cyc292cycjin-oss/SGP-ESE5004-Stage2/README.md

# SGP ESE5004 Stage2 — Phase1–3 safe research snapshot

This branch preserves reports, registries, decisions, accounting contracts, audit scripts and non-sensitive evidence. It is a documentation snapshot with separate ancestry, not the Full-SC model.

Read [snapshot provenance and exclusions](PHASE1_3_REMOTE_SNAPSHOT_MANIFEST.md), [Phase3C closeout](research/02_sector_coupling/phase3c/PHASE3_RESEARCH_MODEL_DESIGN_CLOSEOUT.md) and [assembly handoff](research/02_sector_coupling/phase3c/PHASE4_ASSEMBLY_HANDOFF.md).

Original reports are preserved as dated records. Earlier PENDING/NOT READY statements describe their own phase; no conclusions were edited for consistency. The previous raw-data publication hold is resolved for this safe snapshot by explicit exclusions, not by claiming redistribution permission.

The formally authorized future model branch is `research/full-sc-baseline` at `a3616a68ee44592af6527ca9024a90f1956646ae`. Creation is performed only after this snapshot is verified remote. No fix is integrated here. CodeQL remains EXTERNAL_INFRASTRUCTURE_EXCEPTION and does not block assembly. Final branch identities and creation results are in the final infrastructure handoff, not inferred from this preparation README.

Original local branches remain available. Excluded original sources remain local and are listed with URL/version/hash. Licenses and original notices remain applicable; see SNAPSHOT_SOURCE_LICENSES.md. This snapshot does not authorize a solver run.
