cyc292cycjin-oss/SGP-ESE5004-Stage2/research/02_sector_coupling/transport/phase3b1/PHASE3B1_TRANSPORT_READINESS.md

# Phase3B-1 Transport边界审阅交付

**TRANSPORT_BOUNDARY_READY_FOR_HUMAN_REVIEW = YES。** 当前证据足以解释原架构、定位系统风险并提交最小表示候选；不等于Transport数值输入已接受、Full-SC已组装或可以正式求解。所有候选仍PENDING，A*概念和原carbon policy不变。

## A–O回答

| 问题 | 结论与证据边界 |
|---|---|
| A 实际组件 | 作者P选定2025/2050最终结果各98个EV Load、BEV charger、V2G及rail-electric Load；无EV Store。U新最终网络未运行，不能把作者计数当U运行结果 |
| B 仅支持未入final | 道路ICE/FCEV、rail oil、shipping oil/H₂、aviation油终端及EV Store被裁剪或份额关闭；供给FT/H₂保留不证明其交通用途 |
| C Road客货来源/单位 | UNSD2019国家最终能源TWh，不分客货，不是passenger-km/tonne-km；经默认增长及存在量纲问题的陆运能源代理进入EV等Load |
| D Rail | 构造electricity/oil固定Load；final只保留电力。原始电量是rail总量子集，非电rail还进入land aggregate |
| E Shipping | 构造器显式油/H₂，需求合并国内国际；final删除。教程pre-strip油48项中39NaN，H₂48项中1NaN，不可当通过的Full-SC输入 |
| F Aviation | 构造器显式kerosene-labelled oil Load，国内国际合并；final删除。无直接航空H₂或飞机技术选择 |
| G 电力重复风险 | YES。没有对应历史EV/rail父账户转移；当前实际父电量口径也未闭合。不能给出未经证实的重复TWh；11国road electricity零来自缺记录 |
| H 电气化 | 外生scenario/year份额；能源供应和调度可内生。不是内生EV/ICE/FCEV车队投资竞争 |
| I Shipping/Aviation与H₂/电力 | 有明确系统影响通道：H₂/FT供给、renewables、储存及区位；是否实际选用及效应大小/方向未求解，不能称已证实显著 |
| J Carbon冲突 | YES，保留交通会扩大共享大气账的范围；另有rail油漏记、bunker错误加权与混合键问题。未改变原power cap |
| K 系统相关机制 | 总量/增长、EV转换和采用率、峰时/真实Store、H₂/FT与燃料库存、bunker责任、节点守恒、碳范围和对比边界 |
| L 可暂缓细节 | 精细车型/驾驶/桩型/船型/机型/班次；保留局部重开条件，不证明这些细节恒为零影响 |
| M 首基准候选 | Road aggregate与shipping/aviation先SYSTEM_RELEVANT_PENDING；客货留聚合；rail FIXED或EMBEDDED；已有燃料供给可EXPLICIT；未证实DSM/V2G及新燃料终端DEFERRED。全部需人审 |
| N 真正blocker | 五组：父子账户与rail排重；road单位/增长/缺失；shipping分配与bunker边界；碳范围/完整性；真实灵活性与比较对称性。精确条件见T01–T15 |
| O 可提交人审吗 | YES；未自动进入Phase3B-2，未修代码或执行实验 |

## 证据层次

**直接读取**：67份P/U固定Git文件；4个既有网络（两个作者final、一个教程pre-strip及final）；52个UNSD缓存文件、123条关键词筛选候选原行和107个非空base字段的转换核对；小输入、港口工程provenance和prior audit。

123条候选原行中含名称命中航空关键词的进口等非终端交易；实际进入每个base字段的交易/commodity仍按冻结过滤器选取，不把候选行全部当运输消费。`conversion_comparison`保存每格selected_raw_count，原行/脚注/哈希保留。107项一致是计算可追溯，不是统计完整或参数验收。

**分析推导**：land/rail重复条件、CO₂占比与kWh/km量纲不闭合、bunker scalar×ratio求和错误、rail油绕过排放账、固定燃料义务与内生供给不等于重复。

**待检验推断/候选**：省略灵活性或改变运输燃料会如何改变互联收益、港口NaN所有根因、各空间代理误差大小、最小Research表示。没有制造效果数值、materiality阈值或新的技术/碳情景。

## 已关闭与保留缺口

已恢复生成脚本、原始交易/单位、默认继承、实际源版本区分、组件裁剪、明确欧洲曲线来源、外生份额和排放消费路径。无需再让用户搜全11国微观交通数据。

尚需后续数值采用证据：A*同口径交通电量；可辩护的road聚合转换；增长/份额接受；国家/节点守恒；完整且保持原范围的排放账。作者车辆/机场原快照只在精确复刻或依赖该输入时要求；具体条件见`USER_INPUT_NEEDED_TRANSPORT.md`。

## 最小下一步（仅交接，不执行）

人审先选Road聚合与灵活性范围、rail账户方式、domestic/international bunker责任及共同燃料/碳记账契约。以后若另行授权工程阶段，只针对已定位系统门槛修正/验收，避免重新研究完美车型或全11国设备细节。保留航运航空为系统相关待定，不能因数据不完美默认关闭。

本轮仅写research审计产物；没有数据替换、transport/EV subtraction patch、H₂网络更改、carbon政策更改、正式或敏感性求解。原P/U/V/R冻结版本不变。交付检查的PASS只覆盖证据完整性、表间一致及受保护模型身份。
