cyc292cycjin-oss/SGP-ESE5004-Stage2/research/02_sector_coupling/transport/phase3b1/USER_INPUT_NEEDED_TRANSPORT.md

# 本轮人审所需：少量边界决定，非重新搜集11国车队

**完成本轮边界审阅不需要用户补交新文件。** 主要UNSD来源、当前生成链、默认参数、港口工程来源和两个作者结果已从缓存恢复。来源可恢复的问题不再转交用户重复寻找。

## 后续数值采用前需要共同决定

| 决定 | 当前候选（未冻结） | 为什么需要人审 |
|---|---|---|
| 第一版Road边界 | aggregate road，明确外生渗透；仅在单位和A*转移闭合后显式EV；暂不赋予未经证实的DSM/V2G | 当前q是存在量纲问题的能源代理，不是已核验mobility service；关闭灵活性也是范围选择 |
| Rail表示 | EMBEDDED或单列FIXED，保留电/燃料一次；不强制线路/车辆模型 | 两者可用但互斥，需避免与land及父电力重复 |
| 国内/国际bunker义务 | 国内与国际分别留账，shipping/aviation先SYSTEM_RELEVANT_PENDING | 当前false开关仍保留国际燃料；国别责任和对比边界不能由脚本代定 |
| H₂/FT路径与燃料贸易 | 对保留燃料义务使用已有供给能力；份额不自动上调；Disconnected的外部商品供应另定义 | 不能将供给内生误认为船/机技术竞争，也不能把独立国家等同自给 |
| Carbon实施边界 | 原power absolute trajectory保持；明确独立范围、共享燃料/捕集信用及完整排放账 | 不是是否改政策的问题；是如何确保原范围不被交通扩展或漏记破坏 |

增长/效率/份额须按来源家族共同验收，不要求逐格批准146行登记，也不把技术复算一致变成科学接受。

## 条件性原件需求（仅在选用相应路径时）

1. **若要按原作者重建精确EV能力**：作者运行时的`resources/<run>/transport_data.csv`，及生成它的WHO/Wikipedia车辆快照、年份/车辆口径、World Bank原表或生成日志。当前tutorial未生成该表；硬编码表不能证明作者使用了它。不要替换为最新在线车辆量。若无法取得，标原作者输入版本未闭合，不影响本轮审阅。
2. **若要从A*转移历史交通电力**：与拟采用A*同年同域的road EV/rail/other electric transport电量及包含关系。原缓存11国road electricity为空子集零，不能代替这项证据。应先沿已选电力/能源平衡来源定向恢复；不要求用户现在寻找全部国家交通调查。
3. **若要将道路聚合能耗转换成显式服务/EV用电**：能说明输入端、能耗或效率单位、同年覆盖及燃料热值的可辩护聚合转换依据。若原作者有该假设来源，可提供文件/表/页；不要求每种车型，不允许把CO₂占比继续当物理燃油效率。
4. **若要采用DSM/V2G或作者精确空间输入**：足够支持参与率/固定容量的车辆口径，以及作者WPI/OurAirports版本。完整车龄、每座充电桩及每条航线不是默认必需。当前港口工程导出已有，不再重复索取；机场processed hash已有，原始版本未恢复。

其他工作属于已有证据支持的后续工程核对：land/rail互斥、NaN/节点守恒、缺失旗标、Store裁剪、bunker排放加权、rail燃烧记账和混合carbon key。它们不应伪装成“用户还没交数据”；本轮授权仅审计，所以未修。
