cyc292cycjin-oss/SGP-ESE5004-Stage2/research/02_sector_coupling/transport/phase3b2/TRANSPORT_PHASE3_CLOSEOUT.md

# Transport Phase3最终收口

2026-10-03。**TRANSPORT_CLOSED_FOR_FULLSC_ASSEMBLY = NO**。

`TRANSPORT_RESEARCH_SCOPE_CLOSED = YES`；`TRANSPORT_REPRESENTATION_SPEC_FROZEN = YES`（本轮用户决定）；`NUMERICAL_INPUTS_AND_IMPLEMENTATION_FROZEN = NO`。

已完成本轮规范、证据和候选修复交付。NO表示真实数值及工程尚未满足全部八条验收，不是要求再开展Transport深入轮次。下一步是Human Scientific Review；本轮到此停止。

## A–M明确回答

| 问题 | 结论 |
|---|---|
| A Road aggregate有清晰能量定义？ | **是，规范已明确。** 同年final-energy parent×energy share；EV计量于终端充电输入；剩余燃料分载体，未创造km。R/share数值待接受。 |
| B 旧road转换量纲问题关闭？ | **没有完成工程关闭。** 新规范已摆脱错误代理，但原U函数未修、未被实际新账替代。 |
| C EV与A* exactly-once？ | **契约明确，真实值未验证。** 11国缓存零不能证明历史EV为零；须父子账匹配和基年→未来转移。 |
| D V2G/DSM可安全defer？ | **可以。** 构造开关可关；首版固定网侧Load规范不依赖车数/charger约束。实际组装须验无EV储能/逆向Link。 |
| E Rail完全embedded？ | **表示可以，数值包含待证实。** 电保留A*、燃料保留direct-fuel；新road-only账不是rail父账。不能只关rail而丢量。 |
| F Shipping国内/国际明确？ | **账户定义与原行身份明确；数量未接受。** 四国by/in漏筛及BN/LA/TL缺值已留证。 |
| G Aviation国内/国际明确？ | **明确。** 当前是kerosene范围，空集零/未来DEFAULT仍待接受，小额其他燃料作为明确范围限制。 |
| H Synthetic electricity内生？ | **已有Link机制支持，首版合同要求。** 未实际组装验证无A*预装及合法CO2/热供应；不额外添加同服务H2。 |
| I Transport与Power cap分离？ | **合同可分，当前实现未分。** shared atmosphere构成系统阻断；交通诱发发电仍在Power账。 |
| J Shipping/Aviation国家年度守恒？ | **局部候选通过，全网络未通过。** shipping17项离线PASS，缓存location权重归一；不等于真实11国/source/year/node均守恒。 |
| K 真正系统阻断？ | 仅以下G1–G3三项。 |
| L 哪些细节不再阻塞？ | 客货/车辆细分、车队购买、charger行为、DSM/V2G、船型/机型/班次、精细港航分配、油品细分；透明披露其聚合限制即可。 |
| M 第一版Transport可冻结？ | **表示规范可冻结；可执行数值模型不可冻结。** 不把规范接受等同工程及数据通过。 |

## 最少三个system-level blockers

| ID | 唯一系统门槛 | 最小关闭证据 |
|---|---|---|
| G1 | **接受一份国家×年份能源父子账** | Road R/EV energy-share/分载体残余、A*历史/未来EV与rail包含关系、rail燃料父账、四项domestic/bunker义务；原始标签漏筛/缺值/热值单位有明确处置并获接受。已有证据优先，不要求重新搜集车船机微数据。 |
| G2 | **实施规范并通过实际组装守恒** | 旧road代理退出；EV/rail exactly once且无DSM/V2G；审阅合并shipping候选或等效实现；11国账户/节点/时间全部有限且守恒；FT/H2/CO2/辅助能源链合法可达。此为Phase4工程验收，不是正式区域实验。 |
| G3 | **原Power政策范围与完整报告范围工程隔离** | 原轨迹/有效key不变；共享SMR/碳信用守恒归属；rail与燃料燃烧回排完整；固定电力调度下新增非电燃烧不污染Power账，而新增发电仍受cap。 |

## 八条closeout criteria的证据等级

| 用户准则 | 本轮真实状态 |
|---|---|
| 1 Road科学解释 | 规范满足；真实输入尚待接受 |
| 2 EV不双计 | 契约满足；实数据/新网络未验 |
| 3 Rail不双计 | 契约满足；包含关系未验 |
| 4 Shipping/Aviation明确义务账 | 账户身份完成；源数量有缺失/漏筛 |
| 5 Synthetic electricity内生 | 冻结源码支持；新组装exactly-once未验 |
| 6 Transport不误入Power cap | **未满足现有实现；本轮按要求只设合同** |
| 7 主要国家年度总量守恒 | 夹具/位置权重有限通过；真实完整数据未验 |
| 8 无系统NaN/静默丢量 | shipping候选17 PASS；现有网络和源过滤未整体修复 |

本轮没有新增参数/技术/碳政策，没有改A*或DEA，没有正式solve，没有合并Future Research Model。候选提交及审计提交分别保留工作痕迹。交付后停止，返回用户与ChatGPT作Human Scientific Review。
