cyc292cycjin-oss/SGP-ESE5004-Stage2/docs/repository_freeze/20261004/README.md

# Pre-Phase4 remote freeze — 2026-10-04

入口：[最终状态与A–L答复](GITHUB_REMOTE_FREEZE_READINESS.md)。

1. [PRE_PHASE4_GIT_STATE.md](PRE_PHASE4_GIT_STATE.md)
2. [RESEARCH_MILESTONE_REF_PLAN.md](RESEARCH_MILESTONE_REF_PLAN.md)
3. [PHASE1_3_REMOTE_ARCHIVE.md](PHASE1_3_REMOTE_ARCHIVE.md)
4. [REMOTE_REF_VERIFICATION.csv](REMOTE_REF_VERIFICATION.csv)
5. [PHASE4_GIT_STARTING_POINT.md](PHASE4_GIT_STARTING_POINT.md)
6. [GITHUB_REMOTE_FREEZE_READINESS.md](GITHUB_REMOTE_FREEZE_READINESS.md)

补充：[暂缓文件与依据](SAFETY_REVIEW.md)。evidence目录保留操作前对象/refs、已公布推送计划、原子push回执、fetch记录与精确核验，未包含原始风险数据。

12个ref备份完成，完整研究报告链备份未完成。CSV由artifact-tool从记录的真实remote/fetched结果生成，未把blocked计划伪装成PASS行。脚本仅针对本轮基础设施，push_verified_refs.py为有防重复检查的一次性操作；不要未经检查重跑。
