cyc292cycjin-oss/SGP-ESE5004-Stage2/research/02_sector_coupling/phase3c/README.md

# Phase 3C — Remaining Sector & Carrier Boundary Freeze

2026-10-03 · 最后一次Phase3 Research-Model Design交付。

**PHASE3_RESEARCH_MODEL_DESIGN_CLOSED = YES**

**READY_TO_ENTER_PHASE4_ASSEMBLY = YES**

**READY_FOR_FIRST_FULLSC_SOLVE = NO**

前两个YES表示设计阶段完成，已有统一表示规则与明确的Phase4实施/验收清单；不是输入全部接受、工程已合并或模型已求解。下一步先Human Scientific Review。本轮停止于交接，不启动Phase4，不开Phase3D。

入口：[总收口与A–N回答](PHASE3_RESEARCH_MODEL_DESIGN_CLOSEOUT.md)、[Phase4交接](PHASE4_ASSEMBLY_HANDOFF.md)、[唯一核心干预](CROSS_BORDER_INTERVENTION_CONTRACT.md)。其余8项要求产物均在本目录；共9份Markdown报告和2份CSV，另有本README及证据/可复现导出工具。

固定P=`5bacad702ccfed17ad19ab510fa710651e966f2c`，U=`a3616a68ee44592af6527ca9024a90f1956646ae`，Buildings验证V=`50a73d8f531132c5459174a55cac412d5f684462`，Future Research Model当前仍U。四者未修改。模型身份检查见 `evidence/MODEL_IDENTITY_BEFORE.json` / `MODEL_IDENTITY_AFTER.json`。

证据分级：**直接读取**固定Git源码/保留文件；**分析推导**会计恒等式、隐含通道及可分解性；**本轮冻结**用户已明确选择与符合其优先级的首版最小表示；**Phase4拟议验收**尚未实施。所有新增整理的缓存数值仍UNVERIFIED，数据决定标PHASE4_INPUT_DECISION_REQUIRED，不等同新阶段研究。

引用`U/scripts/...:line`对应固定SHA源码。新增5个Git blob见 `evidence/EXTRA_SOURCE_MANIFEST.json`；其余复用Transport Phase3B1的固定源，依赖路径/哈希见 `evidence/DEPENDENCY_MANIFEST.json`。子任务复核集中在三个evidence/*_REVIEW.md；没有外网搜索或重跑既有实验。最早A1报告的未闭合状态不覆盖后续已恢复证据。

统一矩阵的FirstFullSCStatus只使用用户指定7种状态。状态描述的是首版表示，数值接受与工程门槛在其他列单列；不以EXPLICIT掩盖未实施。CSV由artifact-tool导出并核验。package内保留所需旧证据，旧报告是历史材料，不是本轮执行指令。

交付核验见 `evidence/DELIVERY_VALIDATION.json`：11项产物、24行矩阵、9个Phase4系统门槛，历史证据哈希和176条农业缓存文本逐项核对；这是文档/证据完整性验证，不是Full-SC模型测试。有限交叉审阅及修正记录见 `evidence/FINAL_REVIEW_RECORD.json`。

审计工具只服务于本目录：`build_tables.py`准备记录并核对固定历史文件，`export_tables.mjs`经artifact-tool导出两张CSV，`validate_delivery.py`核验交付。`capture_extra_sources.py`和`verify_protected_models.py`需要原WSL只读模型路径；`sync_project_audit.py`和`package_delivery.py`是带身份/存在性保护的一次性交付工具，不应作为模型workflow运行。环境依赖/预览不进入Git；压缩包另附预览和逐文件hash manifest。
