cyc292cycjin-oss/SGP-ESE5004-Stage2/docs/repository_freeze/20261004/GITHUB_REMOTE_FREEZE_READINESS.md

# GitHub remote freeze readiness

**安全部分已完成；完整研究历史冻结尚未完成。** 已推送5个注释tag、7个原有工程/验证分支，重新fetch --prune --tags后12/12一致；14个关键里程碑全部可达。完整研究报告链因4份既有原件的上传许可未闭合而暂缓。依据用户前置条件，未创建Phase4分支。

| Status | Value |
| --- | --- |
| GIT_OBJECT_INTEGRITY | PASS |
| PHASE1_3_REMOTE_HISTORY_FROZEN | NO |
| REMOTE_MAIN_UNCHANGED | YES |
| CODEQL_BLOCKS_PHASE4 | NO |
| PHASE4_BRANCH_READY | NO |
| GITHUB_READY_FOR_PHASE4 | NO |

## A–L逐项答复

**A. 对象完整性？** PASS。fsck --full返回0，无missing/corrupt；4个已有bot dangling与4KiB metadata garbage已说明，未删。

**B. main？** 未变，始终a3616a68ee44592af6527ca9024a90f1956646ae；无merge/reset/rebase/force push。

**C. 关键提交是否全部远程可达？** 14个指定/发现的源码、参考和工程里程碑：是。全部Phase1–3报告提交：否，15个研究归档提交仍仅本地。两者不能合并称“全部完成”。

**D. 新标签？** reference/tutorial-ce327bfa、reference/paper-run-5bacad70、reference/paper-publication-99159edb、reference/upstream-sc-a3616a68、reference/buildings-validation-50a73d8f；均为annotated，不是强制的服务器不可变保护。

**E. 工程/验证分支？** codex/fix-industrial-gdp、codex/fix-carbon-config、codex/buildings-e1、codex/buildings-e2、codex/buildings-e4、codex/buildings-accounting-validation、codex/transport-shipping-reviewable-patch。复用原名，无合并。

**F. 完整研究archive ref？** 无。实际coherent分支codex/github-health-audit @ 753ff15b45ddb91c406a823f8252fc7b603f29c4已识别，但暂缓。

**G. 仍仅本地的材料？** model/source audit、Phase2、Buildings3A1–A7、Transport3B1–B2、Phase3C、health报告链和来源登记，以及本地ZIP封装/原件缓存。工程分支已有自己的验证记录，不能笼统称所有工程证据都未保存。逐族、逐包清单见PHASE1_3_REMOTE_ARCHIVE.md。

**H. 有意不推送？** 有，完整audit/archive分支及等价继承分支。精确路径：`research/00_model_audit/input_snapshot/data/industry/us_cities.csv`，及`research/00_source_provenance/official/technology-data/inputs/`下`data_sheets_for_renewable_fuels.xlsx`、`technology_data_catalogue_for_energy_storage.xlsx`、`technology_data_for_el_and_dh.xlsx`。原因是副本许可/嵌入媒体条款未闭合，不是发现token，不是文件过大。没有安全自动审批拒绝；是执行用户第10节规则。

**I. CodeQL？** 仍只记录EXTERNAL_INFRASTRUCTURE_EXCEPTION。用户已明确接受，CODEQL_BLOCKS_PHASE4=NO；未再次尝试修复或绕过。

**J. Phase4分支已建？** 否，待完整研究史安全冻结。

**K. parent精确SHA？** 分支不存在，故无实际parent。既有设计支持的建议基点为a3616a68ee44592af6527ca9024a90f1956646ae，尚未以新ref执行。

**L. 是否含新科学修改？** 无Phase4分支，无模型内容修改、数据修复、配置更改、集成或求解。本轮仅Git ref备份与审计报告。

## 需要的最小后续处理

1. 对上面4个既有原件确认此私有仓库备份适用的许可/保存授权；城市表固定Basic v1.93源包本轮返回403，已有源码URL与hash保留。DEA数据复制条款与嵌入媒体例外详见SAFETY_REVIEW.md。
2. 若不允许原件进入远程，另行批准保留原史的分离备份方案；本轮不重写commit。仅新增删除提交不能阻止祖先blob被上传。
3. 风险关闭后，推送真实archive分支并重新做reachability验证；然后才从显式U基点创建research/full-sc-baseline。届时仍不自动开始模型组装。

## 证据边界

直接读取：Git对象/refs/parents、13工作树状态、官方API、文件容器/大小、fetch后remote refs。执行判断：按用户规则暂缓有未解决许可问题的archive ref。未证明：所有数据科学验收、完整paper reproduction、Full-SC验证、正式实验可行性。所有科学确认状态保持原样。
