cyc292cycjin-oss/SGP-ESE5004-Stage2/research/02_sector_coupling/phase3c/PHASE3_RESEARCH_MODEL_DESIGN_CLOSEOUT.md

# Phase3 Research Model Design Closeout

**PHASE3_RESEARCH_MODEL_DESIGN_CLOSED = YES**

**READY_TO_ENTER_PHASE4_ASSEMBLY = YES**

**READY_FOR_FIRST_FULLSC_SOLVE = NO**

设计阶段可以关闭：所有要求的sector/carrier已有首版表示、保量规则、跨境干预定义与工程验收归属。输入数值和未合并候选仍待Phase4，不把它们改写成新的设计阶段。Buildings/Transport继承既定边界，不重开深挖。本轮没有正式组装模型或调用solver，停止于最后一次Phase3 Human Scientific Review。

## A–N答案

| 问题 | 明确结论 |
|---|---|
| A 当前Industry最接近哪一Mode？ | Mode A：固定载体需求＋有限供给/捕集/热端选择；不是完整Mode B，也不能把全部称为已实现Mode C。 |
| B 首版Industry冻结为何？ | 固定最终能耗核心；有限Mode C共同服务接口仅在来源/单位/父账转移合格时激活，否则fixed fallback。合格块为空则实际仍Mode A，禁止虚构activity。 |
| C 工业真正阻断？ | 主要国家需求/growth接受、GDP/节点守恒、工业电A*去重、煤能流/原料碳保真及合格服务供给；归P4-01/03/05/06。 |
| D TL industry必须阻塞Full-SC？ | 不阻塞设计或其余已证实模块组装；TL不启用未知工业子账户，保留国家父账/覆盖限制。未知不等于0，亦无证据断言影响小。 |
| E 农业需要显式技术模型？ | 不需要。电嵌入A*，按carrier保留固定燃料一次；油经FT仍可有间接H2/电耦合。 |
| F H2怎样生产、消费、储存？ | 节点电解及接受的已有路线；服务合格industry、FT与既有回电；节点tank。FCEV/direct marine H2不启用，不新增进口业务。 |
| G 跨境H2关闭？ | 是；还须消除共同物理pool/Store等隐含通道。 |
| H 跨境gas/CO2关闭？ | 是，首版不建物理跨境gas连接/扩张或CO2网；既有外部gas commodity仍可保留。国家内CCS不授权跨国碳运输。 |
| I 保留哪些外部商品？ | 既有gas/oil及被保留煤/生物质供应类型；其来源、价格、可用性在Phase4接受，两组完全一致。H2/NH3/methanol新增进口defer。 |
| J 唯一核心干预能否定义为跨境电力？ | 可以。仅改变接受的国家间AC/DC可用性/扩张；国内网络及其候选相同，其他跨境载体两组均off。Disconnected仍保留共同区域Power cap，不等同11个独立求解。 |
| K 两碳账概念分离？ | 是。Power政策不自动扩至全系统；所有用途诱发的发电仍在Power；完整报告含各sector且不与Policy相加。工程实现交Phase4。 |
| L Phase4须实施哪些修复？ | A*与sector互斥消费、工业链与煤/农业载体保量、shipping候选集成、物理pool国家隔离、碳scope/key、拓扑/裁剪/连接及可行性验证，见阻断登记。 |
| M 还有未处理sector阻止首版？ | 没有尚未分配表示的新sector。仍有共同输入/工程门槛，不能据此宣称完整工业/热服务数据都已覆盖。 |
| N Phase3能关闭？ | 能。全部剩余事项已有Phase4输入决定或实施验收入口；不再新增Phase3D。 |

## 状态解释与最少系统门槛组

1. **输入与账户**：接受A*、主要sector年度量/growth与外部资源边界；父子exactly once，缺失不造0。不是要求完善所有设备参数或TL工业微观资料。
2. **物理组装与干预**：恢复真实需求、必要候选和供给链，实施合法拓扑/国家隔离/电力边干预，并通过国家节点时段守恒与可行性检查。
3. **碳scope保持**：原区域Power政策与完整报告分离，含共享用途/捕集信用，保持原数值与scope可比。

细化为9个可验收Phase4工作项，见 `PHASE4_SYSTEM_BLOCKER_REGISTER.csv`；这些阻止未经验证的首次求解，不阻止进入修复/组装工作。数值采用继续遵守共同确认。

## 本轮新增知识与限制

直接代码发现：工业煤存在排放计算却缺相应能源负荷；农业构造仅用电/油而缓存有生物质/煤；network=false可能仍建立全区域物理CO2/biomass池。它们已有明确系统影响路径，交共同能流/网络验收，不在本轮修数据或源代码。

分析推导：共享区域CO2预算意味着电力Disconnected不自动可分解成独立国家成本之和；简单关闭显式pipeline不能证明没有跨国物理路径。没有估计国家收益、成本变化或TL材料性数值。

限制：aggregate工业/交通、Buildings热用途多数嵌入、农业设备未细分、简单时序/空间代理、未接受的增长与覆盖缺口、燃料原产地与生命周期边界。这些被披露或纳入共同门槛，不无限追加研究。

下一步仅为用户与ChatGPT科学复核本设计及Phase4清单。本轮不授权或自动启动模型组装/实验。
