cyc292cycjin-oss/SGP-ESE5004-Stage2/research/04_model_assembly/gate3/evidence/prior_gate_design/PHASE4_GATE2_READINESS.md

# Gate2 human review readiness

Gate2 的静态需求/会计层已交付，可以人工审阅。它仍是 **带 blocker 的研究输入架构**，不能称为可运行 Full-SC baseline。

```text
SHIPPING_COMPATIBILITY_INTEGRATED = YES
A_STAR_ACCOUNTING_IMPLEMENTED = PARTIAL
EXACTLY_ONCE_DEMAND_ACCOUNTING = PARTIAL
ANNUAL_DEMAND_MISSING_AS_ZERO = NO
DEMAND_CONSERVATION_FRAMEWORK = PASS
SCIENTIFIC_ASSUMPTIONS_SILENTLY_CHANGED = NO
READY_FOR_PHASE4_GATE3_CARRIER_CARBON = NO
```

最后一个 NO 表示本轮停在 Gate2 等待 human review/接受后续工作，不自动开始 Gate3。四层框架 PASS 不是实际 11 国全部需求已完整守恒。Gate3 的结构设计可在用户接受保留 blocker 的契约后继续；未来求解前仍必须关闭数值、边界、allocation 与 destination 门槛，并非要求找到完美所有预测才可以审阅 Gate2。

## A–S answers

| 问题 | 结论 |
|---|---|
| A Shipping integrated? | YES，兼容实现 `ee01f65a78dede9447a950676d16e072e98c8a7a`，不是 cherry-pick |
| B original shipping 17? | 17/17 PASS |
| C Buildings strict? | 1062/1062 PASS |
| D A* parent implementation? | 接口和11国基年候选已实现；numeric acceptance / future PARTIAL |
| E source/year/boundary? | UNSD 2019 Electricity - Final energy consumption，million kWh×1000；非发电 |
| F AEO8 generation target removed? | Research demand entry point 不调用/接受该 target；上游原源码保留，完整网络尚未接线 |
| G Buildings duplicates? | Research contract 无重复；44 thermal embedded，无真实heat服务升级 |
| H Road EV exactly once? | 原子转移机制测试 PASS；真实历史 EV/未来 path 未接受，因此实际数据 PARTIAL |
| I Rail once? | 电在 A*一次；燃料在未量化 transport parent一次，fuel closure 未完成 |
| J Domestic / bunker split? | YES，四 account，国际 Bunker 与国内 Transport 分开 |
| K Industry ownership? | 固定 carrier owner 清楚；电留 A*；数值/煤energy destination仍有缺口 |
| L Agriculture fuels conserved? | 原缓存所有正 oil/biomass/coal候选均保留；不完整 coverage 不称完整 ASEAN总量 |
| M Emissions without energy? | YES，原工业煤缺口仍记录 MISSING_ENERGY_OBLIGATION；未改网络 |
| N Annual missing made zero? | NO；cachezero未经证实ConvertedMWh为空；明确source零单列 |
| O Four levels? | 框架和合成测试 PASS；真实 source/sector 部分通过，node/time pending |
| P Future pending? | Direct A*、R/S fuels、road total/energy-share/residualmix、rail fuel、industry、agriculture、国内/国际shipping/aviation growth |
| Q Research HEAD? | 已测科学代码 `1c77884f9b38445e148608ee199994e4ed57d3e5`；最终含报告HEAD见 CLOSEOUT_IDENTITY.json/最终答复 |
| R remote main unchanged? | 预期固定 a3616a68…；收尾全 ref 逐项核验在 CLOSEOUT_IDENTITY.json |
| S Enter Gate3? | 当前 NO；停 Gate2 human review。接受后才启动后续carrier/carbon工作 |

## 最少需要关闭的决策与证据

1. 审定 11 国 2019 UNSD final-electricity 的候选数值/统计边界，作为 A*；future direct evolution 另行接受，不回退 generation target。
2. 接受 fixed-final-fuel 来源/热值/用途边界，并处理 cache synthetic zero、R/S煤、rail fuel parent、TL工业覆盖和四账户遗漏筛选。已恢复证据在包内，不要求用户重新找全部来源。
3. Road 的 annual final-energy parent、energy-based EV path、residual carrier vector 及历史 EV 的 A*包含关系；尚不明确就保持 pending。
4. 各 sector future growth 与空间/时间分配的明确接受；可先审基年，不强加 DEFAULT/零增长。
5. 后续 Gate3 为已保留工业煤/农业biomass煤等 energy owner 提供有效 country/carrier destination，与 carbon归属一并验证；这是后续工程，不以本轮 CO2 账替代。

没有 solver、科学情景结果、policy change、shared-pool隔离、topology修复或 integrated/disconnected 差异；没有撤回 Phase1–3 关闭状态或把 tutorial说成paper reproduction。
