cyc292cycjin-oss/SGP-ESE5004-Stage2/research/04_model_assembly/gate3/evidence/phase3_design/EXTERNAL_COMMODITY_SUPPLY_BOUNDARY.md

# 外部commodity supply边界

**允许外部燃料供给，不把Disconnected解释成能源自给。** 两组供给入口、价格、碳因素、可用性、容量/年资源约束、储存假设及数据版本必须完全相同。

| 商品 | 首版决定 | 禁止的默认推断 |
|---|---|---|
| Natural gas | 保留既有、经接受的外生供应候选 | Generator不是国内气田证据；进口不自动带跨境gas管网 |
| Oil / fossil liquids | 同上，供固定终端燃料与已有转换 | 外部oil与国内FT产油须能追踪；不新增合成成品进口 |
| Coal/lignite（若既有集合保留） | 保留同一供应与约束边界 | 不复制共享有限储量，不新增煤电容量假设 |
| Biomass/biogas | 保留已确认的资源/commodity表示；来源与finite/infinite性质必须声明 | 不把无来源全球潜力叫国内资源，不自动加无上限进口以消除不可行 |
| 外部H2/NH3/methanol或其他衍生燃料 | 首版DEFERRED，未有接受的供给/价格/碳接口不启用 | 不将框架能力或举例当已批准业务 |
| Electricity / CO2 / heat外部供应 | 不因本轮新建；已有异常边界要先核对 | 外部虚拟节点不能成为ASEAN跨国返送通道 |

U `add_carrier_buses:270–315`使用带外生fuel marginal_cost的Generator及可扩张Store。该结构表示供应可能性，不证明世界市场无限或实际进口来源。保留数值前在Phase4注明source file/hash、price unit/currency/year、availability、finite annual cap或明确无上限假设、燃料热值口径、计量位置、排放范围、成本收费端；不存在的数据不补。

**外部供给是单向进入本国需求/转换系统的边界。** 首版不得把模型内A国产出的H2/FT/gas/生物质送入“外部供应池”再返送B国，从而形成隐含区域贸易。分国/分节点供给端口与物理库存需可审查；统一价格可以共用数据字段，不能因此共用可跨国充放的物理仓库。

若已有共同有限资源上限，不能逐国复制成多倍可用量，也不能默默删除上限。Phase4须按接受的国家资源归属分解，或显式保留两组一致的非运输约束并说明其协调含义；第一核心比较不允许因此额外变化。资源分配尚无依据时属于输入决定，不由本轮猜数。

燃料供给成本在进口/源Generator计一次；转换Link只承担自身成本与实际fuel输入，避免再叠加同份燃料费用。节点边际价格可由未来优化产生，但不替代源价参数，也不能直接当国家welfare。范围外的开采/运输生命周期排放不虚构；报告准确注明“模型内CO2”。

所保留的是既有供给类型与双方一致的接口，**并未自动接受其当前数值**。这些决定与《CROSS_BORDER_INTERVENTION_CONTRACT》共同构成首版对照，不新增fuel-market研究。
