cyc292cycjin-oss/SGP-ESE5004-Stage2/research/00_model_audit/USER_INPUT_NEEDED.md

# 需要共同确认/补充的资料

本轮已经读取可用原机输入，发现问题后停止了对应数据采用；以下不是让用户重新找已能读取的文件。每项在确认前继续UNVERIFIED/PENDING。优先级按是否阻碍完整SC与国家可比性排序。

## 已找到，无需重新提供

- 三个教程原机结果、实际costs/pre_costs/sector cost、部门总量和节点工业需求、AEO8摘录、WPI教程CSV与provenance：已读取并保存证据，小文件已复制。
- 你的DEA文件位于 `C:/Users/20122/Desktop/Singapore/技术目录`，6份xlsx已登记路径和SHA256；Renewable Fuels文件名为 `data_sheets_for_renewable_fuels_15_with_index_alldata_long.xlsx`，属性标题为 **Version August 2026**，包含`80 AEC 100 MW`，而模型cost来源描述为`86 AEC 100 MW`。这是明确的版本/表页差异线索，**不能视为同版本，更不能替换模型值**。属性修改日期不是单独的正式版本认证。
- PyPSA-ASEAN已发表IOP论文在 `Desktop/ASEAN政策文件/Andreyana_2026_IOP_Conf._Ser.__Earth_Environ._Sci._1654_012020.pdf`。§3.1确认实际案例为电力系统，其他部门只计其电力需求；§3.3说明baseline无显式排放上限，DEC为电力部门ASEAN绝对路径。无需再次提供该PDF。

## 最高优先：需要用户选择或补原始证据

| ID | 需要什么 | 已知问题/为何需要 | 关闭条件 |
|---|---|---|---|
| U01 | 明确导师“保持当前carbon assumptions”指 **当前baseline** 或 **论文/仓库decarbonised**；完整SC是否仍只约束电力排放还是需要同口径SC定义 | 二者不同；完整SC增加部门后原电力预算不能自动解释为全系统预算 | 一份明确的范围/基准决定；本轮不推定、不改政策 |
| U02 | 论文使用的作者代码commit/tag/归档、有效配置与数据清单；若师哥已有请提供位置或链接 | 论文已找到，但当前ce327bfa含碳预算键冲突；repository链接不是冻结SHA | 论文版本→SHA→配置→输入hash→参考输出映射 |
| U03 | 经确认的ASEAN工业能耗/生产统计原表及年份，或原模型作者的正确工业节点输入/生成记录 | 三年节点工业表全部空，最终零负荷；需要先定位源表/映射，不能编数 | 来源、单位、国家/工业分类、缺失定义、变换和逐节点/国总量闭合 |
| U04 | 冻结v0.13.2使用的DEA原始工作簿或其归档来源；确认你现有August2026文件只作为候选/对比资料还是后续另任务评估 | 当前模型输入描述sheet86，本地新文件sheet80；电解槽投资来源还含private communications/IEA | 同版本原始sheet/cell/year、HHV/LHV、输入/输出容量基准、文件hash；无法取得则保留缺口 |
| U05 | 确认完整SC包含哪些终端需求，尤其道路、工业热/氢/氨、航运/航空国际bunkers、居民/服务 | 不能仅关闭only_elec_network就将所有默认部门数据视为适用；部分外生share会限制技术替代 | 部门边界表和需求确认，不要求现在运行 |
| U06 | AEO8原PDF/附录版本（论文参考文献注明2024年11月修订）、D15/D17/D18摘录出处及口径；IEA人均电量/industry share原导出 | 模型注释URL含2024/09；摘录CSV虽在手，尚未原表逐值核对；TL工业占比0.01无数据依据 | 精确页表、币年、资本/固定运维/可变运维口径、地区因子及国家份额确认 |

## 进入正式设计冻结前还需闭合

| ID | 资料/决定 | 当前状态与需要的证据 |
|---|---|---|
| U07 | 部门需求CAGR、效率、燃料份额、district heating与industry growth适用于ASEAN的依据 | 当前表大量DEFAULT且无ASEAN国家行；需原来源/适用理由或作者说明。不能自行替换 |
| U08 | 悬空变压器765→766、丢失负荷/光伏的原始GIS/节点映射 | 旧审计已发现简化损失，本轮不重跑；优先查原始设备数据而非猜端点 |
| U09 | DemandCast、GPD/GEM、IRENA/EIA、水文、ERA5全年cutout、OSM-plus0.1.1与AIMS/ID_SuperGrid输入的冻结归档和许可 | 已有部分文件/版本/清单；大文件并未全部复制hash，原始数据库快照还需闭合；只需补缺失项，不重新下载最新版 |
| U10 | 生物质360 TWh、继承biogas0.5 TWh、封存200 Mt及区域共享资源的ASEAN适用性/国家分配依据 | 最后二者含继承默认，封存注释欧洲；standalone不可各自复制区域总额 |
| U11 | 燃料价来源/币年、外部商品供应边界、容量/供给限制，以及哪些跨国carrier关闭 | 当前供给Generator没有国内/进口来源拆分；standalone并非能源自给，不把全部燃料供给标成已核实进口 |
| U12 | 作者参考网络/原始指标表及其元数据/hash（若师哥已保存） | 本地论文有参考指标，但未将参考网络与当前代码闭合；不需在本轮重现实验 |
| U13 | 后续目录方案选择与共享原始数据的存放位置 | 推荐独立研究层+冻结模型检出；本轮仅交付自包含审计包，无大规模移动/删除 |

## 当前可进行与不可进行

可以围绕U01/U03/U05/U10/U11讨论integrated vs standalone的**概念设计和确认顺序**，整理缺口和修复评审。不能将当前教程直接作为完整SC基准，不能开始integrated全年或11国正式求解。未经人工确认的输入、空工业表、未对齐的碳预算和需求不守恒必须先解决。

目录、台账和manifest设计已交付；“读懂当前实现”的审计工作完成不等于“科学数据全部确认”或“环境/论文复现已完成”。
