cyc292cycjin-oss/SGP-ESE5004-Stage2/research/00_source_provenance/USER_INPUT_NEEDED_V2.md

# 用户所需资料与共同决定 V2

本表替代上一轮“哪些事情需要用户寻找”的优先级，不覆盖旧审计历史。**本轮不需要用户重新收集大量数据。** 来源恢复和数据接受分开；任何未共同确认项仍为 UNVERIFIED/PENDING。

## 已由本轮关闭或显著缩小的旧请求

| 旧编号 | 本轮更新 | 用户现在是否需要寻找 |
|---|---|---|
| U02 论文 SHA/配置 | 两个作者输出嵌入 5bacad70，源码可访问；有效配置已导出 | 不再需要重新找基本版本；严格全输入/clean-worktree 认证仍有残余 |
| U03 全空工业输入 | 定位 GDP 局部 TIFF 无 ASEAN 覆盖→权重 NaN；10 国国家表有数据 | 不需要重做全部工业数据；已有全球 GDP 源，待独立工程修复 |
| U04 DEA sheet 86 | v0.13.2 SHA及旧工作簿已取回，原始单元格和 LHV说明已读 | 不需要找旧表；August2026版本保留为候选对照 |
| U06 AEO8 三张成本表 | 作者 SHA 的 D15/D17/D18 已恢复并与当前输入核对 | 不需要重复提供作者转录表；原出版物逐表核验仍属来源审计工作 |
| U12 作者结果 | 全目录与两份网络、配置、输出 hash 已取得 | 不需要重新提供同一结果包 |
| U01 当前碳疑点 | 论文旧实现与后续迁移混合键已定位；2050 DEC 上限100Mt直接验证 | 不需要找一条猜测的新碳路径；仍需确定“保持当前”指哪个边界 |

## 真正可能需要补充的原始资料

以下不是要求用户一次提供全部文件；先检查自己已有资料即可。没有资料时保持缺口，不填假设值。

| 优先级 / ID | 精确所需内容 | 为什么源码仍不足 |
|---|---|---|
| P1 / D01 | Timor-Leste 2019 或可对齐基年的工业能源分项/官方平衡表，附单位、部门定义和出处；若已有也可提供总量与分类说明 | 现有UNSD有79条该年能源记录，但缺所需工业分项；不能把 other 当 industry，不能将缺失当零 |
| P1 / D02 | 若手头已有：ASEAN 工业增长/需求情景的原始表及部门映射；或导师指定的需求情景来源 | 当前10国虽有基年量，后续增长多数回退 DEFAULT；框架默认不等于区域科学假设已接受 |
| P2 / D03 | 若能向导师/作者取得：electrolysis 投资曲线的 private communications 可分享说明，或明确采用冻结上游曲线的理由 | v0.13.2记录公开IEA报告和私有通信，公开源码只能恢复采用值，不能恢复私有证据 |
| P2 / D04 | 仅在要求严格 paper reproduction 时：作者输入文件/hash manifest、完整环境/solver log、dirty diff 或运行档案 | 输出metadata有SHA和配置，但没有全输入字节与未提交差异认证；此项不等于现在必须联系作者 |

模型已有可读文件和官方来源可继续核验的内容，应由后续审计处理，不转嫁给用户重新搜索：AEO8 原文页码、储氢 MW/MWh 标签、燃料 LHV/HHV说明、设施清单覆盖、全球资源/默认参数出处。只有公开材料仍不能澄清时，再提出更窄的具体资料请求。没有自动向任何作者/导师发送消息。

## 需要共同决定的研究边界（不是文件缺失）

| ID | 待决定问题 | 必须记录的结果 |
|---|---|---|
| B01 | full-SC 具体保留哪些服务需求/载能与转换；采用论文运行版本还是当前模型为工程基线 | 版本 SHA、部门/技术清单和相对论文的变化；不能直接将全开关=true当答案 |
| B02 | “carbon保持当前”指 baseline，还是论文decarbonized；预算统计电力还是全纳入部门 | 一个明确的排放范围与基准机制；不新增国家政策情景 |
| B03 | standalone 关闭电力跨境连接，还是也关闭H₂/其他载能协同；外部商品供给保留什么 | AC/DC/H₂/气体/共享Bus/Store/全局约束逐项边界与相同输入原则 |
| B04 | 生物质、封存、共享资源和区域预算如何保持国家与区域加总一致 | 资源所有权/可获得量/预算可分解规则；不能每国复制区域总量 |
| B05 | 未经确认的 DEFAULT 增长、TL缺项、储能口径等如何处置 | 先补证据/排除对应范围/选择有据来源的共同决策；不得由Codex代填 |

## 已知工程事项，不再误列为“等用户给数据”

- GDP 缓存空间覆盖检查、原始NC到目标输入的正确派生、国家/节点工业能量守恒：源码和原始文件已足以开展独立修复评审；本轮没有修复。
- 碳旧键与新键兼容验证：已有精确历史差异，属于独立 engineering fix；不需要重新设计政策。
- 上轮 carrier 裁剪/需求守恒/拓扑765→766等问题：继续按工程证据和空间输入检查，不能以通过教程求解代替正确性验收。
- 单国切分的国内网络、资产、聚类、时间权重、燃料供给与共享资源一致性：属于实验实现规范，须在正式求解前检查。

进入下一阶段最少需要四组验收材料：**部门与版本边界签认；有效需求及国家守恒证据；碳配置等价性与覆盖范围；互联/商品/共享资源的可比边界。** 其中只有需求的真实缺项/私有来源可能需要用户提供原文件，其余主要是共同选择或工程验证。
