cyc292cycjin-oss/SGP-ESE5004-Stage2/research/02_sector_coupling/transport/phase3b1/TRANSPORT_TEMPORAL_SPATIAL_AUDIT.md

# Transport时间、空间和资产表示

| 模式 | 时间 | 空间 | 会改变什么 |
|---|---|---|---|
| Road | BASt德国2010–2015的168小时KFZ交通曲线，按国家首个时区重复；气温修正；EV Load前后时间步平滑 | 人口份额，不是道路里程/GDP/车流 | 充电峰值、可接入功率及国家/节点用电 |
| EV availability | Pkw曲线生成可接入上限；默认均值0.8、最大0.95 | 同上 | 可用charger和V2G功率；非实测接入率 |
| DSM/V2G | 构造器有循环EV Store及每日7点SOC≥0.75；50%车参与；最终裁剪删EV Store | 固定stock×share容量 | 若真正保留，可移峰/替代储能；当前作者final未实现这一EV跨时储能 |
| Rail | 年能量/8760，平坦固定Load | 人口份额，不是轨道/站点 | 数量是共同需求门槛；精确列车班次通常先作限制 |
| Shipping | 平坦oil/H₂需求；无航行时刻限制 | 港口小/中/大1/2/3份额→地理节点 | 合成燃料/制氢/电网供给的区位与存储 |
| Aviation | 平坦oil需求；无航班时刻限制 | 符合筛选条件的中/大机场1/3份额→节点 | 燃料生产位置、当地供电/H₂及库存 |

来源：`U/scripts/prepare_transport_data.py:31–63,84–111,183–211,247–248`；`data/emobility/traffic.tex:6–13`；`U/scripts/prepare_sector_network.py:2260–2308,2430–2502,1569–1606,1704–1805,3696–3739`。profile中的车流count没有自动转为车公里；Pkw与KFZ的用途也不同。BASt曲线为EUROPE_INHERITED，温度数据/人口分配为另一条全球数据链，不能都叫ASEAN实测。

P原需求曲线按普通列和归一；U改为snapshot权重；U增加profile对齐，需求/availability取均值，DSM约束取最大值。EV平滑是两个**时间步**而不是恒定两小时，时间分辨率改变其物理意义。未在本轮重跑验证。

所有部门必须使用共同的物理年量权重，尤其3h和代表日。静态fuel Load与时序EV Load不可用不一致权重作守恒判断。空间代理可先作为透明候选，但应先证明各国总量没有因节点映射/过滤丢失；已见航运NaN不能降为无关的小空间误差。

## Brownfield与投资解释

没有完备的ASEAN vehicle-age/fleet turnover或charger stock模型。注册车辆数只形成固定充电/电池能力，shares外生。未发现运输专用存量在add_existing_baseyear/add_brownfield中实现逐车队更新；通用跨年组件继承不等于车辆报废模型。

第一版可以审阅透明的固定渗透/聚合服务表示，不能称为内生fleet竞争；若未来需要greenfield服务技术竞争，那是另行模型设计，当前代码没有自动提供。无须先恢复每款车辆/船型/飞机型，但设备投资缺省、车辆上限和未来stock不增长必须保留为成本与灵活性的解释限制。

## Materiality分流

优先保留：年量和输入端定义、峰值/接入率、是否确有Store、跨国一致profile、H₂/FT生产与燃料库存、国家空间守恒。它们有明确影响发电/储能/跨境流量的通道。

暂不要求：驾驶风格、每类充电桩、每种船/飞机、完整铁路时刻表。对这些细节不声称效应恒为零；只有具体数量级或结果依赖证据出现时局部重开。不得设任意百分比阈值或启动敏感性实验。
