cyc292cycjin-oss/SGP-ESE5004-Stage2/research/04_model_assembly/gate4/evidence/diagnostic/source_identity/SMC_2018_report.pdf

SAN MIGUEL CORPORATION

April 12, 2019

The Philippine Stock Exchange, Inc. Disclosure Department
9

th Floor, Philippine Stock Exchange Tower 28th Street, corner 5th Avenue
Bonifacio Global City, Taguig City
Attention: | Janet A. Encarnacion Head, Disclosure Department
Re: | Annual Report

Gentlemen:

We are submitting herewith an electronic copy of the Annual Report (SEC Form 17-A) of San Miguel Corporation, as filed with the Securities and Exchange Commission today, April 12, 2019.

Very truly yours,

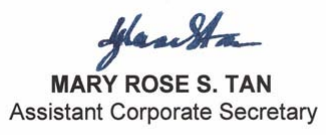
[picture p1: figure]

C O V E R S H E E T

| | | | | | | | P | W | - | 2 | 7 | 7
S. E. C. Registration Number
S | A | N
M | I | G | U | E | L
C | O | R | P | O | R | A | T | I | O | N
(Company’s Full Name)
N | O | . | 4 | 0 | S | A | N | M | I | G | U | E | L | A | V | E
M | A | N | D | A | L | U | Y | O | N | G | C | I | T | Y
M | E | T | R | O | M | A | N | I | L | A
P | H | I | L | I | P | P | I | N | E | S

(Business Address: No. Street City/Town/Province)

Atty. Mary Rose S. Tan | (632) 632-3000
Contact Person | Company Telephone Number
SEC FORM | 2

nd Tuesday of June
1 | 2 | 3 | 1 | 1 | 7 | - | A
Month | Day | FORM TYPE | Month | Day
Annual Meeting

Secondary License Type, If Applicable

Dept. Requiring this Doc. | Amended Articles Number/Section

Total Amount of Borrowings

Total No. of Stockholders | Domestic | Foreign
------------------------------------------------------------------------------------------------------------To be accomplished by SEC Personnel concerned

____________________________
File Number | LCU

____________________________
Document I. D. | Cashier
S T A M P S
Remarks = pls. Use black ink for scanning purposes

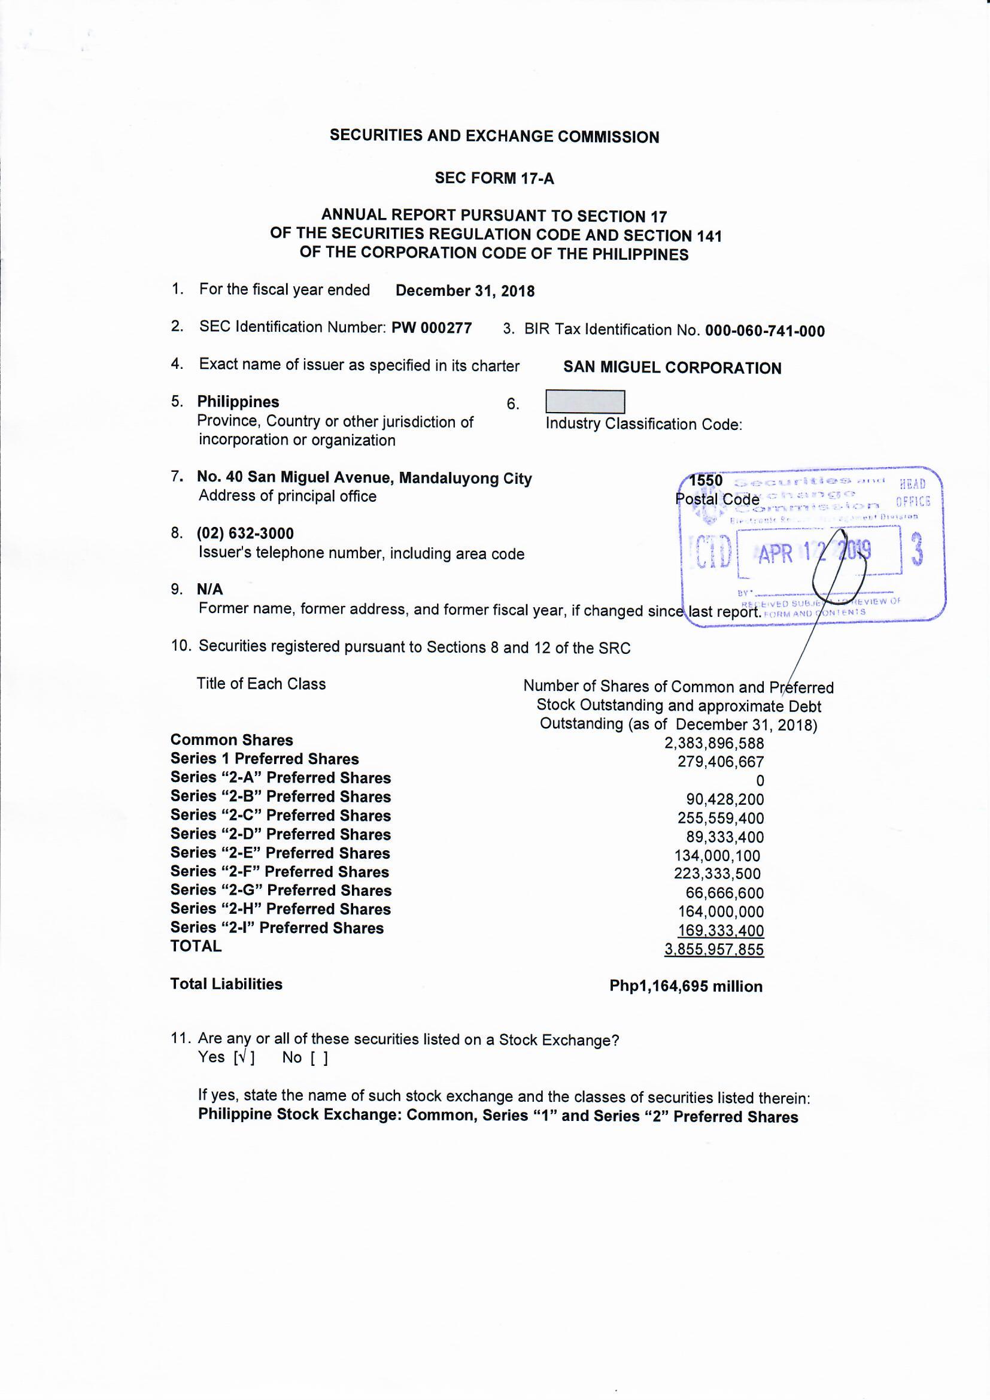
[picture p2: page 3]

2

### 12. Check whether the issuer:

(a) has filed all reports required to be filed by Section 17 of the SRC and SRC Rule 17 thereunder, and Sections 26 and 141 of The Corporation Code of the Philippines during the preceding twelve (12) months (or for such shorter period that the registrant was required to file such reports)
Yes [√ ] | No [ ]
(b) has been subject to such filing requirements for the past ninety (90) days.
Yes [ √ ] | No [ ]
13. The aggregate market value of the 367,438,246 voting shares held by non-affiliates of the Company as of December 31, 2018 is Php54,013,422,162 (based on the closing price as of December 28, 2018 of Php147.00 per share. The aggregate market value of the 375,998,810 voting shares held by non-affiliates of the Company as of March 31, 2019 is Php65,423,792,940 (based on the closing price as of March 28, 2019 of Php134.00 per share).
| DOCUMENTS INCORPORATED BY REFERENCE

### 14. The following documents are attached and incorporated by reference:

None.

| PART I – BUSINESS AND GENERAL INFORMATION

Item 1. Business

San Miguel Corporation (SMC, the Parent Company), together with its subsidiaries (collectively referred to as the Group), is one of the largest and most diversified conglomerates in the Philippines by revenues and total assets, with sales that accounts for about 5.9% of the Philippine gross domestic product in 2018.

Originally founded in 1890 as a single brewery in the Philippines, SMC has transformed itself from a market-leading beverage, food and packaging business with a globally recognized beer brand, into a diversified conglomerate with market-leading businesses in fuel and oil, energy, infrastructure, and investment in banking. SMC owns a portfolio of companies that is tightly interwoven into the economic fabric of its home market, benefiting from and contributing to, the development and economic progress of the Philippines. The common shares of SMC were listed on November 5, 1948 at the Manila Stock Exchange, now The Philippine Stock Exchange, Inc. (PSE).

In 2007, in light of the opportunities presented by the global financial crisis, the ongoing program of asset and industry privatization of the Philippine government, SMC’s strong cash position enhanced by recent divestments and cash flow generated by its established businesses, SMC began an aggressive business diversification program. SMC channeled its resources into what management believed were attractive growth sectors, aligned with the development and growth of the Philippine economy. More than ten years on, SMC’s diversification has resulted in a more valuable and profitable mix of sales and operating income. SMC is now better positioned to access capital, take advantage of different growth opportunities and can better mitigate the impact of downturns and business cycles.

Since January 2008, SMC has either directly or through its subsidiaries, made a series of acquisitions in the fuel and oil, energy, infrastructure and banking industries.

3

SMC, through its subsidiaries and affiliates, has become a Philippine market leader in its businesses with 28,598 regular employees and more than 100 production facilities in the Asia-Pacific region as of December 31, 2018. The extensive portfolio of SMC products includes beer, spirits, non-alcoholic beverages (NAB), poultry, animal feeds, flour, fresh and processed meats, dairy products, coffee, various packaging products and a full range of refined petroleum products, most of which are market leaders in their respective markets. In addition, the SMC Group contributes to the growth of downstream industries and sustains a network of hundreds of third party suppliers.

Through the partnerships it has forged with major international companies, the SMC Group has gained access to the latest technologies and expertise, thereby enhancing its status as a world-class organization.

SMC has strategic partnerships with international companies among them are Kirin Holdings Company, Limited (Kirin) for beer, Hormel Foods International Corporation (Hormel) for processed meats, Nihon Yamamura Glass Company, Ltd. (NYG), Fuso Machine & Mold Mfg. Co. Ltd. (Fuso) and Can-Pack S.A. (Can-Pack) for packaging products and Korea Water Resources Corporation (K-Water) for its power business.

Major developments in the Group are discussed in the Management’s Discussion and Analyses of Financial Position and Financial Performance, attached herein as Annex “A”, and in Notes 5, 7, 12 and 13 of the Audited Consolidated Financial Statements, attached herein as Annex “B”.

### Core Businesses

Food and Beverage

San Miguel Food and Beverage, Inc. (“SMFB”) is a leading food and beverage company in the Philippines. The brands under which SMFB produce, market and sell its products are among the most recognizable and top-of-mind brands in the industry and hold market-leading positions in their respective categories. Key brands in the SMFB portfolio include San Miguel Pale Pilsen, San Mig Light and Red Horse for beer, Ginebra San Miguel for gin, Magnolia for chicken, ice cream and dairy products, Monterey for fresh and marinated meats, Purefoods and Purefoods Tender Juicy, for refrigerated prepared and processed meats and canned meats, Star and Dari Crème for margarine and B-Meg for animal feeds.

SMFB has three primary operating segments - (i) beer and NAB, (ii) spirits, and (iii) food. The Beer and NAB Segment and the Spirits Segment comprise the beverage business (the “Beverage business”). SMFB operates its Beverage business through San Miguel Brewery Inc. and its subsidiaries (“SMB” or the “Beer and NAB Segment”), and Ginebra San Miguel Inc. and its subsidiaries (“GSMI” or the “Spirits Segment”). The Food business (the “Food Segment”) is managed through a number of other subsidiaries, including San Miguel Foods, Inc. (SMFI), Magnolia, Inc., (Magnolia) and The Purefoods-Hormel Company, Inc. (Purefoods-Hormel). SMFB serve the Philippine archipelago through an extensive distribution and dealer network and export its products to almost 60 markets worldwide.

Beer and NAB Segment

The Beer and NAB Segment is the largest producer of beer in terms of both sales and volume in the Philippines, offering a wide array of beer products across various segments and markets. Top beer brands in the Philippines include San Miguel Pale Pilsen, Red Horse, San Mig Light and Gold Eagle. Its flagship brand, San Miguel Pale Pilsen, has a history of over 128 years and was first produced by La Fabrica de Cerveza de San Miguel, which started as a single brewery producing a single product in 1890 and has evolved through the years to become the diversified conglomerate that is SMC. The Beer and NAB Segment also produces non-alcoholic beverages such as ready-to-drink tea, ready-to-drink juice and carbonates.

4

SMB markets its beer under the following brands: San Miguel Pale Pilsen, which is SMB’s flagship brand, Red Horse, San Mig Light, San Miguel Flavored Beer, San Miguel Super Dry, San Miguel Premium All-Malt, Cerveza Negra, San Mig Zero, and Gold Eagle. SMB also exclusively distributes Kirin Ichiban in the Philippines.

For the NAB business, SMB’s portfolio includes Magnolia Healthtea (ready-to-drink tea), Magnolia Fruit Drink (ready-to-drink juice), San Mig Cola (carbonates), as well as Cali, a sparkling malt-based non-alcoholic drink.

SMB discontinued the production of Magnolia Purewater (bottled water) in plastic bottles in line with SMC’s initiative to reduce its environmental footprint and support a sustainable business model.

San Miguel Brewing International Limited and its subsidiaries (“SMBIL”) also offers the San Miguel Pale Pilsen and San Mig Light brands in Hong Kong, China, Thailand, Vietnam, Indonesia and most export markets, Red Horse in Thailand, China, Hong Kong, Vietnam and selected export markets, and Cerveza Negra in Hong Kong, China, Vietnam, Indonesia, United States, Thailand, South Korea and Taiwan, in addition to locally available brands: Valor (Hong Kong), Blue Ice (Hong Kong), Dragon and Guang’s (South China), Blue Star (North China), W1N Bia (Vietnam) and Anker and Kuda Putih (Indonesia).

Spirits Segment

The Spirits Segment is a leading spirits producer in the Philippines and the largest gin producer internationally by volume. It is the market leader in gin and Chinese wine in the Philippines. GSMI produces some of the most recognizable spirits in the Philippine market, including gin, Chinese wine, brandy, vodka, rum and other spirits. Ginebra traces its roots to a family-owned Spanish era distillery that introduced the Ginebra San Miguel brand in 1834. The distillery was then acquired by La Tondeña Incorporada in 1924, and thereafter by SMC in 1987 to form La Tondeña Distillers, Inc. (LTDI). In 2003, LTDI was renamed Ginebra San Miguel Inc. in honor of the pioneering gin brand.

GSMI has a diverse product portfolio that caters to the varied preference of the local market. Core brands Ginebra San Miguel and Vino Kulafu, the leading brands in the gin and Chinese wine categories, combined for 97% of GSMI’s total revenues. The other products that complete the liquor business of GSMI comprise about 3% of its total revenues. These products are available nationwide while some are exclusively exported to select countries.

GSMI products are also exported primarily to markets with a high concentration of Filipino communities such as the United Arab Emirates, Taiwan, Vietnam, Hong Kong and the U.S. and certain brands are produced for export only, including Tondeña Gold Rum, Tondeña Manila Rum, Gran Matador Solera, Gran Reserva Brandy, Gran Matador Gold and Añejo Dark Rum 5 years. In addition, distilled spirits are sold and distributed in Thailand through GSMI’s joint venture with Thai Life Group of Companies via Thai Ginebra Trading Company Limited.

Food Segment

The Food Segment holds market-leading positions in many key food product categories in the Philippines and offers a broad range of high-quality food products and services to household, institutional and food service customers. The Food Segment has some of the most recognizable brands in the Philippine food industry, including Magnolia for chicken, ice cream and dairy products, Monterey for fresh and marinated meats, Purefoods and Purefoods Tender Juicy for refrigerated processed meats and canned meats, Star and Dari Crème for margarine, San Mig Coffee for coffee, La Pacita for biscuits, and B-Meg for animal feeds.

5

The Food Segment’s portfolio includes branded value-added refrigerated meats and canned meats, butter, margarine, cheese, milk, ice cream, jelly-based snacks and desserts, specialty oils, salad aids and biscuits, flour mixes and coffee and coffee-related products (collectively “Prepared and Packaged Food”) to integrated feeds (“Animal Nutrition and Health”) to poultry and fresh meats (“Protein”) as well as flour milling, grain terminal handling, foodservice, franchising and international operations (“Others”).

The key operating subsidiaries, products, brands and services for each of the primary businesses of the Food Segment are as follows:

a) Prepared and Packaged Food - The major operating subsidiaries for the Prepared and Packaged Food business are Purefoods-Hormel, Magnolia and San Miguel Super Coffeemix Co., Inc. (“SMSCCI”). Purefoods-Hormel produces and markets value-added refrigerated processed meats and canned meat products and is a 60:40 joint venture with Hormel Netherlands, B.V. which was entered into in 1998. The joint venture agreement sets out the parties’ agreement as shareholders of Purefoods-Hormel, including, among others, provisions on technical assistance and sharing of know-how, the use of trademarks, fundamental matters requiring shareholder or Board approval, exclusivity covenants and restrictions on the transfer of Purefoods-Hormel shares.

Value-added refrigerated meats include hotdogs, nuggets, bacon, hams, and other ready-to-heat meal products, which are sold under the brand names Purefoods, Purefoods Tender Juicy, Star, Higante, Purefoods Beefies, Vida and Purefoods Nuggets. Canned meats, such as corned beef, luncheon meats, sausages, sauces, meat spreads and ready-to-eat viands, are sold under the Purefoods, Star and Ulam King brands.

The dairy, spreads and biscuits business, primarily operated through Magnolia, Inc., manufactures and markets a variety of bread spreads, milk, ice cream, jelly-based snacks, salad aids, biscuits, flour mixes and cooking oils. Bread spreads include butter, refrigerated and non-refrigerated margarine and cheese sold primarily under the Magnolia, Dari Crème, Star and Cheezee brands. Dairy products include ready-to-drink milk, ice cream and all-purpose cream under the Magnolia brand; jelly-based snacks are under the JellYace brand, biscuits under the La Pacita brand, while flour mixes, salad aids like mayonnaise and dressings, are under the Magnolia brand. Cooking oil products are sold under the Magnolia Nutri-Oil brand. The margarine brands, Star and Dari Crème, established in 1931 and 1959 respectively, were acquired in the 1990s.

The coffee business under SMSCCI is a 70:30 joint venture between SMFB and a Singaporean partner, Jacobs Douwe Egberts RTL SCC SG Pte. Ltd., formerly Super Coffee Corporation Pte. Ltd. SMSCCI imports, packages, markets and distributes coffee mixes and coffee-related products in the Philippines.

In February 2015, the Food Segment entered the biscuits category through the acquisition of the La Pacita brand from Felicisimo Martinez & Co., Inc. La Pacita products include crackers and cookies in various formats, which are distributed in the Philippines and exported to other countries.

b) Animal Nutrition and Health - The Animal Nutrition and Health segment produces integrated feeds and veterinary medicines. The operating subsidiary for the Animal Nutrition and Health segment is SMFI. Commercial feed products include hog feeds, layer feeds, broiler feeds, gamefowl feeds, aquatic feeds, branded feed concentrates and specialty and customized feeds. These feeds are sold and marketed under various brands such as B-Meg, B-Meg Premium, Integra, Expert, Dynamix, Essential, Pureblend, Bonanza and Jumbo.

6

c) Protein - SMFI is also the operating subsidiary for the Protein segment, which sells poultry and fresh meats products. The poultry business operates a vertically-integrated production process that spans from breeding broilers to producing and marketing chicken products, primarily for retail. Its broad range of chicken products is sold under the Magnolia brand, which includes fresh-chilled or frozen whole and cut-up products. A wide variety of fresh and easy-to-cook products are sold through the Magnolia Chicken Stations. The poultry business also sells customized products to foodservice and export clients, supplies supermarket house brands, serves chicken products to wet markets through distributors and sells live chickens to dealers.

The fresh meats business breeds, grows and processes hogs and trades beef and pork products. Its operations include slaughtering live hogs and processing beef and pork carcasses into primal and sub-primal meat cuts. These specialty cuts and marinated products are sold in neighborhood meat shops under the well-recognized Monterey brand name.

d) Others - Flour milling, premixes and baking ingredients, foodservice and franchising together with international operations, are categorized under Others. The bulk of this segment is accounted for by the flour milling business and grain terminal operation.

The flour milling business operates under San Miguel Mills, Inc. (SMMI). SMMI owns Golden Bay Grain Terminal Corporation, which provides grain terminal, warehousing services and grain handling (e.g. unloading, storage, bagging, and outloading) services to clients, and Golden Avenue Corp., which holds investment in real property.

The flour milling business offers a variety of flour products that includes bread flour, noodle flour, biscuit and cracker flour, all-purpose flour, cake flour, whole wheat flour, customized flour and flour premixes, such as pancake mix, cake mix, brownie mix, pan de sal mix, and rice cake mix. The business pioneered the development of customized flours for specific applications, such as noodles and pan de sal, a soft bread commonly eaten in the Philippines for breakfast. Flour products are sold under 19 brand names which enjoy strong brand loyalty among its institutional clients and other intermediaries, such as bakeries and biscuit manufacturers.

The international operations of the Food Segment are located in Indonesia and Vietnam. PT San Miguel Pure Foods Indonesia (formerly PT Pure Foods Suba Indah) (PTSMPFI) is a 75:25 joint venture with PT Hero Intiputra of Indonesia. San Miguel Pure Foods Investment (BVI) Limited, which operates San Miguel Pure Foods (Vn) Co., Ltd. (SMPFVN) in Vietnam, is a wholly-owned subsidiary of San Miguel Pure Foods International, Limited. Both PTSMPFI and SMPFVN are in the business of production and marketing of processed meats which are sold under the Farmhouse and Vida brands in Indonesia and under the Le Gourmet brand in Vietnam.

The foodservice business of the Food Segment is handled by Great Food Solutions (GFS), a group under SMFI. GFS, which services institutional accounts such as hotels, restaurants, bakeshops, fast food and pizza chains, was established in 2002 and is one of the largest foodservice providers in the Philippines. It markets and distributes foodservice formats of the value-added meats, fresh meats, poultry, dairy, oil, flour and coffee businesses. In turn, GFS receives a development fee from these businesses for selling their products to foodservice institutional clients.

The Food Division ventured into the franchising business to serve as contact points with consumers, a trial venue for new product ideas and a channel to introduce product applications for its products. The franchising business, also a group under SMFI, follows a convenience store model under the San Mig Food

7

Ave brand, most of which are located in Petron gasoline stations. Roasters and Fryers is the newest addition to the Food Division’s franchising roster. Launched in October 2017, Roasters and Fryers gives its own take on the popular roast chicken, fried chicken, crispy pata and lechon kawali with top quality meats using Monterey and Magnolia brands.

Below is a list of the major food and beverage subsidiaries as of December 31, 2018:

San Miguel Food and Beverage Inc. and subsidiaries [including San Miguel Brewery Inc. and subsidiaries (including Iconic Beverages, Inc. and Brewery Properties Inc. and subsidiary and San Miguel Brewing International Ltd. and subsidiaries {including, San Miguel Brewery Hong Kong Limited and subsidiaries, PT. Delta Djakarta Tbk. and subsidiary, San Miguel (Baoding) Brewery Company Limited, San Miguel Brewery Vietnam Limited, San Miguel Beer (Thailand) Limited and San Miguel Marketing (Thailand) Limited}; Ginebra San Miguel Inc. and subsidiaries (including Distileria Bago, Inc., East Pacific Star Bottlers Phils Inc., Ginebra San Miguel International, Ltd., GSM International Holdings Limited, Global Beverage Holdings Limited and Siam Holdings Limited.) and San Miguel Foods, Inc. and subsidiaries, San Miguel Mills, Inc. and subsidiaries, (including Golden Bay Grain Terminal Corporation),The Purefoods-Hormel Company, Inc., Magnolia, Inc. and subsidiaries, San Miguel Super Coffeemix Co., Inc., PT San Miguel Pure Foods Indonesia, and San Miguel Pure Foods International, Limited and subsidiary, San Miguel Pure Foods Investment (BVI) Limited and subsidiary, San Miguel Pure Foods (VN) Co., Ltd.]

Packaging

The packaging business is a total packaging solutions business servicing many of the leading food, pharmaceutical, chemical, beverages, spirits and personal care manufacturers in the region. The packaging business is comprised of San Miguel Yamamura Packaging Corporation (SMYPC) and its subsidiaries, San Miguel Yamamura Packaging International Limited (SMYPIL) and its subsidiaries, San Miguel Yamamura Asia Corporation (SMYAC), SMC Yamamura Fuso Molds Corp. (SYMFC), Can Asia, Inc. (CAI), Mindanao Corrugated Fibreboard, Inc. (Mincorr), and Wine Brothers Philippines Corp., collectively referred to as the Packaging Group.

The Packaging Group has one of the largest packaging operations in the Philippines, producing glass containers, metal crowns and caps, plastic crates, pallets and other plastic packaging, aluminum cans, paper cartons, flexibles packaging, and other packaging products and services such as beverage toll filling for Polyethylene Terephthalate (PET) bottles and aluminum cans. The Packaging Group is the major source of packaging requirements of the other business units of SMC. It also supplies its products to customers across the Asia-Pacific region, the United States, Australia and New Zealand, as well as to major multinational corporations in the Philippines, including Coca-Cola Femsa Philippines, Inc., Pepsi Cola Products Philippines, Inc. and Nestle Philippines, Inc.

The Packaging Group holds 14 international packaging companies, particularly, located in China (glass, plastic and paper packaging products), Vietnam (glass and metal), Malaysia (composite, plastic films, woven bags and radiant/thermal liners), Australia (trading, wine closures and bottle caps and wine filling services and distribution) and New Zealand (plastics and trading).

Aside from extending the reach of the packaging business overseas, these facilities also allow the Packaging Group to serve the packaging requirements of SMB breweries in China, Vietnam, Indonesia and Thailand.

SMYPC owns all of the domestic plants of the Packaging Group, except the corrugated carton plant, Mincorr, which is 100% owned by SMC and SMYAC, a joint venture between SMC and NYG. Both Mincorr and SMYAC are being managed by SMYPC. SMYPIL’s subsidiaries are the Packaging Group’s international facilities.

8

a) Glass - The glass business is the Packaging Group’s largest business segment. It has three glass manufacturing facilities, and one glass and PET mold plant in the Philippines serving the requirements of the beverage, food, pharmaceutical, chemical, personal care and health care industries. The bulk of the glass bottle requirements served by this segment are for the beverage, pharmaceuticals and food industries. SMYAC is the country’s most technologically advanced glass manufacturing facility and the largest glass manufacturing facility in the Philippines.
b) Metal - The metal business manufactures metal caps, crowns, resealable caps and two-piece aluminum beverage cans for a range of industries that include beer, spirits, soft drinks, condiments and food. The Packaging Group’s metal container plant is the only aluminum beverage can plant in the Philippines and pioneered in the production of two-piece cans and ends for the beverage market.
c) Plastics - The plastics business provides plastic crates and pallets, plastic poultry flooring, food trays, plastic tubes, plastic consumer and industrial containers, and plastic pails and tubs to domestic and international markets.
d) PET - The PET business produces PET preforms and bottles, plastic caps and handles and offers filling services for PET bottles and aluminum cans.
e) Paper – Through Mincorr, a wholly-owned subsidiary of SMC based in Davao, the Packaging group supplies the carton packaging needs of a broad range of manufacturing and agricultural industries.
f) Flexibles - Through the Rightpak plant and Malaysian plants, the Packaging Group manufactures flexible packaging for the food, beverage, personal care, chemical and healthcare industries. It also provides composite materials for a varied range of industries including construction, semiconductor and electronics.

SMYPC formed CAI, a joint venture with Can-Pack S.A., for the modernization of the two-piece aluminum can manufacturing business. Utilizing the know-how and technologies of Can-Pack Group on can manufacturing, CAI is now capable to produce aluminum cans and ends in three categories - regular (standard), sleek, and slim cans. With its aim to introduce various aluminum can-packaging formats to the growing market in the Philippines and the Asia Pacific region, the business has expanded its product line to offer 180 ml aluminum cans in 2018. To-date, CAI is capable of producing six can sizes.

On February 27, 2015, SMYPIL through its Australian subsidiary, SMYV Pty Ltd, has completed the acquisition of the assets and business of Vinocor Worldwide Direct Pty. Ltd. (Vinocor). Vinocor is a market leader in the supply of corks and closures for wine bottles in Australia, with facilities and operations based in Adelaide, South Australia.

On September 1, 2016, SMYA through its new New Zealand subsidiary, SMYE Limited, acquired the assets and business of Endeavour Glass Packaging Limited (In Receivership), a trading company based in Auckland, New Zealand. Thereafter, in 2017, SMYE Limited was amalgamated (or merged) with Cospak Limited, the New Zealand subsidiary of SMYA, with the latter continuing as the amalgamated (or surviving) company.

In 2017, SMYA acquired all of the issued share capital of Portavin Holdings Pty Ltd., Barrosa Bottling Services Pty Ltd. and Best Bottlers Pty Ltd., through its subsidiaries SMYP Pty Ltd., SMYB Pty Ltd and SMYBB Pty Ltd. These acquisitions strengthened SMYA’s business in Australia and expanded its product base to include wine filling services, serving the growing wine markets in the Australasia region and in China.

To augment growth of the wine filling business of SMYA, the Packaging Group established Wine Brothers Australasia Pty Ltd in Australia and Wine Brothers Philippines Corp. in the Philippines in 2018. The business is involved in the sale and distribution of wine products in their respective countries.

9

Moreover, in 2018, SMYA through its subsidiary, SMYJ Pty Ltd. acquired the business assets of JMP Holdings Pty Ltd, a supplier of retail packaging products, transport packaging solutions and other products and services based in Victoria, Australia.

Below is a list of the major domestic and international packaging subsidiaries as of December 31, 2018:

San Miguel Yamamura Packaging Corporation and subsidiaries, SMC Yamamura Fuso Molds Corporation, Can Asia, Inc. and Wine Brothers Philippines Corp.

San Miguel Yamamura Packaging International Limited and subsidiaries [including San Miguel Yamamura Phu Tho Packaging Company Limited, Zhaoqing San Miguel Yamamura Glass Company Limited, Foshan San Miguel Yamamura Packaging Company Limited, San Miguel Yamamura Packaging and Printing Sdn. Bhd., San Miguel Yamamura Woven Products Sdn. Bhd., Packaging Research Centre Sdn. Bhd., San Miguel Yamamura Plastic Films Sdn. Bhd., San Miguel Yamamura Australasia Pty. Ltd. and subsidiaries {including SMYC Pty Ltd (formerly Cospak Pty Ltd) and subsidiary, Cospak Ltd (New Zealand), SMYV Pty Ltd, SMYB Pty Ltd, SMYP Pty Ltd, SMYBB Pty Ltd], SMYJ Pty Ltd, and Wine Brothers Australasia Pty Ltd} and San Miguel Yamamura Glass (Vietnam) Limited and subsidiary]

Mindanao Corrugated Fibreboard, Inc.

San Miguel Yamamura Asia Corporation

Real Estate

San Miguel Properties Inc. (SMPI) was created in 1990 initially as the corporate real estate arm of SMC. It is the primary property subsidiary of the SMC Group, currently 99.94% owned by SMC.

SMPI is presently engaged in commercial property development, sale and lease of real properties, management of strategic real estate ventures and corporate real estate services.

The first project of SMPI is the SMC Head Office Complex, now considered a landmark and a catalyst in transforming the Ortigas Business District.

SMPI has expanded its portfolio, serving the high-end market with its foray into townhouse developments, such as Dover Hill in San Juan, One Dover View and Two Dover View in Mandaluyong, and Emerald 88 in Pasig.

Other residential developments are located in General Trias, Cavite and Sta. Rosa, Laguna.

The Makati Diamond Residences, a luxury serviced apartment across Greenbelt 5 in Legaspi Village, Makati City, is already operational in 2015.

SMPI, through E-Fare Investment Holdings, Inc., is developing the Mariveles Industrial Estate and Economic Zone. It intends to provide an attractive location for private investments, stimulate regional economic activity, generate employment opportunities and establish forward and backward linkages among industries in and around the economic zone.

SMPI is currently the marketing arm of another industrial estate for medium to heavy industries in Malita, Davao which is being developed by Kyron Landholdings, Inc.

Below is the list of major properties subsidiaries as of December 31, 2018:

San Miguel Properties, Inc. and subsidiaries [including Excel Unified Land Resources Corporation, SMPI Makati Flagship Realty Corp., Bright Ventures Realty, Inc. and Carnell Realty, Inc.].

10

### New Businesses

Fuel and Oil

SMC operates its fuel and oil business through Petron Corporation (Petron), which is involved in refining crude oil and marketing and distribution of refined petroleum products mainly in the Philippines and Malaysia. Petron is the number one integrated oil refining and marketing company in the Philippines. Petron participates in the reseller (service station), industrial, lube and liquefied petroleum gas sectors. In addition, Petron is also engaged in non-fuels business by earning income from billboards and locators, situated within the premises of the service stations.

Petron owns and manages the most extensive oil distribution infrastructure in the Philippines. Petron has over 2,400 retail service stations in the Philippines and more than 640 retail service stations in Malaysia, as of December 31, 2018. Petron also exports various petroleum products and petrochemical feedstock, including naphtha, mixed xylene, benzene, toluene and propylene, to customers in the Asia-Pacific region.

Petron owns and operates a petroleum refining complex, with a capacity of 180,000 barrels per day located in Limay, Bataan Philippines. The refinery has its own piers and two off shore berthing facilities. In 2010, Petron started the upgrade of its refinery by undertaking the Petron Bataan Refinery Master Plan Phase-2 Upgrade (RMP-2) which started commercial operation on January 1, 2016. RMP-2 upgraded the Petron Bataan Refinery to a full conversion refining complex which further enhanced its operational efficiencies, converting its fuel oil production into higher value products – gasoline, diesel, jet fuel and petrochemicals, making it comparable to highly complex refineries worldwide. Petron also owns a refinery in Malaysia with a capacity of 88,000 barrels per day.

Below is a list of the fuel and oil subsidiaries as of December 31, 2018:

SEA Refinery Corporation and subsidiary, Petron Corporation and subsidiaries [including Petron Marketing Corporation, Petron Freeport Corporation, Petrogen Insurance Corporation, Overseas Ventures Insurance Corporation Ltd., Limay Energen Corporation, New Ventures Realty Corporation and subsidiaries, Petron Singapore Trading Pte., Ltd., Petron Global Limited, Petron Oil & Gas Mauritius Ltd. and subsdiary, Petron Oil & Gas International Sdn. Bhd. and subsidiaries [including Petron Fuel International Sdn. Bhd., Petron Oil (M) Sdn. Bhd. and Petron Malaysia Refining & Marketing Berhad (collectively Petron Malaysia)], Petron Finance (Labuan) Limited, and Petrochemical Asia (HK) Limited and subsidiaries]

Energy

The energy business, which is conducted through SMC Global Power Holdings Corp. (SMC Global), is one of the leaders in the Philippine power generation industry, controlling 4,197 MW of combined capacity as of December 31, 2018. Through its subsidiaries, SMC Global administers the output produced by Independent Power Producers (“IPPs”) of the following plants: (1) San Miguel Energy Corporation (“SMEC”) for the Sual Power Plant, a coal-fired thermal power plant located in Sual, Pangasinan, (2) Strategic Power Devt. Corp (“SPDC”) for the San Roque Power Plant, a hydroelectric power plant located in San Manuel, Pangasinan,
(3) South Premiere Power Corp. (“SPPC”) for the Ilijan Power Plant, a natural gas-fired combined cycle power plant located in Ilijan, Batangas, pursuant to the Independent Power Producer Administration Agreements (IPPA Agreements) with Power Sector Assets and Liabilities Management Corporation (PSALM).

An Independent Power Producer Administrator (IPPA) under the IPPA Agreement has the right to sell electricity generated by the power plants owned and operated by the IPPs. As an IPPA, SMEC, SPDC and SPPC also have the ability to manage both market and price risks by entering into bilateral contracts with offtakers while capturing potential upside from the sale of excess capacity through the Philippine Wholesale Electricity Spot Market (“WESM”).

11

SMC Global began acting as an IPPA of the Sual power plant in November 2009, the San Roque power plant in January 2010 and the Ilijan power plant in June 2010. SMC Global sells power through off take agreements directly to customers, including Manila Electric Company and other distribution utilities, electric cooperatives and industrial customers, or through the WESM.

In August 2011, as part of the reorganization of the power-related assets of SMC, SMC Global acquired from SMC its 100% equity interest in San Miguel Electric Corp. (SMELC), which is a grantee of a Retail Electricity Supplier (RES) license issued by the Energy Regulatory Commission of the Philippines (ERC).

In April 2013, SMC Global, through SMC Power Generation Corp., acquired 35% equity stake in Olongapo Electric Distribution Company, Inc. In October 2013, SMC Global was awarded the winning concessionaire for the rehabilitation, operations and maintenance of Albay Electric Cooperative, Inc. located in Albay province which became effective upon confirmation of the National Electrification Administration in November 2013. A wholly-owned subsidiary, Albay Power and Energy Corp. was organized and established for this purpose.

In July 2013, SMC Global through San Miguel Consolidated Power Corporation, a wholly-owned subsidiary, commenced construction works for its 2 x 150 MW coal-fired power plant in Malita, Davao Occidental (Davao Greenfield Power Plant).

In September 2013, SMC Global, through SMC Powergen Inc. (“SPI”), acquired the 4 x 35 MW Co-Generation Solid Fuel-Fired Power Plant located at the Petron Bataan Refinery, Barangay Alangan, Limay, Bataan, (“Limay Co-Gen Power Plant”) from Petron Corporation (“Petron”). On December 23, 2016, the Limay Co-Gen Power Plant was purchased back by Petron from SPI.

In October 2013, SMC Global through SMC Consolidated Power Corporation (SCPC), a wholly-owned subsidiary, commenced construction works for its 4 x 150 MW coal-fired power plant in Limay, Bataan (Limay Greenfield Power Plant). The second 2 x 150 MW of the Limay Greenfield Power Plant was formerly owned by another subsidiary, the Limay Premiere Power Corp., but this was later transferred to SCPC in June 2017. SCPC was granted a RES license by the ERC on August 24, 2016, which gave it the ability to directly contract with contestable customers.

Units 1 and 2, with a combined rated capacity of 300 MW, of the Davao Greenfield Power Plant attained commercial operations on July 26, 2017 and February 26, 2018, respectively. Units 1, 2 and 3 with a rated capacity of 450 MW of the Limay Greenfield Power Plant attained commercial operations on May 26, 2017, September 26, 2017, and March 26, 2018, respectively, while Unit 4 is expected to commence commercial operations in second quarter of 2019.

In November 2014, PowerOne Ventures Energy Inc., a subsidiary of SMC Global, and K-Water entered into a joint venture partnership for the acquisition, rehabilitation, operation and maintenance of the 218 MW Angat Hydroelectric Power Plant awarded by PSALM to K-Water.

On June 16, 2016, Meralco Powergen Corporation (“MGen”), a subsidiary of Manila Electric Company (“Meralco”), and Zygnet Prime Holdings, Inc. (“Zygnet”) subscribed to 2,500 and 102 common shares of Mariveles Power Generation Corporation (“MPGC”), then a wholly-owned subsidiary of SMC Global, respectively. As a result, the ownership of SMC Global was reduced to 49% of the outstanding capital stock of MPGC while MGen and Zygnet each owns 49% and 2% equity interest in MPGC, respectively. MPGC intends to develop, construct, finance, own, operate and maintain a 4 x 150 MW circulating fluidized bed coal-fired power plant and associated facilities in Mariveles, Bataan.

On January 25, 2019, the SMC Global subscribed to the remaining 18,314,898 unissued common shares of MPGC, thereby increasing its ownership interest in MPGC from 49.0% to 73.6%, as a result of the waiver by MGen and Zygnet of their right to contribute additional equity pursuant to the capital call issued by MPGC. On the same date, SMC Global

12

subscribed to an additional 28,929,347 common shares to be issued out of the proposed increase in the authorized capital stock of MPGC upon approval by the SEC.

On March 20, 2018, SMC Global acquired 51% and 49% equity interests in SMCGP Masin Pte. Ltd. (formerly, Masin-AES Pte. Ltd. and hereinafter referred to as “SMCGP Masin”) from AES Phil Investment Pte. Ltd. (AES Phil) and Gen Plus B.V., respectively. SMCGP Masin indirectly owns, through its subsidiaries, Masinloc Power Partners Co. Ltd. (MPPCL) and SMCGP Philippines Energy Storage Co. Ltd. (formerly, AES Philippines Energy Storage Co. Ltd. and hereinafter referred to as “SMCGP Philippines Energy”). MPPCL owns, operates and maintains the 1 x 330 MW and 1 x 344 MW coal-fired power plant (Units 1 and 2), the under-construction project expansion of the 335 MW unit (Unit 3) (Units 1, 2 and 3 are collectively referred to as the "Masinloc Power Plant"), and the 10 MW battery energy storage project (the "Masinloc BESS"), all located in Masinloc, Zambales, Philippines (collectively, the “MPPCL Assets”),while SMCGP Philippines Energy plans to construct the 2 x 20 MW battery energy storage facility in Kabankalan, Negros Occidental ("Kabankalan BESS"). The MPPCL Assets add 684 MW capacity to the existing portfolio of SMC Global. MPCCL also owns 40% of Alpha Water Realty & Services, Corp. (“Alpha Water”).

As part of the sale, SMC Global also acquired SMCGP Transpower Pte. Ltd. (formerly, AES Transpower Private Ltd. and hereinafter referred to as “SMCGP Transpower”), and SMCGP Philippines Inc. (formerly, AES Philippines Inc. and hereinafter referred to as “SPHI”). SMCGP Transpower was a subsidiary of The AES Corporation which provides corporate support services to MPPCL through its Philippine Regional Operating Headquarters, while SPHI was a wholly-owned subsidiary of AES Phil and provides energy marketing services to MPPCL.

On July 13, 2018, Prime Electric Generation Corporation (“PEGC”), a wholly-owned subsidiary of SMC Global, acquired the entire equity interest of ALCO Steam Energy Corporation in Alpha Water, representing 60% of the outstanding capital stock of Alpha Water. As a result, SMC Global now effectively owns 100% of Alpha Water through its subsidiaries, PEGC and MPPCL. Alpha Water is the owner of the land on which the current site of the MPPCL Assets in Zambales Province is located.

On September 19, 2018, PEGC and Oceantech Power Generation Corporation (“OPGC”), another wholly-owned subsidiary of SMC Global, purchased the entire partnership interests in SMCGP Philippines Energy from subsidiaries of SMCGP Masin.

Based on the total installed generating capacities reported in the Energy Regulatory Commission of the Philippines (“ERC”) Resolution No. 04, Series of 2018 (the “ERC Resolution on Grid Market Share Limitation”), SMC Global believes that its combined installed capacity gives it a market share of approximately 19% of the National Grid, 25% of the Luzon Grid and 9% market share of the Mindanao Grid, in each case as of December 31, 2018.

Below is a list of the major energy subsidiaries as of December 31, 2018:

SMC Global Power Holdings Corp. and subsidiaries [including San Miguel Energy Corporation and subsidiaries, South Premiere Power Corp., Strategic Power Devt. Corp., San Miguel Electric Corp., SMC Consolidated Power Corporation, San Miguel Consolidated Power Corporation, SMC PowerGen Inc. and subsidiary, SMC Power Generation Corp., PowerOne Ventures Energy Inc., Albay Power and Energy Corp., Limay Premiere Power Corp.] and Prime Electric Generation Corporation, SMCGP Masin Pte. Ltd. (SMCGP Masin; formerly Masin-AES Pte. Ltd. and subsidiaries {including Masinloc Power Partners Co. Ltd. and subsidiary, Alpha Water and Realty Services Corp. }, SMCGP Transpower Pte. Ltd. (formerly AES Transpower Private Ltd. and subsidiary, and SMCGP Philippines Inc (formerly AES Philippines, Inc.)].

13

SMC Global, through SMEC and its subsidiaries, Bonanza Energy Resources, Inc., Daguma Agro Minerals, Inc. and Sultan Energy Phils. Corp., has acquired coal exploration, production and development rights over approximately 17,000 hectares of land in Mindanao, which may provide a source of coal fuel supply for its planned and contemplated greenfield power projects. Such assets are in the preparatory stage and no results as to their actual viabilities were available as of December 31, 2018. The mines of SMC Global are envisioned to provide fuel for the two new greenfield projects under construction.

Infrastructure

The infrastructure business, conducted through San Miguel Holdings Corp. (SMHC), consists of investments in companies that hold long-term concessions in the infrastructure sector in the Philippines. Current operating toll roads include the South Luzon Expressway (SLEX), Skyway Stages 1 and 2, the Southern Tagalog Arterial Road (STAR), Tarlac-Pangasinan-La Union Toll Expressway (TPLEX), and NAIA Expressway (NAIAx) tollways. Ongoing projects include Skyway Stage 3, Skyway Stage 4, SLEX TR4 and the Mass Rail Transit Line 7 (MRT-7). It also operates and is currently expanding the Boracay Airport. It also has investments in Manila North Harbour Port Inc. (MNHPI) and Luzon Clean Water Development Corporation (LCWDC) for the Bulacan Bulk Water Supply Project.

SLEX / Skyway Stage 1 and 2

As of March 5, 2015, SMHC has a 95% stake in Atlantic Aurum Investments B.V. (AAIBV), a company which has the following shareholdings:

- 80.0% stake in South Luzon Tollway Corporation (SLTC), through MTD Manila Expressways, Inc. (MTDME), a wholly-owned subsidiary of AAIBV. SLTC holds a 30-year concession rights to operate the 36.1 km SLEX, one of the three (3) major expressways that link Metro Manila to Southern Luzon, and SLEX TR4, extending SLEX from Sto. Tomas, Batangas to Lucena City in Quezon province by 56.862 km; and
- 87.84% beneficial ownership in Citra Metro Manila Tollways Corporation (CMMTC), through Atlantic Aurum Investments Philippines Corporation (AAIPC), a wholly-owned subsidiary of AAIBV. CMMTC holds a 30-year concession rights to construct, operate and maintain the 29.59 km Skyway Stage 1 and 2 Project.

STAR Tollway

SMHC, through Cypress Tree Capital Investments, Inc. (CTCII) has an effective 100% interest in Star Infrastructure Development Corporation (SIDC). SIDC holds the 36-year Build-Transfer-Operate (BTO) concession rights of the STAR Project consisting of: Stage 1 -operation and maintenance of the 22.16 km toll road from Sto. Tomas to Lipa City; and Stage 2 - financing, design, construction, operation and maintenance of the 19.74 km toll road from Lipa City to Batangas City.

TPLEX

SMHC, through its subsidiary, Rapid Thoroughfares, Inc. (Rapid), owns a 70.11% equity interest in Private Infra Dev Corporation (PIDC). PIDC is a company which holds a 35-year BTO concession rights to construct, operate and maintain an 88.85 km toll expressway from La Paz, Tarlac, through Pangasinan, to Rosario, La Union. The stretch from Tarlac to Pozzorubio, Pangasinan has been operational since December 2017. The last phase from Pozzorubio to Rosario, La Union, is currently under construction.

NAIAx

On May 31, 2013, SMHC incorporated Vertex Tollways Devt. Inc. (Vertex), a company that holds the 30-year BTO concession rights for the construction and operation of the NAIAx – a four lane elevated expressway with end-to-end distance of 5.4 km that will provide access to

14

NAIA Terminals 1, 2 and 3. NAIAx connects to the Skyway system, the Manila-Cavite Toll Expressway (CAVITEX) and the Entertainment City of the Philippine Amusement and Gaming Corporation (PAGCOR). NAIAx became fully operational in December 2016.

Skyway Stage 3

On February 28, 2014, SMHC through AAIBV incorporated Stage 3 Connector Tollways Holdings Corp. (S3HC), which holds an 80% ownership interest in Citra Central Expressway Corp. (CCEC). CCEC holds a 30-year concession to construct, operate, and maintain the Skyway Stage 3, an elevated roadway with the entire length of approximately 14.82 km from Buendia Avenue in Makati to Balintawak, Quezon City and will connect to the existing Skyway Stage 1 and 2. This is envisioned to inter-connect the northern and southern areas of Metro Manila to help decongest traffic in Metro Manila and stimulate the growth of trade and industry in Luzon, outside of Metro Manila.

On March 15, 2016, AAIBV sold its 100% ownership interest in S3HC to AAIPC.

Skyway Stage 4

Skyway Stage 4 is a proposed 34.8 km roadway from South Metro Manila Skyway to Batasan Complex, Quezon City. Skyway Stage 4 will serve as another expressway system that aims to further decongest EDSA, C5 and other major arteries of the Metropolis. Further, it aims to provide faster alternate route and accessibility to the motorist when travelling from the province of Rizal and Calabarzon area to Metropolis. The project has a concession period of 30 years (from start of operations), with a target completion date by end of 2022. To date, construction has not yet started.

Boracay Airport

SMC, through the 99.92% interest of SMHC in Trans Aire Development Holdings Corp. (TADHC), is undertaking the expansion of Boracay Airport under a 25-year Contract-Add-Operate-and-Transfer concession granted by the Republic of the Philippines (ROP), through the Department of Transportation and Communications (now the Department of Transportation).

MRT-7

In October 2010, SMC, through SMHC, acquired a 51.0% stake in Universal LRT Corporation (BVI) Limited (ULC BVI), which holds the 25-year Build-Gradual Transfer-Operate-Maintain concession for MRT-7. MRT-7 is a planned expansion of the metro rail system in Manila which mainly involves the construction of 22 km mass rail transit system with 14 stations that will start from San Jose del Monte City in Bulacan and end at the integrated LRT-1 / MRT-3 / MRT-7 station at North EDSA and a 22 km six lane asphalt highway that will connect the North Luzon Expressway to the intermodal transport terminal in San Jose del Monte City, Bulacan and a 22-km road component from San Jose del Monte City, Bulacan to the Bocaue exit of the NLEX.

As of July 1, 2016, SMC, through SMHC already holds 100% ownership in ULC BVI.

On December 12, 2016, the ROP through the Department of Transportation, gave its consent to the assignment of all the rights and obligations of ULC BVI under the Concession Agreement to SMC Mass Rail Transit 7, Inc. (SMC MRT 7). SMC through SMHC owns 100% of SMC MRT 7.

MNHPI

MNHPI is the terminal operator of Manila North Harbor, a 52-hectare port facility situated at Tondo, City of Manila. The port has a total quay length of 5,200 meters and 41 berths which can accommodate all types of vessels such as containerized and non-container type vessels. Under the Contract for the Development, Operation and Maintenance of the Manila North Harbor entered with the Philippine Ports Authority on November 19, 2009, the Philippine Ports

15

Authority awarded MNHPI the sole and exclusive right to manage, operate, develop and maintain the Manila North Harbor for 25 years, renewable for another 25 years. MNHPI commenced operations on April 12, 2010. SMC through SMHC owns 43.33% of MNHPI.

Bulacan Bulk Water Supply Project

The Bulacan Bulk Water Supply Project aims to provide clean and potable water to the province of Bulacan that is environmentally sustainable and with a price that is equitable. The project also aims to help various water districts in Bulacan to meet the increasing water demand of consumers, expand its current service area coverage and increase the number of households served by providing a reliable source of treated bulk water. SMC through SMHC owns 90% of LCWDC, which will serve as the concessionaire for a period of 30 years (inclusive of the two-year construction period). Phase 1 of this project was completed end of 2018 and started supplying potable water to six (6) Bulacan municipalities as of the first quarter of 2019.

Below is a list of the major infrastructure subsidiaries as of December 31, 2018:

San Miguel Holdings Corp. doing business under the name and style of SMC Infrastructure and subsidiaries [including Rapid Thoroughfares Inc. and subsidiary, Private Infra Dev Corporation, Trans Aire Development Holdings Corp., Optimal Infrastructure Development, Inc., Vertex Tollways Devt. Inc., Universal LRT Corporation (BVI) Limited, SMC Mass Rail Transit 7 Inc., ULCOM Company, Inc., Terramino Holdings, Inc. and subsidiary, Manila North Harbour Port, Inc., Luzon Clean Water Development Corporation and Sleep International (Netherlands) Cooperatief U.A. and Wiselink Investment Holdings, Inc. {which collectively own Cypress Tree Capital Investments, Inc. and subsidiaries including Star Infrastructure Development Corporation and Star Tollway Corporation (collectively the Cypress Group)}, Atlantic Aurum Investments B.V. and subsidiaries {including Atlantic Aurum Investments Philippines Corporation and its subsidiaries [including Stage 3 Connector Tollways Holding Corporation and subsidiary, Citra Central Expressway Corp., Citra Metro Manila Tollways Corporation and subsidiary, Skyway O&M Corp., MTD Manila Expressways Inc. and subsidiaries, Alloy Manila Toll Expressways Inc., Manila Toll Expressway Systems Inc. and South Luzon Tollway Corporation}].

Banking

SMC through SMPI has a current ownership of 39.9% of Bank of Commerce (BOC). BOC is a commercial bank licensed to engage in banking operations in the Philippines.

On December 17, 2018, SMC through SMC Equivest Corporation acquired 5,258,956 common shares of BOC representing 4.69% ownership interest.

Others

Other major subsidiaries include the following as of December 31, 2018:

San Miguel International Limited and Subsidiaries including San Miguel Holdings Limited and subsidiaries
SMC Shipping and Lighterage Corporation and subsidiaries [including SL Harbour Bulk Terminal Corporation, Molave Tanker Corporation, Balyena Tanker Corporation and Narra Tanker Corporation
San Miguel Equity Investments Inc. and subsidiaries including San Miguel Northern Cement, Inc.
SMC Stock Transfer Service Corporation
ArchEn Technologies Inc.
SMITS, Inc. and subsidiaries
SMC Equivest Corporation
Anchor Insurance Brokerage Corporation SMC Asia Car Distributors Corp.

16

Principal products or services

The principal products of the Group are attached hereto as Annex “E”.

Percentage of sales or revenues and net income contributed by foreign sales

The Group’s 2018 foreign operations contributed about 26.74% of consolidated sales and 15.46% of consolidated net income. Foreign sales is broken down by market as follows:

% to Consolidated Sales
Market | 2018 | 2017 | 2016
Malaysia | 19.92 | 18.71 | 16.25
Singapore | 3.92 | 4.41 | 4.01
Australia | 1.17 | 1.18 | 0.81
China | 0.68 | 0.79 | 0.90
Indonesia | 0.60 | 0.72 | 0.86
Vietnam | 0.19 | 0.23 | 0.27
Others | 0.26 | 0.30 | 0.19

Distribution Methods

The Group employs various means to ensure product availability at all times. It distributes through a network of dealers, wholesalers, and various retailers. The Group owns, as well as contracts, third party fleet of trucks, delivery vans, and barges, to ensure timely and cost efficient distribution of its various products, from beverages, food and packaging.

Status of any publicly-announced new product or service

At present, the Group is not developing any new major products.

Competition

The Group owns leading brands with the highest quality in the industry, substantial market share leads over its nearest competitors, successful pricing strategies and strong financial position.

The following are the major competitors of the Group’s businesses:

Food and Beverage

Beverage
a) Beer and NAB

In the Philippine beer market, SMB’s main competitor is AB Heineken Philippines Inc. (ABHP), a joint venture formed in 2016 between domestic brewer Asia Brewery Inc. and Heineken International B.V. ABHP offers a portfolio of local and foreign beers, some of which are produced under license from foreign brewers, and alcomix beverage products.

ABHP competes mainly through licensed Colt 45, a strong alcohol brand which is positioned against SMB’s strong alcohol beer Red Horse, and local Beer na Beer in the economy segment and Brew Kettle in the mainstream segment. It is also the exclusive distributor of Asahi Super Dry in the country. ABHP is also involved in the marketing and selling of imported Heineken and Tiger in the country, competing with SMB’s premium and mainstream brands, respectively.

ABHP also offers Tanduay Ice which is a line of alcopop beverages positioned similar to beer. Competition from imported beers and local craft beers is minimal. These products comprise a small proportion of the market and are primarily found in upscale hotels, bars, restaurants and supermarkets in Metro Manila and other key cities.

17

SMB also competes with producers of other alcoholic beverages, primarily gin, rum, brandy and recently, alcopops which are close substitutes to beer. In the beer industry -and more generally the alcoholic beverage industry - competitive factors generally include price, product quality, brand awareness and loyalty, distribution coverage, and the ability to respond effectively to shifting consumer tastes and preferences.

In the NAB market, SMB faces competition from established players and brands in ready-to-drink juice and ready-to-drink tea. For example, Zest-O, Tropicana Twister and C2 compete with Magnolia Fruit Drink, while Lipton and Nature’s Spring Iced Tea compete with Magnolia Healthtea.

In its main international markets, the SMBIL Group competes with both foreign and local beer brands, such as Blue Girl (Hong Kong), Carlsberg (Hong Kong, Thailand and Vietnam), Heineken (Hong Kong, South China, Thailand, Vietnam and Indonesia), Tsingtao (Hong Kong, China), Yanjing (China), Tiger (Thailand, Vietnam and Indonesia), Guinness (Hong Kong and Indonesia), Bintang (Indonesia), Budweiser (Hong Kong and China) and Snow (China), Singha and Asahi (Thailand), and Saigon Beer (Vietnam).

b) Spirits

The local hard liquor industry is segmented by category and geographically among the major players. The gin market is dominated by GSMI catering mostly the northern and southern provinces of Luzon. The Greater Manila Area and key urban centers across the country patronize Emperador Light Brandy locally produced by Emperador Distillers, Inc. Although recently, value-priced imported Alfonso Light Brandy distributed by Montosco, Inc. has likewise been gaining popularity.

The Visayas and Mindanao regions prefer Tanduay Rhum Dark 5 Years, a product of Tanduay Distiller’s Inc. Moreover, there is a market for Chinese wine in various islands in the region with GSMI’s Vino Kulafu emerging as the top choice in this category.

These major players compete in their development of brand equity, as the industry’s consumers generally develop affinities and loyalty to the brands that they patronize.

Liquor manufacturers also compete in terms of production efficiencies, as the price-sensitive nature of the industry’s consumers makes them more reliant on cost improvements than on price increases to brace against profit squeezes from an inflationary operating environment.

Manufacturers compete in the breadth of their distribution network.

Food

In recent years, the Prepared and Packaged Food segment has faced increased competition mainly from other local players who employ aggressive pricing and promotion schemes. Competitors and competing brands in the branded processed meats category include Foodsphere, Inc. (CDO), Virginia Foods, Inc. (Winner and Champion), and Century Pacific Food Inc. (Swift, Argentina and 555), Mekeni Food Corporation (Mekeni), Frabelle Food Corp. (Bossing), Sunpride (Sunpride, Holiday and Good Morning) and Maling.

For butter and spreadable fats, competitors include Fonterra Brands Philippines, Inc., New Zealand Creamery, Inc. and RFM Foods Corporation (for butter) and San Pablo Manufacturing Corporation, Malabon Philippines and AD Gothong Manufacturing Corporation (for margarine). In the cheese category, the main competitor of the Magnolia brand is Mondelez International, Inc. (Eden, Cheez Whiz, and Kraft). In the ice cream market, Unilever-RFM Ice Cream Inc. (Selecta) is the dominant player. Competitors in the coffee-mix business include Nestle SA (Nescafe), PT Mayora Indah (Kopiko), and Universal Robina Corporation (Great Taste).

18

The Food Segment is the largest producer of commercial feeds in the Philippines. Competitors under the Animal Nutrition and Health segment include major domestic producers such as Univet Nutrition and Animal Healthcare Co., Pilmico Foods Corporation (Pilmico), Universal Robina Corporation (URC) and Philippine Foremost Milling Corporation (Foremost), as well as numerous regional and local feedmills. There are also foreign feeds manufacturers which have established operations in the Philippines.

Major competitors under the Protein business include Bounty Fresh Foods Inc., Bounty Agro Ventures, Inc., Gama Foods Corp. and Cobb-Vantress Philippines, Inc. There are also occasional imports from the U.S., Canada and Brazil.

The Philippine fresh meats industry remains highly fragmented consisting mostly of backyard hog raisers. Its main competitors are Robina Farms (URC) and Foremost Farms. It also competes with several commercial-scale and numerous small-scale hog and cattle farms that supply live hogs and cattle to live buyers, who in turn supply hog and cattle carcasses to wet markets and supermarkets.

Major competitors of the flour milling business include Philippine Foremost Milling Corporation, Pilmico and URC.

Local players face competition from imported flour that primarily originates from Turkey, Malaysia and Indonesia. Imported flour has increased its presence through low-cost flour offerings.

Petron Corporation

Petron operates in a deregulated oil industry along with more than 100 other industry players (importers and distributors). With several players sharing in the market, competition is intense. Retail and depot network expansion, pricing, various marketing programs are being employed to gain a bigger share of the domestic market. Further adding pressure to competition are illegal trading practices (e.g., “bote-bote” retailing, illegal refilling and under declaration of value or quantity of imports) that have resulted in lost tax revenues for the government.

San Miguel Properties, Inc.

Among SMPI's major competitors in the South are the Ayala West Grove Heights and Nuvali by Ayala Land/Ayala Land Premier, South Forbes by Cathay Land, Solen Residences by Greenfield Properties, Eton City by Eton Properties, Amaia Scapes by Amaia Land, Solviento by GeoEstate, Natania Homes and Sabella by My Citi Homes, Meridian Place by Filinvest and Cedarwood Residences by Asia Landbest.

SMPI's competitors in Metro Manila are Rockwell Land’s 205 Santolan and Alvendia, Filinvest’s Fortune Hill, KMC Mag Group’s 81 Xavier and Baron Residences, Federal Land’s One Wilson Square and Ortigas & Company’s Viridian, Clairemont Hills by Anchorland and Horizon Estates by Transphil Land.

For the properties of SMPI generating lease income located in the Ortigas area, its competitors include the One Corporate Center, Philippine Stock Exchange Tower, Taipan Place, Wynsum Corporate Plaza, Orient Square, Robinsons Equitable Tower and Cyberspace Gamma, and Rockwell Business Center.

SMC Global Power Holdings Corp.

SMC Global’s main competitors are the Lopez Group and the Aboitiz Group. The Lopez Group holds significant interests in First Gen Corporation and Energy Development Corporation, while the Aboitiz Group holds interests in Aboitiz Power Corporation and Hedcor, Inc, among others.

19

SMC Global will face competition in both the development of new power generation facilities and the acquisition of existing power plants, as well as competition for financing for these activities. The performance of the Philippine economy and the potential for a shortfall in the Philippines’ energy supply have attracted many potential competitors, including multinational development groups and equipment suppliers, to explore opportunities in the development of electric power generation projects within the Philippines. Accordingly, competition for new power projects may increase in line with the long-term economic growth in the Philippines. Several of these competitors have greater financial resources, and have more extensive operational experience and other capabilities than SMC Global, giving them the ability to respond to operational, technological, financial and other challenges more rapidly than SMC Global.

The implementation of several Electric Power Industry Reform Act (EPIRA) policies, namely creating the regime of Open Access and Retail Competition, expands the market a generator or power supplier can tap while promoting competition. The goal of the EPIRA is for the generation sector to be open and competitive, while the private sector is expected to take the lead in introducing additional generation capacity. Generation companies will compete either for bilateral contracts with various RESs, electric cooperatives and private distribution utilities, or through spot sale transactions in the WESM. With the implementation of RCOA in Luzon and Visayas, generation companies are already able to sell electricity to eligible end-users. “Open Access” is defined under the IRR as the system of allowing any qualified person the use of electric power transmission and distribution systems; while “Retail Competition” is defined as the provision of electricity to Contestable Market (which under prevailing regulations, refer to electricity end-users with monthly average peak demand of at least 500 kW) by persons licensed by the ERC to engage in the business of supply to electricity end-user through Open Access.

Sources and Availability of Raw Materials and Supplies

The Group obtains its principal raw materials on a competitive basis from various suppliers here and abroad. The Group is not aware of any dependency upon one or a limited number of suppliers for essential raw materials as it continuously looks for new principals/traders where the strategic raw materials could be sourced out and negotiations are done on a regular basis. The Group has contracts with various suppliers for varying periods ranging from three to twelve months. All contracts contain renewal options.

Among the Group’s third party supplier of major raw materials in 2018 are as follows:

FOOD and BEVERAGE

Beer and NAB Segment
Malt and Hops | Boortmalt N.V.
| Cargill Malt Asia (formerly Joe White)
| Cargill Nv
| Cofco Malt (Dalian) Co., Ltd.
| GZ Malt
| HVG Hopfenverwertungsgenossenschaft E.G.
| John Haas, Inc.
| Malteries Soufflet
| Malteurop S.A.
| Taiwan Hon Chuan Enterprise Co., Ltd.
Corn Grits/Tapioca/Rice/Sugar/Starch | All Asian Countertrade Inc.
| Binh Phuoc General Import Export Joint Stock
| Company
| Cagayan Corn Products Corporation
| Chaodee Starch (2004) Co., Ltd.
| Eiamheng Tapioca Starch
| Foshan Guangming Food & Oil Co. Ltd.
| HeFei longjie Food & Oil Co. Ltd.
| Lambayong MNLF Multi-purpose Cooperative

20

Limketkai Manufacturing Corporation Maicerias Españolas, S.A.
PT Sinar Unigrain Indonesia
RJJ Enterprises
SCG Trading Co., Ltd.
Shandong Zhonggu Starch & Sugar Co., Ltd. Sinar Pematang Mulia
Packaging Materials | Al Tajir Glass Industries
| Ball Asia Pacific (Foshan) Metal
| Bangkok Can Manufacturing Co., Ltd.
| Baosteel Can Making Vietnam
| Crown Beverage Cans (Heshan) Co., Ltd.
| Goodyear Container Corporation
| Guandong Huaxing Glass Co., Ltd.
| Heindrich Trading Corporation
| High Win Industrial Limited
| M.A.D. Color Print Packing Co., Ltd.
| Pacific Can (Zhangzhou) Company, Ltd.
| PT Tristar Makmur Ka
| Westrock MWV Hong Kong Limited
Fuel | Shell Hong Kong Ltd.
| The Shell Company of Thailand Limited

Spirits Segment
Sugar | All Asian Countertrade, Inc.
Flavoring | Symrise Asia Pacific PTE LTD
| PT Mane Indonesia LTD
| Givaudan Singapore PTE LTD
| Firmenich Asia PTE LTD
| Anstie Distillers International Limited.
Food Segment
Breeder Stocks | Aviagen Group
| Cobb Vantress Inc.
Beef Carcass | D’Meter Fields Corporation
Breeding Hogs | PIC Philippines, Inc.
| TOPIGS Philippines, Inc.
Soybean and Feed Wheat | Enerfo Pte. Ltd.
| Louis Dreyfus Commodities Asia Pte Ltd.
| Toyota Tsusho Asia Pacific Pte Ltd.
Wheat | Bunge Agribusiness Singapore Pte. Ltd.
| CHS Inc.
| Columbia Grains International
| Toyota Tsusho
Imported Meat | Al-Quresh Exports
Cheese Curd and Anhydrous Milk Fat | Fonterra Ingredients Limited
Oil | Tap Oil Manufacturing Corp.
Coffee Mixes | SCML (Thailand) Company Ltd.

21

PACKAGING
Glass Business
Silica Sand | Tochu Corp.
Soda Ash | Mitsui & Co., Ltd Connell Bros Company Pilipinas, Inc. Alchemco Philippines, Inc.
Cullet | Yassel Corporation Agate Enterprises
Limestone | C&B Marble Ecorock Industrial Carmen Limestone

Molds

Casting Molds | Metals Engineering Resources Corp.
NeckRing Bars | BF Glass Mould Overseas Pte Ltd. Malasaga Trading Corporation Metals Engineering Resources Corp.
Round Bars | Ammex Machine Tools Phils Inc. Changshu Jianhua Mould Technology

Plastics Business

Colorants/Pigments | Esta Fine Colour Corp. Masterbatch Philippines, Inc.
Inks | MCR Industries, Inc. Union Inks and Graphics Philippines, Inc.
HDPE Resin | JG Summit Petrochemical Corporation Dow Chemical Pacific (Singapore) Pte. Ltd PTT Polymer Marketing Company Limited Lotte Chemical Titan Corporation Sdn. Bhd.
Regrinds | Toyo Ink Compounds Corporation PT Bening Citra Lestari

Metal Business

Plate, TFS | Nippon Steel & Sumikin Bussan Corporation Macro-Lite Korea Corporation Mitsui & Co., Ltd. (Japan) Jiangsu Xutao Supplies Co., Ltd. Toyota Tsusho Corporation
Aluminum Coil | Toyota Tsusho Corporation Novelis Mea Ltd. Shinko Shoji Singapore Pte. Ltd. Sumitomo Corporation Asia & Oceania Pte. Ltd. Macro International Corporation

22

Lubricants | Elasco Int'l Corp.
| Petron Corporation
| Pneumatic Technologies Inc.

Laminates Business

PET/CPP/OPP and Other Films | Cofta Mouldings Corp. - Quezon City
| Pt Kolon
| Polyplex Thailand Ltd.
| Flexible Packaging Products Corporation
| Thai Toray Synthetics, Ltd.
PE Films | Cofta Mouldings Corporation
| Flexible Packaging Products Corp.
Aluminum Foil | SNTO International Trade Limited
| Dongwon Systems Corp.
| Eastern Valley Co., Ltd.
| Flexible Packaging Products Corp.
| Shofusion Inc.
| Yantai Jintai International Trade
| Hangzhou Dingsheng Import and Export Co. Ltd.
Resins | Dow Chemicals Pacific, Ltd.
| JG Summit Petrochemical Corporation
| Trans World Trading Company, Incorporated
Inks | Tokyo Inc [Philippines] Co., Inc.

PET Business

PET Resin | Indorama Polymers Public Co., Limited
| PT Indorama Polypet Indonesia
| Far Eastern Polychem Industries Limited
PP Resin | Basell Asia Pacific Limited
| Jiangyun Xingyu New Material Co. Ltd.
CO2 | Ingasco, Incorporated
| Pacific Carbonic Corporation
Paper Business
Kraft Paper | Daiei Papers (USA) Corp.
| OJI Fibre Soloutions (NZ) Ltd.
| Price & Pierce International, Inc.
| Visy Trading Singapore Pte. Ltd.
FUEL AND OIL
Crude | Saudi Arabian Oil Company ExxonMobil Exploration and Production Malaysia, Inc.
| Kuwait Petroleum Corporation
Finished Product | SK Energy International Pte Ltd.
| Trafigura Pte. Ltd.

23

ENERGY

Coal | Ensham Coal Sales Pty. Ltd. Glencore AG Mitsubishi Corporation RtM International Pte. Ltd. Noble Resources International PT Bara Tabang (a subsidiary of PT Bayan Resources Tbk) PT Indominco Mandiri PT Kaltim Prima Coal PT Trubaindo Coal Mining Rwood Resources DMCC Vitol Asia Pte Ltd.
Other Consumables | Connel Bros. Co. Pilipinas, Inc. Mabuhay Vinyl Corporation Nalco Phils. SI Resources Corpporation Solid North Mineral Corporation Strongforth Limestone Corporation Synergos Transtrade Corp.
Electricity | Philippines Electricity Market Corporation
Construction Materials | Formosa Heavy Industries Boom Access Investments Ltd. Liebherr-Werk Nenzing GmbH Velca Equipment and Engineered Products, Inc.
Services | Chang-Tsai Construction and Trading EDL Energy Saver Trading and Services MHPS (Philippines), Inc. Power Zaver Techno Services Corp.

Dependency upon a single customer or a few customers

Due to constant drive toward customer satisfaction and continuous improvement, the Group is able to maintain its wide base of customers. The Group is not dependent upon a single or a few customers.

Transactions with and/or dependence on related parties

The Group and certain related parties purchase products and services from one another in the normal course of business. Please see Note 33, Related Party Disclosures, of the Consolidated Financial Statements attached hereto as Annex “B”.

Registered Trademarks/Patents, Etc.

All marks used by the Group in its principal products are either registered or pending registration in the name of the Parent Company or its subsidiaries in the Philippines and in foreign markets of said products.

The SMC Group uses various brand names and trademarks, including “San Miguel”, “Ginebra San Miguel”, “Purefoods”, “Magnolia”, “Star”, “Dari Creme”, “B-Meg”, “Petron”, “Gasul”, and other intellectual property rights to prepare, package, advertise, distribute and sell its products.

24

The disclosure on the Group’s intangible assets are reflected in the following section of the Audited Consolidated Financial Statements attached hereto as Annex “B”.

Note 3 | Significant Accounting Policies – Intangible Assets
Note 17 | Goodwill and Other Intangible Assets
Note 34 | Significant Agreements and Lease Commitments

Government Approvals and Compliance with Environmental Laws

Being an investment holding company, apart from its corporate registration with and primary franchise granted by the SEC, the Parent Company does not have any other government approvals which may be material to its operations. Likewise, the Parent Company is not required to comply with environmental laws and regulations in respect of any of its operations.

The Group has obtained all necessary permits, licenses and government approvals to manufacture and sell its products.

Government Regulation
The Group has no knowledge of recent or impending legislation, the implementation of which can result in a material adverse effect on the Group’s business or financial condition.

Research and Development

The Parent Company’s subsidiaries undertake regular research and development in the course of their regular business:

Food and Beverage

Beer and NAB
SMB employs state-of-the-art brewing technology. Its highly experienced brewmasters and quality assurance practitioners provide technical leadership and direction to continuously improve and maintain high standards in product quality, process efficiency, cost effectiveness and manpower competence.

Technology and processes are constantly updated and new product development is ensured through continuing research and development of beer and non-alcoholic beverages. Research and development activities are conducted in a technical center and pilot plant located in one of SMB’s production facilities.

SMB also has a central analytical laboratory which is equipped with modern equipment necessary for strategic raw materials analysis and validation, beer and non-alcoholic beverage evaluation and new raw material accreditation. Specialized equipment includes gas chromatography, high performance liquid chromatography, atomic absorption spectroscopy, protein analyzer, and laboratory scale mashing/milling system for malt analysis. Analytical methods and validation procedures are constantly enhanced and standardized across all of the laboratories of SMB. The central analytical laboratory likewise runs proficiency tests for brewery laboratories and suppliers to ascertain continuous reliability and quality of analytical test results. It is also tasked with ensuring compliance of all systems with international standards, specifically ISO 17025-2005.

To promote technical manpower development, SMB runs the San Miguel School of Brewing, which offers various programs spanning all levels of professional brewing technical training, starting from the basic brewing course for newly hired personnel to the advanced brewing course for senior technical personnel. Courses offered at the school included those highly-advanced classes necessary to qualify the most senior of its technical personnel known as brewmasters. Each of the more than 40 brewmasters has extensive advanced coursework and over ten years of on-the-job-training experience with SMB.

25

Spirits

Continuous research and development are part of the key focus area of GSMI to stay attuned to evolving market preferences. As such, a dedicated Research and Development team which maintains well-equipped laboratory closely collaborates with the market research group to constantly develop and formulate innovative products. The Research and Development team’s mandate is to enhance and further expand GSMI’s product library that will allow timely product launches as the need arises. Spending on research and development are mostly for new product development and various market research.

Food
The Food Segment has developed a systematic approach to new product development referred to as the stage-gate process, which is a five-step process comprising idea generation, feasibility testing, commercialization, launch and post-launch evaluations. The process optimizes returns on new product development by prioritizing innovations in the pipeline in a disciplined approach. New products that excite the more sophisticated palates of consumers as well as address the health awareness and convenience food trends are continuously introduced.

The Food Segment owns several research and development facilities that analyze average daily weight gain, feed conversion efficiency and other performance parameters. Results of these analyses are immediately applied to commercial feed formulations to minimize costs and maximize animal growth.

The research and development team also engage in the development, reformulation and testing of new products. It believes that its continued success will be affected in part by its ability to be innovative and attentive to consumer preferences and local market conditions. Aside from product innovations, the research and development teams of the Food Segment also look into efficiency improvement for operations through the use of new technology as a measure of increasing production cycles per farm per year, improving feed consumed to weight ratio and getting better harvest recovery.

Packaging
The Packaging Group plans to enter new markets and market segments with new products such as pharmaceuticals (plastic pharma bottles), semi-conductors and electronics (anti-static bags), food tubs, plastic wide-mouth jars and various converted can ends. The Packaging Group expects the future consumer trend towards environmentally friendly products and environmentally sound manufacturing systems. Hence, the Packaging Group plans to increase investments into eco-friendly facilities, processes and products.

Fuel and Oil
To enhance productivity, efficiency, reduce costs and strengthen the competitiveness of Petron, it engages in research and development to identify improvements that can be made to its production processes. The development, reformulation and testing of new products are continuing business activities of Petron.

Petron Turbo Diesel was reformulated to have higher cetane providing better power, fuel mileage, improved emission and engine protection. The new Petron HTP product line was also launched this year, offering high quality, fully-synthetic PAO-based (Polyalphaolefin) premium engine oils (Petron Blaze Racing HTP and Petron Rev-X Turbo HTP) with outstanding oxidation and thermal stability. The HTP product line also consists of gear oil (Petron GHTP Gear Oil), grease (Petron Grease HTP), transmission fluid (Petron ATF Premium HTP) and brake fluid (Petron Brake Fluid HTP) all offering better defense against extreme engine temperature. Petron Sprint 4T Scooter Oils Fully Synthetic, Synthetic Blend and Premium Multi-grade were also developed to cater to the specific requirements of scooters or four-stroke motorcycles fitted with automatic transmission offering better fuel economy, engine cleanliness, shear stability and engine protection.

26

Petron’s products are regularly tested by third party testing institutes to secure stringent certifications and approvals from accredited global industry certifying bodies and original equipment manufacturers (OEMs). These approvals serve as a testimony that our products are certified world class. For 2018, Petron was able to secure ACEA (Association des Constructeurs Européens d’Automobiles/Association European Automobile Manufacturers Association) registration for our Blaze Racing gasoline engine oils and Rev-X diesel engine oils. This is on top of the renewal of licenses and approvals from industry standards such as API (American Petroleum Institute), NMMA (National Marine Manufacturers Association), and OEM approvals from BMW, Mercedes Benz, Porsche, Cummins, MAN, MTU and Volvo.

Petron is committed to continuously develop innovative and revolutionary products that meet and exceed the highest industry quality standards and demands of the market. Petron believes that its continued success will be affected in part by its ability to be innovative and attentive to consumer preferences and local market conditions.

Petron’s Research and Development Group has long-standing partnerships with leading global technology providers in fuels, lubricants and grease products. It is engaged in the customization of products at globally competitive quality and performance. It also manages ISO-accredited petroleum and allied products testing facility that meets global standards. In addition, it provides technical training to keep internal and external customers updated of the latest technology trends in the industry.

Energy
SMC Global seeks to capitalize on regulatory and infrastructure developments by scheduling the construction of greenfield power projects to coincide with the planned improvements in the interconnectivity of the Luzon and Visayas grids, as well as the eventual interconnectivity and implementation of WESM in Mindanao. In addition, SMC Global seeks to maintain the cost competitiveness of these new projects by strategically locating them in high-demand areas and in areas with the closest proximity to the grid.

SMC Global is considering further expansion of its power portfolio of new capacity nationwide through greenfield power plants over the next few years, depending on market demand. SMC Global plans to carry out the expansion of its power portfolio in phases across Luzon, Visayas and Mindanao. SMC Global is confident from its experience in building the Limay Greenfield Power Plant and Davao Greenfield Power Plant that it will be able it to build new cost competitive plants.

SMC Global’s expansion projects under construction include Unit 4 (150 MW) of the Limay Greenfield Power Plant and Unit 3 (335 MW) of the Masinloc Power Plant. In addition, it is in the process of finalizing the EPC contract for the Kabankalan BESS (2 x 20 MW) with one of the leading battery EPC contractors worldwide. As of December 31, 2018, SMC Global also owns 49% of the equity interests in MPGC, which plans to develop, construct, finance, own, operate and maintain a 4 x 150 MW circulating fluidized bed coal-fired power plant and associated facilities in Mariveles, Bataan. SMC Global is considering further expansion of its power portfolio through the development and construction of a new power plant located in Pagbilao, Quezon, with a planned installed capacity of 600 MW.

In addition, as a leading power company in the Philippines with a large customer base, SMC Global believes that it is in a strong position to leverage its relationships with its existing customers to service their expected increase in electricity demand.

Infrastructure
SMC’s Infrastructure group is currently undertaking various research and development activities in relation to its infrastructure projects, such as transport planning, traffic and ridership studies and analyses.

The Group’s expenses for research and development are as follows (amounts in millions):

| 2018 | 2017 | 2016
Research and Development | P499 | P456 | P395
Percentage to Net Income | 1.03% | 0.83% | 0.76%

27

Cost of Compliance with Environmental Laws

On an annual basis, operating expenses incurred by the Group to comply with environmental laws are not significant or material relative to the Parent Company and its subsidiaries’ total cost and revenues.

Human Resources and Labor Matters

As of December 31, 2018, the Group has about 28,598 employees and has 35 existing collective bargaining agreements (CBA). Of the 35 CBAs, 21 will be expiring in 2019.

The list of CBAs entered into by the Parent Company and its subsidiaries with their different employee unions, is attached hereto as Annex “F”.

Major Business Risks

The major business risks facing the Group are as follows:

a) Competition Risks

The Group operates in highly competitive environments. New and existing competitors can erode the Group’s competitive advantage through the introduction of new products, improvement of product quality, increase in production efficiency, new or updated technologies, costs reductions, and the reconfiguration of the industry’s value chain. The Group has responded with the corresponding introduction of new products in practically all businesses, improvement in product propositions and packaging, and redefinition of the distribution system of its products.

b) Operational Risks

The facilities and operations of the Group could be severely disrupted by many factors, including accidents, breakdown or failure of equipment, interruption in power supply, human error, natural disasters and other unforeseen circumstances and problems. These disruptions could result in product run-outs, facility shutdown, equipment repair or replacement, increased insurance costs, personal injuries, loss of life and unplanned inventory build-up, all of which could have a material adverse effect on the business, financial condition and results of operations of the Group.

The Group undertakes necessary precautions to minimize impact of any significant operational problems in its subsidiaries through effective maintenance practices.

c) Legal and Regulatory Risks

The businesses and operations of the Group are subject to a number of national and local laws, rules and regulations governing several different industries in the Philippines and in other countries where it conducts its businesses. The Group is also subject to various taxes, duties and tariffs.

In addition, the Philippine government may periodically implement measures aimed at protecting consumers from rising prices, which may constrain the ability of the Group to pass on price increases to distributors who sell its products, as well as its customers. Implementation of any such measures could have a material adverse effect on the business, financial condition and results of operations of the Group.

The Group is in constant consultation with relevant government agencies and other approving bodies to ensure that all requirements, permits and approvals are anticipated and obtained in a timely manner. Further, the Group maintains a strong compliance culture and has processes in place in order to manage adherence to laws and regulations. In the event that the Group becomes involved in future litigation or other proceedings or be held responsible in any future litigation and proceedings,

28

SMC endeavors to amicably settle the legal proceedings and in the event of any adverse ruling or decision, diligently exhaust all legal remedies available to it.

d) Social and Cultural Risks

The ability of the Group to successfully develop and launch new products and maintain demand for existing products depends on the acceptance of such products by consumers and their purchasing power and disposable income levels, which may be adversely affected by unfavorable economic developments in the Philippines. A significant decrease in disposable income levels or consumer purchasing power in the target markets of the food and beverage businesses could materially and adversely affect the financial position and financial performance of the Group. Consumer preferences may shift for a variety of reasons, including changes in culinary, demographic and social trends or leisure activity patterns. Concerns about health effects due to negative publicity regarding alcohol consumption, negative dietary effects or other factors may also affect consumer purchasing patterns for the beverage and food products. If the marketing strategies of the Group are not successful or do not respond timely or effectively to changes in consumer preferences, the business and prospects of the Group could be materially and adversely affected.

Sales of beer are highly influenced by the purchasing power and disposable income levels of consumers. In periods of economic uncertainty or downturns, consumers may purchase fewer alcoholic beverages which could affect the financial performance of the beverage business. Likewise, demand for many of the food products is tied closely to the purchasing power of consumers.

The Group has introduced products that try to address or are attuned to the evolving lifestyles and needs of its consumers. San Mig Light and San Mig Zero, a low calorie beer, were introduced to address increasing health consciousness and San Mig Strong Ice for the upwardly mobile market. Initiatives similar to this have been pushed in the food division for years.

e) Raw Materials Sourcing Risks

The products and businesses of the Group, specifically the beverage, food, packaging, fuel and oil and energy businesses, depend on the availability of raw materials. Most of these raw materials, including some critical raw materials, are procured from third parties. These raw materials are subject to price volatility caused by a number of factors, including changes in global supply and demand, foreign exchange rate fluctuations, weather conditions and governmental controls.

Movements in the supply of global crops may affect prices of raw materials, such as wheat, malted barley, adjuncts and molasses for the beverage and food businesses. The Group may also face increased costs or shortages in the supply of raw materials due to the imposition of new laws, regulations or policies.

Alternative sources of raw materials are used in the Group’s operations to avoid and manage risks on unstable supply and higher costs.

The Group enters into various commodity derivatives to manage its price risks on strategic commodities. Commodity hedging allows stability in prices, thus offsetting the risk of volatile market fluctuations. Through hedging, prices of commodities are fixed at levels acceptable to the Group, thus protecting raw material cost and preserving margins.

f) Financial Risks

In the course of its operations, the Group is exposed to financial risks, namely:

29

### 1. Interest Rate Risk

The Group’s exposure to changes in interest rates relates primarily to the long-term borrowings and investment securities. Investment securities acquired or borrowings issued at fixed rates expose the Group to fair value interest rate risk. On the other hand, investment securities acquired or borrowings issued at variable rates expose the Group to cash flow interest rate risk.

### 2. Foreign Currency Risk

The exposure to foreign currency risk results from significant movements in foreign exchange rates that adversely affect the foreign currency-denominated transactions of the Group.

### 3. Liquidity Risk

Liquidity risk pertains to the risk that the Group will encounter difficulty to meet payment obligations when they fall under normal and stress circumstances.

### 4. Credit Risk

Credit risk is the risk of financial loss to the Group when a customer or counterparty to a financial instrument fails to meet its contractual obligations, and arises principally from trade and other receivables and investment securities.

Prudent fund management is employed to manage exposure to changes in earnings as a result of fluctuations of interest rates, foreign currency rates, etc.

The Group uses a combination of natural hedges, which involve holding U.S. dollar-denominated assets and liabilities, and derivative instruments to manage its exchange rate risk exposure.

Liquidity risks are managed to ensure adequate liquidity of the Group through monitoring of accounts receivables, inventory, loans and payables. A committed stand-by credit facility from several local banks is also available to ensure availability of funds when necessary.

Please refer to Note 40 of the Notes to the Audited Consolidated Financial Statements attached hereto as Annex “B” for the discussion of the Group’s Financial Risk Management Objectives and Policies.

Item 2. Properties

A summary of information on the Parent Company and its significant subsidiaries principal properties and conditions thereof, is attached hereto as Annex “D”.

The Parent Company and its significant subsidiaries have no principal properties that are subject to a lien or mortgage. There are no imminent acquisitions of any material property that cannot be funded by working capital of the Group.

For additional information on the Group’s properties, please refer to Note 14, Property, Plant and Equipment, and Note 15, Investment Property, of the Audited Consolidated Financial Statements attached hereto as Annex “B”.

30

Item 3. Legal Proceedings

The Group is not a party to, and its properties are not the subject of, any material pending legal proceeding that could be expected to have a material adverse effect on the Group’s financial performance.

For further details on pending legal proceedings of the Group, please refer to Notes 6, 24 and 43 of the Audited Consolidated Financial Statements attached hereto as Annex “B”.

Item 4. Submission of Matters to a Vote of Security Holders

There are no matters which were submitted to a vote of the Parent Company’s stockholders, through the solicitation of proxies or otherwise, during the fourth quarter of 2018.

PART II – OPERATIONAL AND FINANCIAL INFORMATION

Item 5. Market for Issuer’s Common Equity and Related Stockholder Matters

The Company's common shares, Series “1” preferred shares and Series “2” preferred shares are listed and traded in the Philippine Stock Exchange. The percentage of public ownership of the Company as of December 31, 2018 is 15.41%.

The Company’s high and low closing prices for each quarter of the last two (2) fiscal years and for the first quarter of 2019 are as follows:

| 2018 2019
| 1 st | 2 nd | 3 rd | 4 th | 1 st
| High | Low | High | Low | High | Low | High | Low | High | Low
Common | 152.00 | 111.60 | 145.40 | 134.00 | 180.10 | 134.00 | 175.40 | 139.00 | 180.00 | 144.80
Preferred – 2B | 77.50 | 75.00 | 78.00 | 75.20 | 91.00 | 75.00 | 76.45 | 75.00 | 75.90 | 74.00
Preferred – 2C | 81.50 | 75.00 | 79.95 | 77.00 | 80.90 | 77.50 | 78.10 | 75.75 | 77.40
Preferred – 2D | 77.00 | 74.50 | 76.90 | 74.90 | 76.00 | 72.00 | 75.40 | 70.00 | 74.45 | 71.40
Preferred – 2E | 79.00 | 75.00 | 76.95 | 75.05 | 77.00 | 73.35 | 75.45 | 71.95 | 75.00 | 71.30
Preferred – 2F | 81.50 | 77.30 | 79.50 | 76.00 | 77.50 | 74.50 | 75.35 | 70.05 | 76.80 | 72.00
Preferred – 2G | 78.60 | 75.00 | 76.80 | 75.00 | 76.50 | 74.60 | 75.20 | 70.30 | 74.90 | 71.20
Preferred – 2H | 79.60 | 75.00 | 78.00 | 75.00 | 77.50 | 72.50 | 75.00 | 71.85 | 74.50 | 71.00
Preferred – 2I | 79.80 | 76.80 | 78.90 | 75.10 | 77.00 | 74.50 | 75.00 | 70.05 | 75.00 | 71.05
| 2017
| 1 st | 2 nd | 3 rd | 4 th
| High | Low | High | Low | High | Low | High | Low
Common | 108.00 | 92.30 | 111.20 | 101.50 | 104.00 | 96.60 | 124.50 | 97.10
Preferred – 2B | 78.30 | 76.00 | 78.00 | 76.00 | 77.00 | 74.00 | 78.05 | 74.50
Preferred – 2C | 83.50 | 79.70 | 83.00 | 80.00 | 82.00 | 79.40 | 82.95 | 80.00
Preferred – 2D | 78.50 | 75.50 | 78.00 | 76.00 | 77.75 | 75.85 | 78.50 | 75.10
Preferred – 2E | 79.10 | 76.40 | 81.60 | 77.00 | 80.00 | 76.55 | 80.00 | 76.25
Preferred – 2F | 81.10 | 78.10 | 81.30 | 79.00 | 82.00 | 80.00 | 82.70 | 79.50
Preferred – 2G | 79.50 | 77.00 | 79.50 | 77.00 | 79.95 | 78.00 | 79.95 | 76.50
Preferred – 2H | 79.50 | 76.60 | 79.00 | 77.50 | 79.70 | 77.30 | 79.50 | 76.15
Preferred – 2I | 80.00 | 77.20 | 79.50 | 77.60 | 80.90 | 76.55 | 81.70 | 77.25

The closing prices as of April 1, 2018, the latest practicable trading date, are as follows:

Common | P 173.50
Series “2-B” Preferred P 75.00 Series “2-C” Preferred P 75.50 Series “2-D” Preferred P 71.60 Series “2-E” Preferred P 72.50 Series “2-F” Preferred P 73.75 Series “2-G” Preferred P 73.00 Series “2-H” Preferred P 73.75 Series “2-I” Preferred P 74.45

The approximate number of shareholders as of December 31, 2018 is 35.853.

31

The top 20 common and preferred stockholders as of December 31, 2018 are attached as Annex “G”.

The Board of Directors of the Parent Company approved the declaration and payment of the following cash dividends to common and preferred stockholders as follows:

2018
Class of
Shares | Date of Declaration | Date of Record | Date of Payment | Dividend per
| | | | Share
Common
| March 15, 2018 | April 6, 2018 | May 4, 2018 | P0.35
| June 14, 2018 | July 2, 2018 | July 25, 2018 | 0.35
| September 13, 2018 | October 5, 2018 | October 30, 2018 | 0.35
| December 6, 2018 | January 2, 2019 | January 24, 2019 | 0.35
Preferred
SMCP1 | January 25, 2018 | March 8, 2018 | April 5, 2018 | 1.0565625
| May 10, 2018 | June 21, 2018 | July 6, 2018 | 1.0565625
| August 9, 2018 | September 21, 2018 | October 5, 2018 | 1.0565625
| November 13, 2018 | December 21, 2018 | January 11, 2019 | 1.0565625
SMC2B | January 25, 2018 | March 8, 2018 | April 5, 2018 | 1.4296875
| May 10, 2018 | June 21, 2018 | July 6, 2018 | 1.4296875
| August 9, 2018 | September 21, 2018 | October 5, 2018 | 1.4296875
| November 13, 2018 | December 21, 2018 | January 11, 2019 | 1.4296875
SMC2C | January 25, 2018 | March 8, 2018 | April 5, 2018 | 1.50
| May 10, 2018 | June 21, 2018 | July 6, 2018 | 1.50
| August 9, 2018 | September 21, 2018 | October 5, 2018 | 1.50
| November 13, 2018 | December 21, 2018 | January 11, 2019 | 1.50
SMC2D | January 25, 2018 | March 8, 2018 | April 5, 2018 | 1.11433125
| May 10, 2018 | June 21, 2018 | July 6, 2018 | 1.11433125
| August 9, 2018 | September 21, 2018 | October 5, 2018 | 1.11433125
| November 13, 2018 | December 21, 2018 | January 11, 2019 | 1.11433125
SMC2E | January 25, 2018 | March 8, 2018 | April 5, 2018 | 1.18603125
| May 10, 2018 | June 21, 2018 | July 6, 2018 | 1.18603125
| August 9, 2018 | September 21, 2018 | October 5, 2018 | 1.18603125
| November 13, 2018 | December 21, 2018 | January 11, 2019 | 1.18603125
SMC2F | January 25, 2018 | March 8, 2018 | April 5, 2018 | 1.27635
| May 10, 2018 | June 21, 2018 | July 6, 2018 | 1.27635
| August 9, 2018 | September 21, 2018 | October 5, 2018 | 1.27635
| November 13, 2018 | December 21, 2018 | January 11, 2019 | 1.27635
SMC2G | January 25, 2018 | March 8, 2018 | April 5, 2018 | 1.23361875
| May 10, 2018 | June 21, 2018 | July 6, 2018 | 1.23361875
| August 9, 2018 | September 21, 2018 | October 5, 2018 | 1.23361875
| November 13, 2018 | December 21, 2018 | January 11, 2019 | 1.23361875
SMC2H | January 25, 2018 | March 8, 2018 | April 5, 2018 | 1.1854125
| May 10, 2018 | June 21, 2018 | July 6, 2018 | 1.1854125
| August 9, 2018 | September 21, 2018 | October 5, 2018 | 1.1854125
| November 13, 2018 | December 21, 2018 | January 11, 2019 | 1.1854125
SMC2I | January 25, 2018 | March 8, 2018 | April 5, 2018 | 1.18790625
| May 10, 2018 | June 21, 2018 | July 6, 2018 | 1.18790625
| August 9, 2018 | September 21, 2018 | October 5, 2018 | 1.18790625
| November 13, 2018 | December 21, 2018 | January 11, 2019 | 1.18790625

32

2017
Class of Shares | Date of Declaration | Date of Record | Date of Payment | Dividend per
| | | | Share
Common
| March 16, 2017 | April 7, 2017 | May 4, 2017 | P0.35
| June 13, 2017 | June 30, 2017 | July 25, 2017 | 0.35
| September 14, 2017 | October 9, 2017 | November 6, 2017 | 0.35
| December 7, 2017 | January 2, 2018 | January 24, 2018 | 0.35
Preferred
SMCP1 | January 12, 2017 | March 21, 2017 | April 5, 2017 | 1.0565625
| May 10, 2017 | June 21, 2017 | July 6, 2017 | 1.0565625
| August 10, 2017 | September 21, 2017 | October 6, 2017 | 1.0565625
| November 10, 2017 | December 21, 2017 | January 5, 2018 | 1.0565625
SMC2B | January 12, 2017 | March 21, 2017 | April 5, 2017 | 1.4296875
| May 10, 2017 | June 21, 2017 | July 6, 2017 | 1.4296875
| August 10, 2017 | September 21, 2017 | October 6, 2017 | 1.4296875
| November 10, 2017 | December 21, 2017 | January 5, 2018 | 1.4296875
SMC2C | January 12, 2017 | March 21, 2017 | April 5, 2017 | 1.50
| May 10, 2017 | June 21, 2017 | July 6, 2017 | 1.50
| August 10, 2017 | September 21, 2017 | October 6, 2017 | 1.50
| November 10, 2017 | December 21, 2017 | January 5, 2018 | 1.50
SMC2D | January 12, 2017 | March 21, 2017 | April 5, 2017 | 1.11433125
| May 10, 2017 | June 21, 2017 | July 6, 2017 | 1.11433125
| August 10, 2017 | September 21, 2017 | October 6, 2017 | 1.11433125
| November 10, 2017 | December 21, 2017 | January 5, 2018 | 1.11433125
SMC2E | January 12, 2017 | March 21, 2017 | April 5, 2017 | 1.18603125
| May 10, 2017 | June 21, 2017 | July 6, 2017 | 1.18603125
| August 10, 2017 | September 21, 2017 | October 6, 2017 | 1.18603125
| November 10, 2017 | December 21, 2017 | January 5, 2018 | 1.18603125
SMC2F | January 12, 2017 | March 21, 2017 | April 5, 2017 | 1.27635
| May 10, 2017 | June 21, 2017 | July 6, 2017 | 1.27635
| August 10, 2017 | September 21, 2017 | October 6, 2017 | 1.27635
| November 10, 2017 | December 21, 2017 | January 5, 2018 | 1.27635
SMC2G | January 12, 2017 | March 21, 2017 | April 5, 2017 | 1.23361875
| May 10, 2017 | June 21, 2017 | July 6, 2017 | 1.23361875
| August 10, 2017 | September 21, 2017 | October 6, 2017 | 1.23361875
| November 10, 2017 | December 21, 2017 | January 5, 2018 | 1.23361875
SMC2H | January 12, 2017 | March 21, 2017 | April 5, 2017 | 1.1854125
| May 10, 2017 | June 21, 2017 | July 6, 2017 | 1.1854125
| August 10, 2017 | September 21, 2017 | October 6, 2017 | 1.1854125
| November 10, 2017 | December 21, 2017 | January 5, 2018 | 1.1854125
SMC2I | January 12, 2017 | March 21, 2017 | April 5, 2017 | 1.18790625
| May 10, 2017 | June 21, 2017 | July 6, 2017 | 1.18790625
| August 10, 2017 | September 21, 2017 | October 6, 2017 | 1.18790625
| November 10, 2017 | December 21, 2017 | January 5, 2018 | 1.18790625

On January 24, 2019, the Board of Directors of the Parent Company declared cash dividends to all preferred stockholders of record as of March 22, 2019 on the following shares to be paid on April 5, 2019, as follows:

Class of Shares | Dividends Per Share
| SMCP1 | | P1.0565625
| SMC2B | | 1.4296875
SMC2C | 1.50
| SMC2D | | 1.11433125
| SMC2E | | 1.18603125
| SMC2F | | 1.27635
| SMC2G | | 1.23361875
| SMC2H | | 1.1854125
| SMC2I | | 1.18790625

33

On March 14, 2019, the Board of Directors of the Parent Company declared cash dividends at P0.35 per share to all common stockholders of record as of April 5, 2019 to be paid on May 3, 2019.

Description of the following securities of the Group may be found in the indicated Notes to the 2018 Audited Consolidated Financial Statements, attached herein as Annex “B”:

Equity | Note 24
Share-based transactions | Note 39

There were no securities sold by the Parent Company within the past three (3) years which were not registered under the Securities Regulation Code.

Item 6. Management's Discussion and Analysis or Plan of Operation.

(A) Management Discussion and Analysis

The information required by Item 6 (A) may be found on Annex “A” hereto.

(B) Information on Independent Accountant and Other Related Matters

The accounting firm of R.G. Manabat & Co. served as the Parent Company’s external auditors for the last thirteen (13) fiscal years. The BOD will again nominate R.G. Manabat & Co. as the Parent Company’s external auditors for this fiscal year.

Representatives of R.G. Manabat & Co. are expected to be present at the stockholders’ meeting and will be available to respond to appropriate questions. They will have the opportunity to make a statement if they so desire.

The Parent Company paid the external auditor the amount of P32 million and P11 million, respectively, for its services rendered in 2018 and 2017.

The stockholders approve the appointment of the Parent Company’s external auditors. The Audit Committee reviews the audit scope and coverage, strategy and results for the approval of the board and ensures that audit services rendered shall not impair or derogate the independence of the external auditors or violate SEC regulations. The Parent Company’s Audit Committee’s approval policies and procedures for external audit fees and services are stated in the Parent Company’s Manual of Corporate Governance.

Item 7. Financial Statements

The Audited Consolidated Financial Statements together with the Statement of Management’s Responsibility is attached as Annex “B”, with the Supplementary Schedules attached as Annex “C” hereto. The auditors’ PTR, name of certifying partner and address are attached as Annex “B-1” hereto.

Item 8. Changes in and Disagreements with Accountants on Accounting and Financial Disclosure

There are no disagreements with the Parent Company’s external auditors on accounting and financial disclosure.

34

PART III – CONTROL AND COMPENSATION INFORMATION

Item 9. Directors and Executive Officers of the Issuer

The names of the incumbent and key executive officers of the Company, and their respective ages, periods of service, directorships in other reporting companies and positions held in the last five (5) years, are as follows:

Board of Directors

Name | Age | Citizenshi
| | p | Position
Eduardo M. Cojuangco, Jr | | 83 | Filipino | Chairman and Chief Executive
| | | Officer
Ramon S. Ang | | 65 | Filipino | Vice Chairman, President and
| | | Chief Operating Officer
Estelito P. Mendoza | | 89 | Filipino | Dir2ector
Leo S. Alvez | | 76 | Filipino | Director
Aurora T. Calderon | | 64 | Filipino | Director
Joselito D. Campos, Jr | | 68 | Filipino | Director
Menardo R. Jimenez | | 86 | Filipino | Director
Alexander J. Poblador | | 65 | Filipino | Director
Thomas A. Tan | | 65 | Filipino | Director
Iñigo U. Zobel | | 62 | Filipino | Director
Jose De Venecia, Jr. | | 82 | Filipino | Director
Ramon F. Villavicencio¹ | | 77 | Filipino | Director
Reynaldo G. David | | 76 | Filipino | Independent Director
Reynato S. Puno | | 78 | Filipino | Independent Director
Margarito B. Teves | | 75 | Filipino | Independent Director

Eduardo M. Cojuangco, Jr. is the Chairman of the Board and Chief Executive Officer of the Company, a position he has held since July 7, 1998. He is also the Chairman of the Executive Committee of the Company. He also holds the following positions in other publicly listed companies: Chairman of the Board and Chief Executive Officer of Ginebra San Miguel Inc.; and Chairman of the Board of San Miguel Food and Beverage, Inc. and Petron Corporation. He is also the Chairman of the Board of ECJ & Sons Agricultural Enterprises, Inc., Eduardo Cojuangco, Jr. Foundation, Inc., San Miguel Northern Cement, Inc., and Northern Cement Corporation, and a Director of Caiñaman Farms, Inc. He attended the University of the Philippines – Los Baños College of Agriculture and California Polytechnic College in San Luis, Obispo, U.S.A.

Ramon S. Ang is the Vice Chairman since January 28, 1999, President and Chief Operating Officer since March 6, 2002 of the Company. He is also a Member of the Executive Committee of the Company. He also holds, among others, the following positions in other publicly listed companies: President and Chief Executive Officer of Top Frontier Investment Holdings Inc. and Petron Corporation; President of Ginebra San Miguel, Inc.; Chairman of the Board of Directors of San Miguel Brewery Hong Kong Limited (listed in the Hong Kong Stock Exchange), Petron Malaysia Refining & Marketing Bhd. (a company publicly listed in Malaysia) and Eagle Cement Corporation; and Vice Chairman of the Board, President and Chief Executive Officer of San Miguel Food and Beverage, Inc. He is also the Chairman of the Board of San Miguel Brewery Inc.; Chairman of the Board and Chief Executive Officer of, and concurrently the President of, and Chief Operating Officer of SMC Global Power Holdings Corp.; Chairman of the Board and President of San Miguel Holdings Corp., San Miguel Equity Investments Inc., San Miguel Properties, Inc., SEA Refinery Corporation and San Miguel Aerocity Inc.; Chairman of the Board and Chief Executive Officer of SMC Asia Car Distributors Corp.; Chairman of the Board of San Miguel Brewery Inc., San Miguel Foods, Inc., San Miguel Yamamura Packaging Corporation, Clariden Holdings, Inc., Anchor Insurance Brokerage Corporation and Philippine Diamond Hotel & Resort, Inc.; President of

1 On March 15, 2018, Mr. Ramon F. Villavicencio was elected as a member of the Board of Directors of SMC.

35

San Miguel Northern Cement, Inc. and President and Chief Executive Officer of Northern Cement Corporation. He is also the sole director and shareholder of Master Year Limited and the Chairman of the Board of Privado Holdings, Corp. He formerly held the following positions: Chairman of the Board of Liberty Telecoms Holdings, Inc. and Cyber Bay Corporation, President and Chief Operating Officer of PAL Holdings, Inc. and Philippine Airlines, Inc.; Director of Air Philippines Corporation;; and Vice Chairman of the Board and Director of Manila Electric Company. Mr. Ang has held directorships in various domestic and international subsidiaries of SMC in the last five years. He has a Bachelor of Science degree in Mechanical Engineering from Far Eastern University.

Estelito P. Mendoza was first elected as a Director of the Company on October 30, 1991 and served until April 21, 1993. He was re-elected as Director of the Company on April 21, 1998 up to the present. He is a Member of the Executive Committee and Audit Committee of the Company. He is also a Director of Petron Corporation, Philippine National Bank, and Philippine Airlines, Inc. He was formerly a director of the Manila Electric Company. Atty. Mendoza, a former Solicitor General, Minister of Justice, Member of the Batasang Pambansa and Governor of the Province of Pampanga, heads the E.P. Mendoza Law Office, and was also formerly Chairman of the Board of Dutch Boy Philippines, Inc. and Alcorn Petroleum and Minerals Corporation, and Director of East-West Bank. He graduated from the University of the Philippines College of Law cum laude. He also holds a Master of Laws degree from Harvard Law School.

Leo S. Alvez has been a Director of the Company since February 27, 2002 and a Member of the Audit Committee of the Company. He is also a Director of Ginebra San Miguel, Inc., Chairman of its Nominations and Hearing Committee and Member of its Executive Compensation Committee and Audit Committee; and a former Director of San Miguel Pure Foods Company, Inc., both of which are publicly listed companies. Ret. Major General Alvez is a former Security Consultant to the Prosecution Panel of the Senate Impeachment Trial of President Joseph Estrada (2000-2001), Vice Commander of the Philippine Army (1998), and Division Commander of the 7th Infantry Division (1996-1998). He is a graduate of the Philippine Military Academy and has a Masters in Business Administration degree from the University of the Philippines.

Aurora T. Calderon has been a director of the Company since June 10, 2014. She is also the Senior Vice President-Senior Executive Assistant to the President and Chief Operating Officer of the Company since January 20, 2011. She is a member of the Corporate Governance Committee of the Company. She holds the following positions in other publicly listed companies, namely: Director and Treasurer of Top Frontier Investment Holdings, Inc.; and Director of San Miguel Food and Beverage, Inc., Ginebra San Miguel, Inc., Petron Corporation and Petron Malaysia Refining & Marketing Bhd. (a company publicly listed in Malaysia). She is also a member of the Board of Directors of SMC Global Power Holdings Corp., Petron Marketing Corporation, Petron Freeport Corporation, New Ventures Realty Corporation, Las Lucas Construction and Development Corporation, Thai San Miguel Liquor Company Limited, San Miguel Equity Investments Inc., SMC Asia Car Distributors Corp., San Miguel Yamamura Packaging Corp., and San Miguel Aerocity Inc. She was formerly a Director of PAL Holdings, Inc., Philippine Airlines, Inc., Trustmark Holdings Corporation, Zuma Holdings and Management Corporation, Air Philippines Corporation, and Manila Electric Company. A certified public accountant, Ms. Calderon graduated magna cum laude from the University of the East with a degree in BS Business Administration, major in Accountancy. In addition, Ms. Calderon holds directorships in various SMC domestic and international subsidiaries.

Joselito D. Campos, Jr. has been a Director since May 31, 2010. He is a member of the Related Party Transactions Committee of the Company. He is the Managing Director, Chief Executive Officer and member of the Board of Directors of Del Monte Pacific Ltd.; President and Chief Executive Officer of Del Monte Philippines, Inc. He is also the Chairman of the Board and Chief Executive Officer of the NutriAsia Group of Companies; Chairman of the Board of Fort Bonifacio Development Corp.; and Vice Chairman of the Board of Ayala Greenfield Development Corp. He is also a Director of FieldFresh Foods (Pvt.) Ltd. He is also the Honorary Consul General in the Philippines for the Republic of Seychelles. He is Chairman of the Metropolitan Museum of Manila and a Member of the Asia Society in the

36

Philippines, the Philippines-China Business Council, the Philippine Center for Entrepreneurship and the WWF (World Wildlife Fund) for Nature - Philippines. He was the former Chairman of the Board and Chief Executive Officer of United Laboratories, Inc. and its regional subsidiaries and affiliates. He graduated with a degree in BS Commerce, major in International Business from the University of Santa Clara, California and a Masters in Business Administration degree from Cornell University, New York.

Jose De Venecia, Jr. is a Director of the Company since March 16, 2017. He was former Speaker of the House of Representatives (from 1992 to 1998, and from 2001 to 2008). Before joining politics, he was an international entrepreneur, engaged in the business of port operations in Saudi Arabia, agriculture in Africa, mass housing in Iraq and oil exploration in the United Arab Emirates. He has a Bachelor of Arts degree in Journalism from the Ateneo de Manila University. He completed his secondary education at De La Salle College, Manila.

Menardo R. Jimenez has been a Director of the Company since February 27, 2002 and a Member of the Executive Committee and Corporate Governance Committee of the Company. He is also a Director of San Miguel Food and Beverage, Inc., a publicly listed company, and Magnolia, Inc. His other positions include: Chairman of Majent Management and Development Corporation; Chairman of Coffee Bean and Tea Leaf Holdings, Inc., and Meedson Properties Corporation, among others. He is a graduate of Far Eastern University with a degree of Bachelor of Science in Commerce and is a certified public accountant.

Alexander J. Poblador has been a Director of the Company since September 1, 2009 and a Member of the Related Party Transactions Committee of the Company. He is the Founding Partner and Chairman of the Executive Committee of Poblador Bautista & Reyes Law Office. Atty. Poblador is a practicing lawyer, specializing in the fields of commercial litigation, international arbitration, real estate finance and project development, bankruptcy and corporate reorganization. He is a graduate of the University of the Philippines with a degree in Bachelor of Laws cum laude, class valedictorian, and Bachelor of Arts in Political Science cum laude. He also holds a Master of Laws degree from the University of Michigan, at Ann Arbor, School of Law (De Witt Fellow).

Thomas A. Tan was elected as a Director of the Company on June 14, 2012. He is the President and General Manager of SMC Shipping and Lighterage Corporation and President of Saturn Cement Corporation and Sakamoto International Packaging Corp. He obtained a degree in Bachelor of Science, major in Physics in 1974 from the Ateneo de Manila University and a Masters in Business Management degree from the Asian Institute of Management in 1976. He is likewise a Director of other affiliates of the Company.

Ramon F. Villavicencio is a Director of the Company since March 15, 2018. Prior to his election as director of the Company, he owns the ICVI Financial Consultancy Services, has ownership interests in JoyToAll Amusement Corporation and is a consultant of Petro Finance Services, Inc. He graduated from De La Salle College with a degree in Bachelor of Science in Commerce and a Masters in Business Administration.

Iñigo Zobel has been a Director of the Company since October 2009 and was an Independent Director of the Company from May 5, 1999 until October 2009. He is a Member of the Executive Committee of the Company. He holds the position of Chairman of the Board of Top Frontier Investment Holdings Inc., a publicly listed company. He is also the Chairman of the Board and President of Zygnet Prime Holdings Inc.; Chairman of the Board of IZ Investment Holdings, Inc. and E. Zobel, Inc.; Director of E. Zobel Foundation, Inc. Calatagan Golf Club, Inc., Calatagan Bay Realty, Inc., Hacienda Bigaa, Inc., MERMAC, Inc., among others. He was formerly Chairman (2015-2016), Vice Chairman (since 2016) and President (since 2015) of Manila North Harbour Port, Inc., a Director of PAL Holdings, Inc. and Philippine Airlines, Inc., and President and Chief Operating Officer of Air Philippines Corporation. He was formerly an Independent Director of San Miguel Brewery Inc., San Miguel Pure Foods Company, Inc., San Miguel Properties, Inc., and Ginebra San Miguel, Inc. He attended Santa Barbara College, California, U.S.A.

37

Reynaldo G. David has served as an Independent Director of the Company since June 14, 2016. He is the Chairman of the Related Party Transactions Committee and a Member of the Audit and Risk Oversight Committee and Corporate Governance Committee of the Company. He is also an Independent Director of Petron, a publicly listed company, and Tiger Resort, Leisure & Entertainment, Inc. He has previously held among others, the following positions: President and Chief Executive Officer of the Development Bank of the Philippines; Chairman of NDC Maritime Leasing Corporation; and Director of DBP Data Center, Inc. and Al-Amanah Islamic Bank of the Philippines. A certified public accountant since 1964, he graduated from the De La Salle University with a combined Bachelor of Arts and Bachelor of Science in Commerce degrees in 1963 and attended the Advanced Management Program of the University of Hawaii (1974). He was conferred with the title Doctor of Laws, honoris causa, by the Palawan State University in 2005 and the title Doctor of Humanities, honoris causa, by the West Visayas State University in 2009.

Reynato S. Puno was elected to the Board as an Independent Director of the Company on January 20, 2011 and is the Chairman of the Corporate Governance Committee and a Member of the Audit and Risk Oversight Committee of the Company. He is also an independent director of San Miguel Brewery Hong Kong Ltd. (a company publicly listed in the Hong Kong Stock Exchange) and Union Bank of the Philippines, Inc., and a member of the Board of Commissioners of PT Delta Djakarta Tbk (a company listed in the Indonesia Stock Exchange). He is also the Chairman of the Environmental Heroes Foundation and World Vision; Vice Chairman of the Board of the GMA Kapuso Foundation; and Director of The New Standard newspaper. He was the Chief Justice of the Supreme Court from December 6, 2006 until his retirement on May 17, 2010. He joined the Supreme Court as an Associate Justice on June 1993 and was previously Associate Justice of the Court of Appeals (1980, 1986 to 1993), Appellate Justice of the Intermediate Appellate Court (1983), Assistant Solicitor General (1974-1982) and City Judge of Quezon City (1972-1974). He also served as Deputy Minister of Justice from 1984-1986. He completed his Bachelor of Laws from the University of the Philippines in 1962, and has a Master of Laws degree from the University of California in Berkeley (1968) and a Master in Comparative Law degree from the Southern Methodist University, Dallas, Texas (1967).

Margarito B. Teves was elected as an Independent Director of the Company on June 14, 2012 and is the Chairman of the Audit and Risk Oversight Committee and a Member of the Corporate Governance Committee and Related Party Transactions Committee of the Company. He is also an Independent Director of Petron Corporation, a publicly listed company, Atlantic Aurum Investments Philippine Corporation, AB Capital Investment Corp., Alphaland Corporation, Alphaland Balesin Island Club, Inc., The City Club at Alpahaland Makati Place, Inc., and Atok-Big Wedge Corporation. He is also the Managing Director of The Wallace Business Forum and Chairman of the Board of Think Tank Inc. He was Secretary of the Department of Finance of the Philippine government from 2005 to 2010, and was previously President and Chief Executive Officer of the Land Bank of the Philippines from 2000 to 2005, among others. He holds a Master of Arts in Development Economics from the Center for Development Economics, Williams College, Massachusetts and is a graduate of the City of London College, with a degree of Higher National Diploma in Business Studies which is equivalent to a Bachelor of Science in Business Economics.

38

Officers

Name | Age | Citizenship | Position
Ferdinand K. Constantino

Virgilio S. Jacinto

Joseph N. Pineda

Aurora T. Calderon

Sergio G. Edeza
Lorenzo G. Formoso III

67

62

55

64

61
57

Filipino

Filipino

Filipino

Filipino

Filipino
Filipino

Chief Finance Officer and Treasurer

Senior Vice President – General Counsel, Compliance Officer and Corporate Secretary Senior Vice President – Deputy Chief Finance Officer
Senior Vice President – Senior Executive Assistant to the Office of the President and Chief Operating Officer
Senior Vice President – Head of Treasury
Senior Vice President – Head of SMC Infrastructure Business

Ferdinand K. Constantino was a Director of the Company from May 31, 2010 to February 28, 2018. He is the Chief Finance Officer and Treasurer of the Company. He also holds, among others, the following positions in other publicly-listed companies, as follows: Director of Top Frontier Investment Holdings Inc. and Petron Malaysia Refining & Marketing Bhd. (a company publicly listed in Malaysia). He is also the Director and Vice Chairman of the Board of SMC Global Power Holdings Corp., President of Anchor Insurance Brokerage Corporation; Director of San Miguel Brewery Inc., San Miguel Yamamura Packaging Corporation, San Miguel Pure Foods International Ltd., Citra Metro Manila Tollways Corporation, San Miguel Aerocity Inc. and Northern Cement Corporation; Director and Chief Finance Officer of San Miguel Northern Cement, Inc.; and Chairman of the San Miguel Foundation, Inc. He was formerly a Director of PAL Holdings, Inc., and Philippine Airlines, Inc. Mr. Constantino previously served San Miguel Corporation as Chief Finance Officer of the San Miguel Beer Division (1999-2005) and as Chief Finance Officer and Treasurer of San Miguel Brewery Inc. (2007-2009); Director of San Miguel Pure Foods Company, Inc. (2008-2009); Director of San Miguel Properties, Inc. (2001-2009); and Chief Finance Officer of Manila Electric Company (2009). He has held directorships in various domestic and international subsidiaries of SMC during the last five years. He holds a degree in AB Economics from the University of the Philippines and completed academic requirements for an MA Economics degree.

Virgilio S. Jacinto is the Corporate Secretary, Senior Vice-President and General Counsel and Compliance Officer of the Company (since October 2010). He is also the Corporate Secretary and Compliance Officer of Top Frontier Investment Holdings, Inc. and Corporate Secretary of Ginebra San Miguel, Inc. and other subsidiaries and affiliates of SMC. He is a Director of Petron Corporation. He was formerly the Vice President and First Deputy General Counsel from 2006 to 2010 and appointed as General Counsel of the Company in 2010. He was Director and Corporate Secretary of United Coconut Planters Bank, Partner at Villareal Law Offices and Associate at SyCip, Salazar, Feliciano & Hernandez Law Office. Mr. Jacinto is an Associate Professor at the University of the Philippines, College of Law. He obtained his law degree from the University of the Philippines cum laude where he was the class salutatorian and placed sixth in the 1981 bar examinations. He holds a Master of Laws degree from Harvard Law School. He holds various directorships in various local and offshore subsidiaries of the Company.

Joseph N. Pineda is the Senior Vice President and Deputy Chief Finance Officer of the Company. He was formerly Vice President prior to his promotion on July 27, 2010 and has been the Deputy Chief Finance Officer since December 2005. He was previously Special Projects Head of the Company] since January 2005. He is a director of Philippine Dealing System Holdings, Corp. Mr. Pineda has a degree of Bachelor of Arts in Economics from San Beda College and obtained units towards a Masters in Business Administration degree from De La Salle University. In addition, Mr. Pineda holds directorships in various SMC domestic and international subsidiaries.

39

Sergio G. Edeza is the Senior Vice President and Head of Treasury of the Company. Prior to joining SMC, Mr. Edeza was a Director of Merchant’s Bank (2008), President (2007) and Director (2008) of Money Market Association of the Philippines, Executive Vice President and Treasurer of Rizal Commercial Banking Corporation, Treasury Consultant of YGC Corporate Services, and President and CEO of PhilEXIM Guarantee Corporation. He was also Treasurer of the Republic of the Philippines from February 16, 2001 to February 16, 2004. Mr. Edeza is a Certified Public Accountant and a Career Service Professional. He obtained his Bachelor of Science in Commerce degree and Master of Business Administration degree from the De La Salle University, and was accepted at the John F. Kennedy School of Government at Harvard University.

Lorenzo G. Formoso III is the Senior Vice President and Head of the Infrastructure Business. Mr. Formoso holds various directorships in various local and offshore subsidiaries of the Company. Previously, he was a consultant of the Company for Infrastructure, Transportation and Telecommunications from July 2009 to August 2010. He was previously Assistant Secretary of the Department of Transportation and Communication of the Philippine Government from September 2006 to June 2009 and concurrent Commissioner of the Commission on Information and Communications Technology for the same period. He obtained his Juris Doctor degree from University of California, Davis School of Law and a degree in Bachelor of Arts in Philosophy from the University of the Philippines.

Term of Office

Pursuant to the Company’s By-Laws, the directors are elected at each annual stockholders' meeting by stockholders entitled to vote. Each director holds office until the next annual election and his successor is duly elected, unless he resigns, dies or is removed prior to such election.

Independent Directors

The independent directors of the Company are as follows:

### 1. Reynaldo G. David 2. Reynato S. Puno 3. Margarito B. Teves

Significant Employees

The Company has no employee who is not an executive officer but who is expected to make a significant contribution to the business.

Family Relationships

There are no family relationships up to the fourth civil degree either by consanguinity or affinity among the Company’s directors, executive officers or persons nominated or chosen by the Company to become its directors or executive officers.

Involvement in Certain Legal Proceedings

None of the directors, nominees for election as director, executive officers or control persons of SMC have been the subject of any (a) bankruptcy petition, (b) conviction by final judgment in a criminal proceeding, domestic or foreign, (c) order, judgment or decree of any court of competent jurisdiction, domestic or foreign, permanently or temporarily enjoining, barring, suspending or otherwise limiting his involvement in any type of business, securities, commodities or banking activities, which is not subsequently reversed, suspended or vacated, or (d) judgment of violation of a securities or commodities law or regulation by a domestic or foreign court of competent jurisdiction (in a civil action), the Philippine SEC or comparable foreign body, or a domestic or foreign exchange or other organized trading market or self regulatory organization, which has not been reversed, suspended or vacated, for the past five
(5) years up to the latest date that is material to the evaluation of his ability or integrity to hold the relevant position in SMC.

40

Item 10. Executive Compensation

The aggregate compensation paid or incurred during the last two (2) fiscal years and estimated to be paid in the ensuing fiscal year to the Chief Executive Officer and senior executive officers of the Company are as follows:

NAME | YEAR | SALARY | BONUS | OTHERS | TOTAL
Total Compensation of the Chief Executive Officer and Senior Executive Officers² | 2019 (estimated) 2018 2017 | P233.0 Million P208.7 Million P197.5 Million | P172.4 Million P213.3 Million P236.2 Million | P36.2 Million P46.1 Million P45.9 Million | P441.6 Million P468.1 Million P479.6 Million
All other officers and directors as a group unnamed | 2019 (estimated) 2018 2017 | P256.0 Million P233.9 Million P220.6 Million | P72.0 Million P115.6 Million P111.5 Million | P57.5 Million P59.1 Million P53.2 Million | P385.5 Million P408.6 Million P385.3 Million
Total | 2019 (estimated) 2018 2017 | P489.0 Million P442.6 Million P418.1 Million | P244.4 Million P328.9 Million P347.7 Million | P93.7 Million P105.2 Million P99.1 Million | P827.1 Million P876.7 Million P864.9 Million

Section 10 of the Amended By-Laws of the Company provides that the Board of Directors shall receive as compensation no more than 2% of the profits obtained during the year after deducting therefrom general expenses, remuneration to officers and employees, depreciation on buildings, machineries, transportation units, furniture and other properties. Such compensation shall be apportioned among the directors in such manner as the Board deems proper. The Company provides each director with reasonable per diem of P50,000 and P20,000 for each Board and Committee meeting attended, respectively.

The Long-Term Incentive Plan for Stock Options (“LTIP”) of the Company grants stock options to eligible senior and key management officers of the Company as determined by the Committee administering the said Plan. Its purpose is to further and promote the interests of the Company and its shareholders by enabling the Company to attract, retain and motivate senior and key management officers, and to align the interests of such officers and the Company's shareholders.

On November 10, 2005, the Company approved the grant of stock options to 1,096 executives and middle managers of about 4.43 million shares based on the closing price of the Company's shares, computed in accordance with the LTIP. Also on March 1, 2007, the Parent Company approved the grant of options to 822 executives consisting of 18.31 million shares. On June 25, 2009 and June 26, 2008, the Parent Company approved the grant of options to 755 executives consisting of 5.77 million shares and to 742 executives consisting of 7.46 million shares, respectively. Options to purchase 13,278,578 shares and 6,801,369 shares in 2014 and 2015, respectively, were outstanding at the end of each year. Options which were exercised and cancelled totaled about 140,928 and 379,844 shares in 2014 and 2015, respectively.

There were no employment contracts between the Company and a named executive officer. There were neither compensatory plans nor arrangements with respect to a named executive officer.

2 The Chief Executive Officer and senior executive officers of the Company for 2018, 2017 and 2016 are Eduardo M. Cojuangco, Jr., Ramon S. Ang, Ferdinand K. Constantino, Aurora T. Calderon, and Virgilio S. Jacinto.

41

Item 11. Security Ownership of Certain Beneficial Owners and Management

Owners of more than 5% of the Company's voting³

securities as of December 31, 2018 were as follows:

Title of Class | Name, Address of Record Owner and Relationship with Issuer | Name of Beneficial Owner and Relationship with Record Owner | Citizenship | No. of Shares Held | Percent to Total Outstanding Capital Stock
Common | Top Frontier Investment Holdings, Inc.⁴ 5th Floor, ENZO Bldg., No. 339 Sen. Gil Puyat, Makati City | Iñigo Zobel, Filipino, Director of the Company, and Ramon S. Ang, Filipino, the President and Chief Operating Officer of the Company, are beneficial owners of 59.96% and 26.03%⁵ of the outstanding common stock of Top Frontier, respectively. | Filipino | 1,573,100,340 | 40.80%
Common | PCD Nominee Corporation (Filipino) Makati City | Various individuals/ entities | Filipino | 219,474,043 | 33.24%
Series “2” Preferred Shares | PCD Nominee Corporation (Filipino) Makati City | Various individuals/ entities | Filipino | 1,062,247,988
Common | Privado Holdings, Corp. Room 306 Narra Buuilding, 2776 Pasong Tamo Extension, Makati City | Ramon S. Ang, Filipino, as beneficial owner of 100% of the outstanding capital stock of Privado.⁶ | Filipino | 373,623,796⁷ | 9.69%

3 Common stockholders have the right to vote on all matters requiring stockholders’ approval The holders of the Series “2” Preferred shares shall not be entitled to vote except in matters provided for in the Corporation Code: amendment of articles of incorporation; adoption and amendment of by-laws; sale, lease exchange, mortgage, pledge, or other disposition of all or substantially all of the corporate property; incurring, creating or increasing bonded indebtedness; increase or decrease of capital stock; merger or consolidation with another corporation or other corporations; investment of corporate funds in another corporation or business; and dissolution.

4 The shares owned by Top Frontier Investment Holdings, Inc. are voted, in person or by proxy, by its authorized designate. As of December 31, 2018, Top Frontier Investment Holdings, Inc. has voting rights to a total of 1,573,100,340 shares of the Company which represent about 66.03% of the outstanding common capital stock of the Company.

5 As of December 31, 2018, through Privado Holdings, Corp and Master Year Limited, both stockholders of record of Top Frontier.

6 As of December 31, 2017.

7
Inclusive of 368,140,516 common shares held in the name of Privado Holdings Corp. and 5,483,280 common shares which are lodged with the PDTC.

42

The following are the number of shares comprising the Company’s capital stock (all of which are voting shares) owned of record by the Chief Executive Officer, the directors, key officers
of the Company, and nominees for election as director, as of December 31, 2018:
Name of Owner | Amount and Nature of Ownership | Citizenship | Total No. of Shares
| Common | Preferred
Eduardo M. Cojuangco, Jr. | 3,828,702 (D) | | Filipino | 3,828,702 (0.10%)
Ramon S. Ang | 1,345,429 (D) 368,140,516 (I)⁸ 5,483,280 (I)⁹ | | Filipino | 374,969,225 (17.21%)
Leo S. Alvez | 10,000 (D) 9,326 (I) | | Filipino | 19,326 (0.00%)
Aurora T. Calderon | 22,600 (D) | | Filipino | 22,600 (0.00%)
Joselito D. Campos, Jr. | 9,149 (D) | | Filipino | 9,149 (0.00%)
Reynaldo G. David | 5,000 (D) | | Filipino | 5,000 (0.00%)
Menardo R. Jimenez | 5,000 (D) | | Filipino | 5,000 (0.00%)
Estelito P. Mendoza | 31,972 (D) | | Filipino | 31,972 (0.00%)
Alexander J. Poblador | 5,000 (D) | | Filipino | 5,000 (0.00%)
Reynato S. Puno | 5,000 (D) | | Filipino | 5,000 (0.00%)
Jose C. de Venecia | 5,000 (D) | | Filipino | 5,000 (0.00%)
Thomas A. Tan | 5,000 (D) | 400,000 (D) | Filipino | 5,000 (0.00%)
Margarito B. Teves | 5,000 (D) | | Filipino | 5,000 (0.00%)
Ramon F. Villavicencio | 35,000(D) 9,000 (I) | | | 44,000 (0.00%)
Iñigo Zobel | 16,171 (D) 943,230,964 (I)¹⁰ | | Filipino | 943,247,135 (39.57%)
Ferdinand K. Constantino | 477,692 (D) | 200,000 (D) | Filipino | 677,692 (0.02%)
Virgilio S. Jacinto | 180,830 (D) | | Filipino | 180,830 (0.00%)
Joseph N. Pineda | 62,715 (I) | | Filipino | 62,715 (0.00%)
Sergio G. Edeza | 62 (D) | | Filipino | 62 (0.00%)

The aggregate number of shares owned of record by the Chief Executive Officer, Chief Operating Officer, key officers and directors (as a group) of the Company as of December 31,
2018 is 6,264,648 or approximately 0.1625% of the outstanding capital stock of the Company.

The aggregate number of shares owned of record of all officers and directors as a group as of December 31, 2018 is 6,627,491 shares or approximately 0.1719% of the outstanding capital stock of the Company.

The following are the LTIP options exercised by the Chief Executive Officer, Chief Operating Officer, key officers and directors of the Company in 2018 and 2017:

Name | 2017 | 2016
Eduardo M. Cojuangco, Jr. | 766,578 | 344,568
Ramon S. Ang | 587,556 | 0
Ferdinand K. Constantino | 154,020 | 69,363
Virgilio S. Jacinto | 67,239 | 0
Joseph N. Pineda | 20,115 | 34,122

Voting Trust

There is no person holding more than 5% of the Company’s voting securities under a voting trust arrangement.

8 Through his 100% shareholdings in Privado Holdings Corp.

9 Through his 100% shareholdings in Privado Holdings Corp. which has shares which are lodged with the PDTC.

10 Through his 59.96% shareholdings in the common stock of Top Frontier Investment Holdings, Inc.

43

Changes in Control

The Company is not aware of any change in control or arrangement that may result in a change in control of the Company since the beginning of its last fiscal year.

Foreign Ownership

As of December 31, 2018, the following is the foreign ownership of the shares of stock of the Company:

Share Class | Foreign Shares | Percentage of Foreign Ownership | Local Shares/ Shares held by Filipinos | Percentage of Filipino Ownership | Total Shares Outstanding
Common | 54,302,484 | 2.28% | 2,329,594,104 | 97.72% | 2,383,896,588
Preferred Series 1 | 0 | 0.00% | 279,406,667 | 100.00% | 279,406,667
Preferred Series "2-B" | 283,440 | 0.31% | 90,315,780 | 99.69% | 90,428,200
Preferred Series "2-C" | 1,328,390 | 0.52% | 254,498,920 | 99.48% | 255,559,400
Preferred Series “2-D” | 524,470 | 0.59% | 88,858,760 | 99.41% | 89,333,400
Preferred Series “2-E” | 805,732 | 0.60% | 133,347,076 | 99.40% | 134,000,100
Preferred Series “2-F” | 1,876,372 | 0.84% | 221,485,196 | 99.16% | 223,333,500
Preferred Series “2-G” | 887,715 | 1.33% | 66,287,670 | 99.67% | 66,666,600
Preferred Series “2-H” | 1,253,274 | 0.76% | 162,939,692 | 99.24% | 164,000,000
Preferred Series “2-I” | 2,198,480 | 1.30% | 167,402,090 | 98.70% | 169,333,400
Total | 63,460,357 | 1.65% | 3,789,753,022 | 98.35% | 3,855,957,855

Item 12. Certain Relationships and Related Transactions

See Note 34, Related Party Disclosures, of the Notes to the Consolidated Financial Statements.

PART IV – CORPORATE GOVERNANCE Pursuant to SEC Memorandum Circular 15, Series of 2017, the Integrated Annual Corporate Governance Report (I-ACGR) of the Company for 2017 will be filed with the SEC on or before May 30, 2019.

PART V – EXHIBITS AND SCHEDULES

Item 14. Exhibits and Reports on SEC Form 17-C

(a) Exhibits

The Audited Consolidated Financial Statements are attached as Annex “B” and the Supplementary Schedules are attached as Annex “C” hereto. The other Schedules as indicated in the Index to Schedules are either not applicable to the Parent Company and its subsidiaries or require no answer.

(b) Reports on Form 17-C

A summary list of the reports on Form 17-C filed during the last six-month period covered by this report is attached as Annex “H”.

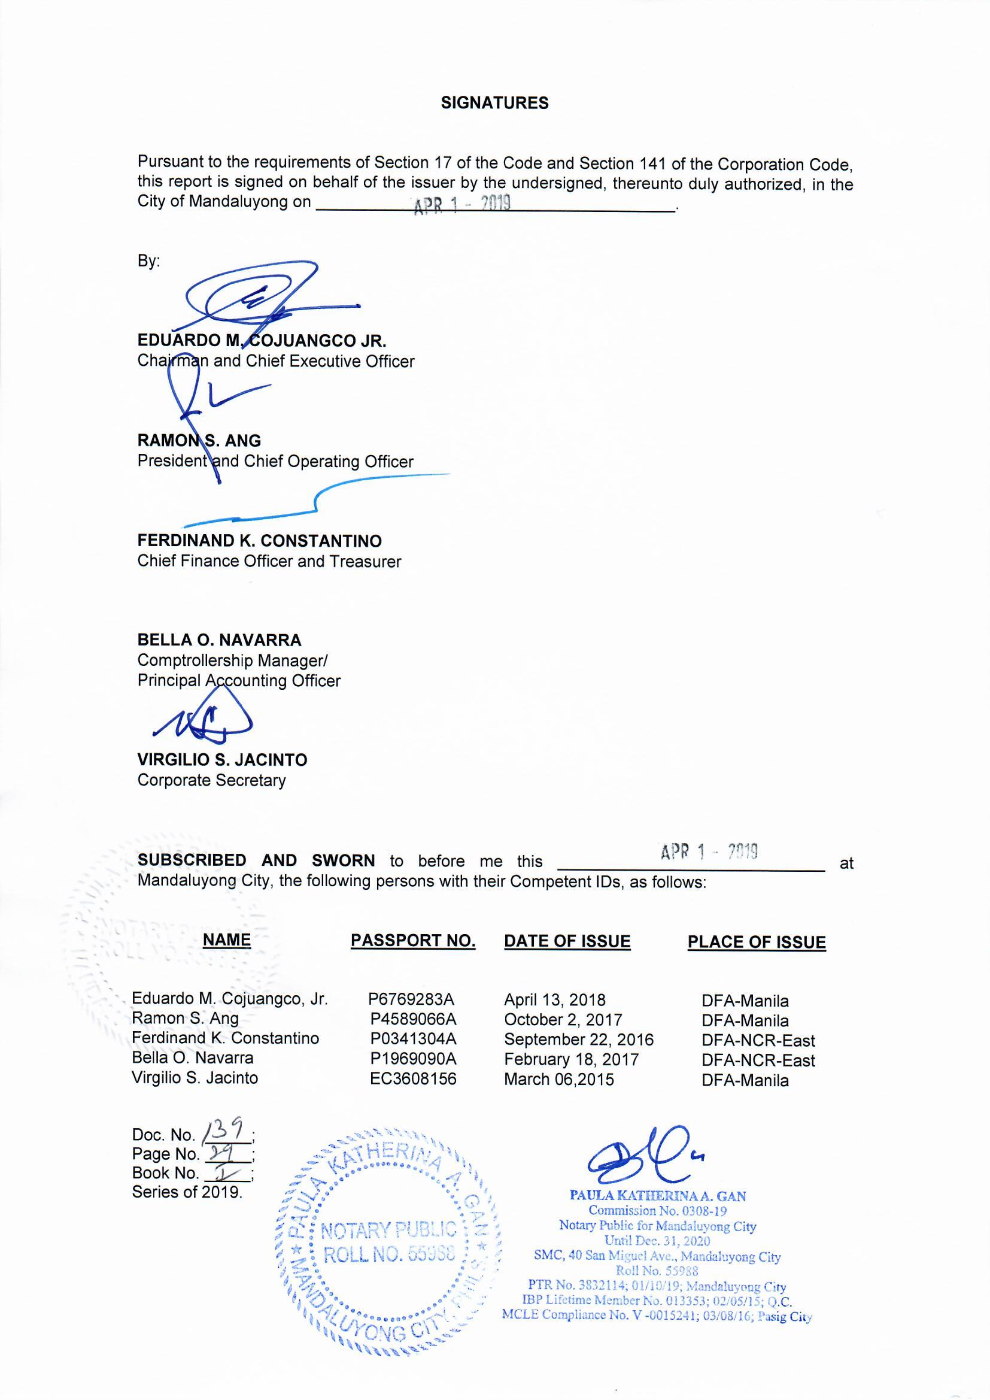
[picture p3: page 46]

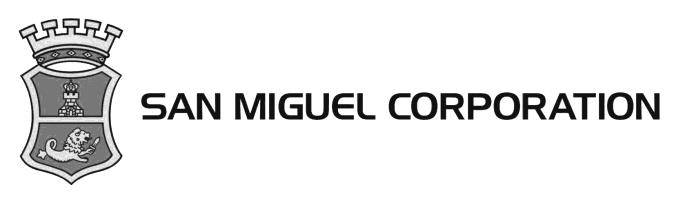
[picture p4: figure]

MANAGEMENT’S DISCUSSION AND ANALYSIS
OF FINANCIAL POSITION AND FINANCIAL PERFORMANCE

This discussion summarizes the significant factors affecting the consolidated financial performance, financial position and cash flows of San Miguel Corporation (“SMC” or the “Parent Company”) and its subsidiaries (collectively referred to as the “Group”) for the three-year period ended December 31, 2018. The following discussion should be read in conjunction with the attached audited consolidated statements of financial position of the Group as of December 31, 2018 and 2017, and the related consolidated statements of income, comprehensive income, changes in equity and cash flows for each of the three years in the period ended December 31, 2018. All necessary adjustments to present fairly the Group’s consolidated financial position as of December 31, 2018 and the financial performance and cash flows for the year ended December 31, 2018 and for all the other periods presented, have been made.

I. BASIS OF PREPARATION

Statement of Compliance
The accompanying consolidated financial statements have been prepared in compliance with Philippine Financial Reporting Standards (PFRS). PFRS are based on International Financial Reporting Standards issued by the International Accounting Standards Board. PFRS consist of PFRS, Philippine Accounting Standards (PAS) and Philippine Interpretations issued by the Philippine Financial Reporting Standards Council (FRSC).

Basis of Measurement
The consolidated financial statements of the Group have been prepared on a historical cost basis except for the following items which are measured on an alternative basis at each reporting date:
Items | Measurement Basis
Derivative financial instruments | Fair value
Financial assets at fair value through profit or loss (FVPL) | Fair value
Financial assets at fair value through other comprehensive income - 2018; Available- for-sale financial assets - 2017 | Fair value
Defined benefit retirement asset (liability) | Fair value of the plan assets less the
| present value of the defined benefit
| retirement obligation
Agricultural produce | Fair value less estimated costs to sell
| at the point of harvest

Functional and Presentation Currency
The consolidated financial statements are presented in Philippine peso, which is the functional currency of the Parent Company. All financial information are rounded off to the nearest million (000,000), except when otherwise indicated.

# ANNEX “A”

Management Discussion and Analysis

Significant Accounting Policies
The accounting policies set out below have been applied consistently to all periods presented in the consolidated financial statements, except for the changes in accounting policies as explained below.

Adoption of New and Amended Standards and Interpretation
The FRSC approved the adoption of a number of new and amended standards and interpretation as part of PFRS.

New and Amended Standards and Interpretation Adopted in 2018

The Group has adopted the following PFRS starting January 1, 2018 and accordingly, changed its accounting policies in the following areas:

- PFRS 9 (2014), Financial Instruments, replaces PAS 39, Financial Instruments: Recognition and Measurement, and supersedes the previously published versions of PFRS 9 that introduced new classification and measurement requirements (in 2009 and 2010) and a new hedge accounting model (in 2013). PFRS 9 includes revised guidance on the classification and measurement of financial assets that reflects the business model in which assets are managed and their cash flow characteristics, including a new forward-looking expected credit loss (ECL) model for calculating impairment, and guidance on own credit risk on financial liabilities measured at fair value. PFRS 9 incorporates new hedge accounting requirements that represent a major overhaul of hedge accounting and introduces significant improvements by aligning the accounting more closely with risk management.

The Group adopted PFRS 9 using the cumulative effect method. The cumulative effect of applying the new standard is recognized at the beginning of the year of initial application, with no restatement of comparative period. The adoption of PFRS 9 has no significant effect on the classification and measurement of financial assets and financial liabilities of the Group except for the effect of applying the ECL model in estimating impairment.

- Applying PFRS 9, with PFRS 4, Insurance Contracts (Amendments to PFRS 4). The amendments permit an entity to defer application of PFRS 9 in 2018 and continue to apply PAS 39, if it has not applied PFRS 9 before and its activities are predominantly connected with insurance. A qualified entity is permitted to apply the
temporary | exemption | for | annual | reporting | periods | beginning | before
January 1, 2021. The amendments also provide an overlay approach to presentation when applying PFRS 9 for designated financial assets where an entity is permitted to reclassify between profit or loss and other comprehensive income the difference between the amounts recognized in profit or loss under PFRS 9 and those that would have been reported under PAS 39. A financial asset is eligible for designation if it is held for an activity that is connected with contracts in the scope of PFRS 4, and if it is measured at FVPL under PFRS 9, but would not have been under PAS 39. An entity may elect the overlay approach when it first applies PFRS 9 and apply that approach retrospectively to financial assets designated on transition to PFRS 9. The entity restates comparative information reflecting the overlay approach if, and only if the entity restates comparative information when applying PFRS 9.

Management Discussion and Analysis

- | Classification | and | Measurement | of | Share-based | Payment | Transactions
(Amendments to PFRS 2, Share-based Payment). The amendments cover the following areas: (a) Measurement of cash-settled awards. The amendments clarify that a cash-settled share-based payment is measured using the same approach as for equity-settled share-based payments - i.e., the modified grant date method;
(b) Classification of awards settled net of withholding tax. The amendments introduce an exception stating that, for classification purposes, a share-based payment transaction with employees is accounted for as equity-settled if: (i) the terms of the arrangement permit or require an entity to settle the transaction by withholding a specified portion of the equity instruments to meet the statutory withholding tax requirement (the net settlement feature); and (ii) the entire share-based payment transaction would otherwise be classified as equity-settled if there were no net settlement feature. The exception does not apply to equity instruments that the entity withholds in excess of the employee’s tax obligation associated with the share-based payment. (c) Modification of awards from cash-settled to equity-settled. The amendments clarify that when a share-based payment is modified from cash-settled to equity-settled at modification date, the liability for the original cash-settled share-based payment is derecognized and the equity-settled share-based payment is measured at its fair value and recognized to the extent that the goods or services have been received up to that date. The difference between the carrying amount of the liability derecognized, and the amount recognized in equity, is immediately recognized in the consolidated statements of income.
- PFRS 15, Revenue from Contracts with Customers, replaces PAS 11, Construction Contracts, PAS 18, Revenue, IFRIC 13, Customer Loyalty Programmes, IFRIC 18, Transfer of Assets from Customers and Standard Interpretation Committee 31, Revenue - Barter Transactions Involving Advertising Services. The new standard introduces a new and more comprehensive revenue recognition model for contracts with customers which specifies that revenue should be recognized when (or as) the Group transfers control of goods or services to a customer at the amount to which the Group expects to be entitled. PFRS 15 requires a contract with a customer to be legally enforceable and to meet certain criteria to be within the scope of the standard and for the general model to apply. It introduces detailed guidance on identifying performance obligations which requires entities to determine whether promised goods or services are distinct. It also introduces detailed guidance on determining transaction price, including guidance on variable consideration and consideration payable to customers. The transaction price will then be generally allocated to each performance obligation in proportion to its stand-alone selling price. Depending on whether certain criteria are met, revenue is recognized over time, in a manner that best reflects the entity’s performance, or at a point in time, when control of the goods or services is transferred to the customer.

The standard does not apply to insurance contracts, financial instruments or lease contracts, which fall in the scope of other PFRS. It also does not apply if two companies in the same line of business exchange non-monetary assets to facilitate sales to other parties. Furthermore, if a contract with a customer is partly in the scope of another PFRS, then the guidance on separation and measurement contained in the other PFRS takes precedence.

The Group has adopted PFRS 15 using the cumulative effect method. The cumulative effect of applying the new standard is recognized at the beginning of the year of initial application, with no restatement of comparative period. Additional disclosures were included in the consolidated financial statements as a result of the adoption of PFRS 15.

Management Discussion and Analysis

- Transfers of Investment Property (Amendments to PAS 40, Investment Property). The amendments clarify the requirements on when an entity should transfer a property asset to, or from, investment property. A transfer is made when and only when there is an actual change in use - i.e., an asset meets or ceases to meet the definition of investment property and there is evidence of the change in use. A change in management intention alone does not support a transfer.
- Philippine Interpretation IFRIC 22, Foreign Currency Transactions and Advance Consideration. The interpretation clarifies that the transaction date to be used for translation of foreign currency transactions involving an advance payment or receipt is the date on which the entity initially recognizes the prepayment or deferred income arising from the advance consideration. For transactions involving multiple payments or receipts, each payment or receipt gives rise to a separate transaction date. The interpretation applies when an entity pays or receives consideration in a foreign currency and recognizes a non-monetary asset or liability before recognizing the related item.
- Annual Improvements to PFRS Cycles 2014 - 2016 contain changes to three standards, of which only the Amendments to PAS 28, Investments in Associates and Joint Ventures, on measuring an associate or joint venture at fair value is applicable to the Group. The amendments provide that a venture capital organization, or other qualifying entity, may elect to measure its investments in an associate or joint venture at FVPL. This election can be made on an investment-by-investment basis. The amendments also provide that a non-investment entity investor may elect to retain the fair value accounting applied by an investment entity associate or investment entity joint venture to its subsidiaries. This election can be made separately for each investment entity associate or joint venture.

Except as otherwise indicated, the adoption of amendments to standards did not have a material effect on the consolidated financial statements.

Additional disclosures required by the amended standards were included in the consolidated financial statements, where applicable.

Management Discussion and Analysis

II. FINANCIAL PERFORMANCE

Comparisons of key financial performance for the last three years are summarized in the following tables.

Years Ended December 31
| 2018 | 2017 | 2016
| | (In Millions)
Sales | P1,024,943 | P826,086 | P685,314
Cost of Sales | 825,748 | 644,221 | 514,021
Gross Profit | 199,195 | 181,865 | 171,293
Selling and Administrative Expenses | (82,110) | (70,823) | (71,639)
Operating Income | 117,085 | 111,042 | 99,654
Financing Charges - net | (38,304) | (31,189) | (31,110)
Gain on Sale of Investments and
Property and Equipment | 252 | 879 | 154
Equity in Net Earnings (Losses) of
Associates and Joint Ventures | (289) | 297 | 203
Other (Charges) - net | (5,628) | 154 | (11,426)
Income from Continuing Operations | 48,648 | 54,814 | 40,422
Income after Income Tax from
Discontinued Operations | - | - | 11,818
Net Income | 48,648 | 54,814 | 52,240
Net Income Attributable to Equity
Holders of the Parent Company | 23,077 | 28,225 | 29,289
Net Income Attributable to Non-
controlling interests | 25,571 | 26,589 | 22,951

2018 vs. 2017
The Group’s consolidated sales revenue reached P1,024,943 million in 2018, 24% higher than the previous year mainly driven by higher volumes and favorable selling prices across all major businesses.

Cost of sales increased by 28% to P825,748 million mainly due to the increase in crude prices and effect of excise tax of Petron Corporation (Petron); higher sales volume of San Miguel Brewery Inc. (SMB) and the Food Segment; increase in excise tax by 4% per case of the domestic operations of SMB and operations of the newly acquired Masinloc Power Partners Co. Ltd. (MPPCL or the Masinloc Group) and the new Greenfield power plants in Bataan and Davao.

Selling and administrative expenses increased mainly due to higher personnel expenses, distribution costs, contracted services costs and advertising and promotions.

Consolidated operating income increased by 5% at P117,085 million. This growth was however partly softened by higher raw material costs that impacted Petron and the Food businesses.

The higher net financing costs was mainly due to the higher level of loans payable and long-term debt in 2018 compared to 2017.

The decrease in equity in net earnings in 2018 primarily represents the share of SMC Global on the higher net loss of Angat Hydropower Corporation (Angat Hydro) and share of San Miguel Properties, Inc. (SMPI) on the lower earnings of Bank of Commerce (BOC).

Management Discussion and Analysis

The gain on sale of investments and property and equipment in 2018 pertains mainly to the sale by SMPI of its investment in Legacy Homes, Inc.

The increase in other charges was primarily due to the higher foreign exchange loss on the translation of the foreign currency denominated long-term debt and finance lease liabilities, partly offset by the higher gain on the translation of foreign currency denominated cash and cash equivalents with the peso depreciating by P2.65 from P49.93 in December 2017 to P52.58 in December 2018.

Consolidated recurring net income, excluding the effect of foreign exchange translation, amounted to P55,175 million, 1% higher than P54,654 million recorded in the previous year. Growth was tempered by the sharp decline in crude oil prices which affected Petron during the fourth quarter of 2018. Consolidated net income as a result, amounted to P48,648 million.

The following are the highlights of the performance of the individual business segments:

### 1. FOOD AND BEVERAGE

In 2018, SMC completed the consolidation of its Beer and NAB, Spirits and Food businesses through San Miguel Food and Beverage, Inc. (SMFB).

SMFB delivered a strong performance in 2018, posting consolidated revenues of P286,378 million, 14% higher than the P251,589 million recorded in 2017. This was driven by higher volumes and revenues across the Beer and NAB, Spirits and Food segments. Consolidated operating income and net income both increased 8% to P45,950 million and P30,533 million, respectively over last year.

a) Beer and NAB Segment (SMB)

SMB reported revenues amounting to P129,249 million, 14% higher from 2017, as volumes increased 10% to 284.6 million cases. Consolidated operating income rose 13% to P35,285 million while net income grew 15% to P23,836 million.

Domestic Operations
SMB’s domestic operations continued to be robust, with volumes growing 11% year-on-year as consumption across the country remained strong. Red Horse Beer and San Miguel Pale Pilsen maintained their position as SMB's top selling brands. Its performance was boosted by consumption-generating initiatives and defense programs which further strengthened the equity of SMB brands.

With facilities nearing full utilization, SMB is currently building a new brewery in Tagoloan, Misamis Oriental in Mindanao and converting its Sta. Rosa Bottling plant into a full brewery. This will add four million hectoliters to its total current capacity and help strengthen its distribution networks in Mindanao and Southern Luzon which will result to savings on logistics.

International Operations
SMB’s International Operations benefitted from volume growth in its South China and Indonesia operations as well as Exports, and better sales mix. As such, despite continuing challenges in the business environment in North China, Hong Kong, Vietnam, and Thailand, SMB International registered double-digit growth in operating income.

Management Discussion and Analysis

b) Spirits Segment (GSMI)

GSMI recorded a banner year in 2018, sustaining strong sales volume which reached 31.4 million cases, 13% better than the last year. Flagship brand Ginebra San Miguel continued to drive growth, driven by its nationwide “Ginebra Ako” campaign, various on-ground activities and trade promotions. Vino Kulafu, its Chinese wine brand, also continued to post strong growth. The brand got a boost from its “Dosenang Lakas, May Instant Pa-Buenas” under-the-cap promo and tactical consumer activities in Visayas and Mindanao regions.

All these translated to revenues of P24,835 million, 19% higher than the previous year. Operating income surged 40% to P1,832 million, due to strong volumes and lower operating costs, while net income increased 75% to P1,053 million.

c) Food Segment

Food Segment posted consolidated revenues of P132,299 million, 13% higher than 2017, on account of the strong performance of the Animal Nutrition and Health, Protein, and Prepared and Packaged Food segments. Most of the food business segments registered double-digit revenue growth, resulting from increased sales volumes and better selling prices.

Revenues from the Animal Nutrition and Health segment, comprising the feeds and vetmed businesses, posted a revenue growth of 14%. Protein, which includes the poultry and fresh meats businesses, grew by 11% while the “Prepared and Packaged Food” expanded by 15%.

The rising costs of major raw materials, intense competition and the additional impact of peso depreciation, however, pulled Food Group’s operating income, down 7% to P9,182 million compared to the same period last year.

Net income fell 15% to P5,885 million, affected by a weaker peso, start-up and pre-operating expenses of the new facilities, and higher interest expenses related to its expansion projects.

Food Segment made significant strides in its ongoing expansion in 2018, completing new facilities that will provide much-needed additional capacities to serve the growing demand and changing preferences of consumers. These include feedmills in Bulacan and Bataan, and one hotdog plant in Cavite. Ongoing projects include additional feedmill facilities in Davao, Cebu and Cagayan de Oro, a flour mill in Mabini, Batangas and its first ready-to-eat facility in Sta. Rosa, Laguna that will cater to the growing demand for convenient, pre-prepared and pre-cooked meals.

### 2. PACKAGING

The Packaging Group completed two acquisitions in 2018. In June, it acquired through San Miguel Yamamura Packaging International Ltd., JMP Holdings, a supplier of packaging products for various industries, including retail packaging, cargo protection, and materials handling. In January 2019, through San Miguel Yamamura Wooven Products Ltd., it acquired INSA Alliance Sdn Bhd, a Malaysian manufacturer of high quality bulk bags. The acquisition complements its existing woven bags plant in Malaysia.

Management Discussion and Analysis

Sales revenues for the year amounted to P37,325 million, 16% higher than 2017, as all business segments delivered solid results. Glass set record deliveries to SMB and GSMI; Metals benefited from a favorable sale mix for crowns; deliveries of Plastic crates and pallets were sustained; and logistics operations delivered significant growth with the increase in demand for rented pallets and trucking services.

The Packaging Group’s Australian operations continued to contribute significantly to overall growth, registering strong sales across the different operations.

With the implementation of stringent fixed cost management measures and further improvements in productivity, operating income grew 11% to P3,311 million.

### 3. ENERGY

SMC Global’s consolidated off-take volume for 2018 reached 23,864 gigawatt hours (Gwh), 39% higher than the previous year. Much of this growth was attributed to the start of commercial operations of Units 2 and 3 of the Malita and Limay Greenfield power plants in February and March, respectively. Together, these new units have brought online 300 megawatts (MW) of fresh capacity. With the acquisition of the Masinloc Power Plant in March 2018 which added a combined capacity of 684 MW, total installed capacity reached 4,197 MW in 2018.

With higher off-take volumes and average realization price, consolidated revenues rose 45% to P120,103 million from P82,791 million in the previous year. This was mainly driven by the additional revenues from the new greenfield power plants, the Masinloc power plant and higher average prices from the Sual and Ilijan bilateral and spot offtake volumes. Operating income reached P33,174 million, 37% higher while net income amounted to P8,300 million, 1% higher from last year, which was offset by the effect of forex movements.

### 4. FUEL AND OIL

Petron reported consolidated revenues of P557,386 million for 2018, 28% higher than the P434,624 million in the previous year which was mainly driven by strong domestic sales of high-margin products such as gasoline, Jet-A1 and Liquefied Petroleum Gas (LPG), on the account of higher prices of crude oil and finished products.

Petron’s consolidated volume reached 108.5 million barrels, slightly higher than the 107.8 million barrels sold in 2017, led by strong retail sales in Malaysia.

During the fourth quarter of 2018, the oil industry has been challenged by increase in global oil production supply which saw crude prices falling sharply starting second half of October until December. Benchmark Dubai crude averaged at US$79.4 per barrel in October which fell to US$57.3 per barrel in December, a US$ 22.1 per barrel drop by year-end. This was also combined with substantially weak gasoline refining margins on the supply side factors.

Consolidated operating income and net income stood at P18,921 million and P7,069 million, 32% and 50% decline from 2017, respectively as a result of inventory losses incurred in November and December.

Management Discussion and Analysis

Petron’s Bataan refinery utilization in 2018 hit 95%, an all-time high for the refinery, enabling it to produce even more high-value fuels and petrochemicals. Petrochemical and polypropylene sales grew by 3% and 28%, respectively driving the export volume growth by 7%.

Petron stations continue to grow in the Philippines and Malaysia which is now over 2,400 and 640 stations, respectively.

### 5. INFRASTRUCTURE

SMC Infrastructure reported in 2018 revenues of P24,530 million, a 9% increase from the previous year, mainly driven by continuous growth in vehicular volume from all operating toll roads. As a result, operating income reached P11,828 million, 13% growth from 2017.

Construction of ongoing projects are on track. The 14.82-kilometer Skyway Stage 3 project is in the advanced stages of construction. The 88.82-kilometer Tarlac-Pangasinan-La Union Expressway is now operational up to the Pozzorubio exit. The last phase from Pozzorubio to Rosario, La Union, is currently under construction.

Construction of the 22-kilometer Mass Rail Transit Line (MRT-7) project, is progressing well. Work on the stretch from Quezon Memorial Circle to Quirino Highway traversing Commonwealth Ave. and Regalado Ave. in Quezon City, is partially complete.

Phase 1 of the Bulacan Bulk Water Supply Project was completed end of 2018. It has started supplying potable water to six Bulacan municipalities in the first quarter of 2019.

Preparations for the start of construction of South Luzon Expressway-Toll Road 4 (SLEX-TR4) which held its groundbreaking on March 26, 2019 and Skyway Stage 4 are underway.

2017 vs. 2016
The Group’s consolidated sales revenue for the year 2017 amounted to P826,086 million, 21% higher than 2016, on the back of robust, double-digit growth across its fuel and oil, infrastructure, and beer, liquor, and packaging businesses.

The higher cost of sales resulted from the increase in crude prices of Petron, increase in sales volume of Petron and SMB, higher excise tax of SMB domestic operations, and the higher coal prices and energy fees of SMC Global.

Sustained sales growth, coupled with effective fixed cost management, brought consolidated operating income to P111,042 million, 11% higher than 2016.

The increase in equity in net earnings in 2017 primarily represents the share of SMC Global on the net income of Angat Hydro as against a net loss in 2016. This was partially offset by the decrease in net income of Northern Cement Corporation (NCC).

The gain on sale of investments and property and equipment in 2017 pertains to the sale of service stations by Petron Malaysia to the Malaysian government. Certain service stations of Petron Malaysia were closed to give way to the Mass Rail Transit project of Malaysia.

The decrease in other charges was primarily due to the recognition of lower foreign exchange loss on the translation of the US Dollar denominated long-term debt of SMC, Petron, and SMC Global, and finance lease liabilities of SMC Global, partly offset by the lower gain on foreign exchange from foreign currency denominated cash and cash equivalents of the Parent Company.

Management Discussion and Analysis

Income from continuing operations amounted to P54,814 million, 36% higher compared to 2016.

Consolidated recurring net income, excluding the effect of forex translation and one-time gain from the sale of the telecommunications business in 2016, was up 11% to P54,654 million, compared to P49,350 million in 2016.

Share of non-controlling interests in the Group’s net income increased in 2017 compared to 2016 mainly due to the higher net income of Petron and SMB.

The following are the highlights of the performance of the individual business segments:

### 1. FOOD AND BEVERAGE

The combined sales revenues of SMFB in 2017 grew 11% to P251,589 million from P227,279 million in 2016. Operating income reached P42,401 million in 2017, an increase of 14% from the same period in 2016.

a) SMB

Consolidated volume of SMB reached almost 260 million cases, surpassing 2016 volume by 13%. Strong volume growth was driven mainly by favorable economic conditions, along with effective marketing campaigns and integrated sales initiatives. Consolidated revenues rose 17% to P113,255 million.

Strong domestic operations, coupled with the contributions of international operations, pushed operating income up 15% to P31,161 million, while net income rose 17% to P20,711 million.

Domestic Operations
With favorable economic conditions, domestic beer volumes rose 15%, boosted by strong marketing campaigns and integrated sales initiatives. Revenues grew 18% to P99,999 million, partly reflecting a price increase implemented on October 1, 2017, as a result of the increase in excise tax. This significant improvement in volumes partly made up for the impact of higher excise taxes and operating costs and resulted to a 14% improvement in operating income to P30,139 million.

Red Horse Extra Strong Beer and San Miguel Pale Pilsen remained the top selling brands, with San Mig Light, Gold Eagle Beer, and San Miguel Flavored Beer turning in strong contributions as well.

In 2017, SMB implemented new marketing campaigns and consumer and trade programs to sustain volume growth, strengthen brand equity, and increase consumption. New digital video campaigns featuring actress Ina Raymundo and rapper Curtsmith, as well as the “MBC Bagong Taon, Bagong Milyon” crown collection promo, strengthened Pale Pilsen’s position. Meanwhile, Red Horse’s “Pambansang Muziklaban” and “Pasiklaban” events continued to enable the brand to assert its position as “The No. 1 beer”. San Mig Light also continued to push its “Mahaba-habang inuman” campaign through a new television commercial dubbed “5 Signs”, while San Miguel Flavoured Beer utilized digital and social media advertising to boost penetration of the ‘millennial’ market.

Management Discussion and Analysis

International Operations
San Miguel Brewing International Limited’s (SMBIL) operating income in 2017 grew 18% to US$24 million. SMBIL continued to intensify efforts to sustain profit growth and accelerate the growth of San Miguel Brands, including Red Horse. San Miguel brands grew 6% versus 2016 on the back of strong results from South and North China, Thailand, Vietnam and the Exports markets. However, due to lower sales from some local brands in Indonesia and North China, overall volume declined 2%. Revenues ended at US$263 million, at par with 2016.

SMBIL continues to implement volume expansion initiatives for San Miguel brands by increasing trade coverage as well as pursuing cost reduction and efficiency improvements.

b) GSMI

For the fourth consecutive year, GSMI registered continued growth. Sales volumes rose 10% to 27.7 million cases, on the back of effective campaigns and below-the-line promotions, which led to higher consumption of flagship brand Ginebra San Miguel and Vino Kulafu. Both brands posted double digit growth. Consumers’ strong affinity to the Barangay Ginebra Gin Kings basketball team was a key contributor to growth, as was Vino Kulafu’s 60th year anniversary, which was hyped all-year-round via radio commercials anchored on its “Dosenang Lakas” proposition.

Expansion of consumer market reach, particularly the millennial generation, also contributed to strong volumes. Based on the Nielsen Retail Audit as of December 2017, market share is at 32%.

Revenues rose 12% to P20,892 million, the result of higher volumes and price increase implemented last April 1, 2017. Operating income reached P1,307 million, 43% higher than 2016 while net income significantly rose 67% to P602 million.

c) Food Segment

The Food Segment posted consolidated revenues of P117,449 million, 5% higher than 2016, on the sustained strong performance of the Protein and Prepared and Packaged Food businesses.

Operating Income rose 11% to P9,926 million, the result of favorable selling prices for poultry, fresh and processed meats products; a better sales mix and lower costs of some major raw materials.

Net income ended 16% higher at P6,906 million.

The Protein and Animal Nutrition and Health businesses ended 2017 with revenues reaching P80,803 million, up 6% from 2016. This mainly was the result of better sales mix, favorable selling prices of chicken and fresh Meats products and aggressive marketing and promotion activities for feeds.

Milling business revenues declined by 3% to P9,506 million due to flat volumes and continued price pressures, including stiff competition and lower global wheat prices. Nevertheless, the Milling business remained profitable despite the margin squeeze.

Food Segment’s Prepared and Packaged Food Business benefitted from the continued growth of its core products. The robust performance of processed meats, coupled with new product launches and intensified brand-building efforts, resulted to revenues of P29,405 million, 6% higher than 2016.

Management Discussion and Analysis

In a bid to further strengthen market leadership, a number of new products were introduced. Among these products are Purefoods Pulled Pork, Purefoods flavored luncheon meat (Cheese and Bacon), La Pacita Graham Cracker sandwiches and Oat Cookies, dual-flavored popsies and Avocado classic ice cream made with carabao milk.

Food Segment grew its value-added products and launched new offerings under the easy-to-cook and easy-to heat lines. These include pre-marinated chicken cut-ups in three flavors (ginger, gata and tomato) and fully cooked lechon kawali and crispy pata.

Food Segment also started implementing its capacity expansion program in 2017. This includes the construction of five feed mills and at least one flour mill; a new hotdog plant, and the first ready-to-eat manufacturing plant, located in Santa Rosa Laguna, which will serve the growing consumer demand for convenient and nutritious meals. Construction of these facilities is progressing according to schedule.

### 2. PACKAGING

In 2017, the Packaging Group continued to work to broaden its market presence in the region, posting very encouraging growth in Australia. The group achieved total year revenue of P32,099 million, 17% higher than 2016, driven by the continued growth of Australian operations and higher sales to various beverage companies of glass, metal and plastics products.

With continuous implementation of cost management efforts and programs to increase productivity, operating income grew 16% to P2,994 million.

The Packaging group continued to grow its business in Australia, completing the acquisition of three major companies: Portavin Holdings Pty. Ltd. (Portavin); Barrosa Bottling Services Pty. Ltd. - a specialist and independent contract wine bottling and packaging facility serving artisan wineries in South Australia and Best Bottlers Pty. Ltd. Best Bottlers is a wine bottling and packaging facility specializing in various formats of contract-filling, including still and sparkling wines, cider, ready-to-drink and non-alcoholic beverages, such as fruit juices.

### 3. ENERGY

SMC Global’s consolidated revenues for year 2017 grew 6% to P82,791 million, the result of higher realization prices from both bilateral and spot sales. Consolidated off-take volume however ended slightly lower at 17,227 Gwh due to lower bilateral volumes from Ilijan and San Roque power plants. Ilijan Power Plant’s Block 1 underwent an annual maintenance shutdown as did the Malampaya gas facility, from January 28 to February 16. Block 2 experienced a temporary shutdown due to series of earthquakes that hit Batangas at the beginning of 2017. Sual Power Plant’s Unit 2 likewise experienced a shutdown from June 14 to November 10, 2017, due to a main generator transformer failure. San Roque power plant also recorded lower power dispatch due to lower water level.

Operating income ended 9% lower than 2016 at P24,276 million, the result of higher energy fees, coal consumption costs, higher natural gas prices, replacement power purchases, lower bilateral volumes from Ilijan, and the sale of the Limay Cogen plant in 2016.

Net income amounted to P8,217 million, significantly higher than 2016 due to lower unrealized forex losses.

Management Discussion and Analysis

In 2017, SMC Global’s total generating capacity reached 3,213 MW, with the addition of 450 MW from the Malita and Limay power plants, which finally started commercial operations.

### 4. FUEL AND OIL

Petron reported a net income of P14,087 million, 30% higher than the P10,822 million in 2016 as a result of its continued focus on high-value segments and strong sales volumes from both Philippine and Malaysian operations.

Consolidated volumes reached 107.8 million barrels, up 2% from 105.7 million barrels in 2016. Sales in the retail segment grew 8%, on the back of the continued aggressive expansion of its service station network. By the end of the year, Petron breached the 3,000-service station mark. Sales of high-margin products such as gasoline, Jet A-1 and lubricants grew double digits while Petrochemicals provided good margins and additional revenue as volumes grew by 9%.

Petron’s consolidated revenues reached P434,624 million, a 26% improvement from the P343,840 million recorded in 2016. Operating income grew 16% to P27,638 million. This would have been much higher if not for the scheduled maintenance turnarounds at both the 180,000 barrel-per-day Bataan refinery and the 88,000 barrel-per-day Port Dickson refinery in Malaysia.

Petron’s domestic performance was driven by higher sales of high-margin products such as gasoline, Jet A-1, and lubricants. In 2017, Petron launched the first and only Euro 6 fuel, Blaze 100 Euro 6, considered the best gasoline in the country. Sales of lubricants such as Blaze Racing also contributed to overall growth. These new products, together with better efficiencies and higher production capability at the upgraded Petron Bataan refinery, all helped boost Philippine operations for 2017.

The performance of Petron’s Malaysia operations was also remarkable, driven by strong volume growth which resulted to increased market share. Petron Malaysia also continues to pursue its retail outlet expansion program.

### 5. INFRASTRUCTURE

SMC Infrastructure posted consolidated revenues of P22,497 million for 2017, a 13% increase from 2016. Growth is attributed to higher vehicular volume at all operating toll roads namely the: SLEX, Skyway 1 and 2, Southern Tagalog Arterial Road (STAR), Tarlac-Pangasinan-La Union Toll Expressway (TPLEX), and the Ninoy Aquino International Airport Expressway (NAIAx). Operating income grew 6% to P10,440 million.

Tollroads
All operating toll roads – the SLEX, Skyway 1 and 2, STAR, TPLEX and NAIAx continue to record strong growth in average daily traffic, delivering combined revenues amounting to P18,683 million, 11% higher vs. 2016.

In December 2017, the Pozorrubio exit of TPLEX was completed and opened to the public which now brings to 77.4 km the length of the total commercially operational toll road out of the 89.21 kms total length of the expressway.

The construction of Skyway Stage 3’s Sections 1 and 2 from Buendia to Aurora, as well as Sections 3 and 4 from Araneta Avenue to Balintawak, Quezon City, is ongoing and progressing well. The Toll Regulatory Board (TRB) has already issued a Notice of Approval for the San Juan River alignment proposal.

Management Discussion and Analysis

Construction for SLEX-TR4 (Sto. Tomas, Batangas to Lucena City) is set to begin. Final engineering plans and drawings has been approved and signed by the TRB. The Department of Public Works and Highways (DPWH) is working on right-of-way (ROW) acquisitions.

Preparations for the construction of Skyway Stage 4 are also underway. This is 58.09 km roadway will start at Skyway 1 and will go all the way to Batasan Complex in Quezon City. Once operational, this vital expressway will help decongest EDSA, C5 and other major roads. It will also serve as a faster alternative route for motorists coming from the Rizal and Calabarzon area.

Airport
Volumes and revenues from Boracay Airport in Caticlan grew in 2017, following the completion of runway expansion and the installation of navigation lights. These upgrades now allow the airport to accommodate larger aircraft as well as night flights. Meanwhile, the interim arrival hall is complete and is now being used, as the construction for the new passenger terminal is being completed. Plans to further extend the runway from 1.8km to 2.1km, is also underway.

Mass Rail
Construction of the MRT 7 project remains on-track. Currently, work is focused at the area between Quezon Memorial Circle to SM Fairview, traversing Commonwealth Ave. and Regalado Ave. Civil works, rolling stocks, and electromechanical works and acquisition of subject lands are also ongoing.

Bulk Water
SMC Infrastructure is currently constructing the Water Treatment and Pipe Conveyance facilities for the Bulacan Bulk Water project. Environmental Compliance Certificate for the water treatment and pipe conveyance facilities have been issued. Discussions with DPWH, the Department of Transportation and the Bulacan local government units on the ROW of pipe conveyance facilities, are ongoing.

### 6. REAL ESTATE

San Miguel Properties, Inc. (SMPI), posted revenues of P2,394 million, a 39% rise from 2016, as it continued to see growth in its real estate, hotel, and leasing operations.

III. FINANCIAL POSITION

A. The following are the major developments in 2018:

INVESTMENT IN SUBSIDIARIES

Food and Beverage

- Consolidation of Food and Beverage Businesses

On November 3, 2017, the Board of Directors (BOD) of SMC approved the internal restructuring to consolidate its food and beverage businesses under SMFB. The corporate reorganization is expected to: (a) result in synergies in the food and beverage business units of the Group; (b) unlock greater shareholder value by providing a sizeable consumer vertical market under SMC; and (c) provide investors direct access to the consumer business of the Group through SMFB. On the same day, the BOD of SMC approved the subscription to additional 4,242,549,130 common shares of stock of SMFB.

Management Discussion and Analysis

On March 23, 2018, the Philippine Securities and Exchange Commission (SEC) approved the amendment to the Articles of Incorporation of San Miguel Pure Foods Company Inc. (SMPFC) consisting of (a) change of the corporate name from SMPFC to SMFB, (b) change in the primary purpose to include engaging in the beverage business,
(c) change in the par value of the common shares of SMFB from P10.00 per share to P1.00 per share, and (d) denial of preemptive rights to issuances or dispositions of any and all common shares.

On April 5, 2018, SMC and SMFB signed the Deed of Exchange of Shares pursuant to which SMC will transfer to SMFB, SMC’s 7,859,319,270 common shares of the capital stock of SMB and 216,972,000 common shares of the capital stock of GSMI (collectively, the “Exchange Shares”) at the total transfer value of P336,349 million. As consideration for its acquisition of the Exchange Shares, SMFB shall issue in favor of SMC 4,242,549,130 common shares of the capital stock of SMFB (the “New SMFB Shares”). The New SMFB Shares will be issued out of the increase in the authorized capital stock of SMFB from P2,460 million divided into 2,060,000,000 common shares with par value of P1.00 per share and 40,000,000 preferred shares with par value of P10.00 per share, to P12,000 million divided into 11,600,000,000 common shares with par value of P1.00 per share and 40,000,000 preferred shares with par value of P10.00 per share which has been duly approved by the Board of Directors and shareholders of SMFB.

On June 29, 2018, the SEC approved the increase in authorized capital stock of SMFB by virtue of the issuance to SMFB of the Certificate of Approval of Increase of Capital Stock and Certificate of Filing of Amended Articles of Incorporation.

On June 29, 2018, pursuant to the Deed of Exchange of Shares, the share swap was completed and resulted to an increase of SMC’s ownership in SMFB common shares from 85.37% to 95.87% and the consolidation of the food and beverage business operations of the San Miguel Group under SMFB.

With the approval of the increase in the authorized capital stock of SMFB, the SEC consequently accepted and approved the transfer value of the Exchange Shares amounting to P336,349 million, the investment value of SMFB in SMB and GSMI.

On October 12, 2018, the Bureau of Internal Revenue (BIR) issued BIR Certification No. SN: 010-2018 which confirmed the tax-free transfer by SMC of the Exchange Shares, in consideration for the New SMFB Shares. On October 31, 2018, the BIR issued the Electronic Certificate Authorizing Registration (eCAR) covering this transaction. The Exchange Shares were issued and registered in the name of SMFB on November 5, 2018.

- Follow-on Offering of SMFB Shares

On October 26, 2018, the SEC issued the Order of Registration of Securities and Certificate of Permit to Offer Securities for Sale relating to the offer of up to 1,020,050,000 common shares in SMFB owned by SMC (the “Offer Shares”) in a secondary sale transaction at an offer price of P85.00 per share.

In 2018, SMC completed the follow-on offering of SMFB common shares. A total of 420,259,360 common shares were sold at a price of P85.00 per share to institutional investors inclusive of the PSE Trading Participants’ share allocation, for a total net cash proceeds of P35,083 million.

Management Discussion and Analysis

With the completion of the follow-on offering, the total number of common shares held by SMC in SMFB is 5,245,082,440 shares, equivalent to 88.76% of the total outstanding common shares of SMFB. SMFB remains compliant with the 10% minimum public float requirement of the PSE.

Energy

- Acquisition of the Masinloc Group

On March 20, 2018, SMC Global acquired 51% and 49% equity interests in MAPL from AES Phil Investment Pte. Ltd. (AES Phil) and Gen Plus B.V., respectively, for a total amount of US$1,900 million (P98,990 million). MAPL indirectly owns, through its subsidiaries, MPPCL and SMCGP Philippines Energy Storage Co. Ltd. (formerly, AES Philippines Energy Storage Co. Ltd.) (“SMCGP Philippines Energy”). MPPCL owns, operates and maintains the 1 x 330 megawatts (MW) and 1 x 344 MW coal-fired power plant (Units 1 and 2), the under-construction project expansion of 335 MW unit known as Unit 3, and the 10 MW battery energy storage project, all located in Masinloc, Zambales, Philippines (collectively, the “MPPCL Assets”), while SMCGP Philippines Energy plans to construct the 2 x 20 MW battery energy storage facility in Kabankalan, Negros Occidental. The MPPCL Assets add 640 MW capacity to the existing portfolio of SMC Global.

As part of the acquisition, SMC Global also acquired AES Transpower Private Ltd. (ATPL) and AES Philippines, Inc. (API). ATPL was a subsidiary of The AES Corporation which provides corporate support services to MPPCL through its Philippine Regional Operating Headquarters, while API was a wholly-owned subsidiary of AES Phil and provides energy marketing services to MPPCL.

The Masinloc Group was consolidated by SMC Global effective March 20, 2018.

API changed its name to SMCGP Philippines Inc. on May 22, 2018.

On May 30, 2018, MAPL and ATPL changed its name to SMCGP Masin Pte. Ltd. and SMCGP Transpower Pte. Ltd., respectively.

The transaction was financed through the following:

a) Availment by SMC Global of a US$500 million term loan and a US$700 million term loan on March 15, 2018 and March 16, 2018, respectively.

In 2018, SMC Global partially paid US$350 million of the US$500 million term loan.

b) Availment by SMC of a total of US$400 million floating interest rate term loan maturing on March 13, 2023 and a total of US$400 million long-term loans.

SMC subscribed to US$650 million Redeemable Perpetual Securities (RPS) issued by SMC Global and made a US$150 million advance to SMC Global.

On August 17, 2018, SMC Global paid the US$150 million advance from SMC.

Management Discussion and Analysis

LONG-TERM DEBT

- REFINANCING OF LOANS

AVAILMENT OF LOANS

SMC

- Availment of US$300 Million Term Loan

In 2018, SMC availed of a US$300 million five-year Term Facility subject to a floating interest rate of LIBOR plus margin.

The proceeds were used to refinance existing US dollar-denominated obligations and/or for general corporate requirements.

- Availment of US$200 Million Term Loan

On November 21, 2018 SMC availed of a US$200 million term loan which is subject to a floating interest rate of LIBOR plus margin.

The proceeds were used to refinance existing US dollar-denominated obligations.

GSMI

- Availment of P1,000 Million Term Loan

On September 24, 2018, GSMI drew P1,000 million from a five-year credit facility with a local bank to refinance its existing short-term obligations. The loan is carried at amortized cost and is subject to a fixed interest rate, and equal quarterly installments commencing in September 2019.

REDEMPTION OF US$750 MILLION UNDATED SUBORDINATED CAPITAL SECURITIES (USCS)

Petron

On January 22, 2018, Petron redeemed US$402 million of its US$750 million USCS from the proceeds of the issuance of the US$500 million Senior Perpetual Capital Securities (SPCS). The SPCS were listed with the Singapore Exchange Securities Trading Ltd. on January 22, 2018.

The remaining balance of US$348 million of the USCS was redeemed from the proceeds of the issuance of the P20,000 million peso-denominated fixed rate bonds out of its P40,000 million shelf registered Peso bonds.

The bonds are comprised of the six-year Series C Bonds, due 2024 with an interest rate of 7.8183% per annum and seven-year Series D Bonds, due 2025 with an interest rate of 8.0551%.

Management Discussion and Analysis

- REDENOMINATION OF FOREIGN CURRENCY LOANS

In 2018, the Group redenominated certain foreign currency loans to reduce exposure to changes in the peso-dollar exchange rates.

SMC

- Issuance of P20,000 Million Fixed Rate Peso-denominated Bonds

On March 19, 2018, SMC issued and listed in the Philippine Dealing & Exchange Corp. (PDEx) P20,000 million peso-denominated fixed rate bonds out of the P60,000 million shelf registered Peso bonds of the Parent Company.

The bonds are comprised of the five-year Series E Bonds due 2023, seven-year Series F Bonds due 2025 and ten-year Series G Bonds due 2028.

The Series E, F and G Bonds have fixed interest rate equivalent to 6.2500% per annum, 6.6250% per annum and 7.1250% per annum, respectively.

The proceeds from the issuance were used for the payment of the US dollar-denominated short-term loan and long-term debt.

- Issuance of P10,000 Million Fixed Rate Peso-denominated Notes

On May 25, 2018, SMC issued and listed with the PDEx peso-denominated Fixed-Rate Notes (the “Fixed-Rate Notes”) amounting to P10,000 million. The Fixed-Rate Notes have interest rate equivalent to 5.25% per annum due 2020.

Proceeds from the Fixed-Rate Notes were used to partially refinance various loans and partially invest in existing businesses of the subsidiaries of the Parent Company.

SMC Global

On August 17, 2018, SMC Global issued and listed with the PDEx the second tranche of the P35,000 million shelf registered fixed rate bonds amounting to P15,000 million. The Bonds have interest rate equivalent to 6.75% per annum due 2023.

Proceeds from the issuance were used to refinance the outstanding shareholder advance and partially refinance existing US dollar-denominated loan obligations and payment of transaction-related expenses.

- AVAILMENT OF LOANS TO FINANCE CAPEX/PROJECTS/INVESTMENT

SMC Consolidated Power Corporation (SCPC)

On January 31, 2018, SCPC drew P2,000 million from the P44,000 million Omnibus Loan and Security Agreement (OLSA) with various local banks dated June 22, 2017 to finance the ongoing construction of the 2x150 MW Limay Coal-fired Power Plant.

Management Discussion and Analysis

Luzon Clean Water Development Corporation (LCWDC)

On various dates in 2018, LCWDC drew a total of P4,200 million from the P5,400 million OLSA with various local banks dated September 16, 2016. The loans are subject to a floating interest rate.

Proceeds of the loan were used for the Bulacan Bulk Water Supply Project.

Citra Central Expressway Corp. (CCEC)

On various dates in 2018, CCEC drew a total of P18,100 million from the P31,000 million OLSA with various local banks dated December 15, 2014 for the project cost of the North Luzon Expressway - South Luzon Expressway Link (Skyway Stage 3).

SMC

On June 26, 2018, SMC availed of a US$300 million five-year Facility Agreement to fund general corporate requirements and/or additional investments. The loan is subject to a floating interest rate.

MPPCL

On July 6, 2018 and October 8, 2018, MPPCL drew a total of US$120 million from the Omnibus Expansion Facility Agreement dated December 1, 2015 to finance the construction of the additional 300MW (net; Unit 3) coal-fired plant within the existing facilities of MPPCL. The loan is divided into fixed interest tranche of 5.5959% per annum and floating interest tranche based on a 6-month LIBOR plus margin with maturities up to December 2030.

San Miguel Consolidated Power Corporation (SMCPC)

On August 17, 2018, SMCPC drew P20,322 million from the P21,300 million OLSA with various local banks dated August 9, 2018, to fund the design, construction and operations of the Malita Power Plant.

SMY Asia

On various dates in 2018, SMY Asia drew a total of P3,300 million from its P4,000 million term loan facility to finance the capital expenditure in relation to Line 3 of the glass manufacturing plant project and for general funding requirements. The loan is subject to a floating interest rate with maturities up to July 2023.

- PAYMENT OF MATURING OBLIGATIONS

Infrastructure Group
In 2018, the SMC Infrastructure Group paid a total of P10,512 million of its maturing long-term debt.

Energy Group
In 2018, the Energy Group paid a total of P3,226 million of its maturing long-term debt.

Management Discussion and Analysis

Other Subsidiaries
In 2018, Petron, San Miguel Yamamura Packaging Corporation (SMYPC), SMY Asia, East Pacific Star Bottlers Phils Inc. (EPSBPI), and Can Asia, Inc. (CAI) paid their maturing long-term debt amounting to P7,514 million.
B. The following are the major developments in 2017:

INVESTMENT IN SUBSIDIARIES

- Sale of 34.83% Equity Interest in Manila North Harbour Port, Inc. (MNHPI)

On September 21, 2017, Petron signed the Share Purchase Agreement with International Container Terminal Services, Inc. for the sale of 10,449,000 shares of stocks or 34.83% equity interest in MNHPI for a total consideration of P1,750 million.

On October 30, 2017, all conditions for the completion of the sale had been complied with and the purchase price had been paid.

The Group retained the 43.33% ownership and control through the stake of San Miguel Holdings Corp. (SMHC) in MNHPI.

LONG-TERM DEBT

- REDENOMINATION OF FOREIGN CURRENCY LOANS

In 2017, the Group redenominated certain foreign currency loans to reduce exposure to changes in the peso-dollar exchange rates.

Parent Company

- Shelf Registration of P60,000 Million worth of Fixed Rate Peso-denominated Bonds by the Parent Company and Issuance of P30,000 Million Bonds

On February 14, 2017, the SEC approved the shelf registration of up to P60,000 million worth of Fixed Rate Bonds of the Parent Company.

On March 1, 2017, the Parent Company issued and listed in the PDEx the first tranche of the fixed rate bonds amounting to P20,000 million.

The Bonds are comprised of five-year Series A Bonds due 2022, seven-year Series B Bonds due 2024, and 10-year Series C Bonds due 2027. The Series A, Series B and Series C Bonds have interest rate per annum equivalent to 4.8243%, 5.2840% and 5.7613%, respectively. Interests are payable on March 1, June 1, September 1, and December 1 of each year.

Proceeds from the issuance were used by the Parent Company to partially pay the P25,000 million short-term bridge loan which was availed to partially redenominate the US$500 million out of the US$1,500 million long-term debt of the Parent Company.

On April 7, 2017, the Parent Company issued and listed in the PDEx the second tranche of the fixed rate bonds amounting to P10,000 million. The Bonds comprised of five-year Series D Bonds due 2022 with interest rate per annum equivalent to 5.1923%.

Proceeds from the issuance were used by the Parent Company to refinance the US$200 million short-term bridge loan which was availed to partially redenominate the US$200 million obligation, under the US$300 million Facility Agreement.

Management Discussion and Analysis

SMC Global

- Availment of P15,000 Million Term Loan

On April 26, 2017, SMC Global availed of a P15,000 million fixed-rate, seven-year term loan to fund the payment of the US$300 million out of the US$700 million, five-year term loan drawn to refinance existing indebtedness and to fund the construction of the power plants in Malita, Davao and Limay, Bataan, investments in power-related assets, and for general corporate purposes.

- Shelf Registration of P35,000 Million worth of Fixed Rate Peso-denominated Bonds and Issuance of P20,000 Million Bonds

On December 8, 2017, the SEC approved the shelf registration of up to P35,000 million worth of Fixed Rate Bonds of SMC Global.

On December 22, 2017, SMC Global issued and listed in the PDEx the first tranche of P20,000 million Fixed Rate Bonds comprising of five-year Series D Bonds due 2022, seven-year Series E Bonds due 2024, and 10-year Series F Bonds due 2027.

The Series D, Series E and Series F Bonds have fixed interest rate per annum equivalent to 5.375%, 6.25% and 6.625%, respectively. Interests are payable on March 22, June 22, September 22, and December 22 of each year.

Proceeds from the issuance were used by SMC Global to pay the short-term bridge loans availed in March and September 2017, used to redenominate the US$400 million out of the US$700 million term loan.

SCPC

- Availment of P42,000 Million Term Loan

On June 22, 2017, SCPC entered into a P44,000 million OLSA, with various banks, of which P42,000 million has been drawn on June 28, 2017. Proceeds from the loan was used primarily for the payment of the US$360 million short-term bridge financing loan availed in May 2017, to redenominate the US$359 million loan drawn in 2016 to finance the acquisition and ongoing construction of the 2x150 MW Limay Coal-fired Power Plant.

- REFINANCING OF LOANS

Parent Company

- Availment of US$300 million Medium Term Loan

On October 24, 2017, the Parent Company drew US$300 million from the medium-term loan facility subject to a floating interest rate plus spread and with maturities up to October 24, 2024. The proceeds were used to refinance the US$287 million term loan drawn in 2015. The interest rate per annum of the US$300 million loan is lower than the interest rate of the US$287 million loan.

Management Discussion and Analysis

- Availment of US$100 Million Medium Term Loan

On November 21, 2017, the Parent Company drew US$100 million from its amended revolving facility agreement dated November 6, 2016. The loan is subject to a floating interest rate per annum of LIBOR plus a spread and maturing on May 6, 2019. The proceeds were used to refinance the US$100 million short-term loan. The refinancing extended the term of the loan from short-term loan to long-term debt.

Petron

- US$1,000 Million Term Loan

On June 16, 2017, Petron signed and executed a US$1,000 million term loan facility to be amortized over five years with a two-year grace period and is subject to a floating interest rate plus a spread. On June 28 and October 10, 2017, Petron drew US$600 million and US$400 million, respectively from the loan facility.

The proceeds from the US$600 million loan were used to fully pay the outstanding balances of US$115 million and US$470 million under the US$475 million and US$550 million term loan facilities, respectively.

The proceeds of the US$400 million loan were used to settle the P20,000 million Peso-denominated Notes which matured on November 10, 2017. The interest rate per annum of the new loan is lower than the fixed interest rate per annum of the P20,000 million loan.

The previous loans were prepaid to benefit from the lower interest rate of the new facility.

- AVAILMENT OF LOANS TO FINANCE CAPEX/PROJECTS

Petron
- P15,000 Million Term Loan

On July 25, 2017, Petron drew P15,000 million from its term loan facility. The loan is amortized over seven years and is subject to a fixed interest rate of 5.5276% per annum payable quarterly. The proceeds were used to refinance the short-term loan availed on December 23, 2016 for the acquisition of the 140MW Power Plant in Limay, Bataan.

- P10,000 Million Term Loan

On December 29, 2017, Petron drew P10,000 million from its term loan facility. The loan is amortized over five years and is subject to a fixed interest rate of 5.7584% per annum payable quarterly. The proceeds were used to finance permanent working capital requirements.

CCEC

On December 15, 2017, CCEC drew P3,200 million from the P31,000 million OLSA dated December 15, 2014. The loan was used to partially finance the design, construction and the operation and maintenance of the Stage 3 of Metro Manila Skyway Project.

Management Discussion and Analysis

As of December 31, 2017, P200 million was spent for the construction of Skyway Stage 3 Project.

SCPC

- Availment of P42,000 Million Term Loan

Part of the balance of the P42,000 million loan proceeds amounting to P20,050 million were used for the ongoing construction of the Limay Greenfield power plant projects and for payment of transaction costs, interest and shareholder advances previously used by SCPC to defray its capex requirements.

- PAYMENT OF MATURING OBLIGATIONS

Infrastructure Group
In 2017, the SMC Infrastructure Group paid a total of P10,473 million of its maturing long-term debt.

SMB
On April 3, 2017, SMB completed the redemption of the P3,000 million Series “D” fixed rate bonds. The Series D bonds was part of the P20,000 million Series “D, E and F” fixed rate bonds issued by SMB in 2012. The payment was funded by cash generated from operations of SMB.

Petron
Petron Group paid a total of P3,400 million of its maturing long-term debt in 2017.

Other Subsidiaries
In 2017, SMYPC, EPSBPI, and CAI paid their maturing long-term debt amounting to P1,056 million.
C. MATERIAL CHANGES PER LINE OF ACCOUNT

2018 vs. 2017

The Group’s consolidated total assets as of December 31, 2018 amounted to P1,676,642 million, P296,999 million higher than last year. The increase was primarily due to the increase in cash and cash equivalents, inventories, the consolidation of Masinloc Power assets, and the recognition of goodwill on the consolidation.

The increase in cash and cash equivalents by P37,077 million was mainly due to proceeds from the follow-on offering of SMFB common shares in November 2018.

The increase in trade and other receivables by P13,853 million was mainly attributable to the higher revenue of SMC Global, Petron and Food Segment, consolidation of Masinloc Group and increase in Petron Malaysia’s government subsidy receivable.

Inventories increased by P22,564 million primarily due to the higher prices and volume of crude oil and finished products including excise taxes of Petron, reclassification by SMB of customer's containers deposit, from contra inventory account to liability account due to the adoption of PFRS 15, consolidation of the materials and supplies of MPPCL and increase in Food Segment's inventory to meet forecasted peak season sales and to maintain safety inventory levels.

Management Discussion and Analysis

Biological assets increased by P972 million mainly due to Poultry's expansion of farm capacities to support increasing supply requirement and higher growing cost due to increase in importation cost of parent stocks.

The increase in prepaid expenses and other current assets was primarily due to the net increase in restricted cash balance of CCEC and SMCPC, consolidation of Masinloc Group's prepaid expenses and higher prepaid taxes, mainly from input tax, of Petron, SMC Global and SMHC.

Investments and advances increased by P14,982 million mainly due to the advances for investment made by San Miguel Holdings Limited to Bryce Canyon Investments Limited and acquisition by SMC Equivest Corporation of 4.69% equity interest in BOC.

The increase of P70,786 million in property, plant and equipment was primarily due to the consolidation of the power plant and properties of the Masinloc Group.

The increase in investment property was due to the reclassification of various property, plant and equipment of Petron to investment property to reflect the usage of properties being leased out to its dealers, and acquisitions during the year.

The increase in goodwill mainly represents the goodwill recognized as a result of the consolidation of the Masinloc Group.

Other intangible assets increased mainly due to the costs of various infrastructure projects of the Infrastructure Group net of amortization during the period.

Deferred tax assets increased by P837 million mainly due to the effect of recognition of higher unrealized foreign exchange loss on the revaluation of foreign currency denominated long-term debt and loans payable as a result of the depreciation of the Philippine Peso against the US Dollar in December 2018 compared to December 2017.

The increase in other noncurrent assets by P14,491 million was mainly due to the reclassification of advances to contractors of Universal LRT Corporation (BVI) Limited from current to noncurrent due to delay in MRT 7 Project completion, capitalized expenditures on the construction of MRT 7 Project, purchase of new containers by SMB and the consolidation of the Masinloc Group's other noncurrent assets.

The increase in loans payable by P34,161 million was mainly due to net availment of working capital loans and for general corporate purposes by Petron, Food Segment and SMC.

Accounts payable and accrued expenses increased by P12,771 million mainly due to the consolidation of the balances of Masinloc entities, reclassification of SMB’s customer's container deposit from contra inventory account to liability due to the adoption of PFRS 15.

The increase in the current portion of finance lease liabilities mainly represents the reclassification from noncurrent portion to current portion of finance lease liabilities due in 2019 of Energy Group.

The P3,248 million increase in income and other taxes payable was mainly due to the higher excise tax of Petron and the contributed income tax and other payables of the Masinloc entities.

Dividends payable decreased primarily due to dividend payments made by Citra Metro Manila Tollways Corp and SMY Asia.

Management Discussion and Analysis

The increase in current maturities of long-term debt was mainly due to the reclassification to current liability of the amounts due in 2019.

The higher amount of long-term debt resulted from the loan availments made by SMC Global and SMC, and the issuance of fixed rate bonds by SMC Global to finance the acquisition of Masinloc Power, consolidation of the long-term debt of MPPCL, availment for investment and general corporate purposes, and loan availments by the Energy Group and the Infrastructure Group to finance capital expenditures.

The increase in deferred tax liability is mainly attributable to the temporary differences arising from interest expense, depreciation and foreign exchange.

The decrease in finance lease liabilities by P15,641 million was mainly due to payments, net of interest and the effect of foreign exchange rate changes.

Other noncurrent liabilities decreased primarily due to Petron's settlement of retirement liability and contribution to the retirement fund.

Equity reserves increased by P26,312 million mainly due to the effect of SMFB's share swap and the gain from the follow on offering of SMFB common shares, net of the redemption of USCS of Petron.

The increase in appropriated retained earnings by P5,930 million was mainly due to appropriations by SMFB net of the reversals of SMC Global, SMITS, Infrastructure Group, SMC Shipping and Lighterage Corporation (SMCSLC) and SMY Asia.

Equity
The increase in equity in 2018 is due to:
(In millions) | 2018
Income during the period | P48,648
Other comprehensive income | 926
Net addition to non-controlling interests and others | 20,430
Issuance of capital stock | 196
Adjustments due to PFRS 9 and 15 | 6
Cash dividends and distributions | (29,321)
| P40,885

2017 vs. 2016

The Group’s consolidated total assets as of December 31, 2017 amounted to P1,379,643 million, P72,819 million higher than 2016. The increase was primarily due to the increase in inventories, biological assets, property, plant and equipment, other intangible assets and other noncurrent assets.

Inventories increased by P19,334 million primarily due to the higher prices of crude oil and finished products of Petron and increased importation of certain raw materials to support expected surge in sales volume and in anticipation of further increase in raw material costs of the Food Segment.

Current and noncurrent portion of biological assets increased by P300 million and P432 million, respectively, mainly due to expansion of Poultry farms' capacities to support increasing supply requirement.

Management Discussion and Analysis

Assets held for sale decreased by P184 million due to the sale of certain machinery and equipment to NCC by SMC Powergen Inc. in 2017.

The increase in investments and advances by P3,025 million was mainly due to advances for investment made by San Miguel Holdings Limited to Bryce Canyon Investments Limited.

Other intangible assets increased by P9,273 million mainly due to the additional concession rights for the various infrastructure projects of SMC Infrastructure, such as: Skyway Stages 3 and 4, Bulacan Bulk Water, Manila North Harbour, TPLEX, Boracay Airport, NAIAx, STAR and SLEX-TR4 in 2017, net of the recognition of amortization.

Deferred tax assets decreased by P1,855 million mainly due to the temporary difference on the higher actual monthly fixed payments to Power Sector Assets and Liabilities Management Corporation (PSALM) over the finance lease interest expense accrued in 2017.

The increase in other noncurrent assets by P14,279 million was mainly due to the
a) capitalized project costs incurred for the MRT 7 Project, advances to contractors of the Skyway Stage 3 Project and increase in noncurrent portion of the subsidy receivable from DPWH for the construction costs incurred in Section 3A-2 (Binalonan to Pozzorubio) of TPLEX Project; b) higher restricted cash to cover SCPC’s debt servicing and capex requirements and higher prepaid input VAT recognized on additional purchases for the construction of Limay Phase II.

The decrease in loans payable by P39,414 million was mainly due to the net payments made by the Parent Company and settlement by Petron of the P15,000 million bridge loan, offset by availments made by SMCPC for Malita, Davao capex requirements.

Accounts payable and accrued expenses increased by P15,391 million mainly due to higher liabilities for crude and other products of Petron, and higher volume of transactions with third party suppliers in the last quarter of 2017 of the Food Segment.

Dividends payable increased by P437 million mainly due to unclaimed dividends payable to common stockholders of the Parent Company.

The higher amount of long-term debt by P70,892 million resulted from the P42,000 million term loan availed by SCPC; issuance by the Parent Company of P30,000 million fixed rate -bonds; availment by Petron of the P15,000 million and P10,000 million term loans; and availment by CCEC of the P3,200 million term loan for the construction of the Skyway Stage 3 project. The increase was partially offset by the payments made by the Infrastructure Group, and prepayment of Petron Malaysia of its long-term debt and the redemption of SMB of the Series D Bonds.

Deferred tax liabilities increased by P3,445 million mainly due to the temporary differences arising from the: a) different method of depreciation used for tax reporting (accelerated method) and financial accounting (straight-line method) for power plant acquired by Petron in December 2016 and RMP-2, and realization of forex loss of Petron; and b) actual monthly payments to the PSALM over the finance lease liability-related expenses of SPPC.

The decrease in finance lease liabilities by P15,343 million was mainly due to payments, net of interest and the effect of foreign exchange rate changes.

Management Discussion and Analysis

The P3,444 million increase in other noncurrent liabilities was primarily due to higher retirement liabilities caused mainly by the recognition of re-measurement losses on plan assets and increase in asset retirement obligation of Petron, retention payable to the contractors of MRT 7 and LCWDC and additional long term liability of MNHPI for the purchase of certain equipment in relation to the expansion project.

Equity reserves increased by P2,901 million mainly due to the translation adjustment on the net assets of foreign subsidiaries of Petron, Packaging Group International and SMB.

The increase in appropriated retained earnings by P9,984 million was mainly due to the increase in appropriation by SMC Global for monthly fixed payments and energy fees to PSALM and SMB for the payment of Series C & E bonds due in 2019 partially offset by the reversal of SMCSLC of appropriations for completed projects.

Unappropriated retained earnings increased by P7,351 million mainly due to the net income attributable to the equity holders of the Parent Company, net of additional appropriations and dividends declared by the Parent Company.

Non-controlling interests increased by P13,926 million primarily due to the share of non-controlling stockholders in the higher net income of SMB, Petron, Food Segment and Infrastructure and translation adjustments, net of dividends declared to the non-controlling stockholders of SMB and Petron.

Equity
The increase in equity in 2017 is due to:
(In millions) | 2017
Income during the period | P54,814
Other comprehensive income | 3,440
Net addition to non-controlling interests and others | 3,368
Issuance of capital stock | 119
Cash dividends and distributions | (27,460)
| P34,281

IV. CASH FLOW

SOURCES AND USES OF CASH

A brief summary of cash flow movements is shown below: December 31
| 2018 | 2017 | 2016
| | (In Millions)
Net cash flows provided by operating activities | P58,224 | P79,228 | P79,193
Net cash flows used in investing activities | (194,765) | (53,624) | (23,257)
Net cash flows provided by (used) in financing
activities | 174,015 | (22,386) | (34,147)

Net cash from operations basically consists of income for the period and changes in noncash current assets, certain current liabilities and others.

Management Discussion and Analysis

Net cash flows used in investing activities are as follows:

December 31
| 2018 | 2017 | 2016
| | (In Millions)
Acquisition of subsidiaries, net of cash and cash
equivalents acquired | (P98,057) | (P2,568) | (P1,905)
Additions to property, plant and equipment | (47,323) | (38,693) | (40,649)
Increase in other noncurrent assets and others | (38,946) | (30,023) | (15,515)
Additions to investments and advances and
investment in debt instruments | (20,021) | (2,908) | (8,038)
Interest received | 6,537 | 4,263 | 3,480
Dividend received | 1,906 | 1,355 | 1,081
Proceeds from sale of investments and property
and equipment | 1,139 | 1,930 | 1,114
Dividend received | 1,906 | 1,355 | 1,081
Proceeds from disposal of discontinued
operations, net of cash and cash
equivalents disposed of | - | 13,020 | 37,175

Net cash flows provided by (used in) financing activities are as follows:

December 31
| 2018 | 2017 | 2016
| | (In Millions)
Net proceeds from (payments of) long-term borrowings | P176,814 | P67,740 | (P52,325)

Proceeds from follow-on offering of common
shares of a subsidiary | 35,083 | - | -
Net proceeds from issuance of senior perpetual
capital securities of a subsidiary | 24,881 | - | -
Redemption of undated subordinated capital
securities of a subsidiary | (39,769) | - | -
Proceeds from follow-on offering of common
shares of a subsidiary
Net proceeds from (payments of) short-term
borrowings | (32,305) | (40,058) | 42,160
Cash dividends and distributions paid | (29,706) | (27,023) | (24,338)
Payments of finance lease liabilities | (25,698) | (24,924) | (23,907)
Increase (decrease) in non-controlling interests | (91) | 1,760 | (5,515)
Proceeds from issuance of capital stock | 196 | 119 | 71
Proceeds from reissuance of treasury shares | - | - | 29,707

The effect of exchange rate changes on cash and cash equivalents amounted to (P397) million, (P298) million and P606 million on December 31, 2018, 2017 and 2016, respectively.

Management Discussion and Analysis

V. ADDITIONAL INFORMATION ON UNAPPROPRIATED RETAINED EARNINGS

The unappropriated retained earnings of the Parent Company is restricted in the amount of P67,093 million in 2018, 2017 and 2016, representing the cost of common shares held in treasury.

The unappropriated retained earnings of the Group include the accumulated earnings in subsidiaries and equity in net earnings of associates and joint ventures not available for declaration as dividends until declared by the respective investees.

VI. KEY PERFORMANCE INDICATORS

The following are the major performance measures that the Group uses. Analyses are employed by comparisons and measurements based on the financial data of the current period against the same period of previous year. Please refer to Item II “Financial Performance” of the MD&A for the discussion of certain Key Performance Indicators.

December 31
2018 2017
Liquidity:
Current Ratio | 1.37 | 1.40

Solvency:
Debt to Equity Ratio | 2.28 | 1.93
Asset to Equity Ratio | 3.28 | 2.93

Profitability:
Return on Average Equity Attributable to Equity Holders of
the Parent Company | 7.23% | 9.73%
Interest Rate Coverage Ratio
2.61 3.27
Operating Efficiency:
Volume Growth | 8% | 4%
Revenue Growth | 24% | 21%
Operating Margin | 11% | 13%

Management Discussion and Analysis

The manner by which the Group calculates the key performance indicators is as follows:

KPI | Formula
Current Ratio | Current Assets Current Liabilities
Debt to Equity Ratio | Total Liabilities (Current + Noncurrent) Equity + Non-controlling Interests
Asset to Equity Ratio | Total Assets (Current + Noncurrent) Equity + Non-controlling Interests
Return on Average Equity | Net Income Attributable to Equity Holders of the Parent Company Average Equity Attributable to Equity Holders of the Parent Company
Interest Rate Coverage Ratio | Earnings Before Interests and Taxes Interest Expense and Other Financing Charges
Volume Growth | Sum of all Businesses’ Revenue at Prior Period Prices Prior Period Net Sales
Revenue Growth | Current Period Net Sales Prior Period Net Sales
Operating Margin | Income from Operating Activities Net Sales

VII. OTHER MATTERS

- Contingencies

The Group is a party to certain lawsuits or claims (mostly labor related cases) filed by third parties which are either pending decision by the courts or are subject to settlement agreements. The outcome of these lawsuits or claims cannot be presently determined. In the opinion of management and its legal counsel, the eventual liability from these lawsuits or claims, if any, will not have a material effect on the consolidated financial statements of the Group.

a. SEC Case

On September 10, 2018, SMC, SMFB and GSMI received from the SEC Special Hearing Panel, a Summons dated September 3, 2018 furnishing SMC, SMFB and GSMI a copy of the Amended Petition filed by Josefina Multi-Ventures Corporation (the “Petitioner”) against SMC, SMFB and GSMI docketed as SEC Case No. 05-18-468 (the “Petition”). The Petition seeks (i) to declare null and void: (a) the share swap transaction between SMFB and SMC involving the transfer of SMC’s common shares in SMB and GSMI and in consideration therefor, the issuance of new SMFB common shares from the increase in SMFB’s capital stock; and, (b) SMFB’s Certificate of Approval of Increase of Capital Stock and Certificate of Filing of Amended Articles of Incorporation (amending Article VII thereof) issued by the SEC on June 29, 2018; or (ii) in the alternative, for SMFB to be directed to conduct a mandatory tender offer under Section 19 of the Securities Regulation Code for the benefit of the remaining shareholders of GSMI.

-1

-1

Management Discussion and Analysis

SMC, SMFB and GSMI filed their respective Answers to the Petition on September 25, 2018. On October 11, 2018, Petitioner filed a Reply to the Answer filed by SMC, SMFB and GSMI. On October 30, 2018, the SEC issued an order setting the case for a preliminary conference on November 13, 2018.

Separately, the Petitioner filed an Urgent Motion to Issue a Status Quo Order against SMC, SMFB and GSMI dated September 3, 2018. On October 4, 2018, SMFB filed a Comment/Opposition on the Urgent Motion while on October 9, 2018, SMC and GSMI likewise filed a Comment/Opposition to the said Urgent Motion. On November 8, 2018, the SEC denied the Urgent Motion filed by the Petitioner. On February 19, 2019, the SEC Special Hearing Panel dismissed the Petition for lack of merit. On March 14, 2019, counsels for SMC, GSMI and SMFB received a copy of the Motion for Reconsideration of the decision of the SEC Special Hearing Panel dated March 6, 2019. SMC, GSMI and SMFB will file their respective comments on the Motion for Reconsideration no later than March 29, 2019.

b. Penalties for Late Filing

On March 20, 2012, the Parent Company was assessed by the Corporate Finance Department of the SEC (SEC-CFD) for a penalty amounting to P769 million, in connection with the filing of the Statement of Initial Beneficial Ownership and Statement of Changes in the Beneficial Ownership (SEC Form 23-A and B, respectively) relating to the purchase by the Parent Company of the shares in Manila Electric Company (Meralco). The Parent Company filed an appeal from the order of the SEC-CFD to the SEC En Banc on April 17, 2012.

On November 21, 2017, the SEC En Banc rendered a Decision denying the appeal of the Parent Company.

On December 7, 2017, the Parent Company filed a petition for review of the Decision of the SEC En Banc to set aside the imposition of the penalty, with an urgent application for issuance of ex parte temporary restraining order and/or writ of preliminary injunction to enjoin the SEC from enforcing the said Decision.

In a Decision dated December 20, 2018, the Court of Appeals ruled in favor of the Parent Company that the penalty imposed by the SEC was in violation of Section 54.1 (ii) of the Securities Regulation Code.

The issue in the petition filed by the Parent Company is whether the SEC En Banc erred in affirming the respondent Corporate Finance Department's imposition upon petitioner SMC of the fine of P769 million for late filing of SEC Forms 23-A and B, and in not applying the limitation prescribed under Section 54.1 (ii) of the SEC.

In view of the favorable decision, the penalty was reduced to P3 million. The SEC has filed a manifestation in the Court of Appeals that it will no longer appeal the said Decision, and accordingly the decision of the Court of Appeals became final and executory.

Management Discussion and Analysis

c. Treasury Shares of the Parent Company

A portion of the total treasury shares of the Parent Company came from 25,450,000 common shares with an acquisition cost of P481 million, [net of the cost of the 1,000,000 shares paid to the Presidential Commission on Good Government (PCGG) as arbitral fee pursuant to the Compromise Agreement, as herein defined] which were reverted to treasury in 1991 upon implementation of the Compromise Agreement and Amicable Settlement (Compromise Agreement) executed by the Parent Company with the United Coconut Planters Bank (UCPB) and the Coconut Industry Investment Fund (CIIF) Holding Companies in connection with the purchase of the common shares of the Parent Company under an agreement executed on March 26, 1986.

Certain parties have opposed the Compromise Agreement. The right of such parties to oppose, as well as the propriety of their opposition, has been the subject matters of cases before the Sandiganbayan and the Supreme Court.

On September 14, 2000, the Supreme Court upheld a Sandiganbayan Resolution requiring the Parent Company to deliver the 25,450,000 common shares that were reverted to treasury in 1991 to the PCGG and to pay the corresponding dividends on the said shares (the “Sandiganbayan Resolution”).

On October 10, 2000, the Parent Company filed a motion for reconsideration with the Supreme Court to be allowed to comply with the delivery and payment of the dividends on the treasury shares only in the event that another party, other than the Parent Company, is declared owner of the said shares in the case for forfeiture (Civil Case) filed by the Philippine government (Government).

On April 17, 2001, the Supreme Court denied the motion for reconsideration.

On September 19, 2003, the PCGG wrote the Parent Company to deliver to the PCGG the stock certificates and cash and stock dividends under the Sandiganbayan Resolution upheld by the Supreme Court. The Parent Company referred the matter to its external financial advisor and external legal counsel for due diligence and advice. The external financial advisor presented to the BOD on December 4, 2003 the financial impact of compliance with the resolution considering “with and without due compensation” scenarios, and applying different rates of return to the original amount paid by the Parent Company. The financial advisor stated that if the Parent Company is not compensated for the conversion of the treasury shares, there will be:
(a) a negative one-off EPS impact in 2003 of approximately 17.5%; (b) net debt increase of approximately P2,100 million; and (c) a negative EPS impact of 6.9% in 2004. The external legal counsel at the same meeting advised the BOD that, among others, the facts reviewed showed that: (a) the compromise shares had not been validly sequestered; (b) no timely direct action was filed to nullify the transaction;
(c) no rescission can be effected without a return of consideration; and (d) more importantly, requiring the Parent Company to deliver what it acquired from the sellers without a substantive ground to justify it, and a direct action in which the Parent Company is accorded full opportunity to defend its rights, would appear contrary to its basic property and due process rights. The external legal counsel concluded that the Parent Company has “legal and equitable grounds to challenge the enforcement” of the Sandiganbayan Resolution.

Management Discussion and Analysis

On January 29, 2004, the external legal counsel made the additional recommendation that the Parent Company should file a Complaint-in-Intervention in the Civil Case (now particularly identified as SB Civil Case No. 0033-F), the forfeiture case brought by the Government involving the so-called CIIF block of the Parent Company shares of stock of which the treasury shares were no longer a portion. The Complaint-in-Intervention would pray that any judgment in the Civil Case forfeiting the CIIF block of the Parent Company shares of stock should exclude the treasury shares.

At its January 29, 2004 meeting, the BOD of the Parent Company unanimously decided to: (a) deny the PCGG demand of September 19, 2003, and (b) authorize the filing of the Complaint-in-Intervention. Accordingly, the external legal counsel informed the PCGG of the decision of the Parent Company and the Complaint-in-Intervention was filed in the Civil Case.

In a Resolution dated May 6, 2004, the Sandiganbayan denied the Complaint-in-Intervention. The external legal counsel filed a Motion for Reconsideration, which was denied by the Sandiganbayan in its Decision dated November 28, 2007.

The external legal counsel advised that because the Sandiganbayan had disallowed the Parent Company’s intervention, the Sandiganbayan’s disposition of the so-called CIIF block of the Parent Company shares in favor of the Government cannot bind the Parent Company, and that the Parent Company remains entitled to seek the nullity of that disposition should it be claimed to include the treasury shares.

The external legal counsel also advised that the Government has, in its own court submissions: (i) recognized the Parent Company’s right to the treasury shares on the basis that the Compromise Agreement is valid and binding on the parties thereto; and (ii) taken the position that the Parent Company and UCPB had already implemented the Compromise Agreement voluntarily, and that the PCGG had conformed to the Agreement and its implementation. The Executive Committee of the Parent Company approved the recommendation of external legal counsel on January 18, 2008 which was ratified by the BOD on March 6, 2008.

On July 23, 2009, the stockholders of the Parent Company approved the amendment of the Articles of Incorporation to issue Series “1” preferred shares, and the offer to exchange common shares to Series “1” preferred shares. The PCGG, with the approval of the Supreme Court in its Resolution dated September 17, 2009, converted the sequestered common shares in the Parent Company in the name of the CIIF Holding Companies, equivalent to 24% of the outstanding capital stock, into Series “1” preferred shares.

On February 11, 2010, the Supreme Court, amending its Resolution dated September 17, 2009, authorized the PCGG to exercise discretion in depositing in escrow, the net dividend earnings on, and/or redemption proceeds from, the Series “1” preferred shares of the Parent Company, either with the Development Bank of the Philippines/Land Bank of the Philippines or with the UCPB. All dividends accruing to the Series “1” preferred shares are remitted to the escrow account established with UCPB.

Management Discussion and Analysis

On October 5, 2012, the Parent Company redeemed all Series “1” preferred shares including those Series “1” preferred shares in the name of the CIIF Holding Companies. Proceeds of such redemption with respect to Series “1” preferred shares in the name of the CIIF Holding Companies, including all accumulated dividends were paid to the National Treasury. As of October 5, 2012, CIIF Holding Companies are no longer stockholders of the Parent Company.

On June 30, 2011, the PCGG filed with the Supreme Court an Urgent Motion to Direct the Parent Company to comply with the Sandiganbayan Resolution (the “Urgent Motion”). On March 30, 2012, the Parent Company filed a Comment on the Urgent Motion in compliance with the Supreme Court's Resolution dated December 13, 2011 in G.R. Nos. 180705, 177857-58 and 178193, which was received by the Parent Company on February 22, 2012, directing the Parent Company to file its Comment on the Urgent Motion. The Supreme Court, in the Resolution of April 24, 2012 noted the comment of the Parent Company.

Thereafter, the PCGG filed in G.R. Nos. 177857-58 and 178193 a “Manifestation and Omnibus Motion 1) To Amend the Resolution Promulgated on September 4, 2012 to Include the “Treasury Shares” which are Part and Parcel of the 33,133,266 Coconut Industry Investment Fund (CIIF) Block of San Miguel Corporation (SMC) Shares of 1983 Decreed by the Sandiganbayan, and Sustained by the Honorable Court, as Owned by the Government; and 2) To Direct SMC to Comply with the Final and Executory Resolutions Dated October 24, 1991 and March 18, 1992 of the Sandiganbayan Which Were Affirmed by the Honorable Court in G.R. Nos. 104637-38” (“Manifestation and Omnibus Motion”).

The | Supreme | Court, in | the | Resolution | of November | 20, | 2012 in
G.R. Nos. 177857-58 and 178193, required the Parent Company to comment on COCOFED, et al.’s “Manifestation” dated October 4, 2012 and PCGG’s “Manifestation and Omnibus Motion.” Atty. Estelito P. Mendoza, counsel for Eduardo M. Cojuangco, Jr. in G.R. No. 180705, who is a party in that case, filed a “Manifestation Re: ‘Resolution’ dated November 20, 2012,” dated December 17, 2012, alleging that (a) Mr. Cojuangco, Jr. is not a party in G.R. Nos. 177857-58 and 178193 and he has not appeared as counsel for any party in those cases; (b) the Parent Company is likewise not a party in those cases, and if the Parent Company is indeed being required to comment on the pleadings in the Resolution of November 20, 2012, a copy of the Resolution be furnished the Parent Company; and
(c) the Supreme Court had already resolved the motion for reconsideration in G.R. Nos. 177857-58 and 178193 and stated that “no further pleadings shall be entertained, thus, any motion filed in the said cases thereafter would appear to be in violation of the Supreme Court’s directive”.

In its Resolution of June 4, 2013 in G.R. Nos. 177857-58 and 178193, the Supreme Court required the Parent Company to file its comment on the (a) Manifestation, dated October 4, 2012 filed by petitioners COCOFED, et al. and (b) Manifestation and Omnibus Motion dated October 12, 2012 filed by the Office of the Solicitor General for respondent Republic of the Philippines, as required in the Supreme Court Resolution, dated November 20, 2012, within ten (10) days from notice thereof.

Management Discussion and Analysis

In the Resolution, dated September 10, 2013, the Supreme Court directed the Parent Company, through its counsel or representative, to immediately secure from the Office of the Clerk of Court of the Supreme Court En Banc photocopies of the
(a) Manifestation, dated October 4, 2012 filed by petitioners COCOFED, et al. and
(b) Manifestation and Omnibus Motion dated October 12, 2012 filed by the Office of the Solicitor, and granted the Parent Company’s motion for a period of thirty (30) days from receipt of the pleadings within which to file the required comment per resolutions dated November 20, 2012 and June 4, 2013.

The Parent Company, thru external counsel, filed the following comments required in the Supreme Court Resolution of June 4, 2013 in G.R. Nos. 177857-58;
(a) “Comment of San Miguel Corporation on the ‘Manifestation’ of Petitioners COCOFED, et al., Dated October 4, 2012” on November 6, 2013; and
(b) “Comment of San Miguel Corporation on the ‘Manifestation and Omnibus Motion…’ Dated October 12, 2012 of the Respondent Republic” on December 3, 2013.

In the Entry of Judgment received on January 27, 2015, the Supreme Court entered in the Book of Entries of Judgments the Resolution of September 4, 2012 in G.R. Nos. 177857-58 and G.R. No. 178193 wherein the Supreme Court clarified that the 753,848,312 SMC Series “1” preferred shares of the CIIF companies converted from the CIIF block of SMC shares, with all the dividend earnings as well as all increments arising therefrom shall now be the subject matter of the January 29, 2012 Decision and declared owned by the Government and used only for the benefit of all coconut farmers and for the development of the coconut industry. Thus, the fallo of the Decision dated January 24, 2012 was accordingly modified.

In the meantime, the Parent Company has available cash and shares of stock for the dividends payable on the treasury shares, in the event of an unfavorable ruling by the Supreme Court.

On October 5, 2016, the Supreme Court of the Philippines in G.R. Nos. 177857-58 and 178193 issued a Judgment denying the “Manifestation and Omnibus Motion” filed by the Presidential Commission on Good Government to amend the Resolution Promulgated on September 4, 2012 to Include the “Treasury Shares” Which are Part and Parcel of the 33,133,266 Coconut Industry Investment Fund (CIIF) Block of San Miguel Corporation (SMC) Shares of 1983 Decreed by the Sandiganbayan, and Sustained by the Honorable Court, as Owned by the Government. The denial of the motion is without prejudice to the right of the Republic of the Philippines to file the appropriate action or proceeding to determine the legal right of the Parent Company to the 25,450,000 treasury shares of the Parent Company. On November 29, 2016, the Supreme Court denied with finality the motion for reconsideration of the Republic of the Philippines.

d. Deficiency Excise Tax/Excess Excise Tax Payments

Filed by the Parent Company

On April 12, 2004 and May 26, 2004, the Parent Company was assessed by the BIR for deficiency excise tax on “San Mig Light”, one of its beer products. The Parent Company contested the assessments before the Court of Tax Appeals (CTA) (1st Division) under CTA Case Nos. 7052 and 7053.

Management Discussion and Analysis

In relation to the aforesaid contested assessments, the Parent Company, on January 31, 2006, filed with the CTA (1st Division), under CTA Case No. 7405, a claim for refund of taxes paid in excess of what it believes to be the excise tax rate applicable to it.

The above assessment cases (CTA Case Nos. 7052 and 7053) and claim for refund (CTA Case No. 7405), which involve common questions of fact and law, were subsequently consolidated and jointly tried.

On November 27, 2007, the Parent Company filed with the CTA (3rd Division), under CTA Case No. 7708, a second claim for refund, also in relation to the contested assessments, as it was obliged to continue paying excise taxes in excess of what it believes to be the applicable excise tax rate.

On January 11, 2008, the BIR addressed a letter to the Parent Company, appealing to the Parent Company to settle its alleged tax liabilities subject of CTA Case Nos. 7052 and 7053 “in order to obviate the necessity of issuing a Warrant of Distraint and Garnishment and/or Levy”. The Parent Company’s external legal counsel responded to the aforesaid letter and met with appropriate officials of the BIR and explained to the latter the unfairness of the issuance of a Warrant of Distraint and Garnishment and/or Levy against the Parent Company, especially in view of the Parent Company’s pending claims for refund.

As of December 31, 2018, the BIR has taken no further action on the matter.

On July 24, 2009, the Parent Company filed its third claim for refund with the CTA (3rd Division), under CTA Case No. 7953, also in relation to the contested assessments. As mentioned later in this Note, CTA Case No. 7953 was consolidated with CTA Case No. 7973 filed by SMB, which consolidated cases were subsequently decided in favor of the Parent Company and SMB by the CTA Third Division, ordering the BIR to refund to them the joint amount of P934 million.

On January 7, 2011, the CTA (3rd Division) under CTA Case No. 7708 rendered its decision in this case, granting the Parent Company’s petition for review on its claim for refund and ordering respondent Commissioner of Internal Revenue to refund or issue a tax credit certificate in favor of the Parent Company in the amount of P926 million, representing erroneously, excessively and/or illegally collected and overpaid excise taxes on “San Mig Light” during the period from December 1, 2005 up to July 31, 2007. This decision was elevated by the BIR Commissioner to the CTA En Banc and the appeal was denied in the case docketed as CTA EB No. 755. The Office of the Solicitor General filed with the Supreme Court a Petition for Review which was docketed as G.R. No. 205045.

On October 18, 2011, the CTA (1st Division) rendered its joint decision in CTA Case Nos. 7052, 7053 and 7405, cancelling and setting aside the deficiency excise tax assessments against the Parent Company, granting the latter’s claim for refund and ordering the BIR Commissioner to refund or issue a tax credit certificate in its favor in the amount of P782 million, representing erroneously, excessively and/or illegally collected and overpaid excise taxes on “San Mig Light” during the period from February 1, 2004 to November 30, 2005.

Management Discussion and Analysis

A motion for reconsideration filed by the BIR Commissioner on the aforesaid decision was denied and the Commissioner elevated the decision to CTA En Banc for review, which was docketed as CTA EB No. 873, the same was dismissed in a Decision dated October 24, 2012. The subsequent Motion for Reconsideration filed by the Commissioner was likewise denied. The CTA En Banc Decision was later elevated by the Office of the Solicitor General to the Supreme Court by Petition for Review, which was docketed as G.R. No. 20573 and raffled to the Third Division. This case was subsequently consolidated with G.R. No. 205045.

In a Resolution dated July 21, 2014, a copy of which was received by the Parent Company’s counsel on August 27, 2014, the Third Division of the Supreme Court required the parties to submit memoranda. Both the Parent Company’s counsel and the BIR Commissioner, through the Office of the Solicitor General, filed their respective memorandum.

On January 25, 2017, the Supreme Court decided in the consolidated cases of G.R. Nos. 205045 and 205723 to uphold the decision of the CTA requiring the BIR to refund excess taxes erroneously collected in the amount of P926 million for the period of December 1, 2005 to July 31, 2007, and P782 million for the period of February 2, 2004 to November 30, 2005. The Office of the Solicitor General filed motions for reconsideration, which were denied by the Supreme Court with finality on April 19, 2017. On November 12, 2018, after the cases under G.R. Nos. 205045 and 205723 were remanded by the Supreme Court to the Court of Tax Appeals, the Parent Company filed a motion for execution in CTA Cases Nos. 7052, 7053 and 7405 on the final judgment of the CTA of P782 million representing refund of excess taxes erroneously collected for the period of February 2, 2004 to November 30, 2005; and another and separate motion for execution in CTA Case No. 7708 on the final judgment of P926 million for the period of December 1, 2005 to July 31, 2007. These motions for execution, to which the Commissioner of Internal Revenue offered no opposition, are pending resolution in the First and Second Divisions of the CTA.

In the meantime, effective October 1, 2007, the Parent Company spun off its domestic beer business into a new company, SMB. SMB continued to pay the excise taxes on “San Mig Light” at the higher rate required by the BIR and in excess of what it believes to be the excise tax rate applicable to it.

Filed by SMB

SMB filed ten claims for refund for overpayments of excise taxes with the BIR which were then elevated to the CTA by way of petition for review on the following dates:

(a) first claim for refund of overpayments for the period from October 1, 2007 to December 31, 2008 - Second Division docketed as CTA Case No. 7973 (September 28, 2009);
(b) second claim for refund of overpayments for the period of January 1, 2009 to December 31, 2009 - First Division docketed as CTA Case No. 8209 (December 28, 2010);

Management Discussion and Analysis

(c) third claim for refund of overpayments for the period of January 1, 2010 to December 31, 2010 - Third Division docketed as CTA Case No. 8400 (December 23, 2011);
(d) fourth claim for refund of overpayments for the period of January 1, 2011 to December 31, 2011 - Second Division docketed as CTA Case No. 8591 (December 21, 2012);
(e) fifth claim for refund of overpayments for the period of January 1, 2012 to December 31, 2012 - Second Division docketed as CTA Case No. 8748 (December 19, 2013);
(f) sixth claim for refund of overpayments for the period of January 1, 2013 to December 31, 2013 - docketed as CTA Case No. 8955 (December 2014);
(g) seventh claim for refund of overpayments for the period of January 1, 2014 to December 31, 2014 - docketed as CTA Case No. 9223 (December 2015);
(h) eighth claim for refund of overpayments for the period of January 1, 2015 to December 31, 2015 - docketed as CTA Case No. 9513 (December 2016);
(i) ninth claim for refund of overpayments for the period from January 1, 2016 to December 31, 2016 - docketed as CTA Case No. 9743 (December 2017); and
(j) tenth claim for refund of overpayments for the period from January 1, 2017 to December 31, 2017 – docketed as CTA Case No. 10000 (December 2018).

CTA Case No. 7973, which was consolidated with CTA Case No. 7953, had been decided in favor of SMB by the Third Division, ordering the BIR in the consolidated cases to refund to SMC and SMB the joint amount of P934 million, which decision was appealed by the BIR before the CTA En Banc. The CTA En Banc affirmed the Decision of the Third Division and, subsequently, the BIR filed a Motion for Reconsideration, which was denied. The BIR elevated the CTA En Banc decision to the Supreme Court by way of a petition for review, which was docketed thereat as G.R. No. 232404. The petition was denied by the Supreme Court on September 11, 2017, thereby affirming the decision of the CTA En Banc. On January 23, 2019, after the motion for reconsideration filed by the Office of the Solicitor General was denied and the Supreme Court remanded the cases to the Court of Tax Appeals, SMC/SMB filed a motion for execution with the CTA. This motion is pending with the CTA Second Division.

CTA Case No. 8209 was decided in favor of SMB by the CTA’s First Division, ordering the BIR to refund the amount of P730 million. The case was not appealed by the BIR within the prescribed period, thus, the decision was deemed final and executory. The First Division granted SMB’s Motion for Execution, while the BIR filed a petition for certiorari before the Supreme Court, where it was docketed as G.R. No. 221790. The petition was dismissed by the Supreme Court with finality but the BIR still filed an urgent motion for clarification. Subsequently, SMB, through counsel, received a clarificatory resolution dated February 20, 2017 wherein the Supreme Court reiterated its grounds for the denial of the BIR’s petition for certiorari.

Management Discussion and Analysis

CTA Case No. 8400 was decided in favor of SMB by both the CTA’s Third Division and the CTA En Banc, ordering the BIR to refund the amount of P699 million. The BIR filed a motion for reconsideration, which the CTA En Banc denied. Subsequently, the BIR elevated the decision of the CTA En Banc to the Supreme Court by way of petition for review, where it was docketed as G.R. No. 226768. On March 20, 2017, the Supreme Court denied the petition for review, thereby affirming the CTA En Banc decision. The Office of the Solicitor General filed a motion for reconsideration, which was denied on July 24, 2017. On January 23, 2019, after the Supreme Court remanded the case to the Court of Tax Appeals, SMB filed a motion for execution with the CTA. This motion is pending with the CTA Third Division.

CTA Case No. 8591 was decided in favor of SMB by the Second Division. The BIR was ordered to refund to SMB the amount of P740 million. On appeal to the CTA En Banc, the latter affirmed the decision of the division. The BIR filed a motion for reconsideration, which was denied by the CTA En Banc. The BIR, through the Office of the Solicitor General, appealed the CTA En Banc decision to the Supreme Court by way of petition for review, where it was docketed as G.R. No. 232776. On February 21, 2018, the Supreme Court denied the petition for review and affirmed the decision of the CTA En Banc. Subsequently, the Office of the Solicitor General filed a motion for reconsideration, which was denied with finality on July 23, 2018. As soon as the case is remanded by the Supreme Court to the Court of Tax Appeals, SMB will file a motion for execution with the CTA Second Division.

In CTA Case No. 8748, the Second Division rendered a decision on June 9, 2017, granting SMB’s claim for refund of P761 million, which was appealed by the BIR to the CTA En Banc. On October 11, 2018, the CTA En Banc rendered its decision in this case denying the CIR's petition for review and affirming the decision of the CTA Second Division. On November 5, 2018, the CIR filed a motion for reconsideration, to which SMB filed an opposition. The CIR's motion for reconsideration is pending in the CTA En Banc.

The petition for review in CTA Case No. 8955 was denied by the Third Division on the ground that the same involves a collateral attack on issuances of the BIR, the court ruling that the petition should have been filed in the Regional Trial Court (RTC). SMB through counsel filed a motion for reconsideration, arguing that the case involves a claim for refund and is at the same time a direct attack on the BIR issuances which imposed excise tax rates which are contradictory to, and violative of, the rates imposed in the Tax Code. In a resolution dated January 5, 2018, the Third Division denied the motion for reconsideration. On February 14, 2018, SMB appealed the decision of the CTA Third Division denying its petition for review to the CTA En Banc by way of a petition for review. On September 19, 2018, the CTA En Banc issued its decision in this case, which reversed and set aside the decision of the CTA Third Division denying SMB's petition for review and remanded the case to the said Division for the resolution of the case on the merits. On October 10, 2019, the CIR filed a motion for reconsideration on the aforesaid decision, to which motion SMB filed an opposition. The motion was denied by the CTA En Banc in a resolution dated January 24, 2019.

Management Discussion and Analysis

In CTA Cases Nos. 9223, 9513, and 9743, after the parties filed their memoranda, the cases were deemed submitted for decision.

CTA Case No. 10000 will be scheduled for pre-trial after the respondent BIR Commissioner shall have filed his answer to SMB's petition for review.

Filed by GSMI

CTA Case Nos. 8953 and 8954: These cases pertain to GSMI’s Claims for Refund with the BIR, in the amount of P582 million in Case No. 8953, and P133 million in Case No. 8954 representing payments of excise tax erroneously, excessively, illegally, and/or wrongfully assessed on and collected from GSMI by the BIR on removals of its distilled spirits or finished products for the periods from January 1, 2013 up to May 31, 2013 in Case No. 8953, and from January 8, 2013 up to March 31, 2013 in Case No. 8954.

CTA Case No. 9059: This case pertains to GSMI’s Claim for Refund with the BIR, in the total amount of P26 million, representing payments of excise tax erroneously, excessively, illegally, and/or wrongfully assessed on and collected from GSMI by the BIR on removals of its distilled spirits or finished products for the period from June 1, 2013 up to July 31, 2013.

The aforementioned assessments and collection cases arose from the imposition and collection of excise taxes on GSMI’s finished products processed and produced exclusively from its inventory of ethyl alcohol, notwithstanding that excise taxes had already been previously paid by GSMI on the said ethyl alcohol. This case is still pending with the CTA.

e. Deficiency Tax Liabilities

The BIR issued a Final Assessment Notice dated March 30, 2012 (2009 Assessment), imposing on Iconic Beverages, Inc. (IBI) deficiency tax liabilities, including interest and penalties, for the tax year 2009. IBI treated the royalty income earned from the licensing of its intellectual properties to SMB as passive income, and therefore subject to 20% final tax. However, the BIR is of the position that said royalty income is regular business income subject to the 30% regular corporate income tax.

Management Discussion and Analysis

On May 16, 2012, IBI filed a protest against the 2009 Assessment. In its Final Decision on Disputed Assessment issued on January 7, 2013, the BIR denied IBI’s protest and reiterated its demand to pay the deficiency income tax, including interests and penalties. On February 6, 2013, IBI filed a Petition for Review before the CTA contesting the 2009 Assessment. The case was docketed as CTA Case No. 8607 with the First Division. On August 14, 2015, the CTA First Division partially granted the Petition for Review of IBI, by cancelling the compromise penalty assessed by the BIR. However, IBI was still found liable to pay the deficiency income tax, interests and penalties as assessed by the BIR. The Motion for Reconsideration was denied by the CTA’s First Division on January 6, 2016. On January 22, 2016, IBI filed its Petition for Review before the CTA En Banc and the case was docketed as CTA EB Case No. 1417. To interrupt the running of interests, IBI filed a Motion to Pay without Prejudice, which was granted by the CTA En Banc. As a result, IBI paid the amount of P270 million on August 26, 2016. On January 30, 2018, the CTA En Banc rendered a decision affirming the decision of the CTA First Division. IBI filed a Motion for Partial Reconsideration and the BIR filed its Motions for Reconsideration, which were denied by CTA En Banc in a resolution dated July 16, 2018. IBI and the BIR elevated the case to the Supreme Court with IBI filing its Petition for Certiorari on September 7, 2018. The petitions of IBI and the BIR are pending in the Supreme Court.

On November 17, 2013, IBI received a Formal Letter of Demand with the Final Assessment Notice for tax year 2010 (2010 Assessment) from the BIR with a demand for payment of income tax and VAT deficiencies with administrative penalties. The BIR maintained its position that royalties are business income subject to the 30% regular corporate tax. The 2010 Assessment was protested by IBI before the BIR through a letter dated November 29, 2013. A Petition for Review was filed with the CTA Third Division and the case was docketed as CTA Case No. 8813. The CTA Third Division held IBI liable to pay deficiency income tax, interests and penalties. IBI thus filed its Petition for Review before the CTA En Banc (docketed as CTA EB No 1563 and 1564). In 2017, IBI filed an application for abatement, with corresponding payment of basic deficiency tax, in the amount of P110 million, where IBI requested for the cancellation of the surcharge and interests.

On September 19, 2018, the CTA En Banc did not consider the payment of basic deficiency tax of P110 for failure to attach certain requirements relating to the application for abatement; thus IBI was ordered to pay a modified amount of P501 million in light of the amendments under RA No. 10963, also known as Tax Reform for Acceleration and Inclusion (TRAIN Law), on interest. IBI filed a Motion for Reconsideration and, at the same time, submitted the original documents in relation to the application for abatement. The BIR also filed its Motion for Partial Reconsideration, to which IBI filed its Comment/Opposition. The CTA En Banc has likewise ordered the BIR to file its Comment/Opposition to IBI’s Motion for Reconsideration but IBI has yet to receive the same. Meanwhile, IBI’s application for abatement remains pending for resolution by the BIR.

On December 27, 2016, IBI received a Formal Letter of Demand for tax year 2012 with a demand for payment of income tax, VAT, withholding tax, documentary stamp tax and miscellaneous tax deficiencies with administrative penalties. IBI addressed the assessment of each tax type with factual and legal bases in a Protest filed within the reglementary period. Due to the inaction of the BIR, IBI filed a Petition for Review with the CTA Third Division and docketed as CTA Case No. 9657. An application for abatement was submitted to the BIR in August 2017. Both the Petition for Review and the application for abatement remain pending for resolution by the CTA Third Division and the BIR, respectively, with IBI submitting its Formal Offer of Evidence in October 2018 to the CTA Third Division. The

Management Discussion and Analysis

Petition for Review, however, was subsequently transferred from the CTA Third Division to the First Division pursuant to the CTA Administrative Circular No. 02-2018 dated September 18, 2018, reorganizing the three (3) Divisions of the Court. On December 18, 2018, the CTA First Division issued a Resolution admitting IBI’s Formal Offer of Evidence and resetting the presentation of evidence by the BIR on March 5, 2019.

f. San Miguel Foods, Inc. (SMFI)
i. SMFI (as the surviving corporation in a merger involving Monterey Foods Corporation [MFC]) vs. Commissioner of Internal Revenue (CIR) CTA Case 9046, First Division.

In connection with the tax investigation of MFC for the period January 1 to August 31, 2010, a Final Decision on Disputed Assessment (FDDA) was issued by the BIR on January 14, 2015 upholding the deficiency income tax, VAT and DST assessments against SMFI.

SMFI filed a Request for Reconsideration with the CIR on February 6, 2015. On April 21, 2015, SMFI received a letter from the CIR informing SMFI of the CIR’s denial of the request for reconsideration.

The Petition for Review was filed with the CTA First Division on May 15, 2015 and docketed as CTA Case No. 9046.

The CTA First Division, on February 12, 2018, granted the Petition for Review filed by SMFI based on the following grounds: (1) the Formal Letter of Demand / Final Assessment Notice issued by the BIR was void as it did not contain demand to pay taxes due within a specific period; and (2) lack of valid Letter of Authority. Accordingly, the Formal Letter of Demand /Final Assessment Notice issued against SMFI for deficiency income tax, VAT and DST for the period January 1 to August 31, 2010 and the FDDA, for being intrinsically void, were ordered cancelled.

On March 1, 2018, the BIR filed a Motion for Reconsideration with the CTA First Division. On March 16, 2018, SMFI, through external counsel, filed an Opposition to the Motion for Reconsideration filed by the BIR.

On June 4, 2018, the CTA First Division denied the BIR’s Motion for Reconsideration. BIR filed the Petition for Review before the CTA En Banc on July 13, 2018.

On August 17, 2018, SMFI filed Comment on the Petition for Review filed by the BIR. Per Resolution of the CTA En Banc dated September 7, 2018, the Petition for Review is deemed submitted for decision by the Court.

ii. SMFI vs. CIR CTA Case No. 9241, First Division

On December 16, 2015, an FDDA was issued by the BIR assessing deficiency income tax and VAT against SMFI in connection to the tax investigation for the period January 1 to December 31, 2010.

Management Discussion and Analysis

The deficiency income tax and VAT pertain to the disallowed NOLCO and input tax credits which were transferred to and vested in SMFI from MFC by operation of law as a result of the merger between SMFI and MFC. According to the BIR, as the ruling (BIR Ruling 424-14 dated October 24, 2014) issued in connection to the merger of SMFI and MFC did not contain an opinion on the assets and liabilities transferred during the merger, the NOLCO and input tax credits from MFC were disallowed. However, it is SMFI’s position that the use of the NOLCO and input tax credit from MFC, as the surviving corporation pursuant to a statutory merger is proper, as the same is allowed by law, BIR issuances and confirmed by several BIR rulings prevailing at the time of the transaction.

On January 14, 2016, SMFI filed a Petition for Review before the CTA First Division and docketed as CTA Case No. 9241. On September 2, 2016, the Judicial Affidavits for SMFI witnesses were submitted to the CTA and said witnesses were presented for cross examination on July 25 and August 22, 2017, respectively. On May 10, 2018, witness for the BIR was presented before the Court for cross examination.

The case is now submitted for decision of the CTA First Division.

g. Tax Credit Certificates Cases

In 1998, the BIR issued a deficiency excise tax assessment against Petron relating to its use of P659 million worth of Tax Credit Certificates (TCCs) to pay certain excise tax obligations from 1993 to 1997. The TCCs were transferred to Petron by suppliers as payment for fuel purchases. Petron contested the BIR’s assessment before the CTA. In July 1999, the CTA ruled that as a fuel supplier of BOI-registered companies, Petron was a qualified transferee of the TCCs and that the collection by the BIR of the alleged deficiency excise taxes was contrary to law. On March 21, 2012, the Court of Appeals promulgated a decision in favor of Petron and against the BIR affirming the ruling of the CTA striking down the assessment issued by the BIR to Petron. On April 19, 2012, a motion for reconsideration was filed by the BIR, which was denied by the Court of Tax Appeals in its Resolution dated October 10, 2012. The BIR elevated the case to the Supreme Court through a petition for review on certiorari dated December 5, 2012. On July 9, 2018, the Supreme Court rendered a decision in favor of Petron denying the petition for review filed by the BIR and affirming the decision of the Court of Appeals. No motion for reconsideration for such decision relating to Petron was filed by the BIR.

h. Oil Spill Incident in Guimaras

On August 11, 2006, MT Solar I, a third party vessel contracted by Petron to transport approximately two million liters of industrial fuel oil, sank 13 nautical miles southwest of Guimaras, an island province in the Western Visayas region of the Philippines. In separate investigations by the Philippine Department of Justice (DOJ) and the Special Board of Marine Inquiry (SBMI), both agencies found the owners of MT Solar I liable. The DOJ found Petron not criminally liable, but the SBMI found Petron to have overloaded the vessel. Petron has appealed the findings of the SBMI to the DOTr and is awaiting its resolution. Petron believes that SBMI can impose administrative penalties on vessel owners and crew, but has no authority to penalize other parties, such as Petron, which are charterers.

Management Discussion and Analysis

Other complaints for non-payment of compensation for the clean-up operations during the oil spill were filed by a total of 1,063 plaintiffs who allegedly did not receive any payment of their claims for damages arising from the oil spill. The total claims amounted to P292 million. The cases are still pending as of December 31, 2018.

i. Lease Agreements with Philippine National Oil Company (PNOC)

On October 20, 2017, Petron filed with the RTC of Mandaluyong City a complaint against the PNOC for Resolution and Reconveyance, and Damages, with Verified Ex-Parte Application for 72-hour Temporary Restraining Order (TRO) and Verified Applications for 20-day TRO and Writ of Preliminary Injunction. In its complaint, Petron seeks the reconveyance of the various landholdings it conveyed to PNOC in 1993 as a result of the government-mandated privatization of Petron. These landholdings consist of the refinery lots in Limay, Bataan, 23 bulk plant sites and 66 service station lots located in different parts of the country. The Deeds of Conveyance covering the landholdings provide that the transfer of these lots to PNOC was without prejudice to the continued long-term use by Petron of the conveyed lots for its business operation. Thus, PNOC and Petron executed three lease agreements covering the refinery lots, the bulk plants, and the service station sites, all with an initial lease term of 25 years which expired in August 2018, with a provision for automatic renewal for another 25 years. In 2009, Petron, through its realty subsidiary, NVRC, had an early renewal of the lease agreement for the refinery lots with an initial lease term of 30 years, renewable for another 25 years.

The complaint stemmed from PNOC’s refusal to honor both the automatic renewal clause in the lease agreements for the bulk plants and the service station sites and the renewed lease agreement for the refinery lots on the alleged ground that all such lease agreements were grossly disadvantageous to PNOC, a government-owned-and-controlled corporation.

Petron alleged that by unilaterally setting aside the renewal clauses of the lease agreements and by categorically declaring its refusal to honor them, PNOC committed a fundamental breach of such lease agreements with Petron.

On December 11, 2017, the trial court granted Petron’s prayer for a writ of preliminary injunction, enjoining PNOC from committing any act aimed at ousting Petron from possession of the subject properties until the case is decided.

The court-mandated mediation conference held at the Philippine Mediation Center in Mandaluyong City on February 5, 2018 was terminated without any agreement between the parties. As of December 31, 2018, the case was under judicial dispute resolution proceeding before the court.

j. Generation Payments to PSALM

SPPC and PSALM are parties to the Ilijan Independent Power Producer Administration (IPPA) Agreement covering the appointment of SPPC as the IPP administrator of the Ilijan Power Plant.

Management Discussion and Analysis

SPPC and PSALM have an ongoing dispute arising from differing interpretations of certain provisions related to generation payments under the Ilijan IPPA Agreement. As a result of such dispute, the parties have arrived at different computations regarding the subject payments. In a letter dated August 6, 2015, PSALM has demanded payment of the difference between the generation payments calculated based on its interpretation and the amount which has already been paid by the SPPC, plus interest, covering the period December 26, 2012 to April 25, 2015.

On August 12, 2015, SPPC initiated a dispute resolution process with PSALM as provided under the terms of the Ilijan IPPA Agreement, while continuing to maintain that it has fully paid all of its obligations to PSALM. Notwithstanding the bona fide dispute, PSALM issued a notice terminating the Ilijan IPPA Agreement on September 4, 2015. On the same day, PSALM also called on the Performance Bond posted by SPPC pursuant the Ilijan IPPA Agreement.

On September 8, 2015, SPPC filed a Complaint with the RTC of Mandaluyong City. In its Complaint, SPPC requested the RTC that its interpretation of the relevant provisions of the Ilijan IPPA Agreement be upheld. The Complaint also asked that a 72-hour TRO be issued against PSALM for illegally terminating the Ilijan IPPA Agreement and drawing on the Performance Bond. On even date, the RTC issued a 72-hour TRO which prohibited PSALM from treating SPPC as being in Administrator Default and from performing other acts that would change the status quo ante between the parties before PSALM issued the termination notice and drew on the Performance Bond. The TRO was extended for until September 28, 2015.

On September 28, 2015, the RTC issued an Order granting a Preliminary Injunction enjoining PSALM from proceeding with the termination of the Ilijan IPPA Agreement while the main case is pending.

On October 19, 2015, the RTC also issued an Order granting the Motion for Intervention and Motion to Admit Complaint-in-intervention by Meralco.

In an Order dated June 27, 2016, the RTC denied PSALM’s: (1) Motion for Reconsideration of the Order dated September 28, 2015, which issued a writ of prelimary injunction enjoining PSALM from further proceedings with the
termination | of | the | IPPA | Agreement | while | the | case | is | pending;
(2) Motion for Reconsideration of the Order, which allowed Meralco to intervene in the case; and (3) Motion to Dismiss. In response to this Order, PSALM filed a petition for certiorari with the Court of Appeals seeking to annul the RTC’s Orders granting the writ of preliminary injunction, allowing Meralco’s intervention, and the Orders denying PSALM’s motions for reconsideration of said injunction and intervention orders. PSALM also prayed for the issuance of a TRO and/or writ of preliminary injunction “against public respondent RTC and its assailed Orders”. The Court of Appeals, however, denied the petition filed by PSALM in its Decision dated December 19, 2017 (“CA Decision”). In the CA decision, the Court of Appeals upheld the lower court’s issuance of a writ of preliminary injunction against PSALM prohibiting the termination of the IPPA agreement while the case in the lower court is pending.

PSALM filed its Motion for Reconsideration dated January 19, 2018 to the CA Decision. In a Resolution dated July 12, 2018 (“CA Resolution”), the Court of Appeals denied PSALM’s Motion for Reconsideration of the CA Decision.

Management Discussion and Analysis

On September 4, 2018, PSALM filed a Petition for Certiorari with urgent prayer for the issuance of a TRO and/or Writ of Preliminary Injunction dated September 4, 2018 before the Supreme Court praying for the reversal and nullification of the CA Decision dated December 19, 2017 and the July 12, 2018 CA Resolution. To date, PSALM’s petition is still pending with the Supreme Court.

Prior to the CA Decision, on December 18, 2017, the presiding judge of the RTC who conducted the judicial dispute resolution issued an Order inhibiting himself in the instant case. The case was then re-raffled to another RTC judge in Mandaluyong City which scheduled the Pre-Trial Conference on May 11, 2018. Meanwhile, prior to the scheduled Pre-Trial Conference, SPPC filed a Request for Motion for Production of Documents on February 28, 2018, while PSALM filed its Manifestation with Motion to Hear Affirmative Defenses and Objections Ad Cautelam.

On September 24, 2018, the RTC issued an Order denying PSALM’s Motion to Hear Affirmative Defense and granted SPPC’s Motion for Production of Documents. PSALM then filed a Motion for Reconsideration of the said Order. On December 14, 2018, SPPC filed its Opposition to the Motion for Reconsideration. The issue is now pending resolution with the RTC.

Meanwhile, there are no restrictions or limitations on the ability of SPPC to supply power from the Ilijan Power Plant to Meralco under its PSA with the latter, or the ability of SPPC to take possession of the Ilijan Power Plant upon expiry of the IPPA agreement in 2022.

By virtue of the Preliminary Injunction issued by the RTC, SPPC continues to be the IPP administrator for the Ilijan Power Plant.

k. Intellectual Property Rights

G.R. No. 196372: This case pertains to GSMI’s application for the registration of the trademark “GINEBRA” under Class 33 (“gin”) with the Intellectual Property Office of the Philippines (“IPOPHL”). The IPOPHL rejected GSMI’s application on the ground that “GINEBRA” is a Spanish word for gin, and is a generic term incapable of appropriation.

When the Court of Appeals affirmed the IPOPHL’s ruling, GSMI filed a Petition for Review on Certiorari (the “Petition”) with the Supreme Court. The Supreme Court denied GSMI’s Petition. GSMI moved for a reconsideration thereof, and likewise filed a Motion to Refer its Motion for Reconsideration to the Supreme Court En Banc. Unfortunately, the Supreme Court denied GSMI’s Motion for Reconsideration “with FINALITY”, as well as GSMI’s Motion to Refer to Court En Banc.

Subsequently, GSMI filed a Manifestation with Motion for Relief from Judgment and invoked the case of “League of Cities vs. Commission of Elections” (G.R. Nos. 176951, 177499 and 178056) to invite the Supreme Court En Banc to re-examine the case. This case is still pending with the Supreme Court.

G.R. Nos. 210224 and 219632: These cases pertain to GSMI’s complaint for trademark infringement and unfair competition against Tanduay Distillers, Inc. (“TDI”) filed with the RTC, arising from TDI’s distribution and sale of “Ginebra Kapitan” and use of a bottle design similar to that used by GSMI. The RTC dismissed GSMI’s complaint.

Management Discussion and Analysis

When GSMI elevated the case to the Court of Appeals, due to technicalities, two (2) cases were lodged in the Court of Appeals: 1.) Petition for Review (CA-G.R. SP No. 127255), and 2.) Notice of Appeal (CA-G.R. SP No. 100332).

Acting on GSMI’s Petition for Review, the Court of Appeals reversed, set aside the RTC’s Decision, and ruled that “GINEBRA” is associated by the consuming public with GSMI. Giving probative value to the surveys submitted by GSMI, the Court of Appeals ruled that TDI’s use of “GINEBRA” in “Ginebra Kapitan” produces a likelihood of confusion between GSMI’s “Ginebra San Miguel” gin product and TDI’s “Ginebra Kapitan” gin product. The Court of Appeals likewise ruled that “TDI knew fully well that GSMI has been using the mark/word “GINEBRA” in its gin products and that GSMI’s “Ginebra San Miguel” had already obtained, over the years, a considerable number of loyal customers who associate the mark “GINEBRA” with GSMI.

On the other hand, upon GSMI’s Appeal, the Court of Appeals also set aside the RTC’s Decision and ruled that “GINEBRA” is not a generic term, there being no evidence to show that an ordinary person in the Philippines would know that “GINEBRA” is a Spanish word for “gin”. According to the Court of Appeals, because of GSMI’s use of the term in the Philippines since the 1800s, the term “GINEBRA” now exclusively refers to GSMI’s gin products and to GSMI as a manufacturer. The Court of Appeals added that “the mere use of the word ‘GINEBRA’ in “Ginebra Kapitan” is sufficient to incite an average person, even a gin-drinker, to associate it with GSMI’s gin product, and that TDI “has designed its bottle and label to somehow make a colorable similarity with the bottle and label of Ginebra S. Miguel”.

TDI filed separate Petitions for Review with the Supreme Court, docketed as G.R. Nos. 210224 and 219632, which were eventually consolidated by the Supreme Court. These cases are still pending with the Supreme Court.

G.R. No. 216104: This case pertains to TDI’s application for the registration of the trademark “GINEBRA KAPITAN” for Class 33 (“gin”) with the IPOPHL.

GSMI opposed TDI’s application, alleging that it would be damaged by the registration of “GINEBRA KAPITAN” because the term “GINEBRA” has acquired secondary meaning and is now exclusively associated with GSMI’s gin products. GSMI argued that the registration of “GINEBRA KAPITAN” for use in TDI’s gin products will confuse the public and cause damage to GSMI. TDI countered that “GINEBRA” is generic and incapable of exclusive appropriation, and that “GINEBRA KAPITAN” is not identical or confusingly similar to GSMI’s mark.

The IPOPHL ruled in favor of TDI and held that: (a) “GINEBRA” is generic for “gin”, (b) GSMI’s products are too well known for the purchasing public to be deceived by a new product like Ginebra Kapitan, and (c) TDI’s use of “GINEBRA” would supposedly stimulate market competition.

The Court of Appeals reversed and set aside the IPOPHL’s ruling and disapproved the registration of “GINEBRA KAPITAN”. The Court of Appeals ruled that “GINEBRA” could not be considered as a generic word in the Philippines considering that, to the Filipino gin-drinking public, it does not relate to a class of liquor/alcohol but rather has come to refer specifically and exclusively to the gin products of GSMI.

Management Discussion and Analysis

TDI filed a Petition for Review on Certiorari with the Supreme Court, which was subsequently consolidated with the case of “Tanduay Distillers, Inc. vs. Ginebra San Miguel Inc.”, docketed as G.R. No. 210224. This case is still pending with the Supreme Court.

l. Imported Industrial Fuel Oil

SL Harbor Bulk Terminal Corporation (SLHBTC) has an on-going case with the CTA against the Commissioner of Customs (the Commissioner). On January 16, 2016, a Warrant of Seizure and Detention was issued against the 44,000 metric tons of fuel imported by SLHBTC with approximate value of P= 751 million. The Commissioner alleged that SLHBTC discharged fuel directly from the vessel carrying SLHBTC’s imported fuel to another vessel via loop loading without paying duties and taxes and therefore, violating the Customs Modernization Tariff Act and other customs regulations. On January 20, 2017, the District Collector of Customs issued a decision forfeiting the fuel in favor of the government.

Subsequently, SLHBTC filed with the CTA a petition seeking the lifting and termination of the Warrant of Seizure and Detention and the reversal of the decision issued by the District Collector of Customs.

On April 19, 2017, SLHBTC filed with the CTA a Motion for Special Order to release the 44,000 metric tons of fuel, which was granted on January 28, 2018 subject to the posting of a surety bond amounting to P=123 million or one and one-half times of the assessed amount of P=82 million representing VAT. SLHBTC posted the surety bond and the 44,000 metric tons of fuel were released.

On September 18, 2018, a pre-trial conference was conducted.

By Order dated September 25, 2018, the case was transferred to the CTA’s First Division. SLHBTC’s presentation of evidence is set on May 23, 2019.

As of December 31, 2018, the case is still pending with the CTA.

m. Criminal Cases

SPPC

On September 29, 2015, SPPC filed a criminal complaint for estafa and for violation of Section 3(e) of RA No. 3019, otherwise known as the Anti-Graft and Corrupt Practices Act, before the DOJ, against certain officers of PSALM, in connection with the termination of SPPC’s IPPA Agreement, which was made by PSALM with manifest partially and evident bad faith. Further, it was alleged that PSALM fraudulently misrepresented its entitlement to draw on the Performance Bond posted by SPPC, resulting in actual injury to SPPC in the amount US$60 million. On June 13, 2017, the DOJ endorsed the complete records of the complaint to the Office of the Ombudsman for appropriate action where it is still pending to date.

Management Discussion and Analysis

On a related matter, on November 14, 2018, SPPC filed with the Office of the Ombudsman-Field Investigation Office, an administrative complaint against an executive officer of PSALM and several unidentified persons, in relation to acts that they have allegedly committed in violation of Section 3(e) of RA No. 3019, in the performance of their functions as public officers. The case is still pending with the Ombudsman-Field Investigation Office.

San Miguel Energy Corporation (SMEC)

On October 21, 2015, SMEC filed a criminal complaint for Plunder and violation of Section 3(e) and 3(f) of RA No. 3019, before the DOJ against a certain officer of PSALM, and certain officers of Team Philippines Energy Corp. (TPEC) and Team Sual Corporation (Team Sual), relating to the illegal grant of the so-called “excess capacity” of the Sual Power Plant in favor of TPEC which enabled it to receive a certain amount at the expense of the Government and SMEC.

In a Resolution dated July 29, 2016, the DOJ found probable cause to file Information against the respondents for plunder and violation of Section 3(e) and 3(f) of the RA 3019. The DOJ further resolved to forward the entire records of the case to the Office of the Ombudsman for their proper action. Respondents have respectively appealed said DOJ’s Resolution of July 29, 2016 with the Secretary of Justice.

On October 25, 2017, the DOJ issued a Resolution partially granting the Petition for Review by reversing the July 29, 2016 DOJ Resolution insofar as the conduct of the preliminary investigation. On November 17, 2017, SMEC filed a motion for partial reconsideration of said October 25, 2017 DOJ Resolution. Said motion is still pending to date.

n. Civil Case

SMEC

On June 17, 2016, SMEC filed with the RTC Pasig a civil complaint for consignation against PSALM arising from PSALM’s refusal to accept SMEC’s remittances corresponding to the proceeds of the sale on the WESM of electricity generated from capacity in excess of the 1000 MW of the Sual Power Plant (“Sale of the Excess Capacity”). With the filing of the complaint, SMEC also consigned with the RTC Pasig, the amount corresponding to the proceeds of the Sale of the Excess Capacity for the billing periodsDecember 26, 2015 to April 25, 2016.

On October 3, 2016, SMEC filed an Omnibus Motion To Admit Supplemental Complaint and To Allow Future Consignation without Tender (“Omnibus Option”). Together with this Omnibus Motion, SMEC consigned with the RTC Pasig an additional amount corresponding to the proceeds of the Sale of the Excess Capacity for the billing periods from April 26, 2016 to July 25, 2016.

On July 5, 2017, SMEC consigned with the RTC Pasig the amount representing additional proceeds of Sale of the Excess Capacity for the billing period July 26, 2016 to August 25, 2016. SMEC also filed a Motion to Admit Second Supplemental Complaint in relation to said consignation.

On May 22, 2018, the RTC Pasig issued an Order dismissing the complaint for consignation filed by SMEC on the ground that the court has no jurisdiction over the subject matter of the complaint.

Management Discussion and Analysis

On July 4, 2018, SMEC filed its Motion for Reconsideration to the May 22, 2018 order which dismissed the consignation case. The Motion for Reconsideration was heard on July 13, 2018 where the parties were given time to file their responsive pleadings. PSALM filed its Comment dated July 26, 2018 to the Motion for Reconsideration and SMEC filed its Reply to PSALM’s Comment on August 13, 2018. To date, the said motion is still pending resolution.

Further related thereto, on December 1, 2016, SMEC received a copy of a Complaint filed by TPEC and Team Sual Corporation with the Energy Regulatory Commission (ERC) against SMEC and PSALM in relation to the Excess Capacity issues, which issues have already been raised in the above mentioned cases. SMEC filed a Motion to Dismiss and Motion to Suspend Proceeding of the instant case. The complaint is still pending with the ERC to date.

o. TRO Issued to Meralco

On December 23, 2013, the Supreme Court issued a TRO, effective immediately, preventing Meralco from collecting from its customers the power rate increase pertaining to November 2013 billing. As a result, Meralco was constrained to fix its generation rate to its October 2013 level of P5.67/kWh. Claiming that since the power supplied by generators, including SMEC and SPPC is billed to Meralco’s customers on a pass-through basis, Meralco deferred a portion of its payment on the ground that it was not able to collect the full amount of its generation cost. Further, on December 27, 2013, the DOE, ERC, and Philippine Electricity Market Corporation (PEMC), acting as a tripartite committee, issued a joint resolution setting a reduced price cap on the WESM of P32/kWh. The price will be effective for 90 days until a new cap is decided upon.

On January 16, 2014, the Supreme Court granted Meralco’s plea to include other power supplier and generation companies, including SMEC and SPPC, as respondents to an inquiry. On February 18, 2014, the Supreme Court extended the period of the TRO until April 22, 2014 and enjoined the respondents (PEMC and the generators) from demanding and collecting the deferred amounts.

On March 3, 2014, the ERC issued an order declaring the November and December 2013 Luzon WESM prices void and imposed the application of regulated prices and ordered the PEMC, the operator of the WESM, to calculate and issue adjustment bills using recalculated prices. Accordingly, SMEC, SPPC and SPDC recognized a reduction in the sale of power while SMELC and MPPCL recognized a reduction in its power purchases. Consequently, a payable and receivable were also recognized for the portion of over-collection or over-payment, the settlement of which have been covered by a 24-month Special Payment Arrangement with PEMC which was already completed on May 25, 2016.

On June 26, 2014, SMEC, SPPC, SPDC and SPI filed with the Court of Appeals a Petition for Review under Rule 43 of the Revised Rules of Court assailing the ERC Orders dated March 3, 27 and May 9, 2014. On the other hand, MPPCL filed its Petition for Review with the Court of Appeals on December 12, 2014.

After consolidating the cases, the Court of Appeals, in its Decision dated November 7, 2017 (“Decision”), granted the Petition for Review filed by SMEC, SPPC, SPDC, SPI and MPPCL, declaring the aforesaid ERC Orders null and void and set aside the Orders of the ERC dated March 3, 2014, March 27, 2014, May 9, 2014 and October 15, 2014 and accordingly reinstated and declared as valid the WESM prices for Luzon for the supply months of November to December 2013.

Management Discussion and Analysis

Motions for Reconsideration of the November 7, 2017 Decision and Motions for Intervention and Motions to Admit Motions for Reconsideration were filed by various intervenors.

In a Resolution dated March 22, 2018, the Court of Appeals denied the aforesaid Motions. On June 2018, the intervenors filed their respective Motions for Reconsideration of the said Resolution of the Court of Appeals dated March 22, 2018. On June 27, 2018, MPPCL filed a Consolidated Comment to various Motions for Reconsideration while SMEC and SPPC filed Consolidated Opposition to said Motions for Reconsideration on July 27, 2018. To date, these motions for Reconsideration remain pending with the Court of Appeals.

Upon finality of the Decision, a claim for refund may be made by the relevant subsidiaries with PEMC for an amount up to P2,322 million, plus interest.

p. System Loss Charge

In 2008, Meralco filed a petition for dispute resolution against PEMC, National Transmission Corporation (TransCo), National Power Corporation (NPC) and PSALM seeking, among others, the refund of the transmission line loss components of the line rentals associated with PSALM/NPC bilateral transactions from the start of the WESM operations and Transition Supply Contract (TSC) implemented in 2006. In this case, the ERC concluded that Meralco was being charged twice considering that it already paid line rental to the WESM beginning June 2006. Hence, the ERC ordered PSALM/NPC to refund Meralco the 2.98% system loss charge embedded in the NPC Time-of-Use (“NPC TOU”) rate (Meralco vs. PSALM, NPC, TransCo).

On March 4, 2013, the ERC issued a subsequent order directing Meralco (i) to collect this system loss charge from the Successor Generating Companies (SGCs), which supplied the Meralco-NPC TSC and charged the NPC TOU rates, and (ii) to file a petition for dispute resolution against the SGCs. PSALM appealed the ERC’s March 4, 2013 order to the Court of Appeals.

In compliance with the ERC’s March 4, 2013 order, Meralco filed a petition for dispute resolution with the ERC against all SGCs which supplied portions of the TSC (including SMEC, SPPC and MPPCL). On September 20, 2013, SMEC, SPPC and MPPCL jointly with the other SGCs filed a Motion to Dismiss before the ERC, which to this day remains unresolved by the ERC.

Management Discussion and Analysis

q. Validity of Concession Agreement with Albay Electric Cooperative, Inc. (ALECO)

The dispute arose from a Complaint for Injunction with a prayer for the issuance of writ of preliminary prohibitory injunction, writ of preliminary mandatory injunction, temporary mandatory order and TRO filed on December 16, 2014 by a certain group of persons headed by an individual who claims to be the president of ALECO (the “Appellants”), against Albay Power and Energy Corp. (APEC) and its former general manager (the “Defendants”), enjoining the implementation of the 25-year Concession Agreement with ALECO dated October 29, 2013, with SMC Global that was subsequently assigned to APEC. The foregoing Complaint also questioned the validity of the Concession Agreement due to alleged oppressive and disadvantageous provisions therein. On September 29, 2015, the trial court upheld the validity of the Concession Agreement and dismissed the Complaint. As a result, the Appellants filed an appeal with the Court of Appeals. On November 23, 2016, the Court of Appeals issued a decision (“November 2016 Decision”) reversing the decision of the trial court on the ground that no pre-trial conference was conducted and ruled that the case should be remanded back to conduct the pre-trial conference and for the case to be resolved with dispatch in accordance with the Rules of Court. After motion for reconsideration from Defendants, the Court of Appeals sustained its November 2016 Decision on June 26, 2018.

To date, the Defendants have not received any order from the trial court on the schedule of the pre-trial conference.

r. Electric Power Industry Reform Act (EPIRA)

The EPIRA sets forth the following: (i) Section 49 created PSALM to take ownership and manage the orderly sale, disposition and privatization of all existing NPC generation assets, liabilities, IPP contracts, real estate and all other disposable assets; (ii) Section 31(c) requires the transfer of the management and control of at least 70% of the total energy output of power plants under contract with NPC to the IPP Administrators as one of the conditions for retail competition and open access; and (iii) Pursuant to Section 51(c), PSALM has the power to take title to and possession of the IPP contracts and to appoint, after a competitive, transparent and public bidding, qualified independent entities who shall act as the IPP Administrators in accordance with the EPIRA. In accordance with the bidding procedures and supplemented bid bulletins thereto to appoint an IPP Administrator relative to the capacity of the IPP contracts, PSALM has conducted a competitive, transparent and open public bidding process following which the Group was selected winning bidder of the IPPA Agreements.

The EPIRA requires generation and DU companies to undergo public offering within five years from the effective date, and provides cross ownership restrictions between transmission and generation companies. If the holding company of generation and DU companies is already listed with the PSE, the generation company or the DU need not comply with the requirement since such listing of the holding company is deemed already as compliance with the EPIRA.

A DU is allowed to source from an associated company engaged in generation up to 50% of its demand except for contracts entered into prior to the effective date of the EPIRA. Generation companies are restricted from owning more than 30% of the installed generating capacity of a grid and/or 25% of the national installed generating capacity. The Group is in compliance with the restrictions as of December 31, 2018.

Management Discussion and Analysis

- Commitments

The outstanding purchase commitments of the Group amounted to P127,366 million as of December 31, 2018.

Amount authorized but not yet disbursed for capital projects is approximately P197,559 million as of December 31, 2018.

- Foreign Exchange Rates

The foreign exchange rates used in translating the US Dollar accounts of foreign subsidiaries and associates and joint ventures to Philippine peso were closing rates of P52.58 and P49.93 in 2018 and 2017, respectively, for consolidated statements of financial position accounts; and average rates of P52.69, P50.40 and P47.48 in 2018, 2017 and 2016, respectively, for income and expense accounts.

- Certain accounts in prior years have been reclassified for consistency with the current period presentation. These reclassifications had no effect on the reported financial performance for any period.
- There are no unusual items as to nature and amount affecting assets, liabilities, equity, net income or cash flows, except those stated in Management’s Discussion and Analysis of Financial Position and Financial Performance.
- There were no material changes in estimates of amounts reported in prior interim periods of the current year or changes in estimates of amounts reported in prior financial years.
- There were no known trends, demands, commitments, events or uncertainties that will have a material impact on the Group’s liquidity.
- There were no known trends, events or uncertainties that have had or that are reasonably expected to have a favorable or unfavorable impact on net sales or revenues or income from continuing operation.
- There were no known events that will trigger direct or contingent financial obligation that is material to the Group, including any default or acceleration of an obligation and there were no changes in contingent liabilities and contingent assets since the last annual reporting date, except for “Contingencies” of Section VII above that remain outstanding as of December 31, 2018.
- The effects of seasonality or cyclicality on the interim operations of the Group’s businesses are not material.
- There were no material off-statements of financial position transactions, arrangements, obligations (including contingent obligations), and other relationship of the Group with unconsolidated entities or other persons created during the reporting period, except for the outstanding derivative transactions entered by the Group as of and for the period December 31, 2018.

### ANNEX “B”

## SAN MIGUEL CORPORATION AND SUBSIDIARIES

### CONSOLIDATED FINANCIAL STATEMENTS December 31, 2018, 2017 and 2016

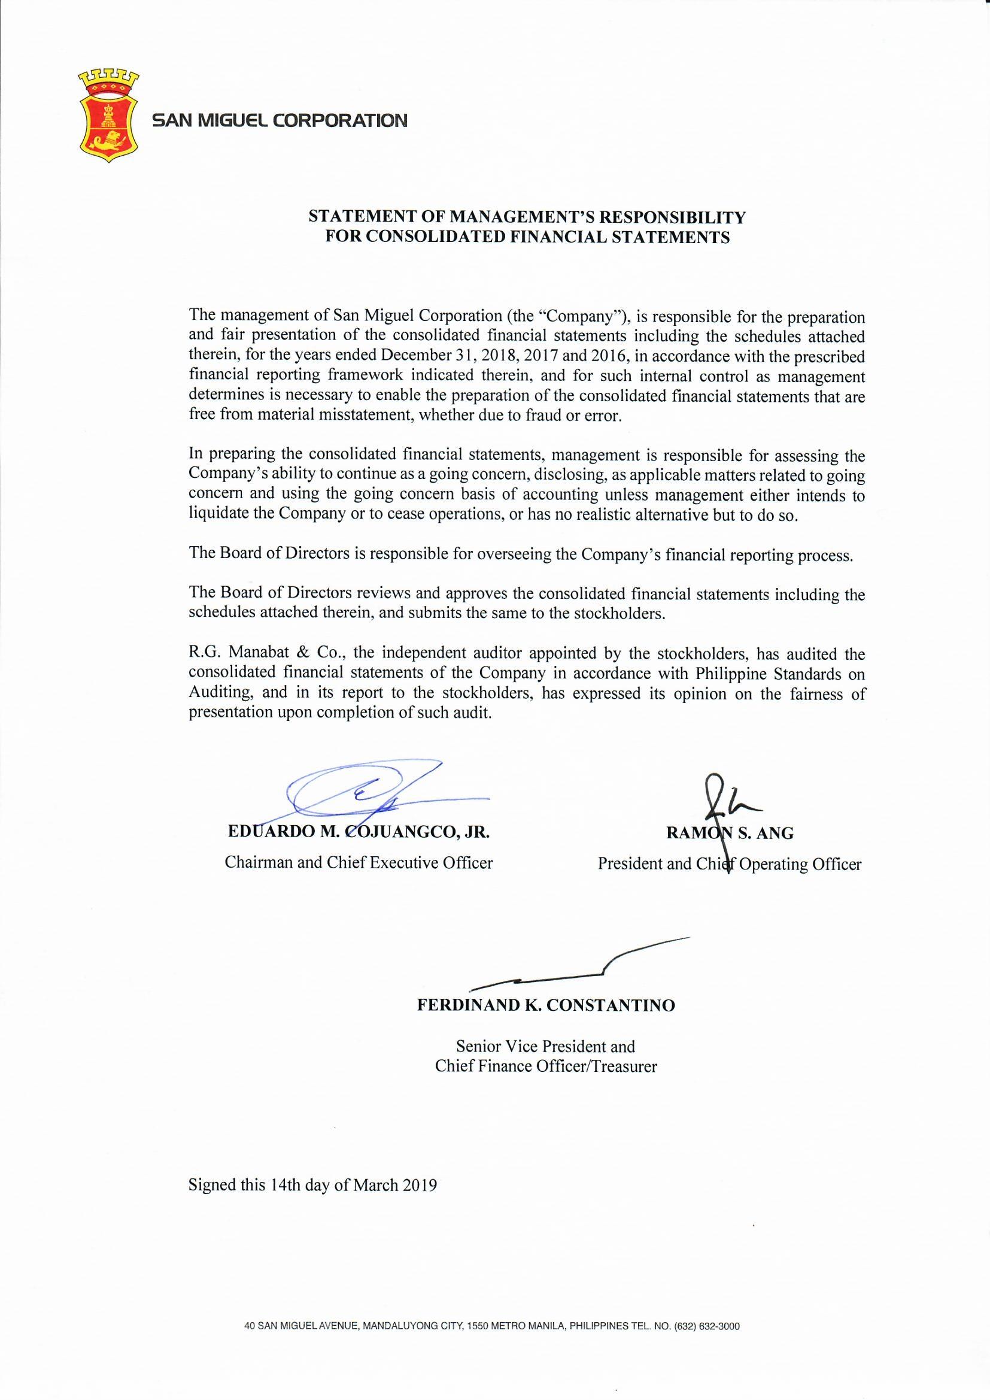
[picture p5: page 101]
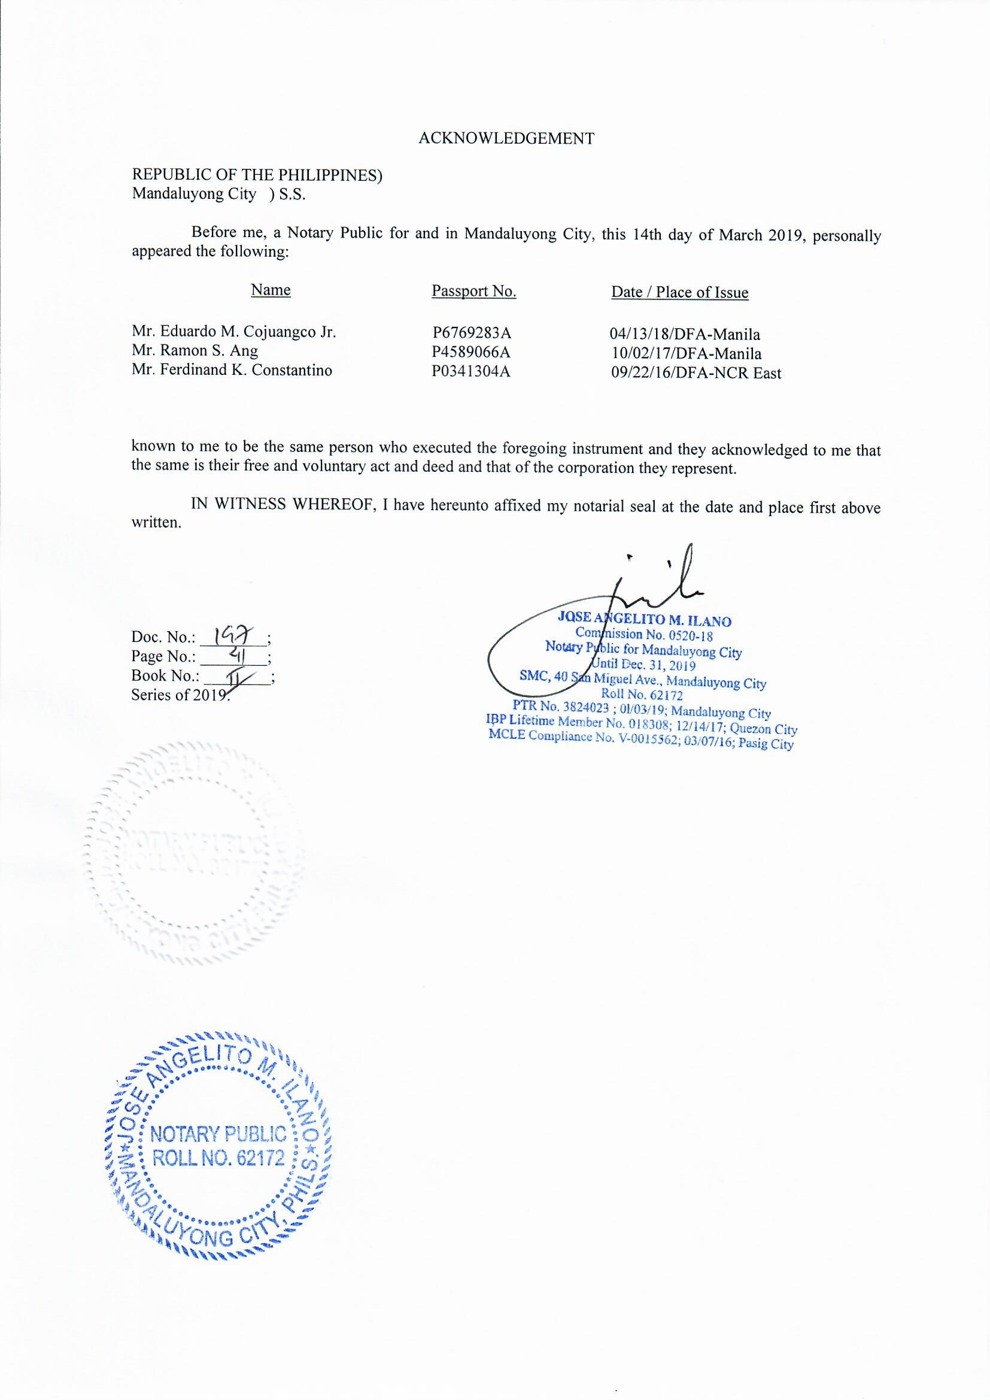
[picture p6: page 102]

R.G. Manabat & Co.
The KPMG Center, 9/F
6787 Ayala Avenue, Makati City Philippines 1226
Telephone | +63 (2) 885 7000
Fax | +63 (2) 894 1985
Internet | www.kpmg.com.ph
Email | ph-inquiry@kpmg.com.ph

PRC-BOA Registration No. 0003, valid until March 15, 2020
SEC Accreditation No. 0004-FR-5, Group A, valid until November 15, 2020 IC Accreditation No. F-2017/010-R, valid until August 26, 2020
BSP - Selected External Auditors, Category A, valid for 3-year audit period (2017 to 2019)

R.G. Manabat & Co., a Philippine partnership and a member firm of the KPMG network of independent member firms affiliated with KPMG International Cooperative ("KPMG International"), a Swiss entity.

REPORT OF INDEPENDENT AUDITORS

The Board of Directors and Stockholders San Miguel Corporation
No. 40 San Miguel Avenue
Mandaluyong City

Opinion

We have audited the consolidated financial statements of San Miguel Corporation and Subsidiaries (the Group), which comprise the consolidated statements of financial position as at December 31, 2018 and 2017, and the consolidated statements of income, consolidated statements of comprehensive income, consolidated statements of changes in equity and consolidated statements of cash flows for each of the three years in the period ended December 31, 2018, and notes, comprising significant accounting policies and other explanatory information.

In our opinion, the accompanying consolidated financial statements present fairly, in all material respects, the consolidated financial position of the Group as at December 31, 2018 and 2017, and its consolidated financial performance and its consolidated cash flows for each of the three years in the period ended December 31, 2018, in accordance with Philippine Financial Reporting Standards (PFRS).

Basis for Opinion

We conducted our audits in accordance with Philippine Standards on Auditing (PSA). Our responsibilities under those standards are further described in the Auditors’ Responsibilities for the Audit of the Consolidated Financial Statements section of our report. We are independent of the Group in accordance with the Code of Ethics for Professional Accountants in the Philippines (Code of Ethics) together with the ethical requirements that are relevant to our audit of the consolidated financial statements in the Philippines, and we have fulfilled our other ethical responsibilities in accordance with these requirements and the Code of Ethics. We believe that the audit evidence we have obtained is sufficient and appropriate to provide a basis for our opinion.

Key Audit Matters

Key audit matters are those matters that, in our professional judgment, were of most significance in our audit of the consolidated financial statements of the current period. These matters were addressed in the context of our audit of the consolidated financial statements as a whole, and in forming our opinion thereon, and we do not provide a separate opinion on these matters.

Revenue recognition (P1,024,943 million).
Refer to Notes 7, 25 and 33 of the consolidated financial statements.

The risk
Revenue is an important measure used to evaluate the performance of the Group and is generated from various sources. It is accounted for when control of the goods or services is transferred to the customer over time or at a point in time, at an amount that reflects the consideration to which the Group expects to be entitled in exchange for those goods or services. While revenue recognition and measurement are not complex for the Group, revenues may be inappropriately recognized in order to improve business results and achieve revenue growth in line with the objectives of the Group, thus increasing the risk of material misstatement.

Our response
We performed the following audit procedures, among others, on revenue recognition:
- We evaluated and assessed the revenue recognition policies in accordance with PFRS 15, Revenue from Contracts with Customers.
- We evaluated and assessed the design and operating effectiveness of the key controls over the revenue process.
- We involved our information technology specialists, as applicable, to assist in the audit of automated controls, including interface controls among different information technology applications for the evaluation of the design and operating effectiveness of controls over the recording of revenue transactions.
- We vouched, on a sampling basis, sales transactions to supporting documentation such as sales invoices and delivery documents to ascertain that the revenue recognition criteria is met.
- We tested, on a sampling basis, sales transactions for the last month of the financial year and also the first month of the following financial year to supporting documentation such as sales invoices and delivery documents to assess whether these transactions are recorded in the appropriate financial year.
- We tested, on a sampling basis, journal entries posted to revenue accounts to identify unusual or irregular items.
- We tested, on a sampling basis, credit notes issued after the financial year, to identify and assess any credit notes that relate to sales transactions recognized during the financial year.

Valuation of Goodwill (P130,852 million).
Refer to Notes 4, 5, 17 and 38 of the consolidated financial statements.

The risk
The Group has embarked on a diversification strategy and has expanded into new businesses through a number of acquisitions and investments resulting in the recognition of a significant amount of goodwill. The goodwill of the acquired businesses are reviewed annually to evaluate whether events or changes in circumstances affect the recoverability of the Group's investments.

The methods used in the annual impairment test of goodwill are complex and judgmental in nature, utilizing assumptions on future market and/or economic conditions. The assumptions used include future cash flow projections, growth rates, discount rates and sensitivity analyses, with a greater focus on more recent trends and current market interest rates, and less reliance on historical trends.

Our response
We performed the following audit procedures, among others, on the valuation of goodwill:
- We assessed management’s determination of the recoverable amounts based on fair value less costs to sell or a valuation using cash flow projections (value in use) covering a five-year period based on long range plans approved by management. Cash flows beyond the five-year period are extrapolated using a constant growth rate determined for each individual cash-generating unit.
- We tested the reasonableness of the discounted cash flow model by comparing the Group’s assumptions to externally derived data such as relevant industry information, projected economic growth, inflation and discount rates. Our own valuation specialist assisted us in evaluating the models used and assumptions applied.
- We performed our own sensitivity analyses on the key assumptions used in the models.

Valuation of Other Intangible Assets (P146,608 million).
Refer to Notes 4, 5 and 17 of the consolidated financial statements.

The risk
The methods used in the annual impairment test for other intangible assets with indefinite useful lives and tests of impairment indicators for other intangible assets with finite useful lives are complex and judgmental in nature, utilizing assumptions on future market and/or economic conditions. These assumptions include future cash flow projections, growth rates, discount rates and sensitivity analyses, with a greater focus on more recent trends and current market interest rates, and less reliance on historical trends.

Our response
We performed the following audit procedures, among others, on the valuation of other intangible assets:
- We evaluated and assessed management’s methodology in identifying any potential indicators of impairment.
- We assessed management’s determination of the recoverable amounts based on a valuation using cash flow projections (value in use) covering a five-year period based on long range plans approved by management. Cash flows beyond the five-year period are extrapolated using a constant growth rate determined for each individual cash-generating unit.
- We tested the reasonableness of the discounted cash flow model by comparing the Group’s assumptions to externally derived data such as relevant industry information, projected economic growth, inflation and discount rates. Our own valuation specialist assisted us in evaluating the models used and assumptions applied.
- We performed our own sensitivity analyses on the key assumptions used in the models.

Other Information

Management is responsible for the other information. The other information comprises the information included in the SEC Form 20-IS (Definitive Information Statement),
SEC Form 17-A and Annual Report for the year ended December 31, 2018, but does not include the consolidated financial statements and our auditors’ report thereon. The
SEC Form 20-IS, SEC Form 17-A and Annual Report for the year ended December 31, 2018 are expected to be made available to us after the date of this auditors’ report.

Our opinion on the consolidated financial statements does not cover the other information and we will not express any form of assurance conclusion thereon.

In connection with our audits of the consolidated financial statements, our responsibility is to read the other information identified above when it becomes available and, in doing so, consider whether the other information is materially inconsistent with the consolidated financial statements or our knowledge obtained in the audits or otherwise appears to be materially misstated.

Responsibilities of Management and Those Charged with Governance for the Consolidated Financial Statements

Management is responsible for the preparation and fair presentation of the consolidated financial statements in accordance with PFRS, and for such internal control as management determines is necessary to enable the preparation of consolidated financial statements that are free from material misstatement, whether due to fraud or error.

In preparing the consolidated financial statements, management is responsible for assessing the Group’s ability to continue as a going concern, disclosing, as applicable, matters related to going concern and using the going concern basis of accounting unless management either intends to liquidate the Group or to cease operations, or has no realistic alternative but to do so.

Those charged with governance are responsible for overseeing the Group’s financial reporting process.

Auditors’ Responsibilities for the Audit of the Consolidated Financial Statements

Our objectives are to obtain reasonable assurance about whether the consolidated financial statements as a whole are free from material misstatement, whether due to fraud or error, and to issue an auditors’ report that includes our opinion. Reasonable assurance is a high level of assurance, but is not a guarantee that an audit conducted in accordance with PSA will always detect a material misstatement when it exists. Misstatements can arise from fraud or error and are considered material if, individually or in the aggregate, they could reasonably be expected to influence the economic decisions of users taken on the basis of these consolidated financial statements.

As part of an audit in accordance with PSA, we exercise professional judgment and maintain professional skepticism throughout the audit. We also:

- Identify and assess the risks of material misstatement of the consolidated financial statements, whether due to fraud or error, design and perform audit procedures responsive to those risks, and obtain audit evidence that is sufficient and appropriate to provide a basis for our opinion. The risk of not detecting a material misstatement resulting from fraud is higher than for one resulting from error, as fraud may involve collusion, forgery, intentional omissions, misrepresentations, or the override of internal control.
- Obtain an understanding of internal control relevant to the audit in order to design audit procedures that are appropriate in the circumstances, but not for the purpose of expressing an opinion on the effectiveness of the Group’s internal control.
- Evaluate the appropriateness of accounting policies used and the reasonableness of accounting estimates and related disclosures made by management.
- Conclude on the appropriateness of management’s use of the going concern basis of accounting and, based on the audit evidence obtained, whether a material uncertainty exists related to events or conditions that may cast significant doubt on the Group’s ability to continue as a going concern. If we conclude that a material uncertainty exists, we are required to draw attention in our auditors’ report to the related disclosures in the consolidated financial statements or, if such disclosures are inadequate, to modify our opinion. Our conclusions are based on the audit evidence obtained up to the date of our auditors’ report. However, future events or conditions may cause the Group to cease to continue as a going concern.

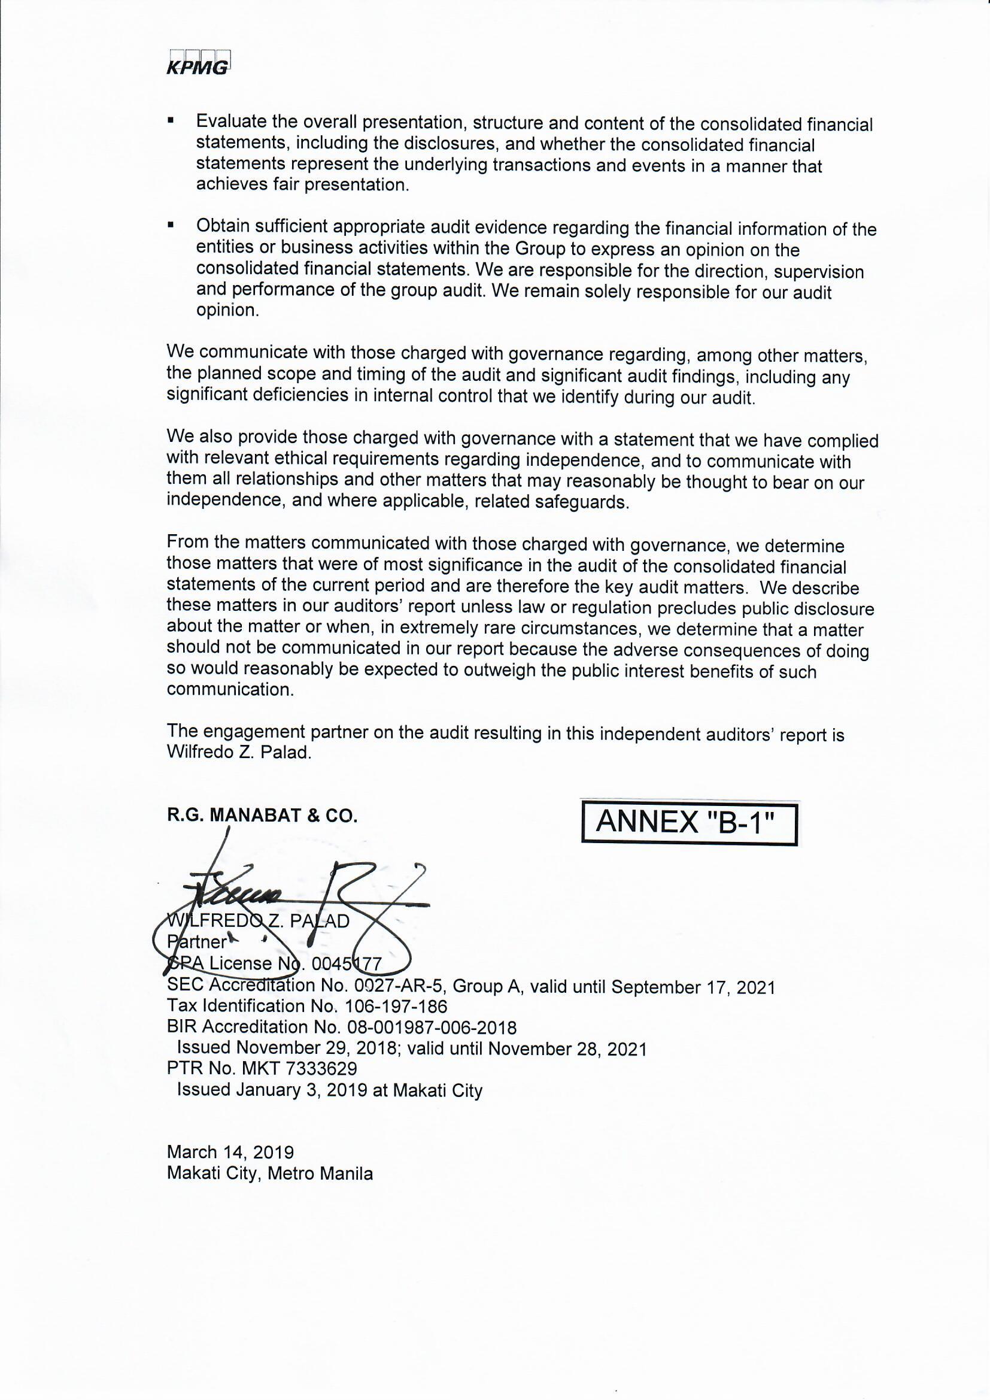
[picture p7: page 108]
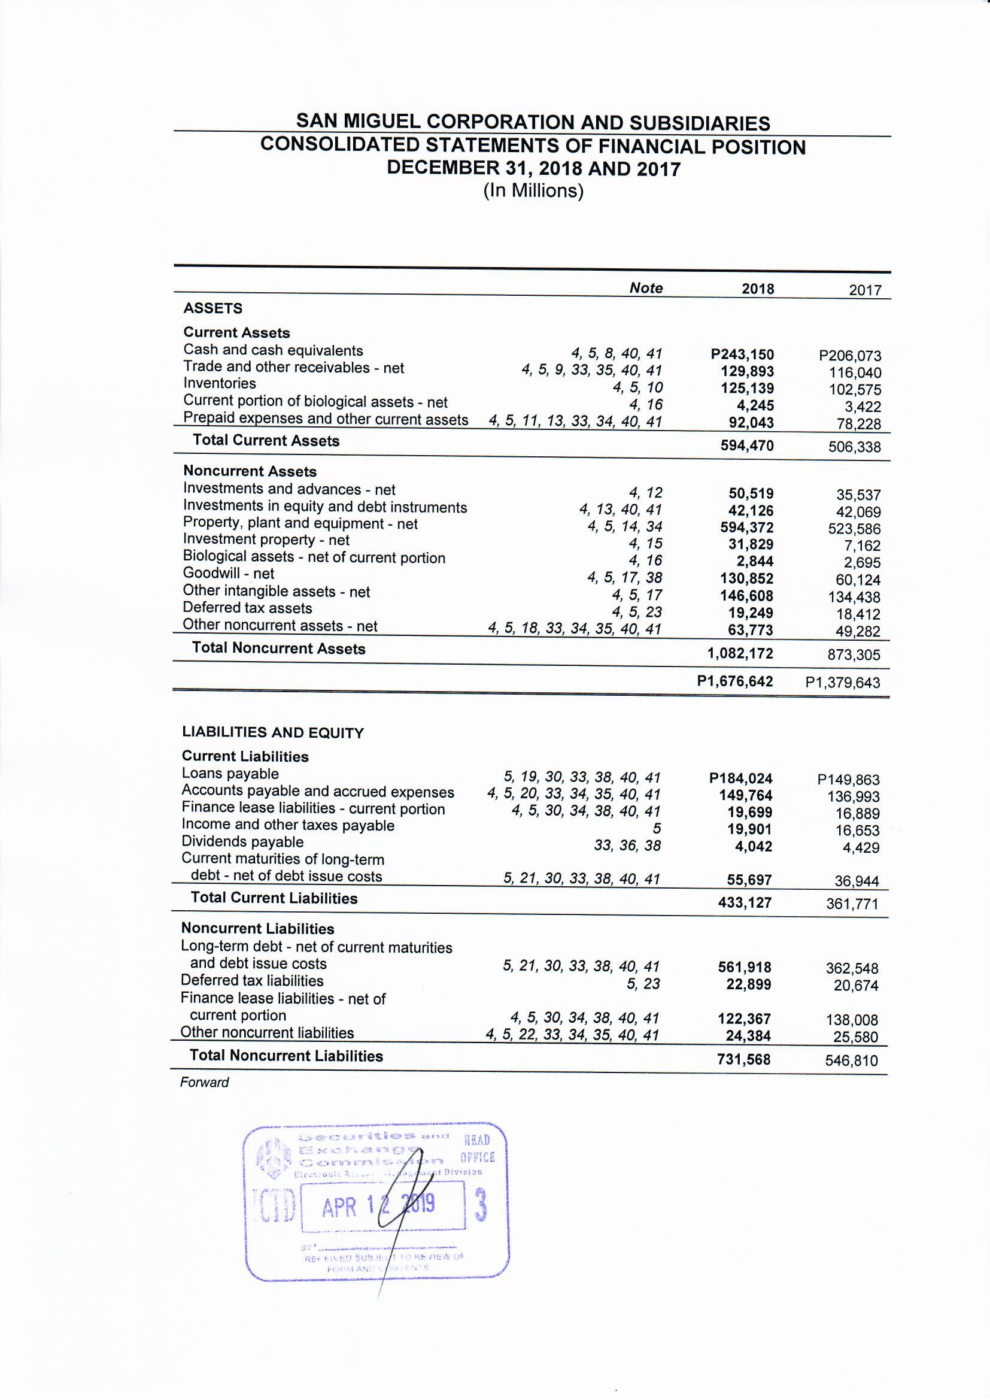
[picture p8: page 109]

| Note | 2018 | 2017
Equity | 24, 36, 37, 39

Equity Attributable to Equity
Holders of the Parent Company
Capital stock - common | | P16,443 | P16,435
Capital stock - preferred | | 10,187 | 10,187
Additional paid-in capital | | 177,938 | 177,750
Equity reserves | 5 | 21,513 | (4,799)
Retained earnings:
Appropriated | | 72,820 | 66,890
Unappropriated | | 148,345 | 143,335
Treasury stock | | (109,501) | (109,501)
| | 337,745 | 300,297
Non-controlling Interests | 2, 5 | 174,202 | 170,765
Total Equity | | 511,947 | 471,062
| | P1,676,642 | P1,379,643

See Notes to the Consolidated Financial Statements.

SAN MIGUEL CORPORATION AND SUBSIDIARIES CONSOLIDATED STATEMENTS OF INCOME FOR THE YEARS ENDED DECEMBER 31, 2018, 2017 AND 2016 (In Millions, Except Per Share Data)

| Note | 2018 | 2017 | 2016
SALES | 7, 25, 33 P1,024,943 | P826,086 | P685,314
COST OF SALES | 26, 34 | 825,748 | 644,221 | 514,021
GROSS PROFIT | | 199,195 | 181,865 | 171,293

SELLING AND ADMINISTRATIVE
EXPENSES | 27, 34 | (82,110) | (70,823) | (71,639)

INTEREST EXPENSE AND
OTHER FINANCING CHARGES | 19, 21, 30, 33, 34 | (45,496) | (35,714) | (34,803)
INTEREST INCOME | 31, 33, 35 | 7,192 | 4,525 | 3,693

GAIN ON SALE OF INVESTMENTS
AND PROPERTY AND EQUIPMENT | 5, 6, 12, 13, 14, 15, 18 | 252 | 879 | 154

EQUITY IN NET EARNINGS
(LOSSES) OF ASSOCIATES AND
JOINT VENTURES | 12 | (289) | 297 | 203
OTHER INCOME (CHARGES) - Net | 32, 40, 41 | (5,628) | 154 | (11,426)
INCOME BEFORE INCOME TAX | | 73,116 | 81,183 | 57,475
INCOME TAX EXPENSE | 23, 42 | 24,468 | 26,369 | 17,053

INCOME FROM CONTINUING
OPERATIONS | | 48,648 | 54,814 | 40,422

INCOME AFTER INCOME TAX FROM
DISCONTINUED OPERATIONS | 6 | - | - | 11,818
NET INCOME | | P48,648 | P54,814 | P52,240

Attributable to:
Equity holders of the Parent Company | | P23,077 | P28,225 | P29,289
Non-controlling interests | 5 | 25,571 | 26,589 | 22,951
| | P48,648 | P54,814 | P52,240

Earnings Per Common Share from
Continuing Operations
Attributable to Equity Holders of
the Parent Company | 37
Basic | | P6.61 | P8.78 | P4.49
Diluted | | 6.61 | 8.77 | 4.49

See Notes to the Consolidated Financial Statements.

SAN MIGUEL CORPORATION AND SUBSIDIARIES CONSOLIDATED STATEMENTS OF COMPREHENSIVE INCOME FOR THE YEARS ENDED DECEMBER 31, 2018, 2017 AND 2016 (In Millions)

| Note | 2018 | 2017 | 2016
NET INCOME | | P48,648 | P54,814 | P52,240

OTHER COMPREHENSIVE INCOME (LOSS)

Items that will not be reclassified to profit or loss
Equity reserve for retirement plan | 35 | (540) | (1,720) | 3,642
Income tax benefit (expense) | | 170 | 510 | (1,066)
Net gain on financial assets at fair value through
other comprehensive income | 13 | 46 | - | -
Income tax expense | | (6) | - | -
Share in other comprehensive income (loss)
of associates and joint ventures - net | 12 | 2 | 44 | (18)
| | (328) | (1,166) | 2,558

Items that may be reclassified to profit or loss
Gain (loss) on exchange differences on translation
of foreign operations | | 1,459 | 4,518 | (105)
Net loss on financial assets at fair value through
other comprehensive income | 13 | (9) | - | -
Net gain on available-for-sale financial assets | 13 | - | 91 | 502
Income tax expense | | - | (3) | (5)
Net loss on cash flow hedges | 41 | (280) | - | -
Income tax benefit | | 84 | - | -
| | 1,254 | 4,606 | 392
OTHER COMPREHENSIVE INCOME - Net of tax | | 926 | 3,440 | 2,950
TOTAL COMPREHENSIVE INCOME - Net of tax | | P49,574 | P58,254 | P55,190

Attributable to:
Equity holders of the Parent Company | | P22,948 | P30,308 | P30,388
Non-controlling interests | 5 | 26,626 | 27,946 | 24,802
| | P49,574 | P58,254 | P55,190

See Notes to the Consolidated Financial Statements.

SAN MIGUEL CORPORATION AND SUBSIDIARIES CONSOLIDATED STATEMENTS OF CHANGES IN EQUITY FOR THE YEARS ENDED DECEMBER 31, 2018, 2017 AND 2016 (In Millions)

Equity Attributable to Equity Holders of the Parent Company Equity Reserves
Additional Reserve for | Other | Retained Earnings | Non-
Capital Stock | Paid-in | Retirement | Hedging Fair Value Translation | Equity | Appro- | Unappro- | Treasury Stock | controlling | Total
| Note | Common | Preferred | Capital | Plan | Reserve | Reserve | Reserve | Reserve | priated | priated | Common | Preferred | Total | Interests | Equity

As of January 1, 2018, As
previously reported (Audited) | | P16,435 | P10,187 | P177,750 | (P2,664) | P - | P277 | P2,748 | (P5,160) | P66,890 | P143,335 | (P67,093) | (P42,408) | P300,297 | P170,765 | P471,062
Adjustments due to Philippine
Financial Reporting Standards 9
and 15 | 3 | - | - | - | - | - | 256 | - | - | - | (321) | - | - | (65) | 71 | 6
As of January 1, 2018, As adjusted | 16,435 | 10,187 | 177,750 | (2,664) | - | 533 | 2,748 | (5,160) | 66,890 | 143,014 | (67,093) | (42,408) | 300,232 | 170,836 | 471,068

Gain on exchange differences on
translation of foreign operations | | - | - | - | - | - | - | 501 | - | - | - | - | - | 501 | 958 | 1,459
Share in other comprehensive
income (loss) of associates
and joint ventures - net | 12 | - | - | - | 9 | - | (53) | 22 | - | - | - | - | - | (22) | 24 | 2
Net loss on cash flow hedges, net
of tax | 41 | - | - | - | - | (173) | - | - | - | - | - | - | - | (173) | (23) | (196)
Net gain (loss) on financial assets at
fair value through other
comprehensive income | 13 | - | - | - | - | - | 34 | - | - | - | - | - | - | 34 | (3) | 31
Equity reserve for retirement plan | 35 | - | - | - | (469) | - | - | - | - | - | - | - | - | (469) | 99 | (370)
Other comprehensive income (loss) | | - | - | - | (460) | (173) | (19) | 523 | - | - | - | - | - | (129) | 1,055 | 926
Net income | | - | - | - | - | - | - | - | - | - | 23,077 | - | - | 23,077 | 25,571 | 48,648
Total comprehensive income (loss) | | - | - | - | (460) | (173) | (19) | 523 | - | - | 23,077 | - | - | 22,948 | 26,626 | 49,574
Issuance of common shares | 24 | 8 | - | 188 | - | - | - | - | - | - | - | - | - | 196 | - | 196
Net addition (reduction) to non-
controlling interests and others | 5, 12 | - | - | - | 134 | - | - | (32) | 26,083 | (1,308) | 145 | - | - | 25,022 | (4,592) | 20,430
Appropriations - net | 24 | - | - | - | - | - | - | - | - | 7,238 | (7,238) | - | - | - | - | -
Cash dividends and distributions: | 36
Common | | - | - | - | - | - | - | - | - | - | (3,336) | - | - | (3,336) | (10,118) | (13,454)
Preferred | | - | - | - | - | - | - | - | - | - | (7,317) | - | - | (7,317) | (1,495) | (8,812)
Undated subordinated capital
securities | | - | - | - | - | - | - | - | - | - | - | - | - | - | (6,177) | (6,177)
Senior perpetual capital
securities | | - | - | - | - | - | - | - | - | - | - | - | - | - | (878) | (878)
As of December 31, 2018 | 24 | P16,443 | P10,187 | P177,938 | (P2,990) | (P173) | P514 | P3,239 | P20,923 | P72,820 | P148,345 | (P67,093) | (P42,408) | P337,745 | P174,202 | P511,947

Forward

Equity Attributable to Equity Holders of the Parent Company Equity Reserves
Additional | Reserve for | Other | Retained Earnings | Non-
Capital Stock | Paid-in | Retirement | Fair Value | Translation | Equity | Appro- | Unappro- | Treasury Stock | controlling | Total
| Note | Common | Preferred | Capital | Plan | Reserve | Reserve | Reserve | priated | priated | Common | Preferred | Total | Interests | Equity
As of January 1, 2017 | | P16,425 | P10,187 | P177,641 | (P1,756) | P214 | (P180) | (P5,978) | P56,906 | P135,984 | (P67,093) | (P42,408) | P279,942 | P156,839 | P436,781

Gain on exchange differences on
translation of foreign operations | | - | - | - | - | - | 2,872 | - | - | - | - | - | 2,872 | 1,646 | 4,518
Share in other comprehensive
income (loss) of associates and
joint ventures - net | 12 | - | - | - | (3) | (25) | 56 | - | - | - | - | - | 28 | 16 | 44
Net gain on available-for-sale
financial assets | 13 | - | - | - | - | 88 | - | - | - | - | - | - | 88 | - | 88
Equity reserve for retirement plan | 35 | - | - | - | (905) | - | - | - | - | - | - | - | (905) | (305) | (1,210)
Other comprehensive income (loss) | | - | - | - | (908) | 63 | 2,928 | - | - | - | - | - | 2,083 | 1,357 | 3,440
Net income | | - | - | - | - | - | - | - | - | 28,225 | - | - | 28,225 | 26,589 | 54,814
Total comprehensive income (loss) | | - | - | - | (908) | 63 | 2,928 | - | - | 28,225 | - | - | 30,308 | 27,946 | 58,254
Issuance of common shares | 24 | 10 | - | 109 | - | - | - | - | - | - | - | - | 119 | - | 119
Net addition (reduction) to non-
controlling interests and others | 5, 12 | - | - | - | - | - | - | 818 | - | (239) | - | - | 579 | 2,789 | 3,368
Appropriations - net | 24 | - | - | - | - | - | - | - | 9,984 | (9,984) | - | - | - | - | -
Cash dividends and distributions: | 36
Common | | - | - | - | - | - | - | - | - | (3,334) | - | - | (3,334) | (8,216) | (11,550)
Preferred | | - | - | - | - | - | - | - | - | (7,317) | - | - | (7,317) | (1,495) | (8,812)
Undated subordinated capital
securities | | - | - | - | - | - | - | - | - | - | - | - | - | (7,098) | (7,098)
As of December 31, 2017 | 24 | P16,435 | P10,187 | P177,750 | (P2,664) | P277 | P2,748 | (P5,160) | P66,890 | P143,335 | (P67,093) | (P42,408) | P300,297 | P170,765 | P471,062

Forward

Equity Attributable to Equity Holders of the Parent Company Equity Reserves
Additional | Reserve for | Other | Retained Earnings | Non-
Capital Stock | Paid-in | Retirement | Fair Value | Translation | Equity | Appro- | Unappro- | Treasury Stock | controlling | Total
| Note | Common | Preferred | Capital | Plan | Reserve | Reserve | Reserve | priated | priated | Common | Preferred | Total | Interests | Equity
As of January 1, 2016 | | P16,417 | P10,187 | P177,871 | (P3,546) | (P222) | P947 | (P798) | P48,927 | P127,855 | (P67,093) | (P72,408) | P238,137 | P146,740 | P384,877

Gain (loss) on exchange differences
on translation of foreign operations | | - | - | - | - | - | (1,157) | - | - | - | - | - | (1,157) | 1,052 | (105)
Share in other comprehensive
income (loss) of associates and
joint ventures - net | 12 | - | - | - | 22 | (74) | 30 | - | - | - | - | - | (22) | 4 | (18)
Net gain (loss) on available-for-sale
financial assets | 13 | - | - | - | - | 510 | - | - | - | - | - | - | 510 | (13) | 497
Equity reserve for retirement plan | 35 | - | - | - | 1,768 | - | - | - | - | - | - | - | 1,768 | 808 | 2,576
Other comprehensive income (loss) | | - | - | - | 1,790 | 436 | (1,127) | - | - | - | - | - | 1,099 | 1,851 | 2,950
Net income | | - | - | - | - | - | - | - | - | 29,289 | - | - | 29,289 | 22,951 | 52,240
Total comprehensive income (loss) | | - | - | - | 1,790 | 436 | (1,127) | - | - | 29,289 | - | - | 30,388 | 24,802 | 55,190
Issuance of common shares | 24 | 8 | - | 63 | - | - | - | - | - | - | - | - | 71 | - | 71
Reissuance of treasury shares | | - | - | (293) | - | - | - | - | - | - | - | 30,000 | 29,707 | - | 29,707
Net addition (reduction) to non-
controlling interests and others | 5, 12 | - | - | - | - | - | - | (5,180) | - | (3,010) | - | - | (8,190) | 1,460 | (6,730)
Appropriations - net | 24 | - | - | - | - | - | - | - | 7,979 | (7,979) | - | - | - | - | -
Cash dividends and distributions: | 36
Common | | - | - | - | - | - | - | - | - | (3,332) | - | - | (3,332) | (7,956) | (11,288)
Preferred | | - | - | - | - | - | - | - | - | (6,839) | - | - | (6,839) | (1,495) | (8,334)
Undated subordinated capital
securities | | - | - | - | - | - | - | - | - | - | - | - | - | (6,712) | (6,712)
As of December 31, 2016 | 24 | P16,425 | P10,187 | P177,641 | (P1,756) | P214 | (P180) | (P5,978) | P56,906 | P135,984 | (P67,093) | (P42,408) | P279,942 | P156,839 | P436,781

See Notes to the Consolidated Financial Statements.

SAN MIGUEL CORPORATION AND SUBSIDIARIES CONSOLIDATED STATEMENTS OF CASH FLOWS FOR THE YEARS ENDED DECEMBER 31, 2018, 2017 AND 2016 (In Millions)

Note | 2018 | 2017 | 2016

CASH FLOWS FROM OPERATING ACTIVITIES
Income before income tax from continuing operations | P73,116 | P81,183 | P57,475
Income before income tax from discontinued
operations | 6 | - | - | 12,765
Income before income tax | 73,116 | 81,183 | 70,240
Adjustments for:
Depreciation, amortization and others - net | 6, 28 | 50,670 | 33,991 | 50,549
Interest expense and other financing charges | 6, 30 | 45,496 | 35,714 | 34,809
Equity in net losses (earnings) of associates and
joint ventures | 6, 12 | 289 | (297) | (203)
Interest income | 6, 31 | (7,192) | (4,525) | (3,707)
Gain on sale of investments and
property and equipment | 5, 6, 12, 13, 14, 15, 18 | (252) | (879) | (154)
Gain from disposal of discontinued
operations | 6 | - | - | (13,572)
Operating income before working capital
changes | 162,127 | 145,187 | 137,962
Changes in noncash current assets,
certain current liabilities and others | 38 | (42,625) | (19,541) | (14,661)
Cash generated from operations | 119,502 | 125,646 | 123,301
Interest and other financing charges paid | (38,299) | (26,319) | (24,647)
Income taxes paid | (22,979) | (20,099) | (19,461)
Net cash flows provided by operating activities | 58,224 | 79,228 | 79,193

CASH FLOWS FROM INVESTING ACTIVITIES
Acquisitions of subsidiaries, net of cash and
cash equivalents acquired | 38 | (98,057) | (2,568) | (1,905)
Additions to property, plant and equipment | 14 | (47,323) | (38,693) | (40,649)
Increase in other noncurrent assets and others | (38,946) | (30,023) | (15,515)
Additions to investments and advances and
investment in debt instruments | 12, 13 | (20,021) | (2,908) | (8,038)
Interest received | 6,537 | 4,263 | 3,480
Dividends received | 12, 13 | 1,906 | 1,355 | 1,081
Proceeds from sale of investments
and property and equipment | 5, 12, 13, 14, 15, 18 | 1,139 | 1,930 | 1,114
Proceeds from disposal of
discontinued operations, net of
cash and cash equivalents
disposed of | 6 | - | 13,020 | 37,175
Net cash flows used in investing activities | (194,765) | (53,624) | (23,257)

Forward

| Note | 2018 | 2017 | 2016

CASH FLOWS FROM FINANCING ACTIVITIES
Proceeds from:
Short-term borrowings | | P996,769 | P848,320 | P667,802
Long-term borrowings | | 242,405 | 203,715 | 98,130
Payments of:
Short-term borrowings | | (964,464) | (888,378) | (625,642)
Long-term borrowings | | (65,591) | (135,975) | (150,455)
Proceeds from follow-on offering of common shares of
a subsidiary | 5 | 35,083 | - | -
Net proceeds from issuance of senior perpetual capital
securities of a subsidiary | 5 | 24,881 | - | -
Proceeds from issuance of capital stock | 24 | 196 | 119 | 71
Redemption of undated subordinated capital securities
of a subsidiary | 5 | (39,769) | - | -
Cash dividends and distributions paid to non-controlling
shareholders | | (19,104) | (16,728) | (16,060)
Cash dividends paid | 36 | (10,602) | (10,295) | (8,278)
Payments of finance lease liabilities | | (25,698) | (24,924) | (23,907)
Increase (decrease) in non-controlling interests and others | | (91) | 1,760 | (5,515)
Proceeds from reissuance of treasury shares | 24 | - | - | 29,707
Net cash flows provided by (used in) financing
activities | | 174,015 | (22,386) | (34,147)

EFFECT OF EXCHANGE RATE CHANGES ON
CASH AND CASH EQUIVALENTS | | (397) | (298) | 606

NET INCREASE IN CASH
AND CASH EQUIVALENTS | | 37,077 | 2,920 | 22,395

CASH AND CASH EQUIVALENTS
AT BEGINNING OF YEAR | 8 | 206,073 | 203,153 | 180,758
CASH AND CASH EQUIVALENTS
AT END OF YEAR | 8 | P243,150 | P206,073 | P203,153

See Notes to the Consolidated Financial Statements.

SAN MIGUEL CORPORATION AND SUBSIDIARIES NOTES TO THE CONSOLIDATED FINANCIAL STATEMENTS (Amounts in Millions, Except Per Share Data and Number of Shares)

### 1. Reporting Entity

San Miguel Corporation (SMC or the Parent Company), a subsidiary of Top Frontier Investment Holdings, Inc. (Top Frontier or the Ultimate Parent Company), was incorporated on August 21, 1913. On March 16, 2012, the Philippine Securities and Exchange Commission (SEC) approved the amendment of the Articles of Incorporation and By-Laws of the Parent Company to extend the corporate term for another fifty (50) years from August 21, 2013, as approved on the March 14, 2011 and June 7, 2011 meetings of the Parent Company’s Board of Directors (BOD) and stockholders, respectively.

The Parent Company is a public company under Section 17.2 of the Securities Regulation Code. Its common and preferred shares are listed on The Philippine Stock Exchange, Inc. (PSE).

The accompanying consolidated financial statements comprise the financial statements of the Parent Company and its Subsidiaries (collectively referred to as the Group) and the Group’s interests in associates and joint ventures.

The Group is engaged in various businesses, including food and beverage, packaging, energy, fuel and oil, infrastructure and real estate property management and development.

The registered office address of the Parent Company is No. 40 San Miguel Avenue, Mandaluyong City, Philippines.
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
