cyc292cycjin-oss/SGP-ESE5004-Stage2/research/04_model_assembly/gate4/EXISTING_ASSET_COST_TREATMENT.csv

Technology | ObservedSourceCapacityMW | OriginalEfficiencyAvailableRows | OriginalEfficiencyRange | OriginalEfficiencySource | NewCAPEXChargedToExisting | ExistingFixedOM | ExistingVariableOM | ExistingEfficiency | NewBuild2050ContextTechnology | NewBuild2050FOM_EUR_MW_year | NewBuild2050AnnualCapitalPlusFOM | NewBuild2050VOM | ContextSource | ContextMeaning | Implementation | ApprovalStatus
Biogas | 2162.39 | 0 |  | /home/jin/research/SGP_ESE5004_Stage2/pypsa-asean/resources/baseline-aims-3H-tutorial/powerplants.csv SHA256=d473f3e770ff76d3b496a7c2ae51b061670237d2aec1c80c679b13d9e28a6584 | 0 | PENDING_SOURCE_QUALIFICATION; never blanket zero | PENDING_SOURCE_QUALIFICATION; charged per electric output | Source existing equipment only; no automatic2050 upgrade | biogas | 97021.48676253564 | 216714.92486796947 | 0.0517564893217866 | /home/jin/research/SGP_ESE5004_Stage2/pypsa-asean/resources/baseline-aims-3H-tutorial/costs_2050_sec.csv SHA256=bbcc639010a6775255730278eaa6e21ba56867d0610d3a011adc3eb60d0065f5 | Illustrative frozen2050 NEW technology row only; not an accepted historical equipment cost mapping | fixed capacity; capital_cost=0; independent audited annual FOM objective term; VOM on dispatch; input-basis conversion for thermal Links | PENDING
CCGT | 93027 | 0 |  | /home/jin/research/SGP_ESE5004_Stage2/pypsa-asean/resources/baseline-aims-3H-tutorial/powerplants.csv SHA256=d473f3e770ff76d3b496a7c2ae51b061670237d2aec1c80c679b13d9e28a6584 | 0 | PENDING_SOURCE_QUALIFICATION; never blanket zero | PENDING_SOURCE_QUALIFICATION; charged per electric output | Source existing equipment only; no automatic2050 upgrade | CCGT | 25615.076071121533 | 94717.93245304767 | 1.9299029916598416 | /home/jin/research/SGP_ESE5004_Stage2/pypsa-asean/resources/baseline-aims-3H-tutorial/costs_2050_sec.csv SHA256=bbcc639010a6775255730278eaa6e21ba56867d0610d3a011adc3eb60d0065f5 | Illustrative frozen2050 NEW technology row only; not an accepted historical equipment cost mapping | fixed capacity; capital_cost=0; independent audited annual FOM objective term; VOM on dispatch; input-basis conversion for thermal Links | PENDING
Geothermal | 1149 | 0 |  | /home/jin/research/SGP_ESE5004_Stage2/pypsa-asean/resources/baseline-aims-3H-tutorial/powerplants.csv SHA256=d473f3e770ff76d3b496a7c2ae51b061670237d2aec1c80c679b13d9e28a6584 | 0 | PENDING_SOURCE_QUALIFICATION; never blanket zero | PENDING_SOURCE_QUALIFICATION; charged per electric output | Source existing equipment only; no automatic2050 upgrade | geothermal | 17105.958335166775 | 217095.60820809155 | 0.2631685897717965 | /home/jin/research/SGP_ESE5004_Stage2/pypsa-asean/resources/baseline-aims-3H-tutorial/costs_2050_sec.csv SHA256=bbcc639010a6775255730278eaa6e21ba56867d0610d3a011adc3eb60d0065f5 | Illustrative frozen2050 NEW technology row only; not an accepted historical equipment cost mapping | fixed capacity; capital_cost=0; independent audited annual FOM objective term; VOM on dispatch; input-basis conversion for thermal Links | PENDING
Hard Coal | 108582 | 0 |  | /home/jin/research/SGP_ESE5004_Stage2/pypsa-asean/resources/baseline-aims-3H-tutorial/powerplants.csv SHA256=d473f3e770ff76d3b496a7c2ae51b061670237d2aec1c80c679b13d9e28a6584 | 0 | PENDING_SOURCE_QUALIFICATION; never blanket zero | PENDING_SOURCE_QUALIFICATION; charged per electric output | Source existing equipment only; no automatic2050 upgrade | coal | 59212.93269865422 | 253126.01696310175 | 6.579214744294914 | /home/jin/research/SGP_ESE5004_Stage2/pypsa-asean/resources/baseline-aims-3H-tutorial/costs_2050_sec.csv SHA256=bbcc639010a6775255730278eaa6e21ba56867d0610d3a011adc3eb60d0065f5 | Illustrative frozen2050 NEW technology row only; not an accepted historical equipment cost mapping | fixed capacity; capital_cost=0; independent audited annual FOM objective term; VOM on dispatch; input-basis conversion for thermal Links | PENDING
Hydro | 48636 | 0 |  | /home/jin/research/SGP_ESE5004_Stage2/pypsa-asean/resources/baseline-aims-3H-tutorial/powerplants.csv SHA256=d473f3e770ff76d3b496a7c2ae51b061670237d2aec1c80c679b13d9e28a6584 | 0 | PENDING_SOURCE_QUALIFICATION; never blanket zero | PENDING_SOURCE_QUALIFICATION; charged per electric output | Source existing equipment only; no automatic2050 upgrade | hydro | 32720.62799496004 | 125242.24560559313 | 0.526337179543593 | /home/jin/research/SGP_ESE5004_Stage2/pypsa-asean/resources/baseline-aims-3H-tutorial/costs_2050_sec.csv SHA256=bbcc639010a6775255730278eaa6e21ba56867d0610d3a011adc3eb60d0065f5 | Illustrative frozen2050 NEW technology row only; not an accepted historical equipment cost mapping | fixed capacity; capital_cost=0; independent audited annual FOM objective term; VOM on dispatch; input-basis conversion for thermal Links | PENDING
Lignite | 6501 | 0 |  | /home/jin/research/SGP_ESE5004_Stage2/pypsa-asean/resources/baseline-aims-3H-tutorial/powerplants.csv SHA256=d473f3e770ff76d3b496a7c2ae51b061670237d2aec1c80c679b13d9e28a6584 | 0 | PENDING_SOURCE_QUALIFICATION; never blanket zero | PENDING_SOURCE_QUALIFICATION; charged per electric output | Source existing equipment only; no automatic2050 upgrade | lignite | 50135.83399 | 337208.02744802914 | 3.2612 | /home/jin/research/SGP_ESE5004_Stage2/pypsa-asean/resources/baseline-aims-3H-tutorial/costs_2050_sec.csv SHA256=bbcc639010a6775255730278eaa6e21ba56867d0610d3a011adc3eb60d0065f5 | Illustrative frozen2050 NEW technology row only; not an accepted historical equipment cost mapping | fixed capacity; capital_cost=0; independent audited annual FOM objective term; VOM on dispatch; input-basis conversion for thermal Links | PENDING
Nuclear | 0 | 0 |  | /home/jin/research/SGP_ESE5004_Stage2/pypsa-asean/resources/baseline-aims-3H-tutorial/powerplants.csv SHA256=d473f3e770ff76d3b496a7c2ae51b061670237d2aec1c80c679b13d9e28a6584 | 0 | PENDING_SOURCE_QUALIFICATION; never blanket zero | PENDING_SOURCE_QUALIFICATION; charged per electric output | Source existing equipment only; no automatic2050 upgrade | nuclear | 116145.07095261956 | 654653.6157847332 | 2.105348718174372 | /home/jin/research/SGP_ESE5004_Stage2/pypsa-asean/resources/baseline-aims-3H-tutorial/costs_2050_sec.csv SHA256=bbcc639010a6775255730278eaa6e21ba56867d0610d3a011adc3eb60d0065f5 | Illustrative frozen2050 NEW technology row only; not an accepted historical equipment cost mapping | fixed capacity; capital_cost=0; independent audited annual FOM objective term; VOM on dispatch; input-basis conversion for thermal Links | PENDING
Oil | 6933.2 | 0 |  | /home/jin/research/SGP_ESE5004_Stage2/pypsa-asean/resources/baseline-aims-3H-tutorial/powerplants.csv SHA256=d473f3e770ff76d3b496a7c2ae51b061670237d2aec1c80c679b13d9e28a6584 | 0 | PENDING_SOURCE_QUALIFICATION; never blanket zero | PENDING_SOURCE_QUALIFICATION; charged per electric output | Source existing equipment only; no automatic2050 upgrade | oil | 7982.780556411162 | 76483.43339688261 | 6.403769017780382 | /home/jin/research/SGP_ESE5004_Stage2/pypsa-asean/resources/baseline-aims-3H-tutorial/costs_2050_sec.csv SHA256=bbcc639010a6775255730278eaa6e21ba56867d0610d3a011adc3eb60d0065f5 | Illustrative frozen2050 NEW technology row only; not an accepted historical equipment cost mapping | fixed capacity; capital_cost=0; independent audited annual FOM objective term; VOM on dispatch; input-basis conversion for thermal Links | PENDING
Solar | 24213.700000000033 | 0 |  | /home/jin/research/SGP_ESE5004_Stage2/pypsa-asean/resources/baseline-aims-3H-tutorial/powerplants.csv SHA256=d473f3e770ff76d3b496a7c2ae51b061670237d2aec1c80c679b13d9e28a6584 | 0 | PENDING_SOURCE_QUALIFICATION; never blanket zero | PENDING_SOURCE_QUALIFICATION; charged per electric output | Source existing equipment only; no automatic2050 upgrade | solar-utility | 7719.611966639366 | 71545.77136145244 | 0 | /home/jin/research/SGP_ESE5004_Stage2/pypsa-asean/resources/baseline-aims-3H-tutorial/costs_2050_sec.csv SHA256=bbcc639010a6775255730278eaa6e21ba56867d0610d3a011adc3eb60d0065f5 | Illustrative frozen2050 NEW technology row only; not an accepted historical equipment cost mapping | fixed capacity; capital_cost=0; independent audited annual FOM objective term; VOM on dispatch; input-basis conversion for thermal Links | PENDING
Solid Biomass | 3632.73 | 0 |  | /home/jin/research/SGP_ESE5004_Stage2/pypsa-asean/resources/baseline-aims-3H-tutorial/powerplants.csv SHA256=d473f3e770ff76d3b496a7c2ae51b061670237d2aec1c80c679b13d9e28a6584 | 0 | PENDING_SOURCE_QUALIFICATION; never blanket zero | PENDING_SOURCE_QUALIFICATION; charged per electric output | Source existing equipment only; no automatic2050 upgrade | biomass | 119127.64830336659 | 265400.0358048035 | 5.020379464213306 | /home/jin/research/SGP_ESE5004_Stage2/pypsa-asean/resources/baseline-aims-3H-tutorial/costs_2050_sec.csv SHA256=bbcc639010a6775255730278eaa6e21ba56867d0610d3a011adc3eb60d0065f5 | Illustrative frozen2050 NEW technology row only; not an accepted historical equipment cost mapping | fixed capacity; capital_cost=0; independent audited annual FOM objective term; VOM on dispatch; input-basis conversion for thermal Links | PENDING
Waste | 475.5 | 0 |  | /home/jin/research/SGP_ESE5004_Stage2/pypsa-asean/resources/baseline-aims-3H-tutorial/powerplants.csv SHA256=d473f3e770ff76d3b496a7c2ae51b061670237d2aec1c80c679b13d9e28a6584 | 0 | PENDING_SOURCE_QUALIFICATION; never blanket zero | PENDING_SOURCE_QUALIFICATION; charged per electric output | Source existing equipment only; no automatic2050 upgrade | waste CHP | 171429.44514959998 | 813330.6257203072 | 27.0247 | /home/jin/research/SGP_ESE5004_Stage2/pypsa-asean/resources/baseline-aims-3H-tutorial/costs_2050_sec.csv SHA256=bbcc639010a6775255730278eaa6e21ba56867d0610d3a011adc3eb60d0065f5 | Illustrative frozen2050 NEW technology row only; not an accepted historical equipment cost mapping | fixed capacity; capital_cost=0; independent audited annual FOM objective term; VOM on dispatch; input-basis conversion for thermal Links | PENDING
Wind | 10582.100000000002 | 0 |  | /home/jin/research/SGP_ESE5004_Stage2/pypsa-asean/resources/baseline-aims-3H-tutorial/powerplants.csv SHA256=d473f3e770ff76d3b496a7c2ae51b061670237d2aec1c80c679b13d9e28a6584 | 0 | PENDING_SOURCE_QUALIFICATION; never blanket zero | PENDING_SOURCE_QUALIFICATION; charged per electric output | Source existing equipment only; no automatic2050 upgrade | onwind | 35001.42243964893 | 114912.45114815164 | 2.5895789233544777 | /home/jin/research/SGP_ESE5004_Stage2/pypsa-asean/resources/baseline-aims-3H-tutorial/costs_2050_sec.csv SHA256=bbcc639010a6775255730278eaa6e21ba56867d0610d3a011adc3eb60d0065f5 | Illustrative frozen2050 NEW technology row only; not an accepted historical equipment cost mapping | fixed capacity; capital_cost=0; independent audited annual FOM objective term; VOM on dispatch; input-basis conversion for thermal Links | PENDING
