cyc292cycjin-oss/SGP-ESE5004-Stage2/research/00_model_audit/input_snapshot/resources/baseline-aims-3H-tutorial/costs_2030.csv

technology | parameter | value | unit | source | further description | currency_year
Alkaline electrolyzer large size | FOM | 2.8 | %/year | JRC, 01_JRC-EU-TIMES Full model, https://zenodo.org/records/3544900, file `SubRES_15_TECHS_HYDROGEN.xlsx` (SELCH2EC01, H2 Production-Alkaline Electrolyser, large size, centralized) and currency year from file `SubRES_15_TECHS_HYDROGEN.xlsx`, Sheet `INPUT-Data(HP)` | Reference capacity 72 MW | 2010.0
Alkaline electrolyzer large size | VOM | 0.2389 | EUR/MWh_H2 | JRC, 01_JRC-EU-TIMES Full model, https://zenodo.org/records/3544900, file `SubRES_15_TECHS_HYDROGEN.xlsx` (SELCH2EC01, H2 Production-Alkaline Electrolyser, large size, centralized) and currency year from file `SubRES_15_TECHS_HYDROGEN.xlsx`, Sheet `INPUT-Data(HP)` | Reference capacity 72 MW | 2010.0
Alkaline electrolyzer large size | electricity-input | 1.38 | MWh_el/MWh_H2 | JRC, 01_JRC-EU-TIMES Full model, https://zenodo.org/records/3544900, file `SubRES_15_TECHS_HYDROGEN.xlsx` (SELCH2EC01, H2 Production-Alkaline Electrolyser, large size, centralized) and currency year from file `SubRES_15_TECHS_HYDROGEN.xlsx`, Sheet `INPUT-Data(HP)` | Reference capacity 72 MW | 0.0
Alkaline electrolyzer large size | investment | 429.0306 | EUR/kW | JRC, 01_JRC-EU-TIMES Full model, https://zenodo.org/records/3544900, file `SubRES_15_TECHS_HYDROGEN.xlsx` (SELCH2EC01, H2 Production-Alkaline Electrolyser, large size, centralized) and currency year from file `SubRES_15_TECHS_HYDROGEN.xlsx`, Sheet `INPUT-Data(HP)` | Reference capacity 72 MW | 2010.0
Alkaline electrolyzer large size | lifetime | 40.0 | years | JRC, 01_JRC-EU-TIMES Full model, https://zenodo.org/records/3544900, file `SubRES_15_TECHS_HYDROGEN.xlsx` (SELCH2EC01, H2 Production-Alkaline Electrolyser, large size, centralized) and currency year from file `SubRES_15_TECHS_HYDROGEN.xlsx`, Sheet `INPUT-Data(HP)` | Reference capacity 72 MW | 0.0
Alkaline electrolyzer medium size | FOM | 2.3 | %/year | JRC, 01_JRC-EU-TIMES Full model, https://zenodo.org/records/3544900, file `SubRES_15_TECHS_HYDROGEN.xlsx` (SELCH2EC02, H2 Production-Alkaline Electrolyser, medium size, centralized) and currency year from file `SubRES_15_TECHS_HYDROGEN.xlsx`, Sheet `INPUT-Data(HP)` | Reference capacity 33 MW | 2010.0
Alkaline electrolyzer medium size | VOM | 0.2389 | EUR/MWh_H2 | JRC, 01_JRC-EU-TIMES Full model, https://zenodo.org/records/3544900, file `SubRES_15_TECHS_HYDROGEN.xlsx` (SELCH2EC02, H2 Production-Alkaline Electrolyser, medium size, centralized) and currency year from file `SubRES_15_TECHS_HYDROGEN.xlsx`, Sheet `INPUT-Data(HP)` | Reference capacity 33 MW | 2010.0
Alkaline electrolyzer medium size | electricity-input | 1.416 | MWh_el/MWh_H2 | JRC, 01_JRC-EU-TIMES Full model, https://zenodo.org/records/3544900, file `SubRES_15_TECHS_HYDROGEN.xlsx` (SELCH2EC02, H2 Production-Alkaline Electrolyser, medium size, centralized) and currency year from file `SubRES_15_TECHS_HYDROGEN.xlsx`, Sheet `INPUT-Data(HP)` | Reference capacity 33 MW | 0.0
Alkaline electrolyzer medium size | investment | 506.0332 | EUR/kW | JRC, 01_JRC-EU-TIMES Full model, https://zenodo.org/records/3544900, file `SubRES_15_TECHS_HYDROGEN.xlsx` (SELCH2EC02, H2 Production-Alkaline Electrolyser, medium size, centralized) and currency year from file `SubRES_15_TECHS_HYDROGEN.xlsx`, Sheet `INPUT-Data(HP)` | Reference capacity 33 MW | 2010.0
Alkaline electrolyzer medium size | lifetime | 20.0 | years | JRC, 01_JRC-EU-TIMES Full model, https://zenodo.org/records/3544900, file `SubRES_15_TECHS_HYDROGEN.xlsx` (SELCH2EC02, H2 Production-Alkaline Electrolyser, medium size, centralized) and currency year from file `SubRES_15_TECHS_HYDROGEN.xlsx`, Sheet `INPUT-Data(HP)` | Reference capacity 33 MW | 0.0
Alkaline electrolyzer small size | FOM | 2.3 | %/year | JRC, 01_JRC-EU-TIMES Full model, https://zenodo.org/records/3544900, file `SubRES_15_TECHS_HYDROGEN.xlsx` (SELCH2ED01, H2 Production-Alkaline Electrolyser, small size, decentralized) and currency year from file `SubRES_15_TECHS_HYDROGEN.xlsx`, Sheet `INPUT-Data(HP)` | Reference capacity 0.6 MW | 2010.0
Alkaline electrolyzer small size | VOM | 0.1934 | EUR/MWh_H2 | JRC, 01_JRC-EU-TIMES Full model, https://zenodo.org/records/3544900, file `SubRES_15_TECHS_HYDROGEN.xlsx` (SELCH2ED01, H2 Production-Alkaline Electrolyser, small size, decentralized) and currency year from file `SubRES_15_TECHS_HYDROGEN.xlsx`, Sheet `INPUT-Data(HP)` | Reference capacity 0.6 MW | 2010.0
Alkaline electrolyzer small size | electricity-input | 1.41 | MWh_el/MWh_H2 | JRC, 01_JRC-EU-TIMES Full model, https://zenodo.org/records/3544900, file `SubRES_15_TECHS_HYDROGEN.xlsx` (SELCH2ED01, H2 Production-Alkaline Electrolyser, small size, decentralized) and currency year from file `SubRES_15_TECHS_HYDROGEN.xlsx`, Sheet `INPUT-Data(HP)` | Reference capacity 0.6 MW | 0.0
Alkaline electrolyzer small size | investment | 582.922 | EUR/kW | JRC, 01_JRC-EU-TIMES Full model, https://zenodo.org/records/3544900, file `SubRES_15_TECHS_HYDROGEN.xlsx` (SELCH2ED01, H2 Production-Alkaline Electrolyser, small size, decentralized) and currency year from file `SubRES_15_TECHS_HYDROGEN.xlsx`, Sheet `INPUT-Data(HP)` | Reference capacity 0.6 MW | 2010.0
Alkaline electrolyzer small size | lifetime | 20.0 | years | JRC, 01_JRC-EU-TIMES Full model, https://zenodo.org/records/3544900, file `SubRES_15_TECHS_HYDROGEN.xlsx` (SELCH2ED01, H2 Production-Alkaline Electrolyser, small size, decentralized) and currency year from file `SubRES_15_TECHS_HYDROGEN.xlsx`, Sheet `INPUT-Data(HP)` | Reference capacity 0.6 MW | 0.0
Ammonia cracker | FOM | 4.3 | %/year | Ishimoto et al. (2020): 10.1016/j.ijhydene.2020.09.017 , table 7. | Estimated based on Labour cost rate, Maintenance cost rate, Insurance rate, Admin. cost rate and Chemical & other consumables cost rate. | 2015.0
Ammonia cracker | ammonia-input | 1.46 | MWh_NH3/MWh_H2 | ENGIE et al (2020): Ammonia to Green Hydrogen Feasibility Study (https://assets.publishing.service.gov.uk/government/uploads/system/uploads/attachment_data/file/880826/HS420_-_Ecuity_-_Ammonia_to_Green_Hydrogen.pdf), Fig. 10. | Assuming a integrated 200t/d cracking and purification facility. Electricity demand (316 MWh per 2186 MWh_LHV H2 output) is assumed to also be ammonia LHV input which seems a fair assumption as the facility has options for a higher degree of integration according to the report). | 0.0
Ammonia cracker | investment | 1123945.3807 | EUR/MW_H2 | Ishimoto et al. (2020): 10.1016/j.ijhydene.2020.09.017 , table 6. | Calculated. For a small (200 t_NH3/d input) facility. Base cost for facility: 51 MEUR at capacity 20 000m^3_NH3/h = 339 t_NH3/d input. Cost scaling exponent 0.67. Ammonia density 0.7069 kg/m^3. Conversion efficiency of cracker: 0.685. Ammonia LHV: 5.167 MWh/t_NH3.; and Calculated. For a large (2500 t_NH3/d input) facility. Base cost for facility: 51 MEUR at capacity 20 000m^3_NH3/h = 339 t_NH3/d input. Cost scaling exponent 0.67. Ammonia density 0.7069 kg/m^3. Conversion efficiency of cracker: 0.685. Ammonia LHV: 5.167 MWh/t_NH3. | 2015.0
Ammonia cracker | lifetime | 25.0 | years | Ishimoto et al. (2020): 10.1016/j.ijhydene.2020.09.017 , table 7. | 0 | 2015.0
BEV Bus city | FOM | 0.0003 | %/year | Danish Energy Agency, inputs/data_sheets_for_commercial_freight_and_passenger_transport_0.xlsx | BEV B1 | 2022.0
BEV Bus city | Motor size | 346.5517 | kW | Danish Energy Agency, inputs/data_sheets_for_commercial_freight_and_passenger_transport_0.xlsx | BEV B1 | 2022.0
BEV Bus city | VOM | 0.0952 | EUR/km | Danish Energy Agency, inputs/data_sheets_for_commercial_freight_and_passenger_transport_0.xlsx | BEV B1 | 2022.0
BEV Bus city | efficiency | 0.8585 | kWh/km | Danish Energy Agency, inputs/data_sheets_for_commercial_freight_and_passenger_transport_0.xlsx | BEV B1 | 2022.0
BEV Bus city | investment | 222485.6452 | EUR/vehicle | Danish Energy Agency, inputs/data_sheets_for_commercial_freight_and_passenger_transport_0.xlsx | BEV B1 | 2022.0
BEV Bus city | lifetime | 12.0 | years | Danish Energy Agency, inputs/data_sheets_for_commercial_freight_and_passenger_transport_0.xlsx | BEV B1 | 2022.0
BEV Coach | FOM | 0.0002 | %/year | Danish Energy Agency, inputs/data_sheets_for_commercial_freight_and_passenger_transport_0.xlsx | BEV B2 | 2022.0
BEV Coach | Motor size | 358.6207 | kW | Danish Energy Agency, inputs/data_sheets_for_commercial_freight_and_passenger_transport_0.xlsx | BEV B2 | 2022.0
BEV Coach | VOM | 0.0952 | EUR/km | Danish Energy Agency, inputs/data_sheets_for_commercial_freight_and_passenger_transport_0.xlsx | BEV B2 | 2022.0
BEV Coach | efficiency | 0.8446 | kWh/km | Danish Energy Agency, inputs/data_sheets_for_commercial_freight_and_passenger_transport_0.xlsx | BEV B2 | 2022.0
BEV Coach | investment | 303025.4488 | EUR/vehicle | Danish Energy Agency, inputs/data_sheets_for_commercial_freight_and_passenger_transport_0.xlsx | BEV B2 | 2022.0
BEV Coach | lifetime | 12.0 | years | Danish Energy Agency, inputs/data_sheets_for_commercial_freight_and_passenger_transport_0.xlsx | BEV B2 | 2022.0
BEV Truck Semi-Trailer max 50 tons | FOM | 0.0004 | %/year | Danish Energy Agency, inputs/data_sheets_for_commercial_freight_and_passenger_transport_0.xlsx | BEV L3 | 2022.0
BEV Truck Semi-Trailer max 50 tons | Motor size | 555.1724 | kW | Danish Energy Agency, inputs/data_sheets_for_commercial_freight_and_passenger_transport_0.xlsx | BEV L3 | 2022.0
BEV Truck Semi-Trailer max 50 tons | VOM | 0.0952 | EUR/km | Danish Energy Agency, inputs/data_sheets_for_commercial_freight_and_passenger_transport_0.xlsx | BEV L3 | 2022.0
BEV Truck Semi-Trailer max 50 tons | efficiency | 1.3936 | kWh/km | Danish Energy Agency, inputs/data_sheets_for_commercial_freight_and_passenger_transport_0.xlsx | BEV L3 | 2022.0
BEV Truck Semi-Trailer max 50 tons | investment | 151213.8954 | EUR/vehicle | Danish Energy Agency, inputs/data_sheets_for_commercial_freight_and_passenger_transport_0.xlsx | BEV L3 | 2022.0
BEV Truck Semi-Trailer max 50 tons | lifetime | 10.5 | years | Danish Energy Agency, inputs/data_sheets_for_commercial_freight_and_passenger_transport_0.xlsx | BEV L3 | 2022.0
BEV Truck Solo max 26 tons | FOM | 0.0002 | %/year | Danish Energy Agency, inputs/data_sheets_for_commercial_freight_and_passenger_transport_0.xlsx | BEV L1 | 2022.0
BEV Truck Solo max 26 tons | Motor size | 382.7586 | kW | Danish Energy Agency, inputs/data_sheets_for_commercial_freight_and_passenger_transport_0.xlsx | BEV L1 | 2022.0
BEV Truck Solo max 26 tons | VOM | 0.0952 | EUR/km | Danish Energy Agency, inputs/data_sheets_for_commercial_freight_and_passenger_transport_0.xlsx | BEV L1 | 2022.0
BEV Truck Solo max 26 tons | efficiency | 0.8755 | kWh/km | Danish Energy Agency, inputs/data_sheets_for_commercial_freight_and_passenger_transport_0.xlsx | BEV L1 | 2022.0
BEV Truck Solo max 26 tons | investment | 282418.6749 | EUR/vehicle | Danish Energy Agency, inputs/data_sheets_for_commercial_freight_and_passenger_transport_0.xlsx | BEV L1 | 2022.0
BEV Truck Solo max 26 tons | lifetime | 13.8 | years | Danish Energy Agency, inputs/data_sheets_for_commercial_freight_and_passenger_transport_0.xlsx | BEV L1 | 2022.0
BEV Truck Trailer max 56 tons | FOM | 0.0003 | %/year | Danish Energy Agency, inputs/data_sheets_for_commercial_freight_and_passenger_transport_0.xlsx | BEV L2 | 2022.0
BEV Truck Trailer max 56 tons | Motor size | 710.3448 | kW | Danish Energy Agency, inputs/data_sheets_for_commercial_freight_and_passenger_transport_0.xlsx | BEV L2 | 2022.0
BEV Truck Trailer max 56 tons | VOM | 0.0952 | EUR/km | Danish Energy Agency, inputs/data_sheets_for_commercial_freight_and_passenger_transport_0.xlsx | BEV L2 | 2022.0
BEV Truck Trailer max 56 tons | efficiency | 1.5446 | kWh/km | Danish Energy Agency, inputs/data_sheets_for_commercial_freight_and_passenger_transport_0.xlsx | BEV L2 | 2022.0
BEV Truck Trailer max 56 tons | investment | 167722.8037 | EUR/vehicle | Danish Energy Agency, inputs/data_sheets_for_commercial_freight_and_passenger_transport_0.xlsx | BEV L2 | 2022.0
BEV Truck Trailer max 56 tons | lifetime | 13.8 | years | Danish Energy Agency, inputs/data_sheets_for_commercial_freight_and_passenger_transport_0.xlsx | BEV L2 | 2022.0
Battery electric (passenger cars) | FOM | 0.9 | % | PATHS TO A CLIMATE-NEUTRAL ENERGY SYSTEM The German energy transformation in its social context. https://www.ise.fraunhofer.de/en/publications/studies/paths-to-a-climate-neutral-energy-system.html | Battery electric (passenger cars) | 2020.0
Battery electric (passenger cars) | efficiency | 0.68 | per unit | PATHS TO A CLIMATE-NEUTRAL ENERGY SYSTEM The German energy transformation in its social context. https://www.ise.fraunhofer.de/en/publications/studies/paths-to-a-climate-neutral-energy-system.html | Battery electric (passenger cars) | 2020.0
Battery electric (passenger cars) | investment | 24624.0 | EUR/PKW | PATHS TO A CLIMATE-NEUTRAL ENERGY SYSTEM The German energy transformation in its social context. https://www.ise.fraunhofer.de/en/publications/studies/paths-to-a-climate-neutral-energy-system.html | Battery electric (passenger cars) | 2020.0
Battery electric (passenger cars) | lifetime | 15.0 | years | PATHS TO A CLIMATE-NEUTRAL ENERGY SYSTEM The German energy transformation in its social context. https://www.ise.fraunhofer.de/en/publications/studies/paths-to-a-climate-neutral-energy-system.html | Battery electric (passenger cars) | 2020.0
Battery electric (trucks) | FOM | 15.0 | % | PATHS TO A CLIMATE-NEUTRAL ENERGY SYSTEM The German energy transformation in its social context. https://www.ise.fraunhofer.de/en/publications/studies/paths-to-a-climate-neutral-energy-system.html | Battery electric (trucks) | 2020.0
Battery electric (trucks) | investment | 136400.0 | EUR/LKW | PATHS TO A CLIMATE-NEUTRAL ENERGY SYSTEM The German energy transformation in its social context. https://www.ise.fraunhofer.de/en/publications/studies/paths-to-a-climate-neutral-energy-system.html | Battery electric (trucks) | 2020.0
Battery electric (trucks) | lifetime | 15.0 | years | PATHS TO A CLIMATE-NEUTRAL ENERGY SYSTEM The German energy transformation in its social context. https://www.ise.fraunhofer.de/en/publications/studies/paths-to-a-climate-neutral-energy-system.html | Battery electric (trucks) | 2020.0
BioSNG | C in fuel | 0.3402 | per unit | Stoichiometric calculation, doi:10.1016/j.apenergy.2022.120016 | 0 | 0.0
BioSNG | C stored | 0.6598 | per unit | Stoichiometric calculation, doi:10.1016/j.apenergy.2022.120016 | 0 | 0.0
BioSNG | CO2 stored | 0.2419 | tCO2/MWh_th | Stoichiometric calculation, doi:10.1016/j.apenergy.2022.120016 | 0 | 0.0
BioSNG | FOM | 1.6375 | %/year | Danish Energy Agency, inputs/data_sheets_for_renewable_fuels.xlsx | 84 Gasif. CFB, Bio-SNG: Fixed O&M | 2020.0
BioSNG | VOM | 1.8078 | EUR/MWh_th | Danish Energy Agency, inputs/data_sheets_for_renewable_fuels.xlsx | 84 Gasif. CFB, Bio-SNG: Variable O&M | 2020.0
BioSNG | capture rate | 0.9 | per unit | Assumption based on doi:10.1016/j.biombioe.2015.01.006 | 0 | 0.0
BioSNG | efficiency | 0.63 | per unit | Danish Energy Agency, inputs/data_sheets_for_renewable_fuels.xlsx | 84 Gasif. CFB, Bio-SNG: Bio SNG Output | 2020.0
BioSNG | investment | 1701.44 | EUR/kW_th | Danish Energy Agency, inputs/data_sheets_for_renewable_fuels.xlsx | 84 Gasif. CFB, Bio-SNG: Specific investment | 2020.0
BioSNG | lifetime | 25.0 | years | TODO | 84 Gasif. CFB, Bio-SNG: Technical lifetime | 2020.0
BtL | C in fuel | 0.2688 | per unit | Stoichiometric calculation, doi:10.1016/j.apenergy.2022.120016 | 0 | 0.0
BtL | C stored | 0.7312 | per unit | Stoichiometric calculation, doi:10.1016/j.apenergy.2022.120016 | 0 | 0.0
BtL | CO2 stored | 0.2681 | tCO2/MWh_th | Stoichiometric calculation, doi:10.1016/j.apenergy.2022.120016 | 0 | 0.0
BtL | FOM | 2.6667 | %/year | Danish Energy Agency, inputs/data_sheets_for_renewable_fuels.xlsx | 85 Gasif. Ent. Flow FT, liq fu : Fixed O&M | 2020.0
BtL | VOM | 1.1299 | EUR/MWh_FT | Danish Energy Agency, inputs/data_sheets_for_renewable_fuels.xlsx | 85 Gasif. Ent. Flow FT, liq fu : Variable O&M | 2020.0
BtL | capture rate | 0.9 | per unit | Assumption based on doi:10.1016/j.biombioe.2015.01.006 | 0 | 0.0
BtL | efficiency | 0.3833 | per unit | doi:10.1016/j.enpol.2017.05.013 | 85 Gasif. Ent. Flow FT, liq fu : Electricity Output | 2020.0
BtL | investment | 3118.4333 | EUR/kW_th | doi:10.1016/j.enpol.2017.05.013 | 85 Gasif. Ent. Flow FT, liq fu : Specific investment | 2017.0
BtL | lifetime | 25.0 | years | Danish Energy Agency, inputs/data_sheets_for_renewable_fuels.xlsx | 85 Gasif. Ent. Flow FT, liq fu : Technical lifetime | 2020.0
CCGT | FOM | 3.1808278867102393 | %/year | 8th ASEAN Energy Outlook (D.15 D.17 D.18), https://aseanenergy.org/wp-content/uploads/2024/09/8th-ASEAN-Energy-Outlook.pdf | 0 | 2020.0
CCGT | VOM | 1.9299029916598416 | EUR/MWh | 8th ASEAN Energy Outlook (D.15 D.17 D.18), https://aseanenergy.org/wp-content/uploads/2024/09/8th-ASEAN-Energy-Outlook.pdf | 0 | 2020.0
CCGT | c_b | 2.0 | 50oC/100oC | Danish Energy Agency, inputs/technology_data_for_el_and_dh.xlsx | 05 Gas turb. CC, steam extract.: Cb coefficient | 2015.0
CCGT | c_v | 0.15 | 50oC/100oC | Danish Energy Agency, inputs/technology_data_for_el_and_dh.xlsx | 05 Gas turb. CC, steam extract.: Cv coefficient | 2015.0
CCGT | efficiency | 0.58 | per unit | Danish Energy Agency, inputs/technology_data_for_el_and_dh.xlsx | 05 Gas turb. CC, steam extract.: Electricity efficiency, annual average | 2015.0
CCGT | investment | 805.2958847016974 | EUR/kW | 8th ASEAN Energy Outlook (D.15 D.17 D.18), https://aseanenergy.org/wp-content/uploads/2024/09/8th-ASEAN-Energy-Outlook.pdf | 0 | 2020.0
CCGT | lifetime | 25.0 | years | Danish Energy Agency, inputs/technology_data_for_el_and_dh.xlsx | 05 Gas turb. CC, steam extract.: Technical lifetime | 2015.0
CH4 (g) fill compressor station | FOM | 1.7 | %/year | Assume same as for H2 (g) fill compressor station. | - | 2020.0
CH4 (g) fill compressor station | investment | 1654.96 | EUR/MW_CH4 | Guesstimate, based on H2 (g) pipeline and fill compressor station cost. | Assume same ratio as between H2 (g) pipeline and fill compressor station, i.e. 1:19 , due to a lack of reliable numbers. | 2020.0
CH4 (g) fill compressor station | lifetime | 20.0 | years | Assume same as for H2 (g) fill compressor station. | - | 2020.0
CH4 (g) pipeline | FOM | 1.5 | %/year | Assume same as for H2 (g) pipeline in 2050 (CH4 pipeline as mature technology). | Due to lack of numbers, use comparable H2 pipeline assumptions. | 2020.0
CH4 (g) pipeline | electricity-input | 0.01 | MW_e/1000km/MW_CH4 | Danish Energy Agency, Technology Data for Energy Transport (2021), Excel datasheet: 112 6 gas Main distri line. | Assumption for gas pipeline >100MW, 0.1% per station and spacing of 100km yields 1%/1000km. Electric compression. | 2015.0
CH4 (g) pipeline | investment | 87.22 | EUR/MW/km | Guesstimate. | Based on Arab Gas Pipeline: https://en.wikipedia.org/wiki/Arab_Gas_Pipeline: cost = 1.2e9 $-US (year = ?), capacity=10.3e9 m^3/a NG, l=1200km, NG-LHV=39MJ/m^3*90% (also Wikipedia estimate from here https://en.wikipedia.org/wiki/Heat_of_combustion). Presumed to include booster station cost. | 2020.0
CH4 (g) pipeline | lifetime | 50.0 | years | Assume same as for H2 (g) pipeline in 2050 (CH4 pipeline as mature technology). | Due to lack of numbers, use comparable H2 pipeline assumptions. | 2020.0
CH4 (g) submarine pipeline | FOM | 3.0 | %/year | d’Amore-Domenech et al (2021): 10.1016/j.apenergy.2021.116625 , supplementary material. | - | 2015.0
CH4 (g) submarine pipeline | electricity-input | 0.01 | MW_e/1000km/MW_CH4 | Danish Energy Agency, Technology Data for Energy Transport (2021), Excel datasheet: 112 6 gas Main distri line. | Assumption for gas pipeline >100MW, 0.1% per station and spacing of 100km yields 1%/1000km. Electric compression. | 2015.0
CH4 (g) submarine pipeline | investment | 119.3173 | EUR/MW/km | Kaiser (2017): 10.1016/j.marpol.2017.05.003 . | Based on Gulfstream pipeline costs (430 mi long pipeline for natural gas in deep/shallow waters) of 2.72e6 USD/mi and 1.31 bn ft^3/d capacity (36 in diameter), LHV of methane 13.8888 MWh/t and density of 0.657 kg/m^3 and 1.17 USD:1EUR conversion rate = 102.4 EUR/MW/km. Number is without booster station cost. Estimation of additional cost for booster stations based on H2 (g) pipeline numbers from Guidehouse (2020): European Hydrogen Backbone report and Danish Energy Agency (2021): Technology Data for Energy Transport, were booster stations make ca. 6% of pipeline cost; here add additional 10% for booster stations as they need to be constructed submerged or on plattforms. (102.4*1.1). | 2014.0
CH4 (g) submarine pipeline | lifetime | 30.0 | years | d’Amore-Domenech et al (2021): 10.1016/j.apenergy.2021.116625 , supplementary material. | - | 2015.0
CH4 (l) transport ship | FOM | 3.5 | %/year | Fasihi et al 2017, table 1, https://www.mdpi.com/2071-1050/9/2/306 | 0 | 2015.0
CH4 (l) transport ship | capacity | 58300.0 | t_CH4 | Calculated, based on Fasihi et al 2017, table 1, https://www.mdpi.com/2071-1050/9/2/306 | based on 138 000 m^3 capacity and LNG density of 0.4226 t/m^3 . | 2015.0
CH4 (l) transport ship | investment | 159791465.6831 | EUR | Fasihi et al 2017, table 1, https://www.mdpi.com/2071-1050/9/2/306 | 0 | 2015.0
CH4 (l) transport ship | lifetime | 25.0 | years | Fasihi et al 2017, table 1, https://www.mdpi.com/2071-1050/9/2/306 | 0 | 2015.0
CH4 evaporation | FOM | 3.5 | %/year | Lochner and Bothe (2009): https://doi.org/10.1016/j.enpol.2008.12.012 and Fasihi et al 2017, table 1, https://www.mdpi.com/2071-1050/9/2/306 | 0 | 2005.0
CH4 evaporation | investment | 91.1101 | EUR/kW_CH4 | Calculated, based on Lochner and Bothe (2009): https://doi.org/10.1016/j.enpol.2008.12.012 and Fasihi et al 2017, table 1, https://www.mdpi.com/2071-1050/9/2/306 | based on 100 MUSD-2005/(1 bcm/a), 1 bcm = 10.6 TWh, currency exchange rate: 1.15 USD=1 EUR. | 2005.0
CH4 evaporation | lifetime | 30.0 | years | Fasihi et al 2017, table 1, https://www.mdpi.com/2071-1050/9/2/306 | 0 | 2005.0
CH4 liquefaction | FOM | 3.5 | %/year | Fasihi et al 2017, table 1, https://www.mdpi.com/2071-1050/9/2/306 | 0 | 2005.0
CH4 liquefaction | electricity-input | 0.036 | MWh_el/MWh_CH4 | Pospíšil et al. (2019): Energy demand of liquefaction and regasification of natural gas and the potential of LNG for operative thermal energy storage (https://doi.org/10.1016/j.rser.2018.09.027), Table 2 and Table 3. alternative source 2: https://encyclopedia.airliquide.com/methane (accessed 2021-02-10). | Assuming 0.5 MWh/t_CH4 for refigeration cycle based on Table 2 of source; cleaning of gas presumed unnecessary as it should be nearly pure CH4 (=SNG). Assuming energy required is only electricity which is for Table 3 in the source provided with efficiencies of ~50% of LHV, making the numbers consistent with the numbers in Table 2. | 0.0
CH4 liquefaction | investment | 241.443 | EUR/kW_CH4 | Calculated, based on Lochner and Bothe (2009): https://doi.org/10.1016/j.enpol.2008.12.012 and Fasihi et al 2017, table 1, https://www.mdpi.com/2071-1050/9/2/306 | based on 265 MUSD-2005/(1 bcm/a), 1 bcm = 10.6 TWh, currency exchange rate: 1.15 USD=1 EUR. | 2005.0
CH4 liquefaction | lifetime | 25.0 | years | Fasihi et al 2017, table 1, https://www.mdpi.com/2071-1050/9/2/306 | 0 | 2005.0
CH4 liquefaction | methane-input | 1.0 | MWh_CH4/MWh_CH4 | Pospíšil et al. (2019): Energy demand of liquefaction and regasification of natural gas and the potential of LNG for operative thermal energy storage (https://doi.org/10.1016/j.rser.2018.09.027), Table 2 and Table 3. alternative source 2: https://encyclopedia.airliquide.com/methane (accessed 2021-02-10). | For refrigeration cycle, cleaning of gas presumed unnecessary as it should be nearly pure CH4 (=SNG). Assuming energy required is only electricity which is for Table 3 in the source provided with efficiencies of ~50% of LHV, making the numbers consistent with the numbers in Table 2. | 0.0
CO2 liquefaction | FOM | 5.0 | %/year | Mitsubish Heavy Industries Ltd. and IEA (2004): https://ieaghg.org/docs/General_Docs/Reports/PH4-30%20Ship%20Transport.pdf . | 0 | 2004.0
CO2 liquefaction | carbondioxide-input | 1.0 | t_CO2/t_CO2 | Mitsubish Heavy Industries Ltd. and IEA (2004): https://ieaghg.org/docs/General_Docs/Reports/PH4-30%20Ship%20Transport.pdf . | Assuming a pure, humid, low-pressure input stream. Neglecting possible gross-effects of CO2 which might be cycled for the cooling process. | 0.0
CO2 liquefaction | electricity-input | 0.123 | MWh_el/t_CO2 | Mitsubish Heavy Industries Ltd. and IEA (2004): https://ieaghg.org/docs/General_Docs/Reports/PH4-30%20Ship%20Transport.pdf . | 0 | 0.0
CO2 liquefaction | heat-input | 0.0067 | MWh_th/t_CO2 | Mitsubish Heavy Industries Ltd. and IEA (2004): https://ieaghg.org/docs/General_Docs/Reports/PH4-30%20Ship%20Transport.pdf . | For drying purposes. | 0.0
CO2 liquefaction | investment | 16.7226 | EUR/t_CO2/h | Mitsubish Heavy Industries Ltd. and IEA (2004): https://ieaghg.org/docs/General_Docs/Reports/PH4-30%20Ship%20Transport.pdf . | Plant capacity of 20 kt CO2 / d and an uptime of 85%. For a high purity, humid, low pressure input stream, includes drying and compression necessary for liquefaction. | 2004.0
CO2 liquefaction | lifetime | 25.0 | years | Guesstimate, based on CH4 liquefaction. | 0 | 2004.0
CO2 pipeline | FOM | 0.9 | %/year | Danish Energy Agency, Technology Data for Energy Transport (March 2021), Excel datasheet: 121 co2 pipeline. | 0 | 2015.0
CO2 pipeline | investment | 2116.4433 | EUR/(tCO2/h)/km | Danish Energy Agency, Technology Data for Energy Transport (March 2021), Excel datasheet: 121 co2 pipeline. | Assuming the 120-500 t CO2/h range that is based on cost of a 12 inch onshore pipeline. | 2015.0
CO2 pipeline | lifetime | 50.0 | years | Danish Energy Agency, Technology Data for Energy Transport (March 2021), Excel datasheet: 121 co2 pipeline. | 0 | 2015.0
CO2 storage tank | FOM | 1.0 | %/year | Lauri et al. 2014: doi: 10.1016/j.egypro.2014.11.297, pg. 2746 . | Assuming a 3000m^3 pressurised steel cylinder tanks and a CO2 density of 1100 kg/m^3 (close to triple point at -56.6°C and 5.2 bar with max density of 1200kg/m^3 ). Lauri et al. report costs 3x higher per m^3 for steel tanks, which are consistent with other sources. The numbers reported are in rather difficult to pinpoint as systems can greatly vary. | 2013.0
CO2 storage tank | investment | 2584.3462 | EUR/t_CO2 | Lauri et al. 2014: doi: 10.1016/j.egypro.2014.11.297, Table 3. | Assuming a 3000m^3 pressurised steel cylinder tanks and a CO2 density of 1100 kg/m^3 (close to triple point at -56.6°C and 5.2 bar with max density of 1200kg/m^3 ). Lauri et al. report costs 3x higher per m^3 for steel tanks, which are consistent with other sources. The numbers reported are in rather difficult to pinpoint as systems can greatly vary. | 2013.0
CO2 storage tank | lifetime | 25.0 | years | Lauri et al. 2014: doi: 10.1016/j.egypro.2014.11.297, pg. 2746 . | Assuming a 3000m^3 pressurised steel cylinder tanks and a CO2 density of 1100 kg/m^3 (close to triple point at -56.6°C and 5.2 bar with max density of 1200kg/m^3 ). Lauri et al. report costs 3x higher per m^3 for steel tanks, which are consistent with other sources. The numbers reported are in rather difficult to pinpoint as systems can greatly vary. | 2013.0
CO2 submarine pipeline | FOM | 0.5 | %/year | Danish Energy Agency, Technology Data for Energy Transport (March 2021), Excel datasheet: 121 co2 pipeline. | 0 | 2015.0
CO2 submarine pipeline | investment | 4232.8865 | EUR/(tCO2/h)/km | Danish Energy Agency, Technology Data for Energy Transport (March 2021), Excel datasheet: 121 co2 pipeline. | Assuming the 120-500 t CO2/h range that is based on cost of a 12 inch offshore pipeline. | 2015.0
Charging infrastructure fast (purely) battery electric vehicles passenger cars | FOM | 1.6 | % | PATHS TO A CLIMATE-NEUTRAL ENERGY SYSTEM The German energy transformation in its social context. https://www.ise.fraunhofer.de/en/publications/studies/paths-to-a-climate-neutral-energy-system.html | Charging infrastructure fast (purely) battery electric vehicles passenger cars | 2020.0
Charging infrastructure fast (purely) battery electric vehicles passenger cars | investment | 448894.0 | EUR/Ladesï¿½ule | PATHS TO A CLIMATE-NEUTRAL ENERGY SYSTEM The German energy transformation in its social context. https://www.ise.fraunhofer.de/en/publications/studies/paths-to-a-climate-neutral-energy-system.html | Charging infrastructure fast (purely) battery electric vehicles passenger cars | 2020.0
Charging infrastructure fast (purely) battery electric vehicles passenger cars | lifetime | 30.0 | years | PATHS TO A CLIMATE-NEUTRAL ENERGY SYSTEM The German energy transformation in its social context. https://www.ise.fraunhofer.de/en/publications/studies/paths-to-a-climate-neutral-energy-system.html | Charging infrastructure fast (purely) battery electric vehicles passenger cars | 2020.0
Charging infrastructure fuel cell vehicles passenger cars | FOM | 2.2 | % | PATHS TO A CLIMATE-NEUTRAL ENERGY SYSTEM The German energy transformation in its social context. https://www.ise.fraunhofer.de/en/publications/studies/paths-to-a-climate-neutral-energy-system.html | Charging infrastructure fuel cell vehicles passenger cars | 2020.0
Charging infrastructure fuel cell vehicles passenger cars | investment | 1787894.0 | EUR/Ladesï¿½ule | PATHS TO A CLIMATE-NEUTRAL ENERGY SYSTEM The German energy transformation in its social context. https://www.ise.fraunhofer.de/en/publications/studies/paths-to-a-climate-neutral-energy-system.html | Charging infrastructure fuel cell vehicles passenger cars | 2020.0
Charging infrastructure fuel cell vehicles passenger cars | lifetime | 30.0 | years | PATHS TO A CLIMATE-NEUTRAL ENERGY SYSTEM The German energy transformation in its social context. https://www.ise.fraunhofer.de/en/publications/studies/paths-to-a-climate-neutral-energy-system.html | Charging infrastructure fuel cell vehicles passenger cars | 2020.0
Charging infrastructure fuel cell vehicles trucks | FOM | 2.2 | % | PATHS TO A CLIMATE-NEUTRAL ENERGY SYSTEM The German energy transformation in its social context. https://www.ise.fraunhofer.de/en/publications/studies/paths-to-a-climate-neutral-energy-system.html | Charging infrastructure fuel cell vehicles trucks | 2020.0
Charging infrastructure fuel cell vehicles trucks | investment | 1787894.0 | EUR/Ladesï¿½ule | PATHS TO A CLIMATE-NEUTRAL ENERGY SYSTEM The German energy transformation in its social context. https://www.ise.fraunhofer.de/en/publications/studies/paths-to-a-climate-neutral-energy-system.html | Charging infrastructure fuel cell vehicles trucks | 2020.0
Charging infrastructure fuel cell vehicles trucks | lifetime | 30.0 | years | PATHS TO A CLIMATE-NEUTRAL ENERGY SYSTEM The German energy transformation in its social context. https://www.ise.fraunhofer.de/en/publications/studies/paths-to-a-climate-neutral-energy-system.html | Charging infrastructure fuel cell vehicles trucks | 2020.0
Charging infrastructure slow (purely) battery electric vehicles passenger cars | FOM | 1.8 | % | PATHS TO A CLIMATE-NEUTRAL ENERGY SYSTEM The German energy transformation in its social context. https://www.ise.fraunhofer.de/en/publications/studies/paths-to-a-climate-neutral-energy-system.html | Charging infrastructure slow (purely) battery electric vehicles passenger cars | 2020.0
Charging infrastructure slow (purely) battery electric vehicles passenger cars | investment | 1005.0 | EUR/Ladesï¿½ule | PATHS TO A CLIMATE-NEUTRAL ENERGY SYSTEM The German energy transformation in its social context. https://www.ise.fraunhofer.de/en/publications/studies/paths-to-a-climate-neutral-energy-system.html | Charging infrastructure slow (purely) battery electric vehicles passenger cars | 2020.0
Charging infrastructure slow (purely) battery electric vehicles passenger cars | lifetime | 30.0 | years | PATHS TO A CLIMATE-NEUTRAL ENERGY SYSTEM The German energy transformation in its social context. https://www.ise.fraunhofer.de/en/publications/studies/paths-to-a-climate-neutral-energy-system.html | Charging infrastructure slow (purely) battery electric vehicles passenger cars | 2020.0
Compressed-Air-Adiabatic-bicharger | FOM | 0.9265 | %/year | Viswanathan_2022, p.64 (p.86) Figure 4.14 | {'carrier': ['elec', 'pair', 'elec'], 'technology_type': ['bicharger'], 'type': ['mechanical'], 'note': ['NULL']} | 2020.0
Compressed-Air-Adiabatic-bicharger | efficiency | 0.7211 | per unit | Viswanathan_2022, p.59 (p.81) | {'carrier': ['elec', 'pair', 'elec'], 'technology_type': ['bicharger'], 'type': ['mechanical'], 'note': ['AC-AC efficiency at transformer level 0.52^0.5']} | 2020.0
Compressed-Air-Adiabatic-bicharger | investment | 946180.9426 | EUR/MW | Viswanathan_2022, p.59 (p.81) | {'carrier': ['elec', 'pair', 'elec'], 'technology_type': ['bicharger'], 'type': ['mechanical'], 'note': ['Turbine Compressor BOP EPC Management']} | 2020.0
Compressed-Air-Adiabatic-bicharger | lifetime | 60.0 | years | Viswanathan_2022, p.59 (p.81) | {'carrier': ['elec', 'pair', 'elec'], 'technology_type': ['bicharger'], 'type': ['mechanical'], 'note': ['NULL']} | 2020.0
Compressed-Air-Adiabatic-store | FOM | 0.43 | %/year | Viswanathan_2022, 0.43 % of SB 4.5.2.1 Fixed O&M p.62 (p.84) | {'carrier': ['pair'], 'technology_type': ['store'], 'type': ['mechanical'], 'note': ['derived']} | 2020.0
Compressed-Air-Adiabatic-store | investment | 5448.7894 | EUR/MWh | Viswanathan_2022, p.64 (p.86) | {'carrier': ['pair'], 'technology_type': ['store'], 'type': ['mechanical'], 'note': ['Cavern Storage']} | 2020.0
Compressed-Air-Adiabatic-store | lifetime | 60.0 | years | Viswanathan_2022, p.59 (p.81) | {'carrier': ['pair'], 'technology_type': ['store'], 'type': ['mechanical'], 'note': ['NULL']} | 2020.0
Concrete-charger | FOM | 1.075 | %/year | Viswanathan_2022, NULL | {'carrier': ['elec', 'concrete'], 'technology_type': ['charger'], 'type': ['thermal'], 'note': ['Guesstimate, 50% on charger']} | 2020.0
Concrete-charger | efficiency | 0.99 | per unit | Viswanathan_2022, p.107 (p.129) | {'carrier': ['elec', 'concrete'], 'technology_type': ['charger'], 'type': ['thermal'], 'note': ['RTE assume 99% for charge and other for discharge']} | 2020.0
Concrete-charger | investment | 144192.2682 | EUR/MW | Georgiou_2018, Guesstimate that charge is 20% of capital costs of power components for sensible thermal storage | {'carrier': ['elec', 'concrete'], 'technology_type': ['charger'], 'type': ['thermal'], 'note': ['Power Equipment Charge']} | 2020.0
Concrete-charger | lifetime | 35.0 | years | Viswanathan_2022, p.107 (p.129) | {'carrier': ['elec', 'concrete'], 'technology_type': ['charger'], 'type': ['thermal'], 'note': ['NULL']} | 2020.0
Concrete-discharger | FOM | 0.2688 | %/year | Viswanathan_2022, NULL | {'carrier': ['concrete', 'elec'], 'technology_type': ['discharger'], 'type': ['thermal'], 'note': ['Guesstimate, 50% on discharger']} | 2020.0
Concrete-discharger | efficiency | 0.4343 | per unit | Viswanathan_2022, p.107 (p.129) | {'carrier': ['concrete', 'elec'], 'technology_type': ['discharger'], 'type': ['thermal'], 'note': ['RTE assume 99% for charge and other for discharge']} | 2020.0
Concrete-discharger | investment | 576769.073 | EUR/MW | Georgiou_2018, Guesstimate that charge is 80% of capital costs of power components for sensible thermal storage | {'carrier': ['concrete', 'elec'], 'technology_type': ['discharger'], 'type': ['thermal'], 'note': ['Power Equipment Discharge']} | 2020.0
Concrete-discharger | lifetime | 35.0 | years | Viswanathan_2022, p.107 (p.129) | {'carrier': ['concrete', 'elec'], 'technology_type': ['discharger'], 'type': ['thermal'], 'note': ['NULL']} | 2020.0
Concrete-store | FOM | 0.3308 | %/year | Viswanathan_2022, p 104 (p.126) | {'carrier': ['concrete'], 'technology_type': ['store'], 'type': ['thermal'], 'note': ['not provided calculated as for hydrogen']} | 2020.0
Concrete-store | investment | 24044.2324 | EUR/MWh | Viswanathan_2022, p.98 (p.120) | {'carrier': ['concrete'], 'technology_type': ['store'], 'type': ['thermal'], 'note': ['SB and BOS 0.85 of 2021 value']} | 2020.0
Concrete-store | lifetime | 35.0 | years | Viswanathan_2022, p.107 (p.129) | {'carrier': ['concrete'], 'technology_type': ['store'], 'type': ['thermal'], 'note': ['NULL']} | 2020.0
Container feeder, ammonia | efficiency | 0.7754 | MWh/km | Danish Energy Agency, inputs/data_sheets_for_maritime_commercial_freight_and_passenger_transport.xlsx | Container feeder, ammonia | 2023.0
Container feeder, ammonia | investment | 38462833.2276 | EUR | Danish Energy Agency, inputs/data_sheets_for_maritime_commercial_freight_and_passenger_transport.xlsx | Container feeder, ammonia | 2023.0
Container feeder, ammonia | lifetime | 30.0 | years | Danish Energy Agency, inputs/data_sheets_for_maritime_commercial_freight_and_passenger_transport.xlsx | Container feeder, ammonia | 2023.0
Container feeder, diesel | efficiency | 0.7718 | MWh/km | Danish Energy Agency, inputs/data_sheets_for_maritime_commercial_freight_and_passenger_transport.xlsx | Container feeder, diesel | 2023.0
Container feeder, diesel | investment | 34966212.0251 | EUR | Danish Energy Agency, inputs/data_sheets_for_maritime_commercial_freight_and_passenger_transport.xlsx | Container feeder, diesel | 2023.0
Container feeder, diesel | lifetime | 30.0 | years | Danish Energy Agency, inputs/data_sheets_for_maritime_commercial_freight_and_passenger_transport.xlsx | Container feeder, diesel | 2023.0
Container feeder, methanol | efficiency | 0.7711 | MWh/km | Danish Energy Agency, inputs/data_sheets_for_maritime_commercial_freight_and_passenger_transport.xlsx | Container feeder, methanol | 2023.0
Container feeder, methanol | investment | 36802136.8043 | EUR | Danish Energy Agency, inputs/data_sheets_for_maritime_commercial_freight_and_passenger_transport.xlsx | Container feeder, methanol | 2023.0
Container feeder, methanol | lifetime | 30.0 | years | Danish Energy Agency, inputs/data_sheets_for_maritime_commercial_freight_and_passenger_transport.xlsx | Container feeder, methanol | 2023.0
Container, ammonia | efficiency | 1.7094 | MWh/km | Danish Energy Agency, inputs/data_sheets_for_maritime_commercial_freight_and_passenger_transport.xlsx | Container, ammonia | 2023.0
Container, ammonia | investment | 131618242.0136 | EUR | Danish Energy Agency, inputs/data_sheets_for_maritime_commercial_freight_and_passenger_transport.xlsx | Container, ammonia | 2023.0
Container, ammonia | lifetime | 31.0 | years | Danish Energy Agency, inputs/data_sheets_for_maritime_commercial_freight_and_passenger_transport.xlsx | Container, ammonia | 2023.0
Container, diesel | efficiency | 1.6399 | MWh/km | Danish Energy Agency, inputs/data_sheets_for_maritime_commercial_freight_and_passenger_transport.xlsx | Container, diesel | 2023.0
Container, diesel | investment | 119652947.2851 | EUR | Danish Energy Agency, inputs/data_sheets_for_maritime_commercial_freight_and_passenger_transport.xlsx | Container, diesel | 2023.0
Container, diesel | lifetime | 32.0 | years | Danish Energy Agency, inputs/data_sheets_for_maritime_commercial_freight_and_passenger_transport.xlsx | Container, diesel | 2023.0
Container, methanol | efficiency | 1.7001 | MWh/km | Danish Energy Agency, inputs/data_sheets_for_maritime_commercial_freight_and_passenger_transport.xlsx | Container, methanol | 2023.0
Container, methanol | investment | 125635594.6493 | EUR | Danish Energy Agency, inputs/data_sheets_for_maritime_commercial_freight_and_passenger_transport.xlsx | Container, methanol | 2023.0
Container, methanol | lifetime | 32.0 | years | Danish Energy Agency, inputs/data_sheets_for_maritime_commercial_freight_and_passenger_transport.xlsx | Container, methanol | 2023.0
Diesel Bus city | FOM | 0.0004 | %/year | Danish Energy Agency, inputs/data_sheets_for_commercial_freight_and_passenger_transport_0.xlsx | Diesel B1 | 2022.0
Diesel Bus city | Motor size | 250.0 | kW | Danish Energy Agency, inputs/data_sheets_for_commercial_freight_and_passenger_transport_0.xlsx | Diesel B1 | 2022.0
Diesel Bus city | VOM | 0.1068 | EUR/km | Danish Energy Agency, inputs/data_sheets_for_commercial_freight_and_passenger_transport_0.xlsx | Diesel B1 | 2022.0
Diesel Bus city | efficiency | 2.0824 | kWh/km | Danish Energy Agency, inputs/data_sheets_for_commercial_freight_and_passenger_transport_0.xlsx | Diesel B1 | 2022.0
Diesel Bus city | investment | 150756.2732 | EUR/vehicle | Danish Energy Agency, inputs/data_sheets_for_commercial_freight_and_passenger_transport_0.xlsx | Diesel B1 | 2022.0
Diesel Bus city | lifetime | 12.0 | years | Danish Energy Agency, inputs/data_sheets_for_commercial_freight_and_passenger_transport_0.xlsx | Diesel B1 | 2022.0
Diesel Coach | FOM | 0.0003 | %/year | Danish Energy Agency, inputs/data_sheets_for_commercial_freight_and_passenger_transport_0.xlsx | Diesel B2 | 2022.0
Diesel Coach | Motor size | 350.0 | kW | Danish Energy Agency, inputs/data_sheets_for_commercial_freight_and_passenger_transport_0.xlsx | Diesel B2 | 2022.0
Diesel Coach | VOM | 0.1068 | EUR/km | Danish Energy Agency, inputs/data_sheets_for_commercial_freight_and_passenger_transport_0.xlsx | Diesel B2 | 2022.0
Diesel Coach | efficiency | 2.2009 | kWh/km | Danish Energy Agency, inputs/data_sheets_for_commercial_freight_and_passenger_transport_0.xlsx | Diesel B2 | 2022.0
Diesel Coach | investment | 231296.0768 | EUR/vehicle | Danish Energy Agency, inputs/data_sheets_for_commercial_freight_and_passenger_transport_0.xlsx | Diesel B2 | 2022.0
Diesel Coach | lifetime | 12.0 | years | Danish Energy Agency, inputs/data_sheets_for_commercial_freight_and_passenger_transport_0.xlsx | Diesel B2 | 2022.0
Diesel Truck Semi-Trailer max 50 tons | FOM | 0.0005 | %/year | Danish Energy Agency, inputs/data_sheets_for_commercial_freight_and_passenger_transport_0.xlsx | Diesel L3 | 2022.0
Diesel Truck Semi-Trailer max 50 tons | Motor size | 380.0 | kW | Danish Energy Agency, inputs/data_sheets_for_commercial_freight_and_passenger_transport_0.xlsx | Diesel L3 | 2022.0
Diesel Truck Semi-Trailer max 50 tons | VOM | 0.1068 | EUR/km | Danish Energy Agency, inputs/data_sheets_for_commercial_freight_and_passenger_transport_0.xlsx | Diesel L3 | 2022.0
Diesel Truck Semi-Trailer max 50 tons | efficiency | 3.2963 | kWh/km | Danish Energy Agency, inputs/data_sheets_for_commercial_freight_and_passenger_transport_0.xlsx | Diesel L3 | 2022.0
Diesel Truck Semi-Trailer max 50 tons | investment | 142012.114 | EUR/vehicle | Danish Energy Agency, inputs/data_sheets_for_commercial_freight_and_passenger_transport_0.xlsx | Diesel L3 | 2022.0
Diesel Truck Semi-Trailer max 50 tons | lifetime | 10.5 | years | Danish Energy Agency, inputs/data_sheets_for_commercial_freight_and_passenger_transport_0.xlsx | Diesel L3 | 2022.0
Diesel Truck Solo max 26 tons | FOM | 0.0004 | %/year | Danish Energy Agency, inputs/data_sheets_for_commercial_freight_and_passenger_transport_0.xlsx | Diesel L1 | 2022.0
Diesel Truck Solo max 26 tons | Motor size | 254.1379 | kW | Danish Energy Agency, inputs/data_sheets_for_commercial_freight_and_passenger_transport_0.xlsx | Diesel L1 | 2022.0
Diesel Truck Solo max 26 tons | VOM | 0.1068 | EUR/km | Danish Energy Agency, inputs/data_sheets_for_commercial_freight_and_passenger_transport_0.xlsx | Diesel L1 | 2022.0
Diesel Truck Solo max 26 tons | efficiency | 2.1867 | kWh/km | Danish Energy Agency, inputs/data_sheets_for_commercial_freight_and_passenger_transport_0.xlsx | Diesel L1 | 2022.0
Diesel Truck Solo max 26 tons | investment | 155444.0931 | EUR/vehicle | Danish Energy Agency, inputs/data_sheets_for_commercial_freight_and_passenger_transport_0.xlsx | Diesel L1 | 2022.0
Diesel Truck Solo max 26 tons | lifetime | 13.8 | years | Danish Energy Agency, inputs/data_sheets_for_commercial_freight_and_passenger_transport_0.xlsx | Diesel L1 | 2022.0
Diesel Truck Trailer max 56 tons | FOM | 0.0004 | %/year | Danish Energy Agency, inputs/data_sheets_for_commercial_freight_and_passenger_transport_0.xlsx | Diesel L2 | 2022.0
Diesel Truck Trailer max 56 tons | Motor size | 382.3529 | kW | Danish Energy Agency, inputs/data_sheets_for_commercial_freight_and_passenger_transport_0.xlsx | Diesel L2 | 2022.0
Diesel Truck Trailer max 56 tons | VOM | 0.1068 | EUR/km | Danish Energy Agency, inputs/data_sheets_for_commercial_freight_and_passenger_transport_0.xlsx | Diesel L2 | 2022.0
Diesel Truck Trailer max 56 tons | efficiency | 3.3031 | kWh/km | Danish Energy Agency, inputs/data_sheets_for_commercial_freight_and_passenger_transport_0.xlsx | Diesel L2 | 2022.0
Diesel Truck Trailer max 56 tons | investment | 177515.1425 | EUR/vehicle | Danish Energy Agency, inputs/data_sheets_for_commercial_freight_and_passenger_transport_0.xlsx | Diesel L2 | 2022.0
Diesel Truck Trailer max 56 tons | lifetime | 13.8 | years | Danish Energy Agency, inputs/data_sheets_for_commercial_freight_and_passenger_transport_0.xlsx | Diesel L2 | 2022.0
FCV Bus city | FOM | 0.0002 | %/year | Danish Energy Agency, inputs/data_sheets_for_commercial_freight_and_passenger_transport_0.xlsx | FCV B1 | 2022.0
FCV Bus city | Motor size | 390.6897 | kW | Danish Energy Agency, inputs/data_sheets_for_commercial_freight_and_passenger_transport_0.xlsx | FCV B1 | 2022.0
FCV Bus city | VOM | 0.0979 | EUR/km | Danish Energy Agency, inputs/data_sheets_for_commercial_freight_and_passenger_transport_0.xlsx | FCV B1 | 2022.0
FCV Bus city | efficiency | 1.5899 | kWh/km | Danish Energy Agency, inputs/data_sheets_for_commercial_freight_and_passenger_transport_0.xlsx | FCV B1 | 2022.0
FCV Bus city | investment | 323056.5642 | EUR/vehicle | Danish Energy Agency, inputs/data_sheets_for_commercial_freight_and_passenger_transport_0.xlsx | FCV B1 | 2022.0
FCV Bus city | lifetime | 12.0 | years | Danish Energy Agency, inputs/data_sheets_for_commercial_freight_and_passenger_transport_0.xlsx | FCV B1 | 2022.0
FCV Coach | FOM | 0.0002 | %/year | Danish Energy Agency, inputs/data_sheets_for_commercial_freight_and_passenger_transport_0.xlsx | FCV B2 | 2022.0
FCV Coach | Motor size | 390.6897 | kW | Danish Energy Agency, inputs/data_sheets_for_commercial_freight_and_passenger_transport_0.xlsx | FCV B2 | 2022.0
FCV Coach | VOM | 0.0952 | EUR/km | Danish Energy Agency, inputs/data_sheets_for_commercial_freight_and_passenger_transport_0.xlsx | FCV B2 | 2022.0
FCV Coach | efficiency | 1.5761 | kWh/km | Danish Energy Agency, inputs/data_sheets_for_commercial_freight_and_passenger_transport_0.xlsx | FCV B2 | 2022.0
FCV Coach | investment | 356840.1722 | EUR/vehicle | Danish Energy Agency, inputs/data_sheets_for_commercial_freight_and_passenger_transport_0.xlsx | FCV B2 | 2022.0
FCV Coach | lifetime | 12.0 | years | Danish Energy Agency, inputs/data_sheets_for_commercial_freight_and_passenger_transport_0.xlsx | FCV B2 | 2022.0
FCV Truck Semi-Trailer max 50 tons | FOM | 0.0004 | %/year | Danish Energy Agency, inputs/data_sheets_for_commercial_freight_and_passenger_transport_0.xlsx | FCV L3 | 2022.0
FCV Truck Semi-Trailer max 50 tons | Motor size | 513.7931 | kW | Danish Energy Agency, inputs/data_sheets_for_commercial_freight_and_passenger_transport_0.xlsx | FCV L3 | 2022.0
FCV Truck Semi-Trailer max 50 tons | VOM | 0.0952 | EUR/km | Danish Energy Agency, inputs/data_sheets_for_commercial_freight_and_passenger_transport_0.xlsx | FCV L3 | 2022.0
FCV Truck Semi-Trailer max 50 tons | efficiency | 2.548 | kWh/km | Danish Energy Agency, inputs/data_sheets_for_commercial_freight_and_passenger_transport_0.xlsx | FCV L3 | 2022.0
FCV Truck Semi-Trailer max 50 tons | investment | 139809.9795 | EUR/vehicle | Danish Energy Agency, inputs/data_sheets_for_commercial_freight_and_passenger_transport_0.xlsx | FCV L3 | 2022.0
FCV Truck Semi-Trailer max 50 tons | lifetime | 10.5 | years | Danish Energy Agency, inputs/data_sheets_for_commercial_freight_and_passenger_transport_0.xlsx | FCV L3 | 2022.0
FCV Truck Solo max 26 tons | FOM | 0.0002 | %/year | Danish Energy Agency, inputs/data_sheets_for_commercial_freight_and_passenger_transport_0.xlsx | FCV L1 | 2022.0
FCV Truck Solo max 26 tons | Motor size | 381.0345 | kW | Danish Energy Agency, inputs/data_sheets_for_commercial_freight_and_passenger_transport_0.xlsx | FCV L1 | 2022.0
FCV Truck Solo max 26 tons | VOM | 0.0952 | EUR/km | Danish Energy Agency, inputs/data_sheets_for_commercial_freight_and_passenger_transport_0.xlsx | FCV L1 | 2022.0
FCV Truck Solo max 26 tons | efficiency | 1.7064 | kWh/km | Danish Energy Agency, inputs/data_sheets_for_commercial_freight_and_passenger_transport_0.xlsx | FCV L1 | 2022.0
FCV Truck Solo max 26 tons | investment | 255992.8427 | EUR/vehicle | Danish Energy Agency, inputs/data_sheets_for_commercial_freight_and_passenger_transport_0.xlsx | FCV L1 | 2022.0
FCV Truck Solo max 26 tons | lifetime | 13.8 | years | Danish Energy Agency, inputs/data_sheets_for_commercial_freight_and_passenger_transport_0.xlsx | FCV L1 | 2022.0
FCV Truck Trailer max 56 tons | FOM | 0.0002 | %/year | Danish Energy Agency, inputs/data_sheets_for_commercial_freight_and_passenger_transport_0.xlsx | FCV L2 | 2022.0
FCV Truck Trailer max 56 tons | Motor size | 381.0345 | kW | Danish Energy Agency, inputs/data_sheets_for_commercial_freight_and_passenger_transport_0.xlsx | FCV L2 | 2022.0
FCV Truck Trailer max 56 tons | VOM | 0.0952 | EUR/km | Danish Energy Agency, inputs/data_sheets_for_commercial_freight_and_passenger_transport_0.xlsx | FCV L2 | 2022.0
FCV Truck Trailer max 56 tons | efficiency | 2.8363 | kWh/km | Danish Energy Agency, inputs/data_sheets_for_commercial_freight_and_passenger_transport_0.xlsx | FCV L2 | 2022.0
FCV Truck Trailer max 56 tons | investment | 278063.892 | EUR/vehicle | Danish Energy Agency, inputs/data_sheets_for_commercial_freight_and_passenger_transport_0.xlsx | FCV L2 | 2022.0
FCV Truck Trailer max 56 tons | lifetime | 13.8 | years | Danish Energy Agency, inputs/data_sheets_for_commercial_freight_and_passenger_transport_0.xlsx | FCV L2 | 2022.0
FT fuel transport ship | FOM | 5.0 | %/year | Assume comparable tanker as for LOHC transport above, c.f. Runge et al 2020, Table 10, https://papers.ssrn.com/abstract=3623514 . | 0 | 2020.0
FT fuel transport ship | capacity | 75000.0 | t_FTfuel | Assume comparable tanker as for LOHC transport above, c.f. Runge et al 2020, Table 10, https://papers.ssrn.com/abstract=3623514 . | 0 | 2020.0
FT fuel transport ship | investment | 35000000.0 | EUR | Assume comparable tanker as for LOHC transport above, c.f. Runge et al 2020, Table 10, https://papers.ssrn.com/abstract=3623514 . | 0 | 2020.0
FT fuel transport ship | lifetime | 15.0 | years | Assume comparable tanker as for LOHC transport above, c.f. Runge et al 2020, Table 10, https://papers.ssrn.com/abstract=3623514 . | 0 | 2020.0
Fischer-Tropsch | FOM | 3.0 | %/year | Agora Energiewende (2018): The Future Cost of Electricity-Based Synthetic Fuels (https://www.agora-energiewende.de/en/publications/the-future-cost-of-electricity-based-synthetic-fuels-1/), section 6.3.2.1. | 0 | 2017.0
Fischer-Tropsch | VOM | 4.4663 | EUR/MWh_FT | Danish Energy Agency, inputs/data_sheets_for_renewable_fuels.xlsx | 102 Hydrogen to Jet: Variable O&M | 2020.0
Fischer-Tropsch | capture rate | 0.9 | per unit | Assumption based on doi:10.1016/j.biombioe.2015.01.006 | 0 | 0.0
Fischer-Tropsch | carbondioxide-input | 0.326 | t_CO2/MWh_FT | DEA (2022): Technology Data for Renewable Fuels (https://ens.dk/en/our-services/projections-and-models/technology-data/technology-data-renewable-fuels), Hydrogen to Jet Fuel, Table 10 / pg. 267. | Input per 1t FT liquid fuels output, carbon efficiency increases with years (4.3, 3.9, 3.6, 3.3 t_CO2/t_FT from 2020-2050 with LHV 11.95 MWh_th/t_FT). | 0.0
Fischer-Tropsch | efficiency | 0.799 | per unit | Agora Energiewende (2018): The Future Cost of Electricity-Based Synthetic Fuels (https://www.agora-energiewende.de/en/publications/the-future-cost-of-electricity-based-synthetic-fuels-1/), section 6.3.2.2. | 0 | 2017.0
Fischer-Tropsch | electricity-input | 0.007 | MWh_el/MWh_FT | DEA (2022): Technology Data for Renewable Fuels (https://ens.dk/en/our-services/projections-and-models/technology-data/technology-data-renewable-fuels), Hydrogen to Jet Fuel, Table 10 / pg. 267. | 0.005 MWh_el input per FT output, output increasing from 2020 to 2050 (0.65, 0.7, 0.73, 0.75 MWh liquid FT output). | 0.0
Fischer-Tropsch | hydrogen-input | 1.421 | MWh_H2/MWh_FT | DEA (2022): Technology Data for Renewable Fuels (https://ens.dk/en/our-services/projections-and-models/technology-data/technology-data-renewable-fuels), Hydrogen to Jet Fuel, Table 10 / pg. 267. | 0.995 MWh_H2 per output, output increasing from 2020 to 2050 (0.65, 0.7, 0.73, 0.75 MWh liquid FT output). | 0.0
Fischer-Tropsch | investment | 703726.4462 | EUR/MW_FT | Agora Energiewende (2018): The Future Cost of Electricity-Based Synthetic Fuels (https://www.agora-energiewende.de/en/publications/the-future-cost-of-electricity-based-synthetic-fuels-1/), table 8: “Reference scenario”. | Well developed technology, no significant learning expected. | 2017.0
Fischer-Tropsch | lifetime | 20.0 | years | Danish Energy Agency, Technology Data for Renewable Fuels (04/2022), Data sheet “Methanol to Power”. | 0 | 2017.0
Gasnetz | FOM | 2.5 | % | WEGE ZU EINEM KLIMANEUTRALEN ENERGIESYSEM, Anhang zur Studie, Fraunhofer-Institut für Solare Energiesysteme ISE, Freiburg | Gasnetz | 2020.0
Gasnetz | investment | 28.0 | EUR/kWGas | WEGE ZU EINEM KLIMANEUTRALEN ENERGIESYSEM, Anhang zur Studie, Fraunhofer-Institut für Solare Energiesysteme ISE, Freiburg | Gasnetz | 2020.0
Gasnetz | lifetime | 30.0 | years | WEGE ZU EINEM KLIMANEUTRALEN ENERGIESYSEM, Anhang zur Studie, Fraunhofer-Institut für Solare Energiesysteme ISE, Freiburg | Gasnetz | 2020.0
General liquid hydrocarbon storage (crude) | FOM | 6.25 | %/year | Stelter and Nishida 2013: https://webstore.iea.org/insights-series-2013-focus-on-energy-security , figure 7 and pg. 12 . | Assuming ca. 10 EUR/m^3/a (center value between stand alone and addon facility). | 2012.0
General liquid hydrocarbon storage (crude) | investment | 137.8999 | EUR/m^3 | Stelter and Nishida 2013: https://webstore.iea.org/insights-series-2013-focus-on-energy-security , pg. 8F . | Assumed 20% lower than for product storage. Crude or middle distillate tanks are usually larger compared to product storage due to lower requirements on safety and different construction method. Reference size used here: 80 000 – 120 000 m^3 . | 2012.0
General liquid hydrocarbon storage (crude) | lifetime | 30.0 | years | Stelter and Nishida 2013: https://webstore.iea.org/insights-series-2013-focus-on-energy-security , pg. 11. | 0 | 2012.0
General liquid hydrocarbon storage (product) | FOM | 6.25 | %/year | Stelter and Nishida 2013: https://webstore.iea.org/insights-series-2013-focus-on-energy-security , figure 7 and pg. 12 . | Assuming ca. 10 EUR/m^3/a (center value between stand alone and addon facility). | 2012.0
General liquid hydrocarbon storage (product) | investment | 172.3748 | EUR/m^3 | Stelter and Nishida 2013: https://webstore.iea.org/insights-series-2013-focus-on-energy-security , pg. 8F . | Assumed at the higher end for addon facilities/mid-range for stand-alone facilities. Product storage usually smaller due to higher requirements on safety and different construction method. Reference size used here: 40 000 - 60 000 m^3 . | 2012.0
General liquid hydrocarbon storage (product) | lifetime | 30.0 | years | Stelter and Nishida 2013: https://webstore.iea.org/insights-series-2013-focus-on-energy-security , pg. 11. | 0 | 2012.0
Gravity-Brick-bicharger | FOM | 1.5 | %/year | Viswanathan_2022, p.76 (p.98) Sentence 1 in 4.7.2 Operating Costs | {'carrier': ['elec', 'gravity', 'elec'], 'technology_type': ['bicharger'], 'type': ['mechanical'], 'note': ['1.5 percent of capital cost']} | 2020.0
Gravity-Brick-bicharger | efficiency | 0.9274 | per unit | Viswanathan_2022, p.77 (p.99) Table 4.36 | {'carrier': ['elec', 'gravity', 'elec'], 'technology_type': ['bicharger'], 'type': ['mechanical'], 'note': ['AC-AC efficiency at transformer level 0.86^0.5']} | 2020.0
Gravity-Brick-bicharger | investment | 415570.5177 | EUR/MW | Viswanathan_2022, p.71 (p.94) text at the bottom speaks about 0% cost reduction for 2030 compared to 2021 | {'carrier': ['elec', 'gravity', 'elec'], 'technology_type': ['bicharger'], 'type': ['mechanical'], 'note': ['Power Equipment']} | 2020.0
Gravity-Brick-bicharger | lifetime | 41.7 | years | Viswanathan_2022, p.77 (p.99) Table 4.36 | {'carrier': ['elec', 'gravity', 'elec'], 'technology_type': ['bicharger'], 'type': ['mechanical'], 'note': ['NULL']} | 2020.0
Gravity-Brick-store | investment | 157381.7274 | EUR/MWh | Viswanathan_2022, p.71 (p.94) text at the bottom speaks about 15% cost reduction for 2030 compared to 2021 | {'carrier': ['gravity'], 'technology_type': ['store'], 'type': ['mechanical'], 'note': ['Gravitational Capital (SB+BOS)']} | 2020.0
Gravity-Brick-store | lifetime | 41.7 | years | Viswanathan_2022, p.77 (p.99) Table 4.36 | {'carrier': ['gravity'], 'technology_type': ['store'], 'type': ['mechanical'], 'note': ['NULL']} | 2020.0
Gravity-Water-Aboveground-bicharger | FOM | 1.5 | %/year | Viswanathan_2022, p.76 (p.98) Sentence 1 in 4.7.2 Operating Costs | {'carrier': ['elec', 'gravitywa', 'elec'], 'technology_type': ['bicharger'], 'type': ['mechanical'], 'note': ['1.5 percent of capital cost']} | 2020.0
Gravity-Water-Aboveground-bicharger | efficiency | 0.9014 | per unit | Viswanathan_2022, p.77 (p.99) Table 4.37 | {'carrier': ['elec', 'gravitywa', 'elec'], 'technology_type': ['bicharger'], 'type': ['mechanical'], 'note': ['AC-AC efficiency at transformer level ((0.785+0.84)/2)^0.5']} | 2020.0
Gravity-Water-Aboveground-bicharger | investment | 365630.713 | EUR/MW | Viswanathan_2022, p.71 (p.94) text at the bottom speaks about 0% cost reduction for 2030 compared to 2021 | {'carrier': ['elec', 'gravitywa', 'elec'], 'technology_type': ['bicharger'], 'type': ['mechanical'], 'note': ['Power Equipment']} | 2020.0
Gravity-Water-Aboveground-bicharger | lifetime | 60.0 | years | Viswanathan_2022, p.77 (p.99) Table 4.37 | {'carrier': ['elec', 'gravitywa', 'elec'], 'technology_type': ['bicharger'], 'type': ['mechanical'], 'note': ['NULL']} | 2020.0
Gravity-Water-Aboveground-store | investment | 121755.0274 | EUR/MWh | Viswanathan_2022, p.71 (p.94) text at the bottom speaks about 15% cost reduction for 2030 compared to 2021 | {'carrier': ['gravitywa'], 'technology_type': ['store'], 'type': ['mechanical'], 'note': ['Gravitational Capital (SB+BOS)']} | 2020.0
Gravity-Water-Aboveground-store | lifetime | 60.0 | years | Viswanathan_2022, p.77 (p.99) Table 4.37 | {'carrier': ['gravitywa'], 'technology_type': ['store'], 'type': ['mechanical'], 'note': ['NULL']} | 2020.0
Gravity-Water-Underground-bicharger | FOM | 1.5 | %/year | Viswanathan_2022, p.76 (p.98) Sentence 1 in 4.7.2 Operating Costs | {'carrier': ['elec', 'gravitywu', 'elec'], 'technology_type': ['bicharger'], 'type': ['mechanical'], 'note': ['1.5 percent of capital cost']} | 2020.0
Gravity-Water-Underground-bicharger | efficiency | 0.9014 | per unit | Viswanathan_2022, p.77 (p.99) Table 4.37 | {'carrier': ['elec', 'gravitywu', 'elec'], 'technology_type': ['bicharger'], 'type': ['mechanical'], 'note': ['AC-AC efficiency at transformer level ((0.785+0.84)/2)^0.5']} | 2020.0
Gravity-Water-Underground-bicharger | investment | 905158.9602 | EUR/MW | Viswanathan_2022, p.71 (p.94) text at the bottom speaks about 0% cost reduction for 2030 compared to 2021 | {'carrier': ['elec', 'gravitywu', 'elec'], 'technology_type': ['bicharger'], 'type': ['mechanical'], 'note': ['Power Equipment']} | 2020.0
Gravity-Water-Underground-bicharger | lifetime | 60.0 | years | Viswanathan_2022, p.77 (p.99) Table 4.37 | {'carrier': ['elec', 'gravitywu', 'elec'], 'technology_type': ['bicharger'], 'type': ['mechanical'], 'note': ['NULL']} | 2020.0
Gravity-Water-Underground-store | investment | 95982.5211 | EUR/MWh | Viswanathan_2022, p.71 (p.94) text at the bottom speaks about 15% cost reduction for 2030 compared to 2021 | {'carrier': ['gravitywu'], 'technology_type': ['store'], 'type': ['mechanical'], 'note': ['Gravitational Capital (SB+BOS)']} | 2020.0
Gravity-Water-Underground-store | lifetime | 60.0 | years | Viswanathan_2022, p.77 (p.99) Table 4.37 | {'carrier': ['gravitywu'], 'technology_type': ['store'], 'type': ['mechanical'], 'note': ['NULL']} | 2020.0
H2 (g) fill compressor station | FOM | 1.7 | %/year | Guidehouse 2020: European Hydrogen Backbone report, https://guidehouse.com/-/media/www/site/downloads/energy/2020/gh_european-hydrogen-backbone_report.pdf (table 3, table 5) | Pessimistic (highest) value chosen for 48'' pipeline w/ 13GW_H2 LHV @ 100bar pressure. Currency year: Not clearly specified, assuming year of publication. Forecast year: Not clearly specified, guessing based on text remarks. | 2020.0
H2 (g) fill compressor station | investment | 4738.7164 | EUR/MW_H2 | Danish Energy Agency, Technology Data for Energy Transport (2021), pg. 164, Figure 14 (Fill compressor). | Assumption for staging 35→140bar, 6000 MW_HHV single line pipeline. Considering HHV/LHV ration for H2. | 2015.0
H2 (g) fill compressor station | lifetime | 20.0 | years | Danish Energy Agency, Technology Data for Energy Transport (2021), pg. 168, Figure 24 (Fill compressor). | 0 | 2015.0
H2 (g) pipeline | FOM | 3.1667 | %/year | Danish Energy Agency, Technology Data for Energy Transport (2021), Excel datasheet: H2 140. | Assumption for a 140 bar, > 6000 MW_HHV single line pipeline, incl. booster station investments. Considering LHV by scaling with LHV/HHV=0.8462623413. | 2015.0
H2 (g) pipeline | electricity-input | 0.019 | MW_e/1000km/MW_H2 | Danish Energy Agency, Technology Data for Energy Transport (2021), Excel datasheet: H2 140. | Assumption for a 140 bar, 5-20 GW pipeline. Electric compression. | 2015.0
H2 (g) pipeline | investment | 303.6845 | EUR/MW/km | European Hydrogen Backbone Report (June 2021): https://gasforclimate2050.eu/wp-content/uploads/2021/06/EHB_Analysing-the-future-demand-supply-and-transport-of-hydrogen_June-2021.pdf Table 35. Implementation roadmap - Cross border projects and costs updates: https://ehb.eu/files/downloads/EHB-2023-20-Nov-FINAL-design.pdf Table 1 | Assumption for a 48 inch single line pipeline, incl. compressor investments, 16.9 GW (LHV) peak capacity (source 2), 4.4 MEUR/km base cost with additional investment for compressors of capacity 434 MWe/1000 km (source 1), at 4 MEUR/MWe for compressor (source 2) | 2023.0
H2 (g) pipeline | lifetime | 50.0 | years | Danish Energy Agency, Technology Data for Energy Transport (2021), Excel datasheet: H2 140. | Assumption for a 140 bar, > 6000 MW_HHV single line pipeline, incl. booster station investments. Considering LHV by scaling with LHV/HHV=0.8462623413. | 2015.0
H2 (g) pipeline repurposed | FOM | 3.1667 | %/year | Danish Energy Agency, Technology Data for Energy Transport (2021), Excel datasheet: H2 140. | Same as for new H2 (g) pipeline. | 2015.0
H2 (g) pipeline repurposed | electricity-input | 0.019 | MW_e/1000km/MW_H2 | Danish Energy Agency, Technology Data for Energy Transport (2021), Excel datasheet: H2 140. | Assumption for a 140 bar, 5-20 GW pipeline. Electric compression. | 2015.0
H2 (g) pipeline repurposed | investment | 129.4682 | EUR/MW/km | European Hydrogen Backbone Report (June 2021): https://gasforclimate2050.eu/wp-content/uploads/2021/06/EHB_Analysing-the-future-demand-supply-and-transport-of-hydrogen_June-2021.pdf Table 35. Implementation roadmap - Cross border projects and costs updates: https://ehb.eu/files/downloads/EHB-2023-20-Nov-FINAL-design.pdf Table 1 | Assumption for a 48 inch single line repurposed pipeline, incl. compressor investments, 16.9 GW (LHV) peak capacity (source 2), 0.8 MEUR/km base cost with additional investment for compressors of capacity 434 MWe/1000 km (source 1), at 4 MEUR/MWe for compressor (source 2) | 2023.0
H2 (g) pipeline repurposed | lifetime | 50.0 | years | Danish Energy Agency, Technology Data for Energy Transport (2021), Excel datasheet: H2 140. | Same as for new H2 (g) pipeline. | 2015.0
H2 (g) submarine pipeline | FOM | 3.0 | %/year | Assume same as for CH4 (g) submarine pipeline. | - | 2015.0
H2 (g) submarine pipeline | electricity-input | 0.019 | MW_e/1000km/MW_H2 | Danish Energy Agency, Technology Data for Energy Transport (2021), Excel datasheet: H2 140. | Assumption for a 140 bar, 5-20 GW pipeline. Electric compression. | 2015.0
H2 (g) submarine pipeline | investment | 456.1165 | EUR/MW/km | European Hydrogen Backbone Report (June 2021): https://gasforclimate2050.eu/wp-content/uploads/2021/06/EHB_Analysing-the-future-demand-supply-and-transport-of-hydrogen_June-2021.pdf Table 35. Implementation roadmap - Cross border projects and costs updates: https://ehb.eu/files/downloads/EHB-2023-20-Nov-FINAL-design.pdf Table 1 | Assumption for a 48 inch single line offshore pipeline, incl. compressor investments, 16.9 GW (LHV) peak capacity (source 2), 7.48 MEUR/km base cost with additional investment for compressors of capacity 434 MWe/1000 km (source 1), at 4 MEUR/MWe for compressor (source 2) | 2023.0
H2 (g) submarine pipeline | lifetime | 30.0 | years | Assume same as for CH4 (g) submarine pipeline. | - | 2015.0
H2 (g) submarine pipeline repurposed | FOM | 3.0 | %/year | Assume same as for CH4 (g) submarine pipeline. | - | 2015.0
H2 (g) submarine pipeline repurposed | electricity-input | 0.019 | MW_e/1000km/MW_H2 | Danish Energy Agency, Technology Data for Energy Transport (2021), Excel datasheet: H2 140. | Assumption for a 140 bar, 5-20 GW pipeline. Electric compression. | 2015.0
H2 (g) submarine pipeline repurposed | investment | 160.1562 | EUR/MW/km | European Hydrogen Backbone Report (June 2021): https://gasforclimate2050.eu/wp-content/uploads/2021/06/EHB_Analysing-the-future-demand-supply-and-transport-of-hydrogen_June-2021.pdf Table 35. Implementation roadmap - Cross border projects and costs updates: https://ehb.eu/files/downloads/EHB-2023-20-Nov-FINAL-design.pdf Table 1 | Assumption for a 48 inch single line repurposed offshore pipeline, incl. compressor investments, 16.9 GW (LHV) peak capacity (source 2), 1.5 MEUR/km base cost with additional investment for compressors of capacity 434 MWe/1000 km (source 1), at 4 MEUR/MWe for compressor (source 2) | 2023.0
H2 (g) submarine pipeline repurposed | lifetime | 30.0 | years | Assume same as for CH4 (g) submarine pipeline. | - | 2015.0
H2 (l) storage tank | FOM | 2.0 | %/year | Reuß et al 2017, https://doi.org/10.1016/j.apenergy.2017.05.050 , Table 6. | Assuming currency year and technology year here (25 EUR/kg). | 2015.0
H2 (l) storage tank | investment | 793.7456 | EUR/MWh_H2 | Reuß et al 2017, https://doi.org/10.1016/j.apenergy.2017.05.050 , Table 6. | Assuming currency year and technology year here (25 EUR/kg). Future target cost. Today’s cost potentially higher according to d’Amore-Domenech et al (2021): 10.1016/j.apenergy.2021.116625 , supplementary material pg. 16. | 2015.0
H2 (l) storage tank | lifetime | 20.0 | years | Reuß et al 2017, https://doi.org/10.1016/j.apenergy.2017.05.050 , Table 6. | Assuming currency year and technology year here (25 EUR/kg). | 2015.0
H2 (l) transport ship | FOM | 4.0 | %/year | Cihlar et al 2020: http://op.europa.eu/en/publication-detail/-/publication/7e4afa7d-d077-11ea-adf7-01aa75ed71a1/language-en , Table 3-B, based on IEA 2019. | 0 | 2019.0
H2 (l) transport ship | capacity | 11000.0 | t_H2 | Cihlar et al 2020: http://op.europa.eu/en/publication-detail/-/publication/7e4afa7d-d077-11ea-adf7-01aa75ed71a1/language-en , Table 3-B, based on IEA 2019. | 0 | 2019.0
H2 (l) transport ship | investment | 393737000.0 | EUR | Cihlar et al 2020: http://op.europa.eu/en/publication-detail/-/publication/7e4afa7d-d077-11ea-adf7-01aa75ed71a1/language-en , Table 3-B, based on IEA 2019. | 0 | 2019.0
H2 (l) transport ship | lifetime | 20.0 | years | Cihlar et al 2020: http://op.europa.eu/en/publication-detail/-/publication/7e4afa7d-d077-11ea-adf7-01aa75ed71a1/language-en , Table 3-B, based on IEA 2019. | 0 | 2019.0
H2 evaporation | FOM | 2.5 | %/year | DNV GL (2020): Study on the Import of Liquid Renewable Energy: Technology Cost Assessment, https://www.gie.eu/wp-content/uploads/filr/2598/DNV-GL_Study-GLE-Technologies-and-costs-analysis-on-imports-of-liquid-renewable-energy.pdf . | 0 | 2020.0
H2 evaporation | investment | 146.8405 | EUR/kW_H2 | IRENA (2022): Global Hydrogen Trade to Meet the 1.5° Climate Goal: Technology Review of Hydrogen Carriers, https://www.irena.org/publications/2022/Apr/Global-hydrogen-trade-Part-II , pg. 62f. | Pessimistic assumption for large scale facility / near-term estimate for medium sized facility, in between low / mid estimate with e.g. DNV numbers (Fig. 3.15).; and Optimistic assumption for large scale facility 2500 t/d, cf Fig. 3.15 . | 2022.0
H2 evaporation | lifetime | 20.0 | years | Guesstimate. | Based on lifetime of liquefaction plant. | 2015.0
H2 liquefaction | FOM | 2.5 | %/year | DNV GL (2020): Study on the Import of Liquid Renewable Energy: Technology Cost Assessment, https://www.gie.eu/wp-content/uploads/filr/2598/DNV-GL_Study-GLE-Technologies-and-costs-analysis-on-imports-of-liquid-renewable-energy.pdf . | 0 | 2020.0
H2 liquefaction | electricity-input | 0.203 | MWh_el/MWh_H2 | Heuser et al. (2019): Techno-economic analysis of a potential energy trading link between Patagonia and Japan based on CO2 free hydrogen (https://doi.org/10.1016/j.ijhydene.2018.12.156), table 1. | 6.78 kWh/kg_H2, considering H2 with LHV of 33.3333 MWh/t | 0.0
H2 liquefaction | hydrogen-input | 1.017 | MWh_H2/MWh_H2 | Heuser et al. (2019): Techno-economic analysis of a potential energy trading link between Patagonia and Japan based on CO2 free hydrogen (https://doi.org/10.1016/j.ijhydene.2018.12.156), table 1. | corresponding to 1.65% losses during liquefaction | 0.0
H2 liquefaction | investment | 889.9426 | EUR/kW_H2 | IRENA (2022): Global Hydrogen Trade to Meet the 1.5° Climate Goal: Technology Review of Hydrogen Carriers, https://www.irena.org/publications/2022/Apr/Global-hydrogen-trade-Part-II , pg. 62f. | Assumption for a 200t/d facility (Pessimistic long-term or optimistic short-term value).; and Assumption for a large >300t/d, e.g. 2500 t/d facility (Optimistic long-term value without change in base technology mentioned in report). | 2022.0
H2 liquefaction | lifetime | 20.0 | years | Reuß et al 2017, https://doi.org/10.1016/j.apenergy.2017.05.050 , Table 9. | 0 | 2022.0
H2 pipeline | FOM | 3.0 | %/year | TODO | from old pypsa cost assumptions | 2015.0
H2 pipeline | investment | 282.5452 | EUR/MW/km | Welder et al https://doi.org/10.1016/j.energy.2018.05.059 | from old pypsa cost assumptions | 2015.0
H2 pipeline | lifetime | 40.0 | years | TODO | from old pypsa cost assumptions | 2015.0
H2 production biomass gasification | FOM | 5.0 | %/year | JRC, 01_JRC-EU-TIMES Full model, https://zenodo.org/records/3544900, file `SubRES_15_TECHS_HYDROGEN.xlsx` (SBIOH2GC01, H2 Production-Biomass Gasification, medium size, centralized) and currency year from file `SubRES_15_TECHS_HYDROGEN.xlsx`, Sheet `INPUT-Data(HP)` | 0 | 2010.0
H2 production biomass gasification | VOM | 0.5118 | EUR/MWh_H2 | JRC, 01_JRC-EU-TIMES Full model, https://zenodo.org/records/3544900, file `SubRES_15_TECHS_HYDROGEN.xlsx` (SBIOH2GC01, H2 Production-Biomass Gasification, medium size, centralized) and currency year from file `SubRES_15_TECHS_HYDROGEN.xlsx`, Sheet `INPUT-Data(HP)` | 0 | 2010.0
H2 production biomass gasification | electricity-input | 0.097 | MWh_el/MWh_H2 | JRC, 01_JRC-EU-TIMES Full model, https://zenodo.org/records/3544900, file `SubRES_15_TECHS_HYDROGEN.xlsx` (SBIOH2GC01, H2 Production-Biomass Gasification, medium size, centralized) and currency year from file `SubRES_15_TECHS_HYDROGEN.xlsx`, Sheet `INPUT-Data(HP)` | 0 | 0.0
H2 production biomass gasification | investment | 1467.9399 | EUR/kW | JRC, 01_JRC-EU-TIMES Full model, https://zenodo.org/records/3544900, file `SubRES_15_TECHS_HYDROGEN.xlsx` (SBIOH2GC01, H2 Production-Biomass Gasification, medium size, centralized) and currency year from file `SubRES_15_TECHS_HYDROGEN.xlsx`, Sheet `INPUT-Data(HP)` | 0 | 2010.0
H2 production biomass gasification | lifetime | 20.0 | years | JRC, 01_JRC-EU-TIMES Full model, https://zenodo.org/records/3544900, file `SubRES_15_TECHS_HYDROGEN.xlsx` (SBIOH2GC01, H2 Production-Biomass Gasification, medium size, centralized) and currency year from file `SubRES_15_TECHS_HYDROGEN.xlsx`, Sheet `INPUT-Data(HP)` | 0 | 0.0
H2 production biomass gasification | wood-input | 1.804 | MWh_wood/MWh_H2 | JRC, 01_JRC-EU-TIMES Full model, https://zenodo.org/records/3544900, file `SubRES_15_TECHS_HYDROGEN.xlsx` (SBIOH2GC01, H2 Production-Biomass Gasification, medium size, centralized) and currency year from file `SubRES_15_TECHS_HYDROGEN.xlsx`, Sheet `INPUT-Data(HP)` | 0 | 0.0
H2 production biomass gasification CC | FOM | 5.0 | %/year | JRC, 01_JRC-EU-TIMES Full model, https://zenodo.org/records/3544900, file `SubRES_15_TECHS_HYDROGEN.xlsx` (SBIOH2GCC01, H2 Production-Biomass Gasification + Carbon Capture, medium size, centralized, medium size, centralized) and currency year from file `SubRES_15_TECHS_HYDROGEN.xlsx`, Sheet `INPUT-Data(HP)` | 0 | 2010.0
H2 production biomass gasification CC | VOM | 0.5232 | EUR/MWh_H2 | JRC, 01_JRC-EU-TIMES Full model, https://zenodo.org/records/3544900, file `SubRES_15_TECHS_HYDROGEN.xlsx` (SBIOH2GCC01, H2 Production-Biomass Gasification + Carbon Capture, medium size, centralized, medium size, centralized) and currency year from file file `SubRES_15_TECHS_HYDROGEN.xlsx`, Sheet `INPUT-Data(HP)` | 0 | 2010.0
H2 production biomass gasification CC | electricity-input | 0.143 | MWh_el/MWh_H2 | JRC, 01_JRC-EU-TIMES Full model, https://zenodo.org/records/3544900, file `SubRES_15_TECHS_HYDROGEN.xlsx` (SBIOH2GCC01, H2 Production-Biomass Gasification + Carbon Capture, medium size, centralized, medium size, centralized) and currency year from file `SubRES_15_TECHS_HYDROGEN.xlsx`, Sheet `INPUT-Data(HP)` | 0 | 0.0
H2 production biomass gasification CC | investment | 1489.0957 | EUR/kW | JRC, 01_JRC-EU-TIMES Full model, https://zenodo.org/records/3544900, file `SubRES_15_TECHS_HYDROGEN.xlsx` (SBIOH2GCC01, H2 Production-Biomass Gasification + Carbon Capture, medium size, centralized, medium size, centralized) and currency year from file `SubRES_15_TECHS_HYDROGEN.xlsx`, Sheet `INPUT-Data(HP)` | 0 | 2010.0
H2 production biomass gasification CC | lifetime | 20.0 | years | JRC, 01_JRC-EU-TIMES Full model, https://zenodo.org/records/3544900, file `SubRES_15_TECHS_HYDROGEN.xlsx` (SBIOH2GCC01, H2 Production-Biomass Gasification + Carbon Capture, medium size, centralized, medium size, centralized) and currency year from file `SubRES_15_TECHS_HYDROGEN.xlsx`, Sheet `INPUT-Data(HP)` | 0 | 0.0
H2 production biomass gasification CC | wood-input | 1.804 | MWh_wood/MWh_H2 | JRC, 01_JRC-EU-TIMES Full model, https://zenodo.org/records/3544900, file `SubRES_15_TECHS_HYDROGEN.xlsx` (SBIOH2GCC01, H2 Production-Biomass Gasification + Carbon Capture, medium size, centralized, medium size, centralized) and currency year from file `SubRES_15_TECHS_HYDROGEN.xlsx`, Sheet `INPUT-Data(HP)` | 0 | 0.0
H2 production coal gasification | FOM | 6.0 | %/year | JRC, 01_JRC-EU-TIMES Full model, https://zenodo.org/records/3544900, file `SubRES_15_TECHS_HYDROGEN.xlsx` (SCOAH2GC01, H2 Production-Coal Gasification, large size, centralized) and currency year from file `SubRES_15_TECHS_HYDROGEN.xlsx`, Sheet `INPUT-Data(HP)` | 0 | 2010.0
H2 production coal gasification | VOM | 0.5061 | EUR/MWh_H2 | JRC, 01_JRC-EU-TIMES Full model, https://zenodo.org/records/3544900, file `SubRES_15_TECHS_HYDROGEN.xlsx` (SCOAH2GC01, H2 Production-Coal Gasification, large size, centralized) and currency year from file `SubRES_15_TECHS_HYDROGEN.xlsx`, Sheet `INPUT-Data(HP)` | 0 | 2010.0
H2 production coal gasification | coal-input | 1.62 | MWh_coal/MWh_H2 | JRC, 01_JRC-EU-TIMES Full model, https://zenodo.org/records/3544900, file `SubRES_15_TECHS_HYDROGEN.xlsx` (SCOAH2GC01, H2 Production-Coal Gasification, large size, centralized) and currency year from file `SubRES_15_TECHS_HYDROGEN.xlsx`, Sheet `INPUT-Data(HP)` | 0 | 0.0
H2 production coal gasification | electricity-input | 0.02 | MWh_el/MWh_H2 | JRC, 01_JRC-EU-TIMES Full model, https://zenodo.org/records/3544900, file `SubRES_15_TECHS_HYDROGEN.xlsx` (SCOAH2GC01, H2 Production-Coal Gasification, large size, centralized) and currency year from file `SubRES_15_TECHS_HYDROGEN.xlsx`, Sheet `INPUT-Data(HP)` | 0 | 0.0
H2 production coal gasification | investment | 399.1168 | EUR/kW | JRC, 01_JRC-EU-TIMES Full model, https://zenodo.org/records/3544900, file `SubRES_15_TECHS_HYDROGEN.xlsx` (SCOAH2GC01, H2 Production-Coal Gasification, large size, centralized) and currency year from file `SubRES_15_TECHS_HYDROGEN.xlsx`, Sheet `INPUT-Data(HP)` | 0 | 2010.0
H2 production coal gasification | lifetime | 20.0 | years | JRC, 01_JRC-EU-TIMES Full model, https://zenodo.org/records/3544900, file `SubRES_15_TECHS_HYDROGEN.xlsx` (SCOAH2GC01, H2 Production-Coal Gasification, large size, centralized) and currency year from file `SubRES_15_TECHS_HYDROGEN.xlsx`, Sheet `INPUT-Data(HP)` | 0 | 0.0
H2 production coal gasification CC | FOM | 7.56 | %/year | JRC, 01_JRC-EU-TIMES Full model, https://zenodo.org/records/3544900, file `SubRES_15_TECHS_HYDROGEN.xlsx` (SCOAH2GCC01, H2 Production-Coal Gasification + Carbon Capture, big size, centralized and currency year from file `SubRES_15_TECHS_HYDROGEN.xlsx`, Sheet `INPUT-Data(HP)` | 0 | 2010.0
H2 production coal gasification CC | VOM | 0.1479 | EUR/MWh_H2 | JRC, 01_JRC-EU-TIMES Full model, https://zenodo.org/records/3544900, file `SubRES_15_TECHS_HYDROGEN.xlsx` (SCOAH2GCC01, H2 Production-Coal Gasification + Carbon Capture, big size, centralized and currency year from file `SubRES_15_TECHS_HYDROGEN.xlsx`, Sheet `INPUT-Data(HP)` | 0 | 2010.0
H2 production coal gasification CC | coal-input | 1.62 | MWh_coal/MWh_H2 | JRC, 01_JRC-EU-TIMES Full model, https://zenodo.org/records/3544900, file `SubRES_15_TECHS_HYDROGEN.xlsx` (SCOAH2GCC01, H2 Production-Coal Gasification + Carbon Capture, big size, centralized and currency year from file `SubRES_15_TECHS_HYDROGEN.xlsx`, Sheet `INPUT-Data(HP)` | 0 | 0.0
H2 production coal gasification CC | electricity-input | 0.023 | MWh_el/MWh_H2 | JRC, 01_JRC-EU-TIMES Full model, https://zenodo.org/records/3544900, file `SubRES_15_TECHS_HYDROGEN.xlsx` (SCOAH2GCC01, H2 Production-Coal Gasification + Carbon Capture, big size, centralized and currency year from file `SubRES_15_TECHS_HYDROGEN.xlsx`, Sheet `INPUT-Data(HP)` | 0 | 0.0
H2 production coal gasification CC | investment | 413.4481 | EUR/kW | JRC, 01_JRC-EU-TIMES Full model, https://zenodo.org/records/3544900, file `SubRES_15_TECHS_HYDROGEN.xlsx` (SCOAH2GCC01, H2 Production-Coal Gasification + Carbon Capture, big size, centralized and currency year from file `SubRES_15_TECHS_HYDROGEN.xlsx`, Sheet `INPUT-Data(HP)` | 0 | 2010.0
H2 production coal gasification CC | lifetime | 20.0 | years | JRC, 01_JRC-EU-TIMES Full model, https://zenodo.org/records/3544900, file `SubRES_15_TECHS_HYDROGEN.xlsx` (SCOAH2GCC01, H2 Production-Coal Gasification + Carbon Capture, big size, centralized and currency year from file `SubRES_15_TECHS_HYDROGEN.xlsx`, Sheet `INPUT-Data(HP)` | 0 | 0.0
H2 production heavy oil partial oxidation | FOM | 5.0 | %/year | JRC, 01_JRC-EU-TIMES Full model, https://zenodo.org/records/3544900, file `SubRES_15_TECHS_HYDROGEN.xlsx` (SHFOH2POC01, H2 Production-Central PO of Heavy Oil (CPO3)) and currency year from file `SubRES_15_TECHS_HYDROGEN.xlsx`, Sheet `INPUT-Data(HP)` | 0 | 2010.0
H2 production heavy oil partial oxidation | VOM | 0.1592 | EUR/MWh_H2 | JRC, 01_JRC-EU-TIMES Full model, https://zenodo.org/records/3544900, file `SubRES_15_TECHS_HYDROGEN.xlsx` (SHFOH2POC01, H2 Production-Central PO of Heavy Oil (CPO3)) and currency year from file `SubRES_15_TECHS_HYDROGEN.xlsx`, Sheet `INPUT-Data(HP)` | 0 | 2010.0
H2 production heavy oil partial oxidation | electricity-input | 0.063 | MWh_el/MWh_H2 | JRC, 01_JRC-EU-TIMES Full model, https://zenodo.org/records/3544900, file `SubRES_15_TECHS_HYDROGEN.xlsx` (SHFOH2POC01, H2 Production-Central PO of Heavy Oil (CPO3)) and currency year from file `SubRES_15_TECHS_HYDROGEN.xlsx`, Sheet `INPUT-Data(HP)` | 0 | 0.0
H2 production heavy oil partial oxidation | investment | 491.1331 | EUR/kW | JRC, 01_JRC-EU-TIMES Full model, https://zenodo.org/records/3544900, file `SubRES_15_TECHS_HYDROGEN.xlsx` (SHFOH2POC01, H2 Production-Central PO of Heavy Oil (CPO3)) and currency year from file `SubRES_15_TECHS_HYDROGEN.xlsx`, Sheet `INPUT-Data(HP)` | 0 | 2010.0
H2 production heavy oil partial oxidation | lifetime | 25.0 | years | JRC, 01_JRC-EU-TIMES Full model, https://zenodo.org/records/3544900, file `SubRES_15_TECHS_HYDROGEN.xlsx` (SHFOH2POC01, H2 Production-Central PO of Heavy Oil (CPO3)) and currency year from file `SubRES_15_TECHS_HYDROGEN.xlsx`, Sheet `INPUT-Data(HP)` | 0 | 0.0
H2 production heavy oil partial oxidation | oil-input | 1.3 | MWh_oil/MWh_H2 | JRC, 01_JRC-EU-TIMES Full model, https://zenodo.org/records/3544900, file `SubRES_15_TECHS_HYDROGEN.xlsx` (SHFOH2POC01, H2 Production-Central PO of Heavy Oil (CPO3)) and currency year from file `SubRES_15_TECHS_HYDROGEN.xlsx`, Sheet `INPUT-Data(HP)` | 0 | 0.0
H2 production natural gas steam reforming | FOM | 4.9 | %/year | JRC, 01_JRC-EU-TIMES Full model, https://zenodo.org/records/3544900, file `SubRES_15_TECHS_HYDROGEN.xlsx` (SGASH2RC01, H2 Production-Methane Steam Reforming, large size, centralized) and currency year from file `SubRES_15_TECHS_HYDROGEN.xlsx`, Sheet `INPUT-Data(HP)` | 0 | 2010.0
H2 production natural gas steam reforming | VOM | 0.2047 | EUR/kW | JRC, 01_JRC-EU-TIMES Full model, https://zenodo.org/records/3544900, file `SubRES_15_TECHS_HYDROGEN.xlsx` (SGASH2RC01, H2 Production-Methane Steam Reforming, large size, centralized) and currency year from file `SubRES_15_TECHS_HYDROGEN.xlsx`, Sheet `INPUT-Data(HP)` | 0 | 2010.0
H2 production natural gas steam reforming | electricity-input | 0.02 | MWh_el/MWh_H2 | JRC, 01_JRC-EU-TIMES Full model, https://zenodo.org/records/3544900, file `SubRES_15_TECHS_HYDROGEN.xlsx` (SGASH2RC01, H2 Production-Methane Steam Reforming, large size, centralized) and currency year from file `SubRES_15_TECHS_HYDROGEN.xlsx`, Sheet `INPUT-Data(HP)` | 0 | 0.0
H2 production natural gas steam reforming | gas-input | 1.25 | MWh_NG/MWh_H2 | JRC, 01_JRC-EU-TIMES Full model, https://zenodo.org/records/3544900, file `SubRES_15_TECHS_HYDROGEN.xlsx` (SGASH2RC01, H2 Production-Methane Steam Reforming, large size, centralized) and currency year from file `SubRES_15_TECHS_HYDROGEN.xlsx`, Sheet `INPUT-Data(HP)` | 0 | 0.0
H2 production natural gas steam reforming | investment | 180.0518 | EUR/kW | JRC, 01_JRC-EU-TIMES Full model, https://zenodo.org/records/3544900, file `SubRES_15_TECHS_HYDROGEN.xlsx` (SGASH2RC01, H2 Production-Methane Steam Reforming, large size, centralized) and currency year from file `SubRES_15_TECHS_HYDROGEN.xlsx`, Sheet `INPUT-Data(HP)` | 0 | 2010.0
H2 production natural gas steam reforming | lifetime | 20.0 | years | JRC, 01_JRC-EU-TIMES Full model, https://zenodo.org/records/3544900, file `SubRES_15_TECHS_HYDROGEN.xlsx` (SGASH2RC01, H2 Production-Methane Steam Reforming, large size, centralized) and currency year from file `SubRES_15_TECHS_HYDROGEN.xlsx`, Sheet `INPUT-Data(HP)` | 0 | 0.0
H2 production natural gas steam reforming CC | FOM | 6.0 | %/year | JRC, 01_JRC-EU-TIMES Full model, https://zenodo.org/records/3544900, file `SubRES_15_TECHS_HYDROGEN.xlsx` (SGASH2RCC01, H2 Production-Methane Steam Reforming + Carbon Capture, large size, centralized) and currency year from file `SubRES_15_TECHS_HYDROGEN.xlsx`, Sheet `INPUT-Data(HP)` | 0 | 2010.0
H2 production natural gas steam reforming CC | VOM | 0.0796 | EUR/kW | JRC, 01_JRC-EU-TIMES Full model, https://zenodo.org/records/3544900, file `SubRES_15_TECHS_HYDROGEN.xlsx` (SGASH2RCC01, H2 Production-Methane Steam Reforming + Carbon Capture, large size, centralized) and currency year from file `SubRES_15_TECHS_HYDROGEN.xlsx`, Sheet `INPUT-Data(HP)` | 0 | 2010.0
H2 production natural gas steam reforming CC | electricity-input | 0.039 | MWh_el/MWh_H2 | JRC, 01_JRC-EU-TIMES Full model, https://zenodo.org/records/3544900, file `SubRES_15_TECHS_HYDROGEN.xlsx` (SGASH2RCC01, H2 Production-Methane Steam Reforming + Carbon Capture, large size, centralized) and currency year from file `SubRES_15_TECHS_HYDROGEN.xlsx`, Sheet `INPUT-Data(HP)` | 0 | 0.0
H2 production natural gas steam reforming CC | gas-input | 1.4 | MWh_NG/MWh_H2 | JRC, 01_JRC-EU-TIMES Full model, https://zenodo.org/records/3544900, file `SubRES_15_TECHS_HYDROGEN.xlsx` (SGASH2RCC01, H2 Production-Methane Steam Reforming + Carbon Capture, large size, centralized) and currency year from file `SubRES_15_TECHS_HYDROGEN.xlsx`, Sheet `INPUT-Data(HP)` | 0 | 0.0
H2 production natural gas steam reforming CC | investment | 217.5863 | EUR/kW | JRC, 01_JRC-EU-TIMES Full model, https://zenodo.org/records/3544900, file `SubRES_15_TECHS_HYDROGEN.xlsx` (SGASH2RCC01, H2 Production-Methane Steam Reforming + Carbon Capture, large size, centralized) and currency year from file `SubRES_15_TECHS_HYDROGEN.xlsx`, Sheet `INPUT-Data(HP)` | 0 | 2010.0
H2 production natural gas steam reforming CC | lifetime | 20.0 | years | JRC, 01_JRC-EU-TIMES Full model, https://zenodo.org/records/3544900, file `SubRES_15_TECHS_HYDROGEN.xlsx` (SGASH2RCC01, H2 Production-Methane Steam Reforming + Carbon Capture, large size, centralized) and currency year from file `SubRES_15_TECHS_HYDROGEN.xlsx`, Sheet `INPUT-Data(HP)` | 0 | 0.0
H2 production solid biomass steam reforming | FOM | 4.0 | %/year | JRC, 01_JRC-EU-TIMES Full model, https://zenodo.org/records/3544900, file `SubRES_15_TECHS_HYDROGEN.xlsx` (SBIOH2RC01, H2 Production-Biomass Steam Reforming, centralized) and currency year from file `SubRES_15_TECHS_HYDROGEN.xlsx`, Sheet `INPUT-Data(HP)` | 0 | 2010.0
H2 production solid biomass steam reforming | VOM | 0.7393 | EUR/MWh | JRC, 01_JRC-EU-TIMES Full model, https://zenodo.org/records/3544900, file `SubRES_15_TECHS_HYDROGEN.xlsx` (SBIOH2RC01, H2 Production-Biomass Steam Reforming, centralized) and currency year from file `SubRES_15_TECHS_HYDROGEN.xlsx`, Sheet `INPUT-Data(HP)` | 0 | 2010.0
H2 production solid biomass steam reforming | electricity-input | 0.044 | MWh_el/MWh_H2 | JRC, 01_JRC-EU-TIMES Full model, https://zenodo.org/records/3544900, file `SubRES_15_TECHS_HYDROGEN.xlsx` (SBIOH2RC01, H2 Production-Biomass Steam Reforming, centralized) and currency year from file `SubRES_15_TECHS_HYDROGEN.xlsx`, Sheet `INPUT-Data(HP)` | 0 | 0.0
H2 production solid biomass steam reforming | investment | 590.6564 | EUR/kW | JRC, 01_JRC-EU-TIMES Full model, https://zenodo.org/records/3544900, file `SubRES_15_TECHS_HYDROGEN.xlsx` (SBIOH2RC01, H2 Production-Biomass Steam Reforming, centralized) and currency year from file `SubRES_15_TECHS_HYDROGEN.xlsx`, Sheet `INPUT-Data(HP)` | 0 | 2010.0
H2 production solid biomass steam reforming | lifetime | 20.0 | years | JRC, 01_JRC-EU-TIMES Full model, https://zenodo.org/records/3544900, file `SubRES_15_TECHS_HYDROGEN.xlsx` (SBIOH2RC01, H2 Production-Biomass Steam Reforming, centralized) and currency year from file `SubRES_15_TECHS_HYDROGEN.xlsx`, Sheet `INPUT-Data(HP)` | 0 | 0.0
H2 production solid biomass steam reforming | wood-input | 1.36 | MWh_wood/MWh_H2 | JRC, 01_JRC-EU-TIMES Full model, https://zenodo.org/records/3544900, file `SubRES_15_TECHS_HYDROGEN.xlsx` (SBIOH2RC01, H2 Production-Biomass Steam Reforming, centralized) and currency year from file `SubRES_15_TECHS_HYDROGEN.xlsx`, Sheet `INPUT-Data(HP)` | 0 | 0.0
HVAC overhead | FOM | 2.0 | %/year | Hagspiel et al. (2014): doi:10.1016/j.energy.2014.01.025 , table A.2 . | 0 | 2011.0
HVAC overhead | investment | 442.1414 | EUR/MW/km | Hagspiel et al. (2014): doi:10.1016/j.energy.2014.01.025 , table A.2 . | 0 | 2011.0
HVAC overhead | lifetime | 40.0 | years | Hagspiel et al. (2014): doi:10.1016/j.energy.2014.01.025 , table A.2 . | 0 | 2011.0
HVDC inverter pair | FOM | 2.0 | %/year | Hagspiel et al. (2014): doi:10.1016/j.energy.2014.01.025 , table A.2 . | 0 | 2011.0
HVDC inverter pair | investment | 165803.0398 | EUR/MW | Hagspiel et al. (2014): doi:10.1016/j.energy.2014.01.025 , table A.2 . | 0 | 2011.0
HVDC inverter pair | lifetime | 40.0 | years | Hagspiel et al. (2014): doi:10.1016/j.energy.2014.01.025 , table A.2 . | 0 | 2011.0
HVDC overhead | FOM | 2.0 | %/year | Hagspiel et al. (2014): doi:10.1016/j.energy.2014.01.025 , table A.2 . | 0 | 2011.0
HVDC overhead | investment | 442.1414 | EUR/MW/km | Hagspiel et al. (2014): doi:10.1016/j.energy.2014.01.025 , table A.2 . | 0 | 2011.0
HVDC overhead | lifetime | 40.0 | years | Hagspiel et al. (2014): doi:10.1016/j.energy.2014.01.025 , table A.2 . | 0 | 2011.0
HVDC submarine | FOM | 0.35 | %/year | Purvins et al. (2018): https://doi.org/10.1016/j.jclepro.2018.03.095 . | Based on estimated costs for a NA-EU connector (bidirectional,4 GW, 3000km length and ca. 3000m depth). Costs in return based on existing/currently under construction undersea cables. | 2018.0
HVDC submarine | investment | 1008.2934 | EUR/MW/km | Härtel et al. (2017): https://doi.org/10.1016/j.epsr.2017.06.008 . | Table 1 | 2017.0
HVDC submarine | lifetime | 40.0 | years | Purvins et al. (2018): https://doi.org/10.1016/j.jclepro.2018.03.095 . | Based on estimated costs for a NA-EU connector (bidirectional,4 GW, 3000km length and ca. 3000m depth). Costs in return based on existing/currently under construction undersea cables. | 2018.0
HVDC underground | FOM | 0.35 | %/year | Purvins et al. (2018): https://doi.org/10.1016/j.jclepro.2018.03.095 . | Based on estimated costs for a NA-EU connector (bidirectional,4 GW, 3000km length and ca. 3000m depth). Costs in return based on existing/currently under construction undersea cables. (same as for HVDC submarine) | 2018.0
HVDC underground | investment | 1008.2934 | EUR/MW/km | Härtel et al. (2017): https://doi.org/10.1016/j.epsr.2017.06.008 . | Table 1 (same as for HVDC submarine) | 2017.0
HVDC underground | lifetime | 40.0 | years | Purvins et al. (2018): https://doi.org/10.1016/j.jclepro.2018.03.095 . | Based on estimated costs for a NA-EU connector (bidirectional,4 GW, 3000km length and ca. 3000m depth). Costs in return based on existing/currently under construction undersea cables. (same as for HVDC submarine) | 2018.0
Haber-Bosch | FOM | 3.0 | %/year | Danish Energy Agency, inputs/data_sheets_for_renewable_fuels.xlsx | 103 Hydrogen to Ammonia: Fixed O&M | 2015.0
Haber-Bosch | VOM | 0.0225 | EUR/MWh_NH3 | Danish Energy Agency, inputs/data_sheets_for_renewable_fuels.xlsx | 103 Hydrogen to Ammonia: Variable O&M | 2015.0
Haber-Bosch | electricity-input | 0.2473 | MWh_el/MWh_NH3 | DECHEMA 2017: DECHEMA: Low carbon energy and feedstock for the European chemical industry (https://dechema.de/dechema_media/Downloads/Positionspapiere/Technology_study_Low_carbon_energy_and_feedstock_for_the_European_chemical_industry.pdf), table 11. | Assume 5 GJ/t_NH3 for compressors and NH3 LHV = 5.16666 MWh/t_NH3. | 0.0
Haber-Bosch | hydrogen-input | 1.1484 | MWh_H2/MWh_NH3 | DECHEMA 2017: DECHEMA: Low carbon energy and feedstock for the European chemical industry (https://dechema.de/dechema_media/Downloads/Positionspapiere/Technology_study_Low_carbon_energy_and_feedstock_for_the_European_chemical_industry.pdf), pg. 57. | 178 kg_H2 per t_NH3, LHV for both assumed. | 0.0
Haber-Bosch | investment | 1460.0135 | EUR/kW_NH3 | Danish Energy Agency, inputs/data_sheets_for_renewable_fuels.xlsx | 103 Hydrogen to Ammonia: Specific investment | 2015.0
Haber-Bosch | lifetime | 30.0 | years | Danish Energy Agency, inputs/data_sheets_for_renewable_fuels.xlsx | 103 Hydrogen to Ammonia: Technical lifetime | 2015.0
Haber-Bosch | nitrogen-input | 0.1597 | t_N2/MWh_NH3 | DECHEMA 2017: DECHEMA: Low carbon energy and feedstock for the European chemical industry (https://dechema.de/dechema_media/Downloads/Positionspapiere/Technology_study_Low_carbon_energy_and_feedstock_for_the_European_chemical_industry.pdf), pg. 57. | .33 MWh electricity are required for ASU per t_NH3, considering 0.4 MWh are required per t_N2 and LHV of NH3 of 5.1666 Mwh. | 0.0
HighT-Molten-Salt-charger | FOM | 1.075 | %/year | Viswanathan_2022, NULL | {'carrier': ['elec', 'salthight'], 'technology_type': ['charger'], 'type': ['thermal'], 'note': ['Guesstimate, 50% on charger']} | 2020.0
HighT-Molten-Salt-charger | efficiency | 0.99 | per unit | Viswanathan_2022, p.107 (p.129) | {'carrier': ['elec', 'salthight'], 'technology_type': ['charger'], 'type': ['thermal'], 'note': ['RTE assume 99% for charge and other for discharge']} | 2020.0
HighT-Molten-Salt-charger | investment | 144192.2682 | EUR/MW | Georgiou_2018, Guesstimate that charge is 20% of capital costs of power components for sensible thermal storage | {'carrier': ['elec', 'salthight'], 'technology_type': ['charger'], 'type': ['thermal'], 'note': ['Power Equipment Charge']} | 2020.0
HighT-Molten-Salt-charger | lifetime | 35.0 | years | Viswanathan_2022, p.107 (p.129) | {'carrier': ['elec', 'salthight'], 'technology_type': ['charger'], 'type': ['thermal'], 'note': ['NULL']} | 2020.0
HighT-Molten-Salt-discharger | FOM | 0.2688 | %/year | Viswanathan_2022, NULL | {'carrier': ['salthight', 'elec'], 'technology_type': ['discharger'], 'type': ['thermal'], 'note': ['Guesstimate, 50% on discharger']} | 2020.0
HighT-Molten-Salt-discharger | efficiency | 0.4444 | per unit | Viswanathan_2022, p.107 (p.129) | {'carrier': ['salthight', 'elec'], 'technology_type': ['discharger'], 'type': ['thermal'], 'note': ['RTE assume 99% for charge and other for discharge']} | 2020.0
HighT-Molten-Salt-discharger | investment | 576769.073 | EUR/MW | Georgiou_2018, Guesstimate that charge is 80% of capital costs of power components for sensible thermal storage | {'carrier': ['salthight', 'elec'], 'technology_type': ['discharger'], 'type': ['thermal'], 'note': ['Power Equipment Discharge']} | 2020.0
HighT-Molten-Salt-discharger | lifetime | 35.0 | years | Viswanathan_2022, p.107 (p.129) | {'carrier': ['salthight', 'elec'], 'technology_type': ['discharger'], 'type': ['thermal'], 'note': ['NULL']} | 2020.0
HighT-Molten-Salt-store | FOM | 0.3308 | %/year | Viswanathan_2022, p 104 (p.126) | {'carrier': ['salthight'], 'technology_type': ['store'], 'type': ['thermal'], 'note': ['not provided calculated as for hydrogen']} | 2020.0
HighT-Molten-Salt-store | investment | 94107.5489 | EUR/MWh | Viswanathan_2022, p.98 (p.120) | {'carrier': ['salthight'], 'technology_type': ['store'], 'type': ['thermal'], 'note': ['SB and BOS 0.85 of 2021 value']} | 2020.0
HighT-Molten-Salt-store | lifetime | 35.0 | years | Viswanathan_2022, p.107 (p.129) | {'carrier': ['salthight'], 'technology_type': ['store'], 'type': ['thermal'], 'note': ['NULL']} | 2020.0
Hydrogen fuel cell (passenger cars) | FOM | 1.1 | % | PATHS TO A CLIMATE-NEUTRAL ENERGY SYSTEM The German energy transformation in its social context. https://www.ise.fraunhofer.de/en/publications/studies/paths-to-a-climate-neutral-energy-system.html | Hydrogen fuel cell (passenger cars) | 2020.0
Hydrogen fuel cell (passenger cars) | efficiency | 0.48 | per unit | PATHS TO A CLIMATE-NEUTRAL ENERGY SYSTEM The German energy transformation in its social context. https://www.ise.fraunhofer.de/en/publications/studies/paths-to-a-climate-neutral-energy-system.html | Hydrogen fuel cell (passenger cars) | 2020.0
Hydrogen fuel cell (passenger cars) | investment | 33226.0 | EUR/PKW | PATHS TO A CLIMATE-NEUTRAL ENERGY SYSTEM The German energy transformation in its social context. https://www.ise.fraunhofer.de/en/publications/studies/paths-to-a-climate-neutral-energy-system.html | Hydrogen fuel cell (passenger cars) | 2020.0
Hydrogen fuel cell (passenger cars) | lifetime | 15.0 | years | PATHS TO A CLIMATE-NEUTRAL ENERGY SYSTEM The German energy transformation in its social context. https://www.ise.fraunhofer.de/en/publications/studies/paths-to-a-climate-neutral-energy-system.html | Hydrogen fuel cell (passenger cars) | 2020.0
Hydrogen fuel cell (trucks) | FOM | 13.1 | % | PATHS TO A CLIMATE-NEUTRAL ENERGY SYSTEM The German energy transformation in its social context. https://www.ise.fraunhofer.de/en/publications/studies/paths-to-a-climate-neutral-energy-system.html | Hydrogen fuel cell (trucks) | 2020.0
Hydrogen fuel cell (trucks) | efficiency | 0.56 | per unit | PATHS TO A CLIMATE-NEUTRAL ENERGY SYSTEM The German energy transformation in its social context. https://www.ise.fraunhofer.de/en/publications/studies/paths-to-a-climate-neutral-energy-system.html | Hydrogen fuel cell (trucks) | 2020.0
Hydrogen fuel cell (trucks) | investment | 116497.0 | EUR/LKW | PATHS TO A CLIMATE-NEUTRAL ENERGY SYSTEM The German energy transformation in its social context. https://www.ise.fraunhofer.de/en/publications/studies/paths-to-a-climate-neutral-energy-system.html | Hydrogen fuel cell (trucks) | 2020.0
Hydrogen fuel cell (trucks) | lifetime | 15.0 | years | PATHS TO A CLIMATE-NEUTRAL ENERGY SYSTEM The German energy transformation in its social context. https://www.ise.fraunhofer.de/en/publications/studies/paths-to-a-climate-neutral-energy-system.html | Hydrogen fuel cell (trucks) | 2020.0
Hydrogen-charger | FOM | 0.6345 | %/year | Viswanathan_2022, NULL | {'carrier': ['elec', 'h2cavern'], 'technology_type': ['charger'], 'type': ['electrochemical'], 'note': ['Guesstimate, 50% on charger']} | 2020.0
Hydrogen-charger | efficiency | 0.6963 | per unit | Viswanathan_2022, p.111 (p.133) include inverter 0.98 & transformer efficiency 0.98 | {'carrier': ['elec', 'h2cavern'], 'technology_type': ['charger'], 'type': ['electrochemical'], 'note': ['Electrolyzer']} | 2020.0
Hydrogen-charger | investment | 347170.8209 | EUR/MW | Viswanathan_2022, p.113 (p.135) | {'carrier': ['elec', 'h2cavern'], 'technology_type': ['charger'], 'type': ['electrochemical'], 'note': ['Electrolyzer']} | 2020.0
Hydrogen-charger | lifetime | 30.0 | years | Viswanathan_2022, p.111 (p.133) | {'carrier': ['elec', 'h2cavern'], 'technology_type': ['charger'], 'type': ['electrochemical'], 'note': ['NULL']} | 2020.0
Hydrogen-discharger | FOM | 0.5812 | %/year | Viswanathan_2022, NULL | {'carrier': ['h2cavern', 'elec'], 'technology_type': ['discharger'], 'type': ['electrochemical'], 'note': ['Guesstimate, 50% on discharger']} | 2020.0
Hydrogen-discharger | efficiency | 0.4869 | per unit | Viswanathan_2022, p.111 (p.133) include inverter 0.98 & transformer efficiency 0.98 | {'carrier': ['h2cavern', 'elec'], 'technology_type': ['discharger'], 'type': ['electrochemical'], 'note': ['Fuel Cell']} | 2020.0
Hydrogen-discharger | investment | 379007.4464 | EUR/MW | Viswanathan_2022, p.113 (p.135) | {'carrier': ['h2cavern', 'elec'], 'technology_type': ['discharger'], 'type': ['electrochemical'], 'note': ['Fuel Cell']} | 2020.0
Hydrogen-discharger | lifetime | 30.0 | years | Viswanathan_2022, p.111 (p.133) | {'carrier': ['h2cavern', 'elec'], 'technology_type': ['discharger'], 'type': ['electrochemical'], 'note': ['NULL']} | 2020.0
Hydrogen-store | FOM | 0.43 | %/year | Viswanathan_2022, 0.43 % of SB =(C38+C39)*0.43/4 | {'carrier': ['h2cavern'], 'technology_type': ['store'], 'type': ['electrochemical'], 'note': ['derived']} | 2020.0
Hydrogen-store | investment | 4779.9527 | EUR/MWh | Viswanathan_2022, p.113 (p.135) | {'carrier': ['h2cavern'], 'technology_type': ['store'], 'type': ['electrochemical'], 'note': ['Cavern Storage']} | 2020.0
Hydrogen-store | lifetime | 30.0 | years | Viswanathan_2022, p.111 (p.133) | {'carrier': ['h2cavern'], 'technology_type': ['store'], 'type': ['electrochemical'], 'note': ['NULL']} | 2020.0
LNG storage tank | FOM | 2.0 | %/year | Guesstimate, based on H2 (l) storage tank with comparable requirements. | Currency year and technology year assumed based on publication date. | 2019.0
LNG storage tank | investment | 666.634 | EUR/m^3 | Hurskainen 2019, https://cris.vtt.fi/en/publications/liquid-organic-hydrogen-carriers-lohc-concept-evaluation-and-tech pg. 46 (59). | Currency year and technology year assumed based on publication date. | 2019.0
LNG storage tank | lifetime | 20.0 | years | Guesstimate, based on H2 (l) storage tank with comparable requirements. | Currency year and technology year assumed based on publication date. | 2019.0
LOHC chemical | investment | 2500.0 | EUR/t | Runge et al 2020, pg.7, https://papers.ssrn.com/abstract=3623514 | 0 | 2020.0
LOHC chemical | lifetime | 20.0 | years | Runge et al 2020, pg.7, https://papers.ssrn.com/abstract=3623514 | 0 | 2020.0
LOHC dehydrogenation | FOM | 3.0 | %/year | Reuß et al 2017, https://doi.org/10.1016/j.apenergy.2017.05.050 , Table 9. | 0 | 2015.0
LOHC dehydrogenation | investment | 53681.4988 | EUR/MW_H2 | Reuß et al 2017, https://doi.org/10.1016/j.apenergy.2017.05.050 , Table 9. | per MW H2 (LHV). For a large plant of 1000 MW capacity. Calculated based on base CAPEX of 30 MEUR for 300 t/day capacity and a scale factor of 0.6. | 2015.0
LOHC dehydrogenation | lifetime | 20.0 | years | Reuß et al 2017, https://doi.org/10.1016/j.apenergy.2017.05.050 , Table 9. | 0 | 2015.0
LOHC dehydrogenation (small scale) | FOM | 3.0 | %/year | Runge et al 2020, pg.8, https://papers.ssrn.com/abstract=3623514 | 0 | 2020.0
LOHC dehydrogenation (small scale) | investment | 839000.0 | EUR/MW_H2 | Runge et al 2020, pg.8, https://papers.ssrn.com/abstract=3623514 | MW of H2 LHV. For a small plant of 0.9 MW capacity. | 2020.0
LOHC dehydrogenation (small scale) | lifetime | 20.0 | years | Runge et al 2020, pg.8, https://papers.ssrn.com/abstract=3623514 | 0 | 2020.0
LOHC hydrogenation | FOM | 3.0 | %/year | Reuß et al 2017, https://doi.org/10.1016/j.apenergy.2017.05.050 , Table 9. | 0 | 2015.0
LOHC hydrogenation | electricity-input | 0.004 | MWh_el/t_HLOHC | Niermann et al. (2019): (https://doi.org/10.1039/C8EE02700E). 6A . | Flow in figures shows 0.2 MW for 114 MW_HHV = 96.4326 MW_LHV = 2.89298 t hydrogen. At 5.6 wt-% effective H2 storage for loaded LOHC (H18-DBT, HLOHC), corresponds to 51.6604 t loaded LOHC . | 0.0
LOHC hydrogenation | hydrogen-input | 1.867 | MWh_H2/t_HLOHC | Runge et al 2020, pg. 7, https://papers.ssrn.com/abstract=3623514 | Considering 5.6 wt-% H2 in loaded LOHC (HLOHC) and LHV of H2. | 0.0
LOHC hydrogenation | investment | 54243.958 | EUR/MW_H2 | Reuß et al 2017, https://doi.org/10.1016/j.apenergy.2017.05.050 , Table 9. | per MW H2 (LHV). For a large plant of 2000 MW capacity. Calculated based on base CAPEX of 40 MEUR for 300 t/day capacity and a scale factor of 0.6. | 2015.0
LOHC hydrogenation | lifetime | 20.0 | years | Reuß et al 2017, https://doi.org/10.1016/j.apenergy.2017.05.050 , Table 9. | 0 | 2015.0
LOHC hydrogenation | lohc-input | 0.944 | t_LOHC/t_HLOHC | Runge et al 2020, pg. 7, https://papers.ssrn.com/abstract=3623514 | Loaded LOHC (H18-DBT, HLOHC) has loaded only 5.6%-wt H2 as rate of discharge is kept at ca. 90%. | 0.0
LOHC loaded DBT storage | FOM | 6.25 | %/year | 0 | Based on storage “General liquid hydrocarbon storage (crude)”, as similar properties are shared. | 2012.0
LOHC loaded DBT storage | investment | 151.5383 | EUR/t | Density via Wissenschaftliche Dienste des Deutschen Bundestages 2020, https://www.bundestag.de/resource/blob/816048/454e182d5956d45a664da9eb85486f76/WD-8-058-20-pdf-data.pdf , pg. 11. | Based on storage “General liquid hydrocarbon storage (crude)”, as similar properties are shared. Density of loaded LOHC H18-DBT is 0.91 t/m^3. | 2012.0
LOHC loaded DBT storage | lifetime | 30.0 | years | 0 | Based on storage “General liquid hydrocarbon storage (crude)”, as similar properties are shared. | 2012.0
LOHC transport ship | FOM | 5.0 | %/year | Runge et al 2020, Table 10, https://papers.ssrn.com/abstract=3623514 | 0 | 2020.0
LOHC transport ship | capacity | 75000.0 | t_LOHC | Runge et al 2020, Table 10, https://papers.ssrn.com/abstract=3623514 | 0 | 2020.0
LOHC transport ship | investment | 35000000.0 | EUR | Runge et al 2020, Table 10, https://papers.ssrn.com/abstract=3623514 | 0 | 2020.0
LOHC transport ship | lifetime | 15.0 | years | Runge et al 2020, Table 10, https://papers.ssrn.com/abstract=3623514 | 0 | 2020.0
LOHC unloaded DBT storage | FOM | 6.25 | %/year | 0 | Based on storage “General liquid hydrocarbon storage (crude)”, as similar properties are shared. | 2012.0
LOHC unloaded DBT storage | investment | 134.2745 | EUR/t | Density via Wissenschaftliche Dienste des Deutschen Bundestages 2020, https://www.bundestag.de/resource/blob/816048/454e182d5956d45a664da9eb85486f76/WD-8-058-20-pdf-data.pdf , pg. 11. | Based on storage “General liquid hydrocarbon storage (crude)”, as similar properties are shared. Density of loaded LOHC H18-DBT is 0.91 t/m^3, density of unloaded LOHC H0-DBT is 1.04 t/m^3 but unloading is only to 90% (depth-of-discharge), assume density via linearisation of 1.027 t/m^3. | 2012.0
LOHC unloaded DBT storage | lifetime | 30.0 | years | 0 | Based on storage “General liquid hydrocarbon storage (crude)”, as similar properties are shared. | 2012.0
Lead-Acid-bicharger | FOM | 2.4427 | %/year | Viswanathan_2022, p.28 (p.50) | {'carrier': ['elec', 'lead', 'elec'], 'technology_type': ['bicharger'], 'type': ['electrochemical'], 'note': ['30% assumed of power components every 10 years']} | 2020.0
Lead-Acid-bicharger | efficiency | 0.8832 | per unit | Viswanathan_2022, p.33 (p.55) | {'carrier': ['elec', 'lead', 'elec'], 'technology_type': ['bicharger'], 'type': ['electrochemical'], 'note': ['AC-AC efficiency at transformer level 0.78^0.5']} | 2020.0
Lead-Acid-bicharger | investment | 128853.6139 | EUR/MW | Viswanathan_2022, p.33 (p.55) | {'carrier': ['elec', 'lead', 'elec'], 'technology_type': ['bicharger'], 'type': ['electrochemical'], 'note': ['Power Equipment']} | 2020.0
Lead-Acid-bicharger | lifetime | 12.0 | years | Viswanathan_2022, p.33 (p.55) | {'carrier': ['elec', 'lead', 'elec'], 'technology_type': ['bicharger'], 'type': ['electrochemical'], 'note': ['NULL']} | 2020.0
Lead-Acid-store | FOM | 0.2542 | %/year | Viswanathan_2022, p.28 (p.50) | {'carrier': ['lead'], 'technology_type': ['store'], 'type': ['electrochemical'], 'note': ['0.43 % of SB']} | 2020.0
Lead-Acid-store | investment | 320631.3818 | EUR/MWh | Viswanathan_2022, p.33 (p.55) | {'carrier': ['lead'], 'technology_type': ['store'], 'type': ['electrochemical'], 'note': ['DC storage block']} | 2020.0
Lead-Acid-store | lifetime | 12.0 | years | Viswanathan_2022, p.33 (p.55) | {'carrier': ['lead'], 'technology_type': ['store'], 'type': ['electrochemical'], 'note': ['NULL']} | 2020.0
Liquid fuels ICE (passenger cars) | FOM | 1.6 | % | PATHS TO A CLIMATE-NEUTRAL ENERGY SYSTEM The German energy transformation in its social context. https://www.ise.fraunhofer.de/en/publications/studies/paths-to-a-climate-neutral-energy-system.html | Liquid fuels ICE (passenger cars) | 2020.0
Liquid fuels ICE (passenger cars) | efficiency | 0.215 | per unit | PATHS TO A CLIMATE-NEUTRAL ENERGY SYSTEM The German energy transformation in its social context. https://www.ise.fraunhofer.de/en/publications/studies/paths-to-a-climate-neutral-energy-system.html | Liquid fuels ICE (passenger cars) | 2020.0
Liquid fuels ICE (passenger cars) | investment | 24999.0 | EUR/PKW | PATHS TO A CLIMATE-NEUTRAL ENERGY SYSTEM The German energy transformation in its social context. https://www.ise.fraunhofer.de/en/publications/studies/paths-to-a-climate-neutral-energy-system.html | Liquid fuels ICE (passenger cars) | 2020.0
Liquid fuels ICE (passenger cars) | lifetime | 15.0 | years | PATHS TO A CLIMATE-NEUTRAL ENERGY SYSTEM The German energy transformation in its social context. https://www.ise.fraunhofer.de/en/publications/studies/paths-to-a-climate-neutral-energy-system.html | Liquid fuels ICE (passenger cars) | 2020.0
Liquid fuels ICE (trucks) | FOM | 17.1 | % | PATHS TO A CLIMATE-NEUTRAL ENERGY SYSTEM The German energy transformation in its social context. https://www.ise.fraunhofer.de/en/publications/studies/paths-to-a-climate-neutral-energy-system.html | Liquid fuels ICE (trucks) | 2020.0
Liquid fuels ICE (trucks) | efficiency | 0.373 | per unit | PATHS TO A CLIMATE-NEUTRAL ENERGY SYSTEM The German energy transformation in its social context. https://www.ise.fraunhofer.de/en/publications/studies/paths-to-a-climate-neutral-energy-system.html | Liquid fuels ICE (trucks) | 2020.0
Liquid fuels ICE (trucks) | investment | 105315.0 | EUR/LKW | PATHS TO A CLIMATE-NEUTRAL ENERGY SYSTEM The German energy transformation in its social context. https://www.ise.fraunhofer.de/en/publications/studies/paths-to-a-climate-neutral-energy-system.html | Liquid fuels ICE (trucks) | 2020.0
Liquid fuels ICE (trucks) | lifetime | 15.0 | years | PATHS TO A CLIMATE-NEUTRAL ENERGY SYSTEM The German energy transformation in its social context. https://www.ise.fraunhofer.de/en/publications/studies/paths-to-a-climate-neutral-energy-system.html | Liquid fuels ICE (trucks) | 2020.0
Liquid-Air-charger | FOM | 0.366 | %/year | Viswanathan_2022, NULL | {'carrier': ['elec', 'lair'], 'technology_type': ['charger'], 'type': ['thermal'], 'note': ['Guesstimate, 50% on charger']} | 2020.0
Liquid-Air-charger | efficiency | 0.99 | per unit | Viswanathan_2022, NULL | {'carrier': ['elec', 'lair'], 'technology_type': ['charger'], 'type': ['thermal'], 'note': ['NULL']} | 2020.0
Liquid-Air-charger | investment | 475721.2289 | EUR/MW | Georgiou_2018, Figure 9 of reference roughly 80% of capital cost are power related 47%/80% of costs are required for liquefaction (charging) | {'carrier': ['elec', 'lair'], 'technology_type': ['charger'], 'type': ['thermal'], 'note': ['Power Equipment Charge']} | 2020.0
Liquid-Air-charger | lifetime | 35.0 | years | Viswanathan_2022, p.107 (p.129) | {'carrier': ['elec', 'lair'], 'technology_type': ['charger'], 'type': ['thermal'], 'note': ['NULL']} | 2020.0
Liquid-Air-discharger | FOM | 0.5212 | %/year | Viswanathan_2022, NULL | {'carrier': ['lair', 'elec'], 'technology_type': ['discharger'], 'type': ['thermal'], 'note': ['Guesstimate, 50% on discharger']} | 2020.0
Liquid-Air-discharger | efficiency | 0.55 | per unit | Viswanathan_2022, p.107 (p.129) | {'carrier': ['lair', 'elec'], 'technology_type': ['discharger'], 'type': ['thermal'], 'note': ['RTE 0.545 assume 99% for charge and other for discharge']} | 2020.0
Liquid-Air-discharger | investment | 334017.033 | EUR/MW | Georgiou_2018, NULL | {'carrier': ['lair', 'elec'], 'technology_type': ['discharger'], 'type': ['thermal'], 'note': ['Power Equipment Discharge']} | 2020.0
Liquid-Air-discharger | lifetime | 35.0 | years | Viswanathan_2022, p.107 (p.129) | {'carrier': ['lair', 'elec'], 'technology_type': ['discharger'], 'type': ['thermal'], 'note': ['NULL']} | 2020.0
Liquid-Air-store | FOM | 0.3208 | %/year | Viswanathan_2022, p 104 (p.126) | {'carrier': ['lair'], 'technology_type': ['store'], 'type': ['thermal'], 'note': ['not provided calculated as for hydrogen']} | 2020.0
Liquid-Air-store | investment | 159004.771 | EUR/MWh | Viswanathan_2022, p.98 (p.120) | {'carrier': ['lair'], 'technology_type': ['store'], 'type': ['thermal'], 'note': ['Liquid Air SB and BOS']} | 2020.0
Liquid-Air-store | lifetime | 35.0 | years | Viswanathan_2022, p.107 (p.129) | {'carrier': ['lair'], 'technology_type': ['store'], 'type': ['thermal'], 'note': ['NULL']} | 2020.0
Lithium-Ion-LFP-bicharger | FOM | 2.1198 | %/year | Viswanathan_2022, p.28 (p.50) | {'carrier': ['elec', 'lfp', 'elec'], 'technology_type': ['bicharger'], 'type': ['electrochemical'], 'note': ['30% assumed of power components every 10 years']} | 2020.0
Lithium-Ion-LFP-bicharger | efficiency | 0.9193 | per unit | Viswanathan_2022, p.24 (p.46) | {'carrier': ['elec', 'lfp', 'elec'], 'technology_type': ['bicharger'], 'type': ['electrochemical'], 'note': ['AC-AC efficiency at transformer level 0.8452^0.5']} | 2020.0
Lithium-Ion-LFP-bicharger | investment | 81553.4846 | EUR/MW | Viswanathan_2022, p.24 (p.46) | {'carrier': ['elec', 'lfp', 'elec'], 'technology_type': ['bicharger'], 'type': ['electrochemical'], 'note': ['Power Equipment']} | 2020.0
Lithium-Ion-LFP-bicharger | lifetime | 16.0 | years | Viswanathan_2022, p.24 (p.46) | {'carrier': ['elec', 'lfp', 'elec'], 'technology_type': ['bicharger'], 'type': ['electrochemical'], 'note': ['NULL']} | 2020.0
Lithium-Ion-LFP-store | FOM | 0.0447 | %/year | Viswanathan_2022, p.28 (p.50) | {'carrier': ['lfp'], 'technology_type': ['store'], 'type': ['electrochemical'], 'note': ['0.43 % of SB']} | 2020.0
Lithium-Ion-LFP-store | investment | 236482.8109 | EUR/MWh | Viswanathan_2022, p.24 (p.46) | {'carrier': ['lfp'], 'technology_type': ['store'], 'type': ['electrochemical'], 'note': ['DC storage block']} | 2020.0
Lithium-Ion-LFP-store | lifetime | 16.0 | years | Viswanathan_2022, p.24 (p.46) | {'carrier': ['lfp'], 'technology_type': ['store'], 'type': ['electrochemical'], 'note': ['NULL']} | 2020.0
Lithium-Ion-NMC-bicharger | FOM | 2.1198 | %/year | Viswanathan_2022, p.28 (p.50) | {'carrier': ['elec', 'nmc', 'elec'], 'technology_type': ['bicharger'], 'type': ['electrochemical'], 'note': ['30% assumed of power components every 10 years']} | 2020.0
Lithium-Ion-NMC-bicharger | efficiency | 0.9193 | per unit | Viswanathan_2022, p.24 (p.46) | {'carrier': ['elec', 'nmc', 'elec'], 'technology_type': ['bicharger'], 'type': ['electrochemical'], 'note': ['AC-AC efficiency at transformer level 0.8452^0.5']} | 2020.0
Lithium-Ion-NMC-bicharger | investment | 81553.4846 | EUR/MW | Viswanathan_2022, p.24 (p.46) | {'carrier': ['elec', 'nmc', 'elec'], 'technology_type': ['bicharger'], 'type': ['electrochemical'], 'note': ['Power Equipment']} | 2020.0
Lithium-Ion-NMC-bicharger | lifetime | 13.0 | years | Viswanathan_2022, p.24 (p.46) | {'carrier': ['elec', 'nmc', 'elec'], 'technology_type': ['bicharger'], 'type': ['electrochemical'], 'note': ['NULL']} | 2020.0
Lithium-Ion-NMC-store | FOM | 0.038 | %/year | Viswanathan_2022, p.28 (p.50) | {'carrier': ['nmc'], 'technology_type': ['store'], 'type': ['electrochemical'], 'note': ['0.43 % of SB']} | 2020.0
Lithium-Ion-NMC-store | investment | 269576.8493 | EUR/MWh | Viswanathan_2022, p.24 (p.46) | {'carrier': ['nmc'], 'technology_type': ['store'], 'type': ['electrochemical'], 'note': ['DC storage block']} | 2020.0
Lithium-Ion-NMC-store | lifetime | 13.0 | years | Viswanathan_2022, p.24 (p.46) | {'carrier': ['nmc'], 'technology_type': ['store'], 'type': ['electrochemical'], 'note': ['NULL']} | 2020.0
LowT-Molten-Salt-charger | FOM | 1.075 | %/year | Viswanathan_2022, NULL | {'carrier': ['elec', 'saltlowt'], 'technology_type': ['charger'], 'type': ['thermal'], 'note': ['Guesstimate, 50% on charger']} | 2020.0
LowT-Molten-Salt-charger | efficiency | 0.99 | per unit | Viswanathan_2022, p.107 (p.129) | {'carrier': ['elec', 'saltlowt'], 'technology_type': ['charger'], 'type': ['thermal'], 'note': ['RTE assume 99% for charge and other for discharge']} | 2020.0
LowT-Molten-Salt-charger | investment | 144192.2682 | EUR/MW | Georgiou_2018, Guesstimate that charge is 20% of capital costs of power components for sensible thermal storage | {'carrier': ['elec', 'saltlowt'], 'technology_type': ['charger'], 'type': ['thermal'], 'note': ['Power Equipment Charge']} | 2020.0
LowT-Molten-Salt-charger | lifetime | 35.0 | years | Viswanathan_2022, p.107 (p.129) | {'carrier': ['elec', 'saltlowt'], 'technology_type': ['charger'], 'type': ['thermal'], 'note': ['NULL']} | 2020.0
LowT-Molten-Salt-discharger | FOM | 0.2688 | %/year | Viswanathan_2022, NULL | {'carrier': ['saltlowt', 'elec'], 'technology_type': ['discharger'], 'type': ['thermal'], 'note': ['Guesstimate, 50% on discharger']} | 2020.0
LowT-Molten-Salt-discharger | efficiency | 0.5394 | per unit | Viswanathan_2022, p.107 (p.129) | {'carrier': ['saltlowt', 'elec'], 'technology_type': ['discharger'], 'type': ['thermal'], 'note': ['RTE assume 99% for charge and other for discharge']} | 2020.0
LowT-Molten-Salt-discharger | investment | 576769.073 | EUR/MW | Georgiou_2018, Guesstimate that charge is 80% of capital costs of power components for sensible thermal storage | {'carrier': ['saltlowt', 'elec'], 'technology_type': ['discharger'], 'type': ['thermal'], 'note': ['Power Equipment Discharge']} | 2020.0
LowT-Molten-Salt-discharger | lifetime | 35.0 | years | Viswanathan_2022, p.107 (p.129) | {'carrier': ['saltlowt', 'elec'], 'technology_type': ['discharger'], 'type': ['thermal'], 'note': ['NULL']} | 2020.0
LowT-Molten-Salt-store | FOM | 0.3308 | %/year | Viswanathan_2022, p 104 (p.126) | {'carrier': ['saltlowt'], 'technology_type': ['store'], 'type': ['thermal'], 'note': ['not provided calculated as for hydrogen']} | 2020.0
LowT-Molten-Salt-store | investment | 58041.2003 | EUR/MWh | Viswanathan_2022, p.98 (p.120) | {'carrier': ['saltlowt'], 'technology_type': ['store'], 'type': ['thermal'], 'note': ['SB and BOS 0.85 of 2021 value']} | 2020.0
LowT-Molten-Salt-store | lifetime | 35.0 | years | Viswanathan_2022, p.107 (p.129) | {'carrier': ['saltlowt'], 'technology_type': ['store'], 'type': ['thermal'], 'note': ['NULL']} | 2020.0
MeOH transport ship | FOM | 5.0 | %/year | Assume comparable tanker as for LOHC transport above, c.f. Runge et al 2020, Table 10, https://papers.ssrn.com/abstract=3623514 . | 0 | 2020.0
MeOH transport ship | capacity | 75000.0 | t_MeOH | Assume comparable tanker as for LOHC transport above, c.f. Runge et al 2020, Table 10, https://papers.ssrn.com/abstract=3623514 . | 0 | 2020.0
MeOH transport ship | investment | 35000000.0 | EUR | Assume comparable tanker as for LOHC transport above, c.f. Runge et al 2020, Table 10, https://papers.ssrn.com/abstract=3623514 . | 0 | 2020.0
MeOH transport ship | lifetime | 15.0 | years | Assume comparable tanker as for LOHC transport above, c.f. Runge et al 2020, Table 10, https://papers.ssrn.com/abstract=3623514 . | 0 | 2020.0
Methanol steam reforming | FOM | 4.0 | %/year | Niermann et al. (2021): Liquid Organic Hydrogen Carriers and alternatives for international transport of renewable hydrogen (https://doi.org/10.1016/j.rser.2020.110171), table 4. | 0 | 2020.0
Methanol steam reforming | investment | 18016.8665 | EUR/MW_H2 | Niermann et al. (2021): Liquid Organic Hydrogen Carriers and alternatives for international transport of renewable hydrogen (https://doi.org/10.1016/j.rser.2020.110171), table 4. | For high temperature steam reforming plant with a capacity of 200 MW_H2 output (6t/h). Reference plant of 1 MW (30kg_H2/h) costs 150kEUR, scale factor of 0.6 assumed. | 2020.0
Methanol steam reforming | lifetime | 20.0 | years | Niermann et al. (2021): Liquid Organic Hydrogen Carriers and alternatives for international transport of renewable hydrogen (https://doi.org/10.1016/j.rser.2020.110171), table 4. | 0 | 2020.0
Methanol steam reforming | methanol-input | 1.201 | MWh_MeOH/MWh_H2 | Niermann et al. (2021): Liquid Organic Hydrogen Carriers and alternatives for international transport of renewable hydrogen (https://doi.org/10.1016/j.rser.2020.110171), table 4. | Assuming per 1 t_H2 (with LHV 33.3333 MWh/t): 4.5 MWh_th and 3.2 MWh_el are required. We assume electricity can be substituted / provided with 1:1 as heat energy. | 0.0
NH3 (l) storage tank incl. liquefaction | FOM | 2.0 | %/year | Guesstimate, based on H2 (l) storage tank. | 0 | 2010.0
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
