cyc292cycjin-oss/SGP-ESE5004-Stage2/research/01_baseline_construction/SECTOR_ENABLEMENT.csv

Sector | Service_demand | Carrier | Conversion_technology | PyPSA_component | Expandable | Cost_source | Demand_source | Config_switch | Source_code | Validation_status
electricity | electrical energy | AC; low voltage | renewables; thermal; distribution | Bus/Generator/Load/Link | generation/storage grid subject to existing minima and limits | v0.13.2 + AEO8 | paper SSP; current DemandCast + final demand scaling | electricity.extendable_carriers; final_adjustment.only_elec_network | add_electricity.py | PENDING demand reconciliation; final electric pruning still true
hydrogen | conversion/end use | H2 | electrolysis; SMR; SMR CC; fuel cell; turbine | Bus/Link/Store | conversion and tanks yes; H2 network false | v0.13.2 manual override + DEA | derived from enabled sector substitution; no validated independent ASEAN H2 demand | sector.hydrogen.* | prepare_sector_network.py:add_hydrogen | CAPABILITY_ONLY; key efficiencies/tank FOM pending
heat | space/water/process heat | urban/rural; central/decentral heat | heat pumps; boilers; CHP; thermal stores | Bus/Load/Link/Store | conversion/store yes; demand fixed | v0.13.2; COP weather | UNSD energy totals + weather/population/urban fractions | sector.enable.heat=true; tes=true; boilers=true; chp=true | prepare_sector_network.py:add_heat | PENDING ASEAN demand shares and service equivalence
industry | industrial energy + process services | electricity; gas; oil; biomass; H2; heat | electrification; fuel supply; process/CC | Load/Link/Bus | conversion yes; exogenous service demand | v0.13.2 + AEO8 + process factors | UNSD 2019; facilities/GDP; DEFAULT CAGR | sector.enable.industry=true | prepare_sector_network.py:add_industry | 10-country base allocation PASS; TL/growth/process pending
ammonia | NH3 production/use | NH3; H2; N2 | Haber-Bosch; production links | Bus/Link/Store/Load | conversion/store per source yes | v0.13.2 | USGS/facilities; 2019 production; industrial ammonia adjustments | sector.ammonia.enable=true | prepare_sector_network.py:add_ammonia | CURRENT UPSTREAM CAPABILITY; inclusion/energy double counting pending
land transport | road mobility | EV batteries; H2; oil | BEV charger/V2G; fuel use | Load/Link/Store | EV infrastructure/stock constrained by exogenous shares | v0.13.2 + config efficiencies | UNSD; transport fleet profiles and DEC vehicle shares | sector.enable.land_transport=true; v2g=true; bev_dsm=true | prepare_sector_network.py:add_land_transport | PENDING ASEAN fleet/profile/share acceptance
rail | rail mobility | electricity; oil | electric demand; oil supply | Load/Bus | demand fixed; upstream fuel expandable | v0.13.2 fuel | nodal energy totals | sector.enable.rail_transport=true | prepare_sector_network.py:add_rail_transport | PENDING energy totals; final-adjustment carrier handling
shipping | shipping energy | oil; H2 | oil supply; optional H2 liquefaction | Load/Link/Bus | supply conversion expandable when enabled | v0.13.2 fuel/conversion | UNSD totals + ports; shipping profile | sector.enable.shipping=true; shipping_hydrogen_share.DEC_*=0 | prepare_sector_network.py:add_shipping | PENDING port shares/bunkers boundary
aviation | aviation energy | oil/kerosene | oil/synthetic fuel supply | Load/Link/Bus | supply conversion expandable | v0.13.2 fuel/FT | UNSD + airport spatial allocation | sector.enable.aviation=true; international_bunkers=false | prepare_sector_network.py:add_aviation | PENDING airport allocation/international fuel boundary
agriculture | agricultural energy | electricity; heat; oil | fuel/heat service | Load/Link/Bus | upstream supply yes; service fixed | v0.13.2 | nodal energy totals | sector.enable.agriculture=true | prepare_sector_network.py:add_agriculture | PENDING source acceptance; electricity final scaling
residential | household electricity and heat | electricity; heat; gas/oil/biomass | boilers; heat pumps; rooftop/storage | Load/Link/Generator/Store | conversion/rooftop/home store yes | v0.13.2 + AEO8 | UNSD totals; residential profiles; population | sector.enable.residential=true | prepare_sector_network.py:add_residential | PENDING service-demand consistency with heat sector
services | service-sector energy | electricity; heat; gas/oil/biomass | heat/fuel conversion | Load/Link/Bus | supply yes; service fixed | v0.13.2 | UNSD totals; services profiles | sector.enable.services=true | prepare_sector_network.py:add_services | PENDING services naming/scaling and heat overlaps
biomass | resource and fuel | solid biomass; biogas | combustion; upgrading | Generator/Store/Link | conversion yes; resource caps apply | v0.13.2 | global/default potential; 360 TWh solid and 0.5 TWh biogas configured | sector.enable.biomass=true; biomass_transport=false | prepare_sector_network.py:add_biomass | PENDING ASEAN resource entitlement; not accepted supply data
storage | temporal balancing | battery; H2; heat; PHS/hydro | charging/discharging | Store/StorageUnit/Link | battery/H2/TES yes; existing hydro resource limited | v0.13.2 + AEO8 | cost/efficiency/lifetime plus existing capacities | sector.tes; sector.home_battery; electricity.extendable_carriers | prepare_sector_network.py; add_electricity.py | PENDING key cost/efficiency verification
networks | domestic/cross-border transport | AC/DC; gas/H2/CO2 options | transmission; distribution; pipelines | Line/Link/Bus | electric expansion subject to lv2.0 and route rules; gas/H2/CO2 networks false | v0.13.2 + line costs | osm-plus-prebuilt 0.1.1; AIMS/ID projects | lines/links; transmission_projects; sector.*.network | base_network.py; add_transmission_projects.py | PENDING 765→766; future intervention AC/DC cross-border only
external supply / CO2 | commodity boundary and emissions | gas/oil/coal/lignite; atmosphere | fuel source; capture; DAC; sequestration | Generator/Store/Link/GlobalConstraint | fuel source unconstrained unless explicit resource cap; CO2 store expandable | fuel prices; capture/sequestration costs | manual fuel prices; shared default resource/CO2 settings | sector gas/oil/coal spatial; co2.budget; sector.dac/cc | prepare_sector_network.py:add_carrier_buses/add_co2 | POWER-SCOPE NOT EQUIVALENT under full SC; attribution required
