cyc292cycjin-oss/SGP-ESE5004-Stage2/research/04_model_assembly/gate2/RESEARCH_DEMAND_CONSERVATION_MATRIX.csv

RowID | Country | Year | Sector | Carrier | SourceMWh | LedgerMWh | SourceToSector | Spatial | Temporal | EvidenceClass | Status | Notes
BN:2019:Agriculture:AgricultureFinalEnergy:biomass | BN | 2019 | Agriculture | biomass |  |  | PENDING | PENDING_ACCEPTED_WEIGHTS | PENDING_ACCEPTED_PROFILE | OBSERVATION_NOT_MODEL_VALIDATION | PENDING | Source is raw UNSD or named derived cache, as ledger states. Cache conversion PASS does not prove original fuel/calorific completeness.
BN:2019:Agriculture:AgricultureFinalEnergy:coal | BN | 2019 | Agriculture | coal |  |  | PENDING | PENDING_ACCEPTED_WEIGHTS | PENDING_ACCEPTED_PROFILE | OBSERVATION_NOT_MODEL_VALIDATION | PENDING | Source is raw UNSD or named derived cache, as ledger states. Cache conversion PASS does not prove original fuel/calorific completeness.
BN:2019:Agriculture:AgricultureFinalEnergy:electricity | BN | 2019 | Agriculture | electricity |  |  | PENDING | NOT_APPLICABLE | NOT_APPLICABLE | OBSERVATION_NOT_MODEL_VALIDATION | PENDING | Source is raw UNSD or named derived cache, as ledger states. Cache conversion PASS does not prove original fuel/calorific completeness.
BN:2019:Agriculture:AgricultureFinalEnergy:oil | BN | 2019 | Agriculture | oil |  |  | PENDING | PENDING_ACCEPTED_WEIGHTS | PENDING_ACCEPTED_PROFILE | OBSERVATION_NOT_MODEL_VALIDATION | PENDING | Source is raw UNSD or named derived cache, as ledger states. Cache conversion PASS does not prove original fuel/calorific completeness.
BN:2019:Buildings:ResidentialCooking:mixed | BN | 2019 | Buildings | mixed |  |  | PENDING | NOT_APPLICABLE | NOT_APPLICABLE | OBSERVATION_NOT_MODEL_VALIDATION | PENDING | Source is raw UNSD or named derived cache, as ledger states. Cache conversion PASS does not prove original fuel/calorific completeness.
BN:2019:Buildings:ResidentialCooling:electricity | BN | 2019 | Buildings | electricity |  |  | PENDING | NOT_APPLICABLE | NOT_APPLICABLE | OBSERVATION_NOT_MODEL_VALIDATION | PENDING | Source is raw UNSD or named derived cache, as ledger states. Cache conversion PASS does not prove original fuel/calorific completeness.
BN:2019:Buildings:ResidentialDirectElectricity:electricity | BN | 2019 | Buildings | electricity | 1328662.0 | 1328662.0 | PASS_SOURCE_TO_LEDGER | NOT_APPLICABLE | NOT_APPLICABLE | OBSERVATION_NOT_MODEL_VALIDATION | PARTIAL | Source is raw UNSD or named derived cache, as ledger states. Cache conversion PASS does not prove original fuel/calorific completeness.
BN:2019:Buildings:ResidentialFuel:biomass | BN | 2019 | Buildings | biomass | 29600.0 | 29600.0 | PASS_SOURCE_TO_LEDGER | PENDING_ACCEPTED_WEIGHTS | PENDING_ACCEPTED_PROFILE | OBSERVATION_NOT_MODEL_VALIDATION | PARTIAL | Source is raw UNSD or named derived cache, as ledger states. Cache conversion PASS does not prove original fuel/calorific completeness.
BN:2019:Buildings:ResidentialFuel:coal | BN | 2019 | Buildings | coal |  |  | PENDING | PENDING_ACCEPTED_WEIGHTS | PENDING_ACCEPTED_PROFILE | OBSERVATION_NOT_MODEL_VALIDATION | PENDING | Source is raw UNSD or named derived cache, as ledger states. Cache conversion PASS does not prove original fuel/calorific completeness.
BN:2019:Buildings:ResidentialFuel:gas | BN | 2019 | Buildings | gas | 233300.0 | 233300.0 | PASS_SOURCE_TO_LEDGER | PENDING_ACCEPTED_WEIGHTS | PENDING_ACCEPTED_PROFILE | OBSERVATION_NOT_MODEL_VALIDATION | PARTIAL | Source is raw UNSD or named derived cache, as ledger states. Cache conversion PASS does not prove original fuel/calorific completeness.
BN:2019:Buildings:ResidentialFuel:oil | BN | 2019 | Buildings | oil | 226100.0 | 226100.0 | PASS_SOURCE_TO_LEDGER | PENDING_ACCEPTED_WEIGHTS | PENDING_ACCEPTED_PROFILE | OBSERVATION_NOT_MODEL_VALIDATION | PARTIAL | Source is raw UNSD or named derived cache, as ledger states. Cache conversion PASS does not prove original fuel/calorific completeness.
BN:2019:Buildings:ResidentialSpaceHeat:mixed | BN | 2019 | Buildings | mixed |  |  | PENDING | NOT_APPLICABLE | NOT_APPLICABLE | OBSERVATION_NOT_MODEL_VALIDATION | PENDING | Source is raw UNSD or named derived cache, as ledger states. Cache conversion PASS does not prove original fuel/calorific completeness.
BN:2019:Buildings:ResidentialWaterHeat:mixed | BN | 2019 | Buildings | mixed |  |  | PENDING | NOT_APPLICABLE | NOT_APPLICABLE | OBSERVATION_NOT_MODEL_VALIDATION | PENDING | Source is raw UNSD or named derived cache, as ledger states. Cache conversion PASS does not prove original fuel/calorific completeness.
BN:2019:Buildings:ServicesCooking:mixed | BN | 2019 | Buildings | mixed |  |  | PENDING | NOT_APPLICABLE | NOT_APPLICABLE | OBSERVATION_NOT_MODEL_VALIDATION | PENDING | Source is raw UNSD or named derived cache, as ledger states. Cache conversion PASS does not prove original fuel/calorific completeness.
BN:2019:Buildings:ServicesCooling:electricity | BN | 2019 | Buildings | electricity |  |  | PENDING | NOT_APPLICABLE | NOT_APPLICABLE | OBSERVATION_NOT_MODEL_VALIDATION | PENDING | Source is raw UNSD or named derived cache, as ledger states. Cache conversion PASS does not prove original fuel/calorific completeness.
BN:2019:Buildings:ServicesDirectElectricity:electricity | BN | 2019 | Buildings | electricity | 1868292.0 | 1868292.0 | PASS_SOURCE_TO_LEDGER | NOT_APPLICABLE | NOT_APPLICABLE | OBSERVATION_NOT_MODEL_VALIDATION | PARTIAL | Source is raw UNSD or named derived cache, as ledger states. Cache conversion PASS does not prove original fuel/calorific completeness.
BN:2019:Buildings:ServicesFuel:biomass | BN | 2019 | Buildings | biomass |  |  | PENDING | PENDING_ACCEPTED_WEIGHTS | PENDING_ACCEPTED_PROFILE | OBSERVATION_NOT_MODEL_VALIDATION | PENDING | Source is raw UNSD or named derived cache, as ledger states. Cache conversion PASS does not prove original fuel/calorific completeness.
BN:2019:Buildings:ServicesFuel:coal | BN | 2019 | Buildings | coal |  |  | PENDING | PENDING_ACCEPTED_WEIGHTS | PENDING_ACCEPTED_PROFILE | OBSERVATION_NOT_MODEL_VALIDATION | PENDING | Source is raw UNSD or named derived cache, as ledger states. Cache conversion PASS does not prove original fuel/calorific completeness.
BN:2019:Buildings:ServicesFuel:gas | BN | 2019 | Buildings | gas |  |  | PENDING | PENDING_ACCEPTED_WEIGHTS | PENDING_ACCEPTED_PROFILE | OBSERVATION_NOT_MODEL_VALIDATION | PENDING | Source is raw UNSD or named derived cache, as ledger states. Cache conversion PASS does not prove original fuel/calorific completeness.
BN:2019:Buildings:ServicesFuel:oil | BN | 2019 | Buildings | oil |  |  | PENDING | PENDING_ACCEPTED_WEIGHTS | PENDING_ACCEPTED_PROFILE | OBSERVATION_NOT_MODEL_VALIDATION | PENDING | Source is raw UNSD or named derived cache, as ledger states. Cache conversion PASS does not prove original fuel/calorific completeness.
BN:2019:Buildings:ServicesSpaceHeat:mixed | BN | 2019 | Buildings | mixed |  |  | PENDING | NOT_APPLICABLE | NOT_APPLICABLE | OBSERVATION_NOT_MODEL_VALIDATION | PENDING | Source is raw UNSD or named derived cache, as ledger states. Cache conversion PASS does not prove original fuel/calorific completeness.
BN:2019:Buildings:ServicesWaterHeat:mixed | BN | 2019 | Buildings | mixed |  |  | PENDING | NOT_APPLICABLE | NOT_APPLICABLE | OBSERVATION_NOT_MODEL_VALIDATION | PENDING | Source is raw UNSD or named derived cache, as ledger states. Cache conversion PASS does not prove original fuel/calorific completeness.
BN:2019:Bunker:InternationalAviationBunker:oil | BN | 2019 | Bunker | oil | 1324700.0 | 1324700.0 | PASS_SOURCE_TO_LEDGER | PENDING_ACCEPTED_WEIGHTS | PENDING_ACCEPTED_PROFILE | OBSERVATION_NOT_MODEL_VALIDATION | PARTIAL | Source is raw UNSD or named derived cache, as ledger states. Cache conversion PASS does not prove original fuel/calorific completeness.
BN:2019:Bunker:InternationalShippingBunker:oil | BN | 2019 | Bunker | oil |  |  | PENDING | PENDING_ACCEPTED_WEIGHTS | PENDING_ACCEPTED_PROFILE | OBSERVATION_NOT_MODEL_VALIDATION | PENDING | Source is raw UNSD or named derived cache, as ledger states. Cache conversion PASS does not prove original fuel/calorific completeness.
BN:2019:Conversion:EVIfConversion:electricity | BN | 2019 | Conversion | electricity |  |  | PENDING | NOT_APPLICABLE | NOT_APPLICABLE | OBSERVATION_NOT_MODEL_VALIDATION | PENDING | Source is raw UNSD or named derived cache, as ledger states. Cache conversion PASS does not prove original fuel/calorific completeness.
BN:2019:Conversion:Electrolysis:electricity | BN | 2019 | Conversion | electricity |  |  | PENDING | NOT_APPLICABLE | NOT_APPLICABLE | OBSERVATION_NOT_MODEL_VALIDATION | PENDING | Source is raw UNSD or named derived cache, as ledger states. Cache conversion PASS does not prove original fuel/calorific completeness.
BN:2019:Conversion:FischerTropsch:electricity | BN | 2019 | Conversion | electricity |  |  | PENDING | NOT_APPLICABLE | NOT_APPLICABLE | OBSERVATION_NOT_MODEL_VALIDATION | PENDING | Source is raw UNSD or named derived cache, as ledger states. Cache conversion PASS does not prove original fuel/calorific completeness.
BN:2019:Conversion:HeatPump:electricity | BN | 2019 | Conversion | electricity |  |  | PENDING | NOT_APPLICABLE | NOT_APPLICABLE | OBSERVATION_NOT_MODEL_VALIDATION | PENDING | Source is raw UNSD or named derived cache, as ledger states. Cache conversion PASS does not prove original fuel/calorific completeness.
BN:2019:Conversion:ResistiveHeating:electricity | BN | 2019 | Conversion | electricity |  |  | PENDING | NOT_APPLICABLE | NOT_APPLICABLE | OBSERVATION_NOT_MODEL_VALIDATION | PENDING | Source is raw UNSD or named derived cache, as ledger states. Cache conversion PASS does not prove original fuel/calorific completeness.
BN:2019:Electricity:Astar:electricity | BN | 2019 | Electricity | electricity | 3906135.0 | 3906135.0 | PASS_SOURCE_TO_LEDGER | PENDING_ACCEPTED_WEIGHTS | PENDING_ACCEPTED_PROFILE | OBSERVATION_NOT_MODEL_VALIDATION | PARTIAL | Source is raw UNSD or named derived cache, as ledger states. Cache conversion PASS does not prove original fuel/calorific completeness.
BN:2019:Industry:IndustryCacheElectricityReference:electricity | BN | 2019 | Industry | electricity | 709181.0 | 709181.0 | PASS_SOURCE_TO_LEDGER | NOT_APPLICABLE | NOT_APPLICABLE | OBSERVATION_NOT_MODEL_VALIDATION | PARTIAL | Source is raw UNSD or named derived cache, as ledger states. Cache conversion PASS does not prove original fuel/calorific completeness.
BN:2019:Industry:IndustryDirectElectricity:electricity | BN | 2019 | Industry | electricity | 709181.0 | 709181.0 | PASS_SOURCE_TO_LEDGER | NOT_APPLICABLE | NOT_APPLICABLE | OBSERVATION_NOT_MODEL_VALIDATION | PARTIAL | Source is raw UNSD or named derived cache, as ledger states. Cache conversion PASS does not prove original fuel/calorific completeness.
BN:2019:Industry:IndustryFuel:biomass | BN | 2019 | Industry | biomass |  |  | PENDING | PENDING_ACCEPTED_WEIGHTS | PENDING_ACCEPTED_PROFILE | OBSERVATION_NOT_MODEL_VALIDATION | PENDING | Source is raw UNSD or named derived cache, as ledger states. Cache conversion PASS does not prove original fuel/calorific completeness.
BN:2019:Industry:IndustryFuel:coal | BN | 2019 | Industry | coal |  |  | PENDING | PENDING_ACCEPTED_WEIGHTS | PENDING_ACCEPTED_PROFILE | OBSERVATION_NOT_MODEL_VALIDATION | PENDING | Source is raw UNSD or named derived cache, as ledger states. Cache conversion PASS does not prove original fuel/calorific completeness.
BN:2019:Industry:IndustryFuel:gas | BN | 2019 | Industry | gas |  |  | PENDING | PENDING_ACCEPTED_WEIGHTS | PENDING_ACCEPTED_PROFILE | OBSERVATION_NOT_MODEL_VALIDATION | PENDING | Source is raw UNSD or named derived cache, as ledger states. Cache conversion PASS does not prove original fuel/calorific completeness.
BN:2019:Industry:IndustryFuel:heat | BN | 2019 | Industry | heat |  |  | PENDING | NOT_APPLICABLE | NOT_APPLICABLE | OBSERVATION_NOT_MODEL_VALIDATION | PENDING | Source is raw UNSD or named derived cache, as ledger states. Cache conversion PASS does not prove original fuel/calorific completeness.
BN:2019:Industry:IndustryFuel:hydrogen | BN | 2019 | Industry | hydrogen |  |  | PENDING | NOT_APPLICABLE | NOT_APPLICABLE | OBSERVATION_NOT_MODEL_VALIDATION | PENDING | Source is raw UNSD or named derived cache, as ledger states. Cache conversion PASS does not prove original fuel/calorific completeness.
BN:2019:Industry:IndustryFuel:oil | BN | 2019 | Industry | oil | 1498691.88 | 1498691.88 | PASS_SOURCE_TO_LEDGER | PENDING_ACCEPTED_WEIGHTS | PENDING_ACCEPTED_PROFILE | OBSERVATION_NOT_MODEL_VALIDATION | PARTIAL | Source is raw UNSD or named derived cache, as ledger states. Cache conversion PASS does not prove original fuel/calorific completeness.
BN:2019:Transport:DomesticAviationFuel:oil | BN | 2019 | Transport | oil |  |  | PENDING | PENDING_ACCEPTED_WEIGHTS | PENDING_ACCEPTED_PROFILE | OBSERVATION_NOT_MODEL_VALIDATION | PENDING | Source is raw UNSD or named derived cache, as ledger states. Cache conversion PASS does not prove original fuel/calorific completeness.
BN:2019:Transport:DomesticShippingFuel:oil | BN | 2019 | Transport | oil |  |  | PENDING | PENDING_ACCEPTED_WEIGHTS | PENDING_ACCEPTED_PROFILE | OBSERVATION_NOT_MODEL_VALIDATION | PENDING | Source is raw UNSD or named derived cache, as ledger states. Cache conversion PASS does not prove original fuel/calorific completeness.
BN:2019:Transport:HistoricalRoadElectricity:electricity | BN | 2019 | Transport | electricity |  |  | PENDING | NOT_APPLICABLE | NOT_APPLICABLE | OBSERVATION_NOT_MODEL_VALIDATION | PENDING | Source is raw UNSD or named derived cache, as ledger states. Cache conversion PASS does not prove original fuel/calorific completeness.
BN:2019:Transport:RailElectricity:electricity | BN | 2019 | Transport | electricity |  |  | PENDING | NOT_APPLICABLE | NOT_APPLICABLE | OBSERVATION_NOT_MODEL_VALIDATION | PENDING | Source is raw UNSD or named derived cache, as ledger states. Cache conversion PASS does not prove original fuel/calorific completeness.
BN:2019:Transport:RailFinalEnergyReference:mixed | BN | 2019 | Transport | mixed |  |  | PENDING | NOT_APPLICABLE | NOT_APPLICABLE | OBSERVATION_NOT_MODEL_VALIDATION | PENDING | Source is raw UNSD or named derived cache, as ledger states. Cache conversion PASS does not prove original fuel/calorific completeness.
BN:2019:Transport:RoadParentFinalEnergy:all_final_energy | BN | 2019 | Transport | all_final_energy | 5134000.0 | 5134000.0 | PASS_SOURCE_TO_LEDGER | NOT_APPLICABLE | NOT_APPLICABLE | OBSERVATION_NOT_MODEL_VALIDATION | PARTIAL | Source is raw UNSD or named derived cache, as ledger states. Cache conversion PASS does not prove original fuel/calorific completeness.
BN:2019:Transport:RoadResidualFuel:biomass | BN | 2019 | Transport | biomass |  |  | PENDING | PENDING_ACCEPTED_WEIGHTS | PENDING_ACCEPTED_PROFILE | OBSERVATION_NOT_MODEL_VALIDATION | PENDING | Source is raw UNSD or named derived cache, as ledger states. Cache conversion PASS does not prove original fuel/calorific completeness.
BN:2019:Transport:RoadResidualFuel:gas | BN | 2019 | Transport | gas |  |  | PENDING | PENDING_ACCEPTED_WEIGHTS | PENDING_ACCEPTED_PROFILE | OBSERVATION_NOT_MODEL_VALIDATION | PENDING | Source is raw UNSD or named derived cache, as ledger states. Cache conversion PASS does not prove original fuel/calorific completeness.
BN:2019:Transport:RoadResidualFuel:oil | BN | 2019 | Transport | oil | 5134000.0 | 5134000.0 | PASS_SOURCE_TO_LEDGER | PENDING_ACCEPTED_WEIGHTS | PENDING_ACCEPTED_PROFILE | OBSERVATION_NOT_MODEL_VALIDATION | PARTIAL | Source is raw UNSD or named derived cache, as ledger states. Cache conversion PASS does not prove original fuel/calorific completeness.
BN:2019:Transport:TransportEmbeddedFuelParent:unclassified_fuel | BN | 2019 | Transport | unclassified_fuel |  |  | PENDING | PENDING_ACCEPTED_WEIGHTS | PENDING_ACCEPTED_PROFILE | OBSERVATION_NOT_MODEL_VALIDATION | PENDING | Source is raw UNSD or named derived cache, as ledger states. Cache conversion PASS does not prove original fuel/calorific completeness.
BN:2030:Agriculture:AgricultureDirectElectricity:electricity | BN | 2030 | Agriculture | electricity |  |  | PENDING | NOT_APPLICABLE | NOT_APPLICABLE | OBSERVATION_NOT_MODEL_VALIDATION | PENDING | Source is raw UNSD or named derived cache, as ledger states. Cache conversion PASS does not prove original fuel/calorific completeness.
BN:2030:Agriculture:AgricultureFinalEnergy:biomass | BN | 2030 | Agriculture | biomass |  |  | PENDING | PENDING_ACCEPTED_WEIGHTS | PENDING_ACCEPTED_PROFILE | OBSERVATION_NOT_MODEL_VALIDATION | PENDING | Source is raw UNSD or named derived cache, as ledger states. Cache conversion PASS does not prove original fuel/calorific completeness.
BN:2030:Agriculture:AgricultureFinalEnergy:coal | BN | 2030 | Agriculture | coal |  |  | PENDING | PENDING_ACCEPTED_WEIGHTS | PENDING_ACCEPTED_PROFILE | OBSERVATION_NOT_MODEL_VALIDATION | PENDING | Source is raw UNSD or named derived cache, as ledger states. Cache conversion PASS does not prove original fuel/calorific completeness.
BN:2030:Agriculture:AgricultureFinalEnergy:oil | BN | 2030 | Agriculture | oil |  |  | PENDING | PENDING_ACCEPTED_WEIGHTS | PENDING_ACCEPTED_PROFILE | OBSERVATION_NOT_MODEL_VALIDATION | PENDING | Source is raw UNSD or named derived cache, as ledger states. Cache conversion PASS does not prove original fuel/calorific completeness.
BN:2030:Buildings:ResidentialDirectElectricity:electricity | BN | 2030 | Buildings | electricity |  |  | PENDING | NOT_APPLICABLE | NOT_APPLICABLE | OBSERVATION_NOT_MODEL_VALIDATION | PENDING | Source is raw UNSD or named derived cache, as ledger states. Cache conversion PASS does not prove original fuel/calorific completeness.
BN:2030:Buildings:ResidentialFuel:biomass | BN | 2030 | Buildings | biomass |  |  | PENDING | PENDING_ACCEPTED_WEIGHTS | PENDING_ACCEPTED_PROFILE | OBSERVATION_NOT_MODEL_VALIDATION | PENDING | Source is raw UNSD or named derived cache, as ledger states. Cache conversion PASS does not prove original fuel/calorific completeness.
BN:2030:Buildings:ResidentialFuel:coal | BN | 2030 | Buildings | coal |  |  | PENDING | PENDING_ACCEPTED_WEIGHTS | PENDING_ACCEPTED_PROFILE | OBSERVATION_NOT_MODEL_VALIDATION | PENDING | Source is raw UNSD or named derived cache, as ledger states. Cache conversion PASS does not prove original fuel/calorific completeness.
BN:2030:Buildings:ResidentialFuel:gas | BN | 2030 | Buildings | gas |  |  | PENDING | PENDING_ACCEPTED_WEIGHTS | PENDING_ACCEPTED_PROFILE | OBSERVATION_NOT_MODEL_VALIDATION | PENDING | Source is raw UNSD or named derived cache, as ledger states. Cache conversion PASS does not prove original fuel/calorific completeness.
BN:2030:Buildings:ResidentialFuel:oil | BN | 2030 | Buildings | oil |  |  | PENDING | PENDING_ACCEPTED_WEIGHTS | PENDING_ACCEPTED_PROFILE | OBSERVATION_NOT_MODEL_VALIDATION | PENDING | Source is raw UNSD or named derived cache, as ledger states. Cache conversion PASS does not prove original fuel/calorific completeness.
BN:2030:Buildings:ServicesDirectElectricity:electricity | BN | 2030 | Buildings | electricity |  |  | PENDING | NOT_APPLICABLE | NOT_APPLICABLE | OBSERVATION_NOT_MODEL_VALIDATION | PENDING | Source is raw UNSD or named derived cache, as ledger states. Cache conversion PASS does not prove original fuel/calorific completeness.
BN:2030:Buildings:ServicesFuel:biomass | BN | 2030 | Buildings | biomass |  |  | PENDING | PENDING_ACCEPTED_WEIGHTS | PENDING_ACCEPTED_PROFILE | OBSERVATION_NOT_MODEL_VALIDATION | PENDING | Source is raw UNSD or named derived cache, as ledger states. Cache conversion PASS does not prove original fuel/calorific completeness.
BN:2030:Buildings:ServicesFuel:coal | BN | 2030 | Buildings | coal |  |  | PENDING | PENDING_ACCEPTED_WEIGHTS | PENDING_ACCEPTED_PROFILE | OBSERVATION_NOT_MODEL_VALIDATION | PENDING | Source is raw UNSD or named derived cache, as ledger states. Cache conversion PASS does not prove original fuel/calorific completeness.
BN:2030:Buildings:ServicesFuel:gas | BN | 2030 | Buildings | gas |  |  | PENDING | PENDING_ACCEPTED_WEIGHTS | PENDING_ACCEPTED_PROFILE | OBSERVATION_NOT_MODEL_VALIDATION | PENDING | Source is raw UNSD or named derived cache, as ledger states. Cache conversion PASS does not prove original fuel/calorific completeness.
BN:2030:Buildings:ServicesFuel:oil | BN | 2030 | Buildings | oil |  |  | PENDING | PENDING_ACCEPTED_WEIGHTS | PENDING_ACCEPTED_PROFILE | OBSERVATION_NOT_MODEL_VALIDATION | PENDING | Source is raw UNSD or named derived cache, as ledger states. Cache conversion PASS does not prove original fuel/calorific completeness.
BN:2030:Bunker:InternationalAviationBunker:oil | BN | 2030 | Bunker | oil |  |  | PENDING | PENDING_ACCEPTED_WEIGHTS | PENDING_ACCEPTED_PROFILE | OBSERVATION_NOT_MODEL_VALIDATION | PENDING | Source is raw UNSD or named derived cache, as ledger states. Cache conversion PASS does not prove original fuel/calorific completeness.
BN:2030:Bunker:InternationalShippingBunker:oil | BN | 2030 | Bunker | oil |  |  | PENDING | PENDING_ACCEPTED_WEIGHTS | PENDING_ACCEPTED_PROFILE | OBSERVATION_NOT_MODEL_VALIDATION | PENDING | Source is raw UNSD or named derived cache, as ledger states. Cache conversion PASS does not prove original fuel/calorific completeness.
BN:2030:Electricity:Astar:electricity | BN | 2030 | Electricity | electricity |  |  | PENDING | PENDING_ACCEPTED_WEIGHTS | PENDING_ACCEPTED_PROFILE | OBSERVATION_NOT_MODEL_VALIDATION | PENDING | Source is raw UNSD or named derived cache, as ledger states. Cache conversion PASS does not prove original fuel/calorific completeness.
BN:2030:Industry:IndustryDirectElectricity:electricity | BN | 2030 | Industry | electricity |  |  | PENDING | NOT_APPLICABLE | NOT_APPLICABLE | OBSERVATION_NOT_MODEL_VALIDATION | PENDING | Source is raw UNSD or named derived cache, as ledger states. Cache conversion PASS does not prove original fuel/calorific completeness.
BN:2030:Industry:IndustryFinalEnergy:biomass | BN | 2030 | Industry | biomass |  |  | PENDING | PENDING_ACCEPTED_WEIGHTS | PENDING_ACCEPTED_PROFILE | OBSERVATION_NOT_MODEL_VALIDATION | PENDING | Source is raw UNSD or named derived cache, as ledger states. Cache conversion PASS does not prove original fuel/calorific completeness.
BN:2030:Industry:IndustryFinalEnergy:coal | BN | 2030 | Industry | coal |  |  | PENDING | PENDING_ACCEPTED_WEIGHTS | PENDING_ACCEPTED_PROFILE | OBSERVATION_NOT_MODEL_VALIDATION | PENDING | Source is raw UNSD or named derived cache, as ledger states. Cache conversion PASS does not prove original fuel/calorific completeness.
BN:2030:Industry:IndustryFinalEnergy:gas | BN | 2030 | Industry | gas |  |  | PENDING | PENDING_ACCEPTED_WEIGHTS | PENDING_ACCEPTED_PROFILE | OBSERVATION_NOT_MODEL_VALIDATION | PENDING | Source is raw UNSD or named derived cache, as ledger states. Cache conversion PASS does not prove original fuel/calorific completeness.
BN:2030:Industry:IndustryFinalEnergy:oil | BN | 2030 | Industry | oil |  |  | PENDING | PENDING_ACCEPTED_WEIGHTS | PENDING_ACCEPTED_PROFILE | OBSERVATION_NOT_MODEL_VALIDATION | PENDING | Source is raw UNSD or named derived cache, as ledger states. Cache conversion PASS does not prove original fuel/calorific completeness.
BN:2030:Transport:DomesticAviationFuel:oil | BN | 2030 | Transport | oil |  |  | PENDING | PENDING_ACCEPTED_WEIGHTS | PENDING_ACCEPTED_PROFILE | OBSERVATION_NOT_MODEL_VALIDATION | PENDING | Source is raw UNSD or named derived cache, as ledger states. Cache conversion PASS does not prove original fuel/calorific completeness.
BN:2030:Transport:DomesticShippingFuel:oil | BN | 2030 | Transport | oil |  |  | PENDING | PENDING_ACCEPTED_WEIGHTS | PENDING_ACCEPTED_PROFILE | OBSERVATION_NOT_MODEL_VALIDATION | PENDING | Source is raw UNSD or named derived cache, as ledger states. Cache conversion PASS does not prove original fuel/calorific completeness.
BN:2030:Transport:RailElectricity:electricity | BN | 2030 | Transport | electricity |  |  | PENDING | NOT_APPLICABLE | NOT_APPLICABLE | OBSERVATION_NOT_MODEL_VALIDATION | PENDING | Source is raw UNSD or named derived cache, as ledger states. Cache conversion PASS does not prove original fuel/calorific completeness.
BN:2030:Transport:RoadEVFinalElectricity:electricity | BN | 2030 | Transport | electricity |  |  | PENDING | PENDING_ACCEPTED_WEIGHTS | PENDING_ACCEPTED_PROFILE | OBSERVATION_NOT_MODEL_VALIDATION | PENDING | Source is raw UNSD or named derived cache, as ledger states. Cache conversion PASS does not prove original fuel/calorific completeness.
BN:2030:Transport:RoadResidualFuel:biomass | BN | 2030 | Transport | biomass |  |  | PENDING | PENDING_ACCEPTED_WEIGHTS | PENDING_ACCEPTED_PROFILE | OBSERVATION_NOT_MODEL_VALIDATION | PENDING | Source is raw UNSD or named derived cache, as ledger states. Cache conversion PASS does not prove original fuel/calorific completeness.
BN:2030:Transport:RoadResidualFuel:gas | BN | 2030 | Transport | gas |  |  | PENDING | PENDING_ACCEPTED_WEIGHTS | PENDING_ACCEPTED_PROFILE | OBSERVATION_NOT_MODEL_VALIDATION | PENDING | Source is raw UNSD or named derived cache, as ledger states. Cache conversion PASS does not prove original fuel/calorific completeness.
BN:2030:Transport:RoadResidualFuel:oil | BN | 2030 | Transport | oil |  |  | PENDING | PENDING_ACCEPTED_WEIGHTS | PENDING_ACCEPTED_PROFILE | OBSERVATION_NOT_MODEL_VALIDATION | PENDING | Source is raw UNSD or named derived cache, as ledger states. Cache conversion PASS does not prove original fuel/calorific completeness.
BN:2030:Transport:TransportEmbeddedFuelParent:unclassified_fuel | BN | 2030 | Transport | unclassified_fuel |  |  | PENDING | PENDING_ACCEPTED_WEIGHTS | PENDING_ACCEPTED_PROFILE | OBSERVATION_NOT_MODEL_VALIDATION | PENDING | Source is raw UNSD or named derived cache, as ledger states. Cache conversion PASS does not prove original fuel/calorific completeness.
BN:2040:Agriculture:AgricultureDirectElectricity:electricity | BN | 2040 | Agriculture | electricity |  |  | PENDING | NOT_APPLICABLE | NOT_APPLICABLE | OBSERVATION_NOT_MODEL_VALIDATION | PENDING | Source is raw UNSD or named derived cache, as ledger states. Cache conversion PASS does not prove original fuel/calorific completeness.
BN:2040:Agriculture:AgricultureFinalEnergy:biomass | BN | 2040 | Agriculture | biomass |  |  | PENDING | PENDING_ACCEPTED_WEIGHTS | PENDING_ACCEPTED_PROFILE | OBSERVATION_NOT_MODEL_VALIDATION | PENDING | Source is raw UNSD or named derived cache, as ledger states. Cache conversion PASS does not prove original fuel/calorific completeness.
BN:2040:Agriculture:AgricultureFinalEnergy:coal | BN | 2040 | Agriculture | coal |  |  | PENDING | PENDING_ACCEPTED_WEIGHTS | PENDING_ACCEPTED_PROFILE | OBSERVATION_NOT_MODEL_VALIDATION | PENDING | Source is raw UNSD or named derived cache, as ledger states. Cache conversion PASS does not prove original fuel/calorific completeness.
BN:2040:Agriculture:AgricultureFinalEnergy:oil | BN | 2040 | Agriculture | oil |  |  | PENDING | PENDING_ACCEPTED_WEIGHTS | PENDING_ACCEPTED_PROFILE | OBSERVATION_NOT_MODEL_VALIDATION | PENDING | Source is raw UNSD or named derived cache, as ledger states. Cache conversion PASS does not prove original fuel/calorific completeness.
BN:2040:Buildings:ResidentialDirectElectricity:electricity | BN | 2040 | Buildings | electricity |  |  | PENDING | NOT_APPLICABLE | NOT_APPLICABLE | OBSERVATION_NOT_MODEL_VALIDATION | PENDING | Source is raw UNSD or named derived cache, as ledger states. Cache conversion PASS does not prove original fuel/calorific completeness.
BN:2040:Buildings:ResidentialFuel:biomass | BN | 2040 | Buildings | biomass |  |  | PENDING | PENDING_ACCEPTED_WEIGHTS | PENDING_ACCEPTED_PROFILE | OBSERVATION_NOT_MODEL_VALIDATION | PENDING | Source is raw UNSD or named derived cache, as ledger states. Cache conversion PASS does not prove original fuel/calorific completeness.
BN:2040:Buildings:ResidentialFuel:coal | BN | 2040 | Buildings | coal |  |  | PENDING | PENDING_ACCEPTED_WEIGHTS | PENDING_ACCEPTED_PROFILE | OBSERVATION_NOT_MODEL_VALIDATION | PENDING | Source is raw UNSD or named derived cache, as ledger states. Cache conversion PASS does not prove original fuel/calorific completeness.
BN:2040:Buildings:ResidentialFuel:gas | BN | 2040 | Buildings | gas |  |  | PENDING | PENDING_ACCEPTED_WEIGHTS | PENDING_ACCEPTED_PROFILE | OBSERVATION_NOT_MODEL_VALIDATION | PENDING | Source is raw UNSD or named derived cache, as ledger states. Cache conversion PASS does not prove original fuel/calorific completeness.
BN:2040:Buildings:ResidentialFuel:oil | BN | 2040 | Buildings | oil |  |  | PENDING | PENDING_ACCEPTED_WEIGHTS | PENDING_ACCEPTED_PROFILE | OBSERVATION_NOT_MODEL_VALIDATION | PENDING | Source is raw UNSD or named derived cache, as ledger states. Cache conversion PASS does not prove original fuel/calorific completeness.
BN:2040:Buildings:ServicesDirectElectricity:electricity | BN | 2040 | Buildings | electricity |  |  | PENDING | NOT_APPLICABLE | NOT_APPLICABLE | OBSERVATION_NOT_MODEL_VALIDATION | PENDING | Source is raw UNSD or named derived cache, as ledger states. Cache conversion PASS does not prove original fuel/calorific completeness.
BN:2040:Buildings:ServicesFuel:biomass | BN | 2040 | Buildings | biomass |  |  | PENDING | PENDING_ACCEPTED_WEIGHTS | PENDING_ACCEPTED_PROFILE | OBSERVATION_NOT_MODEL_VALIDATION | PENDING | Source is raw UNSD or named derived cache, as ledger states. Cache conversion PASS does not prove original fuel/calorific completeness.
BN:2040:Buildings:ServicesFuel:coal | BN | 2040 | Buildings | coal |  |  | PENDING | PENDING_ACCEPTED_WEIGHTS | PENDING_ACCEPTED_PROFILE | OBSERVATION_NOT_MODEL_VALIDATION | PENDING | Source is raw UNSD or named derived cache, as ledger states. Cache conversion PASS does not prove original fuel/calorific completeness.
BN:2040:Buildings:ServicesFuel:gas | BN | 2040 | Buildings | gas |  |  | PENDING | PENDING_ACCEPTED_WEIGHTS | PENDING_ACCEPTED_PROFILE | OBSERVATION_NOT_MODEL_VALIDATION | PENDING | Source is raw UNSD or named derived cache, as ledger states. Cache conversion PASS does not prove original fuel/calorific completeness.
BN:2040:Buildings:ServicesFuel:oil | BN | 2040 | Buildings | oil |  |  | PENDING | PENDING_ACCEPTED_WEIGHTS | PENDING_ACCEPTED_PROFILE | OBSERVATION_NOT_MODEL_VALIDATION | PENDING | Source is raw UNSD or named derived cache, as ledger states. Cache conversion PASS does not prove original fuel/calorific completeness.
BN:2040:Bunker:InternationalAviationBunker:oil | BN | 2040 | Bunker | oil |  |  | PENDING | PENDING_ACCEPTED_WEIGHTS | PENDING_ACCEPTED_PROFILE | OBSERVATION_NOT_MODEL_VALIDATION | PENDING | Source is raw UNSD or named derived cache, as ledger states. Cache conversion PASS does not prove original fuel/calorific completeness.
BN:2040:Bunker:InternationalShippingBunker:oil | BN | 2040 | Bunker | oil |  |  | PENDING | PENDING_ACCEPTED_WEIGHTS | PENDING_ACCEPTED_PROFILE | OBSERVATION_NOT_MODEL_VALIDATION | PENDING | Source is raw UNSD or named derived cache, as ledger states. Cache conversion PASS does not prove original fuel/calorific completeness.
BN:2040:Electricity:Astar:electricity | BN | 2040 | Electricity | electricity |  |  | PENDING | PENDING_ACCEPTED_WEIGHTS | PENDING_ACCEPTED_PROFILE | OBSERVATION_NOT_MODEL_VALIDATION | PENDING | Source is raw UNSD or named derived cache, as ledger states. Cache conversion PASS does not prove original fuel/calorific completeness.
BN:2040:Industry:IndustryDirectElectricity:electricity | BN | 2040 | Industry | electricity |  |  | PENDING | NOT_APPLICABLE | NOT_APPLICABLE | OBSERVATION_NOT_MODEL_VALIDATION | PENDING | Source is raw UNSD or named derived cache, as ledger states. Cache conversion PASS does not prove original fuel/calorific completeness.
BN:2040:Industry:IndustryFinalEnergy:biomass | BN | 2040 | Industry | biomass |  |  | PENDING | PENDING_ACCEPTED_WEIGHTS | PENDING_ACCEPTED_PROFILE | OBSERVATION_NOT_MODEL_VALIDATION | PENDING | Source is raw UNSD or named derived cache, as ledger states. Cache conversion PASS does not prove original fuel/calorific completeness.
BN:2040:Industry:IndustryFinalEnergy:coal | BN | 2040 | Industry | coal |  |  | PENDING | PENDING_ACCEPTED_WEIGHTS | PENDING_ACCEPTED_PROFILE | OBSERVATION_NOT_MODEL_VALIDATION | PENDING | Source is raw UNSD or named derived cache, as ledger states. Cache conversion PASS does not prove original fuel/calorific completeness.
BN:2040:Industry:IndustryFinalEnergy:gas | BN | 2040 | Industry | gas |  |  | PENDING | PENDING_ACCEPTED_WEIGHTS | PENDING_ACCEPTED_PROFILE | OBSERVATION_NOT_MODEL_VALIDATION | PENDING | Source is raw UNSD or named derived cache, as ledger states. Cache conversion PASS does not prove original fuel/calorific completeness.
BN:2040:Industry:IndustryFinalEnergy:oil | BN | 2040 | Industry | oil |  |  | PENDING | PENDING_ACCEPTED_WEIGHTS | PENDING_ACCEPTED_PROFILE | OBSERVATION_NOT_MODEL_VALIDATION | PENDING | Source is raw UNSD or named derived cache, as ledger states. Cache conversion PASS does not prove original fuel/calorific completeness.
BN:2040:Transport:DomesticAviationFuel:oil | BN | 2040 | Transport | oil |  |  | PENDING | PENDING_ACCEPTED_WEIGHTS | PENDING_ACCEPTED_PROFILE | OBSERVATION_NOT_MODEL_VALIDATION | PENDING | Source is raw UNSD or named derived cache, as ledger states. Cache conversion PASS does not prove original fuel/calorific completeness.
BN:2040:Transport:DomesticShippingFuel:oil | BN | 2040 | Transport | oil |  |  | PENDING | PENDING_ACCEPTED_WEIGHTS | PENDING_ACCEPTED_PROFILE | OBSERVATION_NOT_MODEL_VALIDATION | PENDING | Source is raw UNSD or named derived cache, as ledger states. Cache conversion PASS does not prove original fuel/calorific completeness.
BN:2040:Transport:RailElectricity:electricity | BN | 2040 | Transport | electricity |  |  | PENDING | NOT_APPLICABLE | NOT_APPLICABLE | OBSERVATION_NOT_MODEL_VALIDATION | PENDING | Source is raw UNSD or named derived cache, as ledger states. Cache conversion PASS does not prove original fuel/calorific completeness.
BN:2040:Transport:RoadEVFinalElectricity:electricity | BN | 2040 | Transport | electricity |  |  | PENDING | PENDING_ACCEPTED_WEIGHTS | PENDING_ACCEPTED_PROFILE | OBSERVATION_NOT_MODEL_VALIDATION | PENDING | Source is raw UNSD or named derived cache, as ledger states. Cache conversion PASS does not prove original fuel/calorific completeness.
BN:2040:Transport:RoadResidualFuel:biomass | BN | 2040 | Transport | biomass |  |  | PENDING | PENDING_ACCEPTED_WEIGHTS | PENDING_ACCEPTED_PROFILE | OBSERVATION_NOT_MODEL_VALIDATION | PENDING | Source is raw UNSD or named derived cache, as ledger states. Cache conversion PASS does not prove original fuel/calorific completeness.
BN:2040:Transport:RoadResidualFuel:gas | BN | 2040 | Transport | gas |  |  | PENDING | PENDING_ACCEPTED_WEIGHTS | PENDING_ACCEPTED_PROFILE | OBSERVATION_NOT_MODEL_VALIDATION | PENDING | Source is raw UNSD or named derived cache, as ledger states. Cache conversion PASS does not prove original fuel/calorific completeness.
BN:2040:Transport:RoadResidualFuel:oil | BN | 2040 | Transport | oil |  |  | PENDING | PENDING_ACCEPTED_WEIGHTS | PENDING_ACCEPTED_PROFILE | OBSERVATION_NOT_MODEL_VALIDATION | PENDING | Source is raw UNSD or named derived cache, as ledger states. Cache conversion PASS does not prove original fuel/calorific completeness.
BN:2040:Transport:TransportEmbeddedFuelParent:unclassified_fuel | BN | 2040 | Transport | unclassified_fuel |  |  | PENDING | PENDING_ACCEPTED_WEIGHTS | PENDING_ACCEPTED_PROFILE | OBSERVATION_NOT_MODEL_VALIDATION | PENDING | Source is raw UNSD or named derived cache, as ledger states. Cache conversion PASS does not prove original fuel/calorific completeness.
BN:2050:Agriculture:AgricultureDirectElectricity:electricity | BN | 2050 | Agriculture | electricity |  |  | PENDING | NOT_APPLICABLE | NOT_APPLICABLE | OBSERVATION_NOT_MODEL_VALIDATION | PENDING | Source is raw UNSD or named derived cache, as ledger states. Cache conversion PASS does not prove original fuel/calorific completeness.
BN:2050:Agriculture:AgricultureFinalEnergy:biomass | BN | 2050 | Agriculture | biomass |  |  | PENDING | PENDING_ACCEPTED_WEIGHTS | PENDING_ACCEPTED_PROFILE | OBSERVATION_NOT_MODEL_VALIDATION | PENDING | Source is raw UNSD or named derived cache, as ledger states. Cache conversion PASS does not prove original fuel/calorific completeness.
BN:2050:Agriculture:AgricultureFinalEnergy:coal | BN | 2050 | Agriculture | coal |  |  | PENDING | PENDING_ACCEPTED_WEIGHTS | PENDING_ACCEPTED_PROFILE | OBSERVATION_NOT_MODEL_VALIDATION | PENDING | Source is raw UNSD or named derived cache, as ledger states. Cache conversion PASS does not prove original fuel/calorific completeness.
BN:2050:Agriculture:AgricultureFinalEnergy:oil | BN | 2050 | Agriculture | oil |  |  | PENDING | PENDING_ACCEPTED_WEIGHTS | PENDING_ACCEPTED_PROFILE | OBSERVATION_NOT_MODEL_VALIDATION | PENDING | Source is raw UNSD or named derived cache, as ledger states. Cache conversion PASS does not prove original fuel/calorific completeness.
BN:2050:Buildings:ResidentialDirectElectricity:electricity | BN | 2050 | Buildings | electricity |  |  | PENDING | NOT_APPLICABLE | NOT_APPLICABLE | OBSERVATION_NOT_MODEL_VALIDATION | PENDING | Source is raw UNSD or named derived cache, as ledger states. Cache conversion PASS does not prove original fuel/calorific completeness.
BN:2050:Buildings:ResidentialFuel:biomass | BN | 2050 | Buildings | biomass |  |  | PENDING | PENDING_ACCEPTED_WEIGHTS | PENDING_ACCEPTED_PROFILE | OBSERVATION_NOT_MODEL_VALIDATION | PENDING | Source is raw UNSD or named derived cache, as ledger states. Cache conversion PASS does not prove original fuel/calorific completeness.
BN:2050:Buildings:ResidentialFuel:coal | BN | 2050 | Buildings | coal |  |  | PENDING | PENDING_ACCEPTED_WEIGHTS | PENDING_ACCEPTED_PROFILE | OBSERVATION_NOT_MODEL_VALIDATION | PENDING | Source is raw UNSD or named derived cache, as ledger states. Cache conversion PASS does not prove original fuel/calorific completeness.
BN:2050:Buildings:ResidentialFuel:gas | BN | 2050 | Buildings | gas |  |  | PENDING | PENDING_ACCEPTED_WEIGHTS | PENDING_ACCEPTED_PROFILE | OBSERVATION_NOT_MODEL_VALIDATION | PENDING | Source is raw UNSD or named derived cache, as ledger states. Cache conversion PASS does not prove original fuel/calorific completeness.
BN:2050:Buildings:ResidentialFuel:oil | BN | 2050 | Buildings | oil |  |  | PENDING | PENDING_ACCEPTED_WEIGHTS | PENDING_ACCEPTED_PROFILE | OBSERVATION_NOT_MODEL_VALIDATION | PENDING | Source is raw UNSD or named derived cache, as ledger states. Cache conversion PASS does not prove original fuel/calorific completeness.
BN:2050:Buildings:ServicesDirectElectricity:electricity | BN | 2050 | Buildings | electricity |  |  | PENDING | NOT_APPLICABLE | NOT_APPLICABLE | OBSERVATION_NOT_MODEL_VALIDATION | PENDING | Source is raw UNSD or named derived cache, as ledger states. Cache conversion PASS does not prove original fuel/calorific completeness.
BN:2050:Buildings:ServicesFuel:biomass | BN | 2050 | Buildings | biomass |  |  | PENDING | PENDING_ACCEPTED_WEIGHTS | PENDING_ACCEPTED_PROFILE | OBSERVATION_NOT_MODEL_VALIDATION | PENDING | Source is raw UNSD or named derived cache, as ledger states. Cache conversion PASS does not prove original fuel/calorific completeness.
BN:2050:Buildings:ServicesFuel:coal | BN | 2050 | Buildings | coal |  |  | PENDING | PENDING_ACCEPTED_WEIGHTS | PENDING_ACCEPTED_PROFILE | OBSERVATION_NOT_MODEL_VALIDATION | PENDING | Source is raw UNSD or named derived cache, as ledger states. Cache conversion PASS does not prove original fuel/calorific completeness.
BN:2050:Buildings:ServicesFuel:gas | BN | 2050 | Buildings | gas |  |  | PENDING | PENDING_ACCEPTED_WEIGHTS | PENDING_ACCEPTED_PROFILE | OBSERVATION_NOT_MODEL_VALIDATION | PENDING | Source is raw UNSD or named derived cache, as ledger states. Cache conversion PASS does not prove original fuel/calorific completeness.
BN:2050:Buildings:ServicesFuel:oil | BN | 2050 | Buildings | oil |  |  | PENDING | PENDING_ACCEPTED_WEIGHTS | PENDING_ACCEPTED_PROFILE | OBSERVATION_NOT_MODEL_VALIDATION | PENDING | Source is raw UNSD or named derived cache, as ledger states. Cache conversion PASS does not prove original fuel/calorific completeness.
BN:2050:Bunker:InternationalAviationBunker:oil | BN | 2050 | Bunker | oil |  |  | PENDING | PENDING_ACCEPTED_WEIGHTS | PENDING_ACCEPTED_PROFILE | OBSERVATION_NOT_MODEL_VALIDATION | PENDING | Source is raw UNSD or named derived cache, as ledger states. Cache conversion PASS does not prove original fuel/calorific completeness.
BN:2050:Bunker:InternationalShippingBunker:oil | BN | 2050 | Bunker | oil |  |  | PENDING | PENDING_ACCEPTED_WEIGHTS | PENDING_ACCEPTED_PROFILE | OBSERVATION_NOT_MODEL_VALIDATION | PENDING | Source is raw UNSD or named derived cache, as ledger states. Cache conversion PASS does not prove original fuel/calorific completeness.
BN:2050:Electricity:Astar:electricity | BN | 2050 | Electricity | electricity |  |  | PENDING | PENDING_ACCEPTED_WEIGHTS | PENDING_ACCEPTED_PROFILE | OBSERVATION_NOT_MODEL_VALIDATION | PENDING | Source is raw UNSD or named derived cache, as ledger states. Cache conversion PASS does not prove original fuel/calorific completeness.
BN:2050:Industry:IndustryDirectElectricity:electricity | BN | 2050 | Industry | electricity |  |  | PENDING | NOT_APPLICABLE | NOT_APPLICABLE | OBSERVATION_NOT_MODEL_VALIDATION | PENDING | Source is raw UNSD or named derived cache, as ledger states. Cache conversion PASS does not prove original fuel/calorific completeness.
BN:2050:Industry:IndustryFinalEnergy:biomass | BN | 2050 | Industry | biomass |  |  | PENDING | PENDING_ACCEPTED_WEIGHTS | PENDING_ACCEPTED_PROFILE | OBSERVATION_NOT_MODEL_VALIDATION | PENDING | Source is raw UNSD or named derived cache, as ledger states. Cache conversion PASS does not prove original fuel/calorific completeness.
BN:2050:Industry:IndustryFinalEnergy:coal | BN | 2050 | Industry | coal |  |  | PENDING | PENDING_ACCEPTED_WEIGHTS | PENDING_ACCEPTED_PROFILE | OBSERVATION_NOT_MODEL_VALIDATION | PENDING | Source is raw UNSD or named derived cache, as ledger states. Cache conversion PASS does not prove original fuel/calorific completeness.
BN:2050:Industry:IndustryFinalEnergy:gas | BN | 2050 | Industry | gas |  |  | PENDING | PENDING_ACCEPTED_WEIGHTS | PENDING_ACCEPTED_PROFILE | OBSERVATION_NOT_MODEL_VALIDATION | PENDING | Source is raw UNSD or named derived cache, as ledger states. Cache conversion PASS does not prove original fuel/calorific completeness.
BN:2050:Industry:IndustryFinalEnergy:oil | BN | 2050 | Industry | oil |  |  | PENDING | PENDING_ACCEPTED_WEIGHTS | PENDING_ACCEPTED_PROFILE | OBSERVATION_NOT_MODEL_VALIDATION | PENDING | Source is raw UNSD or named derived cache, as ledger states. Cache conversion PASS does not prove original fuel/calorific completeness.
BN:2050:Transport:DomesticAviationFuel:oil | BN | 2050 | Transport | oil |  |  | PENDING | PENDING_ACCEPTED_WEIGHTS | PENDING_ACCEPTED_PROFILE | OBSERVATION_NOT_MODEL_VALIDATION | PENDING | Source is raw UNSD or named derived cache, as ledger states. Cache conversion PASS does not prove original fuel/calorific completeness.
BN:2050:Transport:DomesticShippingFuel:oil | BN | 2050 | Transport | oil |  |  | PENDING | PENDING_ACCEPTED_WEIGHTS | PENDING_ACCEPTED_PROFILE | OBSERVATION_NOT_MODEL_VALIDATION | PENDING | Source is raw UNSD or named derived cache, as ledger states. Cache conversion PASS does not prove original fuel/calorific completeness.
BN:2050:Transport:RailElectricity:electricity | BN | 2050 | Transport | electricity |  |  | PENDING | NOT_APPLICABLE | NOT_APPLICABLE | OBSERVATION_NOT_MODEL_VALIDATION | PENDING | Source is raw UNSD or named derived cache, as ledger states. Cache conversion PASS does not prove original fuel/calorific completeness.
BN:2050:Transport:RoadEVFinalElectricity:electricity | BN | 2050 | Transport | electricity |  |  | PENDING | PENDING_ACCEPTED_WEIGHTS | PENDING_ACCEPTED_PROFILE | OBSERVATION_NOT_MODEL_VALIDATION | PENDING | Source is raw UNSD or named derived cache, as ledger states. Cache conversion PASS does not prove original fuel/calorific completeness.
BN:2050:Transport:RoadResidualFuel:biomass | BN | 2050 | Transport | biomass |  |  | PENDING | PENDING_ACCEPTED_WEIGHTS | PENDING_ACCEPTED_PROFILE | OBSERVATION_NOT_MODEL_VALIDATION | PENDING | Source is raw UNSD or named derived cache, as ledger states. Cache conversion PASS does not prove original fuel/calorific completeness.
BN:2050:Transport:RoadResidualFuel:gas | BN | 2050 | Transport | gas |  |  | PENDING | PENDING_ACCEPTED_WEIGHTS | PENDING_ACCEPTED_PROFILE | OBSERVATION_NOT_MODEL_VALIDATION | PENDING | Source is raw UNSD or named derived cache, as ledger states. Cache conversion PASS does not prove original fuel/calorific completeness.
BN:2050:Transport:RoadResidualFuel:oil | BN | 2050 | Transport | oil |  |  | PENDING | PENDING_ACCEPTED_WEIGHTS | PENDING_ACCEPTED_PROFILE | OBSERVATION_NOT_MODEL_VALIDATION | PENDING | Source is raw UNSD or named derived cache, as ledger states. Cache conversion PASS does not prove original fuel/calorific completeness.
BN:2050:Transport:TransportEmbeddedFuelParent:unclassified_fuel | BN | 2050 | Transport | unclassified_fuel |  |  | PENDING | PENDING_ACCEPTED_WEIGHTS | PENDING_ACCEPTED_PROFILE | OBSERVATION_NOT_MODEL_VALIDATION | PENDING | Source is raw UNSD or named derived cache, as ledger states. Cache conversion PASS does not prove original fuel/calorific completeness.
ID:2019:Agriculture:AgricultureFinalEnergy:biomass | ID | 2019 | Agriculture | biomass |  |  | PENDING | PENDING_ACCEPTED_WEIGHTS | PENDING_ACCEPTED_PROFILE | OBSERVATION_NOT_MODEL_VALIDATION | PENDING | Source is raw UNSD or named derived cache, as ledger states. Cache conversion PASS does not prove original fuel/calorific completeness.
ID:2019:Agriculture:AgricultureFinalEnergy:coal | ID | 2019 | Agriculture | coal |  |  | PENDING | PENDING_ACCEPTED_WEIGHTS | PENDING_ACCEPTED_PROFILE | OBSERVATION_NOT_MODEL_VALIDATION | PENDING | Source is raw UNSD or named derived cache, as ledger states. Cache conversion PASS does not prove original fuel/calorific completeness.
ID:2019:Agriculture:AgricultureFinalEnergy:electricity | ID | 2019 | Agriculture | electricity | 594000.0 | 594000.0 | PASS_SOURCE_TO_LEDGER | NOT_APPLICABLE | NOT_APPLICABLE | OBSERVATION_NOT_MODEL_VALIDATION | PARTIAL | Source is raw UNSD or named derived cache, as ledger states. Cache conversion PASS does not prove original fuel/calorific completeness.
ID:2019:Agriculture:AgricultureFinalEnergy:oil | ID | 2019 | Agriculture | oil | 4314500.0 | 4314500.0 | PASS_SOURCE_TO_LEDGER | PENDING_ACCEPTED_WEIGHTS | PENDING_ACCEPTED_PROFILE | OBSERVATION_NOT_MODEL_VALIDATION | PARTIAL | Source is raw UNSD or named derived cache, as ledger states. Cache conversion PASS does not prove original fuel/calorific completeness.
ID:2019:Buildings:ResidentialCooking:mixed | ID | 2019 | Buildings | mixed |  |  | PENDING | NOT_APPLICABLE | NOT_APPLICABLE | OBSERVATION_NOT_MODEL_VALIDATION | PENDING | Source is raw UNSD or named derived cache, as ledger states. Cache conversion PASS does not prove original fuel/calorific completeness.
ID:2019:Buildings:ResidentialCooling:electricity | ID | 2019 | Buildings | electricity |  |  | PENDING | NOT_APPLICABLE | NOT_APPLICABLE | OBSERVATION_NOT_MODEL_VALIDATION | PENDING | Source is raw UNSD or named derived cache, as ledger states. Cache conversion PASS does not prove original fuel/calorific completeness.
ID:2019:Buildings:ResidentialDirectElectricity:electricity | ID | 2019 | Buildings | electricity | 104714000.0 | 104714000.0 | PASS_SOURCE_TO_LEDGER | NOT_APPLICABLE | NOT_APPLICABLE | OBSERVATION_NOT_MODEL_VALIDATION | PARTIAL | Source is raw UNSD or named derived cache, as ledger states. Cache conversion PASS does not prove original fuel/calorific completeness.
ID:2019:Buildings:ResidentialFuel:biomass | ID | 2019 | Buildings | biomass | 85695200.0 | 85695200.0 | PASS_SOURCE_TO_LEDGER | PENDING_ACCEPTED_WEIGHTS | PENDING_ACCEPTED_PROFILE | OBSERVATION_NOT_MODEL_VALIDATION | PARTIAL | Source is raw UNSD or named derived cache, as ledger states. Cache conversion PASS does not prove original fuel/calorific completeness.
ID:2019:Buildings:ResidentialFuel:coal | ID | 2019 | Buildings | coal |  |  | PENDING | PENDING_ACCEPTED_WEIGHTS | PENDING_ACCEPTED_PROFILE | OBSERVATION_NOT_MODEL_VALIDATION | PENDING | Source is raw UNSD or named derived cache, as ledger states. Cache conversion PASS does not prove original fuel/calorific completeness.
ID:2019:Buildings:ResidentialFuel:gas | ID | 2019 | Buildings | gas | 241700.0 | 241700.0 | PASS_SOURCE_TO_LEDGER | PENDING_ACCEPTED_WEIGHTS | PENDING_ACCEPTED_PROFILE | OBSERVATION_NOT_MODEL_VALIDATION | PARTIAL | Source is raw UNSD or named derived cache, as ledger states. Cache conversion PASS does not prove original fuel/calorific completeness.
ID:2019:Buildings:ResidentialFuel:oil | ID | 2019 | Buildings | oil | 290034500.0 | 290034500.0 | PASS_SOURCE_TO_LEDGER | PENDING_ACCEPTED_WEIGHTS | PENDING_ACCEPTED_PROFILE | OBSERVATION_NOT_MODEL_VALIDATION | PARTIAL | Source is raw UNSD or named derived cache, as ledger states. Cache conversion PASS does not prove original fuel/calorific completeness.
ID:2019:Buildings:ResidentialSpaceHeat:mixed | ID | 2019 | Buildings | mixed |  |  | PENDING | NOT_APPLICABLE | NOT_APPLICABLE | OBSERVATION_NOT_MODEL_VALIDATION | PENDING | Source is raw UNSD or named derived cache, as ledger states. Cache conversion PASS does not prove original fuel/calorific completeness.
ID:2019:Buildings:ResidentialWaterHeat:mixed | ID | 2019 | Buildings | mixed |  |  | PENDING | NOT_APPLICABLE | NOT_APPLICABLE | OBSERVATION_NOT_MODEL_VALIDATION | PENDING | Source is raw UNSD or named derived cache, as ledger states. Cache conversion PASS does not prove original fuel/calorific completeness.
ID:2019:Buildings:ServicesCooking:mixed | ID | 2019 | Buildings | mixed |  |  | PENDING | NOT_APPLICABLE | NOT_APPLICABLE | OBSERVATION_NOT_MODEL_VALIDATION | PENDING | Source is raw UNSD or named derived cache, as ledger states. Cache conversion PASS does not prove original fuel/calorific completeness.
ID:2019:Buildings:ServicesCooling:electricity | ID | 2019 | Buildings | electricity |  |  | PENDING | NOT_APPLICABLE | NOT_APPLICABLE | OBSERVATION_NOT_MODEL_VALIDATION | PENDING | Source is raw UNSD or named derived cache, as ledger states. Cache conversion PASS does not prove original fuel/calorific completeness.
ID:2019:Buildings:ServicesDirectElectricity:electricity | ID | 2019 | Buildings | electricity | 64183000.0 | 64183000.0 | PASS_SOURCE_TO_LEDGER | NOT_APPLICABLE | NOT_APPLICABLE | OBSERVATION_NOT_MODEL_VALIDATION | PARTIAL | Source is raw UNSD or named derived cache, as ledger states. Cache conversion PASS does not prove original fuel/calorific completeness.
ID:2019:Buildings:ServicesFuel:biomass | ID | 2019 | Buildings | biomass | 12022000.0 | 12022000.0 | PASS_SOURCE_TO_LEDGER | PENDING_ACCEPTED_WEIGHTS | PENDING_ACCEPTED_PROFILE | OBSERVATION_NOT_MODEL_VALIDATION | PARTIAL | Source is raw UNSD or named derived cache, as ledger states. Cache conversion PASS does not prove original fuel/calorific completeness.
ID:2019:Buildings:ServicesFuel:coal | ID | 2019 | Buildings | coal |  |  | PENDING | PENDING_ACCEPTED_WEIGHTS | PENDING_ACCEPTED_PROFILE | OBSERVATION_NOT_MODEL_VALIDATION | PENDING | Source is raw UNSD or named derived cache, as ledger states. Cache conversion PASS does not prove original fuel/calorific completeness.
ID:2019:Buildings:ServicesFuel:gas | ID | 2019 | Buildings | gas | 3070000.0 | 3070000.0 | PASS_SOURCE_TO_LEDGER | PENDING_ACCEPTED_WEIGHTS | PENDING_ACCEPTED_PROFILE | OBSERVATION_NOT_MODEL_VALIDATION | PARTIAL | Source is raw UNSD or named derived cache, as ledger states. Cache conversion PASS does not prove original fuel/calorific completeness.
ID:2019:Buildings:ServicesFuel:oil | ID | 2019 | Buildings | oil | 11839200.0 | 11839200.0 | PASS_SOURCE_TO_LEDGER | PENDING_ACCEPTED_WEIGHTS | PENDING_ACCEPTED_PROFILE | OBSERVATION_NOT_MODEL_VALIDATION | PARTIAL | Source is raw UNSD or named derived cache, as ledger states. Cache conversion PASS does not prove original fuel/calorific completeness.
ID:2019:Buildings:ServicesSpaceHeat:mixed | ID | 2019 | Buildings | mixed |  |  | PENDING | NOT_APPLICABLE | NOT_APPLICABLE | OBSERVATION_NOT_MODEL_VALIDATION | PENDING | Source is raw UNSD or named derived cache, as ledger states. Cache conversion PASS does not prove original fuel/calorific completeness.
ID:2019:Buildings:ServicesWaterHeat:mixed | ID | 2019 | Buildings | mixed |  |  | PENDING | NOT_APPLICABLE | NOT_APPLICABLE | OBSERVATION_NOT_MODEL_VALIDATION | PENDING | Source is raw UNSD or named derived cache, as ledger states. Cache conversion PASS does not prove original fuel/calorific completeness.
ID:2019:Bunker:InternationalAviationBunker:oil | ID | 2019 | Bunker | oil | 11222100.0 | 11222100.0 | PASS_SOURCE_TO_LEDGER | PENDING_ACCEPTED_WEIGHTS | PENDING_ACCEPTED_PROFILE | OBSERVATION_NOT_MODEL_VALIDATION | PARTIAL | Source is raw UNSD or named derived cache, as ledger states. Cache conversion PASS does not prove original fuel/calorific completeness.
ID:2019:Bunker:InternationalShippingBunker:oil | ID | 2019 | Bunker | oil | 2607000.0 | 2607000.0 | PASS_SOURCE_TO_LEDGER | PENDING_ACCEPTED_WEIGHTS | PENDING_ACCEPTED_PROFILE | OBSERVATION_NOT_MODEL_VALIDATION | PARTIAL | Source is raw UNSD or named derived cache, as ledger states. Cache conversion PASS does not prove original fuel/calorific completeness.
ID:2019:Conversion:EVIfConversion:electricity | ID | 2019 | Conversion | electricity |  |  | PENDING | NOT_APPLICABLE | NOT_APPLICABLE | OBSERVATION_NOT_MODEL_VALIDATION | PENDING | Source is raw UNSD or named derived cache, as ledger states. Cache conversion PASS does not prove original fuel/calorific completeness.
ID:2019:Conversion:Electrolysis:electricity | ID | 2019 | Conversion | electricity |  |  | PENDING | NOT_APPLICABLE | NOT_APPLICABLE | OBSERVATION_NOT_MODEL_VALIDATION | PENDING | Source is raw UNSD or named derived cache, as ledger states. Cache conversion PASS does not prove original fuel/calorific completeness.
ID:2019:Conversion:FischerTropsch:electricity | ID | 2019 | Conversion | electricity |  |  | PENDING | NOT_APPLICABLE | NOT_APPLICABLE | OBSERVATION_NOT_MODEL_VALIDATION | PENDING | Source is raw UNSD or named derived cache, as ledger states. Cache conversion PASS does not prove original fuel/calorific completeness.
ID:2019:Conversion:HeatPump:electricity | ID | 2019 | Conversion | electricity |  |  | PENDING | NOT_APPLICABLE | NOT_APPLICABLE | OBSERVATION_NOT_MODEL_VALIDATION | PENDING | Source is raw UNSD or named derived cache, as ledger states. Cache conversion PASS does not prove original fuel/calorific completeness.
ID:2019:Conversion:ResistiveHeating:electricity | ID | 2019 | Conversion | electricity |  |  | PENDING | NOT_APPLICABLE | NOT_APPLICABLE | OBSERVATION_NOT_MODEL_VALIDATION | PENDING | Source is raw UNSD or named derived cache, as ledger states. Cache conversion PASS does not prove original fuel/calorific completeness.
ID:2019:Electricity:Astar:electricity | ID | 2019 | Electricity | electricity | 258092000.0 | 258092000.0 | PASS_SOURCE_TO_LEDGER | PENDING_ACCEPTED_WEIGHTS | PENDING_ACCEPTED_PROFILE | OBSERVATION_NOT_MODEL_VALIDATION | PARTIAL | Source is raw UNSD or named derived cache, as ledger states. Cache conversion PASS does not prove original fuel/calorific completeness.
ID:2019:Industry:IndustryCacheElectricityReference:electricity | ID | 2019 | Industry | electricity | 88323000.0 | 88323000.0 | PASS_SOURCE_TO_LEDGER | NOT_APPLICABLE | NOT_APPLICABLE | OBSERVATION_NOT_MODEL_VALIDATION | PARTIAL | Source is raw UNSD or named derived cache, as ledger states. Cache conversion PASS does not prove original fuel/calorific completeness.
ID:2019:Industry:IndustryDirectElectricity:electricity | ID | 2019 | Industry | electricity | 88323000.0 | 88323000.0 | PASS_SOURCE_TO_LEDGER | NOT_APPLICABLE | NOT_APPLICABLE | OBSERVATION_NOT_MODEL_VALIDATION | PARTIAL | Source is raw UNSD or named derived cache, as ledger states. Cache conversion PASS does not prove original fuel/calorific completeness.
ID:2019:Industry:IndustryFuel:biomass | ID | 2019 | Industry | biomass | 185502047.63000003 | 185502047.63000003 | PASS_SOURCE_TO_LEDGER | PENDING_ACCEPTED_WEIGHTS | PENDING_ACCEPTED_PROFILE | OBSERVATION_NOT_MODEL_VALIDATION | PARTIAL | Source is raw UNSD or named derived cache, as ledger states. Cache conversion PASS does not prove original fuel/calorific completeness.
ID:2019:Industry:IndustryFuel:coal | ID | 2019 | Industry | coal | 289560071.37299997 | 289560071.37299997 | PASS_SOURCE_TO_LEDGER | PENDING_ACCEPTED_WEIGHTS | PENDING_ACCEPTED_PROFILE | OBSERVATION_NOT_MODEL_VALIDATION | PARTIAL | Source is raw UNSD or named derived cache, as ledger states. Cache conversion PASS does not prove original fuel/calorific completeness.
ID:2019:Industry:IndustryFuel:gas | ID | 2019 | Industry | gas | 133521944.44444445 | 133521944.44444445 | PASS_SOURCE_TO_LEDGER | PENDING_ACCEPTED_WEIGHTS | PENDING_ACCEPTED_PROFILE | OBSERVATION_NOT_MODEL_VALIDATION | PARTIAL | Source is raw UNSD or named derived cache, as ledger states. Cache conversion PASS does not prove original fuel/calorific completeness.
ID:2019:Industry:IndustryFuel:heat | ID | 2019 | Industry | heat |  |  | PENDING | NOT_APPLICABLE | NOT_APPLICABLE | OBSERVATION_NOT_MODEL_VALIDATION | PENDING | Source is raw UNSD or named derived cache, as ledger states. Cache conversion PASS does not prove original fuel/calorific completeness.
ID:2019:Industry:IndustryFuel:hydrogen | ID | 2019 | Industry | hydrogen |  |  | PENDING | NOT_APPLICABLE | NOT_APPLICABLE | OBSERVATION_NOT_MODEL_VALIDATION | PENDING | Source is raw UNSD or named derived cache, as ledger states. Cache conversion PASS does not prove original fuel/calorific completeness.
ID:2019:Industry:IndustryFuel:oil | ID | 2019 | Industry | oil | 95211452.33800001 | 95211452.33800001 | PASS_SOURCE_TO_LEDGER | PENDING_ACCEPTED_WEIGHTS | PENDING_ACCEPTED_PROFILE | OBSERVATION_NOT_MODEL_VALIDATION | PARTIAL | Source is raw UNSD or named derived cache, as ledger states. Cache conversion PASS does not prove original fuel/calorific completeness.
ID:2019:Transport:DomesticAviationFuel:oil | ID | 2019 | Transport | oil | 33840000.0 | 33840000.0 | PASS_SOURCE_TO_LEDGER | PENDING_ACCEPTED_WEIGHTS | PENDING_ACCEPTED_PROFILE | OBSERVATION_NOT_MODEL_VALIDATION | PARTIAL | Source is raw UNSD or named derived cache, as ledger states. Cache conversion PASS does not prove original fuel/calorific completeness.
ID:2019:Transport:DomesticShippingFuel:oil | ID | 2019 | Transport | oil | 2794700.0 | 2794700.0 | PASS_SOURCE_TO_LEDGER | PENDING_ACCEPTED_WEIGHTS | PENDING_ACCEPTED_PROFILE | OBSERVATION_NOT_MODEL_VALIDATION | PARTIAL | Source is raw UNSD or named derived cache, as ledger states. Cache conversion PASS does not prove original fuel/calorific completeness.
ID:2019:Transport:HistoricalRoadElectricity:electricity | ID | 2019 | Transport | electricity |  |  | PENDING | NOT_APPLICABLE | NOT_APPLICABLE | OBSERVATION_NOT_MODEL_VALIDATION | PENDING | Source is raw UNSD or named derived cache, as ledger states. Cache conversion PASS does not prove original fuel/calorific completeness.
ID:2019:Transport:RailElectricity:electricity | ID | 2019 | Transport | electricity | 278000.0 | 278000.0 | PASS_SOURCE_TO_LEDGER | NOT_APPLICABLE | NOT_APPLICABLE | OBSERVATION_NOT_MODEL_VALIDATION | PARTIAL | Source is raw UNSD or named derived cache, as ledger states. Cache conversion PASS does not prove original fuel/calorific completeness.
ID:2019:Transport:RailFinalEnergyReference:mixed | ID | 2019 | Transport | mixed | 2761700.0 | 2761700.0 | PASS_SOURCE_TO_LEDGER | NOT_APPLICABLE | NOT_APPLICABLE | OBSERVATION_NOT_MODEL_VALIDATION | PARTIAL | Source is raw UNSD or named derived cache, as ledger states. Cache conversion PASS does not prove original fuel/calorific completeness.
ID:2019:Transport:RoadParentFinalEnergy:all_final_energy | ID | 2019 | Transport | all_final_energy | 255666400.0 | 255666400.0 | PASS_SOURCE_TO_LEDGER | NOT_APPLICABLE | NOT_APPLICABLE | OBSERVATION_NOT_MODEL_VALIDATION | PARTIAL | Source is raw UNSD or named derived cache, as ledger states. Cache conversion PASS does not prove original fuel/calorific completeness.
ID:2019:Transport:RoadResidualFuel:biomass | ID | 2019 | Transport | biomass | 47144900.0 | 47144900.0 | PASS_SOURCE_TO_LEDGER | PENDING_ACCEPTED_WEIGHTS | PENDING_ACCEPTED_PROFILE | OBSERVATION_NOT_MODEL_VALIDATION | PARTIAL | Source is raw UNSD or named derived cache, as ledger states. Cache conversion PASS does not prove original fuel/calorific completeness.
ID:2019:Transport:RoadResidualFuel:gas | ID | 2019 | Transport | gas | 791400.0 | 791400.0 | PASS_SOURCE_TO_LEDGER | PENDING_ACCEPTED_WEIGHTS | PENDING_ACCEPTED_PROFILE | OBSERVATION_NOT_MODEL_VALIDATION | PARTIAL | Source is raw UNSD or named derived cache, as ledger states. Cache conversion PASS does not prove original fuel/calorific completeness.
ID:2019:Transport:RoadResidualFuel:oil | ID | 2019 | Transport | oil | 207730200.0 | 207730200.0 | PASS_SOURCE_TO_LEDGER | PENDING_ACCEPTED_WEIGHTS | PENDING_ACCEPTED_PROFILE | OBSERVATION_NOT_MODEL_VALIDATION | PARTIAL | Source is raw UNSD or named derived cache, as ledger states. Cache conversion PASS does not prove original fuel/calorific completeness.
ID:2019:Transport:TransportEmbeddedFuelParent:unclassified_fuel | ID | 2019 | Transport | unclassified_fuel |  |  | PENDING | PENDING_ACCEPTED_WEIGHTS | PENDING_ACCEPTED_PROFILE | OBSERVATION_NOT_MODEL_VALIDATION | PENDING | Source is raw UNSD or named derived cache, as ledger states. Cache conversion PASS does not prove original fuel/calorific completeness.
ID:2030:Agriculture:AgricultureDirectElectricity:electricity | ID | 2030 | Agriculture | electricity |  |  | PENDING | NOT_APPLICABLE | NOT_APPLICABLE | OBSERVATION_NOT_MODEL_VALIDATION | PENDING | Source is raw UNSD or named derived cache, as ledger states. Cache conversion PASS does not prove original fuel/calorific completeness.
ID:2030:Agriculture:AgricultureFinalEnergy:biomass | ID | 2030 | Agriculture | biomass |  |  | PENDING | PENDING_ACCEPTED_WEIGHTS | PENDING_ACCEPTED_PROFILE | OBSERVATION_NOT_MODEL_VALIDATION | PENDING | Source is raw UNSD or named derived cache, as ledger states. Cache conversion PASS does not prove original fuel/calorific completeness.
ID:2030:Agriculture:AgricultureFinalEnergy:coal | ID | 2030 | Agriculture | coal |  |  | PENDING | PENDING_ACCEPTED_WEIGHTS | PENDING_ACCEPTED_PROFILE | OBSERVATION_NOT_MODEL_VALIDATION | PENDING | Source is raw UNSD or named derived cache, as ledger states. Cache conversion PASS does not prove original fuel/calorific completeness.
ID:2030:Agriculture:AgricultureFinalEnergy:oil | ID | 2030 | Agriculture | oil |  |  | PENDING | PENDING_ACCEPTED_WEIGHTS | PENDING_ACCEPTED_PROFILE | OBSERVATION_NOT_MODEL_VALIDATION | PENDING | Source is raw UNSD or named derived cache, as ledger states. Cache conversion PASS does not prove original fuel/calorific completeness.
ID:2030:Buildings:ResidentialDirectElectricity:electricity | ID | 2030 | Buildings | electricity |  |  | PENDING | NOT_APPLICABLE | NOT_APPLICABLE | OBSERVATION_NOT_MODEL_VALIDATION | PENDING | Source is raw UNSD or named derived cache, as ledger states. Cache conversion PASS does not prove original fuel/calorific completeness.
ID:2030:Buildings:ResidentialFuel:biomass | ID | 2030 | Buildings | biomass |  |  | PENDING | PENDING_ACCEPTED_WEIGHTS | PENDING_ACCEPTED_PROFILE | OBSERVATION_NOT_MODEL_VALIDATION | PENDING | Source is raw UNSD or named derived cache, as ledger states. Cache conversion PASS does not prove original fuel/calorific completeness.
ID:2030:Buildings:ResidentialFuel:coal | ID | 2030 | Buildings | coal |  |  | PENDING | PENDING_ACCEPTED_WEIGHTS | PENDING_ACCEPTED_PROFILE | OBSERVATION_NOT_MODEL_VALIDATION | PENDING | Source is raw UNSD or named derived cache, as ledger states. Cache conversion PASS does not prove original fuel/calorific completeness.
ID:2030:Buildings:ResidentialFuel:gas | ID | 2030 | Buildings | gas |  |  | PENDING | PENDING_ACCEPTED_WEIGHTS | PENDING_ACCEPTED_PROFILE | OBSERVATION_NOT_MODEL_VALIDATION | PENDING | Source is raw UNSD or named derived cache, as ledger states. Cache conversion PASS does not prove original fuel/calorific completeness.
ID:2030:Buildings:ResidentialFuel:oil | ID | 2030 | Buildings | oil |  |  | PENDING | PENDING_ACCEPTED_WEIGHTS | PENDING_ACCEPTED_PROFILE | OBSERVATION_NOT_MODEL_VALIDATION | PENDING | Source is raw UNSD or named derived cache, as ledger states. Cache conversion PASS does not prove original fuel/calorific completeness.
ID:2030:Buildings:ServicesDirectElectricity:electricity | ID | 2030 | Buildings | electricity |  |  | PENDING | NOT_APPLICABLE | NOT_APPLICABLE | OBSERVATION_NOT_MODEL_VALIDATION | PENDING | Source is raw UNSD or named derived cache, as ledger states. Cache conversion PASS does not prove original fuel/calorific completeness.
ID:2030:Buildings:ServicesFuel:biomass | ID | 2030 | Buildings | biomass |  |  | PENDING | PENDING_ACCEPTED_WEIGHTS | PENDING_ACCEPTED_PROFILE | OBSERVATION_NOT_MODEL_VALIDATION | PENDING | Source is raw UNSD or named derived cache, as ledger states. Cache conversion PASS does not prove original fuel/calorific completeness.
ID:2030:Buildings:ServicesFuel:coal | ID | 2030 | Buildings | coal |  |  | PENDING | PENDING_ACCEPTED_WEIGHTS | PENDING_ACCEPTED_PROFILE | OBSERVATION_NOT_MODEL_VALIDATION | PENDING | Source is raw UNSD or named derived cache, as ledger states. Cache conversion PASS does not prove original fuel/calorific completeness.
ID:2030:Buildings:ServicesFuel:gas | ID | 2030 | Buildings | gas |  |  | PENDING | PENDING_ACCEPTED_WEIGHTS | PENDING_ACCEPTED_PROFILE | OBSERVATION_NOT_MODEL_VALIDATION | PENDING | Source is raw UNSD or named derived cache, as ledger states. Cache conversion PASS does not prove original fuel/calorific completeness.
ID:2030:Buildings:ServicesFuel:oil | ID | 2030 | Buildings | oil |  |  | PENDING | PENDING_ACCEPTED_WEIGHTS | PENDING_ACCEPTED_PROFILE | OBSERVATION_NOT_MODEL_VALIDATION | PENDING | Source is raw UNSD or named derived cache, as ledger states. Cache conversion PASS does not prove original fuel/calorific completeness.
ID:2030:Bunker:InternationalAviationBunker:oil | ID | 2030 | Bunker | oil |  |  | PENDING | PENDING_ACCEPTED_WEIGHTS | PENDING_ACCEPTED_PROFILE | OBSERVATION_NOT_MODEL_VALIDATION | PENDING | Source is raw UNSD or named derived cache, as ledger states. Cache conversion PASS does not prove original fuel/calorific completeness.
ID:2030:Bunker:InternationalShippingBunker:oil | ID | 2030 | Bunker | oil |  |  | PENDING | PENDING_ACCEPTED_WEIGHTS | PENDING_ACCEPTED_PROFILE | OBSERVATION_NOT_MODEL_VALIDATION | PENDING | Source is raw UNSD or named derived cache, as ledger states. Cache conversion PASS does not prove original fuel/calorific completeness.
ID:2030:Electricity:Astar:electricity | ID | 2030 | Electricity | electricity |  |  | PENDING | PENDING_ACCEPTED_WEIGHTS | PENDING_ACCEPTED_PROFILE | OBSERVATION_NOT_MODEL_VALIDATION | PENDING | Source is raw UNSD or named derived cache, as ledger states. Cache conversion PASS does not prove original fuel/calorific completeness.
ID:2030:Industry:IndustryDirectElectricity:electricity | ID | 2030 | Industry | electricity |  |  | PENDING | NOT_APPLICABLE | NOT_APPLICABLE | OBSERVATION_NOT_MODEL_VALIDATION | PENDING | Source is raw UNSD or named derived cache, as ledger states. Cache conversion PASS does not prove original fuel/calorific completeness.
ID:2030:Industry:IndustryFinalEnergy:biomass | ID | 2030 | Industry | biomass |  |  | PENDING | PENDING_ACCEPTED_WEIGHTS | PENDING_ACCEPTED_PROFILE | OBSERVATION_NOT_MODEL_VALIDATION | PENDING | Source is raw UNSD or named derived cache, as ledger states. Cache conversion PASS does not prove original fuel/calorific completeness.
ID:2030:Industry:IndustryFinalEnergy:coal | ID | 2030 | Industry | coal |  |  | PENDING | PENDING_ACCEPTED_WEIGHTS | PENDING_ACCEPTED_PROFILE | OBSERVATION_NOT_MODEL_VALIDATION | PENDING | Source is raw UNSD or named derived cache, as ledger states. Cache conversion PASS does not prove original fuel/calorific completeness.
ID:2030:Industry:IndustryFinalEnergy:gas | ID | 2030 | Industry | gas |  |  | PENDING | PENDING_ACCEPTED_WEIGHTS | PENDING_ACCEPTED_PROFILE | OBSERVATION_NOT_MODEL_VALIDATION | PENDING | Source is raw UNSD or named derived cache, as ledger states. Cache conversion PASS does not prove original fuel/calorific completeness.
ID:2030:Industry:IndustryFinalEnergy:oil | ID | 2030 | Industry | oil |  |  | PENDING | PENDING_ACCEPTED_WEIGHTS | PENDING_ACCEPTED_PROFILE | OBSERVATION_NOT_MODEL_VALIDATION | PENDING | Source is raw UNSD or named derived cache, as ledger states. Cache conversion PASS does not prove original fuel/calorific completeness.
ID:2030:Transport:DomesticAviationFuel:oil | ID | 2030 | Transport | oil |  |  | PENDING | PENDING_ACCEPTED_WEIGHTS | PENDING_ACCEPTED_PROFILE | OBSERVATION_NOT_MODEL_VALIDATION | PENDING | Source is raw UNSD or named derived cache, as ledger states. Cache conversion PASS does not prove original fuel/calorific completeness.
ID:2030:Transport:DomesticShippingFuel:oil | ID | 2030 | Transport | oil |  |  | PENDING | PENDING_ACCEPTED_WEIGHTS | PENDING_ACCEPTED_PROFILE | OBSERVATION_NOT_MODEL_VALIDATION | PENDING | Source is raw UNSD or named derived cache, as ledger states. Cache conversion PASS does not prove original fuel/calorific completeness.
ID:2030:Transport:RailElectricity:electricity | ID | 2030 | Transport | electricity |  |  | PENDING | NOT_APPLICABLE | NOT_APPLICABLE | OBSERVATION_NOT_MODEL_VALIDATION | PENDING | Source is raw UNSD or named derived cache, as ledger states. Cache conversion PASS does not prove original fuel/calorific completeness.
ID:2030:Transport:RoadEVFinalElectricity:electricity | ID | 2030 | Transport | electricity |  |  | PENDING | PENDING_ACCEPTED_WEIGHTS | PENDING_ACCEPTED_PROFILE | OBSERVATION_NOT_MODEL_VALIDATION | PENDING | Source is raw UNSD or named derived cache, as ledger states. Cache conversion PASS does not prove original fuel/calorific completeness.
ID:2030:Transport:RoadResidualFuel:biomass | ID | 2030 | Transport | biomass |  |  | PENDING | PENDING_ACCEPTED_WEIGHTS | PENDING_ACCEPTED_PROFILE | OBSERVATION_NOT_MODEL_VALIDATION | PENDING | Source is raw UNSD or named derived cache, as ledger states. Cache conversion PASS does not prove original fuel/calorific completeness.
ID:2030:Transport:RoadResidualFuel:gas | ID | 2030 | Transport | gas |  |  | PENDING | PENDING_ACCEPTED_WEIGHTS | PENDING_ACCEPTED_PROFILE | OBSERVATION_NOT_MODEL_VALIDATION | PENDING | Source is raw UNSD or named derived cache, as ledger states. Cache conversion PASS does not prove original fuel/calorific completeness.
ID:2030:Transport:RoadResidualFuel:oil | ID | 2030 | Transport | oil |  |  | PENDING | PENDING_ACCEPTED_WEIGHTS | PENDING_ACCEPTED_PROFILE | OBSERVATION_NOT_MODEL_VALIDATION | PENDING | Source is raw UNSD or named derived cache, as ledger states. Cache conversion PASS does not prove original fuel/calorific completeness.
ID:2030:Transport:TransportEmbeddedFuelParent:unclassified_fuel | ID | 2030 | Transport | unclassified_fuel |  |  | PENDING | PENDING_ACCEPTED_WEIGHTS | PENDING_ACCEPTED_PROFILE | OBSERVATION_NOT_MODEL_VALIDATION | PENDING | Source is raw UNSD or named derived cache, as ledger states. Cache conversion PASS does not prove original fuel/calorific completeness.
ID:2040:Agriculture:AgricultureDirectElectricity:electricity | ID | 2040 | Agriculture | electricity |  |  | PENDING | NOT_APPLICABLE | NOT_APPLICABLE | OBSERVATION_NOT_MODEL_VALIDATION | PENDING | Source is raw UNSD or named derived cache, as ledger states. Cache conversion PASS does not prove original fuel/calorific completeness.
ID:2040:Agriculture:AgricultureFinalEnergy:biomass | ID | 2040 | Agriculture | biomass |  |  | PENDING | PENDING_ACCEPTED_WEIGHTS | PENDING_ACCEPTED_PROFILE | OBSERVATION_NOT_MODEL_VALIDATION | PENDING | Source is raw UNSD or named derived cache, as ledger states. Cache conversion PASS does not prove original fuel/calorific completeness.
ID:2040:Agriculture:AgricultureFinalEnergy:coal | ID | 2040 | Agriculture | coal |  |  | PENDING | PENDING_ACCEPTED_WEIGHTS | PENDING_ACCEPTED_PROFILE | OBSERVATION_NOT_MODEL_VALIDATION | PENDING | Source is raw UNSD or named derived cache, as ledger states. Cache conversion PASS does not prove original fuel/calorific completeness.
ID:2040:Agriculture:AgricultureFinalEnergy:oil | ID | 2040 | Agriculture | oil |  |  | PENDING | PENDING_ACCEPTED_WEIGHTS | PENDING_ACCEPTED_PROFILE | OBSERVATION_NOT_MODEL_VALIDATION | PENDING | Source is raw UNSD or named derived cache, as ledger states. Cache conversion PASS does not prove original fuel/calorific completeness.
ID:2040:Buildings:ResidentialDirectElectricity:electricity | ID | 2040 | Buildings | electricity |  |  | PENDING | NOT_APPLICABLE | NOT_APPLICABLE | OBSERVATION_NOT_MODEL_VALIDATION | PENDING | Source is raw UNSD or named derived cache, as ledger states. Cache conversion PASS does not prove original fuel/calorific completeness.
ID:2040:Buildings:ResidentialFuel:biomass | ID | 2040 | Buildings | biomass |  |  | PENDING | PENDING_ACCEPTED_WEIGHTS | PENDING_ACCEPTED_PROFILE | OBSERVATION_NOT_MODEL_VALIDATION | PENDING | Source is raw UNSD or named derived cache, as ledger states. Cache conversion PASS does not prove original fuel/calorific completeness.
ID:2040:Buildings:ResidentialFuel:coal | ID | 2040 | Buildings | coal |  |  | PENDING | PENDING_ACCEPTED_WEIGHTS | PENDING_ACCEPTED_PROFILE | OBSERVATION_NOT_MODEL_VALIDATION | PENDING | Source is raw UNSD or named derived cache, as ledger states. Cache conversion PASS does not prove original fuel/calorific completeness.
ID:2040:Buildings:ResidentialFuel:gas | ID | 2040 | Buildings | gas |  |  | PENDING | PENDING_ACCEPTED_WEIGHTS | PENDING_ACCEPTED_PROFILE | OBSERVATION_NOT_MODEL_VALIDATION | PENDING | Source is raw UNSD or named derived cache, as ledger states. Cache conversion PASS does not prove original fuel/calorific completeness.
ID:2040:Buildings:ResidentialFuel:oil | ID | 2040 | Buildings | oil |  |  | PENDING | PENDING_ACCEPTED_WEIGHTS | PENDING_ACCEPTED_PROFILE | OBSERVATION_NOT_MODEL_VALIDATION | PENDING | Source is raw UNSD or named derived cache, as ledger states. Cache conversion PASS does not prove original fuel/calorific completeness.
ID:2040:Buildings:ServicesDirectElectricity:electricity | ID | 2040 | Buildings | electricity |  |  | PENDING | NOT_APPLICABLE | NOT_APPLICABLE | OBSERVATION_NOT_MODEL_VALIDATION | PENDING | Source is raw UNSD or named derived cache, as ledger states. Cache conversion PASS does not prove original fuel/calorific completeness.
ID:2040:Buildings:ServicesFuel:biomass | ID | 2040 | Buildings | biomass |  |  | PENDING | PENDING_ACCEPTED_WEIGHTS | PENDING_ACCEPTED_PROFILE | OBSERVATION_NOT_MODEL_VALIDATION | PENDING | Source is raw UNSD or named derived cache, as ledger states. Cache conversion PASS does not prove original fuel/calorific completeness.
ID:2040:Buildings:ServicesFuel:coal | ID | 2040 | Buildings | coal |  |  | PENDING | PENDING_ACCEPTED_WEIGHTS | PENDING_ACCEPTED_PROFILE | OBSERVATION_NOT_MODEL_VALIDATION | PENDING | Source is raw UNSD or named derived cache, as ledger states. Cache conversion PASS does not prove original fuel/calorific completeness.
ID:2040:Buildings:ServicesFuel:gas | ID | 2040 | Buildings | gas |  |  | PENDING | PENDING_ACCEPTED_WEIGHTS | PENDING_ACCEPTED_PROFILE | OBSERVATION_NOT_MODEL_VALIDATION | PENDING | Source is raw UNSD or named derived cache, as ledger states. Cache conversion PASS does not prove original fuel/calorific completeness.
ID:2040:Buildings:ServicesFuel:oil | ID | 2040 | Buildings | oil |  |  | PENDING | PENDING_ACCEPTED_WEIGHTS | PENDING_ACCEPTED_PROFILE | OBSERVATION_NOT_MODEL_VALIDATION | PENDING | Source is raw UNSD or named derived cache, as ledger states. Cache conversion PASS does not prove original fuel/calorific completeness.
ID:2040:Bunker:InternationalAviationBunker:oil | ID | 2040 | Bunker | oil |  |  | PENDING | PENDING_ACCEPTED_WEIGHTS | PENDING_ACCEPTED_PROFILE | OBSERVATION_NOT_MODEL_VALIDATION | PENDING | Source is raw UNSD or named derived cache, as ledger states. Cache conversion PASS does not prove original fuel/calorific completeness.
ID:2040:Bunker:InternationalShippingBunker:oil | ID | 2040 | Bunker | oil |  |  | PENDING | PENDING_ACCEPTED_WEIGHTS | PENDING_ACCEPTED_PROFILE | OBSERVATION_NOT_MODEL_VALIDATION | PENDING | Source is raw UNSD or named derived cache, as ledger states. Cache conversion PASS does not prove original fuel/calorific completeness.
ID:2040:Electricity:Astar:electricity | ID | 2040 | Electricity | electricity |  |  | PENDING | PENDING_ACCEPTED_WEIGHTS | PENDING_ACCEPTED_PROFILE | OBSERVATION_NOT_MODEL_VALIDATION | PENDING | Source is raw UNSD or named derived cache, as ledger states. Cache conversion PASS does not prove original fuel/calorific completeness.
ID:2040:Industry:IndustryDirectElectricity:electricity | ID | 2040 | Industry | electricity |  |  | PENDING | NOT_APPLICABLE | NOT_APPLICABLE | OBSERVATION_NOT_MODEL_VALIDATION | PENDING | Source is raw UNSD or named derived cache, as ledger states. Cache conversion PASS does not prove original fuel/calorific completeness.
ID:2040:Industry:IndustryFinalEnergy:biomass | ID | 2040 | Industry | biomass |  |  | PENDING | PENDING_ACCEPTED_WEIGHTS | PENDING_ACCEPTED_PROFILE | OBSERVATION_NOT_MODEL_VALIDATION | PENDING | Source is raw UNSD or named derived cache, as ledger states. Cache conversion PASS does not prove original fuel/calorific completeness.
ID:2040:Industry:IndustryFinalEnergy:coal | ID | 2040 | Industry | coal |  |  | PENDING | PENDING_ACCEPTED_WEIGHTS | PENDING_ACCEPTED_PROFILE | OBSERVATION_NOT_MODEL_VALIDATION | PENDING | Source is raw UNSD or named derived cache, as ledger states. Cache conversion PASS does not prove original fuel/calorific completeness.
ID:2040:Industry:IndustryFinalEnergy:gas | ID | 2040 | Industry | gas |  |  | PENDING | PENDING_ACCEPTED_WEIGHTS | PENDING_ACCEPTED_PROFILE | OBSERVATION_NOT_MODEL_VALIDATION | PENDING | Source is raw UNSD or named derived cache, as ledger states. Cache conversion PASS does not prove original fuel/calorific completeness.
ID:2040:Industry:IndustryFinalEnergy:oil | ID | 2040 | Industry | oil |  |  | PENDING | PENDING_ACCEPTED_WEIGHTS | PENDING_ACCEPTED_PROFILE | OBSERVATION_NOT_MODEL_VALIDATION | PENDING | Source is raw UNSD or named derived cache, as ledger states. Cache conversion PASS does not prove original fuel/calorific completeness.
ID:2040:Transport:DomesticAviationFuel:oil | ID | 2040 | Transport | oil |  |  | PENDING | PENDING_ACCEPTED_WEIGHTS | PENDING_ACCEPTED_PROFILE | OBSERVATION_NOT_MODEL_VALIDATION | PENDING | Source is raw UNSD or named derived cache, as ledger states. Cache conversion PASS does not prove original fuel/calorific completeness.
ID:2040:Transport:DomesticShippingFuel:oil | ID | 2040 | Transport | oil |  |  | PENDING | PENDING_ACCEPTED_WEIGHTS | PENDING_ACCEPTED_PROFILE | OBSERVATION_NOT_MODEL_VALIDATION | PENDING | Source is raw UNSD or named derived cache, as ledger states. Cache conversion PASS does not prove original fuel/calorific completeness.
ID:2040:Transport:RailElectricity:electricity | ID | 2040 | Transport | electricity |  |  | PENDING | NOT_APPLICABLE | NOT_APPLICABLE | OBSERVATION_NOT_MODEL_VALIDATION | PENDING | Source is raw UNSD or named derived cache, as ledger states. Cache conversion PASS does not prove original fuel/calorific completeness.
ID:2040:Transport:RoadEVFinalElectricity:electricity | ID | 2040 | Transport | electricity |  |  | PENDING | PENDING_ACCEPTED_WEIGHTS | PENDING_ACCEPTED_PROFILE | OBSERVATION_NOT_MODEL_VALIDATION | PENDING | Source is raw UNSD or named derived cache, as ledger states. Cache conversion PASS does not prove original fuel/calorific completeness.
ID:2040:Transport:RoadResidualFuel:biomass | ID | 2040 | Transport | biomass |  |  | PENDING | PENDING_ACCEPTED_WEIGHTS | PENDING_ACCEPTED_PROFILE | OBSERVATION_NOT_MODEL_VALIDATION | PENDING | Source is raw UNSD or named derived cache, as ledger states. Cache conversion PASS does not prove original fuel/calorific completeness.
ID:2040:Transport:RoadResidualFuel:gas | ID | 2040 | Transport | gas |  |  | PENDING | PENDING_ACCEPTED_WEIGHTS | PENDING_ACCEPTED_PROFILE | OBSERVATION_NOT_MODEL_VALIDATION | PENDING | Source is raw UNSD or named derived cache, as ledger states. Cache conversion PASS does not prove original fuel/calorific completeness.
ID:2040:Transport:RoadResidualFuel:oil | ID | 2040 | Transport | oil |  |  | PENDING | PENDING_ACCEPTED_WEIGHTS | PENDING_ACCEPTED_PROFILE | OBSERVATION_NOT_MODEL_VALIDATION | PENDING | Source is raw UNSD or named derived cache, as ledger states. Cache conversion PASS does not prove original fuel/calorific completeness.
ID:2040:Transport:TransportEmbeddedFuelParent:unclassified_fuel | ID | 2040 | Transport | unclassified_fuel |  |  | PENDING | PENDING_ACCEPTED_WEIGHTS | PENDING_ACCEPTED_PROFILE | OBSERVATION_NOT_MODEL_VALIDATION | PENDING | Source is raw UNSD or named derived cache, as ledger states. Cache conversion PASS does not prove original fuel/calorific completeness.
ID:2050:Agriculture:AgricultureDirectElectricity:electricity | ID | 2050 | Agriculture | electricity |  |  | PENDING | NOT_APPLICABLE | NOT_APPLICABLE | OBSERVATION_NOT_MODEL_VALIDATION | PENDING | Source is raw UNSD or named derived cache, as ledger states. Cache conversion PASS does not prove original fuel/calorific completeness.
ID:2050:Agriculture:AgricultureFinalEnergy:biomass | ID | 2050 | Agriculture | biomass |  |  | PENDING | PENDING_ACCEPTED_WEIGHTS | PENDING_ACCEPTED_PROFILE | OBSERVATION_NOT_MODEL_VALIDATION | PENDING | Source is raw UNSD or named derived cache, as ledger states. Cache conversion PASS does not prove original fuel/calorific completeness.
ID:2050:Agriculture:AgricultureFinalEnergy:coal | ID | 2050 | Agriculture | coal |  |  | PENDING | PENDING_ACCEPTED_WEIGHTS | PENDING_ACCEPTED_PROFILE | OBSERVATION_NOT_MODEL_VALIDATION | PENDING | Source is raw UNSD or named derived cache, as ledger states. Cache conversion PASS does not prove original fuel/calorific completeness.
ID:2050:Agriculture:AgricultureFinalEnergy:oil | ID | 2050 | Agriculture | oil |  |  | PENDING | PENDING_ACCEPTED_WEIGHTS | PENDING_ACCEPTED_PROFILE | OBSERVATION_NOT_MODEL_VALIDATION | PENDING | Source is raw UNSD or named derived cache, as ledger states. Cache conversion PASS does not prove original fuel/calorific completeness.
ID:2050:Buildings:ResidentialDirectElectricity:electricity | ID | 2050 | Buildings | electricity |  |  | PENDING | NOT_APPLICABLE | NOT_APPLICABLE | OBSERVATION_NOT_MODEL_VALIDATION | PENDING | Source is raw UNSD or named derived cache, as ledger states. Cache conversion PASS does not prove original fuel/calorific completeness.
ID:2050:Buildings:ResidentialFuel:biomass | ID | 2050 | Buildings | biomass |  |  | PENDING | PENDING_ACCEPTED_WEIGHTS | PENDING_ACCEPTED_PROFILE | OBSERVATION_NOT_MODEL_VALIDATION | PENDING | Source is raw UNSD or named derived cache, as ledger states. Cache conversion PASS does not prove original fuel/calorific completeness.
ID:2050:Buildings:ResidentialFuel:coal | ID | 2050 | Buildings | coal |  |  | PENDING | PENDING_ACCEPTED_WEIGHTS | PENDING_ACCEPTED_PROFILE | OBSERVATION_NOT_MODEL_VALIDATION | PENDING | Source is raw UNSD or named derived cache, as ledger states. Cache conversion PASS does not prove original fuel/calorific completeness.
ID:2050:Buildings:ResidentialFuel:gas | ID | 2050 | Buildings | gas |  |  | PENDING | PENDING_ACCEPTED_WEIGHTS | PENDING_ACCEPTED_PROFILE | OBSERVATION_NOT_MODEL_VALIDATION | PENDING | Source is raw UNSD or named derived cache, as ledger states. Cache conversion PASS does not prove original fuel/calorific completeness.
ID:2050:Buildings:ResidentialFuel:oil | ID | 2050 | Buildings | oil |  |  | PENDING | PENDING_ACCEPTED_WEIGHTS | PENDING_ACCEPTED_PROFILE | OBSERVATION_NOT_MODEL_VALIDATION | PENDING | Source is raw UNSD or named derived cache, as ledger states. Cache conversion PASS does not prove original fuel/calorific completeness.
ID:2050:Buildings:ServicesDirectElectricity:electricity | ID | 2050 | Buildings | electricity |  |  | PENDING | NOT_APPLICABLE | NOT_APPLICABLE | OBSERVATION_NOT_MODEL_VALIDATION | PENDING | Source is raw UNSD or named derived cache, as ledger states. Cache conversion PASS does not prove original fuel/calorific completeness.
ID:2050:Buildings:ServicesFuel:biomass | ID | 2050 | Buildings | biomass |  |  | PENDING | PENDING_ACCEPTED_WEIGHTS | PENDING_ACCEPTED_PROFILE | OBSERVATION_NOT_MODEL_VALIDATION | PENDING | Source is raw UNSD or named derived cache, as ledger states. Cache conversion PASS does not prove original fuel/calorific completeness.
ID:2050:Buildings:ServicesFuel:coal | ID | 2050 | Buildings | coal |  |  | PENDING | PENDING_ACCEPTED_WEIGHTS | PENDING_ACCEPTED_PROFILE | OBSERVATION_NOT_MODEL_VALIDATION | PENDING | Source is raw UNSD or named derived cache, as ledger states. Cache conversion PASS does not prove original fuel/calorific completeness.
ID:2050:Buildings:ServicesFuel:gas | ID | 2050 | Buildings | gas |  |  | PENDING | PENDING_ACCEPTED_WEIGHTS | PENDING_ACCEPTED_PROFILE | OBSERVATION_NOT_MODEL_VALIDATION | PENDING | Source is raw UNSD or named derived cache, as ledger states. Cache conversion PASS does not prove original fuel/calorific completeness.
ID:2050:Buildings:ServicesFuel:oil | ID | 2050 | Buildings | oil |  |  | PENDING | PENDING_ACCEPTED_WEIGHTS | PENDING_ACCEPTED_PROFILE | OBSERVATION_NOT_MODEL_VALIDATION | PENDING | Source is raw UNSD or named derived cache, as ledger states. Cache conversion PASS does not prove original fuel/calorific completeness.
ID:2050:Bunker:InternationalAviationBunker:oil | ID | 2050 | Bunker | oil |  |  | PENDING | PENDING_ACCEPTED_WEIGHTS | PENDING_ACCEPTED_PROFILE | OBSERVATION_NOT_MODEL_VALIDATION | PENDING | Source is raw UNSD or named derived cache, as ledger states. Cache conversion PASS does not prove original fuel/calorific completeness.
ID:2050:Bunker:InternationalShippingBunker:oil | ID | 2050 | Bunker | oil |  |  | PENDING | PENDING_ACCEPTED_WEIGHTS | PENDING_ACCEPTED_PROFILE | OBSERVATION_NOT_MODEL_VALIDATION | PENDING | Source is raw UNSD or named derived cache, as ledger states. Cache conversion PASS does not prove original fuel/calorific completeness.
ID:2050:Electricity:Astar:electricity | ID | 2050 | Electricity | electricity |  |  | PENDING | PENDING_ACCEPTED_WEIGHTS | PENDING_ACCEPTED_PROFILE | OBSERVATION_NOT_MODEL_VALIDATION | PENDING | Source is raw UNSD or named derived cache, as ledger states. Cache conversion PASS does not prove original fuel/calorific completeness.
ID:2050:Industry:IndustryDirectElectricity:electricity | ID | 2050 | Industry | electricity |  |  | PENDING | NOT_APPLICABLE | NOT_APPLICABLE | OBSERVATION_NOT_MODEL_VALIDATION | PENDING | Source is raw UNSD or named derived cache, as ledger states. Cache conversion PASS does not prove original fuel/calorific completeness.
ID:2050:Industry:IndustryFinalEnergy:biomass | ID | 2050 | Industry | biomass |  |  | PENDING | PENDING_ACCEPTED_WEIGHTS | PENDING_ACCEPTED_PROFILE | OBSERVATION_NOT_MODEL_VALIDATION | PENDING | Source is raw UNSD or named derived cache, as ledger states. Cache conversion PASS does not prove original fuel/calorific completeness.
ID:2050:Industry:IndustryFinalEnergy:coal | ID | 2050 | Industry | coal |  |  | PENDING | PENDING_ACCEPTED_WEIGHTS | PENDING_ACCEPTED_PROFILE | OBSERVATION_NOT_MODEL_VALIDATION | PENDING | Source is raw UNSD or named derived cache, as ledger states. Cache conversion PASS does not prove original fuel/calorific completeness.
ID:2050:Industry:IndustryFinalEnergy:gas | ID | 2050 | Industry | gas |  |  | PENDING | PENDING_ACCEPTED_WEIGHTS | PENDING_ACCEPTED_PROFILE | OBSERVATION_NOT_MODEL_VALIDATION | PENDING | Source is raw UNSD or named derived cache, as ledger states. Cache conversion PASS does not prove original fuel/calorific completeness.
ID:2050:Industry:IndustryFinalEnergy:oil | ID | 2050 | Industry | oil |  |  | PENDING | PENDING_ACCEPTED_WEIGHTS | PENDING_ACCEPTED_PROFILE | OBSERVATION_NOT_MODEL_VALIDATION | PENDING | Source is raw UNSD or named derived cache, as ledger states. Cache conversion PASS does not prove original fuel/calorific completeness.
ID:2050:Transport:DomesticAviationFuel:oil | ID | 2050 | Transport | oil |  |  | PENDING | PENDING_ACCEPTED_WEIGHTS | PENDING_ACCEPTED_PROFILE | OBSERVATION_NOT_MODEL_VALIDATION | PENDING | Source is raw UNSD or named derived cache, as ledger states. Cache conversion PASS does not prove original fuel/calorific completeness.
ID:2050:Transport:DomesticShippingFuel:oil | ID | 2050 | Transport | oil |  |  | PENDING | PENDING_ACCEPTED_WEIGHTS | PENDING_ACCEPTED_PROFILE | OBSERVATION_NOT_MODEL_VALIDATION | PENDING | Source is raw UNSD or named derived cache, as ledger states. Cache conversion PASS does not prove original fuel/calorific completeness.
ID:2050:Transport:RailElectricity:electricity | ID | 2050 | Transport | electricity |  |  | PENDING | NOT_APPLICABLE | NOT_APPLICABLE | OBSERVATION_NOT_MODEL_VALIDATION | PENDING | Source is raw UNSD or named derived cache, as ledger states. Cache conversion PASS does not prove original fuel/calorific completeness.
ID:2050:Transport:RoadEVFinalElectricity:electricity | ID | 2050 | Transport | electricity |  |  | PENDING | PENDING_ACCEPTED_WEIGHTS | PENDING_ACCEPTED_PROFILE | OBSERVATION_NOT_MODEL_VALIDATION | PENDING | Source is raw UNSD or named derived cache, as ledger states. Cache conversion PASS does not prove original fuel/calorific completeness.
ID:2050:Transport:RoadResidualFuel:biomass | ID | 2050 | Transport | biomass |  |  | PENDING | PENDING_ACCEPTED_WEIGHTS | PENDING_ACCEPTED_PROFILE | OBSERVATION_NOT_MODEL_VALIDATION | PENDING | Source is raw UNSD or named derived cache, as ledger states. Cache conversion PASS does not prove original fuel/calorific completeness.
ID:2050:Transport:RoadResidualFuel:gas | ID | 2050 | Transport | gas |  |  | PENDING | PENDING_ACCEPTED_WEIGHTS | PENDING_ACCEPTED_PROFILE | OBSERVATION_NOT_MODEL_VALIDATION | PENDING | Source is raw UNSD or named derived cache, as ledger states. Cache conversion PASS does not prove original fuel/calorific completeness.
ID:2050:Transport:RoadResidualFuel:oil | ID | 2050 | Transport | oil |  |  | PENDING | PENDING_ACCEPTED_WEIGHTS | PENDING_ACCEPTED_PROFILE | OBSERVATION_NOT_MODEL_VALIDATION | PENDING | Source is raw UNSD or named derived cache, as ledger states. Cache conversion PASS does not prove original fuel/calorific completeness.
ID:2050:Transport:TransportEmbeddedFuelParent:unclassified_fuel | ID | 2050 | Transport | unclassified_fuel |  |  | PENDING | PENDING_ACCEPTED_WEIGHTS | PENDING_ACCEPTED_PROFILE | OBSERVATION_NOT_MODEL_VALIDATION | PENDING | Source is raw UNSD or named derived cache, as ledger states. Cache conversion PASS does not prove original fuel/calorific completeness.
KH:2019:Agriculture:AgricultureFinalEnergy:biomass | KH | 2019 | Agriculture | biomass |  |  | PENDING | PENDING_ACCEPTED_WEIGHTS | PENDING_ACCEPTED_PROFILE | OBSERVATION_NOT_MODEL_VALIDATION | PENDING | Source is raw UNSD or named derived cache, as ledger states. Cache conversion PASS does not prove original fuel/calorific completeness.
KH:2019:Agriculture:AgricultureFinalEnergy:coal | KH | 2019 | Agriculture | coal |  |  | PENDING | PENDING_ACCEPTED_WEIGHTS | PENDING_ACCEPTED_PROFILE | OBSERVATION_NOT_MODEL_VALIDATION | PENDING | Source is raw UNSD or named derived cache, as ledger states. Cache conversion PASS does not prove original fuel/calorific completeness.
KH:2019:Agriculture:AgricultureFinalEnergy:electricity | KH | 2019 | Agriculture | electricity |  |  | PENDING | NOT_APPLICABLE | NOT_APPLICABLE | OBSERVATION_NOT_MODEL_VALIDATION | PENDING | Source is raw UNSD or named derived cache, as ledger states. Cache conversion PASS does not prove original fuel/calorific completeness.
KH:2019:Agriculture:AgricultureFinalEnergy:oil | KH | 2019 | Agriculture | oil | 3600.0 | 3600.0 | PASS_SOURCE_TO_LEDGER | PENDING_ACCEPTED_WEIGHTS | PENDING_ACCEPTED_PROFILE | OBSERVATION_NOT_MODEL_VALIDATION | PARTIAL | Source is raw UNSD or named derived cache, as ledger states. Cache conversion PASS does not prove original fuel/calorific completeness.
KH:2019:Buildings:ResidentialCooking:mixed | KH | 2019 | Buildings | mixed |  |  | PENDING | NOT_APPLICABLE | NOT_APPLICABLE | OBSERVATION_NOT_MODEL_VALIDATION | PENDING | Source is raw UNSD or named derived cache, as ledger states. Cache conversion PASS does not prove original fuel/calorific completeness.
KH:2019:Buildings:ResidentialCooling:electricity | KH | 2019 | Buildings | electricity |  |  | PENDING | NOT_APPLICABLE | NOT_APPLICABLE | OBSERVATION_NOT_MODEL_VALIDATION | PENDING | Source is raw UNSD or named derived cache, as ledger states. Cache conversion PASS does not prove original fuel/calorific completeness.
KH:2019:Buildings:ResidentialDirectElectricity:electricity | KH | 2019 | Buildings | electricity | 3399570.0 | 3399570.0 | PASS_SOURCE_TO_LEDGER | NOT_APPLICABLE | NOT_APPLICABLE | OBSERVATION_NOT_MODEL_VALIDATION | PARTIAL | Source is raw UNSD or named derived cache, as ledger states. Cache conversion PASS does not prove original fuel/calorific completeness.
KH:2019:Buildings:ResidentialFuel:biomass | KH | 2019 | Buildings | biomass | 7961200.0 | 7961200.0 | PASS_SOURCE_TO_LEDGER | PENDING_ACCEPTED_WEIGHTS | PENDING_ACCEPTED_PROFILE | OBSERVATION_NOT_MODEL_VALIDATION | PARTIAL | Source is raw UNSD or named derived cache, as ledger states. Cache conversion PASS does not prove original fuel/calorific completeness.
KH:2019:Buildings:ResidentialFuel:coal | KH | 2019 | Buildings | coal |  |  | PENDING | PENDING_ACCEPTED_WEIGHTS | PENDING_ACCEPTED_PROFILE | OBSERVATION_NOT_MODEL_VALIDATION | PENDING | Source is raw UNSD or named derived cache, as ledger states. Cache conversion PASS does not prove original fuel/calorific completeness.
KH:2019:Buildings:ResidentialFuel:gas | KH | 2019 | Buildings | gas |  |  | PENDING | PENDING_ACCEPTED_WEIGHTS | PENDING_ACCEPTED_PROFILE | OBSERVATION_NOT_MODEL_VALIDATION | PENDING | Source is raw UNSD or named derived cache, as ledger states. Cache conversion PASS does not prove original fuel/calorific completeness.
KH:2019:Buildings:ResidentialFuel:oil | KH | 2019 | Buildings | oil | 350600.0 | 350600.0 | PASS_SOURCE_TO_LEDGER | PENDING_ACCEPTED_WEIGHTS | PENDING_ACCEPTED_PROFILE | OBSERVATION_NOT_MODEL_VALIDATION | PARTIAL | Source is raw UNSD or named derived cache, as ledger states. Cache conversion PASS does not prove original fuel/calorific completeness.
KH:2019:Buildings:ResidentialSpaceHeat:mixed | KH | 2019 | Buildings | mixed |  |  | PENDING | NOT_APPLICABLE | NOT_APPLICABLE | OBSERVATION_NOT_MODEL_VALIDATION | PENDING | Source is raw UNSD or named derived cache, as ledger states. Cache conversion PASS does not prove original fuel/calorific completeness.
KH:2019:Buildings:ResidentialWaterHeat:mixed | KH | 2019 | Buildings | mixed |  |  | PENDING | NOT_APPLICABLE | NOT_APPLICABLE | OBSERVATION_NOT_MODEL_VALIDATION | PENDING | Source is raw UNSD or named derived cache, as ledger states. Cache conversion PASS does not prove original fuel/calorific completeness.
KH:2019:Buildings:ServicesCooking:mixed | KH | 2019 | Buildings | mixed |  |  | PENDING | NOT_APPLICABLE | NOT_APPLICABLE | OBSERVATION_NOT_MODEL_VALIDATION | PENDING | Source is raw UNSD or named derived cache, as ledger states. Cache conversion PASS does not prove original fuel/calorific completeness.
KH:2019:Buildings:ServicesCooling:electricity | KH | 2019 | Buildings | electricity |  |  | PENDING | NOT_APPLICABLE | NOT_APPLICABLE | OBSERVATION_NOT_MODEL_VALIDATION | PENDING | Source is raw UNSD or named derived cache, as ledger states. Cache conversion PASS does not prove original fuel/calorific completeness.
KH:2019:Buildings:ServicesDirectElectricity:electricity | KH | 2019 | Buildings | electricity | 3408230.0 | 3408230.0 | PASS_SOURCE_TO_LEDGER | NOT_APPLICABLE | NOT_APPLICABLE | OBSERVATION_NOT_MODEL_VALIDATION | PARTIAL | Source is raw UNSD or named derived cache, as ledger states. Cache conversion PASS does not prove original fuel/calorific completeness.
KH:2019:Buildings:ServicesFuel:biomass | KH | 2019 | Buildings | biomass |  |  | PENDING | PENDING_ACCEPTED_WEIGHTS | PENDING_ACCEPTED_PROFILE | OBSERVATION_NOT_MODEL_VALIDATION | PENDING | Source is raw UNSD or named derived cache, as ledger states. Cache conversion PASS does not prove original fuel/calorific completeness.
KH:2019:Buildings:ServicesFuel:coal | KH | 2019 | Buildings | coal |  |  | PENDING | PENDING_ACCEPTED_WEIGHTS | PENDING_ACCEPTED_PROFILE | OBSERVATION_NOT_MODEL_VALIDATION | PENDING | Source is raw UNSD or named derived cache, as ledger states. Cache conversion PASS does not prove original fuel/calorific completeness.
KH:2019:Buildings:ServicesFuel:gas | KH | 2019 | Buildings | gas |  |  | PENDING | PENDING_ACCEPTED_WEIGHTS | PENDING_ACCEPTED_PROFILE | OBSERVATION_NOT_MODEL_VALIDATION | PENDING | Source is raw UNSD or named derived cache, as ledger states. Cache conversion PASS does not prove original fuel/calorific completeness.
KH:2019:Buildings:ServicesFuel:oil | KH | 2019 | Buildings | oil | 2681100.0 | 2681100.0 | PASS_SOURCE_TO_LEDGER | PENDING_ACCEPTED_WEIGHTS | PENDING_ACCEPTED_PROFILE | OBSERVATION_NOT_MODEL_VALIDATION | PARTIAL | Source is raw UNSD or named derived cache, as ledger states. Cache conversion PASS does not prove original fuel/calorific completeness.
KH:2019:Buildings:ServicesSpaceHeat:mixed | KH | 2019 | Buildings | mixed |  |  | PENDING | NOT_APPLICABLE | NOT_APPLICABLE | OBSERVATION_NOT_MODEL_VALIDATION | PENDING | Source is raw UNSD or named derived cache, as ledger states. Cache conversion PASS does not prove original fuel/calorific completeness.
KH:2019:Buildings:ServicesWaterHeat:mixed | KH | 2019 | Buildings | mixed |  |  | PENDING | NOT_APPLICABLE | NOT_APPLICABLE | OBSERVATION_NOT_MODEL_VALIDATION | PENDING | Source is raw UNSD or named derived cache, as ledger states. Cache conversion PASS does not prove original fuel/calorific completeness.
KH:2019:Bunker:InternationalAviationBunker:oil | KH | 2019 | Bunker | oil | 1907300.0 | 1907300.0 | PASS_SOURCE_TO_LEDGER | PENDING_ACCEPTED_WEIGHTS | PENDING_ACCEPTED_PROFILE | OBSERVATION_NOT_MODEL_VALIDATION | PARTIAL | Source is raw UNSD or named derived cache, as ledger states. Cache conversion PASS does not prove original fuel/calorific completeness.
KH:2019:Bunker:InternationalShippingBunker:oil | KH | 2019 | Bunker | oil |  |  | PENDING | PENDING_ACCEPTED_WEIGHTS | PENDING_ACCEPTED_PROFILE | OBSERVATION_NOT_MODEL_VALIDATION | PENDING | Source is raw UNSD or named derived cache, as ledger states. Cache conversion PASS does not prove original fuel/calorific completeness.
KH:2019:Conversion:EVIfConversion:electricity | KH | 2019 | Conversion | electricity |  |  | PENDING | NOT_APPLICABLE | NOT_APPLICABLE | OBSERVATION_NOT_MODEL_VALIDATION | PENDING | Source is raw UNSD or named derived cache, as ledger states. Cache conversion PASS does not prove original fuel/calorific completeness.
KH:2019:Conversion:Electrolysis:electricity | KH | 2019 | Conversion | electricity |  |  | PENDING | NOT_APPLICABLE | NOT_APPLICABLE | OBSERVATION_NOT_MODEL_VALIDATION | PENDING | Source is raw UNSD or named derived cache, as ledger states. Cache conversion PASS does not prove original fuel/calorific completeness.
KH:2019:Conversion:FischerTropsch:electricity | KH | 2019 | Conversion | electricity |  |  | PENDING | NOT_APPLICABLE | NOT_APPLICABLE | OBSERVATION_NOT_MODEL_VALIDATION | PENDING | Source is raw UNSD or named derived cache, as ledger states. Cache conversion PASS does not prove original fuel/calorific completeness.
KH:2019:Conversion:HeatPump:electricity | KH | 2019 | Conversion | electricity |  |  | PENDING | NOT_APPLICABLE | NOT_APPLICABLE | OBSERVATION_NOT_MODEL_VALIDATION | PENDING | Source is raw UNSD or named derived cache, as ledger states. Cache conversion PASS does not prove original fuel/calorific completeness.
KH:2019:Conversion:ResistiveHeating:electricity | KH | 2019 | Conversion | electricity |  |  | PENDING | NOT_APPLICABLE | NOT_APPLICABLE | OBSERVATION_NOT_MODEL_VALIDATION | PENDING | Source is raw UNSD or named derived cache, as ledger states. Cache conversion PASS does not prove original fuel/calorific completeness.
KH:2019:Electricity:Astar:electricity | KH | 2019 | Electricity | electricity | 10191090.0 | 10191090.0 | PASS_SOURCE_TO_LEDGER | PENDING_ACCEPTED_WEIGHTS | PENDING_ACCEPTED_PROFILE | OBSERVATION_NOT_MODEL_VALIDATION | PARTIAL | Source is raw UNSD or named derived cache, as ledger states. Cache conversion PASS does not prove original fuel/calorific completeness.
KH:2019:Industry:IndustryCacheElectricityReference:electricity | KH | 2019 | Industry | electricity | 3383290.0 | 3383290.0 | PASS_SOURCE_TO_LEDGER | NOT_APPLICABLE | NOT_APPLICABLE | OBSERVATION_NOT_MODEL_VALIDATION | PARTIAL | Source is raw UNSD or named derived cache, as ledger states. Cache conversion PASS does not prove original fuel/calorific completeness.
KH:2019:Industry:IndustryDirectElectricity:electricity | KH | 2019 | Industry | electricity | 3383290.0 | 3383290.0 | PASS_SOURCE_TO_LEDGER | NOT_APPLICABLE | NOT_APPLICABLE | OBSERVATION_NOT_MODEL_VALIDATION | PARTIAL | Source is raw UNSD or named derived cache, as ledger states. Cache conversion PASS does not prove original fuel/calorific completeness.
KH:2019:Industry:IndustryFuel:biomass | KH | 2019 | Industry | biomass | 2487422.0 | 2487422.0 | PASS_SOURCE_TO_LEDGER | PENDING_ACCEPTED_WEIGHTS | PENDING_ACCEPTED_PROFILE | OBSERVATION_NOT_MODEL_VALIDATION | PARTIAL | Source is raw UNSD or named derived cache, as ledger states. Cache conversion PASS does not prove original fuel/calorific completeness.
KH:2019:Industry:IndustryFuel:coal | KH | 2019 | Industry | coal | 2986349.1999999997 | 2986349.1999999997 | PASS_SOURCE_TO_LEDGER | PENDING_ACCEPTED_WEIGHTS | PENDING_ACCEPTED_PROFILE | OBSERVATION_NOT_MODEL_VALIDATION | PARTIAL | Source is raw UNSD or named derived cache, as ledger states. Cache conversion PASS does not prove original fuel/calorific completeness.
KH:2019:Industry:IndustryFuel:gas | KH | 2019 | Industry | gas |  |  | PENDING | PENDING_ACCEPTED_WEIGHTS | PENDING_ACCEPTED_PROFILE | OBSERVATION_NOT_MODEL_VALIDATION | PENDING | Source is raw UNSD or named derived cache, as ledger states. Cache conversion PASS does not prove original fuel/calorific completeness.
KH:2019:Industry:IndustryFuel:heat | KH | 2019 | Industry | heat |  |  | PENDING | NOT_APPLICABLE | NOT_APPLICABLE | OBSERVATION_NOT_MODEL_VALIDATION | PENDING | Source is raw UNSD or named derived cache, as ledger states. Cache conversion PASS does not prove original fuel/calorific completeness.
KH:2019:Industry:IndustryFuel:hydrogen | KH | 2019 | Industry | hydrogen |  |  | PENDING | NOT_APPLICABLE | NOT_APPLICABLE | OBSERVATION_NOT_MODEL_VALIDATION | PENDING | Source is raw UNSD or named derived cache, as ledger states. Cache conversion PASS does not prove original fuel/calorific completeness.
KH:2019:Industry:IndustryFuel:oil | KH | 2019 | Industry | oil | 2882052.0 | 2882052.0 | PASS_SOURCE_TO_LEDGER | PENDING_ACCEPTED_WEIGHTS | PENDING_ACCEPTED_PROFILE | OBSERVATION_NOT_MODEL_VALIDATION | PARTIAL | Source is raw UNSD or named derived cache, as ledger states. Cache conversion PASS does not prove original fuel/calorific completeness.
KH:2019:Transport:DomesticAviationFuel:oil | KH | 2019 | Transport | oil | 846500.0 | 846500.0 | PASS_SOURCE_TO_LEDGER | PENDING_ACCEPTED_WEIGHTS | PENDING_ACCEPTED_PROFILE | OBSERVATION_NOT_MODEL_VALIDATION | PARTIAL | Source is raw UNSD or named derived cache, as ledger states. Cache conversion PASS does not prove original fuel/calorific completeness.
KH:2019:Transport:DomesticShippingFuel:oil | KH | 2019 | Transport | oil |  |  | PENDING | PENDING_ACCEPTED_WEIGHTS | PENDING_ACCEPTED_PROFILE | OBSERVATION_NOT_MODEL_VALIDATION | PENDING | Source is raw UNSD or named derived cache, as ledger states. Cache conversion PASS does not prove original fuel/calorific completeness.
KH:2019:Transport:HistoricalRoadElectricity:electricity | KH | 2019 | Transport | electricity |  |  | PENDING | NOT_APPLICABLE | NOT_APPLICABLE | OBSERVATION_NOT_MODEL_VALIDATION | PENDING | Source is raw UNSD or named derived cache, as ledger states. Cache conversion PASS does not prove original fuel/calorific completeness.
KH:2019:Transport:RailElectricity:electricity | KH | 2019 | Transport | electricity |  |  | PENDING | NOT_APPLICABLE | NOT_APPLICABLE | OBSERVATION_NOT_MODEL_VALIDATION | PENDING | Source is raw UNSD or named derived cache, as ledger states. Cache conversion PASS does not prove original fuel/calorific completeness.
KH:2019:Transport:RailFinalEnergyReference:mixed | KH | 2019 | Transport | mixed | 2698400.0 | 2698400.0 | PASS_SOURCE_TO_LEDGER | NOT_APPLICABLE | NOT_APPLICABLE | OBSERVATION_NOT_MODEL_VALIDATION | PARTIAL | Source is raw UNSD or named derived cache, as ledger states. Cache conversion PASS does not prove original fuel/calorific completeness.
KH:2019:Transport:RoadParentFinalEnergy:all_final_energy | KH | 2019 | Transport | all_final_energy | 20345200.0 | 20345200.0 | PASS_SOURCE_TO_LEDGER | NOT_APPLICABLE | NOT_APPLICABLE | OBSERVATION_NOT_MODEL_VALIDATION | PARTIAL | Source is raw UNSD or named derived cache, as ledger states. Cache conversion PASS does not prove original fuel/calorific completeness.
KH:2019:Transport:RoadResidualFuel:biomass | KH | 2019 | Transport | biomass |  |  | PENDING | PENDING_ACCEPTED_WEIGHTS | PENDING_ACCEPTED_PROFILE | OBSERVATION_NOT_MODEL_VALIDATION | PENDING | Source is raw UNSD or named derived cache, as ledger states. Cache conversion PASS does not prove original fuel/calorific completeness.
KH:2019:Transport:RoadResidualFuel:gas | KH | 2019 | Transport | gas |  |  | PENDING | PENDING_ACCEPTED_WEIGHTS | PENDING_ACCEPTED_PROFILE | OBSERVATION_NOT_MODEL_VALIDATION | PENDING | Source is raw UNSD or named derived cache, as ledger states. Cache conversion PASS does not prove original fuel/calorific completeness.
KH:2019:Transport:RoadResidualFuel:oil | KH | 2019 | Transport | oil | 20345200.0 | 20345200.0 | PASS_SOURCE_TO_LEDGER | PENDING_ACCEPTED_WEIGHTS | PENDING_ACCEPTED_PROFILE | OBSERVATION_NOT_MODEL_VALIDATION | PARTIAL | Source is raw UNSD or named derived cache, as ledger states. Cache conversion PASS does not prove original fuel/calorific completeness.
KH:2019:Transport:TransportEmbeddedFuelParent:unclassified_fuel | KH | 2019 | Transport | unclassified_fuel |  |  | PENDING | PENDING_ACCEPTED_WEIGHTS | PENDING_ACCEPTED_PROFILE | OBSERVATION_NOT_MODEL_VALIDATION | PENDING | Source is raw UNSD or named derived cache, as ledger states. Cache conversion PASS does not prove original fuel/calorific completeness.
KH:2030:Agriculture:AgricultureDirectElectricity:electricity | KH | 2030 | Agriculture | electricity |  |  | PENDING | NOT_APPLICABLE | NOT_APPLICABLE | OBSERVATION_NOT_MODEL_VALIDATION | PENDING | Source is raw UNSD or named derived cache, as ledger states. Cache conversion PASS does not prove original fuel/calorific completeness.
KH:2030:Agriculture:AgricultureFinalEnergy:biomass | KH | 2030 | Agriculture | biomass |  |  | PENDING | PENDING_ACCEPTED_WEIGHTS | PENDING_ACCEPTED_PROFILE | OBSERVATION_NOT_MODEL_VALIDATION | PENDING | Source is raw UNSD or named derived cache, as ledger states. Cache conversion PASS does not prove original fuel/calorific completeness.
KH:2030:Agriculture:AgricultureFinalEnergy:coal | KH | 2030 | Agriculture | coal |  |  | PENDING | PENDING_ACCEPTED_WEIGHTS | PENDING_ACCEPTED_PROFILE | OBSERVATION_NOT_MODEL_VALIDATION | PENDING | Source is raw UNSD or named derived cache, as ledger states. Cache conversion PASS does not prove original fuel/calorific completeness.
KH:2030:Agriculture:AgricultureFinalEnergy:oil | KH | 2030 | Agriculture | oil |  |  | PENDING | PENDING_ACCEPTED_WEIGHTS | PENDING_ACCEPTED_PROFILE | OBSERVATION_NOT_MODEL_VALIDATION | PENDING | Source is raw UNSD or named derived cache, as ledger states. Cache conversion PASS does not prove original fuel/calorific completeness.
KH:2030:Buildings:ResidentialDirectElectricity:electricity | KH | 2030 | Buildings | electricity |  |  | PENDING | NOT_APPLICABLE | NOT_APPLICABLE | OBSERVATION_NOT_MODEL_VALIDATION | PENDING | Source is raw UNSD or named derived cache, as ledger states. Cache conversion PASS does not prove original fuel/calorific completeness.
KH:2030:Buildings:ResidentialFuel:biomass | KH | 2030 | Buildings | biomass |  |  | PENDING | PENDING_ACCEPTED_WEIGHTS | PENDING_ACCEPTED_PROFILE | OBSERVATION_NOT_MODEL_VALIDATION | PENDING | Source is raw UNSD or named derived cache, as ledger states. Cache conversion PASS does not prove original fuel/calorific completeness.
KH:2030:Buildings:ResidentialFuel:coal | KH | 2030 | Buildings | coal |  |  | PENDING | PENDING_ACCEPTED_WEIGHTS | PENDING_ACCEPTED_PROFILE | OBSERVATION_NOT_MODEL_VALIDATION | PENDING | Source is raw UNSD or named derived cache, as ledger states. Cache conversion PASS does not prove original fuel/calorific completeness.
KH:2030:Buildings:ResidentialFuel:gas | KH | 2030 | Buildings | gas |  |  | PENDING | PENDING_ACCEPTED_WEIGHTS | PENDING_ACCEPTED_PROFILE | OBSERVATION_NOT_MODEL_VALIDATION | PENDING | Source is raw UNSD or named derived cache, as ledger states. Cache conversion PASS does not prove original fuel/calorific completeness.
KH:2030:Buildings:ResidentialFuel:oil | KH | 2030 | Buildings | oil |  |  | PENDING | PENDING_ACCEPTED_WEIGHTS | PENDING_ACCEPTED_PROFILE | OBSERVATION_NOT_MODEL_VALIDATION | PENDING | Source is raw UNSD or named derived cache, as ledger states. Cache conversion PASS does not prove original fuel/calorific completeness.
KH:2030:Buildings:ServicesDirectElectricity:electricity | KH | 2030 | Buildings | electricity |  |  | PENDING | NOT_APPLICABLE | NOT_APPLICABLE | OBSERVATION_NOT_MODEL_VALIDATION | PENDING | Source is raw UNSD or named derived cache, as ledger states. Cache conversion PASS does not prove original fuel/calorific completeness.
KH:2030:Buildings:ServicesFuel:biomass | KH | 2030 | Buildings | biomass |  |  | PENDING | PENDING_ACCEPTED_WEIGHTS | PENDING_ACCEPTED_PROFILE | OBSERVATION_NOT_MODEL_VALIDATION | PENDING | Source is raw UNSD or named derived cache, as ledger states. Cache conversion PASS does not prove original fuel/calorific completeness.
KH:2030:Buildings:ServicesFuel:coal | KH | 2030 | Buildings | coal |  |  | PENDING | PENDING_ACCEPTED_WEIGHTS | PENDING_ACCEPTED_PROFILE | OBSERVATION_NOT_MODEL_VALIDATION | PENDING | Source is raw UNSD or named derived cache, as ledger states. Cache conversion PASS does not prove original fuel/calorific completeness.
KH:2030:Buildings:ServicesFuel:gas | KH | 2030 | Buildings | gas |  |  | PENDING | PENDING_ACCEPTED_WEIGHTS | PENDING_ACCEPTED_PROFILE | OBSERVATION_NOT_MODEL_VALIDATION | PENDING | Source is raw UNSD or named derived cache, as ledger states. Cache conversion PASS does not prove original fuel/calorific completeness.
KH:2030:Buildings:ServicesFuel:oil | KH | 2030 | Buildings | oil |  |  | PENDING | PENDING_ACCEPTED_WEIGHTS | PENDING_ACCEPTED_PROFILE | OBSERVATION_NOT_MODEL_VALIDATION | PENDING | Source is raw UNSD or named derived cache, as ledger states. Cache conversion PASS does not prove original fuel/calorific completeness.
KH:2030:Bunker:InternationalAviationBunker:oil | KH | 2030 | Bunker | oil |  |  | PENDING | PENDING_ACCEPTED_WEIGHTS | PENDING_ACCEPTED_PROFILE | OBSERVATION_NOT_MODEL_VALIDATION | PENDING | Source is raw UNSD or named derived cache, as ledger states. Cache conversion PASS does not prove original fuel/calorific completeness.
KH:2030:Bunker:InternationalShippingBunker:oil | KH | 2030 | Bunker | oil |  |  | PENDING | PENDING_ACCEPTED_WEIGHTS | PENDING_ACCEPTED_PROFILE | OBSERVATION_NOT_MODEL_VALIDATION | PENDING | Source is raw UNSD or named derived cache, as ledger states. Cache conversion PASS does not prove original fuel/calorific completeness.
KH:2030:Electricity:Astar:electricity | KH | 2030 | Electricity | electricity |  |  | PENDING | PENDING_ACCEPTED_WEIGHTS | PENDING_ACCEPTED_PROFILE | OBSERVATION_NOT_MODEL_VALIDATION | PENDING | Source is raw UNSD or named derived cache, as ledger states. Cache conversion PASS does not prove original fuel/calorific completeness.
KH:2030:Industry:IndustryDirectElectricity:electricity | KH | 2030 | Industry | electricity |  |  | PENDING | NOT_APPLICABLE | NOT_APPLICABLE | OBSERVATION_NOT_MODEL_VALIDATION | PENDING | Source is raw UNSD or named derived cache, as ledger states. Cache conversion PASS does not prove original fuel/calorific completeness.
KH:2030:Industry:IndustryFinalEnergy:biomass | KH | 2030 | Industry | biomass |  |  | PENDING | PENDING_ACCEPTED_WEIGHTS | PENDING_ACCEPTED_PROFILE | OBSERVATION_NOT_MODEL_VALIDATION | PENDING | Source is raw UNSD or named derived cache, as ledger states. Cache conversion PASS does not prove original fuel/calorific completeness.
KH:2030:Industry:IndustryFinalEnergy:coal | KH | 2030 | Industry | coal |  |  | PENDING | PENDING_ACCEPTED_WEIGHTS | PENDING_ACCEPTED_PROFILE | OBSERVATION_NOT_MODEL_VALIDATION | PENDING | Source is raw UNSD or named derived cache, as ledger states. Cache conversion PASS does not prove original fuel/calorific completeness.
KH:2030:Industry:IndustryFinalEnergy:gas | KH | 2030 | Industry | gas |  |  | PENDING | PENDING_ACCEPTED_WEIGHTS | PENDING_ACCEPTED_PROFILE | OBSERVATION_NOT_MODEL_VALIDATION | PENDING | Source is raw UNSD or named derived cache, as ledger states. Cache conversion PASS does not prove original fuel/calorific completeness.
KH:2030:Industry:IndustryFinalEnergy:oil | KH | 2030 | Industry | oil |  |  | PENDING | PENDING_ACCEPTED_WEIGHTS | PENDING_ACCEPTED_PROFILE | OBSERVATION_NOT_MODEL_VALIDATION | PENDING | Source is raw UNSD or named derived cache, as ledger states. Cache conversion PASS does not prove original fuel/calorific completeness.
KH:2030:Transport:DomesticAviationFuel:oil | KH | 2030 | Transport | oil |  |  | PENDING | PENDING_ACCEPTED_WEIGHTS | PENDING_ACCEPTED_PROFILE | OBSERVATION_NOT_MODEL_VALIDATION | PENDING | Source is raw UNSD or named derived cache, as ledger states. Cache conversion PASS does not prove original fuel/calorific completeness.
KH:2030:Transport:DomesticShippingFuel:oil | KH | 2030 | Transport | oil |  |  | PENDING | PENDING_ACCEPTED_WEIGHTS | PENDING_ACCEPTED_PROFILE | OBSERVATION_NOT_MODEL_VALIDATION | PENDING | Source is raw UNSD or named derived cache, as ledger states. Cache conversion PASS does not prove original fuel/calorific completeness.
KH:2030:Transport:RailElectricity:electricity | KH | 2030 | Transport | electricity |  |  | PENDING | NOT_APPLICABLE | NOT_APPLICABLE | OBSERVATION_NOT_MODEL_VALIDATION | PENDING | Source is raw UNSD or named derived cache, as ledger states. Cache conversion PASS does not prove original fuel/calorific completeness.
KH:2030:Transport:RoadEVFinalElectricity:electricity | KH | 2030 | Transport | electricity |  |  | PENDING | PENDING_ACCEPTED_WEIGHTS | PENDING_ACCEPTED_PROFILE | OBSERVATION_NOT_MODEL_VALIDATION | PENDING | Source is raw UNSD or named derived cache, as ledger states. Cache conversion PASS does not prove original fuel/calorific completeness.
KH:2030:Transport:RoadResidualFuel:biomass | KH | 2030 | Transport | biomass |  |  | PENDING | PENDING_ACCEPTED_WEIGHTS | PENDING_ACCEPTED_PROFILE | OBSERVATION_NOT_MODEL_VALIDATION | PENDING | Source is raw UNSD or named derived cache, as ledger states. Cache conversion PASS does not prove original fuel/calorific completeness.
KH:2030:Transport:RoadResidualFuel:gas | KH | 2030 | Transport | gas |  |  | PENDING | PENDING_ACCEPTED_WEIGHTS | PENDING_ACCEPTED_PROFILE | OBSERVATION_NOT_MODEL_VALIDATION | PENDING | Source is raw UNSD or named derived cache, as ledger states. Cache conversion PASS does not prove original fuel/calorific completeness.
KH:2030:Transport:RoadResidualFuel:oil | KH | 2030 | Transport | oil |  |  | PENDING | PENDING_ACCEPTED_WEIGHTS | PENDING_ACCEPTED_PROFILE | OBSERVATION_NOT_MODEL_VALIDATION | PENDING | Source is raw UNSD or named derived cache, as ledger states. Cache conversion PASS does not prove original fuel/calorific completeness.
KH:2030:Transport:TransportEmbeddedFuelParent:unclassified_fuel | KH | 2030 | Transport | unclassified_fuel |  |  | PENDING | PENDING_ACCEPTED_WEIGHTS | PENDING_ACCEPTED_PROFILE | OBSERVATION_NOT_MODEL_VALIDATION | PENDING | Source is raw UNSD or named derived cache, as ledger states. Cache conversion PASS does not prove original fuel/calorific completeness.
KH:2040:Agriculture:AgricultureDirectElectricity:electricity | KH | 2040 | Agriculture | electricity |  |  | PENDING | NOT_APPLICABLE | NOT_APPLICABLE | OBSERVATION_NOT_MODEL_VALIDATION | PENDING | Source is raw UNSD or named derived cache, as ledger states. Cache conversion PASS does not prove original fuel/calorific completeness.
KH:2040:Agriculture:AgricultureFinalEnergy:biomass | KH | 2040 | Agriculture | biomass |  |  | PENDING | PENDING_ACCEPTED_WEIGHTS | PENDING_ACCEPTED_PROFILE | OBSERVATION_NOT_MODEL_VALIDATION | PENDING | Source is raw UNSD or named derived cache, as ledger states. Cache conversion PASS does not prove original fuel/calorific completeness.
KH:2040:Agriculture:AgricultureFinalEnergy:coal | KH | 2040 | Agriculture | coal |  |  | PENDING | PENDING_ACCEPTED_WEIGHTS | PENDING_ACCEPTED_PROFILE | OBSERVATION_NOT_MODEL_VALIDATION | PENDING | Source is raw UNSD or named derived cache, as ledger states. Cache conversion PASS does not prove original fuel/calorific completeness.
KH:2040:Agriculture:AgricultureFinalEnergy:oil | KH | 2040 | Agriculture | oil |  |  | PENDING | PENDING_ACCEPTED_WEIGHTS | PENDING_ACCEPTED_PROFILE | OBSERVATION_NOT_MODEL_VALIDATION | PENDING | Source is raw UNSD or named derived cache, as ledger states. Cache conversion PASS does not prove original fuel/calorific completeness.
KH:2040:Buildings:ResidentialDirectElectricity:electricity | KH | 2040 | Buildings | electricity |  |  | PENDING | NOT_APPLICABLE | NOT_APPLICABLE | OBSERVATION_NOT_MODEL_VALIDATION | PENDING | Source is raw UNSD or named derived cache, as ledger states. Cache conversion PASS does not prove original fuel/calorific completeness.
KH:2040:Buildings:ResidentialFuel:biomass | KH | 2040 | Buildings | biomass |  |  | PENDING | PENDING_ACCEPTED_WEIGHTS | PENDING_ACCEPTED_PROFILE | OBSERVATION_NOT_MODEL_VALIDATION | PENDING | Source is raw UNSD or named derived cache, as ledger states. Cache conversion PASS does not prove original fuel/calorific completeness.
KH:2040:Buildings:ResidentialFuel:coal | KH | 2040 | Buildings | coal |  |  | PENDING | PENDING_ACCEPTED_WEIGHTS | PENDING_ACCEPTED_PROFILE | OBSERVATION_NOT_MODEL_VALIDATION | PENDING | Source is raw UNSD or named derived cache, as ledger states. Cache conversion PASS does not prove original fuel/calorific completeness.
KH:2040:Buildings:ResidentialFuel:gas | KH | 2040 | Buildings | gas |  |  | PENDING | PENDING_ACCEPTED_WEIGHTS | PENDING_ACCEPTED_PROFILE | OBSERVATION_NOT_MODEL_VALIDATION | PENDING | Source is raw UNSD or named derived cache, as ledger states. Cache conversion PASS does not prove original fuel/calorific completeness.
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
