cyc292cycjin-oss/SGP-ESE5004-Stage2/research/02_sector_coupling/buildings_heat/HEAT_ASSUMPTION_REGISTER.csv

Parameter | Value | Unit | Config_Key | Source | Source_Region | ASEAN_Specific | Used_In_Frozen_SHA | Status | Reason | Source_Classification | Audit_Judgment | Reference_Year | Transformation | Human_Acceptance | Evidence_Layer | Frozen_SHA
Demand base year | 2019 | year | demand_data.base_year | config.default.yaml; scripts/build_base_energy_totals.py | Global with ASEAN records | Country rows, not heat end-use validation | YES | UNVERIFIED | Raw balance year differs from file export date | RECOVERED_SOURCE | SOURCE_RECOVERED | 2019 | As stored; not changed | PENDING | F/U; T/P applicability explained in reports | a3616a68ee44592af6527ca9024a90f1956646ae
Space heating share | 0.6 | fraction | sector.space_heat_share | config.default.yaml:849; history/SPLIT_ORIGINAL_COMMIT.txt | Earth-Sec default | NO | YES: preparation/pre-final-pruning; final heat removed | UNVERIFIED | Common for R/S and all countries; underlying statistical justification not recovered | DEFAULT_WITHOUT_ASEAN_EVIDENCE | REJECT_DEFAULT | UNSPECIFIED | As stored; not changed | PENDING | F/U; T/P applicability explained in reports | a3616a68ee44592af6527ca9024a90f1956646ae
Coal shift to electricity | true | boolean | sector.coal.shift_to_elec | config.default.yaml:807; scripts/build_base_energy_totals.py | Earth-Sec default | NO | YES: both R/S electricity totals | UNVERIFIED | Coal energy added 1:1; if false coal ignored | DEFAULT_WITHOUT_ASEAN_EVIDENCE | REJECT_DEFAULT | UNSPECIFIED | Coal final TWh added to electricity TWh | PENDING | F/U; T/P applicability explained in reports | a3616a68ee44592af6527ca9024a90f1956646ae
Heat oil conversion to electricity | 0.9 | energy ratio, basis unresolved | sector.efficiency_heat_oil_to_elec | config.default.yaml; scripts/prepare_energy_totals.py | Earth-Sec default | NO | YES: preparation/pre-final-pruning; final heat removed | UNVERIFIED | Applied only to shifted heat part; not heat-pump COP | DEFAULT_WITHOUT_ASEAN_EVIDENCE | SCIENTIFIC_DECISION_REQUIRED | UNSPECIFIED | As stored; not changed | PENDING | F/U; T/P applicability explained in reports | a3616a68ee44592af6527ca9024a90f1956646ae
Heat biomass conversion to electricity | 0.9 | energy ratio, basis unresolved | sector.efficiency_heat_biomass_to_elec | config.default.yaml; scripts/prepare_energy_totals.py | Earth-Sec default | NO | YES: preparation/pre-final-pruning; final heat removed | UNVERIFIED | Applied only to shifted heat part; not heat-pump COP | DEFAULT_WITHOUT_ASEAN_EVIDENCE | SCIENTIFIC_DECISION_REQUIRED | UNSPECIFIED | As stored; not changed | PENDING | F/U; T/P applicability explained in reports | a3616a68ee44592af6527ca9024a90f1956646ae
Heat gas conversion to electricity | 0.9 | energy ratio, basis unresolved | sector.efficiency_heat_gas_to_elec | config.default.yaml; scripts/prepare_energy_totals.py | Earth-Sec default | NO | YES: preparation/pre-final-pruning; final heat removed | UNVERIFIED | Applied only to shifted heat part; not heat-pump COP | DEFAULT_WITHOUT_ASEAN_EVIDENCE | SCIENTIFIC_DECISION_REQUIRED | UNSPECIFIED | As stored; not changed | PENDING | F/U; T/P applicability explained in reports | a3616a68ee44592af6527ca9024a90f1956646ae
fuel_shares: oil residential heat share | 0.6667 | fraction | data/demand/fuel_shares.csv:DEFAULT:oil residential heat share | data/demand/fuel_shares.csv | Default; no established geographic calibration | NO | YES: preparation/pre-final-pruning; final heat removed | UNVERIFIED | No ASEAN row: each configured country inherits DEFAULT | DEFAULT_WITHOUT_ASEAN_EVIDENCE | REJECT_DEFAULT | UNSPECIFIED | Fallback DEFAULT then used in formulas | PENDING | F/U; T/P applicability explained in reports | a3616a68ee44592af6527ca9024a90f1956646ae
fuel_shares: biomass residential heat share | 0.75 | fraction | data/demand/fuel_shares.csv:DEFAULT:biomass residential heat share | data/demand/fuel_shares.csv | Default; no established geographic calibration | NO | YES: preparation/pre-final-pruning; final heat removed | UNVERIFIED | No ASEAN row: each configured country inherits DEFAULT | DEFAULT_WITHOUT_ASEAN_EVIDENCE | REJECT_DEFAULT | UNSPECIFIED | Fallback DEFAULT then used in formulas | PENDING | F/U; T/P applicability explained in reports | a3616a68ee44592af6527ca9024a90f1956646ae
fuel_shares: biomass to elec heat share | 0.0 | fraction | data/demand/fuel_shares.csv:DEFAULT:biomass to elec heat share | data/demand/fuel_shares.csv | Default; no established geographic calibration | NO | YES: preparation/pre-final-pruning; final heat removed | UNVERIFIED | No ASEAN row: each configured country inherits DEFAULT | DEFAULT_WITHOUT_ASEAN_EVIDENCE | REJECT_DEFAULT | UNSPECIFIED | Fallback DEFAULT then used in formulas | PENDING | F/U; T/P applicability explained in reports | a3616a68ee44592af6527ca9024a90f1956646ae
fuel_shares: oil to elec heat share | 0.5 | fraction | data/demand/fuel_shares.csv:DEFAULT:oil to elec heat share | data/demand/fuel_shares.csv | Default; no established geographic calibration | NO | YES: preparation/pre-final-pruning; final heat removed | UNVERIFIED | No ASEAN row: each configured country inherits DEFAULT | DEFAULT_WITHOUT_ASEAN_EVIDENCE | REJECT_DEFAULT | UNSPECIFIED | Fallback DEFAULT then used in formulas | PENDING | F/U; T/P applicability explained in reports | a3616a68ee44592af6527ca9024a90f1956646ae
fuel_shares: biomass to elec share | 0.0 | fraction | data/demand/fuel_shares.csv:DEFAULT:biomass to elec share | data/demand/fuel_shares.csv | Default; no established geographic calibration | NO | YES: preparation/pre-final-pruning; final heat removed | UNVERIFIED | No ASEAN row: each configured country inherits DEFAULT | DEFAULT_WITHOUT_ASEAN_EVIDENCE | REJECT_DEFAULT | UNSPECIFIED | Fallback DEFAULT then used in formulas | PENDING | F/U; T/P applicability explained in reports | a3616a68ee44592af6527ca9024a90f1956646ae
fuel_shares: oil to elec share | 0.5 | fraction | data/demand/fuel_shares.csv:DEFAULT:oil to elec share | data/demand/fuel_shares.csv | Default; no established geographic calibration | NO | YES: preparation/pre-final-pruning; final heat removed | UNVERIFIED | No ASEAN row: each configured country inherits DEFAULT | DEFAULT_WITHOUT_ASEAN_EVIDENCE | REJECT_DEFAULT | UNSPECIFIED | Fallback DEFAULT then used in formulas | PENDING | F/U; T/P applicability explained in reports | a3616a68ee44592af6527ca9024a90f1956646ae
fuel_shares: space to water heat share | 0.6 | fraction | data/demand/fuel_shares.csv:DEFAULT:space to water heat share | data/demand/fuel_shares.csv | Default; no established geographic calibration | NO | YES: preparation/pre-final-pruning; final heat removed | UNVERIFIED | No ASEAN row: each configured country inherits DEFAULT | DEFAULT_WITHOUT_ASEAN_EVIDENCE | REJECT_DEFAULT | UNSPECIFIED | Fallback DEFAULT then used in formulas | PENDING | F/U; T/P applicability explained in reports | a3616a68ee44592af6527ca9024a90f1956646ae
fuel_shares: gas to elec share | 0 | fraction | data/demand/fuel_shares.csv:DEFAULT:gas to elec share | data/demand/fuel_shares.csv | Default; no established geographic calibration | NO | YES: preparation/pre-final-pruning; final heat removed | UNVERIFIED | No ASEAN row: each configured country inherits DEFAULT | DEFAULT_WITHOUT_ASEAN_EVIDENCE | REJECT_DEFAULT | UNSPECIFIED | Fallback DEFAULT then used in formulas | PENDING | F/U; T/P applicability explained in reports | a3616a68ee44592af6527ca9024a90f1956646ae
fuel_shares: gas to elec heat share | 0 | fraction | data/demand/fuel_shares.csv:DEFAULT:gas to elec heat share | data/demand/fuel_shares.csv | Default; no established geographic calibration | NO | YES: preparation/pre-final-pruning; final heat removed | UNVERIFIED | No ASEAN row: each configured country inherits DEFAULT | DEFAULT_WITHOUT_ASEAN_EVIDENCE | REJECT_DEFAULT | UNSPECIFIED | Fallback DEFAULT then used in formulas | PENDING | F/U; T/P applicability explained in reports | a3616a68ee44592af6527ca9024a90f1956646ae
fuel_shares: gas residential heat share | 0.75 | fraction | data/demand/fuel_shares.csv:DEFAULT:gas residential heat share | data/demand/fuel_shares.csv | Default; no established geographic calibration | NO | YES: preparation/pre-final-pruning; final heat removed | UNVERIFIED | No ASEAN row: each configured country inherits DEFAULT | DEFAULT_WITHOUT_ASEAN_EVIDENCE | REJECT_DEFAULT | UNSPECIFIED | Fallback DEFAULT then used in formulas | PENDING | F/U; T/P applicability explained in reports | a3616a68ee44592af6527ca9024a90f1956646ae
growth_factors_cagr: total residential space | 0.02156 | fraction/year | data/demand/growth_factors_cagr.csv:DEFAULT:total residential space | data/demand/growth_factors_cagr.csv | Default; no established geographic calibration | NO | YES: preparation/pre-final-pruning; final heat removed | UNVERIFIED | No ASEAN row: each configured country inherits DEFAULT | DEFAULT_WITHOUT_ASEAN_EVIDENCE | REJECT_DEFAULT | UNSPECIFIED | (1+x)^(planning_year-2019) | PENDING | F/U; T/P applicability explained in reports | a3616a68ee44592af6527ca9024a90f1956646ae
growth_factors_cagr: total residential water | 0.0250 | fraction/year | data/demand/growth_factors_cagr.csv:DEFAULT:total residential water | data/demand/growth_factors_cagr.csv | Default; no established geographic calibration | NO | YES: preparation/pre-final-pruning; final heat removed | UNVERIFIED | No ASEAN row: each configured country inherits DEFAULT | DEFAULT_WITHOUT_ASEAN_EVIDENCE | REJECT_DEFAULT | UNSPECIFIED | (1+x)^(planning_year-2019) | PENDING | F/U; T/P applicability explained in reports | a3616a68ee44592af6527ca9024a90f1956646ae
growth_factors_cagr: electricity residential | 0.05568 | fraction/year | data/demand/growth_factors_cagr.csv:DEFAULT:electricity residential | data/demand/growth_factors_cagr.csv | Default; no established geographic calibration | NO | YES: preparation/pre-final-pruning; final heat removed | UNVERIFIED | No ASEAN row: each configured country inherits DEFAULT | DEFAULT_WITHOUT_ASEAN_EVIDENCE | REJECT_DEFAULT | UNSPECIFIED | (1+x)^(planning_year-2019) | PENDING | F/U; T/P applicability explained in reports | a3616a68ee44592af6527ca9024a90f1956646ae
growth_factors_cagr: total services space | 0.01786 | fraction/year | data/demand/growth_factors_cagr.csv:DEFAULT:total services space | data/demand/growth_factors_cagr.csv | Default; no established geographic calibration | NO | YES: preparation/pre-final-pruning; final heat removed | UNVERIFIED | No ASEAN row: each configured country inherits DEFAULT | DEFAULT_WITHOUT_ASEAN_EVIDENCE | REJECT_DEFAULT | UNSPECIFIED | (1+x)^(planning_year-2019) | PENDING | F/U; T/P applicability explained in reports | a3616a68ee44592af6527ca9024a90f1956646ae
growth_factors_cagr: total services water | 0.02156 | fraction/year | data/demand/growth_factors_cagr.csv:DEFAULT:total services water | data/demand/growth_factors_cagr.csv | Default; no established geographic calibration | NO | YES: preparation/pre-final-pruning; final heat removed | UNVERIFIED | No ASEAN row: each configured country inherits DEFAULT | DEFAULT_WITHOUT_ASEAN_EVIDENCE | REJECT_DEFAULT | UNSPECIFIED | (1+x)^(planning_year-2019) | PENDING | F/U; T/P applicability explained in reports | a3616a68ee44592af6527ca9024a90f1956646ae
growth_factors_cagr: services electricity | 0.03715 | fraction/year | data/demand/growth_factors_cagr.csv:DEFAULT:services electricity | data/demand/growth_factors_cagr.csv | Default; no established geographic calibration | NO | YES: preparation/pre-final-pruning; final heat removed | UNVERIFIED | No ASEAN row: each configured country inherits DEFAULT | DEFAULT_WITHOUT_ASEAN_EVIDENCE | REJECT_DEFAULT | UNSPECIFIED | (1+x)^(planning_year-2019) | PENDING | F/U; T/P applicability explained in reports | a3616a68ee44592af6527ca9024a90f1956646ae
growth_factors_cagr: residential oil | 0.0 | fraction/year | data/demand/growth_factors_cagr.csv:DEFAULT:residential oil | data/demand/growth_factors_cagr.csv | Default; no established geographic calibration | NO | YES: preparation/pre-final-pruning; final heat removed | UNVERIFIED | No ASEAN row: each configured country inherits DEFAULT | DEFAULT_WITHOUT_ASEAN_EVIDENCE | REJECT_DEFAULT | UNSPECIFIED | (1+x)^(planning_year-2019) | PENDING | F/U; T/P applicability explained in reports | a3616a68ee44592af6527ca9024a90f1956646ae
growth_factors_cagr: residential biomass | 0.0 | fraction/year | data/demand/growth_factors_cagr.csv:DEFAULT:residential biomass | data/demand/growth_factors_cagr.csv | Default; no established geographic calibration | NO | YES: preparation/pre-final-pruning; final heat removed | UNVERIFIED | No ASEAN row: each configured country inherits DEFAULT | DEFAULT_WITHOUT_ASEAN_EVIDENCE | REJECT_DEFAULT | UNSPECIFIED | (1+x)^(planning_year-2019) | PENDING | F/U; T/P applicability explained in reports | a3616a68ee44592af6527ca9024a90f1956646ae
growth_factors_cagr: residential gas | 0.01095 | fraction/year | data/demand/growth_factors_cagr.csv:DEFAULT:residential gas | data/demand/growth_factors_cagr.csv | Default; no established geographic calibration | NO | YES: preparation/pre-final-pruning; final heat removed | UNVERIFIED | No ASEAN row: each configured country inherits DEFAULT | DEFAULT_WITHOUT_ASEAN_EVIDENCE | REJECT_DEFAULT | UNSPECIFIED | (1+x)^(planning_year-2019) | PENDING | F/U; T/P applicability explained in reports | a3616a68ee44592af6527ca9024a90f1956646ae
growth_factors_cagr: services oil | -0.03582 | fraction/year | data/demand/growth_factors_cagr.csv:DEFAULT:services oil | data/demand/growth_factors_cagr.csv | Default; no established geographic calibration | NO | YES: preparation/pre-final-pruning; final heat removed | UNVERIFIED | No ASEAN row: each configured country inherits DEFAULT | DEFAULT_WITHOUT_ASEAN_EVIDENCE | REJECT_DEFAULT | UNSPECIFIED | (1+x)^(planning_year-2019) | PENDING | F/U; T/P applicability explained in reports | a3616a68ee44592af6527ca9024a90f1956646ae
growth_factors_cagr: services biomass | 0.0 | fraction/year | data/demand/growth_factors_cagr.csv:DEFAULT:services biomass | data/demand/growth_factors_cagr.csv | Default; no established geographic calibration | NO | YES: preparation/pre-final-pruning; final heat removed | UNVERIFIED | No ASEAN row: each configured country inherits DEFAULT | DEFAULT_WITHOUT_ASEAN_EVIDENCE | REJECT_DEFAULT | UNSPECIFIED | (1+x)^(planning_year-2019) | PENDING | F/U; T/P applicability explained in reports | a3616a68ee44592af6527ca9024a90f1956646ae
growth_factors_cagr: services gas | -0.006114 | fraction/year | data/demand/growth_factors_cagr.csv:DEFAULT:services gas | data/demand/growth_factors_cagr.csv | Default; no established geographic calibration | NO | YES: preparation/pre-final-pruning; final heat removed | UNVERIFIED | No ASEAN row: each configured country inherits DEFAULT | DEFAULT_WITHOUT_ASEAN_EVIDENCE | REJECT_DEFAULT | UNSPECIFIED | (1+x)^(planning_year-2019) | PENDING | F/U; T/P applicability explained in reports | a3616a68ee44592af6527ca9024a90f1956646ae
growth_factors_cagr: residential heat oil | 0.0 | fraction/year | data/demand/growth_factors_cagr.csv:DEFAULT:residential heat oil | data/demand/growth_factors_cagr.csv | Default; no established geographic calibration | NO | YES: preparation/pre-final-pruning; final heat removed | UNVERIFIED | No ASEAN row: each configured country inherits DEFAULT | DEFAULT_WITHOUT_ASEAN_EVIDENCE | REJECT_DEFAULT | UNSPECIFIED | (1+x)^(planning_year-2019) | PENDING | F/U; T/P applicability explained in reports | a3616a68ee44592af6527ca9024a90f1956646ae
growth_factors_cagr: residential heat biomass | 0.0 | fraction/year | data/demand/growth_factors_cagr.csv:DEFAULT:residential heat biomass | data/demand/growth_factors_cagr.csv | Default; no established geographic calibration | NO | YES: preparation/pre-final-pruning; final heat removed | UNVERIFIED | No ASEAN row: each configured country inherits DEFAULT | DEFAULT_WITHOUT_ASEAN_EVIDENCE | REJECT_DEFAULT | UNSPECIFIED | (1+x)^(planning_year-2019) | PENDING | F/U; T/P applicability explained in reports | a3616a68ee44592af6527ca9024a90f1956646ae
growth_factors_cagr: residential heat gas | 0.0 | fraction/year | data/demand/growth_factors_cagr.csv:DEFAULT:residential heat gas | data/demand/growth_factors_cagr.csv | Default; no established geographic calibration | NO | YES: preparation/pre-final-pruning; final heat removed | UNVERIFIED | No ASEAN row: each configured country inherits DEFAULT | DEFAULT_WITHOUT_ASEAN_EVIDENCE | REJECT_DEFAULT | UNSPECIFIED | (1+x)^(planning_year-2019) | PENDING | F/U; T/P applicability explained in reports | a3616a68ee44592af6527ca9024a90f1956646ae
efficiency_gains_cagr: total residential space | -0.004951 | fraction/year | data/demand/efficiency_gains_cagr.csv:DEFAULT:total residential space | data/demand/efficiency_gains_cagr.csv | Default; no established geographic calibration | NO | YES: preparation/pre-final-pruning; final heat removed | UNVERIFIED | No ASEAN row: each configured country inherits DEFAULT | DEFAULT_WITHOUT_ASEAN_EVIDENCE | REJECT_DEFAULT | UNSPECIFIED | (1+x)^(planning_year-2019) | PENDING | F/U; T/P applicability explained in reports | a3616a68ee44592af6527ca9024a90f1956646ae
efficiency_gains_cagr: total residential water | -0.01039 | fraction/year | data/demand/efficiency_gains_cagr.csv:DEFAULT:total residential water | data/demand/efficiency_gains_cagr.csv | Default; no established geographic calibration | NO | YES: preparation/pre-final-pruning; final heat removed | UNVERIFIED | No ASEAN row: each configured country inherits DEFAULT | DEFAULT_WITHOUT_ASEAN_EVIDENCE | REJECT_DEFAULT | UNSPECIFIED | (1+x)^(planning_year-2019) | PENDING | F/U; T/P applicability explained in reports | a3616a68ee44592af6527ca9024a90f1956646ae
efficiency_gains_cagr: electricity residential | -0.002696 | fraction/year | data/demand/efficiency_gains_cagr.csv:DEFAULT:electricity residential | data/demand/efficiency_gains_cagr.csv | Default; no established geographic calibration | NO | YES: preparation/pre-final-pruning; final heat removed | UNVERIFIED | No ASEAN row: each configured country inherits DEFAULT | DEFAULT_WITHOUT_ASEAN_EVIDENCE | REJECT_DEFAULT | UNSPECIFIED | (1+x)^(planning_year-2019) | PENDING | F/U; T/P applicability explained in reports | a3616a68ee44592af6527ca9024a90f1956646ae
efficiency_gains_cagr: total services space | -0.006705 | fraction/year | data/demand/efficiency_gains_cagr.csv:DEFAULT:total services space | data/demand/efficiency_gains_cagr.csv | Default; no established geographic calibration | NO | YES: preparation/pre-final-pruning; final heat removed | UNVERIFIED | No ASEAN row: each configured country inherits DEFAULT | DEFAULT_WITHOUT_ASEAN_EVIDENCE | REJECT_DEFAULT | UNSPECIFIED | (1+x)^(planning_year-2019) | PENDING | F/U; T/P applicability explained in reports | a3616a68ee44592af6527ca9024a90f1956646ae
efficiency_gains_cagr: total services water | -0.01786 | fraction/year | data/demand/efficiency_gains_cagr.csv:DEFAULT:total services water | data/demand/efficiency_gains_cagr.csv | Default; no established geographic calibration | NO | YES: preparation/pre-final-pruning; final heat removed | UNVERIFIED | No ASEAN row: each configured country inherits DEFAULT | DEFAULT_WITHOUT_ASEAN_EVIDENCE | REJECT_DEFAULT | UNSPECIFIED | (1+x)^(planning_year-2019) | PENDING | F/U; T/P applicability explained in reports | a3616a68ee44592af6527ca9024a90f1956646ae
efficiency_gains_cagr: services electricity | -0.002696 | fraction/year | data/demand/efficiency_gains_cagr.csv:DEFAULT:services electricity | data/demand/efficiency_gains_cagr.csv | Default; no established geographic calibration | NO | YES: preparation/pre-final-pruning; final heat removed | UNVERIFIED | No ASEAN row: each configured country inherits DEFAULT | DEFAULT_WITHOUT_ASEAN_EVIDENCE | REJECT_DEFAULT | UNSPECIFIED | (1+x)^(planning_year-2019) | PENDING | F/U; T/P applicability explained in reports | a3616a68ee44592af6527ca9024a90f1956646ae
efficiency_gains_cagr: residential oil | 0.0 | fraction/year | data/demand/efficiency_gains_cagr.csv:DEFAULT:residential oil | data/demand/efficiency_gains_cagr.csv | Default; no established geographic calibration | NO | YES: preparation/pre-final-pruning; final heat removed | UNVERIFIED | No ASEAN row: each configured country inherits DEFAULT | DEFAULT_WITHOUT_ASEAN_EVIDENCE | REJECT_DEFAULT | UNSPECIFIED | (1+x)^(planning_year-2019) | PENDING | F/U; T/P applicability explained in reports | a3616a68ee44592af6527ca9024a90f1956646ae
efficiency_gains_cagr: residential biomass | -0.004951 | fraction/year | data/demand/efficiency_gains_cagr.csv:DEFAULT:residential biomass | data/demand/efficiency_gains_cagr.csv | Default; no established geographic calibration | NO | YES: preparation/pre-final-pruning; final heat removed | UNVERIFIED | No ASEAN row: each configured country inherits DEFAULT | DEFAULT_WITHOUT_ASEAN_EVIDENCE | REJECT_DEFAULT | UNSPECIFIED | (1+x)^(planning_year-2019) | PENDING | F/U; T/P applicability explained in reports | a3616a68ee44592af6527ca9024a90f1956646ae
efficiency_gains_cagr: residential gas | -0.01039 | fraction/year | data/demand/efficiency_gains_cagr.csv:DEFAULT:residential gas | data/demand/efficiency_gains_cagr.csv | Default; no established geographic calibration | NO | YES: preparation/pre-final-pruning; final heat removed | UNVERIFIED | No ASEAN row: each configured country inherits DEFAULT | DEFAULT_WITHOUT_ASEAN_EVIDENCE | REJECT_DEFAULT | UNSPECIFIED | (1+x)^(planning_year-2019) | PENDING | F/U; T/P applicability explained in reports | a3616a68ee44592af6527ca9024a90f1956646ae
efficiency_gains_cagr: services oil | 0.0 | fraction/year | data/demand/efficiency_gains_cagr.csv:DEFAULT:services oil | data/demand/efficiency_gains_cagr.csv | Default; no established geographic calibration | NO | YES: preparation/pre-final-pruning; final heat removed | UNVERIFIED | No ASEAN row: each configured country inherits DEFAULT | DEFAULT_WITHOUT_ASEAN_EVIDENCE | REJECT_DEFAULT | UNSPECIFIED | (1+x)^(planning_year-2019) | PENDING | F/U; T/P applicability explained in reports | a3616a68ee44592af6527ca9024a90f1956646ae
efficiency_gains_cagr: services biomass | -0.005529 | fraction/year | data/demand/efficiency_gains_cagr.csv:DEFAULT:services biomass | data/demand/efficiency_gains_cagr.csv | Default; no established geographic calibration | NO | YES: preparation/pre-final-pruning; final heat removed | UNVERIFIED | No ASEAN row: each configured country inherits DEFAULT | DEFAULT_WITHOUT_ASEAN_EVIDENCE | REJECT_DEFAULT | UNSPECIFIED | (1+x)^(planning_year-2019) | PENDING | F/U; T/P applicability explained in reports | a3616a68ee44592af6527ca9024a90f1956646ae
efficiency_gains_cagr: services gas | 0.0 | fraction/year | data/demand/efficiency_gains_cagr.csv:DEFAULT:services gas | data/demand/efficiency_gains_cagr.csv | Default; no established geographic calibration | NO | YES: preparation/pre-final-pruning; final heat removed | UNVERIFIED | No ASEAN row: each configured country inherits DEFAULT | DEFAULT_WITHOUT_ASEAN_EVIDENCE | REJECT_DEFAULT | UNSPECIFIED | (1+x)^(planning_year-2019) | PENDING | F/U; T/P applicability explained in reports | a3616a68ee44592af6527ca9024a90f1956646ae
efficiency_gains_cagr: residential heat biomass | -0.002696 | fraction/year | data/demand/efficiency_gains_cagr.csv:DEFAULT:residential heat biomass | data/demand/efficiency_gains_cagr.csv | Default; no established geographic calibration | NO | YES: preparation/pre-final-pruning; final heat removed | UNVERIFIED | No ASEAN row: each configured country inherits DEFAULT | DEFAULT_WITHOUT_ASEAN_EVIDENCE | REJECT_DEFAULT | UNSPECIFIED | (1+x)^(planning_year-2019) | PENDING | F/U; T/P applicability explained in reports | a3616a68ee44592af6527ca9024a90f1956646ae
efficiency_gains_cagr: residential heat oil | -0.002696 | fraction/year | data/demand/efficiency_gains_cagr.csv:DEFAULT:residential heat oil | data/demand/efficiency_gains_cagr.csv | Default; no established geographic calibration | NO | YES: preparation/pre-final-pruning; final heat removed | UNVERIFIED | No ASEAN row: each configured country inherits DEFAULT | DEFAULT_WITHOUT_ASEAN_EVIDENCE | REJECT_DEFAULT | UNSPECIFIED | (1+x)^(planning_year-2019) | PENDING | F/U; T/P applicability explained in reports | a3616a68ee44592af6527ca9024a90f1956646ae
efficiency_gains_cagr: residential heat gas | 0.0 | fraction/year | data/demand/efficiency_gains_cagr.csv:DEFAULT:residential heat gas | data/demand/efficiency_gains_cagr.csv | Default; no established geographic calibration | NO | YES: preparation/pre-final-pruning; final heat removed | UNVERIFIED | No ASEAN row: each configured country inherits DEFAULT | DEFAULT_WITHOUT_ASEAN_EVIDENCE | REJECT_DEFAULT | UNSPECIFIED | (1+x)^(planning_year-2019) | PENDING | F/U; T/P applicability explained in reports | a3616a68ee44592af6527ca9024a90f1956646ae
district_heating: current | 0 | fraction | data/demand/district_heating.csv:DEFAULT:current | data/demand/district_heating.csv | Default; no established geographic calibration | NO | YES: preparation/pre-final-pruning; final heat removed | UNVERIFIED | No ASEAN row: each configured country inherits DEFAULT | DEFAULT_WITHOUT_ASEAN_EVIDENCE | REJECT_DEFAULT | UNSPECIFIED | Fallback DEFAULT then used in formulas | PENDING | F/U; T/P applicability explained in reports | a3616a68ee44592af6527ca9024a90f1956646ae
district_heating: potential | 0 | fraction | data/demand/district_heating.csv:DEFAULT:potential | data/demand/district_heating.csv | Default; no established geographic calibration | NO | NO: column not consumed by current heat pathway | UNVERIFIED | Do not confuse this unused column with sector.district_heating.potential | DEFAULT_WITHOUT_ASEAN_EVIDENCE | REJECT_DEFAULT | UNSPECIFIED | Fallback DEFAULT then used in formulas | PENDING | F/U; T/P applicability explained in reports | a3616a68ee44592af6527ca9024a90f1956646ae
District heating potential | 0.3 | fraction | sector.district_heating.potential | config.default.yaml:825-834; scripts/prepare_sector_network.py:2552-2735 | Inherited Earth-Sec/Earth | NO | YES: preparation/pre-final-pruning; final heat removed | UNVERIFIED | Fraction of urban heat allocated to central supply | DEFAULT_WITHOUT_ASEAN_EVIDENCE | REJECT_DEFAULT | UNSPECIFIED | As stored; not changed | PENDING | F/U; T/P applicability explained in reports | a3616a68ee44592af6527ca9024a90f1956646ae
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
