cyc292cycjin-oss/SGP-ESE5004-Stage2/research/04_model_assembly/gate4/evidence/previews/PHASE4_NETWORK_COMPONENT_INVENTORY.csv.png

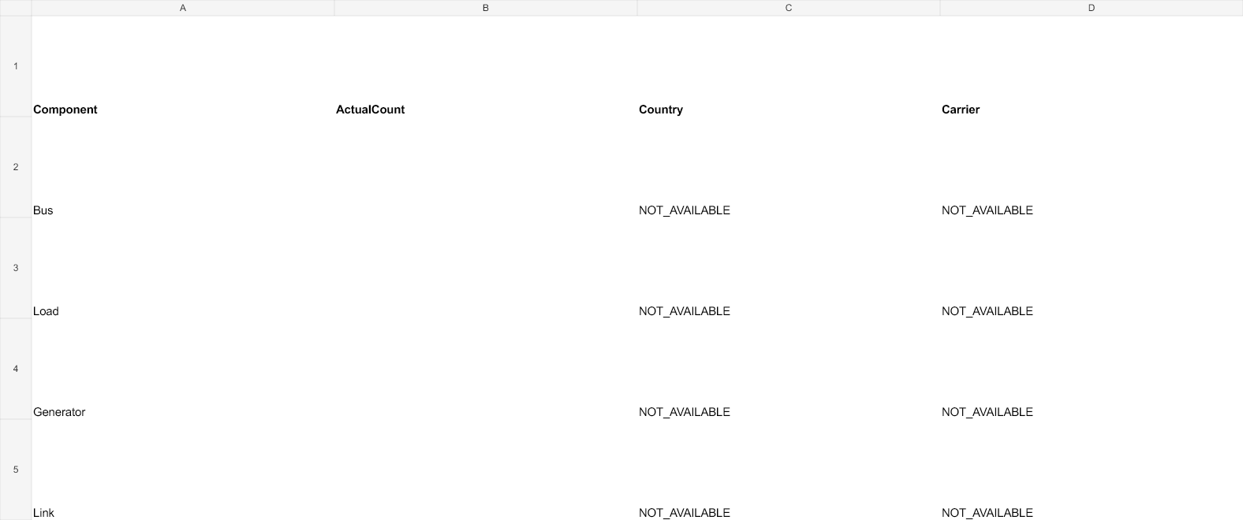
research/04_model_assembly/gate4/evidence/previews/PHASE4_NETWORK_COMPONENT_INVENTORY.csv.png
