cyc292cycjin-oss/SGP-ESE5004-Stage2/research_inputs/assembly_v1/README.md

# Assembly V1 Gate4 resume input freeze

`registry.json` is canonical and `manifest.json` pins all source capsules. Existing Gate2 source files and its historical contract remain unchanged. Road EV is an accepted Assembly V1 boundary, not a numeric zero or a standalone fixed Load. The approximate regional road parent is 350.5315 Mtoe; exclusive carrier closure remains separate.

The international bunker growth-method issue is CLOSED by `ASSEMBLY_V1_BUNKER_CONSTANT_2019`. Only verified base obligations become numeric accepted targets. Missing countries and omitted transactions remain PENDING. This is a material human baseline assumption requiring Phase5 sensitivity, not a forecast.

Numeric acceptance is distinct from node/time allocation and actual-network validation. Candidate fields never feed a network. AEO8 generation and upstream DEFAULT future growth are forbidden. No solver is enabled.
