cyc292cycjin-oss/SGP-ESE5004-Stage2/research/04_model_assembly/gate4/PHASE4_GATE4_READINESS.md

# Current Phase4 Gate4 readiness

**FULLSC_NETWORK_COMPLETE_UNSOLVED. Gate4 static validation=PASS. Solver runs=0. Gate5 has not been entered.**

Current state: `CURRENT_PHYSICAL_READINESS.json`, canonical final registry, `FINAL_ALLOCATION_MANIFEST.json`, and `FULLSC_ASSEMBLY_V1_NETWORK_MANIFEST.json`. Historical diagnostic files are not the baseline.

Complete network:171 accounts, 171arrays, 1737 Loads; 745 source records/187400.4 MW; 2920 snapshots/8760h. Actualexport/readback, A–Tchecks and 500coupling pathways passed. Electricitycontrols:192domestic, 24cross-border, 0unknown. No switching or solving.

Input coverage is complete within explicitly chosen V1 boundaries; 15 UN unreported records remainnull/nonposting, 410 inventoryuncertaintyrows remainoutsideinheritance, including 5hydrogroups/684 MW. Baselineblendmaximumoverlap andtheunusedno-overlapupperinput have distinct registries.

Supplemental PHindustryAnimal waste scope has now been explicitly authorized and passed actualstructure/readback. 807externalpendingfixed terms retain nullprices/factors. 1748 knownphysicalcarbon events and 200 nullpolicyweights remainseparate; policy OFF. Fullcost/emissionsreports are incomplete, even thoughphysicalassembly is complete.

ReadyforPhase4Gate5 reduced validation: YES, subject to a new instruction. Current network solver_allowed=false, scientific_results_allowed=false, gate5_allowed=false. No automatic run. See GATE4_FINAL_CLOSEOUT.md for all 19 requested statuses andlimits.
