cyc292cycjin-oss/SGP-ESE5004-Stage2/research/04_model_assembly/gate4/ASSET_NODE_MAPPING_PROVENANCE.md

# Accepted constrained mapping proxy; original author map still not claimed

GATE4-20261005-CONSOLIDATED-BASELINE-CHOICES#B applies ASSEMBLY_V1_CONSTRAINED_NODE_MAPPING_PROXY this round. The frozen raw→simplified map and50-cluster region/original-AC-partition labels constrain nearest existing100-node assignment. Country, region and original partition must agree; distance ties are stable.2,516 raw-bus proxies accepted,6 exceptions retained, all749 currently surviving units mapped.

Every distance and source footprint remains in the integration contract and evidence/ASSET_MAPPING_CANDIDATE.json. evidence/MAPPING_DISTANCE_CAPACITY.json adds a full observed-distance capacity-exceedance table for749 surviving units. Maximum distance is533.776470km;570MW lies at that maximum. No distance cutoff was introduced and no capacity was dropped for distance. This is spatial sensitivity evidence, not a new acceptance threshold.

The exact author's simplified→100-node mapping was not recovered; the tracked custom file was only a template. Raw765 has null first-leg cache mapping;843/2100/2101/844/964 have a MY versus TH2 label conflict and remain rejected. They do not involve the749 survivors. The approved765/766 topology fix and actual100-node/105-line topology are preserved.
