cyc292cycjin-oss/SGP-ESE5004-Stage2/research/04_model_assembly/gate4/PHASE4_ASSEMBLY_INPUT_FREEZE.md

# Gate4 Assembly V1 input freeze

Partial input freeze only.264 target ownership combinations remain visible:133 qualified numeric,75 nonphysical representations (71 bounded source zero proofs and4 pre-approved TL industry deferrals),56 unresolved.131 earlier target quantities and arrays are unchanged; two compatible MY road oil/biodiesel accounts have been added. All accepted arrays bind the latest registry SHA. No explicit EV or RoadReference Load exists.

Source/account/node/time annual conservation is evidenced in allocation_manifest.json. Updated BASE_RECONSTRUCTION.json retains original petroleum quantity and mass unit, compatible memo identity, fossil mass after subtraction, separately converted biofuel mass, original per-commodity factors and target method. Memo energy is not posted again. Liquid biofuel source identities remain explicit in the production fragment.

Rail and NEC source ownership is resolved independently of future demand projection; pending2050 accounts remain blocking and no missing record becomes zero. Source coverage exclusions are limited to traceable disjoint FEC exhaustions or already-approved Phase3 boundaries. New coverage exclusions require a human decision.

Single-year2050 stock boundary is human-approved, but no unverified source default lifetime is accepted by that approval. Carbon policy remains disabled. Development asset defaults/qualification gaps cannot cross the final model gate. Complete Research network status: FULLSC_NETWORK_NOT_COMPLETE.

## Current authorised activation

See DECISIONS_APPLIED_THIS_ROUND.md.152 target accounts and actual arrays/Loads now qualified; all original133 unchanged. Earlier pending lifetime/mapping/TH/rail-NEC statements are superseded by the current explicit decision, not retroactively changed. Full input freeze still blocked.
