cyc292cycjin-oss/SGP-ESE5004-Stage2/research/04_model_assembly/gate4/UPDATED_TARGET_AND_ALLOCATION_SUMMARY.md

# Updated target values, arrays and actual demand bindings

152 qualified target accounts and152 actual allocation arrays; all133 previously accepted quantities/arrays retain exact values, nodes, methods, dtype and bytes. The new allocation manifest is bound to the new registry SHA. 19 additional accounts consist of2 TH road carrier accounts,4 qualified rail country accounts and13 NEC country/use/carrier accounts from15 unique source rows.

TH's four affected commodity components total274632227.776MWh in2019. Their2050 projection is computed from those raw mass quantities, the frozen individual commodity factors and the exact ratio374.9/145.2:709088307.1158567493112947658MWh. This is the MO/DL/AL/BD bundle subtotal; TH LPG and gas obligations retain their separate existing source values. It is not the complete Thai transport forecast. ZG/ZD are memo only.

|Use|Qualified target accounts|Actual bound annual MWh|Still source-blocked|
|---|---:|---:|---|
|RailNonElectric|4|7,008,994.920000|PH:2050:Transport:RailNonElectric:biomass; PH:2050:Transport:RailNonElectric:oil|
|TransportNEC|4|3,649,541.200000|None|
|OtherNEC|9|18,026,615.817750|None|

All these qualified accounts are present in the actual carrier development.nc Loads after readback. Rail's five original positive parents are accounting records only; six mutually exclusive carrier children replace them, with PH oil and biodiesel still unposted. Rail electricity remains embedded in Astar. NEC retains its original use; no Road/Industry/Agriculture relabelling occurs. OtherNEC has its own Load sector label.

The TH overlay is local: the old complete FEC source scope still supplies the previously accepted bounded zero proofs for other uses. The new road vintage is never subtracted from or summed with an old-version FEC parent to manufacture a new zero/residual. Scope and original row IDs are explicitly retained. Remaining33 source-coverage combinations remain registered; retaining NEC energy does not prove a missing named sector is zero.

Current input gate counts:278 required physical-or-coverage rows,75 source-supported nonphysical rows,152 qualified physical accounts and51 unresolved physical-account rows. These counts reflect rail carrier splitting and NEC source-use representation, not deleted missing combinations. Known positive NEC target-method waiting items are now0. Source overlaps, coverage and supply qualification still prevent full freeze.

Fixed fuel flat-time/base-load-node proxies and port/airport weights remain modelling approximations. Successful binding does not establish observed hourly behaviour or source/cost completeness. No solver.
