cyc292cycjin-oss/SGP-ESE5004-Stage2/research/02_sector_coupling/buildings_heat/BUILDINGS_HEAT_DATA_GAPS.md

# Buildings + Heat：剩余缺口

版本见 [README](README.md)。仅列源码及既有数据不能关闭的事项；**不是要求用户重新收集全部数据**。缺口不授权本轮补数或修改。

## 已关闭，不再向用户索取

- UNSD 下载入口、2019筛选、11国原始建筑记录、单位换算函数、base表聚合：已恢复并精确核对。
- BDEW继承链、固定文件、weekday/weekend、热水平坦、ERA5/atlite组合：已恢复；曲线科学适用性另列。
- 0.6参数的引入提交与两个独立入口、DEFAULT fuel share表：已恢复。
- EC现有设备的欧洲来源、无ASEAN行、零默认、未接入baseyear：已恢复。
- DH三个config参数如何作用、CSV potential未消费、cooling组件不存在、居民重写所有heat、final服务carrier拼写问题：已从代码关闭。

## 1. 需要共同选择/验证的数据证据

| ID | 最少缺什么 | 为什么现有来源不能回答 | 下一责任与用户可提供的材料 |
|---|---|---|---|
| D1 | R/S分别的space heating、water heating、必要时cooking的年度**有用服务**及既有电热用电桥接，国家/年/单位/覆盖明晰 | UNSD是燃料/heat商品统计，默认用途份额不是ASEAN实测；服务燃料没有完整转服务链 | 后续先由代理做有边界的官方公开源搜索。若用户已有国家建筑能耗调查、热水/烹饪分项统计、导师指定数据表或授权数据库导出，提供原文件、sheet、版本即可；无需现在重新找齐11国 |
| D2 | 可用于ASEAN的时间分配依据，至少热水日型与有采暖需要地区的shape/temperature阈值 | 当前热水恒定、BDEW欧洲模板、HDD15°C暖区零shape，不能从源码推得地区适用性 | 后续代理先检索公开实测/官方模型。用户仅需提供已有未公开小时需求/建筑调查或明确指定的来源族，不要手造profile |
| D3 | 若研究既有建筑设备约束：ASEAN设备存量、技术/燃料/效率、年份/寿命/区域、输入或输出容量口径 | 欧洲2012 GW表与零DEFAULT不构成ASEAN存量证据；现有调用未接入 | 先决定brownfield是否属于建筑边界。纳入后才需要数据；公开统计由代理检索，用户若持有本地调查可提供 |
| D4 | 若允许集中供热：各地适用的现有份额、可接入需求/密度、损耗口径和成本证据 | 0.3/1/0.15未ASEAN化；零current不会阻止30%城市目标；CSV potential未使用 | 先共同决定服务区与DH菜单，再检索。没有证据不得把统一30%作为全ASEAN基线；无需用户证明每国绝对为零 |
| D5 | future direct electricity总量中包含多少原电热、制冷和新增电气化；与R/S分项同年同边界 | DemandCast/GEGIS、UNSD、final总电力调校属于不同表，代码不提供端用一致性桥接 | 代理负责重建可核查的总账；若所选权威表受许可限制，用户提供授权表及定义。独立cooling只在选择该边界时追加冷量/设备数据 |

各燃料质量→能量换算的HHV/LHV、含水率与country-specific因子，以及“0.9”的容量/能量口径，需要随D1统一确认。不要把原UNSD燃料数据全部废弃：可保留其来源族作为燃料平衡对照，但尚不能接受其默认转成完整供热服务的方式。

## 2. 工程问题：代理处理，不需要用户去找原始文件

| ID | 未修复问题 | 修复后必须证明的结果 |
|---|---|---|
| E1 | `add_residential`跨R/S/central覆盖所有heat | 每国R/S服务量分别守恒，DH损耗另账；不能用居民剩余量覆盖服务业 |
| E2 | 零HDD shape除零，`fillna(0)`静默丢量 | 正年度量无法映射时明确失败；科学上是否应有space heat由D1/D2决定，不由工程代码补值 |
| E3 | 不存在可靠existing electric heat扣减桥接；final aggregate重标定可破坏拆分 | direct残余与分项守恒、每次剥离可追溯，endogenous电力另外计 |
| E4 | `service electricity` / `services electricity`拼写与调校集合不一致；最终only-electric仍开启 | full-SC边界通过时服务与热组件保留、总量无重复；当前paper reference保持独立 |
| E5 | existing-heating未调用、urban_fraction字段错误、非零DEFAULT单位隐患 | 仅在决定纳入历史设备时修；不以空表0值冒充已建容量 |

工程修复需另轮独立fix commit；本轮没有实施。时间归一化、单一国时区与天气矩阵也应随E2做局部验证；不需要正式大模型。

## 3. 科学边界：需要决定，不是“缺一份CSV”

1. 延续用户已冻结的BH-1/BH-2：heat服务外生、技术内生、R/S分开。下一步需确定**cooking与其他非space/water燃料用途**归属，不能沿用默认“75% biomass=采暖”。
2. cooling暂嵌入固定直接电力，还是在以后单独建可替代冷服务；本轮不新增模块。若选前者，无需为本轮强求11国冷量小时数据，但需明确论文结论不包含制冷技术灵活性。
3. urban central共享热bus是否符合“模型层R/S分开”的原则：可以共享供给但保留两类需求账；目前合并负荷不能自动视为已满足。
4. 建筑设备采用greenfield竞争还是实际存量brownfield；这决定D3是否是正式baseline硬门槛。
5. DH技术是否纳入哪些地理服务区，loss到底以交付还是输入为分母；不根据欧洲配置自动接受/排除。

## 最小继续条件

可继续做**有条件的实验设计草案和局部守恒验收设计**。在以下五项未关闭前，不能冻结Buildings边界或启动正式Integrated/Disconnected：

1. R/S热服务和nonthermal/cooking口径、年度数量来源族；
2. 一个经共同接受、不会静默丢量的时间/空间分配方案；
3. 总电力—端用—转换耗电的扣减与守恒证据；
4. DH/存量/cooling边界决定及对应必要数据；
5. E1–E4的独立修复和小规模端到端构网检查。

真正需要用户直接提供的是：**已经持有且无法公开取得的上述原始资料、导师指定版本/授权来源，以及科学边界决定**。BDEW原始24×8生成环境若最终必须完全复刻，应优先由代理追原维护者历史；本轮不把它转成要求用户寻找的任务。未恢复并不允许自动选另一版本。
