cyc292cycjin-oss/SGP-ESE5004-Stage2/research/02_sector_coupling/buildings_heat/phase3a4/BUILDINGS_PHASE3A4_READINESS.md

# Phase 3A-4 readiness

Material Passport: academic-research-suite; inline engineering/accounting audit; Phase 3A-4 v1; 2026-10-01. VERIFIED applies only to stated code/test/hash observations; accounting methods are ANALYZED/proposed and scientific inputs remain PENDING.

**Engineering integration: PASS. E3 implementation: BLOCKED BY EVIDENCE. READY FOR FULL-SC ASSEMBLY: NO.**

| User question | Evidence-bounded answer |
|---|---|
| A. E1/E2/E4 integrated? | Yes, independent `codex/buildings-accounting-validation`, final `50a73d8f531132c5459174a55cac412d5f684462`; P/U/R/T unchanged. |
| B. Combined tests? | All1,062 strict checks pass; staged original validations pass; 18 separate synthetic accounting-contract checks pass. |
| C. Scientific demand changed? | No source demand/config/cost/carbon/spatial input edits; 19 retained inputs hash-identical. Corrected output construction and invalid-profile rejection do change erroneous runtime behavior. |
| D. Full E3 identity clear? | The proposed country/year/snapshot identities, component ownership and execution order are explicit. Numerical ASEAN closure is not established. |
| E. Historical electric heating identifiable? | Not yet for accepted11-country R/S scope; local older/sample candidates exist but do not supply a complete matched-year bridge. |
| F. Cooling retained and not duplicated? | Required by design; synthetic contract rejects deletion/double accounting. No cooling module added. Actual national cooling preservation/partition cannot yet be certified under unresolved E3. |
| G. Cooking nonexplicit without loss? | Nonexplicit by frozen scope; ledger method retains electric/fuel amounts and excludes them from H/I. Actual complete fuel/end-use partition still unverified; do not claim existing defaults already ensure this. |
| H. E3 patch data ready? | No. No E3 patch or FIX_E3_REPORT was generated. |
| I. Useful-heat method executable? | Algorithm, field dictionary and synthetic contract are ready for review. Actual final-energy→service generation remains blocked by missing/unaligned inputs; no final research inputs produced. |
| J. Fields missing Human Acceptance? | Source version/year/geography, meter/loss/sector mapping, fuel conversion/basis, end-use shares, historical D/E, device mix/performance, service boundary, year bridge, spatial/temporal weights and future direct/service growth; DH/stock for assembly. See requirements/schema. |
| K. READY FOR FULL-SC ASSEMBLY? | No. Engineering acceptance is not scientific data acceptance. |

## Minimum remaining five evidence/decision groups

1. **Matched electricity bridge:** A*↔R/S, source year, sector coverage and meter/loss definition; identified historical space/water electrical input with exactly-once lineage.
2. **Complete end-use/fuel mapping:** heating/cooking/cooling/other partitions, unclassified handling and relevant unit/HHV-LHV conflicts; no cooking disappearance or fuel-to-heat default split.
3. **Historical performance to useful service:** input-energy device mix, efficiency/COP and delivered-service boundary; future supply performance kept distinct.
4. **Country/region and snapshot construction:** accepted R/S allocation, water-use and real space-heat shapes, historical electric-input timing and nonnegative residual proof.
5. **Assembly boundary and application order:** future direct/service growth and calibration ownership; evidence-based DH/stock scope. After1–4 and the relevant boundary decisions, implement/test E3, then review assembly readiness again.

These groups combine missing data and research decisions; they do not require an impossible single unified11-country dataset. Existing sources should be reviewed before seeking narrowly missing files. Scientific input rows accepted in this phase: **0**. Formal model/solver runs: **0**. No next-sector work begins.

## Navigation

- [Integration report](BUILDINGS_FIX_INTEGRATION_REPORT.md) / [combined matrix](BUILDINGS_FIX_COMBINED_TEST_MATRIX.csv)
- [E3 specification](BUILDINGS_E3_ACCOUNTING_SPEC.md) / [data requirements](../../../../data_registry/buildings_phase3a4/BUILDINGS_E3_DATA_REQUIREMENTS.csv)
- [Useful-heat method](BUILDINGS_USEFUL_HEAT_METHOD.md) / [field dictionary](../../../../data_registry/buildings_phase3a4/BUILDINGS_USEFUL_HEAT_INPUT_SCHEMA.csv)
- [Electricity closure checks](BUILDINGS_ELECTRICITY_CLOSURE_TEST.md) / [data decision update](BUILDINGS_DATA_DECISION_UPDATE.md)
