cyc292cycjin-oss/SGP-ESE5004-Stage2/research/02_sector_coupling/buildings_phase3a3/evidence/SEARCH_LOG.md

# Bounded source search record — 2026-10-01

Scope: Buildings B1 annual end-use / B2 space-water split / B3 temporal basis only. Reused Phase3A2 cached sources first. No systematic-review completeness claim. Search snippets led to primary publisher, institutional repository or official documents; unverified commercial/repost results were not used to build inputs.

## Query groups used

- `ASEAN residential commercial water heating energy end use survey hourly hot water demand Malaysia Thailand`
- `site.eria.org residential commercial energy consumption survey water heating Lao PDR Myanmar Cambodia`
- `site.eria.org "end-use" "residential" "2011" survey`
- `site.st.gov.my "residential" "2016" "water heating"`
- `site.eceee.org "Southeast Asia" residential energy 2017 Belda`
- `Vietnam residential hot water demand profile measured hourly study`
- `site.eria.org "Pilot Survey" "Residential" "2011"`
- `site.st.gov.my "residential" "survey" "2016"`
- `"Vietnam’s Future Water Usage Model" publisher`
- `site.doe.gov.ph "2011" "Household Energy Consumption" water heating`
- `site.eria.org "commercial" "water heating" survey buildings`
- `"hot water" "Thailand" "hotel" "hourly" demand study`
- `"Vietnam" "space heating" residential "survey" energy`
- `"Thailand" "hot water demand" "profile" hotel study`
- `"Timor-Leste" "household" "water heating" energy survey`
- `site.st.gov.my "National Energy Balance 2016" pdf`
- `"doe_compendium_energy_statistics-1990-2021.pdf"`
- `"Tuy Hoa" "electrical appliance use" DOI`

## Resolved primary endpoints

Exact requested/resolved URLs and attempts are in [RETRIEVAL_MANIFEST.json](../data/raw/buildings/RETRIEVAL_MANIFEST.json). The Malaysia old download URL returned404; official publication page and indexed migrated official URL recovered the same named2016edition, whose retrieved bytes now have their own hash. This is source recovery, not a model input update.

Philippines legacy URL could be inspected through the search index but failed local DNS; current official URL returned HTML instead of PDF. Its successful HTTP response is not recorded as a successful source PDF. TuyHoa institutional PDF returned403; only publisher/university abstract information was used. No access-control workaround or fabricated local original.

Secondary/repost results (Scribd, ResearchGate, commercial market pages) were discovery leads only; BELDA author-associated PDF, SCIRP publisher full text, Elsevier/university metadata, DOE/ST/ERIA/ACE were the evidence endpoints. Thai hotel promotional profiles were not accepted. No new general-purpose harmonized dataset was obtained within this bounded search.
