cyc292cycjin-oss/SGP-ESE5004-Stage2/research_inputs/assembly_v1/sources/methodology/UNSD_BIOFUEL_COMMODITY_BALANCE.pdf

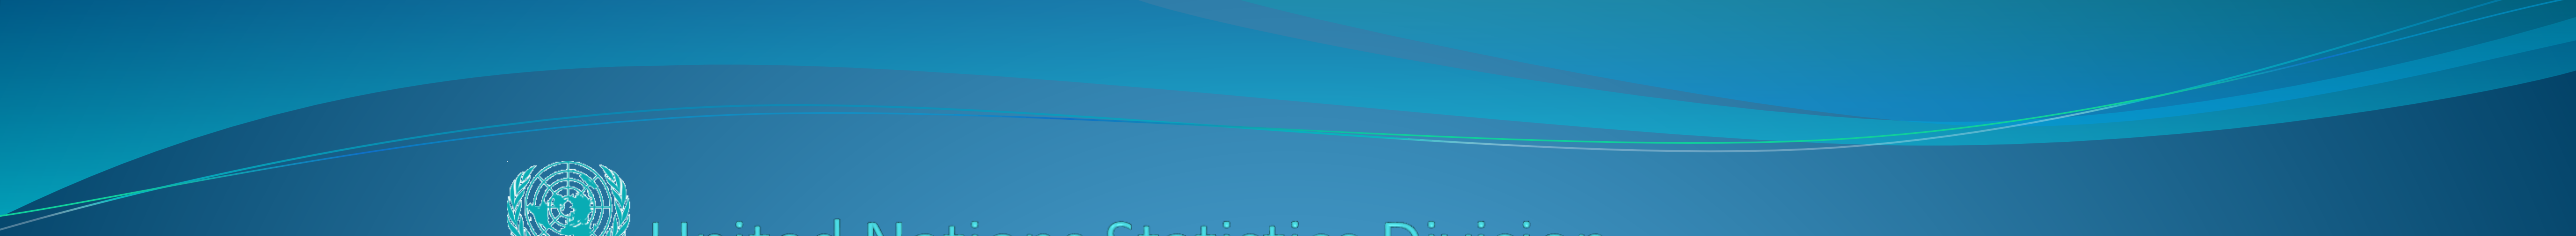
[picture p10: figure]
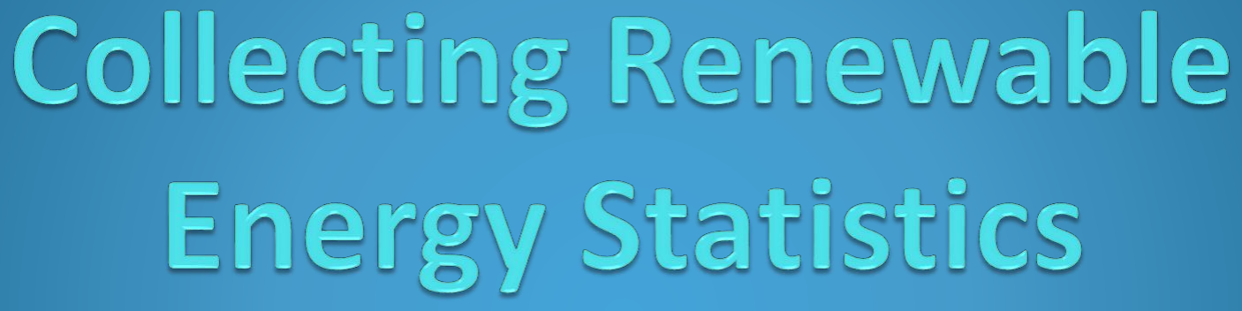
[picture p11: figure]

Workshop on Energy Statistics for ASEAN Countries

21-23 November 2017
Kuala Lumpur, Malaysia

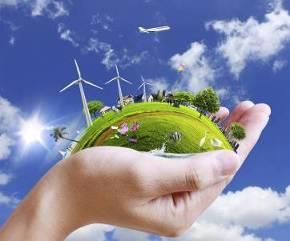
[picture p12: figure]

http://unstats.un.org/unsd/energy

## Leonardo Rocha Souza

# Overview

- Importance of renewables
- International Methodology
- Types of renewables:
- Combustible fuels
- Sources of electricity and heat
- UNSD Data Sources
- Data Collection Issues

# 2015 World Energy Supply

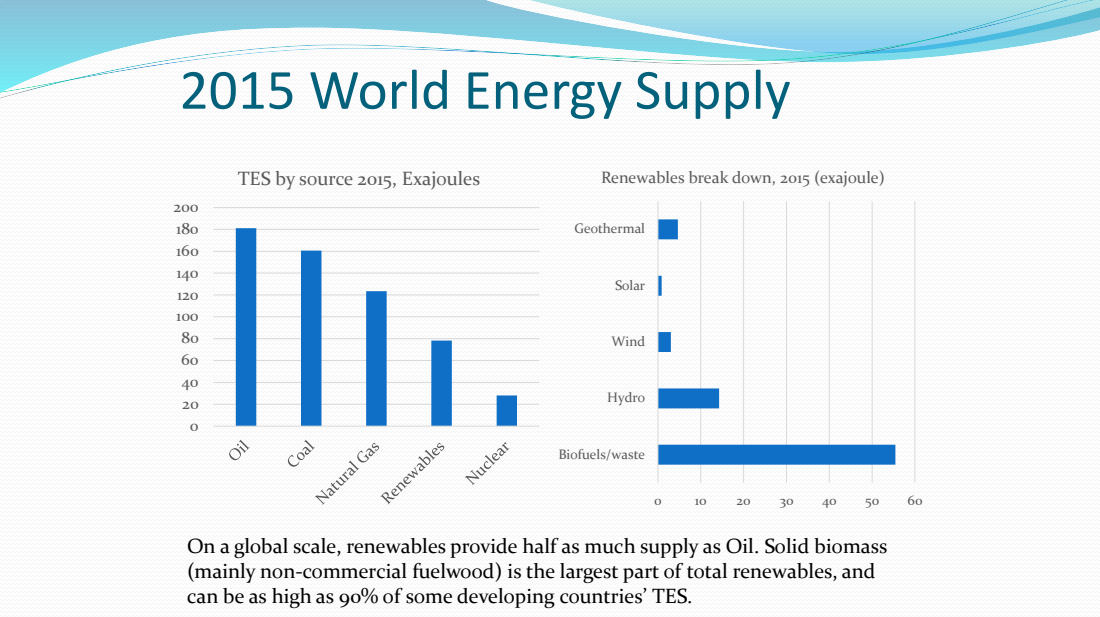
[picture p13: page 3]
Biofuels/waste; Hydro; Wind; Solar; Geothermal

TES by source 2015, Exajoules

Renewables break down, 2015 (exajoule)

On a global scale, renewables provide half as much supply as Oil. Solid biomass
(mainly non-commercial fuelwood) is the largest part of total renewables, and
can be as high as 90% of some developing countries’ TES.

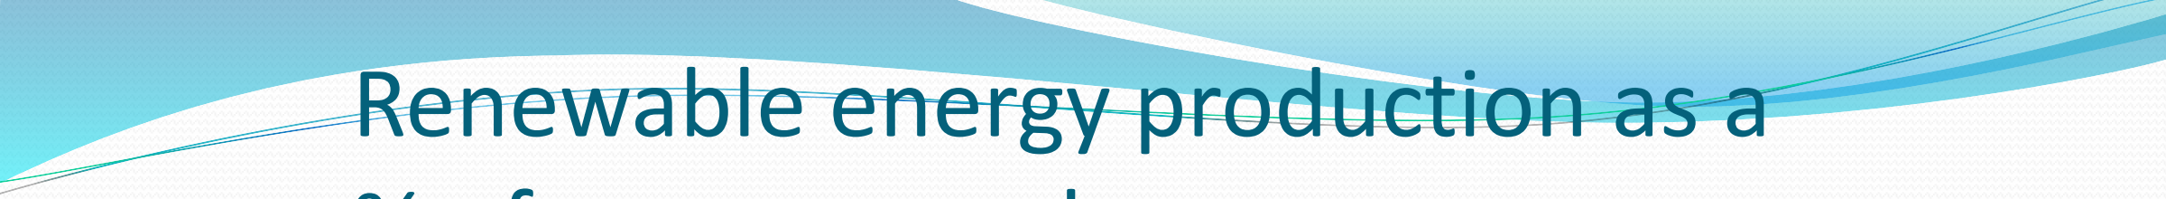
[picture p14: figure]
Renewable energy production as a

## % of energy supply – selected countries

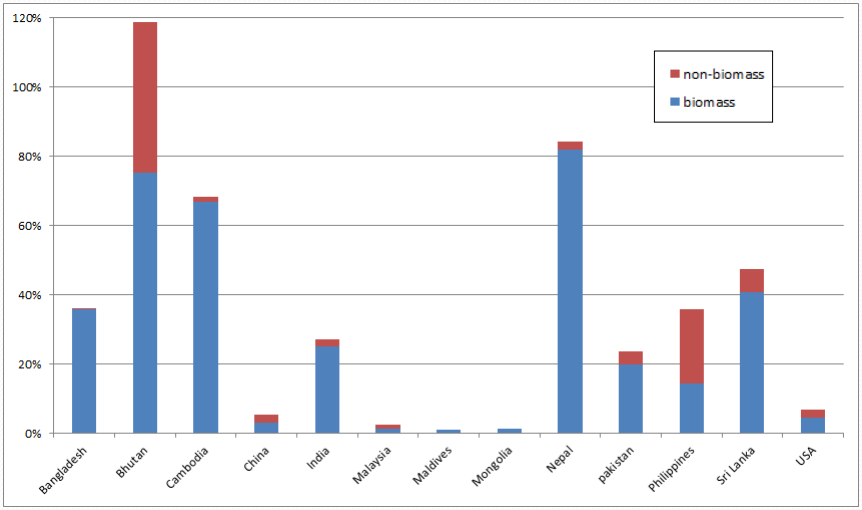
[picture p15: figure]

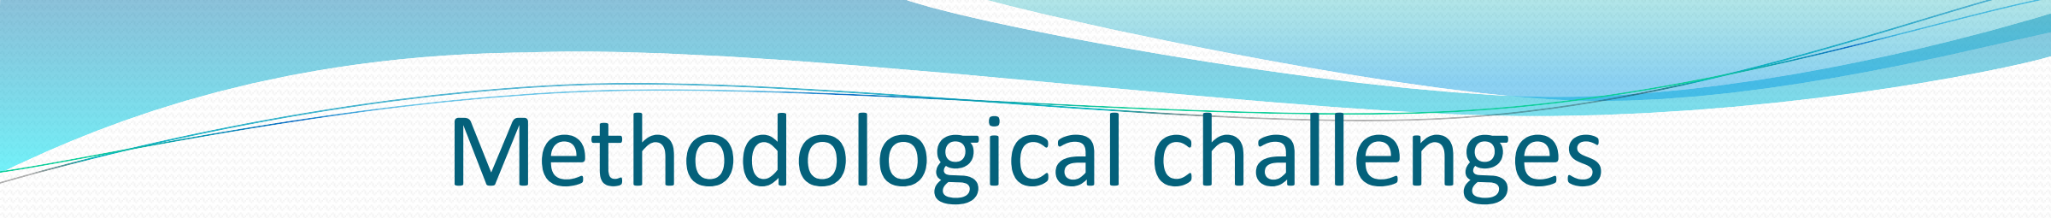
[picture p16: figure]
Methodological challenges

- There are various definitional and methodological challenges in measuring renewable energy. Ex:
- Defining renewable energy, taking into account sustainability considerations
- Data availability, collection, and management issues
- Determining what convention to use for measuring the share of renewables in the global energy mix

5

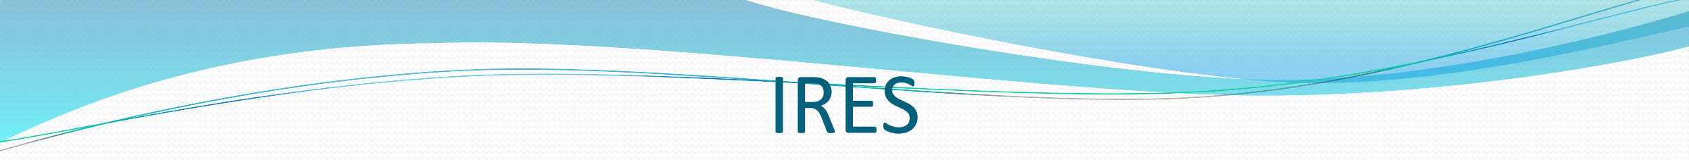
[picture p17: figure]
IRES

- During the process of writing IRES (which included InterEnerStat discussions), a number of definitions were proposed for renewable energy
- However, because of the subjectivity of what is considered renewable energy, no such definition was accepted
- The reasons ranged from the fact that it would exclude some products considered renewable (e.g., most renewable energy comes from the Sun, which is not strictly renewing itself),
- To the fact that some subjectivity was left (e.g., where to draw the line on how long the resources, such as those of coal or peat, take to replenish themselves)
- For this reason, the decision was made for listing the products as renewable, non-renewable and mixed

6

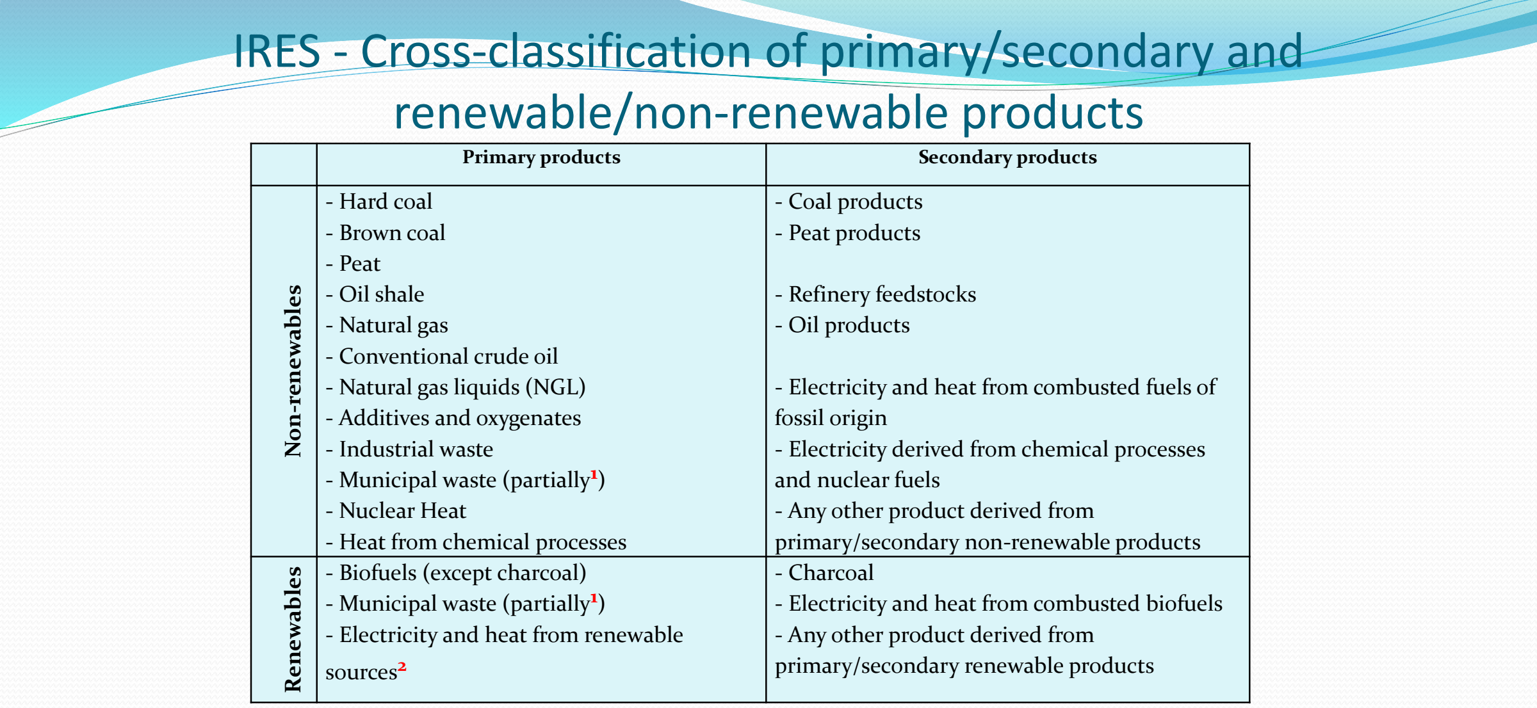
[picture p18: figure]
renewable/non-renewable products; Primary products; Secondary products; Non-renewables; - Hard coal - Brown coal - Peat - Oil shale - Natural gas - Conventional crude oil - Natural gas liquids (NGL) - Additives and oxygenates - Industrial waste - Municipal waste (partially¹; - Nuclear Heat - Heat from chemical processes; - Coal products - Peat products; - Refinery feedstocks - Oil products; fossil origin; and nuclear fuels - Any other product derived from primary/secondary non-renewable products; Renewables; - Biofuels (except charcoal) - Municipal waste (partially¹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

## IRES - Cross-classification of primary/secondary and

- Electricity and heat from combusted fuels of
- Electricity derived from chemical processes
- Electricity and heat from combusted biofuels

7

[1] The part of Municipal waste coming from biomass origin is considered as renewable, whereas that coming from fossil origin is considered as non-renewable.
[2] Renewable sources for electricity comprise of: hydro, wind, solar (photovoltaic and solar thermal), geothermal, wave, tide and other marine energy, as well as the combustion of biofuels. Renewable sources for heat are: solar thermal, geothermal and the combustion of biofuels.

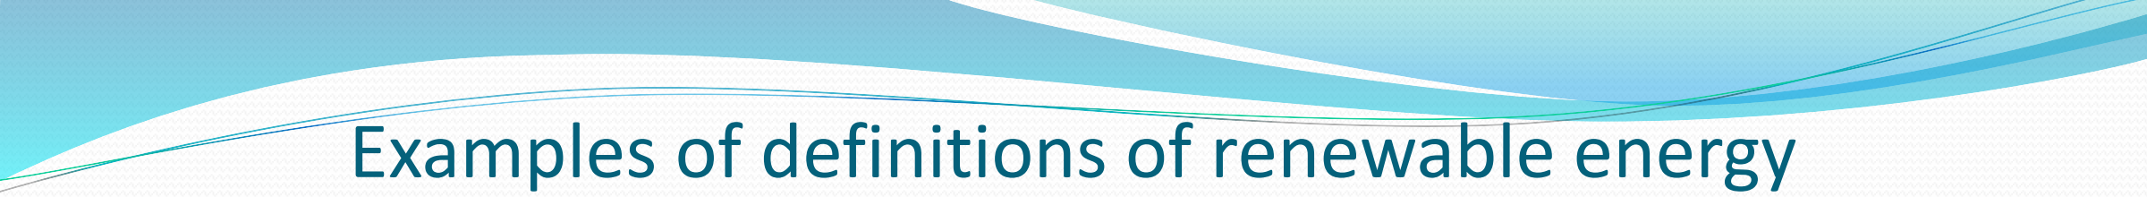
[picture p19: figure]

## Examples of definitions of renewable energy

- The International Renewable Energy Agency (IRENA) has a statutory definition, ratified by 108 members (107 states and the European Union) as of February 2013: “renewable energy includes all forms of energy produced from renewable sources in a sustainable manner, including bioenergy, geothermal energy, hydropower, ocean energy, solar energy and wind energy.”
- The International Energy Agency (IEA) defines renewable energy resources as those “derived from natural processes” and “replenished at a faster rate than they are consumed” (IEA 2002, OECD, IEA and Eurostat, 2005).
- The IEA definition of renewable energy includes the following sources: “electricity and heat derived from solar, wind, ocean, hydropower, biomass, geothermal resources, and biofuels and hydrogen derived from renewable resources” (IEA 2002).
- There is no common or global definition of renewable energy.

8

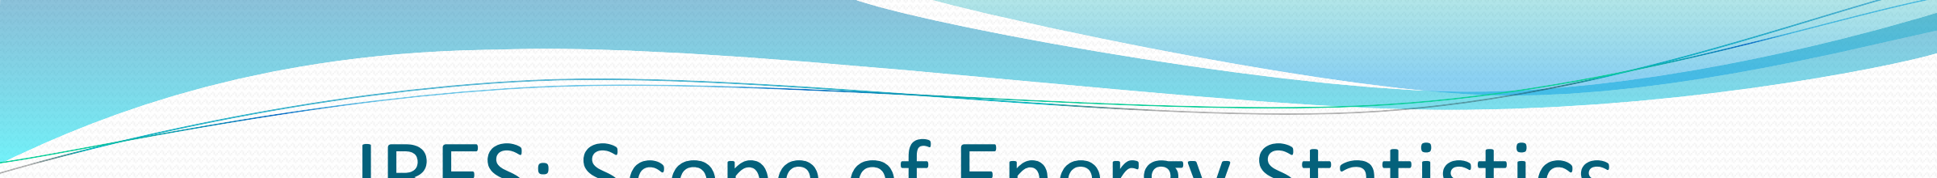
[picture p20: figure]

# IRES: Scope of Energy Statistics

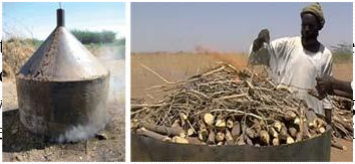
[picture p21: figure]

- Energy products refer to all products exclusively or mainly used as a source of energy. Biomass and waste are included when and only when they are used for energy purposes. Non-energy use of these products is zero by definition.
- Data on the production of energy outside energy industries is

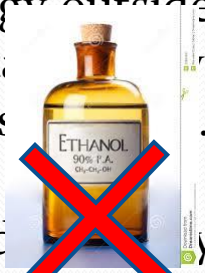
[picture p22: figure]
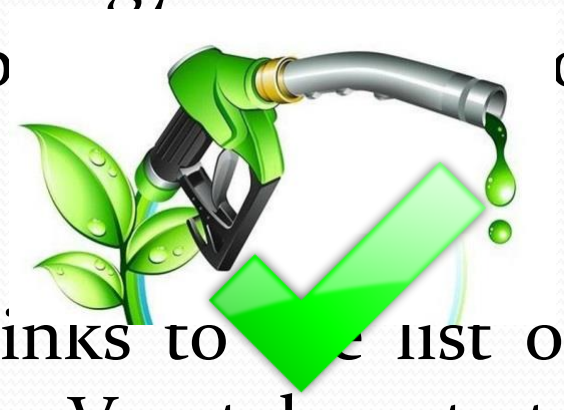
[picture p23: figure]

collected and included in total energy production (so no

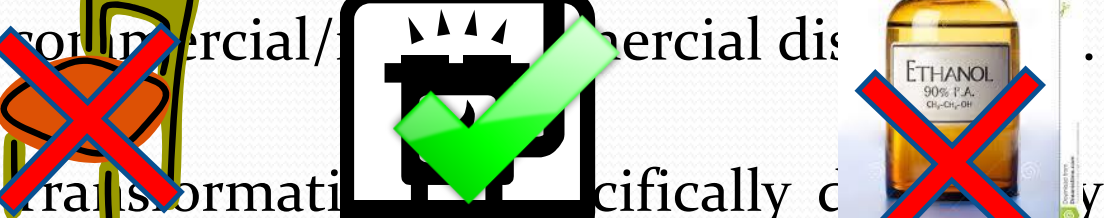
[picture p24: figure]
commercial/non-commercial distinction).

- Transformation is specifically defined by links to the list of energy industries; “transformation” from e.g. Vegetal waste to biofuels isn’t considered (but fuelwood to charcoal is).

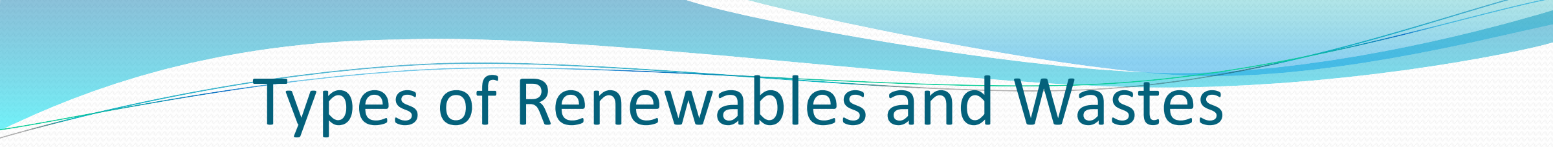
[picture p25: figure]
Types of Renewables and Wastes
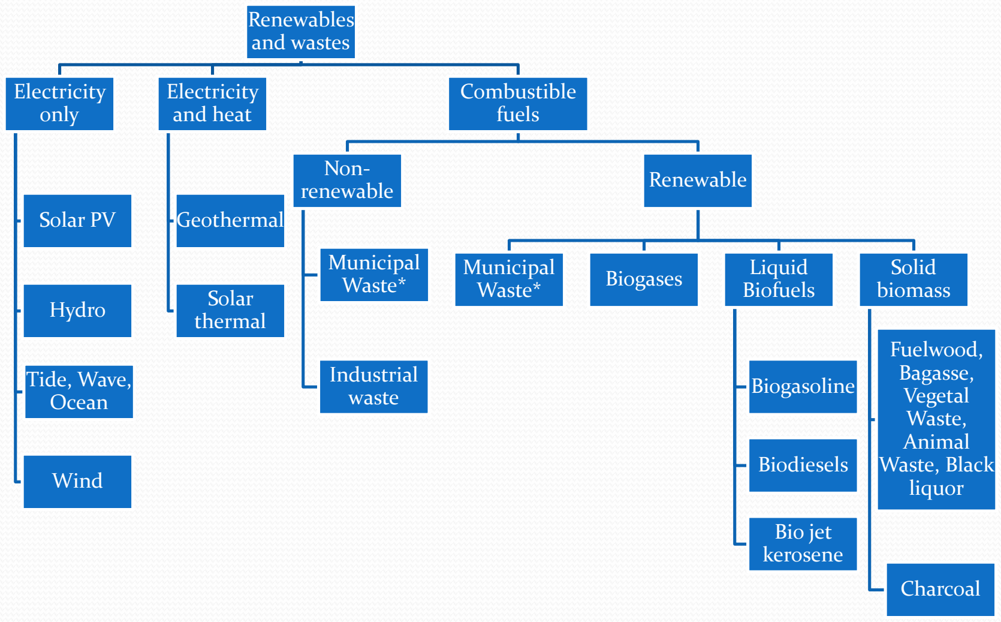
[picture p26: figure]
Renewables and wastes; Electricity and heat; Geothermal; Solar thermal; Electricity only; Wind; Solar PV; Hydro; Tide, Wave, Ocean; Combustible fuels; Non- renewable; Municipal Waste*; Industrial waste; Renewable; Municipal; Waste*; Biogases; Liquid; Biofuels; Biogasoline; Biodiesels; Bio jet kerosene; Solid biomass; Charcoal; Fuelwood, Bagasse, Vegetal Waste, Animal Waste, Black liquor

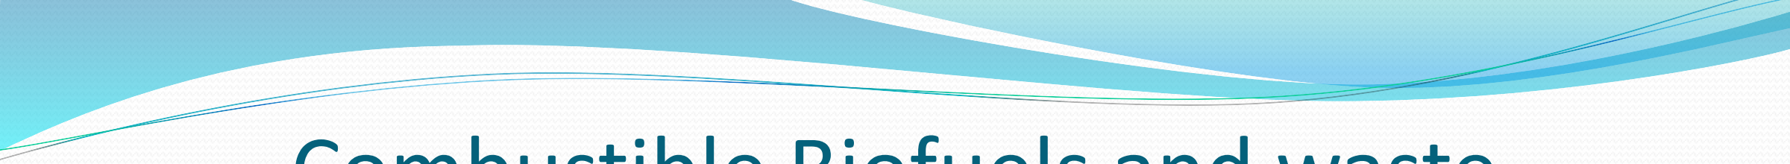
[picture p27: figure]

# Combustible Biofuels and waste

- Apart from differences on how to account for primary energy, and what is in the scope of energy statistics (as seen before), can be treated similarly to fossil fuels
- Concepts of production, stock changes, trade all make sense and can be collected, so a complete commodity balance can be constructed

# SIEC

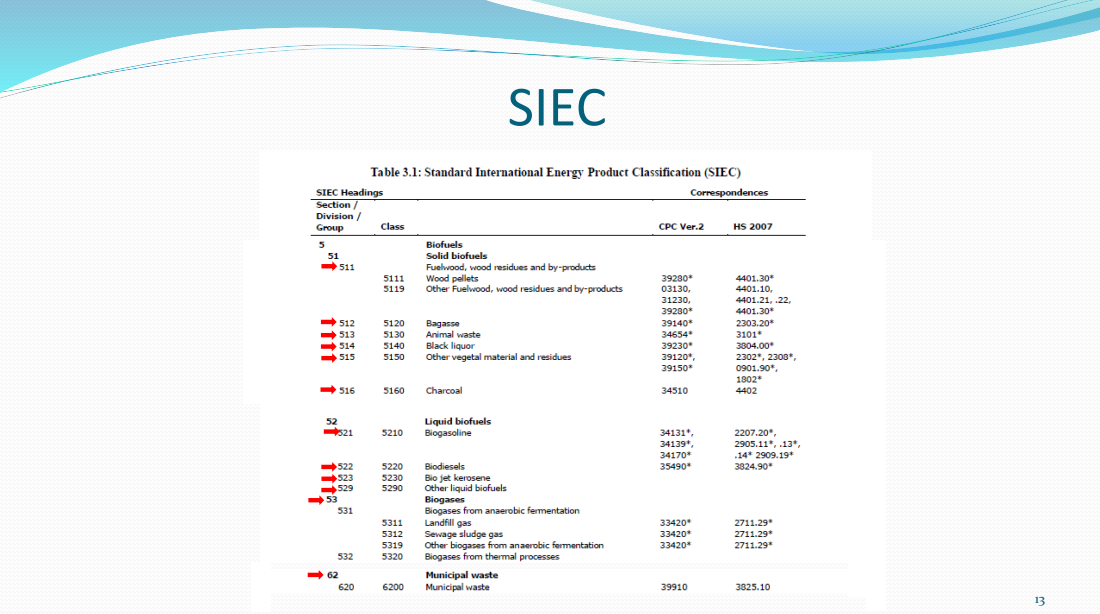
[picture p28: page 12]

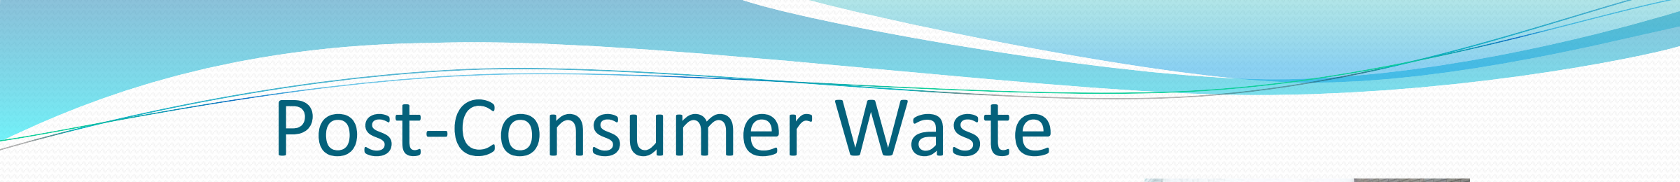
[picture p29: figure]
Post-Consumer Waste
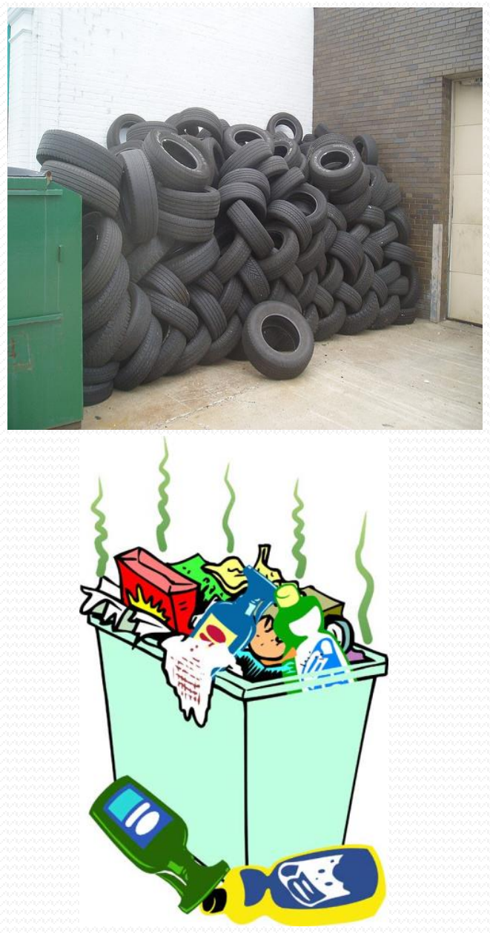
[picture p30: figure]

- Industrial waste: non-renewable by definition (any “industrial” waste of bio origin is classified as a biofuel). Burnt separately from municipal waste (pollution)
- Examples: used car tires, medical waste
- Municipal waste: from households, companies and public services
- Will typically be part-renewable. Many countries/organisations assume a 50/50 split without better data

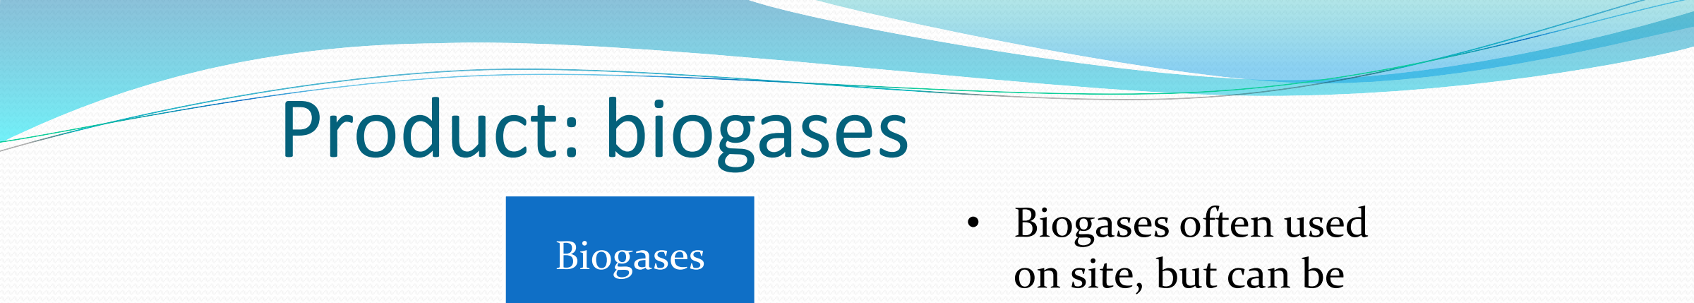
[picture p31: figure]
Product: biogases; Biogases; • Biogases often used on site, but can be
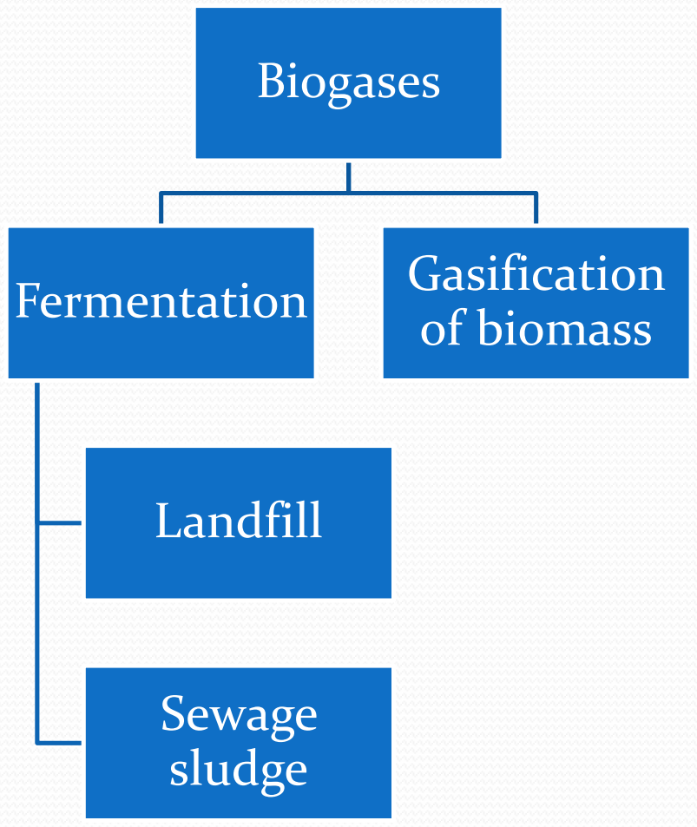
[picture p32: figure]
Fermentation; Landfill; Sewage sludge; Gasification of biomass

blended into the
natural gas
distribution network
too.
- UNSD collects data
on the total
quantity of
biogases produced,
regardless of their
production process.

# Growth of liquid Biofuels

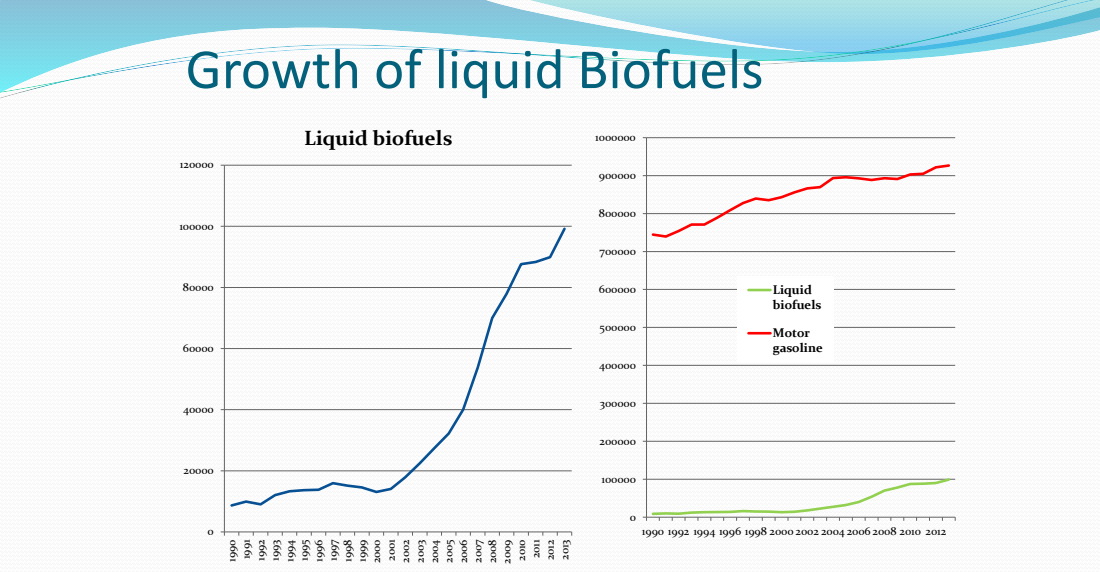
[picture p33: page 15]
Liquid biofuels; Motor gasoline

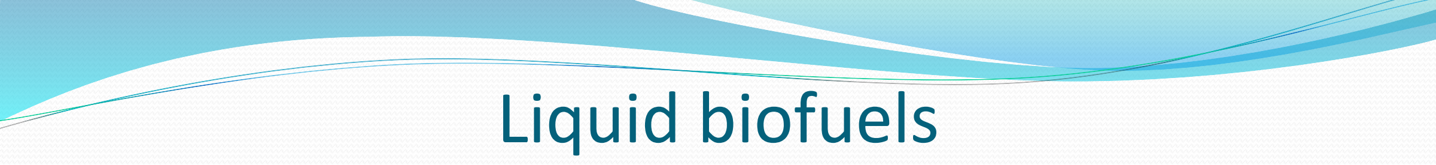
[picture p34: figure]
Liquid biofuels

- By 2015, global supply of liquid biofuels had grown by a factor of 7 since 2000
- Increasingly seen as a way to reduce emissions in transport (if sustainably produced) but has its own problems (hunger, deforestation, technology adaptation)
- Can be used pure or blended with fossil fuels

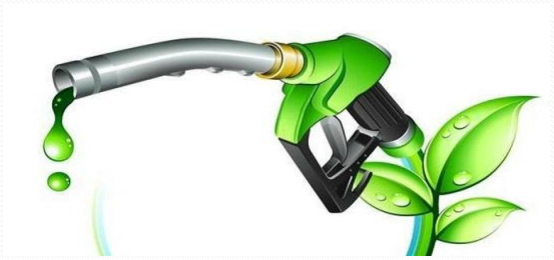
[picture p35: figure]

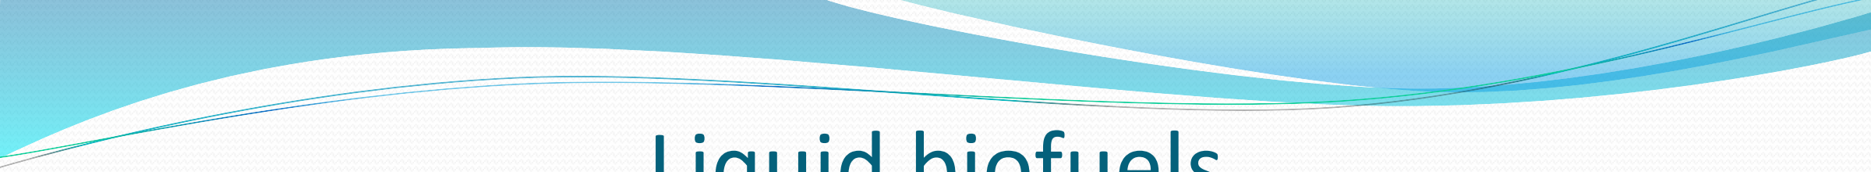
[picture p36: figure]

# Liquid biofuels

- Biogasoline (includes bioethanol, biomethanol)
- Used pure or blended in gasoline engines
- Biodiesels (methyl-esters, Fischer Tropsch oil)
- Used pure or blended in diesel engines
- Bio jet kerosene
- Other liquid biofuels
SIEC classification is made by use rather than chemistry. What fuel is it being blended with? What engine is it used in?

# Liquid biofuels: UNSD Approach

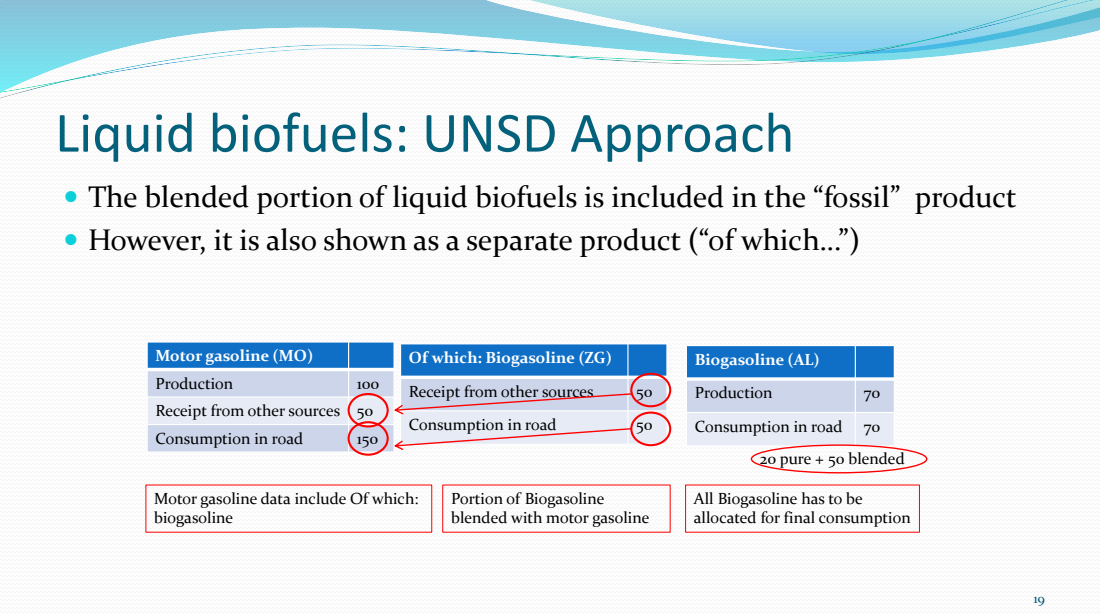
[picture p37: page 18]
Receipt from other sources; Consumption in road; Biogasoline (AL); Production; 20 pure + 50 blended

The blended portion of liquid biofuels is included in the “fossil” product
However, it is also shown as a separate product (“of which…”)

Motor gasoline (MO)

Of which: Biogasoline (ZG)

Production | 100
Receipt from other sources | 50
Consumption in road | 150

Motor gasoline data include Of which:
biogasoline

Portion of Biogasoline
blended with motor gasoline

All Biogasoline has to be
allocated for final consumption

# Liquid biofuels: UNSD Approach

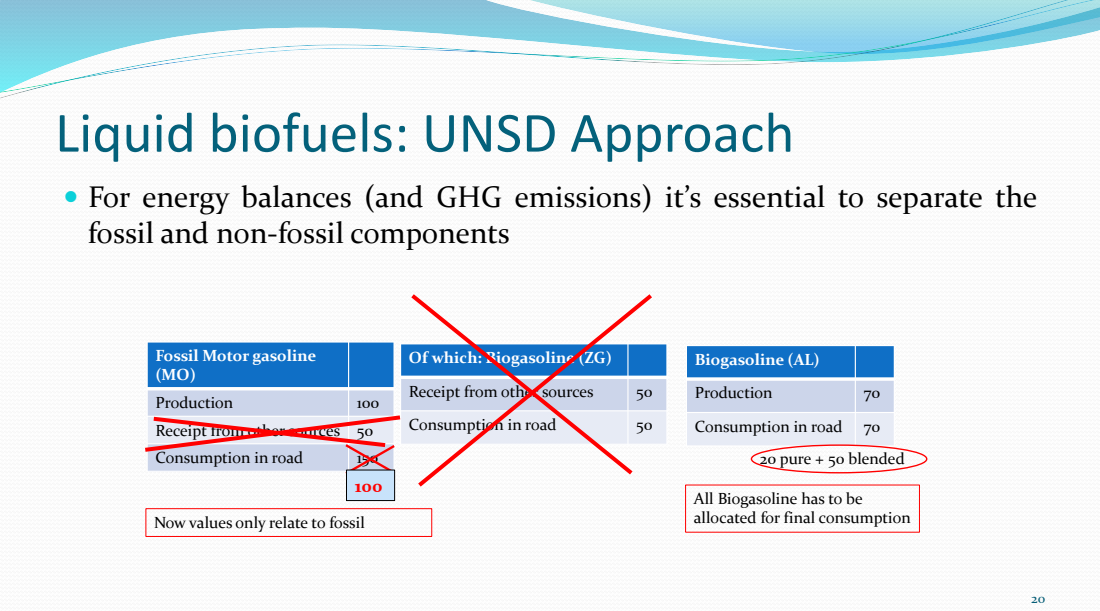
[picture p38: page 19]
Receipt from other sources; Consumption in road; Biogasoline (AL); Production; 20 pure + 50 blended

For energy balances (and GHG emissions) it’s essential to separate the
fossil and non-fossil components

Fossil Motor gasoline

Of which: Biogasoline (ZG)

Production | 100
Receipt from other sources | 50
Consumption in road | 150

All Biogasoline has to be
allocated for final consumption

Now values only relate to fossil

# Solid Biofuels: Sources

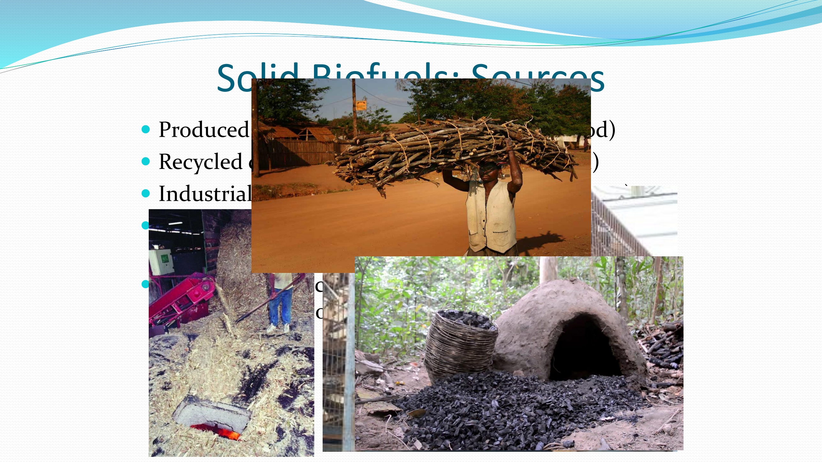
[picture p39: page 20]

- Produced professionally (commercial fuelwood)
- Recycled commercially (post-consumer wood)
- Industrial by-products and used on-site (bagasse)
- Produced in the informal/grey sector (charcoal producers)
- completely non-commercially (households collecting their own firewood)

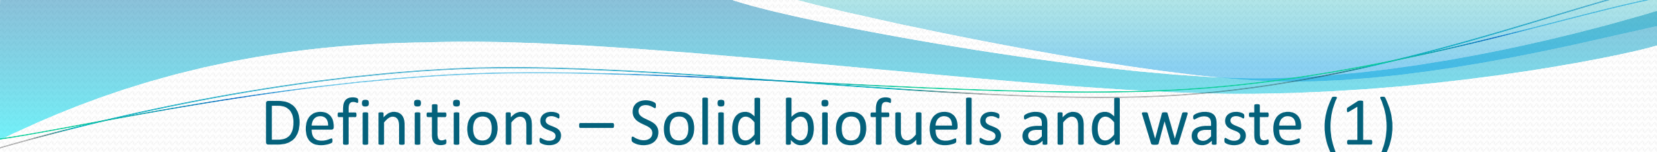
[picture p40: figure]

## Definitions – Solid biofuels and waste (1)

Fuelwood, wood residues and by-products

CUBIC METERS, 1000
- Fuelwood or firewood (in log, brushwood, pellet or chip form) obtained from natural or managed forests or isolated trees. Also included are wood residues used as fuel and in which the original composition of wood is retained.

Charcoal

METRIC TONS, 1000
- The solid residue from the carbonisation of wood or other vegetal matter through slow pyrolysis.

Bagasse

METRIC TONS, 1000
- The fuel obtained from the fibre which remains after juice extraction in sugar cane processing.

23

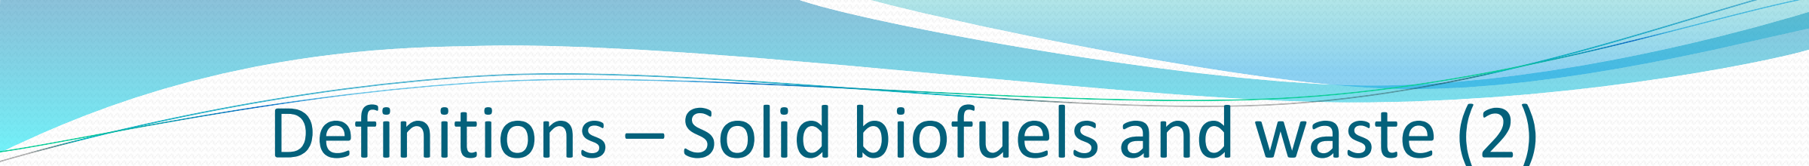
[picture p41: figure]

# Definitions – Solid biofuels and waste (2)

Animal waste

TERAJOULES
- Excreta of animals, meat and fish residues which, when dry, are used directly as a fuel.

Black liquor

TERAJOULES
- The alkaline-spent liquor obtained from the digesters during the production of sulphate or soda pulp required for paper manufacture.

Other vegetal material and residues

TERAJOULES
- Solid primary biofuels not specified elsewhere, including straw, vegetable husks, ground nut shells, pruning brushwood, olive pomace and other wastes arising from the maintenance, cropping and processing of plants.

Municipal waste

TERAJOULES
- Household waste and waste from companies and public services that resembles household waste and which is collected at installations specifically designed for the disposal of mixed wastes with recovery of combustible liquids, gases or heat.

24

# UN Energy Statistics Questionnaire

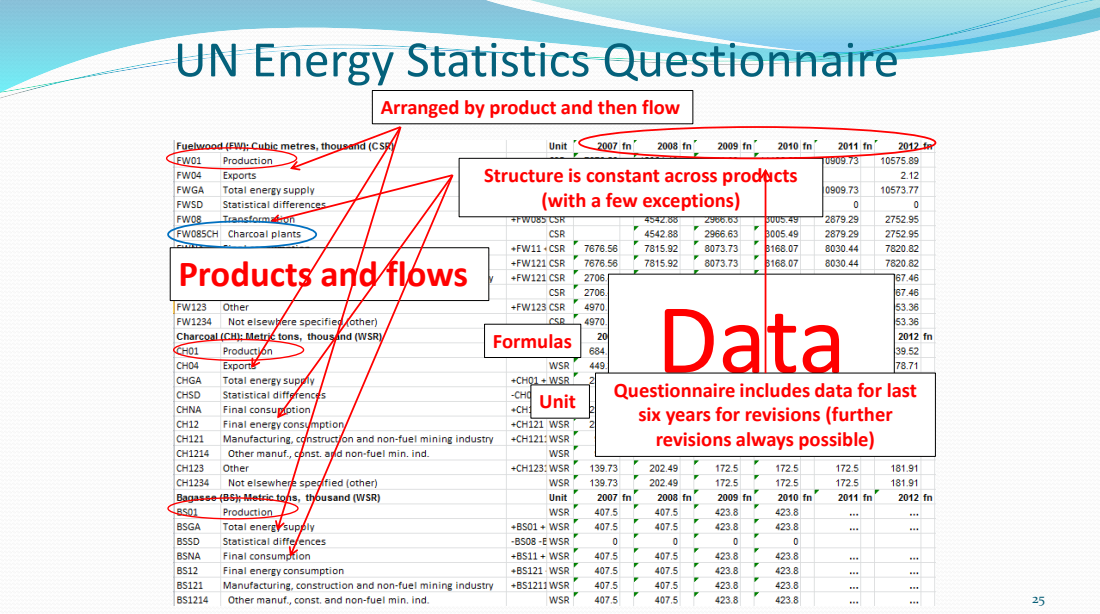
[picture p42: page 23]
Formulas; Unit

Arranged by product and then flow

Structure is constant across products
(with a few exceptions)
Data

Products and flows

Questionnaire includes data for last
six years for revisions (further
revisions always possible)

## Estimation: Fuelwood input for charcoal

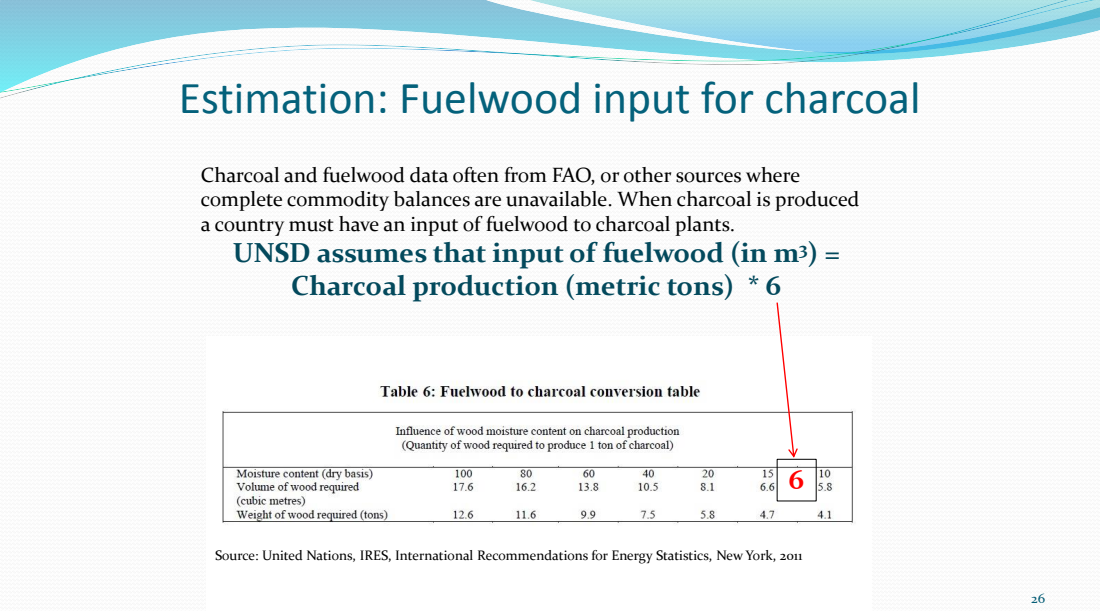
[picture p43: page 24]

Charcoal and fuelwood data often from FAO, or other sources where
complete commodity balances are unavailable. When charcoal is produced
a country must have an input of fuelwood to charcoal plants.
UNSD assumes that input of fuelwood (in m³
Charcoal production (metric tons) * 6

Source: United Nations, IRES, International Recommendations for Energy Statistics, New York, 2011

## Estimation: Fuelwood input for charcoal

### Assumptions:

- Low moisture content of fuelwood (10-15%)
- Charcoal transformation efficiency of 53.8% (on an energy basis considering the default NCV)
More detailed country-specific information could be used to improve the accuracy of the estimates
- Conversion from fuelwood to charcoal: wood density, moisture content and production method
- Large variety of wood species and moisture and ash content in wood products highly affect the energy content of the charcoal

27

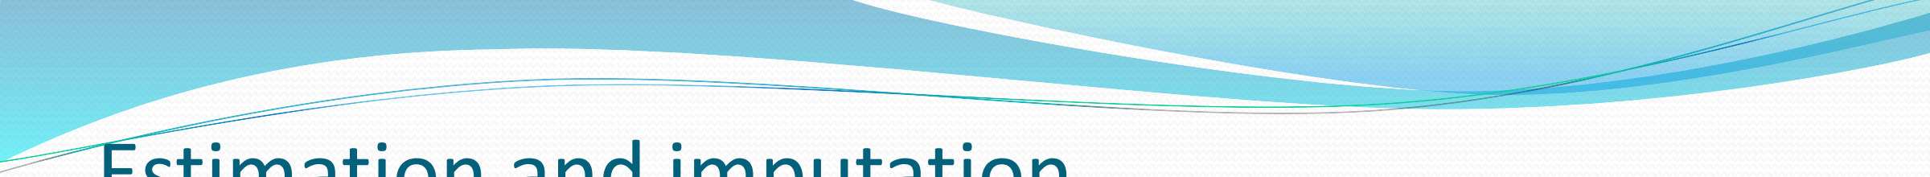
[picture p44: figure]

# Estimation and imputation

Bagasse
When the production of bagasse is not reported in UNSD’s questionnaire, it is estimated using data from the International Sugar Organization (ISO) on production of raw cane sugar.

Bagasse production (metric tons) = Cane sugar production (metric tons) * 3.26

«Based on observations, the Economic Commission for Latin America and the Caribbean (ECLAC) proposed the use of 3.26 kg bagasse yield per kilogram of centrifugal sugar produced»

Source: United Nations “Energy Statistics: Definitions, Units of Measure and Conversion Factors”, Studies in Methods, Series F, N. 44, New York, 1987

28

# Additional data sources

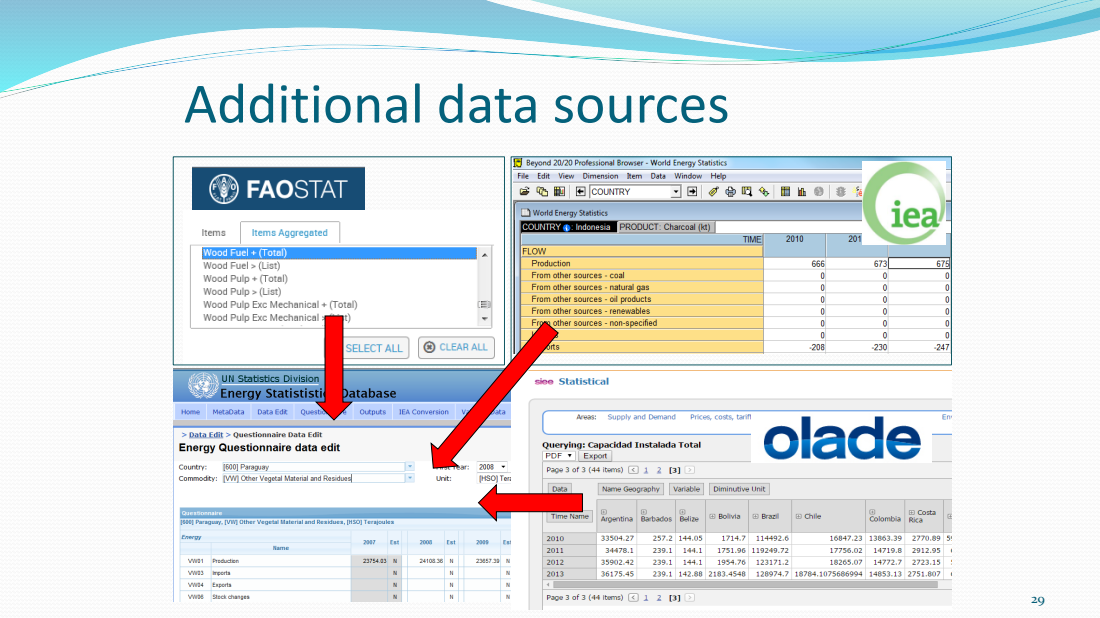
[picture p45: page 27]

# Data Source Challenges

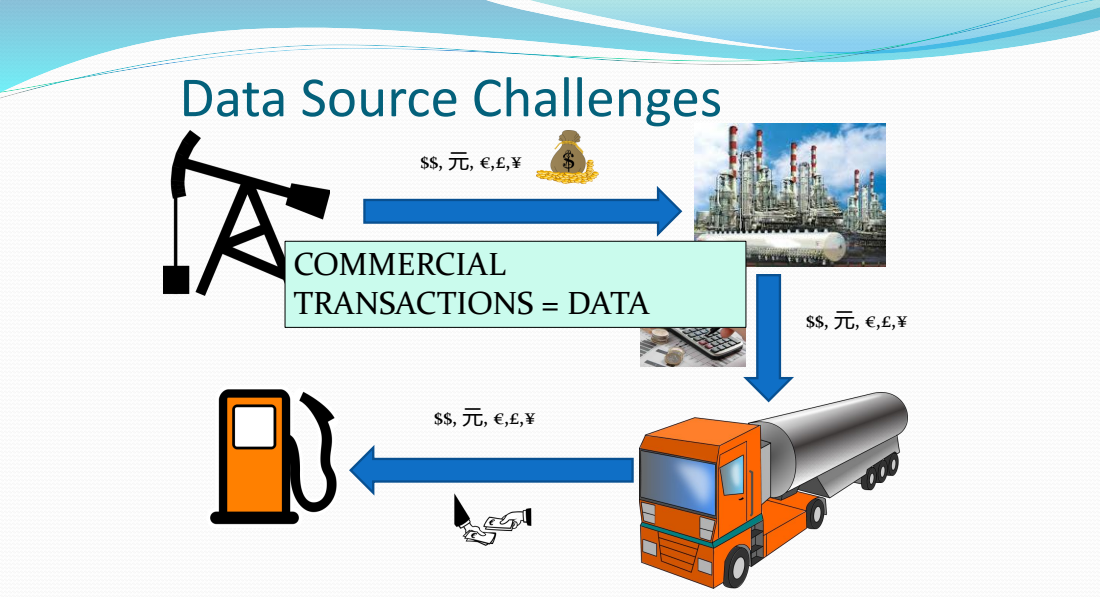
[picture p46: page 28]
COMMERCIAL TRANSACTIONS = DATA

## Data Challenges for Renewables

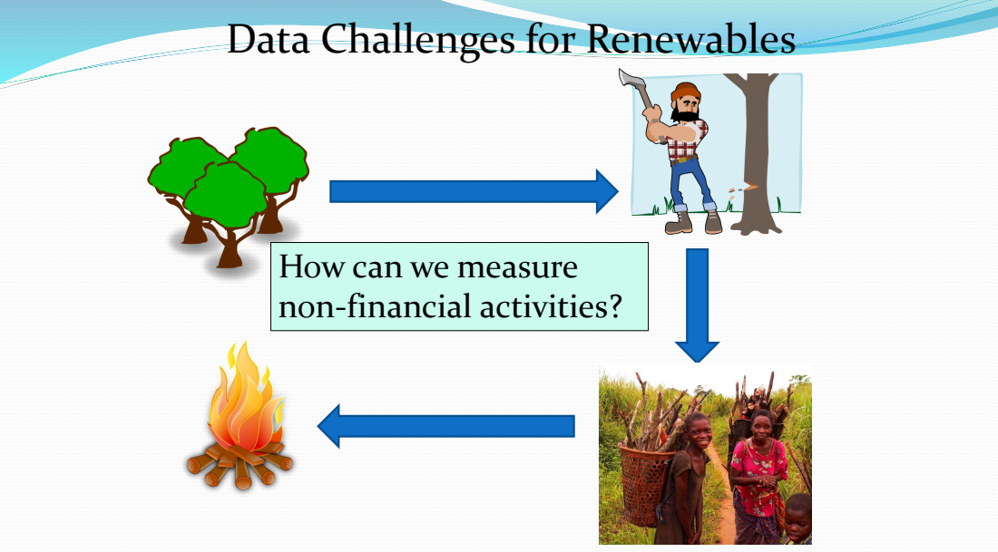
[picture p47: page 29]

How can we measure
non-financial activities?

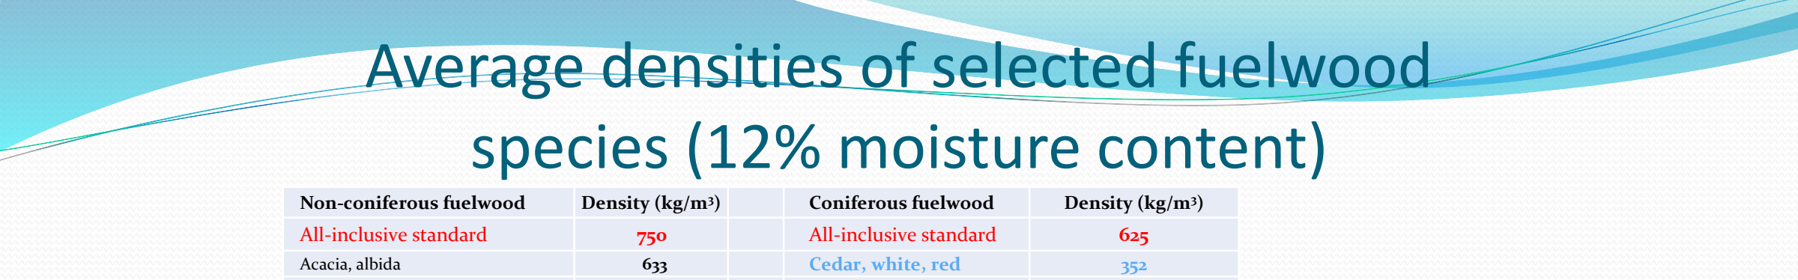
[picture p48: figure]
Average densities of selected fuelwood species (12% moisture content); Non-coniferous fuelwood; Density (kg/m³ ); Coniferous fuelwood; All-inclusive standard; Acacia, albida; Cedar, white, red

Acacia, nigrescens | 1111 | Cypress | 465
Apple | 705 | Fir, Douglas | 513
Ash, black | 545 | Fir, balsam | 401
Ash, white | 673 | Hemlock | 465
Bamboo | 725 | Pine, Oregon | 513
Birch, sweet yellow | 705 | Pine, red | 481
Cherry, wild red | 433 | Pine, white | 433
Chestnut | 481 | Pine, southern | 642
Elm, white | 561 | Pine, Norway | 541
Erythrophleum africanum | 1010 | Redwood, California | 417
Eucalyptus, microcorys | 847 | Spruce, white, red | 449
Eucalyptus, paniculata | 1000
Hickory | 769 | For unknown species | 725
Irvingia malayana | 1099
Locust | 722
Mahogany | 705
Mangrove, heriteria | 901
Mangrove, rhizophora | 1176
Mangrove, sonneratia | 775
Maple, sugar | 689
Maple, white | 529
Oak,chestnut | 737
Oak, live | 866
Oak, red, black | 673
Oak, white | 770
Poplar | 433
Tamarind | 855
Teak, African | 994
Teak, Indian | 769
Walnut, black | 593
Willow | 449

32

Sources: T. Baumeister
and others, Marks'
Standard Handbook for
Mechanical Engineers, 8th
ed. (New York, McGraw-Hill, 1978); J. Bryce, The Commercial Timbers of
Tanzania (Dar es Salaam,
Government Printers,
1967); P. Sono,
Merchantable Timbers of
Thailand (Bangkok, Forest
Products Division, Royal
Forest Department, 1974);
United Nations, "Concepts
and methods for the
collection and compilation of statistics on biomass
used as energy", by K.
Openshaw
(ESA/STAT/AC.30/6)

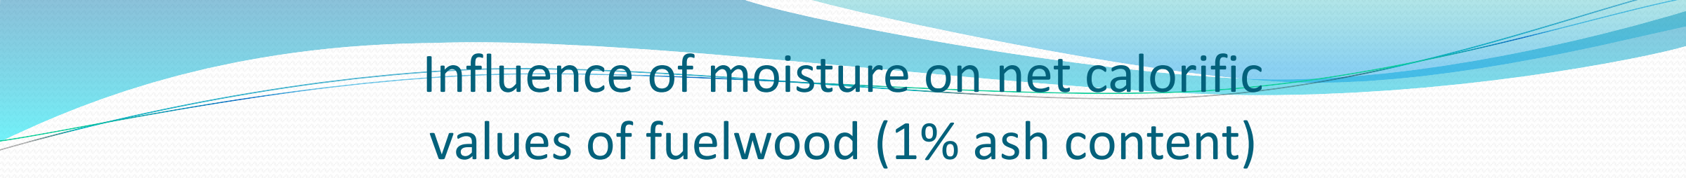
[picture p49: figure]
Influence of moisture on net calorific values of fuelwood (1% ash content)

| Percentage moisture content | Kilocalories per kilogram | Megajoules per kilogram
| dry basis | Wet basis
Green wood | 160 | 62 | 1360 | 5.7
| 140 | 59 | 1530 | 6.4
| 120 | 55 | 1720 | 7.2
| 100 | 50 | 1960 | 8.2
| 80 | 45 | 2220 | 9.3
| 70 | 41 | 2390 | 10.0
Air-dried wood | 60 | 38 | 2580 | 10.8
| 50 | 33 | 2790 | 11.7
| 40 | 29 | 3030 | 12.7
| 30 | 23 | 3300 | 13.8
| 25 | 20 | 3460 | 14.5
| 20 | 17 | 3630 | 15.2
| 15 | 13 | 3820 | 16.0
Oven-dried wood | 10 | 9 | 4010 | 16.8
| 5 | 5 | 4230 | 17.7
| 0 | 0 | 4470 | 18.7

33

Sources: Food and Agriculture Organization, A New Approach to Domestic Fuelwood Conservation, (Rome, 1986); D. A. Tillman, Wood as an Energy Resource (New York, Academic Press, 1978); and United Nations, Concepts and Methods for the Collection and Compilation of Statistics on Biomass Used as Energy, by K. Openshaw (ESA/STAT/AC.3016).

# Renewable Electricity and Heat

- Electricity and heat from specific sources are not “products”, but rather data items
- Consumption in industry of “hydro” does not make sense, the product is electricity
- Therefore only generation figures to be collected
- Information for autoproducers will most likely not be included in data available from public grids

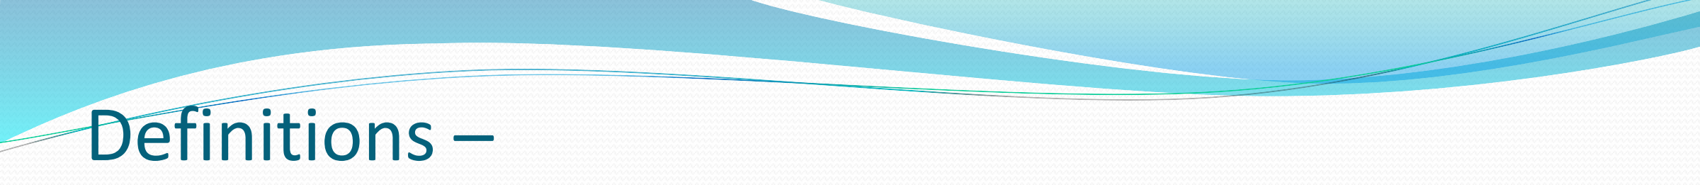
[picture p50: figure]
Definitions –

## Electricity from renewables (1)

### Hydro

- Electricity produced from devices driven by fresh, flowing or falling water.

### Solar

- Solar photovoltaics: Electricity produced by the direct conversion of solar radiation through photovoltaic processes in semiconductor devices (solar cells), including concentrating photovoltaic systems.
- Solar thermal: Electricity produced from solar radiation captured by concentrating solar thermal systems.

### Wind

- Electricity produced from devices driven by wind.

35

Pumped hydro: Electricity from pumped storage plants.

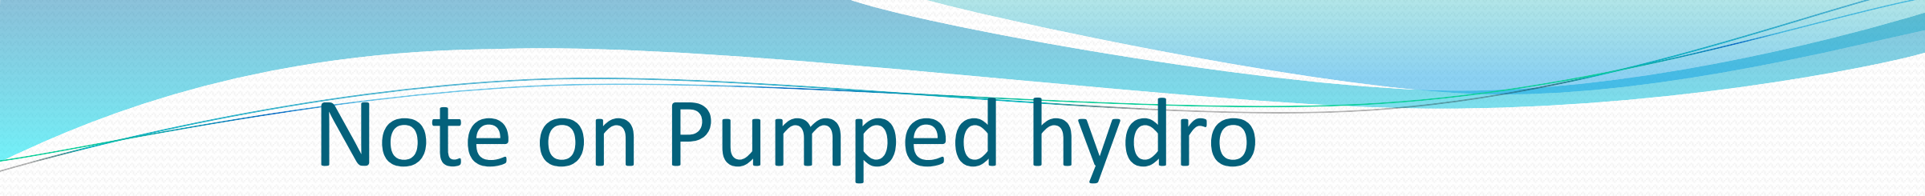
[picture p51: figure]
Note on Pumped hydro
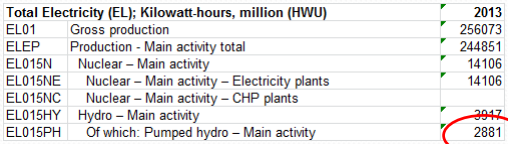
[picture p52: figure]

- Include pumped storage in total generation, but also show it separately as an ”of which” item.
- For energy balances it should be subtracted from production to avoid double counting (or counting under renewables electricity from fossil fuels).
- Show pumped hydro capacity separately too.
- Many hydro plants are mixed between “run of the river” and pumped storage, so measurement challenges exist.

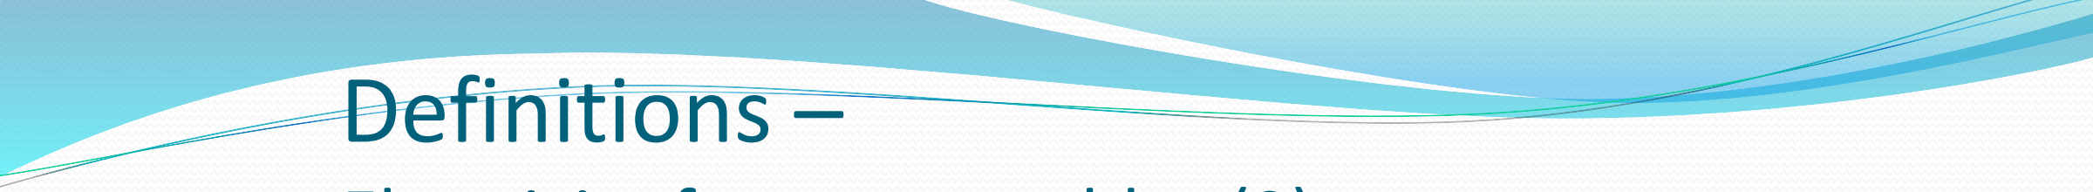
[picture p53: figure]
Definitions –

## Electricity from renewables (2)

Geothermal
- Electricity generated from the heat from geothermal sources.

Tide, wave and marine
- Tidal: Electricity generated from devices driven by tidal currents or the differences of water level caused by tides.
- Wave: Electricity produced from devices driven by the motion of waves.
- Other marine: Electricity generated from devices which exploit sources of marine energy not elsewhere specified. Examples of sources are non-tidal currents, temperature differences and salinity gradients in seas and between sea and fresh water.

37

## Heat from renewables

Geothermal
- Heat extracted from the earth.

Solar thermal
- High temperature heat can be used to generate electricity, drive chemical reactions, or be used directly in industrial processes.
- Low temperature heat can be used for applications such as space heating, cooling, water heating, district heating and industrial processes.

38

# Note on geothermal

- Shallow geothermal sources include heat from sunlight or rain
- Could be considered solar energy, but usually small enough to be ignored

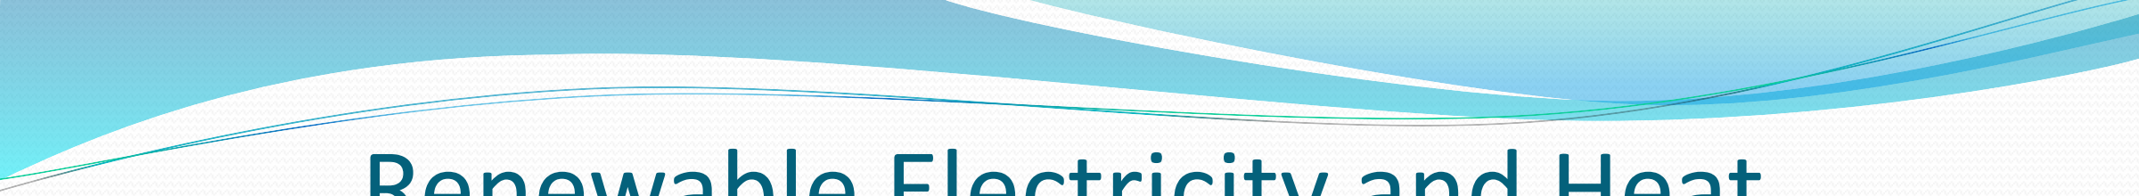
[picture p54: figure]

# Renewable Electricity and Heat

Types of Plant: Types of Producer: | Electricity plant | CHP plant | Heat plant
Main activity | | Report all electricity and heat produced and all fuel used | Report all heat produced and all fuel used
Autoproducer Reminder: | | Report all electricity produced and heat sold with corresponding fuel used | Report heat sold and corresponding fuel used
producers | Report all
| production and all fuel used

Reminder: all electricity should be reported in the electricity, but only the heat sold to third parties in autoproducer heat plants

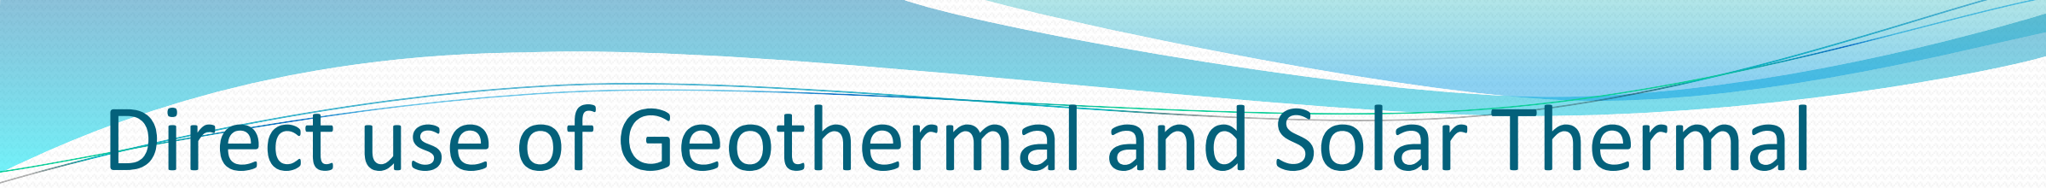
[picture p55: figure]

# Direct use of Geothermal and Solar Thermal Heat

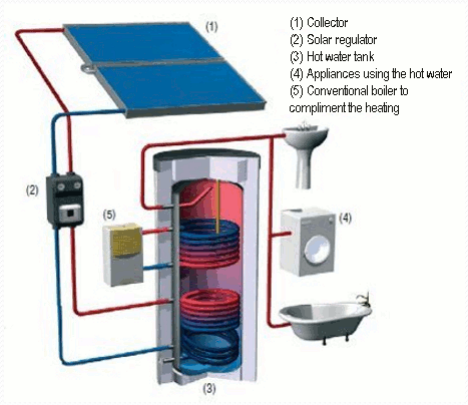
[picture p56: figure]

- For household solar hot
water systems, heat is
generated but no
commercial transaction
takes place.
- This should therefore be excluded from the Heat
table
- Should this be excluded
from our energy statistics?

# Direct use of Geothermal and Solar Thermal

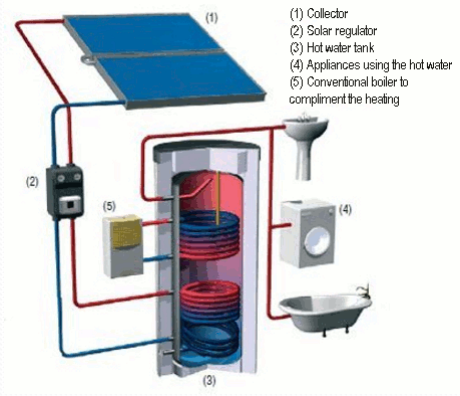
[picture p57: figure]

# Heat

- If this is excluded we don’t have a full account of household energy consumption
- To account for it but to maintain consistent
methodology, separate direct use tables are given in the UNSD questionnaire

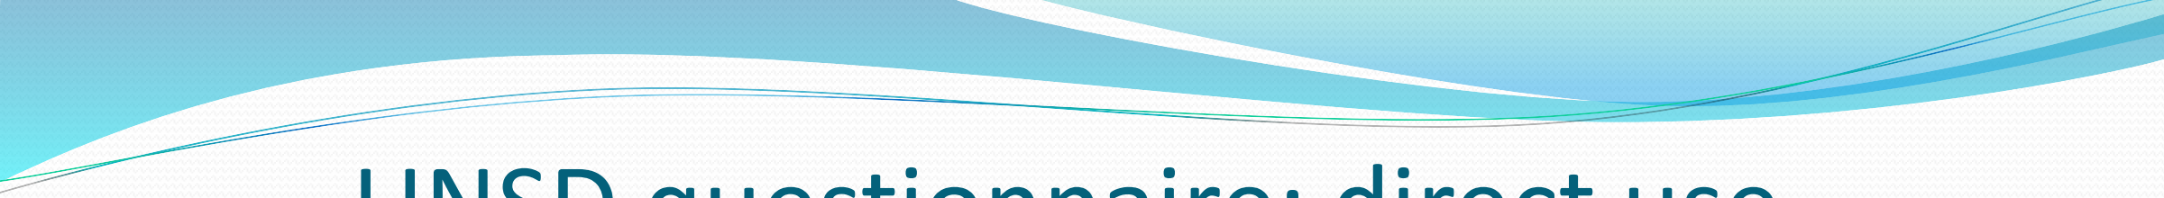
[picture p58: figure]

# UNSD questionnaire: direct use

- Collected separately from the electricity and heat products (to maintain “heat sold” principle)
- Allows full household energy to be measured
- It shows consumption only, no production (this is back-calculated for balances)

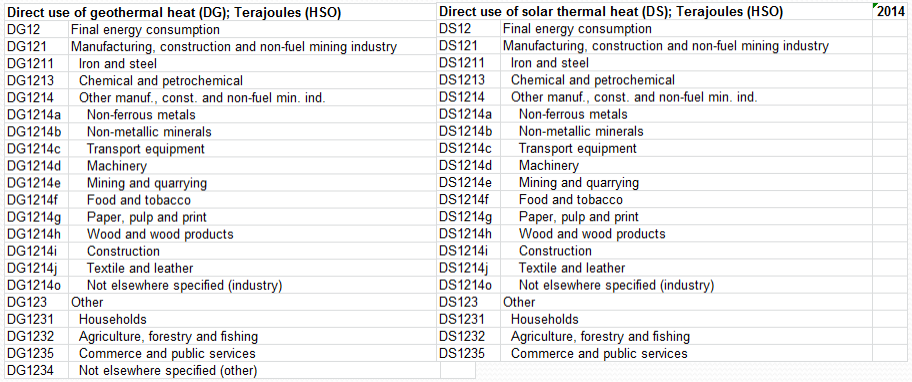
[picture p59: figure]
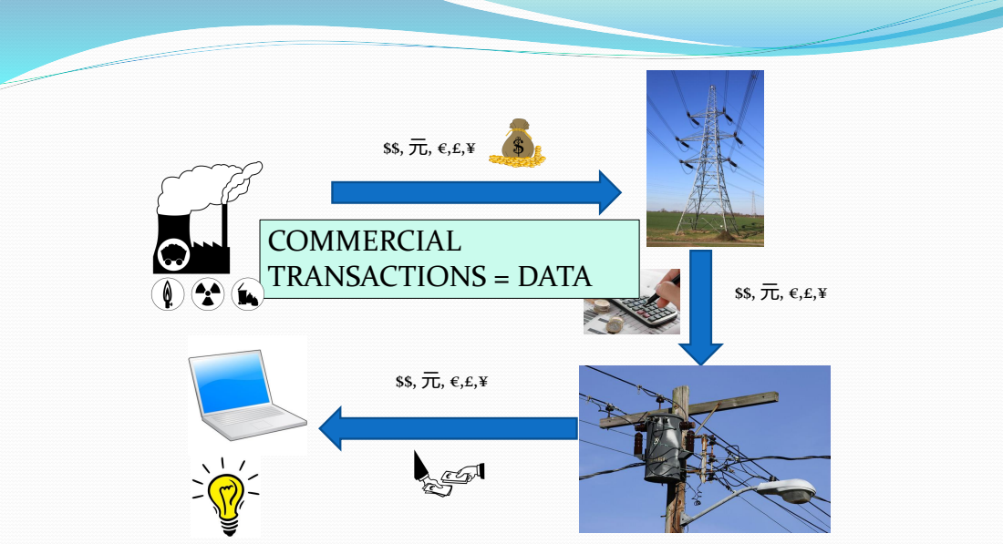
[picture p60: page 42]
COMMERCIAL TRANSACTIONS = DATA

## Data Challenges

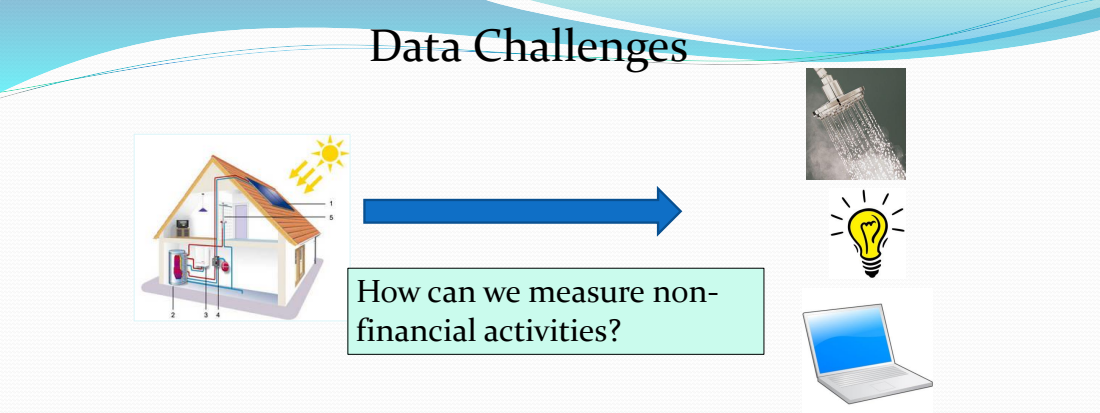
[picture p61: page 43]

How can we measure non-
financial activities?

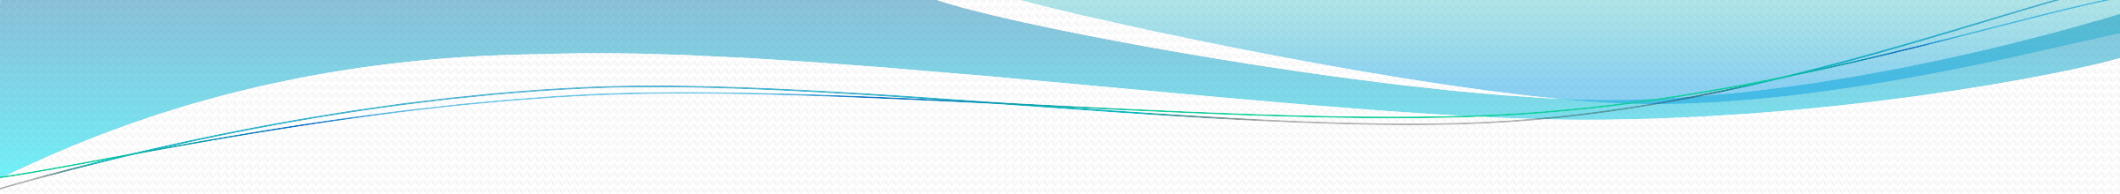
[picture p62: figure]

# Renewables Data Measurement

- With fossil fuels and commercial electricity production we often have supply, output, deliveries and consumption data
- With “non-commercial” renewables, “production” will be back-calculated from consumption levels
- Household surveys are needed, plus administrative data

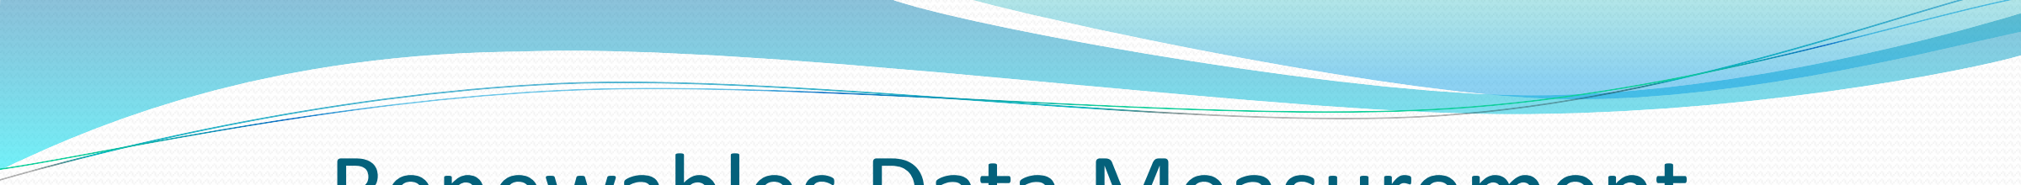
[picture p63: figure]

# Renewables Data Measurement

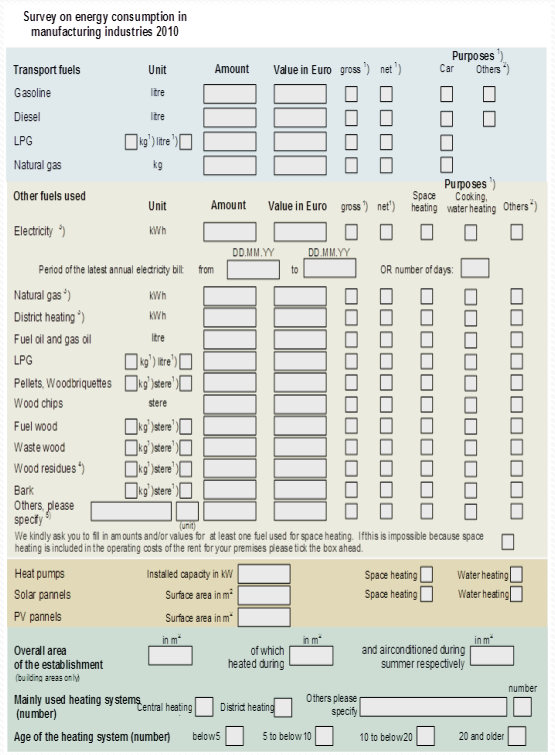
[picture p64: figure]

- House-by-house surveys (e.g. every five
years with annual estimates) are relevant
and accurate for residential solid biomass
- Direct measurement (visual estimates and/or weighing) and
- Survey questions
- For solar:
- Number of panels sold/installed
- Models using the panels’ area
- Weather patterns
- Daily data on electricity bought from the grid (to see how much
replacement occurred)
- The information is out there!
- Survey examples in the Energy Statistics Compilers Manual

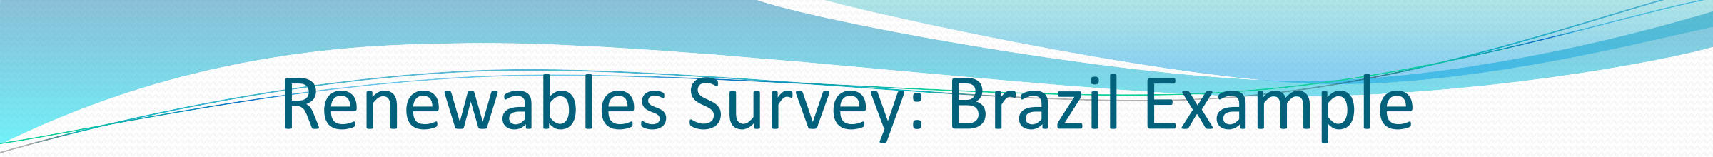
[picture p65: figure]
Renewables Survey: Brazil Example

- Biggest hole in the national balance is consumption (and autoproduction); data are collected through both regular surveys and irregular ones indicating rough energy use.
- Annual Survey has 100% coverage on: steel, pulp and paper, non-ferrous metals (big sectors); 30% coverage of sugar/ethanol. Doesn’t cover minor sectors
- Supplementary data are therefore used:
- Household surveys cover cooking fuels and type of elec appliances (5 years)
- National fuelwood survey covered rural areas only, validates energy balance data
- Supplementary data provide benchmarks for their base years and then these figures are interpolated. Additional estimation techniques include correlations with other energy products
- One survey suggested fuelwood consumption in food industry is 30% undervalued. Highlights where to devote future resources

# Measurement Challenges: World Fuelwood Production

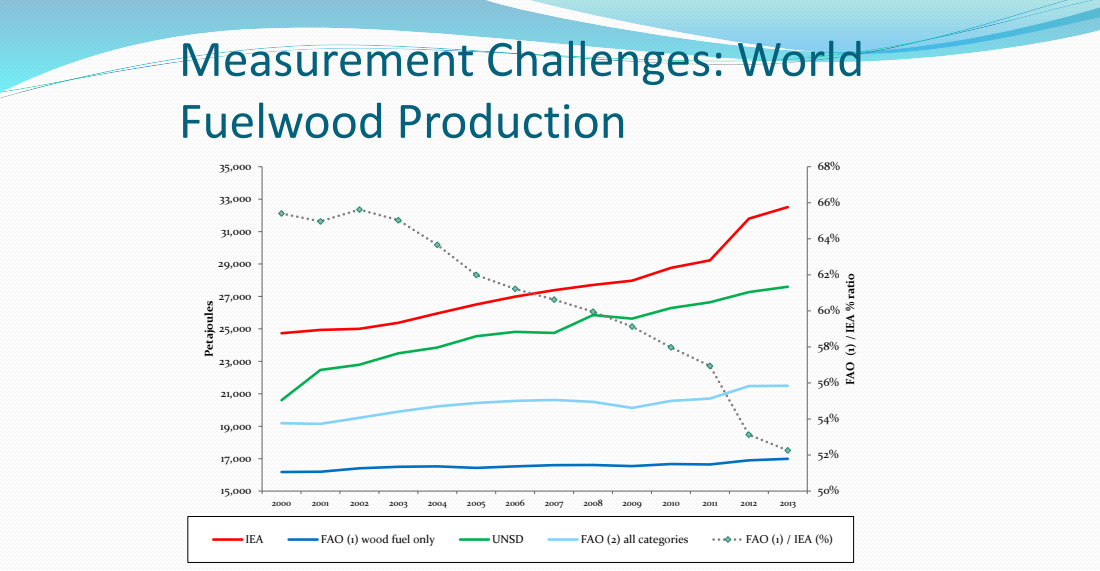
[picture p66: page 47]
Petajoules; IEA; FAO (1) wood fuel only; UNSD; FAO (2) all categories; FAO (1) / IEA (%)

FAO (1) / IEA % ratio

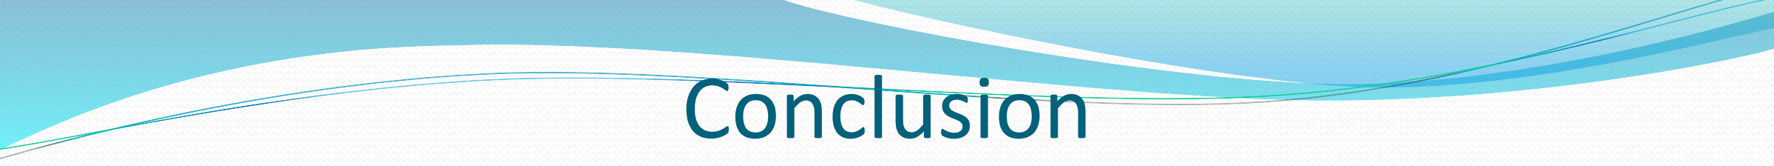
[picture p67: figure]
Conclusion

- Commodity balances can be constructed for combustible biofuels
- Data sources are typically more sparse than for fossil fuels
- “Non-commercial” products need to be included in energy statistics. This includes:
- Fuelwood or other biomass collected by households for own use
- By-products of certain industries typically used for energy purposes (e.g., bagasse, black liquor)
- Electricity and heat generated from renewable sources should be collected from power plants and households

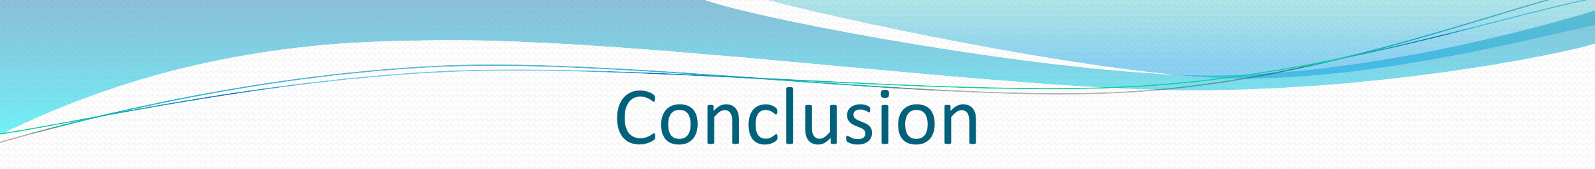
[picture p68: figure]
Conclusion

- Renewables are important and will become more so
- Measurement challenges exist, but solutions are available
- Follow international methodology!
- Deviations from it that are relevant for national policies should be signaled in the metadata, and ideally adjusted for international reporting

## THANKS
