cyc292cycjin-oss/SGP-ESE5004-Stage2/research/04_model_assembly/gate4/evidence/source_scope/SIAMGAS_2Q2023.pdf

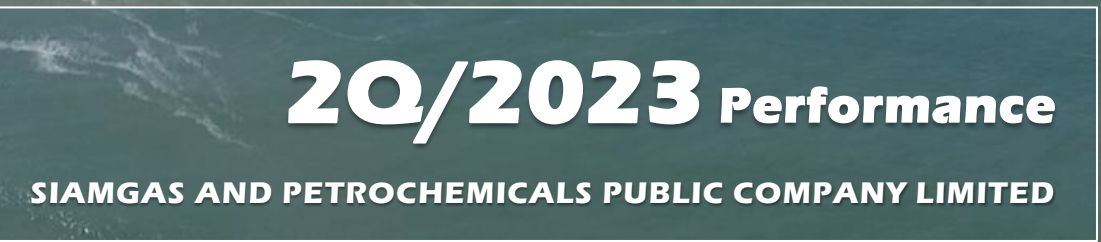
[picture p69: figure]
2Q/2023 Performance

## SIAMGAS AND PETROCHEMICALS PUBLIC COMPANY LIMITED

# 01 BUSINESS OVERVIEW

# AGENDA

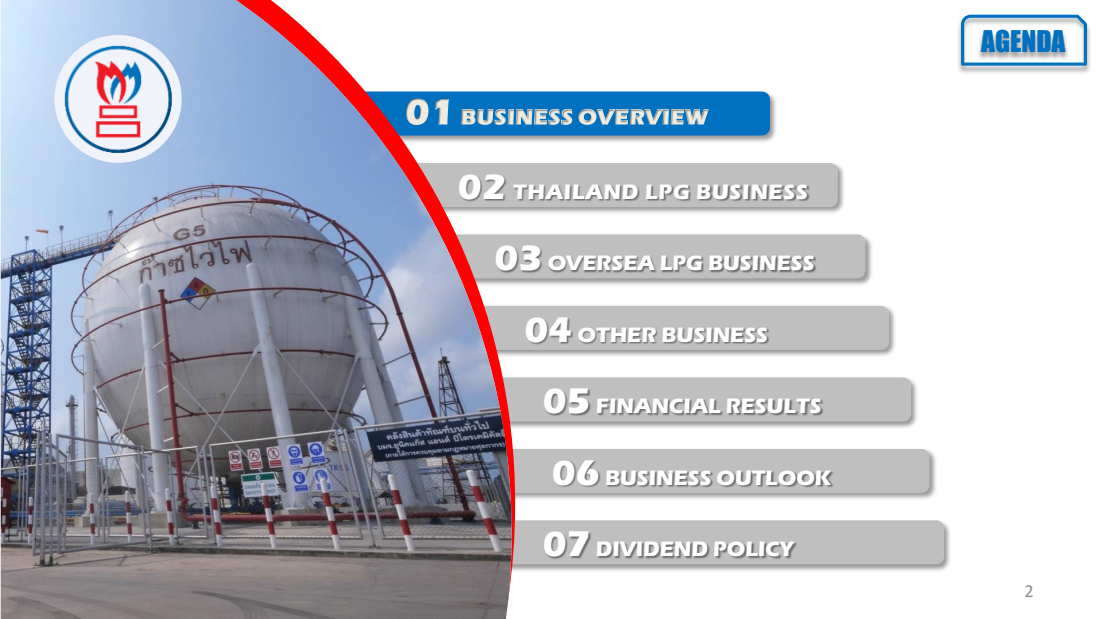
[picture p70: page 2]
04 OTHER BUSINESS; 05FINANCIAL RESULTS; 06 BUSINESS OUTLOOK; 07 DIVIDEND POLICY

02 THAILAND LPG BUSINESS

03 OVERSEA LPG BUSINESS

## MAJOR SHAREHOLDERS (Weeraborwornpong Group)

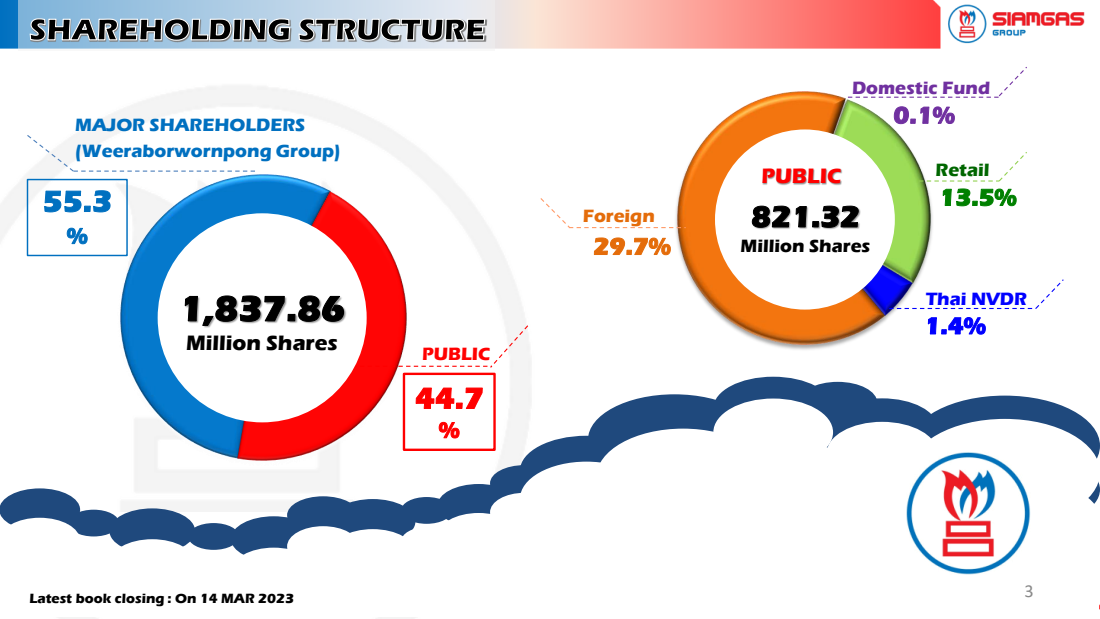
[picture p71: page 3]
PUBLIC; Foreign; Thai NVDR; Retail; Domestic Fund 0.1%; Million Shares; PUBLIC 821.32

Latest book closing : On 14 MAR 2023

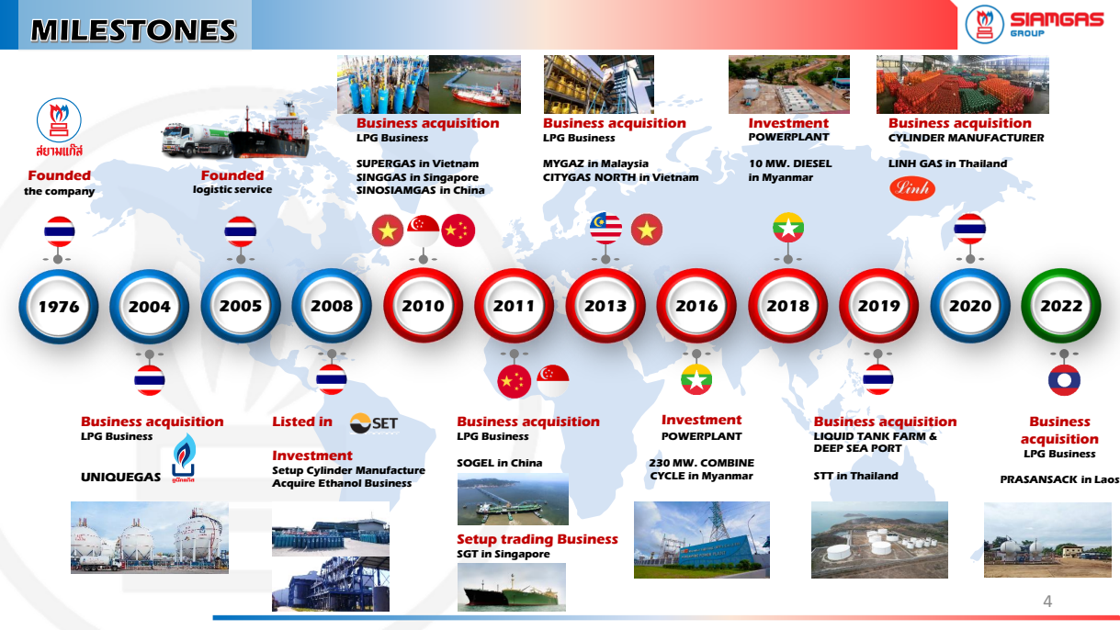
[picture p72: page 4]
Business acquisition; LPG Business; UNIQUEGAS; Founded; the company; Founded logistic service; Investment POWERPLANT; 10 MW. DIESEL in Myanmar; CYLINDER MANUFACTURER; Listed in; Investment; POWERPLANT

SUPERGAS in Vietnam
SINGGAS in Singapore
SINOSIAMGAS in China

MYGAZ in Malaysia
CITYGAS NORTH in Vietnam

LINH GAS in Thailand

Business acquisition
LIQUID TANK FARM &
DEEP SEA PORT

Investment
Setup Cylinder Manufacture
Acquire Ethanol Business

SOGEL in China

230 MW. COMBINE
CYCLE in Myanmar

STT in Thailand

PRASANSACK in Laos

Setup trading Business
SGT in Singapore

THAILAND | OVERSEA

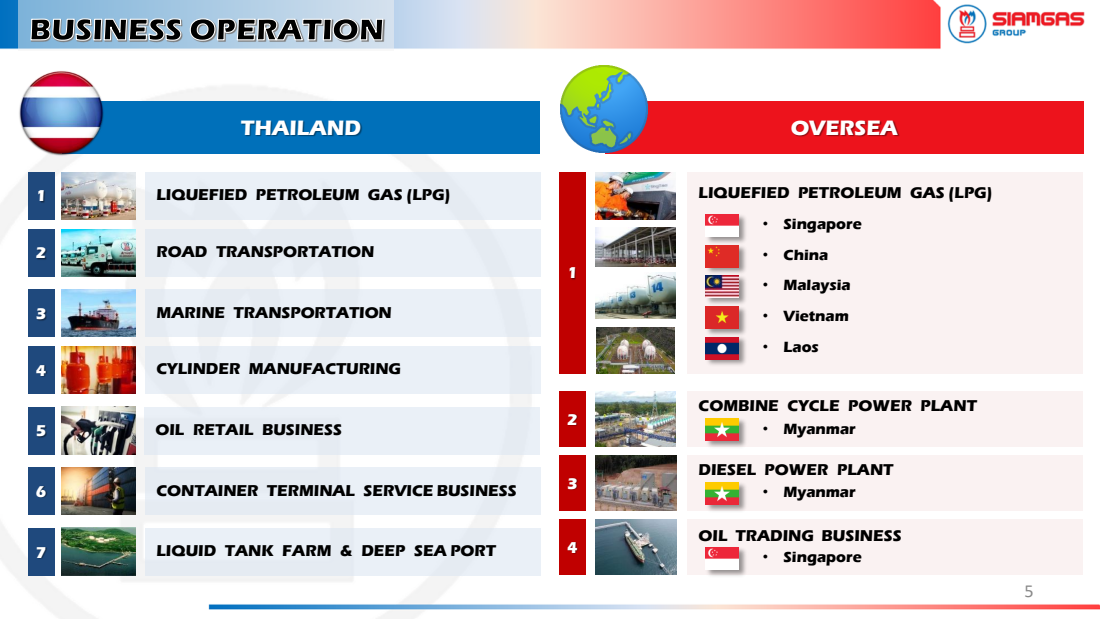
[picture p73: page 5]
ROAD TRANSPORTATION; MARINE TRANSPORTATION; CYLINDER MANUFACTURING; • Singapore; • China; • Malaysia; • Vietnam; • Myanmar; • Laos

LIQUEFIED PETROLEUM GAS (LPG)

COMBINE CYCLE POWER PLANT

OIL RETAIL BUSINESS

DIESEL POWER PLANT

CONTAINER TERMINAL SERVICE BUSINESS

OIL TRADING BUSINESS

7 LIQUID TANK FARM & DEEP SEA PORT

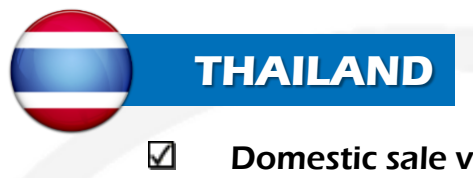
[picture p74: figure]
THAILAND

Domestic sale volume in Q2/2023 decreases 2.10% compare to the same period last year due to demand decreases

in all sectors which are Cooking, Automotive, and Industrial which decreases 2.7%, 0.2%, and 7.9% respectively.

Domestic sale volume of SGP increases 0.4% compare to the same period last year. Cooking gas drops 7.2% due to

competition from smaller traders. However, SGP manage to increase sale volume in Automotive and Industrial gas

at 2.4% and 24.5% respectively.

No LPG price lifting in Q2/2023 and the selling price of 15kg cylinder is remained Baht 423 per cylinder

# OVERSEA

CP price decreases USD 285 in Q2/2023.

Sales volume from Overseas is lower than the target due to lower sale from Offshore Trading

Offshore sale volume drop due to drop in spot sale market.

Sales volume in China increases 12.6% Q on Q.

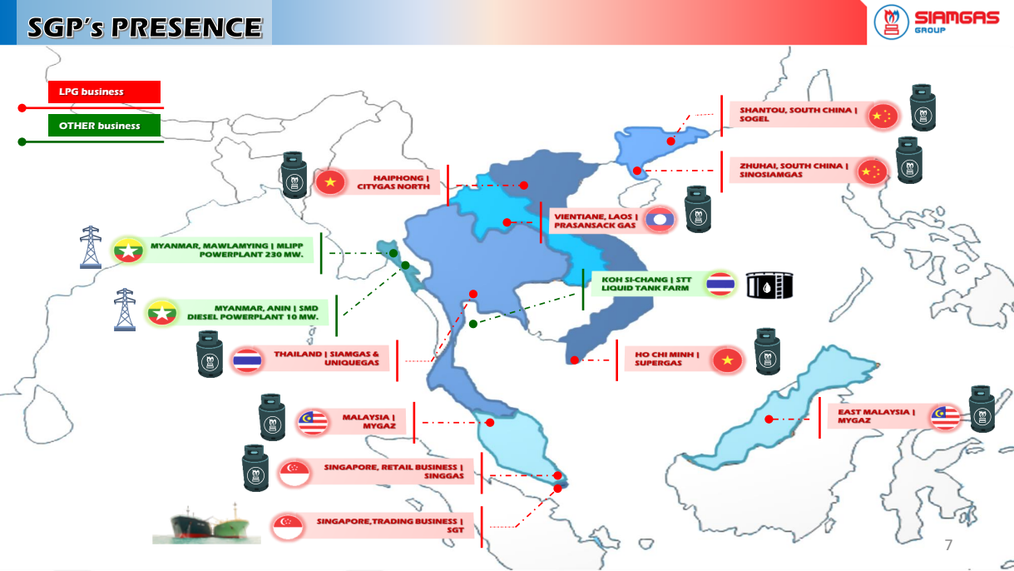
[picture p75: page 7]
OTHER business; LPG business

# 01 BUSINESS OVERVIEW

# AGENDA

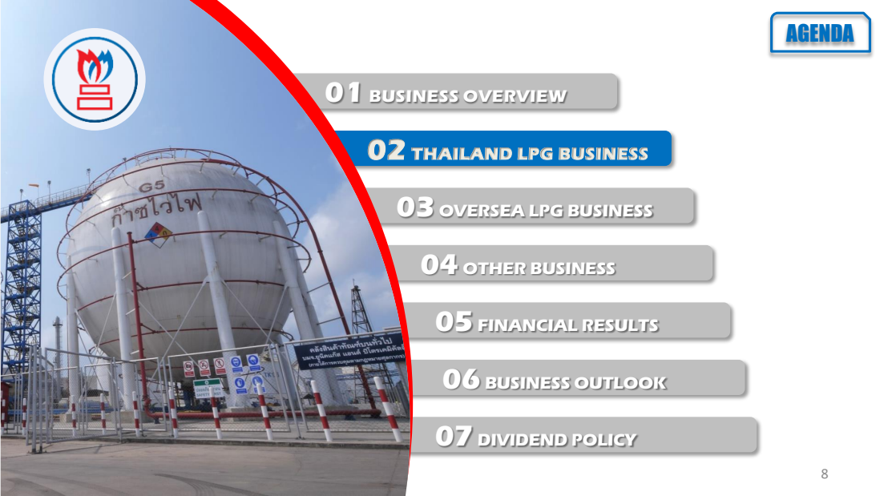
[picture p76: page 8]
04 OTHER BUSINESS; 05FINANCIAL RESULTS; 06 BUSINESS OUTLOOK; 07 DIVIDEND POLICY

02 THAILAND LPG BUSINESS

03 OVERSEA LPG BUSINESS

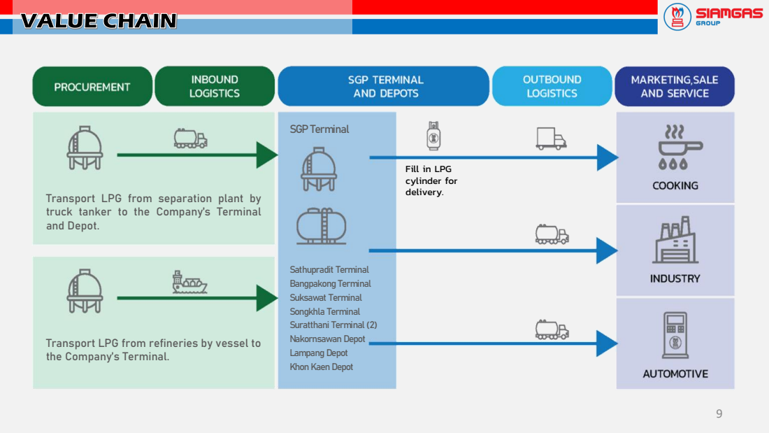
[picture p77: page 9]
SGP Terminal

Fill in LPG
cylinder for
delivery.

Transport LPG from separation plant by
truck tanker to the Company’s Terminal
and Depot.

Sathupradit Terminal
Bangpakong Terminal
Suksawat Terminal
Songkhla Terminal
Suratthani Terminal (2)
Nakornsawan Depot
Lampang Depot
Khon Kaen Depot

Transport LPG from refineries by vessel to
the Company’s Terminal.

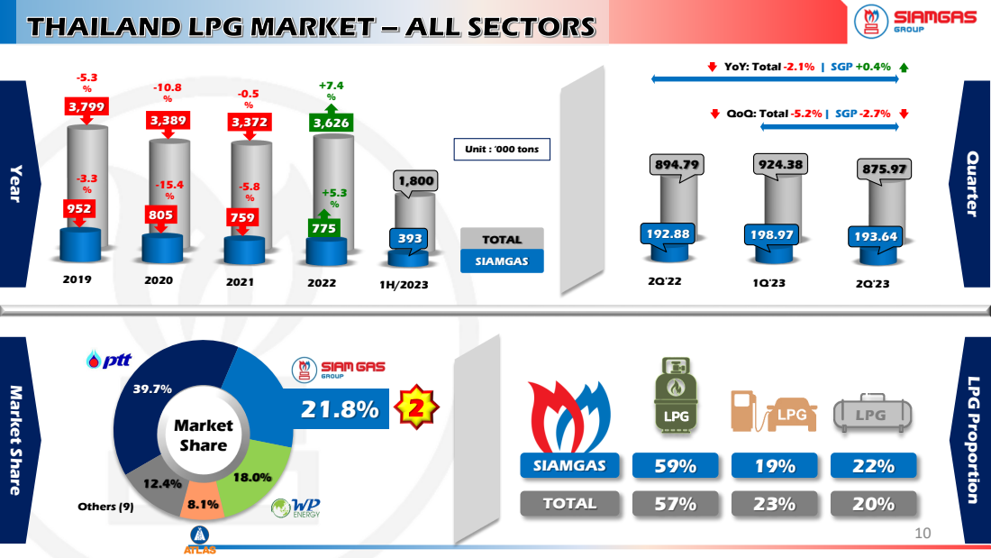
[picture p78: page 10]
Others (9); Year; Unit : ‘000 tons; Quarter; TOTAL; SIAMGAS; Market Share; LPG; LPG Proportion; 2 LPG

YoY: Total -2.1% | SGP +0.4%

QoQ: Total -5.2% | SGP -2.7%

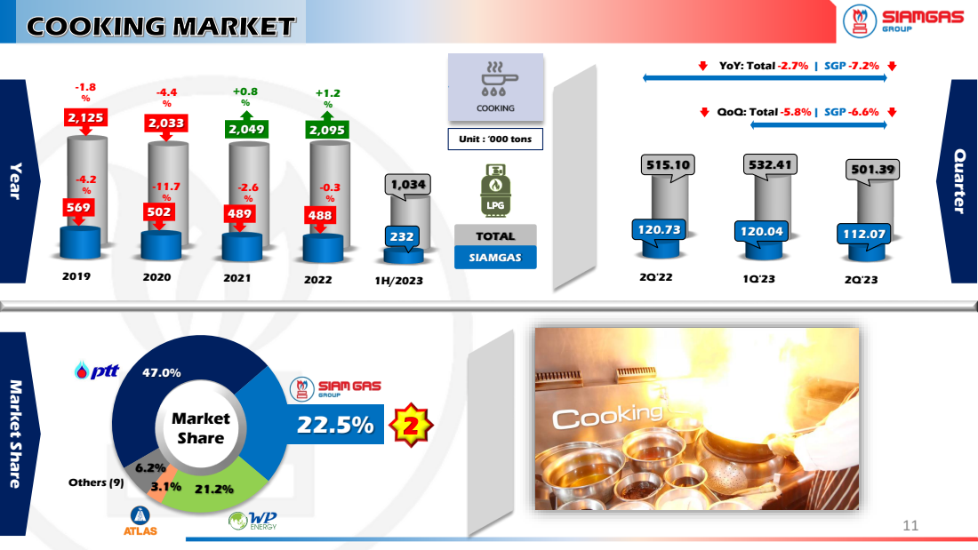
[picture p79: page 11]
Others (9); Year; Unit : ‘000 tons; TOTAL; SIAMGAS; Quarter; Market Share; LPG

YoY: Total -2.7% | SGP -7.2%

QoQ: Total -5.8% | SGP -6.6%

-2.3%-12.6 %
-24.5 % -26.4 %

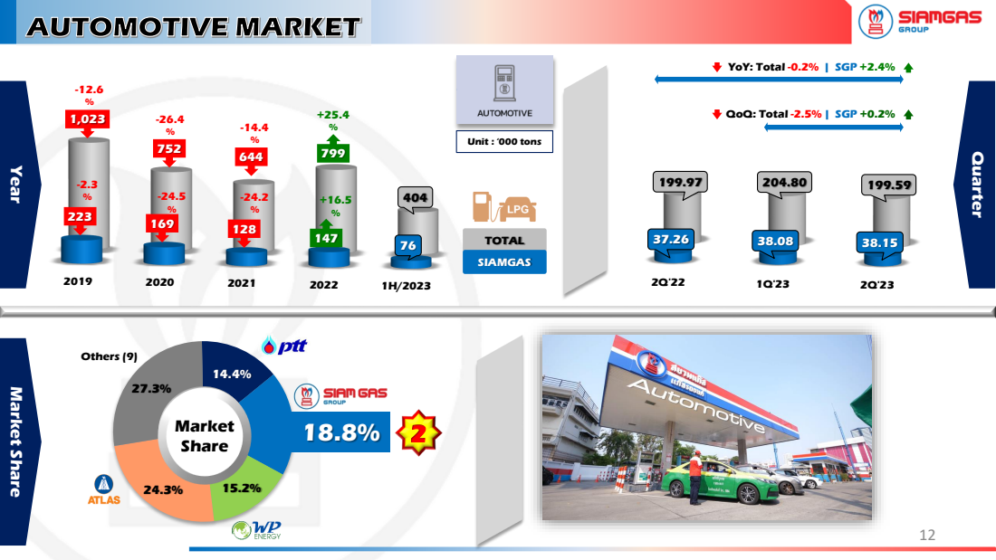
[picture p80: page 12]
Others (9); Year; Unit : ‘000 tons; TOTAL; SIAMGAS; QoQ: Total; -2.5% | SGP +0.2%; YoY: Total; -0.2% | SGP +2.4%; Quarter; Market Share

-1.4%-3.8%
-15.6 %-7.2%

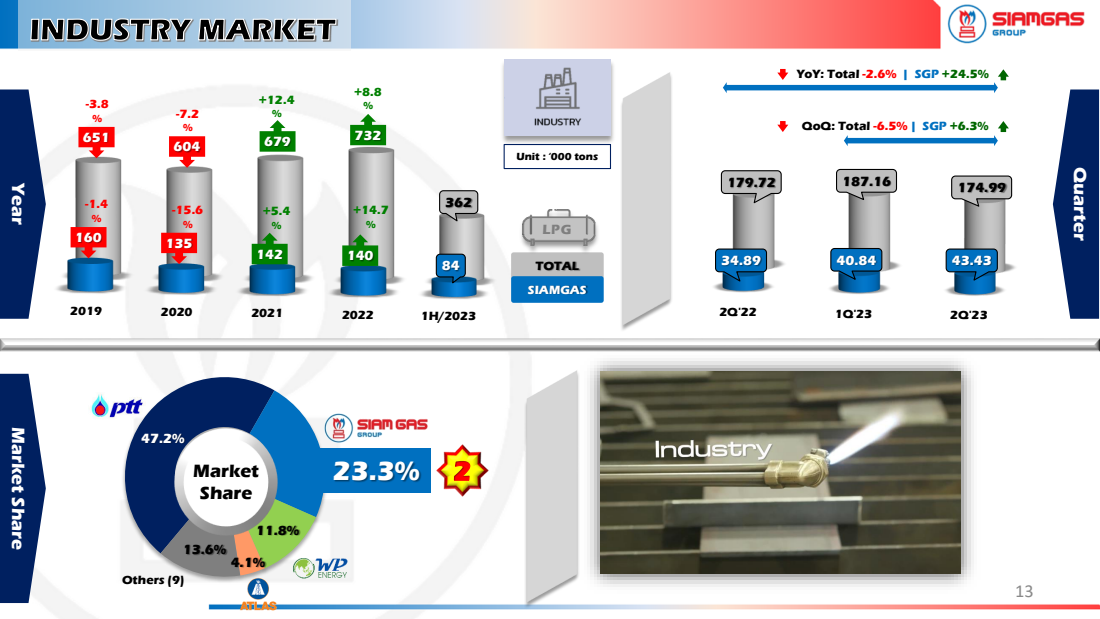
[picture p81: page 13]
Others (9); Year; Unit : ‘000 tons; TOTAL; SIAMGAS; QoQ: Total; -6.5% | SGP +6.3%; YoY: Total; 2.6% | SGP +24.5%; Quarter; Market Share; LPG

# 01 BUSINESS OVERVIEW

# AGENDA

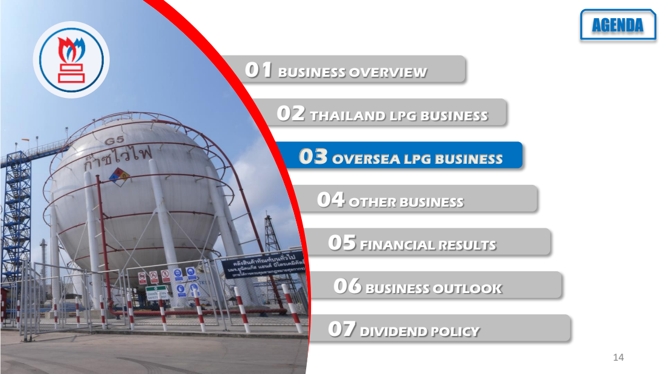
[picture p82: page 14]
04 OTHER BUSINESS; 05FINANCIAL RESULTS; 06 BUSINESS OUTLOOK; 07 DIVIDEND POLICY

02 THAILAND LPG BUSINESS

03 OVERSEA LPG BUSINESS

# LPG

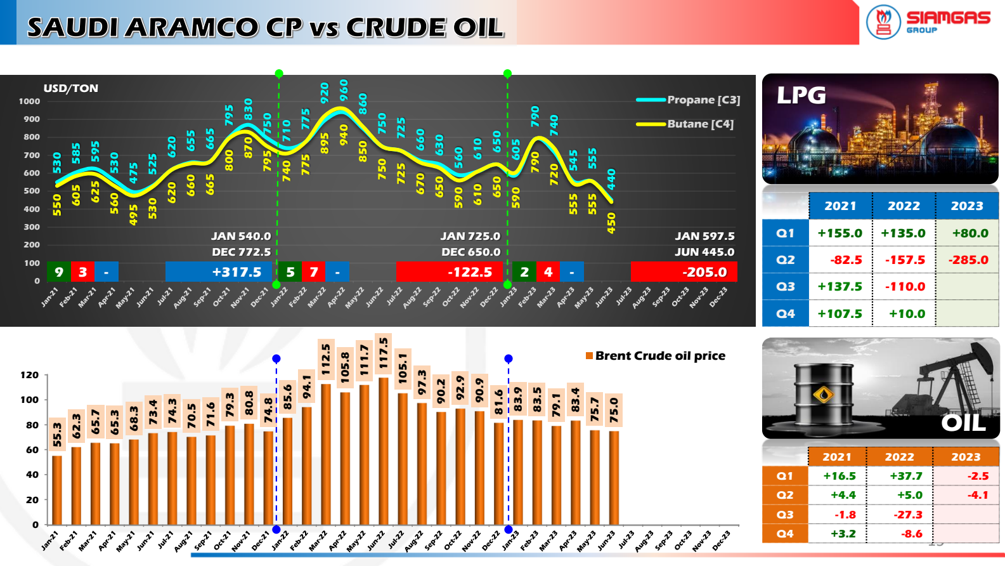
[picture p83: page 15]
1000 Propane [C3]; Butane [C4]; USD/TON; JAN 540.0; JAN 725.0; JAN 597.5; DEC 772.5; DEC 650.0; JUN 445.0; OIL

Brent Crude oil price

Q1 | +16.5 | +37.7 | -2.5
Q2 | +4.4 | +5.0 | -4.1
Q3 | -1.8 | -27.3
Q4 | +3.2 | -8.6

## USA

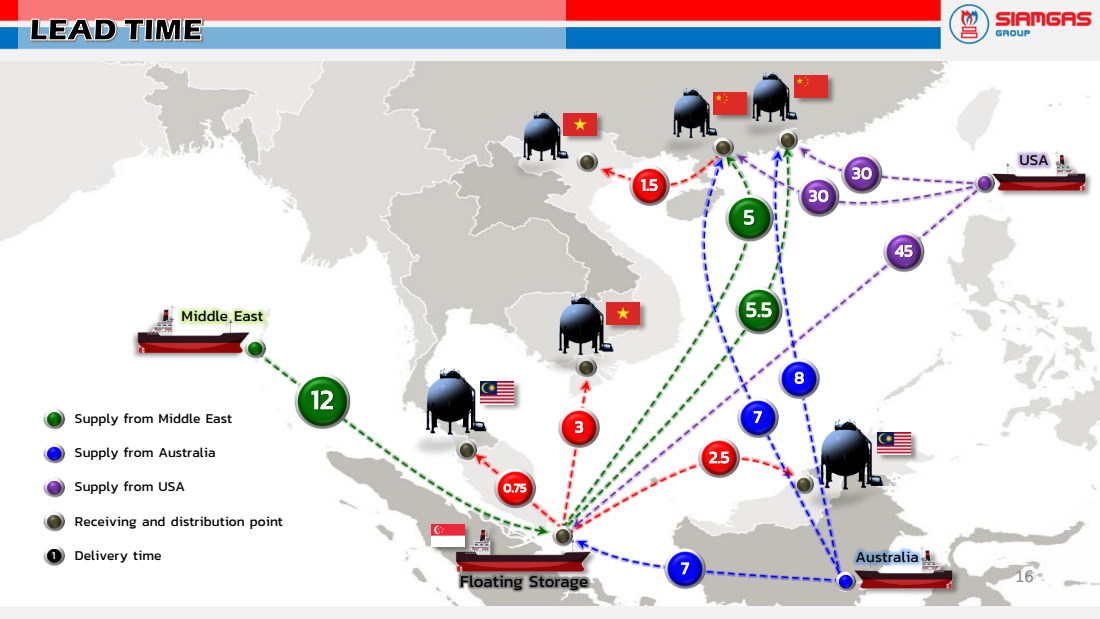
[picture p84: page 16]
Middle East; Australia; Floating Storage; Delivery time

Supply from Middle East

Supply from Australia

Supply from USA

Receiving and distribution point

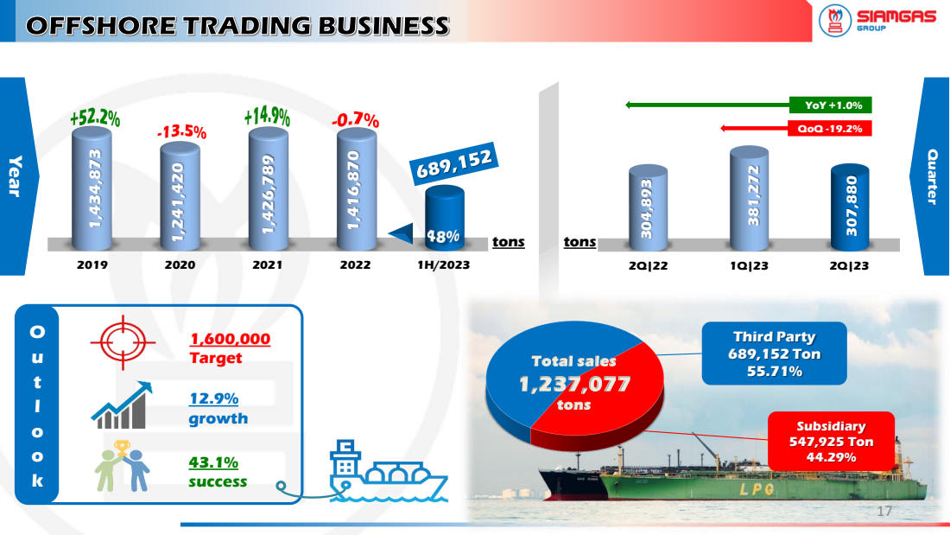
[picture p85: page 17]
Third Party 689,152 Ton 55.71%; tons; Outlook; 43.1% success; 1,600,000 Target; 12.9% growth; 2Q|23 ³⁰⁴,893; YoY +1.0%; QoQ; Quarter; Year; Subsidiary 547,925 Ton 44.29%; Total sales 1,237,077

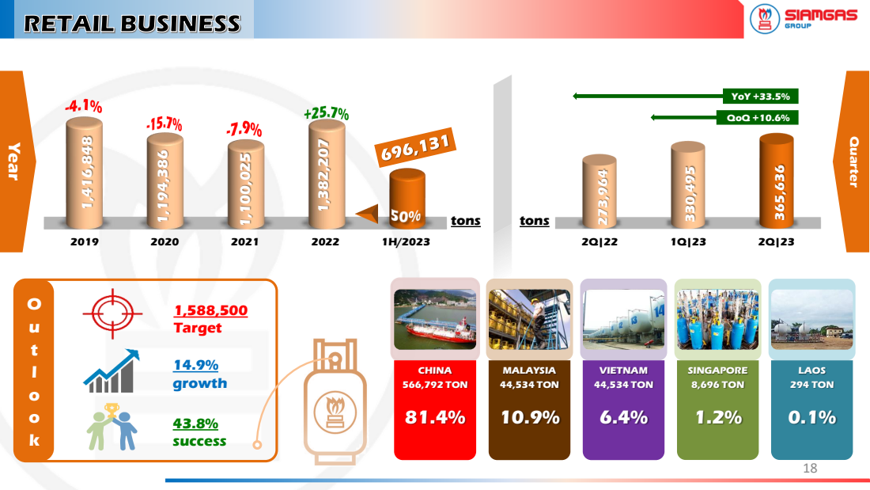
[picture p86: page 18]
Year; 43.8% success; 1,588,500 Target; 14.9% growth; 2Q|23 ²⁷³,964; Quarter; tons; YoY +33.5%; QoQ +10.6%; SINGAPORE; 8,696 TON; MALAYSIA; 44,534 TON; CHINA; 566,792 TON; VIETNAM; LAOS; 294 TON

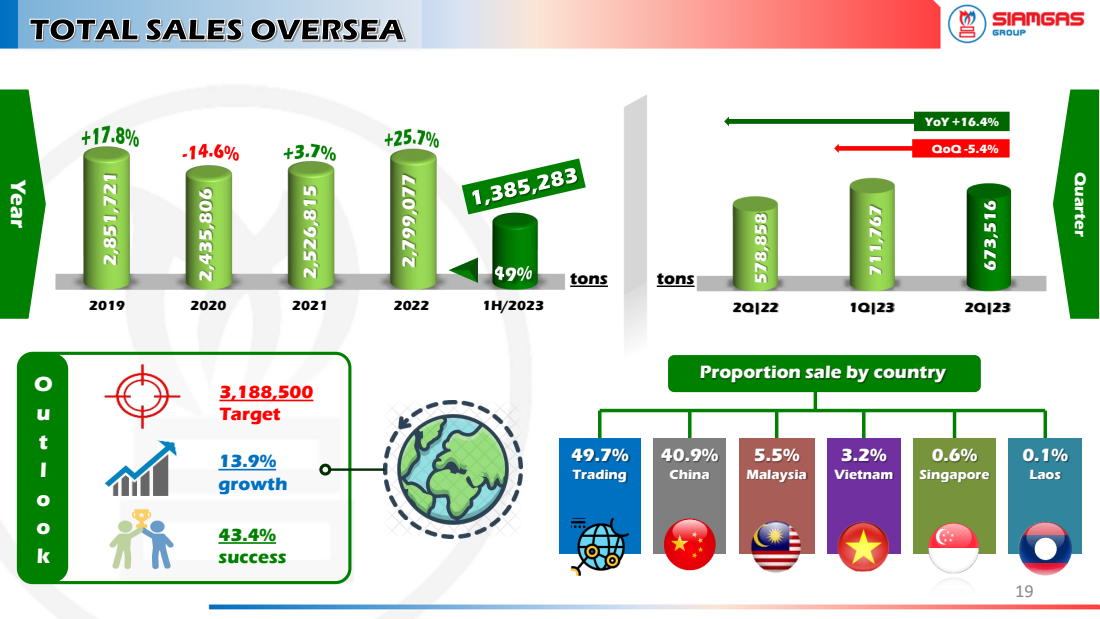
[picture p87: page 19]
Year; 2Q|23 ⁵⁷⁸,858; Quarter; tons; YoY +16.4%; QoQ -5.4%; 43.4% success; 3,188,500 Target; 13.9% growth; Laos; Trading; China; Malaysia; Vietnam; Singapore

Proportion sale by country

# 01 BUSINESS OVERVIEW

# AGENDA

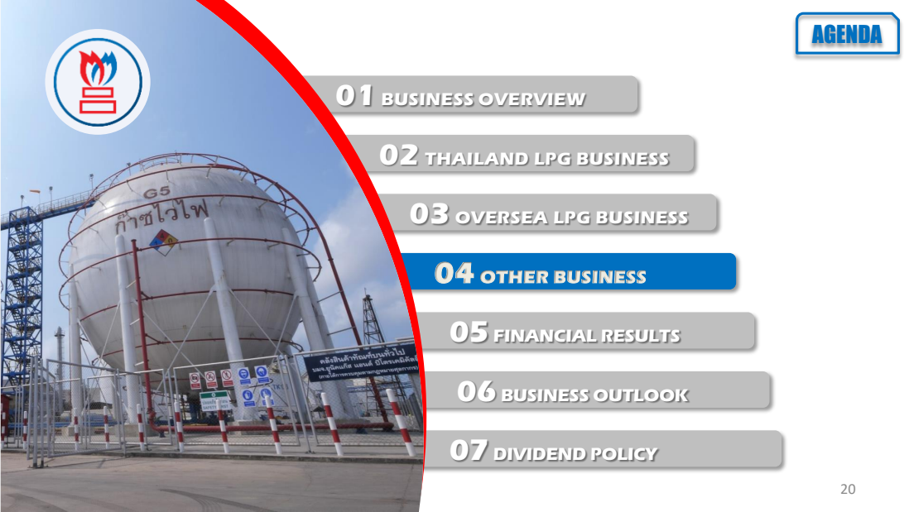
[picture p88: page 20]
04 OTHER BUSINESS; 05FINANCIAL RESULTS; 06 BUSINESS OUTLOOK; 07 DIVIDEND POLICY

02 THAILAND LPG BUSINESS

03 OVERSEA LPG BUSINESS

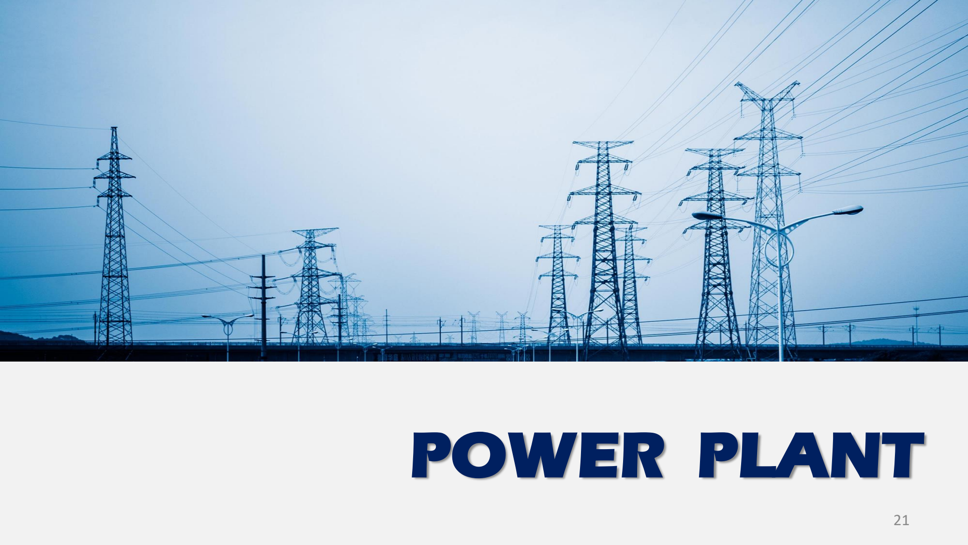
[picture p89: page 21]

# POWER PLANT

230 MW.

## COMBINE CYCLE POWERPLANT

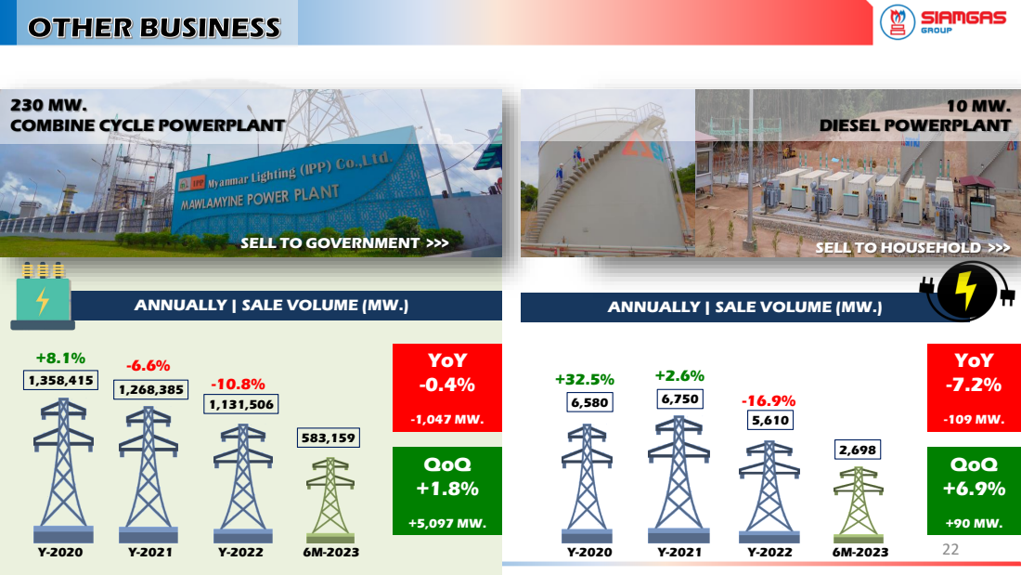
[picture p90: page 22]
YoY -0.4%; QoQ +1.8%; YoY -7.2%; QoQ +6.9%; ANNUALLY | SALE VOLUME (MW.); 10 MW. DIESEL POWERPLANT

SELL TO HOUSEHOLD >>>

SELL TO HOUSEHOLD >>> SELL TO GOVERNMENT >>>

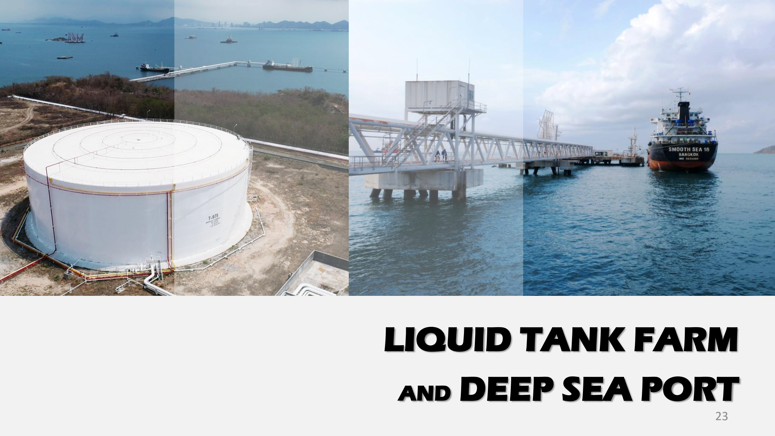
[picture p91: page 23]

# LIQUID TANK FARM AND DEEP SEA PORT

## LIQUID TANK FARM & DEEP SEA PORT SERVICE

## OIL TRADING OVERSEA BUSINESS

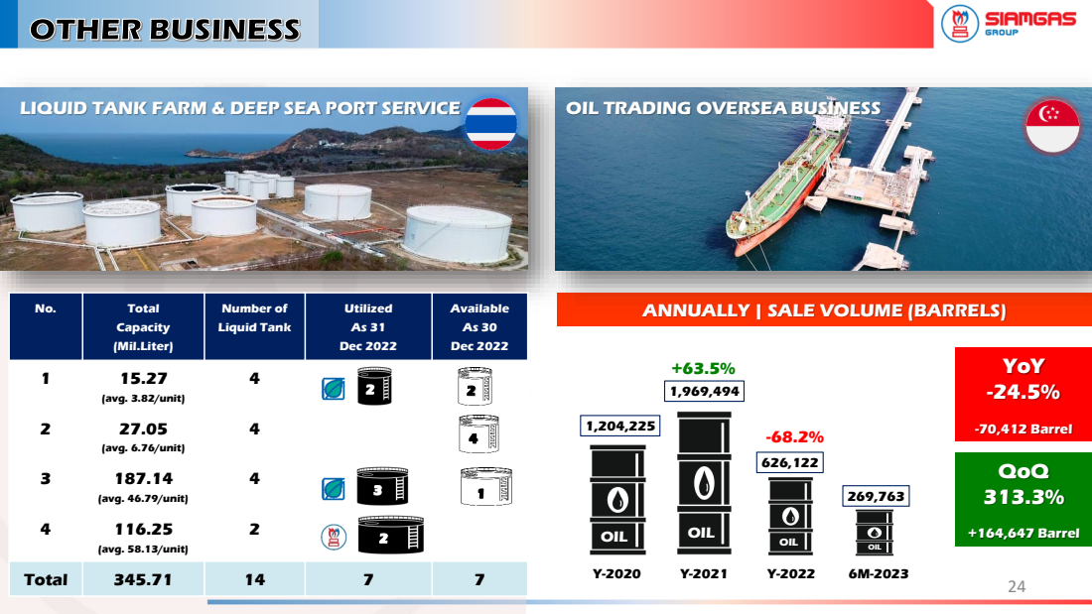
[picture p92: page 24]
YoY -24.5%; -70,412 Barrel; QoQ 313.3%; +164,647 Barrel; OIL

No. | Total Capacity (Mil.Liter) | Number of Liquid Tank | Utilized As 31 Dec 2022 | Available As 30 Dec 2022

ANNUALLY | SALE VOLUME (BARRELS)

1 15.27 | (avg. 3.82/unit) | 4 | 2 2

2 27.05 | (avg. 6.76/unit) | 4 | | 4

3 187.14 | (avg. 46.79/unit) | 4 | 3 1

4 116.25 | (avg. 58.13/unit) | 2 | 2

Total | 345.71 | 14 | 7 | 7

# 01 BUSINESS OVERVIEW

# AGENDA

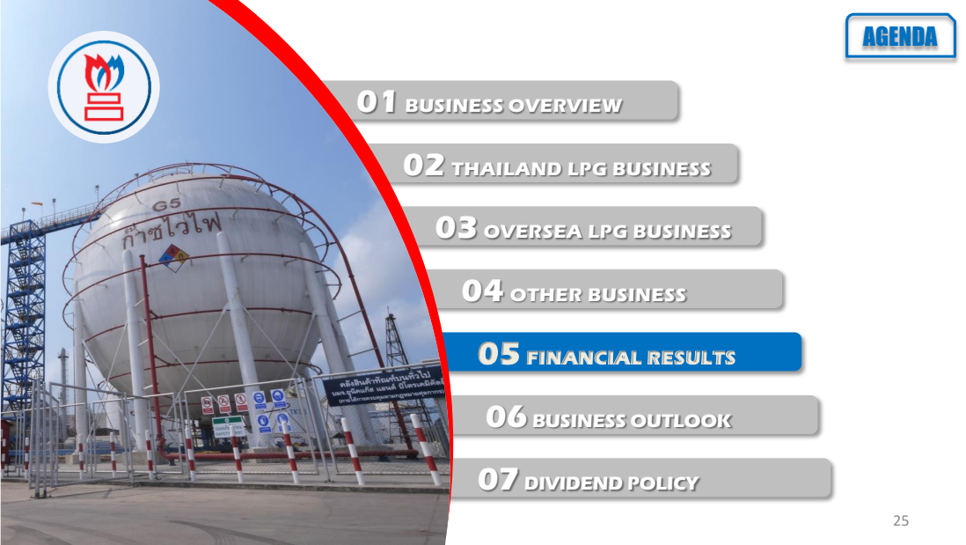
[picture p93: page 25]
04 OTHER BUSINESS; 05 FINANCIAL RESULTS; 06 BUSINESS OUTLOOK; 07 DIVIDEND POLICY

02 THAILAND LPG BUSINESS

03 OVERSEA LPG BUSINESS

## Thailand 18.0%

1H/2022

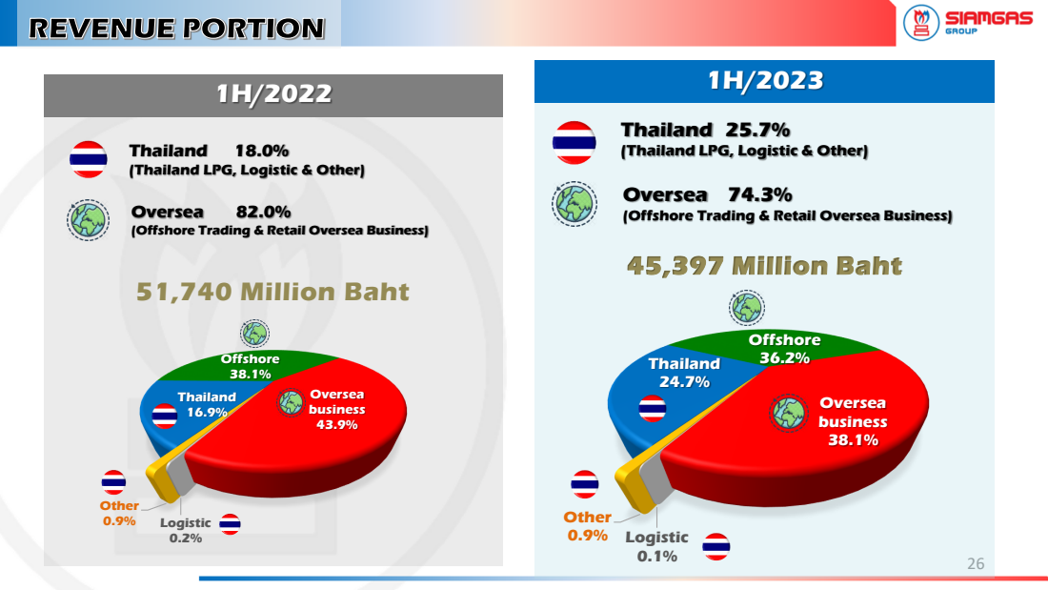
[picture p94: page 26]
Thailand 16.9%; Offshore 38.1%; Oversea business 43.9%; Logistic 0.2%; Other 0.9%; Oversea; 51,740 Million Baht; Thailand 24.7%; Offshore 36.2%; Oversea business 38.1%; Logistic 0.1%

Thailand 25.7%
(Thailand LPG, Logistic & Other)

Oversea 74.3%
(Offshore Trading & Retail Oversea Business)
45,397 Million Baht

# 1H/2023 Consolidated REVENUE of Bt.45,397 m shows a -12.3% yoy decline

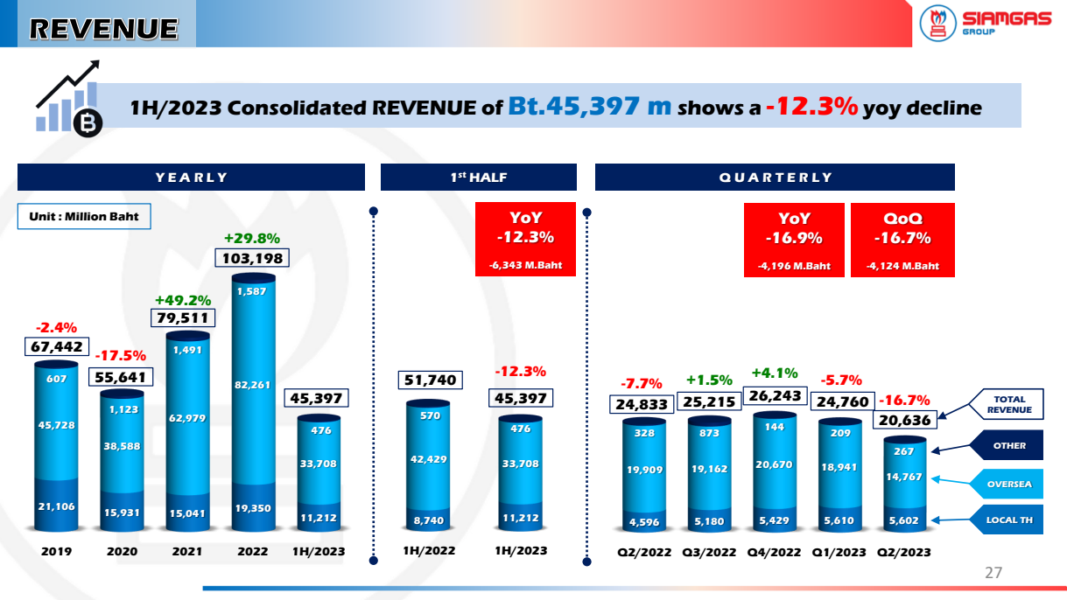
[picture p95: page 27]
YoY -16.9%; -4,196 M.Baht; QoQ -16.7%; -4,124 M.Baht; 1st HALF; YoY -12.3%; -6,343 M.Baht; LOCAL TH; OVERSEA; OTHER; TOTAL REVENUE

Unit : Million Baht

# 1H/2023 Consolidated EBITDA of Bt.46 m shows a -98.1% yoy decline

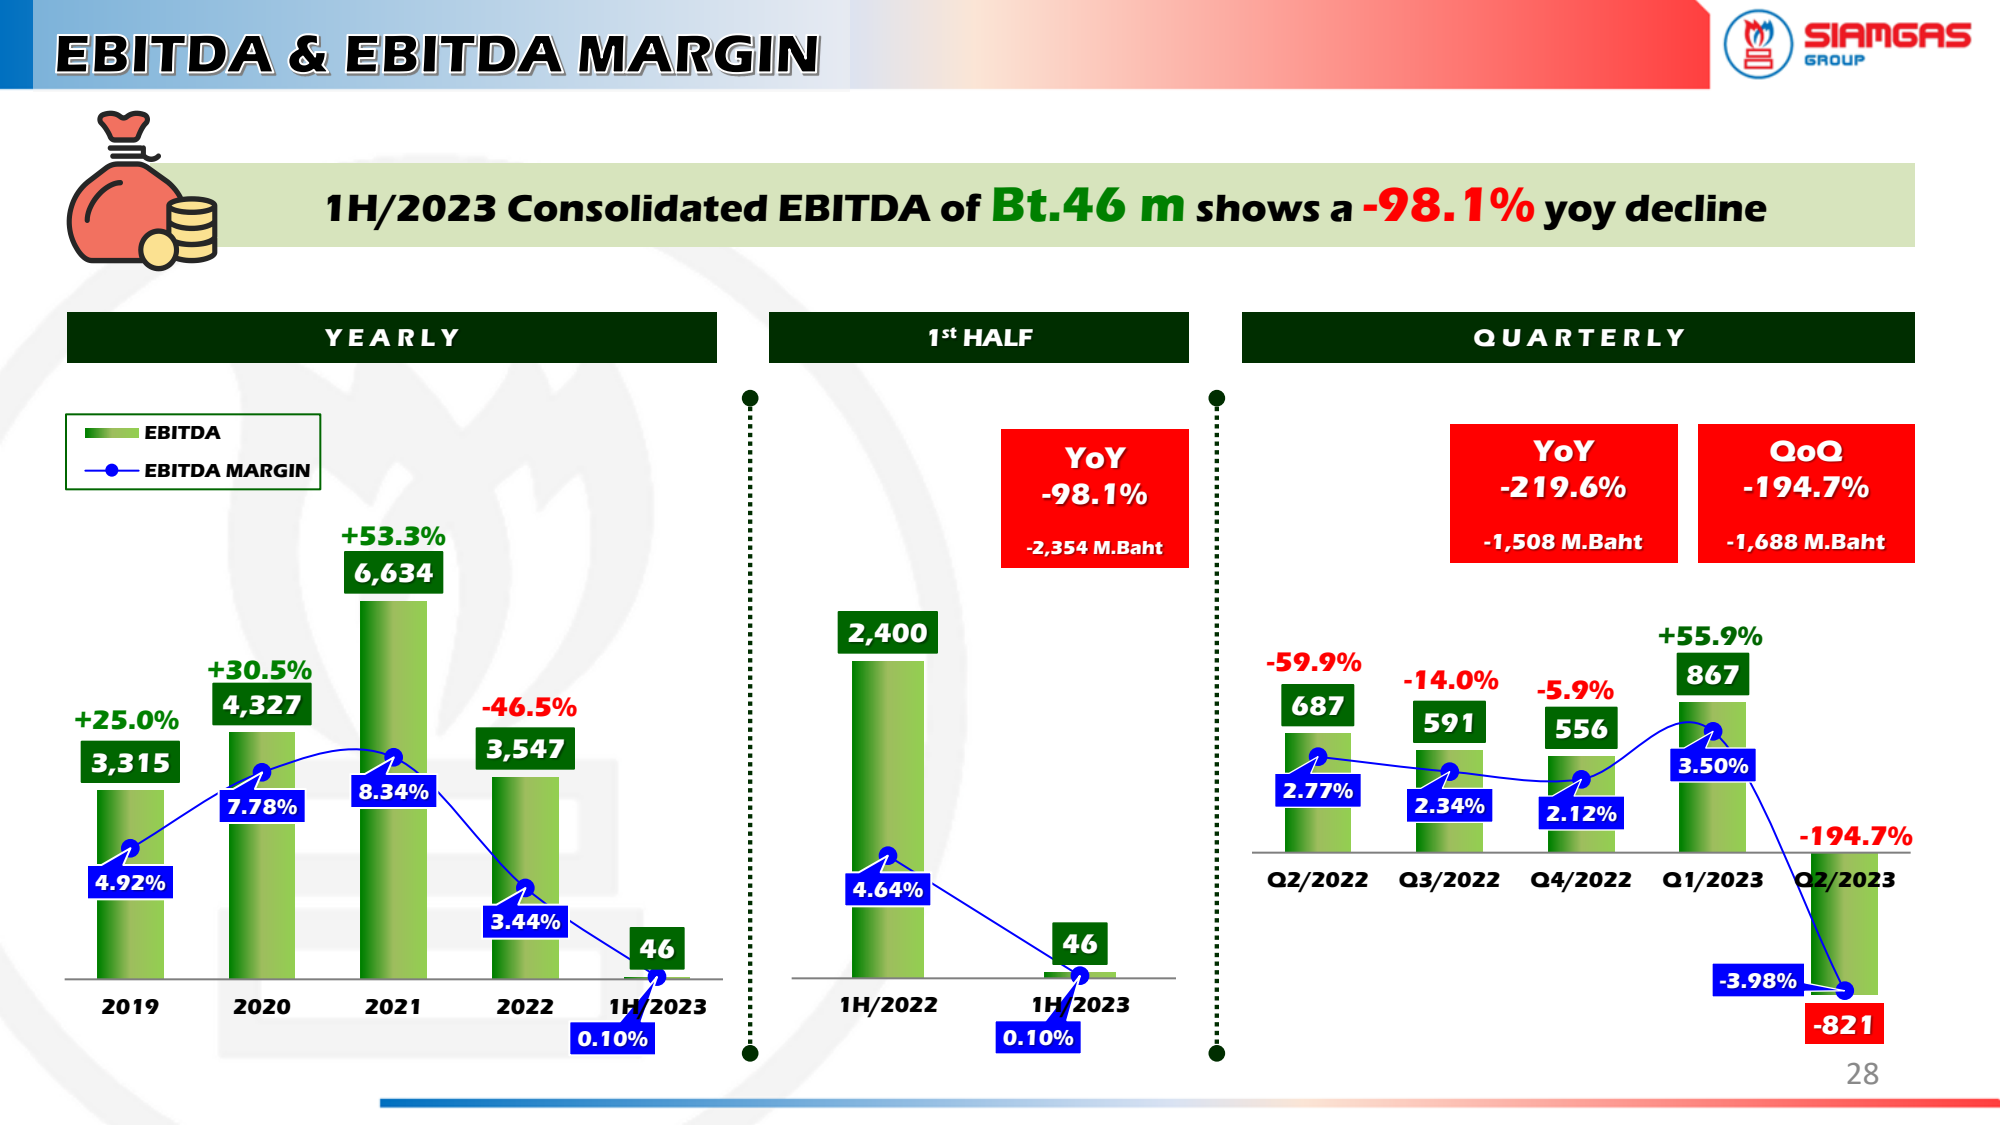
[picture p96: page 28]
EBITDA; EBITDA MARGIN; YoY -219.6%; -1,508 M.Baht; QoQ -194.7%; -1,688 M.Baht; 1st HALF; YoY -98.1%; -2,354 M.Baht

# 1H/2023 Consolidated NET PROFIT of Bt. -971 m shows a -183.3% yoy decline

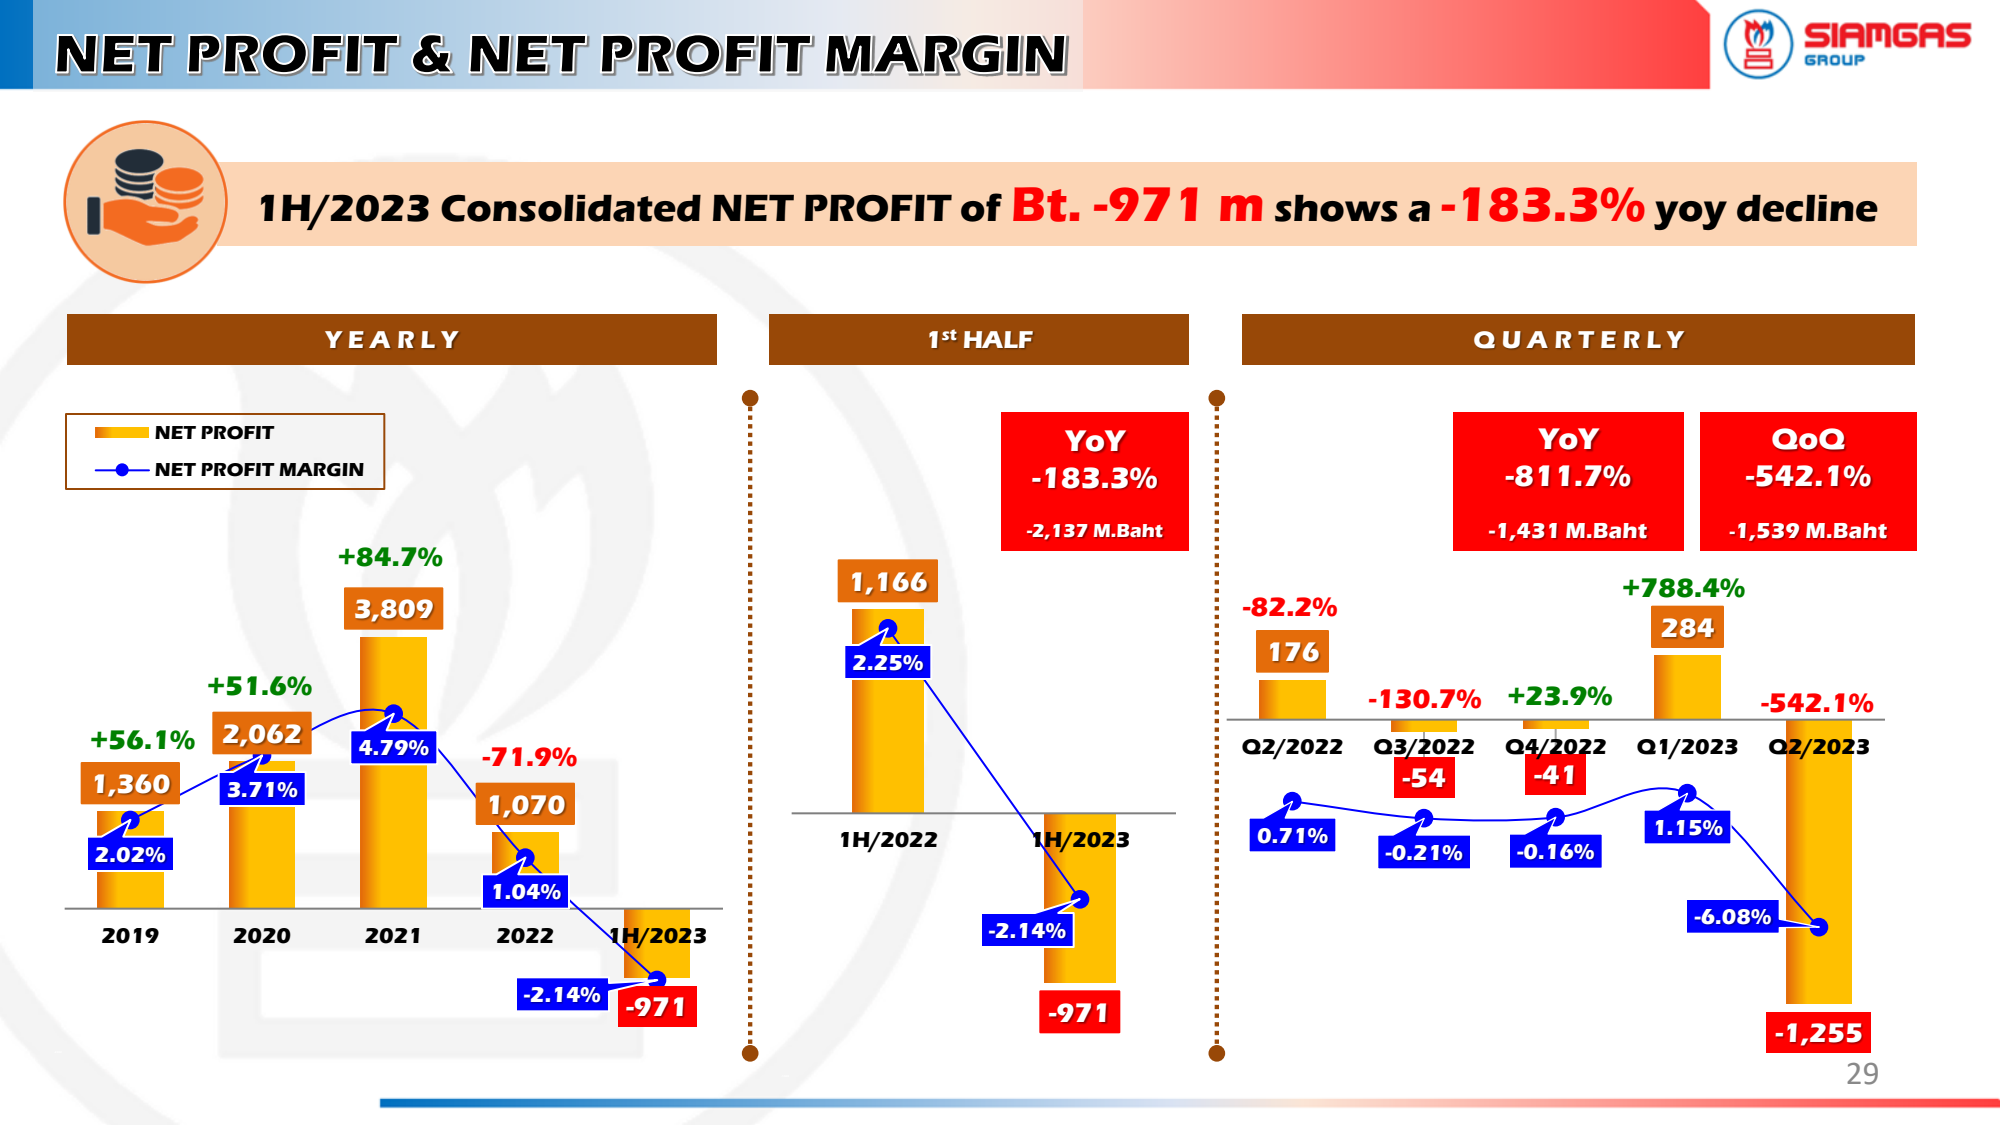
[picture p97: page 29]
NET PROFIT; YoY -811.7%; -1,431 M.Baht; QoQ -542.1%; -1,539 M.Baht; 1st HALF; YoY -183.3%; -2,137 M.Baht

NET PROFIT MARGIN

ASSET (THB Million) | LIABILITIES (THB Million)

### EQUITY (THB Million)

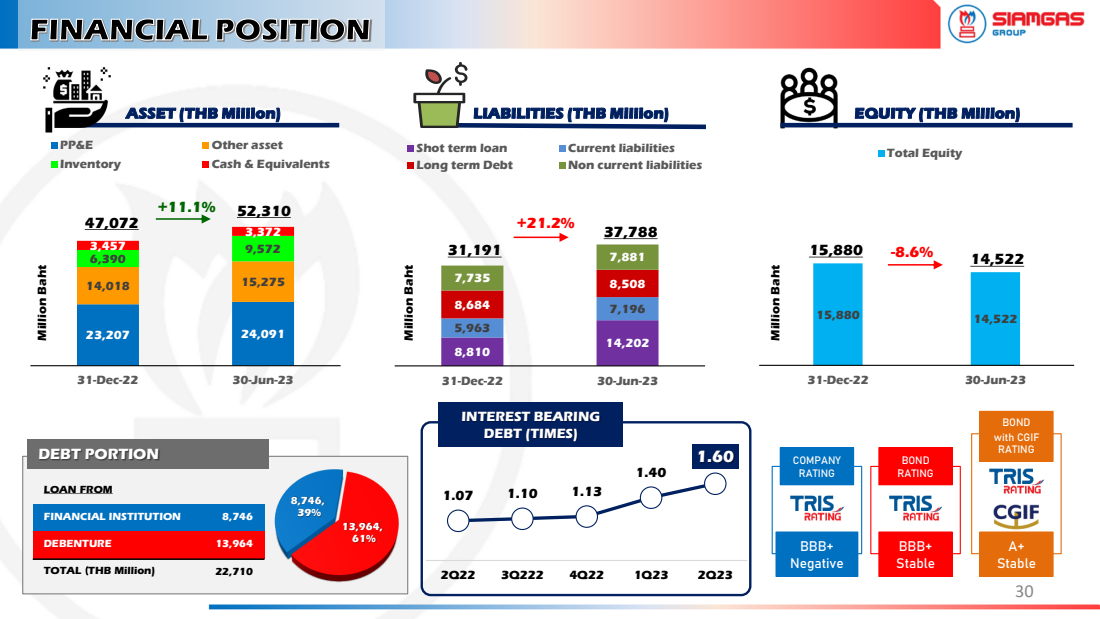
[picture p98: page 30]
31-Dec-22; 30-Jun-23; Other asset; Inventory; Cash & Equivalents; Total Equity; Shot term loan; Current liabilities; Long term Debt; Non current liabilities; DEBT PORTION; LOAN FROM; FINANCIAL INSTITUTION; DEBENTURE; TOTAL THB Million); COMPANY RATING; BBB+ Negative; INTEREST BEARING DEBT (TIMES); Million Baht; BOND RATING; BBB+ Stable; BOND with CGIF RATING; A+ Stable

# 01 BUSINESS OVERVIEW

# AGENDA

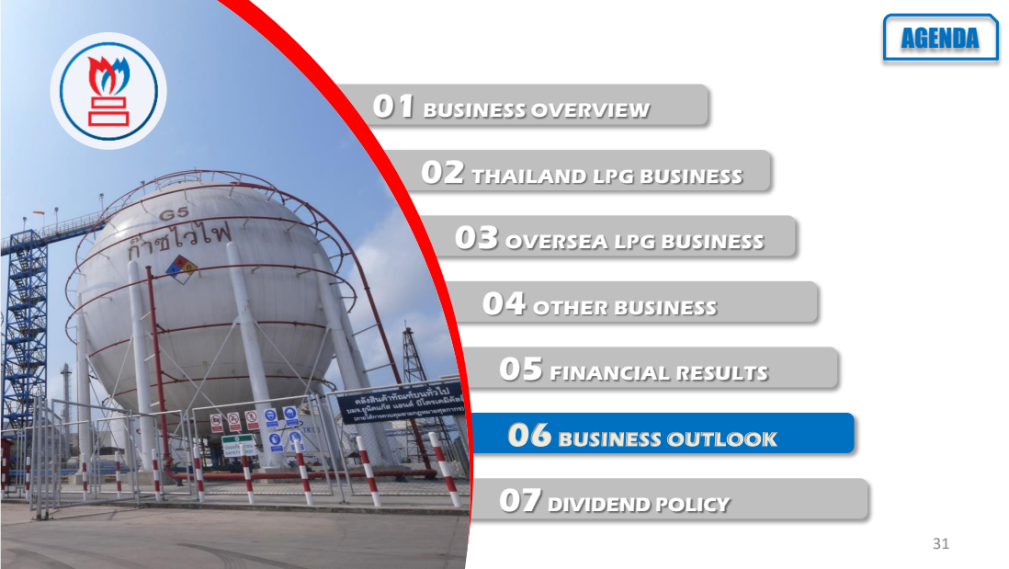
[picture p99: page 31]
04 OTHER BUSINESS; 05 FINANCIAL RESULTS; 06 BUSINESS OUTLOOK; 07 DIVIDEND POLICY

02 THAILAND LPG BUSINESS

03 OVERSEA LPG BUSINESS

### OUTLOOK

## LPG Sales Volume (Tons)

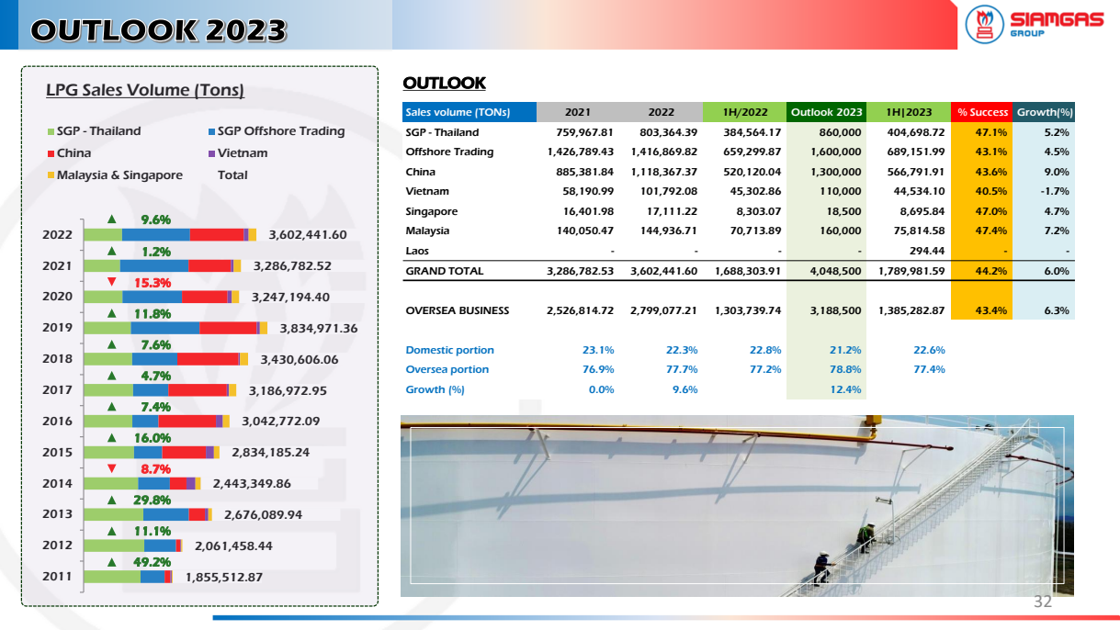
[picture p100: page 32]
SGP - Thailand; SGP Offshore Trading; China; Vietnam; Malaysia & Singapore; Total; Sales volume (TONs); Outlook 2023; % Success Growth(%); Offshore Trading; Singapore; Malaysia; Laos; GRAND TOTAL; OVERSEA BUSINESS; Domestic portion; Oversea portion; Growth (%)

# 01 BUSINESS OVERVIEW

# AGENDA

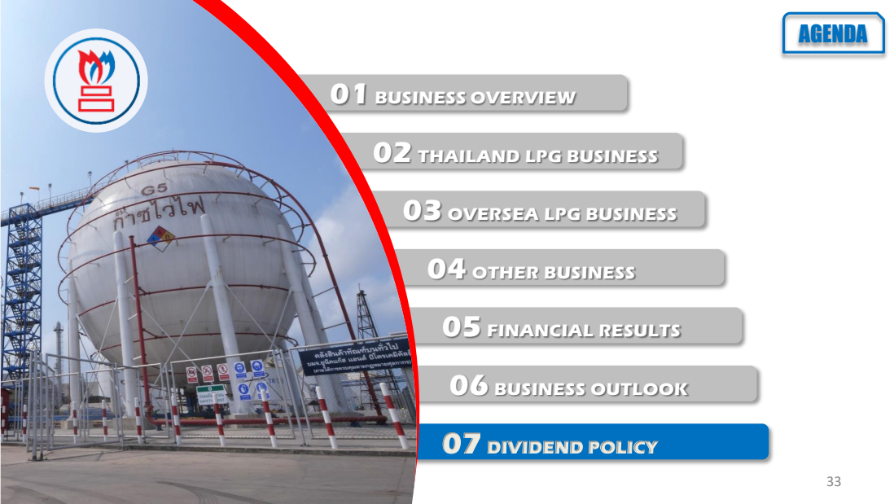
[picture p101: page 33]
04 OTHER BUSINESS; 05 FINANCIAL RESULTS; 06 BUSINESS OUTLOOK; 07 DIVIDEND POLICY

02 THAILAND LPG BUSINESS

03 OVERSEA LPG BUSINESS

## DIVIDEND POLICY

The Company has established the policy to pay

dividends to the shareholders at the rate of

not less than 40% of the net profit after

corporate | income | tax, | accumulated | loss

brought forward (if any) and appropriation of

statutory reserve in accordance with the

Company’s separate financial statements.

However, the Board of Directors may set the

rate of dividend less than the one mentioned

above depending on the operating results,

financial situation, liquidity and the necessity

to expand the operation as well as the reserve

on circulating capital of the operating of the

organization.

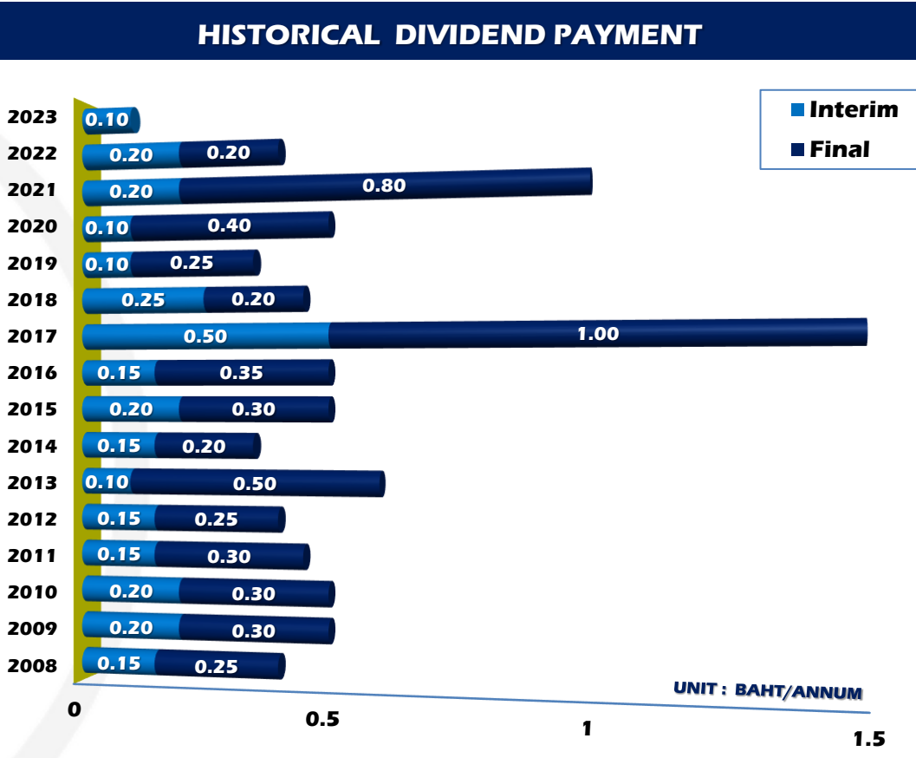
[picture p102: figure]
Interim; Final; HISTORICAL DIVIDEND PAYMENT

SGP split par from Baht 1.00 to Baht 0.50 in May 2018

# THANK YOU

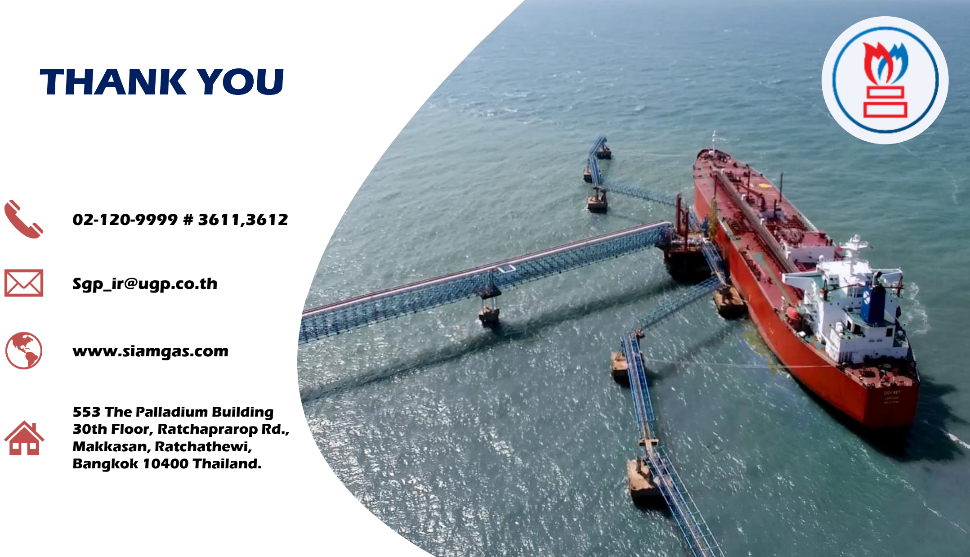
[picture p103: page 35]

02-120-9999 # 3611,3612

## Sgp_ir@ugp.co.th

## www.siamgas.com

## 553 The Palladium Building

30th Floor, Ratchaprarop Rd., Makkasan, Ratchathewi,
Bangkok 10400 Thailand.
