cyc292cycjin-oss/SGP-ESE5004-Stage2/research/02_sector_coupling/buildings_heat/phase3a5/ASEAN_BUILDINGS_ENDUSE_EVIDENCE_MATRIX.csv

Country | Sector | FuelGroup | space_evidence | water_evidence | cooking_evidence | cooling_evidence | other_evidence | unclassified_evidence | FinalEnergyCandidateRows | CookingDestination | SourceIDs | Coverage | Blocker | Status | HumanConfirmation
BN | Residential | electricity | UNKNOWN | UNKNOWN | UNKNOWN | UNKNOWN | UNKNOWN | E3C0071 | E3C0071 | Unclassified | UNSD_UNdata_Export_20250502_110820872 | See row-specific geography; local samples and national totals must not be added | Fuel totals do not imply end-use shares; missing cells are unknown, not zero | UNVERIFIED | PENDING
BN | Residential | gas | UNKNOWN | UNKNOWN | UNKNOWN | UNKNOWN | UNKNOWN | E3C0063 | E3C0063 | Unclassified | UNSD_UNdata_Export_20250502_110721508 | See row-specific geography; local samples and national totals must not be added | Fuel totals do not imply end-use shares; missing cells are unknown, not zero | UNVERIFIED | PENDING
BN | Residential | LPG/oil | UNKNOWN | UNKNOWN | UNKNOWN | UNKNOWN | UNKNOWN | E3C0034; E3C0042 | E3C0034; E3C0042 | Unclassified | UNSD_UNdata_Export_20250502_110559984; UNSD_UNdata_Export_20250502_110656973 | See row-specific geography; local samples and national totals must not be added | Fuel totals do not imply end-use shares; missing cells are unknown, not zero | UNVERIFIED | PENDING
BN | Residential | biomass | UNKNOWN | UNKNOWN | UNKNOWN | UNKNOWN | UNKNOWN | E3C0005; E3C0022 | E3C0005; E3C0022 | Unclassified | UNSD_UNdata_Export_20250502_110403305; UNSD_UNdata_Export_20250502_110532316 | See row-specific geography; local samples and national totals must not be added | Fuel totals do not imply end-use shares; missing cells are unknown, not zero | UNVERIFIED | PENDING
BN | Residential | coal | UNKNOWN | UNKNOWN | UNKNOWN | UNKNOWN | UNKNOWN | UNKNOWN |  | Unclassified |  | See row-specific geography; local samples and national totals must not be added | Fuel totals do not imply end-use shares; missing cells are unknown, not zero | UNVERIFIED | PENDING
BN | Residential | heat commodity | UNKNOWN | UNKNOWN | UNKNOWN | UNKNOWN | UNKNOWN | UNKNOWN |  | Unclassified |  | See row-specific geography; local samples and national totals must not be added | Fuel totals do not imply end-use shares; missing cells are unknown, not zero | UNVERIFIED | PENDING
BN | Residential | others | UNKNOWN | UNKNOWN | UNKNOWN | UNKNOWN | UNKNOWN | UNKNOWN |  | Unclassified |  | See row-specific geography; local samples and national totals must not be added | Fuel totals do not imply end-use shares; missing cells are unknown, not zero | UNVERIFIED | PENDING
BN | Services | electricity | UNKNOWN | UNKNOWN | UNKNOWN | UNKNOWN | UNKNOWN | E3C0072 | E3C0072 | Unclassified | UNSD_UNdata_Export_20250502_110820872 | See row-specific geography; local samples and national totals must not be added | Fuel totals do not imply end-use shares; missing cells are unknown, not zero | UNVERIFIED | PENDING
BN | Services | gas | UNKNOWN | UNKNOWN | UNKNOWN | UNKNOWN | UNKNOWN | UNKNOWN |  | Unclassified |  | See row-specific geography; local samples and national totals must not be added | Fuel totals do not imply end-use shares; missing cells are unknown, not zero | UNVERIFIED | PENDING
BN | Services | LPG/oil | UNKNOWN | UNKNOWN | UNKNOWN | UNKNOWN | UNKNOWN | UNKNOWN |  | Unclassified |  | See row-specific geography; local samples and national totals must not be added | Fuel totals do not imply end-use shares; missing cells are unknown, not zero | UNVERIFIED | PENDING
BN | Services | biomass | UNKNOWN | UNKNOWN | UNKNOWN | UNKNOWN | UNKNOWN | UNKNOWN |  | Unclassified |  | See row-specific geography; local samples and national totals must not be added | Fuel totals do not imply end-use shares; missing cells are unknown, not zero | UNVERIFIED | PENDING
BN | Services | coal | UNKNOWN | UNKNOWN | UNKNOWN | UNKNOWN | UNKNOWN | UNKNOWN |  | Unclassified |  | See row-specific geography; local samples and national totals must not be added | Fuel totals do not imply end-use shares; missing cells are unknown, not zero | UNVERIFIED | PENDING
BN | Services | heat commodity | UNKNOWN | UNKNOWN | UNKNOWN | UNKNOWN | UNKNOWN | UNKNOWN |  | Unclassified |  | See row-specific geography; local samples and national totals must not be added | Fuel totals do not imply end-use shares; missing cells are unknown, not zero | UNVERIFIED | PENDING
BN | Services | others | UNKNOWN | UNKNOWN | UNKNOWN | UNKNOWN | UNKNOWN | UNKNOWN |  | Unclassified |  | See row-specific geography; local samples and national totals must not be added | Fuel totals do not imply end-use shares; missing cells are unknown, not zero | UNVERIFIED | PENDING
KH | Residential | electricity | UNKNOWN | UNKNOWN | UNKNOWN | UNKNOWN | UNKNOWN | E3C0073 | E3C0073 | Unclassified | UNSD_UNdata_Export_20250502_110820872 | See row-specific geography; local samples and national totals must not be added | Fuel totals do not imply end-use shares; missing cells are unknown, not zero | UNVERIFIED | PENDING
KH | Residential | gas | UNKNOWN | UNKNOWN | UNKNOWN | UNKNOWN | UNKNOWN | UNKNOWN |  | Unclassified |  | See row-specific geography; local samples and national totals must not be added | Fuel totals do not imply end-use shares; missing cells are unknown, not zero | UNVERIFIED | PENDING
KH | Residential | LPG/oil | UNKNOWN | UNKNOWN | UNKNOWN | UNKNOWN | UNKNOWN | E3C0043 | E3C0043 | Unclassified | UNSD_UNdata_Export_20250502_110656973 | See row-specific geography; local samples and national totals must not be added | Fuel totals do not imply end-use shares; missing cells are unknown, not zero | UNVERIFIED | PENDING
KH | Residential | biomass | UNKNOWN | UNKNOWN | UNKNOWN | UNKNOWN | UNKNOWN | E3C0006; E3C0023 | E3C0006; E3C0023 | Unclassified | UNSD_UNdata_Export_20250502_110403305; UNSD_UNdata_Export_20250502_110532316 | See row-specific geography; local samples and national totals must not be added | Fuel totals do not imply end-use shares; missing cells are unknown, not zero | UNVERIFIED | PENDING
KH | Residential | coal | UNKNOWN | UNKNOWN | UNKNOWN | UNKNOWN | UNKNOWN | UNKNOWN |  | Unclassified |  | See row-specific geography; local samples and national totals must not be added | Fuel totals do not imply end-use shares; missing cells are unknown, not zero | UNVERIFIED | PENDING
KH | Residential | heat commodity | UNKNOWN | UNKNOWN | UNKNOWN | UNKNOWN | UNKNOWN | UNKNOWN |  | Unclassified |  | See row-specific geography; local samples and national totals must not be added | Fuel totals do not imply end-use shares; missing cells are unknown, not zero | UNVERIFIED | PENDING
KH | Residential | others | E3C0139 | E3C0111; E3C0117 | E3C0125; E3C0131 | UNKNOWN | UNKNOWN | UNKNOWN |  | Unclassified | ERIA_PILOT2013 | See row-specific geography; local samples and national totals must not be added | Fuel totals do not imply end-use shares; missing cells are unknown, not zero | UNVERIFIED | PENDING
KH | Services | electricity | UNKNOWN | UNKNOWN | UNKNOWN | UNKNOWN | UNKNOWN | E3C0074 | E3C0074 | Unclassified | UNSD_UNdata_Export_20250502_110820872 | See row-specific geography; local samples and national totals must not be added | Fuel totals do not imply end-use shares; missing cells are unknown, not zero | UNVERIFIED | PENDING
KH | Services | gas | UNKNOWN | UNKNOWN | UNKNOWN | UNKNOWN | UNKNOWN | UNKNOWN |  | Unclassified |  | See row-specific geography; local samples and national totals must not be added | Fuel totals do not imply end-use shares; missing cells are unknown, not zero | UNVERIFIED | PENDING
KH | Services | LPG/oil | UNKNOWN | UNKNOWN | UNKNOWN | UNKNOWN | UNKNOWN | E3C0044 | E3C0044 | Unclassified | UNSD_UNdata_Export_20250502_110656973 | See row-specific geography; local samples and national totals must not be added | Fuel totals do not imply end-use shares; missing cells are unknown, not zero | UNVERIFIED | PENDING
KH | Services | biomass | UNKNOWN | UNKNOWN | UNKNOWN | UNKNOWN | UNKNOWN | UNKNOWN |  | Unclassified |  | See row-specific geography; local samples and national totals must not be added | Fuel totals do not imply end-use shares; missing cells are unknown, not zero | UNVERIFIED | PENDING
KH | Services | coal | UNKNOWN | UNKNOWN | UNKNOWN | UNKNOWN | UNKNOWN | UNKNOWN |  | Unclassified |  | See row-specific geography; local samples and national totals must not be added | Fuel totals do not imply end-use shares; missing cells are unknown, not zero | UNVERIFIED | PENDING
KH | Services | heat commodity | UNKNOWN | UNKNOWN | UNKNOWN | UNKNOWN | UNKNOWN | UNKNOWN |  | Unclassified |  | See row-specific geography; local samples and national totals must not be added | Fuel totals do not imply end-use shares; missing cells are unknown, not zero | UNVERIFIED | PENDING
KH | Services | others | UNKNOWN | UNKNOWN | UNKNOWN | UNKNOWN | UNKNOWN | UNKNOWN |  | Unclassified |  | See row-specific geography; local samples and national totals must not be added | Fuel totals do not imply end-use shares; missing cells are unknown, not zero | UNVERIFIED | PENDING
ID | Residential | electricity | UNKNOWN | UNKNOWN | UNKNOWN | UNKNOWN | UNKNOWN | E3C0075 | E3C0075 | Unclassified | UNSD_UNdata_Export_20250502_110820872 | See row-specific geography; local samples and national totals must not be added | Fuel totals do not imply end-use shares; missing cells are unknown, not zero | UNVERIFIED | PENDING
ID | Residential | gas | UNKNOWN | UNKNOWN | UNKNOWN | UNKNOWN | UNKNOWN | E3C0064 | E3C0064 | Unclassified | UNSD_UNdata_Export_20250502_110721508 | See row-specific geography; local samples and national totals must not be added | Fuel totals do not imply end-use shares; missing cells are unknown, not zero | UNVERIFIED | PENDING
ID | Residential | LPG/oil | UNKNOWN | UNKNOWN | UNKNOWN | UNKNOWN | UNKNOWN | E3C0035; E3C0045; E3C0060 | E3C0035; E3C0045; E3C0060 | Unclassified | UNSD_UNdata_Export_20250502_110559984; UNSD_UNdata_Export_20250502_110656973; UNSD_UNdata_Export_20250502_110709784 | See row-specific geography; local samples and national totals must not be added | Fuel totals do not imply end-use shares; missing cells are unknown, not zero | UNVERIFIED | PENDING
ID | Residential | biomass | UNKNOWN | UNKNOWN | UNKNOWN | UNKNOWN | UNKNOWN | E3C0003; E3C0007; E3C0024 | E3C0003; E3C0007; E3C0024 | Unclassified | UNSD_UNdata_Export_20250502_110314760; UNSD_UNdata_Export_20250502_110403305; UNSD_UNdata_Export_20250502_110532316 | See row-specific geography; local samples and national totals must not be added | Fuel totals do not imply end-use shares; missing cells are unknown, not zero | UNVERIFIED | PENDING
ID | Residential | coal | UNKNOWN | UNKNOWN | UNKNOWN | UNKNOWN | UNKNOWN | UNKNOWN |  | Unclassified |  | See row-specific geography; local samples and national totals must not be added | Fuel totals do not imply end-use shares; missing cells are unknown, not zero | UNVERIFIED | PENDING
ID | Residential | heat commodity | UNKNOWN | UNKNOWN | UNKNOWN | UNKNOWN | UNKNOWN | UNKNOWN |  | Unclassified |  | See row-specific geography; local samples and national totals must not be added | Fuel totals do not imply end-use shares; missing cells are unknown, not zero | UNVERIFIED | PENDING
ID | Residential | others | UNKNOWN | E3C0113; E3C0120 | E3C0127; E3C0134 | UNKNOWN | UNKNOWN | UNKNOWN |  | Unclassified | ERIA_PILOT2013 | See row-specific geography; local samples and national totals must not be added | Fuel totals do not imply end-use shares; missing cells are unknown, not zero | UNVERIFIED | PENDING
ID | Services | electricity | UNKNOWN | UNKNOWN | UNKNOWN | UNKNOWN | UNKNOWN | E3C0076 | E3C0076 | Unclassified | UNSD_UNdata_Export_20250502_110820872 | See row-specific geography; local samples and national totals must not be added | Fuel totals do not imply end-use shares; missing cells are unknown, not zero | UNVERIFIED | PENDING
ID | Services | gas | UNKNOWN | UNKNOWN | UNKNOWN | UNKNOWN | UNKNOWN | E3C0065 | E3C0065 | Unclassified | UNSD_UNdata_Export_20250502_110721508 | See row-specific geography; local samples and national totals must not be added | Fuel totals do not imply end-use shares; missing cells are unknown, not zero | UNVERIFIED | PENDING
ID | Services | LPG/oil | UNKNOWN | UNKNOWN | UNKNOWN | UNKNOWN | UNKNOWN | E3C0036; E3C0046; E3C0061 | E3C0036; E3C0046; E3C0061 | Unclassified | UNSD_UNdata_Export_20250502_110559984; UNSD_UNdata_Export_20250502_110656973; UNSD_UNdata_Export_20250502_110709784 | See row-specific geography; local samples and national totals must not be added | Fuel totals do not imply end-use shares; missing cells are unknown, not zero | UNVERIFIED | PENDING
ID | Services | biomass | UNKNOWN | UNKNOWN | UNKNOWN | UNKNOWN | UNKNOWN | E3C0001; E3C0008 | E3C0001; E3C0008 | Unclassified | UNSD_UNdata_Export_20250502_110306307; UNSD_UNdata_Export_20250502_110403305 | See row-specific geography; local samples and national totals must not be added | Fuel totals do not imply end-use shares; missing cells are unknown, not zero | UNVERIFIED | PENDING
ID | Services | coal | UNKNOWN | UNKNOWN | UNKNOWN | UNKNOWN | UNKNOWN | UNKNOWN |  | Unclassified |  | See row-specific geography; local samples and national totals must not be added | Fuel totals do not imply end-use shares; missing cells are unknown, not zero | UNVERIFIED | PENDING
ID | Services | heat commodity | UNKNOWN | UNKNOWN | UNKNOWN | UNKNOWN | UNKNOWN | UNKNOWN |  | Unclassified |  | See row-specific geography; local samples and national totals must not be added | Fuel totals do not imply end-use shares; missing cells are unknown, not zero | UNVERIFIED | PENDING
ID | Services | others | UNKNOWN | UNKNOWN | UNKNOWN | UNKNOWN | UNKNOWN | UNKNOWN |  | Unclassified |  | See row-specific geography; local samples and national totals must not be added | Fuel totals do not imply end-use shares; missing cells are unknown, not zero | UNVERIFIED | PENDING
LA | Residential | electricity | UNKNOWN | UNKNOWN | UNKNOWN | UNKNOWN | UNKNOWN | E3C0077 | E3C0077 | Unclassified | UNSD_UNdata_Export_20250502_110820872 | See row-specific geography; local samples and national totals must not be added | Fuel totals do not imply end-use shares; missing cells are unknown, not zero | UNVERIFIED | PENDING
LA | Residential | gas | UNKNOWN | UNKNOWN | UNKNOWN | UNKNOWN | UNKNOWN | UNKNOWN |  | Unclassified |  | See row-specific geography; local samples and national totals must not be added | Fuel totals do not imply end-use shares; missing cells are unknown, not zero | UNVERIFIED | PENDING
LA | Residential | LPG/oil | UNKNOWN | UNKNOWN | UNKNOWN | UNKNOWN | UNKNOWN | E3C0047 | E3C0047 | Unclassified | UNSD_UNdata_Export_20250502_110656973 | See row-specific geography; local samples and national totals must not be added | Fuel totals do not imply end-use shares; missing cells are unknown, not zero | UNVERIFIED | PENDING
LA | Residential | biomass | UNKNOWN | UNKNOWN | UNKNOWN | UNKNOWN | UNKNOWN | E3C0009; E3C0025 | E3C0009; E3C0025 | Unclassified | UNSD_UNdata_Export_20250502_110403305; UNSD_UNdata_Export_20250502_110532316 | See row-specific geography; local samples and national totals must not be added | Fuel totals do not imply end-use shares; missing cells are unknown, not zero | UNVERIFIED | PENDING
LA | Residential | coal | UNKNOWN | UNKNOWN | UNKNOWN | UNKNOWN | UNKNOWN | UNKNOWN |  | Unclassified |  | See row-specific geography; local samples and national totals must not be added | Fuel totals do not imply end-use shares; missing cells are unknown, not zero | UNVERIFIED | PENDING
LA | Residential | heat commodity | UNKNOWN | UNKNOWN | UNKNOWN | UNKNOWN | UNKNOWN | UNKNOWN |  | Unclassified |  | See row-specific geography; local samples and national totals must not be added | Fuel totals do not imply end-use shares; missing cells are unknown, not zero | UNVERIFIED | PENDING
LA | Residential | others | UNKNOWN | E3C0118 | E3C0132 | UNKNOWN | UNKNOWN | UNKNOWN |  | Unclassified | ERIA_PILOT2013 | See row-specific geography; local samples and national totals must not be added | Fuel totals do not imply end-use shares; missing cells are unknown, not zero | UNVERIFIED | PENDING
LA | Services | electricity | UNKNOWN | UNKNOWN | UNKNOWN | UNKNOWN | UNKNOWN | E3C0078 | E3C0078 | Unclassified | UNSD_UNdata_Export_20250502_110820872 | See row-specific geography; local samples and national totals must not be added | Fuel totals do not imply end-use shares; missing cells are unknown, not zero | UNVERIFIED | PENDING
LA | Services | gas | UNKNOWN | UNKNOWN | UNKNOWN | UNKNOWN | UNKNOWN | UNKNOWN |  | Unclassified |  | See row-specific geography; local samples and national totals must not be added | Fuel totals do not imply end-use shares; missing cells are unknown, not zero | UNVERIFIED | PENDING
LA | Services | LPG/oil | UNKNOWN | UNKNOWN | UNKNOWN | UNKNOWN | UNKNOWN | E3C0048 | E3C0048 | Unclassified | UNSD_UNdata_Export_20250502_110656973 | See row-specific geography; local samples and national totals must not be added | Fuel totals do not imply end-use shares; missing cells are unknown, not zero | UNVERIFIED | PENDING
LA | Services | biomass | UNKNOWN | UNKNOWN | UNKNOWN | UNKNOWN | UNKNOWN | E3C0010; E3C0026 | E3C0010; E3C0026 | Unclassified | UNSD_UNdata_Export_20250502_110403305; UNSD_UNdata_Export_20250502_110532316 | See row-specific geography; local samples and national totals must not be added | Fuel totals do not imply end-use shares; missing cells are unknown, not zero | UNVERIFIED | PENDING
LA | Services | coal | UNKNOWN | UNKNOWN | UNKNOWN | UNKNOWN | UNKNOWN | UNKNOWN |  | Unclassified |  | See row-specific geography; local samples and national totals must not be added | Fuel totals do not imply end-use shares; missing cells are unknown, not zero | UNVERIFIED | PENDING
LA | Services | heat commodity | UNKNOWN | UNKNOWN | UNKNOWN | UNKNOWN | UNKNOWN | UNKNOWN |  | Unclassified |  | See row-specific geography; local samples and national totals must not be added | Fuel totals do not imply end-use shares; missing cells are unknown, not zero | UNVERIFIED | PENDING
LA | Services | others | UNKNOWN | UNKNOWN | UNKNOWN | UNKNOWN | UNKNOWN | UNKNOWN |  | Unclassified |  | See row-specific geography; local samples and national totals must not be added | Fuel totals do not imply end-use shares; missing cells are unknown, not zero | UNVERIFIED | PENDING
MY | Residential | electricity | UNKNOWN | E3C0094; E3C0105; E3C0106; E3C0107 | E3C0096 | E3C0093 | E3C0095; E3C0097 | E3C0079 | E3C0079 | DirectElectricity | MY_NEB2016; UNSD_UNdata_Export_20250502_110820872 | See row-specific geography; local samples and national totals must not be added | Fuel totals do not imply end-use shares; missing cells are unknown, not zero | UNVERIFIED | PENDING
MY | Residential | gas | UNKNOWN | UNKNOWN | E3C0098 | UNKNOWN | UNKNOWN | E3C0066 | E3C0066 | DirectFuel | MY_NEB2016; UNSD_UNdata_Export_20250502_110721508 | See row-specific geography; local samples and national totals must not be added | Fuel totals do not imply end-use shares; missing cells are unknown, not zero | UNVERIFIED | PENDING
MY | Residential | LPG/oil | UNKNOWN | UNKNOWN | E3C0099 | UNKNOWN | E3C0100 | E3C0049 | E3C0049 | DirectFuel | MY_NEB2016; UNSD_UNdata_Export_20250502_110656973 | See row-specific geography; local samples and national totals must not be added | Fuel totals do not imply end-use shares; missing cells are unknown, not zero | UNVERIFIED | PENDING
MY | Residential | biomass | UNKNOWN | UNKNOWN | UNKNOWN | UNKNOWN | UNKNOWN | E3C0011; E3C0027 | E3C0011; E3C0027 | Unclassified | UNSD_UNdata_Export_20250502_110403305; UNSD_UNdata_Export_20250502_110532316 | See row-specific geography; local samples and national totals must not be added | Fuel totals do not imply end-use shares; missing cells are unknown, not zero | UNVERIFIED | PENDING
MY | Residential | coal | UNKNOWN | UNKNOWN | UNKNOWN | UNKNOWN | UNKNOWN | UNKNOWN |  | Unclassified |  | See row-specific geography; local samples and national totals must not be added | Fuel totals do not imply end-use shares; missing cells are unknown, not zero | UNVERIFIED | PENDING
MY | Residential | heat commodity | UNKNOWN | UNKNOWN | UNKNOWN | UNKNOWN | UNKNOWN | UNKNOWN |  | Unclassified |  | See row-specific geography; local samples and national totals must not be added | Fuel totals do not imply end-use shares; missing cells are unknown, not zero | UNVERIFIED | PENDING
MY | Residential | others | UNKNOWN | E3C0116; E3C0123 | E3C0130; E3C0137 | UNKNOWN | UNKNOWN | UNKNOWN |  | Unclassified | ERIA_PILOT2013 | See row-specific geography; local samples and national totals must not be added | Fuel totals do not imply end-use shares; missing cells are unknown, not zero | UNVERIFIED | PENDING
MY | Services | electricity | UNKNOWN | E3C0102 | UNKNOWN | E3C0101 | E3C0103; E3C0104 | E3C0080 | E3C0080 | Unclassified | MY_NEB2016; UNSD_UNdata_Export_20250502_110820872 | See row-specific geography; local samples and national totals must not be added | Fuel totals do not imply end-use shares; missing cells are unknown, not zero | UNVERIFIED | PENDING
MY | Services | gas | UNKNOWN | UNKNOWN | UNKNOWN | UNKNOWN | UNKNOWN | E3C0067 | E3C0067 | Unclassified | UNSD_UNdata_Export_20250502_110721508 | See row-specific geography; local samples and national totals must not be added | Fuel totals do not imply end-use shares; missing cells are unknown, not zero | UNVERIFIED | PENDING
MY | Services | LPG/oil | UNKNOWN | UNKNOWN | UNKNOWN | UNKNOWN | UNKNOWN | E3C0018; E3C0037; E3C0050 | E3C0018; E3C0037; E3C0050 | Unclassified | UNSD_UNdata_Export_20250502_110515832; UNSD_UNdata_Export_20250502_110559984; UNSD_UNdata_Export_20250502_110656973 | See row-specific geography; local samples and national totals must not be added | Fuel totals do not imply end-use shares; missing cells are unknown, not zero | UNVERIFIED | PENDING
MY | Services | biomass | UNKNOWN | UNKNOWN | UNKNOWN | UNKNOWN | UNKNOWN | UNKNOWN |  | Unclassified |  | See row-specific geography; local samples and national totals must not be added | Fuel totals do not imply end-use shares; missing cells are unknown, not zero | UNVERIFIED | PENDING
MY | Services | coal | UNKNOWN | UNKNOWN | UNKNOWN | UNKNOWN | UNKNOWN | UNKNOWN |  | Unclassified |  | See row-specific geography; local samples and national totals must not be added | Fuel totals do not imply end-use shares; missing cells are unknown, not zero | UNVERIFIED | PENDING
MY | Services | heat commodity | UNKNOWN | UNKNOWN | UNKNOWN | UNKNOWN | UNKNOWN | UNKNOWN |  | Unclassified |  | See row-specific geography; local samples and national totals must not be added | Fuel totals do not imply end-use shares; missing cells are unknown, not zero | UNVERIFIED | PENDING
MY | Services | others | UNKNOWN | UNKNOWN | UNKNOWN | UNKNOWN | UNKNOWN | UNKNOWN |  | Unclassified |  | See row-specific geography; local samples and national totals must not be added | Fuel totals do not imply end-use shares; missing cells are unknown, not zero | UNVERIFIED | PENDING
MM | Residential | electricity | UNKNOWN | UNKNOWN | UNKNOWN | UNKNOWN | UNKNOWN | E3C0081 | E3C0081 | Unclassified | UNSD_UNdata_Export_20250502_110820872 | See row-specific geography; local samples and national totals must not be added | Fuel totals do not imply end-use shares; missing cells are unknown, not zero | UNVERIFIED | PENDING
MM | Residential | gas | UNKNOWN | UNKNOWN | UNKNOWN | UNKNOWN | UNKNOWN | UNKNOWN |  | Unclassified |  | See row-specific geography; local samples and national totals must not be added | Fuel totals do not imply end-use shares; missing cells are unknown, not zero | UNVERIFIED | PENDING
MM | Residential | LPG/oil | UNKNOWN | UNKNOWN | UNKNOWN | UNKNOWN | UNKNOWN | E3C0038; E3C0051; E3C0062 | E3C0038; E3C0051; E3C0062 | Unclassified | UNSD_UNdata_Export_20250502_110559984; UNSD_UNdata_Export_20250502_110656973; UNSD_UNdata_Export_20250502_110709784 | See row-specific geography; local samples and national totals must not be added | Fuel totals do not imply end-use shares; missing cells are unknown, not zero | UNVERIFIED | PENDING
MM | Residential | biomass | UNKNOWN | UNKNOWN | UNKNOWN | UNKNOWN | UNKNOWN | E3C0004; E3C0012; E3C0028 | E3C0004; E3C0012; E3C0028 | Unclassified | UNSD_UNdata_Export_20250502_110314760; UNSD_UNdata_Export_20250502_110403305; UNSD_UNdata_Export_20250502_110532316 | See row-specific geography; local samples and national totals must not be added | Fuel totals do not imply end-use shares; missing cells are unknown, not zero | UNVERIFIED | PENDING
MM | Residential | coal | UNKNOWN | UNKNOWN | UNKNOWN | UNKNOWN | UNKNOWN | UNKNOWN |  | Unclassified |  | See row-specific geography; local samples and national totals must not be added | Fuel totals do not imply end-use shares; missing cells are unknown, not zero | UNVERIFIED | PENDING
MM | Residential | heat commodity | UNKNOWN | UNKNOWN | UNKNOWN | UNKNOWN | UNKNOWN | UNKNOWN |  | Unclassified |  | See row-specific geography; local samples and national totals must not be added | Fuel totals do not imply end-use shares; missing cells are unknown, not zero | UNVERIFIED | PENDING
MM | Residential | others | UNKNOWN | UNKNOWN | UNKNOWN | UNKNOWN | UNKNOWN | UNKNOWN |  | Unclassified |  | See row-specific geography; local samples and national totals must not be added | Fuel totals do not imply end-use shares; missing cells are unknown, not zero | UNVERIFIED | PENDING
MM | Services | electricity | UNKNOWN | UNKNOWN | UNKNOWN | UNKNOWN | UNKNOWN | E3C0082 | E3C0082 | Unclassified | UNSD_UNdata_Export_20250502_110820872 | See row-specific geography; local samples and national totals must not be added | Fuel totals do not imply end-use shares; missing cells are unknown, not zero | UNVERIFIED | PENDING
MM | Services | gas | UNKNOWN | UNKNOWN | UNKNOWN | UNKNOWN | UNKNOWN | E3C0068 | E3C0068 | Unclassified | UNSD_UNdata_Export_20250502_110721508 | See row-specific geography; local samples and national totals must not be added | Fuel totals do not imply end-use shares; missing cells are unknown, not zero | UNVERIFIED | PENDING
MM | Services | LPG/oil | UNKNOWN | UNKNOWN | UNKNOWN | UNKNOWN | UNKNOWN | E3C0019 | E3C0019 | Unclassified | UNSD_UNdata_Export_20250502_110515832 | See row-specific geography; local samples and national totals must not be added | Fuel totals do not imply end-use shares; missing cells are unknown, not zero | UNVERIFIED | PENDING
MM | Services | biomass | UNKNOWN | UNKNOWN | UNKNOWN | UNKNOWN | UNKNOWN | E3C0029 | E3C0029 | Unclassified | UNSD_UNdata_Export_20250502_110532316 | See row-specific geography; local samples and national totals must not be added | Fuel totals do not imply end-use shares; missing cells are unknown, not zero | UNVERIFIED | PENDING
MM | Services | coal | UNKNOWN | UNKNOWN | UNKNOWN | UNKNOWN | UNKNOWN | UNKNOWN |  | Unclassified |  | See row-specific geography; local samples and national totals must not be added | Fuel totals do not imply end-use shares; missing cells are unknown, not zero | UNVERIFIED | PENDING
MM | Services | heat commodity | UNKNOWN | UNKNOWN | UNKNOWN | UNKNOWN | UNKNOWN | UNKNOWN |  | Unclassified |  | See row-specific geography; local samples and national totals must not be added | Fuel totals do not imply end-use shares; missing cells are unknown, not zero | UNVERIFIED | PENDING
MM | Services | others | UNKNOWN | UNKNOWN | UNKNOWN | UNKNOWN | UNKNOWN | UNKNOWN |  | Unclassified |  | See row-specific geography; local samples and national totals must not be added | Fuel totals do not imply end-use shares; missing cells are unknown, not zero | UNVERIFIED | PENDING
PH | Residential | electricity | UNKNOWN | UNKNOWN | UNKNOWN | UNKNOWN | UNKNOWN | E3C0083 | E3C0083 | Unclassified | UNSD_UNdata_Export_20250502_110820872 | See row-specific geography; local samples and national totals must not be added | Fuel totals do not imply end-use shares; missing cells are unknown, not zero | UNVERIFIED | PENDING
PH | Residential | gas | UNKNOWN | UNKNOWN | UNKNOWN | UNKNOWN | UNKNOWN | UNKNOWN |  | Unclassified |  | See row-specific geography; local samples and national totals must not be added | Fuel totals do not imply end-use shares; missing cells are unknown, not zero | UNVERIFIED | PENDING
PH | Residential | LPG/oil | UNKNOWN | UNKNOWN | UNKNOWN | UNKNOWN | UNKNOWN | E3C0052 | E3C0052 | Unclassified | UNSD_UNdata_Export_20250502_110656973 | See row-specific geography; local samples and national totals must not be added | Fuel totals do not imply end-use shares; missing cells are unknown, not zero | UNVERIFIED | PENDING
PH | Residential | biomass | UNKNOWN | UNKNOWN | UNKNOWN | UNKNOWN | UNKNOWN | E3C0013; E3C0030 | E3C0013; E3C0030 | Unclassified | UNSD_UNdata_Export_20250502_110403305; UNSD_UNdata_Export_20250502_110532316 | See row-specific geography; local samples and national totals must not be added | Fuel totals do not imply end-use shares; missing cells are unknown, not zero | UNVERIFIED | PENDING
PH | Residential | coal | UNKNOWN | UNKNOWN | UNKNOWN | UNKNOWN | UNKNOWN | UNKNOWN |  | Unclassified |  | See row-specific geography; local samples and national totals must not be added | Fuel totals do not imply end-use shares; missing cells are unknown, not zero | UNVERIFIED | PENDING
PH | Residential | heat commodity | UNKNOWN | UNKNOWN | UNKNOWN | UNKNOWN | UNKNOWN | UNKNOWN |  | Unclassified |  | See row-specific geography; local samples and national totals must not be added | Fuel totals do not imply end-use shares; missing cells are unknown, not zero | UNVERIFIED | PENDING
PH | Residential | others | UNKNOWN | E3C0114; E3C0121 | E3C0128; E3C0135 | UNKNOWN | UNKNOWN | UNKNOWN |  | Unclassified | ERIA_PILOT2013 | See row-specific geography; local samples and national totals must not be added | Fuel totals do not imply end-use shares; missing cells are unknown, not zero | UNVERIFIED | PENDING
PH | Services | electricity | UNKNOWN | UNKNOWN | UNKNOWN | UNKNOWN | UNKNOWN | E3C0084 | E3C0084 | Unclassified | UNSD_UNdata_Export_20250502_110820872 | See row-specific geography; local samples and national totals must not be added | Fuel totals do not imply end-use shares; missing cells are unknown, not zero | UNVERIFIED | PENDING
PH | Services | gas | UNKNOWN | UNKNOWN | UNKNOWN | UNKNOWN | UNKNOWN | UNKNOWN |  | Unclassified |  | See row-specific geography; local samples and national totals must not be added | Fuel totals do not imply end-use shares; missing cells are unknown, not zero | UNVERIFIED | PENDING
PH | Services | LPG/oil | UNKNOWN | UNKNOWN | UNKNOWN | UNKNOWN | UNKNOWN | E3C0020; E3C0039; E3C0053 | E3C0020; E3C0039; E3C0053 | Unclassified | UNSD_UNdata_Export_20250502_110515832; UNSD_UNdata_Export_20250502_110559984; UNSD_UNdata_Export_20250502_110656973 | See row-specific geography; local samples and national totals must not be added | Fuel totals do not imply end-use shares; missing cells are unknown, not zero | UNVERIFIED | PENDING
PH | Services | biomass | UNKNOWN | UNKNOWN | UNKNOWN | UNKNOWN | UNKNOWN | E3C0002; E3C0014; E3C0031 | E3C0002; E3C0014; E3C0031 | Unclassified | UNSD_UNdata_Export_20250502_110306307; UNSD_UNdata_Export_20250502_110403305; UNSD_UNdata_Export_20250502_110532316 | See row-specific geography; local samples and national totals must not be added | Fuel totals do not imply end-use shares; missing cells are unknown, not zero | UNVERIFIED | PENDING
PH | Services | coal | UNKNOWN | UNKNOWN | UNKNOWN | UNKNOWN | UNKNOWN | UNKNOWN |  | Unclassified |  | See row-specific geography; local samples and national totals must not be added | Fuel totals do not imply end-use shares; missing cells are unknown, not zero | UNVERIFIED | PENDING
PH | Services | heat commodity | UNKNOWN | UNKNOWN | UNKNOWN | UNKNOWN | UNKNOWN | UNKNOWN |  | Unclassified |  | See row-specific geography; local samples and national totals must not be added | Fuel totals do not imply end-use shares; missing cells are unknown, not zero | UNVERIFIED | PENDING
PH | Services | others | UNKNOWN | UNKNOWN | UNKNOWN | UNKNOWN | UNKNOWN | UNKNOWN |  | Unclassified |  | See row-specific geography; local samples and national totals must not be added | Fuel totals do not imply end-use shares; missing cells are unknown, not zero | UNVERIFIED | PENDING
SG | Residential | electricity | UNKNOWN | E3C0109 | UNKNOWN | E3C0110 | UNKNOWN | E3C0085; E3C0108 | E3C0085; E3C0108; E3C0109; E3C0110 | Unclassified | NEA2017; UNSD_UNdata_Export_20250502_110820872 | See row-specific geography; local samples and national totals must not be added | Fuel totals do not imply end-use shares; missing cells are unknown, not zero | UNVERIFIED | PENDING
SG | Residential | gas | UNKNOWN | UNKNOWN | UNKNOWN | UNKNOWN | UNKNOWN | E3C0069 | E3C0069 | Unclassified | UNSD_UNdata_Export_20250502_110721508 | See row-specific geography; local samples and national totals must not be added | Fuel totals do not imply end-use shares; missing cells are unknown, not zero | UNVERIFIED | PENDING
SG | Residential | LPG/oil | UNKNOWN | UNKNOWN | UNKNOWN | UNKNOWN | UNKNOWN | E3C0054 | E3C0054 | Unclassified | UNSD_UNdata_Export_20250502_110656973 | See row-specific geography; local samples and national totals must not be added | Fuel totals do not imply end-use shares; missing cells are unknown, not zero | UNVERIFIED | PENDING
SG | Residential | biomass | UNKNOWN | UNKNOWN | UNKNOWN | UNKNOWN | UNKNOWN | UNKNOWN |  | Unclassified |  | See row-specific geography; local samples and national totals must not be added | Fuel totals do not imply end-use shares; missing cells are unknown, not zero | UNVERIFIED | PENDING
SG | Residential | coal | UNKNOWN | UNKNOWN | UNKNOWN | UNKNOWN | UNKNOWN | UNKNOWN |  | Unclassified |  | See row-specific geography; local samples and national totals must not be added | Fuel totals do not imply end-use shares; missing cells are unknown, not zero | UNVERIFIED | PENDING
SG | Residential | heat commodity | UNKNOWN | UNKNOWN | UNKNOWN | UNKNOWN | UNKNOWN | UNKNOWN |  | Unclassified |  | See row-specific geography; local samples and national totals must not be added | Fuel totals do not imply end-use shares; missing cells are unknown, not zero | UNVERIFIED | PENDING
SG | Residential | others | E3C0140 | E3C0124 | E3C0138 | UNKNOWN | UNKNOWN | UNKNOWN |  | Unclassified | ERIA_PILOT2013 | See row-specific geography; local samples and national totals must not be added | Fuel totals do not imply end-use shares; missing cells are unknown, not zero | UNVERIFIED | PENDING
SG | Services | electricity | UNKNOWN | UNKNOWN | UNKNOWN | UNKNOWN | UNKNOWN | E3C0086 | E3C0086 | Unclassified | UNSD_UNdata_Export_20250502_110820872 | See row-specific geography; local samples and national totals must not be added | Fuel totals do not imply end-use shares; missing cells are unknown, not zero | UNVERIFIED | PENDING
SG | Services | gas | UNKNOWN | UNKNOWN | UNKNOWN | UNKNOWN | UNKNOWN | E3C0070 | E3C0070 | Unclassified | UNSD_UNdata_Export_20250502_110721508 | See row-specific geography; local samples and national totals must not be added | Fuel totals do not imply end-use shares; missing cells are unknown, not zero | UNVERIFIED | PENDING
SG | Services | LPG/oil | UNKNOWN | UNKNOWN | UNKNOWN | UNKNOWN | UNKNOWN | E3C0055 | E3C0055 | Unclassified | UNSD_UNdata_Export_20250502_110656973 | See row-specific geography; local samples and national totals must not be added | Fuel totals do not imply end-use shares; missing cells are unknown, not zero | UNVERIFIED | PENDING
SG | Services | biomass | UNKNOWN | UNKNOWN | UNKNOWN | UNKNOWN | UNKNOWN | UNKNOWN |  | Unclassified |  | See row-specific geography; local samples and national totals must not be added | Fuel totals do not imply end-use shares; missing cells are unknown, not zero | UNVERIFIED | PENDING
SG | Services | coal | UNKNOWN | UNKNOWN | UNKNOWN | UNKNOWN | UNKNOWN | UNKNOWN |  | Unclassified |  | See row-specific geography; local samples and national totals must not be added | Fuel totals do not imply end-use shares; missing cells are unknown, not zero | UNVERIFIED | PENDING
SG | Services | heat commodity | UNKNOWN | UNKNOWN | UNKNOWN | UNKNOWN | UNKNOWN | UNKNOWN |  | Unclassified |  | See row-specific geography; local samples and national totals must not be added | Fuel totals do not imply end-use shares; missing cells are unknown, not zero | UNVERIFIED | PENDING
SG | Services | others | UNKNOWN | UNKNOWN | UNKNOWN | UNKNOWN | UNKNOWN | UNKNOWN |  | Unclassified |  | See row-specific geography; local samples and national totals must not be added | Fuel totals do not imply end-use shares; missing cells are unknown, not zero | UNVERIFIED | PENDING
TH | Residential | electricity | UNKNOWN | UNKNOWN | UNKNOWN | UNKNOWN | UNKNOWN | E3C0087 | E3C0087 | Unclassified | UNSD_UNdata_Export_20250502_110820872 | See row-specific geography; local samples and national totals must not be added | Fuel totals do not imply end-use shares; missing cells are unknown, not zero | UNVERIFIED | PENDING
TH | Residential | gas | UNKNOWN | UNKNOWN | UNKNOWN | UNKNOWN | UNKNOWN | UNKNOWN |  | Unclassified |  | See row-specific geography; local samples and national totals must not be added | Fuel totals do not imply end-use shares; missing cells are unknown, not zero | UNVERIFIED | PENDING
TH | Residential | LPG/oil | UNKNOWN | UNKNOWN | UNKNOWN | UNKNOWN | UNKNOWN | E3C0056 | E3C0056 | Unclassified | UNSD_UNdata_Export_20250502_110656973 | See row-specific geography; local samples and national totals must not be added | Fuel totals do not imply end-use shares; missing cells are unknown, not zero | UNVERIFIED | PENDING
TH | Residential | biomass | UNKNOWN | UNKNOWN | UNKNOWN | UNKNOWN | UNKNOWN | E3C0015; E3C0032 | E3C0015; E3C0032 | Unclassified | UNSD_UNdata_Export_20250502_110403305; UNSD_UNdata_Export_20250502_110532316 | See row-specific geography; local samples and national totals must not be added | Fuel totals do not imply end-use shares; missing cells are unknown, not zero | UNVERIFIED | PENDING
TH | Residential | coal | UNKNOWN | UNKNOWN | UNKNOWN | UNKNOWN | UNKNOWN | UNKNOWN |  | Unclassified |  | See row-specific geography; local samples and national totals must not be added | Fuel totals do not imply end-use shares; missing cells are unknown, not zero | UNVERIFIED | PENDING
TH | Residential | heat commodity | UNKNOWN | UNKNOWN | UNKNOWN | UNKNOWN | UNKNOWN | UNKNOWN |  | Unclassified |  | See row-specific geography; local samples and national totals must not be added | Fuel totals do not imply end-use shares; missing cells are unknown, not zero | UNVERIFIED | PENDING
TH | Residential | others | UNKNOWN | E3C0115; E3C0122 | E3C0129; E3C0136 | UNKNOWN | UNKNOWN | UNKNOWN |  | Unclassified | ERIA_PILOT2013 | See row-specific geography; local samples and national totals must not be added | Fuel totals do not imply end-use shares; missing cells are unknown, not zero | UNVERIFIED | PENDING
TH | Services | electricity | UNKNOWN | UNKNOWN | UNKNOWN | UNKNOWN | UNKNOWN | E3C0088 | E3C0088 | Unclassified | UNSD_UNdata_Export_20250502_110820872 | See row-specific geography; local samples and national totals must not be added | Fuel totals do not imply end-use shares; missing cells are unknown, not zero | UNVERIFIED | PENDING
TH | Services | gas | UNKNOWN | UNKNOWN | UNKNOWN | UNKNOWN | UNKNOWN | UNKNOWN |  | Unclassified |  | See row-specific geography; local samples and national totals must not be added | Fuel totals do not imply end-use shares; missing cells are unknown, not zero | UNVERIFIED | PENDING
TH | Services | LPG/oil | UNKNOWN | UNKNOWN | UNKNOWN | UNKNOWN | UNKNOWN | E3C0057 | E3C0057 | Unclassified | UNSD_UNdata_Export_20250502_110656973 | See row-specific geography; local samples and national totals must not be added | Fuel totals do not imply end-use shares; missing cells are unknown, not zero | UNVERIFIED | PENDING
TH | Services | biomass | UNKNOWN | UNKNOWN | UNKNOWN | UNKNOWN | UNKNOWN | UNKNOWN |  | Unclassified |  | See row-specific geography; local samples and national totals must not be added | Fuel totals do not imply end-use shares; missing cells are unknown, not zero | UNVERIFIED | PENDING
TH | Services | coal | UNKNOWN | UNKNOWN | UNKNOWN | UNKNOWN | UNKNOWN | UNKNOWN |  | Unclassified |  | See row-specific geography; local samples and national totals must not be added | Fuel totals do not imply end-use shares; missing cells are unknown, not zero | UNVERIFIED | PENDING
TH | Services | heat commodity | UNKNOWN | UNKNOWN | UNKNOWN | UNKNOWN | UNKNOWN | UNKNOWN |  | Unclassified |  | See row-specific geography; local samples and national totals must not be added | Fuel totals do not imply end-use shares; missing cells are unknown, not zero | UNVERIFIED | PENDING
TH | Services | others | UNKNOWN | UNKNOWN | UNKNOWN | UNKNOWN | UNKNOWN | E3C0017 | E3C0017 | Unclassified | UNSD_UNdata_Export_20250502_110459400 | See row-specific geography; local samples and national totals must not be added | Fuel totals do not imply end-use shares; missing cells are unknown, not zero | UNVERIFIED | PENDING
TL | Residential | electricity | UNKNOWN | UNKNOWN | UNKNOWN | UNKNOWN | UNKNOWN | E3C0089 | E3C0089 | Unclassified | UNSD_UNdata_Export_20250502_110820872 | See row-specific geography; local samples and national totals must not be added | Fuel totals do not imply end-use shares; missing cells are unknown, not zero | UNVERIFIED | PENDING
TL | Residential | gas | UNKNOWN | UNKNOWN | UNKNOWN | UNKNOWN | UNKNOWN | UNKNOWN |  | Unclassified |  | See row-specific geography; local samples and national totals must not be added | Fuel totals do not imply end-use shares; missing cells are unknown, not zero | UNVERIFIED | PENDING
TL | Residential | LPG/oil | UNKNOWN | UNKNOWN | UNKNOWN | UNKNOWN | UNKNOWN | UNKNOWN |  | Unclassified |  | See row-specific geography; local samples and national totals must not be added | Fuel totals do not imply end-use shares; missing cells are unknown, not zero | UNVERIFIED | PENDING
TL | Residential | biomass | UNKNOWN | UNKNOWN | UNKNOWN | UNKNOWN | UNKNOWN | E3C0033 | E3C0033 | Unclassified | UNSD_UNdata_Export_20250502_110532316 | See row-specific geography; local samples and national totals must not be added | Fuel totals do not imply end-use shares; missing cells are unknown, not zero | UNVERIFIED | PENDING
TL | Residential | coal | UNKNOWN | UNKNOWN | UNKNOWN | UNKNOWN | UNKNOWN | UNKNOWN |  | Unclassified |  | See row-specific geography; local samples and national totals must not be added | Fuel totals do not imply end-use shares; missing cells are unknown, not zero | UNVERIFIED | PENDING
TL | Residential | heat commodity | UNKNOWN | UNKNOWN | UNKNOWN | UNKNOWN | UNKNOWN | UNKNOWN |  | Unclassified |  | See row-specific geography; local samples and national totals must not be added | Fuel totals do not imply end-use shares; missing cells are unknown, not zero | UNVERIFIED | PENDING
TL | Residential | others | UNKNOWN | UNKNOWN | UNKNOWN | UNKNOWN | UNKNOWN | UNKNOWN |  | Unclassified |  | See row-specific geography; local samples and national totals must not be added | Fuel totals do not imply end-use shares; missing cells are unknown, not zero | UNVERIFIED | PENDING
TL | Services | electricity | UNKNOWN | UNKNOWN | UNKNOWN | UNKNOWN | UNKNOWN | E3C0090 | E3C0090 | Unclassified | UNSD_UNdata_Export_20250502_110820872 | See row-specific geography; local samples and national totals must not be added | Fuel totals do not imply end-use shares; missing cells are unknown, not zero | UNVERIFIED | PENDING
TL | Services | gas | UNKNOWN | UNKNOWN | UNKNOWN | UNKNOWN | UNKNOWN | UNKNOWN |  | Unclassified |  | See row-specific geography; local samples and national totals must not be added | Fuel totals do not imply end-use shares; missing cells are unknown, not zero | UNVERIFIED | PENDING
TL | Services | LPG/oil | UNKNOWN | UNKNOWN | UNKNOWN | UNKNOWN | UNKNOWN | UNKNOWN |  | Unclassified |  | See row-specific geography; local samples and national totals must not be added | Fuel totals do not imply end-use shares; missing cells are unknown, not zero | UNVERIFIED | PENDING
TL | Services | biomass | UNKNOWN | UNKNOWN | UNKNOWN | UNKNOWN | UNKNOWN | UNKNOWN |  | Unclassified |  | See row-specific geography; local samples and national totals must not be added | Fuel totals do not imply end-use shares; missing cells are unknown, not zero | UNVERIFIED | PENDING
TL | Services | coal | UNKNOWN | UNKNOWN | UNKNOWN | UNKNOWN | UNKNOWN | UNKNOWN |  | Unclassified |  | See row-specific geography; local samples and national totals must not be added | Fuel totals do not imply end-use shares; missing cells are unknown, not zero | UNVERIFIED | PENDING
TL | Services | heat commodity | UNKNOWN | UNKNOWN | UNKNOWN | UNKNOWN | UNKNOWN | UNKNOWN |  | Unclassified |  | See row-specific geography; local samples and national totals must not be added | Fuel totals do not imply end-use shares; missing cells are unknown, not zero | UNVERIFIED | PENDING
TL | Services | others | UNKNOWN | UNKNOWN | UNKNOWN | UNKNOWN | UNKNOWN | UNKNOWN |  | Unclassified |  | See row-specific geography; local samples and national totals must not be added | Fuel totals do not imply end-use shares; missing cells are unknown, not zero | UNVERIFIED | PENDING
VN | Residential | electricity | UNKNOWN | UNKNOWN | UNKNOWN | UNKNOWN | UNKNOWN | E3C0091 | E3C0091 | Unclassified | UNSD_UNdata_Export_20250502_110820872 | See row-specific geography; local samples and national totals must not be added | Fuel totals do not imply end-use shares; missing cells are unknown, not zero | UNVERIFIED | PENDING
VN | Residential | gas | UNKNOWN | UNKNOWN | UNKNOWN | UNKNOWN | UNKNOWN | UNKNOWN |  | Unclassified |  | See row-specific geography; local samples and national totals must not be added | Fuel totals do not imply end-use shares; missing cells are unknown, not zero | UNVERIFIED | PENDING
VN | Residential | LPG/oil | UNKNOWN | UNKNOWN | UNKNOWN | UNKNOWN | UNKNOWN | E3C0058 | E3C0058 | Unclassified | UNSD_UNdata_Export_20250502_110656973 | See row-specific geography; local samples and national totals must not be added | Fuel totals do not imply end-use shares; missing cells are unknown, not zero | UNVERIFIED | PENDING
VN | Residential | biomass | UNKNOWN | UNKNOWN | UNKNOWN | UNKNOWN | UNKNOWN | E3C0016 | E3C0016 | Unclassified | UNSD_UNdata_Export_20250502_110403305 | See row-specific geography; local samples and national totals must not be added | Fuel totals do not imply end-use shares; missing cells are unknown, not zero | UNVERIFIED | PENDING
VN | Residential | coal | UNKNOWN | UNKNOWN | UNKNOWN | UNKNOWN | UNKNOWN | E3C0040 | E3C0040 | Unclassified | UNSD_UNdata_Export_20250502_110638157 | See row-specific geography; local samples and national totals must not be added | Fuel totals do not imply end-use shares; missing cells are unknown, not zero | UNVERIFIED | PENDING
VN | Residential | heat commodity | UNKNOWN | UNKNOWN | UNKNOWN | UNKNOWN | UNKNOWN | UNKNOWN |  | Unclassified |  | See row-specific geography; local samples and national totals must not be added | Fuel totals do not imply end-use shares; missing cells are unknown, not zero | UNVERIFIED | PENDING
VN | Residential | others | UNKNOWN | E3C0112; E3C0119 | E3C0126; E3C0133 | UNKNOWN | UNKNOWN | UNKNOWN |  | Unclassified | ERIA_PILOT2013 | See row-specific geography; local samples and national totals must not be added | Fuel totals do not imply end-use shares; missing cells are unknown, not zero | UNVERIFIED | PENDING
VN | Services | electricity | UNKNOWN | UNKNOWN | UNKNOWN | UNKNOWN | UNKNOWN | E3C0092 | E3C0092 | Unclassified | UNSD_UNdata_Export_20250502_110820872 | See row-specific geography; local samples and national totals must not be added | Fuel totals do not imply end-use shares; missing cells are unknown, not zero | UNVERIFIED | PENDING
VN | Services | gas | UNKNOWN | UNKNOWN | UNKNOWN | UNKNOWN | UNKNOWN | UNKNOWN |  | Unclassified |  | See row-specific geography; local samples and national totals must not be added | Fuel totals do not imply end-use shares; missing cells are unknown, not zero | UNVERIFIED | PENDING
VN | Services | LPG/oil | UNKNOWN | UNKNOWN | UNKNOWN | UNKNOWN | UNKNOWN | E3C0021; E3C0059 | E3C0021; E3C0059 | Unclassified | UNSD_UNdata_Export_20250502_110515832; UNSD_UNdata_Export_20250502_110656973 | See row-specific geography; local samples and national totals must not be added | Fuel totals do not imply end-use shares; missing cells are unknown, not zero | UNVERIFIED | PENDING
VN | Services | biomass | UNKNOWN | UNKNOWN | UNKNOWN | UNKNOWN | UNKNOWN | UNKNOWN |  | Unclassified |  | See row-specific geography; local samples and national totals must not be added | Fuel totals do not imply end-use shares; missing cells are unknown, not zero | UNVERIFIED | PENDING
VN | Services | coal | UNKNOWN | UNKNOWN | UNKNOWN | UNKNOWN | UNKNOWN | E3C0041 | E3C0041 | Unclassified | UNSD_UNdata_Export_20250502_110638157 | See row-specific geography; local samples and national totals must not be added | Fuel totals do not imply end-use shares; missing cells are unknown, not zero | UNVERIFIED | PENDING
VN | Services | heat commodity | UNKNOWN | UNKNOWN | UNKNOWN | UNKNOWN | UNKNOWN | UNKNOWN |  | Unclassified |  | See row-specific geography; local samples and national totals must not be added | Fuel totals do not imply end-use shares; missing cells are unknown, not zero | UNVERIFIED | PENDING
VN | Services | others | UNKNOWN | UNKNOWN | UNKNOWN | UNKNOWN | UNKNOWN | UNKNOWN |  | Unclassified |  | See row-specific geography; local samples and national totals must not be added | Fuel totals do not imply end-use shares; missing cells are unknown, not zero | UNVERIFIED | PENDING
