cyc292cycjin-oss/SGP-ESE5004-Stage2/research/01_baseline_construction/README.md

# Phase 2 — 基准分层与工程修复交付

建议先读 [NEXT_EXPERIMENT_READINESS](NEXT_EXPERIMENT_READINESS.md)、[BASELINE_ARCHITECTURE](BASELINE_ARCHITECTURE.md)、[ENGINEERING_FIX_REGISTER](ENGINEERING_FIX_REGISTER.md)。

本轮形成两个独立fix commit、十国基年分配守恒证据、碳键/范围测试、论文DAG预检、固定官方SC来源、来源家族登记及manifest工具。正式论文重建尚未完成；未运行Integrated/Disconnected或standalone。

交付文档：

- [PAPER_BASELINE_REPRO_STATUS](PAPER_BASELINE_REPRO_STATUS.md)
- [UPSTREAM_SC_BASELINE](UPSTREAM_SC_BASELINE.md) / [SECTOR_ENABLEMENT.csv](SECTOR_ENABLEMENT.csv)
- [INDUSTRIAL_DEMAND_FIX_REPORT](INDUSTRIAL_DEMAND_FIX_REPORT.md) / [INDUSTRIAL_CONSERVATION.csv](INDUSTRIAL_CONSERVATION.csv)
- [CARBON_EQUIVALENCE_TEST](CARBON_EQUIVALENCE_TEST.md)
- [DATA_REPOSITORY_MAP](DATA_REPOSITORY_MAP.md) / [DATA_SOURCES.csv](data_registry/DATA_SOURCES.csv) / [DATA_HASHES.csv](data_registry/DATA_HASHES.csv)
- [REPRODUCIBILITY_RULES](REPRODUCIBILITY_RULES.md) / [RUN_MANIFEST_TEMPLATE.json](RUN_MANIFEST_TEMPLATE.json)
- [SOURCE_FAMILY_APPROVAL](data_registry/SOURCE_FAMILY_APPROVAL.md) / [DATA_DECISIONS](data_registry/DATA_DECISIONS.md)

证据标签：直接读取=固定Git/已有文件/作者metadata；实测=脚本回归和微型单元测试；结构推断=full-SC对互联的响应途径；候选方案=尚未实施的power carbon scope修复。技术测试通过不等于人工接受数据。
