cyc292cycjin-oss/SGP-ESE5004-Stage2/research/04_model_assembly/gate1/README.md

# Phase4 Gate1 delivery

Start with PHASE4_GATE1_READINESS.md and PHASE4_APPROVED_FIX_INTEGRATION.md. The twelve requested deliverables are in this directory. Evidence preserves original failing regressions, individual cherry-pick receipts, final passing regressions, input hashes, source namespace and the historical reference-network preflight.

The input registry deliberately distinguishes frozen/reference identity from scientific acceptance. Tutorial intermediate networks are historical references only. No Full-SC network or formal result was created. No solver was called.

Reproduce integrated code tests in the canonical model checkout using the existing pypsa-earth Python and `scripts_project/run_gate1_checks.py --output results_project/gate1_checks`. CSV authoring is a separate delivery step using Artifact Tool; JSON source rows and export receipts are retained.
