cyc292cycjin-oss/SGP-ESE5004-Stage2/research/02_sector_coupling/buildings_phase3a3/evidence/harness_diagnostics/README.txt

First E1 expanded harness omitted custom Bus.location assignment. Fixed fixture only; first attempt is not an engineering verdict. No model source changed.
