cyc292cycjin-oss/SGP-ESE5004-Stage2/research/04_model_assembly/gate4/evidence/resume/tools/README.md

These are the exact audit builders and integration helpers used in the recorded workspace. They retain explicit original paths and start-SHA guards; do not run integration/commit helpers on a different branch. Canonical replay inputs are hash-pinned in research_inputs/assembly_v1. TARGET_CONSTRUCTION.json and the method register expose all formulas independently of the helper environment. CSV export uses the bundled @oai/artifact-tool; no solver is called.
