cyc292cycjin-oss/SGP-ESE5004-Stage2/research/01_baseline_construction/WORK_PLAN.md

# Phase 2 工作计划与执行边界

日期：2026-10-01（Asia/Shanghai）。用户本轮明确允许隔离的论文参考案例运行及已证实工程问题修复；不允许运行 Integrated/Disconnected 研究实验或国家 standalone。

1. 冻结官方 upstream 当前 SHA；隔离 Paper Reference、Upstream SC、Research Model 和独立修复分支。
2. WP1：恢复作者有效配置及环境；检查原始输入/DAG；尝试最小 baseline-AIMS 2025（100 clusters、2013全年、3h）。缺少原始输入时不以教程替代；作者网络重优化若实施须另标身份，不能冒充从原始数据重建。
3. WP4 工业：使用已存在全球GDP原始NC修复空间覆盖；保持国家总量，验证逐国逐载能守恒；TL缺项单列；不选择新的增长假设。
4. WP2/4 碳：测试旧/混合/新键等价性；追踪排放边界是否扩张。只修键兼容；power-sector范围调整先形成最小方案与测试证据，不代定科学归属。
5. WP4 拓扑：追踪765→766原始GIS和网络；有证据才修，缺端点不猜。
6. WP3/5：实际sector清单、数据集级登记/许可/哈希/确认状态、运行manifest工具和回归检查。
7. 分开提交fix与文档/数据；交付十项报告/登记/模板，明确未解决项。

来源恢复不自动升级为人工数据确认。所有研究输入继续PENDING/UNVERIFIED；电解投资私有通信链标SOURCE_PARTIALLY_VERIFIED。原始教程与A0.5归档不修改。
