cyc292cycjin-oss/SGP-ESE5004-Stage2/research/04_model_assembly/gate4/BLEND_UNCERTAINTY_METHOD.md

# 缺memo的来源不确定性核算

本轮复用已缓存P/B原行、同次官方SDMX响应、官方问卷及代码表，没有网络检索或重新下载。全部10对的国家、2019、交易、单位TN×10³、状态和数值逐项相容。不同文件hash不被当成冲突，也不因下载日期近似而假定同版：每对原P和B分别与同一已缓存官方响应逐值相等，核验记录及响应hash见JSON。

问卷原件`research_inputs/assembly_v1/sources/unsd_targeted/questionnaire_guidelines.pdf`，PDF10的MO/ZG、11的DL/ZD及16–17的AL/BD定义证明ZG/ZD是同时包含在油品父项与对应生物燃料总量中的掺混子集。只有这两种明确商品关系纳入，不能将全部生物燃料都当memo。

对同用途同单位的P、B，未知Z满足0<=Z<=min(P,B)，唯一质量Q=P+B-Z，因此Q范围为[max(P,B),P+B]。这只是包含关系推导的账项范围，未赋予概率，不是源报告区间、置信区间或新的预测。没有选择中点/端点，无正式输入接受。

能量按E(Z)=(P-Z)h_p+B h_b计算：化石余量只用其冻结NCV，全部生物燃料只用自身冻结NCV，Z不另过账。保留冻结换算：柴油11940、汽油12300、生物柴油10220、生物汽油7444MWh/千吨；不采用新SDMX更高精度因子替换原值。能量范围只覆盖这些热值条件下的来源重叠，不包含热值误差，也不是整个账户或国家的需求范围。

|国家/交易/memo|P千吨|B千吨|唯一数量范围（千吨）|2019能源范围（TWh，显示6位）|
|---|---:|---:|---:|---:|
|ID 121 ZD|4908.285|362|4908.285–5270.285|57.982283–62.304563|
|ID 1221 ZD|9328.141|4613|9328.141–13941.141|103.443644–158.522864|
|ID 1235 ZD|240.894|52|240.894–292.894|2.786834–3.407714|
|PH 1221 ZG|4420.7|929.5|4420.7–5350.2|49.860958–61.293808|
|PH 121 ZD|774.4|15.61|774.4–790.01|9.219487–9.405870|
|PH 1221 ZD|6111.9|129.62|6111.9–6241.52|72.753140–74.300802|
|PH 1222 ZD|1.6|0.03|1.6–1.63|0.019052–0.019411|
|PH 1232 ZD|223.4|4.51|223.4–227.91|2.659639–2.713488|
|PH 1235 ZD|1752.2|35.34|1752.2–1787.54|20.860483–21.282443|
|VN 1221 ZG|6341|122|6341–6463|77.401868–78.902468|

全部10项可推导数量及冻结热值条件下能量范围。本次实际源对中无BOUND_NOT_DERIVABLE_FROM_CURRENT_SOURCE；负例测试确认单位/版本/国家/交易/商品或包含关系不相容时不给范围，缺热值时只保留可推导质量范围。真实Z、正式基准点、完整账户总量和物理热值不确定性仍不能推导。

PH道路ZG和ZD分开两行，是不同商品变量，但共同指向相同oil/biomass目标。每个UncertaintyID只有一个Z，不能因它出现于两个载能体或多个节点而当作两个独立误差。10个Z共关联18个唯一待决目标；未将相同目标重复统计。没有对区间作独立误差或概率假定，也没有将10行总和称为全交通能源。

CSV保留各目标的已批准方法与精确分子/分母，仅作关联，没有执行2050情景。PH铁路的有效方法是constant2019、倍率1，依据`GATE4_CONSOLIDATED_BASELINE_DECISIONS.json`；发现其PENDING registry仍有旧交通倍率Transformation/Candidate字段。本轮不使用这些旧描述计算，也不改生产账本；作为后续工程文字同步列入交接，不能重问或改动已经批准的铁路方法。

所有18个受影响目标仍受正式来源资格阻断。153项已接受需求、数组、MY/TH去重和本轮范围解释均不变。无新Load、无求解。
