cyc292cycjin-oss/SGP-ESE5004-Stage2/research/04_model_assembly/gate4/EXTERNAL_SOURCE_HANDOFF.md

# 外部资料交接与可执行事项

本轮没有发送邮件或联系任何机构，没有新查询或重复下载。请求文字仅供用户转交。当前精确请求表区分20个仍需外部证据的组与1个Avion档案补强组，不按节点/年份放大任务数。

## 已执行

- Avion限定25年寿命落地，该批次不进入2050继承；其他寿命、性能、运维和新建候选不变。
- 10项memo均完成相容来源下的质量/能量范围推导；正式来源资格仍未解除。
- 当前库存、未物化范围、诊断meta及manifest同步；实际物理输入按名称对齐不变。
- 3个燃料列和4国bunker统一标为ORIGINAL_TABLE_RECOVERED_REPORTING_STATUS_UNRESOLVED。原表已在手，无需再下载。

## 不需要新科学决定的工程后续

PH铁路2个PENDING目标的MethodID已正确为constant2019，但旧Transformation和Candidate字段还显示交通增长。下一次允许更新registry元数据时，从已批准方法统一刷新这些描述及依赖hash。不得执行旧倍率，不能将这一问题改成再次审批铁路方法。本轮依照“分析不修改生产账本”保持原文件字节，并在分析关联明确使用倍率1。

## 真正仍缺的原件

1. 10项2019 ZG/ZD memo或明确重叠元数据。ID的ZD：工业121、道路1221、服务1235；PH的ZD：工业121、道路1221、铁路1222、农业1232、服务1235，ZG：道路1221；VN的ZG：道路1221。各P/B原值、父项及同版响应已缓存，不再请求。现有精确及通配官方响应未返回memo，新线索没有增加。
2. KH/LA天然气、TL煤炭三组：原国家问卷、脚注或相容能源平衡说明，需要明确“..”是未报告还是不适用。完整UN2019表与符号页已缓存，不能当reported zero。
3. BN/KH/LA/TL国际海运四组：国际燃料交付原表、明确零或不适用的原注释。国内FEC、NEC或地理印象不能替代。
4. MM230MW：GPD Ngam Tae与Myanmar Lighting/Mawlamyine设施的原机组标识、投运年及重复关系；Siamgas原件已在手，不把投资年当投运年。MCL：原EIA机组/状态表解决GPD45与GEM40及余热边界。SCPC：原DOE2018机组表及GPD300MW聚合匹配依据，不能自行配成两台150。

Avion原DOE2016 PDF尚缺，但其已批准的2016批次寿命筛选事项已关闭。若原件已在手可补强档案；不要为此继续要求效率/FOM/VOM，也不能忽略以后出现的实质冲突。

`EXACT_SOURCE_REQUESTS.csv`逐组提供实际缺项、已有原件、失败/不足途径、是否新线索、受影响账户/容量、官方入口和给提供者的问题。已缓存父项和UN PDF不重索。

## 来源缺口与覆盖选择分开

没有新原件时，“未报告而暂不物化”仍是一项未批准的新研究覆盖决定，不能由代码修复代替。本轮没有扩展BN/TL已接受解释；其他燃料和国际bunker仍分别保留。区间下界/上界/中点也不是这个决定的替代品。

五组684MW原水电没有新授权：Java-Bali47、Kalimantan110、Peninsular54、Mindanao213/260。原唯一/互斥候选及精确资源要求保留在上轮FIVE_HYDRO_CHOICES.json；不重开七池770MW，不复制绝对来水。GPD水电身份通过后仍需自身资源资格。GEM4092.52MW与GPD15477.503MW缺年集合分别保留，不相加。

当前执行与外部资料交接到此停止。没有资料或新决定时，不再重复同内容检索报告。完整模型仍需33个物理目标以及水电/库存边界闭合；Gate5=NO、solver_runs=0。
