cyc292cycjin-oss/SGP-ESE5004-Stage2/research/04_model_assembly/gate4/RESIDUAL_DECISIONS_WITH_IMPACT.md

# Gate4当前剩余原件与覆盖选择

当前状态以CURRENT_PHYSICAL_READINESS.json为准。Avion25年限定历史寿命已批准并执行，不再待决；原100MW批次在模型规则下不进入2050继承。原始DOE PDF仍属档案等级未升级，未接受其他参数。

## 3. 五组原水电：684MW

|待接入组|已有候选输入（2013全年）|需明确的选择|
|---|---|---|
|ID Java-Bali ROR47MW|未使用`ID_Java-Bali1 2 ror`：原233291.836763MWh/年；按47MW包络可用223759.173794MWh/年|批准将这个原资源组用于该受限区域机组，或补其真实映射；这是新的水文空间代理，电网同区不证明同流域|
|ID Kalimantan水库110MW|互斥A：`ID_Kalimantan4 1 hydro`，789191.076448MWh/年、Emax8250MWh；B：`ID_Kalimantan4 4 hydro`，532286.028026MWh/年、Emax180MWh；均未使用|必须选择一个相容来源并说明覆盖，不相加；或提供原组映射/库容|
|MY Peninsular ROR54MW|无同类型区域参考输入|提供相容2013全年可用性与原覆盖，或提出另一个有来源代理后批准|
|PH Mindanao水库213MW、260MW|无同类型区域参考输入|提供各组相容全年来水及Emax/库容、原资产覆盖，或另行批准有来源代理；两组仍独立|

精确源ID、原父项/机组、未使用状态与hash见evidence/diagnostic/FIVE_HYDRO_CHOICES.json。七个已接入资源池770MW不重开。新来源及资源归属未获批准，以上数值没有进入生产合同。水库参考约6h仍是冻结原输入代理，不属于PHS6h决定的扩展。

## 尚需资料或明确选择

- 10项memo：质量与冻结NCV能量范围已推导，18个物理目标仍待来源化Z或明确重叠元数据；不能选一个区间端点过账。
- KH/LA天然气、TL煤炭11个目标：完整原表已取得，但“..”状态歧义仍需国家问卷/注释消歧。
- 四国国际海运4个目标：原行已取得但仍缺交付量/明确不适用证明，国内平衡不替代。
- GPD剩余2190.09MW：Hydro1615.09、MM联合循环230、煤电345仍受原身份/容量/状态及水资源资格约束；本轮未新增。原418MW与366MW重复记录分别保留，不叫退休。
- GEM缺年4092.52MW与GPD缺年15477.503MW分开，不直接相加；128条1861.5MW上界证明保持。

资料精确请求及下一步可执行事项见EXTERNAL_SOURCE_HANDOFF.md和EXACT_SOURCE_REQUESTS.csv。没有新原件时，统计范围暂不物化属于新的待批准覆盖决定，不是工程修复。国际bunker不能继承国内源范围解释。

已批准的增长、价格、映射、EV、bunker恒定、BN/TL范围、七池水电与其他寿命方法不再重问。六类固定账未知价/物理系数null外置、Animal waste资格未扩展，policy_enabled=false、200个SMR/SMR-CC政策权重null。完整研究网络未完成。
