cyc292cycjin-oss/SGP-ESE5004-Stage2/research/04_model_assembly/gate4/CONSOLIDATED_CLOSURE_CHOICES.md

# 更新后的最少闭合选择

本轮A–D已执行，不再待批。以前版本保留于Git历史；本文件不重复提交同样候选。

剩余选择集中为：未批准水电2组157MW与3组527MW的资源依据/代理；GPD及缺年库存的状态与身份边界；来源未报告的商品用途和国际bunker覆盖。任何选择应先使用明确可补原件，缺记录不等于零。十项memo仍是具体原件缺口，不用政策掺混比例替代。所有已批准增长、单位、EV embedded、bunker恒定、寿命和映射决定保持。

具体数量、相容关系、已知差额与实际接入结果见PHASE4_GATE4_READINESS.md、UPDATED_COVERAGE_AND_BLOCKER_MAP.csv、GPD_COHORT_AND_DUPLICATE_REVIEW.csv及RETIREMENT_BOUND_EVIDENCE.csv。完整网络尚未生成，当前不得进入Gate5。
