cyc292cycjin-oss/SGP-ESE5004-Stage2/research/04_model_assembly/gate4/DECISIONS_APPLIED_THIS_ROUND.md

# 本轮决定及工程变更

基准HEAD 6922b7307ebb980969e30878769fa5d2ed69b8c7；本地/远程一致、起始工作树干净。新增DecisionReference **GATE4-20261006-CANONICAL-SELECTED-CLOSURE**，来源为本轮用户明确执行指令，未追溯为旧批准。

|选择|本轮执行|数值或边界|
|---|---|---|
|A 连接扰动移除|13条真实DC/B2B已置0可变输送费|资本费用、效率、容量、拓扑不变|
|B 风光配置费用|340组件保留并获显式模型假设身份|solar0.01，onwind/offwind0.015 EUR2020/MWh|
|C 已接受水资源空间代理|7池770MW已实际接入|22个原ResourceIdentity逐时、年度积分与Emax守恒；原ROR截断包络不扩大|
|D GPD报告电厂批次|321条22628.143MW来源容量保持；143条有年7150.64MW参与筛选|条件存续3118.49MW，去重与资格后实际44.4MW；不是强配目标|
|缺年上界推导|128条1861.5MW已证明在既有寿命规则下不属于2050继承|使用2025发布的运营源快照；未填投运年、未用下载日|

水资源代理的电网区域不是流域，空间/水文敏感性保留。未获批准的2组157MW和3组527MW仍待决，未引入额外自然资源。GPD三条实际记录为Calumangan DPP23MW、NAC DPP10.9MW、PACERM-1 10.5MW；源为冻结DOE记录、原PPM独立来源选择与GEM名称/业主/位置核对，既有Oil技术输入代理沿用、不升级到2050效率。采用电厂年份的年龄代理敏感性保留。原418MW的SEC/SLPGC已识别与既有GEM站点重复，未新增；其他条件存续2656.09MW仍因身份/状态、转换技术或水资源合同未完整合格而不接入。

工程修复独立提交 2a722b8d18a755c983a07778daa25b69b3944044：规范商品与已有FEC限定覆盖规则。新选择执行提交 b4b416663a5881b636484f86b5d803eb661382a1：费用、资源空间代理、报告批次与上界证明。无新技术，无新需求增长方法，无carbon政策改变。SMR为steam methane reforming；policy_enabled=false，200项政策权重null。
