cyc292cycjin-oss/SGP-ESE5004-Stage2/research/04_model_assembly/gate4/USER_INPUT_NEEDED_GATE4.md

# 当前最少审阅范围

请以CONSOLIDATED_CLOSURE_CHOICES.md为决策入口；不是140项逐行追问。费用两类规则、水电三类来源状况、GPD年龄与GEM未知库存、限定范围覆盖分别审阅。10个memo的直接下载请求见BLEND_REQUEST_ACCOUNT_CROSSWALK.csv，父项均已缓存。原批准方法不重问。
