cyc292cycjin-oss/SGP-ESE5004-Stage2/research/04_model_assembly/gate4/CONSOLIDATED_NUMERICAL_DECISIONS.md

# 仍需人工审阅的具体范围

此前已批准的增长、Mtoe、EV embedded、bunker、寿命、映射及本轮固定账/EUR2020方法不再列为待决。

当前最少成组事项：

- 水电：12组的2013全年原始输入及资源覆盖映射；已有168h文件无需重找。也可审阅逐组列出的相容资源重分摊候选，当前未执行。
- 库存：清单中缺年机组的投运/退役或身份记录，以及301个父项的机组关联/容量差异处理。按国家×技术集中决定；不需逐台未来退役公告。
- 掺混：精确10项memo或官方包含关系说明，父项已缓存。
- 覆盖：33来源组合/51账户的限定范围来源或零证明，或一次覆盖边界决定；Animal waste单列未物化。
- 求解前价格定义：风光配置边际费用与DC/B2B边际费用的真实价格年，或明确将其作为固定数值正则化系数的处理方法。共同EUR2020目标年已批准，不重复询问。

六类固定商品价格/物理CO2仍待核，影响全成本/排放报告，当前已不阻止其合格物理组网。SMR/SMR-CC政策归属仅在启用政策时待决。5个未启用技术的10条非EUR成本只在未来考虑启用时需FX桥接，本轮不扩展技术。
