cyc292cycjin-oss/SGP-ESE5004-Stage2/research/04_model_assembly/gate4/FIXED_BIOFUEL_ACCOUNTING_ASSESSMENT.md

# 已执行的外置固定账边界

2026-10-06本轮人工指令批准ASSEMBLY_V1_EXTERNAL_PENDING_FIXED_ACCOUNTS；取代前轮“仅提案、未执行”状态。已验证六类471资源账，未知价格/物理CO2仍为null，物理义务不变。Animal waste不在资格内。方法证明、实际重验、失效和报表拒绝测试见FIXED_ACCOUNT_QUALIFICATION_TESTS.md；外置项不作为虚假零物理排放进入大气Store。
