cyc292cycjin-oss/SGP-ESE5004-Stage2/research/04_model_assembly/gate4/RESIDUAL_PHYSICAL_CLOSURE.md

# 剩余物理源项：一次去重映射

RESIDUAL_PHYSICAL_DECISIONS.csv按ResidualID唯一登记，RelatedResidualIDs/SourceIDs/ParentIDs/Pending2050AccountIDs建立关联。五类计数口径不同，不能相加为一份容量或新增问题数。源版本/机组行号仍在ASSET_SURVIVAL_2050.json，229项已修复投运信息没有重新索取。

1. 32个国家×技术×未知状态组，分别列缺投运年份与未知既有身份。已确认既有缺年份5954.020MW；未知/计划状态另列。
2. 35个国家×技术父项对照组，原301父项22628.143MW；可能与单位缺年组重叠，不相加、不归一化。
3. 10项2019 memo：ID ZD5222交易121/1221/1235；PH ZD5222交易121/1221/1222/1232/1235及ZG5212交易1221；VN ZG5212交易1221。父项已缓存，只需同口径memo、版本、单位、脚注及包含关系。既有官方回执未返回匹配记录；本轮无新线索，零重复查询。
4. 33来源组合与51目标物理账户引用已有对应表。其中18账户已有正值父项，仅受同国掺混资格阻断，不再索取已缓存父项；15项已知NEC需要明确覆盖边界，不能据此证明其他部门零；另11项来源族缺失、7项缓存交易未返回分别登记。精确请求在逐项清单中，未批准覆盖排除不执行。
5. 12水电组/16机组1454MW：均有原始父项及168h输入，尚无唯一全年归属。9组存在同国/同区域AC分区参考候选，3组不存在同类型候选；候选不等于可用自然资源，已分配情况明确登记。若原作者映射仍缺，可以一次评审明确的组内资源重分摊方案，保持组绝对来水/Emax总量；没有批准不执行。不要全国最近兜底。

本轮关闭真实物理源缺口0项。恢复了短输入/源ID关联与候选范围，纠正“14组”为12组；这些是来源定位与文档修复，不能冒充缺口关闭。水库源max_hours约6h，Emax沿用冻结原组输入代理；不是实测库容，更不是抽蓄6h决定自动扩展。
