cyc292cycjin-oss/SGP-ESE5004-Stage2/research/04_model_assembly/gate4/AEO8_BAS_2050_DEMAND_SOURCE_MAP.md

# 当前AEO8 BAS来源与角色

方法状态以DECISION_SYNC_REPORT及ASSEMBLY_V1_2050_METHOD_REGISTER为准。AEO8原PDF SHA48c2a81913ed785cb0e14a55e332ea7bc87f912f7fabfbc8c654e09b66b11c06。

C.2印刷181/PDF183：2050 BAS最终电力225.0Mtoe。C.3印刷182/PDF184：2022→2050 Residential63.0→68.2、Commercial29.5→75.9、Industry185.6→561.0、Agriculture-and-Others8.8→27.8、Transport145.2→374.9Mtoe。全部人工作为2019项目基年的增长代理，不能称为AEO8直接国家/燃料预测。

道路93.5%来自印刷64/PDF66邻近ATS图的文字；乘BAS374.9得到350.5315是既有人工近似，当前仅参考不配平。道路燃料倍率374.9/145.2是新增人工决定；2022/2019和全交通/道路差异明确保留。国际/国内恒定义务来自人工历史边界，不来自AEO8未来表。

所有来源数值及页码沿用已核实缓存，没有重新开展运输未来情景搜索或更新DEA数据。
