cyc292cycjin-oss/SGP-ESE5004-Stage2/research/04_model_assembly/gate4/PHASE4_GATE4_START_IDENTITY.md

# Gate4 CONTINUE 身份

开始时本地/远程 research/full-sc-baseline均为`881e21e1b6185690b2026e56897f1a97c4801143`；上轮已测试实现dc2fc6f1f70a82a09515ece3f293fb59a73fb1fb。main=a3616a68ee44592af6527ca9024a90f1956646ae，归档=f7710800b495b60767ab6b7a5963f38b41aa03b4。无回滚、无force-push；本轮仅Research提交。精确最终SHA记录于交付包独立回执，防止文档自引用hash循环。
