cyc292cycjin-oss/SGP-ESE5004-Stage2/research/04_model_assembly/gate3/PHASE4_GATE3_START_IDENTITY.md

# Gate3 续接身份

核验基点：`ad5e81e75882704ac9e33a6eac96c5c79717c5e1`；分支 `research/full-sc-baseline`，续接时 working tree clean，本地与远程一致。远程 main 为 `a3616a68ee44592af6527ca9024a90f1956646ae`。详情：`evidence/RESUME_IDENTITY.json`；30 项输入、源文件、配置与历史网络核验全部通过。

先盘点并生成精确差异，后集成六个白名单文件。`GATE3_RESUME_INVENTORY.md` 和 `GATE3_DRAFT_DIFF_REVIEW.md` 区分有效证据、待复核草稿与禁止合入内容。未丢弃历史资产、未重建有效审计证据。

测试通过后依次提交载体接口、碳架构、验证接口；另有共用价格与国家可用量解耦的窄修复。实现与测试提交：

- `c6f4ebf5b2236d1b03bc11cd14cf526ffc419026` — feat: isolate research carrier ownership and physical carbon stores
- `631b27bb92e68cc974fe17f15206f86727cade9e` — feat: separate power policy co2 from system emissions reporting
- `552bdee8bcc6144aecc0bcd6b7ef09806e7c241a` — test: add carrier reachability and carbon scope gates
- `140294807bffe5cc172d5226ee0af3d4f548d180` — fix: keep shared fuel prices independent of national availability

最后测试的实现 SHA：`140294807bffe5cc172d5226ee0af3d4f548d180`。交付文档提交与远程最终身份在包根 `CLOSEOUT.json` 记录，避免文档自含最终 SHA 的循环。Gate2 输入及 demand 脚本 21 项 SHA 未变，上游三个被追踪源码 SHA 未变。历史 shipping 修复仍在 Gate2 祖先中。

没有执行 solver、Full-SC 组装、765/766 修复或 Integrated/Disconnected 切换。
