cyc292cycjin-oss/SGP-ESE5004-Stage2/research/04_model_assembly/gate2/PHASE4_GATE2_START_IDENTITY.md

# Phase4 Gate2 起点与范围

用户本轮文本明确：Phase1–3 CLOSED、Gate1 HUMAN ACCEPTED；只授权 Demand & Accounting Layer，所有 solver 禁止。

- 实际模型仓库：`/home/jin/research/SGP_ESE5004_Stage2/phase2/research_model`。
- 研究分支：`research/full-sc-baseline`。
- Gate2 起点：`a719f6038e982d53b53f27e39047c324a9218387`，起点工作树干净且与远程研究分支一致。
- remote main / frozen U：`a3616a68ee44592af6527ca9024a90f1956646ae`。
- Phase1–3 archive：`f7710800b495b60767ab6b7a5963f38b41aa03b4`。
- paper-run reference：`5bacad702ccfed17ad19ab510fa710651e966f2c`。
- 已测试的需求实现 HEAD：`1c77884f9b38445e148608ee199994e4ed57d3e5`；最终包含报告的 HEAD 由交付包 `CLOSEOUT_IDENTITY.json` 记录。

Windows `C:/Users/20122/Documents/ChatGPT/ASEAN` 是独立交付/历史资料仓库，不把它的 HEAD 当作模型 HEAD。原有 work/outputs 资产不清理。

只改研究层、研究 baseline 配置及授权 shipping 功能。没有运行 Snakefile、网络组装、optimization、validation solve 或正式实验；没有改 main、归档或 reference tag；没有修改碳政策、共享池、765/766 或 integrated/disconnected 差异。

完整起点远程 ref 清单在 `evidence/START.json`；结尾逐项比较（排除当前研究分支）在交付包收尾记录中。
