cyc292cycjin-oss/SGP-ESE5004-Stage2/research/04_model_assembly/gate1/PHASE4_GATE1_READINESS.md

# Phase4 Gate1 readiness and human review

Foundation built; approved engineering integration is PARTIAL. **READY_FOR_PHASE4_GATE2_DEMAND_ACCOUNTING=NO for unconditional handoff.** The direct open engineering item is shipping's stopped source conflict and dependent target guard. Pure demand-accounting design can be scoped independently at human review, but this report does not authorize Gate2 implementation.

Before accepting a later assembled network, resolve the evidenced 765/766 endpoint issue and validate real GIS/environment readiness. These are not requests to reopen Phase1–3 scientific scope or collect a new industrial census. Gate2/3 must implement the already-frozen demand, carbon scope and physical-carrier contracts. Missing raw-source bytes already covered by the exclusion manifest remain excluded; no unaccepted parameter was promoted.

| User question | Answer |
| --- | --- |
| A exact U start? | YES, `a3616a68ee44592af6527ca9024a90f1956646ae`, clean |
| B integrated source SHAs? | GDP a7a8f06; E1 92e9118; E2 31037d6; E4 5d761ec; carbon 753ac81; full SHAs in integration report/matrix |
| C omitted? | Shipping allocation conflict; target and byte-fidelity commits depend on it |
| D scientific assumptions changed? | NO; approved bug corrections only |
| E integrated regressions pass? | YES; shipping remains unintegrated/unfixed |
| F new HEAD? | Final exact source/record SHAs in manifest and final remote receipt; model-source fixes end at `1c476b1b6a8466d617709e2445f111bbf5df6c60` |
| G main unchanged? | Required invariant; exact final comparison in final receipt |
| H config layer? | YES, explicit non-runnable composition and four equal placeholders |
| I input registry? | YES, 35 identities including 10 excluded raw paths; no pending upgrades |
| J model manifest? | YES, exact source snapshot, tested hashes, NOT_RUN |
| K run schema? | YES, required run/config/input/environment/policy/output fields, no real run |
| L shared pools? | Source current: solid biomass, stored CO2, lignite plus atmosphere accounting; reference component inventory separate |
| M topology action? | YES, dangling TH transformer 765→766 |
| N Gate1 engineering blocker? | Shipping stopped conflict; topology/GIS are later assembly blockers |
| O ready Gate2? | NO unconditional handoff; request human review of shipping integration approach first |

Stop reached after Gate1. No A*, Buildings/Transport transfers, growth changes, carbon scope separation, carrier isolation, scientific Integrated/Disconnected differences, Full-SC assembly or solver run.

Final status updates and cleanliness are recorded only after commit/push verification, not assumed from tests. The final receipt is the authority for the delivery HEAD.

## Final source snapshot verification

Complete source snapshot: `9ee77cb0ba4c246f83492fbb6027c68066b41bda`. Clean local and matching remote research branch verified. All protected remote references exactly match the starting inventory. The subsequent record commit modifies only these identity/readiness records, with no model, configuration, input-registry, schema or test change. The exact record HEAD is in the external delivery receipt; the model manifest intentionally identifies its complete parent source snapshot.

```text
PHASE4_GATE1_FOUNDATION_BUILT=YES
APPROVED_ENGINEERING_FIXES_INTEGRATED=PARTIAL
SCIENTIFIC_ASSUMPTIONS_CHANGED=NO
RESEARCH_BRANCH_CLEAN=YES
REMOTE_MAIN_UNCHANGED=YES
STATIC_VALIDATION_FRAMEWORK_READY=YES
READY_FOR_PHASE4_GATE2_DEMAND_ACCOUNTING=NO
```
