cyc292cycjin-oss/SGP-ESE5004-Stage2/research/04_model_assembly/gate1/PHASE4_GATE1_START_IDENTITY.md

# Phase4 Gate1 starting identity

Verified on 2026-10-04T12:49:35.252936+00:00: research/full-sc-baseline started at exactly `a3616a68ee44592af6527ca9024a90f1956646ae`, with empty porcelain status and zero research commits. Remote research branch and main were both U. Evidence: `evidence/START.json` (all advertised refs).

Paper reference: `5bacad702ccfed17ad19ab510fa710651e966f2c`. Archive: `f7710800b495b60767ab6b7a5963f38b41aa03b4`. Reference tags, main and archive are protected by the scope of this task. The sole remote write target is `refs/heads/research/full-sc-baseline`; no force push or merge to main.

Canonical model worktree: `/home/jin/research/SGP_ESE5004_Stage2/phase2/research_model`. The Windows delivery repository is separate and its commit must never be substituted for a model SHA.

Gate1 is an engineering foundation. No scientific Full-SC network or formal result is created. Final source/record identities are reported in the model manifest and final remote receipt, avoiding a self-referential commit hash.
