cyc292cycjin-oss/SGP-ESE5004-Stage2/research/01_baseline_construction/data_registry/DATA_DECISIONS.md

# 数据决定记录

| Decision | 本轮依据 | 决定/状态 |
|---|---|---|
| D01 | 用户明确保持作者成本链 | 锁定technology-data v0.13.2及AEO8；未改参数；来源家族验收PENDING |
| D02 | 用户明确允许保留作者manual override | 保留电解投资曲线，SOURCE_PARTIALLY_VERIFIED；不伪造private communications，不用DEA原表550替换2030的1500 EUR2020/kW_e |
| D03 | 用户禁止更新DEA2026 | August2026/sheet80仅候选；不覆盖sheet86或模型表 |
| D04 | 现有GDP原始NC完整、缓存不匹配 | 仅在独立fix工作区重建；保留2015选择，不更新GDP年份/数值 |
| D05 | 十国基年量已有；TL缺行业记录 | 十国逐项守恒；TL=MISSING_NOT_ZERO；未来growth未决定 |
| D06 | 用户冻结Baseline+DEC及电力口径 | 碳键只改入口；不把预算扩到全社会；共享链路归属待共同决定 |
| D07 | 官方全年气象包可下载且文件名匹配metadata | AVAILABLE_CANDIDATE，完整字节/坐标/作者input hash未验；不宣称正式复现 |
| D08 | 上游明确删除bus766 | 不擅自撤销删除、改端点或删变压器；作者意图/可信修正方案待恢复 |
| D09 | 用户选择电力互联为第一干预 | 未来仅关跨境AC/DC；其他载能/外部商品边界保持同一；不生成国别碳配额 |

所有决定区分“用户已经规定的研究原则”和“仍需人工接受的数据”。无任何来源被Codex标成CONFIRMED。未来接受记录必须包含来源家族、固定版本/hash、允许的变换/override、关键参数检查、批准人/日期、适用场景和仍保留的局限。
