cyc292cycjin-oss/SGP-ESE5004-Stage2/research/02_sector_coupling/buildings_engineering_tests/E1_README.md

# E1 engineering candidate

Base: `a3616a68ee44592af6527ca9024a90f1956646ae`. Synthetic fixtures only; no solver and no accepted demand data.

Run: `python research/02_sector_coupling/buildings_engineering_tests/check_E1.py --repo . --fix E1 --output /tmp/E1.json`

The before result fails, the after result passes. Pending human review; not merged into Research Model.
