cyc292cycjin-oss/SGP-ESE5004-Stage2/research/02_sector_coupling/buildings_engineering_tests/E4_README.md

# E4 engineering candidate

Base: `a3616a68ee44592af6527ca9024a90f1956646ae`. Synthetic fixtures only; no solver and no accepted demand data.

Run: `python research/02_sector_coupling/buildings_engineering_tests/check_E4.py --repo . --fix E4 --output /tmp/E4.json`

The before result fails, the after result passes. Pending human review; not merged into Research Model.
