cyc292cycjin-oss/SGP-ESE5004-Stage2/research/02_sector_coupling/buildings_heat/phase3a5/BUILDINGS_E3_EVIDENCE_GAPS.md

# E3 证据缺口与关闭状态

2026-10-02；VERIFIED OBSERVATION、INFERENCE与PROPOSED分开。**E3 IMPLEMENTATION READY = NO / BLOCKED**；BLOCKED为科学验收状态，不表示本轮交付未完成。

## 本轮已关闭的追踪问题

- 已分清P的GEGIS与U/V的DemandCast，保存33个固定源码/配置文件及哈希；论文有效配置沿用既有证据，不再要求用户提供。
- 已定位R覆写、S新增、配电0.97乘AC负荷、后续增长/工业重分配、Services遗漏、字符串拼接；无需用户解释这些代码。
- 已把AEO8 2050配置值与发电量图及勘误核对；不再把该总量叫已核实终端用电。
- 已恢复DemandCast指定记录版本/全包MD5、本地教程文件身份、论文代码v0.9.0相关blob，以及Ember年值入口。导出精确SHA/历史Ember版本仍未闭合。
- 已取回12个UNSD原件，唯一匹配92条R/S2019记录；140条真实候选、44行历史电热矩阵、154行燃料用途矩阵均可审阅。
- MY官方Table42/Table47及其覆盖限制已核对；R多年份水热结构已定位；SG典型户与国家分母不相同；PH2011回忆期索引线索已恢复。无需重找已有NEB/NEA/UNSD/ERIA文件。

## 最少五组阻塞证据

| ID | 关键证据 | 当前缺口 | 足以关闭的验收内容 |
|---|---|---|---|
| G1 | A*统计边界与未来电气化桥 | gross generation、供电量、终端量、损耗/own-use、ASEAN10/11不同；未来隐含电气化未分解。 | 同一国家/年/边界的原始年表+损耗/own-use/net-trade关系+R/S包含关系；认可如何处理未来嵌入电气化。|
| G2 | R/S四项历史电热D/E | 44组合只有MY R/S各一个较强2016水热量；仍非2019完整全国；没有完整space矩阵。 | 国别/部门/用途电输入量及覆盖/调查期/代表性/年份桥，或明确接受且单独记录的范围/假设。|
| G3 | 非电用途与历史设备性能 | 燃料总量不能分水热/供暖/烹饪；设备能量份额与季节效率/COP空。 | 用途×燃料×设备输入能量份额，历史性能年份与HHV/LHV/服务边界；对应有用热数量可复算。|
| G4 | 年份和空间覆盖 | Peninsular/地方/典型户≠全国；2016/2017≠2019。 | 调查方法/扩样权重与相容的2019分母；迁移依据与不确定性，不擅填统一百分比。|
| G5 | R/S独立时间与节点分配 | 地方行为证据不等于全国热水8760；S活动和space气候区权重缺。 | 使用时刻/季节/时区、物理权重、节点覆盖数据及获认可分配法；总量守恒、正量零形状失败检查。|

G1/G2/G3直接阻止E3构造；G4/G5阻止将局部候选升级为可运行的11国科学输入。不能以代码测试替代这些证据。

## 数据缺失与研究决定分开

**数据/版本缺失：** 原始gross↔meter桥、DemandCast导出SHA与Ember vintage、GEGIS包年度计量元数据；各国端用电热/历史设备；MY方法与表内差额；PH原PDF；SG权重；时间/空间原始表。

**共同研究决定：** 已接受会计结构下用哪一份相容统计实现A*；未来gross预测与内生技术竞争的衔接；是否接受某明确限定的年份/区域迁移或标为ENGINEERING_ASSUMPTION的性能；当前证据不足时研究覆盖范围是否缩减。当前授权没有批准缩减11国/R/S/full heat，故保持目标、不给未知填零。

已经冻结而无需再问：R/S分开；有用热外生/供应技术内生；cooling留direct electricity；cooking非显式但必须记账；BDEW仅reference；不采用欧洲stock或ASEAN默认零；E3不写patch。
