cyc292cycjin-oss/SGP-ESE5004-Stage2/research/02_sector_coupling/buildings_heat/phase3a5/BUILDINGS_PHASE3A5_READINESS.md

# Phase3A5 Buildings E3 Evidence Closure 交付与判定

Material Passport: academic-research-suite / fact-check; Phase3A5 v1; 2026-10-02。证据收集与候选记录已完成；**E3 IMPLEMENTATION READY：NO / BLOCKED**。此状态针对科学模型数据门槛；不是本轮工作未交付。

本轮无E3 patch、无正式求解、无模型数据更新、无其他部门启动。E1/E2/E4的1062/1062 PASS引用已冻结Phase3A4记录，**没有重新运行**，也没有写成DATA ACCEPTED。

## A–P 必答结论

| 项 | 判定 | 证据/限制 |
|---|---|---|
| A A*科学边界能否定义？ | **不能实例化/冻结真实A*** | 已接受共同口径会计结构不变；GEGIS/DemandCast、AEO发电量与UNSD终端量还没有统一bridge。|
| B 11国R/S历史电热足够？ | **否** | 44组合均已列；只有MY R/S2016水热有较强量化原值，覆盖/年份未通过；space无完整国家矩阵。|
| C 哪些国家可构建candidate useful heat？ | **MY最接近；SG与8国区域样本可建局部证据候选；无一国完整Q_useful可算** | MY已知水热final electricity；SG只有典型份额；ERIA仅混合燃料地方样本。140条是候选，不是140条有用热数值。|
| D 哪些只能保留final-energy calibration？ | **11国均保留UNSD候选；BN/MM/TL仅有此层；其余大部分S仍止于此** | ID/KH/LA/PH/TH/VN有局部/定义证据，尚无国家完整转换。|
| E 哪些end-use shares可以采用？ | **仅已给end_use量的share=1是范围恒等；经验份额尚未接受** | MY源年R约3%、S约2.64568%可供审阅；SG11%不可自动乘全国总量；不使用统一60/40。|
| F 哪些设备效率/COP可采用？ | **本轮无已接受值** | 历史设备能量份额、年份、季节/额定、服务边界欠缺；未借未来DEA值。|
| G 哪些year bridge合理？ | **MY结构→2019有明确待检验路径；未执行** | R2013–2016约3%是同源多年份估计，不能证明2019迁移；SG先解分母，PH先解半年期。|
| H cooking每国明确保留去向？ | **不完整** | MY R按燃料有明确DirectElectricity/DirectFuel；其余未知用Unclassified保留原账户，不混入H/I、不删除。|
| I cooling明确留direct electricity？ | **科学规则已冻结；本轮无新增cooling Load** | F是B/C内子项，不扣A*；真实完整网络数值无重复需E3日后验收，不能此刻宣布已通过。|
| J space heat何处有证据？ | **地区证据，非国家完整量** | VN Hanoi/HoaBinh样本；ERIA KH/SG城市样本小正值需定义核验。无列/舍入零不代表全国零。|
| K water heat何处可用？ | **MY官方R/S最强；SG份额；PH索引；ERIA8国地方证据** | 地方/份额证据不可等价国家电热能量。|
| L temporal method可执行？ | **算法契约可；正式输入不可** | 水热usage-based与HDD解耦；缺R/S独立且有代表性的形状、季节与时区证据。|
| M spatial method可执行？ | **守恒算法可；国家节点数据不可** | R/S分别、国界约束、space气候区与S活动权重均未完整接受。|
| N 数据是否足以实施E3？ | **否** | A*、h_R/h_S、非电热和历史性能、覆盖年份桥、时间/空间仍有阻塞。|
| O 最少缺哪3–5项？ | **五组** | G1计量/未来电气化；G2历史电热；G3燃料用途/历史设备性能；G4年份/覆盖；G5时空证据。|
| P E3 IMPLEMENTATION READY？ | **NO / BLOCKED** | 不写patch；不启动Integrated/Disconnected；本轮完成后停止。|

## 交付导航

- [BASE_ELECTRICITY_BOUNDARY_TRACE](BASE_ELECTRICITY_BOUNDARY_TRACE.md)：三层完整链、边界与AEO校核。
- [历史电热矩阵](ASEAN_BUILDINGS_HISTORICAL_ELECTRIC_HEATING_MATRIX.csv)：44行，未知不填零。
- [燃料用途矩阵](ASEAN_BUILDINGS_ENDUSE_EVIDENCE_MATRIX.csv)：154行，11×2×7覆盖及候选ID。
- [Final-to-useful证据](BUILDINGS_FINAL_TO_USEFUL_EVIDENCE.md)、[年份桥](BUILDINGS_YEAR_BRIDGE_METHOD.md)、[space/water](BUILDINGS_SPACE_WATER_MAPPING.md)、[时间](BUILDINGS_TEMPORAL_METHOD.md)、[空间](BUILDINGS_SPATIAL_ALLOCATION_OPTIONS.md)。
- [真实候选输入](BUILDINGS_USEFUL_HEAT_INPUT_CANDIDATES.csv)：140行，原41字段+6审阅字段；所有Status=UNVERIFIED，HumanConfirmationRecord=PENDING；0 useful-service结果、0已填历史性能。
- [缺口](BUILDINGS_E3_EVIDENCE_GAPS.md)、[精确用户资料请求](USER_INPUT_NEEDED_BUILDINGS.md)。

## 复核与复现

来源登记 `data/raw/buildings/SOURCE_REGISTRY.json`，记录URL/version/year/hash/license/purpose。大原件保留raw并收入本地交付包，不混进上游模型或Git源码；来源许可未知时明确标记，不自行声明开放许可。

`build_candidates.py`从12份原始UNSD导出及有页码的源表记录生成审阅JSON；`export_tables.mjs`通过Artifact Tool导出CSV；`validate_delivery.py`验证CSV/JSON逐值、44/154覆盖、来源哈希、缺失留空、47字段、角色/确认状态及原件匹配。它们只处理研究证据，不调用模型或优化器。

冻结P/U/V/R的提交及清洁状态见CODE_IDENTITY；源码函数差异保留。新审计文件单独commit，root与WSL research_audit逐blob同步。完整交付包有逐文件SHA256 manifest，外部receipt记录两个审计commit和包SHA，避免自引用哈希。根目录原有outputs/work未跟踪目录保留；不能将其称为整个root无未跟踪文件。最终版本/包校验以交付receipt为准。
