cyc292cycjin-oss/SGP-ESE5004-Stage2/research/02_sector_coupling/buildings_heat/phase3a5/BUILDINGS_YEAR_BRIDGE_METHOD.md

# Buildings 年份衔接方法

Material Passport: academic-research-suite / method proposal; Phase3A5 v1; 2026-10-02。以下为PROPOSED，不是已接受输入；候选保留原参考年。

目标校准年继续使用2019候选，不能将2016/2017的绝对量改标签为2019。必须分别记录调查波次、统计参考年、发布版与气象/模型年。

## 可审阅的最小方法

对相同country/sector/fuel/coverage定义：先从源年得到用途比例 `s_y=F_enduse,y/F_fuel,y`，再提出 `F_enduse,2019=s_y×F_fuel,2019`。只有比例可迁移的证据获接受后才能执行。DeviceInputShare和historical efficiency也应桥接到对应服务基准，不能混用2016用途、2050热泵COP。

| 候选 | 中间证据 | 可行性与停止条件 |
|---|---|---|
| MY R2016结构→2019 | Tables39–42给2013–2016电热水比约2.9934%、2.9887%、3%、3.0004%。 | 可建立**待检验比例迁移**；数据可能来自共同估算结构，不证明独立稳定性。Peninsular→national及2019分母必须先闭合。|
| MY S2016→2019 | Table47水热/总电力=1034.62/39106≈2.64568%；用途加总差0.43GWh。 | 只有单年/调查覆盖证据；先解决扩样、总量差和商业类别变化，不能直接采用。|
| SG2017→2019 | 官方典型户水热11%、全国总量7295GWh。 | 能量加权分母先于年份桥；不能通过换2019全国总量自动变成全国份额。|
| PH2011→2019 | 2011六个月、2004一年；原PDF尚缺。 | 季节/调查方法/家电渗透变化均未定；不可×2或按年份线性插值。|
| ERIA2011–2012/BELDA2014–2015 | 地方样本与参考期可定位。 | 时间+样本扩展双重缺口；不得全国迁移。|
| UNSD2019→2019 | 原始R/S交易与单位已保留。 | 无年份转换，但统计范围、燃料热值、用途拆分未闭合；same year不等于同口径。|

比例移植必须提交：调查设计/扩样方法；对应部门2019分母；家电普及、燃料替代、服务业结构或新调查证据；可复核的变化方向或区间。没有证据不编造±10%或统一趋势。原值、分母、比例、迁移依据、结果、人工接受分栏保存。

本轮只计算源年比例用于核对（见CANDIDATE_SOURCE_CHECKS），没有生成任何2019加热量，也没有执行2030/2040/2050未来服务路径。未来基准直接需求如何排除AEO隐含电气化是另一项边界决策，不能用历史年桥替代。
