cyc292cycjin-oss/SGP-ESE5004-Stage2/research/02_sector_coupling/buildings_heat/phase3a5/USER_INPUT_NEEDED_BUILDINGS.md

# 仅保留真正需要补充或共同决定的项目

2026-10-02。先复用当前仓库、缓存原件、官方链接与作者引用；本轮检索是定向有限检查，不声称穷尽全网。以下文件若手边没有，不要求用户重做大范围搜集；保持缺口并据优先级另行安排作者/统计机构核查。本轮未联系或发送信息给任何作者/机构。

## 优先原始资料

1. **电力边界：** 如用户/导师持有作者计算工作表，请提供`final_asean_adjustments.total_elec_demand`六个年份对应的AEO8 **BAS年度发电/终端消费、own-use、输配损耗、净进出口**工作表及各国范围说明，尤其ASEAN10与TL的处理。已找到官方报告与勘误，不需重发PDF。若有DemandCast Zenodo18374352导出manifest（代码SHA、Ember年度CSV的日期/哈希、年量缩放流程）或论文GEGIS包说明，也只需该manifest；现有Git代码/网址不用再找。
2. **Malaysia：** NEB2016 Chapter5住宅Table39–42、商业Table47背后的调查方法/原工作表：Peninsular→national扩样、Sabah/Sarawak覆盖、实际调查年份、2015/2016是否按比例推算；解释Table42 cooking655与燃料格656、Table47总量39106与分项39105.57。另需water-heater设备类别的**输入能量占比**及同年季节效率/使用条件；不是DEA未来设备性能。现有NEB全文、已定位表格不用重发。
3. **Philippines：** 官方《Compendium Energy Statistics1990–2021》Table2完整PDF页及脚注（2011 HECS六个月、户数/用电均值/百分比分母）；或2023 HECS已发布的water/space heating **燃料、电量、调查期、扩样权重**结果表。legacy域名下载失败，新域同路径返回HTML；技术说明没有这些数值。请不要只给无脚注截图或把六个月量标为年量。
4. **Singapore：** NEA2017 HECS关于典型户11%water heater份额的分母、样本/能量权重及热水器类别/性能方法附录；明确能否转为全国电量。已取得7295GWh/11%新闻页，无需重发。Services热水若无现成原表，继续记unknown，不要求用户临时调查。
5. **局地方法（次优先）：** 如已有BELDA2017原始问卷/去标识汇总（地区、2014-10至2015-09月能耗、燃料、设备使用时刻）或Hanoi研究的冷热水/进水温度与样本说明，可支持局地时间/空间方法。无需个人身份资料，亦不能自动全国扩样。

BN/MM/TL及大多数Services没有在现有证据中恢复足够端用量；这是真实覆盖缺口，但本轮不向用户开“请提供所有国家建筑数据”的泛化清单。应先决定目标证据门槛与定向来源策略。ID ESDM/UNSD差异同样需统计范围说明，不能请用户凭判断选一个数字。

## 等证据齐后共同决定，不是现在再次批准已冻结边界

- 如何将AEO gross目标转换或另行对齐到已接受E3所需A*，并避免重复计入未来电气化；不因变量名自行选定。
- MY结构年份迁移/调查区域外推能否接受，及如何表达有依据的不确定性；SG典型户份额能否用于全国。
- 历史设备性能若只能作工程假设，是否接受、覆盖哪些国家/设备；此类决定必须单列ENGINEERING_ASSUMPTION与人工记录。
- 时间/空间分配采用哪一套来源；是否接受明确局部研究范围。当前full11国目标未自动缩小。

这些请求用于下一轮证据关闭。本轮交付完成后停止，既不等候模糊“全部确认”，也不绕过缺口实现E3。
