cyc292cycjin-oss/SGP-ESE5004-Stage2/research/02_sector_coupling/buildings_heat/phase3a6/AEO8_ELECTRICITY_SOURCE_TRACE.md

# AEO8 原始电量来源核对

**3036.3 TWh = AEO8 Baseline Scenario（BAS）2050 年 Electricity Generation。** 原表没有在标题中给出gross/net限定，因此本轮确认“发电量”，不把“gross”进一步写成已证事实。

原件：[ACE 官方入口](https://www.aseanenergy.org/publications/the-8th-asean-energy-outlook/)。复用已有PDF，不重新下载。AEO8 SHA256 `48c2a81913ed785cb0e14a55e332ea7bc87f912f7fabfbc8c654e09b66b11c06`；November2024勘误 SHA256 `2796d38469b9b45b29319f8f72172260ff400ae3f6a93cbf92aa7099463dea7b`。具体文件、下载URL、访问日期见 `data/SOURCE_REGISTRY.json`。

## 精确位置和逐年对照

发电：**PDF186 / 印刷184，Appendix C.5，Electricity Generation by Fuel/Feedstock (TWh)，BAS Total行**。2050也见PDF82 / 印刷80 Figure3.25。终端：**PDF183 / 印刷181，Appendix C.2，TFEC by Fuel (Mtoe)，BAS Electricity行**。两个附录页面均已渲染目视核对。

| 年份 | C.5发电TWh | 当前P/U/V目标MWh | C.2终端电力Mtoe | 条件换算TWh：×11.63 |
|---|---:|---:|---:|---:|
| 2025 | 1401.4 | 1401400000 | 104.0 | 1209.520 |
| 2030 | 1658.8 | 1658800000 | 123.0 | 1430.490 |
| 2035 | 1940.2 | 1940200000 | 143.8 | 1672.394 |
| 2040 | 2264.6 | 2264600000 | 167.9 | 1952.677 |
| 2045 | 2635.0 | 2635000000 | 195.3 | 2271.339 |
| 2050 | 3036.3 | 3036300000 | 225.0 | 2616.750 |

左三列数值对应由 `build_prototype.py` 从PDF文字与三份冻结配置读取并断言，记录于 `data/derived/AEO8_TRAJECTORY_CHECK.json`。这证明六年数值与明确标注BAS来源的配置一致；不冒充找到了作者原始手工提取工作簿。

C.2列是**直接报告值**，不必用TFEC×电力占比估算。2050用1107.9×20.3%只能得到224.9037Mtoe，属于对舍入数据的推导；原表225.0Mtoe优先作为来源候选。

末列是**有条件的单位推导，不是原表TWh**。[INSEE单位定义](https://www.insee.fr/en/metadonnees/definition/c1355)给出1toe=41.868GJ=11.63MWh；已保存原HTML及哈希。AEO8采用这一精确系数的元数据未找到，因此不能用该列自动替换模型。MY NEB明确采用41.84GJ/toe，其系数不能移植给AEO。

2050发电与条件换算终端相差419.55TWh；不能把差额全部称为T&D损耗，也不能据此设统一损耗率。该差额可能涉及贸易、自用、输配、转换和统计定义等多项，需要供用平衡明细。

## 版本、地域和情景

November2024勘误修改印刷80 Figure3.25，BAS总量保持3036.3TWh。勘误列出C.1/印刷180和C.6/印刷185等修订；本次C.2/印刷181和C.5/印刷184未列作被替换表。全文原件仍随包保存，不能以未列修订推定其他版本永不改变。

PDF17介绍明确由ACE和十个AMS合作，PDF5也明确10 AMS；这是出版时的ASEAN10。当前代码国家列表含TL共11国，把同一总量分给11国是模型设置，不能视为来源覆盖TL的证据。

PDF48/印刷46：BAS行业结构/强度、车辆燃料份额、设备效率等保持最新历史设定，同时住宅/商业清洁烹饪与电气化沿历史增速。PDF49/印刷47：电力供给满足需求，自用及损耗占比保持最新值。PDF56/印刷54：终端电力需求与出口目标驱动发电模块，H2/ammonia等还有非电力转换过程。因此C.2与C.5有不同会计位置。

冷气增长、既有交通用电与水热用途并非在AEO内全部为空；但BAS不能与ATS/RAS/CNS的加强电气化混同。BAS交通2050电力只占0.2%（PDF65），C.2的BAS终端H2为舍入到0.0Mtoe，二者都不足以证明“大规模BAS EV/H2转换已包含”。详见scope matrix。

**数据地位：** 来源转录已核验；模型适用性与人工确认均PENDING。这里恢复了可供讨论的终端轨迹，没有批准任何目标替换。
