cyc292cycjin-oss/SGP-ESE5004-Stage2/research/02_sector_coupling/buildings_heat/phase3a6/BASE_FUTURE_ELECTRICITY_BOUNDARY.md

# 历史基年与未来电力演化

**BASE_YEAR_ELECTRICITY_BOUNDARY：PENDING。FUTURE_ELECTRICITY_EVOLUTION_BOUNDARY：PENDING。** 两者需要分别验收。

| 维度 | 历史基年候选 | 当前未来链 |
|---|---|---|
| 年份 | UNSD2019 R/S，Malaysia end-use主要2016；网络形状2013 | AEO2022基期，规划2025/2030/2035/2040/2045/2050 |
| 统计含义 | 最终用户的燃料/电力投入；不同表的部门分区待调和 | 当前配置使用C.5发电量；C.2终端量另有六年原表 |
| 地域 | 各国；MY用途仅半岛而国家能源表全国 | AEO出版ASEAN10，配置国家权重覆盖11含TL |
| 时间 | 年度校准与天气/形状年份不同，不自动互认 | 年目标按国家权重缩放，再按既有曲线分配 |
| 科学门槛 | A*、T_R、T_S、h_R、h_S同年/域/表界，O有互斥解释 | direct-service增长与显式转换需求分开；不能原样复制总TFEC后再加所有转换 |

未来建议审阅的契约是：先定义每个最终服务如何从基年演化，再把固定direct electricity与优化内生的HP、阻热、电解及其他转换输入分开。AEO终端全量可作候选参照或对账约束，不能自动等同于“不含未来转换的direct electricity”。未来EV等配置的采用份额可能仍是外生；“转换用电内生”不意味着车辆普及率也由优化决定。本轮未开展Transport实现。

历史电热恰好一次转移：共同基年 `D=A*−h_R−h_S`。未来热服务增长后通过技术性能得到新的用电，不是从2019减掉h便可以把2050综合电量原样装入D。模型仅支持技术还不足以证明数据已经匹配。

**推断而非观测结果：** 若保持含既有/未来电气化的综合父电量，又独立加入相同服务的转换Link输入，可能重复；重复数额依赖情景/用途拆分、实际保留组件及最终缩放，需要未来审计，不能本轮估一个比例。

本轮未创建未来direct增长数据、TL校准值或转换用电轨迹。六年来源表恢复只关闭“找不到轨迹”，未关闭“哪条轨迹适合本科学问题”。
