cyc292cycjin-oss/SGP-ESE5004-Stage2/research/02_sector_coupling/buildings_heat/phase3a6/FULLSC_ASTAR_CANDIDATES.md

# Full-SC 的 A* 候选边界

**RECOMMENDED FOR HUMAN REVIEW：候选1；候选2作为有供用平衡证据时的备选。** 没有自动选择、Human Acceptance或配置修改。

沿用已接受结构：A*为扣历史电热之前的共同电力父账户，`D_accepted=A*−h_R−h_S`。因此不能把候选1的A*误命名为“已经扣完电热的direct electricity”；后者是D。

| 比较项 | 候选1：终端电表电力父账户 | 候选2：明确层级的供电bus父账户 | 候选3：现有AEO发电校准目标 |
|---|---|---|---|
| 科学含义 | 与交付最终用户的部门电力总量对齐 | 配电输入/高压bus上分区一致的供电量；必须明确具体层级 | 保持现有代码的发电数量目标解释，用于paper-reference追踪 |
| 来源可得性 | AEO C.2六年Mtoe可恢复；国别历史final数据存在但需统一 | 需要各国供用平衡、贸易、auxiliary及分层损耗 | C.5六年TWh和配置已完全匹配 |
| SC兼容性 | 最接近R/S终端能耗和恰好一次热量转移 | 可行，但R/S/h须同步映射到bus或保留显式低压节点 | 不能直接作为最终用户A*再叠加SC转换用电 |
| 损耗 | 终端量不预含上游损耗；显式组件损耗独立处理 | 与预含损耗对应的网络段必须避免重复计量 | 原发电含哪些非终端项尚未分解 |
| 未来电气化 | 单独建立direct-service增长，历史及未来转换边界逐项对账 | 同候选1，再加每年损耗映射 | 原轨迹含AEO用途/转换假设，直接再加HP/EV/H2风险高 |
| 历史一致性 | 同年、同地域、同部门分类；GEGIS/DemandCast只在接受边界后提供形状 | 需要测点和时间维度均一致 | 2013形状、未来生成目标、UNSD2019并非天然同域 |
| 数据要求 | 国别总量、R/S归类、h、TL范围桥及用途轨迹 | 候选1+分层loss/own-use/trade | 原文和配置已足够用于审计；不足以冻结科学SC父账户 |
| 双计风险 | 控制点清楚，但不能把未剥离的未来TFEC全量当D | 边界映射复杂，需核查每段损耗与转换只记一次 | 尚高，不能靠改变量名消除 |
| 实施复杂度 | 中：先接受数据与服务边界，再设计实现 | 高：还需额外电压/计量层映射 | 保留paper reference简单；改成有效Full-SC科学边界仍复杂 |
| 本轮地位 | RECOMMENDED FOR HUMAN REVIEW | CONDITIONAL ALTERNATIVE FOR HUMAN REVIEW | REFERENCE-ONLY COMPARATOR，非Full-SC推荐输入 |

人工决定需要回答：A*放在哪个计量点；未来direct-service与内生转换如何拆分；省略的损耗如何声明；ASEAN10目标如何处理TL。单位和来源不一致属于数据证据问题，不能通过投票把它们视为已一致。

Human Acceptance前不替换 `total_elec_demand`，也不把C.2自动接入任何模型输入。
