cyc292cycjin-oss/SGP-ESE5004-Stage2/research/02_sector_coupling/buildings_heat/phase3a6/MALAYSIA_2016_2019_YEAR_BRIDGE.md

# Malaysia 2016→2019 年份与范围桥

**YEAR_BRIDGE_PENDING。** 公开统计足以检查总量趋势，尚不足以把2016半岛水热份额原样乘全国2019 R/S。

复用NEB2016，新取得[NEB2019官方原件](https://www.st.gov.my/sites/default/files/2026-02/NEB_2019.pdf)，ST(P)02/02/2022，官方落地页发布2022-04-29，SHA `141f20588ead46a942526a1e6c0a7f730a67cd586f071868f68294492aad3009`。网页迁移目录2026-02不是统计年份。

## 可恢复的趋势和不一致

| 项目 | 2016 | 2019 | 解读 |
|---|---:|---:|---|
| Table17 全国 electricity GWh | 144024 | 158603 | 总量增长，不证明water份额不变 |
| 同表全国住宅 GWh | 31128 | 33322 | 源系列的R分区；与2019平衡表明显不同 |
| 同表全国商业 GWh | 44349 | 45713 | 同上 |
| 同表半岛住宅 GWh | 27119 | 28877 | 地域相近，但仍缺2019用途表 |
| 同表半岛商业 GWh | 39484 | 40471 | 与2016用途表39106本身有差额 |
| 全国能量平衡R总能量 ktoe | 3284 | 3339 | 2016/2019各自版平衡；可受修订/分类影响 |
| 全国能量平衡S总能量 ktoe | 4765 | 4662 | 非全部单调增长 |
| 全国平衡R LPG ktoe | 602 | 615 | 不是直接的用途转移证据 |
| 全国平衡S LPG ktoe | 760 | 163 | 大幅差异，需定义/修订说明，不能自动解释为真实燃料替代 |
| 全国平衡S diesel / fuel oil ktoe | 151 / 14 | 340 / 50 | 说明固定全部燃料结构没有现成证据 |

NEB2019 Table25 PDF67在**同一版**中给R+S总能量2016–2019分别8051、7796、7773、8000ktoe；Table26 PDF68给全国终端电力12394、12607、13153、13647ktoe。2016原版R+S总量8049、终端电12392与后版历史系列略有不同；保留版本而不覆盖旧数据。2019打印R3339+S4662=8001，与Table25的8000也有舍入差异。

water份额只能由2016原表推导：R为70/2333≈3.000429%；S为1034.62/39106≈2.645681%。2015 R原表为63.48/2116=3%，相邻早年接近固定比例不能证明2017–2019实测不变；也可能反映估算规则。未找到匹配地域和调查口径的2017–2019 water年度系列。

## 2019 部门分区冲突需要先解决

| 来源家族 | R electricity GWh | S/Commercial electricity GWh |
|---|---:|---:|
| NEB2019 Table17 PDF57 | 33322 | 45713 |
| NEB2019 Table29 PDF72–73，2715/4086ktoe按该版41.84转换 | 31554.333333 | 47488.400000 |
| 现有UNdata2019原始行，2025-05-02导出 | 31570.164 | 47517.709 |

Table29与Table17的R差−1767.666667GWh、S差+1775.4GWh；两部门合计只差7.733333GWh不意味着R/S可互换。UNSD与Table29相近也不证明同版同定义。公开原件没有把此差异清楚归因为何种分类调整；保持**SOURCE_RECONCILIATION_REQUIRED**。

## Share-preserving候选，仅保留公式

`h_R,2019 = T_R,2019 × s_R,water,2016`；S同理。使用条件依次是：接受R/S家族和测点、半岛到全国的可分区扩展证据、统计年/调查波次桥、2016–2019用途份额变化证据。条件未满足，本轮不计算全国2019 h候选数值，更不写入模型。

两端及中间总量趋势的检查已完成；缺的是用途和分类桥，不是让用户重新寻找已缓存的整本NEB。
