cyc292cycjin-oss/SGP-ESE5004-Stage2/research/02_sector_coupling/buildings_heat/phase3a6/PHASE3A6_DATA_GAPS.md

# Phase3A6 缺口变化与停止点

## 本轮关闭

| 旧问题 | 新证据 | 关闭范围 |
|---|---|---|
| 仅2050图可匹配AEO目标 | C.5 PDF186六年Total逐项等于P/U/V配置 | 源表、单位、年份、场景和消费函数已恢复 |
| 是否存在final轨迹 | C.2 PDF183 Electricity六年Mtoe直接报告 | 不再需要TFEC×share推算；精确AEO转换约定仍待确认 |
| MY用途表是否全国 | PDF91/97章节标题，92/98调查简介 | 明确半岛；全国扩展没有自动成立 |
| MY ktoe单位口径 | PDF105/108 NCV、41.84GJ/toe、3.6TJ/GWh | 本版R水热输入可换算；不得替换成41.868 |
| 是否有2019对照和2016–2019趋势 | NEB2019 Tables16/17/25/26/29 | 全国/半岛总电量、R/S及燃料变化已核查；新增分类冲突 |
| 水热器旧官方URL失效 | 当前官方落地页和新PDF恢复，保留旧404记录 | 无须用户重找公开安全指引；效率/存量未关闭 |
| 配电与AC优化损耗位置 | Link效率1、0.97乘AC；本地优化器loss默认0 | 实现事实清楚；共同统计loss bridge尚未建立 |

## 仍需证据

1. **全国2019共同电力父账户与R/S分类**：NEB Table17和Table29为何分区不同，UNSD导出与本国修订的交叉说明；不能平均。
2. **热用途的地区/年份桥与space未报告**：2016半岛调查扩样方法，2017–2019同域用途或设备趋势，Sabah/Sarawak补充；absence不能变零。
3. **历史设备性能**：R/S设备按输入能量份额、历史季节效率/COP，量测边界含不含储热/管路/辅助电；安全证书不够。
4. **未来电力分解**：AEO按国/年/最终用途和转换的电量、发电gross/net定义、own-use/loss/trade，以及精确Mtoe约定。已恢复C.2无需重索全表。
5. **时空可行性**：在上述年度条件接受后，获得住宅和服务业分别可支持的负荷形状、地区分配、时区及物理权重；本轮未满足启动小时检验的条件。

## 属于研究边界选择的事项

A*选择terminal还是明确供电bus；未来direct-service增长如何与内生转换分开；ASEAN10数据对TL的处理；Commercial到Services的活动范围；useful heat交付点；省略损耗的模型声明。这些需要人工科学验收，不能伪装成下载更多数据便会自动决定的问题。

**最小前置证据组**：共同A*/R/S分类、同年同域space/water投入、历史设备性能、未来direct/转换拆分（含TL及loss边界）。小时数据在年度通过后接续。本轮完成source→report，不冻结Full-SC边界，不进入正式Integrated/Standalone设计参数化。
