cyc292cycjin-oss/SGP-ESE5004-Stage2/research/02_sector_coupling/buildings_heat/phase3a6/PHASE3A6_READINESS.md

# Phase3A6 验收结论

完成18项交付：11份报告、7张CSV；额外保留来源登记、研究侧计算、核验记录及原件。**可审阅边界候选和Malaysia部分原型；不能冻结正式Full-SC输入或实施E3。**

| 必需标记 | 结果 | 精确含义 |
|---|---|---|
| ELECTRICITY_BOUNDARY_READY_FOR_HUMAN_REVIEW | YES | 当前来源/消费函数及最多3个候选足以进入科学边界讨论；未接受A* |
| MALAYSIA_E3_PROTOTYPE_READY_FOR_HUMAN_REVIEW | YES | 可审阅真实输入、部分转移与失败门槛；**不表示年度闭合或useful值可用** |
| E3_PRODUCTION_IMPLEMENTATION_READY | NO | A*/来源分类、历史h、年份地域桥、设备性能和时空可行性尚未全部接受 |

原型状态是 `PARTIAL_SOURCE_ACCOUNTING_ONLY`；annual E3 `BLOCKED`；snapshot `NOT RUN`；useful heat数值 `BLOCKED`；新输入人工确认数0。已有工程1062/1062通过记录复用，不重跑。

## A–K：电力边界

| 问题 | 回答 |
|---|---|
| A 当前3036.3是什么 | AEO8 BAS2050发电量；原表未给gross/net限定，不能越界确认gross |
| B exact source | C.5 PDF186/印刷184 Total；另见Figure3.25 PDF82/印刷80。六年值全部核对 |
| C 是否作为demand target | 是：配置数值对应发电表，代码将其作为选定Load的年目标 |
| D 哪一步 | `include_electricity_growth`人口×人均权重归一到 `total_elec_demand`，随后改Load；后续工业重分配另有条件 |
| E final轨迹是否存在 | 是：C.2 PDF183/印刷181 BAS Electricity直接报告104.0/123.0/143.8/167.9/195.3/225.0Mtoe；不是TFEC×share推算 |
| F base/future相同吗 | 未证实相同；2013形状、UNSD2019、MY2016、AEO未来generation属于不同年/统计链 |
| G loss双计 | 有条件风险；Link1与AC×0.97不是已核实meter bridge，当前AC默认无显式Line损耗，不能宣称已量化双计 |
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
