cyc292cycjin-oss/SGP-ESE5004-Stage2/research/04_model_assembly/gate1/evidence/previews/inputs.png

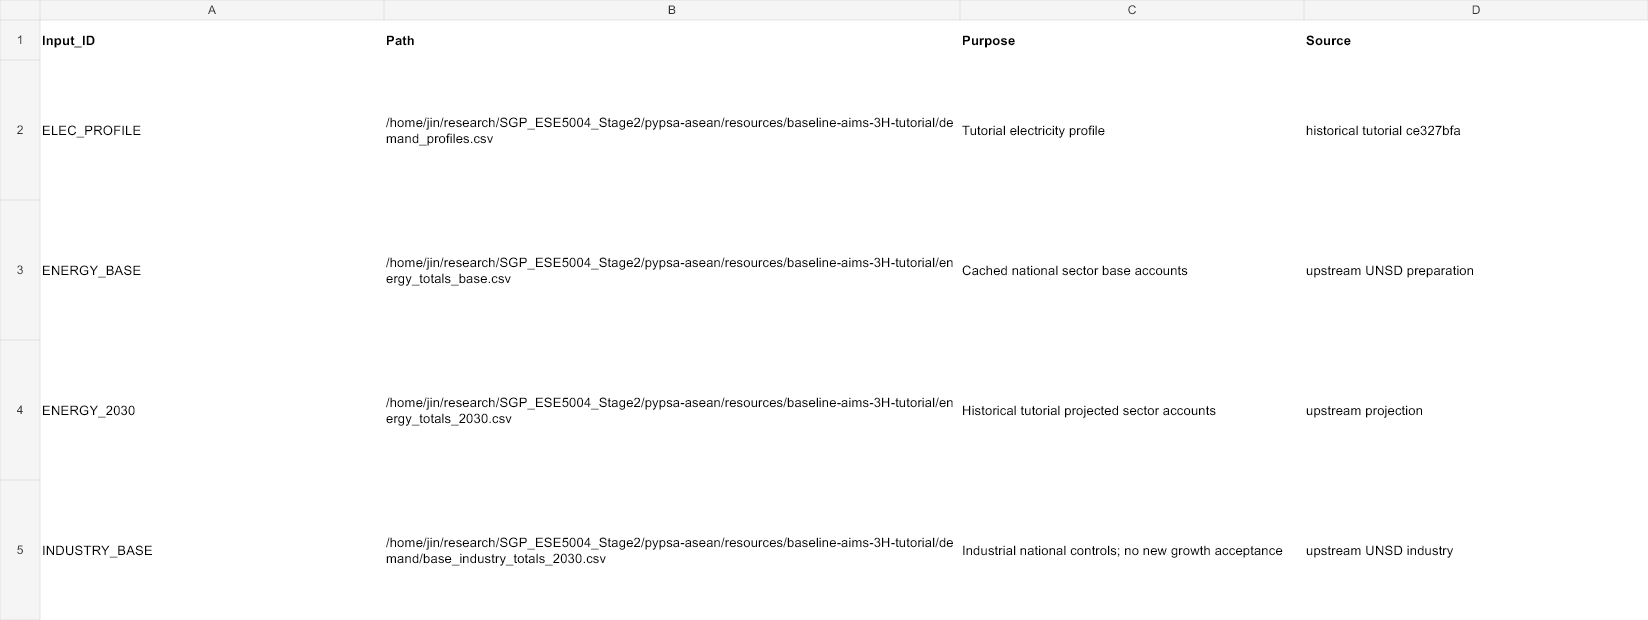
research/04_model_assembly/gate1/evidence/previews/inputs.png
