cyc292cycjin-oss/SGP-ESE5004-Stage2/research/04_model_assembly/gate4/evidence/previews/PHASE4_ACTIVE_SECTOR_COUPLING_PATHWAYS.csv.png

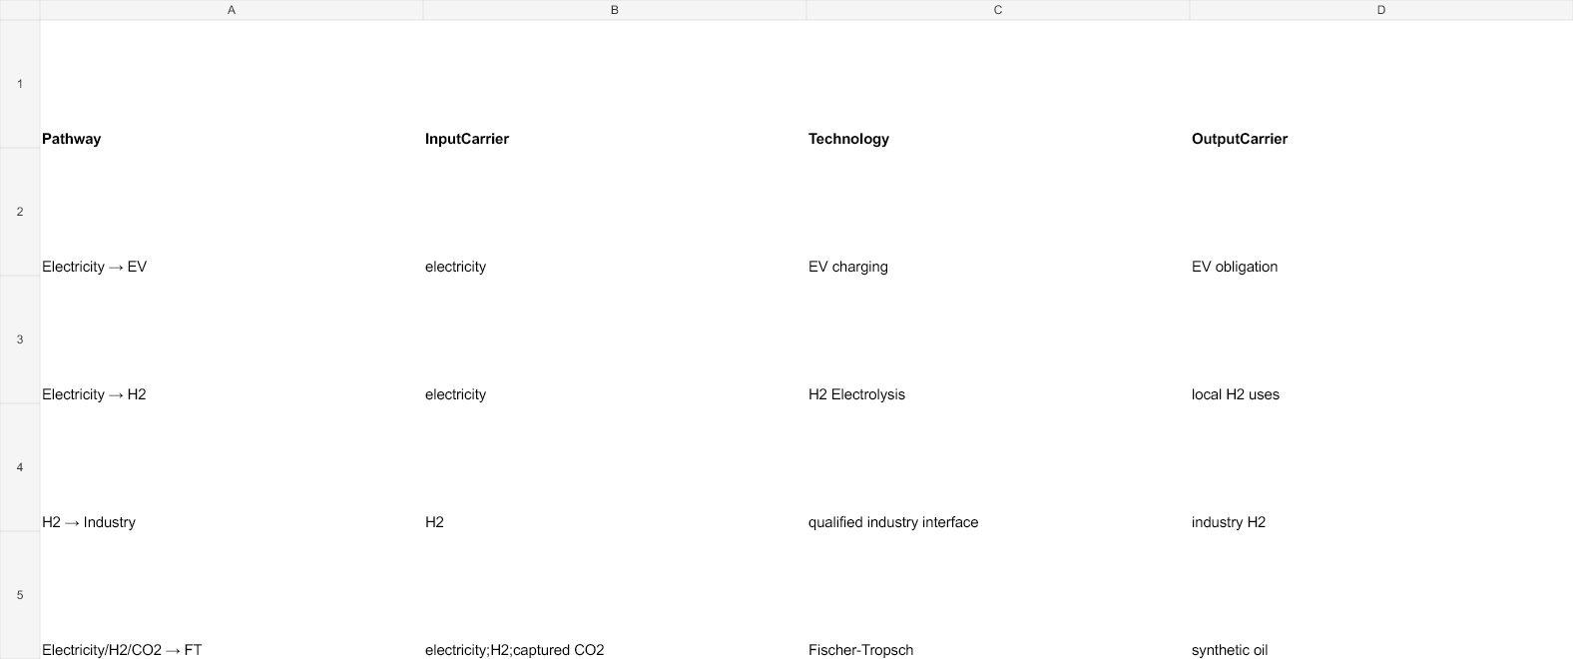
research/04_model_assembly/gate4/evidence/previews/PHASE4_ACTIVE_SECTOR_COUPLING_PATHWAYS.csv.png
