cyc292cycjin-oss/SGP-ESE5004-Stage2/research/04_model_assembly/gate1/PHASE4_GATE1_TEST_REPORT.md

# Gate1 tests and limitations

All five integrated-fix original regressions and cumulative cross-fix regressions passed before each research-only push. Final suite: 9 command groups PASS; strict Buildings combination 1062 rows PASS across synthetic 11-country/two-node fixtures. Static framework: 20 adversarial tests PASS. Tests are engineering checks, not scientific results. Release logs/JSON in evidence/review_tests. Run-manifest schema: 7 test methods PASS, including all 25 mandatory-field omissions. Initial framework fixture failure is preserved in evidence/foundation_tests.

Known unresolved shipping candidate remains FAIL before integration, and its conflict was aborted. No shipping success is inferred from other tests. GDP real-data 10-country evidence was reused; no future 11-country industrial quantities invented.

Environment: Linux-6.18.33.2-microsoft-standard-WSL2-x86_64-with-glibc2.43; Python 3.11.13, PyPSA 0.30.3, pandas 2.3.1, NumPy 1.26.4, Snakemake 7.32.4. Matches the known PyPSA 0.30.3 environment. Installed Python solver packages: highspy 1.11.0 and gurobipy 12.0.3; no solver CLI located on current PATH, no license or optimizer availability claim from package presence. Solver never instantiated for a solve. No environment upgrades.

PROJ reports a database-open warning/error during imports. The permitted synthetic/cache tests pass despite it. Actual geospatial transformation readiness is NOT established by these tests; validate it before later GIS assembly without silently changing environment versions. This is separate from the closed CodeQL infrastructure exception, which was not re-audited.

Historical reference read: `/home/jin/research/SGP_ESE5004_Stage2/pypsa-asean/results/baseline-aims-3H-tutorial/prenetworks/elec_s_50_ec_lv2.0__3h_2030_0.071_pre_adjusted.nc`, SHA256 `4b406321f2cc7c0170e2b48d20cdbddc16e9ffb16e2f37cabc97cb9d8788c8ae`. 48 snapshots from 2013-03-01 00:00:00 to 2013-03-06 21:00:00; weight totals {'objective': 8760.0, 'generators': 8760.0, 'stores': 8760.0}. This file has 1019 buses, 1307 Loads, 2672 Links and 632 Stores. It is an existing pre-adjusted tutorial intermediate; do not infer its time resolution from the eventual six-day/3h tutorial solve. Non-finite Load check FAIL: 376 static Loads, zero dynamic series. By carrier: {'H2 for industry': 48, 'NH3': 48, 'gas for industry': 48, 'industry electricity': 48, 'low-temperature heat for industry': 48, 'naphtha for industry': 48, 'process emissions': 48, 'shipping oil': 39, 'H2 for shipping': 1}. No changes made to that network. Current foundation source has not been assembled into a new network.

Shared inventory separates CURRENT_SOURCE_CONFIG_NAMESPACE from TUTORIAL_REFERENCE_NETWORK. Current source/ASEAN composition emits shared solid biomass, stored CO2 and lignite; oil/gas/coal/NH3 are spatial in this composition. Source also contains conditional global oil/gas/coal/NH3 branches; do not claim they are active under current config. The CO2 atmosphere Bus/Store is a global accounting pool. Shared-pool connectivity is flagged for Gate3; a shared atmospheric accounting port alone is not proof of physical energy exchange. See CSV and evidence/SOURCE_SPATIAL_PREFLIGHT.json.

Final review correction: `location=Earth` alone now yields UNKNOWN rather than GLOBAL_SHARED. Upstream add_biomass assigns biomass.locations to biogas buses, even when gas.biogas names are nodal; the location metadata does not prove a shared physical pool. The updated inventory has 1,110 rows. Global name hints still require physical/accounting interpretation; current-source define_spatial separately proves centralized stored CO2 under co2_network=false. No network component changed.

Release tests executed with engineering source HEAD `e8b01286aef63899094eecc980ae813556f425b6` and explicitly hashed foundation files. Every tested file was subsequently compared byte-for-byte with Git snapshot `9ee77cb0ba4c246f83492fbb6027c68066b41bda` and matched; no test result is attributed solely to a mutable working-tree path.

Release tests executed with engineering source HEAD `e8b01286aef63899094eecc980ae813556f425b6` and explicitly hashed foundation files. Every tested file was subsequently compared byte-for-byte with Git snapshot `9ee77cb0ba4c246f83492fbb6027c68066b41bda` and matched; no test result is attributed solely to a mutable working-tree path.
