cyc292cycjin-oss/SGP-ESE5004-Stage2/research/04_model_assembly/gate3/PHASE4_CARBON_SCOPE_TESTS.csv

Test_ID | Status | Evidence | Source | Coverage
gate3_tests.CarbonTests.test_agriculture_plus_one | PASS | SYNTHETIC_STATIC_NO_SOLVER | tests/research/test_carrier_carbon.py | accepted/synthetic fragment only; full model NOT assembled
gate3_tests.CarbonTests.test_allocated_event_cannot_be_split_again | PASS | SYNTHETIC_STATIC_NO_SOLVER | tests/research/test_carrier_carbon.py | accepted/synthetic fragment only; full model NOT assembled
gate3_tests.CarbonTests.test_biogenic_no_invented_uptake | PASS | SYNTHETIC_STATIC_NO_SOLVER | tests/research/test_carrier_carbon.py | accepted/synthetic fragment only; full model NOT assembled
gate3_tests.CarbonTests.test_budget_all_six_years | PASS | SYNTHETIC_STATIC_NO_SOLVER | tests/research/test_carrier_carbon.py | accepted/synthetic fragment only; full model NOT assembled
gate3_tests.CarbonTests.test_budget_time_scale | PASS | SYNTHETIC_STATIC_NO_SOLVER | tests/research/test_carrier_carbon.py | accepted/synthetic fragment only; full model NOT assembled
gate3_tests.CarbonTests.test_buildings_plus_one | PASS | SYNTHETIC_STATIC_NO_SOLVER | tests/research/test_carrier_carbon.py | accepted/synthetic fragment only; full model NOT assembled
gate3_tests.CarbonTests.test_bunkers_separate | PASS | SYNTHETIC_STATIC_NO_SOLVER | tests/research/test_carrier_carbon.py | accepted/synthetic fragment only; full model NOT assembled
gate3_tests.CarbonTests.test_capture_balance_fail | PASS | SYNTHETIC_STATIC_NO_SOLVER | tests/research/test_carrier_carbon.py | accepted/synthetic fragment only; full model NOT assembled
gate3_tests.CarbonTests.test_capture_store_once | PASS | SYNTHETIC_STATIC_NO_SOLVER | tests/research/test_carrier_carbon.py | accepted/synthetic fragment only; full model NOT assembled
gate3_tests.CarbonTests.test_dac_cycle_one_uptake_one_release | PASS | SYNTHETIC_STATIC_NO_SOLVER | tests/research/test_carrier_carbon.py | accepted/synthetic fragment only; full model NOT assembled
gate3_tests.CarbonTests.test_duplicate_carbon_event | PASS | SYNTHETIC_STATIC_NO_SOLVER | tests/research/test_carrier_carbon.py | accepted/synthetic fragment only; full model NOT assembled
gate3_tests.CarbonTests.test_duplicate_carbon_stage | PASS | SYNTHETIC_STATIC_NO_SOLVER | tests/research/test_carrier_carbon.py | accepted/synthetic fragment only; full model NOT assembled
gate3_tests.CarbonTests.test_geothermal_not_omitted | PASS | SYNTHETIC_STATIC_NO_SOLVER | tests/research/test_carrier_carbon.py | accepted/synthetic fragment only; full model NOT assembled
gate3_tests.CarbonTests.test_industry_plus_one | PASS | SYNTHETIC_STATIC_NO_SOLVER | tests/research/test_carrier_carbon.py | accepted/synthetic fragment only; full model NOT assembled
gate3_tests.CarbonTests.test_missing_origin_no_credit | PASS | SYNTHETIC_STATIC_NO_SOLVER | tests/research/test_carrier_carbon.py | accepted/synthetic fragment only; full model NOT assembled
gate3_tests.CarbonTests.test_no_baseline_budget_activation | PASS | SYNTHETIC_STATIC_NO_SOLVER | tests/research/test_carrier_carbon.py | accepted/synthetic fragment only; full model NOT assembled
gate3_tests.CarbonTests.test_nonpower_not_scope_by_connection | PASS | SYNTHETIC_STATIC_NO_SOLVER | tests/research/test_carrier_carbon.py | accepted/synthetic fragment only; full model NOT assembled
gate3_tests.CarbonTests.test_power_plus_one | PASS | SYNTHETIC_STATIC_NO_SOLVER | tests/research/test_carrier_carbon.py | accepted/synthetic fragment only; full model NOT assembled
gate3_tests.CarbonTests.test_recycled_co2_not_neutral | PASS | SYNTHETIC_STATIC_NO_SOLVER | tests/research/test_carrier_carbon.py | accepted/synthetic fragment only; full model NOT assembled
gate3_tests.CarbonTests.test_road_plus_one | PASS | SYNTHETIC_STATIC_NO_SOLVER | tests/research/test_carrier_carbon.py | accepted/synthetic fragment only; full model NOT assembled
gate3_tests.CarbonTests.test_shared_allocation_cannot_hide_transfer_credit | PASS | SYNTHETIC_STATIC_NO_SOLVER | tests/research/test_carrier_carbon.py | accepted/synthetic fragment only; full model NOT assembled
gate3_tests.CarbonTests.test_shared_allocation_conserves | PASS | SYNTHETIC_STATIC_NO_SOLVER | tests/research/test_carrier_carbon.py | accepted/synthetic fragment only; full model NOT assembled
gate3_tests.CarbonTests.test_shared_allocation_explicit_only | PASS | SYNTHETIC_STATIC_NO_SOLVER | tests/research/test_carrier_carbon.py | accepted/synthetic fragment only; full model NOT assembled
gate3_tests.CarbonTests.test_shared_scope_unaccepted_rejected | PASS | SYNTHETIC_STATIC_NO_SOLVER | tests/research/test_carrier_carbon.py | accepted/synthetic fragment only; full model NOT assembled
gate3_tests.CarbonTests.test_storage_not_second_credit | PASS | SYNTHETIC_STATIC_NO_SOLVER | tests/research/test_carrier_carbon.py | accepted/synthetic fragment only; full model NOT assembled
gate3_tests.CarbonTests.test_unknown_year_rejected | PASS | SYNTHETIC_STATIC_NO_SOLVER | tests/research/test_carrier_carbon.py | accepted/synthetic fragment only; full model NOT assembled
gate3_tests.PyPSAFragmentTests.test_atmosphere_is_reporting_not_cap_or_feedstock | PASS | SYNTHETIC_STATIC_NO_SOLVER | tests/research/test_carrier_carbon.py | accepted/synthetic fragment only; full model NOT assembled
gate3_tests.PyPSAFragmentTests.test_industrial_coal_energy_and_carbon_same_flow | PASS | SYNTHETIC_STATIC_NO_SOLVER | tests/research/test_carrier_carbon.py | accepted/synthetic fragment only; full model NOT assembled
gate3_tests.PyPSAFragmentTests.test_legacy_cap_coexistence_rejected | PASS | SYNTHETIC_STATIC_NO_SOLVER | tests/research/test_carrier_carbon.py | accepted/synthetic fragment only; full model NOT assembled
gate3_tests.PyPSAFragmentTests.test_missing_fuel_factor_does_not_create_carbon_meter | PASS | SYNTHETIC_STATIC_NO_SOLVER | tests/research/test_carrier_carbon.py | accepted/synthetic fragment only; full model NOT assembled
gate3_tests.PyPSAFragmentTests.test_pending_scope_blocks_constraint | PASS | SYNTHETIC_STATIC_NO_SOLVER | tests/research/test_carrier_carbon.py | accepted/synthetic fragment only; full model NOT assembled
gate3_tests.PyPSAFragmentTests.test_real_linopy_constraint_only_power_terms | PASS | SYNTHETIC_STATIC_NO_SOLVER | tests/research/test_carrier_carbon.py | accepted/synthetic fragment only; full model NOT assembled
