cyc292cycjin-oss/SGP-ESE5004-Stage2/research/04_model_assembly/gate3/PHASE4_CARRIER_REACHABILITY_TESTS.csv

Test_ID | Status | Evidence | Source | Coverage
gate3_tests.CarrierTests.test_all_11_country_pairs_potential | PASS | SYNTHETIC_STATIC_NO_SOLVER | tests/research/test_carrier_carbon.py | accepted/synthetic fragment only; full model NOT assembled
gate3_tests.CarrierTests.test_co2_local_geology_not_feedstock | PASS | SYNTHETIC_STATIC_NO_SOLVER | tests/research/test_carrier_carbon.py | accepted/synthetic fragment only; full model NOT assembled
gate3_tests.CarrierTests.test_common_price_different_country_availability | PASS | SYNTHETIC_STATIC_NO_SOLVER | tests/research/test_carrier_carbon.py | accepted/synthetic fragment only; full model NOT assembled
gate3_tests.CarrierTests.test_common_price_separate_imports | PASS | SYNTHETIC_STATIC_NO_SOLVER | tests/research/test_carrier_carbon.py | accepted/synthetic fragment only; full model NOT assembled
gate3_tests.CarrierTests.test_crossborder_gas_co2_biomass_ft_rejected | PASS | SYNTHETIC_STATIC_NO_SOLVER | tests/research/test_carrier_carbon.py | accepted/synthetic fragment only; full model NOT assembled
gate3_tests.CarrierTests.test_crossborder_h2_rejected | PASS | SYNTHETIC_STATIC_NO_SOLVER | tests/research/test_carrier_carbon.py | accepted/synthetic fragment only; full model NOT assembled
gate3_tests.CarrierTests.test_demands_not_added_by_carrier | PASS | SYNTHETIC_STATIC_NO_SOLVER | tests/research/test_carrier_carbon.py | accepted/synthetic fragment only; full model NOT assembled
gate3_tests.CarrierTests.test_geology_missing_resource_rejected | PASS | SYNTHETIC_STATIC_NO_SOLVER | tests/research/test_carrier_carbon.py | accepted/synthetic fragment only; full model NOT assembled
gate3_tests.CarrierTests.test_graph_mutation_detected | PASS | SYNTHETIC_STATIC_NO_SOLVER | tests/research/test_carrier_carbon.py | accepted/synthetic fragment only; full model NOT assembled
gate3_tests.CarrierTests.test_h2_is_node_local | PASS | SYNTHETIC_STATIC_NO_SOLVER | tests/research/test_carrier_carbon.py | accepted/synthetic fragment only; full model NOT assembled
gate3_tests.CarrierTests.test_import_unaccepted_rejected | PASS | SYNTHETIC_STATIC_NO_SOLVER | tests/research/test_carrier_carbon.py | accepted/synthetic fragment only; full model NOT assembled
gate3_tests.CarrierTests.test_missing_availability_rejected | PASS | SYNTHETIC_STATIC_NO_SOLVER | tests/research/test_carrier_carbon.py | accepted/synthetic fragment only; full model NOT assembled
gate3_tests.CarrierTests.test_negative_import_price_rejected | PASS | SYNTHETIC_STATIC_NO_SOLVER | tests/research/test_carrier_carbon.py | accepted/synthetic fragment only; full model NOT assembled
gate3_tests.CarrierTests.test_new_h2_import_rejected | PASS | SYNTHETIC_STATIC_NO_SOLVER | tests/research/test_carrier_carbon.py | accepted/synthetic fragment only; full model NOT assembled
gate3_tests.CarrierTests.test_no_new_dac_ammonia_methanol_heat | PASS | SYNTHETIC_STATIC_NO_SOLVER | tests/research/test_carrier_carbon.py | accepted/synthetic fragment only; full model NOT assembled
gate3_tests.CarrierTests.test_no_shared_physical_bus | PASS | SYNTHETIC_STATIC_NO_SOLVER | tests/research/test_carrier_carbon.py | accepted/synthetic fragment only; full model NOT assembled
gate3_tests.CarrierTests.test_resource_allocation_conserves | PASS | SYNTHETIC_STATIC_NO_SOLVER | tests/research/test_carrier_carbon.py | accepted/synthetic fragment only; full model NOT assembled
gate3_tests.CarrierTests.test_resource_not_replicated | PASS | SYNTHETIC_STATIC_NO_SOLVER | tests/research/test_carrier_carbon.py | accepted/synthetic fragment only; full model NOT assembled
gate3_tests.CarrierTests.test_resource_unaccepted_rejected | PASS | SYNTHETIC_STATIC_NO_SOLVER | tests/research/test_carrier_carbon.py | accepted/synthetic fragment only; full model NOT assembled
gate3_tests.CarrierTests.test_same_market_different_price_rejected | PASS | SYNTHETIC_STATIC_NO_SOLVER | tests/research/test_carrier_carbon.py | accepted/synthetic fragment only; full model NOT assembled
gate3_tests.CarrierTests.test_shared_pool_mutation_detected | PASS | SYNTHETIC_STATIC_NO_SOLVER | tests/research/test_carrier_carbon.py | accepted/synthetic fragment only; full model NOT assembled
gate3_tests.PyPSAFragmentTests.test_annual_import_availability_constraint | PASS | SYNTHETIC_STATIC_NO_SOLVER | tests/research/test_carrier_carbon.py | accepted/synthetic fragment only; full model NOT assembled
gate3_tests.PyPSAFragmentTests.test_conversion_reverse_flow_rejected | PASS | SYNTHETIC_STATIC_NO_SOLVER | tests/research/test_carrier_carbon.py | accepted/synthetic fragment only; full model NOT assembled
gate3_tests.PyPSAFragmentTests.test_distinct_external_generators_and_no_loads | PASS | SYNTHETIC_STATIC_NO_SOLVER | tests/research/test_carrier_carbon.py | accepted/synthetic fragment only; full model NOT assembled
gate3_tests.PyPSAFragmentTests.test_ft_multiinput_physical_signs | PASS | SYNTHETIC_STATIC_NO_SOLVER | tests/research/test_carrier_carbon.py | accepted/synthetic fragment only; full model NOT assembled
gate3_tests.PyPSAFragmentTests.test_ft_wrong_co2_sign_rejected | PASS | SYNTHETIC_STATIC_NO_SOLVER | tests/research/test_carrier_carbon.py | accepted/synthetic fragment only; full model NOT assembled
gate3_tests.PyPSAFragmentTests.test_geological_store_cannot_discharge | PASS | SYNTHETIC_STATIC_NO_SOLVER | tests/research/test_carrier_carbon.py | accepted/synthetic fragment only; full model NOT assembled
gate3_tests.PyPSAFragmentTests.test_unaccepted_fragment_rejected | PASS | SYNTHETIC_STATIC_NO_SOLVER | tests/research/test_carrier_carbon.py | accepted/synthetic fragment only; full model NOT assembled
