cyc292cycjin-oss/SGP-ESE5004-Stage2/docs/repository_health/20261003/evidence/TEST_PR_MACOS_LOG.txt

OS (macos)	UNKNOWN STEP	2026-09-27T10:51:04.1104240Z Current runner version: '2.337.0'
OS (macos)	UNKNOWN STEP	2026-09-27T10:51:04.1121190Z ##[group]Runner Image Provisioner
OS (macos)	UNKNOWN STEP	2026-09-27T10:51:04.1121730Z Hosted Compute Agent
OS (macos)	UNKNOWN STEP	2026-09-27T10:51:04.1122190Z Version: 20260828.587
OS (macos)	UNKNOWN STEP	2026-09-27T10:51:04.1122620Z Commit: abac92662cab4cc7352de4f9f9d2e2419aad9c29
OS (macos)	UNKNOWN STEP	2026-09-27T10:51:04.1123180Z Build Date: 2026-08-28T16:44:25Z
OS (macos)	UNKNOWN STEP	2026-09-27T10:51:04.1123700Z Worker ID: {50ed0992-9f71-4900-a2a5-196d75f33104}
OS (macos)	UNKNOWN STEP	2026-09-27T10:51:04.1124210Z Azure Region: westus
OS (macos)	UNKNOWN STEP	2026-09-27T10:51:04.1124610Z ##[endgroup]
OS (macos)	UNKNOWN STEP	2026-09-27T10:51:04.1125500Z ##[group]Operating System
OS (macos)	UNKNOWN STEP	2026-09-27T10:51:04.1126080Z macOS
OS (macos)	UNKNOWN STEP	2026-09-27T10:51:04.1126630Z 26.6.2
OS (macos)	UNKNOWN STEP	2026-09-27T10:51:04.1127150Z 25G83
OS (macos)	UNKNOWN STEP	2026-09-27T10:51:04.1127500Z ##[endgroup]
OS (macos)	UNKNOWN STEP	2026-09-27T10:51:04.1127940Z ##[group]Runner Image
OS (macos)	UNKNOWN STEP	2026-09-27T10:51:04.1128410Z Image: macos-26-arm64
OS (macos)	UNKNOWN STEP	2026-09-27T10:51:04.1128850Z Version: 20260907.0351.1
OS (macos)	UNKNOWN STEP	2026-09-27T10:51:04.1129760Z Included Software: https://github.com/actions/runner-images/blob/macos-26-arm64/20260907.0351/images/macos/macos-26-arm64-Readme.md
OS (macos)	UNKNOWN STEP	2026-09-27T10:51:04.1130870Z Image Release: https://github.com/actions/runner-images/releases/tag/macos-26-arm64%2F20260907.0351
OS (macos)	UNKNOWN STEP	2026-09-27T10:51:04.1131720Z ##[endgroup]
OS (macos)	UNKNOWN STEP	2026-09-27T10:51:04.1132580Z ##[group]GITHUB_TOKEN Permissions
OS (macos)	UNKNOWN STEP	2026-09-27T10:51:04.1133960Z Contents: read
OS (macos)	UNKNOWN STEP	2026-09-27T10:51:04.1134430Z Metadata: read
OS (macos)	UNKNOWN STEP	2026-09-27T10:51:04.1134880Z Packages: read
OS (macos)	UNKNOWN STEP	2026-09-27T10:51:04.1135300Z ##[endgroup]
OS (macos)	UNKNOWN STEP	2026-09-27T10:51:04.1136930Z Secret source: Dependabot
OS (macos)	UNKNOWN STEP	2026-09-27T10:51:04.1137550Z Cache mode: write
OS (macos)	UNKNOWN STEP	2026-09-27T10:51:04.1138260Z Prepare workflow directory
OS (macos)	UNKNOWN STEP	2026-09-27T10:51:04.1425740Z Prepare all required actions
OS (macos)	UNKNOWN STEP	2026-09-27T10:51:04.1461130Z Getting action download info
OS (macos)	UNKNOWN STEP	2026-09-27T10:51:04.3220710Z Download action repository 'actions/checkout@v7' (SHA:3d3c42e5aac5ba805825da76410c181273ba90b1)
OS (macos)	UNKNOWN STEP	2026-09-27T10:51:04.5320740Z Download action repository 'conda-incubator/setup-miniconda@v4' (SHA:be893c923ea9cf1cf7cd510fbdde27c7e18cbdcb)
OS (macos)	UNKNOWN STEP	2026-09-27T10:51:05.3461970Z Download action repository 'actions/cache@v6' (SHA:55cc8345863c7cc4c66a329aec7e433d2d1c52a9)
OS (macos)	UNKNOWN STEP	2026-09-27T10:51:05.4356730Z Download action repository 'actions/upload-artifact@v7' (SHA:043fb46d1a93c77aae656e7c1c64a875d1fc6a0a)
OS (macos)	UNKNOWN STEP	2026-09-27T10:51:05.4991240Z Download action repository 'actions/download-artifact@v8' (SHA:3e5f45b2cfb9172054b4087a40e8e0b5a5461e7c)
OS (macos)	UNKNOWN STEP	2026-09-27T10:51:06.5015300Z Complete job name: OS (macos)
OS (macos)	UNKNOWN STEP	2026-09-27T10:51:06.5451680Z ##[group]Run actions/checkout@v7
OS (macos)	UNKNOWN STEP	2026-09-27T10:51:06.5452210Z with:
OS (macos)	UNKNOWN STEP	2026-09-27T10:51:06.5452670Z   repository: cyc292cycjin-oss/SGP-ESE5004-Stage2
OS (macos)	UNKNOWN STEP	2026-09-27T10:51:06.5455790Z   token: ***
OS (macos)	UNKNOWN STEP	2026-09-27T10:51:06.5456110Z   ssh-strict: true
OS (macos)	UNKNOWN STEP	2026-09-27T10:51:06.5456430Z   ssh-user: git
OS (macos)	UNKNOWN STEP	2026-09-27T10:51:06.5456760Z   persist-credentials: true
OS (macos)	UNKNOWN STEP	2026-09-27T10:51:06.5457130Z   clean: true
OS (macos)	UNKNOWN STEP	2026-09-27T10:51:06.5457460Z   sparse-checkout-cone-mode: true
OS (macos)	UNKNOWN STEP	2026-09-27T10:51:06.5457850Z   fetch-depth: 1
OS (macos)	UNKNOWN STEP	2026-09-27T10:51:06.5458170Z   fetch-tags: false
OS (macos)	UNKNOWN STEP	2026-09-27T10:51:06.5458500Z   show-progress: true
OS (macos)	UNKNOWN STEP	2026-09-27T10:51:06.5458840Z   lfs: false
OS (macos)	UNKNOWN STEP	2026-09-27T10:51:06.5459210Z   submodules: false
OS (macos)	UNKNOWN STEP	2026-09-27T10:51:06.5459550Z   set-safe-directory: true
OS (macos)	UNKNOWN STEP	2026-09-27T10:51:06.5459930Z   allow-unsafe-pr-checkout: false
OS (macos)	UNKNOWN STEP	2026-09-27T10:51:06.5460430Z env:
OS (macos)	UNKNOWN STEP	2026-09-27T10:51:06.5460750Z   BASE_ENV: envs/environment.yaml
OS (macos)	UNKNOWN STEP	2026-09-27T10:51:06.5461140Z ##[endgroup]
OS (macos)	UNKNOWN STEP	2026-09-27T10:51:06.9229440Z Syncing repository: cyc292cycjin-oss/SGP-ESE5004-Stage2
OS (macos)	UNKNOWN STEP	2026-09-27T10:51:06.9231220Z ##[group]Getting Git version info
OS (macos)	UNKNOWN STEP	2026-09-27T10:51:06.9232110Z Working directory is '/Users/runner/work/SGP-ESE5004-Stage2/SGP-ESE5004-Stage2'
OS (macos)	UNKNOWN STEP	2026-09-27T10:51:06.9233980Z [command]/opt/homebrew/bin/git version
OS (macos)	UNKNOWN STEP	2026-09-27T10:51:06.9709910Z git version 2.55.0
OS (macos)	UNKNOWN STEP	2026-09-27T10:51:06.9721380Z ##[endgroup]
OS (macos)	UNKNOWN STEP	2026-09-27T10:51:06.9728410Z Copying '/Users/runner/.gitconfig' to '/Users/runner/work/_temp/dd48da3d-cc73-4409-ab88-d7c447067bcd/.gitconfig'
OS (macos)	UNKNOWN STEP	2026-09-27T10:51:06.9731790Z Temporarily overriding HOME='/Users/runner/work/_temp/dd48da3d-cc73-4409-ab88-d7c447067bcd' before making global git config changes
OS (macos)	UNKNOWN STEP	2026-09-27T10:51:06.9735980Z Adding repository directory to the temporary git global config as a safe directory
OS (macos)	UNKNOWN STEP	2026-09-27T10:51:06.9738510Z [command]/opt/homebrew/bin/git config --global --add safe.directory /Users/runner/work/SGP-ESE5004-Stage2/SGP-ESE5004-Stage2
OS (macos)	UNKNOWN STEP	2026-09-27T10:51:06.9824460Z Deleting the contents of '/Users/runner/work/SGP-ESE5004-Stage2/SGP-ESE5004-Stage2'
OS (macos)	UNKNOWN STEP	2026-09-27T10:51:06.9826720Z ##[group]Determining repository object format
OS (macos)	UNKNOWN STEP	2026-09-27T10:51:06.9828120Z ##[endgroup]
OS (macos)	UNKNOWN STEP	2026-09-27T10:51:06.9829330Z ##[group]Initializing the repository
OS (macos)	UNKNOWN STEP	2026-09-27T10:51:06.9830890Z [command]/opt/homebrew/bin/git init /Users/runner/work/SGP-ESE5004-Stage2/SGP-ESE5004-Stage2
OS (macos)	UNKNOWN STEP	2026-09-27T10:51:07.0012090Z hint: Using 'master' as the name for the initial branch. This default branch name
OS (macos)	UNKNOWN STEP	2026-09-27T10:51:07.0014000Z hint: will change to "main" in Git 3.0. To configure the initial branch name
OS (macos)	UNKNOWN STEP	2026-09-27T10:51:07.0015850Z hint: to use in all of your new repositories, which will suppress this warning,
OS (macos)	UNKNOWN STEP	2026-09-27T10:51:07.0017250Z hint: call:
OS (macos)	UNKNOWN STEP	2026-09-27T10:51:07.0017920Z hint:
OS (macos)	UNKNOWN STEP	2026-09-27T10:51:07.0018670Z hint: 	git config --global init.defaultBranch <name>
OS (macos)	UNKNOWN STEP	2026-09-27T10:51:07.0019620Z hint:
OS (macos)	UNKNOWN STEP	2026-09-27T10:51:07.0020540Z hint: Names commonly chosen instead of 'master' are 'main', 'trunk' and
OS (macos)	UNKNOWN STEP	2026-09-27T10:51:07.0022170Z hint: 'development'. The just-created branch can be renamed via this command:
OS (macos)	UNKNOWN STEP	2026-09-27T10:51:07.0023420Z hint:
OS (macos)	UNKNOWN STEP	2026-09-27T10:51:07.0024000Z hint: 	git branch -m <name>
OS (macos)	UNKNOWN STEP	2026-09-27T10:51:07.0024700Z hint:
OS (macos)	UNKNOWN STEP	2026-09-27T10:51:07.0025630Z hint: Disable this message with "git config set advice.defaultBranchName false"
OS (macos)	UNKNOWN STEP	2026-09-27T10:51:07.0027550Z Initialized empty Git repository in /Users/runner/work/SGP-ESE5004-Stage2/SGP-ESE5004-Stage2/.git/
OS (macos)	UNKNOWN STEP	2026-09-27T10:51:07.0030590Z [command]/opt/homebrew/bin/git remote add origin https://github.com/cyc292cycjin-oss/SGP-ESE5004-Stage2
OS (macos)	UNKNOWN STEP	2026-09-27T10:51:07.0091550Z ##[endgroup]
OS (macos)	UNKNOWN STEP	2026-09-27T10:51:07.0092850Z ##[group]Disabling automatic garbage collection
OS (macos)	UNKNOWN STEP	2026-09-27T10:51:07.0094000Z [command]/opt/homebrew/bin/git config --local gc.auto 0
OS (macos)	UNKNOWN STEP	2026-09-27T10:51:07.0159660Z ##[endgroup]
OS (macos)	UNKNOWN STEP	2026-09-27T10:51:07.0160660Z ##[group]Setting up auth
OS (macos)	UNKNOWN STEP	2026-09-27T10:51:07.0161410Z Removing SSH command configuration
OS (macos)	UNKNOWN STEP	2026-09-27T10:51:07.0162660Z [command]/opt/homebrew/bin/git config --local --name-only --get-regexp core\.sshCommand
OS (macos)	UNKNOWN STEP	2026-09-27T10:51:07.0207160Z [command]/opt/homebrew/bin/git submodule foreach --recursive sh -c "git config --local --name-only --get-regexp 'core\.sshCommand' && git config --local --unset-all 'core.sshCommand' || :"
OS (macos)	UNKNOWN STEP	2026-09-27T10:51:07.0940910Z Removing HTTP extra header
OS (macos)	UNKNOWN STEP	2026-09-27T10:51:07.0943970Z [command]/opt/homebrew/bin/git config --local --name-only --get-regexp http\.https\:\/\/github\.com\/\.extraheader
OS (macos)	UNKNOWN STEP	2026-09-27T10:51:07.0995470Z [command]/opt/homebrew/bin/git submodule foreach --recursive sh -c "git config --local --name-only --get-regexp 'http\.https\:\/\/github\.com\/\.extraheader' && git config --local --unset-all 'http.https://github.com/.extraheader' || :"
OS (macos)	UNKNOWN STEP	2026-09-27T10:51:07.1698410Z Removing includeIf entries pointing to credentials config files
OS (macos)	UNKNOWN STEP	2026-09-27T10:51:07.1701500Z [command]/opt/homebrew/bin/git config --local --name-only --get-regexp ^includeIf\.gitdir:
OS (macos)	UNKNOWN STEP	2026-09-27T10:51:07.1754190Z [command]/opt/homebrew/bin/git submodule foreach --recursive git config --local --show-origin --name-only --get-regexp remote.origin.url
OS (macos)	UNKNOWN STEP	2026-09-27T10:51:07.3146860Z [command]/opt/homebrew/bin/git config --file /Users/runner/work/_temp/git-credentials-31cf0bbb-c631-4dcc-ad09-272b75d44c7a.config http.https://github.com/.extraheader AUTHORIZATION: basic ***
OS (macos)	UNKNOWN STEP	2026-09-27T10:51:07.3153250Z [command]/opt/homebrew/bin/git config --local includeIf.gitdir:/Users/runner/work/SGP-ESE5004-Stage2/SGP-ESE5004-Stage2/.git.path /Users/runner/work/_temp/git-credentials-31cf0bbb-c631-4dcc-ad09-272b75d44c7a.config
OS (macos)	UNKNOWN STEP	2026-09-27T10:51:07.3159960Z [command]/opt/homebrew/bin/git config --local includeIf.gitdir:/Users/runner/work/SGP-ESE5004-Stage2/SGP-ESE5004-Stage2/.git/worktrees/*.path /Users/runner/work/_temp/git-credentials-31cf0bbb-c631-4dcc-ad09-272b75d44c7a.config
OS (macos)	UNKNOWN STEP	2026-09-27T10:51:07.3166220Z [command]/opt/homebrew/bin/git config --local includeIf.gitdir:/github/workspace/.git.path /github/runner_temp/git-credentials-31cf0bbb-c631-4dcc-ad09-272b75d44c7a.config
OS (macos)	UNKNOWN STEP	2026-09-27T10:51:07.3171120Z [command]/opt/homebrew/bin/git config --local includeIf.gitdir:/github/workspace/.git/worktrees/*.path /github/runner_temp/git-credentials-31cf0bbb-c631-4dcc-ad09-272b75d44c7a.config
OS (macos)	UNKNOWN STEP	2026-09-27T10:51:07.3220340Z ##[endgroup]
OS (macos)	UNKNOWN STEP	2026-09-27T10:51:07.3221320Z ##[group]Fetching the repository
OS (macos)	UNKNOWN STEP	2026-09-27T10:51:07.3225440Z [command]/opt/homebrew/bin/git -c protocol.version=2 fetch --no-tags --prune --no-recurse-submodules --depth=1 origin +73718f8f1b489b6cbc92f6c3df583d3b9de2f412:refs/remotes/pull/1/merge
OS (macos)	UNKNOWN STEP	2026-09-27T10:51:09.0151640Z From https://github.com/cyc292cycjin-oss/SGP-ESE5004-Stage2
OS (macos)	UNKNOWN STEP	2026-09-27T10:51:09.0174730Z  * [new ref]         73718f8f1b489b6cbc92f6c3df583d3b9de2f412 -> pull/1/merge
OS (macos)	UNKNOWN STEP	2026-09-27T10:51:09.0180100Z ##[endgroup]
OS (macos)	UNKNOWN STEP	2026-09-27T10:51:09.0187930Z ##[group]Determining the checkout info
OS (macos)	UNKNOWN STEP	2026-09-27T10:51:09.0190260Z ##[endgroup]
OS (macos)	UNKNOWN STEP	2026-09-27T10:51:09.0191940Z [command]/opt/homebrew/bin/git sparse-checkout disable
OS (macos)	UNKNOWN STEP	2026-09-27T10:51:09.0757210Z [command]/opt/homebrew/bin/git config --local --unset-all extensions.worktreeConfig
OS (macos)	UNKNOWN STEP	2026-09-27T10:51:09.1472220Z ##[group]Checking out the ref
OS (macos)	UNKNOWN STEP	2026-09-27T10:51:09.1574280Z [command]/opt/homebrew/bin/git checkout --progress --force refs/remotes/pull/1/merge
OS (macos)	UNKNOWN STEP	2026-09-27T10:51:09.3567470Z HEAD is now at 73718f8 Merge 5568912ad8e838723d2c9c774346f8876418d45a into a3616a68ee44592af6527ca9024a90f1956646ae
OS (macos)	UNKNOWN STEP	2026-09-27T10:51:09.3634950Z ##[endgroup]
OS (macos)	UNKNOWN STEP	2026-09-27T10:51:09.3699000Z [command]/opt/homebrew/bin/git log -1 --format=%H
OS (macos)	UNKNOWN STEP	2026-09-27T10:51:09.3774100Z 73718f8f1b489b6cbc92f6c3df583d3b9de2f412
OS (macos)	UNKNOWN STEP	2026-09-27T10:51:09.4058130Z ##[group]Run git fetch origin main
OS (macos)	UNKNOWN STEP	2026-09-27T10:51:09.4058470Z ^[[36;1mgit fetch origin main^[[0m
OS (macos)	UNKNOWN STEP	2026-09-27T10:51:09.4058900Z ^[[36;1mif git diff --name-only origin/main | grep -E '(envs/environment.yaml|.*lock.yaml)$'; then^[[0m
OS (macos)	UNKNOWN STEP	2026-09-27T10:51:09.4059510Z ^[[36;1m  if git diff --name-only origin/main | grep -E '.*lock.yaml'; then^[[0m
OS (macos)	UNKNOWN STEP	2026-09-27T10:51:09.4059850Z ^[[36;1m    echo "Lock files changed. Using lock files."^[[0m
OS (macos)	UNKNOWN STEP	2026-09-27T10:51:09.4060170Z ^[[36;1m    echo "env_file=envs/osx-arm64.lock.yaml" >> $GITHUB_ENV^[[0m
OS (macos)	UNKNOWN STEP	2026-09-27T10:51:09.4060440Z ^[[36;1m  else^[[0m
OS (macos)	UNKNOWN STEP	2026-09-27T10:51:09.4060780Z ^[[36;1m    echo "Only base env envs/environment.yaml changed. Using it instead of locked envs."^[[0m
OS (macos)	UNKNOWN STEP	2026-09-27T10:51:09.4061390Z ^[[36;1m    echo "env_file=envs/environment.yaml" >> $GITHUB_ENV^[[0m
OS (macos)	UNKNOWN STEP	2026-09-27T10:51:09.4061710Z ^[[36;1m  fi^[[0m
OS (macos)	UNKNOWN STEP	2026-09-27T10:51:09.4061880Z ^[[36;1melse^[[0m
OS (macos)	UNKNOWN STEP	2026-09-27T10:51:09.4062150Z ^[[36;1m  echo "Neither base env nor lock files changed. Using lock files."^[[0m
OS (macos)	UNKNOWN STEP	2026-09-27T10:51:09.4063510Z ^[[36;1m  echo "env_file=envs/osx-arm64.lock.yaml" >> $GITHUB_ENV^[[0m
OS (macos)	UNKNOWN STEP	2026-09-27T10:51:09.4063870Z ^[[36;1mfi^[[0m
OS (macos)	UNKNOWN STEP	2026-09-27T10:51:09.4109270Z shell: /bin/bash -l {0}
OS (macos)	UNKNOWN STEP	2026-09-27T10:51:09.4109490Z env:
OS (macos)	UNKNOWN STEP	2026-09-27T10:51:09.4109720Z   BASE_ENV: envs/environment.yaml
OS (macos)	UNKNOWN STEP	2026-09-27T10:51:09.4109940Z ##[endgroup]
OS (macos)	UNKNOWN STEP	2026-09-27T10:51:12.6235930Z From https://github.com/cyc292cycjin-oss/SGP-ESE5004-Stage2
OS (macos)	UNKNOWN STEP	2026-09-27T10:51:12.6236420Z  * branch              main       -> FETCH_HEAD
OS (macos)	UNKNOWN STEP	2026-09-27T10:51:12.6236710Z  * [new branch]        main       -> origin/main
OS (macos)	UNKNOWN STEP	2026-09-27T10:51:12.9172660Z Neither base env nor lock files changed. Using lock files.
OS (macos)	UNKNOWN STEP	2026-09-27T10:51:12.9423200Z ##[group]Run conda-incubator/setup-miniconda@v4
OS (macos)	UNKNOWN STEP	2026-09-27T10:51:12.9423460Z with:
OS (macos)	UNKNOWN STEP	2026-09-27T10:51:12.9423600Z   miniforge-version: latest
OS (macos)	UNKNOWN STEP	2026-09-27T10:51:12.9423820Z   activate-environment: pypsa-earth
OS (macos)	UNKNOWN STEP	2026-09-27T10:51:12.9424050Z   channel-priority: strict
OS (macos)	UNKNOWN STEP	2026-09-27T10:51:12.9424230Z   conda-remove-defaults: true
OS (macos)	UNKNOWN STEP	2026-09-27T10:51:12.9424420Z   auto-activate: true
OS (macos)	UNKNOWN STEP	2026-09-27T10:51:12.9424610Z   auto-activate-base: legacy-placeholder
OS (macos)	UNKNOWN STEP	2026-09-27T10:51:12.9424830Z   auto-update-conda: false
OS (macos)	UNKNOWN STEP	2026-09-27T10:51:12.9427200Z   remove-profiles: true
OS (macos)	UNKNOWN STEP	2026-09-27T10:51:12.9427390Z   run-init: true
OS (macos)	UNKNOWN STEP	2026-09-27T10:51:12.9427560Z   conda-solver: libmamba
OS (macos)	UNKNOWN STEP	2026-09-27T10:51:12.9427750Z   clean-patched-environment-file: true
OS (macos)	UNKNOWN STEP	2026-09-27T10:51:12.9427990Z   run-post: true
OS (macos)	UNKNOWN STEP	2026-09-27T10:51:12.9428130Z env:
OS (macos)	UNKNOWN STEP	2026-09-27T10:51:12.9428290Z   BASE_ENV: envs/environment.yaml
OS (macos)	UNKNOWN STEP	2026-09-27T10:51:12.9428500Z   env_file: envs/osx-arm64.lock.yaml
OS (macos)	UNKNOWN STEP	2026-09-27T10:51:12.9428700Z ##[endgroup]
OS (macos)	UNKNOWN STEP	2026-09-27T10:51:13.0324460Z ##[group]Gathering Inputs...
OS (macos)	UNKNOWN STEP	2026-09-27T10:51:13.0332370Z ##[endgroup]
OS (macos)	UNKNOWN STEP	2026-09-27T10:51:13.0333100Z ##[group]Creating bootstrap condarc file in /Users/runner/.condarc...
OS (macos)	UNKNOWN STEP	2026-09-27T10:51:13.0341470Z ##[endgroup]
OS (macos)	UNKNOWN STEP	2026-09-27T10:51:13.0342150Z ##[group]Ensuring installer...
OS (macos)	UNKNOWN STEP	2026-09-27T10:51:13.0342390Z Can we use bundled Miniconda?
OS (macos)	UNKNOWN STEP	2026-09-27T10:51:13.0342820Z Can we download a custom installer by URL?
OS (macos)	UNKNOWN STEP	2026-09-27T10:51:13.0343280Z Can we download Miniforge?
OS (macos)	UNKNOWN STEP	2026-09-27T10:51:13.0343770Z ... will download Miniforge.
OS (macos)	UNKNOWN STEP	2026-09-27T10:51:13.0345190Z Will fetch Miniforge3 latest from https://github.com/conda-forge/miniforge/releases/latest/download/Miniforge3-MacOSX-arm64.sh
OS (macos)	UNKNOWN STEP	2026-09-27T10:51:13.0345920Z Ensuring Installer...
OS (macos)	UNKNOWN STEP	2026-09-27T10:51:13.0346320Z Checking for cached Miniforge3@latest...
OS (macos)	UNKNOWN STEP	2026-09-27T10:51:13.0353830Z Did not find Miniforge3-MacOSX-arm64.sh latest in cache
OS (macos)	UNKNOWN STEP	2026-09-27T10:51:14.2637900Z Downloaded Miniforge3-MacOSX-arm64.sh, ensuring extension .sh
OS (macos)	UNKNOWN STEP	2026-09-27T10:51:14.2647170Z Caching Miniforge3@latest...
OS (macos)	UNKNOWN STEP	2026-09-27T10:51:14.4300640Z Cached Miniforge3@latest: /Users/runner/hostedtoolcache/Miniforge3/latest/arm64!
OS (macos)	UNKNOWN STEP	2026-09-27T10:51:14.4335100Z ##[endgroup]
OS (macos)	UNKNOWN STEP	2026-09-27T10:51:14.4374590Z ##[group]Running installer...
OS (macos)	UNKNOWN STEP	2026-09-27T10:51:14.4379200Z [command]/bin/bash /Users/runner/work/_temp/ed22d6c1-1e83-45e1-9b1b-6e13411c8d2d.sh -f -b -p /Users/runner/miniconda3
OS (macos)	UNKNOWN STEP	2026-09-27T10:51:14.5188400Z PREFIX=/Users/runner/miniconda3
OS (macos)	UNKNOWN STEP	2026-09-27T10:51:14.7662620Z Unpacking bootstrapper...
OS (macos)	UNKNOWN STEP	2026-09-27T10:51:14.8455430Z Unpacking payload...
OS (macos)	UNKNOWN STEP	2026-09-27T10:51:15.2828860Z Extracting bzip2-1.0.8-h4e30115_10.conda
OS (macos)	UNKNOWN STEP	2026-09-27T10:51:15.2926780Z Extracting c-ares-1.34.8-h74c22ad_2.conda
OS (macos)	UNKNOWN STEP	2026-09-27T10:51:15.3217630Z Extracting ca-certificates-2026.7.22-hbd8a1cb_0.conda
OS (macos)	UNKNOWN STEP	2026-09-27T10:51:15.3283760Z Extracting icu-78.3-py310h579977c_2.conda
OS (macos)	UNKNOWN STEP	2026-09-27T10:51:15.4465290Z Extracting libcxx-23.1.1-h55c6f16_0.conda
OS (macos)	UNKNOWN STEP	2026-09-27T10:51:15.4580150Z Extracting libev-4.33-h1a92334_3.conda
OS (macos)	UNKNOWN STEP	2026-09-27T10:51:15.4611990Z Extracting libexpat-2.8.1-hf6b4638_1.conda
OS (macos)	UNKNOWN STEP	2026-09-27T10:51:15.4679960Z Extracting libffi-3.7.0-h47dc5ef_1.conda
OS (macos)	UNKNOWN STEP	2026-09-27T10:51:15.4726660Z Extracting libiconv-1.18-he4c29f2_3.conda
OS (macos)	UNKNOWN STEP	2026-09-27T10:51:15.4830950Z Extracting liblzma-5.8.3-h8088a28_1.conda
OS (macos)	UNKNOWN STEP	2026-09-27T10:51:15.4867410Z Extracting libmpdec-4.0.0-h84a0fba_2.conda
OS (macos)	UNKNOWN STEP	2026-09-27T10:51:15.4891960Z Extracting libzlib-1.3.2-h8088a28_3.conda
OS (macos)	UNKNOWN STEP	2026-09-27T10:51:15.4951780Z Extracting lzo-2.10-h74c22ad_1003.conda
OS (macos)	UNKNOWN STEP	2026-09-27T10:51:15.5069020Z Extracting ncurses-6.6-he64c551_1.conda
OS (macos)	UNKNOWN STEP	2026-09-27T10:51:15.9308220Z Extracting nlohmann_json-abi-3.12.0-h0f90c79_2.conda
OS (macos)	UNKNOWN STEP	2026-09-27T10:51:15.9329330Z Extracting pybind11-abi-11-hc364b38_1.conda
OS (macos)	UNKNOWN STEP	2026-09-27T10:51:15.9360510Z Extracting python_abi-3.14-9_cp314.conda
OS (macos)	UNKNOWN STEP	2026-09-27T10:51:15.9381350Z Extracting reproc-14.2.8.post0-hdca3b7d_0.conda
OS (macos)	UNKNOWN STEP	2026-09-27T10:51:15.9434530Z Extracting tzdata-2026c-h151e31d_0.conda
OS (macos)	UNKNOWN STEP	2026-09-27T10:51:16.0271430Z Extracting cpp-expected-1.3.1-h3feff0a_1.conda
OS (macos)	UNKNOWN STEP	2026-09-27T10:51:16.0301340Z Extracting fmt-12.1.0-h99e4e11_1.conda
OS (macos)	UNKNOWN STEP	2026-09-27T10:51:16.0382180Z Extracting libedit-3.1.20250104-pl5321h26f1114_1.conda
OS (macos)	UNKNOWN STEP	2026-09-27T10:51:16.0563740Z Extracting libmsgpack-c-6.1.0-h784d473_7.conda
OS (macos)	UNKNOWN STEP	2026-09-27T10:51:16.0632250Z Extracting libpsl-0.23.1-hdb0c161_1.conda
OS (macos)	UNKNOWN STEP	2026-09-27T10:51:16.0640210Z Extracting libpython-3.14.7-h4311e70_106_cp314.conda
OS (macos)	UNKNOWN STEP	2026-09-27T10:51:16.0954490Z Extracting libsolv-0.7.39-h626c152_1.conda
OS (macos)	UNKNOWN STEP	2026-09-27T10:51:16.1113190Z Extracting libsqlite-3.53.4-hca69786_1.conda
OS (macos)	UNKNOWN STEP	2026-09-27T10:51:16.1210670Z Extracting libxml2-16-2.15.4-heb56d2d_0.conda
OS (macos)	UNKNOWN STEP	2026-09-27T10:51:16.1274680Z Extracting lz4-c-1.10.0-hdca3b7d_2.conda
OS (macos)	UNKNOWN STEP	2026-09-27T10:51:16.1333490Z Extracting openssl-3.6.4-h55eecbc_0.conda
OS (macos)	UNKNOWN STEP	2026-09-27T10:51:16.1935320Z Extracting readline-8.3-h8b90a29_1.conda
OS (macos)	UNKNOWN STEP	2026-09-27T10:51:16.2020000Z Extracting reproc-cpp-14.2.8.post0-h2fd3d4c_0.conda
OS (macos)	UNKNOWN STEP	2026-09-27T10:51:16.2129030Z Extracting simdjson-4.6.11-hfbe1efa_0.conda
OS (macos)	UNKNOWN STEP	2026-09-27T10:51:16.2275720Z Extracting tk-8.6.13-hbeba79b_4.conda
OS (macos)	UNKNOWN STEP	2026-09-27T10:51:16.3533300Z Extracting yaml-cpp-0.8.0-h784d473_1.conda
OS (macos)	UNKNOWN STEP	2026-09-27T10:51:16.3697310Z Extracting zstd-1.5.7-hf451053_7.conda
OS (macos)	UNKNOWN STEP	2026-09-27T10:51:16.3832790Z Extracting krb5-1.22.2-h34f8a20_2.conda
OS (macos)	UNKNOWN STEP	2026-09-27T10:51:16.4197290Z Extracting libnghttp2-1.68.1-h435687b_1.conda
OS (macos)	UNKNOWN STEP	2026-09-27T10:51:16.4272310Z Extracting libssh2-1.11.1-hbf2880b_1.conda
OS (macos)	UNKNOWN STEP	2026-09-27T10:51:16.4603180Z Extracting libxml2-2.15.4-h550178d_0.conda
OS (macos)	UNKNOWN STEP	2026-09-27T10:51:16.4649990Z Extracting python-3.14.7-h0ae1c2c_106_cp314.conda
OS (macos)	UNKNOWN STEP	2026-09-27T10:51:16.9213990Z Extracting spdlog-1.17.0-h760df91_2.conda
OS (macos)	UNKNOWN STEP	2026-09-27T10:51:16.9469780Z Extracting libarchive-3.8.9-gpl_h76147b0_101.conda
OS (macos)	UNKNOWN STEP	2026-09-27T10:51:16.9715380Z Extracting libcurl-8.22.0-h6651222_0.conda
OS (macos)	UNKNOWN STEP	2026-09-27T10:51:16.9816020Z Extracting tomli-w-1.2.0-pyhd8ed1ab_0.conda
OS (macos)	UNKNOWN STEP	2026-09-27T10:51:16.9860600Z Extracting libmamba-2.9.0-py314h12d839b_0.conda
OS (macos)	UNKNOWN STEP	2026-09-27T10:51:17.0232790Z Extracting menuinst-2.5.2-py314h6ffbfce_2.conda
OS (macos)	UNKNOWN STEP	2026-09-27T10:51:17.0492210Z Extracting archspec-0.2.5-pyhd8ed1ab_0.conda
OS (macos)	UNKNOWN STEP	2026-09-27T10:51:17.0739560Z Extracting backports.zstd-1.7.0-py314h680f03e_1.conda
OS (macos)	UNKNOWN STEP	2026-09-27T10:51:17.0767360Z Extracting boltons-26.2.0-pyhd8ed1ab_0.conda
OS (macos)	UNKNOWN STEP	2026-09-27T10:51:17.1142440Z Extracting brotli-python-1.2.0-py314hee34562_4.conda
OS (macos)	UNKNOWN STEP	2026-09-27T10:51:17.1254160Z Extracting cached_property-2.0.1-pyhcf101f3_0.conda
OS (macos)	UNKNOWN STEP	2026-09-27T10:51:17.1295940Z Extracting certifi-2026.7.22-pyhd8ed1ab_0.conda
OS (macos)	UNKNOWN STEP	2026-09-27T10:51:17.1344690Z Extracting charset-normalizer-3.5.1-pyhd8ed1ab_0.conda
OS (macos)	UNKNOWN STEP	2026-09-27T10:51:17.1408250Z Extracting colorama-0.4.6-pyhd8ed1ab_1.conda
OS (macos)	UNKNOWN STEP	2026-09-27T10:51:17.1463480Z Extracting cpython-3.14.7-py314hd8ed1ab_106.conda
OS (macos)	UNKNOWN STEP	2026-09-27T10:51:17.1580390Z Extracting distro-1.9.0-pyhd8ed1ab_1.conda
OS (macos)	UNKNOWN STEP	2026-09-27T10:51:17.1993790Z Extracting frozendict-2.4.7-pyh851646a_2.conda
OS (macos)	UNKNOWN STEP	2026-09-27T10:51:17.2088370Z Extracting hpack-4.2.0-pyhd8ed1ab_0.conda
OS (macos)	UNKNOWN STEP	2026-09-27T10:51:17.2135610Z Extracting hyperframe-6.1.0-pyhd8ed1ab_0.conda
OS (macos)	UNKNOWN STEP	2026-09-27T10:51:17.2171030Z Extracting idna-3.19-pyhcf101f3_0.conda
OS (macos)	UNKNOWN STEP	2026-09-27T10:51:17.2260340Z Extracting libmamba-spdlog-2.9.0-h7215443_0.conda
OS (macos)	UNKNOWN STEP	2026-09-27T10:51:17.2290990Z Extracting mamba-2.9.0-hfb6e983_0.conda
OS (macos)	UNKNOWN STEP	2026-09-27T10:51:17.2349570Z Extracting markupsafe-3.0.3-py314h6e9b3f0_1.conda
OS (macos)	UNKNOWN STEP	2026-09-27T10:51:17.2412880Z Extracting msgpack-python-1.2.2-py314hb1acb19_2.conda
OS (macos)	UNKNOWN STEP	2026-09-27T10:51:17.2458930Z Extracting packaging-26.3-pyhc364b38_0.conda
OS (macos)	UNKNOWN STEP	2026-09-27T10:51:17.2517050Z Extracting pip-26.2.1-pyh145f28c_0.conda
OS (macos)	UNKNOWN STEP	2026-09-27T10:51:17.3394270Z Extracting platformdirs-4.11.6-pyh5ded981_0.conda
OS (macos)	UNKNOWN STEP	2026-09-27T10:51:17.3446450Z Extracting pluggy-1.6.0-pyhf9edf01_1.conda
OS (macos)	UNKNOWN STEP	2026-09-27T10:51:17.3479380Z Extracting pycosat-0.6.6-py314hcd3153d_5.conda
OS (macos)	UNKNOWN STEP	2026-09-27T10:51:17.3538280Z Extracting pysocks-1.7.1-pyha55dd90_7.conda
OS (macos)	UNKNOWN STEP	2026-09-27T10:51:17.3571650Z Extracting python-installer-1.0.1-pyh332efcf_0.conda
OS (macos)	UNKNOWN STEP	2026-09-27T10:51:17.3650520Z Extracting ruamel.yaml.clib-0.2.15-py314hd98292b_5.conda
OS (macos)	UNKNOWN STEP	2026-09-27T10:51:17.3684900Z Extracting setuptools-84.0.0-pyh332efcf_0.conda
OS (macos)	UNKNOWN STEP	2026-09-27T10:51:17.4298130Z Extracting sniffio-1.3.1-pyhd8ed1ab_2.conda
OS (macos)	UNKNOWN STEP	2026-09-27T10:51:17.4386960Z Extracting tomli-2.4.1-pyhcf101f3_0.conda
OS (macos)	UNKNOWN STEP	2026-09-27T10:51:17.4488030Z Extracting tqdm-4.70.0-pyh8f84b5b_0.conda
OS (macos)	UNKNOWN STEP	2026-09-27T10:51:17.4522890Z Extracting truststore-0.10.4-pyhcf101f3_0.conda
OS (macos)	UNKNOWN STEP	2026-09-27T10:51:17.4527160Z Extracting typing_extensions-4.16.0-pyhcf101f3_0.conda
OS (macos)	UNKNOWN STEP	2026-09-27T10:51:17.4561290Z Extracting zipp-4.1.0-pyhcf101f3_0.conda
OS (macos)	UNKNOWN STEP	2026-09-27T10:51:17.4604830Z Extracting anyio-4.15.1-pyh5ded981_1.conda
OS (macos)	UNKNOWN STEP	2026-09-27T10:51:17.4765680Z Extracting cached-property-2.0.1-pyhcf101f3_0.conda
OS (macos)	UNKNOWN STEP	2026-09-27T10:51:17.4783140Z Extracting conda-package-streaming-0.13.0-pyhd8ed1ab_0.conda
OS (macos)	UNKNOWN STEP	2026-09-27T10:51:17.4829340Z Extracting h11-0.16.0-pyhcf101f3_1.conda
OS (macos)	UNKNOWN STEP	2026-09-27T10:51:17.4870720Z Extracting h2-4.4.1-pyhcf101f3_0.conda
OS (macos)	UNKNOWN STEP	2026-09-27T10:51:17.5011080Z Extracting importlib-metadata-9.0.1-pyhcf101f3_0.conda
OS (macos)	UNKNOWN STEP	2026-09-27T10:51:17.5019840Z Extracting jinja2-3.1.6-pyhcf101f3_1.conda
OS (macos)	UNKNOWN STEP	2026-09-27T10:51:17.5080770Z Extracting libmambapy-2.9.0-py314h53f8b30_0.conda
OS (macos)	UNKNOWN STEP	2026-09-27T10:51:17.5164480Z Extracting pyproject_hooks-1.2.0-pyhd8ed1ab_1.conda
OS (macos)	UNKNOWN STEP	2026-09-27T10:51:17.5243850Z Extracting python-gil-3.14.7-h4df99d1_106.conda
OS (macos)	UNKNOWN STEP	2026-09-27T10:51:17.5345600Z Extracting ruamel.yaml-0.19.1-pyhcf101f3_0.conda
OS (macos)	UNKNOWN STEP	2026-09-27T10:51:17.5434200Z Extracting typing-extensions-4.16.0-h69aa097_0.conda
OS (macos)	UNKNOWN STEP	2026-09-27T10:51:17.5451020Z Extracting typing-inspection-0.4.4-pyhcf101f3_0.conda
OS (macos)	UNKNOWN STEP	2026-09-27T10:51:17.5492610Z Extracting _python_abi3_support-1.0-hd8ed1ab_3.conda
OS (macos)	UNKNOWN STEP	2026-09-27T10:51:17.5558780Z Extracting annotated-types-0.8.0-pyhd8ed1ab_0.conda
OS (macos)	UNKNOWN STEP	2026-09-27T10:51:17.5559330Z Extracting conda-libmamba-solver-26.7.0-pyhcf101f3_0.conda
OS (macos)	UNKNOWN STEP	2026-09-27T10:51:17.5602650Z Extracting httpcore-1.0.9-pyh29332c3_0.conda
OS (macos)	UNKNOWN STEP	2026-09-27T10:51:17.5672540Z Extracting pydantic-core-2.46.5-py314hc05cd11_1.conda
OS (macos)	UNKNOWN STEP	2026-09-27T10:51:17.5789290Z Extracting python-build-1.6.0-pyhc364b38_0.conda
OS (macos)	UNKNOWN STEP	2026-09-27T10:51:17.5854990Z Extracting urllib3-2.7.0-pyhd8ed1ab_0.conda
OS (macos)	UNKNOWN STEP	2026-09-27T10:51:17.5974150Z Extracting httpx-0.28.1-pyhd8ed1ab_0.conda
OS (macos)	UNKNOWN STEP	2026-09-27T10:51:17.6041900Z Extracting py-rattler-0.25.0-py310h2dd3e6a_5.conda
OS (macos)	UNKNOWN STEP	2026-09-27T10:51:17.6728600Z Extracting pydantic-2.13.5-pyhcf101f3_0.conda
OS (macos)	UNKNOWN STEP	2026-09-27T10:51:17.6958880Z Extracting requests-2.34.2-pyhcf101f3_0.conda
OS (macos)	UNKNOWN STEP	2026-09-27T10:51:17.7020970Z Extracting conda-package-handling-2.6.0-pyh5ded981_0.conda
OS (macos)	UNKNOWN STEP	2026-09-27T10:51:17.7102890Z Extracting unearth-0.18.3-pyhd8ed1ab_0.conda
OS (macos)	UNKNOWN STEP	2026-09-27T10:51:17.7201010Z Extracting conda-index-0.13.0-pyh5ded981_0.conda
OS (macos)	UNKNOWN STEP	2026-09-27T10:51:17.7739320Z Extracting conda-pypi-0.11.0-pyh5ded981_2.conda
OS (macos)	UNKNOWN STEP	2026-09-27T10:51:17.7833600Z Extracting conda-lockfiles-0.2.1-pyhd8ed1ab_0.conda
OS (macos)	UNKNOWN STEP	2026-09-27T10:51:17.7896390Z Extracting conda-rattler-solver-0.1.1-pyhcf101f3_0.conda
OS (macos)	UNKNOWN STEP	2026-09-27T10:51:17.7933060Z Extracting conda-self-0.2.1-pyhd8ed1ab_0.conda
OS (macos)	UNKNOWN STEP	2026-09-27T10:51:17.8011280Z Extracting conda-26.7.2-py314hcec6336_1.conda
OS (macos)	UNKNOWN STEP	2026-09-27T10:51:17.9085830Z 
OS (macos)	UNKNOWN STEP	2026-09-27T10:51:17.9086430Z Installing base environment...
OS (macos)	UNKNOWN STEP	2026-09-27T10:51:17.9086810Z 
OS (macos)	UNKNOWN STEP	2026-09-27T10:51:17.9482440Z Transaction
OS (macos)	UNKNOWN STEP	2026-09-27T10:51:17.9483160Z 
OS (macos)	UNKNOWN STEP	2026-09-27T10:51:17.9483380Z   Prefix: /Users/runner/miniconda3
OS (macos)	UNKNOWN STEP	2026-09-27T10:51:17.9483620Z 
OS (macos)	UNKNOWN STEP	2026-09-27T10:51:17.9483730Z   Updating specs:
OS (macos)	UNKNOWN STEP	2026-09-27T10:51:17.9483940Z 
OS (macos)	UNKNOWN STEP	2026-09-27T10:51:17.9484200Z    - bzip2==1.0.8=h4e30115_10
OS (macos)	UNKNOWN STEP	2026-09-27T10:51:17.9486210Z    - c-ares==1.34.8=h74c22ad_2
OS (macos)	UNKNOWN STEP	2026-09-27T10:51:17.9488290Z    - ca-certificates==2026.7.22=hbd8a1cb_0
OS (macos)	UNKNOWN STEP	2026-09-27T10:51:17.9489810Z    - icu==78.3=py310h579977c_2
OS (macos)	UNKNOWN STEP	2026-09-27T10:51:17.9490100Z    - libcxx==23.1.1=h55c6f16_0
OS (macos)	UNKNOWN STEP	2026-09-27T10:51:17.9490310Z    - libev==4.33=h1a92334_3
OS (macos)	UNKNOWN STEP	2026-09-27T10:51:17.9490820Z    - libexpat==2.8.1=hf6b4638_1
OS (macos)	UNKNOWN STEP	2026-09-27T10:51:17.9491110Z    - libffi==3.7.0=h47dc5ef_1
OS (macos)	UNKNOWN STEP	2026-09-27T10:51:17.9491500Z    - libiconv==1.18=he4c29f2_3
OS (macos)	UNKNOWN STEP	2026-09-27T10:51:17.9491740Z    - liblzma==5.8.3=h8088a28_1
OS (macos)	UNKNOWN STEP	2026-09-27T10:51:17.9492040Z    - libmpdec==4.0.0=h84a0fba_2
OS (macos)	UNKNOWN STEP	2026-09-27T10:51:17.9492300Z    - libzlib==1.3.2=h8088a28_3
OS (macos)	UNKNOWN STEP	2026-09-27T10:51:17.9492630Z    - lzo==2.10=h74c22ad_1003
OS (macos)	UNKNOWN STEP	2026-09-27T10:51:17.9492930Z    - ncurses==6.6=he64c551_1
OS (macos)	UNKNOWN STEP	2026-09-27T10:51:17.9494720Z    - nlohmann_json-abi==3.12.0=h0f90c79_2
OS (macos)	UNKNOWN STEP	2026-09-27T10:51:17.9495080Z    - pybind11-abi==11=hc364b38_1
OS (macos)	UNKNOWN STEP	2026-09-27T10:51:17.9495350Z    - python_abi==3.14=9_cp314
OS (macos)	UNKNOWN STEP	2026-09-27T10:51:17.9495730Z    - reproc==14.2.8.post0=hdca3b7d_0
OS (macos)	UNKNOWN STEP	2026-09-27T10:51:17.9496170Z    - tzdata==2026c=h151e31d_0
OS (macos)	UNKNOWN STEP	2026-09-27T10:51:17.9496480Z    - cpp-expected==1.3.1=h3feff0a_1
OS (macos)	UNKNOWN STEP	2026-09-27T10:51:17.9496770Z    - fmt==12.1.0=h99e4e11_1
OS (macos)	UNKNOWN STEP	2026-09-27T10:51:17.9497100Z    - libedit==3.1.20250104=pl5321h26f1114_1
OS (macos)	UNKNOWN STEP	2026-09-27T10:51:17.9497330Z    - libmsgpack-c==6.1.0=h784d473_7
OS (macos)	UNKNOWN STEP	2026-09-27T10:51:17.9499120Z    - libpsl==0.23.1=hdb0c161_1
OS (macos)	UNKNOWN STEP	2026-09-27T10:51:17.9499320Z    - libpython==3.14.7=h4311e70_106_cp314
OS (macos)	UNKNOWN STEP	2026-09-27T10:51:17.9499530Z    - libsolv==0.7.39=h626c152_1
OS (macos)	UNKNOWN STEP	2026-09-27T10:51:17.9499710Z    - libsqlite==3.53.4=hca69786_1
OS (macos)	UNKNOWN STEP	2026-09-27T10:51:17.9499900Z    - libxml2-16==2.15.4=heb56d2d_0
OS (macos)	UNKNOWN STEP	2026-09-27T10:51:17.9500080Z    - lz4-c==1.10.0=hdca3b7d_2
OS (macos)	UNKNOWN STEP	2026-09-27T10:51:17.9500260Z    - openssl==3.6.4=h55eecbc_0
OS (macos)	UNKNOWN STEP	2026-09-27T10:51:17.9500440Z    - readline==8.3=h8b90a29_1
OS (macos)	UNKNOWN STEP	2026-09-27T10:51:17.9500620Z    - reproc-cpp==14.2.8.post0=h2fd3d4c_0
OS (macos)	UNKNOWN STEP	2026-09-27T10:51:17.9500830Z    - simdjson==4.6.11=hfbe1efa_0
OS (macos)	UNKNOWN STEP	2026-09-27T10:51:17.9501010Z    - tk==8.6.13=hbeba79b_4
OS (macos)	UNKNOWN STEP	2026-09-27T10:51:17.9501170Z    - yaml-cpp==0.8.0=h784d473_1
OS (macos)	UNKNOWN STEP	2026-09-27T10:51:17.9501340Z    - zstd==1.5.7=hf451053_7
OS (macos)	UNKNOWN STEP	2026-09-27T10:51:17.9501510Z    - krb5==1.22.2=h34f8a20_2
OS (macos)	UNKNOWN STEP	2026-09-27T10:51:17.9501680Z    - libnghttp2==1.68.1=h435687b_1
OS (macos)	UNKNOWN STEP	2026-09-27T10:51:17.9501970Z    - libssh2==1.11.1=hbf2880b_1
OS (macos)	UNKNOWN STEP	2026-09-27T10:51:17.9502170Z    - libxml2==2.15.4=h550178d_0
OS (macos)	UNKNOWN STEP	2026-09-27T10:51:17.9502540Z    - python==3.14.7=h0ae1c2c_106_cp314
OS (macos)	UNKNOWN STEP	2026-09-27T10:51:17.9502730Z    - spdlog==1.17.0=h760df91_2
OS (macos)	UNKNOWN STEP	2026-09-27T10:51:17.9502990Z    - libarchive==3.8.9=gpl_h76147b0_101
OS (macos)	UNKNOWN STEP	2026-09-27T10:51:17.9503190Z    - libcurl==8.22.0=h6651222_0
OS (macos)	UNKNOWN STEP	2026-09-27T10:51:17.9503410Z    - tomli-w==1.2.0=pyhd8ed1ab_0
OS (macos)	UNKNOWN STEP	2026-09-27T10:51:17.9503630Z    - libmamba==2.9.0=py314h12d839b_0
OS (macos)	UNKNOWN STEP	2026-09-27T10:51:17.9503820Z    - menuinst==2.5.2=py314h6ffbfce_2
OS (macos)	UNKNOWN STEP	2026-09-27T10:51:17.9504250Z    - archspec==0.2.5=pyhd8ed1ab_0
OS (macos)	UNKNOWN STEP	2026-09-27T10:51:17.9504560Z    - backports.zstd==1.7.0=py314h680f03e_1
OS (macos)	UNKNOWN STEP	2026-09-27T10:51:17.9504780Z    - boltons==26.2.0=pyhd8ed1ab_0
OS (macos)	UNKNOWN STEP	2026-09-27T10:51:17.9504980Z    - brotli-python==1.2.0=py314hee34562_4
OS (macos)	UNKNOWN STEP	2026-09-27T10:51:17.9505250Z    - cached_property==2.0.1=pyhcf101f3_0
OS (macos)	UNKNOWN STEP	2026-09-27T10:51:17.9505450Z    - certifi==2026.7.22=pyhd8ed1ab_0
OS (macos)	UNKNOWN STEP	2026-09-27T10:51:17.9505730Z    - charset-normalizer==3.5.1=pyhd8ed1ab_0
OS (macos)	UNKNOWN STEP	2026-09-27T10:51:17.9505940Z    - colorama==0.4.6=pyhd8ed1ab_1
OS (macos)	UNKNOWN STEP	2026-09-27T10:51:17.9506130Z    - cpython==3.14.7=py314hd8ed1ab_106
OS (macos)	UNKNOWN STEP	2026-09-27T10:51:17.9506320Z    - distro==1.9.0=pyhd8ed1ab_1
OS (macos)	UNKNOWN STEP	2026-09-27T10:51:17.9506500Z    - frozendict==2.4.7=pyh851646a_2
OS (macos)	UNKNOWN STEP	2026-09-27T10:51:17.9506690Z    - hpack==4.2.0=pyhd8ed1ab_0
OS (macos)	UNKNOWN STEP	2026-09-27T10:51:17.9506860Z    - hyperframe==6.1.0=pyhd8ed1ab_0
OS (macos)	UNKNOWN STEP	2026-09-27T10:51:17.9507090Z    - idna==3.19=pyhcf101f3_0
OS (macos)	UNKNOWN STEP	2026-09-27T10:51:17.9507360Z    - libmamba-spdlog==2.9.0=h7215443_0
OS (macos)	UNKNOWN STEP	2026-09-27T10:51:17.9507690Z    - mamba==2.9.0=hfb6e983_0
OS (macos)	UNKNOWN STEP	2026-09-27T10:51:17.9508040Z    - markupsafe==3.0.3=py314h6e9b3f0_1
OS (macos)	UNKNOWN STEP	2026-09-27T10:51:17.9508250Z    - msgpack-python==1.2.2=py314hb1acb19_2
OS (macos)	UNKNOWN STEP	2026-09-27T10:51:17.9508560Z    - packaging==26.3=pyhc364b38_0
OS (macos)	UNKNOWN STEP	2026-09-27T10:51:17.9508810Z    - pip==26.2.1=pyh145f28c_0
OS (macos)	UNKNOWN STEP	2026-09-27T10:51:17.9509030Z    - platformdirs==4.11.6=pyh5ded981_0
OS (macos)	UNKNOWN STEP	2026-09-27T10:51:17.9509310Z    - pluggy==1.6.0=pyhf9edf01_1
OS (macos)	UNKNOWN STEP	2026-09-27T10:51:17.9509500Z    - pycosat==0.6.6=py314hcd3153d_5
OS (macos)	UNKNOWN STEP	2026-09-27T10:51:17.9509840Z    - pysocks==1.7.1=pyha55dd90_7
OS (macos)	UNKNOWN STEP	2026-09-27T10:51:17.9510070Z    - python-installer==1.0.1=pyh332efcf_0
OS (macos)	UNKNOWN STEP	2026-09-27T10:51:17.9510350Z    - ruamel.yaml.clib==0.2.15=py314hd98292b_5
OS (macos)	UNKNOWN STEP	2026-09-27T10:51:17.9510620Z    - setuptools==84.0.0=pyh332efcf_0
OS (macos)	UNKNOWN STEP	2026-09-27T10:51:17.9510860Z    - sniffio==1.3.1=pyhd8ed1ab_2
OS (macos)	UNKNOWN STEP	2026-09-27T10:51:17.9511030Z    - tomli==2.4.1=pyhcf101f3_0
OS (macos)	UNKNOWN STEP	2026-09-27T10:51:17.9511380Z    - tqdm==4.70.0=pyh8f84b5b_0
OS (macos)	UNKNOWN STEP	2026-09-27T10:51:17.9511850Z    - truststore==0.10.4=pyhcf101f3_0
OS (macos)	UNKNOWN STEP	2026-09-27T10:51:17.9512270Z    - typing_extensions==4.16.0=pyhcf101f3_0
OS (macos)	UNKNOWN STEP	2026-09-27T10:51:17.9512490Z    - zipp==4.1.0=pyhcf101f3_0
OS (macos)	UNKNOWN STEP	2026-09-27T10:51:17.9512670Z    - anyio==4.15.1=pyh5ded981_1
OS (macos)	UNKNOWN STEP	2026-09-27T10:51:17.9512850Z    - cached-property==2.0.1=pyhcf101f3_0
OS (macos)	UNKNOWN STEP	2026-09-27T10:51:17.9513110Z    - conda-package-streaming==0.13.0=pyhd8ed1ab_0
OS (macos)	UNKNOWN STEP	2026-09-27T10:51:17.9513370Z    - h11==0.16.0=pyhcf101f3_1
OS (macos)	UNKNOWN STEP	2026-09-27T10:51:17.9513580Z    - h2==4.4.1=pyhcf101f3_0
OS (macos)	UNKNOWN STEP	2026-09-27T10:51:17.9513770Z    - importlib-metadata==9.0.1=pyhcf101f3_0
OS (macos)	UNKNOWN STEP	2026-09-27T10:51:17.9514030Z    - jinja2==3.1.6=pyhcf101f3_1
OS (macos)	UNKNOWN STEP	2026-09-27T10:51:17.9514370Z    - libmambapy==2.9.0=py314h53f8b30_0
OS (macos)	UNKNOWN STEP	2026-09-27T10:51:17.9514580Z    - pyproject_hooks==1.2.0=pyhd8ed1ab_1
OS (macos)	UNKNOWN STEP	2026-09-27T10:51:17.9514780Z    - python-gil==3.14.7=h4df99d1_106
OS (macos)	UNKNOWN STEP	2026-09-27T10:51:17.9514980Z    - ruamel.yaml==0.19.1=pyhcf101f3_0
OS (macos)	UNKNOWN STEP	2026-09-27T10:51:17.9515240Z    - typing-extensions==4.16.0=h69aa097_0
OS (macos)	UNKNOWN STEP	2026-09-27T10:51:17.9515450Z    - typing-inspection==0.4.4=pyhcf101f3_0
OS (macos)	UNKNOWN STEP	2026-09-27T10:51:17.9515660Z    - _python_abi3_support==1.0=hd8ed1ab_3
OS (macos)	UNKNOWN STEP	2026-09-27T10:51:17.9515950Z    - annotated-types==0.8.0=pyhd8ed1ab_0
OS (macos)	UNKNOWN STEP	2026-09-27T10:51:17.9516200Z    - conda-libmamba-solver==26.7.0=pyhcf101f3_0
OS (macos)	UNKNOWN STEP	2026-09-27T10:51:17.9516420Z    - httpcore==1.0.9=pyh29332c3_0
OS (macos)	UNKNOWN STEP	2026-09-27T10:51:17.9516600Z    - pydantic-core==2.46.5=py314hc05cd11_1
OS (macos)	UNKNOWN STEP	2026-09-27T10:51:17.9516800Z    - python-build==1.6.0=pyhc364b38_0
OS (macos)	UNKNOWN STEP	2026-09-27T10:51:17.9516990Z    - urllib3==2.7.0=pyhd8ed1ab_0
OS (macos)	UNKNOWN STEP	2026-09-27T10:51:17.9517170Z    - httpx==0.28.1=pyhd8ed1ab_0
OS (macos)	UNKNOWN STEP	2026-09-27T10:51:17.9517350Z    - py-rattler==0.25.0=py310h2dd3e6a_5
OS (macos)	UNKNOWN STEP	2026-09-27T10:51:17.9517540Z    - pydantic==2.13.5=pyhcf101f3_0
OS (macos)	UNKNOWN STEP	2026-09-27T10:51:17.9517730Z    - requests==2.34.2=pyhcf101f3_0
OS (macos)	UNKNOWN STEP	2026-09-27T10:51:17.9517970Z    - conda-package-handling==2.6.0=pyh5ded981_0
OS (macos)	UNKNOWN STEP	2026-09-27T10:51:17.9518220Z    - unearth==0.18.3=pyhd8ed1ab_0
OS (macos)	UNKNOWN STEP	2026-09-27T10:51:17.9518440Z    - conda-index==0.13.0=pyh5ded981_0
OS (macos)	UNKNOWN STEP	2026-09-27T10:51:17.9518640Z    - conda-pypi==0.11.0=pyh5ded981_2
OS (macos)	UNKNOWN STEP	2026-09-27T10:51:17.9518850Z    - conda-lockfiles==0.2.1=pyhd8ed1ab_0
OS (macos)	UNKNOWN STEP	2026-09-27T10:51:17.9519080Z    - conda-rattler-solver==0.1.1=pyhcf101f3_0
OS (macos)	UNKNOWN STEP	2026-09-27T10:51:17.9519340Z    - conda-self==0.2.1=pyhd8ed1ab_0
OS (macos)	UNKNOWN STEP	2026-09-27T10:51:17.9519540Z    - conda==26.7.2=py314hcec6336_1
OS (macos)	UNKNOWN STEP	2026-09-27T10:51:17.9519670Z 
OS (macos)	UNKNOWN STEP	2026-09-27T10:51:17.9519670Z 
OS (macos)	UNKNOWN STEP	2026-09-27T10:51:17.9520230Z   Package                         Version  Build               Channel         Size
OS (macos)	UNKNOWN STEP	2026-09-27T10:51:17.9522800Z ─────────────────────────────────────────────────────────────────────────────────────
OS (macos)	UNKNOWN STEP	2026-09-27T10:51:17.9523160Z   Install:
OS (macos)	UNKNOWN STEP	2026-09-27T10:51:17.9523550Z ─────────────────────────────────────────────────────────────────────────────────────
OS (macos)	UNKNOWN STEP	2026-09-27T10:51:17.9523860Z 
OS (macos)	UNKNOWN STEP	2026-09-27T10:51:17.9524070Z   + _python_abi3_support              1.0  hd8ed1ab_3          conda-forge         
OS (macos)	UNKNOWN STEP	2026-09-27T10:51:17.9524500Z   + annotated-types                 0.8.0  pyhd8ed1ab_0        conda-forge         
OS (macos)	UNKNOWN STEP	2026-09-27T10:51:17.9524910Z   + anyio                          4.15.1  pyh5ded981_1        conda-forge         
OS (macos)	UNKNOWN STEP	2026-09-27T10:51:17.9525300Z   + archspec                        0.2.5  pyhd8ed1ab_0        conda-forge         
OS (macos)	UNKNOWN STEP	2026-09-27T10:51:17.9525700Z   + backports.zstd                  1.7.0  py314h680f03e_1     conda-forge         
OS (macos)	UNKNOWN STEP	2026-09-27T10:51:17.9526090Z   + boltons                        26.2.0  pyhd8ed1ab_0        conda-forge         
OS (macos)	UNKNOWN STEP	2026-09-27T10:51:17.9526500Z   + brotli-python                   1.2.0  py314hee34562_4     conda-forge         
OS (macos)	UNKNOWN STEP	2026-09-27T10:51:17.9526890Z   + bzip2                           1.0.8  h4e30115_10         conda-forge         
OS (macos)	UNKNOWN STEP	2026-09-27T10:51:17.9527280Z   + c-ares                         1.34.8  h74c22ad_2          conda-forge         
OS (macos)	UNKNOWN STEP	2026-09-27T10:51:17.9527680Z   + ca-certificates             2026.7.22  hbd8a1cb_0          conda-forge         
OS (macos)	UNKNOWN STEP	2026-09-27T10:51:17.9528100Z   + cached-property                 2.0.1  pyhcf101f3_0        conda-forge         
OS (macos)	UNKNOWN STEP	2026-09-27T10:51:17.9528510Z   + cached_property                 2.0.1  pyhcf101f3_0        conda-forge         
OS (macos)	UNKNOWN STEP	2026-09-27T10:51:17.9529190Z   + certifi                     2026.7.22  pyhd8ed1ab_0        conda-forge         
OS (macos)	UNKNOWN STEP	2026-09-27T10:51:17.9529600Z   + charset-normalizer              3.5.1  pyhd8ed1ab_0        conda-forge         
OS (macos)	UNKNOWN STEP	2026-09-27T10:51:17.9530040Z   + colorama                        0.4.6  pyhd8ed1ab_1        conda-forge         
OS (macos)	UNKNOWN STEP	2026-09-27T10:51:17.9530470Z   + conda                          26.7.2  py314hcec6336_1     conda-forge         
OS (macos)	UNKNOWN STEP	2026-09-27T10:51:17.9530860Z   + conda-index                    0.13.0  pyh5ded981_0        conda-forge         
OS (macos)	UNKNOWN STEP	2026-09-27T10:51:17.9531420Z   + conda-libmamba-solver          26.7.0  pyhcf101f3_0        conda-forge         
OS (macos)	UNKNOWN STEP	2026-09-27T10:51:17.9531870Z   + conda-lockfiles                 0.2.1  pyhd8ed1ab_0        conda-forge         
OS (macos)	UNKNOWN STEP	2026-09-27T10:51:17.9532260Z   + conda-package-handling          2.6.0  pyh5ded981_0        conda-forge         
OS (macos)	UNKNOWN STEP	2026-09-27T10:51:17.9532670Z   + conda-package-streaming        0.13.0  pyhd8ed1ab_0        conda-forge         
OS (macos)	UNKNOWN STEP	2026-09-27T10:51:17.9533050Z   + conda-pypi                     0.11.0  pyh5ded981_2        conda-forge         
OS (macos)	UNKNOWN STEP	2026-09-27T10:51:17.9533420Z   + conda-rattler-solver            0.1.1  pyhcf101f3_0        conda-forge         
OS (macos)	UNKNOWN STEP	2026-09-27T10:51:17.9533780Z   + conda-self                      0.2.1  pyhd8ed1ab_0        conda-forge         
OS (macos)	UNKNOWN STEP	2026-09-27T10:51:17.9534110Z   + cpp-expected                    1.3.1  h3feff0a_1          conda-forge         
OS (macos)	UNKNOWN STEP	2026-09-27T10:51:17.9534440Z   + cpython                        3.14.7  py314hd8ed1ab_106   conda-forge         
OS (macos)	UNKNOWN STEP	2026-09-27T10:51:17.9534770Z   + distro                          1.9.0  pyhd8ed1ab_1        conda-forge         
OS (macos)	UNKNOWN STEP	2026-09-27T10:51:17.9535070Z   + fmt                            12.1.0  h99e4e11_1          conda-forge         
OS (macos)	UNKNOWN STEP	2026-09-27T10:51:17.9535390Z   + frozendict                      2.4.7  pyh851646a_2        conda-forge         
OS (macos)	UNKNOWN STEP	2026-09-27T10:51:17.9535700Z   + h11                            0.16.0  pyhcf101f3_1        conda-forge         
OS (macos)	UNKNOWN STEP	2026-09-27T10:51:17.9536000Z   + h2                              4.4.1  pyhcf101f3_0        conda-forge         
OS (macos)	UNKNOWN STEP	2026-09-27T10:51:17.9536300Z   + hpack                           4.2.0  pyhd8ed1ab_0        conda-forge         
OS (macos)	UNKNOWN STEP	2026-09-27T10:51:17.9536670Z   + httpcore                        1.0.9  pyh29332c3_0        conda-forge         
OS (macos)	UNKNOWN STEP	2026-09-27T10:51:17.9537070Z   + httpx                          0.28.1  pyhd8ed1ab_0        conda-forge         
OS (macos)	UNKNOWN STEP	2026-09-27T10:51:17.9537450Z   + hyperframe                      6.1.0  pyhd8ed1ab_0        conda-forge         
OS (macos)	UNKNOWN STEP	2026-09-27T10:51:17.9537790Z   + icu                              78.3  py310h579977c_2     conda-forge         
OS (macos)	UNKNOWN STEP	2026-09-27T10:51:17.9538260Z   + idna                             3.19  pyhcf101f3_0        conda-forge         
OS (macos)	UNKNOWN STEP	2026-09-27T10:51:17.9538690Z   + importlib-metadata              9.0.1  pyhcf101f3_0        conda-forge         
OS (macos)	UNKNOWN STEP	2026-09-27T10:51:17.9546720Z   + jinja2                          3.1.6  pyhcf101f3_1        conda-forge         
OS (macos)	UNKNOWN STEP	2026-09-27T10:51:17.9547190Z   + krb5                           1.22.2  h34f8a20_2          conda-forge         
OS (macos)	UNKNOWN STEP	2026-09-27T10:51:17.9547590Z   + libarchive                      3.8.9  gpl_h76147b0_101    conda-forge         
OS (macos)	UNKNOWN STEP	2026-09-27T10:51:17.9547960Z   + libcurl                        8.22.0  h6651222_0          conda-forge         
OS (macos)	UNKNOWN STEP	2026-09-27T10:51:17.9548290Z   + libcxx                         23.1.1  h55c6f16_0          conda-forge         
OS (macos)	UNKNOWN STEP	2026-09-27T10:51:17.9548630Z   + libedit                  3.1.20250104  pl5321h26f1114_1    conda-forge         
OS (macos)	UNKNOWN STEP	2026-09-27T10:51:17.9549080Z   + libev                            4.33  h1a92334_3          conda-forge         
OS (macos)	UNKNOWN STEP	2026-09-27T10:51:17.9549440Z   + libexpat                        2.8.1  hf6b4638_1          conda-forge         
OS (macos)	UNKNOWN STEP	2026-09-27T10:51:17.9549770Z   + libffi                          3.7.0  h47dc5ef_1          conda-forge         
OS (macos)	UNKNOWN STEP	2026-09-27T10:51:17.9550100Z   + libiconv                         1.18  he4c29f2_3          conda-forge         
OS (macos)	UNKNOWN STEP	2026-09-27T10:51:17.9550600Z   + liblzma                         5.8.3  h8088a28_1          conda-forge         
OS (macos)	UNKNOWN STEP	2026-09-27T10:51:17.9550950Z   + libmamba                        2.9.0  py314h12d839b_0     conda-forge         
OS (macos)	UNKNOWN STEP	2026-09-27T10:51:17.9551310Z   + libmamba-spdlog                 2.9.0  h7215443_0          conda-forge         
OS (macos)	UNKNOWN STEP	2026-09-27T10:51:17.9551670Z   + libmambapy                      2.9.0  py314h53f8b30_0     conda-forge         
OS (macos)	UNKNOWN STEP	2026-09-27T10:51:17.9552000Z   + libmpdec                        4.0.0  h84a0fba_2          conda-forge         
OS (macos)	UNKNOWN STEP	2026-09-27T10:51:17.9552500Z   + libmsgpack-c                    6.1.0  h784d473_7          conda-forge         
OS (macos)	UNKNOWN STEP	2026-09-27T10:51:17.9552940Z   + libnghttp2                     1.68.1  h435687b_1          conda-forge         
OS (macos)	UNKNOWN STEP	2026-09-27T10:51:17.9553270Z   + libpsl                         0.23.1  hdb0c161_1          conda-forge         
OS (macos)	UNKNOWN STEP	2026-09-27T10:51:17.9553610Z   + libpython                      3.14.7  h4311e70_106_cp314  conda-forge         
OS (macos)	UNKNOWN STEP	2026-09-27T10:51:17.9553940Z   + libsolv                        0.7.39  h626c152_1          conda-forge         
OS (macos)	UNKNOWN STEP	2026-09-27T10:51:17.9554340Z   + libsqlite                      3.53.4  hca69786_1          conda-forge         
OS (macos)	UNKNOWN STEP	2026-09-27T10:51:17.9554760Z   + libssh2                        1.11.1  hbf2880b_1          conda-forge         
OS (macos)	UNKNOWN STEP	2026-09-27T10:51:17.9555080Z   + libxml2                        2.15.4  h550178d_0          conda-forge         
OS (macos)	UNKNOWN STEP	2026-09-27T10:51:17.9555420Z   + libxml2-16                     2.15.4  heb56d2d_0          conda-forge         
OS (macos)	UNKNOWN STEP	2026-09-27T10:51:17.9555760Z   + libzlib                         1.3.2  h8088a28_3          conda-forge         
OS (macos)	UNKNOWN STEP	2026-09-27T10:51:17.9556080Z   + lz4-c                          1.10.0  hdca3b7d_2          conda-forge         
OS (macos)	UNKNOWN STEP	2026-09-27T10:51:17.9556390Z   + lzo                              2.10  h74c22ad_1003       conda-forge         
OS (macos)	UNKNOWN STEP	2026-09-27T10:51:17.9556700Z   + mamba                           2.9.0  hfb6e983_0          conda-forge         
OS (macos)	UNKNOWN STEP	2026-09-27T10:51:17.9557040Z   + markupsafe                      3.0.3  py314h6e9b3f0_1     conda-forge         
OS (macos)	UNKNOWN STEP	2026-09-27T10:51:17.9557390Z   + menuinst                        2.5.2  py314h6ffbfce_2     conda-forge         
OS (macos)	UNKNOWN STEP	2026-09-27T10:51:17.9557730Z   + msgpack-python                  1.2.2  py314hb1acb19_2     conda-forge         
OS (macos)	UNKNOWN STEP	2026-09-27T10:51:17.9558080Z   + ncurses                           6.6  he64c551_1          conda-forge         
OS (macos)	UNKNOWN STEP	2026-09-27T10:51:17.9558430Z   + nlohmann_json-abi              3.12.0  h0f90c79_2          conda-forge         
OS (macos)	UNKNOWN STEP	2026-09-27T10:51:17.9558780Z   + openssl                         3.6.4  h55eecbc_0          conda-forge         
OS (macos)	UNKNOWN STEP	2026-09-27T10:51:17.9559120Z   + packaging                        26.3  pyhc364b38_0        conda-forge         
OS (macos)	UNKNOWN STEP	2026-09-27T10:51:17.9559440Z   + pip                            26.2.1  pyh145f28c_0        conda-forge         
OS (macos)	UNKNOWN STEP	2026-09-27T10:51:17.9559840Z   + platformdirs                   4.11.6  pyh5ded981_0        conda-forge         
OS (macos)	UNKNOWN STEP	2026-09-27T10:51:17.9560260Z   + pluggy                          1.6.0  pyhf9edf01_1        conda-forge         
OS (macos)	UNKNOWN STEP	2026-09-27T10:51:17.9561280Z   + py-rattler                     0.25.0  py310h2dd3e6a_5     conda-forge         
OS (macos)	UNKNOWN STEP	2026-09-27T10:51:17.9561650Z   + pybind11-abi                       11  hc364b38_1          conda-forge         
OS (macos)	UNKNOWN STEP	2026-09-27T10:51:17.9562000Z   + pycosat                         0.6.6  py314hcd3153d_5     conda-forge         
OS (macos)	UNKNOWN STEP	2026-09-27T10:51:17.9562330Z   + pydantic                       2.13.5  pyhcf101f3_0        conda-forge         
OS (macos)	UNKNOWN STEP	2026-09-27T10:51:17.9562690Z   + pydantic-core                  2.46.5  py314hc05cd11_1     conda-forge         
OS (macos)	UNKNOWN STEP	2026-09-27T10:51:17.9563050Z   + pyproject_hooks                 1.2.0  pyhd8ed1ab_1        conda-forge         
OS (macos)	UNKNOWN STEP	2026-09-27T10:51:17.9563410Z   + pysocks                         1.7.1  pyha55dd90_7        conda-forge         
OS (macos)	UNKNOWN STEP	2026-09-27T10:51:17.9563820Z   + python                         3.14.7  h0ae1c2c_106_cp314  conda-forge         
OS (macos)	UNKNOWN STEP	2026-09-27T10:51:17.9564370Z   + python-build                    1.6.0  pyhc364b38_0        conda-forge         
OS (macos)	UNKNOWN STEP	2026-09-27T10:51:17.9564730Z   + python-gil                     3.14.7  h4df99d1_106        conda-forge         
OS (macos)	UNKNOWN STEP	2026-09-27T10:51:17.9565200Z   + python-installer                1.0.1  pyh332efcf_0        conda-forge         
OS (macos)	UNKNOWN STEP	2026-09-27T10:51:17.9565630Z   + python_abi                       3.14  9_cp314             conda-forge         
OS (macos)	UNKNOWN STEP	2026-09-27T10:51:17.9565960Z   + readline                          8.3  h8b90a29_1          conda-forge         
OS (macos)	UNKNOWN STEP	2026-09-27T10:51:17.9566430Z   + reproc                   14.2.8.post0  hdca3b7d_0          conda-forge         
OS (macos)	UNKNOWN STEP	2026-09-27T10:51:17.9566820Z   + reproc-cpp               14.2.8.post0  h2fd3d4c_0          conda-forge         
OS (macos)	UNKNOWN STEP	2026-09-27T10:51:17.9567180Z   + requests                       2.34.2  pyhcf101f3_0        conda-forge         
OS (macos)	UNKNOWN STEP	2026-09-27T10:51:17.9567520Z   + ruamel.yaml                    0.19.1  pyhcf101f3_0        conda-forge         
OS (macos)	UNKNOWN STEP	2026-09-27T10:51:17.9567910Z   + ruamel.yaml.clib               0.2.15  py314hd98292b_5     conda-forge         
OS (macos)	UNKNOWN STEP	2026-09-27T10:51:17.9568280Z   + setuptools                     84.0.0  pyh332efcf_0        conda-forge         
OS (macos)	UNKNOWN STEP	2026-09-27T10:51:17.9568630Z   + simdjson                       4.6.11  hfbe1efa_0          conda-forge         
OS (macos)	UNKNOWN STEP	2026-09-27T10:51:17.9568980Z   + sniffio                         1.3.1  pyhd8ed1ab_2        conda-forge         
OS (macos)	UNKNOWN STEP	2026-09-27T10:51:17.9569310Z   + spdlog                         1.17.0  h760df91_2          conda-forge         
OS (macos)	UNKNOWN STEP	2026-09-27T10:51:17.9569650Z   + tk                             8.6.13  hbeba79b_4          conda-forge         
OS (macos)	UNKNOWN STEP	2026-09-27T10:51:17.9569980Z   + tomli                           2.4.1  pyhcf101f3_0        conda-forge         
OS (macos)	UNKNOWN STEP	2026-09-27T10:51:17.9570310Z   + tomli-w                         1.2.0  pyhd8ed1ab_0        conda-forge         
OS (macos)	UNKNOWN STEP	2026-09-27T10:51:17.9570630Z   + tqdm                           4.70.0  pyh8f84b5b_0        conda-forge         
OS (macos)	UNKNOWN STEP	2026-09-27T10:51:17.9570960Z   + truststore                     0.10.4  pyhcf101f3_0        conda-forge         
OS (macos)	UNKNOWN STEP	2026-09-27T10:51:17.9571320Z   + typing-extensions              4.16.0  h69aa097_0          conda-forge         
OS (macos)	UNKNOWN STEP	2026-09-27T10:51:17.9571700Z   + typing-inspection               0.4.4  pyhcf101f3_0        conda-forge         
OS (macos)	UNKNOWN STEP	2026-09-27T10:51:17.9572070Z   + typing_extensions              4.16.0  pyhcf101f3_0        conda-forge         
OS (macos)	UNKNOWN STEP	2026-09-27T10:51:17.9572420Z   + tzdata                          2026c  h151e31d_0          conda-forge         
OS (macos)	UNKNOWN STEP	2026-09-27T10:51:17.9572750Z   + unearth                        0.18.3  pyhd8ed1ab_0        conda-forge         
OS (macos)	UNKNOWN STEP	2026-09-27T10:51:17.9573080Z   + urllib3                         2.7.0  pyhd8ed1ab_0        conda-forge         
OS (macos)	UNKNOWN STEP	2026-09-27T10:51:17.9573410Z   + yaml-cpp                        0.8.0  h784d473_1          conda-forge         
OS (macos)	UNKNOWN STEP	2026-09-27T10:51:17.9573740Z   + zipp                            4.1.0  pyhcf101f3_0        conda-forge         
OS (macos)	UNKNOWN STEP	2026-09-27T10:51:17.9574050Z   + zstd                            1.5.7  hf451053_7          conda-forge         
OS (macos)	UNKNOWN STEP	2026-09-27T10:51:17.9574290Z 
OS (macos)	UNKNOWN STEP	2026-09-27T10:51:17.9574360Z   Summary:
OS (macos)	UNKNOWN STEP	2026-09-27T10:51:17.9574450Z 
OS (macos)	UNKNOWN STEP	2026-09-27T10:51:17.9574530Z   Install: 112 packages
OS (macos)	UNKNOWN STEP	2026-09-27T10:51:17.9574640Z 
OS (macos)	UNKNOWN STEP	2026-09-27T10:51:17.9574690Z   Total download: 0 B
OS (macos)	UNKNOWN STEP	2026-09-27T10:51:17.9574790Z 
OS (macos)	UNKNOWN STEP	2026-09-27T10:51:17.9575070Z ─────────────────────────────────────────────────────────────────────────────────────
OS (macos)	UNKNOWN STEP	2026-09-27T10:51:17.9575270Z 
OS (macos)	UNKNOWN STEP	2026-09-27T10:51:17.9575270Z 
OS (macos)	UNKNOWN STEP	2026-09-27T10:51:17.9593990Z ##[warning]warning  libmamba Security Warning: This transaction includes executing package scripts (pre/post-link/unlink) if present. These scripts can contain arbitrary code. Please ensure you trust the package sources.
OS (macos)	UNKNOWN STEP	
OS (macos)	UNKNOWN STEP	2026-09-27T10:51:17.9600500Z warning  libmamba Security Warning: This transaction includes executing package scripts (pre/post-link/unlink) if present. These scripts can contain arbitrary code. Please ensure you trust the package sources.
OS (macos)	UNKNOWN STEP	2026-09-27T10:51:17.9601110Z 
OS (macos)	UNKNOWN STEP	2026-09-27T10:51:17.9601400Z Transaction starting
OS (macos)	UNKNOWN STEP	2026-09-27T10:51:18.0567040Z Linking bzip2-1.0.8-h4e30115_10
OS (macos)	UNKNOWN STEP	2026-09-27T10:51:18.0623620Z Linking c-ares-1.34.8-h74c22ad_2
OS (macos)	UNKNOWN STEP	2026-09-27T10:51:18.1065650Z Linking ca-certificates-2026.7.22-hbd8a1cb_0
OS (macos)	UNKNOWN STEP	2026-09-27T10:51:18.1083750Z Linking icu-78.3-py310h579977c_2
OS (macos)	UNKNOWN STEP	2026-09-27T10:51:18.1670960Z Linking libcxx-23.1.1-h55c6f16_0
OS (macos)	UNKNOWN STEP	2026-09-27T10:51:18.1692350Z Linking libev-4.33-h1a92334_3
OS (macos)	UNKNOWN STEP	2026-09-27T10:51:18.1716220Z Linking libexpat-2.8.1-hf6b4638_1
OS (macos)	UNKNOWN STEP	2026-09-27T10:51:18.1756550Z Linking libffi-3.7.0-h47dc5ef_1
OS (macos)	UNKNOWN STEP	2026-09-27T10:51:18.1795380Z Linking libiconv-1.18-he4c29f2_3
OS (macos)	UNKNOWN STEP	2026-09-27T10:51:18.1832690Z Linking liblzma-5.8.3-h8088a28_1
OS (macos)	UNKNOWN STEP	2026-09-27T10:51:18.1848290Z Linking libmpdec-4.0.0-h84a0fba_2
OS (macos)	UNKNOWN STEP	2026-09-27T10:51:18.1865130Z Linking libzlib-1.3.2-h8088a28_3
OS (macos)	UNKNOWN STEP	2026-09-27T10:51:18.1881430Z Linking lzo-2.10-h74c22ad_1003
OS (macos)	UNKNOWN STEP	2026-09-27T10:51:18.1973330Z Linking ncurses-6.6-he64c551_1
OS (macos)	UNKNOWN STEP	2026-09-27T10:51:21.1196300Z Linking nlohmann_json-abi-3.12.0-h0f90c79_2
OS (macos)	UNKNOWN STEP	2026-09-27T10:51:21.1213460Z Linking pybind11-abi-11-hc364b38_1
OS (macos)	UNKNOWN STEP	2026-09-27T10:51:21.1236320Z Linking python_abi-3.14-9_cp314
OS (macos)	UNKNOWN STEP	2026-09-27T10:51:21.1250630Z Linking reproc-14.2.8.post0-hdca3b7d_0
OS (macos)	UNKNOWN STEP	2026-09-27T10:51:21.1325950Z Linking tzdata-2026c-h151e31d_0
OS (macos)	UNKNOWN STEP	2026-09-27T10:51:21.2750650Z Linking cpp-expected-1.3.1-h3feff0a_1
OS (macos)	UNKNOWN STEP	2026-09-27T10:51:21.2850940Z Linking fmt-12.1.0-h99e4e11_1
OS (macos)	UNKNOWN STEP	2026-09-27T10:51:21.2903070Z Linking libedit-3.1.20250104-pl5321h26f1114_1
OS (macos)	UNKNOWN STEP	2026-09-27T10:51:21.2910070Z Linking libmsgpack-c-6.1.0-h784d473_7
OS (macos)	UNKNOWN STEP	2026-09-27T10:51:21.2984870Z Linking libpsl-0.23.1-hdb0c161_1
OS (macos)	UNKNOWN STEP	2026-09-27T10:51:21.3011920Z Linking libpython-3.14.7-h4311e70_106_cp314
OS (macos)	UNKNOWN STEP	2026-09-27T10:51:21.3562200Z Linking libsolv-0.7.39-h626c152_1
OS (macos)	UNKNOWN STEP	2026-09-27T10:51:21.3714800Z Linking libsqlite-3.53.4-hca69786_1
OS (macos)	UNKNOWN STEP	2026-09-27T10:51:21.3744930Z Linking libxml2-16-2.15.4-heb56d2d_0
OS (macos)	UNKNOWN STEP	2026-09-27T10:51:21.3939620Z Linking lz4-c-1.10.0-hdca3b7d_2
OS (macos)	UNKNOWN STEP	2026-09-27T10:51:21.3992730Z Linking openssl-3.6.4-h55eecbc_0
OS (macos)	UNKNOWN STEP	2026-09-27T10:51:21.4672210Z Linking readline-8.3-h8b90a29_1
OS (macos)	UNKNOWN STEP	2026-09-27T10:51:21.4744030Z Linking reproc-cpp-14.2.8.post0-h2fd3d4c_0
OS (macos)	UNKNOWN STEP	2026-09-27T10:51:21.4804860Z Linking simdjson-4.6.11-hfbe1efa_0
OS (macos)	UNKNOWN STEP	2026-09-27T10:51:21.4848760Z Linking tk-8.6.13-hbeba79b_4
OS (macos)	UNKNOWN STEP	2026-09-27T10:51:21.6244960Z Linking yaml-cpp-0.8.0-h784d473_1
OS (macos)	UNKNOWN STEP	2026-09-27T10:51:21.6373570Z Linking zstd-1.5.7-hf451053_7
OS (macos)	UNKNOWN STEP	2026-09-27T10:51:21.6426860Z Linking krb5-1.22.2-h34f8a20_2
OS (macos)	UNKNOWN STEP	2026-09-27T10:51:21.8463880Z Linking libnghttp2-1.68.1-h435687b_1
OS (macos)	UNKNOWN STEP	2026-09-27T10:51:21.8564980Z Linking libssh2-1.11.1-hbf2880b_1
OS (macos)	UNKNOWN STEP	2026-09-27T10:51:21.9094960Z Linking libxml2-2.15.4-h550178d_0
OS (macos)	UNKNOWN STEP	2026-09-27T10:51:21.9497300Z Linking python-3.14.7-h0ae1c2c_106_cp314
OS (macos)	UNKNOWN STEP	2026-09-27T10:51:22.4765920Z Linking spdlog-1.17.0-h760df91_2
OS (macos)	UNKNOWN STEP	2026-09-27T10:51:22.4996380Z Linking libarchive-3.8.9-gpl_h76147b0_101
OS (macos)	UNKNOWN STEP	2026-09-27T10:51:22.5132600Z Linking libcurl-8.22.0-h6651222_0
OS (macos)	UNKNOWN STEP	2026-09-27T10:51:22.5314770Z Linking tomli-w-1.2.0-pyhd8ed1ab_0
OS (macos)	UNKNOWN STEP	2026-09-27T10:51:22.5378260Z Linking libmamba-2.9.0-py314h12d839b_0
OS (macos)	UNKNOWN STEP	2026-09-27T10:51:22.5798430Z Linking menuinst-2.5.2-py314h6ffbfce_2
OS (macos)	UNKNOWN STEP	2026-09-27T10:51:22.6004510Z Linking archspec-0.2.5-pyhd8ed1ab_0
OS (macos)	UNKNOWN STEP	2026-09-27T10:51:22.6219500Z Linking backports.zstd-1.7.0-py314h680f03e_1
OS (macos)	UNKNOWN STEP	2026-09-27T10:51:22.6234160Z Linking boltons-26.2.0-pyhd8ed1ab_0
OS (macos)	UNKNOWN STEP	2026-09-27T10:51:22.6340890Z Linking brotli-python-1.2.0-py314hee34562_4
OS (macos)	UNKNOWN STEP	2026-09-27T10:51:22.6384960Z Linking cached_property-2.0.1-pyhcf101f3_0
OS (macos)	UNKNOWN STEP	2026-09-27T10:51:22.6437000Z Linking certifi-2026.7.22-pyhd8ed1ab_0
OS (macos)	UNKNOWN STEP	2026-09-27T10:51:22.6488940Z Linking charset-normalizer-3.5.1-pyhd8ed1ab_0
OS (macos)	UNKNOWN STEP	2026-09-27T10:51:22.6569770Z Linking colorama-0.4.6-pyhd8ed1ab_1
OS (macos)	UNKNOWN STEP	2026-09-27T10:51:22.6633780Z Linking cpython-3.14.7-py314hd8ed1ab_106
OS (macos)	UNKNOWN STEP	2026-09-27T10:51:22.6648710Z Linking distro-1.9.0-pyhd8ed1ab_1
OS (macos)	UNKNOWN STEP	2026-09-27T10:51:22.6697010Z Linking frozendict-2.4.7-pyh851646a_2
OS (macos)	UNKNOWN STEP	2026-09-27T10:51:22.6821870Z Linking hpack-4.2.0-pyhd8ed1ab_0
OS (macos)	UNKNOWN STEP	2026-09-27T10:51:22.6885030Z Linking hyperframe-6.1.0-pyhd8ed1ab_0
OS (macos)	UNKNOWN STEP	2026-09-27T10:51:22.6931110Z Linking idna-3.19-pyhcf101f3_0
OS (macos)	UNKNOWN STEP	2026-09-27T10:51:22.7049520Z Linking libmamba-spdlog-2.9.0-h7215443_0
OS (macos)	UNKNOWN STEP	2026-09-27T10:51:22.7155380Z Linking mamba-2.9.0-hfb6e983_0
OS (macos)	UNKNOWN STEP	2026-09-27T10:51:22.7594240Z Linking markupsafe-3.0.3-py314h6e9b3f0_1
OS (macos)	UNKNOWN STEP	2026-09-27T10:51:22.7794760Z Linking msgpack-python-1.2.2-py314hb1acb19_2
OS (macos)	UNKNOWN STEP	2026-09-27T10:51:22.7895780Z Linking packaging-26.3-pyhc364b38_0
OS (macos)	UNKNOWN STEP	2026-09-27T10:51:22.7996080Z Linking pip-26.2.1-pyh145f28c_0
OS (macos)	UNKNOWN STEP	2026-09-27T10:51:22.9514020Z Linking platformdirs-4.11.6-pyh5ded981_0
OS (macos)	UNKNOWN STEP	2026-09-27T10:51:22.9594640Z Linking pluggy-1.6.0-pyhf9edf01_1
OS (macos)	UNKNOWN STEP	2026-09-27T10:51:22.9706610Z Linking pycosat-0.6.6-py314hcd3153d_5
OS (macos)	UNKNOWN STEP	2026-09-27T10:51:22.9808050Z Linking pysocks-1.7.1-pyha55dd90_7
OS (macos)	UNKNOWN STEP	2026-09-27T10:51:22.9913210Z Linking python-installer-1.0.1-pyh332efcf_0
OS (macos)	UNKNOWN STEP	2026-09-27T10:51:23.0250990Z Linking ruamel.yaml.clib-0.2.15-py314hd98292b_5
OS (macos)	UNKNOWN STEP	2026-09-27T10:51:23.0352600Z Linking setuptools-84.0.0-pyh332efcf_0
OS (macos)	UNKNOWN STEP	2026-09-27T10:51:23.1794290Z Linking sniffio-1.3.1-pyhd8ed1ab_2
OS (macos)	UNKNOWN STEP	2026-09-27T10:51:23.1896330Z Linking tomli-2.4.1-pyhcf101f3_0
OS (macos)	UNKNOWN STEP	2026-09-27T10:51:23.2004810Z Linking tqdm-4.70.0-pyh8f84b5b_0
OS (macos)	UNKNOWN STEP	2026-09-27T10:51:23.2226470Z Linking truststore-0.10.4-pyhcf101f3_0
OS (macos)	UNKNOWN STEP	2026-09-27T10:51:23.2331170Z Linking typing_extensions-4.16.0-pyhcf101f3_0
OS (macos)	UNKNOWN STEP	2026-09-27T10:51:23.2536790Z Linking zipp-4.1.0-pyhcf101f3_0
OS (macos)	UNKNOWN STEP	2026-09-27T10:51:23.2638160Z Linking anyio-4.15.1-pyh5ded981_1
OS (macos)	UNKNOWN STEP	2026-09-27T10:51:23.3370860Z Linking cached-property-2.0.1-pyhcf101f3_0
OS (macos)	UNKNOWN STEP	2026-09-27T10:51:23.3505170Z Linking conda-package-streaming-0.13.0-pyhd8ed1ab_0
OS (macos)	UNKNOWN STEP	2026-09-27T10:51:23.3625010Z Linking h11-0.16.0-pyhcf101f3_1
OS (macos)	UNKNOWN STEP	2026-09-27T10:51:23.3729360Z Linking h2-4.4.1-pyhcf101f3_0
OS (macos)	UNKNOWN STEP	2026-09-27T10:51:23.3866060Z Linking importlib-metadata-9.0.1-pyhcf101f3_0
OS (macos)	UNKNOWN STEP	2026-09-27T10:51:23.4011070Z Linking jinja2-3.1.6-pyhcf101f3_1
OS (macos)	UNKNOWN STEP	2026-09-27T10:51:23.4121540Z Linking libmambapy-2.9.0-py314h53f8b30_0
OS (macos)	UNKNOWN STEP	2026-09-27T10:51:23.4678110Z Linking pyproject_hooks-1.2.0-pyhd8ed1ab_1
OS (macos)	UNKNOWN STEP	2026-09-27T10:51:23.4731910Z Linking python-gil-3.14.7-h4df99d1_106
OS (macos)	UNKNOWN STEP	2026-09-27T10:51:23.4732250Z Linking ruamel.yaml-0.19.1-pyhcf101f3_0
OS (macos)	UNKNOWN STEP	2026-09-27T10:51:23.4831250Z Linking typing-extensions-4.16.0-h69aa097_0
OS (macos)	UNKNOWN STEP	2026-09-27T10:51:23.4935480Z Linking typing-inspection-0.4.4-pyhcf101f3_0
OS (macos)	UNKNOWN STEP	2026-09-27T10:51:23.5044930Z Linking _python_abi3_support-1.0-hd8ed1ab_3
OS (macos)	UNKNOWN STEP	2026-09-27T10:51:23.5145960Z Linking annotated-types-0.8.0-pyhd8ed1ab_0
OS (macos)	UNKNOWN STEP	2026-09-27T10:51:23.5252290Z Linking conda-libmamba-solver-26.7.0-pyhcf101f3_0
OS (macos)	UNKNOWN STEP	2026-09-27T10:51:23.5350880Z Linking httpcore-1.0.9-pyh29332c3_0
OS (macos)	UNKNOWN STEP	2026-09-27T10:51:23.5451810Z Linking pydantic-core-2.46.5-py314hc05cd11_1
OS (macos)	UNKNOWN STEP	2026-09-27T10:51:23.5570560Z Linking python-build-1.6.0-pyhc364b38_0
OS (macos)	UNKNOWN STEP	2026-09-27T10:51:23.5674240Z Linking urllib3-2.7.0-pyhd8ed1ab_0
OS (macos)	UNKNOWN STEP	2026-09-27T10:51:23.5775200Z Linking httpx-0.28.1-pyhd8ed1ab_0
OS (macos)	UNKNOWN STEP	2026-09-27T10:51:23.5883900Z Linking py-rattler-0.25.0-py310h2dd3e6a_5
OS (macos)	UNKNOWN STEP	2026-09-27T10:51:23.6188910Z Linking pydantic-2.13.5-pyhcf101f3_0
OS (macos)	UNKNOWN STEP	2026-09-27T10:51:23.6816920Z Linking requests-2.34.2-pyhcf101f3_0
OS (macos)	UNKNOWN STEP	2026-09-27T10:51:23.6899020Z Linking conda-package-handling-2.6.0-pyh5ded981_0
OS (macos)	UNKNOWN STEP	2026-09-27T10:51:23.7121720Z Linking unearth-0.18.3-pyhd8ed1ab_0
OS (macos)	UNKNOWN STEP	2026-09-27T10:51:23.7224230Z Linking conda-index-0.13.0-pyh5ded981_0
OS (macos)	UNKNOWN STEP	2026-09-27T10:51:23.8066060Z Linking conda-pypi-0.11.0-pyh5ded981_2
OS (macos)	UNKNOWN STEP	2026-09-27T10:51:23.8167570Z Linking conda-lockfiles-0.2.1-pyhd8ed1ab_0
OS (macos)	UNKNOWN STEP	2026-09-27T10:51:23.8268560Z Linking conda-rattler-solver-0.1.1-pyhcf101f3_0
OS (macos)	UNKNOWN STEP	2026-09-27T10:51:23.8706800Z Linking conda-self-0.2.1-pyhd8ed1ab_0
OS (macos)	UNKNOWN STEP	2026-09-27T10:51:23.8819500Z Linking conda-26.7.2-py314hcec6336_1
OS (macos)	UNKNOWN STEP	2026-09-27T10:51:24.1147920Z 
OS (macos)	UNKNOWN STEP	2026-09-27T10:51:24.1148320Z Transaction finished
OS (macos)	UNKNOWN STEP	2026-09-27T10:51:24.1150670Z 
OS (macos)	UNKNOWN STEP	2026-09-27T10:51:24.2614120Z 
OS (macos)	UNKNOWN STEP	2026-09-27T10:51:24.2630300Z Mamba was found in the `base` env
OS (macos)	UNKNOWN STEP	2026-09-27T10:51:24.2630960Z ##[endgroup]
OS (macos)	UNKNOWN STEP	2026-09-27T10:51:24.2631290Z ##[group]Setup environment variables...
OS (macos)	UNKNOWN STEP	2026-09-27T10:51:24.2631550Z Add "/Users/runner/miniconda3/condabin" to PATH
OS (macos)	UNKNOWN STEP	2026-09-27T10:51:24.2634400Z Set 'CONDA="/Users/runner/miniconda3"'
OS (macos)	UNKNOWN STEP	2026-09-27T10:51:24.2639130Z ##[endgroup]
OS (macos)	UNKNOWN STEP	2026-09-27T10:51:24.2639390Z ##[group]Parsing environment...
OS (macos)	UNKNOWN STEP	2026-09-27T10:51:24.2640020Z ##[endgroup]
OS (macos)	UNKNOWN STEP	2026-09-27T10:51:24.2640310Z ##[group]Writing conda configuration...
OS (macos)	UNKNOWN STEP	2026-09-27T10:51:24.2659440Z Read existing condarc from /Users/runner/.condarc as base config
OS (macos)	UNKNOWN STEP	2026-09-27T10:51:24.2659840Z Removing implicitly added 'defaults' channel
OS (macos)	UNKNOWN STEP	2026-09-27T10:51:24.2660120Z pkgs_dir: '/Users/runner/conda_pkgs_dir'
OS (macos)	UNKNOWN STEP	2026-09-27T10:51:24.2660370Z auto_activate_base: true
OS (macos)	UNKNOWN STEP	2026-09-27T10:51:24.2660560Z auto_update_conda: false
OS (macos)	UNKNOWN STEP	2026-09-27T10:51:24.2660760Z channel_priority: strict
OS (macos)	UNKNOWN STEP	2026-09-27T10:51:24.2660950Z solver: libmamba
OS (macos)	UNKNOWN STEP	2026-09-27T10:51:24.2661080Z always_yes: true
OS (macos)	UNKNOWN STEP	2026-09-27T10:51:24.2661260Z changeps1: false
OS (macos)	UNKNOWN STEP	2026-09-27T10:51:24.2676650Z Writing condarc to /Users/runner/.condarc:
OS (macos)	UNKNOWN STEP	2026-09-27T10:51:24.2677640Z notify_outdated_conda: false
OS (macos)	UNKNOWN STEP	2026-09-27T10:51:24.2677860Z channels: []
OS (macos)	UNKNOWN STEP	2026-09-27T10:51:24.2678140Z pkgs_dirs:
OS (macos)	UNKNOWN STEP	2026-09-27T10:51:24.2678370Z   - /Users/runner/conda_pkgs_dir
OS (macos)	UNKNOWN STEP	2026-09-27T10:51:24.2678620Z auto_activate_base: true
OS (macos)	UNKNOWN STEP	2026-09-27T10:51:24.2678860Z auto_update_conda: false
OS (macos)	UNKNOWN STEP	2026-09-27T10:51:24.2679190Z channel_priority: strict
OS (macos)	UNKNOWN STEP	2026-09-27T10:51:24.2679630Z solver: libmamba
OS (macos)	UNKNOWN STEP	2026-09-27T10:51:24.2687690Z always_yes: true
OS (macos)	UNKNOWN STEP	2026-09-27T10:51:24.2687970Z changeps1: false
OS (macos)	UNKNOWN STEP	2026-09-27T10:51:24.2688100Z 
OS (macos)	UNKNOWN STEP	2026-09-27T10:51:24.2688770Z ##[endgroup]
OS (macos)	UNKNOWN STEP	2026-09-27T10:51:24.2690230Z ##[group]Initializing conda shell integration...
OS (macos)	UNKNOWN STEP	2026-09-27T10:51:24.2690540Z Removing "/Users/runner/.bashrc"
OS (macos)	UNKNOWN STEP	2026-09-27T10:51:24.2690800Z Removing "/Users/runner/.bash_profile"
OS (macos)	UNKNOWN STEP	2026-09-27T10:51:24.2696260Z [command]/Users/runner/miniconda3/condabin/conda init --all
OS (macos)	UNKNOWN STEP	2026-09-27T10:51:25.6670820Z no change     /Users/runner/miniconda3/condabin/conda
OS (macos)	UNKNOWN STEP	2026-09-27T10:51:25.6671180Z no change     /Users/runner/miniconda3/bin/conda
OS (macos)	UNKNOWN STEP	2026-09-27T10:51:25.6671550Z no change     /Users/runner/miniconda3/bin/activate
OS (macos)	UNKNOWN STEP	2026-09-27T10:51:25.6671830Z no change     /Users/runner/miniconda3/bin/deactivate
OS (macos)	UNKNOWN STEP	2026-09-27T10:51:25.6672130Z no change     /Users/runner/miniconda3/etc/profile.d/conda.sh
OS (macos)	UNKNOWN STEP	2026-09-27T10:51:25.6672470Z no change     /Users/runner/miniconda3/etc/fish/conf.d/conda.fish
OS (macos)	UNKNOWN STEP	2026-09-27T10:51:25.6672810Z no change     /Users/runner/miniconda3/shell/condabin/Conda.psm1
OS (macos)	UNKNOWN STEP	2026-09-27T10:51:25.6673180Z modified      /Users/runner/miniconda3/shell/condabin/conda-hook.ps1
OS (macos)	UNKNOWN STEP	2026-09-27T10:51:25.6673620Z no change     /Users/runner/miniconda3/lib/python3.14/site-packages/xontrib/conda.xsh
OS (macos)	UNKNOWN STEP	2026-09-27T10:51:25.6674010Z no change     /Users/runner/miniconda3/etc/profile.d/conda.csh
OS (macos)	UNKNOWN STEP	2026-09-27T10:51:25.6674300Z modified      /Users/runner/.bash_profile
OS (macos)	UNKNOWN STEP	2026-09-27T10:51:25.6674510Z modified      /Users/runner/.zshrc
OS (macos)	UNKNOWN STEP	2026-09-27T10:51:25.6674730Z modified      /Users/runner/.config/fish/config.fish
OS (macos)	UNKNOWN STEP	2026-09-27T10:51:25.6674980Z modified      /Users/runner/.xonshrc
OS (macos)	UNKNOWN STEP	2026-09-27T10:51:25.6675180Z modified      /Users/runner/.tcshrc
OS (macos)	UNKNOWN STEP	2026-09-27T10:51:25.6675500Z modified      /Users/runner/.config/powershell/profile.ps1
OS (macos)	UNKNOWN STEP	2026-09-27T10:51:25.6675730Z 
OS (macos)	UNKNOWN STEP	2026-09-27T10:51:25.6675880Z ==> For changes to take effect, close and re-open your current shell. <==
OS (macos)	UNKNOWN STEP	2026-09-27T10:51:25.6676120Z 
OS (macos)	UNKNOWN STEP	2026-09-27T10:51:25.7584300Z Renaming "/Users/runner/.bash_profile" to "/Users/runner/.profile"
OS (macos)	UNKNOWN STEP	2026-09-27T10:51:25.7584990Z 
OS (macos)	UNKNOWN STEP	2026-09-27T10:51:25.7590170Z ##[endgroup]
OS (macos)	UNKNOWN STEP	2026-09-27T10:51:25.7592260Z ##[group]Adding tools to 'base' env...
OS (macos)	UNKNOWN STEP	2026-09-27T10:51:25.7593050Z Do we need to update conda?
OS (macos)	UNKNOWN STEP	2026-09-27T10:51:25.7593970Z Do we need to update mamba?
OS (macos)	UNKNOWN STEP	2026-09-27T10:51:25.7594580Z ... we will update mamba.
OS (macos)	UNKNOWN STEP	2026-09-27T10:51:25.7595210Z ... we will perform post-install steps after we update mamba.
OS (macos)	UNKNOWN STEP	2026-09-27T10:51:25.7595660Z Do we need to update python?
OS (macos)	UNKNOWN STEP	2026-09-27T10:51:25.7596090Z Do we need to update conda-build?
OS (macos)	UNKNOWN STEP	2026-09-27T10:51:25.7596490Z No tools were installed in 'base' env.
OS (macos)	UNKNOWN STEP	2026-09-27T10:51:25.7599000Z ##[endgroup]
OS (macos)	UNKNOWN STEP	2026-09-27T10:51:25.7599400Z ##[group]Ensuring environment...
OS (macos)	UNKNOWN STEP	2026-09-27T10:51:25.7599650Z Can we conda create (from explicit)?
OS (macos)	UNKNOWN STEP	2026-09-27T10:51:25.7599890Z Can we conda create (simple)?
OS (macos)	UNKNOWN STEP	2026-09-27T10:51:25.7600390Z ... will conda create (simple).
OS (macos)	UNKNOWN STEP	2026-09-27T10:51:25.7601930Z ##[group]Updating 'pypsa-earth' env from conda create (simple)...
OS (macos)	UNKNOWN STEP	2026-09-27T10:51:25.7609250Z [command]/Users/runner/miniconda3/condabin/mamba create --name pypsa-earth
OS (macos)	UNKNOWN STEP	2026-09-27T10:51:25.8444580Z Empty environment created at prefix: /Users/runner/miniconda3/envs/pypsa-earth
OS (macos)	UNKNOWN STEP	2026-09-27T10:51:25.8455010Z ##[endgroup]
OS (macos)	UNKNOWN STEP	2026-09-27T10:51:25.8455280Z ##[endgroup]
OS (macos)	UNKNOWN STEP	2026-09-27T10:51:25.8455620Z ##[group]Writing activation commands to shell profiles...
OS (macos)	UNKNOWN STEP	2026-09-27T10:51:25.8463950Z Append to "/Users/runner/.profile":
OS (macos)	UNKNOWN STEP	2026-09-27T10:51:25.8464170Z  
OS (macos)	UNKNOWN STEP	2026-09-27T10:51:25.8464570Z # ----------------------------------------------------------------------------
OS (macos)	UNKNOWN STEP	2026-09-27T10:51:25.8465490Z # Conda Setup Action: Basic configuration
OS (macos)	UNKNOWN STEP	2026-09-27T10:51:25.8465750Z set -eo pipefail
OS (macos)	UNKNOWN STEP	2026-09-27T10:51:25.8465940Z # Conda Setup Action: Custom activation
OS (macos)	UNKNOWN STEP	2026-09-27T10:51:25.8466310Z conda activate "pypsa-earth"
OS (macos)	UNKNOWN STEP	2026-09-27T10:51:25.8466670Z # ---------------------------------------------------------------------------- 
OS (macos)	UNKNOWN STEP	2026-09-27T10:51:25.8467020Z 
OS (macos)	UNKNOWN STEP	2026-09-27T10:51:25.8467130Z Append to "/Users/runner/.zshrc":
OS (macos)	UNKNOWN STEP	2026-09-27T10:51:25.8467390Z  
OS (macos)	UNKNOWN STEP	2026-09-27T10:51:25.8467700Z # ----------------------------------------------------------------------------
OS (macos)	UNKNOWN STEP	2026-09-27T10:51:25.8468180Z # Conda Setup Action: Basic configuration
OS (macos)	UNKNOWN STEP	2026-09-27T10:51:25.8468460Z set -eo pipefail
OS (macos)	UNKNOWN STEP	2026-09-27T10:51:25.8468620Z # Conda Setup Action: Custom activation
OS (macos)	UNKNOWN STEP	2026-09-27T10:51:25.8468830Z conda activate "pypsa-earth"
OS (macos)	UNKNOWN STEP	2026-09-27T10:51:25.8469210Z # ---------------------------------------------------------------------------- 
OS (macos)	UNKNOWN STEP	2026-09-27T10:51:25.8469450Z 
OS (macos)	UNKNOWN STEP	2026-09-27T10:51:25.8469640Z Append to "/Users/runner/.config/fish/config.fish":
OS (macos)	UNKNOWN STEP	2026-09-27T10:51:25.8470020Z  
OS (macos)	UNKNOWN STEP	2026-09-27T10:51:25.8470320Z # ----------------------------------------------------------------------------
OS (macos)	UNKNOWN STEP	2026-09-27T10:51:25.8470640Z # Conda Setup Action: Basic configuration
OS (macos)	UNKNOWN STEP	2026-09-27T10:51:25.8470840Z set -eo pipefail
OS (macos)	UNKNOWN STEP	2026-09-27T10:51:25.8471010Z # Conda Setup Action: Custom activation
OS (macos)	UNKNOWN STEP	2026-09-27T10:51:25.8471320Z conda activate "pypsa-earth"
OS (macos)	UNKNOWN STEP	2026-09-27T10:51:25.8471620Z # ---------------------------------------------------------------------------- 
OS (macos)	UNKNOWN STEP	2026-09-27T10:51:25.8471850Z 
OS (macos)	UNKNOWN STEP	2026-09-27T10:51:25.8471920Z Append to "/Users/runner/.tcshrc":
OS (macos)	UNKNOWN STEP	2026-09-27T10:51:25.8472150Z  
OS (macos)	UNKNOWN STEP	2026-09-27T10:51:25.8472520Z # ----------------------------------------------------------------------------
OS (macos)	UNKNOWN STEP	2026-09-27T10:51:25.8472830Z # Conda Setup Action: Basic configuration
OS (macos)	UNKNOWN STEP	2026-09-27T10:51:25.8473060Z set -eo pipefail
OS (macos)	UNKNOWN STEP	2026-09-27T10:51:25.8473220Z # Conda Setup Action: Custom activation
OS (macos)	UNKNOWN STEP	2026-09-27T10:51:25.8473460Z conda activate "pypsa-earth"
OS (macos)	UNKNOWN STEP	2026-09-27T10:51:25.8473740Z # ---------------------------------------------------------------------------- 
OS (macos)	UNKNOWN STEP	2026-09-27T10:51:25.8473980Z 
OS (macos)	UNKNOWN STEP	2026-09-27T10:51:25.8474070Z Append to "/Users/runner/.xonshrc":
OS (macos)	UNKNOWN STEP	2026-09-27T10:51:25.8474270Z  
OS (macos)	UNKNOWN STEP	2026-09-27T10:51:25.8474500Z # ----------------------------------------------------------------------------
OS (macos)	UNKNOWN STEP	2026-09-27T10:51:25.8474800Z # Conda Setup Action: Basic configuration
OS (macos)	UNKNOWN STEP	2026-09-27T10:51:25.8475060Z $RAISE_SUBPROC_ERROR = True
OS (macos)	UNKNOWN STEP	2026-09-27T10:51:25.8475250Z $XONSH_PIPEFAIL = True
OS (macos)	UNKNOWN STEP	2026-09-27T10:51:25.8475430Z # Conda Setup Action: Custom activation
OS (macos)	UNKNOWN STEP	2026-09-27T10:51:25.8475720Z conda activate "pypsa-earth"
OS (macos)	UNKNOWN STEP	2026-09-27T10:51:25.8476070Z # ---------------------------------------------------------------------------- 
OS (macos)	UNKNOWN STEP	2026-09-27T10:51:25.8476290Z 
OS (macos)	UNKNOWN STEP	2026-09-27T10:51:25.8476420Z Append to "/Users/runner/.config/powershell/profile.ps1":
OS (macos)	UNKNOWN STEP	2026-09-27T10:51:25.8476700Z  
OS (macos)	UNKNOWN STEP	2026-09-27T10:51:25.8476920Z # ----------------------------------------------------------------------------
OS (macos)	UNKNOWN STEP	2026-09-27T10:51:25.8477220Z # Conda Setup Action: Custom activation
OS (macos)	UNKNOWN STEP	2026-09-27T10:51:25.8477420Z conda activate "pypsa-earth"
OS (macos)	UNKNOWN STEP	2026-09-27T10:51:25.8477700Z # ---------------------------------------------------------------------------- 
OS (macos)	UNKNOWN STEP	2026-09-27T10:51:25.8477960Z 
OS (macos)	UNKNOWN STEP	2026-09-27T10:51:25.8478110Z Append to "/Users/runner/miniconda3/etc/profile.d/conda.sh":
OS (macos)	UNKNOWN STEP	2026-09-27T10:51:25.8478400Z  
OS (macos)	UNKNOWN STEP	2026-09-27T10:51:25.8478670Z # ----------------------------------------------------------------------------
OS (macos)	UNKNOWN STEP	2026-09-27T10:51:25.8479180Z # Conda Setup Action: Basic configuration
OS (macos)	UNKNOWN STEP	2026-09-27T10:51:25.8479410Z set -eo pipefail
OS (macos)	UNKNOWN STEP	2026-09-27T10:51:25.8479600Z # Conda Setup Action: Custom activation
OS (macos)	UNKNOWN STEP	2026-09-27T10:51:25.8479890Z conda activate "pypsa-earth"
OS (macos)	UNKNOWN STEP	2026-09-27T10:51:25.8480180Z # ---------------------------------------------------------------------------- 
OS (macos)	UNKNOWN STEP	2026-09-27T10:51:25.8480430Z 
OS (macos)	UNKNOWN STEP	2026-09-27T10:51:25.8480560Z Append to "/Users/runner/miniconda3/etc/fish/conf.d/conda.fish":
OS (macos)	UNKNOWN STEP	2026-09-27T10:51:25.8480860Z  
OS (macos)	UNKNOWN STEP	2026-09-27T10:51:25.8481070Z # ----------------------------------------------------------------------------
OS (macos)	UNKNOWN STEP	2026-09-27T10:51:25.8481630Z # Conda Setup Action: Basic configuration
OS (macos)	UNKNOWN STEP	2026-09-27T10:51:25.8481850Z set -eo pipefail
OS (macos)	UNKNOWN STEP	2026-09-27T10:51:25.8482010Z # Conda Setup Action: Custom activation
OS (macos)	UNKNOWN STEP	2026-09-27T10:51:25.8482230Z conda activate "pypsa-earth"
OS (macos)	UNKNOWN STEP	2026-09-27T10:51:25.8482500Z # ---------------------------------------------------------------------------- 
OS (macos)	UNKNOWN STEP	2026-09-27T10:51:25.8482720Z 
OS (macos)	UNKNOWN STEP	2026-09-27T10:51:25.8482920Z ##[endgroup]
OS (macos)	UNKNOWN STEP	2026-09-27T10:51:25.8483070Z setup-miniconda ran successfully
OS (macos)	UNKNOWN STEP	2026-09-27T10:51:26.0713500Z ##[group]Run actions/cache@v6
OS (macos)	UNKNOWN STEP	2026-09-27T10:51:26.0713900Z with:
OS (macos)	UNKNOWN STEP	2026-09-27T10:51:26.0714070Z   path: /Users/runner/miniconda3/envs
OS (macos)	UNKNOWN STEP	2026-09-27T10:51:26.0714420Z   key: conda-macOS-ARM64-da2a4d9916f9775a2a8804da995ca28f20102e9568f7ceee18297b7939fcea2f
OS (macos)	UNKNOWN STEP	2026-09-27T10:51:26.0714840Z   enableCrossOsArchive: false
OS (macos)	UNKNOWN STEP	2026-09-27T10:51:26.0715040Z   fail-on-cache-miss: false
OS (macos)	UNKNOWN STEP	2026-09-27T10:51:26.0715230Z   lookup-only: false
OS (macos)	UNKNOWN STEP	2026-09-27T10:51:26.0715390Z   save-always: false
OS (macos)	UNKNOWN STEP	2026-09-27T10:51:26.0715580Z env:
OS (macos)	UNKNOWN STEP	2026-09-27T10:51:26.0715730Z   BASE_ENV: envs/environment.yaml
OS (macos)	UNKNOWN STEP	2026-09-27T10:51:26.0715940Z   env_file: envs/osx-arm64.lock.yaml
OS (macos)	UNKNOWN STEP	2026-09-27T10:51:26.0716130Z   INPUT_RUN_POST: true
OS (macos)	UNKNOWN STEP	2026-09-27T10:51:26.0716340Z   CONDA: /Users/runner/miniconda3
OS (macos)	UNKNOWN STEP	2026-09-27T10:51:26.0716520Z ##[endgroup]
OS (macos)	UNKNOWN STEP	2026-09-27T10:51:26.2524540Z Cache not found for input keys: conda-macOS-ARM64-da2a4d9916f9775a2a8804da995ca28f20102e9568f7ceee18297b7939fcea2f
OS (macos)	UNKNOWN STEP	2026-09-27T10:51:26.2602890Z ##[group]Run conda env update -n pypsa-earth -f envs/osx-arm64.lock.yaml
OS (macos)	UNKNOWN STEP	2026-09-27T10:51:26.2603460Z ^[[36;1mconda env update -n pypsa-earth -f envs/osx-arm64.lock.yaml^[[0m
OS (macos)	UNKNOWN STEP	2026-09-27T10:51:26.2638760Z shell: /bin/bash -l {0}
OS (macos)	UNKNOWN STEP	2026-09-27T10:51:26.2638940Z env:
OS (macos)	UNKNOWN STEP	2026-09-27T10:51:26.2639090Z   BASE_ENV: envs/environment.yaml
OS (macos)	UNKNOWN STEP	2026-09-27T10:51:26.2639300Z   env_file: envs/osx-arm64.lock.yaml
OS (macos)	UNKNOWN STEP	2026-09-27T10:51:26.2639490Z   INPUT_RUN_POST: true
OS (macos)	UNKNOWN STEP	2026-09-27T10:51:26.2639720Z   CONDA: /Users/runner/miniconda3
OS (macos)	UNKNOWN STEP	2026-09-27T10:51:26.2639900Z ##[endgroup]
OS (macos)	UNKNOWN STEP	2026-09-27T10:51:27.6740300Z Retrieving notices: ...working... done
OS (macos)	UNKNOWN STEP	2026-09-27T10:51:27.7682500Z Channels:
OS (macos)	UNKNOWN STEP	2026-09-27T10:51:27.7682860Z  - conda-forge
OS (macos)	UNKNOWN STEP	2026-09-27T10:51:27.7683100Z  - bioconda
OS (macos)	UNKNOWN STEP	2026-09-27T10:51:27.7683300Z  - gurobi
OS (macos)	UNKNOWN STEP	2026-09-27T10:51:27.7683560Z Platform: osx-arm64
OS (macos)	UNKNOWN STEP	2026-09-27T10:51:32.1858540Z Collecting package metadata (repodata.json): ...working... done
OS (macos)	UNKNOWN STEP	2026-09-27T10:51:36.9380110Z Solving environment: ...working... done
OS (macos)	UNKNOWN STEP	2026-09-27T10:51:37.4040480Z 
OS (macos)	UNKNOWN STEP	2026-09-27T10:52:02.7353960Z Downloading and Extracting Packages: ...working... done
OS (macos)	UNKNOWN STEP	2026-09-27T10:52:04.3300030Z Preparing transaction: ...working... done
OS (macos)	UNKNOWN STEP	2026-09-27T10:52:13.2954050Z Verifying transaction: ...working... done
OS (macos)	UNKNOWN STEP	2026-09-27T10:53:06.7766070Z Executing transaction: ...working... 
OS (macos)	UNKNOWN STEP	2026-09-27T10:53:06.7766860Z 
OS (macos)	UNKNOWN STEP	2026-09-27T10:53:06.7767040Z 
OS (macos)	UNKNOWN STEP	2026-09-27T10:53:06.7767760Z done
OS (macos)	UNKNOWN STEP	2026-09-27T10:53:09.0257470Z Installing pip dependencies: ...working... Ran pip subprocess with arguments:
OS (macos)	UNKNOWN STEP	2026-09-27T10:53:09.0258870Z ['/Users/runner/miniconda3/envs/pypsa-earth/bin/python', '-m', 'pip', 'install', '-U', '-r', '/Users/runner/work/SGP-ESE5004-Stage2/SGP-ESE5004-Stage2/envs/condaenv.fb540rk4.requirements.txt', '--exists-action=b']
OS (macos)	UNKNOWN STEP	2026-09-27T10:53:09.0260150Z Pip subprocess output:
OS (macos)	UNKNOWN STEP	2026-09-27T10:53:09.0261150Z Collecting currencyconverter==0.18.9 (from -r /Users/runner/work/SGP-ESE5004-Stage2/SGP-ESE5004-Stage2/envs/condaenv.fb540rk4.requirements.txt (line 1))
OS (macos)	UNKNOWN STEP	2026-09-27T10:53:09.0262200Z   Downloading currencyconverter-0.18.9-py3-none-any.whl (628 kB)
OS (macos)	UNKNOWN STEP	2026-09-27T10:53:09.0264670Z      ━━━━━━━━━━━━━━━━━━━━━━━━━━━━━━━━━━━━━━━━ 628.1/628.1 kB 67.8 MB/s  0:00:00
OS (macos)	UNKNOWN STEP	2026-09-27T10:53:09.0265540Z Collecting googledrivedownloader==1.1.0 (from -r /Users/runner/work/SGP-ESE5004-Stage2/SGP-ESE5004-Stage2/envs/condaenv.fb540rk4.requirements.txt (line 2))
OS (macos)	UNKNOWN STEP	2026-09-27T10:53:09.0266540Z   Downloading googledrivedownloader-1.1.0-py3-none-any.whl (4.5 kB)
OS (macos)	UNKNOWN STEP	2026-09-27T10:53:09.0268340Z Requirement already satisfied: requests in /Users/runner/miniconda3/envs/pypsa-earth/lib/python3.11/site-packages (from googledrivedownloader==1.1.0->-r /Users/runner/work/SGP-ESE5004-Stage2/SGP-ESE5004-Stage2/envs/condaenv.fb540rk4.requirements.txt (line 2)) (2.32.4)
OS (macos)	UNKNOWN STEP	2026-09-27T10:53:09.0280380Z Requirement already satisfied: charset_normalizer<4,>=2 in /Users/runner/miniconda3/envs/pypsa-earth/lib/python3.11/site-packages (from requests->googledrivedownloader==1.1.0->-r /Users/runner/work/SGP-ESE5004-Stage2/SGP-ESE5004-Stage2/envs/condaenv.fb540rk4.requirements.txt (line 2)) (3.4.3)
OS (macos)	UNKNOWN STEP	2026-09-27T10:53:09.0282360Z Requirement already satisfied: idna<4,>=2.5 in /Users/runner/miniconda3/envs/pypsa-earth/lib/python3.11/site-packages (from requests->googledrivedownloader==1.1.0->-r /Users/runner/work/SGP-ESE5004-Stage2/SGP-ESE5004-Stage2/envs/condaenv.fb540rk4.requirements.txt (line 2)) (3.10)
OS (macos)	UNKNOWN STEP	2026-09-27T10:53:09.0284220Z Requirement already satisfied: urllib3<3,>=1.21.1 in /Users/runner/miniconda3/envs/pypsa-earth/lib/python3.11/site-packages (from requests->googledrivedownloader==1.1.0->-r /Users/runner/work/SGP-ESE5004-Stage2/SGP-ESE5004-Stage2/envs/condaenv.fb540rk4.requirements.txt (line 2)) (2.5.0)
OS (macos)	UNKNOWN STEP	2026-09-27T10:53:09.0286180Z Requirement already satisfied: certifi>=2017.4.17 in /Users/runner/miniconda3/envs/pypsa-earth/lib/python3.11/site-packages (from requests->googledrivedownloader==1.1.0->-r /Users/runner/work/SGP-ESE5004-Stage2/SGP-ESE5004-Stage2/envs/condaenv.fb540rk4.requirements.txt (line 2)) (2025.8.3)
OS (macos)	UNKNOWN STEP	2026-09-27T10:53:09.0287940Z Installing collected packages: currencyconverter, googledrivedownloader
OS (macos)	UNKNOWN STEP	2026-09-27T10:53:09.0288310Z 
OS (macos)	UNKNOWN STEP	2026-09-27T10:53:09.0288510Z Successfully installed currencyconverter-0.18.9 googledrivedownloader-1.1.0
OS (macos)	UNKNOWN STEP	2026-09-27T10:53:09.0288900Z 
OS (macos)	UNKNOWN STEP	2026-09-27T10:53:09.0289030Z done
OS (macos)	UNKNOWN STEP	2026-09-27T10:53:09.0289320Z #
OS (macos)	UNKNOWN STEP	2026-09-27T10:53:09.0289620Z # To activate this environment, use
OS (macos)	UNKNOWN STEP	2026-09-27T10:53:09.0289960Z #
OS (macos)	UNKNOWN STEP	2026-09-27T10:53:09.0290220Z #     $ conda activate pypsa-earth
OS (macos)	UNKNOWN STEP	2026-09-27T10:53:09.0290590Z #
OS (macos)	UNKNOWN STEP	2026-09-27T10:53:09.0290820Z # To deactivate an active environment, use
OS (macos)	UNKNOWN STEP	2026-09-27T10:53:09.0291240Z #
OS (macos)	UNKNOWN STEP	2026-09-27T10:53:09.0291460Z #     $ conda deactivate
OS (macos)	UNKNOWN STEP	2026-09-27T10:53:09.0291650Z 
OS (macos)	UNKNOWN STEP	2026-09-27T10:53:09.6335160Z ##[group]Run conda list
OS (macos)	UNKNOWN STEP	2026-09-27T10:53:09.6335630Z ^[[36;1mconda list^[[0m
OS (macos)	UNKNOWN STEP	2026-09-27T10:53:09.7354180Z shell: /bin/bash -l {0}
OS (macos)	UNKNOWN STEP	2026-09-27T10:53:09.7354500Z env:
OS (macos)	UNKNOWN STEP	2026-09-27T10:53:09.7354650Z   BASE_ENV: envs/environment.yaml
OS (macos)	UNKNOWN STEP	2026-09-27T10:53:09.7355010Z   env_file: envs/osx-arm64.lock.yaml
OS (macos)	UNKNOWN STEP	2026-09-27T10:53:09.7355210Z   INPUT_RUN_POST: true
OS (macos)	UNKNOWN STEP	2026-09-27T10:53:09.7355510Z   CONDA: /Users/runner/miniconda3
OS (macos)	UNKNOWN STEP	2026-09-27T10:53:09.7355770Z ##[endgroup]
OS (macos)	UNKNOWN STEP	2026-09-27T10:53:12.3614570Z # packages in environment at /Users/runner/miniconda3/envs/pypsa-earth:
OS (macos)	UNKNOWN STEP	2026-09-27T10:53:12.3678630Z #
OS (macos)	UNKNOWN STEP	2026-09-27T10:53:12.3780350Z # Name                              Version          Build                    Channel
OS (macos)	UNKNOWN STEP	2026-09-27T10:53:12.3881720Z _python_abi3_support                1.0              hd8ed1ab_2               conda-forge
OS (macos)	UNKNOWN STEP	2026-09-27T10:53:12.3956790Z adwaita-icon-theme                  48.1             unix_0                   conda-forge
OS (macos)	UNKNOWN STEP	2026-09-27T10:53:12.3964650Z affine                              2.4.0            pyhd8ed1ab_1             conda-forge
OS (macos)	UNKNOWN STEP	2026-09-27T10:53:12.4003340Z ampl-asl                            1.0.0            h286801f_2               conda-forge
OS (macos)	UNKNOWN STEP	2026-09-27T10:53:12.4008410Z amply                               0.1.6            pyhd8ed1ab_1             conda-forge
OS (macos)	UNKNOWN STEP	2026-09-27T10:53:12.4045030Z anyio                               4.10.0           pyhe01879c_0             conda-forge
OS (macos)	UNKNOWN STEP	2026-09-27T10:53:12.4051100Z appdirs                             1.4.4            pyhd8ed1ab_1             conda-forge
OS (macos)	UNKNOWN STEP	2026-09-27T10:53:12.4086190Z appnope                             0.1.4            pyhd8ed1ab_1             conda-forge
OS (macos)	UNKNOWN STEP	2026-09-27T10:53:12.4091480Z argon2-cffi                         25.1.0           pyhd8ed1ab_0             conda-forge
OS (macos)	UNKNOWN STEP	2026-09-27T10:53:12.4127780Z argon2-cffi-bindings                25.1.0           py311h3696347_0          conda-forge
OS (macos)	UNKNOWN STEP	2026-09-27T10:53:12.4133260Z arrow                               1.3.0            pyhd8ed1ab_1             conda-forge
OS (macos)	UNKNOWN STEP	2026-09-27T10:53:12.4169790Z asttokens                           3.0.0            pyhd8ed1ab_1             conda-forge
OS (macos)	UNKNOWN STEP	2026-09-27T10:53:12.4178180Z async-lru                           2.0.5            pyh29332c3_0             conda-forge
OS (macos)	UNKNOWN STEP	2026-09-27T10:53:12.4199550Z atk-1.0                             2.38.0           hd03087b_2               conda-forge
OS (macos)	UNKNOWN STEP	2026-09-27T10:53:12.4200750Z atlite                              0.4.1            pyhd8ed1ab_1             conda-forge
OS (macos)	UNKNOWN STEP	2026-09-27T10:53:12.4202950Z attrs                               25.3.0           pyh71513ae_0             conda-forge
OS (macos)	UNKNOWN STEP	2026-09-27T10:53:12.4203550Z aws-c-auth                          0.9.0            h9eee66f_19              conda-forge
OS (macos)	UNKNOWN STEP	2026-09-27T10:53:12.4204390Z aws-c-cal                           0.9.2            hd08b81e_1               conda-forge
OS (macos)	UNKNOWN STEP	2026-09-27T10:53:12.4205210Z aws-c-common                        0.12.4           h6caf38d_0               conda-forge
OS (macos)	UNKNOWN STEP	2026-09-27T10:53:12.4207070Z aws-c-compression                   0.3.1            habbe1e8_6               conda-forge
OS (macos)	UNKNOWN STEP	2026-09-27T10:53:12.4208320Z aws-c-event-stream                  0.5.5            hd1b68e1_3               conda-forge
OS (macos)	UNKNOWN STEP	2026-09-27T10:53:12.4209670Z aws-c-http                          0.10.4           h09a8a51_0               conda-forge
OS (macos)	UNKNOWN STEP	2026-09-27T10:53:12.4210260Z aws-c-io                            0.21.2           hc6344be_1               conda-forge
OS (macos)	UNKNOWN STEP	2026-09-27T10:53:12.4210770Z aws-c-mqtt                          0.13.3           h625c29d_3               conda-forge
OS (macos)	UNKNOWN STEP	2026-09-27T10:53:12.4215150Z aws-c-s3                            0.8.6            h6ded10d_2               conda-forge
OS (macos)	UNKNOWN STEP	2026-09-27T10:53:12.4217430Z aws-c-sdkutils                      0.2.4            habbe1e8_1               conda-forge
OS (macos)	UNKNOWN STEP	2026-09-27T10:53:12.4218740Z aws-checksums                       0.2.7            habbe1e8_2               conda-forge
OS (macos)	UNKNOWN STEP	2026-09-27T10:53:12.4222870Z aws-crt-cpp                         0.33.1           h54a40e1_2               conda-forge
OS (macos)	UNKNOWN STEP	2026-09-27T10:53:12.4226740Z aws-sdk-cpp                         1.11.606         ha924a42_1               conda-forge
OS (macos)	UNKNOWN STEP	2026-09-27T10:53:12.4228440Z azure-core-cpp                      1.16.0           ha1c5762_0               conda-forge
OS (macos)	UNKNOWN STEP	2026-09-27T10:53:12.4229390Z azure-identity-cpp                  1.12.0           hd83eed2_0               conda-forge
OS (macos)	UNKNOWN STEP	2026-09-27T10:53:12.4230510Z azure-storage-blobs-cpp             12.14.0          he094cc7_1               conda-forge
OS (macos)	UNKNOWN STEP	2026-09-27T10:53:12.4233100Z azure-storage-common-cpp            12.10.0          h12fd690_2               conda-forge
OS (macos)	UNKNOWN STEP	2026-09-27T10:53:12.4236370Z azure-storage-files-datalake-cpp    12.12.0          h30213e0_3               conda-forge
OS (macos)	UNKNOWN STEP	2026-09-27T10:53:12.4237560Z babel                               2.17.0           pyhd8ed1ab_0             conda-forge
OS (macos)	UNKNOWN STEP	2026-09-27T10:53:12.4238690Z beautifulsoup4                      4.13.4           pyha770c72_0             conda-forge
OS (macos)	UNKNOWN STEP	2026-09-27T10:53:12.4241680Z bleach                              6.2.0            pyh29332c3_4             conda-forge
OS (macos)	UNKNOWN STEP	2026-09-27T10:53:12.4242340Z bleach-with-css                     6.2.0            h82add2a_4               conda-forge
OS (macos)	UNKNOWN STEP	2026-09-27T10:53:12.4244200Z blosc                               1.21.6           h7dd00d9_1               conda-forge
OS (macos)	UNKNOWN STEP	2026-09-27T10:53:12.4244920Z bokeh                               3.7.3            pyhd8ed1ab_0             conda-forge
OS (macos)	UNKNOWN STEP	2026-09-27T10:53:12.4245680Z bottleneck                          1.5.0            py311h18599de_0          conda-forge
OS (macos)	UNKNOWN STEP	2026-09-27T10:53:12.4253400Z branca                              0.8.1            pyhd8ed1ab_0             conda-forge
OS (macos)	UNKNOWN STEP	2026-09-27T10:53:12.4254170Z brotli                              1.1.0            h5505292_3               conda-forge
OS (macos)	UNKNOWN STEP	2026-09-27T10:53:12.4255010Z brotli-bin                          1.1.0            h5505292_3               conda-forge
OS (macos)	UNKNOWN STEP	2026-09-27T10:53:12.4255670Z brotli-python                       1.1.0            py311h155a34a_3          conda-forge
OS (macos)	UNKNOWN STEP	2026-09-27T10:53:12.4257040Z brotlicffi                          1.1.0.0          py311h3f08180_2          conda-forge
OS (macos)	UNKNOWN STEP	2026-09-27T10:53:12.4258510Z bzip2                               1.0.8            h99b78c6_7               conda-forge
OS (macos)	UNKNOWN STEP	2026-09-27T10:53:12.4259730Z c-ares                              1.34.5           h5505292_0               conda-forge
OS (macos)	UNKNOWN STEP	2026-09-27T10:53:12.4260630Z c-blosc2                            2.20.0           h9c47b6e_0               conda-forge
OS (macos)	UNKNOWN STEP	2026-09-27T10:53:12.4261370Z ca-certificates                     2025.8.3         hbd8a1cb_0               conda-forge
OS (macos)	UNKNOWN STEP	2026-09-27T10:53:12.4263590Z cached-property                     1.5.2            hd8ed1ab_1               conda-forge
OS (macos)	UNKNOWN STEP	2026-09-27T10:53:12.4269340Z cached_property                     1.5.2            pyha770c72_1             conda-forge
OS (macos)	UNKNOWN STEP	2026-09-27T10:53:12.4276690Z cairo                               1.18.4           h6a3b0d2_0               conda-forge
OS (macos)	UNKNOWN STEP	2026-09-27T10:53:12.4318380Z cartopy                             0.25.0           py311hff7e5bb_0          conda-forge
OS (macos)	UNKNOWN STEP	2026-09-27T10:53:12.4324210Z cdsapi                              0.7.6            pyhd8ed1ab_0             conda-forge
OS (macos)	UNKNOWN STEP	2026-09-27T10:53:12.4358810Z certifi                             2025.8.3         pyhd8ed1ab_0             conda-forge
OS (macos)	UNKNOWN STEP	2026-09-27T10:53:12.4365110Z cffi                                1.17.1           py311h3a79f62_0          conda-forge
OS (macos)	UNKNOWN STEP	2026-09-27T10:53:12.4368410Z cfgrib                              0.9.15.0         pyhd8ed1ab_0             conda-forge
OS (macos)	UNKNOWN STEP	2026-09-27T10:53:12.4368980Z cfgv                                3.3.1            pyhd8ed1ab_1             conda-forge
OS (macos)	UNKNOWN STEP	2026-09-27T10:53:12.4374910Z cftime                              1.6.4            py311h0f07fe1_1          conda-forge
OS (macos)	UNKNOWN STEP	2026-09-27T10:53:12.4375470Z chaospy                             4.3.20           pyhd8ed1ab_0             conda-forge
OS (macos)	UNKNOWN STEP	2026-09-27T10:53:12.4376480Z charset-normalizer                  3.4.3            pyhd8ed1ab_0             conda-forge
OS (macos)	UNKNOWN STEP	2026-09-27T10:53:12.4378400Z click                               8.2.1            pyh707e725_0             conda-forge
OS (macos)	UNKNOWN STEP	2026-09-27T10:53:12.4379070Z click-plugins                       1.1.1.2          pyhd8ed1ab_0             conda-forge
OS (macos)	UNKNOWN STEP	2026-09-27T10:53:12.4379780Z cligj                               0.7.2            pyhd8ed1ab_2             conda-forge
OS (macos)	UNKNOWN STEP	2026-09-27T10:53:12.4380420Z cloudpickle                         3.1.1            pyhd8ed1ab_0             conda-forge
OS (macos)	UNKNOWN STEP	2026-09-27T10:53:12.4381000Z coin-or-cbc                         2.10.12          h0c75da4_4               conda-forge
OS (macos)	UNKNOWN STEP	2026-09-27T10:53:12.4385460Z coin-or-cgl                         0.60.9           h24d7dbf_6               conda-forge
OS (macos)	UNKNOWN STEP	2026-09-27T10:53:12.4386180Z coin-or-clp                         1.17.10          ha5fe85a_3               conda-forge
OS (macos)	UNKNOWN STEP	2026-09-27T10:53:12.4386700Z coin-or-osi                         0.108.11         h95bd113_7               conda-forge
OS (macos)	UNKNOWN STEP	2026-09-27T10:53:12.4387180Z coin-or-utils                       2.11.12          hedb6bc8_6               conda-forge
OS (macos)	UNKNOWN STEP	2026-09-27T10:53:12.4388290Z coincbc                             2.10.12          4_metapackage            conda-forge
OS (macos)	UNKNOWN STEP	2026-09-27T10:53:12.4389010Z colorama                            0.4.6            pyhd8ed1ab_1             conda-forge
OS (macos)	UNKNOWN STEP	2026-09-27T10:53:12.4398640Z colorcet                            3.1.0            pyhd8ed1ab_1             conda-forge
OS (macos)	UNKNOWN STEP	2026-09-27T10:53:12.4402650Z comm                                0.2.3            pyhe01879c_0             conda-forge
OS (macos)	UNKNOWN STEP	2026-09-27T10:53:12.4403220Z configargparse                      1.7.1            pyhe01879c_0             conda-forge
OS (macos)	UNKNOWN STEP	2026-09-27T10:53:12.4421320Z connection_pool                     0.0.3            pyhd3deb0d_0             conda-forge
OS (macos)	UNKNOWN STEP	2026-09-27T10:53:12.4422110Z contextily                          1.6.2            pyhd8ed1ab_1             conda-forge
OS (macos)	UNKNOWN STEP	2026-09-27T10:53:12.4422610Z contourpy                           1.3.3            py311h57a9ea7_1          conda-forge
OS (macos)	UNKNOWN STEP	2026-09-27T10:53:12.4431890Z country_converter                   1.3.1            pyhd8ed1ab_0             conda-forge
OS (macos)	UNKNOWN STEP	2026-09-27T10:53:12.4432690Z cppad                               20250000.2       h286801f_0               conda-forge
OS (macos)	UNKNOWN STEP	2026-09-27T10:53:12.4434150Z cpython                             3.11.13          py311hd8ed1ab_0          conda-forge
OS (macos)	UNKNOWN STEP	2026-09-27T10:53:12.4436950Z currencyconverter                   0.18.9           pypi_0                   pypi
OS (macos)	UNKNOWN STEP	2026-09-27T10:53:12.4440920Z cycler                              0.12.1           pyhd8ed1ab_1             conda-forge
OS (macos)	UNKNOWN STEP	2026-09-27T10:53:12.4446040Z cytoolz                             1.0.1            py311h917b07b_0          conda-forge
OS (macos)	UNKNOWN STEP	2026-09-27T10:53:12.4475330Z dask                                2025.7.0         pyhe01879c_0             conda-forge
OS (macos)	UNKNOWN STEP	2026-09-27T10:53:12.4476630Z dask-core                           2025.7.0         pyhe01879c_1             conda-forge
OS (macos)	UNKNOWN STEP	2026-09-27T10:53:12.4478930Z datashader                          0.18.2           pyhd8ed1ab_0             conda-forge
OS (macos)	UNKNOWN STEP	2026-09-27T10:53:12.4483720Z datrie                              0.8.2            py311h460d6c5_8          conda-forge
OS (macos)	UNKNOWN STEP	2026-09-27T10:53:12.4502410Z debugpy                             1.8.16           py311ha59bd64_0          conda-forge
OS (macos)	UNKNOWN STEP	2026-09-27T10:53:12.4520220Z decorator                           5.2.1            pyhd8ed1ab_0             conda-forge
OS (macos)	UNKNOWN STEP	2026-09-27T10:53:12.4524830Z defusedxml                          0.7.1            pyhd8ed1ab_0             conda-forge
OS (macos)	UNKNOWN STEP	2026-09-27T10:53:12.4562280Z deprecation                         2.1.0            pyh9f0ad1d_0             conda-forge
OS (macos)	UNKNOWN STEP	2026-09-27T10:53:12.4567660Z distlib                             0.4.0            pyhd8ed1ab_0             conda-forge
OS (macos)	UNKNOWN STEP	2026-09-27T10:53:12.4591180Z distributed                         2025.7.0         pyhe01879c_0             conda-forge
OS (macos)	UNKNOWN STEP	2026-09-27T10:53:12.4614900Z docutils                            0.22             pyhd8ed1ab_0             conda-forge
OS (macos)	UNKNOWN STEP	2026-09-27T10:53:12.4733950Z dpath                               2.2.0            pyha770c72_0             conda-forge
OS (macos)	UNKNOWN STEP	2026-09-27T10:53:12.4818540Z earth-osm                           2.3.post1        pyhd8ed1ab_0             conda-forge
OS (macos)	UNKNOWN STEP	2026-09-27T10:53:12.4828880Z eccodes                             2.42.0           h1332d56_0               conda-forge
OS (macos)	UNKNOWN STEP	2026-09-27T10:53:12.4829610Z ecmwf-datastores-client             0.4.0            pyhd8ed1ab_0             conda-forge
OS (macos)	UNKNOWN STEP	2026-09-27T10:53:12.4831510Z entsoe-py                           0.7.1            pyhd8ed1ab_0             conda-forge
OS (macos)	UNKNOWN STEP	2026-09-27T10:53:12.4832000Z epoxy                               1.5.10           h1c322ee_1               conda-forge
OS (macos)	UNKNOWN STEP	2026-09-27T10:53:12.4832460Z et_xmlfile                          2.0.0            pyhd8ed1ab_1             conda-forge
OS (macos)	UNKNOWN STEP	2026-09-27T10:53:12.4833090Z exceptiongroup                      1.3.0            pyhd8ed1ab_0             conda-forge
OS (macos)	UNKNOWN STEP	2026-09-27T10:53:12.4836820Z executing                           2.2.0            pyhd8ed1ab_0             conda-forge
OS (macos)	UNKNOWN STEP	2026-09-27T10:53:12.4853800Z fake-useragent                      2.2.0            py311h267d04e_0          conda-forge
OS (macos)	UNKNOWN STEP	2026-09-27T10:53:12.4859080Z filelock                            3.18.0           pyhd8ed1ab_0             conda-forge
OS (macos)	UNKNOWN STEP	2026-09-27T10:53:12.4893060Z findlibs                            0.1.2            pyhd8ed1ab_0             conda-forge
OS (macos)	UNKNOWN STEP	2026-09-27T10:53:12.4901720Z fiona                               1.10.1           py311h595b8b0_3          conda-forge
OS (macos)	UNKNOWN STEP	2026-09-27T10:53:12.4910160Z folium                              0.20.0           pyhd8ed1ab_0             conda-forge
OS (macos)	UNKNOWN STEP	2026-09-27T10:53:12.4936700Z font-ttf-dejavu-sans-mono           2.37             hab24e00_0               conda-forge
OS (macos)	UNKNOWN STEP	2026-09-27T10:53:12.4938680Z font-ttf-inconsolata                3.000            h77eed37_0               conda-forge
OS (macos)	UNKNOWN STEP	2026-09-27T10:53:12.4944020Z font-ttf-source-code-pro            2.038            h77eed37_0               conda-forge
OS (macos)	UNKNOWN STEP	2026-09-27T10:53:12.4982000Z font-ttf-ubuntu                     0.83             h77eed37_3               conda-forge
OS (macos)	UNKNOWN STEP	2026-09-27T10:53:12.4989670Z fontconfig                          2.15.0           h1383a14_1               conda-forge
OS (macos)	UNKNOWN STEP	2026-09-27T10:53:12.4997210Z fonts-conda-ecosystem               1                0                        conda-forge
OS (macos)	UNKNOWN STEP	2026-09-27T10:53:12.5000380Z fonts-conda-forge                   1                0                        conda-forge
OS (macos)	UNKNOWN STEP	2026-09-27T10:53:12.5000950Z fonttools                           4.59.0           py311h2fe624c_0          conda-forge
OS (macos)	UNKNOWN STEP	2026-09-27T10:53:12.5065820Z fqdn                                1.5.1            pyhd8ed1ab_1             conda-forge
OS (macos)	UNKNOWN STEP	2026-09-27T10:53:12.5120900Z freetype                            2.13.3           hce30654_1               conda-forge
OS (macos)	UNKNOWN STEP	2026-09-27T10:53:12.5198150Z freexl                              2.0.0            h3ab3353_2               conda-forge
OS (macos)	UNKNOWN STEP	2026-09-27T10:53:12.5269670Z fribidi                             1.0.10           h27ca646_0               conda-forge
OS (macos)	UNKNOWN STEP	2026-09-27T10:53:12.5271410Z fsspec                              2025.7.0         pyhd8ed1ab_0             conda-forge
OS (macos)	UNKNOWN STEP	2026-09-27T10:53:12.5272510Z future                              1.0.0            pyhd8ed1ab_2             conda-forge
OS (macos)	UNKNOWN STEP	2026-09-27T10:53:12.5341370Z gdk-pixbuf                          2.42.12          h7af3d76_3               conda-forge
OS (macos)	UNKNOWN STEP	2026-09-27T10:53:12.5346470Z geographiclib                       2.0              pyhd8ed1ab_1             conda-forge
OS (macos)	UNKNOWN STEP	2026-09-27T10:53:12.5397710Z geopandas                           1.1.1            pyhd8ed1ab_0             conda-forge
OS (macos)	UNKNOWN STEP	2026-09-27T10:53:12.5407450Z geopandas-base                      1.1.1            pyha770c72_0             conda-forge
OS (macos)	UNKNOWN STEP	2026-09-27T10:53:12.5418820Z geopy                               2.4.1            pyhd8ed1ab_2             conda-forge
OS (macos)	UNKNOWN STEP	2026-09-27T10:53:12.5421690Z geos                                3.13.1           hc9a1286_0               conda-forge
OS (macos)	UNKNOWN STEP	2026-09-27T10:53:12.5472840Z geotiff                             1.7.4            h1d7e6e1_2               conda-forge
OS (macos)	UNKNOWN STEP	2026-09-27T10:53:12.5480020Z geoviews                            1.14.0           hd8ed1ab_0               conda-forge
OS (macos)	UNKNOWN STEP	2026-09-27T10:53:12.5541110Z geoviews-core                       1.14.0           pyha770c72_0             conda-forge
OS (macos)	UNKNOWN STEP	2026-09-27T10:53:12.5562150Z gflags                              2.2.2            hf9b8971_1005            conda-forge
OS (macos)	UNKNOWN STEP	2026-09-27T10:53:12.5573080Z giflib                              5.2.2            h93a5062_0               conda-forge
OS (macos)	UNKNOWN STEP	2026-09-27T10:53:12.5685150Z gitdb                               4.0.12           pyhd8ed1ab_0             conda-forge
OS (macos)	UNKNOWN STEP	2026-09-27T10:53:12.5786770Z gitpython                           3.1.45           pyhff2d567_0             conda-forge
OS (macos)	UNKNOWN STEP	2026-09-27T10:53:12.5820340Z glib-tools                          2.84.3           h857b2e6_0               conda-forge
OS (macos)	UNKNOWN STEP	2026-09-27T10:53:12.5820830Z glog                                0.7.1            heb240a5_0               conda-forge
OS (macos)	UNKNOWN STEP	2026-09-27T10:53:12.5838690Z glpk                                5.0              h6d7a090_0               conda-forge
OS (macos)	UNKNOWN STEP	2026-09-27T10:53:12.5839350Z gmp                                 6.3.0            h7bae524_2               conda-forge
OS (macos)	UNKNOWN STEP	2026-09-27T10:53:12.5840300Z googledrivedownloader               1.1.0            pypi_0                   pypi
OS (macos)	UNKNOWN STEP	2026-09-27T10:53:12.5840780Z graphite2                           1.3.14           hec049ff_2               conda-forge
OS (macos)	UNKNOWN STEP	2026-09-27T10:53:12.5842100Z graphviz                            13.1.2           hcd33d8b_0               conda-forge
OS (macos)	UNKNOWN STEP	2026-09-27T10:53:12.5846060Z gtk3                                3.24.43          h07173f4_5               conda-forge
OS (macos)	UNKNOWN STEP	2026-09-27T10:53:12.5846510Z gts                                 0.7.6            he42f4ea_4               conda-forge
OS (macos)	UNKNOWN STEP	2026-09-27T10:53:12.5846960Z gurobi                              12.0.3           py311_0                  gurobi
OS (macos)	UNKNOWN STEP	2026-09-27T10:53:12.5848540Z h11                                 0.16.0           pyhd8ed1ab_0             conda-forge
OS (macos)	UNKNOWN STEP	2026-09-27T10:53:12.5850000Z h2                                  4.2.0            pyhd8ed1ab_0             conda-forge
OS (macos)	UNKNOWN STEP	2026-09-27T10:53:12.5851860Z h5netcdf                            1.6.4            pyhd8ed1ab_0             conda-forge
OS (macos)	UNKNOWN STEP	2026-09-27T10:53:12.5855600Z h5py                                3.14.0           nompi_py311h8470beb_100  conda-forge
OS (macos)	UNKNOWN STEP	2026-09-27T10:53:12.5856110Z harfbuzz                            11.4.1           hf4e55d4_0               conda-forge
OS (macos)	UNKNOWN STEP	2026-09-27T10:53:12.5857380Z hdf4                                4.2.15           h2ee6834_7               conda-forge
OS (macos)	UNKNOWN STEP	2026-09-27T10:53:12.5857840Z hdf5                                1.14.6           nompi_he65715a_103       conda-forge
OS (macos)	UNKNOWN STEP	2026-09-27T10:53:12.5858310Z hicolor-icon-theme                  0.17             hce30654_2               conda-forge
OS (macos)	UNKNOWN STEP	2026-09-27T10:53:12.5859210Z highspy                             1.11.0           np20py311h2585e16_0      conda-forge
OS (macos)	UNKNOWN STEP	2026-09-27T10:53:12.5860200Z holoviews                           1.21.0           pyhd8ed1ab_0             conda-forge
OS (macos)	UNKNOWN STEP	2026-09-27T10:53:12.5860710Z hpack                               4.1.0            pyhd8ed1ab_0             conda-forge
OS (macos)	UNKNOWN STEP	2026-09-27T10:53:12.5861170Z httpcore                            1.0.9            pyh29332c3_0             conda-forge
OS (macos)	UNKNOWN STEP	2026-09-27T10:53:12.5863440Z httpx                               0.28.1           pyhd8ed1ab_0             conda-forge
OS (macos)	UNKNOWN STEP	2026-09-27T10:53:12.5864200Z humanfriendly                       10.0             pyh707e725_8             conda-forge
OS (macos)	UNKNOWN STEP	2026-09-27T10:53:12.5880190Z hvplot                              0.12.0           pyhd8ed1ab_0             conda-forge
OS (macos)	UNKNOWN STEP	2026-09-27T10:53:12.5891810Z hyperframe                          6.1.0            pyhd8ed1ab_0             conda-forge
OS (macos)	UNKNOWN STEP	2026-09-27T10:53:12.5901030Z icu                                 75.1             hfee45f7_0               conda-forge
OS (macos)	UNKNOWN STEP	2026-09-27T10:53:12.5901460Z identify                            2.6.13           pyhd8ed1ab_0             conda-forge
OS (macos)	UNKNOWN STEP	2026-09-27T10:53:12.5902180Z idna                                3.10             pyhd8ed1ab_1             conda-forge
OS (macos)	UNKNOWN STEP	2026-09-27T10:53:12.5903850Z importlib-metadata                  8.7.0            pyhe01879c_1             conda-forge
OS (macos)	UNKNOWN STEP	2026-09-27T10:53:12.5909780Z importlib_metadata                  8.7.0            h40b2b14_1               conda-forge
OS (macos)	UNKNOWN STEP	2026-09-27T10:53:12.5910970Z inflate64                           1.0.3            py311h917b07b_0          conda-forge
OS (macos)	UNKNOWN STEP	2026-09-27T10:53:12.5912370Z iniconfig                           2.0.0            pyhd8ed1ab_1             conda-forge
OS (macos)	UNKNOWN STEP	2026-09-27T10:53:12.5912990Z ipopt                               3.14.19          h1dd5f02_0               conda-forge
OS (macos)	UNKNOWN STEP	2026-09-27T10:53:12.5913480Z ipykernel                           6.30.1           pyh92f572d_0             conda-forge
OS (macos)	UNKNOWN STEP	2026-09-27T10:53:12.5915320Z ipython                             9.4.0            pyhfa0c392_0             conda-forge
OS (macos)	UNKNOWN STEP	2026-09-27T10:53:12.5920820Z ipython_pygments_lexers             1.1.1            pyhd8ed1ab_0             conda-forge
OS (macos)	UNKNOWN STEP	2026-09-27T10:53:12.5922550Z isoduration                         20.11.0          pyhd8ed1ab_1             conda-forge
OS (macos)	UNKNOWN STEP	2026-09-27T10:53:12.5923020Z jasper                              4.2.8            hc0e5025_0               conda-forge
OS (macos)	UNKNOWN STEP	2026-09-27T10:53:12.5923650Z jedi                                0.19.2           pyhd8ed1ab_1             conda-forge
OS (macos)	UNKNOWN STEP	2026-09-27T10:53:12.5924090Z jinja2                              3.1.6            pyhd8ed1ab_0             conda-forge
OS (macos)	UNKNOWN STEP	2026-09-27T10:53:12.5925090Z joblib                              1.5.1            pyhd8ed1ab_0             conda-forge
OS (macos)	UNKNOWN STEP	2026-09-27T10:53:12.5925710Z json-c                              0.18             he4178ee_0               conda-forge
OS (macos)	UNKNOWN STEP	2026-09-27T10:53:12.5926210Z json5                               0.12.1           pyhd8ed1ab_0             conda-forge
OS (macos)	UNKNOWN STEP	2026-09-27T10:53:12.5926630Z jsonpointer                         3.0.0            py311h267d04e_1          conda-forge
OS (macos)	UNKNOWN STEP	2026-09-27T10:53:12.5930290Z jsonschema                          4.25.0           pyhe01879c_0             conda-forge
OS (macos)	UNKNOWN STEP	2026-09-27T10:53:12.5933980Z jsonschema-specifications           2025.4.1         pyh29332c3_0             conda-forge
OS (macos)	UNKNOWN STEP	2026-09-27T10:53:12.5934620Z jsonschema-with-format-nongpl       4.25.0           he01879c_0               conda-forge
OS (macos)	UNKNOWN STEP	2026-09-27T10:53:12.5935110Z jupyter-lsp                         2.2.6            pyhe01879c_0             conda-forge
OS (macos)	UNKNOWN STEP	2026-09-27T10:53:12.5935570Z jupyter_client                      8.6.3            pyhd8ed1ab_1             conda-forge
OS (macos)	UNKNOWN STEP	2026-09-27T10:53:12.5937040Z jupyter_core                        5.8.1            pyh31011fe_0             conda-forge
OS (macos)	UNKNOWN STEP	2026-09-27T10:53:12.5942170Z jupyter_events                      0.12.0           pyh29332c3_0             conda-forge
OS (macos)	UNKNOWN STEP	2026-09-27T10:53:12.5944130Z jupyter_server                      2.16.0           pyhe01879c_0             conda-forge
OS (macos)	UNKNOWN STEP	2026-09-27T10:53:12.5945420Z jupyter_server_terminals            0.5.3            pyhd8ed1ab_1             conda-forge
OS (macos)	UNKNOWN STEP	2026-09-27T10:53:12.5946220Z jupyterlab                          4.4.5            pyhd8ed1ab_0             conda-forge
OS (macos)	UNKNOWN STEP	2026-09-27T10:53:12.5946680Z jupyterlab_pygments                 0.3.0            pyhd8ed1ab_2             conda-forge
OS (macos)	UNKNOWN STEP	2026-09-27T10:53:12.5947600Z jupyterlab_server                   2.27.3           pyhd8ed1ab_1             conda-forge
OS (macos)	UNKNOWN STEP	2026-09-27T10:53:12.5948500Z kiwisolver                          1.4.9            py311h63e5c0c_0          conda-forge
OS (macos)	UNKNOWN STEP	2026-09-27T10:53:12.5948910Z krb5                                1.21.3           h237132a_0               conda-forge
OS (macos)	UNKNOWN STEP	2026-09-27T10:53:12.5949350Z lark                                1.2.2            pyhd8ed1ab_1             conda-forge
OS (macos)	UNKNOWN STEP	2026-09-27T10:53:12.5953140Z lcms2                               2.17             h7eeda09_0               conda-forge
OS (macos)	UNKNOWN STEP	2026-09-27T10:53:12.5953690Z lerc                                4.0.0            hd64df32_1               conda-forge
OS (macos)	UNKNOWN STEP	2026-09-27T10:53:12.5954100Z libabseil                           20250512.1       cxx17_hd41c47c_0         conda-forge
OS (macos)	UNKNOWN STEP	2026-09-27T10:53:12.5955700Z libaec                              1.1.4            h51d1e36_0               conda-forge
OS (macos)	UNKNOWN STEP	2026-09-27T10:53:12.5956280Z libarchive                          3.8.1            gpl_h46e8061_100         conda-forge
OS (macos)	UNKNOWN STEP	2026-09-27T10:53:12.5956710Z libarrow                            21.0.0           h20b3f57_1_cpu           conda-forge
OS (macos)	UNKNOWN STEP	2026-09-27T10:53:12.5957140Z libarrow-acero                      21.0.0           h926bc74_1_cpu           conda-forge
OS (macos)	UNKNOWN STEP	2026-09-27T10:53:12.5958990Z libarrow-compute                    21.0.0           hd5cd9ca_1_cpu           conda-forge
OS (macos)	UNKNOWN STEP	2026-09-27T10:53:12.5959510Z libarrow-dataset                    21.0.0           h926bc74_1_cpu           conda-forge
OS (macos)	UNKNOWN STEP	2026-09-27T10:53:12.5960190Z libarrow-substrait                  21.0.0           hb375905_1_cpu           conda-forge
OS (macos)	UNKNOWN STEP	2026-09-27T10:53:12.5965270Z libblas                             3.9.0            34_h10e41b3_openblas     conda-forge
OS (macos)	UNKNOWN STEP	2026-09-27T10:53:12.5967330Z libbrotlicommon                     1.1.0            h5505292_3               conda-forge
OS (macos)	UNKNOWN STEP	2026-09-27T10:53:12.5967920Z libbrotlidec                        1.1.0            h5505292_3               conda-forge
OS (macos)	UNKNOWN STEP	2026-09-27T10:53:12.5968350Z libbrotlienc                        1.1.0            h5505292_3               conda-forge
OS (macos)	UNKNOWN STEP	2026-09-27T10:53:12.5969200Z libcblas                            3.9.0            34_hb3479ef_openblas     conda-forge
OS (macos)	UNKNOWN STEP	2026-09-27T10:53:12.5969800Z libcrc32c                           1.1.2            hbdafb3b_0               conda-forge
OS (macos)	UNKNOWN STEP	2026-09-27T10:53:12.5970240Z libcurl                             8.14.1           h73640d1_0               conda-forge
OS (macos)	UNKNOWN STEP	2026-09-27T10:53:12.5970740Z libcxx                              20.1.8           hf598326_1               conda-forge
OS (macos)	UNKNOWN STEP	2026-09-27T10:53:12.5971580Z libdeflate                          1.24             h5773f1b_0               conda-forge
OS (macos)	UNKNOWN STEP	2026-09-27T10:53:12.5972110Z libedit                             3.1.20250104     pl5321hafb1f1b_0         conda-forge
OS (macos)	UNKNOWN STEP	2026-09-27T10:53:12.5973520Z libev                               4.33             h93a5062_2               conda-forge
OS (macos)	UNKNOWN STEP	2026-09-27T10:53:12.5974200Z libevent                            2.1.12           h2757513_1               conda-forge
OS (macos)	UNKNOWN STEP	2026-09-27T10:53:12.5974610Z libexpat                            2.7.1            hec049ff_0               conda-forge
OS (macos)	UNKNOWN STEP	2026-09-27T10:53:12.5975020Z libffi                              3.4.6            h1da3d7d_1               conda-forge
OS (macos)	UNKNOWN STEP	2026-09-27T10:53:12.5977900Z libfreetype                         2.13.3           hce30654_1               conda-forge
OS (macos)	UNKNOWN STEP	2026-09-27T10:53:12.5978370Z libfreetype6                        2.13.3           h1d14073_1               conda-forge
OS (macos)	UNKNOWN STEP	2026-09-27T10:53:12.5978770Z libgd                               2.3.3            hb2c3a21_11              conda-forge
OS (macos)	UNKNOWN STEP	2026-09-27T10:53:12.5979820Z libgdal-core                        3.10.3           hef24e92_12              conda-forge
OS (macos)	UNKNOWN STEP	2026-09-27T10:53:12.5980320Z libgdal-hdf4                        3.10.3           h81a176f_12              conda-forge
OS (macos)	UNKNOWN STEP	2026-09-27T10:53:12.5980760Z libgdal-hdf5                        3.10.3           hfba33d5_12              conda-forge
OS (macos)	UNKNOWN STEP	2026-09-27T10:53:12.5982250Z libgdal-netcdf                      3.10.3           heaf6e9b_12              conda-forge
OS (macos)	UNKNOWN STEP	2026-09-27T10:53:12.5983960Z libgfortran                         15.1.0           hfdf1602_0               conda-forge
OS (macos)	UNKNOWN STEP	2026-09-27T10:53:12.5987910Z libgfortran5                        15.1.0           hb74de2c_0               conda-forge
OS (macos)	UNKNOWN STEP	2026-09-27T10:53:12.5989770Z libglib                             2.84.3           h587fa63_0               conda-forge
OS (macos)	UNKNOWN STEP	2026-09-27T10:53:12.5992200Z libgoogle-cloud                     2.39.0           head0a95_0               conda-forge
OS (macos)	UNKNOWN STEP	2026-09-27T10:53:12.5993630Z libgoogle-cloud-storage             2.39.0           hfa3a374_0               conda-forge
OS (macos)	UNKNOWN STEP	2026-09-27T10:53:12.5994080Z libgrpc                             1.73.1           hcdac78c_0               conda-forge
OS (macos)	UNKNOWN STEP	2026-09-27T10:53:12.5994510Z libhwloc                            2.12.1           default_h88f92a7_1000    conda-forge
OS (macos)	UNKNOWN STEP	2026-09-27T10:53:12.5995280Z libiconv                            1.18             h23cfdf5_2               conda-forge
OS (macos)	UNKNOWN STEP	2026-09-27T10:53:12.5998080Z libintl                             0.25.1           h493aca8_0               conda-forge
OS (macos)	UNKNOWN STEP	2026-09-27T10:53:12.5998500Z libjpeg-turbo                       3.1.0            h5505292_0               conda-forge
OS (macos)	UNKNOWN STEP	2026-09-27T10:53:12.6007510Z libkml                              1.3.0            he250239_1021            conda-forge
OS (macos)	UNKNOWN STEP	2026-09-27T10:53:12.6007960Z liblapack                           3.9.0            34_hc9a63f6_openblas     conda-forge
OS (macos)	UNKNOWN STEP	2026-09-27T10:53:12.6008850Z liblapacke                          3.9.0            34_hbb7bcf8_openblas     conda-forge
OS (macos)	UNKNOWN STEP	2026-09-27T10:53:12.6009270Z liblzma                             5.8.1            h39f12f2_2               conda-forge
OS (macos)	UNKNOWN STEP	2026-09-27T10:53:12.6009690Z libnetcdf                           4.9.2            nompi_h2d3d5cf_118       conda-forge
OS (macos)	UNKNOWN STEP	2026-09-27T10:53:12.6010150Z libnghttp2                          1.64.0           h6d7220d_0               conda-forge
OS (macos)	UNKNOWN STEP	2026-09-27T10:53:12.6012000Z libopenblas                         0.3.30           openmp_h60d53f8_1        conda-forge
OS (macos)	UNKNOWN STEP	2026-09-27T10:53:12.6012470Z libopentelemetry-cpp                1.21.0           he15edb5_1               conda-forge
OS (macos)	UNKNOWN STEP	2026-09-27T10:53:12.6012970Z libopentelemetry-cpp-headers        1.21.0           hce30654_1               conda-forge
OS (macos)	UNKNOWN STEP	2026-09-27T10:53:12.6015170Z libparquet                          21.0.0           h3402b2e_1_cpu           conda-forge
OS (macos)	UNKNOWN STEP	2026-09-27T10:53:12.6015620Z libpng                              1.6.50           h280e0eb_1               conda-forge
OS (macos)	UNKNOWN STEP	2026-09-27T10:53:12.6016030Z libprotobuf                         6.31.1           h702a38d_1               conda-forge
OS (macos)	UNKNOWN STEP	2026-09-27T10:53:12.6016460Z libre2-11                           2025.07.22       hb7c0934_0               conda-forge
OS (macos)	UNKNOWN STEP	2026-09-27T10:53:12.6016870Z librsvg                             2.58.4           h266df6f_3               conda-forge
OS (macos)	UNKNOWN STEP	2026-09-27T10:53:12.6018000Z librttopo                           1.1.0            h26cc057_18              conda-forge
OS (macos)	UNKNOWN STEP	2026-09-27T10:53:12.6018410Z libscotch                           7.0.6            he56f69b_1               conda-forge
OS (macos)	UNKNOWN STEP	2026-09-27T10:53:12.6018810Z libsodium                           1.0.20           h99b78c6_0               conda-forge
OS (macos)	UNKNOWN STEP	2026-09-27T10:53:12.6020590Z libspatialite                       5.1.0            hea0a7cd_14              conda-forge
OS (macos)	UNKNOWN STEP	2026-09-27T10:53:12.6021040Z libsqlite                           3.50.4           h4237e3c_0               conda-forge
OS (macos)	UNKNOWN STEP	2026-09-27T10:53:12.6021450Z libssh2                             1.11.1           h1590b86_0               conda-forge
OS (macos)	UNKNOWN STEP	2026-09-27T10:53:12.6021930Z libthrift                           0.22.0           h14a376c_1               conda-forge
OS (macos)	UNKNOWN STEP	2026-09-27T10:53:12.6024380Z libtiff                             4.7.0            h025e3ab_6               conda-forge
OS (macos)	UNKNOWN STEP	2026-09-27T10:53:12.6031280Z libutf8proc                         2.10.0           h74a6958_0               conda-forge
OS (macos)	UNKNOWN STEP	2026-09-27T10:53:12.6034940Z libwebp-base                        1.6.0            h07db88b_0               conda-forge
OS (macos)	UNKNOWN STEP	2026-09-27T10:53:12.6035410Z libxcb                              1.17.0           hdb1d25a_0               conda-forge
OS (macos)	UNKNOWN STEP	2026-09-27T10:53:12.6035810Z libxml2                             2.13.8           h4a9ca0c_1               conda-forge
OS (macos)	UNKNOWN STEP	2026-09-27T10:53:12.6036140Z libxslt                             1.1.43           h429d6fd_0               conda-forge
OS (macos)	UNKNOWN STEP	2026-09-27T10:53:12.6036540Z libzip                              1.11.2           h1336266_0               conda-forge
OS (macos)	UNKNOWN STEP	2026-09-27T10:53:12.6038340Z libzlib                             1.3.1            h8359307_2               conda-forge
OS (macos)	UNKNOWN STEP	2026-09-27T10:53:12.6038770Z linkify-it-py                       2.0.3            pyhd8ed1ab_1             conda-forge
OS (macos)	UNKNOWN STEP	2026-09-27T10:53:12.6039190Z linopy                              0.5.5            pyhd8ed1ab_0             conda-forge
OS (macos)	UNKNOWN STEP	2026-09-27T10:53:12.6040620Z llvm-openmp                         20.1.8           hbb9b287_1               conda-forge
OS (macos)	UNKNOWN STEP	2026-09-27T10:53:12.6044120Z llvmlite                            0.44.0           py311h55fc170_1          conda-forge
OS (macos)	UNKNOWN STEP	2026-09-27T10:53:12.6045100Z locket                              1.0.0            pyhd8ed1ab_0             conda-forge
OS (macos)	UNKNOWN STEP	2026-09-27T10:53:12.6045580Z lxml                                6.0.0            py311hfcb965d_0          conda-forge
OS (macos)	UNKNOWN STEP	2026-09-27T10:53:12.6045970Z lz4                                 4.4.4            py311h3a49619_0          conda-forge
OS (macos)	UNKNOWN STEP	2026-09-27T10:53:12.6046340Z lz4-c                               1.10.0           h286801f_1               conda-forge
OS (macos)	UNKNOWN STEP	2026-09-27T10:53:12.6047740Z lzo                                 2.10             h925e9cb_1002            conda-forge
OS (macos)	UNKNOWN STEP	2026-09-27T10:53:12.6048150Z mapclassify                         2.10.0           pyhd8ed1ab_1             conda-forge
OS (macos)	UNKNOWN STEP	2026-09-27T10:53:12.6048560Z markdown                            3.8.2            pyhd8ed1ab_0             conda-forge
OS (macos)	UNKNOWN STEP	2026-09-27T10:53:12.6048980Z markdown-it-py                      4.0.0            pyhd8ed1ab_0             conda-forge
OS (macos)	UNKNOWN STEP	2026-09-27T10:53:12.6049790Z markupsafe                          3.0.2            py311h4921393_1          conda-forge
OS (macos)	UNKNOWN STEP	2026-09-27T10:53:12.6050210Z matplotlib                          3.10.5           py311ha1ab1f8_0          conda-forge
OS (macos)	UNKNOWN STEP	2026-09-27T10:53:12.6050640Z matplotlib-base                     3.10.5           py311h66dac5a_0          conda-forge
OS (macos)	UNKNOWN STEP	2026-09-27T10:53:12.6051080Z matplotlib-inline                   0.1.7            pyhd8ed1ab_1             conda-forge
OS (macos)	UNKNOWN STEP	2026-09-27T10:53:12.6053040Z mdit-py-plugins                     0.5.0            pyhd8ed1ab_0             conda-forge
OS (macos)	UNKNOWN STEP	2026-09-27T10:53:12.6053470Z mdurl                               0.1.2            pyhd8ed1ab_1             conda-forge
OS (macos)	UNKNOWN STEP	2026-09-27T10:53:12.6053880Z memory_profiler                     0.61.0           pyhd8ed1ab_1             conda-forge
OS (macos)	UNKNOWN STEP	2026-09-27T10:53:12.6055680Z mercantile                          1.2.1            pyhd8ed1ab_1             conda-forge
OS (macos)	UNKNOWN STEP	2026-09-27T10:53:12.6056080Z metis                               5.1.0            h15f6cfe_1007            conda-forge
OS (macos)	UNKNOWN STEP	2026-09-27T10:53:12.6056470Z minizip                             4.0.10           hff1a8ea_0               conda-forge
OS (macos)	UNKNOWN STEP	2026-09-27T10:53:12.6056860Z mistune                             3.1.3            pyh29332c3_0             conda-forge
OS (macos)	UNKNOWN STEP	2026-09-27T10:53:12.6058330Z mpfr                                4.2.1            hb693164_3               conda-forge
OS (macos)	UNKNOWN STEP	2026-09-27T10:53:12.6058890Z msgpack-python                      1.1.1            py311h210dab8_0          conda-forge
OS (macos)	UNKNOWN STEP	2026-09-27T10:53:12.6059330Z multipledispatch                    0.6.0            pyhd8ed1ab_1             conda-forge
OS (macos)	UNKNOWN STEP	2026-09-27T10:53:12.6059850Z multiurl                            0.3.7            pyhd8ed1ab_0             conda-forge
OS (macos)	UNKNOWN STEP	2026-09-27T10:53:12.6066710Z multivolumefile                     0.2.3            pyhd8ed1ab_1             conda-forge
OS (macos)	UNKNOWN STEP	2026-09-27T10:53:12.6067180Z mumps-include                       5.7.3            h8c5b6c6_9               conda-forge
OS (macos)	UNKNOWN STEP	2026-09-27T10:53:12.6067600Z mumps-seq                           5.7.3            h29d90bc_9               conda-forge
OS (macos)	UNKNOWN STEP	2026-09-27T10:53:12.6068770Z munkres                             1.1.4            pyhd8ed1ab_1             conda-forge
OS (macos)	UNKNOWN STEP	2026-09-27T10:53:12.6069180Z narwhals                            2.1.1            pyhe01879c_0             conda-forge
OS (macos)	UNKNOWN STEP	2026-09-27T10:53:12.6069520Z nbclient                            0.10.2           pyhd8ed1ab_0             conda-forge
OS (macos)	UNKNOWN STEP	2026-09-27T10:53:12.6070040Z nbconvert-core                      7.16.6           pyh29332c3_0             conda-forge
OS (macos)	UNKNOWN STEP	2026-09-27T10:53:12.6071330Z nbformat                            5.10.4           pyhd8ed1ab_1             conda-forge
OS (macos)	UNKNOWN STEP	2026-09-27T10:53:12.6071730Z ncurses                             6.5              h5e97a16_3               conda-forge
OS (macos)	UNKNOWN STEP	2026-09-27T10:53:12.6072450Z nest-asyncio                        1.6.0            pyhd8ed1ab_1             conda-forge
OS (macos)	UNKNOWN STEP	2026-09-27T10:53:12.6073690Z netcdf4                             1.7.2            nompi_py311h6936c2d_102  conda-forge
OS (macos)	UNKNOWN STEP	2026-09-27T10:53:12.6075410Z networkx                            3.5              pyhe01879c_0             conda-forge
OS (macos)	UNKNOWN STEP	2026-09-27T10:53:12.6075830Z nlohmann_json                       3.12.0           ha1acc90_0               conda-forge
OS (macos)	UNKNOWN STEP	2026-09-27T10:53:12.6076240Z nodeenv                             1.9.1            pyhd8ed1ab_1             conda-forge
OS (macos)	UNKNOWN STEP	2026-09-27T10:53:12.6076660Z notebook-shim                       0.2.4            pyhd8ed1ab_1             conda-forge
OS (macos)	UNKNOWN STEP	2026-09-27T10:53:12.6077950Z numba                               0.61.2           py311hdc76553_1          conda-forge
OS (macos)	UNKNOWN STEP	2026-09-27T10:53:12.6082310Z numexpr                             2.10.2           py311h7469182_0          conda-forge
OS (macos)	UNKNOWN STEP	2026-09-27T10:53:12.6083200Z numpoly                             1.2.14           pyhd8ed1ab_0             conda-forge
OS (macos)	UNKNOWN STEP	2026-09-27T10:53:12.6086700Z numpy                               1.26.4           py311h7125741_0          conda-forge
OS (macos)	UNKNOWN STEP	2026-09-27T10:53:12.6087090Z openjpeg                            2.5.3            h889cd5d_1               conda-forge
OS (macos)	UNKNOWN STEP	2026-09-27T10:53:12.6087500Z openpyxl                            3.1.5            py311hfb527b5_1          conda-forge
OS (macos)	UNKNOWN STEP	2026-09-27T10:53:12.6087890Z openssl                             3.5.2            he92f556_0               conda-forge
OS (macos)	UNKNOWN STEP	2026-09-27T10:53:12.6088820Z orc                                 2.2.0            hca0cb2d_0               conda-forge
OS (macos)	UNKNOWN STEP	2026-09-27T10:53:12.6089310Z overrides                           7.7.0            pyhd8ed1ab_1             conda-forge
OS (macos)	UNKNOWN STEP	2026-09-27T10:53:12.6089720Z packaging                           25.0             pyh29332c3_1             conda-forge
OS (macos)	UNKNOWN STEP	2026-09-27T10:53:12.6090490Z pandas                              2.3.1            py311hff7e5bb_0          conda-forge
OS (macos)	UNKNOWN STEP	2026-09-27T10:53:12.6091160Z pandocfilters                       1.5.0            pyhd8ed1ab_0             conda-forge
OS (macos)	UNKNOWN STEP	2026-09-27T10:53:12.6091570Z panel                               1.7.5            pyhd8ed1ab_0             conda-forge
OS (macos)	UNKNOWN STEP	2026-09-27T10:53:12.6091960Z pango                               1.56.4           h875632e_0               conda-forge
OS (macos)	UNKNOWN STEP	2026-09-27T10:53:12.6093930Z param                               2.2.1            pyhd8ed1ab_0             conda-forge
OS (macos)	UNKNOWN STEP	2026-09-27T10:53:12.6100610Z parso                               0.8.4            pyhd8ed1ab_1             conda-forge
OS (macos)	UNKNOWN STEP	2026-09-27T10:53:12.6101130Z partd                               1.4.2            pyhd8ed1ab_0             conda-forge
OS (macos)	UNKNOWN STEP	2026-09-27T10:53:12.6101530Z patsy                               1.0.1            pyhd8ed1ab_1             conda-forge
OS (macos)	UNKNOWN STEP	2026-09-27T10:53:12.6102560Z pcre2                               10.45            ha881caa_0               conda-forge
OS (macos)	UNKNOWN STEP	2026-09-27T10:53:12.6105580Z pexpect                             4.9.0            pyhd8ed1ab_1             conda-forge
OS (macos)	UNKNOWN STEP	2026-09-27T10:53:12.6106610Z pickleshare                         0.7.5            pyhd8ed1ab_1004          conda-forge
OS (macos)	UNKNOWN STEP	2026-09-27T10:53:12.6107150Z pillow                              11.3.0           py311hb9ba9e9_0          conda-forge
OS (macos)	UNKNOWN STEP	2026-09-27T10:53:12.6108630Z pip                                 25.2             pyh8b19718_0             conda-forge
OS (macos)	UNKNOWN STEP	2026-09-27T10:53:12.6110590Z pixman                              0.46.4           h81086ad_1               conda-forge
OS (macos)	UNKNOWN STEP	2026-09-27T10:53:12.6111030Z plac                                1.4.5            pyhd8ed1ab_0             conda-forge
OS (macos)	UNKNOWN STEP	2026-09-27T10:53:12.6111520Z platformdirs                        4.3.8            pyhe01879c_0             conda-forge
OS (macos)	UNKNOWN STEP	2026-09-27T10:53:12.6111930Z pluggy                              1.6.0            pyhd8ed1ab_0             conda-forge
OS (macos)	UNKNOWN STEP	2026-09-27T10:53:12.6113390Z ply                                 3.11             pyhd8ed1ab_3             conda-forge
OS (macos)	UNKNOWN STEP	2026-09-27T10:53:12.6113730Z polars                              1.32.2           default_h931d351_0       conda-forge
OS (macos)	UNKNOWN STEP	2026-09-27T10:53:12.6114500Z polars-default                      1.32.2           py39h31c57e4_0           conda-forge
OS (macos)	UNKNOWN STEP	2026-09-27T10:53:12.6115000Z powerplantmatching                  0.8.0            pyhd8ed1ab_0             conda-forge
OS (macos)	UNKNOWN STEP	2026-09-27T10:53:12.6122190Z pre-commit                          4.3.0            pyha770c72_0             conda-forge
OS (macos)	UNKNOWN STEP	2026-09-27T10:53:12.6122610Z progressbar2                        4.5.0            pyhd8ed1ab_1             conda-forge
OS (macos)	UNKNOWN STEP	2026-09-27T10:53:12.6123020Z proj                                9.6.2            hdbeaa80_2               conda-forge
OS (macos)	UNKNOWN STEP	2026-09-27T10:53:12.6126290Z prometheus-cpp                      1.3.0            h0967b3e_0               conda-forge
OS (macos)	UNKNOWN STEP	2026-09-27T10:53:12.6129040Z prometheus_client                   0.22.1           pyhd8ed1ab_0             conda-forge
OS (macos)	UNKNOWN STEP	2026-09-27T10:53:12.6129470Z prompt-toolkit                      3.0.51           pyha770c72_0             conda-forge
OS (macos)	UNKNOWN STEP	2026-09-27T10:53:12.6129910Z protobuf                            6.31.1           py311h2e3c950_0          conda-forge
OS (macos)	UNKNOWN STEP	2026-09-27T10:53:12.6130410Z psutil                              7.0.0            py311h917b07b_0          conda-forge
OS (macos)	UNKNOWN STEP	2026-09-27T10:53:12.6131350Z pthread-stubs                       0.4              hd74edd7_1002            conda-forge
OS (macos)	UNKNOWN STEP	2026-09-27T10:53:12.6131770Z ptyprocess                          0.7.0            pyhd8ed1ab_1             conda-forge
OS (macos)	UNKNOWN STEP	2026-09-27T10:53:12.6132160Z pulp                                2.7.0            py311h267d04e_1          conda-forge
OS (macos)	UNKNOWN STEP	2026-09-27T10:53:12.6132560Z pure_eval                           0.2.3            pyhd8ed1ab_1             conda-forge
OS (macos)	UNKNOWN STEP	2026-09-27T10:53:12.6134670Z py-cpuinfo                          9.0.0            pyhd8ed1ab_1             conda-forge
OS (macos)	UNKNOWN STEP	2026-09-27T10:53:12.6137520Z py7zr                               1.0.0            pyhd8ed1ab_0             conda-forge
OS (macos)	UNKNOWN STEP	2026-09-27T10:53:12.6137910Z pyarrow                             21.0.0           py311ha1ab1f8_0          conda-forge
OS (macos)	UNKNOWN STEP	2026-09-27T10:53:12.6138570Z pyarrow-core                        21.0.0           py311h740f514_0_cpu      conda-forge
OS (macos)	UNKNOWN STEP	2026-09-27T10:53:12.6139360Z pybcj                               1.0.6            py311h917b07b_0          conda-forge
OS (macos)	UNKNOWN STEP	2026-09-27T10:53:12.6139770Z pycountry                           24.6.1           pyhd8ed1ab_0             conda-forge
OS (macos)	UNKNOWN STEP	2026-09-27T10:53:12.6140530Z pycparser                           2.22             pyh29332c3_1             conda-forge
OS (macos)	UNKNOWN STEP	2026-09-27T10:53:12.6142870Z pycryptodomex                       3.23.0           py311h917b07b_0          conda-forge
OS (macos)	UNKNOWN STEP	2026-09-27T10:53:12.6143290Z pyct                                0.5.0            pyhd8ed1ab_1             conda-forge
OS (macos)	UNKNOWN STEP	2026-09-27T10:53:12.6143690Z pydoe2                              1.3.0            pyhd8ed1ab_1             conda-forge
OS (macos)	UNKNOWN STEP	2026-09-27T10:53:12.6144160Z pygments                            2.19.2           pyhd8ed1ab_0             conda-forge
OS (macos)	UNKNOWN STEP	2026-09-27T10:53:12.6145270Z pyobjc-core                         11.1             py311hf0763de_0          conda-forge
OS (macos)	UNKNOWN STEP	2026-09-27T10:53:12.6146370Z pyobjc-framework-cocoa              11.1             py311hab620ed_0          conda-forge
OS (macos)	UNKNOWN STEP	2026-09-27T10:53:12.6146820Z pyogrio                             0.11.0           py311h595b8b0_0          conda-forge
OS (macos)	UNKNOWN STEP	2026-09-27T10:53:12.6147230Z pyomo                               6.9.3            py311hf719da1_0          conda-forge
OS (macos)	UNKNOWN STEP	2026-09-27T10:53:12.6147630Z pyparsing                           3.2.3            pyhe01879c_2             conda-forge
OS (macos)	UNKNOWN STEP	2026-09-27T10:53:12.6151360Z pyppmd                              1.1.0            py311h3f08180_1          conda-forge
OS (macos)	UNKNOWN STEP	2026-09-27T10:53:12.6151770Z pyproj                              3.7.1            py311h9539e93_1          conda-forge
OS (macos)	UNKNOWN STEP	2026-09-27T10:53:12.6152160Z pypsa                               0.30.3           pyhd8ed1ab_0             conda-forge
OS (macos)	UNKNOWN STEP	2026-09-27T10:53:12.6152500Z pyscipopt                           5.5.0            py311h155a34a_0          conda-forge
OS (macos)	UNKNOWN STEP	2026-09-27T10:53:12.6153610Z pyshp                               3.0.0            pyhd8ed1ab_0             conda-forge
OS (macos)	UNKNOWN STEP	2026-09-27T10:53:12.6154020Z pysocks                             1.7.1            pyha55dd90_7             conda-forge
OS (macos)	UNKNOWN STEP	2026-09-27T10:53:12.6160420Z pytables                            3.10.2           py311h52164c6_7          conda-forge
OS (macos)	UNKNOWN STEP	2026-09-27T10:53:12.6160850Z pytest                              8.4.1            pyhd8ed1ab_0             conda-forge
OS (macos)	UNKNOWN STEP	2026-09-27T10:53:12.6161410Z python                              3.11.13          hc22306f_0_cpython       conda-forge
OS (macos)	UNKNOWN STEP	2026-09-27T10:53:12.6165300Z python-dateutil                     2.9.0.post0      pyhe01879c_2             conda-forge
OS (macos)	UNKNOWN STEP	2026-09-27T10:53:12.6165750Z python-eccodes                      2.37.0           py311h0f07fe1_0          conda-forge
OS (macos)	UNKNOWN STEP	2026-09-27T10:53:12.6166210Z python-fastjsonschema               2.21.1           pyhd8ed1ab_0             conda-forge
OS (macos)	UNKNOWN STEP	2026-09-27T10:53:12.6166650Z python-gil                          3.11.13          hd8ed1ab_0               conda-forge
OS (macos)	UNKNOWN STEP	2026-09-27T10:53:12.6168250Z python-json-logger                  2.0.7            pyhd8ed1ab_0             conda-forge
OS (macos)	UNKNOWN STEP	2026-09-27T10:53:12.6168690Z python-tzdata                       2025.2           pyhd8ed1ab_0             conda-forge
OS (macos)	UNKNOWN STEP	2026-09-27T10:53:12.6169120Z python-utils                        3.9.1            pyhff2d567_1             conda-forge
OS (macos)	UNKNOWN STEP	2026-09-27T10:53:12.6170070Z python_abi                          3.11             8_cp311                  conda-forge
OS (macos)	UNKNOWN STEP	2026-09-27T10:53:12.6170460Z pytz                                2025.2           pyhd8ed1ab_0             conda-forge
OS (macos)	UNKNOWN STEP	2026-09-27T10:53:12.6170860Z pyviz_comms                         3.0.6            pyhd8ed1ab_0             conda-forge
OS (macos)	UNKNOWN STEP	2026-09-27T10:53:12.6175390Z pyyaml                              6.0.2            py311h4921393_2          conda-forge
OS (macos)	UNKNOWN STEP	2026-09-27T10:53:12.6178290Z pyzmq                               27.0.1           py311h2637eca_0          conda-forge
OS (macos)	UNKNOWN STEP	2026-09-27T10:53:12.6178960Z pyzstd                              0.17.0           py311h0505c5b_0          conda-forge
OS (macos)	UNKNOWN STEP	2026-09-27T10:53:12.6179510Z qhull                               2020.2           h420ef59_5               conda-forge
OS (macos)	UNKNOWN STEP	2026-09-27T10:53:12.6183140Z rasterio                            1.4.3            py311h6ab7c12_1          conda-forge
OS (macos)	UNKNOWN STEP	2026-09-27T10:53:12.6187210Z re2                                 2025.07.22       h52998f3_0               conda-forge
OS (macos)	UNKNOWN STEP	2026-09-27T10:53:12.6187900Z readline                            8.2              h1d1bf99_2               conda-forge
OS (macos)	UNKNOWN STEP	2026-09-27T10:53:12.6188650Z referencing                         0.36.2           pyh29332c3_0             conda-forge
OS (macos)	UNKNOWN STEP	2026-09-27T10:53:12.6189620Z requests                            2.32.4           pyhd8ed1ab_0             conda-forge
OS (macos)	UNKNOWN STEP	2026-09-27T10:53:12.6190180Z reretry                             0.11.8           pyhd8ed1ab_1             conda-forge
OS (macos)	UNKNOWN STEP	2026-09-27T10:53:12.6194570Z reverse-geocode                     1.4.1            pyhd8ed1ab_0             conda-forge
OS (macos)	UNKNOWN STEP	2026-09-27T10:53:12.6231340Z rfc3339-validator                   0.1.4            pyhd8ed1ab_1             conda-forge
OS (macos)	UNKNOWN STEP	2026-09-27T10:53:12.6248830Z rfc3986-validator                   0.1.1            pyh9f0ad1d_0             conda-forge
OS (macos)	UNKNOWN STEP	2026-09-27T10:53:12.6285060Z rfc3987-syntax                      1.1.0            pyhe01879c_1             conda-forge
OS (macos)	UNKNOWN STEP	2026-09-27T10:53:12.6294870Z rich                                14.1.0           pyhe01879c_0             conda-forge
OS (macos)	UNKNOWN STEP	2026-09-27T10:53:12.6308080Z rioxarray                           0.19.0           pyhd8ed1ab_0             conda-forge
OS (macos)	UNKNOWN STEP	2026-09-27T10:53:12.6308690Z rpds-py                             0.27.0           py311h1c3fc1a_0          conda-forge
OS (macos)	UNKNOWN STEP	2026-09-27T10:53:12.6309110Z ruamel.yaml                         0.17.26          py311heffc1b2_0          conda-forge
OS (macos)	UNKNOWN STEP	2026-09-27T10:53:12.6313980Z ruamel.yaml.clib                    0.2.8            py311hae2e1ce_1          conda-forge
OS (macos)	UNKNOWN STEP	2026-09-27T10:53:12.6314460Z scikit-learn                        1.7.1            py311hb5ee8ec_0          conda-forge
OS (macos)	UNKNOWN STEP	2026-09-27T10:53:12.6315160Z scip                                9.2.3            he611465_2               conda-forge
OS (macos)	UNKNOWN STEP	2026-09-27T10:53:12.6316970Z scipy                               1.15.2           py311h0675101_0          conda-forge
OS (macos)	UNKNOWN STEP	2026-09-27T10:53:12.6317460Z seaborn                             0.13.2           hd8ed1ab_3               conda-forge
OS (macos)	UNKNOWN STEP	2026-09-27T10:53:12.6317860Z seaborn-base                        0.13.2           pyhd8ed1ab_3             conda-forge
OS (macos)	UNKNOWN STEP	2026-09-27T10:53:12.6318260Z send2trash                          1.8.3            pyh31c8845_1             conda-forge
OS (macos)	UNKNOWN STEP	2026-09-27T10:53:12.6319090Z setuptools                          80.9.0           pyhff2d567_0             conda-forge
OS (macos)	UNKNOWN STEP	2026-09-27T10:53:12.6319550Z shapely                             2.1.1            py311h06af528_0          conda-forge
OS (macos)	UNKNOWN STEP	2026-09-27T10:53:12.6319930Z six                                 1.17.0           pyhe01879c_1             conda-forge
OS (macos)	UNKNOWN STEP	2026-09-27T10:53:12.6320330Z smart_open                          7.3.0.post1      pyhe01879c_0             conda-forge
OS (macos)	UNKNOWN STEP	2026-09-27T10:53:12.6321720Z smmap                               5.0.2            pyhd8ed1ab_0             conda-forge
OS (macos)	UNKNOWN STEP	2026-09-27T10:53:12.6322570Z snakemake-minimal                   7.32.4           pyhdfd78af_1             bioconda
OS (macos)	UNKNOWN STEP	2026-09-27T10:53:12.6329190Z snappy                              1.2.2            hd121638_0               conda-forge
OS (macos)	UNKNOWN STEP	2026-09-27T10:53:12.6329730Z sniffio                             1.3.1            pyhd8ed1ab_1             conda-forge
OS (macos)	UNKNOWN STEP	2026-09-27T10:53:12.6330650Z snuggs                              1.4.7            pyhd8ed1ab_2             conda-forge
OS (macos)	UNKNOWN STEP	2026-09-27T10:53:12.6333580Z sortedcontainers                    2.4.0            pyhd8ed1ab_1             conda-forge
OS (macos)	UNKNOWN STEP	2026-09-27T10:53:12.6334100Z soupsieve                           2.7              pyhd8ed1ab_0             conda-forge
OS (macos)	UNKNOWN STEP	2026-09-27T10:53:12.6334460Z sqlite                              3.50.4           hb5dd463_0               conda-forge
OS (macos)	UNKNOWN STEP	2026-09-27T10:53:12.6336430Z stack_data                          0.6.3            pyhd8ed1ab_1             conda-forge
OS (macos)	UNKNOWN STEP	2026-09-27T10:53:12.6336850Z statsmodels                         0.14.5           py311h9dc9093_0          conda-forge
OS (macos)	UNKNOWN STEP	2026-09-27T10:53:12.6337250Z stopit                              1.1.2            pyhd8ed1ab_1             conda-forge
OS (macos)	UNKNOWN STEP	2026-09-27T10:53:12.6346800Z tabulate                            0.9.0            pyhd8ed1ab_2             conda-forge
OS (macos)	UNKNOWN STEP	2026-09-27T10:53:12.6347200Z tbb                                 2022.2.0         h5b2e6d4_0               conda-forge
OS (macos)	UNKNOWN STEP	2026-09-27T10:53:12.6347760Z tblib                               3.1.0            pyhd8ed1ab_0             conda-forge
OS (macos)	UNKNOWN STEP	2026-09-27T10:53:12.6351580Z terminado                           0.18.1           pyh31c8845_0             conda-forge
OS (macos)	UNKNOWN STEP	2026-09-27T10:53:12.6351990Z texttable                           1.7.0            pyhd8ed1ab_1             conda-forge
OS (macos)	UNKNOWN STEP	2026-09-27T10:53:12.6352420Z threadpoolctl                       3.6.0            pyhecae5ae_0             conda-forge
OS (macos)	UNKNOWN STEP	2026-09-27T10:53:12.6352990Z throttler                           1.2.2            pyhd8ed1ab_0             conda-forge
OS (macos)	UNKNOWN STEP	2026-09-27T10:53:12.6355940Z tinycss2                            1.4.0            pyhd8ed1ab_0             conda-forge
OS (macos)	UNKNOWN STEP	2026-09-27T10:53:12.6356400Z tk                                  8.6.13           h892fb3f_2               conda-forge
OS (macos)	UNKNOWN STEP	2026-09-27T10:53:12.6356760Z tomli                               2.2.1            pyhe01879c_2             conda-forge
OS (macos)	UNKNOWN STEP	2026-09-27T10:53:12.6357900Z toolz                               1.0.0            pyhd8ed1ab_1             conda-forge
OS (macos)	UNKNOWN STEP	2026-09-27T10:53:12.6358880Z toposort                            1.10             pyhd8ed1ab_1             conda-forge
OS (macos)	UNKNOWN STEP	2026-09-27T10:53:12.6359400Z tornado                             6.5.2            py311h3696347_0          conda-forge
OS (macos)	UNKNOWN STEP	2026-09-27T10:53:12.6364170Z tqdm                                4.67.1           pyhd8ed1ab_1             conda-forge
OS (macos)	UNKNOWN STEP	2026-09-27T10:53:12.6366340Z traitlets                           5.14.3           pyhd8ed1ab_1             conda-forge
OS (macos)	UNKNOWN STEP	2026-09-27T10:53:12.6367140Z tsam                                2.3.9            pyhd8ed1ab_0             conda-forge
OS (macos)	UNKNOWN STEP	2026-09-27T10:53:12.6368410Z types-python-dateutil               2.9.0.20250809   pyhd8ed1ab_0             conda-forge
OS (macos)	UNKNOWN STEP	2026-09-27T10:53:12.6368980Z typing-extensions                   4.14.1           h4440ef1_0               conda-forge
OS (macos)	UNKNOWN STEP	2026-09-27T10:53:12.6369520Z typing_extensions                   4.14.1           pyhe01879c_0             conda-forge
OS (macos)	UNKNOWN STEP	2026-09-27T10:53:12.6369940Z typing_utils                        0.1.0            pyhd8ed1ab_1             conda-forge
OS (macos)	UNKNOWN STEP	2026-09-27T10:53:12.6371610Z tzdata                              2025b            h78e105d_0               conda-forge
OS (macos)	UNKNOWN STEP	2026-09-27T10:53:12.6374720Z uc-micro-py                         1.0.3            pyhd8ed1ab_1             conda-forge
OS (macos)	UNKNOWN STEP	2026-09-27T10:53:12.6375120Z ukkonen                             1.0.1            py311h2c37856_5          conda-forge
OS (macos)	UNKNOWN STEP	2026-09-27T10:53:12.6375540Z unicodedata2                        16.0.0           py311h917b07b_0          conda-forge
OS (macos)	UNKNOWN STEP	2026-09-27T10:53:12.6380030Z unidecode                           1.3.8            pyh29332c3_1             conda-forge
OS (macos)	UNKNOWN STEP	2026-09-27T10:53:12.6380450Z uri-template                        1.3.0            pyhd8ed1ab_1             conda-forge
OS (macos)	UNKNOWN STEP	2026-09-27T10:53:12.6381120Z uriparser                           0.9.8            h00cdb27_0               conda-forge
OS (macos)	UNKNOWN STEP	2026-09-27T10:53:12.6382380Z urllib3                             2.5.0            pyhd8ed1ab_0             conda-forge
OS (macos)	UNKNOWN STEP	2026-09-27T10:53:12.6382970Z validators                          0.35.0           pyhd8ed1ab_0             conda-forge
OS (macos)	UNKNOWN STEP	2026-09-27T10:53:12.6383400Z virtualenv                          20.34.0          pyhd8ed1ab_0             conda-forge
OS (macos)	UNKNOWN STEP	2026-09-27T10:53:12.6383810Z wcwidth                             0.2.13           pyhd8ed1ab_1             conda-forge
OS (macos)	UNKNOWN STEP	2026-09-27T10:53:12.6386950Z webcolors                           24.11.1          pyhd8ed1ab_0             conda-forge
OS (macos)	UNKNOWN STEP	2026-09-27T10:53:12.6387350Z webencodings                        0.5.1            pyhd8ed1ab_3             conda-forge
OS (macos)	UNKNOWN STEP	2026-09-27T10:53:12.6387780Z websocket-client                    1.8.0            pyhd8ed1ab_1             conda-forge
OS (macos)	UNKNOWN STEP	2026-09-27T10:53:12.6389080Z wheel                               0.45.1           pyhd8ed1ab_1             conda-forge
OS (macos)	UNKNOWN STEP	2026-09-27T10:53:12.6389480Z wrapt                               1.17.3           py311h3696347_0          conda-forge
OS (macos)	UNKNOWN STEP	2026-09-27T10:53:12.6389870Z xarray                              2025.1.2         pyhd8ed1ab_0             conda-forge
OS (macos)	UNKNOWN STEP	2026-09-27T10:53:12.6390830Z xerces-c                            3.2.5            h92fc2f4_2               conda-forge
OS (macos)	UNKNOWN STEP	2026-09-27T10:53:12.6391290Z xlrd                                2.0.1            pyhd8ed1ab_3             conda-forge
OS (macos)	UNKNOWN STEP	2026-09-27T10:53:12.6391680Z xorg-libxau                         1.0.12           h5505292_0               conda-forge
OS (macos)	UNKNOWN STEP	2026-09-27T10:53:12.6392100Z xorg-libxdmcp                       1.1.5            hd74edd7_0               conda-forge
OS (macos)	UNKNOWN STEP	2026-09-27T10:53:12.6394480Z xyzservices                         2025.4.0         pyhd8ed1ab_0             conda-forge
OS (macos)	UNKNOWN STEP	2026-09-27T10:53:12.6394880Z yaml                                0.2.5            h925e9cb_3               conda-forge
OS (macos)	UNKNOWN STEP	2026-09-27T10:53:12.6395370Z yte                                 1.8.1            pyha770c72_0             conda-forge
OS (macos)	UNKNOWN STEP	2026-09-27T10:53:12.6395740Z zeromq                              4.3.5            hc1bb282_7               conda-forge
OS (macos)	UNKNOWN STEP	2026-09-27T10:53:12.6396390Z zict                                3.0.0            pyhd8ed1ab_1             conda-forge
OS (macos)	UNKNOWN STEP	2026-09-27T10:53:12.6398390Z zipfile-deflate64                   0.2.0            py311heffc1b2_4          conda-forge
OS (macos)	UNKNOWN STEP	2026-09-27T10:53:12.6399120Z zipp                                3.23.0           pyhd8ed1ab_0             conda-forge
OS (macos)	UNKNOWN STEP	2026-09-27T10:53:12.6405280Z zlib                                1.3.1            h8359307_2               conda-forge
OS (macos)	UNKNOWN STEP	2026-09-27T10:53:12.6407130Z zlib-ng                             2.2.5            hf787086_0               conda-forge
OS (macos)	UNKNOWN STEP	2026-09-27T10:53:12.6409740Z zstandard                           0.23.0           py311h917b07b_2          conda-forge
OS (macos)	UNKNOWN STEP	2026-09-27T10:53:12.6411080Z zstd                                1.5.7            h6491c7d_2               conda-forge
OS (macos)	UNKNOWN STEP	2026-09-27T10:53:12.7070350Z ##[group]Run make test
OS (macos)	UNKNOWN STEP	2026-09-27T10:53:12.7070580Z ^[[36;1mmake test^[[0m
OS (macos)	UNKNOWN STEP	2026-09-27T10:53:12.7107000Z shell: /bin/bash -l {0}
OS (macos)	UNKNOWN STEP	2026-09-27T10:53:12.7107160Z env:
OS (macos)	UNKNOWN STEP	2026-09-27T10:53:12.7107300Z   BASE_ENV: envs/environment.yaml
OS (macos)	UNKNOWN STEP	2026-09-27T10:53:12.7107480Z   env_file: envs/osx-arm64.lock.yaml
OS (macos)	UNKNOWN STEP	2026-09-27T10:53:12.7107670Z   INPUT_RUN_POST: true
OS (macos)	UNKNOWN STEP	2026-09-27T10:53:12.7107820Z   CONDA: /Users/runner/miniconda3
OS (macos)	UNKNOWN STEP	2026-09-27T10:53:12.7107980Z ##[endgroup]
OS (macos)	UNKNOWN STEP	2026-09-27T10:53:15.7751130Z set -e
OS (macos)	UNKNOWN STEP	2026-09-27T10:53:15.7801270Z # this runs test scenario in test/config.test.yaml
OS (macos)	UNKNOWN STEP	2026-09-27T10:53:15.7838850Z snakemake solve_all_networks -call --configfile config.tutorial.yaml test/config.test.yaml
OS (macos)	UNKNOWN STEP	2026-09-27T10:53:16.5254230Z Restricted license - for non-production use only - expires 2026-11-23
OS (macos)	UNKNOWN STEP	2026-09-27T10:53:16.5260660Z /Users/runner/miniconda3/envs/pypsa-earth/lib/python3.11/site-packages/pulp/apis/gurobi_api.py:170: UserWarning: GUROBI error: Unknown parameter '_test'.
OS (macos)	UNKNOWN STEP	2026-09-27T10:53:16.5262460Z   warnings.warn("GUROBI error: {}.".format(e))
OS (macos)	UNKNOWN STEP	2026-09-27T10:53:28.1427910Z Matplotlib is building the font cache; this may take a moment.
OS (macos)	UNKNOWN STEP	2026-09-27T10:53:40.9121550Z Config file config.default.yaml is extended by additional config specified via the command line.
OS (macos)	UNKNOWN STEP	2026-09-27T10:53:40.9201630Z Config file configs/plotting.default.yaml is extended by additional config specified via the command line.
OS (macos)	UNKNOWN STEP	2026-09-27T10:53:40.9228440Z Config file configs/solving.default.yaml is extended by additional config specified via the command line.
OS (macos)	UNKNOWN STEP	2026-09-27T10:53:40.9402830Z Config file configs/bundle_config.yaml is extended by additional config specified via the command line.
OS (macos)	UNKNOWN STEP	2026-09-27T10:53:40.9496660Z Config file configs/powerplantmatching_config.yaml is extended by additional config specified via the command line.
OS (macos)	UNKNOWN STEP	2026-09-27T10:53:40.9499370Z Config file config.yaml is extended by additional config specified via the command line.
OS (macos)	UNKNOWN STEP	2026-09-27T10:53:45.2497410Z The PyPSA meets Earth initiative also supports dedicated regional models. See the documentation at https://pypsa-earth.readthedocs.io/en/latest/user-guide/customization/basic-setup/
OS (macos)	UNKNOWN STEP	2026-09-27T10:53:45.2507690Z Demand data folder: data/ssp2-2.6/2030/era5_2013, load path is ['data/ssp2-2.6/2030/era5_2013/Africa.nc'].
OS (macos)	UNKNOWN STEP	2026-09-27T10:53:45.2516420Z Expected files: Africa.nc
OS (macos)	UNKNOWN STEP	2026-09-27T10:53:45.3006010Z Building DAG of jobs...
OS (macos)	UNKNOWN STEP	2026-09-27T10:53:46.8348620Z Using shell: /bin/bash
OS (macos)	UNKNOWN STEP	2026-09-27T10:53:46.8402600Z Provided cores: 3
OS (macos)	UNKNOWN STEP	2026-09-27T10:53:46.8403580Z Rules claiming more threads will be scaled down.
OS (macos)	UNKNOWN STEP	2026-09-27T10:53:46.8404320Z Conda environments: ignored
OS (macos)	UNKNOWN STEP	2026-09-27T10:53:46.9815840Z Job stats:
OS (macos)	UNKNOWN STEP	2026-09-27T10:53:46.9816950Z job                          count
OS (macos)	UNKNOWN STEP	2026-09-27T10:53:46.9818770Z -------------------------  -------
OS (macos)	UNKNOWN STEP	2026-09-27T10:53:46.9819500Z add_electricity                  1
OS (macos)	UNKNOWN STEP	2026-09-27T10:53:46.9819970Z add_extra_components             1
OS (macos)	UNKNOWN STEP	2026-09-27T10:53:46.9820430Z base_network                     1
OS (macos)	UNKNOWN STEP	2026-09-27T10:53:46.9820880Z build_bus_regions                1
OS (macos)	UNKNOWN STEP	2026-09-27T10:53:46.9821700Z build_co2_emissions              1
OS (macos)	UNKNOWN STEP	2026-09-27T10:53:46.9822270Z build_demand_profiles            1
OS (macos)	UNKNOWN STEP	2026-09-27T10:53:46.9822600Z build_natura_raster              1
OS (macos)	UNKNOWN STEP	2026-09-27T10:53:46.9823050Z build_osm_network                1
OS (macos)	UNKNOWN STEP	2026-09-27T10:53:46.9823580Z build_powerplants                1
OS (macos)	UNKNOWN STEP	2026-09-27T10:53:46.9823890Z build_renewable_profiles         5
OS (macos)	UNKNOWN STEP	2026-09-27T10:53:46.9824330Z build_shapes                     1
OS (macos)	UNKNOWN STEP	2026-09-27T10:53:46.9824700Z clean_osm_data                   1
OS (macos)	UNKNOWN STEP	2026-09-27T10:53:46.9825030Z cluster_network                  1
OS (macos)	UNKNOWN STEP	2026-09-27T10:53:46.9825310Z download_osm_data                1
OS (macos)	UNKNOWN STEP	2026-09-27T10:53:46.9825890Z prepare_network                  1
OS (macos)	UNKNOWN STEP	2026-09-27T10:53:46.9826240Z process_cost_data                1
OS (macos)	UNKNOWN STEP	2026-09-27T10:53:46.9826510Z retrieve_cost_data               1
OS (macos)	UNKNOWN STEP	2026-09-27T10:53:46.9854340Z retrieve_cutout                  1
OS (macos)	UNKNOWN STEP	2026-09-27T10:53:46.9854730Z retrieve_databundle_light        1
OS (macos)	UNKNOWN STEP	2026-09-27T10:53:46.9854990Z retrieve_emissions               1
OS (macos)	UNKNOWN STEP	2026-09-27T10:53:46.9856390Z simplify_network                 1
OS (macos)	UNKNOWN STEP	2026-09-27T10:53:46.9856760Z solve_all_networks               1
OS (macos)	UNKNOWN STEP	2026-09-27T10:53:46.9857110Z solve_network                    1
OS (macos)	UNKNOWN STEP	2026-09-27T10:53:46.9857400Z total                           27
OS (macos)	UNKNOWN STEP	2026-09-27T10:53:46.9857640Z 
OS (macos)	UNKNOWN STEP	2026-09-27T10:53:46.9857800Z Select jobs to execute...
OS (macos)	UNKNOWN STEP	2026-09-27T10:53:47.1997440Z /Users/runner/miniconda3/envs/pypsa-earth/lib/python3.11/site-packages/stopit/__init__.py:10: UserWarning: pkg_resources is deprecated as an API. See https://setuptools.pypa.io/en/latest/pkg_resources.html. The pkg_resources package is slated for removal as early as 2025-11-30. Refrain from using this package or pin to Setuptools<81.
OS (macos)	UNKNOWN STEP	2026-09-27T10:53:47.2000390Z   import pkg_resources
OS (macos)	UNKNOWN STEP	2026-09-27T10:53:47.3844810Z 
OS (macos)	UNKNOWN STEP	2026-09-27T10:53:47.3845120Z [Sun Sep 27 10:53:47 2026]
OS (macos)	UNKNOWN STEP	2026-09-27T10:53:47.3845970Z rule download_osm_data:
OS (macos)	UNKNOWN STEP	2026-09-27T10:53:47.3847120Z     output: resources/test/osm/raw/all_raw_cables.geojson, resources/test/osm/raw/all_raw_generators.geojson, resources/test/osm/raw/all_raw_generators.csv, resources/test/osm/raw/all_raw_lines.geojson, resources/test/osm/raw/all_raw_substations.geojson
OS (macos)	UNKNOWN STEP	2026-09-27T10:53:47.3848200Z     log: logs/test/download_osm_data.log
OS (macos)	UNKNOWN STEP	2026-09-27T10:53:47.3848580Z     jobid: 13
OS (macos)	UNKNOWN STEP	2026-09-27T10:53:47.3848980Z     benchmark: benchmarks/test/download_osm_data
OS (macos)	UNKNOWN STEP	2026-09-27T10:53:47.3850090Z     reason: Missing output files: resources/test/osm/raw/all_raw_cables.geojson, resources/test/osm/raw/all_raw_generators.geojson, resources/test/osm/raw/all_raw_lines.geojson, resources/test/osm/raw/all_raw_substations.geojson
OS (macos)	UNKNOWN STEP	2026-09-27T10:53:47.3853160Z     resources: tmpdir=/var/folders/36/tjdph2t965j8snz9_vkdnw0r0000gn/T
OS (macos)	UNKNOWN STEP	2026-09-27T10:53:47.3853620Z 
OS (macos)	UNKNOWN STEP	2026-09-27T10:53:47.3874150Z [Sun Sep 27 10:53:47 2026]
OS (macos)	UNKNOWN STEP	2026-09-27T10:53:47.3874800Z rule retrieve_databundle_light:
OS (macos)	UNKNOWN STEP	2026-09-27T10:53:47.3879670Z     output: data/eez/eez_v11.gpkg, data/global_buildings/BJ_global_buildings_raw.parquet, data/ssp2-2.6/2030/era5_2013/NorthAmerica.nc, data/global_buildings/NG_global_buildings_raw.parquet, data/demand/forecasts_on_historical_period.parquet, data/hydrobasins_hydroshare/africa-geoglows-atlite.shp, data/IRENA_Statistics_Extract_2025H2.xlsx, data/landcover/world_protected_area/protected_areas_tutorial.shp, data/gadm/gadm36_BEN/gadm36_BEN.gpkg, data/ssp2-2.6/2030/era5_2013/Africa.nc, data/ssp2-2.6/2030/era5_2013/Oceania.nc, data/gadm/gadm41_NGA/gadm41_NGA.gpkg, data/ssp2-2.6/2030/era5_2013/Asia.nc, data/copernicus/PROBAV_LC100_global_v3.0.1_2019-nrt_Discrete-Classification-map_EPSG-4326.tif, data/gebco/GEBCO_2025_sub_ice.nc, data/gadm/gadm36_NGA/gadm36_NGA.gpkg, data/ssp2-2.6/2030/era5_2013/Europe.nc, data/gadm/gadm41_BEN/gadm41_BEN.gpkg, data/ssp2-2.6/2030/era5_2013/SouthAmerica.nc, data/landcover
OS (macos)	UNKNOWN STEP	2026-09-27T10:53:47.3882620Z     log: logs/test/retrieve_databundle.log
OS (macos)	UNKNOWN STEP	2026-09-27T10:53:47.3882940Z     jobid: 8
OS (macos)	UNKNOWN STEP	2026-09-27T10:53:47.3883240Z     benchmark: benchmarks/test/retrieve_databundle_light
OS (macos)	UNKNOWN STEP	2026-09-27T10:53:47.3884610Z     reason: Missing output files: data/ssp2-2.6/2030/era5_2013/Africa.nc, data/eez/eez_v11.gpkg, data/hydrobasins_hydroshare/africa-geoglows-atlite.shp, data/copernicus/PROBAV_LC100_global_v3.0.1_2019-nrt_Discrete-Classification-map_EPSG-4326.tif, data/IRENA_Statistics_Extract_2025H2.xlsx, data/gebco/GEBCO_2025_sub_ice.nc, data/landcover
OS (macos)	UNKNOWN STEP	2026-09-27T10:53:47.3885840Z     resources: tmpdir=/var/folders/36/tjdph2t965j8snz9_vkdnw0r0000gn/T
OS (macos)	UNKNOWN STEP	2026-09-27T10:53:47.3886140Z 
OS (macos)	UNKNOWN STEP	2026-09-27T10:53:47.3965410Z [Sun Sep 27 10:53:47 2026]
OS (macos)	UNKNOWN STEP	2026-09-27T10:53:47.3966040Z rule retrieve_emissions:
OS (macos)	UNKNOWN STEP	2026-09-27T10:53:47.3966830Z     input: jeodpp.jrc.ec.europa.eu/ftp/jrc-opendata/EDGAR/datasets/v60_GHG/CO2_excl_short-cycle_org_C/v60_GHG_CO2_excl_short-cycle_org_C_1970_2018.zip
OS (macos)	UNKNOWN STEP	2026-09-27T10:53:47.3968080Z     output: data/co2_emissions, data/co2_emissions/v60_GHG_CO2_excl_short-cycle_org_C_1970_2018.zip, data/co2_emissions/v60_CO2_excl_short-cycle_org_C_1970_2018.xls
OS (macos)	UNKNOWN STEP	2026-09-27T10:53:47.3968900Z     log: logs/test/retrieve_emissions.log
OS (macos)	UNKNOWN STEP	2026-09-27T10:53:47.3971200Z     jobid: 26
OS (macos)	UNKNOWN STEP	2026-09-27T10:53:47.3971810Z     reason: Missing output files: data/co2_emissions/v60_CO2_excl_short-cycle_org_C_1970_2018.xls
OS (macos)	UNKNOWN STEP	2026-09-27T10:53:47.3973010Z     resources: tmpdir=/var/folders/36/tjdph2t965j8snz9_vkdnw0r0000gn/T
OS (macos)	UNKNOWN STEP	2026-09-27T10:53:47.3973420Z 
OS (macos)	UNKNOWN STEP	2026-09-27T10:53:47.7160430Z Restricted license - for non-production use only - expires 2026-11-23
OS (macos)	UNKNOWN STEP	2026-09-27T10:53:47.7166610Z /Users/runner/miniconda3/envs/pypsa-earth/lib/python3.11/site-packages/pulp/apis/gurobi_api.py:170: UserWarning: GUROBI error: Unknown parameter '_test'.
OS (macos)	UNKNOWN STEP	2026-09-27T10:53:47.7167470Z   warnings.warn("GUROBI error: {}.".format(e))
OS (macos)	UNKNOWN STEP	2026-09-27T10:53:51.2177340Z Config file config.default.yaml is extended by additional config specified via the command line.
OS (macos)	UNKNOWN STEP	2026-09-27T10:53:51.2289380Z Config file configs/plotting.default.yaml is extended by additional config specified via the command line.
OS (macos)	UNKNOWN STEP	2026-09-27T10:53:51.2397720Z Config file configs/solving.default.yaml is extended by additional config specified via the command line.
OS (macos)	UNKNOWN STEP	2026-09-27T10:53:51.2603650Z Config file configs/bundle_config.yaml is extended by additional config specified via the command line.
OS (macos)	UNKNOWN STEP	2026-09-27T10:53:51.2727080Z Config file configs/powerplantmatching_config.yaml is extended by additional config specified via the command line.
OS (macos)	UNKNOWN STEP	2026-09-27T10:53:51.2734560Z Config file config.yaml is extended by additional config specified via the command line.
OS (macos)	UNKNOWN STEP	2026-09-27T10:53:51.2963600Z INFO:eo.gfk:nigeria-latest.osm.pbf downloading to /Users/runner/work/SGP-ESE5004-Stage2/SGP-ESE5004-Stage2/data/osm/pbf/nigeria-latest.osm.pbf
OS (macos)	UNKNOWN STEP	2026-09-27T10:53:52.0984730Z DISCLAIMER LICENSES: the use of PyPSA-Earth is conditioned 
OS (macos)	UNKNOWN STEP	2026-09-27T10:53:52.0985360Z WARNING:__main__:DISCLAIMER LICENSES: the use of PyPSA-Earth is conditioned 
OS (macos)	UNKNOWN STEP	2026-09-27T10:53:52.0989080Z          to the acceptance of its multiple licenses.
OS (macos)	UNKNOWN STEP	2026-09-27T10:53:52.0989780Z          to the acceptance of its multiple licenses.
OS (macos)	UNKNOWN STEP	2026-09-27T10:53:52.0994660Z          The use of the code automatically implies that you accept all the licenses.
OS (macos)	UNKNOWN STEP	2026-09-27T10:53:52.0995250Z          The use of the code automatically implies that you accept all the licenses.
OS (macos)	UNKNOWN STEP	2026-09-27T10:53:52.0995820Z          See our documentation for more information. 
OS (macos)	UNKNOWN STEP	2026-09-27T10:53:52.0997090Z          See our documentation for more information. 
OS (macos)	UNKNOWN STEP	2026-09-27T10:53:52.0997850Z          Link: https://pypsa-earth.readthedocs.io/en/latest/introduction.html#licence
OS (macos)	UNKNOWN STEP	2026-09-27T10:53:52.0998610Z INFO:__main__:Bundles to be downloaded:
OS (macos)	UNKNOWN STEP	2026-09-27T10:53:52.0999370Z          Link: https://pypsa-earth.readthedocs.io/en/latest/introduction.html#licence
OS (macos)	UNKNOWN STEP	2026-09-27T10:53:52.1000100Z 	bundle_irena_statistics_tutorial
OS (macos)	UNKNOWN STEP	2026-09-27T10:53:52.1000450Z Bundles to be downloaded:
OS (macos)	UNKNOWN STEP	2026-09-27T10:53:52.1001300Z 	bundle_tutorial_NGBJ
OS (macos)	UNKNOWN STEP	2026-09-27T10:53:52.1001640Z 	bundle_irena_statistics_tutorial
OS (macos)	UNKNOWN STEP	2026-09-27T10:53:52.1002160Z 	bundle_tutorial_NGBJ_global_buildings
OS (macos)	UNKNOWN STEP	2026-09-27T10:53:52.1002470Z 	bundle_tutorial_data_common
OS (macos)	UNKNOWN STEP	2026-09-27T10:53:52.1002840Z 	bundle_tutorial_hydrobasins
OS (macos)	UNKNOWN STEP	2026-09-27T10:53:52.1003230Z 	demandcast_tutorial
OS (macos)	UNKNOWN STEP	2026-09-27T10:53:52.1003700Z INFO:__main__:Downloading bundle bundle_irena_statistics_tutorial - Host direct
OS (macos)	UNKNOWN STEP	2026-09-27T10:53:52.1004590Z INFO:__main__:Downloading resource 'irena' from cloud 'https://github.com/pypsa-meets-earth/temporary_storage/raw/refs/heads/main/datasets/IRENA_Statistics_Extract_2025H2.xlsx'.
OS (macos)	UNKNOWN STEP	2026-09-27T10:53:52.1005230Z 	bundle_tutorial_NGBJ
OS (macos)	UNKNOWN STEP	2026-09-27T10:53:52.1005400Z 	bundle_tutorial_NGBJ_global_buildings
OS (macos)	UNKNOWN STEP	2026-09-27T10:53:52.1005640Z 	bundle_tutorial_data_common
OS (macos)	UNKNOWN STEP	2026-09-27T10:53:52.1005830Z 	bundle_tutorial_hydrobasins
OS (macos)	UNKNOWN STEP	2026-09-27T10:53:52.1006000Z 	demandcast_tutorial
OS (macos)	UNKNOWN STEP	2026-09-27T10:53:52.1006400Z Downloading bundle bundle_irena_statistics_tutorial - Host direct
OS (macos)	UNKNOWN STEP	2026-09-27T10:53:52.1007200Z Downloading resource 'irena' from cloud 'https://github.com/pypsa-meets-earth/temporary_storage/raw/refs/heads/main/datasets/IRENA_Statistics_Extract_2025H2.xlsx'.
OS (macos)	UNKNOWN STEP	2026-09-27T10:53:52.7585230Z Downloaded resource 'irena' from cloud 'https://github.com/pypsa-meets-earth/temporary_storage/raw/refs/heads/main/datasets/IRENA_Statistics_Extract_2025H2.xlsx'.
OS (macos)	UNKNOWN STEP	2026-09-27T10:53:52.7588910Z INFO:__main__:Downloaded resource 'irena' from cloud 'https://github.com/pypsa-meets-earth/temporary_storage/raw/refs/heads/main/datasets/IRENA_Statistics_Extract_2025H2.xlsx'.
OS (macos)	UNKNOWN STEP	2026-09-27T10:53:52.7590590Z INFO:__main__:Downloading bundle bundle_tutorial_NGBJ - Host zenodo
OS (macos)	UNKNOWN STEP	2026-09-27T10:53:52.7592610Z INFO:__main__:Downloading resource 'data' from cloud 'https://zenodo.org/records/18032587/files/bundle_tutorial_data_NGBJ.zip?download=1'
OS (macos)	UNKNOWN STEP	2026-09-27T10:53:52.7594380Z Downloading bundle bundle_tutorial_NGBJ - Host zenodo
OS (macos)	UNKNOWN STEP	2026-09-27T10:53:52.7595040Z Downloading resource 'data' from cloud 'https://zenodo.org/records/18032587/files/bundle_tutorial_data_NGBJ.zip?download=1'
OS (macos)	UNKNOWN STEP	2026-09-27T10:53:53.4706770Z The PyPSA meets Earth initiative also supports dedicated regional models. See the documentation at https://pypsa-earth.readthedocs.io/en/latest/user-guide/customization/basic-setup/
OS (macos)	UNKNOWN STEP	2026-09-27T10:53:53.4733400Z Demand data folder: data/ssp2-2.6/2030/era5_2013, load path is ['data/ssp2-2.6/2030/era5_2013/Africa.nc'].
OS (macos)	UNKNOWN STEP	2026-09-27T10:53:53.4742030Z Expected files: Africa.nc
OS (macos)	UNKNOWN STEP	2026-09-27T10:53:53.4856130Z Building DAG of jobs...
OS (macos)	UNKNOWN STEP	2026-09-27T10:53:54.7087940Z Using shell: /bin/bash
OS (macos)	UNKNOWN STEP	2026-09-27T10:53:54.7088620Z Provided cores: 3
OS (macos)	UNKNOWN STEP	2026-09-27T10:53:54.7088950Z Rules claiming more threads will be scaled down.
OS (macos)	UNKNOWN STEP	2026-09-27T10:53:54.7089470Z Conda environments: ignored
OS (macos)	UNKNOWN STEP	2026-09-27T10:53:54.7089790Z Select jobs to execute...
OS (macos)	UNKNOWN STEP	2026-09-27T10:53:54.7301160Z /Users/runner/miniconda3/envs/pypsa-earth/lib/python3.11/site-packages/stopit/__init__.py:10: UserWarning: pkg_resources is deprecated as an API. See https://setuptools.pypa.io/en/latest/pkg_resources.html. The pkg_resources package is slated for removal as early as 2025-11-30. Refrain from using this package or pin to Setuptools<81.
OS (macos)	UNKNOWN STEP	2026-09-27T10:53:54.7304020Z   import pkg_resources
OS (macos)	UNKNOWN STEP	2026-09-27T10:53:58.3396010Z Downloading from remote: jeodpp.jrc.ec.europa.eu/ftp/jrc-opendata/EDGAR/datasets/v60_GHG/CO2_excl_short-cycle_org_C/v60_GHG_CO2_excl_short-cycle_org_C_1970_2018.zip
OS (macos)	UNKNOWN STEP	2026-09-27T10:53:59.6352030Z Finished download.
OS (macos)	UNKNOWN STEP	2026-09-27T10:53:59.9670020Z [Sun Sep 27 10:53:59 2026]
OS (macos)	UNKNOWN STEP	2026-09-27T10:53:59.9672200Z Finished job 26.
OS (macos)	UNKNOWN STEP	2026-09-27T10:53:59.9672980Z 1 of 27 steps (4%) done
OS (macos)	UNKNOWN STEP	2026-09-27T10:53:59.9678890Z Select jobs to execute...
OS (macos)	UNKNOWN STEP	2026-09-27T10:54:00.1003030Z 
OS (macos)	UNKNOWN STEP	2026-09-27T10:54:00.1004330Z [Sun Sep 27 10:54:00 2026]
OS (macos)	UNKNOWN STEP	2026-09-27T10:54:00.1008630Z rule build_co2_emissions:
OS (macos)	UNKNOWN STEP	2026-09-27T10:54:00.1009010Z     input: data/co2_emissions/v60_CO2_excl_short-cycle_org_C_1970_2018.xls
OS (macos)	UNKNOWN STEP	2026-09-27T10:54:00.1009600Z     output: resources/test/co2_emissions_elec_and_heat.csv
OS (macos)	UNKNOWN STEP	2026-09-27T10:54:00.1009940Z     log: logs/test/build_co2_emissions.log
OS (macos)	UNKNOWN STEP	2026-09-27T10:54:00.1010320Z     jobid: 25
OS (macos)	UNKNOWN STEP	2026-09-27T10:54:00.1010610Z     benchmark: benchmarks/test/build_co2_emissions
OS (macos)	UNKNOWN STEP	2026-09-27T10:54:00.1011320Z     reason: Missing output files: resources/test/co2_emissions_elec_and_heat.csv; Input files updated by another job: data/co2_emissions/v60_CO2_excl_short-cycle_org_C_1970_2018.xls
OS (macos)	UNKNOWN STEP	2026-09-27T10:54:00.1012340Z     resources: tmpdir=/var/folders/36/tjdph2t965j8snz9_vkdnw0r0000gn/T, mem_mb=2000, mem_mib=1908
OS (macos)	UNKNOWN STEP	2026-09-27T10:54:00.1012790Z 
OS (macos)	UNKNOWN STEP	2026-09-27T10:54:01.9752020Z INFO:__main__:Processing EDGAR emission data from sheet: 'v6.0_EM_CO2_fossil_IPCC2006'
OS (macos)	UNKNOWN STEP	2026-09-27T10:54:01.9752640Z Processing EDGAR emission data from sheet: 'v6.0_EM_CO2_fossil_IPCC2006'
OS (macos)	UNKNOWN STEP	2026-09-27T10:54:02.4125350Z WARNING:country_converter.country_converter:ANT not found in ISO3
OS (macos)	UNKNOWN STEP	2026-09-27T10:54:02.4366470Z WARNING:country_converter.country_converter:SCG not found in ISO3
OS (macos)	UNKNOWN STEP	2026-09-27T10:54:02.4561610Z Processed emission data for 208 countries, years 1970–2018.
OS (macos)	UNKNOWN STEP	2026-09-27T10:54:02.4562330Z INFO:__main__:Processed emission data for 208 countries, years 1970–2018.
OS (macos)	UNKNOWN STEP	2026-09-27T10:54:02.4626350Z Emission data saved to 'resources/test/co2_emissions_elec_and_heat.csv'.
OS (macos)	UNKNOWN STEP	2026-09-27T10:54:02.7230730Z INFO:__main__:Emission data saved to 'resources/test/co2_emissions_elec_and_heat.csv'.
OS (macos)	UNKNOWN STEP	2026-09-27T10:54:02.7232210Z [Sun Sep 27 10:54:02 2026]
OS (macos)	UNKNOWN STEP	2026-09-27T10:54:02.7232710Z Finished job 25.
OS (macos)	UNKNOWN STEP	2026-09-27T10:54:02.7233100Z 2 of 27 steps (7%) done
OS (macos)	UNKNOWN STEP	2026-09-27T10:54:02.7233540Z Select jobs to execute...
OS (macos)	UNKNOWN STEP	2026-09-27T10:54:02.7468380Z 
OS (macos)	UNKNOWN STEP	2026-09-27T10:54:02.7468670Z [Sun Sep 27 10:54:02 2026]
OS (macos)	UNKNOWN STEP	2026-09-27T10:54:02.7469640Z rule retrieve_cost_data:
OS (macos)	UNKNOWN STEP	2026-09-27T10:54:02.7470480Z     input: raw.githubusercontent.com/PyPSA/technology-data/v0.13.2/outputs/costs_2030.csv
OS (macos)	UNKNOWN STEP	2026-09-27T10:54:02.7471070Z     output: resources/test/costs_2030.csv
OS (macos)	UNKNOWN STEP	2026-09-27T10:54:02.7471450Z     log: logs/test/retrieve_cost_data_2030.log
OS (macos)	UNKNOWN STEP	2026-09-27T10:54:02.7471900Z     jobid: 23
OS (macos)	UNKNOWN STEP	2026-09-27T10:54:02.7472270Z     reason: Missing output files: resources/test/costs_2030.csv
OS (macos)	UNKNOWN STEP	2026-09-27T10:54:02.7472780Z     wildcards: year=2030
OS (macos)	UNKNOWN STEP	2026-09-27T10:54:02.7473690Z     resources: tmpdir=/var/folders/36/tjdph2t965j8snz9_vkdnw0r0000gn/T, mem_mb=5000, mem_mib=4769
OS (macos)	UNKNOWN STEP	2026-09-27T10:54:02.7474010Z 
OS (macos)	UNKNOWN STEP	2026-09-27T10:54:02.9095350Z Restricted license - for non-production use only - expires 2026-11-23
OS (macos)	UNKNOWN STEP	2026-09-27T10:54:02.9101630Z /Users/runner/miniconda3/envs/pypsa-earth/lib/python3.11/site-packages/pulp/apis/gurobi_api.py:170: UserWarning: GUROBI error: Unknown parameter '_test'.
OS (macos)	UNKNOWN STEP	2026-09-27T10:54:02.9102290Z   warnings.warn("GUROBI error: {}.".format(e))
OS (macos)	UNKNOWN STEP	2026-09-27T10:54:04.8646390Z Config file config.default.yaml is extended by additional config specified via the command line.
OS (macos)	UNKNOWN STEP	2026-09-27T10:54:04.8725310Z Config file configs/plotting.default.yaml is extended by additional config specified via the command line.
OS (macos)	UNKNOWN STEP	2026-09-27T10:54:04.8750740Z Config file configs/solving.default.yaml is extended by additional config specified via the command line.
OS (macos)	UNKNOWN STEP	2026-09-27T10:54:04.8950390Z Config file configs/bundle_config.yaml is extended by additional config specified via the command line.
OS (macos)	UNKNOWN STEP	2026-09-27T10:54:04.9056360Z Config file configs/powerplantmatching_config.yaml is extended by additional config specified via the command line.
OS (macos)	UNKNOWN STEP	2026-09-27T10:54:04.9058550Z Config file config.yaml is extended by additional config specified via the command line.
OS (macos)	UNKNOWN STEP	2026-09-27T10:54:07.0893060Z The PyPSA meets Earth initiative also supports dedicated regional models. See the documentation at https://pypsa-earth.readthedocs.io/en/latest/user-guide/customization/basic-setup/
OS (macos)	UNKNOWN STEP	2026-09-27T10:54:07.0994920Z Demand data folder: data/ssp2-2.6/2030/era5_2013, load path is ['data/ssp2-2.6/2030/era5_2013/Africa.nc'].
OS (macos)	UNKNOWN STEP	2026-09-27T10:54:07.1096250Z Building DAG of jobs...
OS (macos)	UNKNOWN STEP	2026-09-27T10:54:07.1096570Z Expected files: Africa.nc
OS (macos)	UNKNOWN STEP	2026-09-27T10:54:07.1398150Z Using shell: /bin/bash
OS (macos)	UNKNOWN STEP	2026-09-27T10:54:07.1403520Z Provided cores: 3
OS (macos)	UNKNOWN STEP	2026-09-27T10:54:07.1443470Z Rules claiming more threads will be scaled down.
OS (macos)	UNKNOWN STEP	2026-09-27T10:54:07.1448950Z Provided resources: mem_mb=5000, mem_mib=4769
OS (macos)	UNKNOWN STEP	2026-09-27T10:54:07.1462590Z Conda environments: ignored
OS (macos)	UNKNOWN STEP	2026-09-27T10:54:07.1465130Z Select jobs to execute...
OS (macos)	UNKNOWN STEP	2026-09-27T10:54:07.1608270Z /Users/runner/miniconda3/envs/pypsa-earth/lib/python3.11/site-packages/stopit/__init__.py:10: UserWarning: pkg_resources is deprecated as an API. See https://setuptools.pypa.io/en/latest/pkg_resources.html. The pkg_resources package is slated for removal as early as 2025-11-30. Refrain from using this package or pin to Setuptools<81.
OS (macos)	UNKNOWN STEP	2026-09-27T10:54:07.1610130Z   import pkg_resources
OS (macos)	UNKNOWN STEP	2026-09-27T10:54:07.3151840Z Downloading from remote: raw.githubusercontent.com/PyPSA/technology-data/v0.13.2/outputs/costs_2030.csv
OS (macos)	UNKNOWN STEP	2026-09-27T10:54:07.3656970Z Finished download.
OS (macos)	UNKNOWN STEP	2026-09-27T10:54:07.6603420Z [Sun Sep 27 10:54:07 2026]
OS (macos)	UNKNOWN STEP	2026-09-27T10:54:07.6604310Z Finished job 23.
OS (macos)	UNKNOWN STEP	2026-09-27T10:54:07.6604660Z 3 of 27 steps (11%) done
OS (macos)	UNKNOWN STEP	2026-09-27T10:54:48.3670130Z INFO:__main__:Extracting resources
OS (macos)	UNKNOWN STEP	2026-09-27T10:54:48.3670610Z Extracting resources
OS (macos)	UNKNOWN STEP	2026-09-27T10:54:50.6333640Z Downloaded resource 'data' from cloud 'https://zenodo.org/records/18032587/files/bundle_tutorial_data_NGBJ.zip?download=1'.
OS (macos)	UNKNOWN STEP	2026-09-27T10:54:50.6343560Z INFO:__main__:Downloaded resource 'data' from cloud 'https://zenodo.org/records/18032587/files/bundle_tutorial_data_NGBJ.zip?download=1'.
OS (macos)	UNKNOWN STEP	2026-09-27T10:54:50.6344520Z INFO:__main__:Downloading bundle bundle_tutorial_NGBJ_global_buildings - Host zenodo
OS (macos)	UNKNOWN STEP	2026-09-27T10:54:50.6345280Z INFO:__main__:Downloading resource 'global_buildings' from cloud 'https://zenodo.org/records/18032587/files/global_buildings.zip?download=1'
OS (macos)	UNKNOWN STEP	2026-09-27T10:54:50.6346090Z Downloading bundle bundle_tutorial_NGBJ_global_buildings - Host zenodo
OS (macos)	UNKNOWN STEP	2026-09-27T10:54:50.6346760Z Downloading resource 'global_buildings' from cloud 'https://zenodo.org/records/18032587/files/global_buildings.zip?download=1'
OS (macos)	UNKNOWN STEP	2026-09-27T10:54:51.1840330Z INFO:__main__:Extracting resources
OS (macos)	UNKNOWN STEP	2026-09-27T10:54:51.1840730Z Extracting resources
OS (macos)	UNKNOWN STEP	2026-09-27T10:54:51.1920550Z INFO:__main__:Downloaded resource 'global_buildings' from cloud 'https://zenodo.org/records/18032587/files/global_buildings.zip?download=1'.
OS (macos)	UNKNOWN STEP	2026-09-27T10:54:51.1921520Z Downloaded resource 'global_buildings' from cloud 'https://zenodo.org/records/18032587/files/global_buildings.zip?download=1'.
OS (macos)	UNKNOWN STEP	2026-09-27T10:54:51.1922160Z INFO:__main__:Downloading bundle bundle_tutorial_data_common - Host zenodo
OS (macos)	UNKNOWN STEP	2026-09-27T10:54:51.1922850Z INFO:__main__:Downloading resource 'common' from cloud 'https://zenodo.org/records/18032587/files/bundle_tutorial_data_general.zip?download=1'
OS (macos)	UNKNOWN STEP	2026-09-27T10:54:51.1923510Z Downloading bundle bundle_tutorial_data_common - Host zenodo
OS (macos)	UNKNOWN STEP	2026-09-27T10:54:51.1924070Z Downloading resource 'common' from cloud 'https://zenodo.org/records/18032587/files/bundle_tutorial_data_general.zip?download=1'
OS (macos)	UNKNOWN STEP	2026-09-27T10:55:41.6330620Z INFO:eo.gfk:nigeria-latest.osm.pbf.md5 downloading to /Users/runner/work/SGP-ESE5004-Stage2/SGP-ESE5004-Stage2/data/osm/pbf/nigeria-latest.osm.pbf.md5
OS (macos)	UNKNOWN STEP	2026-09-27T10:56:08.2611940Z INFO:__main__:Extracting resources
OS (macos)	UNKNOWN STEP	2026-09-27T10:56:08.2612350Z Extracting resources
OS (macos)	UNKNOWN STEP	2026-09-27T10:56:10.1169690Z Downloaded resource 'common' from cloud 'https://zenodo.org/records/18032587/files/bundle_tutorial_data_general.zip?download=1'.
OS (macos)	UNKNOWN STEP	2026-09-27T10:56:10.1272430Z INFO:__main__:Downloaded resource 'common' from cloud 'https://zenodo.org/records/18032587/files/bundle_tutorial_data_general.zip?download=1'.
OS (macos)	UNKNOWN STEP	2026-09-27T10:56:10.1273210Z Downloading bundle bundle_tutorial_hydrobasins - Host zenodo
OS (macos)	UNKNOWN STEP	2026-09-27T10:56:10.1374700Z INFO:__main__:Downloading bundle bundle_tutorial_hydrobasins - Host zenodo
OS (macos)	UNKNOWN STEP	2026-09-27T10:56:10.1375640Z INFO:__main__:Downloading resource 'hydrobasins' from cloud 'https://zenodo.org/records/18032587/files/africa-geoglows-catchment.zip?download=1'
OS (macos)	UNKNOWN STEP	2026-09-27T10:56:10.1376710Z Downloading resource 'hydrobasins' from cloud 'https://zenodo.org/records/18032587/files/africa-geoglows-catchment.zip?download=1'
OS (macos)	UNKNOWN STEP	2026-09-27T10:57:35.3211480Z INFO:__main__:Extracting resources
OS (macos)	UNKNOWN STEP	2026-09-27T10:57:35.3211840Z Extracting resources
OS (macos)	UNKNOWN STEP	2026-09-27T10:57:39.1096520Z INFO:__main__:Downloaded resource 'hydrobasins' from cloud 'https://zenodo.org/records/18032587/files/africa-geoglows-catchment.zip?download=1'.
OS (macos)	UNKNOWN STEP	2026-09-27T10:57:39.1098010Z Downloaded resource 'hydrobasins' from cloud 'https://zenodo.org/records/18032587/files/africa-geoglows-catchment.zip?download=1'.
OS (macos)	UNKNOWN STEP	2026-09-27T10:57:39.1098960Z INFO:__main__:Downloading bundle demandcast_tutorial - Host direct
OS (macos)	UNKNOWN STEP	2026-09-27T10:57:39.1099370Z Downloading bundle demandcast_tutorial - Host direct
OS (macos)	UNKNOWN STEP	2026-09-27T10:57:39.1121790Z INFO:__main__:Downloading resource 'el_demand' from cloud 'https://sandbox.zenodo.org/records/493116/files/forecasts_on_historical_period.parquet'.
OS (macos)	UNKNOWN STEP	2026-09-27T10:57:39.1122620Z Downloading resource 'el_demand' from cloud 'https://sandbox.zenodo.org/records/493116/files/forecasts_on_historical_period.parquet'.
OS (macos)	UNKNOWN STEP	2026-09-27T10:57:39.6774560Z INFO:__main__:Downloaded resource 'el_demand' from cloud 'https://sandbox.zenodo.org/records/493116/files/forecasts_on_historical_period.parquet'.
OS (macos)	UNKNOWN STEP	2026-09-27T10:57:39.6775530Z Downloaded resource 'el_demand' from cloud 'https://sandbox.zenodo.org/records/493116/files/forecasts_on_historical_period.parquet'.
OS (macos)	UNKNOWN STEP	2026-09-27T10:57:39.6867140Z INFO:__main__:Transforming geoglows hydrobasins into atlite format
OS (macos)	UNKNOWN STEP	2026-09-27T10:57:39.6868550Z Transforming geoglows hydrobasins into atlite format
OS (macos)	UNKNOWN STEP	2026-09-27T10:57:39.6970590Z /Users/runner/miniconda3/envs/pypsa-earth/lib/python3.11/site-packages/pyogrio/__init__.py:7: DeprecationWarning: The 'shapely.geos' module is deprecated, and will be removed in a future version. All attributes of 'shapely.geos' are available directly from the top-level 'shapely' namespace (since shapely 2.0.0).
OS (macos)	UNKNOWN STEP	2026-09-27T10:57:39.7072980Z   import shapely.geos  # noqa: F401
OS (macos)	UNKNOWN STEP	2026-09-27T10:58:26.2864440Z INFO:pyogrio._io:Created 106,706 records
OS (macos)	UNKNOWN STEP	2026-09-27T10:58:26.4367250Z INFO:__main__:Bundle successfully loaded and unzipped:
OS (macos)	UNKNOWN STEP	2026-09-27T10:58:26.4371800Z Bundle successfully loaded and unzipped:
OS (macos)	UNKNOWN STEP	2026-09-27T10:58:26.4450260Z 	bundle_irena_statistics_tutorial
OS (macos)	UNKNOWN STEP	2026-09-27T10:58:26.4450720Z 	bundle_irena_statistics_tutorial
OS (macos)	UNKNOWN STEP	2026-09-27T10:58:26.4460100Z 	bundle_tutorial_NGBJ
OS (macos)	UNKNOWN STEP	2026-09-27T10:58:26.4460640Z 	bundle_tutorial_NGBJ
OS (macos)	UNKNOWN STEP	2026-09-27T10:58:26.4462880Z 	bundle_tutorial_NGBJ_global_buildings
OS (macos)	UNKNOWN STEP	2026-09-27T10:58:26.4463490Z 	bundle_tutorial_NGBJ_global_buildings
OS (macos)	UNKNOWN STEP	2026-09-27T10:58:26.4463850Z 	bundle_tutorial_data_common
OS (macos)	UNKNOWN STEP	2026-09-27T10:58:26.4464300Z 	bundle_tutorial_hydrobasins
OS (macos)	UNKNOWN STEP	2026-09-27T10:58:26.4464710Z 	demandcast_tutorial
OS (macos)	UNKNOWN STEP	2026-09-27T10:58:26.4466410Z 	bundle_tutorial_data_common
OS (macos)	UNKNOWN STEP	2026-09-27T10:58:26.4466870Z 	bundle_tutorial_hydrobasins
OS (macos)	UNKNOWN STEP	2026-09-27T10:58:26.4467170Z 	demandcast_tutorial
OS (macos)	UNKNOWN STEP	2026-09-27T10:58:28.2325040Z [Sun Sep 27 10:58:28 2026]
OS (macos)	UNKNOWN STEP	2026-09-27T10:58:28.2354750Z Finished job 8.
OS (macos)	UNKNOWN STEP	2026-09-27T10:58:28.2355150Z 4 of 27 steps (15%) done
OS (macos)	UNKNOWN STEP	2026-09-27T10:58:28.2721460Z Select jobs to execute...
OS (macos)	UNKNOWN STEP	2026-09-27T10:58:28.2838140Z 
OS (macos)	UNKNOWN STEP	2026-09-27T10:58:28.2838490Z [Sun Sep 27 10:58:28 2026]
OS (macos)	UNKNOWN STEP	2026-09-27T10:58:28.2841720Z rule build_shapes:
OS (macos)	UNKNOWN STEP	2026-09-27T10:58:28.2852720Z     input: data/eez/eez_v11.gpkg
OS (macos)	UNKNOWN STEP	2026-09-27T10:58:28.2856010Z     output: resources/test/shapes/country_shapes.geojson, resources/test/shapes/offshore_shapes.geojson, resources/test/shapes/extended_country_shape.geojson, resources/test/shapes/gadm_shapes.geojson, resources/test/shapes/subregion_shapes.geojson, resources/test/shapes/subregion_offshore.geojson
OS (macos)	UNKNOWN STEP	2026-09-27T10:58:28.2862900Z     log: logs/test/build_shapes.log
OS (macos)	UNKNOWN STEP	2026-09-27T10:58:28.2898200Z     jobid: 14
OS (macos)	UNKNOWN STEP	2026-09-27T10:58:28.2900040Z     benchmark: benchmarks/test/build_shapes
OS (macos)	UNKNOWN STEP	2026-09-27T10:58:28.2901160Z     reason: Missing output files: resources/test/shapes/extended_country_shape.geojson, resources/test/shapes/gadm_shapes.geojson, resources/test/shapes/offshore_shapes.geojson, resources/test/shapes/country_shapes.geojson; Input files updated by another job: data/eez/eez_v11.gpkg
OS (macos)	UNKNOWN STEP	2026-09-27T10:58:28.2909380Z     resources: tmpdir=/var/folders/36/tjdph2t965j8snz9_vkdnw0r0000gn/T, mem_mb=3096, mem_mib=2953
OS (macos)	UNKNOWN STEP	2026-09-27T10:58:28.2910500Z 
OS (macos)	UNKNOWN STEP	2026-09-27T10:58:33.1146450Z INFO:__main__:Stage 1 of 5: Create country shapes
OS (macos)	UNKNOWN STEP	2026-09-27T10:58:33.1146800Z Stage 1 of 5: Create country shapes
OS (macos)	UNKNOWN STEP	2026-09-27T10:58:33.1802680Z /Users/runner/miniconda3/envs/pypsa-earth/lib/python3.11/site-packages/pyogrio/__init__.py:7: DeprecationWarning: The 'shapely.geos' module is deprecated, and will be removed in a future version. All attributes of 'shapely.geos' are available directly from the top-level 'shapely' namespace (since shapely 2.0.0).
OS (macos)	UNKNOWN STEP	2026-09-27T10:58:33.1804870Z   import shapely.geos  # noqa: F401
OS (macos)	UNKNOWN STEP	2026-09-27T10:58:33.3201950Z /Users/runner/miniconda3/envs/pypsa-earth/lib/python3.11/site-packages/pyogrio/geopandas.py:710: UserWarning: 'crs' was not provided.  The output dataset will not have projection information defined and may not be usable in other systems.
OS (macos)	UNKNOWN STEP	2026-09-27T10:58:33.3203050Z   write(
OS (macos)	UNKNOWN STEP	2026-09-27T10:58:33.3228600Z INFO:pyogrio._io:Created 2 records
OS (macos)	UNKNOWN STEP	2026-09-27T10:58:33.3232420Z INFO:__main__:Stage 2 of 5: Create offshore shapes
OS (macos)	UNKNOWN STEP	2026-09-27T10:58:33.3232980Z Stage 2 of 5: Create offshore shapes
OS (macos)	UNKNOWN STEP	2026-09-27T10:58:33.8723870Z /Users/runner/miniconda3/envs/pypsa-earth/lib/python3.11/site-packages/pyogrio/geopandas.py:710: UserWarning: 'crs' was not provided.  The output dataset will not have projection information defined and may not be usable in other systems.
OS (macos)	UNKNOWN STEP	2026-09-27T10:58:33.8724970Z   write(
OS (macos)	UNKNOWN STEP	2026-09-27T10:58:33.8725200Z INFO:pyogrio._io:Created 2 records
OS (macos)	UNKNOWN STEP	2026-09-27T10:58:33.8770010Z /Users/runner/miniconda3/envs/pypsa-earth/lib/python3.11/site-packages/pyogrio/geopandas.py:710: UserWarning: 'crs' was not provided.  The output dataset will not have projection information defined and may not be usable in other systems.
OS (macos)	UNKNOWN STEP	2026-09-27T10:58:33.8781510Z   write(
OS (macos)	UNKNOWN STEP	2026-09-27T10:58:33.8823160Z INFO:pyogrio._io:Created 1 records
OS (macos)	UNKNOWN STEP	2026-09-27T10:58:33.8843560Z INFO:__main__:Stage 3 of 5: Creation GADM GeoDataFrame
OS (macos)	UNKNOWN STEP	2026-09-27T10:58:33.8843990Z Stage 3 of 5: Creation GADM GeoDataFrame
OS (macos)	UNKNOWN STEP	2026-09-27T10:58:33.9938340Z INFO:__main__:Stage 3 of 5: Download WorldPop datasets, method: standard
OS (macos)	UNKNOWN STEP	2026-09-27T10:58:33.9939080Z Stage 3 of 5: Download WorldPop datasets, method: standard
OS (macos)	UNKNOWN STEP	2026-09-27T10:58:34.0309230Z 
OS (macos)	UNKNOWN STEP	2026-09-27T10:58:34.1744410Z Downloading worldpop file per country and assigning tasks:   0%|          | 0/2 [00:00<?, ?it/s]
OS (macos)	UNKNOWN STEP	2026-09-27T10:58:34.1744970Z Stage 4 of 5: Add population data to GADM GeoDataFrame
OS (macos)	UNKNOWN STEP	2026-09-27T10:58:34.1860690Z Downloading worldpop file per country and assigning tasks: 100%|██████████| 2/2 [00:00<00:00, 13.80it/s]
OS (macos)	UNKNOWN STEP	2026-09-27T10:58:34.1861600Z Stage 4 of 5: Starting multiprocessing
OS (macos)	UNKNOWN STEP	2026-09-27T10:58:34.1862590Z Downloading worldpop file per country and assigning tasks: 100%|██████████| 2/2 [00:00<00:00, 13.79it/s]
OS (macos)	UNKNOWN STEP	2026-09-27T10:58:34.1868860Z INFO:__main__:Stage 4 of 5: Add population data to GADM GeoDataFrame
OS (macos)	UNKNOWN STEP	2026-09-27T10:58:34.1869330Z INFO:__main__:Stage 4 of 5: Starting multiprocessing
OS (macos)	UNKNOWN STEP	2026-09-27T10:58:40.4891230Z 
OS (macos)	UNKNOWN STEP	2026-09-27T10:58:43.3466460Z Compute population per window:   0%|          | 0/2 [00:00<?, ? window/s]
OS (macos)	UNKNOWN STEP	2026-09-27T10:58:59.7374100Z Compute population per window:  50%|█████     | 1/2 [00:02<00:02,  2.86s/ window]
OS (macos)	UNKNOWN STEP	2026-09-27T10:58:59.7375100Z Compute population per window: 100%|██████████| 2/2 [00:19<00:00, 10.82s/ window]
OS (macos)	UNKNOWN STEP	2026-09-27T10:58:59.7375800Z Compute population per window: 100%|██████████| 2/2 [00:19<00:00,  9.62s/ window]
OS (macos)	UNKNOWN STEP	2026-09-27T10:58:59.7679010Z Stage 5 of 5: Add gdp data to GADM GeoDataFrame
OS (macos)	UNKNOWN STEP	2026-09-27T10:58:59.7693290Z INFO:__main__:Stage 5 of 5: Add gdp data to GADM GeoDataFrame
OS (macos)	UNKNOWN STEP	2026-09-27T10:58:59.7693770Z INFO:__main__:Stage 5 of 5: Access to GDP raster data
OS (macos)	UNKNOWN STEP	2026-09-27T10:58:59.7699750Z Stage 5 of 5: Access to GDP raster data
OS (macos)	UNKNOWN STEP	2026-09-27T10:58:59.7705650Z 
OS (macos)	UNKNOWN STEP	2026-09-27T10:58:59.8692310Z Compute GDP :   0%|          | 0/49 [00:00<?, ? geometries/s]
OS (macos)	UNKNOWN STEP	2026-09-27T10:58:59.8693110Z Compute GDP : 100%|██████████| 49/49 [00:00<00:00, 497.32 geometries/s]
OS (macos)	UNKNOWN STEP	2026-09-27T10:58:59.9134960Z INFO:pyogrio._io:Created 49 records
OS (macos)	UNKNOWN STEP	2026-09-27T10:58:59.9169910Z INFO:pyogrio._io:Created 0 records
OS (macos)	UNKNOWN STEP	2026-09-27T10:59:00.1435400Z [Sun Sep 27 10:59:00 2026]
OS (macos)	UNKNOWN STEP	2026-09-27T10:59:00.1451040Z Finished job 14.
OS (macos)	UNKNOWN STEP	2026-09-27T10:59:00.1467730Z 5 of 27 steps (19%) done
OS (macos)	UNKNOWN STEP	2026-09-27T10:59:00.1468120Z Select jobs to execute...
OS (macos)	UNKNOWN STEP	2026-09-27T10:59:00.1468240Z 
OS (macos)	UNKNOWN STEP	2026-09-27T10:59:00.1468380Z [Sun Sep 27 10:59:00 2026]
OS (macos)	UNKNOWN STEP	2026-09-27T10:59:00.1468710Z rule retrieve_cutout:
OS (macos)	UNKNOWN STEP	2026-09-27T10:59:00.1469150Z     input: resources/test/shapes/country_shapes.geojson, resources/test/shapes/offshore_shapes.geojson
OS (macos)	UNKNOWN STEP	2026-09-27T10:59:00.1469700Z     output: cutouts/cutout-2013-era5-tutorial.nc
OS (macos)	UNKNOWN STEP	2026-09-27T10:59:00.1470040Z     log: logs/test/retrieve_cutout/cutout-2013-era5-tutorial.log
OS (macos)	UNKNOWN STEP	2026-09-27T10:59:00.1475360Z     jobid: 16
OS (macos)	UNKNOWN STEP	2026-09-27T10:59:00.1475780Z     benchmark: benchmarks/test/retrieve_cutout_cutout-2013-era5-tutorial
OS (macos)	UNKNOWN STEP	2026-09-27T10:59:00.1476680Z     reason: Missing output files: cutouts/cutout-2013-era5-tutorial.nc; Input files updated by another job: resources/test/shapes/offshore_shapes.geojson, resources/test/shapes/country_shapes.geojson
OS (macos)	UNKNOWN STEP	2026-09-27T10:59:00.1477490Z     wildcards: cutout=cutout-2013-era5-tutorial
OS (macos)	UNKNOWN STEP	2026-09-27T10:59:00.1477960Z     resources: tmpdir=/var/folders/36/tjdph2t965j8snz9_vkdnw0r0000gn/T
OS (macos)	UNKNOWN STEP	2026-09-27T10:59:00.1478190Z 
OS (macos)	UNKNOWN STEP	2026-09-27T10:59:03.7356580Z DISCLAIMER LICENSES: the use of PyPSA-Earth is conditioned 
OS (macos)	UNKNOWN STEP	2026-09-27T10:59:03.7369210Z WARNING:__main__:DISCLAIMER LICENSES: the use of PyPSA-Earth is conditioned 
OS (macos)	UNKNOWN STEP	2026-09-27T10:59:03.7375920Z          to the acceptance of its multiple licenses.
OS (macos)	UNKNOWN STEP	2026-09-27T10:59:03.7376470Z          to the acceptance of its multiple licenses.
OS (macos)	UNKNOWN STEP	2026-09-27T10:59:03.7376870Z          The use of the code automatically implies that you accept all the licenses.
OS (macos)	UNKNOWN STEP	2026-09-27T10:59:03.7377520Z          See our documentation for more information. 
OS (macos)	UNKNOWN STEP	2026-09-27T10:59:03.7378000Z          Link: https://pypsa-earth.readthedocs.io/en/latest/introduction.html#licence
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
