cyc292cycjin-oss/SGP-ESE5004-Stage2/docs/repository_health/20261003/evidence/TEST_PR_UBUNTU_LOG.txt

OS (ubuntu)	UNKNOWN STEP	2026-09-27T10:51:01.4811789Z Current runner version: '2.337.0'
OS (ubuntu)	UNKNOWN STEP	2026-09-27T10:51:01.4838964Z ##[group]Runner Image Provisioner
OS (ubuntu)	UNKNOWN STEP	2026-09-27T10:51:01.4839997Z Hosted Compute Agent
OS (ubuntu)	UNKNOWN STEP	2026-09-27T10:51:01.4840798Z Version: 20260828.587
OS (ubuntu)	UNKNOWN STEP	2026-09-27T10:51:01.4841604Z Commit: abac92662cab4cc7352de4f9f9d2e2419aad9c29
OS (ubuntu)	UNKNOWN STEP	2026-09-27T10:51:01.4842511Z Build Date: 2026-08-28T16:44:25Z
OS (ubuntu)	UNKNOWN STEP	2026-09-27T10:51:01.4843427Z Worker ID: {8e25810a-acfc-46b3-befb-257603a1cef8}
OS (ubuntu)	UNKNOWN STEP	2026-09-27T10:51:01.4844398Z Azure Region: westus3
OS (ubuntu)	UNKNOWN STEP	2026-09-27T10:51:01.4845225Z ##[endgroup]
OS (ubuntu)	UNKNOWN STEP	2026-09-27T10:51:01.4847472Z ##[group]Operating System
OS (ubuntu)	UNKNOWN STEP	2026-09-27T10:51:01.4848266Z Ubuntu
OS (ubuntu)	UNKNOWN STEP	2026-09-27T10:51:01.4848995Z 24.04.5
OS (ubuntu)	UNKNOWN STEP	2026-09-27T10:51:01.4849666Z LTS
OS (ubuntu)	UNKNOWN STEP	2026-09-27T10:51:01.4850275Z ##[endgroup]
OS (ubuntu)	UNKNOWN STEP	2026-09-27T10:51:01.4851046Z ##[group]Runner Image
OS (ubuntu)	UNKNOWN STEP	2026-09-27T10:51:01.4851811Z Image: ubuntu-24.04
OS (ubuntu)	UNKNOWN STEP	2026-09-27T10:51:01.4852589Z Version: 20260920.314.1
OS (ubuntu)	UNKNOWN STEP	2026-09-27T10:51:01.4854276Z Included Software: https://github.com/actions/runner-images/blob/ubuntu24/20260920.314/images/ubuntu/Ubuntu2404-Readme.md
OS (ubuntu)	UNKNOWN STEP	2026-09-27T10:51:01.4856381Z Image Release: https://github.com/actions/runner-images/releases/tag/ubuntu24%2F20260920.314
OS (ubuntu)	UNKNOWN STEP	2026-09-27T10:51:01.4857880Z ##[endgroup]
OS (ubuntu)	UNKNOWN STEP	2026-09-27T10:51:01.4859538Z ##[group]GITHUB_TOKEN Permissions
OS (ubuntu)	UNKNOWN STEP	2026-09-27T10:51:01.4861655Z Contents: read
OS (ubuntu)	UNKNOWN STEP	2026-09-27T10:51:01.4862541Z Metadata: read
OS (ubuntu)	UNKNOWN STEP	2026-09-27T10:51:01.4863244Z Packages: read
OS (ubuntu)	UNKNOWN STEP	2026-09-27T10:51:01.4863925Z ##[endgroup]
OS (ubuntu)	UNKNOWN STEP	2026-09-27T10:51:01.4866522Z Secret source: Dependabot
OS (ubuntu)	UNKNOWN STEP	2026-09-27T10:51:01.4867862Z Cache mode: write
OS (ubuntu)	UNKNOWN STEP	2026-09-27T10:51:01.4868863Z Prepare workflow directory
OS (ubuntu)	UNKNOWN STEP	2026-09-27T10:51:01.5372852Z Prepare all required actions
OS (ubuntu)	UNKNOWN STEP	2026-09-27T10:51:01.5426982Z Getting action download info
OS (ubuntu)	UNKNOWN STEP	2026-09-27T10:51:01.9479755Z Download action repository 'actions/checkout@v7' (SHA:3d3c42e5aac5ba805825da76410c181273ba90b1)
OS (ubuntu)	UNKNOWN STEP	2026-09-27T10:51:02.1598039Z Download action repository 'conda-incubator/setup-miniconda@v4' (SHA:be893c923ea9cf1cf7cd510fbdde27c7e18cbdcb)
OS (ubuntu)	UNKNOWN STEP	2026-09-27T10:51:02.7906885Z Download action repository 'actions/cache@v6' (SHA:55cc8345863c7cc4c66a329aec7e433d2d1c52a9)
OS (ubuntu)	UNKNOWN STEP	2026-09-27T10:51:02.9911018Z Download action repository 'actions/upload-artifact@v7' (SHA:043fb46d1a93c77aae656e7c1c64a875d1fc6a0a)
OS (ubuntu)	UNKNOWN STEP	2026-09-27T10:51:03.1512781Z Download action repository 'actions/download-artifact@v8' (SHA:3e5f45b2cfb9172054b4087a40e8e0b5a5461e7c)
OS (ubuntu)	UNKNOWN STEP	2026-09-27T10:51:04.0690137Z Complete job name: OS (ubuntu)
OS (ubuntu)	UNKNOWN STEP	2026-09-27T10:51:04.1254956Z ##[group]Run actions/checkout@v7
OS (ubuntu)	UNKNOWN STEP	2026-09-27T10:51:04.1255436Z with:
OS (ubuntu)	UNKNOWN STEP	2026-09-27T10:51:04.1255691Z   repository: cyc292cycjin-oss/SGP-ESE5004-Stage2
OS (ubuntu)	UNKNOWN STEP	2026-09-27T10:51:04.1258109Z   token: ***
OS (ubuntu)	UNKNOWN STEP	2026-09-27T10:51:04.1258332Z   ssh-strict: true
OS (ubuntu)	UNKNOWN STEP	2026-09-27T10:51:04.1258569Z   ssh-user: git
OS (ubuntu)	UNKNOWN STEP	2026-09-27T10:51:04.1258794Z   persist-credentials: true
OS (ubuntu)	UNKNOWN STEP	2026-09-27T10:51:04.1259028Z   clean: true
OS (ubuntu)	UNKNOWN STEP	2026-09-27T10:51:04.1259244Z   sparse-checkout-cone-mode: true
OS (ubuntu)	UNKNOWN STEP	2026-09-27T10:51:04.1259498Z   fetch-depth: 1
OS (ubuntu)	UNKNOWN STEP	2026-09-27T10:51:04.1259701Z   fetch-tags: false
OS (ubuntu)	UNKNOWN STEP	2026-09-27T10:51:04.1259924Z   show-progress: true
OS (ubuntu)	UNKNOWN STEP	2026-09-27T10:51:04.1260127Z   lfs: false
OS (ubuntu)	UNKNOWN STEP	2026-09-27T10:51:04.1260344Z   submodules: false
OS (ubuntu)	UNKNOWN STEP	2026-09-27T10:51:04.1260556Z   set-safe-directory: true
OS (ubuntu)	UNKNOWN STEP	2026-09-27T10:51:04.1260793Z   allow-unsafe-pr-checkout: false
OS (ubuntu)	UNKNOWN STEP	2026-09-27T10:51:04.1261274Z env:
OS (ubuntu)	UNKNOWN STEP	2026-09-27T10:51:04.1261478Z   BASE_ENV: envs/environment.yaml
OS (ubuntu)	UNKNOWN STEP	2026-09-27T10:51:04.1261714Z ##[endgroup]
OS (ubuntu)	UNKNOWN STEP	2026-09-27T10:51:04.2276992Z Syncing repository: cyc292cycjin-oss/SGP-ESE5004-Stage2
OS (ubuntu)	UNKNOWN STEP	2026-09-27T10:51:04.2278881Z ##[group]Getting Git version info
OS (ubuntu)	UNKNOWN STEP	2026-09-27T10:51:04.2279561Z Working directory is '/home/runner/work/SGP-ESE5004-Stage2/SGP-ESE5004-Stage2'
OS (ubuntu)	UNKNOWN STEP	2026-09-27T10:51:04.2280427Z [command]/usr/bin/git version
OS (ubuntu)	UNKNOWN STEP	2026-09-27T10:51:04.2364386Z git version 2.55.0
OS (ubuntu)	UNKNOWN STEP	2026-09-27T10:51:04.2395270Z ##[endgroup]
OS (ubuntu)	UNKNOWN STEP	2026-09-27T10:51:04.2449223Z Temporarily overriding HOME='/home/runner/work/_temp/3573cf6f-5510-4f5b-91f8-301c8fa41488' before making global git config changes
OS (ubuntu)	UNKNOWN STEP	2026-09-27T10:51:04.2450591Z Adding repository directory to the temporary git global config as a safe directory
OS (ubuntu)	UNKNOWN STEP	2026-09-27T10:51:04.2458571Z [command]/usr/bin/git config --global --add safe.directory /home/runner/work/SGP-ESE5004-Stage2/SGP-ESE5004-Stage2
OS (ubuntu)	UNKNOWN STEP	2026-09-27T10:51:04.2461457Z Deleting the contents of '/home/runner/work/SGP-ESE5004-Stage2/SGP-ESE5004-Stage2'
OS (ubuntu)	UNKNOWN STEP	2026-09-27T10:51:04.2462950Z ##[group]Determining repository object format
OS (ubuntu)	UNKNOWN STEP	2026-09-27T10:51:04.2463847Z ##[endgroup]
OS (ubuntu)	UNKNOWN STEP	2026-09-27T10:51:04.2464931Z ##[group]Initializing the repository
OS (ubuntu)	UNKNOWN STEP	2026-09-27T10:51:04.2465711Z [command]/usr/bin/git init /home/runner/work/SGP-ESE5004-Stage2/SGP-ESE5004-Stage2
OS (ubuntu)	UNKNOWN STEP	2026-09-27T10:51:04.2585014Z hint: Using 'master' as the name for the initial branch. This default branch name
OS (ubuntu)	UNKNOWN STEP	2026-09-27T10:51:04.2586061Z hint: will change to "main" in Git 3.0. To configure the initial branch name
OS (ubuntu)	UNKNOWN STEP	2026-09-27T10:51:04.2615493Z hint: to use in all of your new repositories, which will suppress this warning,
OS (ubuntu)	UNKNOWN STEP	2026-09-27T10:51:04.2616183Z hint: call:
OS (ubuntu)	UNKNOWN STEP	2026-09-27T10:51:04.2616821Z hint:
OS (ubuntu)	UNKNOWN STEP	2026-09-27T10:51:04.2617897Z hint: 	git config --global init.defaultBranch <name>
OS (ubuntu)	UNKNOWN STEP	2026-09-27T10:51:04.2618598Z hint:
OS (ubuntu)	UNKNOWN STEP	2026-09-27T10:51:04.2619543Z hint: Names commonly chosen instead of 'master' are 'main', 'trunk' and
OS (ubuntu)	UNKNOWN STEP	2026-09-27T10:51:04.2620609Z hint: 'development'. The just-created branch can be renamed via this command:
OS (ubuntu)	UNKNOWN STEP	2026-09-27T10:51:04.2621635Z hint:
OS (ubuntu)	UNKNOWN STEP	2026-09-27T10:51:04.2622173Z hint: 	git branch -m <name>
OS (ubuntu)	UNKNOWN STEP	2026-09-27T10:51:04.2622965Z hint:
OS (ubuntu)	UNKNOWN STEP	2026-09-27T10:51:04.2623761Z hint: Disable this message with "git config set advice.defaultBranchName false"
OS (ubuntu)	UNKNOWN STEP	2026-09-27T10:51:04.2625248Z Initialized empty Git repository in /home/runner/work/SGP-ESE5004-Stage2/SGP-ESE5004-Stage2/.git/
OS (ubuntu)	UNKNOWN STEP	2026-09-27T10:51:04.2628111Z [command]/usr/bin/git remote add origin https://github.com/cyc292cycjin-oss/SGP-ESE5004-Stage2
OS (ubuntu)	UNKNOWN STEP	2026-09-27T10:51:04.2656530Z ##[endgroup]
OS (ubuntu)	UNKNOWN STEP	2026-09-27T10:51:04.2657483Z ##[group]Disabling automatic garbage collection
OS (ubuntu)	UNKNOWN STEP	2026-09-27T10:51:04.2658507Z [command]/usr/bin/git config --local gc.auto 0
OS (ubuntu)	UNKNOWN STEP	2026-09-27T10:51:04.2734074Z ##[endgroup]
OS (ubuntu)	UNKNOWN STEP	2026-09-27T10:51:04.2734728Z ##[group]Setting up auth
OS (ubuntu)	UNKNOWN STEP	2026-09-27T10:51:04.2735122Z Removing SSH command configuration
OS (ubuntu)	UNKNOWN STEP	2026-09-27T10:51:04.2735703Z [command]/usr/bin/git config --local --name-only --get-regexp core\.sshCommand
OS (ubuntu)	UNKNOWN STEP	2026-09-27T10:51:04.2800621Z [command]/usr/bin/git submodule foreach --recursive sh -c "git config --local --name-only --get-regexp 'core\.sshCommand' && git config --local --unset-all 'core.sshCommand' || :"
OS (ubuntu)	UNKNOWN STEP	2026-09-27T10:51:04.5025201Z Removing HTTP extra header
OS (ubuntu)	UNKNOWN STEP	2026-09-27T10:51:04.5026557Z [command]/usr/bin/git config --local --name-only --get-regexp http\.https\:\/\/github\.com\/\.extraheader
OS (ubuntu)	UNKNOWN STEP	2026-09-27T10:51:04.5037111Z [command]/usr/bin/git submodule foreach --recursive sh -c "git config --local --name-only --get-regexp 'http\.https\:\/\/github\.com\/\.extraheader' && git config --local --unset-all 'http.https://github.com/.extraheader' || :"
OS (ubuntu)	UNKNOWN STEP	2026-09-27T10:51:04.5132917Z Removing includeIf entries pointing to credentials config files
OS (ubuntu)	UNKNOWN STEP	2026-09-27T10:51:04.5136317Z [command]/usr/bin/git config --local --name-only --get-regexp ^includeIf\.gitdir:
OS (ubuntu)	UNKNOWN STEP	2026-09-27T10:51:04.5168595Z [command]/usr/bin/git submodule foreach --recursive git config --local --show-origin --name-only --get-regexp remote.origin.url
OS (ubuntu)	UNKNOWN STEP	2026-09-27T10:51:04.5371548Z [command]/usr/bin/git config --file /home/runner/work/_temp/git-credentials-8b3bba4d-a49f-4c3f-aec8-6cd6bf2f2922.config http.https://github.com/.extraheader AUTHORIZATION: basic ***
OS (ubuntu)	UNKNOWN STEP	2026-09-27T10:51:04.5406918Z [command]/usr/bin/git config --local includeIf.gitdir:/home/runner/work/SGP-ESE5004-Stage2/SGP-ESE5004-Stage2/.git.path /home/runner/work/_temp/git-credentials-8b3bba4d-a49f-4c3f-aec8-6cd6bf2f2922.config
OS (ubuntu)	UNKNOWN STEP	2026-09-27T10:51:04.5439009Z [command]/usr/bin/git config --local includeIf.gitdir:/home/runner/work/SGP-ESE5004-Stage2/SGP-ESE5004-Stage2/.git/worktrees/*.path /home/runner/work/_temp/git-credentials-8b3bba4d-a49f-4c3f-aec8-6cd6bf2f2922.config
OS (ubuntu)	UNKNOWN STEP	2026-09-27T10:51:04.5473722Z [command]/usr/bin/git config --local includeIf.gitdir:/github/workspace/.git.path /github/runner_temp/git-credentials-8b3bba4d-a49f-4c3f-aec8-6cd6bf2f2922.config
OS (ubuntu)	UNKNOWN STEP	2026-09-27T10:51:04.5507179Z [command]/usr/bin/git config --local includeIf.gitdir:/github/workspace/.git/worktrees/*.path /github/runner_temp/git-credentials-8b3bba4d-a49f-4c3f-aec8-6cd6bf2f2922.config
OS (ubuntu)	UNKNOWN STEP	2026-09-27T10:51:04.5536296Z ##[endgroup]
OS (ubuntu)	UNKNOWN STEP	2026-09-27T10:51:04.5537160Z ##[group]Fetching the repository
OS (ubuntu)	UNKNOWN STEP	2026-09-27T10:51:04.5542023Z [command]/usr/bin/git -c protocol.version=2 fetch --no-tags --prune --no-recurse-submodules --depth=1 origin +73718f8f1b489b6cbc92f6c3df583d3b9de2f412:refs/remotes/pull/1/merge
OS (ubuntu)	UNKNOWN STEP	2026-09-27T10:51:06.4220604Z From https://github.com/cyc292cycjin-oss/SGP-ESE5004-Stage2
OS (ubuntu)	UNKNOWN STEP	2026-09-27T10:51:06.4221462Z  * [new ref]         73718f8f1b489b6cbc92f6c3df583d3b9de2f412 -> pull/1/merge
OS (ubuntu)	UNKNOWN STEP	2026-09-27T10:51:06.4223126Z ##[endgroup]
OS (ubuntu)	UNKNOWN STEP	2026-09-27T10:51:06.4223577Z ##[group]Determining the checkout info
OS (ubuntu)	UNKNOWN STEP	2026-09-27T10:51:06.4224092Z ##[endgroup]
OS (ubuntu)	UNKNOWN STEP	2026-09-27T10:51:06.4224376Z [command]/usr/bin/git sparse-checkout disable
OS (ubuntu)	UNKNOWN STEP	2026-09-27T10:51:06.4308217Z [command]/usr/bin/git config --local --unset-all extensions.worktreeConfig
OS (ubuntu)	UNKNOWN STEP	2026-09-27T10:51:06.4347996Z ##[group]Checking out the ref
OS (ubuntu)	UNKNOWN STEP	2026-09-27T10:51:06.4349151Z [command]/usr/bin/git checkout --progress --force refs/remotes/pull/1/merge
OS (ubuntu)	UNKNOWN STEP	2026-09-27T10:51:06.5992298Z Note: switching to 'refs/remotes/pull/1/merge'.
OS (ubuntu)	UNKNOWN STEP	2026-09-27T10:51:06.5994577Z 
OS (ubuntu)	UNKNOWN STEP	2026-09-27T10:51:06.5995093Z You are in 'detached HEAD' state. You can look around, make experimental
OS (ubuntu)	UNKNOWN STEP	2026-09-27T10:51:06.5995961Z changes and commit them, and you can discard any commits you make in this
OS (ubuntu)	UNKNOWN STEP	2026-09-27T10:51:06.6002871Z state without impacting any branches by switching back to a branch.
OS (ubuntu)	UNKNOWN STEP	2026-09-27T10:51:06.6003575Z 
OS (ubuntu)	UNKNOWN STEP	2026-09-27T10:51:06.6004777Z If you want to create a new branch to retain commits you create, you may
OS (ubuntu)	UNKNOWN STEP	2026-09-27T10:51:06.6026763Z do so (now or later) by using -c with the switch command. Example:
OS (ubuntu)	UNKNOWN STEP	2026-09-27T10:51:06.6027064Z 
OS (ubuntu)	UNKNOWN STEP	2026-09-27T10:51:06.6027164Z   git switch -c <new-branch-name>
OS (ubuntu)	UNKNOWN STEP	2026-09-27T10:51:06.6027525Z 
OS (ubuntu)	UNKNOWN STEP	2026-09-27T10:51:06.6027673Z Or undo this operation with:
OS (ubuntu)	UNKNOWN STEP	2026-09-27T10:51:06.6027926Z 
OS (ubuntu)	UNKNOWN STEP	2026-09-27T10:51:06.6028074Z   git switch -
OS (ubuntu)	UNKNOWN STEP	2026-09-27T10:51:06.6028492Z 
OS (ubuntu)	UNKNOWN STEP	2026-09-27T10:51:06.6028988Z Turn off this advice by setting config variable advice.detachedHead to false
OS (ubuntu)	UNKNOWN STEP	2026-09-27T10:51:06.6029638Z 
OS (ubuntu)	UNKNOWN STEP	2026-09-27T10:51:06.6030265Z HEAD is now at 73718f8 Merge 5568912ad8e838723d2c9c774346f8876418d45a into a3616a68ee44592af6527ca9024a90f1956646ae
OS (ubuntu)	UNKNOWN STEP	2026-09-27T10:51:06.6032630Z ##[endgroup]
OS (ubuntu)	UNKNOWN STEP	2026-09-27T10:51:06.6098228Z [command]/usr/bin/git log -1 --format=%H
OS (ubuntu)	UNKNOWN STEP	2026-09-27T10:51:06.6155778Z 73718f8f1b489b6cbc92f6c3df583d3b9de2f412
OS (ubuntu)	UNKNOWN STEP	2026-09-27T10:51:06.6374817Z ##[group]Run git fetch origin main
OS (ubuntu)	UNKNOWN STEP	2026-09-27T10:51:06.6375143Z ^[[36;1mgit fetch origin main^[[0m
OS (ubuntu)	UNKNOWN STEP	2026-09-27T10:51:06.6375538Z ^[[36;1mif git diff --name-only origin/main | grep -E '(envs/environment.yaml|.*lock.yaml)$'; then^[[0m
OS (ubuntu)	UNKNOWN STEP	2026-09-27T10:51:06.6376009Z ^[[36;1m  if git diff --name-only origin/main | grep -E '.*lock.yaml'; then^[[0m
OS (ubuntu)	UNKNOWN STEP	2026-09-27T10:51:06.6376336Z ^[[36;1m    echo "Lock files changed. Using lock files."^[[0m
OS (ubuntu)	UNKNOWN STEP	2026-09-27T10:51:06.6376633Z ^[[36;1m    echo "env_file=envs/linux-64.lock.yaml" >> $GITHUB_ENV^[[0m
OS (ubuntu)	UNKNOWN STEP	2026-09-27T10:51:06.6376907Z ^[[36;1m  else^[[0m
OS (ubuntu)	UNKNOWN STEP	2026-09-27T10:51:06.6377237Z ^[[36;1m    echo "Only base env envs/environment.yaml changed. Using it instead of locked envs."^[[0m
OS (ubuntu)	UNKNOWN STEP	2026-09-27T10:51:06.6377778Z ^[[36;1m    echo "env_file=envs/environment.yaml" >> $GITHUB_ENV^[[0m
OS (ubuntu)	UNKNOWN STEP	2026-09-27T10:51:06.6378031Z ^[[36;1m  fi^[[0m
OS (ubuntu)	UNKNOWN STEP	2026-09-27T10:51:06.6378182Z ^[[36;1melse^[[0m
OS (ubuntu)	UNKNOWN STEP	2026-09-27T10:51:06.6378414Z ^[[36;1m  echo "Neither base env nor lock files changed. Using lock files."^[[0m
OS (ubuntu)	UNKNOWN STEP	2026-09-27T10:51:06.6378793Z ^[[36;1m  echo "env_file=envs/linux-64.lock.yaml" >> $GITHUB_ENV^[[0m
OS (ubuntu)	UNKNOWN STEP	2026-09-27T10:51:06.6379043Z ^[[36;1mfi^[[0m
OS (ubuntu)	UNKNOWN STEP	2026-09-27T10:51:06.6607744Z shell: /usr/bin/bash -l {0}
OS (ubuntu)	UNKNOWN STEP	2026-09-27T10:51:06.6608006Z env:
OS (ubuntu)	UNKNOWN STEP	2026-09-27T10:51:06.6608199Z   BASE_ENV: envs/environment.yaml
OS (ubuntu)	UNKNOWN STEP	2026-09-27T10:51:06.6608419Z ##[endgroup]
OS (ubuntu)	UNKNOWN STEP	2026-09-27T10:51:10.3708041Z From https://github.com/cyc292cycjin-oss/SGP-ESE5004-Stage2
OS (ubuntu)	UNKNOWN STEP	2026-09-27T10:51:10.3708843Z  * branch              main       -> FETCH_HEAD
OS (ubuntu)	UNKNOWN STEP	2026-09-27T10:51:10.3709923Z  * [new branch]        main       -> origin/main
OS (ubuntu)	UNKNOWN STEP	2026-09-27T10:51:10.6639338Z Neither base env nor lock files changed. Using lock files.
OS (ubuntu)	UNKNOWN STEP	2026-09-27T10:51:10.6766335Z ##[group]Run conda-incubator/setup-miniconda@v4
OS (ubuntu)	UNKNOWN STEP	2026-09-27T10:51:10.6766720Z with:
OS (ubuntu)	UNKNOWN STEP	2026-09-27T10:51:10.6766909Z   miniforge-version: latest
OS (ubuntu)	UNKNOWN STEP	2026-09-27T10:51:10.6767122Z   activate-environment: pypsa-earth
OS (ubuntu)	UNKNOWN STEP	2026-09-27T10:51:10.6767598Z   channel-priority: strict
OS (ubuntu)	UNKNOWN STEP	2026-09-27T10:51:10.6767914Z   conda-remove-defaults: true
OS (ubuntu)	UNKNOWN STEP	2026-09-27T10:51:10.6768187Z   auto-activate: true
OS (ubuntu)	UNKNOWN STEP	2026-09-27T10:51:10.6768483Z   auto-activate-base: legacy-placeholder
OS (ubuntu)	UNKNOWN STEP	2026-09-27T10:51:10.6768744Z   auto-update-conda: false
OS (ubuntu)	UNKNOWN STEP	2026-09-27T10:51:10.6768932Z   remove-profiles: true
OS (ubuntu)	UNKNOWN STEP	2026-09-27T10:51:10.6769109Z   run-init: true
OS (ubuntu)	UNKNOWN STEP	2026-09-27T10:51:10.6769277Z   conda-solver: libmamba
OS (ubuntu)	UNKNOWN STEP	2026-09-27T10:51:10.6769483Z   clean-patched-environment-file: true
OS (ubuntu)	UNKNOWN STEP	2026-09-27T10:51:10.6769699Z   run-post: true
OS (ubuntu)	UNKNOWN STEP	2026-09-27T10:51:10.6769856Z env:
OS (ubuntu)	UNKNOWN STEP	2026-09-27T10:51:10.6770038Z   BASE_ENV: envs/environment.yaml
OS (ubuntu)	UNKNOWN STEP	2026-09-27T10:51:10.6770244Z   env_file: envs/linux-64.lock.yaml
OS (ubuntu)	UNKNOWN STEP	2026-09-27T10:51:10.6770444Z ##[endgroup]
OS (ubuntu)	UNKNOWN STEP	2026-09-27T10:51:10.7404143Z ##[group]Gathering Inputs...
OS (ubuntu)	UNKNOWN STEP	2026-09-27T10:51:10.7414063Z ##[endgroup]
OS (ubuntu)	UNKNOWN STEP	2026-09-27T10:51:10.7415580Z ##[group]Creating bootstrap condarc file in /home/runner/.condarc...
OS (ubuntu)	UNKNOWN STEP	2026-09-27T10:51:10.7430510Z ##[endgroup]
OS (ubuntu)	UNKNOWN STEP	2026-09-27T10:51:10.7452287Z ##[group]Ensuring installer...
OS (ubuntu)	UNKNOWN STEP	2026-09-27T10:51:10.7477973Z Can we use bundled Miniconda?
OS (ubuntu)	UNKNOWN STEP	2026-09-27T10:51:10.7490908Z Can we download a custom installer by URL?
OS (ubuntu)	UNKNOWN STEP	2026-09-27T10:51:10.7507730Z Can we download Miniforge?
OS (ubuntu)	UNKNOWN STEP	2026-09-27T10:51:10.7518691Z ... will download Miniforge.
OS (ubuntu)	UNKNOWN STEP	2026-09-27T10:51:10.7538190Z Will fetch Miniforge3 latest from https://github.com/conda-forge/miniforge/releases/latest/download/Miniforge3-Linux-x86_64.sh
OS (ubuntu)	UNKNOWN STEP	2026-09-27T10:51:10.7548883Z Ensuring Installer...
OS (ubuntu)	UNKNOWN STEP	2026-09-27T10:51:10.7561951Z Checking for cached Miniforge3@latest...
OS (ubuntu)	UNKNOWN STEP	2026-09-27T10:51:10.7590957Z Did not find Miniforge3-Linux-x86_64.sh latest in cache
OS (ubuntu)	UNKNOWN STEP	2026-09-27T10:51:11.7092683Z Downloaded Miniforge3-Linux-x86_64.sh, ensuring extension .sh
OS (ubuntu)	UNKNOWN STEP	2026-09-27T10:51:11.7102249Z Caching Miniforge3@latest...
OS (ubuntu)	UNKNOWN STEP	2026-09-27T10:51:13.1044643Z Cached Miniforge3@latest: /opt/hostedtoolcache/Miniforge3/latest/x86_64!
OS (ubuntu)	UNKNOWN STEP	2026-09-27T10:51:13.1047227Z ##[endgroup]
OS (ubuntu)	UNKNOWN STEP	2026-09-27T10:51:13.1047886Z ##[group]Running installer...
OS (ubuntu)	UNKNOWN STEP	2026-09-27T10:51:13.1110849Z [command]/usr/bin/bash /home/runner/work/_temp/fcd1520a-68a3-4b9a-8472-8f9cf3e21dba.sh -f -b -p /home/runner/miniconda3
OS (ubuntu)	UNKNOWN STEP	2026-09-27T10:51:13.2873571Z PREFIX=/home/runner/miniconda3
OS (ubuntu)	UNKNOWN STEP	2026-09-27T10:51:13.7136590Z Unpacking bootstrapper...
OS (ubuntu)	UNKNOWN STEP	2026-09-27T10:51:13.7802375Z Unpacking payload...
OS (ubuntu)	UNKNOWN STEP	2026-09-27T10:51:14.0465318Z Extracting ca-certificates-2026.7.22-hbd8a1cb_0.conda
OS (ubuntu)	UNKNOWN STEP	2026-09-27T10:51:14.0640287Z Extracting libgomp-16.2.0-he0feb66_4.conda
OS (ubuntu)	UNKNOWN STEP	2026-09-27T10:51:14.0906670Z Extracting libzlib-1.3.2-h25fd6f3_3.conda
OS (ubuntu)	UNKNOWN STEP	2026-09-27T10:51:14.1337088Z Extracting nlohmann_json-abi-3.12.0-h0f90c79_2.conda
OS (ubuntu)	UNKNOWN STEP	2026-09-27T10:51:14.1954303Z Extracting pybind11-abi-11-hc364b38_1.conda
OS (ubuntu)	UNKNOWN STEP	2026-09-27T10:51:14.2848515Z Extracting python_abi-3.14-9_cp314.conda
OS (ubuntu)	UNKNOWN STEP	2026-09-27T10:51:14.3001494Z Extracting tzdata-2026c-h151e31d_0.conda
OS (ubuntu)	UNKNOWN STEP	2026-09-27T10:51:14.4252249Z Extracting _openmp_mutex-4.5-20_gnu.conda
OS (ubuntu)	UNKNOWN STEP	2026-09-27T10:51:14.4634220Z Extracting zstd-1.5.7-hb78ec9c_7.conda
OS (ubuntu)	UNKNOWN STEP	2026-09-27T10:51:14.6081955Z Extracting ld_impl_linux-64-2.46.1-default_hbd61a6d_102.conda
OS (ubuntu)	UNKNOWN STEP	2026-09-27T10:51:14.6116840Z Extracting libgcc-16.2.0-ha9f2e26_4.conda
OS (ubuntu)	UNKNOWN STEP	2026-09-27T10:51:14.8356788Z Extracting bzip2-1.0.8-hda65f42_10.conda
OS (ubuntu)	UNKNOWN STEP	2026-09-27T10:51:14.8384878Z Extracting c-ares-1.34.8-hebe6cf0_2.conda
OS (ubuntu)	UNKNOWN STEP	2026-09-27T10:51:14.8472287Z Extracting keyutils-1.6.3-h7cc23a3_1.conda
OS (ubuntu)	UNKNOWN STEP	2026-09-27T10:51:14.8513575Z Extracting libev-4.33-h280c20c_3.conda
OS (ubuntu)	UNKNOWN STEP	2026-09-27T10:51:14.8526018Z Extracting libexpat-2.8.1-hecca717_1.conda
OS (ubuntu)	UNKNOWN STEP	2026-09-27T10:51:14.8549468Z Extracting libffi-3.7.0-h81df57d_1.conda
OS (ubuntu)	UNKNOWN STEP	2026-09-27T10:51:14.8564229Z Extracting libiconv-1.18-h0cb94f2_3.conda
OS (ubuntu)	UNKNOWN STEP	2026-09-27T10:51:14.8667835Z Extracting liblzma-5.8.3-hb03c661_1.conda
OS (ubuntu)	UNKNOWN STEP	2026-09-27T10:51:14.8766024Z Extracting libmpdec-4.0.0-hb03c661_2.conda
OS (ubuntu)	UNKNOWN STEP	2026-09-27T10:51:14.8766712Z Extracting libstdcxx-16.2.0-h934c35e_4.conda
OS (ubuntu)	UNKNOWN STEP	2026-09-27T10:51:14.9161301Z Extracting libuuid-2.42.3-hcfc3c73_0.conda
OS (ubuntu)	UNKNOWN STEP	2026-09-27T10:51:14.9212109Z Extracting lzo-2.10-hebe6cf0_1003.conda
OS (ubuntu)	UNKNOWN STEP	2026-09-27T10:51:14.9215789Z Extracting ncurses-6.6-hdb14827_1.conda
OS (ubuntu)	UNKNOWN STEP	2026-09-27T10:51:15.1556319Z Extracting openssl-3.6.4-h781a0a9_0.conda
OS (ubuntu)	UNKNOWN STEP	2026-09-27T10:51:15.1814656Z Extracting reproc-14.2.8.post0-hee9eb32_0.conda
OS (ubuntu)	UNKNOWN STEP	2026-09-27T10:51:15.1834539Z Extracting tk-8.6.13-noxft_h1df4ec4_4.conda
OS (ubuntu)	UNKNOWN STEP	2026-09-27T10:51:15.2184218Z Extracting cpp-expected-1.3.1-h171cf75_1.conda
OS (ubuntu)	UNKNOWN STEP	2026-09-27T10:51:15.2195299Z Extracting fmt-12.1.0-h76c4fd7_1.conda
OS (ubuntu)	UNKNOWN STEP	2026-09-27T10:51:15.2224211Z Extracting icu-78.3-py310h44b86e0_2.conda
OS (ubuntu)	UNKNOWN STEP	2026-09-27T10:51:15.4168888Z Extracting libedit-3.1.20250104-pl5321h373387f_1.conda
OS (ubuntu)	UNKNOWN STEP	2026-09-27T10:51:15.6477625Z Extracting libmsgpack-c-6.1.0-h54a6638_7.conda
OS (ubuntu)	UNKNOWN STEP	2026-09-27T10:51:15.8658501Z Extracting libnghttp2-1.68.1-h74cf4be_1.conda
OS (ubuntu)	UNKNOWN STEP	2026-09-27T10:51:15.8711648Z Extracting libpython-3.14.7-hdc7f604_106_cp314.conda
OS (ubuntu)	UNKNOWN STEP	2026-09-27T10:51:16.0621878Z Extracting libsolv-0.7.39-h72ddc62_1.conda
OS (ubuntu)	UNKNOWN STEP	2026-09-27T10:51:16.1829670Z Extracting libssh2-1.11.1-h6154650_1.conda
OS (ubuntu)	UNKNOWN STEP	2026-09-27T10:51:16.2011287Z Extracting lz4-c-1.10.0-hee9eb32_2.conda
OS (ubuntu)	UNKNOWN STEP	2026-09-27T10:51:16.2043396Z Extracting readline-8.3-hd6e31c0_1.conda
OS (ubuntu)	UNKNOWN STEP	2026-09-27T10:51:16.2122038Z Extracting reproc-cpp-14.2.8.post0-h1c70be6_0.conda
OS (ubuntu)	UNKNOWN STEP	2026-09-27T10:51:16.2228024Z Extracting simdjson-4.6.11-h4dbf13b_0.conda
OS (ubuntu)	UNKNOWN STEP	2026-09-27T10:51:16.2419644Z Extracting yaml-cpp-0.8.0-h54a6638_1.conda
OS (ubuntu)	UNKNOWN STEP	2026-09-27T10:51:16.4744157Z Extracting krb5-1.22.2-hbc21106_2.conda
OS (ubuntu)	UNKNOWN STEP	2026-09-27T10:51:16.6741033Z Extracting libpsl-0.23.1-hd9e3e90_1.conda
OS (ubuntu)	UNKNOWN STEP	2026-09-27T10:51:16.7258572Z Extracting libsqlite-3.53.4-h13e7031_1.conda
OS (ubuntu)	UNKNOWN STEP	2026-09-27T10:51:16.9248211Z Extracting libxml2-16-2.15.4-hf3af7cc_0.conda
OS (ubuntu)	UNKNOWN STEP	2026-09-27T10:51:16.9934520Z Extracting spdlog-1.17.0-hb6aa676_2.conda
OS (ubuntu)	UNKNOWN STEP	2026-09-27T10:51:17.0525995Z Extracting libcurl-8.22.0-ha042cf0_0.conda
OS (ubuntu)	UNKNOWN STEP	2026-09-27T10:51:17.0647028Z Extracting libxml2-2.15.4-h7df9aa5_0.conda
OS (ubuntu)	UNKNOWN STEP	2026-09-27T10:51:17.1025923Z Extracting python-3.14.7-hcd007b5_106_cp314.conda
OS (ubuntu)	UNKNOWN STEP	2026-09-27T10:51:17.3828815Z Extracting libarchive-3.8.9-gpl_h3152399_101.conda
OS (ubuntu)	UNKNOWN STEP	2026-09-27T10:51:17.6956507Z Extracting tomli-w-1.2.0-pyhd8ed1ab_0.conda
OS (ubuntu)	UNKNOWN STEP	2026-09-27T10:51:17.7451099Z Extracting libmamba-2.9.0-py314h6ba947b_0.conda
OS (ubuntu)	UNKNOWN STEP	2026-09-27T10:51:17.7748548Z Extracting menuinst-2.5.2-py314h9e666f3_2.conda
OS (ubuntu)	UNKNOWN STEP	2026-09-27T10:51:17.9557669Z Extracting archspec-0.2.5-pyhd8ed1ab_0.conda
OS (ubuntu)	UNKNOWN STEP	2026-09-27T10:51:18.0850469Z Extracting backports.zstd-1.7.0-py314h680f03e_1.conda
OS (ubuntu)	UNKNOWN STEP	2026-09-27T10:51:18.1859667Z Extracting boltons-26.2.0-pyhd8ed1ab_0.conda
OS (ubuntu)	UNKNOWN STEP	2026-09-27T10:51:18.2033901Z Extracting brotli-python-1.2.0-py314hcd2bdb6_4.conda
OS (ubuntu)	UNKNOWN STEP	2026-09-27T10:51:18.2264999Z Extracting cached_property-2.0.1-pyhcf101f3_0.conda
OS (ubuntu)	UNKNOWN STEP	2026-09-27T10:51:18.2449930Z Extracting certifi-2026.7.22-pyhd8ed1ab_0.conda
OS (ubuntu)	UNKNOWN STEP	2026-09-27T10:51:18.2734742Z Extracting charset-normalizer-3.5.1-pyhd8ed1ab_0.conda
OS (ubuntu)	UNKNOWN STEP	2026-09-27T10:51:18.2860581Z Extracting colorama-0.4.6-pyhd8ed1ab_1.conda
OS (ubuntu)	UNKNOWN STEP	2026-09-27T10:51:18.2968144Z Extracting cpython-3.14.7-py314hd8ed1ab_106.conda
OS (ubuntu)	UNKNOWN STEP	2026-09-27T10:51:18.5357139Z Extracting distro-1.9.0-pyhd8ed1ab_1.conda
OS (ubuntu)	UNKNOWN STEP	2026-09-27T10:51:18.7301590Z Extracting frozendict-2.4.7-pyh851646a_2.conda
OS (ubuntu)	UNKNOWN STEP	2026-09-27T10:51:18.9268203Z Extracting hpack-4.2.0-pyhd8ed1ab_0.conda
OS (ubuntu)	UNKNOWN STEP	2026-09-27T10:51:19.1569155Z Extracting hyperframe-6.1.0-pyhd8ed1ab_0.conda
OS (ubuntu)	UNKNOWN STEP	2026-09-27T10:51:19.3371939Z Extracting idna-3.19-pyhcf101f3_0.conda
OS (ubuntu)	UNKNOWN STEP	2026-09-27T10:51:19.5278806Z Extracting libmamba-spdlog-2.9.0-h5efa3ab_0.conda
OS (ubuntu)	UNKNOWN STEP	2026-09-27T10:51:19.7598464Z Extracting mamba-2.9.0-h9649d4f_0.conda
OS (ubuntu)	UNKNOWN STEP	2026-09-27T10:51:19.9888647Z Extracting markupsafe-3.0.3-py314h67df5f8_1.conda
OS (ubuntu)	UNKNOWN STEP	2026-09-27T10:51:20.2288390Z Extracting msgpack-python-1.2.2-py314h5383ef5_2.conda
OS (ubuntu)	UNKNOWN STEP	2026-09-27T10:51:20.3084223Z Extracting packaging-26.3-pyhc364b38_0.conda
OS (ubuntu)	UNKNOWN STEP	2026-09-27T10:51:20.3111409Z Extracting pip-26.2.1-pyh145f28c_0.conda
OS (ubuntu)	UNKNOWN STEP	2026-09-27T10:51:20.3420722Z Extracting platformdirs-4.11.6-pyh5ded981_0.conda
OS (ubuntu)	UNKNOWN STEP	2026-09-27T10:51:20.3436835Z Extracting pluggy-1.6.0-pyhf9edf01_1.conda
OS (ubuntu)	UNKNOWN STEP	2026-09-27T10:51:20.3453718Z Extracting pycosat-0.6.6-py314h89acca1_5.conda
OS (ubuntu)	UNKNOWN STEP	2026-09-27T10:51:20.3479925Z Extracting pysocks-1.7.1-pyha55dd90_7.conda
OS (ubuntu)	UNKNOWN STEP	2026-09-27T10:51:20.3494493Z Extracting python-installer-1.0.1-pyh332efcf_0.conda
OS (ubuntu)	UNKNOWN STEP	2026-09-27T10:51:20.3528264Z Extracting ruamel.yaml.clib-0.2.15-py314hfe1a184_5.conda
OS (ubuntu)	UNKNOWN STEP	2026-09-27T10:51:20.3547269Z Extracting setuptools-84.0.0-pyh332efcf_0.conda
OS (ubuntu)	UNKNOWN STEP	2026-09-27T10:51:20.3738398Z Extracting sniffio-1.3.1-pyhd8ed1ab_2.conda
OS (ubuntu)	UNKNOWN STEP	2026-09-27T10:51:20.3755652Z Extracting tomli-2.4.1-pyhcf101f3_0.conda
OS (ubuntu)	UNKNOWN STEP	2026-09-27T10:51:20.3770568Z Extracting tqdm-4.70.0-pyh8f84b5b_0.conda
OS (ubuntu)	UNKNOWN STEP	2026-09-27T10:51:20.3810397Z Extracting truststore-0.10.4-pyhcf101f3_0.conda
OS (ubuntu)	UNKNOWN STEP	2026-09-27T10:51:20.3825402Z Extracting typing_extensions-4.16.0-pyhcf101f3_0.conda
OS (ubuntu)	UNKNOWN STEP	2026-09-27T10:51:20.3840302Z Extracting zipp-4.1.0-pyhcf101f3_0.conda
OS (ubuntu)	UNKNOWN STEP	2026-09-27T10:51:20.3862368Z Extracting anyio-4.15.1-pyh5ded981_1.conda
OS (ubuntu)	UNKNOWN STEP	2026-09-27T10:51:20.4560826Z Extracting cached-property-2.0.1-pyhcf101f3_0.conda
OS (ubuntu)	UNKNOWN STEP	2026-09-27T10:51:20.4586088Z Extracting conda-package-streaming-0.13.0-pyhd8ed1ab_0.conda
OS (ubuntu)	UNKNOWN STEP	2026-09-27T10:51:20.4597962Z Extracting h11-0.16.0-pyhcf101f3_1.conda
OS (ubuntu)	UNKNOWN STEP	2026-09-27T10:51:20.4606740Z Extracting h2-4.4.1-pyhcf101f3_0.conda
OS (ubuntu)	UNKNOWN STEP	2026-09-27T10:51:20.4645146Z Extracting importlib-metadata-9.0.1-pyhcf101f3_0.conda
OS (ubuntu)	UNKNOWN STEP	2026-09-27T10:51:20.4664622Z Extracting jinja2-3.1.6-pyhcf101f3_1.conda
OS (ubuntu)	UNKNOWN STEP	2026-09-27T10:51:20.4691733Z Extracting libmambapy-2.9.0-py314h959206d_0.conda
OS (ubuntu)	UNKNOWN STEP	2026-09-27T10:51:20.4755963Z Extracting pyproject_hooks-1.2.0-pyhd8ed1ab_1.conda
OS (ubuntu)	UNKNOWN STEP	2026-09-27T10:51:20.4772622Z Extracting python-gil-3.14.7-h4df99d1_106.conda
OS (ubuntu)	UNKNOWN STEP	2026-09-27T10:51:20.4807574Z Extracting ruamel.yaml-0.19.1-pyhcf101f3_0.conda
OS (ubuntu)	UNKNOWN STEP	2026-09-27T10:51:20.4838752Z Extracting typing-extensions-4.16.0-h69aa097_0.conda
OS (ubuntu)	UNKNOWN STEP	2026-09-27T10:51:20.4854622Z Extracting typing-inspection-0.4.4-pyhcf101f3_0.conda
OS (ubuntu)	UNKNOWN STEP	2026-09-27T10:51:20.4869449Z Extracting _python_abi3_support-1.0-hd8ed1ab_3.conda
OS (ubuntu)	UNKNOWN STEP	2026-09-27T10:51:20.4903321Z Extracting annotated-types-0.8.0-pyhd8ed1ab_0.conda
OS (ubuntu)	UNKNOWN STEP	2026-09-27T10:51:20.4918737Z Extracting conda-libmamba-solver-26.7.0-pyhcf101f3_0.conda
OS (ubuntu)	UNKNOWN STEP	2026-09-27T10:51:20.4928007Z Extracting httpcore-1.0.9-pyh29332c3_0.conda
OS (ubuntu)	UNKNOWN STEP	2026-09-27T10:51:20.4951266Z Extracting pydantic-core-2.46.5-py314h7e8cd81_1.conda
OS (ubuntu)	UNKNOWN STEP	2026-09-27T10:51:20.5045202Z Extracting python-build-1.6.0-pyhc364b38_0.conda
OS (ubuntu)	UNKNOWN STEP	2026-09-27T10:51:20.5063928Z Extracting urllib3-2.7.0-pyhd8ed1ab_0.conda
OS (ubuntu)	UNKNOWN STEP	2026-09-27T10:51:20.5098976Z Extracting httpx-0.28.1-pyhd8ed1ab_0.conda
OS (ubuntu)	UNKNOWN STEP	2026-09-27T10:51:20.5124975Z Extracting py-rattler-0.25.0-py310hefeb9ab_5.conda
OS (ubuntu)	UNKNOWN STEP	2026-09-27T10:51:20.5649132Z Extracting pydantic-2.13.5-pyhcf101f3_0.conda
OS (ubuntu)	UNKNOWN STEP	2026-09-27T10:51:20.5721160Z Extracting requests-2.34.2-pyhcf101f3_0.conda
OS (ubuntu)	UNKNOWN STEP	2026-09-27T10:51:20.5744272Z Extracting conda-package-handling-2.6.0-pyh5ded981_0.conda
OS (ubuntu)	UNKNOWN STEP	2026-09-27T10:51:20.5772769Z Extracting unearth-0.18.3-pyhd8ed1ab_0.conda
OS (ubuntu)	UNKNOWN STEP	2026-09-27T10:51:20.5810846Z Extracting conda-index-0.13.0-pyh5ded981_0.conda
OS (ubuntu)	UNKNOWN STEP	2026-09-27T10:51:20.5901001Z Extracting conda-pypi-0.11.0-pyh5ded981_2.conda
OS (ubuntu)	UNKNOWN STEP	2026-09-27T10:51:20.5941389Z Extracting conda-lockfiles-0.2.1-pyhd8ed1ab_0.conda
OS (ubuntu)	UNKNOWN STEP	2026-09-27T10:51:20.5959739Z Extracting conda-rattler-solver-0.1.1-pyhcf101f3_0.conda
OS (ubuntu)	UNKNOWN STEP	2026-09-27T10:51:20.5976745Z Extracting conda-26.7.2-py314h9e666f3_1.conda
OS (ubuntu)	UNKNOWN STEP	2026-09-27T10:51:20.6303521Z Extracting conda-self-0.2.1-pyhd8ed1ab_0.conda
OS (ubuntu)	UNKNOWN STEP	2026-09-27T10:51:20.6403929Z 
OS (ubuntu)	UNKNOWN STEP	2026-09-27T10:51:20.6404847Z Installing base environment...
OS (ubuntu)	UNKNOWN STEP	2026-09-27T10:51:20.6405427Z 
OS (ubuntu)	UNKNOWN STEP	2026-09-27T10:51:20.6488833Z Transaction
OS (ubuntu)	UNKNOWN STEP	2026-09-27T10:51:20.6493953Z 
OS (ubuntu)	UNKNOWN STEP	2026-09-27T10:51:20.6494335Z   Prefix: /home/runner/miniconda3
OS (ubuntu)	UNKNOWN STEP	2026-09-27T10:51:20.6494718Z 
OS (ubuntu)	UNKNOWN STEP	2026-09-27T10:51:20.6495008Z   Updating specs:
OS (ubuntu)	UNKNOWN STEP	2026-09-27T10:51:20.6495331Z 
OS (ubuntu)	UNKNOWN STEP	2026-09-27T10:51:20.6495622Z    - ca-certificates==2026.7.22=hbd8a1cb_0
OS (ubuntu)	UNKNOWN STEP	2026-09-27T10:51:20.6496133Z    - libgomp==16.2.0=he0feb66_4
OS (ubuntu)	UNKNOWN STEP	2026-09-27T10:51:20.6496631Z    - libzlib==1.3.2=h25fd6f3_3
OS (ubuntu)	UNKNOWN STEP	2026-09-27T10:51:20.6497114Z    - nlohmann_json-abi==3.12.0=h0f90c79_2
OS (ubuntu)	UNKNOWN STEP	2026-09-27T10:51:20.6498156Z    - pybind11-abi==11=hc364b38_1
OS (ubuntu)	UNKNOWN STEP	2026-09-27T10:51:20.6498619Z    - python_abi==3.14=9_cp314
OS (ubuntu)	UNKNOWN STEP	2026-09-27T10:51:20.6499255Z    - tzdata==2026c=h151e31d_0
OS (ubuntu)	UNKNOWN STEP	2026-09-27T10:51:20.6499713Z    - _openmp_mutex==4.5=20_gnu
OS (ubuntu)	UNKNOWN STEP	2026-09-27T10:51:20.6500167Z    - zstd==1.5.7=hb78ec9c_7
OS (ubuntu)	UNKNOWN STEP	2026-09-27T10:51:20.6500660Z    - ld_impl_linux-64==2.46.1=default_hbd61a6d_102
OS (ubuntu)	UNKNOWN STEP	2026-09-27T10:51:20.6501191Z    - libgcc==16.2.0=ha9f2e26_4
OS (ubuntu)	UNKNOWN STEP	2026-09-27T10:51:20.6501652Z    - bzip2==1.0.8=hda65f42_10
OS (ubuntu)	UNKNOWN STEP	2026-09-27T10:51:20.6502105Z    - c-ares==1.34.8=hebe6cf0_2
OS (ubuntu)	UNKNOWN STEP	2026-09-27T10:51:20.6502561Z    - keyutils==1.6.3=h7cc23a3_1
OS (ubuntu)	UNKNOWN STEP	2026-09-27T10:51:20.6503015Z    - libev==4.33=h280c20c_3
OS (ubuntu)	UNKNOWN STEP	2026-09-27T10:51:20.6503457Z    - libexpat==2.8.1=hecca717_1
OS (ubuntu)	UNKNOWN STEP	2026-09-27T10:51:20.6503900Z    - libffi==3.7.0=h81df57d_1
OS (ubuntu)	UNKNOWN STEP	2026-09-27T10:51:20.6504347Z    - libiconv==1.18=h0cb94f2_3
OS (ubuntu)	UNKNOWN STEP	2026-09-27T10:51:20.6504808Z    - liblzma==5.8.3=hb03c661_1
OS (ubuntu)	UNKNOWN STEP	2026-09-27T10:51:20.6505255Z    - libmpdec==4.0.0=hb03c661_2
OS (ubuntu)	UNKNOWN STEP	2026-09-27T10:51:20.6505715Z    - libstdcxx==16.2.0=h934c35e_4
OS (ubuntu)	UNKNOWN STEP	2026-09-27T10:51:20.6506185Z    - libuuid==2.42.3=hcfc3c73_0
OS (ubuntu)	UNKNOWN STEP	2026-09-27T10:51:20.6506658Z    - lzo==2.10=hebe6cf0_1003
OS (ubuntu)	UNKNOWN STEP	2026-09-27T10:51:20.6512056Z    - ncurses==6.6=hdb14827_1
OS (ubuntu)	UNKNOWN STEP	2026-09-27T10:51:20.6512570Z    - openssl==3.6.4=h781a0a9_0
OS (ubuntu)	UNKNOWN STEP	2026-09-27T10:51:20.6513064Z    - reproc==14.2.8.post0=hee9eb32_0
OS (ubuntu)	UNKNOWN STEP	2026-09-27T10:51:20.6513588Z    - tk==8.6.13=noxft_h1df4ec4_4
OS (ubuntu)	UNKNOWN STEP	2026-09-27T10:51:20.6514071Z    - cpp-expected==1.3.1=h171cf75_1
OS (ubuntu)	UNKNOWN STEP	2026-09-27T10:51:20.6514552Z    - fmt==12.1.0=h76c4fd7_1
OS (ubuntu)	UNKNOWN STEP	2026-09-27T10:51:20.6514992Z    - icu==78.3=py310h44b86e0_2
OS (ubuntu)	UNKNOWN STEP	2026-09-27T10:51:20.6515458Z    - libedit==3.1.20250104=pl5321h373387f_1
OS (ubuntu)	UNKNOWN STEP	2026-09-27T10:51:20.6515961Z    - libmsgpack-c==6.1.0=h54a6638_7
OS (ubuntu)	UNKNOWN STEP	2026-09-27T10:51:20.6516449Z    - libnghttp2==1.68.1=h74cf4be_1
OS (ubuntu)	UNKNOWN STEP	2026-09-27T10:51:20.6516943Z    - libpython==3.14.7=hdc7f604_106_cp314
OS (ubuntu)	UNKNOWN STEP	2026-09-27T10:51:20.6517653Z    - libsolv==0.7.39=h72ddc62_1
OS (ubuntu)	UNKNOWN STEP	2026-09-27T10:51:20.6518116Z    - libssh2==1.11.1=h6154650_1
OS (ubuntu)	UNKNOWN STEP	2026-09-27T10:51:20.6518579Z    - lz4-c==1.10.0=hee9eb32_2
OS (ubuntu)	UNKNOWN STEP	2026-09-27T10:51:20.6519046Z    - readline==8.3=hd6e31c0_1
OS (ubuntu)	UNKNOWN STEP	2026-09-27T10:51:20.6519510Z    - reproc-cpp==14.2.8.post0=h1c70be6_0
OS (ubuntu)	UNKNOWN STEP	2026-09-27T10:51:20.6520020Z    - simdjson==4.6.11=h4dbf13b_0
OS (ubuntu)	UNKNOWN STEP	2026-09-27T10:51:20.6520502Z    - yaml-cpp==0.8.0=h54a6638_1
OS (ubuntu)	UNKNOWN STEP	2026-09-27T10:51:20.6520974Z    - krb5==1.22.2=hbc21106_2
OS (ubuntu)	UNKNOWN STEP	2026-09-27T10:51:20.6521426Z    - libpsl==0.23.1=hd9e3e90_1
OS (ubuntu)	UNKNOWN STEP	2026-09-27T10:51:20.6521890Z    - libsqlite==3.53.4=h13e7031_1
OS (ubuntu)	UNKNOWN STEP	2026-09-27T10:51:20.6522370Z    - libxml2-16==2.15.4=hf3af7cc_0
OS (ubuntu)	UNKNOWN STEP	2026-09-27T10:51:20.6522837Z    - spdlog==1.17.0=hb6aa676_2
OS (ubuntu)	UNKNOWN STEP	2026-09-27T10:51:20.6523284Z    - libcurl==8.22.0=ha042cf0_0
OS (ubuntu)	UNKNOWN STEP	2026-09-27T10:51:20.6523728Z    - libxml2==2.15.4=h7df9aa5_0
OS (ubuntu)	UNKNOWN STEP	2026-09-27T10:51:20.6524196Z    - python==3.14.7=hcd007b5_106_cp314
OS (ubuntu)	UNKNOWN STEP	2026-09-27T10:51:20.6524709Z    - libarchive==3.8.9=gpl_h3152399_101
OS (ubuntu)	UNKNOWN STEP	2026-09-27T10:51:20.6525215Z    - tomli-w==1.2.0=pyhd8ed1ab_0
OS (ubuntu)	UNKNOWN STEP	2026-09-27T10:51:20.6525694Z    - libmamba==2.9.0=py314h6ba947b_0
OS (ubuntu)	UNKNOWN STEP	2026-09-27T10:51:20.6526180Z    - menuinst==2.5.2=py314h9e666f3_2
OS (ubuntu)	UNKNOWN STEP	2026-09-27T10:51:20.6526671Z    - archspec==0.2.5=pyhd8ed1ab_0
OS (ubuntu)	UNKNOWN STEP	2026-09-27T10:51:20.6527168Z    - backports.zstd==1.7.0=py314h680f03e_1
OS (ubuntu)	UNKNOWN STEP	2026-09-27T10:51:20.6527996Z    - boltons==26.2.0=pyhd8ed1ab_0
OS (ubuntu)	UNKNOWN STEP	2026-09-27T10:51:20.6528474Z    - brotli-python==1.2.0=py314hcd2bdb6_4
OS (ubuntu)	UNKNOWN STEP	2026-09-27T10:51:20.6529009Z    - cached_property==2.0.1=pyhcf101f3_0
OS (ubuntu)	UNKNOWN STEP	2026-09-27T10:51:20.6529520Z    - certifi==2026.7.22=pyhd8ed1ab_0
OS (ubuntu)	UNKNOWN STEP	2026-09-27T10:51:20.6530036Z    - charset-normalizer==3.5.1=pyhd8ed1ab_0
OS (ubuntu)	UNKNOWN STEP	2026-09-27T10:51:20.6530730Z    - colorama==0.4.6=pyhd8ed1ab_1
OS (ubuntu)	UNKNOWN STEP	2026-09-27T10:51:20.6531375Z    - cpython==3.14.7=py314hd8ed1ab_106
OS (ubuntu)	UNKNOWN STEP	2026-09-27T10:51:20.6531929Z    - distro==1.9.0=pyhd8ed1ab_1
OS (ubuntu)	UNKNOWN STEP	2026-09-27T10:51:20.6532388Z    - frozendict==2.4.7=pyh851646a_2
OS (ubuntu)	UNKNOWN STEP	2026-09-27T10:51:20.6532880Z    - hpack==4.2.0=pyhd8ed1ab_0
OS (ubuntu)	UNKNOWN STEP	2026-09-27T10:51:20.6533359Z    - hyperframe==6.1.0=pyhd8ed1ab_0
OS (ubuntu)	UNKNOWN STEP	2026-09-27T10:51:20.6533849Z    - idna==3.19=pyhcf101f3_0
OS (ubuntu)	UNKNOWN STEP	2026-09-27T10:51:20.6534319Z    - libmamba-spdlog==2.9.0=h5efa3ab_0
OS (ubuntu)	UNKNOWN STEP	2026-09-27T10:51:20.6534803Z    - mamba==2.9.0=h9649d4f_0
OS (ubuntu)	UNKNOWN STEP	2026-09-27T10:51:20.6535444Z    - markupsafe==3.0.3=py314h67df5f8_1
OS (ubuntu)	UNKNOWN STEP	2026-09-27T10:51:20.6535945Z    - msgpack-python==1.2.2=py314h5383ef5_2
OS (ubuntu)	UNKNOWN STEP	2026-09-27T10:51:20.6536580Z    - packaging==26.3=pyhc364b38_0
OS (ubuntu)	UNKNOWN STEP	2026-09-27T10:51:20.6537067Z    - pip==26.2.1=pyh145f28c_0
OS (ubuntu)	UNKNOWN STEP	2026-09-27T10:51:20.6537700Z    - platformdirs==4.11.6=pyh5ded981_0
OS (ubuntu)	UNKNOWN STEP	2026-09-27T10:51:20.6538201Z    - pluggy==1.6.0=pyhf9edf01_1
OS (ubuntu)	UNKNOWN STEP	2026-09-27T10:51:20.6538695Z    - pycosat==0.6.6=py314h89acca1_5
OS (ubuntu)	UNKNOWN STEP	2026-09-27T10:51:20.6539176Z    - pysocks==1.7.1=pyha55dd90_7
OS (ubuntu)	UNKNOWN STEP	2026-09-27T10:51:20.6539658Z    - python-installer==1.0.1=pyh332efcf_0
OS (ubuntu)	UNKNOWN STEP	2026-09-27T10:51:20.6540185Z    - ruamel.yaml.clib==0.2.15=py314hfe1a184_5
OS (ubuntu)	UNKNOWN STEP	2026-09-27T10:51:20.6540710Z    - setuptools==84.0.0=pyh332efcf_0
OS (ubuntu)	UNKNOWN STEP	2026-09-27T10:51:20.6541197Z    - sniffio==1.3.1=pyhd8ed1ab_2
OS (ubuntu)	UNKNOWN STEP	2026-09-27T10:51:20.6541669Z    - tomli==2.4.1=pyhcf101f3_0
OS (ubuntu)	UNKNOWN STEP	2026-09-27T10:51:20.6542124Z    - tqdm==4.70.0=pyh8f84b5b_0
OS (ubuntu)	UNKNOWN STEP	2026-09-27T10:51:20.6542586Z    - truststore==0.10.4=pyhcf101f3_0
OS (ubuntu)	UNKNOWN STEP	2026-09-27T10:51:20.6543090Z    - typing_extensions==4.16.0=pyhcf101f3_0
OS (ubuntu)	UNKNOWN STEP	2026-09-27T10:51:20.6543609Z    - zipp==4.1.0=pyhcf101f3_0
OS (ubuntu)	UNKNOWN STEP	2026-09-27T10:51:20.6544068Z    - anyio==4.15.1=pyh5ded981_1
OS (ubuntu)	UNKNOWN STEP	2026-09-27T10:51:20.6544555Z    - cached-property==2.0.1=pyhcf101f3_0
OS (ubuntu)	UNKNOWN STEP	2026-09-27T10:51:20.6545112Z    - conda-package-streaming==0.13.0=pyhd8ed1ab_0
OS (ubuntu)	UNKNOWN STEP	2026-09-27T10:51:20.6545647Z    - h11==0.16.0=pyhcf101f3_1
OS (ubuntu)	UNKNOWN STEP	2026-09-27T10:51:20.6546101Z    - h2==4.4.1=pyhcf101f3_0
OS (ubuntu)	UNKNOWN STEP	2026-09-27T10:51:20.6546564Z    - importlib-metadata==9.0.1=pyhcf101f3_0
OS (ubuntu)	UNKNOWN STEP	2026-09-27T10:51:20.6547068Z    - jinja2==3.1.6=pyhcf101f3_1
OS (ubuntu)	UNKNOWN STEP	2026-09-27T10:51:20.6547736Z    - libmambapy==2.9.0=py314h959206d_0
OS (ubuntu)	UNKNOWN STEP	2026-09-27T10:51:20.6548271Z    - pyproject_hooks==1.2.0=pyhd8ed1ab_1
OS (ubuntu)	UNKNOWN STEP	2026-09-27T10:51:20.6548782Z    - python-gil==3.14.7=h4df99d1_106
OS (ubuntu)	UNKNOWN STEP	2026-09-27T10:51:20.6549278Z    - ruamel.yaml==0.19.1=pyhcf101f3_0
OS (ubuntu)	UNKNOWN STEP	2026-09-27T10:51:20.6549781Z    - typing-extensions==4.16.0=h69aa097_0
OS (ubuntu)	UNKNOWN STEP	2026-09-27T10:51:20.6550305Z    - typing-inspection==0.4.4=pyhcf101f3_0
OS (ubuntu)	UNKNOWN STEP	2026-09-27T10:51:20.6550837Z    - _python_abi3_support==1.0=hd8ed1ab_3
OS (ubuntu)	UNKNOWN STEP	2026-09-27T10:51:20.6551369Z    - annotated-types==0.8.0=pyhd8ed1ab_0
OS (ubuntu)	UNKNOWN STEP	2026-09-27T10:51:20.6551910Z    - conda-libmamba-solver==26.7.0=pyhcf101f3_0
OS (ubuntu)	UNKNOWN STEP	2026-09-27T10:51:20.6552440Z    - httpcore==1.0.9=pyh29332c3_0
OS (ubuntu)	UNKNOWN STEP	2026-09-27T10:51:20.6552925Z    - pydantic-core==2.46.5=py314h7e8cd81_1
OS (ubuntu)	UNKNOWN STEP	2026-09-27T10:51:20.6553426Z    - python-build==1.6.0=pyhc364b38_0
OS (ubuntu)	UNKNOWN STEP	2026-09-27T10:51:20.6553921Z    - urllib3==2.7.0=pyhd8ed1ab_0
OS (ubuntu)	UNKNOWN STEP	2026-09-27T10:51:20.6554396Z    - httpx==0.28.1=pyhd8ed1ab_0
OS (ubuntu)	UNKNOWN STEP	2026-09-27T10:51:20.6554877Z    - py-rattler==0.25.0=py310hefeb9ab_5
OS (ubuntu)	UNKNOWN STEP	2026-09-27T10:51:20.6555400Z    - pydantic==2.13.5=pyhcf101f3_0
OS (ubuntu)	UNKNOWN STEP	2026-09-27T10:51:20.6555887Z    - requests==2.34.2=pyhcf101f3_0
OS (ubuntu)	UNKNOWN STEP	2026-09-27T10:51:20.6556389Z    - conda-package-handling==2.6.0=pyh5ded981_0
OS (ubuntu)	UNKNOWN STEP	2026-09-27T10:51:20.6556897Z    - unearth==0.18.3=pyhd8ed1ab_0
OS (ubuntu)	UNKNOWN STEP	2026-09-27T10:51:20.6557516Z    - conda-index==0.13.0=pyh5ded981_0
OS (ubuntu)	UNKNOWN STEP	2026-09-27T10:51:20.6558020Z    - conda-pypi==0.11.0=pyh5ded981_2
OS (ubuntu)	UNKNOWN STEP	2026-09-27T10:51:20.6558523Z    - conda-lockfiles==0.2.1=pyhd8ed1ab_0
OS (ubuntu)	UNKNOWN STEP	2026-09-27T10:51:20.6559073Z    - conda-rattler-solver==0.1.1=pyhcf101f3_0
OS (ubuntu)	UNKNOWN STEP	2026-09-27T10:51:20.6559600Z    - conda==26.7.2=py314h9e666f3_1
OS (ubuntu)	UNKNOWN STEP	2026-09-27T10:51:20.6560145Z    - conda-self==0.2.1=pyhd8ed1ab_0
OS (ubuntu)	UNKNOWN STEP	2026-09-27T10:51:20.6560496Z 
OS (ubuntu)	UNKNOWN STEP	2026-09-27T10:51:20.6560660Z 
OS (ubuntu)	UNKNOWN STEP	2026-09-27T10:51:20.6561045Z   Package                         Version  Build                 Channel         Size
OS (ubuntu)	UNKNOWN STEP	2026-09-27T10:51:20.6562174Z ───────────────────────────────────────────────────────────────────────────────────────
OS (ubuntu)	UNKNOWN STEP	2026-09-27T10:51:20.6562805Z   Install:
OS (ubuntu)	UNKNOWN STEP	2026-09-27T10:51:20.6563453Z ───────────────────────────────────────────────────────────────────────────────────────
OS (ubuntu)	UNKNOWN STEP	2026-09-27T10:51:20.6563955Z 
OS (ubuntu)	UNKNOWN STEP	2026-09-27T10:51:20.6564348Z   + _openmp_mutex                     4.5  20_gnu                conda-forge         
OS (ubuntu)	UNKNOWN STEP	2026-09-27T10:51:20.6565225Z   + _python_abi3_support              1.0  hd8ed1ab_3            conda-forge         
OS (ubuntu)	UNKNOWN STEP	2026-09-27T10:51:20.6566043Z   + annotated-types                 0.8.0  pyhd8ed1ab_0          conda-forge         
OS (ubuntu)	UNKNOWN STEP	2026-09-27T10:51:20.6566956Z   + anyio                          4.15.1  pyh5ded981_1          conda-forge         
OS (ubuntu)	UNKNOWN STEP	2026-09-27T10:51:20.6567941Z   + archspec                        0.2.5  pyhd8ed1ab_0          conda-forge         
OS (ubuntu)	UNKNOWN STEP	2026-09-27T10:51:20.6568677Z   + backports.zstd                  1.7.0  py314h680f03e_1       conda-forge         
OS (ubuntu)	UNKNOWN STEP	2026-09-27T10:51:20.6569396Z   + boltons                        26.2.0  pyhd8ed1ab_0          conda-forge         
OS (ubuntu)	UNKNOWN STEP	2026-09-27T10:51:20.6570129Z   + brotli-python                   1.2.0  py314hcd2bdb6_4       conda-forge         
OS (ubuntu)	UNKNOWN STEP	2026-09-27T10:51:20.6570830Z   + bzip2                           1.0.8  hda65f42_10           conda-forge         
OS (ubuntu)	UNKNOWN STEP	2026-09-27T10:51:20.6571496Z   + c-ares                         1.34.8  hebe6cf0_2            conda-forge         
OS (ubuntu)	UNKNOWN STEP	2026-09-27T10:51:20.6572186Z   + ca-certificates             2026.7.22  hbd8a1cb_0            conda-forge         
OS (ubuntu)	UNKNOWN STEP	2026-09-27T10:51:20.6572959Z   + cached-property                 2.0.1  pyhcf101f3_0          conda-forge         
OS (ubuntu)	UNKNOWN STEP	2026-09-27T10:51:20.6573714Z   + cached_property                 2.0.1  pyhcf101f3_0          conda-forge         
OS (ubuntu)	UNKNOWN STEP	2026-09-27T10:51:20.6574460Z   + certifi                     2026.7.22  pyhd8ed1ab_0          conda-forge         
OS (ubuntu)	UNKNOWN STEP	2026-09-27T10:51:20.6575208Z   + charset-normalizer              3.5.1  pyhd8ed1ab_0          conda-forge         
OS (ubuntu)	UNKNOWN STEP	2026-09-27T10:51:20.6575919Z   + colorama                        0.4.6  pyhd8ed1ab_1          conda-forge         
OS (ubuntu)	UNKNOWN STEP	2026-09-27T10:51:20.6576604Z   + conda                          26.7.2  py314h9e666f3_1       conda-forge         
OS (ubuntu)	UNKNOWN STEP	2026-09-27T10:51:20.6577556Z   + conda-index                    0.13.0  pyh5ded981_0          conda-forge         
OS (ubuntu)	UNKNOWN STEP	2026-09-27T10:51:20.6578332Z   + conda-libmamba-solver          26.7.0  pyhcf101f3_0          conda-forge         
OS (ubuntu)	UNKNOWN STEP	2026-09-27T10:51:20.6579110Z   + conda-lockfiles                 0.2.1  pyhd8ed1ab_0          conda-forge         
OS (ubuntu)	UNKNOWN STEP	2026-09-27T10:51:20.6579860Z   + conda-package-handling          2.6.0  pyh5ded981_0          conda-forge         
OS (ubuntu)	UNKNOWN STEP	2026-09-27T10:51:20.6580684Z   + conda-package-streaming        0.13.0  pyhd8ed1ab_0          conda-forge         
OS (ubuntu)	UNKNOWN STEP	2026-09-27T10:51:20.6581457Z   + conda-pypi                     0.11.0  pyh5ded981_2          conda-forge         
OS (ubuntu)	UNKNOWN STEP	2026-09-27T10:51:20.6582209Z   + conda-rattler-solver            0.1.1  pyhcf101f3_0          conda-forge         
OS (ubuntu)	UNKNOWN STEP	2026-09-27T10:51:20.6582957Z   + conda-self                      0.2.1  pyhd8ed1ab_0          conda-forge         
OS (ubuntu)	UNKNOWN STEP	2026-09-27T10:51:20.6583652Z   + cpp-expected                    1.3.1  h171cf75_1            conda-forge         
OS (ubuntu)	UNKNOWN STEP	2026-09-27T10:51:20.6584357Z   + cpython                        3.14.7  py314hd8ed1ab_106     conda-forge         
OS (ubuntu)	UNKNOWN STEP	2026-09-27T10:51:20.6585046Z   + distro                          1.9.0  pyhd8ed1ab_1          conda-forge         
OS (ubuntu)	UNKNOWN STEP	2026-09-27T10:51:20.6585729Z   + fmt                            12.1.0  h76c4fd7_1            conda-forge         
OS (ubuntu)	UNKNOWN STEP	2026-09-27T10:51:20.6586435Z   + frozendict                      2.4.7  pyh851646a_2          conda-forge         
OS (ubuntu)	UNKNOWN STEP	2026-09-27T10:51:20.6587121Z   + h11                            0.16.0  pyhcf101f3_1          conda-forge         
OS (ubuntu)	UNKNOWN STEP	2026-09-27T10:51:20.6587932Z   + h2                              4.4.1  pyhcf101f3_0          conda-forge         
OS (ubuntu)	UNKNOWN STEP	2026-09-27T10:51:20.6588594Z   + hpack                           4.2.0  pyhd8ed1ab_0          conda-forge         
OS (ubuntu)	UNKNOWN STEP	2026-09-27T10:51:20.6589285Z   + httpcore                        1.0.9  pyh29332c3_0          conda-forge         
OS (ubuntu)	UNKNOWN STEP	2026-09-27T10:51:20.6589986Z   + httpx                          0.28.1  pyhd8ed1ab_0          conda-forge         
OS (ubuntu)	UNKNOWN STEP	2026-09-27T10:51:20.6590709Z   + hyperframe                      6.1.0  pyhd8ed1ab_0          conda-forge         
OS (ubuntu)	UNKNOWN STEP	2026-09-27T10:51:20.6591395Z   + icu                              78.3  py310h44b86e0_2       conda-forge         
OS (ubuntu)	UNKNOWN STEP	2026-09-27T10:51:20.6592046Z   + idna                             3.19  pyhcf101f3_0          conda-forge         
OS (ubuntu)	UNKNOWN STEP	2026-09-27T10:51:20.6592764Z   + importlib-metadata              9.0.1  pyhcf101f3_0          conda-forge         
OS (ubuntu)	UNKNOWN STEP	2026-09-27T10:51:20.6593696Z   + jinja2                          3.1.6  pyhcf101f3_1          conda-forge         
OS (ubuntu)	UNKNOWN STEP	2026-09-27T10:51:20.6594502Z   + keyutils                        1.6.3  h7cc23a3_1            conda-forge         
OS (ubuntu)	UNKNOWN STEP	2026-09-27T10:51:20.6595179Z   + krb5                           1.22.2  hbc21106_2            conda-forge         
OS (ubuntu)	UNKNOWN STEP	2026-09-27T10:51:20.6595860Z   + ld_impl_linux-64               2.46.1  default_hbd61a6d_102  conda-forge         
OS (ubuntu)	UNKNOWN STEP	2026-09-27T10:51:20.6596585Z   + libarchive                      3.8.9  gpl_h3152399_101      conda-forge         
OS (ubuntu)	UNKNOWN STEP	2026-09-27T10:51:20.6597287Z   + libcurl                        8.22.0  ha042cf0_0            conda-forge         
OS (ubuntu)	UNKNOWN STEP	2026-09-27T10:51:20.6599888Z   + libedit                  3.1.20250104  pl5321h373387f_1      conda-forge         
OS (ubuntu)	UNKNOWN STEP	2026-09-27T10:51:20.6600719Z   + libev                            4.33  h280c20c_3            conda-forge         
OS (ubuntu)	UNKNOWN STEP	2026-09-27T10:51:20.6603098Z   + libexpat                        2.8.1  hecca717_1            conda-forge         
OS (ubuntu)	UNKNOWN STEP	2026-09-27T10:51:20.6603634Z   + libffi                          3.7.0  h81df57d_1            conda-forge         
OS (ubuntu)	UNKNOWN STEP	2026-09-27T10:51:20.6604170Z   + libgcc                         16.2.0  ha9f2e26_4            conda-forge         
OS (ubuntu)	UNKNOWN STEP	2026-09-27T10:51:20.6604698Z   + libgomp                        16.2.0  he0feb66_4            conda-forge         
OS (ubuntu)	UNKNOWN STEP	2026-09-27T10:51:20.6605226Z   + libiconv                         1.18  h0cb94f2_3            conda-forge         
OS (ubuntu)	UNKNOWN STEP	2026-09-27T10:51:20.6605756Z   + liblzma                         5.8.3  hb03c661_1            conda-forge         
OS (ubuntu)	UNKNOWN STEP	2026-09-27T10:51:20.6606291Z   + libmamba                        2.9.0  py314h6ba947b_0       conda-forge         
OS (ubuntu)	UNKNOWN STEP	2026-09-27T10:51:20.6606857Z   + libmamba-spdlog                 2.9.0  h5efa3ab_0            conda-forge         
OS (ubuntu)	UNKNOWN STEP	2026-09-27T10:51:20.6607566Z   + libmambapy                      2.9.0  py314h959206d_0       conda-forge         
OS (ubuntu)	UNKNOWN STEP	2026-09-27T10:51:20.6608114Z   + libmpdec                        4.0.0  hb03c661_2            conda-forge         
OS (ubuntu)	UNKNOWN STEP	2026-09-27T10:51:20.6608672Z   + libmsgpack-c                    6.1.0  h54a6638_7            conda-forge         
OS (ubuntu)	UNKNOWN STEP	2026-09-27T10:51:20.6609228Z   + libnghttp2                     1.68.1  h74cf4be_1            conda-forge         
OS (ubuntu)	UNKNOWN STEP	2026-09-27T10:51:20.6609775Z   + libpsl                         0.23.1  hd9e3e90_1            conda-forge         
OS (ubuntu)	UNKNOWN STEP	2026-09-27T10:51:20.6610324Z   + libpython                      3.14.7  hdc7f604_106_cp314    conda-forge         
OS (ubuntu)	UNKNOWN STEP	2026-09-27T10:51:20.6610864Z   + libsolv                        0.7.39  h72ddc62_1            conda-forge         
OS (ubuntu)	UNKNOWN STEP	2026-09-27T10:51:20.6611375Z   + libsqlite                      3.53.4  h13e7031_1            conda-forge         
OS (ubuntu)	UNKNOWN STEP	2026-09-27T10:51:20.6611903Z   + libssh2                        1.11.1  h6154650_1            conda-forge         
OS (ubuntu)	UNKNOWN STEP	2026-09-27T10:51:20.6612439Z   + libstdcxx                      16.2.0  h934c35e_4            conda-forge         
OS (ubuntu)	UNKNOWN STEP	2026-09-27T10:51:20.6612966Z   + libuuid                        2.42.3  hcfc3c73_0            conda-forge         
OS (ubuntu)	UNKNOWN STEP	2026-09-27T10:51:20.6613531Z   + libxml2                        2.15.4  h7df9aa5_0            conda-forge         
OS (ubuntu)	UNKNOWN STEP	2026-09-27T10:51:20.6614068Z   + libxml2-16                     2.15.4  hf3af7cc_0            conda-forge         
OS (ubuntu)	UNKNOWN STEP	2026-09-27T10:51:20.6614597Z   + libzlib                         1.3.2  h25fd6f3_3            conda-forge         
OS (ubuntu)	UNKNOWN STEP	2026-09-27T10:51:20.6615110Z   + lz4-c                          1.10.0  hee9eb32_2            conda-forge         
OS (ubuntu)	UNKNOWN STEP	2026-09-27T10:51:20.6615589Z   + lzo                              2.10  hebe6cf0_1003         conda-forge         
OS (ubuntu)	UNKNOWN STEP	2026-09-27T10:51:20.6616080Z   + mamba                           2.9.0  h9649d4f_0            conda-forge         
OS (ubuntu)	UNKNOWN STEP	2026-09-27T10:51:20.6616620Z   + markupsafe                      3.0.3  py314h67df5f8_1       conda-forge         
OS (ubuntu)	UNKNOWN STEP	2026-09-27T10:51:20.6617185Z   + menuinst                        2.5.2  py314h9e666f3_2       conda-forge         
OS (ubuntu)	UNKNOWN STEP	2026-09-27T10:51:20.6618039Z   + msgpack-python                  1.2.2  py314h5383ef5_2       conda-forge         
OS (ubuntu)	UNKNOWN STEP	2026-09-27T10:51:20.6618711Z   + ncurses                           6.6  hdb14827_1            conda-forge         
OS (ubuntu)	UNKNOWN STEP	2026-09-27T10:51:20.6619273Z   + nlohmann_json-abi              3.12.0  h0f90c79_2            conda-forge         
OS (ubuntu)	UNKNOWN STEP	2026-09-27T10:51:20.6619798Z   + openssl                         3.6.4  h781a0a9_0            conda-forge         
OS (ubuntu)	UNKNOWN STEP	2026-09-27T10:51:20.6620333Z   + packaging                        26.3  pyhc364b38_0          conda-forge         
OS (ubuntu)	UNKNOWN STEP	2026-09-27T10:51:20.6620865Z   + pip                            26.2.1  pyh145f28c_0          conda-forge         
OS (ubuntu)	UNKNOWN STEP	2026-09-27T10:51:20.6621411Z   + platformdirs                   4.11.6  pyh5ded981_0          conda-forge         
OS (ubuntu)	UNKNOWN STEP	2026-09-27T10:51:20.6621986Z   + pluggy                          1.6.0  pyhf9edf01_1          conda-forge         
OS (ubuntu)	UNKNOWN STEP	2026-09-27T10:51:20.6622536Z   + py-rattler                     0.25.0  py310hefeb9ab_5       conda-forge         
OS (ubuntu)	UNKNOWN STEP	2026-09-27T10:51:20.6623100Z   + pybind11-abi                       11  hc364b38_1            conda-forge         
OS (ubuntu)	UNKNOWN STEP	2026-09-27T10:51:20.6623653Z   + pycosat                         0.6.6  py314h89acca1_5       conda-forge         
OS (ubuntu)	UNKNOWN STEP	2026-09-27T10:51:20.6624162Z   + pydantic                       2.13.5  pyhcf101f3_0          conda-forge         
OS (ubuntu)	UNKNOWN STEP	2026-09-27T10:51:20.6624739Z   + pydantic-core                  2.46.5  py314h7e8cd81_1       conda-forge         
OS (ubuntu)	UNKNOWN STEP	2026-09-27T10:51:20.6625345Z   + pyproject_hooks                 1.2.0  pyhd8ed1ab_1          conda-forge         
OS (ubuntu)	UNKNOWN STEP	2026-09-27T10:51:20.6625920Z   + pysocks                         1.7.1  pyha55dd90_7          conda-forge         
OS (ubuntu)	UNKNOWN STEP	2026-09-27T10:51:20.6626452Z   + python                         3.14.7  hcd007b5_106_cp314    conda-forge         
OS (ubuntu)	UNKNOWN STEP	2026-09-27T10:51:20.6626998Z   + python-build                    1.6.0  pyhc364b38_0          conda-forge         
OS (ubuntu)	UNKNOWN STEP	2026-09-27T10:51:20.6627657Z   + python-gil                     3.14.7  h4df99d1_106          conda-forge         
OS (ubuntu)	UNKNOWN STEP	2026-09-27T10:51:20.6628324Z   + python-installer                1.0.1  pyh332efcf_0          conda-forge         
OS (ubuntu)	UNKNOWN STEP	2026-09-27T10:51:20.6628908Z   + python_abi                       3.14  9_cp314               conda-forge         
OS (ubuntu)	UNKNOWN STEP	2026-09-27T10:51:20.6629446Z   + readline                          8.3  hd6e31c0_1            conda-forge         
OS (ubuntu)	UNKNOWN STEP	2026-09-27T10:51:20.6629988Z   + reproc                   14.2.8.post0  hee9eb32_0            conda-forge         
OS (ubuntu)	UNKNOWN STEP	2026-09-27T10:51:20.6630555Z   + reproc-cpp               14.2.8.post0  h1c70be6_0            conda-forge         
OS (ubuntu)	UNKNOWN STEP	2026-09-27T10:51:20.6631114Z   + requests                       2.34.2  pyhcf101f3_0          conda-forge         
OS (ubuntu)	UNKNOWN STEP	2026-09-27T10:51:20.6631634Z   + ruamel.yaml                    0.19.1  pyhcf101f3_0          conda-forge         
OS (ubuntu)	UNKNOWN STEP	2026-09-27T10:51:20.6632200Z   + ruamel.yaml.clib               0.2.15  py314hfe1a184_5       conda-forge         
OS (ubuntu)	UNKNOWN STEP	2026-09-27T10:51:20.6632775Z   + setuptools                     84.0.0  pyh332efcf_0          conda-forge         
OS (ubuntu)	UNKNOWN STEP	2026-09-27T10:51:20.6633333Z   + simdjson                       4.6.11  h4dbf13b_0            conda-forge         
OS (ubuntu)	UNKNOWN STEP	2026-09-27T10:51:20.6633882Z   + sniffio                         1.3.1  pyhd8ed1ab_2          conda-forge         
OS (ubuntu)	UNKNOWN STEP	2026-09-27T10:51:20.6634428Z   + spdlog                         1.17.0  hb6aa676_2            conda-forge         
OS (ubuntu)	UNKNOWN STEP	2026-09-27T10:51:20.6634954Z   + tk                             8.6.13  noxft_h1df4ec4_4      conda-forge         
OS (ubuntu)	UNKNOWN STEP	2026-09-27T10:51:20.6635467Z   + tomli                           2.4.1  pyhcf101f3_0          conda-forge         
OS (ubuntu)	UNKNOWN STEP	2026-09-27T10:51:20.6635998Z   + tomli-w                         1.2.0  pyhd8ed1ab_0          conda-forge         
OS (ubuntu)	UNKNOWN STEP	2026-09-27T10:51:20.6636493Z   + tqdm                           4.70.0  pyh8f84b5b_0          conda-forge         
OS (ubuntu)	UNKNOWN STEP	2026-09-27T10:51:20.6637024Z   + truststore                     0.10.4  pyhcf101f3_0          conda-forge         
OS (ubuntu)	UNKNOWN STEP	2026-09-27T10:51:20.6637750Z   + typing-extensions              4.16.0  h69aa097_0            conda-forge         
OS (ubuntu)	UNKNOWN STEP	2026-09-27T10:51:20.6638524Z   + typing-inspection               0.4.4  pyhcf101f3_0          conda-forge         
OS (ubuntu)	UNKNOWN STEP	2026-09-27T10:51:20.6639249Z   + typing_extensions              4.16.0  pyhcf101f3_0          conda-forge         
OS (ubuntu)	UNKNOWN STEP	2026-09-27T10:51:20.6639820Z   + tzdata                          2026c  h151e31d_0            conda-forge         
OS (ubuntu)	UNKNOWN STEP	2026-09-27T10:51:20.6640351Z   + unearth                        0.18.3  pyhd8ed1ab_0          conda-forge         
OS (ubuntu)	UNKNOWN STEP	2026-09-27T10:51:20.6640874Z   + urllib3                         2.7.0  pyhd8ed1ab_0          conda-forge         
OS (ubuntu)	UNKNOWN STEP	2026-09-27T10:51:20.6641387Z   + yaml-cpp                        0.8.0  h54a6638_1            conda-forge         
OS (ubuntu)	UNKNOWN STEP	2026-09-27T10:51:20.6641903Z   + zipp                            4.1.0  pyhcf101f3_0          conda-forge         
OS (ubuntu)	UNKNOWN STEP	2026-09-27T10:51:20.6642407Z   + zstd                            1.5.7  hb78ec9c_7            conda-forge         
OS (ubuntu)	UNKNOWN STEP	2026-09-27T10:51:20.6642734Z 
OS (ubuntu)	UNKNOWN STEP	2026-09-27T10:51:20.6642842Z   Summary:
OS (ubuntu)	UNKNOWN STEP	2026-09-27T10:51:20.6642984Z 
OS (ubuntu)	UNKNOWN STEP	2026-09-27T10:51:20.6643102Z   Install: 118 packages
OS (ubuntu)	UNKNOWN STEP	2026-09-27T10:51:20.6643279Z 
OS (ubuntu)	UNKNOWN STEP	2026-09-27T10:51:20.6643394Z   Total download: 0 B
OS (ubuntu)	UNKNOWN STEP	2026-09-27T10:51:20.6643563Z 
OS (ubuntu)	UNKNOWN STEP	2026-09-27T10:51:20.6643999Z ───────────────────────────────────────────────────────────────────────────────────────
OS (ubuntu)	UNKNOWN STEP	2026-09-27T10:51:20.6644368Z 
OS (ubuntu)	UNKNOWN STEP	2026-09-27T10:51:20.6644372Z 
OS (ubuntu)	UNKNOWN STEP	2026-09-27T10:51:20.6666596Z ##[warning]warning  libmamba Security Warning: This transaction includes executing package scripts (pre/post-link/unlink) if present. These scripts can contain arbitrary code. Please ensure you trust the package sources.
OS (ubuntu)	UNKNOWN STEP	
OS (ubuntu)	UNKNOWN STEP	2026-09-27T10:51:20.6676072Z warning  libmamba Security Warning: This transaction includes executing package scripts (pre/post-link/unlink) if present. These scripts can contain arbitrary code. Please ensure you trust the package sources.
OS (ubuntu)	UNKNOWN STEP	2026-09-27T10:51:20.6677103Z 
OS (ubuntu)	UNKNOWN STEP	2026-09-27T10:51:20.6677216Z Transaction starting
OS (ubuntu)	UNKNOWN STEP	2026-09-27T10:51:20.6933062Z Linking ca-certificates-2026.7.22-hbd8a1cb_0
OS (ubuntu)	UNKNOWN STEP	2026-09-27T10:51:20.6940035Z Linking libgomp-16.2.0-he0feb66_4
OS (ubuntu)	UNKNOWN STEP	2026-09-27T10:51:20.6947582Z Linking libzlib-1.3.2-h25fd6f3_3
OS (ubuntu)	UNKNOWN STEP	2026-09-27T10:51:20.6953607Z Linking nlohmann_json-abi-3.12.0-h0f90c79_2
OS (ubuntu)	UNKNOWN STEP	2026-09-27T10:51:20.6959447Z Linking pybind11-abi-11-hc364b38_1
OS (ubuntu)	UNKNOWN STEP	2026-09-27T10:51:20.6967129Z Linking python_abi-3.14-9_cp314
OS (ubuntu)	UNKNOWN STEP	2026-09-27T10:51:20.6972155Z Linking tzdata-2026c-h151e31d_0
OS (ubuntu)	UNKNOWN STEP	2026-09-27T10:51:20.7187178Z Linking _openmp_mutex-4.5-20_gnu
OS (ubuntu)	UNKNOWN STEP	2026-09-27T10:51:20.7208848Z Linking zstd-1.5.7-hb78ec9c_7
OS (ubuntu)	UNKNOWN STEP	2026-09-27T10:51:20.7223086Z Linking ld_impl_linux-64-2.46.1-default_hbd61a6d_102
OS (ubuntu)	UNKNOWN STEP	2026-09-27T10:51:20.7311892Z Linking libgcc-16.2.0-ha9f2e26_4
OS (ubuntu)	UNKNOWN STEP	2026-09-27T10:51:20.7323526Z Linking bzip2-1.0.8-hda65f42_10
OS (ubuntu)	UNKNOWN STEP	2026-09-27T10:51:20.7338097Z Linking c-ares-1.34.8-hebe6cf0_2
OS (ubuntu)	UNKNOWN STEP	2026-09-27T10:51:20.7405858Z Linking keyutils-1.6.3-h7cc23a3_1
OS (ubuntu)	UNKNOWN STEP	2026-09-27T10:51:20.7439130Z Linking libev-4.33-h280c20c_3
OS (ubuntu)	UNKNOWN STEP	2026-09-27T10:51:20.7446187Z Linking libexpat-2.8.1-hecca717_1
OS (ubuntu)	UNKNOWN STEP	2026-09-27T10:51:20.7452543Z Linking libffi-3.7.0-h81df57d_1
OS (ubuntu)	UNKNOWN STEP	2026-09-27T10:51:20.7462744Z Linking libiconv-1.18-h0cb94f2_3
OS (ubuntu)	UNKNOWN STEP	2026-09-27T10:51:20.7503790Z Linking liblzma-5.8.3-hb03c661_1
OS (ubuntu)	UNKNOWN STEP	2026-09-27T10:51:20.7509673Z Linking libmpdec-4.0.0-hb03c661_2
OS (ubuntu)	UNKNOWN STEP	2026-09-27T10:51:20.7515801Z Linking libstdcxx-16.2.0-h934c35e_4
OS (ubuntu)	UNKNOWN STEP	2026-09-27T10:51:20.7523429Z Linking libuuid-2.42.3-hcfc3c73_0
OS (ubuntu)	UNKNOWN STEP	2026-09-27T10:51:20.7533678Z Linking lzo-2.10-hebe6cf0_1003
OS (ubuntu)	UNKNOWN STEP	2026-09-27T10:51:20.7549307Z Linking ncurses-6.6-hdb14827_1
OS (ubuntu)	UNKNOWN STEP	2026-09-27T10:51:21.5778389Z Linking openssl-3.6.4-h781a0a9_0
OS (ubuntu)	UNKNOWN STEP	2026-09-27T10:51:21.5911167Z Linking reproc-14.2.8.post0-hee9eb32_0
OS (ubuntu)	UNKNOWN STEP	2026-09-27T10:51:21.5923964Z Linking tk-8.6.13-noxft_h1df4ec4_4
OS (ubuntu)	UNKNOWN STEP	2026-09-27T10:51:21.6124628Z Linking cpp-expected-1.3.1-h171cf75_1
OS (ubuntu)	UNKNOWN STEP	2026-09-27T10:51:21.6133296Z Linking fmt-12.1.0-h76c4fd7_1
OS (ubuntu)	UNKNOWN STEP	2026-09-27T10:51:21.6147128Z Linking icu-78.3-py310h44b86e0_2
OS (ubuntu)	UNKNOWN STEP	2026-09-27T10:51:21.6269018Z Linking libedit-3.1.20250104-pl5321h373387f_1
OS (ubuntu)	UNKNOWN STEP	2026-09-27T10:51:21.6306503Z Linking libmsgpack-c-6.1.0-h54a6638_7
OS (ubuntu)	UNKNOWN STEP	2026-09-27T10:51:21.6323182Z Linking libnghttp2-1.68.1-h74cf4be_1
OS (ubuntu)	UNKNOWN STEP	2026-09-27T10:51:21.6333293Z Linking libpython-3.14.7-hdc7f604_106_cp314
OS (ubuntu)	UNKNOWN STEP	2026-09-27T10:51:21.6696651Z Linking libsolv-0.7.39-h72ddc62_1
OS (ubuntu)	UNKNOWN STEP	2026-09-27T10:51:21.6723817Z Linking libssh2-1.11.1-h6154650_1
OS (ubuntu)	UNKNOWN STEP	2026-09-27T10:51:21.6813617Z Linking lz4-c-1.10.0-hee9eb32_2
OS (ubuntu)	UNKNOWN STEP	2026-09-27T10:51:21.6828692Z Linking readline-8.3-hd6e31c0_1
OS (ubuntu)	UNKNOWN STEP	2026-09-27T10:51:21.6845705Z Linking reproc-cpp-14.2.8.post0-h1c70be6_0
OS (ubuntu)	UNKNOWN STEP	2026-09-27T10:51:21.6860984Z Linking simdjson-4.6.11-h4dbf13b_0
OS (ubuntu)	UNKNOWN STEP	2026-09-27T10:51:21.6873629Z Linking yaml-cpp-0.8.0-h54a6638_1
OS (ubuntu)	UNKNOWN STEP	2026-09-27T10:51:21.6897981Z Linking krb5-1.22.2-hbc21106_2
OS (ubuntu)	UNKNOWN STEP	2026-09-27T10:51:21.7004577Z Linking libpsl-0.23.1-hd9e3e90_1
OS (ubuntu)	UNKNOWN STEP	2026-09-27T10:51:21.7013011Z Linking libsqlite-3.53.4-h13e7031_1
OS (ubuntu)	UNKNOWN STEP	2026-09-27T10:51:21.7029597Z Linking libxml2-16-2.15.4-hf3af7cc_0
OS (ubuntu)	UNKNOWN STEP	2026-09-27T10:51:21.7047106Z Linking spdlog-1.17.0-hb6aa676_2
OS (ubuntu)	UNKNOWN STEP	2026-09-27T10:51:21.7089223Z Linking libcurl-8.22.0-ha042cf0_0
OS (ubuntu)	UNKNOWN STEP	2026-09-27T10:51:21.7113048Z Linking libxml2-2.15.4-h7df9aa5_0
OS (ubuntu)	UNKNOWN STEP	2026-09-27T10:51:21.7121618Z Linking python-3.14.7-hcd007b5_106_cp314
OS (ubuntu)	UNKNOWN STEP	2026-09-27T10:51:21.8448700Z Linking libarchive-3.8.9-gpl_h3152399_101
OS (ubuntu)	UNKNOWN STEP	2026-09-27T10:51:21.8480187Z Linking tomli-w-1.2.0-pyhd8ed1ab_0
OS (ubuntu)	UNKNOWN STEP	2026-09-27T10:51:21.8528028Z Linking libmamba-2.9.0-py314h6ba947b_0
OS (ubuntu)	UNKNOWN STEP	2026-09-27T10:51:21.8627778Z Linking menuinst-2.5.2-py314h9e666f3_2
OS (ubuntu)	UNKNOWN STEP	2026-09-27T10:51:21.8666674Z Linking archspec-0.2.5-pyhd8ed1ab_0
OS (ubuntu)	UNKNOWN STEP	2026-09-27T10:51:21.8728089Z Linking backports.zstd-1.7.0-py314h680f03e_1
OS (ubuntu)	UNKNOWN STEP	2026-09-27T10:51:21.8747890Z Linking boltons-26.2.0-pyhd8ed1ab_0
OS (ubuntu)	UNKNOWN STEP	2026-09-27T10:51:21.8768438Z Linking brotli-python-1.2.0-py314hcd2bdb6_4
OS (ubuntu)	UNKNOWN STEP	2026-09-27T10:51:21.8788439Z Linking cached_property-2.0.1-pyhcf101f3_0
OS (ubuntu)	UNKNOWN STEP	2026-09-27T10:51:21.8807868Z Linking certifi-2026.7.22-pyhd8ed1ab_0
OS (ubuntu)	UNKNOWN STEP	2026-09-27T10:51:21.8827774Z Linking charset-normalizer-3.5.1-pyhd8ed1ab_0
OS (ubuntu)	UNKNOWN STEP	2026-09-27T10:51:21.8837483Z Linking colorama-0.4.6-pyhd8ed1ab_1
OS (ubuntu)	UNKNOWN STEP	2026-09-27T10:51:21.8866384Z Linking cpython-3.14.7-py314hd8ed1ab_106
OS (ubuntu)	UNKNOWN STEP	2026-09-27T10:51:21.8883549Z Linking distro-1.9.0-pyhd8ed1ab_1
OS (ubuntu)	UNKNOWN STEP	2026-09-27T10:51:21.8907913Z Linking frozendict-2.4.7-pyh851646a_2
OS (ubuntu)	UNKNOWN STEP	2026-09-27T10:51:21.8919330Z Linking hpack-4.2.0-pyhd8ed1ab_0
OS (ubuntu)	UNKNOWN STEP	2026-09-27T10:51:21.8938267Z Linking hyperframe-6.1.0-pyhd8ed1ab_0
OS (ubuntu)	UNKNOWN STEP	2026-09-27T10:51:21.8968463Z Linking idna-3.19-pyhcf101f3_0
OS (ubuntu)	UNKNOWN STEP	2026-09-27T10:51:21.8983433Z Linking libmamba-spdlog-2.9.0-h5efa3ab_0
OS (ubuntu)	UNKNOWN STEP	2026-09-27T10:51:21.8995556Z Linking mamba-2.9.0-h9649d4f_0
OS (ubuntu)	UNKNOWN STEP	2026-09-27T10:51:21.9038605Z Linking markupsafe-3.0.3-py314h67df5f8_1
OS (ubuntu)	UNKNOWN STEP	2026-09-27T10:51:21.9058151Z Linking msgpack-python-1.2.2-py314h5383ef5_2
OS (ubuntu)	UNKNOWN STEP	2026-09-27T10:51:21.9088429Z Linking packaging-26.3-pyhc364b38_0
OS (ubuntu)	UNKNOWN STEP	2026-09-27T10:51:21.9107246Z Linking pip-26.2.1-pyh145f28c_0
OS (ubuntu)	UNKNOWN STEP	2026-09-27T10:51:21.9469154Z Linking platformdirs-4.11.6-pyh5ded981_0
OS (ubuntu)	UNKNOWN STEP	2026-09-27T10:51:21.9487953Z Linking pluggy-1.6.0-pyhf9edf01_1
OS (ubuntu)	UNKNOWN STEP	2026-09-27T10:51:21.9508474Z Linking pycosat-0.6.6-py314h89acca1_5
OS (ubuntu)	UNKNOWN STEP	2026-09-27T10:51:21.9527784Z Linking pysocks-1.7.1-pyha55dd90_7
OS (ubuntu)	UNKNOWN STEP	2026-09-27T10:51:21.9544639Z Linking python-installer-1.0.1-pyh332efcf_0
OS (ubuntu)	UNKNOWN STEP	2026-09-27T10:51:21.9560409Z Linking ruamel.yaml.clib-0.2.15-py314hfe1a184_5
OS (ubuntu)	UNKNOWN STEP	2026-09-27T10:51:21.9561105Z Linking setuptools-84.0.0-pyh332efcf_0
OS (ubuntu)	UNKNOWN STEP	2026-09-27T10:51:21.9817899Z Linking sniffio-1.3.1-pyhd8ed1ab_2
OS (ubuntu)	UNKNOWN STEP	2026-09-27T10:51:21.9837756Z Linking tomli-2.4.1-pyhcf101f3_0
OS (ubuntu)	UNKNOWN STEP	2026-09-27T10:51:21.9858574Z Linking tqdm-4.70.0-pyh8f84b5b_0
OS (ubuntu)	UNKNOWN STEP	2026-09-27T10:51:21.9897794Z Linking truststore-0.10.4-pyhcf101f3_0
OS (ubuntu)	UNKNOWN STEP	2026-09-27T10:51:21.9917836Z Linking typing_extensions-4.16.0-pyhcf101f3_0
OS (ubuntu)	UNKNOWN STEP	2026-09-27T10:51:21.9938361Z Linking zipp-4.1.0-pyhcf101f3_0
OS (ubuntu)	UNKNOWN STEP	2026-09-27T10:51:21.9957886Z Linking anyio-4.15.1-pyh5ded981_1
OS (ubuntu)	UNKNOWN STEP	2026-09-27T10:51:22.0009571Z Linking cached-property-2.0.1-pyhcf101f3_0
OS (ubuntu)	UNKNOWN STEP	2026-09-27T10:51:22.0018563Z Linking conda-package-streaming-0.13.0-pyhd8ed1ab_0
OS (ubuntu)	UNKNOWN STEP	2026-09-27T10:51:22.0052573Z Linking h11-0.16.0-pyhcf101f3_1
OS (ubuntu)	UNKNOWN STEP	2026-09-27T10:51:22.0078531Z Linking h2-4.4.1-pyhcf101f3_0
OS (ubuntu)	UNKNOWN STEP	2026-09-27T10:51:22.0108974Z Linking importlib-metadata-9.0.1-pyhcf101f3_0
OS (ubuntu)	UNKNOWN STEP	2026-09-27T10:51:22.0134165Z Linking jinja2-3.1.6-pyhcf101f3_1
OS (ubuntu)	UNKNOWN STEP	2026-09-27T10:51:22.0178461Z Linking libmambapy-2.9.0-py314h959206d_0
OS (ubuntu)	UNKNOWN STEP	2026-09-27T10:51:22.0230232Z Linking pyproject_hooks-1.2.0-pyhd8ed1ab_1
OS (ubuntu)	UNKNOWN STEP	2026-09-27T10:51:22.0256126Z Linking python-gil-3.14.7-h4df99d1_106
OS (ubuntu)	UNKNOWN STEP	2026-09-27T10:51:22.0277914Z Linking ruamel.yaml-0.19.1-pyhcf101f3_0
OS (ubuntu)	UNKNOWN STEP	2026-09-27T10:51:22.0298679Z Linking typing-extensions-4.16.0-h69aa097_0
OS (ubuntu)	UNKNOWN STEP	2026-09-27T10:51:22.0317941Z Linking typing-inspection-0.4.4-pyhcf101f3_0
OS (ubuntu)	UNKNOWN STEP	2026-09-27T10:51:22.0329451Z Linking _python_abi3_support-1.0-hd8ed1ab_3
OS (ubuntu)	UNKNOWN STEP	2026-09-27T10:51:22.0337949Z Linking annotated-types-0.8.0-pyhd8ed1ab_0
OS (ubuntu)	UNKNOWN STEP	2026-09-27T10:51:22.0357912Z Linking conda-libmamba-solver-26.7.0-pyhcf101f3_0
OS (ubuntu)	UNKNOWN STEP	2026-09-27T10:51:22.0371935Z Linking httpcore-1.0.9-pyh29332c3_0
OS (ubuntu)	UNKNOWN STEP	2026-09-27T10:51:22.0418572Z Linking pydantic-core-2.46.5-py314h7e8cd81_1
OS (ubuntu)	UNKNOWN STEP	2026-09-27T10:51:22.0447846Z Linking python-build-1.6.0-pyhc364b38_0
OS (ubuntu)	UNKNOWN STEP	2026-09-27T10:51:22.0477834Z Linking urllib3-2.7.0-pyhd8ed1ab_0
OS (ubuntu)	UNKNOWN STEP	2026-09-27T10:51:22.0547934Z Linking httpx-0.28.1-pyhd8ed1ab_0
OS (ubuntu)	UNKNOWN STEP	2026-09-27T10:51:22.0583255Z Linking py-rattler-0.25.0-py310hefeb9ab_5
OS (ubuntu)	UNKNOWN STEP	2026-09-27T10:51:22.0743709Z Linking pydantic-2.13.5-pyhcf101f3_0
OS (ubuntu)	UNKNOWN STEP	2026-09-27T10:51:22.0898884Z Linking requests-2.34.2-pyhcf101f3_0
OS (ubuntu)	UNKNOWN STEP	2026-09-27T10:51:22.0937980Z Linking conda-package-handling-2.6.0-pyh5ded981_0
OS (ubuntu)	UNKNOWN STEP	2026-09-27T10:51:22.0993859Z Linking unearth-0.18.3-pyhd8ed1ab_0
OS (ubuntu)	UNKNOWN STEP	2026-09-27T10:51:22.1078589Z Linking conda-index-0.13.0-pyh5ded981_0
OS (ubuntu)	UNKNOWN STEP	2026-09-27T10:51:22.1277258Z Linking conda-pypi-0.11.0-pyh5ded981_2
OS (ubuntu)	UNKNOWN STEP	2026-09-27T10:51:22.1338578Z Linking conda-lockfiles-0.2.1-pyhd8ed1ab_0
OS (ubuntu)	UNKNOWN STEP	2026-09-27T10:51:22.1398660Z Linking conda-rattler-solver-0.1.1-pyhcf101f3_0
OS (ubuntu)	UNKNOWN STEP	2026-09-27T10:51:22.1457851Z Linking conda-26.7.2-py314h9e666f3_1
OS (ubuntu)	UNKNOWN STEP	2026-09-27T10:51:22.1929065Z Linking conda-self-0.2.1-pyhd8ed1ab_0
OS (ubuntu)	UNKNOWN STEP	2026-09-27T10:51:23.9119350Z 
OS (ubuntu)	UNKNOWN STEP	2026-09-27T10:51:23.9120701Z Transaction finished
OS (ubuntu)	UNKNOWN STEP	2026-09-27T10:51:23.9121087Z 
OS (ubuntu)	UNKNOWN STEP	2026-09-27T10:51:23.9870324Z installation finished.
OS (ubuntu)	UNKNOWN STEP	2026-09-27T10:51:23.9888942Z Mamba was found in the `base` env
OS (ubuntu)	UNKNOWN STEP	2026-09-27T10:51:23.9890393Z ##[endgroup]
OS (ubuntu)	UNKNOWN STEP	2026-09-27T10:51:23.9891182Z ##[group]Setup environment variables...
OS (ubuntu)	UNKNOWN STEP	2026-09-27T10:51:23.9891876Z Add "/home/runner/miniconda3/condabin" to PATH
OS (ubuntu)	UNKNOWN STEP	2026-09-27T10:51:23.9892876Z Set 'CONDA="/home/runner/miniconda3"'
OS (ubuntu)	UNKNOWN STEP	2026-09-27T10:51:23.9895481Z ##[endgroup]
OS (ubuntu)	UNKNOWN STEP	2026-09-27T10:51:23.9895967Z ##[group]Parsing environment...
OS (ubuntu)	UNKNOWN STEP	2026-09-27T10:51:23.9902046Z ##[endgroup]
OS (ubuntu)	UNKNOWN STEP	2026-09-27T10:51:23.9902682Z ##[group]Writing conda configuration...
OS (ubuntu)	UNKNOWN STEP	2026-09-27T10:51:23.9922591Z Read existing condarc from /home/runner/.condarc as base config
OS (ubuntu)	UNKNOWN STEP	2026-09-27T10:51:23.9923283Z Removing implicitly added 'defaults' channel
OS (ubuntu)	UNKNOWN STEP	2026-09-27T10:51:23.9923887Z pkgs_dir: '/home/runner/conda_pkgs_dir'
OS (ubuntu)	UNKNOWN STEP	2026-09-27T10:51:23.9924493Z auto_activate_base: true
OS (ubuntu)	UNKNOWN STEP	2026-09-27T10:51:23.9924953Z auto_update_conda: false
OS (ubuntu)	UNKNOWN STEP	2026-09-27T10:51:23.9925414Z channel_priority: strict
OS (ubuntu)	UNKNOWN STEP	2026-09-27T10:51:23.9925870Z solver: libmamba
OS (ubuntu)	UNKNOWN STEP	2026-09-27T10:51:23.9927586Z always_yes: true
OS (ubuntu)	UNKNOWN STEP	2026-09-27T10:51:23.9929159Z changeps1: false
OS (ubuntu)	UNKNOWN STEP	2026-09-27T10:51:23.9952211Z Writing condarc to /home/runner/.condarc:
OS (ubuntu)	UNKNOWN STEP	2026-09-27T10:51:23.9952729Z notify_outdated_conda: false
OS (ubuntu)	UNKNOWN STEP	2026-09-27T10:51:23.9952951Z channels: []
OS (ubuntu)	UNKNOWN STEP	2026-09-27T10:51:23.9953120Z pkgs_dirs:
OS (ubuntu)	UNKNOWN STEP	2026-09-27T10:51:23.9953303Z   - /home/runner/conda_pkgs_dir
OS (ubuntu)	UNKNOWN STEP	2026-09-27T10:51:23.9953505Z auto_activate_base: true
OS (ubuntu)	UNKNOWN STEP	2026-09-27T10:51:23.9953691Z auto_update_conda: false
OS (ubuntu)	UNKNOWN STEP	2026-09-27T10:51:23.9953870Z channel_priority: strict
OS (ubuntu)	UNKNOWN STEP	2026-09-27T10:51:23.9954103Z solver: libmamba
OS (ubuntu)	UNKNOWN STEP	2026-09-27T10:51:23.9954344Z always_yes: true
OS (ubuntu)	UNKNOWN STEP	2026-09-27T10:51:23.9954616Z changeps1: false
OS (ubuntu)	UNKNOWN STEP	2026-09-27T10:51:23.9954714Z 
OS (ubuntu)	UNKNOWN STEP	2026-09-27T10:51:24.0012515Z ##[endgroup]
OS (ubuntu)	UNKNOWN STEP	2026-09-27T10:51:24.0019104Z ##[group]Initializing conda shell integration...
OS (ubuntu)	UNKNOWN STEP	2026-09-27T10:51:24.0019650Z Removing "/home/runner/.bashrc"
OS (ubuntu)	UNKNOWN STEP	2026-09-27T10:51:24.0020487Z Removing "/home/runner/.bash_profile"
OS (ubuntu)	UNKNOWN STEP	2026-09-27T10:51:24.0021118Z Removing "/home/runner/.profile"
OS (ubuntu)	UNKNOWN STEP	2026-09-27T10:51:24.0033535Z [command]/home/runner/miniconda3/condabin/conda init --all
OS (ubuntu)	UNKNOWN STEP	2026-09-27T10:51:27.9648370Z no change     /home/runner/miniconda3/condabin/conda
OS (ubuntu)	UNKNOWN STEP	2026-09-27T10:51:27.9648906Z no change     /home/runner/miniconda3/bin/conda
OS (ubuntu)	UNKNOWN STEP	2026-09-27T10:51:27.9667975Z no change     /home/runner/miniconda3/bin/activate
OS (ubuntu)	UNKNOWN STEP	2026-09-27T10:51:27.9668752Z no change     /home/runner/miniconda3/bin/deactivate
OS (ubuntu)	UNKNOWN STEP	2026-09-27T10:51:27.9678036Z no change     /home/runner/miniconda3/etc/profile.d/conda.sh
OS (ubuntu)	UNKNOWN STEP	2026-09-27T10:51:27.9678768Z no change     /home/runner/miniconda3/etc/fish/conf.d/conda.fish
OS (ubuntu)	UNKNOWN STEP	2026-09-27T10:51:27.9679322Z no change     /home/runner/miniconda3/shell/condabin/Conda.psm1
OS (ubuntu)	UNKNOWN STEP	2026-09-27T10:51:27.9679869Z modified      /home/runner/miniconda3/shell/condabin/conda-hook.ps1
OS (ubuntu)	UNKNOWN STEP	2026-09-27T10:51:27.9680499Z no change     /home/runner/miniconda3/lib/python3.14/site-packages/xontrib/conda.xsh
OS (ubuntu)	UNKNOWN STEP	2026-09-27T10:51:27.9681094Z no change     /home/runner/miniconda3/etc/profile.d/conda.csh
OS (ubuntu)	UNKNOWN STEP	2026-09-27T10:51:27.9681540Z modified      /home/runner/.bashrc
OS (ubuntu)	UNKNOWN STEP	2026-09-27T10:51:27.9681888Z modified      /home/runner/.zshrc
OS (ubuntu)	UNKNOWN STEP	2026-09-27T10:51:27.9682278Z modified      /home/runner/.config/fish/config.fish
OS (ubuntu)	UNKNOWN STEP	2026-09-27T10:51:27.9682683Z modified      /home/runner/.xonshrc
OS (ubuntu)	UNKNOWN STEP	2026-09-27T10:51:27.9683033Z modified      /home/runner/.tcshrc
OS (ubuntu)	UNKNOWN STEP	2026-09-27T10:51:27.9683435Z modified      /home/runner/.config/powershell/profile.ps1
OS (ubuntu)	UNKNOWN STEP	2026-09-27T10:51:27.9683785Z 
OS (ubuntu)	UNKNOWN STEP	2026-09-27T10:51:27.9684064Z ==> For changes to take effect, close and re-open your current shell. <==
OS (ubuntu)	UNKNOWN STEP	2026-09-27T10:51:27.9684447Z 
OS (ubuntu)	UNKNOWN STEP	2026-09-27T10:51:28.0538534Z Renaming "/home/runner/.bashrc" to "/home/runner/.profile"
OS (ubuntu)	UNKNOWN STEP	2026-09-27T10:51:28.0538791Z 
OS (ubuntu)	UNKNOWN STEP	2026-09-27T10:51:28.0542314Z ##[endgroup]
OS (ubuntu)	UNKNOWN STEP	2026-09-27T10:51:28.0543004Z ##[group]Adding tools to 'base' env...
OS (ubuntu)	UNKNOWN STEP	2026-09-27T10:51:28.0546830Z Do we need to update conda?
OS (ubuntu)	UNKNOWN STEP	2026-09-27T10:51:28.0547522Z Do we need to update mamba?
OS (ubuntu)	UNKNOWN STEP	2026-09-27T10:51:28.0547965Z ... we will update mamba.
OS (ubuntu)	UNKNOWN STEP	2026-09-27T10:51:28.0548462Z ... we will perform post-install steps after we update mamba.
OS (ubuntu)	UNKNOWN STEP	2026-09-27T10:51:28.0549011Z Do we need to update python?
OS (ubuntu)	UNKNOWN STEP	2026-09-27T10:51:28.0549452Z Do we need to update conda-build?
OS (ubuntu)	UNKNOWN STEP	2026-09-27T10:51:28.0549918Z No tools were installed in 'base' env.
OS (ubuntu)	UNKNOWN STEP	2026-09-27T10:51:28.0553759Z ##[endgroup]
OS (ubuntu)	UNKNOWN STEP	2026-09-27T10:51:28.0554357Z ##[group]Ensuring environment...
OS (ubuntu)	UNKNOWN STEP	2026-09-27T10:51:28.0554875Z Can we conda create (from explicit)?
OS (ubuntu)	UNKNOWN STEP	2026-09-27T10:51:28.0555859Z Can we conda create (simple)?
OS (ubuntu)	UNKNOWN STEP	2026-09-27T10:51:28.0556852Z ... will conda create (simple).
OS (ubuntu)	UNKNOWN STEP	2026-09-27T10:51:28.0558992Z ##[group]Updating 'pypsa-earth' env from conda create (simple)...
OS (ubuntu)	UNKNOWN STEP	2026-09-27T10:51:28.0569540Z [command]/home/runner/miniconda3/condabin/mamba create --name pypsa-earth
OS (ubuntu)	UNKNOWN STEP	2026-09-27T10:51:28.0716533Z Empty environment created at prefix: /home/runner/miniconda3/envs/pypsa-earth
OS (ubuntu)	UNKNOWN STEP	2026-09-27T10:51:28.0727817Z ##[endgroup]
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
