cyc292cycjin-oss/SGP-ESE5004-Stage2/research/01_baseline_construction/INDUSTRIAL_DEMAND_FIX_REPORT.md

# 工业GDP空间分配修复

**已通过10国2019基年已记录工业总量的节点分配守恒；尚未通过完整11国未来工业需求构建。** 没有应用增长因子，没有改国家总量，没有替代任何缺失的TL工业数值。

源NC：`GDP_PPP_1990_2015_5arcmin_v2.nc`，SHA256=`975ddfad5d2ee71aa227c269b530a4917f8305299b77d09ee0f9cfabc83e5e5b`。模型原有规则请求2020但数据仅到2015，继续使用原规则所选2015，并明确标记，不声称GDP年份为2020。单位constant 2011 international USD。

旧TIFF：289×289、无CRS、经度−1.667～22.417，完全不覆盖ASEAN。隔离副本由同一个NC恢复为2160×4320、EPSG4326、全球范围，记录raw SHA/year。原NC与旧TIFF均未改，前后hash一致。缓存单元测试还检验了值不变和有效缓存不被重复写入。

实际链：2015 GDP → 351个既有GADM区域（all_touched方式沿用上游）→ atlite气象网格几何 → 48个已有节点 → 原设施数据库432条已映射设施/无设施GDP回退 → 国家内行业权重归一化 → 2019基年工业量。这里复用教程的空间几何，**不代表六天气象结果成为正式输入**。

基年表hash=`c62e8edab8451f93a4273f9214e6259306ea7e01a6ba9c85e7b7db48978aa404`；44个country/carrier行、572个数值单元格，表内已有0保持原样，未补值。每个country/carrier/industry分别检验，容差atol=1e-6MWh、rtol=1e-12。最大单元格误差 `2.9802322387695312e-08` MWh。以下为全部载能的国家总和：

| 国家 | national MWh | node sum MWh | absolute error MWh | relative error |
|---|---:|---:|---:|---:|
| BN | 2207872.880000000 | 2207872.880000000 | 0 | 0 |
| ID | 792118515.785444379 | 792118515.785444379 | 0 | 0 |
| KH | 11739113.199999999 | 11739113.199999999 | 0 | 0 |
| LA | 7749615.192000000 | 7749615.192000000 | 0 | 0 |
| MM | 59555895.967911109 | 59555895.967911102 | 7.45e-09 | 1.25e-16 |
| MY | 224005188.605888903 | 224005188.605888933 | 2.98e-08 | 1.33e-16 |
| PH | 69417165.058544070 | 69417165.058544070 | 0 | 0 |
| SG | 79756933.225097001 | 79756933.225097001 | 0 | 0 |
| TH | 354980231.809019983 | 354980231.809019983 | 0 | 0 |
| VN | 397223244.423064768 | 397223244.423064768 | 0 | 0 |
| TL | 缺失 | 未分配 | N/A | N/A |

[逐国CSV](INDUSTRIAL_CONSERVATION.csv)、[572项守恒证据](INDUSTRIAL_RECOVERY_EVIDENCE.json)、[节点已记录量](INDUSTRIAL_NODE_OBSERVED.json)及生成脚本validate_industrial_recovery.py均可审查。分配脚本不逐个手改processed CSV。

仍需评审：原设施locate_bus使用地理CRS最近邻（运行给出警告），设施空间合理性不由总量守恒证明；all_touched边界栅格共享也可能偏置权重。当前方法沿用上游，未擅自换分配假设。TL缺工业交易；未来DEFAULT CAGR与ammonia/process转换另行确认。新增缺国家检查会在11国数据缺失时显式报错，防止上游reindex(fill_value=0)把TL伪装为零。

代码提交：`a7a8f06b43f0dcce0dbd7005b989d8f73d142b81`；只应用于独立fix分支。下一步先核验数据边界再以正式空间分辨率回归，不把本次48节点诊断称为已完成100clusters/full-year工业模型。
