cyc292cycjin-oss/SGP-ESE5004-Stage2/research/00_source_provenance/history/asean_history.txt

5557557ba4f326a2f88ffc0a495dfad6fc887b4e 2026-08-17T03:02:44+02:00 Use DemandCast for PyPSA-ASEAN workflow (#59)
c1d99d0617e027ebe01fa2dd1ce1f7160eaddd6e 2026-07-29T11:44:09+02:00 Update ASEAN configuration based on changes in PyPSA-Earth
75963d69159c11039c4c0047ffb53ea011efc8c2 2026-04-27T09:58:13+02:00 Add Java-Bali and Peninsular tutorial examples to documentation (#42)
ec1d2227d324af1a8741203f76a79e841678ee06 2026-04-08T07:23:47+02:00 Soft fork/07.04.2026 (#38)
f0fbaaa15d3d2c8606e2050edc1ebf65418f037d 2026-04-02T23:32:52+02:00 Prepare tutorial workflow for faster test runs (#37)
d965b422bb5624862cd3657ce5dab8cb7f53ddfe 2026-03-30T22:53:11+02:00 Soft fork/30.03.2026 (#35)
a6514053c2db3460b4a0508d510524d44725e09d 2026-01-22T18:19:01+01:00 Add labels to figures
8c43515782e0f2244acf642916998b44d56665ab 2026-01-22T14:13:48+01:00 Improve documentation and add citations
99159edb7298b847fea517bf05c3f388493501c9 2026-01-21T21:31:28+01:00 Finalized Scenarios from Conference Paper. Documentation and Notebooks (#25)
04e45be0a05dc67fe16c830513d1e05b25051405 2025-12-13T14:14:06+01:00 Add heuristics to determine missing hydro technologies (PyPSA-ASEAN) (#24)
0d1c346e3baa0a1e1d605568c7403b54fbf4c717 2025-12-11T12:54:39+01:00 add workaround in run_scenarios
9f9d5b050d38470ab1975e5a3ae3806e4a11eaa2 2025-12-11T11:32:04+01:00 reinclude biomass, expand config and scenarios
66a408dea8d551d71e8741d81e78f70c16a62958 2025-11-21T18:50:37+01:00 prepare configs for sensitivities
a189c6901cc2cb657d6567a87f6a9bc395f0c05c 2025-11-11T17:40:33+01:00 bugfix: remove duplicate transmissions by increasing the distance_upper_bound (#19)
1b22a0996cfe9cddf0acb2876d16c065c21f1a68 2025-11-10T08:39:32+01:00 Set the conference results as the base scenario (#18)
ea1799365e98916dcd6dcb3bf830835d792ca487 2025-10-08T23:22:26+02:00 Add final ASEAN adjustment for all-sector electricity only runs (#17)
b86b9575ac1e034933f5afcf2f2fff08777bb106 2025-07-30T12:31:29+02:00 Feature: Add year specific cost modification for ASEAN (#8)
80b651e6fbd21ed8f845876a581dc8e81ffcd640 2025-07-24T12:07:09+02:00 Feature: Add AIMS and NDP interconnection (#1)
a199bc71789b342eca35fe8f553516f0c24b4357 2025-07-14T12:44:28+02:00 Add osm-prebuilt version 0.1 for ASEAN (#6)
