cyc292cycjin-oss/SGP-ESE5004-Stage2/research/00_source_provenance/history/gdp_history.txt

d965b422bb5624862cd3657ce5dab8cb7f53ddfe 2026-03-30 Soft fork/30.03.2026 (#35)
16a58f28ce38ed6b6f0e0f42f255ac7a6aeecd20 2026-03-27 Streamline subregion implementation, subdivide EEZs for subregions (#1730)
3836aedb5b16fd5b53a283beddfecd12cc13c2af 2024-10-29 Use absolute path for `config.default.yaml` in `_helpers.py` (#1137)
8bcaa50d8412690cacf96aa66445108af9f58a83 2023-08-06 add params with the exception for  and
d0d709d51b23516cbe7bb4297cdd14d2b599e0bb 2023-06-30 Fix pre-commit and revise style (#779)
418207e28d023382afe3c21460e08c9595e2d822 2023-04-18 Adding mem_mb, integrating into compute_population
b41bdc8f773b0e5c555c9b5393e1ed2eccaf20d4 2023-04-16 Split download worldpop, logging stages update
e8c9b3b0098ac62202b501bbd53a110a0bea5570 2023-03-24 Restructure methods to implement scaling
fb9359e5026f107064b04ac31105819e42f15f60 2023-03-22 df_gadm operation adjustment
e18272d8cfb45e6f66a9e79d532d31824d83cfb6 2023-03-21 Adding methods for efficient processing of raster
28800316b814afb1bc6f67b0acf20d3b5c52e7e8 2023-01-23 Revise style build_shapes
3370ebb2721c1c02e9fb7b61db78830e2b1cdda5 2023-01-08 Ensure consistency of logger names across the project
92dafd7c915eb25fe39d3e96f0dcfef43f2bfe15 2022-05-30 Remove data/raw dependencies in build_shapes
acc4c51daa69b5567a1000d10c6abd25005cdda3 2022-05-29 add false as option for pop and gdp
80e2bf99bf4317d681e2618be5d8630fb48302a6 2022-04-25 Worldpop API access function added to build_shapes
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
02795601c9f649601696ab81c287ad48c5516126 2021-07-31 First runnable build_shapes.py
6baed489269f5374278dfc74da0e35e7ab94c632 2021-07-28 Make linter conform
ad040dca2be5b7daa56e1a4389f7a1c3b3614732 2021-07-17 Prep for build_network
