cyc292cycjin-oss/SGP-ESE5004-Stage2/research/00_source_provenance/history/industry_history.txt

aab889243a6d3a54fb5db9fee2602a04ce41d036 2026-08-04 Remove `demand` and `h2export` wildcards (#1962)
73e79207b4f9a66568cfca80eedf51e5db4fc81d 2026-06-08 Make code more robust (#1812)
d3e21b080a236b77a64ac2bd44884457f3248378 2026-06-02 Add ammonia industry explicitly (#1783)
f3e260cf5b91295ec8261077a817d5425f6d2636 2025-04-18 Add country specific demand data and adjust workflow (#1394)
5f7aa7e8cb9b0bb42599584bb08cc24b714d14e8 2025-04-02 fixed function country_to_nodal to use parameter instead of global variable
e745cc103598b6a621390a56b19ddd8dc08eb70d 2025-04-02 fix estimation of aluminium emissions by scaling by 1000
5b9ac3038daa4fe3bda654bb9b43c305f98506f0 2025-01-04 Revise export path of unsd data (#1279)
d566e988a93a881dc24fb53aa5312f2ef8ce7db3 2024-12-24 Put the path into snakemake inputs
6a90b66c305315ecd45692e11699d3c4aac38b49 2024-12-24 Merge branch 'main' into sec_paths
26eafdb54e0e53b1b5f08cf3600e4ed37a677209 2024-12-10 Replace a benchmark path
4959a11333c8f5fb15f5129ee469cfa2f6bf1302 2024-12-04 Update wildcards for mock_snakemake across scripts
434f4e2955943ea73816f3ac9d138ad1ff27aa09 2024-11-10 use BASE_DIR in sector scripts to enable subworkflow import
2cd79bea7dff0c38d83aaf8dcc8b9a8cce25e5f8 2024-10-29 [pre-commit.ci] auto fixes from pre-commit.com hooks
c25aa265411c10487e09ba847c55f064a8715504 2024-10-18 assume 0 for countries with missing data
ba3bc91cebd1079b4ed84a5052614d3489a4c583 2024-10-17 rise error if duplicate entries for the country are present
20cbda3c997a59086b9ac48a17e9e11e675d29e3 2024-10-14 drop duplicate AL_production data for given country and year
a8987468ceda152ed1152f6c7bfa2ffb79da0837 2024-09-19 Merge pull request #1086 from merge-pyspa-earth-sec
