cyc292cycjin-oss/SGP-ESE5004-Stage2/research/00_source_provenance/history/sector_merge_summary.txt

commit a8987468ceda152ed1152f6c7bfa2ffb79da0837
Author: Fabian Hofmann <fab.hof@gmx.de>

    Merge pull request #1086 from merge-pyspa-earth-sec

 .github/workflows/ci-linux.yaml                    |   90 -
 .github/workflows/ci-mac.yaml                      |   76 -
 .github/workflows/ci-windows.yaml                  |   76 -
 .github/workflows/ci.yml                           |   72 +
 .gitignore                                         |   71 +-
 .pre-commit-config.yaml                            |    9 +
 .reuse/dep5                                        |   20 -
 .yamllint                                          |    9 +-
 Makefile                                           |   28 +
 README.md                                          |   31 +-
 REUSE.toml                                         |   33 +
 Snakefile                                          |  983 ++++++-
 config.default.yaml                                |  787 ++++--
 config.tutorial.yaml                               |  457 +---
 configs/powerplantmatching_config.yaml             |    4 +-
 configs/scenarios/config.NG.yaml                   |    9 +-
 data/AL_production.csv                             |  258 ++
 data/custom/TEMPLATE_energy_totals_AB_2030.csv     |    2 +
 .../TEMPLATE_h2_underground_AB_2030 copy.csv       |   19 +
 data/custom/TEMPLATE_industrial_database.csv       |    2 +
 data/custom/TEMPLATE_industry_demand_AB_2030.csv   |    9 +
 data/custom_res_installable.csv                    |    4 +
 data/custom_res_potential.csv                      |    4 +
 data/demand/district_heating.csv                   |    3 +
 data/demand/efficiency_gains_cagr.csv              |    3 +
 data/demand/fuel_shares.csv                        |    3 +
 data/demand/growth_factors_cagr.csv                |    3 +
 data/demand/industry_growth_cagr.csv               |    3 +
 .../unsd/paths/Energy_Statistics_Database.xlsx     |  Bin 0 -> 9202 bytes
 data/emobility/Bus__count                          |  171 ++
 .../emobility/European_countries_car_ownership.csv |   31 +
 data/emobility/KFZ__count                          |  171 ++
 data/emobility/Lfw__count                          |  171 ++
 data/emobility/Lkw__count                          |  171 ++
 data/emobility/LoA__count                          |  171 ++
 data/emobility/Lzg__count                          |  171 ++
 data/emobility/Pkw__count                          |  171 ++
 data/emobility/PmA__count                          |  171 ++
 data/emobility/Sat__count                          |  171 ++
 data/emobility/traffic.tex                         |   14 +
 data/energy_totals_DF_2030.csv                     |    2 +
 .../existing_heating_raw.csv                       |   32 +
 data/export_ports.csv                              |   14 +
 data/heat_load_profile_BDEW.csv                    |   25 +
 data/hydrogen_salt_cavern_potentials.csv           |    6 +
 data/override_component_attrs/buses.csv            |    3 +
 data/override_component_attrs/generators.csv       |    3 +
 data/override_component_attrs/links.csv            |   13 +
 data/override_component_attrs/loads.csv            |    2 +
 data/override_component_attrs/stores.csv           |    4 +
 data/temp_hard_coded/biomass_transport_costs.csv   |   48 +
 data/temp_hard_coded/energy_totals.csv             |   37 +
 data/temp_hard_coded/transport_data.csv            |  123 +
 data/unsd_transactions.csv                         |   39 +
 doc/configtables/licenses.csv                      |    5 +
 doc/how_to_contribute.rst                          |    4 +-
 doc/release_notes.rst                              |    5 +-
 envs/environment.yaml                              |    9 +-
 scripts/_helpers.py                                |  777 +++++-
 scripts/add_brownfield.py                          |  263 ++
 scripts/add_electricity.py                         |   24 +-
 scripts/add_existing_baseyear.py                   |  660 +++++
 scripts/add_export.py                              |  229 ++
 scripts/add_extra_components.py                    |   33 +-
 scripts/augmented_line_connections.py              |    2 +-
 scripts/base_network.py                            |    3 +-
 scripts/build_base_energy_totals.py                |  477 ++++
 scripts/build_base_industry_totals.py              |  203 ++
 scripts/build_bus_regions.py                       |    2 +-
 scripts/build_clustered_population_layouts.py      |   61 +
 scripts/build_cop_profiles.py                      |   45 +
 scripts/build_cutout.py                            |    2 +-
 scripts/build_demand_profiles.py                   |    5 +-
 scripts/build_existing_heating_distribution.py     |  178 ++
 scripts/build_heat_demand.py                       |   44 +
 scripts/build_industrial_database.py               |  526 ++++
 scripts/build_industrial_distribution_key.py       |  190 ++
 scripts/build_industry_demand.py                   |  319 +++
 scripts/build_natura_raster.py                     |    1 -
 scripts/build_osm_network.py                       |    5 +-
 scripts/build_population_layouts.py                |  137 +
 scripts/build_powerplants.py                       |    1 -
 scripts/build_renewable_profiles.py                |   18 +-
 scripts/build_shapes.py                            |   19 +-
 scripts/build_ship_profile.py                      |   92 +
 scripts/build_solar_thermal_profiles.py            |   56 +
 scripts/build_temperature_profiles.py              |   60 +
 scripts/build_test_configs.py                      |    1 -
 scripts/clean_osm_data.py                          |    1 -
 scripts/cluster_network.py                         |    4 -
 scripts/copy_config.py                             |   23 +
 scripts/download_osm_data.py                       |    5 +-
 scripts/make_statistics.py                         |    9 +-
 scripts/make_summary.py                            |    1 -
 scripts/monte_carlo.py                             |    1 -
 scripts/non_workflow/zip_folder.py                 |   15 +-
 scripts/override_respot.py                         |  116 +
 scripts/plot_network.py                            |  797 +++++-
 scripts/plot_summary.py                            |    1 -
 scripts/prepare_airports.py                        |  121 +
 scripts/prepare_db.py                              |  499 ++++
 scripts/prepare_energy_totals.py                   |  308 +++
 scripts/prepare_gas_network.py                     |  939 +++++++
 scripts/prepare_heat_data.py                       |  177 ++
 scripts/prepare_network.py                         |    9 +-
 scripts/prepare_ports.py                           |  104 +
 scripts/prepare_sector_network.py                  | 2894 ++++++++++++++++++++
 scripts/prepare_transport_data.py                  |  254 ++
 scripts/prepare_transport_data_input.py            |  158 ++
 scripts/prepare_urban_percent.py                   |  105 +
 scripts/retrieve_databundle_light.py               |   16 +-
 scripts/simplify_network.py                        |    2 +-
 scripts/solve_network.py                           | 1612 +++++++----
 test/config.custom.yaml                            |    3 +-
 test/config.landlock.yaml                          |    3 +-
 test/config.monte_carlo.yaml                       |    3 +-
 test/config.test1.yaml                             |   54 +
 test/config.test_myopic.yaml                       |  540 ++++
 test/config.tutorial_noprogress.yaml               |    7 -
 119 files changed, 16423 insertions(+), 1817 deletions(-)
