cyc292cycjin-oss/SGP-ESE5004-Stage2/research/00_source_provenance/history/sector_module_history.txt

aab889243a6d3a54fb5db9fee2602a04ce41d036 2026-08-04 Remove `demand` and `h2export` wildcards (#1962)
fffa25e6dfafa43e0a5dbe41442d278477f523cf 2026-07-06 add gis base uhs and h2 turbine (#1474)
73e79207b4f9a66568cfca80eedf51e5db4fc81d 2026-06-08 Make code more robust (#1812)
d3e21b080a236b77a64ac2bd44884457f3248378 2026-06-02 Add ammonia industry explicitly (#1783)
8924c15ceff8eb43abc59430036e7180ae257f3e 2026-03-11 Fix clustering with gadm_layer_id 0 or 2 and alternative_clustering=false (#1714)
8f574f4076af8df6fdec941e774df646d46efb24 2025-02-04 Merge conflicts to main
be42f1d7c48fa7b7b232eb92c3322b7135870f41 2025-01-13 remove duplicated gadm_level
4cb1051b89ba572a1e354a8a5926573b182cfd3d 2024-12-22 Merge branch 'main' into revision_locate_bus
4959a11333c8f5fb15f5129ee469cfa2f6bf1302 2024-12-04 Update wildcards for mock_snakemake across scripts
393cd39554e6101cfcd1b57638a92bc95fee1812 2024-11-14 Revision locate_bus with geopandas geospatial comparison
c2f7b26567c56cd4712cb93ae9391d7868c193b8 2024-09-05 consolidate current working directory; considate helpers scripts
1480d7a48160f5a13bb990d1034aaac42cf7be72 2024-08-16 Merge remote-tracking branch 'pypsa-earth-sec/snakemake-module' into merge-pyspa-earth-sec
031ad55d2b2f7a655500b72346b6221529556ff5 2024-07-18 replace snakemake subworkflow by submodule; fix path relations
b1883501848c96c7a09124a075583ceb41d0d532 2024-06-11 [pre-commit.ci] auto fixes from pre-commit.com hooks
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
68fee048a4507f748a7b2d4147272d1858bb0d11 2022-06-29 [pre-commit.ci] auto fixes from pre-commit.com hooks
2bb2df96324779d8cf22ed7bdafd0ce0598a08b8 2022-06-29 bug fixes
cf9ccbb2d100980f0980458ec13790b3d2d2f65e 2022-06-28 full feature, works with current main repository
