cyc292cycjin-oss/SGP-ESE5004-Stage2/research/02_sector_coupling/buildings_heat/history/compact_history.txt

aab889243a6d3a54fb5db9fee2602a04ce41d036 2026-08-04 Remove `demand` and `h2export` wildcards (#1962)
fffa25e6dfafa43e0a5dbe41442d278477f523cf 2026-07-06 add gis base uhs and h2 turbine (#1474)
f3e260cf5b91295ec8261077a817d5425f6d2636 2025-04-18 Add country specific demand data and adjust workflow (#1394)
62257583efaf67087b604fe40396fafdbc57e42b 2025-04-16 Demand growth rates for the US (#1400)
6a90b66c305315ecd45692e11699d3c4aac38b49 2024-12-24 Merge branch 'main' into sec_paths
f5a957eb70d0ec53277939f5243a36d62ad5a9d5 2024-12-11 Replace path hardcoding in script
4959a11333c8f5fb15f5129ee469cfa2f6bf1302 2024-12-04 Update wildcards for mock_snakemake across scripts
434f4e2955943ea73816f3ac9d138ad1ff27aa09 2024-11-10 use BASE_DIR in sector scripts to enable subworkflow import
c2f7b26567c56cd4712cb93ae9391d7868c193b8 2024-09-05 consolidate current working directory; considate helpers scripts
1480d7a48160f5a13bb990d1034aaac42cf7be72 2024-08-16 Merge remote-tracking branch 'pypsa-earth-sec/snakemake-module' into merge-pyspa-earth-sec
031ad55d2b2f7a655500b72346b6221529556ff5 2024-07-18 replace snakemake subworkflow by submodule; fix path relations
9f5fb3f19f765b929f2d2cd47a7957abd25b52e4 2024-06-12 Add Params to prepare_db and energy_totals
57d11173059f26d99e0cafb669b4040a77e961a7 2024-03-07 clean demand data - enabling default data
0b679df711c2400f62803c4875178876ee32891c 2024-03-07 enabling usage of default data
ef124492f34424f4e81e1a55cafc70b84e3aefca 2024-03-06 WIP: enabling default demand data
789916609403dc8817e93973742fcf62156e0a59 2024-02-16 feat: enabling default demand data
e26df4ce4e8492beeaf393906ace8c7b02ee4796 2024-02-08 Merge pull request #272 from pypsa-meets-earth/271-keyerror-total-rail-for-namibia
c19fca29dde5204674e6e64a5c20ec7724968f5d 2024-02-01 prevent droping na data to keep the keys
c7460e65e3d62cc7a27e90664345ffca288808ca 2024-01-31 [pre-commit.ci] auto fixes from pre-commit.com hooks
dbcce25d8c14402102641ed564862a7955be7467 2024-01-31 fix: fix incorrect recognition of the ISO-2 country code "NA" as NaN value
5537672109d2d323cf0fc5d18239504e950c1ae7 2023-09-14 Merge pull request #235 from pypsa-meets-earth/fix_bug_demandworkflow
97c2f2f0a6c0487a83a0a9d9a35e5d456f680a0c 2023-09-12 add default values for EG and ignore slurm folder
c5a08bb19208d53fc04b712df7dcbe2b77b0395c 2023-09-12 [pre-commit.ci] auto fixes from pre-commit.com hooks
d2ef6213871347d2ffdbb9bab156859bf979d251 2023-09-06 fix minor bug
2b5a0a9b5ded38f2bf013dd7d23c4d621d8636bc 2023-08-29 [pre-commit.ci] auto fixes from pre-commit.com hooks
d9cfc2db9a3b77f996fd2a4f844868dbd73f18bc 2023-08-29 change growth factors and efficiency gains to cagr
b16ba497835fff513a8a4f483ea00313f74eb932 2023-08-24 make residential with all carreirs a default sector
cc597167562c95ca41f6ce910513a403e8041dde 2023-08-24 [pre-commit.ci] auto fixes from pre-commit.com hooks
54c68ee7986228569e3c481fef54ff81a7e1cff8 2023-08-24 adapting workflow for other countries
211ca4fabca57589af2e13fcdd445519a215b023 2023-08-23 [pre-commit.ci] auto fixes from pre-commit.com hooks
9570636196dc874e1473c2f9b4f822064d681501 2023-08-23 add needed config params
6bad5bec15c30e99b566ab3c6190f5e52c57901e 2023-08-23 [pre-commit.ci] auto fixes from pre-commit.com hooks
78154fd50525885942df5602069874d48658125a 2023-08-23 adapt csv files needed for demand workflow
1aa33e63a29a308f62b999ee77cc4d28389a4436 2023-08-23 [pre-commit.ci] auto fixes from pre-commit.com hooks
889de1a26b9a436fecf950f980f194501d6b37eb 2023-08-23 adapt residential sector and fix bug in road transport
