cyc292cycjin-oss/SGP-ESE5004-Stage2/research/02_sector_coupling/buildings_heat/history/SPLIT_FULL_HISTORY.txt

669019bd7b9f74541bfe45bb88c8367a69f6abce 2026-06-29 Merge pull request #51 from pypsa-meets-earth/main
9713864ade7d6009dfffe11f6f5f8e259262bad6 2026-06-26 Add Ghana (GH) country configuration to PyPSA-Earth (#1861)
d965b422bb5624862cd3657ce5dab8cb7f53ddfe 2026-03-30 Soft fork/30.03.2026 (#35)
a2c5f7b33bb12c4a6f5e06868606ce1dc2d5718c 2026-03-26 Sector documentation (Part 2) (#1760)
40ceed75fa8b12666276c4e050f86d86b0d36c63 2026-03-13 MkDocs Migration (#1638)
d34f21d1e4690f380b2add982557cbe3686f0dad 2025-05-26 merge main to add_h2_production
8d37f3fbd1b2dd21041992e9e6d38fd0409da851 2025-05-20 remove unnecessary files
c065b50fc39f9db4516faaacaf15e3b31dd51af6 2025-05-20 Merge branch 'pypsa-meets-earth:main' into add_costs_usa
ce88aaa47399ad844c816ae780cfb66855677446 2025-04-18 Merge changes to main branch
62ffa129b2c152bb92f7da1b0dfb1e3fcad453c4 2025-03-14 Merge branch 'pypsa-meets-earth:main' into feature/cli
ab3a1d31c4e5e02ee722e1c5ad04a7c6bfd35860 2025-03-13 Merge pull request #1346 from davide-f/hydro_to_buses
0dcb36792c561d126d93db3676f4d57716c242ee 2025-03-12 Merge branch 'main' of github.com:pypsa-meets-earth/pypsa-earth into sector-couple-tutorial
7a124a26f86377dd02e50251962154a297a4d5e4 2025-03-11 Merge branch 'main' into fix_temporal_loads
4b733b27f60026352a354f4032cc96f6b10dda98 2025-03-11 Merge pull request #1343 from davide-f/test_docker
88d9cc9e771536f7c41ddf98294be29e1bdd7e3c 2025-03-09 Merge pull request #1369 from GbotemiB/fix-myopic-run
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
2d5918621f2cd7deca684bbf89b52cceb0d79075 2023-08-30 Merge pull request #219 from pypsa-meets-earth/demand_workflow
174ae272e7e63c5783b3d8937f55a314fce2c7ce 2023-08-29 resolving PR comments
