cyc292cycjin-oss/SGP-ESE5004-Stage2/research/04_model_assembly/gate1/PHASE4_FIX_INTEGRATION_MATRIX.csv

Fix | SourceSHA | ResearchSHA | Classification | Status | Reason | Before | After | ScientificAssumptionsChanged | Evidence
GDP | a7a8f06b43f0dcce0dbd7005b989d8f73d142b81 | 948784b7da4dd9a6e07e885b365d6423d2910eda | ENGINEERING_ONLY | INTEGRATED | Original and cumulative regressions PASS; cherry-pick -x; pushed research branch only | FAIL on frozen U | PASS | NO | evidence/INTEGRATION_GDP.json
E1 | 92e9118be20f0b3802f385adac2f56650d57299d | 9c06bdd6d075444b2ba06a39cb38af2cbbf0cf9e | ENGINEERING_ONLY | INTEGRATED | Original and cumulative regressions PASS; cherry-pick -x; pushed research branch only | FAIL on frozen U | PASS | NO | evidence/INTEGRATION_E1.json
E2 | 31037d60d69fa762c9ed8ec9ce8289d95bd6a181 | 1b73547a3e8eab02e440f4d46c26014a26b7cbdd | ENGINEERING_ONLY | INTEGRATED | Original and cumulative regressions PASS; cherry-pick -x; pushed research branch only | FAIL on frozen U | PASS | NO | evidence/INTEGRATION_E2.json
E4 | 5d761eceeeb0d0519208d760224a41ff50ec1e30 | f8a5dd59930593b8ea1b4278e1ecf1eb9a739ff1 | ENGINEERING_ONLY | INTEGRATED | Original and cumulative regressions PASS; cherry-pick -x; pushed research branch only | FAIL on frozen U | PASS | NO | evidence/INTEGRATION_E4.json
CARBON | 753ac81c23f8b9a1ca8ceed531d0630b56f6953d | 1c476b1b6a8466d617709e2445f111bbf5df6c60 | ENGINEERING_ONLY | INTEGRATED | Original and cumulative regressions PASS; cherry-pick -x; pushed research branch only | FAIL on frozen U | PASS | NO | evidence/INTEGRATION_CARBON.json
SHIP_ALLOCATION | 512c6cc2e53c579976d269486a7e328a0f372017 |  | ENGINEERING_ONLY | CONFLICT_NOT_INTEGRATED | prepare_sector_network.py conflict; aborted without manual resolution | FAIL on frozen U | NOT_INTEGRATED | NO | evidence/INTEGRATION_SHIP_ALLOCATION.json
SHIP_TARGET | cf4b0f816086470dce40ec950e20c045044eec0c |  | ENGINEERING_ONLY | DEPENDENCY_NOT_INTEGRATED | Depends on rejected shipping allocation cherry-pick; no isolated target/byte-fidelity application | FAIL on frozen U | NOT_INTEGRATED | NO | evidence/SHIPPING_DEPENDENCY_DECISION.json
SHIP_BYTES | 85a32dc231458fd753445df38d422b78435b8aad |  | ENGINEERING_ONLY | DEPENDENCY_NOT_INTEGRATED | Depends on rejected shipping allocation cherry-pick; no isolated target/byte-fidelity application | Byte fidelity only; no functional regression of its own | NOT_INTEGRATED | NO | evidence/SHIPPING_DEPENDENCY_DECISION.json
