cyc292cycjin-oss/SGP-ESE5004-Stage2/research/02_sector_coupling/buildings_phase3a3/BUILDINGS_FIX_TEST_MATRIX.csv

fix | case | country | sector | metric | before | after | expected | unit | absolute_error | relative_error | before_absolute_error | tolerance | before_test_status | test_status | evidence_type | detail | before_detail
E1 | mixed_dh0.3_reduction0 | BN | residential | heat_service_without_DH_loss | 704120.3556377366 | 2100000 | 2099999.9999999995 | MWh | 4.656612873077393e-10 | 2.2174347014654255e-16 | 1395879.644362263 | 0.000003099999999999999 | FAIL | PASS | SYNTHETIC_FUNCTION_REGRESSION
E1 | mixed_dh0.3_reduction0 | BN | residential | district_heat_loss | 0 | 60007.499999999985 | 60007.49999999998 | MWh | 7.275957614183426e-12 | 1.2125080388590474e-16 | 60007.49999999998 | 0.0000010600075 | FAIL | PASS | SYNTHETIC_FUNCTION_REGRESSION | Upstream additive markup: supply=service*(1+0.15), not 1/(1-0.15) | Upstream additive markup: supply=service*(1+0.15), not 1/(1-0.15)
E1 | mixed_dh0.3_reduction0 | BN | services | heat_service_without_DH_loss | 827191.9101308445 | 4000000 | 4000000 | MWh | 0 | 0 | 3172808.0898691555 | 0.0000049999999999999996 | FAIL | PASS | SYNTHETIC_FUNCTION_REGRESSION
E1 | mixed_dh0.3_reduction0 | BN | services | district_heat_loss | 0 | 114299.99999999997 | 114300 | MWh | 2.9103830456733704e-11 | 2.5462668816039985e-16 | 114300 | 0.0000011142999999999999 | FAIL | PASS | SYNTHETIC_FUNCTION_REGRESSION | Upstream additive markup: supply=service*(1+0.15), not 1/(1-0.15) | Upstream additive markup: supply=service*(1+0.15), not 1/(1-0.15)
E1 | mixed_dh0.3_reduction0 | BN | services | profile_unchanged | 118815.45028754529 | 0 | 0 | MW | 0 | 0 | 118815.45028754529 | 0 | FAIL | PASS | SYNTHETIC_FUNCTION_REGRESSION
E1 | mixed_dh0.3_reduction0 | BN | residential | direct_electricity | 7000000 | 7000000 | 7000000 | MWh | 0 | 0 | 0 | 0.000008 | PASS | PASS | SYNTHETIC_FUNCTION_REGRESSION
E1 | mixed_dh0.3_reduction0 | BN | services | direct_electricity | 3000000 | 3000000 | 3000000 | MWh | 0 | 0 | 0 | 0.000004 | PASS | PASS | SYNTHETIC_FUNCTION_REGRESSION
E1 | mixed_dh0.3_reduction0 | BN | residential | fixed_oil | 2950000 | 2950000.0000000005 | 2950000 | MWh | 4.656612873077393e-10 | 1.5785128383313194e-16 | 0 | 0.00000395 | PASS | PASS | SYNTHETIC_FUNCTION_REGRESSION
E1 | mixed_dh0.3_reduction0 | BN | residential | fixed_gas | 1670000 | 1670000.0000000002 | 1670000.0000000002 | MWh | 0 | 0 | 2.3283064365386963e-10 | 0.00000267 | PASS | PASS | SYNTHETIC_FUNCTION_REGRESSION
E1 | mixed_dh0.3_reduction0 | BN | residential | fixed_biomass | 1030000.0000000001 | 1030000.0000000001 | 1030000.0000000002 | MWh | 1.1641532182693481e-10 | 1.1302458429799495e-16 | 1.1641532182693481e-10 | 0.00000203 | PASS | PASS | SYNTHETIC_FUNCTION_REGRESSION
E1 | mixed_dh0.3_reduction0 | KH | residential | heat_service_without_DH_loss | 737991.6440797118 | 2208500 | 2208500 | MWh | 0 | 0 | 1470508.3559202882 | 0.0000032085 | FAIL | PASS | SYNTHETIC_FUNCTION_REGRESSION
E1 | mixed_dh0.3_reduction0 | KH | residential | district_heat_loss | 0 | 63107.88749999998 | 63107.8875 | MWh | 1.4551915228366852e-11 | 2.305878996245414e-16 | 63107.8875 | 0.0000010631078875 | FAIL | PASS | SYNTHETIC_FUNCTION_REGRESSION | Upstream additive markup: supply=service*(1+0.15), not 1/(1-0.15) | Upstream additive markup: supply=service*(1+0.15), not 1/(1-0.15)
E1 | mixed_dh0.3_reduction0 | KH | services | heat_service_without_DH_loss | 877174.0598745411 | 4190000 | 4190000.000000001 | MWh | 9.313225746154785e-10 | 2.222726908390163e-16 | 3312825.94012546 | 0.00000519 | FAIL | PASS | SYNTHETIC_FUNCTION_REGRESSION
E1 | mixed_dh0.3_reduction0 | KH | services | district_heat_loss | 0 | 119729.24999999997 | 119729.25000000001 | MWh | 4.3655745685100555e-11 | 3.6462055583828136e-16 | 119729.25000000001 | 0.00000111972925 | FAIL | PASS | SYNTHETIC_FUNCTION_REGRESSION | Upstream additive markup: supply=service*(1+0.15), not 1/(1-0.15) | Upstream additive markup: supply=service*(1+0.15), not 1/(1-0.15)
E1 | mixed_dh0.3_reduction0 | KH | services | profile_unchanged | 129702.82240871055 | 0 | 0 | MW | 0 | 0 | 129702.82240871055 | 0 | FAIL | PASS | SYNTHETIC_FUNCTION_REGRESSION
E1 | mixed_dh0.3_reduction0 | KH | residential | direct_electricity | 7210000 | 7210000 | 7210000 | MWh | 0 | 0 | 0 | 0.00000821 | PASS | PASS | SYNTHETIC_FUNCTION_REGRESSION
E1 | mixed_dh0.3_reduction0 | KH | services | direct_electricity | 3110000 | 3110000 | 3110000 | MWh | 0 | 0 | 0 | 0.00000411 | PASS | PASS | SYNTHETIC_FUNCTION_REGRESSION
E1 | mixed_dh0.3_reduction0 | KH | residential | fixed_oil | 3050750 | 3050750 | 3050750 | MWh | 0 | 0 | 0 | 0.00000405075 | PASS | PASS | SYNTHETIC_FUNCTION_REGRESSION
E1 | mixed_dh0.3_reduction0 | KH | residential | fixed_gas | 1730450.0000000002 | 1730449.9999999995 | 1730449.9999999998 | MWh | 2.3283064365386963e-10 | 1.3454918873926992e-16 | 4.656612873077393e-10 | 0.0000027304499999999994 | PASS | PASS | SYNTHETIC_FUNCTION_REGRESSION
E1 | mixed_dh0.3_reduction0 | KH | residential | fixed_biomass | 1070300 | 1070299.9999999998 | 1070300 | MWh | 2.3283064365386963e-10 | 2.1753774049693508e-16 | 0 | 0.0000020703 | PASS | PASS | SYNTHETIC_FUNCTION_REGRESSION
E1 | mixed_dh0.3_reduction0 | ID | residential | heat_service_without_DH_loss | 803040.6436994086 | 2316999.9999999995 | 2316999.9999999995 | MWh | 0 | 0 | 1513959.356300591 | 0.0000033169999999999998 | FAIL | PASS | SYNTHETIC_FUNCTION_REGRESSION
E1 | mixed_dh0.3_reduction0 | ID | residential | district_heat_loss | 0 | 66208.27499999997 | 66208.27499999998 | MWh | 1.4551915228366852e-11 | 2.1978997683245572e-16 | 66208.27499999998 | 0.000001066208275 | FAIL | PASS | SYNTHETIC_FUNCTION_REGRESSION | Upstream additive markup: supply=service*(1+0.15), not 1/(1-0.15) | Upstream additive markup: supply=service*(1+0.15), not 1/(1-0.15)
E1 | mixed_dh0.3_reduction0 | ID | services | heat_service_without_DH_loss | 885995.3765729405 | 4380000 | 4380000 | MWh | 0 | 0 | 3494004.6234270595 | 0.000005379999999999999 | FAIL | PASS | SYNTHETIC_FUNCTION_REGRESSION
E1 | mixed_dh0.3_reduction0 | ID | services | district_heat_loss | 0 | 125158.49999999997 | 125158.5 | MWh | 2.9103830456733704e-11 | 2.325357882743378e-16 | 125158.5 | 0.0000011251585 | FAIL | PASS | SYNTHETIC_FUNCTION_REGRESSION | Upstream additive markup: supply=service*(1+0.15), not 1/(1-0.15) | Upstream additive markup: supply=service*(1+0.15), not 1/(1-0.15)
E1 | mixed_dh0.3_reduction0 | ID | services | profile_unchanged | 127676.15478326692 | 0 | 0 | MW | 0 | 0 | 127676.15478326692 | 0 | FAIL | PASS | SYNTHETIC_FUNCTION_REGRESSION
E1 | mixed_dh0.3_reduction0 | ID | residential | direct_electricity | 7420000 | 7420000 | 7420000 | MWh | 0 | 0 | 0 | 0.00000842 | PASS | PASS | SYNTHETIC_FUNCTION_REGRESSION
E1 | mixed_dh0.3_reduction0 | ID | services | direct_electricity | 3220000 | 3220000 | 3220000 | MWh | 0 | 0 | 0 | 0.00000422 | PASS | PASS | SYNTHETIC_FUNCTION_REGRESSION
E1 | mixed_dh0.3_reduction0 | ID | residential | fixed_oil | 3151500.000000001 | 3151500 | 3151500 | MWh | 0 | 0 | 9.313225746154785e-10 | 0.0000041515 | PASS | PASS | SYNTHETIC_FUNCTION_REGRESSION
E1 | mixed_dh0.3_reduction0 | ID | residential | fixed_gas | 1790900 | 1790899.9999999998 | 1790900 | MWh | 2.3283064365386963e-10 | 1.3000761832255828e-16 | 0 | 0.0000027909 | PASS | PASS | SYNTHETIC_FUNCTION_REGRESSION
E1 | mixed_dh0.3_reduction0 | ID | residential | fixed_biomass | 1110600 | 1110600 | 1110600 | MWh | 0 | 0 | 0 | 0.0000021105999999999997 | PASS | PASS | SYNTHETIC_FUNCTION_REGRESSION
E1 | mixed_dh0.3_reduction0 | LA | residential | heat_service_without_DH_loss | 817142.3014010768 | 2425499.999999999 | 2425499.9999999995 | MWh | 4.656612873077393e-10 | 1.9198568843856496e-16 | 1608357.6985989227 | 0.0000034254999999999996 | FAIL | PASS | SYNTHETIC_FUNCTION_REGRESSION
E1 | mixed_dh0.3_reduction0 | LA | residential | district_heat_loss | 0 | 69308.66249999996 | 69308.66249999998 | MWh | 1.4551915228366852e-11 | 2.099581019669346e-16 | 69308.66249999998 | 0.0000010693086625 | FAIL | PASS | SYNTHETIC_FUNCTION_REGRESSION | Upstream additive markup: supply=service*(1+0.15), not 1/(1-0.15) | Upstream additive markup: supply=service*(1+0.15), not 1/(1-0.15)
E1 | mixed_dh0.3_reduction0 | LA | services | heat_service_without_DH_loss | 959681.4232980134 | 4570000 | 4570000 | MWh | 0 | 0 | 3610318.5767019866 | 0.00000557 | FAIL | PASS | SYNTHETIC_FUNCTION_REGRESSION
E1 | mixed_dh0.3_reduction0 | LA | services | district_heat_loss | 0 | 130587.74999999996 | 130587.75 | MWh | 4.3655745685100555e-11 | 3.3430199758477007e-16 | 130587.75 | 0.00000113058775 | FAIL | PASS | SYNTHETIC_FUNCTION_REGRESSION | Upstream additive markup: supply=service*(1+0.15), not 1/(1-0.15) | Upstream additive markup: supply=service*(1+0.15), not 1/(1-0.15)
E1 | mixed_dh0.3_reduction0 | LA | services | profile_unchanged | 142082.36688013407 | 0 | 0 | MW | 0 | 0 | 142082.36688013407 | 0 | FAIL | PASS | SYNTHETIC_FUNCTION_REGRESSION
E1 | mixed_dh0.3_reduction0 | LA | residential | direct_electricity | 7630000 | 7630000 | 7630000 | MWh | 0 | 0 | 0 | 0.00000863 | PASS | PASS | SYNTHETIC_FUNCTION_REGRESSION
E1 | mixed_dh0.3_reduction0 | LA | services | direct_electricity | 3330000 | 3330000 | 3330000 | MWh | 0 | 0 | 0 | 0.00000433 | PASS | PASS | SYNTHETIC_FUNCTION_REGRESSION
E1 | mixed_dh0.3_reduction0 | LA | residential | fixed_oil | 3252250 | 3252250.000000001 | 3252250 | MWh | 9.313225746154785e-10 | 2.8636254119931694e-16 | 0 | 0.00000425225 | PASS | PASS | SYNTHETIC_FUNCTION_REGRESSION
E1 | mixed_dh0.3_reduction0 | LA | residential | fixed_gas | 1851349.9999999998 | 1851350.0000000005 | 1851350 | MWh | 4.656612873077393e-10 | 2.5152525849123033e-16 | 2.3283064365386963e-10 | 0.00000285135 | PASS | PASS | SYNTHETIC_FUNCTION_REGRESSION
E1 | mixed_dh0.3_reduction0 | LA | residential | fixed_biomass | 1150900 | 1150900.0000000002 | 1150900 | MWh | 2.3283064365386963e-10 | 2.0230310509502965e-16 | 0 | 0.0000021509 | PASS | PASS | SYNTHETIC_FUNCTION_REGRESSION
E1 | mixed_dh0.3_reduction0 | MY | residential | heat_service_without_DH_loss | 837185.0116608744 | 2533999.9999999995 | 2534000 | MWh | 4.656612873077393e-10 | 1.8376530675127832e-16 | 1696814.9883391256 | 0.0000035339999999999995 | FAIL | PASS | SYNTHETIC_FUNCTION_REGRESSION
E1 | mixed_dh0.3_reduction0 | MY | residential | district_heat_loss | 0 | 72409.04999999997 | 72409.04999999999 | MWh | 1.4551915228366852e-11 | 2.0096818323630615e-16 | 72409.04999999999 | 0.00000107240905 | FAIL | PASS | SYNTHETIC_FUNCTION_REGRESSION | Upstream additive markup: supply=service*(1+0.15), not 1/(1-0.15) | Upstream additive markup: supply=service*(1+0.15), not 1/(1-0.15)
E1 | mixed_dh0.3_reduction0 | MY | services | heat_service_without_DH_loss | 1012154.9252207937 | 4760000 | 4760000 | MWh | 0 | 0 | 3747845.0747792064 | 0.00000576 | FAIL | PASS | SYNTHETIC_FUNCTION_REGRESSION
E1 | mixed_dh0.3_reduction0 | MY | services | district_heat_loss | 0 | 136016.99999999994 | 136017 | MWh | 5.820766091346741e-11 | 4.2794401371495774e-16 | 136017 | 0.000001136017 | FAIL | PASS | SYNTHETIC_FUNCTION_REGRESSION | Upstream additive markup: supply=service*(1+0.15), not 1/(1-0.15) | Upstream additive markup: supply=service*(1+0.15), not 1/(1-0.15)
E1 | mixed_dh0.3_reduction0 | MY | services | profile_unchanged | 150582.309652582 | 0 | 0 | MW | 0 | 0 | 150582.309652582 | 0 | FAIL | PASS | SYNTHETIC_FUNCTION_REGRESSION
E1 | mixed_dh0.3_reduction0 | MY | residential | direct_electricity | 7840000 | 7840000 | 7840000 | MWh | 0 | 0 | 0 | 0.00000884 | PASS | PASS | SYNTHETIC_FUNCTION_REGRESSION
E1 | mixed_dh0.3_reduction0 | MY | services | direct_electricity | 3440000 | 3440000 | 3440000 | MWh | 0 | 0 | 0 | 0.00000444 | PASS | PASS | SYNTHETIC_FUNCTION_REGRESSION
E1 | mixed_dh0.3_reduction0 | MY | residential | fixed_oil | 3353000 | 3353000.0000000005 | 3353000 | MWh | 4.656612873077393e-10 | 1.3887900009178028e-16 | 0 | 0.000004353 | PASS | PASS | SYNTHETIC_FUNCTION_REGRESSION
E1 | mixed_dh0.3_reduction0 | MY | residential | fixed_gas | 1911800 | 1911800 | 1911800.0000000002 | MWh | 2.3283064365386963e-10 | 1.21786088321932e-16 | 2.3283064365386963e-10 | 0.0000029118 | PASS | PASS | SYNTHETIC_FUNCTION_REGRESSION
E1 | mixed_dh0.3_reduction0 | MY | residential | fixed_biomass | 1191200 | 1191200.0000000002 | 1191200.0000000002 | MWh | 0 | 0 | 2.3283064365386963e-10 | 0.0000021912000000000003 | PASS | PASS | SYNTHETIC_FUNCTION_REGRESSION
E1 | mixed_dh0.3_reduction0 | MM | residential | heat_service_without_DH_loss | 856394.3864017387 | 2642499.999999999 | 2642499.999999999 | MWh | 0 | 0 | 1786105.6135982603 | 0.0000036424999999999986 | FAIL | PASS | SYNTHETIC_FUNCTION_REGRESSION
E1 | mixed_dh0.3_reduction0 | MM | residential | district_heat_loss | 0 | 75509.43749999996 | 75509.43749999999 | MWh | 2.9103830456733704e-11 | 3.8543301897506136e-16 | 75509.43749999999 | 0.0000010755094374999999 | FAIL | PASS | SYNTHETIC_FUNCTION_REGRESSION | Upstream additive markup: supply=service*(1+0.15), not 1/(1-0.15) | Upstream additive markup: supply=service*(1+0.15), not 1/(1-0.15)
E1 | mixed_dh0.3_reduction0 | MM | services | heat_service_without_DH_loss | 1077570.1240714935 | 4950000 | 4950000 | MWh | 0 | 0 | 3872429.8759285063 | 0.00000595 | FAIL | PASS | SYNTHETIC_FUNCTION_REGRESSION
E1 | mixed_dh0.3_reduction0 | MM | services | district_heat_loss | 0 | 141446.25 | 141446.25 | MWh | 0 | 0 | 141446.25 | 0.00000114144625 | FAIL | PASS | SYNTHETIC_FUNCTION_REGRESSION | Upstream additive markup: supply=service*(1+0.15), not 1/(1-0.15) | Upstream additive markup: supply=service*(1+0.15), not 1/(1-0.15)
E1 | mixed_dh0.3_reduction0 | MM | services | profile_unchanged | 145951.04611949137 | 0 | 0 | MW | 0 | 0 | 145951.04611949137 | 0 | FAIL | PASS | SYNTHETIC_FUNCTION_REGRESSION
E1 | mixed_dh0.3_reduction0 | MM | residential | direct_electricity | 8050000 | 8050000 | 8050000.000000001 | MWh | 9.313225746154785e-10 | 1.1569224529384825e-16 | 9.313225746154785e-10 | 0.000009050000000000001 | PASS | PASS | SYNTHETIC_FUNCTION_REGRESSION
E1 | mixed_dh0.3_reduction0 | MM | services | direct_electricity | 3550000 | 3550000 | 3550000 | MWh | 0 | 0 | 0 | 0.00000455 | PASS | PASS | SYNTHETIC_FUNCTION_REGRESSION
E1 | mixed_dh0.3_reduction0 | MM | residential | fixed_oil | 3453750 | 3453750 | 3453750 | MWh | 0 | 0 | 0 | 0.0000044537499999999995 | PASS | PASS | SYNTHETIC_FUNCTION_REGRESSION
E1 | mixed_dh0.3_reduction0 | MM | residential | fixed_gas | 1972249.9999999995 | 1972249.9999999995 | 1972249.9999999998 | MWh | 2.3283064365386963e-10 | 1.1805331152433497e-16 | 2.3283064365386963e-10 | 0.0000029722499999999994 | PASS | PASS | SYNTHETIC_FUNCTION_REGRESSION
E1 | mixed_dh0.3_reduction0 | MM | residential | fixed_biomass | 1231500 | 1231500 | 1231500 | MWh | 0 | 0 | 0 | 0.0000022314999999999997 | PASS | PASS | SYNTHETIC_FUNCTION_REGRESSION
E1 | mixed_dh0.3_reduction0 | PH | residential | heat_service_without_DH_loss | 931258.0630440998 | 2750999.999999999 | 2750999.999999999 | MWh | 0 | 0 | 1819741.9369558992 | 0.0000037509999999999993 | FAIL | PASS | SYNTHETIC_FUNCTION_REGRESSION
E1 | mixed_dh0.3_reduction0 | PH | residential | district_heat_loss | 0 | 78609.82499999997 | 78609.82499999998 | MWh | 1.4551915228366852e-11 | 1.8511573112351865e-16 | 78609.82499999998 | 0.0000010786098249999999 | FAIL | PASS | SYNTHETIC_FUNCTION_REGRESSION | Upstream additive markup: supply=service*(1+0.15), not 1/(1-0.15) | Upstream additive markup: supply=service*(1+0.15), not 1/(1-0.15)
E1 | mixed_dh0.3_reduction0 | PH | services | heat_service_without_DH_loss | 1073152.043161709 | 5140000 | 5140000 | MWh | 0 | 0 | 4066847.956838291 | 0.00000614 | FAIL | PASS | SYNTHETIC_FUNCTION_REGRESSION
E1 | mixed_dh0.3_reduction0 | PH | services | district_heat_loss | 0 | 146875.49999999997 | 146875.5 | MWh | 2.9103830456733704e-11 | 1.9815306471626447e-16 | 146875.5 | 0.0000011468755 | FAIL | PASS | SYNTHETIC_FUNCTION_REGRESSION | Upstream additive markup: supply=service*(1+0.15), not 1/(1-0.15) | Upstream additive markup: supply=service*(1+0.15), not 1/(1-0.15)
E1 | mixed_dh0.3_reduction0 | PH | services | profile_unchanged | 152173.73013055266 | 0 | 0 | MW | 0 | 0 | 152173.73013055266 | 0 | FAIL | PASS | SYNTHETIC_FUNCTION_REGRESSION
E1 | mixed_dh0.3_reduction0 | PH | residential | direct_electricity | 8260000 | 8260000 | 8260000 | MWh | 0 | 0 | 0 | 0.000009260000000000001 | PASS | PASS | SYNTHETIC_FUNCTION_REGRESSION
E1 | mixed_dh0.3_reduction0 | PH | services | direct_electricity | 3660000 | 3660000 | 3660000 | MWh | 0 | 0 | 0 | 0.00000466 | PASS | PASS | SYNTHETIC_FUNCTION_REGRESSION
E1 | mixed_dh0.3_reduction0 | PH | residential | fixed_oil | 3554500 | 3554500 | 3554500 | MWh | 0 | 0 | 0 | 0.0000045545 | PASS | PASS | SYNTHETIC_FUNCTION_REGRESSION
E1 | mixed_dh0.3_reduction0 | PH | residential | fixed_gas | 2032700 | 2032699.9999999995 | 2032700.0000000002 | MWh | 6.984919309616089e-10 | 3.4362765334855554e-16 | 2.3283064365386963e-10 | 0.0000030326999999999998 | PASS | PASS | SYNTHETIC_FUNCTION_REGRESSION
E1 | mixed_dh0.3_reduction0 | PH | residential | fixed_biomass | 1271800 | 1271799.9999999998 | 1271800 | MWh | 2.3283064365386963e-10 | 1.8307174371274542e-16 | 0 | 0.0000022718 | PASS | PASS | SYNTHETIC_FUNCTION_REGRESSION
E1 | mixed_dh0.3_reduction0 | SG | residential | heat_service_without_DH_loss | 964068.5486178852 | 2859500 | 2859499.9999999995 | MWh | 4.656612873077393e-10 | 1.6284710169880725e-16 | 1895431.4513821143 | 0.000003859499999999999 | FAIL | PASS | SYNTHETIC_FUNCTION_REGRESSION
E1 | mixed_dh0.3_reduction0 | SG | residential | district_heat_loss | 0 | 81710.21249999998 | 81710.21249999998 | MWh | 0 | 0 | 81710.21249999998 | 0.0000010817102124999999 | FAIL | PASS | SYNTHETIC_FUNCTION_REGRESSION | Upstream additive markup: supply=service*(1+0.15), not 1/(1-0.15) | Upstream additive markup: supply=service*(1+0.15), not 1/(1-0.15)
E1 | mixed_dh0.3_reduction0 | SG | services | heat_service_without_DH_loss | 1125803.874955216 | 5330000 | 5330000 | MWh | 0 | 0 | 4204196.125044784 | 0.0000063299999999999995 | FAIL | PASS | SYNTHETIC_FUNCTION_REGRESSION
E1 | mixed_dh0.3_reduction0 | SG | services | district_heat_loss | 0 | 152304.74999999994 | 152304.75 | MWh | 5.820766091346741e-11 | 3.8217889404938063e-16 | 152304.75 | 0.00000115230475 | FAIL | PASS | SYNTHETIC_FUNCTION_REGRESSION | Upstream additive markup: supply=service*(1+0.15), not 1/(1-0.15) | Upstream additive markup: supply=service*(1+0.15), not 1/(1-0.15)
E1 | mixed_dh0.3_reduction0 | SG | services | profile_unchanged | 164680.52228478 | 0 | 0 | MW | 0 | 0 | 164680.52228478 | 0 | FAIL | PASS | SYNTHETIC_FUNCTION_REGRESSION
E1 | mixed_dh0.3_reduction0 | SG | residential | direct_electricity | 8470000 | 8470000 | 8470000 | MWh | 0 | 0 | 0 | 0.00000947 | PASS | PASS | SYNTHETIC_FUNCTION_REGRESSION
E1 | mixed_dh0.3_reduction0 | SG | services | direct_electricity | 3770000 | 3770000 | 3770000 | MWh | 0 | 0 | 0 | 0.00000477 | PASS | PASS | SYNTHETIC_FUNCTION_REGRESSION
E1 | mixed_dh0.3_reduction0 | SG | residential | fixed_oil | 3655250 | 3655250 | 3655250 | MWh | 0 | 0 | 0 | 0.00000465525 | PASS | PASS | SYNTHETIC_FUNCTION_REGRESSION
E1 | mixed_dh0.3_reduction0 | SG | residential | fixed_gas | 2093150 | 2093150 | 2093150 | MWh | 0 | 0 | 0 | 0.00000309315 | PASS | PASS | SYNTHETIC_FUNCTION_REGRESSION
E1 | mixed_dh0.3_reduction0 | SG | residential | fixed_biomass | 1312100 | 1312100 | 1312100 | MWh | 0 | 0 | 0 | 0.0000023121 | PASS | PASS | SYNTHETIC_FUNCTION_REGRESSION
E1 | mixed_dh0.3_reduction0 | TH | residential | heat_service_without_DH_loss | 1036748.4557569425 | 2968000 | 2968000 | MWh | 0 | 0 | 1931251.5442430575 | 0.000003968 | FAIL | PASS | SYNTHETIC_FUNCTION_REGRESSION
E1 | mixed_dh0.3_reduction0 | TH | residential | district_heat_loss | 0 | 84810.59999999996 | 84810.59999999999 | MWh | 2.9103830456733704e-11 | 3.431626525072775e-16 | 84810.59999999999 | 0.0000010848105999999999 | FAIL | PASS | SYNTHETIC_FUNCTION_REGRESSION | Upstream additive markup: supply=service*(1+0.15), not 1/(1-0.15) | Upstream additive markup: supply=service*(1+0.15), not 1/(1-0.15)
E1 | mixed_dh0.3_reduction0 | TH | services | heat_service_without_DH_loss | 1125367.6603626618 | 5519999.999999999 | 5520000 | MWh | 9.313225746154785e-10 | 1.6871785772019538e-16 | 4394632.339637338 | 0.000006519999999999999 | FAIL | PASS | SYNTHETIC_FUNCTION_REGRESSION
E1 | mixed_dh0.3_reduction0 | TH | services | district_heat_loss | 0 | 157733.99999999994 | 157733.99999999997 | MWh | 2.9103830456733704e-11 | 1.84512092869855e-16 | 157733.99999999997 | 0.000001157734 | FAIL | PASS | SYNTHETIC_FUNCTION_REGRESSION | Upstream additive markup: supply=service*(1+0.15), not 1/(1-0.15) | Upstream additive markup: supply=service*(1+0.15), not 1/(1-0.15)
E1 | mixed_dh0.3_reduction0 | TH | services | profile_unchanged | 160623.825536832 | 0 | 0 | MW | 0 | 0 | 160623.825536832 | 0 | FAIL | PASS | SYNTHETIC_FUNCTION_REGRESSION
E1 | mixed_dh0.3_reduction0 | TH | residential | direct_electricity | 8680000 | 8680000 | 8680000 | MWh | 0 | 0 | 0 | 0.00000968 | PASS | PASS | SYNTHETIC_FUNCTION_REGRESSION
E1 | mixed_dh0.3_reduction0 | TH | services | direct_electricity | 3880000.0000000005 | 3880000.0000000005 | 3880000 | MWh | 4.656612873077393e-10 | 1.2001579569787095e-16 | 4.656612873077393e-10 | 0.00000488 | PASS | PASS | SYNTHETIC_FUNCTION_REGRESSION
E1 | mixed_dh0.3_reduction0 | TH | residential | fixed_oil | 3756000 | 3755999.999999999 | 3756000 | MWh | 9.313225746154785e-10 | 2.47955957032875e-16 | 0 | 0.000004756 | PASS | PASS | SYNTHETIC_FUNCTION_REGRESSION
E1 | mixed_dh0.3_reduction0 | TH | residential | fixed_gas | 2153600 | 2153600 | 2153600 | MWh | 0 | 0 | 0 | 0.0000031535999999999998 | PASS | PASS | SYNTHETIC_FUNCTION_REGRESSION
E1 | mixed_dh0.3_reduction0 | TH | residential | fixed_biomass | 1352400 | 1352400 | 1352400 | MWh | 0 | 0 | 0 | 0.0000023523999999999997 | PASS | PASS | SYNTHETIC_FUNCTION_REGRESSION
E1 | mixed_dh0.3_reduction0 | TL | residential | heat_service_without_DH_loss | 1044325.97485008 | 3076499.999999999 | 3076499.999999999 | MWh | 0 | 0 | 2032174.025149919 | 0.000004076499999999999 | FAIL | PASS | SYNTHETIC_FUNCTION_REGRESSION
E1 | mixed_dh0.3_reduction0 | TL | residential | district_heat_loss | 0 | 87910.98749999997 | 87910.98749999997 | MWh | 0 | 0 | 87910.98749999997 | 0.0000010879109874999999 | FAIL | PASS | SYNTHETIC_FUNCTION_REGRESSION | Upstream additive markup: supply=service*(1+0.15), not 1/(1-0.15) | Upstream additive markup: supply=service*(1+0.15), not 1/(1-0.15)
E1 | mixed_dh0.3_reduction0 | TL | services | heat_service_without_DH_loss | 1208174.7152441125 | 5709999.999999998 | 5710000 | MWh | 1.862645149230957e-9 | 3.2620755678300474e-16 | 4501825.284755887 | 0.000006709999999999999 | FAIL | PASS | SYNTHETIC_FUNCTION_REGRESSION
E1 | mixed_dh0.3_reduction0 | TL | services | district_heat_loss | 0 | 163163.24999999994 | 163163.25 | MWh | 5.820766091346741e-11 | 3.567449221161469e-16 | 163163.25 | 0.00000116316325 | FAIL | PASS | SYNTHETIC_FUNCTION_REGRESSION | Upstream additive markup: supply=service*(1+0.15), not 1/(1-0.15) | Upstream additive markup: supply=service*(1+0.15), not 1/(1-0.15)
E1 | mixed_dh0.3_reduction0 | TL | services | profile_unchanged | 176979.12874624395 | 0 | 0 | MW | 0 | 0 | 176979.12874624395 | 0 | FAIL | PASS | SYNTHETIC_FUNCTION_REGRESSION
E1 | mixed_dh0.3_reduction0 | TL | residential | direct_electricity | 8890000 | 8890000 | 8890000 | MWh | 0 | 0 | 0 | 0.00000989 | PASS | PASS | SYNTHETIC_FUNCTION_REGRESSION
E1 | mixed_dh0.3_reduction0 | TL | services | direct_electricity | 3990000 | 3990000 | 3990000 | MWh | 0 | 0 | 0 | 0.00000499 | PASS | PASS | SYNTHETIC_FUNCTION_REGRESSION
E1 | mixed_dh0.3_reduction0 | TL | residential | fixed_oil | 3856750 | 3856750 | 3856750 | MWh | 0 | 0 | 0 | 0.00000485675 | PASS | PASS | SYNTHETIC_FUNCTION_REGRESSION
E1 | mixed_dh0.3_reduction0 | TL | residential | fixed_gas | 2214050 | 2214050 | 2214050 | MWh | 0 | 0 | 0 | 0.00000321405 | PASS | PASS | SYNTHETIC_FUNCTION_REGRESSION
E1 | mixed_dh0.3_reduction0 | TL | residential | fixed_biomass | 1392700.0000000002 | 1392700 | 1392700 | MWh | 0 | 0 | 2.3283064365386963e-10 | 0.0000023927 | PASS | PASS | SYNTHETIC_FUNCTION_REGRESSION
E1 | mixed_dh0.3_reduction0 | VN | residential | heat_service_without_DH_loss | 1059718.0440656594 | 3184999.999999999 | 3184999.9999999995 | MWh | 4.656612873077393e-10 | 1.4620448581090717e-16 | 2125281.95593434 | 0.000004185 | FAIL | PASS | SYNTHETIC_FUNCTION_REGRESSION
E1 | mixed_dh0.3_reduction0 | VN | residential | district_heat_loss | 0 | 91011.37499999997 | 91011.37499999999 | MWh | 1.4551915228366852e-11 | 1.5989116995943478e-16 | 91011.37499999999 | 0.0000010910113749999999 | FAIL | PASS | SYNTHETIC_FUNCTION_REGRESSION | Upstream additive markup: supply=service*(1+0.15), not 1/(1-0.15) | Upstream additive markup: supply=service*(1+0.15), not 1/(1-0.15)
E1 | mixed_dh0.3_reduction0 | VN | services | heat_service_without_DH_loss | 1263450.1471808902 | 5900000 | 5900000 | MWh | 0 | 0 | 4636549.852819109 | 0.0000069 | FAIL | PASS | SYNTHETIC_FUNCTION_REGRESSION
E1 | mixed_dh0.3_reduction0 | VN | services | district_heat_loss | 0 | 168592.49999999994 | 168592.5 | MWh | 5.820766091346741e-11 | 3.4525652631918625e-16 | 168592.5 | 0.0000011685925 | FAIL | PASS | SYNTHETIC_FUNCTION_REGRESSION | Upstream additive markup: supply=service*(1+0.15), not 1/(1-0.15) | Upstream additive markup: supply=service*(1+0.15), not 1/(1-0.15)
E1 | mixed_dh0.3_reduction0 | VN | services | profile_unchanged | 186427.6509519597 | 0 | 0 | MW | 0 | 0 | 186427.6509519597 | 0 | FAIL | PASS | SYNTHETIC_FUNCTION_REGRESSION
E1 | mixed_dh0.3_reduction0 | VN | residential | direct_electricity | 9100000 | 9100000 | 9100000 | MWh | 0 | 0 | 0 | 0.0000101 | PASS | PASS | SYNTHETIC_FUNCTION_REGRESSION
E1 | mixed_dh0.3_reduction0 | VN | services | direct_electricity | 4099999.9999999995 | 4099999.9999999995 | 4099999.9999999995 | MWh | 0 | 0 | 0 | 0.0000050999999999999995 | PASS | PASS | SYNTHETIC_FUNCTION_REGRESSION
E1 | mixed_dh0.3_reduction0 | VN | residential | fixed_oil | 3957500.0000000005 | 3957500 | 3957500 | MWh | 0 | 0 | 4.656612873077393e-10 | 0.0000049574999999999995 | PASS | PASS | SYNTHETIC_FUNCTION_REGRESSION
E1 | mixed_dh0.3_reduction0 | VN | residential | fixed_gas | 2274500 | 2274500 | 2274499.9999999995 | MWh | 4.656612873077393e-10 | 2.0473127602010963e-16 | 4.656612873077393e-10 | 0.0000032744999999999997 | PASS | PASS | SYNTHETIC_FUNCTION_REGRESSION
E1 | mixed_dh0.3_reduction0 | VN | residential | fixed_biomass | 1433000 | 1433000 | 1433000 | MWh | 0 | 0 | 0 | 0.000002433 | PASS | PASS | SYNTHETIC_FUNCTION_REGRESSION
E1 | mixed_dh0.3_reduction0 | ALL | R+S | finite_nonnegative | true | true | true | boolean | 0 | 0 | 0 | 0 | PASS | PASS | SYNTHETIC_FUNCTION_REGRESSION
E1 | all_service_dh0.3_reduction0 | BN | residential | heat_service_without_DH_loss | 3542214.5080164745 | 6000000 | 5999999.999999999 | MWh | 9.313225746154785e-10 | 1.5522042910257979e-16 | 2457785.4919835245 | 0.000006999999999999999 | FAIL | PASS | SYNTHETIC_FUNCTION_REGRESSION
E1 | all_service_dh0.3_reduction0 | BN | residential | district_heat_loss | 0 | 171450 | 171449.99999999997 | MWh | 2.9103830456733704e-11 | 1.697511254402666e-16 | 171449.99999999997 | 0.00000117145 | FAIL | PASS | SYNTHETIC_FUNCTION_REGRESSION | Upstream additive markup: supply=service*(1+0.15), not 1/(1-0.15) | Upstream additive markup: supply=service*(1+0.15), not 1/(1-0.15)
E1 | all_service_dh0.3_reduction0 | BN | services | heat_service_without_DH_loss | 1456472.4716897612 | 4000000 | 4000000 | MWh | 0 | 0 | 2543527.528310239 | 0.0000049999999999999996 | FAIL | PASS | SYNTHETIC_FUNCTION_REGRESSION
E1 | all_service_dh0.3_reduction0 | BN | services | district_heat_loss | 0 | 114299.99999999997 | 114300 | MWh | 2.9103830456733704e-11 | 2.5462668816039985e-16 | 114300 | 0.0000011142999999999999 | FAIL | PASS | SYNTHETIC_FUNCTION_REGRESSION | Upstream additive markup: supply=service*(1+0.15), not 1/(1-0.15) | Upstream additive markup: supply=service*(1+0.15), not 1/(1-0.15)
E1 | all_service_dh0.3_reduction0 | BN | services | profile_unchanged | 97945.89857391364 | 0 | 0 | MW | 0 | 0 | 97945.89857391364 | 0 | FAIL | PASS | SYNTHETIC_FUNCTION_REGRESSION
E1 | all_service_dh0.3_reduction0 | BN | residential | direct_electricity | 7000000 | 7000000 | 7000000 | MWh | 0 | 0 | 0 | 0.000008 | PASS | PASS | SYNTHETIC_FUNCTION_REGRESSION
E1 | all_service_dh0.3_reduction0 | BN | services | direct_electricity | 3000000 | 3000000 | 3000000 | MWh | 0 | 0 | 0 | 0.000004 | PASS | PASS | SYNTHETIC_FUNCTION_REGRESSION
E1 | all_service_dh0.3_reduction0 | BN | residential | fixed_oil | 1000000 | 1000000 | 1000000 | MWh | 0 | 0 | 0 | 0.000002 | PASS | PASS | SYNTHETIC_FUNCTION_REGRESSION
E1 | all_service_dh0.3_reduction0 | BN | residential | fixed_gas | 500000 | 500000 | 500000 | MWh | 0 | 0 | 0 | 0.0000015 | PASS | PASS | SYNTHETIC_FUNCTION_REGRESSION
E1 | all_service_dh0.3_reduction0 | BN | residential | fixed_biomass | 250000 | 250000 | 250000 | MWh | 0 | 0 | 0 | 0.0000012499999999999999 | PASS | PASS | SYNTHETIC_FUNCTION_REGRESSION
E1 | all_service_dh0.3_reduction0 | KH | residential | heat_service_without_DH_loss | 3717442.6446351623 | 6309999.999999998 | 6310000 | MWh | 1.862645149230957e-9 | 2.9518940558335296e-16 | 2592557.3553648377 | 0.0000073099999999999995 | FAIL | PASS | SYNTHETIC_FUNCTION_REGRESSION
E1 | all_service_dh0.3_reduction0 | KH | residential | district_heat_loss | 0 | 180308.24999999994 | 180308.25 | MWh | 5.820766091346741e-11 | 3.22823059474358e-16 | 180308.25 | 0.00000118030825 | FAIL | PASS | SYNTHETIC_FUNCTION_REGRESSION | Upstream additive markup: supply=service*(1+0.15), not 1/(1-0.15) | Upstream additive markup: supply=service*(1+0.15), not 1/(1-0.15)
E1 | all_service_dh0.3_reduction0 | KH | services | heat_service_without_DH_loss | 1546488.3635018608 | 4190000 | 4190000.000000001 | MWh | 9.313225746154785e-10 | 2.222726908390163e-16 | 2643511.63649814 | 0.00000519 | FAIL | PASS | SYNTHETIC_FUNCTION_REGRESSION
E1 | all_service_dh0.3_reduction0 | KH | services | district_heat_loss | 0 | 119729.24999999997 | 119729.25000000001 | MWh | 4.3655745685100555e-11 | 3.6462055583828136e-16 | 119729.25000000001 | 0.00000111972925 | FAIL | PASS | SYNTHETIC_FUNCTION_REGRESSION | Upstream additive markup: supply=service*(1+0.15), not 1/(1-0.15) | Upstream additive markup: supply=service*(1+0.15), not 1/(1-0.15)
E1 | all_service_dh0.3_reduction0 | KH | services | profile_unchanged | 108802.53733362423 | 0 | 0 | MW | 0 | 0 | 108802.53733362423 | 0 | FAIL | PASS | SYNTHETIC_FUNCTION_REGRESSION
E1 | all_service_dh0.3_reduction0 | KH | residential | direct_electricity | 7210000 | 7210000 | 7210000 | MWh | 0 | 0 | 0 | 0.00000821 | PASS | PASS | SYNTHETIC_FUNCTION_REGRESSION
E1 | all_service_dh0.3_reduction0 | KH | services | direct_electricity | 3110000 | 3110000 | 3110000 | MWh | 0 | 0 | 0 | 0.00000411 | PASS | PASS | SYNTHETIC_FUNCTION_REGRESSION
E1 | all_service_dh0.3_reduction0 | KH | residential | fixed_oil | 1000000 | 1000000 | 1000000 | MWh | 0 | 0 | 0 | 0.000002 | PASS | PASS | SYNTHETIC_FUNCTION_REGRESSION
E1 | all_service_dh0.3_reduction0 | KH | residential | fixed_gas | 500000 | 500000 | 500000 | MWh | 0 | 0 | 0 | 0.0000015 | PASS | PASS | SYNTHETIC_FUNCTION_REGRESSION
E1 | all_service_dh0.3_reduction0 | KH | residential | fixed_biomass | 250000 | 250000 | 250000 | MWh | 0 | 0 | 0 | 0.0000012499999999999999 | PASS | PASS | SYNTHETIC_FUNCTION_REGRESSION
E1 | all_service_dh0.3_reduction0 | ID | residential | heat_service_without_DH_loss | 3988313.974339994 | 6619999.999999998 | 6619999.999999999 | MWh | 9.313225746154785e-10 | 1.4068316837091821e-16 | 2631686.025660005 | 0.000007619999999999999 | FAIL | PASS | SYNTHETIC_FUNCTION_REGRESSION
E1 | all_service_dh0.3_reduction0 | ID | residential | district_heat_loss | 0 | 189166.4999999999 | 189166.49999999997 | MWh | 5.820766091346741e-11 | 3.0770596756543795e-16 | 189166.49999999997 | 0.0000011891665 | FAIL | PASS | SYNTHETIC_FUNCTION_REGRESSION | Upstream additive markup: supply=service*(1+0.15), not 1/(1-0.15) | Upstream additive markup: supply=service*(1+0.15), not 1/(1-0.15)
E1 | all_service_dh0.3_reduction0 | ID | services | heat_service_without_DH_loss | 1540108.4854905712 | 4380000 | 4380000 | MWh | 0 | 0 | 2839891.5145094288 | 0.000005379999999999999 | FAIL | PASS | SYNTHETIC_FUNCTION_REGRESSION
E1 | all_service_dh0.3_reduction0 | ID | services | district_heat_loss | 0 | 125158.49999999997 | 125158.5 | MWh | 2.9103830456733704e-11 | 2.325357882743378e-16 | 125158.5 | 0.0000011251585 | FAIL | PASS | SYNTHETIC_FUNCTION_REGRESSION | Upstream additive markup: supply=service*(1+0.15), not 1/(1-0.15) | Upstream additive markup: supply=service*(1+0.15), not 1/(1-0.15)
E1 | all_service_dh0.3_reduction0 | ID | services | profile_unchanged | 106562.1643381255 | 0 | 0 | MW | 0 | 0 | 106562.1643381255 | 0 | FAIL | PASS | SYNTHETIC_FUNCTION_REGRESSION
E1 | all_service_dh0.3_reduction0 | ID | residential | direct_electricity | 7420000 | 7420000 | 7420000 | MWh | 0 | 0 | 0 | 0.00000842 | PASS | PASS | SYNTHETIC_FUNCTION_REGRESSION
E1 | all_service_dh0.3_reduction0 | ID | services | direct_electricity | 3220000 | 3220000 | 3220000 | MWh | 0 | 0 | 0 | 0.00000422 | PASS | PASS | SYNTHETIC_FUNCTION_REGRESSION
E1 | all_service_dh0.3_reduction0 | ID | residential | fixed_oil | 1000000 | 1000000 | 1000000 | MWh | 0 | 0 | 0 | 0.000002 | PASS | PASS | SYNTHETIC_FUNCTION_REGRESSION
E1 | all_service_dh0.3_reduction0 | ID | residential | fixed_gas | 500000 | 500000 | 500000 | MWh | 0 | 0 | 0 | 0.0000015 | PASS | PASS | SYNTHETIC_FUNCTION_REGRESSION
E1 | all_service_dh0.3_reduction0 | ID | residential | fixed_biomass | 250000 | 250000 | 250000 | MWh | 0 | 0 | 0 | 0.0000012499999999999999 | PASS | PASS | SYNTHETIC_FUNCTION_REGRESSION
E1 | all_service_dh0.3_reduction0 | LA | residential | heat_service_without_DH_loss | 4103274.7785807475 | 6930000 | 6929999.999999999 | MWh | 9.313225746154785e-10 | 1.3438998190699546e-16 | 2826725.2214192515 | 0.000007929999999999999 | FAIL | PASS | SYNTHETIC_FUNCTION_REGRESSION
E1 | all_service_dh0.3_reduction0 | LA | residential | district_heat_loss | 0 | 198024.7499999999 | 198024.74999999997 | MWh | 5.820766091346741e-11 | 2.9394134275370837e-16 | 198024.74999999997 | 0.00000119802475 | FAIL | PASS | SYNTHETIC_FUNCTION_REGRESSION | Upstream additive markup: supply=service*(1+0.15), not 1/(1-0.15) | Upstream additive markup: supply=service*(1+0.15), not 1/(1-0.15)
E1 | all_service_dh0.3_reduction0 | LA | services | heat_service_without_DH_loss | 1686661.9198746425 | 4570000 | 4570000 | MWh | 0 | 0 | 2883338.0801253575 | 0.00000557 | FAIL | PASS | SYNTHETIC_FUNCTION_REGRESSION
E1 | all_service_dh0.3_reduction0 | LA | services | district_heat_loss | 0 | 130587.74999999996 | 130587.75 | MWh | 4.3655745685100555e-11 | 3.3430199758477007e-16 | 130587.75 | 0.00000113058775 | FAIL | PASS | SYNTHETIC_FUNCTION_REGRESSION | Upstream additive markup: supply=service*(1+0.15), not 1/(1-0.15) | Upstream additive markup: supply=service*(1+0.15), not 1/(1-0.15)
E1 | all_service_dh0.3_reduction0 | LA | services | profile_unchanged | 120539.95917128274 | 0 | 0 | MW | 0 | 0 | 120539.95917128274 | 0 | FAIL | PASS | SYNTHETIC_FUNCTION_REGRESSION
E1 | all_service_dh0.3_reduction0 | LA | residential | direct_electricity | 7630000 | 7630000 | 7630000 | MWh | 0 | 0 | 0 | 0.00000863 | PASS | PASS | SYNTHETIC_FUNCTION_REGRESSION
E1 | all_service_dh0.3_reduction0 | LA | services | direct_electricity | 3330000 | 3330000 | 3330000 | MWh | 0 | 0 | 0 | 0.00000433 | PASS | PASS | SYNTHETIC_FUNCTION_REGRESSION
E1 | all_service_dh0.3_reduction0 | LA | residential | fixed_oil | 1000000 | 1000000 | 1000000 | MWh | 0 | 0 | 0 | 0.000002 | PASS | PASS | SYNTHETIC_FUNCTION_REGRESSION
E1 | all_service_dh0.3_reduction0 | LA | residential | fixed_gas | 500000 | 500000 | 500000 | MWh | 0 | 0 | 0 | 0.0000015 | PASS | PASS | SYNTHETIC_FUNCTION_REGRESSION
E1 | all_service_dh0.3_reduction0 | LA | residential | fixed_biomass | 250000 | 250000 | 250000 | MWh | 0 | 0 | 0 | 0.0000012499999999999999 | PASS | PASS | SYNTHETIC_FUNCTION_REGRESSION
E1 | all_service_dh0.3_reduction0 | MY | residential | heat_service_without_DH_loss | 4235445.0819740575 | 7240000 | 7240000 | MWh | 0 | 0 | 3004554.9180259425 | 0.00000824 | FAIL | PASS | SYNTHETIC_FUNCTION_REGRESSION
E1 | all_service_dh0.3_reduction0 | MY | residential | district_heat_loss | 0 | 206882.99999999994 | 206883 | MWh | 5.820766091346741e-11 | 2.813554565308286e-16 | 206883 | 0.000001206883 | FAIL | PASS | SYNTHETIC_FUNCTION_REGRESSION | Upstream additive markup: supply=service*(1+0.15), not 1/(1-0.15) | Upstream additive markup: supply=service*(1+0.15), not 1/(1-0.15)
E1 | all_service_dh0.3_reduction0 | MY | services | heat_service_without_DH_loss | 1792225.4808421847 | 4760000 | 4760000 | MWh | 0 | 0 | 2967774.5191578153 | 0.00000576 | FAIL | PASS | SYNTHETIC_FUNCTION_REGRESSION
E1 | all_service_dh0.3_reduction0 | MY | services | district_heat_loss | 0 | 136016.99999999994 | 136017 | MWh | 5.820766091346741e-11 | 4.2794401371495774e-16 | 136017 | 0.000001136017 | FAIL | PASS | SYNTHETIC_FUNCTION_REGRESSION | Upstream additive markup: supply=service*(1+0.15), not 1/(1-0.15) | Upstream additive markup: supply=service*(1+0.15), not 1/(1-0.15)
E1 | all_service_dh0.3_reduction0 | MY | services | profile_unchanged | 131407.03218948474 | 0 | 0 | MW | 0 | 0 | 131407.03218948474 | 0 | FAIL | PASS | SYNTHETIC_FUNCTION_REGRESSION
E1 | all_service_dh0.3_reduction0 | MY | residential | direct_electricity | 7840000 | 7840000 | 7840000 | MWh | 0 | 0 | 0 | 0.00000884 | PASS | PASS | SYNTHETIC_FUNCTION_REGRESSION
E1 | all_service_dh0.3_reduction0 | MY | services | direct_electricity | 3440000 | 3440000 | 3440000 | MWh | 0 | 0 | 0 | 0.00000444 | PASS | PASS | SYNTHETIC_FUNCTION_REGRESSION
E1 | all_service_dh0.3_reduction0 | MY | residential | fixed_oil | 1000000 | 1000000 | 1000000 | MWh | 0 | 0 | 0 | 0.000002 | PASS | PASS | SYNTHETIC_FUNCTION_REGRESSION
E1 | all_service_dh0.3_reduction0 | MY | residential | fixed_gas | 500000 | 500000 | 500000 | MWh | 0 | 0 | 0 | 0.0000015 | PASS | PASS | SYNTHETIC_FUNCTION_REGRESSION
E1 | all_service_dh0.3_reduction0 | MY | residential | fixed_biomass | 250000 | 250000 | 250000 | MWh | 0 | 0 | 0 | 0.0000012499999999999999 | PASS | PASS | SYNTHETIC_FUNCTION_REGRESSION
E1 | all_service_dh0.3_reduction0 | MM | residential | heat_service_without_DH_loss | 4364252.98206863 | 7549999.999999999 | 7549999.999999998 | MWh | 9.313225746154785e-10 | 1.2335398339277863e-16 | 3185747.017931368 | 0.000008549999999999998 | FAIL | PASS | SYNTHETIC_FUNCTION_REGRESSION
E1 | all_service_dh0.3_reduction0 | MM | residential | district_heat_loss | 0 | 215741.24999999994 | 215741.24999999997 | MWh | 2.9103830456733704e-11 | 1.3490155664127146e-16 | 215741.24999999997 | 0.00000121574125 | FAIL | PASS | SYNTHETIC_FUNCTION_REGRESSION | Upstream additive markup: supply=service*(1+0.15), not 1/(1-0.15) | Upstream additive markup: supply=service*(1+0.15), not 1/(1-0.15)
E1 | all_service_dh0.3_reduction0 | MM | services | heat_service_without_DH_loss | 1921983.6628008229 | 4950000 | 4950000 | MWh | 0 | 0 | 3028016.337199177 | 0.00000595 | FAIL | PASS | SYNTHETIC_FUNCTION_REGRESSION
E1 | all_service_dh0.3_reduction0 | MM | services | district_heat_loss | 0 | 141446.25 | 141446.25 | MWh | 0 | 0 | 141446.25 | 0.00000114144625 | FAIL | PASS | SYNTHETIC_FUNCTION_REGRESSION | Upstream additive markup: supply=service*(1+0.15), not 1/(1-0.15) | Upstream additive markup: supply=service*(1+0.15), not 1/(1-0.15)
E1 | all_service_dh0.3_reduction0 | MM | services | profile_unchanged | 104473.74762581344 | 0 | 0 | MW | 0 | 0 | 104473.74762581344 | 0 | FAIL | PASS | SYNTHETIC_FUNCTION_REGRESSION
E1 | all_service_dh0.3_reduction0 | MM | residential | direct_electricity | 8050000 | 8050000 | 8050000.000000001 | MWh | 9.313225746154785e-10 | 1.1569224529384825e-16 | 9.313225746154785e-10 | 0.000009050000000000001 | PASS | PASS | SYNTHETIC_FUNCTION_REGRESSION
E1 | all_service_dh0.3_reduction0 | MM | services | direct_electricity | 3550000 | 3550000 | 3550000 | MWh | 0 | 0 | 0 | 0.00000455 | PASS | PASS | SYNTHETIC_FUNCTION_REGRESSION
E1 | all_service_dh0.3_reduction0 | MM | residential | fixed_oil | 1000000 | 1000000 | 1000000 | MWh | 0 | 0 | 0 | 0.000002 | PASS | PASS | SYNTHETIC_FUNCTION_REGRESSION
E1 | all_service_dh0.3_reduction0 | MM | residential | fixed_gas | 500000 | 500000 | 500000 | MWh | 0 | 0 | 0 | 0.0000015 | PASS | PASS | SYNTHETIC_FUNCTION_REGRESSION
E1 | all_service_dh0.3_reduction0 | MM | residential | fixed_biomass | 250000 | 250000 | 250000 | MWh | 0 | 0 | 0 | 0.0000012499999999999999 | PASS | PASS | SYNTHETIC_FUNCTION_REGRESSION
E1 | all_service_dh0.3_reduction0 | PH | residential | heat_service_without_DH_loss | 4667669.270481575 | 7859999.999999998 | 7859999.999999998 | MWh | 0 | 0 | 3192330.729518423 | 0.000008859999999999998 | FAIL | PASS | SYNTHETIC_FUNCTION_REGRESSION
E1 | all_service_dh0.3_reduction0 | PH | residential | district_heat_loss | 0 | 224599.49999999994 | 224599.49999999997 | MWh | 2.9103830456733704e-11 | 1.2958101178646305e-16 | 224599.49999999997 | 0.0000012245995 | FAIL | PASS | SYNTHETIC_FUNCTION_REGRESSION | Upstream additive markup: supply=service*(1+0.15), not 1/(1-0.15) | Upstream additive markup: supply=service*(1+0.15), not 1/(1-0.15)
E1 | all_service_dh0.3_reduction0 | PH | services | heat_service_without_DH_loss | 1882605.53612423 | 5140000 | 5140000 | MWh | 0 | 0 | 3257394.46387577 | 0.00000614 | FAIL | PASS | SYNTHETIC_FUNCTION_REGRESSION
E1 | all_service_dh0.3_reduction0 | PH | services | district_heat_loss | 0 | 146875.49999999997 | 146875.5 | MWh | 2.9103830456733704e-11 | 1.9815306471626447e-16 | 146875.5 | 0.0000011468755 | FAIL | PASS | SYNTHETIC_FUNCTION_REGRESSION | Upstream additive markup: supply=service*(1+0.15), not 1/(1-0.15) | Upstream additive markup: supply=service*(1+0.15), not 1/(1-0.15)
E1 | all_service_dh0.3_reduction0 | PH | services | profile_unchanged | 125541.92908769415 | 0 | 0 | MW | 0 | 0 | 125541.92908769415 | 0 | FAIL | PASS | SYNTHETIC_FUNCTION_REGRESSION
E1 | all_service_dh0.3_reduction0 | PH | residential | direct_electricity | 8260000 | 8260000 | 8260000 | MWh | 0 | 0 | 0 | 0.000009260000000000001 | PASS | PASS | SYNTHETIC_FUNCTION_REGRESSION
E1 | all_service_dh0.3_reduction0 | PH | services | direct_electricity | 3660000 | 3660000 | 3660000 | MWh | 0 | 0 | 0 | 0.00000466 | PASS | PASS | SYNTHETIC_FUNCTION_REGRESSION
E1 | all_service_dh0.3_reduction0 | PH | residential | fixed_oil | 1000000 | 1000000 | 1000000 | MWh | 0 | 0 | 0 | 0.000002 | PASS | PASS | SYNTHETIC_FUNCTION_REGRESSION
E1 | all_service_dh0.3_reduction0 | PH | residential | fixed_gas | 500000 | 500000 | 500000 | MWh | 0 | 0 | 0 | 0.0000015 | PASS | PASS | SYNTHETIC_FUNCTION_REGRESSION
E1 | all_service_dh0.3_reduction0 | PH | residential | fixed_biomass | 250000 | 250000 | 250000 | MWh | 0 | 0 | 0 | 0.0000012499999999999999 | PASS | PASS | SYNTHETIC_FUNCTION_REGRESSION
E1 | all_service_dh0.3_reduction0 | SG | residential | heat_service_without_DH_loss | 4839685.025294841 | 8170000 | 8169999.999999999 | MWh | 9.313225746154785e-10 | 1.1399297118916508e-16 | 3330314.974705158 | 0.00000917 | FAIL | PASS | SYNTHETIC_FUNCTION_REGRESSION
E1 | all_service_dh0.3_reduction0 | SG | residential | district_heat_loss | 0 | 233457.7499999999 | 233457.74999999997 | MWh | 5.820766091346741e-11 | 2.493284584189962e-16 | 233457.74999999997 | 0.00000123345775 | FAIL | PASS | SYNTHETIC_FUNCTION_REGRESSION | Upstream additive markup: supply=service*(1+0.15), not 1/(1-0.15) | Upstream additive markup: supply=service*(1+0.15), not 1/(1-0.15)
E1 | all_service_dh0.3_reduction0 | SG | services | heat_service_without_DH_loss | 1978062.303762312 | 5330000 | 5330000 | MWh | 0 | 0 | 3351937.696237688 | 0.0000063299999999999995 | FAIL | PASS | SYNTHETIC_FUNCTION_REGRESSION
E1 | all_service_dh0.3_reduction0 | SG | services | district_heat_loss | 0 | 152304.74999999994 | 152304.75 | MWh | 5.820766091346741e-11 | 3.8217889404938063e-16 | 152304.75 | 0.00000115230475 | FAIL | PASS | SYNTHETIC_FUNCTION_REGRESSION | Upstream additive markup: supply=service*(1+0.15), not 1/(1-0.15) | Upstream additive markup: supply=service*(1+0.15), not 1/(1-0.15)
E1 | all_service_dh0.3_reduction0 | SG | services | profile_unchanged | 138067.54834536213 | 0 | 0 | MW | 0 | 0 | 138067.54834536213 | 0 | FAIL | PASS | SYNTHETIC_FUNCTION_REGRESSION
E1 | all_service_dh0.3_reduction0 | SG | residential | direct_electricity | 8470000 | 8470000 | 8470000 | MWh | 0 | 0 | 0 | 0.00000947 | PASS | PASS | SYNTHETIC_FUNCTION_REGRESSION
E1 | all_service_dh0.3_reduction0 | SG | services | direct_electricity | 3770000 | 3770000 | 3770000 | MWh | 0 | 0 | 0 | 0.00000477 | PASS | PASS | SYNTHETIC_FUNCTION_REGRESSION
E1 | all_service_dh0.3_reduction0 | SG | residential | fixed_oil | 1000000 | 1000000 | 1000000 | MWh | 0 | 0 | 0 | 0.000002 | PASS | PASS | SYNTHETIC_FUNCTION_REGRESSION
E1 | all_service_dh0.3_reduction0 | SG | residential | fixed_gas | 500000 | 500000 | 500000 | MWh | 0 | 0 | 0 | 0.0000015 | PASS | PASS | SYNTHETIC_FUNCTION_REGRESSION
E1 | all_service_dh0.3_reduction0 | SG | residential | fixed_biomass | 250000 | 250000 | 250000 | MWh | 0 | 0 | 0 | 0.0000012499999999999999 | PASS | PASS | SYNTHETIC_FUNCTION_REGRESSION
E1 | all_service_dh0.3_reduction0 | TH | residential | heat_service_without_DH_loss | 5133237.708190912 | 8480000 | 8480000 | MWh | 0 | 0 | 3346762.2918090876 | 0.00000948 | FAIL | PASS | SYNTHETIC_FUNCTION_REGRESSION
E1 | all_service_dh0.3_reduction0 | TH | residential | district_heat_loss | 0 | 242315.99999999994 | 242316 | MWh | 5.820766091346741e-11 | 2.402138567550942e-16 | 242316 | 0.000001242316 | FAIL | PASS | SYNTHETIC_FUNCTION_REGRESSION | Upstream additive markup: supply=service*(1+0.15), not 1/(1-0.15) | Upstream additive markup: supply=service*(1+0.15), not 1/(1-0.15)
E1 | all_service_dh0.3_reduction0 | TH | services | heat_service_without_DH_loss | 1950205.845194219 | 5519999.999999999 | 5520000 | MWh | 9.313225746154785e-10 | 1.6871785772019538e-16 | 3569794.1548057813 | 0.000006519999999999999 | FAIL | PASS | SYNTHETIC_FUNCTION_REGRESSION
E1 | all_service_dh0.3_reduction0 | TH | services | district_heat_loss | 0 | 157733.99999999994 | 157733.99999999997 | MWh | 2.9103830456733704e-11 | 1.84512092869855e-16 | 157733.99999999997 | 0.000001157734 | FAIL | PASS | SYNTHETIC_FUNCTION_REGRESSION | Upstream additive markup: supply=service*(1+0.15), not 1/(1-0.15) | Upstream additive markup: supply=service*(1+0.15), not 1/(1-0.15)
E1 | all_service_dh0.3_reduction0 | TH | services | profile_unchanged | 133999.0334085422 | 0 | 0 | MW | 0 | 0 | 133999.0334085422 | 0 | FAIL | PASS | SYNTHETIC_FUNCTION_REGRESSION
E1 | all_service_dh0.3_reduction0 | TH | residential | direct_electricity | 8680000 | 8680000 | 8680000 | MWh | 0 | 0 | 0 | 0.00000968 | PASS | PASS | SYNTHETIC_FUNCTION_REGRESSION
E1 | all_service_dh0.3_reduction0 | TH | services | direct_electricity | 3880000.0000000005 | 3880000.0000000005 | 3880000 | MWh | 4.656612873077393e-10 | 1.2001579569787095e-16 | 4.656612873077393e-10 | 0.00000488 | PASS | PASS | SYNTHETIC_FUNCTION_REGRESSION
E1 | all_service_dh0.3_reduction0 | TH | residential | fixed_oil | 1000000 | 1000000 | 1000000 | MWh | 0 | 0 | 0 | 0.000002 | PASS | PASS | SYNTHETIC_FUNCTION_REGRESSION
E1 | all_service_dh0.3_reduction0 | TH | residential | fixed_gas | 500000 | 500000 | 500000 | MWh | 0 | 0 | 0 | 0.0000015 | PASS | PASS | SYNTHETIC_FUNCTION_REGRESSION
E1 | all_service_dh0.3_reduction0 | TH | residential | fixed_biomass | 250000 | 250000 | 250000 | MWh | 0 | 0 | 0 | 0.0000012499999999999999 | PASS | PASS | SYNTHETIC_FUNCTION_REGRESSION
E1 | all_service_dh0.3_reduction0 | TL | residential | heat_service_without_DH_loss | 5228807.189441808 | 8789999.999999998 | 8789999.999999998 | MWh | 0 | 0 | 3561192.8105581906 | 0.000009789999999999998 | FAIL | PASS | SYNTHETIC_FUNCTION_REGRESSION
E1 | all_service_dh0.3_reduction0 | TL | residential | district_heat_loss | 0 | 251174.24999999988 | 251174.24999999997 | MWh | 8.731149137020111e-11 | 3.476132261575425e-16 | 251174.24999999997 | 0.00000125117425 | FAIL | PASS | SYNTHETIC_FUNCTION_REGRESSION | Upstream additive markup: supply=service*(1+0.15), not 1/(1-0.15) | Upstream additive markup: supply=service*(1+0.15), not 1/(1-0.15)
E1 | all_service_dh0.3_reduction0 | TL | services | heat_service_without_DH_loss | 2117211.9398131324 | 5709999.999999998 | 5710000 | MWh | 1.862645149230957e-9 | 3.2620755678300474e-16 | 3592788.0601868676 | 0.000006709999999999999 | FAIL | PASS | SYNTHETIC_FUNCTION_REGRESSION
E1 | all_service_dh0.3_reduction0 | TL | services | district_heat_loss | 0 | 163163.24999999994 | 163163.25 | MWh | 5.820766091346741e-11 | 3.567449221161469e-16 | 163163.25 | 0.00000116316325 | FAIL | PASS | SYNTHETIC_FUNCTION_REGRESSION | Upstream additive markup: supply=service*(1+0.15), not 1/(1-0.15) | Upstream additive markup: supply=service*(1+0.15), not 1/(1-0.15)
E1 | all_service_dh0.3_reduction0 | TL | services | profile_unchanged | 150370.99506878766 | 0 | 0 | MW | 0 | 0 | 150370.99506878766 | 0 | FAIL | PASS | SYNTHETIC_FUNCTION_REGRESSION
E1 | all_service_dh0.3_reduction0 | TL | residential | direct_electricity | 8890000 | 8890000 | 8890000 | MWh | 0 | 0 | 0 | 0.00000989 | PASS | PASS | SYNTHETIC_FUNCTION_REGRESSION
E1 | all_service_dh0.3_reduction0 | TL | services | direct_electricity | 3990000 | 3990000 | 3990000 | MWh | 0 | 0 | 0 | 0.00000499 | PASS | PASS | SYNTHETIC_FUNCTION_REGRESSION
E1 | all_service_dh0.3_reduction0 | TL | residential | fixed_oil | 1000000 | 1000000 | 1000000 | MWh | 0 | 0 | 0 | 0.000002 | PASS | PASS | SYNTHETIC_FUNCTION_REGRESSION
E1 | all_service_dh0.3_reduction0 | TL | residential | fixed_gas | 500000 | 500000 | 500000 | MWh | 0 | 0 | 0 | 0.0000015 | PASS | PASS | SYNTHETIC_FUNCTION_REGRESSION
E1 | all_service_dh0.3_reduction0 | TL | residential | fixed_biomass | 250000 | 250000 | 250000 | MWh | 0 | 0 | 0 | 0.0000012499999999999999 | PASS | PASS | SYNTHETIC_FUNCTION_REGRESSION
E1 | all_service_dh0.3_reduction0 | VN | residential | heat_service_without_DH_loss | 5346868.5399042135 | 9099999.999999998 | 9100000 | MWh | 1.862645149230957e-9 | 2.0468628013527e-16 | 3753131.4600957865 | 0.0000101 | FAIL | PASS | SYNTHETIC_FUNCTION_REGRESSION
E1 | all_service_dh0.3_reduction0 | VN | residential | district_heat_loss | 0 | 260032.4999999999 | 260032.49999999997 | MWh | 5.820766091346741e-11 | 2.238476379432087e-16 | 260032.49999999997 | 0.0000012600325 | FAIL | PASS | SYNTHETIC_FUNCTION_REGRESSION | Upstream additive markup: supply=service*(1+0.15), not 1/(1-0.15) | Upstream additive markup: supply=service*(1+0.15), not 1/(1-0.15)
E1 | all_service_dh0.3_reduction0 | VN | services | heat_service_without_DH_loss | 2231183.717721145 | 5900000 | 5900000 | MWh | 0 | 0 | 3668816.282278855 | 0.0000069 | FAIL | PASS | SYNTHETIC_FUNCTION_REGRESSION
E1 | all_service_dh0.3_reduction0 | VN | services | district_heat_loss | 0 | 168592.49999999994 | 168592.5 | MWh | 5.820766091346741e-11 | 3.4525652631918625e-16 | 168592.5 | 0.0000011685925 | FAIL | PASS | SYNTHETIC_FUNCTION_REGRESSION | Upstream additive markup: supply=service*(1+0.15), not 1/(1-0.15) | Upstream additive markup: supply=service*(1+0.15), not 1/(1-0.15)
E1 | all_service_dh0.3_reduction0 | VN | services | profile_unchanged | 162639.34155899542 | 0 | 0 | MW | 0 | 0 | 162639.34155899542 | 0 | FAIL | PASS | SYNTHETIC_FUNCTION_REGRESSION
E1 | all_service_dh0.3_reduction0 | VN | residential | direct_electricity | 9100000 | 9100000 | 9100000 | MWh | 0 | 0 | 0 | 0.0000101 | PASS | PASS | SYNTHETIC_FUNCTION_REGRESSION
E1 | all_service_dh0.3_reduction0 | VN | services | direct_electricity | 4099999.9999999995 | 4099999.9999999995 | 4099999.9999999995 | MWh | 0 | 0 | 0 | 0.0000050999999999999995 | PASS | PASS | SYNTHETIC_FUNCTION_REGRESSION
E1 | all_service_dh0.3_reduction0 | VN | residential | fixed_oil | 1000000 | 1000000 | 1000000 | MWh | 0 | 0 | 0 | 0.000002 | PASS | PASS | SYNTHETIC_FUNCTION_REGRESSION
E1 | all_service_dh0.3_reduction0 | VN | residential | fixed_gas | 500000 | 500000 | 500000 | MWh | 0 | 0 | 0 | 0.0000015 | PASS | PASS | SYNTHETIC_FUNCTION_REGRESSION
E1 | all_service_dh0.3_reduction0 | VN | residential | fixed_biomass | 250000 | 250000 | 250000 | MWh | 0 | 0 | 0 | 0.0000012499999999999999 | PASS | PASS | SYNTHETIC_FUNCTION_REGRESSION
E1 | all_service_dh0.3_reduction0 | ALL | R+S | finite_nonnegative | true | true | true | boolean | 0 | 0 | 0 | 0 | PASS | PASS | SYNTHETIC_FUNCTION_REGRESSION
E1 | zero_R_dh0.3_reduction0 | BN | residential | heat_service_without_DH_loss | 0 | 0 | 0 | MWh | 0 | 0 | 0 | 0.000001 | PASS | PASS | SYNTHETIC_FUNCTION_REGRESSION
E1 | zero_R_dh0.3_reduction0 | BN | residential | district_heat_loss | 0 | 0 | 0 | MWh | 0 | 0 | 0 | 0.000001 | PASS | PASS | SYNTHETIC_FUNCTION_REGRESSION | Upstream additive markup: supply=service*(1+0.15), not 1/(1-0.15) | Upstream additive markup: supply=service*(1+0.15), not 1/(1-0.15)
E1 | zero_R_dh0.3_reduction0 | BN | services | heat_service_without_DH_loss | 0 | 4000000 | 4000000 | MWh | 0 | 0 | 4000000 | 0.0000049999999999999996 | FAIL | PASS | SYNTHETIC_FUNCTION_REGRESSION
E1 | zero_R_dh0.3_reduction0 | BN | services | district_heat_loss | 0 | 114299.99999999997 | 114300 | MWh | 2.9103830456733704e-11 | 2.5462668816039985e-16 | 114300 | 0.0000011142999999999999 | FAIL | PASS | SYNTHETIC_FUNCTION_REGRESSION | Upstream additive markup: supply=service*(1+0.15), not 1/(1-0.15) | Upstream additive markup: supply=service*(1+0.15), not 1/(1-0.15)
E1 | zero_R_dh0.3_reduction0 | BN | services | profile_unchanged | 169813.76518218618 | 0 | 0 | MW | 0 | 0 | 169813.76518218618 | 0 | FAIL | PASS | SYNTHETIC_FUNCTION_REGRESSION
E1 | zero_R_dh0.3_reduction0 | BN | residential | direct_electricity | 7000000 | 7000000 | 7000000 | MWh | 0 | 0 | 0 | 0.000008 | PASS | PASS | SYNTHETIC_FUNCTION_REGRESSION
E1 | zero_R_dh0.3_reduction0 | BN | services | direct_electricity | 3000000 | 3000000 | 3000000 | MWh | 0 | 0 | 0 | 0.000004 | PASS | PASS | SYNTHETIC_FUNCTION_REGRESSION
E1 | zero_R_dh0.3_reduction0 | BN | residential | fixed_oil | 1000000 | 1000000 | 1000000 | MWh | 0 | 0 | 0 | 0.000002 | PASS | PASS | SYNTHETIC_FUNCTION_REGRESSION
E1 | zero_R_dh0.3_reduction0 | BN | residential | fixed_gas | 500000 | 500000 | 500000 | MWh | 0 | 0 | 0 | 0.0000015 | PASS | PASS | SYNTHETIC_FUNCTION_REGRESSION
E1 | zero_R_dh0.3_reduction0 | BN | residential | fixed_biomass | 250000 | 250000 | 250000 | MWh | 0 | 0 | 0 | 0.0000012499999999999999 | PASS | PASS | SYNTHETIC_FUNCTION_REGRESSION
E1 | zero_R_dh0.3_reduction0 | KH | residential | heat_service_without_DH_loss | 0 | 0 | 0 | MWh | 0 | 0 | 0 | 0.000001 | PASS | PASS | SYNTHETIC_FUNCTION_REGRESSION
E1 | zero_R_dh0.3_reduction0 | KH | residential | district_heat_loss | 0 | 0 | 0 | MWh | 0 | 0 | 0 | 0.000001 | PASS | PASS | SYNTHETIC_FUNCTION_REGRESSION | Upstream additive markup: supply=service*(1+0.15), not 1/(1-0.15) | Upstream additive markup: supply=service*(1+0.15), not 1/(1-0.15)
E1 | zero_R_dh0.3_reduction0 | KH | services | heat_service_without_DH_loss | 0 | 4190000 | 4190000.000000001 | MWh | 9.313225746154785e-10 | 2.222726908390163e-16 | 4190000.000000001 | 0.00000519 | FAIL | PASS | SYNTHETIC_FUNCTION_REGRESSION
E1 | zero_R_dh0.3_reduction0 | KH | services | district_heat_loss | 0 | 119729.24999999997 | 119729.25000000001 | MWh | 4.3655745685100555e-11 | 3.6462055583828136e-16 | 119729.25000000001 | 0.00000111972925 | FAIL | PASS | SYNTHETIC_FUNCTION_REGRESSION | Upstream additive markup: supply=service*(1+0.15), not 1/(1-0.15) | Upstream additive markup: supply=service*(1+0.15), not 1/(1-0.15)
E1 | zero_R_dh0.3_reduction0 | KH | services | profile_unchanged | 204192.15970961883 | 0 | 0 | MW | 0 | 0 | 204192.15970961883 | 0 | FAIL | PASS | SYNTHETIC_FUNCTION_REGRESSION
E1 | zero_R_dh0.3_reduction0 | KH | residential | direct_electricity | 7210000 | 7210000 | 7210000 | MWh | 0 | 0 | 0 | 0.00000821 | PASS | PASS | SYNTHETIC_FUNCTION_REGRESSION
E1 | zero_R_dh0.3_reduction0 | KH | services | direct_electricity | 3110000 | 3110000 | 3110000 | MWh | 0 | 0 | 0 | 0.00000411 | PASS | PASS | SYNTHETIC_FUNCTION_REGRESSION
E1 | zero_R_dh0.3_reduction0 | KH | residential | fixed_oil | 1000000 | 1000000 | 1000000 | MWh | 0 | 0 | 0 | 0.000002 | PASS | PASS | SYNTHETIC_FUNCTION_REGRESSION
E1 | zero_R_dh0.3_reduction0 | KH | residential | fixed_gas | 500000 | 500000 | 500000 | MWh | 0 | 0 | 0 | 0.0000015 | PASS | PASS | SYNTHETIC_FUNCTION_REGRESSION
E1 | zero_R_dh0.3_reduction0 | KH | residential | fixed_biomass | 250000 | 250000 | 250000 | MWh | 0 | 0 | 0 | 0.0000012499999999999999 | PASS | PASS | SYNTHETIC_FUNCTION_REGRESSION
E1 | zero_R_dh0.3_reduction0 | ID | residential | heat_service_without_DH_loss | 0 | 0 | 0 | MWh | 0 | 0 | 0 | 0.000001 | PASS | PASS | SYNTHETIC_FUNCTION_REGRESSION
E1 | zero_R_dh0.3_reduction0 | ID | residential | district_heat_loss | 0 | 0 | 0 | MWh | 0 | 0 | 0 | 0.000001 | PASS | PASS | SYNTHETIC_FUNCTION_REGRESSION | Upstream additive markup: supply=service*(1+0.15), not 1/(1-0.15) | Upstream additive markup: supply=service*(1+0.15), not 1/(1-0.15)
E1 | zero_R_dh0.3_reduction0 | ID | services | heat_service_without_DH_loss | 0 | 4380000 | 4380000 | MWh | 0 | 0 | 4380000 | 0.000005379999999999999 | FAIL | PASS | SYNTHETIC_FUNCTION_REGRESSION
E1 | zero_R_dh0.3_reduction0 | ID | services | district_heat_loss | 0 | 125158.49999999997 | 125158.5 | MWh | 2.9103830456733704e-11 | 2.325357882743378e-16 | 125158.5 | 0.0000011251585 | FAIL | PASS | SYNTHETIC_FUNCTION_REGRESSION | Upstream additive markup: supply=service*(1+0.15), not 1/(1-0.15) | Upstream additive markup: supply=service*(1+0.15), not 1/(1-0.15)
E1 | zero_R_dh0.3_reduction0 | ID | services | profile_unchanged | 165087.01202886927 | 0 | 0 | MW | 0 | 0 | 165087.01202886927 | 0 | FAIL | PASS | SYNTHETIC_FUNCTION_REGRESSION
E1 | zero_R_dh0.3_reduction0 | ID | residential | direct_electricity | 7420000 | 7420000 | 7420000 | MWh | 0 | 0 | 0 | 0.00000842 | PASS | PASS | SYNTHETIC_FUNCTION_REGRESSION
E1 | zero_R_dh0.3_reduction0 | ID | services | direct_electricity | 3220000 | 3220000 | 3220000 | MWh | 0 | 0 | 0 | 0.00000422 | PASS | PASS | SYNTHETIC_FUNCTION_REGRESSION
E1 | zero_R_dh0.3_reduction0 | ID | residential | fixed_oil | 1000000 | 1000000 | 1000000 | MWh | 0 | 0 | 0 | 0.000002 | PASS | PASS | SYNTHETIC_FUNCTION_REGRESSION
E1 | zero_R_dh0.3_reduction0 | ID | residential | fixed_gas | 500000 | 500000 | 500000 | MWh | 0 | 0 | 0 | 0.0000015 | PASS | PASS | SYNTHETIC_FUNCTION_REGRESSION
E1 | zero_R_dh0.3_reduction0 | ID | residential | fixed_biomass | 250000 | 250000 | 250000 | MWh | 0 | 0 | 0 | 0.0000012499999999999999 | PASS | PASS | SYNTHETIC_FUNCTION_REGRESSION
E1 | zero_R_dh0.3_reduction0 | LA | residential | heat_service_without_DH_loss | 0 | 0 | 0 | MWh | 0 | 0 | 0 | 0.000001 | PASS | PASS | SYNTHETIC_FUNCTION_REGRESSION
E1 | zero_R_dh0.3_reduction0 | LA | residential | district_heat_loss | 0 | 0 | 0 | MWh | 0 | 0 | 0 | 0.000001 | PASS | PASS | SYNTHETIC_FUNCTION_REGRESSION | Upstream additive markup: supply=service*(1+0.15), not 1/(1-0.15) | Upstream additive markup: supply=service*(1+0.15), not 1/(1-0.15)
E1 | zero_R_dh0.3_reduction0 | LA | services | heat_service_without_DH_loss | 0 | 4570000 | 4570000 | MWh | 0 | 0 | 4570000 | 0.00000557 | FAIL | PASS | SYNTHETIC_FUNCTION_REGRESSION
E1 | zero_R_dh0.3_reduction0 | LA | services | district_heat_loss | 0 | 130587.74999999996 | 130587.75 | MWh | 4.3655745685100555e-11 | 3.3430199758477007e-16 | 130587.75 | 0.00000113058775 | FAIL | PASS | SYNTHETIC_FUNCTION_REGRESSION | Upstream additive markup: supply=service*(1+0.15), not 1/(1-0.15) | Upstream additive markup: supply=service*(1+0.15), not 1/(1-0.15)
E1 | zero_R_dh0.3_reduction0 | LA | services | profile_unchanged | 199687.37770649558 | 0 | 0 | MW | 0 | 0 | 199687.37770649558 | 0 | FAIL | PASS | SYNTHETIC_FUNCTION_REGRESSION
E1 | zero_R_dh0.3_reduction0 | LA | residential | direct_electricity | 7630000 | 7630000 | 7630000 | MWh | 0 | 0 | 0 | 0.00000863 | PASS | PASS | SYNTHETIC_FUNCTION_REGRESSION
E1 | zero_R_dh0.3_reduction0 | LA | services | direct_electricity | 3330000 | 3330000 | 3330000 | MWh | 0 | 0 | 0 | 0.00000433 | PASS | PASS | SYNTHETIC_FUNCTION_REGRESSION
E1 | zero_R_dh0.3_reduction0 | LA | residential | fixed_oil | 1000000 | 1000000 | 1000000 | MWh | 0 | 0 | 0 | 0.000002 | PASS | PASS | SYNTHETIC_FUNCTION_REGRESSION
E1 | zero_R_dh0.3_reduction0 | LA | residential | fixed_gas | 500000 | 500000 | 500000 | MWh | 0 | 0 | 0 | 0.0000015 | PASS | PASS | SYNTHETIC_FUNCTION_REGRESSION
E1 | zero_R_dh0.3_reduction0 | LA | residential | fixed_biomass | 250000 | 250000 | 250000 | MWh | 0 | 0 | 0 | 0.0000012499999999999999 | PASS | PASS | SYNTHETIC_FUNCTION_REGRESSION
E1 | zero_R_dh0.3_reduction0 | MY | residential | heat_service_without_DH_loss | 0 | 0 | 0 | MWh | 0 | 0 | 0 | 0.000001 | PASS | PASS | SYNTHETIC_FUNCTION_REGRESSION
E1 | zero_R_dh0.3_reduction0 | MY | residential | district_heat_loss | 0 | 0 | 0 | MWh | 0 | 0 | 0 | 0.000001 | PASS | PASS | SYNTHETIC_FUNCTION_REGRESSION | Upstream additive markup: supply=service*(1+0.15), not 1/(1-0.15) | Upstream additive markup: supply=service*(1+0.15), not 1/(1-0.15)
E1 | zero_R_dh0.3_reduction0 | MY | services | heat_service_without_DH_loss | 0 | 4760000 | 4760000 | MWh | 0 | 0 | 4760000 | 0.00000576 | FAIL | PASS | SYNTHETIC_FUNCTION_REGRESSION
E1 | zero_R_dh0.3_reduction0 | MY | services | district_heat_loss | 0 | 136016.99999999994 | 136017 | MWh | 5.820766091346741e-11 | 4.2794401371495774e-16 | 136017 | 0.000001136017 | FAIL | PASS | SYNTHETIC_FUNCTION_REGRESSION | Upstream additive markup: supply=service*(1+0.15), not 1/(1-0.15) | Upstream additive markup: supply=service*(1+0.15), not 1/(1-0.15)
E1 | zero_R_dh0.3_reduction0 | MY | services | profile_unchanged | 199112.61882572225 | 0 | 0 | MW | 0 | 0 | 199112.61882572225 | 0 | FAIL | PASS | SYNTHETIC_FUNCTION_REGRESSION
E1 | zero_R_dh0.3_reduction0 | MY | residential | direct_electricity | 7840000 | 7840000 | 7840000 | MWh | 0 | 0 | 0 | 0.00000884 | PASS | PASS | SYNTHETIC_FUNCTION_REGRESSION
E1 | zero_R_dh0.3_reduction0 | MY | services | direct_electricity | 3440000 | 3440000 | 3440000 | MWh | 0 | 0 | 0 | 0.00000444 | PASS | PASS | SYNTHETIC_FUNCTION_REGRESSION
E1 | zero_R_dh0.3_reduction0 | MY | residential | fixed_oil | 1000000 | 1000000 | 1000000 | MWh | 0 | 0 | 0 | 0.000002 | PASS | PASS | SYNTHETIC_FUNCTION_REGRESSION
E1 | zero_R_dh0.3_reduction0 | MY | residential | fixed_gas | 500000 | 500000 | 500000 | MWh | 0 | 0 | 0 | 0.0000015 | PASS | PASS | SYNTHETIC_FUNCTION_REGRESSION
E1 | zero_R_dh0.3_reduction0 | MY | residential | fixed_biomass | 250000 | 250000 | 250000 | MWh | 0 | 0 | 0 | 0.0000012499999999999999 | PASS | PASS | SYNTHETIC_FUNCTION_REGRESSION
E1 | zero_R_dh0.3_reduction0 | MM | residential | heat_service_without_DH_loss | 0 | 0 | 0 | MWh | 0 | 0 | 0 | 0.000001 | PASS | PASS | SYNTHETIC_FUNCTION_REGRESSION
E1 | zero_R_dh0.3_reduction0 | MM | residential | district_heat_loss | 0 | 0 | 0 | MWh | 0 | 0 | 0 | 0.000001 | PASS | PASS | SYNTHETIC_FUNCTION_REGRESSION | Upstream additive markup: supply=service*(1+0.15), not 1/(1-0.15) | Upstream additive markup: supply=service*(1+0.15), not 1/(1-0.15)
E1 | zero_R_dh0.3_reduction0 | MM | services | heat_service_without_DH_loss | 0 | 4950000 | 4950000 | MWh | 0 | 0 | 4950000 | 0.00000595 | FAIL | PASS | SYNTHETIC_FUNCTION_REGRESSION
E1 | zero_R_dh0.3_reduction0 | MM | services | district_heat_loss | 0 | 141446.25 | 141446.25 | MWh | 0 | 0 | 141446.25 | 0.00000114144625 | FAIL | PASS | SYNTHETIC_FUNCTION_REGRESSION | Upstream additive markup: supply=service*(1+0.15), not 1/(1-0.15) | Upstream additive markup: supply=service*(1+0.15), not 1/(1-0.15)
E1 | zero_R_dh0.3_reduction0 | MM | services | profile_unchanged | 250113.9293139293 | 0 | 0 | MW | 0 | 0 | 250113.9293139293 | 0 | FAIL | PASS | SYNTHETIC_FUNCTION_REGRESSION
E1 | zero_R_dh0.3_reduction0 | MM | residential | direct_electricity | 8050000 | 8050000 | 8050000.000000001 | MWh | 9.313225746154785e-10 | 1.1569224529384825e-16 | 9.313225746154785e-10 | 0.000009050000000000001 | PASS | PASS | SYNTHETIC_FUNCTION_REGRESSION
E1 | zero_R_dh0.3_reduction0 | MM | services | direct_electricity | 3550000 | 3550000 | 3550000 | MWh | 0 | 0 | 0 | 0.00000455 | PASS | PASS | SYNTHETIC_FUNCTION_REGRESSION
E1 | zero_R_dh0.3_reduction0 | MM | residential | fixed_oil | 1000000 | 1000000 | 1000000 | MWh | 0 | 0 | 0 | 0.000002 | PASS | PASS | SYNTHETIC_FUNCTION_REGRESSION
E1 | zero_R_dh0.3_reduction0 | MM | residential | fixed_gas | 500000 | 500000 | 500000 | MWh | 0 | 0 | 0 | 0.0000015 | PASS | PASS | SYNTHETIC_FUNCTION_REGRESSION
E1 | zero_R_dh0.3_reduction0 | MM | residential | fixed_biomass | 250000 | 250000 | 250000 | MWh | 0 | 0 | 0 | 0.0000012499999999999999 | PASS | PASS | SYNTHETIC_FUNCTION_REGRESSION
E1 | zero_R_dh0.3_reduction0 | PH | residential | heat_service_without_DH_loss | 0 | 0 | 0 | MWh | 0 | 0 | 0 | 0.000001 | PASS | PASS | SYNTHETIC_FUNCTION_REGRESSION
E1 | zero_R_dh0.3_reduction0 | PH | residential | district_heat_loss | 0 | 0 | 0 | MWh | 0 | 0 | 0 | 0.000001 | PASS | PASS | SYNTHETIC_FUNCTION_REGRESSION | Upstream additive markup: supply=service*(1+0.15), not 1/(1-0.15) | Upstream additive markup: supply=service*(1+0.15), not 1/(1-0.15)
E1 | zero_R_dh0.3_reduction0 | PH | services | heat_service_without_DH_loss | 0 | 5140000 | 5140000 | MWh | 0 | 0 | 5140000 | 0.00000614 | FAIL | PASS | SYNTHETIC_FUNCTION_REGRESSION
E1 | zero_R_dh0.3_reduction0 | PH | services | district_heat_loss | 0 | 146875.49999999997 | 146875.5 | MWh | 2.9103830456733704e-11 | 1.9815306471626447e-16 | 146875.5 | 0.0000011468755 | FAIL | PASS | SYNTHETIC_FUNCTION_REGRESSION | Upstream additive markup: supply=service*(1+0.15), not 1/(1-0.15) | Upstream additive markup: supply=service*(1+0.15), not 1/(1-0.15)
E1 | zero_R_dh0.3_reduction0 | PH | services | profile_unchanged | 218210.68825910933 | 0 | 0 | MW | 0 | 0 | 218210.68825910933 | 0 | FAIL | PASS | SYNTHETIC_FUNCTION_REGRESSION
E1 | zero_R_dh0.3_reduction0 | PH | residential | direct_electricity | 8260000 | 8260000 | 8260000 | MWh | 0 | 0 | 0 | 0.000009260000000000001 | PASS | PASS | SYNTHETIC_FUNCTION_REGRESSION
E1 | zero_R_dh0.3_reduction0 | PH | services | direct_electricity | 3660000 | 3660000 | 3660000 | MWh | 0 | 0 | 0 | 0.00000466 | PASS | PASS | SYNTHETIC_FUNCTION_REGRESSION
E1 | zero_R_dh0.3_reduction0 | PH | residential | fixed_oil | 1000000 | 1000000 | 1000000 | MWh | 0 | 0 | 0 | 0.000002 | PASS | PASS | SYNTHETIC_FUNCTION_REGRESSION
E1 | zero_R_dh0.3_reduction0 | PH | residential | fixed_gas | 500000 | 500000 | 500000 | MWh | 0 | 0 | 0 | 0.0000015 | PASS | PASS | SYNTHETIC_FUNCTION_REGRESSION
E1 | zero_R_dh0.3_reduction0 | PH | residential | fixed_biomass | 250000 | 250000 | 250000 | MWh | 0 | 0 | 0 | 0.0000012499999999999999 | PASS | PASS | SYNTHETIC_FUNCTION_REGRESSION
E1 | zero_R_dh0.3_reduction0 | SG | residential | heat_service_without_DH_loss | 0 | 0 | 0 | MWh | 0 | 0 | 0 | 0.000001 | PASS | PASS | SYNTHETIC_FUNCTION_REGRESSION
E1 | zero_R_dh0.3_reduction0 | SG | residential | district_heat_loss | 0 | 0 | 0 | MWh | 0 | 0 | 0 | 0.000001 | PASS | PASS | SYNTHETIC_FUNCTION_REGRESSION | Upstream additive markup: supply=service*(1+0.15), not 1/(1-0.15) | Upstream additive markup: supply=service*(1+0.15), not 1/(1-0.15)
E1 | zero_R_dh0.3_reduction0 | SG | services | heat_service_without_DH_loss | 0 | 5330000 | 5330000 | MWh | 0 | 0 | 5330000 | 0.0000063299999999999995 | FAIL | PASS | SYNTHETIC_FUNCTION_REGRESSION
E1 | zero_R_dh0.3_reduction0 | SG | services | district_heat_loss | 0 | 152304.74999999994 | 152304.75 | MWh | 5.820766091346741e-11 | 3.8217889404938063e-16 | 152304.75 | 0.00000115230475 | FAIL | PASS | SYNTHETIC_FUNCTION_REGRESSION | Upstream additive markup: supply=service*(1+0.15), not 1/(1-0.15) | Upstream additive markup: supply=service*(1+0.15), not 1/(1-0.15)
E1 | zero_R_dh0.3_reduction0 | SG | services | profile_unchanged | 259748.02177858434 | 0 | 0 | MW | 0 | 0 | 259748.02177858434 | 0 | FAIL | PASS | SYNTHETIC_FUNCTION_REGRESSION
E1 | zero_R_dh0.3_reduction0 | SG | residential | direct_electricity | 8470000 | 8470000 | 8470000 | MWh | 0 | 0 | 0 | 0.00000947 | PASS | PASS | SYNTHETIC_FUNCTION_REGRESSION
E1 | zero_R_dh0.3_reduction0 | SG | services | direct_electricity | 3770000 | 3770000 | 3770000 | MWh | 0 | 0 | 0 | 0.00000477 | PASS | PASS | SYNTHETIC_FUNCTION_REGRESSION
E1 | zero_R_dh0.3_reduction0 | SG | residential | fixed_oil | 1000000 | 1000000 | 1000000 | MWh | 0 | 0 | 0 | 0.000002 | PASS | PASS | SYNTHETIC_FUNCTION_REGRESSION
E1 | zero_R_dh0.3_reduction0 | SG | residential | fixed_gas | 500000 | 500000 | 500000 | MWh | 0 | 0 | 0 | 0.0000015 | PASS | PASS | SYNTHETIC_FUNCTION_REGRESSION
E1 | zero_R_dh0.3_reduction0 | SG | residential | fixed_biomass | 250000 | 250000 | 250000 | MWh | 0 | 0 | 0 | 0.0000012499999999999999 | PASS | PASS | SYNTHETIC_FUNCTION_REGRESSION
E1 | zero_R_dh0.3_reduction0 | TH | residential | heat_service_without_DH_loss | 0 | 0 | 0 | MWh | 0 | 0 | 0 | 0.000001 | PASS | PASS | SYNTHETIC_FUNCTION_REGRESSION
E1 | zero_R_dh0.3_reduction0 | TH | residential | district_heat_loss | 0 | 0 | 0 | MWh | 0 | 0 | 0 | 0.000001 | PASS | PASS | SYNTHETIC_FUNCTION_REGRESSION | Upstream additive markup: supply=service*(1+0.15), not 1/(1-0.15) | Upstream additive markup: supply=service*(1+0.15), not 1/(1-0.15)
E1 | zero_R_dh0.3_reduction0 | TH | services | heat_service_without_DH_loss | 0 | 5519999.999999999 | 5520000 | MWh | 9.313225746154785e-10 | 1.6871785772019538e-16 | 5520000 | 0.000006519999999999999 | FAIL | PASS | SYNTHETIC_FUNCTION_REGRESSION
E1 | zero_R_dh0.3_reduction0 | TH | services | district_heat_loss | 0 | 157733.99999999994 | 157733.99999999997 | MWh | 2.9103830456733704e-11 | 1.84512092869855e-16 | 157733.99999999997 | 0.000001157734 | FAIL | PASS | SYNTHETIC_FUNCTION_REGRESSION | Upstream additive markup: supply=service*(1+0.15), not 1/(1-0.15) | Upstream additive markup: supply=service*(1+0.15), not 1/(1-0.15)
E1 | zero_R_dh0.3_reduction0 | TH | services | profile_unchanged | 208054.86447473933 | 0 | 0 | MW | 0 | 0 | 208054.86447473933 | 0 | FAIL | PASS | SYNTHETIC_FUNCTION_REGRESSION
E1 | zero_R_dh0.3_reduction0 | TH | residential | direct_electricity | 8680000 | 8680000 | 8680000 | MWh | 0 | 0 | 0 | 0.00000968 | PASS | PASS | SYNTHETIC_FUNCTION_REGRESSION
E1 | zero_R_dh0.3_reduction0 | TH | services | direct_electricity | 3880000.0000000005 | 3880000.0000000005 | 3880000 | MWh | 4.656612873077393e-10 | 1.2001579569787095e-16 | 4.656612873077393e-10 | 0.00000488 | PASS | PASS | SYNTHETIC_FUNCTION_REGRESSION
E1 | zero_R_dh0.3_reduction0 | TH | residential | fixed_oil | 1000000 | 1000000 | 1000000 | MWh | 0 | 0 | 0 | 0.000002 | PASS | PASS | SYNTHETIC_FUNCTION_REGRESSION
E1 | zero_R_dh0.3_reduction0 | TH | residential | fixed_gas | 500000 | 500000 | 500000 | MWh | 0 | 0 | 0 | 0.0000015 | PASS | PASS | SYNTHETIC_FUNCTION_REGRESSION
E1 | zero_R_dh0.3_reduction0 | TH | residential | fixed_biomass | 250000 | 250000 | 250000 | MWh | 0 | 0 | 0 | 0.0000012499999999999999 | PASS | PASS | SYNTHETIC_FUNCTION_REGRESSION
E1 | zero_R_dh0.3_reduction0 | TL | residential | heat_service_without_DH_loss | 0 | 0 | 0 | MWh | 0 | 0 | 0 | 0.000001 | PASS | PASS | SYNTHETIC_FUNCTION_REGRESSION
E1 | zero_R_dh0.3_reduction0 | TL | residential | district_heat_loss | 0 | 0 | 0 | MWh | 0 | 0 | 0 | 0.000001 | PASS | PASS | SYNTHETIC_FUNCTION_REGRESSION | Upstream additive markup: supply=service*(1+0.15), not 1/(1-0.15) | Upstream additive markup: supply=service*(1+0.15), not 1/(1-0.15)
E1 | zero_R_dh0.3_reduction0 | TL | services | heat_service_without_DH_loss | 0 | 5709999.999999998 | 5710000 | MWh | 1.862645149230957e-9 | 3.2620755678300474e-16 | 5710000 | 0.000006709999999999999 | FAIL | PASS | SYNTHETIC_FUNCTION_REGRESSION
E1 | zero_R_dh0.3_reduction0 | TL | services | district_heat_loss | 0 | 163163.24999999994 | 163163.25 | MWh | 5.820766091346741e-11 | 3.567449221161469e-16 | 163163.25 | 0.00000116316325 | FAIL | PASS | SYNTHETIC_FUNCTION_REGRESSION | Upstream additive markup: supply=service*(1+0.15), not 1/(1-0.15) | Upstream additive markup: supply=service*(1+0.15), not 1/(1-0.15)
E1 | zero_R_dh0.3_reduction0 | TL | services | profile_unchanged | 249499.9839615076 | 0 | 0 | MW | 0 | 0 | 249499.9839615076 | 0 | FAIL | PASS | SYNTHETIC_FUNCTION_REGRESSION
E1 | zero_R_dh0.3_reduction0 | TL | residential | direct_electricity | 8890000 | 8890000 | 8890000 | MWh | 0 | 0 | 0 | 0.00000989 | PASS | PASS | SYNTHETIC_FUNCTION_REGRESSION
E1 | zero_R_dh0.3_reduction0 | TL | services | direct_electricity | 3990000 | 3990000 | 3990000 | MWh | 0 | 0 | 0 | 0.00000499 | PASS | PASS | SYNTHETIC_FUNCTION_REGRESSION
E1 | zero_R_dh0.3_reduction0 | TL | residential | fixed_oil | 1000000 | 1000000 | 1000000 | MWh | 0 | 0 | 0 | 0.000002 | PASS | PASS | SYNTHETIC_FUNCTION_REGRESSION
E1 | zero_R_dh0.3_reduction0 | TL | residential | fixed_gas | 500000 | 500000 | 500000 | MWh | 0 | 0 | 0 | 0.0000015 | PASS | PASS | SYNTHETIC_FUNCTION_REGRESSION
E1 | zero_R_dh0.3_reduction0 | TL | residential | fixed_biomass | 250000 | 250000 | 250000 | MWh | 0 | 0 | 0 | 0.0000012499999999999999 | PASS | PASS | SYNTHETIC_FUNCTION_REGRESSION
E1 | zero_R_dh0.3_reduction0 | VN | residential | heat_service_without_DH_loss | 0 | 0 | 0 | MWh | 0 | 0 | 0 | 0.000001 | PASS | PASS | SYNTHETIC_FUNCTION_REGRESSION
E1 | zero_R_dh0.3_reduction0 | VN | residential | district_heat_loss | 0 | 0 | 0 | MWh | 0 | 0 | 0 | 0.000001 | PASS | PASS | SYNTHETIC_FUNCTION_REGRESSION | Upstream additive markup: supply=service*(1+0.15), not 1/(1-0.15) | Upstream additive markup: supply=service*(1+0.15), not 1/(1-0.15)
E1 | zero_R_dh0.3_reduction0 | VN | services | heat_service_without_DH_loss | 0 | 5900000 | 5900000 | MWh | 0 | 0 | 5900000 | 0.0000069 | FAIL | PASS | SYNTHETIC_FUNCTION_REGRESSION
E1 | zero_R_dh0.3_reduction0 | VN | services | district_heat_loss | 0 | 168592.49999999994 | 168592.5 | MWh | 5.820766091346741e-11 | 3.4525652631918625e-16 | 168592.5 | 0.0000011685925 | FAIL | PASS | SYNTHETIC_FUNCTION_REGRESSION | Upstream additive markup: supply=service*(1+0.15), not 1/(1-0.15) | Upstream additive markup: supply=service*(1+0.15), not 1/(1-0.15)
E1 | zero_R_dh0.3_reduction0 | VN | services | profile_unchanged | 246799.25442684063 | 0 | 0 | MW | 0 | 0 | 246799.25442684063 | 0 | FAIL | PASS | SYNTHETIC_FUNCTION_REGRESSION
E1 | zero_R_dh0.3_reduction0 | VN | residential | direct_electricity | 9100000 | 9100000 | 9100000 | MWh | 0 | 0 | 0 | 0.0000101 | PASS | PASS | SYNTHETIC_FUNCTION_REGRESSION
E1 | zero_R_dh0.3_reduction0 | VN | services | direct_electricity | 4099999.9999999995 | 4099999.9999999995 | 4099999.9999999995 | MWh | 0 | 0 | 0 | 0.0000050999999999999995 | PASS | PASS | SYNTHETIC_FUNCTION_REGRESSION
E1 | zero_R_dh0.3_reduction0 | VN | residential | fixed_oil | 1000000 | 1000000 | 1000000 | MWh | 0 | 0 | 0 | 0.000002 | PASS | PASS | SYNTHETIC_FUNCTION_REGRESSION
E1 | zero_R_dh0.3_reduction0 | VN | residential | fixed_gas | 500000 | 500000 | 500000 | MWh | 0 | 0 | 0 | 0.0000015 | PASS | PASS | SYNTHETIC_FUNCTION_REGRESSION
E1 | zero_R_dh0.3_reduction0 | VN | residential | fixed_biomass | 250000 | 250000 | 250000 | MWh | 0 | 0 | 0 | 0.0000012499999999999999 | PASS | PASS | SYNTHETIC_FUNCTION_REGRESSION
E1 | zero_R_dh0.3_reduction0 | ALL | R+S | finite_nonnegative | true | true | true | boolean | 0 | 0 | 0 | 0 | PASS | PASS | SYNTHETIC_FUNCTION_REGRESSION
E1 | zero_S_dh0.3_reduction0 | BN | residential | heat_service_without_DH_loss | 5113195.209468674 | 6000000 | 5999999.999999999 | MWh | 9.313225746154785e-10 | 1.5522042910257979e-16 | 886804.7905313252 | 0.000006999999999999999 | FAIL | PASS | SYNTHETIC_FUNCTION_REGRESSION
E1 | zero_S_dh0.3_reduction0 | BN | residential | district_heat_loss | 0 | 171450 | 171449.99999999997 | MWh | 2.9103830456733704e-11 | 1.697511254402666e-16 | 171449.99999999997 | 0.00000117145 | FAIL | PASS | SYNTHETIC_FUNCTION_REGRESSION | Upstream additive markup: supply=service*(1+0.15), not 1/(1-0.15) | Upstream additive markup: supply=service*(1+0.15), not 1/(1-0.15)
E1 | zero_S_dh0.3_reduction0 | BN | services | heat_service_without_DH_loss | 0 | 0 | 0 | MWh | 0 | 0 | 0 | 0.000001 | PASS | PASS | SYNTHETIC_FUNCTION_REGRESSION
E1 | zero_S_dh0.3_reduction0 | BN | services | district_heat_loss | 0 | 0 | 0 | MWh | 0 | 0 | 0 | 0.000001 | PASS | PASS | SYNTHETIC_FUNCTION_REGRESSION | Upstream additive markup: supply=service*(1+0.15), not 1/(1-0.15) | Upstream additive markup: supply=service*(1+0.15), not 1/(1-0.15)
E1 | zero_S_dh0.3_reduction0 | BN | services | profile_unchanged | 0 | 0 | 0 | MW | 0 | 0 | 0 | 0 | PASS | PASS | SYNTHETIC_FUNCTION_REGRESSION
E1 | zero_S_dh0.3_reduction0 | BN | residential | direct_electricity | 7000000 | 7000000 | 7000000 | MWh | 0 | 0 | 0 | 0.000008 | PASS | PASS | SYNTHETIC_FUNCTION_REGRESSION
E1 | zero_S_dh0.3_reduction0 | BN | services | direct_electricity | 3000000 | 3000000 | 3000000 | MWh | 0 | 0 | 0 | 0.000004 | PASS | PASS | SYNTHETIC_FUNCTION_REGRESSION
E1 | zero_S_dh0.3_reduction0 | BN | residential | fixed_oil | 1000000 | 1000000 | 1000000 | MWh | 0 | 0 | 0 | 0.000002 | PASS | PASS | SYNTHETIC_FUNCTION_REGRESSION
E1 | zero_S_dh0.3_reduction0 | BN | residential | fixed_gas | 500000 | 500000 | 500000 | MWh | 0 | 0 | 0 | 0.0000015 | PASS | PASS | SYNTHETIC_FUNCTION_REGRESSION
E1 | zero_S_dh0.3_reduction0 | BN | residential | fixed_biomass | 250000 | 250000 | 250000 | MWh | 0 | 0 | 0 | 0.0000012499999999999999 | PASS | PASS | SYNTHETIC_FUNCTION_REGRESSION
E1 | zero_S_dh0.3_reduction0 | KH | residential | heat_service_without_DH_loss | 5401883.70363092 | 6309999.999999998 | 6310000 | MWh | 1.862645149230957e-9 | 2.9518940558335296e-16 | 908116.2963690804 | 0.0000073099999999999995 | FAIL | PASS | SYNTHETIC_FUNCTION_REGRESSION
E1 | zero_S_dh0.3_reduction0 | KH | residential | district_heat_loss | 0 | 180308.24999999994 | 180308.25 | MWh | 5.820766091346741e-11 | 3.22823059474358e-16 | 180308.25 | 0.00000118030825 | FAIL | PASS | SYNTHETIC_FUNCTION_REGRESSION | Upstream additive markup: supply=service*(1+0.15), not 1/(1-0.15) | Upstream additive markup: supply=service*(1+0.15), not 1/(1-0.15)
E1 | zero_S_dh0.3_reduction0 | KH | services | heat_service_without_DH_loss | 0 | 0 | 0 | MWh | 0 | 0 | 0 | 0.000001 | PASS | PASS | SYNTHETIC_FUNCTION_REGRESSION
E1 | zero_S_dh0.3_reduction0 | KH | services | district_heat_loss | 0 | 0 | 0 | MWh | 0 | 0 | 0 | 0.000001 | PASS | PASS | SYNTHETIC_FUNCTION_REGRESSION | Upstream additive markup: supply=service*(1+0.15), not 1/(1-0.15) | Upstream additive markup: supply=service*(1+0.15), not 1/(1-0.15)
E1 | zero_S_dh0.3_reduction0 | KH | services | profile_unchanged | 0 | 0 | 0 | MW | 0 | 0 | 0 | 0 | PASS | PASS | SYNTHETIC_FUNCTION_REGRESSION
E1 | zero_S_dh0.3_reduction0 | KH | residential | direct_electricity | 7210000 | 7210000 | 7210000 | MWh | 0 | 0 | 0 | 0.00000821 | PASS | PASS | SYNTHETIC_FUNCTION_REGRESSION
E1 | zero_S_dh0.3_reduction0 | KH | services | direct_electricity | 3110000 | 3110000 | 3110000 | MWh | 0 | 0 | 0 | 0.00000411 | PASS | PASS | SYNTHETIC_FUNCTION_REGRESSION
E1 | zero_S_dh0.3_reduction0 | KH | residential | fixed_oil | 1000000 | 1000000 | 1000000 | MWh | 0 | 0 | 0 | 0.000002 | PASS | PASS | SYNTHETIC_FUNCTION_REGRESSION
E1 | zero_S_dh0.3_reduction0 | KH | residential | fixed_gas | 500000 | 500000 | 500000 | MWh | 0 | 0 | 0 | 0.0000015 | PASS | PASS | SYNTHETIC_FUNCTION_REGRESSION
E1 | zero_S_dh0.3_reduction0 | KH | residential | fixed_biomass | 250000 | 250000 | 250000 | MWh | 0 | 0 | 0 | 0.0000012499999999999999 | PASS | PASS | SYNTHETIC_FUNCTION_REGRESSION
E1 | zero_S_dh0.3_reduction0 | ID | residential | heat_service_without_DH_loss | 5645391.6426476 | 6619999.999999998 | 6619999.999999999 | MWh | 9.313225746154785e-10 | 1.4068316837091821e-16 | 974608.3573523993 | 0.000007619999999999999 | FAIL | PASS | SYNTHETIC_FUNCTION_REGRESSION
E1 | zero_S_dh0.3_reduction0 | ID | residential | district_heat_loss | 0 | 189166.4999999999 | 189166.49999999997 | MWh | 5.820766091346741e-11 | 3.0770596756543795e-16 | 189166.49999999997 | 0.0000011891665 | FAIL | PASS | SYNTHETIC_FUNCTION_REGRESSION | Upstream additive markup: supply=service*(1+0.15), not 1/(1-0.15) | Upstream additive markup: supply=service*(1+0.15), not 1/(1-0.15)
E1 | zero_S_dh0.3_reduction0 | ID | services | heat_service_without_DH_loss | 0 | 0 | 0 | MWh | 0 | 0 | 0 | 0.000001 | PASS | PASS | SYNTHETIC_FUNCTION_REGRESSION
E1 | zero_S_dh0.3_reduction0 | ID | services | district_heat_loss | 0 | 0 | 0 | MWh | 0 | 0 | 0 | 0.000001 | PASS | PASS | SYNTHETIC_FUNCTION_REGRESSION | Upstream additive markup: supply=service*(1+0.15), not 1/(1-0.15) | Upstream additive markup: supply=service*(1+0.15), not 1/(1-0.15)
E1 | zero_S_dh0.3_reduction0 | ID | services | profile_unchanged | 0 | 0 | 0 | MW | 0 | 0 | 0 | 0 | PASS | PASS | SYNTHETIC_FUNCTION_REGRESSION
E1 | zero_S_dh0.3_reduction0 | ID | residential | direct_electricity | 7420000 | 7420000 | 7420000 | MWh | 0 | 0 | 0 | 0.00000842 | PASS | PASS | SYNTHETIC_FUNCTION_REGRESSION
E1 | zero_S_dh0.3_reduction0 | ID | services | direct_electricity | 3220000 | 3220000 | 3220000 | MWh | 0 | 0 | 0 | 0.00000422 | PASS | PASS | SYNTHETIC_FUNCTION_REGRESSION
E1 | zero_S_dh0.3_reduction0 | ID | residential | fixed_oil | 1000000 | 1000000 | 1000000 | MWh | 0 | 0 | 0 | 0.000002 | PASS | PASS | SYNTHETIC_FUNCTION_REGRESSION
E1 | zero_S_dh0.3_reduction0 | ID | residential | fixed_gas | 500000 | 500000 | 500000 | MWh | 0 | 0 | 0 | 0.0000015 | PASS | PASS | SYNTHETIC_FUNCTION_REGRESSION
E1 | zero_S_dh0.3_reduction0 | ID | residential | fixed_biomass | 250000 | 250000 | 250000 | MWh | 0 | 0 | 0 | 0.0000012499999999999999 | PASS | PASS | SYNTHETIC_FUNCTION_REGRESSION
E1 | zero_S_dh0.3_reduction0 | LA | residential | heat_service_without_DH_loss | 5947844.5419426225 | 6930000 | 6929999.999999999 | MWh | 9.313225746154785e-10 | 1.3438998190699546e-16 | 982155.4580573766 | 0.000007929999999999999 | FAIL | PASS | SYNTHETIC_FUNCTION_REGRESSION
E1 | zero_S_dh0.3_reduction0 | LA | residential | district_heat_loss | 0 | 198024.7499999999 | 198024.74999999997 | MWh | 5.820766091346741e-11 | 2.9394134275370837e-16 | 198024.74999999997 | 0.00000119802475 | FAIL | PASS | SYNTHETIC_FUNCTION_REGRESSION | Upstream additive markup: supply=service*(1+0.15), not 1/(1-0.15) | Upstream additive markup: supply=service*(1+0.15), not 1/(1-0.15)
E1 | zero_S_dh0.3_reduction0 | LA | services | heat_service_without_DH_loss | 0 | 0 | 0 | MWh | 0 | 0 | 0 | 0.000001 | PASS | PASS | SYNTHETIC_FUNCTION_REGRESSION
E1 | zero_S_dh0.3_reduction0 | LA | services | district_heat_loss | 0 | 0 | 0 | MWh | 0 | 0 | 0 | 0.000001 | PASS | PASS | SYNTHETIC_FUNCTION_REGRESSION | Upstream additive markup: supply=service*(1+0.15), not 1/(1-0.15) | Upstream additive markup: supply=service*(1+0.15), not 1/(1-0.15)
E1 | zero_S_dh0.3_reduction0 | LA | services | profile_unchanged | 0 | 0 | 0 | MW | 0 | 0 | 0 | 0 | PASS | PASS | SYNTHETIC_FUNCTION_REGRESSION
E1 | zero_S_dh0.3_reduction0 | LA | residential | direct_electricity | 7630000 | 7630000 | 7630000 | MWh | 0 | 0 | 0 | 0.00000863 | PASS | PASS | SYNTHETIC_FUNCTION_REGRESSION
E1 | zero_S_dh0.3_reduction0 | LA | services | direct_electricity | 3330000 | 3330000 | 3330000 | MWh | 0 | 0 | 0 | 0.00000433 | PASS | PASS | SYNTHETIC_FUNCTION_REGRESSION
E1 | zero_S_dh0.3_reduction0 | LA | residential | fixed_oil | 1000000 | 1000000 | 1000000 | MWh | 0 | 0 | 0 | 0.000002 | PASS | PASS | SYNTHETIC_FUNCTION_REGRESSION
E1 | zero_S_dh0.3_reduction0 | LA | residential | fixed_gas | 500000 | 500000 | 500000 | MWh | 0 | 0 | 0 | 0.0000015 | PASS | PASS | SYNTHETIC_FUNCTION_REGRESSION
E1 | zero_S_dh0.3_reduction0 | LA | residential | fixed_biomass | 250000 | 250000 | 250000 | MWh | 0 | 0 | 0 | 0.0000012499999999999999 | PASS | PASS | SYNTHETIC_FUNCTION_REGRESSION
E1 | zero_S_dh0.3_reduction0 | MY | residential | heat_service_without_DH_loss | 6180935.040889693 | 7240000 | 7240000 | MWh | 0 | 0 | 1059064.9591103066 | 0.00000824 | FAIL | PASS | SYNTHETIC_FUNCTION_REGRESSION
E1 | zero_S_dh0.3_reduction0 | MY | residential | district_heat_loss | 0 | 206882.99999999994 | 206883 | MWh | 5.820766091346741e-11 | 2.813554565308286e-16 | 206883 | 0.000001206883 | FAIL | PASS | SYNTHETIC_FUNCTION_REGRESSION | Upstream additive markup: supply=service*(1+0.15), not 1/(1-0.15) | Upstream additive markup: supply=service*(1+0.15), not 1/(1-0.15)
E1 | zero_S_dh0.3_reduction0 | MY | services | heat_service_without_DH_loss | 0 | 0 | 0 | MWh | 0 | 0 | 0 | 0.000001 | PASS | PASS | SYNTHETIC_FUNCTION_REGRESSION
E1 | zero_S_dh0.3_reduction0 | MY | services | district_heat_loss | 0 | 0 | 0 | MWh | 0 | 0 | 0 | 0.000001 | PASS | PASS | SYNTHETIC_FUNCTION_REGRESSION | Upstream additive markup: supply=service*(1+0.15), not 1/(1-0.15) | Upstream additive markup: supply=service*(1+0.15), not 1/(1-0.15)
E1 | zero_S_dh0.3_reduction0 | MY | services | profile_unchanged | 0 | 0 | 0 | MW | 0 | 0 | 0 | 0 | PASS | PASS | SYNTHETIC_FUNCTION_REGRESSION
E1 | zero_S_dh0.3_reduction0 | MY | residential | direct_electricity | 7840000 | 7840000 | 7840000 | MWh | 0 | 0 | 0 | 0.00000884 | PASS | PASS | SYNTHETIC_FUNCTION_REGRESSION
E1 | zero_S_dh0.3_reduction0 | MY | services | direct_electricity | 3440000 | 3440000 | 3440000 | MWh | 0 | 0 | 0 | 0.00000444 | PASS | PASS | SYNTHETIC_FUNCTION_REGRESSION
E1 | zero_S_dh0.3_reduction0 | MY | residential | fixed_oil | 1000000 | 1000000 | 1000000 | MWh | 0 | 0 | 0 | 0.000002 | PASS | PASS | SYNTHETIC_FUNCTION_REGRESSION
E1 | zero_S_dh0.3_reduction0 | MY | residential | fixed_gas | 500000 | 500000 | 500000 | MWh | 0 | 0 | 0 | 0.0000015 | PASS | PASS | SYNTHETIC_FUNCTION_REGRESSION
E1 | zero_S_dh0.3_reduction0 | MY | residential | fixed_biomass | 250000 | 250000 | 250000 | MWh | 0 | 0 | 0 | 0.0000012499999999999999 | PASS | PASS | SYNTHETIC_FUNCTION_REGRESSION
E1 | zero_S_dh0.3_reduction0 | MM | residential | heat_service_without_DH_loss | 6468593.90138425 | 7549999.999999999 | 7549999.999999998 | MWh | 9.313225746154785e-10 | 1.2335398339277863e-16 | 1081406.0986157479 | 0.000008549999999999998 | FAIL | PASS | SYNTHETIC_FUNCTION_REGRESSION
E1 | zero_S_dh0.3_reduction0 | MM | residential | district_heat_loss | 0 | 215741.24999999994 | 215741.24999999997 | MWh | 2.9103830456733704e-11 | 1.3490155664127146e-16 | 215741.24999999997 | 0.00000121574125 | FAIL | PASS | SYNTHETIC_FUNCTION_REGRESSION | Upstream additive markup: supply=service*(1+0.15), not 1/(1-0.15) | Upstream additive markup: supply=service*(1+0.15), not 1/(1-0.15)
E1 | zero_S_dh0.3_reduction0 | MM | services | heat_service_without_DH_loss | 0 | 0 | 0 | MWh | 0 | 0 | 0 | 0.000001 | PASS | PASS | SYNTHETIC_FUNCTION_REGRESSION
E1 | zero_S_dh0.3_reduction0 | MM | services | district_heat_loss | 0 | 0 | 0 | MWh | 0 | 0 | 0 | 0.000001 | PASS | PASS | SYNTHETIC_FUNCTION_REGRESSION | Upstream additive markup: supply=service*(1+0.15), not 1/(1-0.15) | Upstream additive markup: supply=service*(1+0.15), not 1/(1-0.15)
E1 | zero_S_dh0.3_reduction0 | MM | services | profile_unchanged | 0 | 0 | 0 | MW | 0 | 0 | 0 | 0 | PASS | PASS | SYNTHETIC_FUNCTION_REGRESSION
E1 | zero_S_dh0.3_reduction0 | MM | residential | direct_electricity | 8050000 | 8050000 | 8050000.000000001 | MWh | 9.313225746154785e-10 | 1.1569224529384825e-16 | 9.313225746154785e-10 | 0.000009050000000000001 | PASS | PASS | SYNTHETIC_FUNCTION_REGRESSION
E1 | zero_S_dh0.3_reduction0 | MM | services | direct_electricity | 3550000 | 3550000 | 3550000 | MWh | 0 | 0 | 0 | 0.00000455 | PASS | PASS | SYNTHETIC_FUNCTION_REGRESSION
E1 | zero_S_dh0.3_reduction0 | MM | residential | fixed_oil | 1000000 | 1000000 | 1000000 | MWh | 0 | 0 | 0 | 0.000002 | PASS | PASS | SYNTHETIC_FUNCTION_REGRESSION
E1 | zero_S_dh0.3_reduction0 | MM | residential | fixed_gas | 500000 | 500000 | 500000 | MWh | 0 | 0 | 0 | 0.0000015 | PASS | PASS | SYNTHETIC_FUNCTION_REGRESSION
E1 | zero_S_dh0.3_reduction0 | MM | residential | fixed_biomass | 250000 | 250000 | 250000 | MWh | 0 | 0 | 0 | 0.0000012499999999999999 | PASS | PASS | SYNTHETIC_FUNCTION_REGRESSION
E1 | zero_S_dh0.3_reduction0 | PH | residential | heat_service_without_DH_loss | 6698285.724403962 | 7859999.999999998 | 7859999.999999998 | MWh | 0 | 0 | 1161714.2755960366 | 0.000008859999999999998 | FAIL | PASS | SYNTHETIC_FUNCTION_REGRESSION
E1 | zero_S_dh0.3_reduction0 | PH | residential | district_heat_loss | 0 | 224599.49999999994 | 224599.49999999997 | MWh | 2.9103830456733704e-11 | 1.2958101178646305e-16 | 224599.49999999997 | 0.0000012245995 | FAIL | PASS | SYNTHETIC_FUNCTION_REGRESSION | Upstream additive markup: supply=service*(1+0.15), not 1/(1-0.15) | Upstream additive markup: supply=service*(1+0.15), not 1/(1-0.15)
E1 | zero_S_dh0.3_reduction0 | PH | services | heat_service_without_DH_loss | 0 | 0 | 0 | MWh | 0 | 0 | 0 | 0.000001 | PASS | PASS | SYNTHETIC_FUNCTION_REGRESSION
E1 | zero_S_dh0.3_reduction0 | PH | services | district_heat_loss | 0 | 0 | 0 | MWh | 0 | 0 | 0 | 0.000001 | PASS | PASS | SYNTHETIC_FUNCTION_REGRESSION | Upstream additive markup: supply=service*(1+0.15), not 1/(1-0.15) | Upstream additive markup: supply=service*(1+0.15), not 1/(1-0.15)
E1 | zero_S_dh0.3_reduction0 | PH | services | profile_unchanged | 0 | 0 | 0 | MW | 0 | 0 | 0 | 0 | PASS | PASS | SYNTHETIC_FUNCTION_REGRESSION
E1 | zero_S_dh0.3_reduction0 | PH | residential | direct_electricity | 8260000 | 8260000 | 8260000 | MWh | 0 | 0 | 0 | 0.000009260000000000001 | PASS | PASS | SYNTHETIC_FUNCTION_REGRESSION
E1 | zero_S_dh0.3_reduction0 | PH | services | direct_electricity | 3660000 | 3660000 | 3660000 | MWh | 0 | 0 | 0 | 0.00000466 | PASS | PASS | SYNTHETIC_FUNCTION_REGRESSION
E1 | zero_S_dh0.3_reduction0 | PH | residential | fixed_oil | 1000000 | 1000000 | 1000000 | MWh | 0 | 0 | 0 | 0.000002 | PASS | PASS | SYNTHETIC_FUNCTION_REGRESSION
E1 | zero_S_dh0.3_reduction0 | PH | residential | fixed_gas | 500000 | 500000 | 500000 | MWh | 0 | 0 | 0 | 0.0000015 | PASS | PASS | SYNTHETIC_FUNCTION_REGRESSION
E1 | zero_S_dh0.3_reduction0 | PH | residential | fixed_biomass | 250000 | 250000 | 250000 | MWh | 0 | 0 | 0 | 0.0000012499999999999999 | PASS | PASS | SYNTHETIC_FUNCTION_REGRESSION
E1 | zero_S_dh0.3_reduction0 | SG | residential | heat_service_without_DH_loss | 6994198.0758581 | 8170000 | 8169999.999999999 | MWh | 9.313225746154785e-10 | 1.1399297118916508e-16 | 1175801.9241418988 | 0.00000917 | FAIL | PASS | SYNTHETIC_FUNCTION_REGRESSION
E1 | zero_S_dh0.3_reduction0 | SG | residential | district_heat_loss | 0 | 233457.7499999999 | 233457.74999999997 | MWh | 5.820766091346741e-11 | 2.493284584189962e-16 | 233457.74999999997 | 0.00000123345775 | FAIL | PASS | SYNTHETIC_FUNCTION_REGRESSION | Upstream additive markup: supply=service*(1+0.15), not 1/(1-0.15) | Upstream additive markup: supply=service*(1+0.15), not 1/(1-0.15)
E1 | zero_S_dh0.3_reduction0 | SG | services | heat_service_without_DH_loss | 0 | 0 | 0 | MWh | 0 | 0 | 0 | 0.000001 | PASS | PASS | SYNTHETIC_FUNCTION_REGRESSION
E1 | zero_S_dh0.3_reduction0 | SG | services | district_heat_loss | 0 | 0 | 0 | MWh | 0 | 0 | 0 | 0.000001 | PASS | PASS | SYNTHETIC_FUNCTION_REGRESSION | Upstream additive markup: supply=service*(1+0.15), not 1/(1-0.15) | Upstream additive markup: supply=service*(1+0.15), not 1/(1-0.15)
E1 | zero_S_dh0.3_reduction0 | SG | services | profile_unchanged | 0 | 0 | 0 | MW | 0 | 0 | 0 | 0 | PASS | PASS | SYNTHETIC_FUNCTION_REGRESSION
E1 | zero_S_dh0.3_reduction0 | SG | residential | direct_electricity | 8470000 | 8470000 | 8470000 | MWh | 0 | 0 | 0 | 0.00000947 | PASS | PASS | SYNTHETIC_FUNCTION_REGRESSION
E1 | zero_S_dh0.3_reduction0 | SG | services | direct_electricity | 3770000 | 3770000 | 3770000 | MWh | 0 | 0 | 0 | 0.00000477 | PASS | PASS | SYNTHETIC_FUNCTION_REGRESSION
E1 | zero_S_dh0.3_reduction0 | SG | residential | fixed_oil | 1000000 | 1000000 | 1000000 | MWh | 0 | 0 | 0 | 0.000002 | PASS | PASS | SYNTHETIC_FUNCTION_REGRESSION
E1 | zero_S_dh0.3_reduction0 | SG | residential | fixed_gas | 500000 | 500000 | 500000 | MWh | 0 | 0 | 0 | 0.0000015 | PASS | PASS | SYNTHETIC_FUNCTION_REGRESSION
E1 | zero_S_dh0.3_reduction0 | SG | residential | fixed_biomass | 250000 | 250000 | 250000 | MWh | 0 | 0 | 0 | 0.0000012499999999999999 | PASS | PASS | SYNTHETIC_FUNCTION_REGRESSION
E1 | zero_S_dh0.3_reduction0 | TH | residential | heat_service_without_DH_loss | 7231559.083028951 | 8480000 | 8480000 | MWh | 0 | 0 | 1248440.9169710493 | 0.00000948 | FAIL | PASS | SYNTHETIC_FUNCTION_REGRESSION
E1 | zero_S_dh0.3_reduction0 | TH | residential | district_heat_loss | 0 | 242315.99999999994 | 242316 | MWh | 5.820766091346741e-11 | 2.402138567550942e-16 | 242316 | 0.000001242316 | FAIL | PASS | SYNTHETIC_FUNCTION_REGRESSION | Upstream additive markup: supply=service*(1+0.15), not 1/(1-0.15) | Upstream additive markup: supply=service*(1+0.15), not 1/(1-0.15)
E1 | zero_S_dh0.3_reduction0 | TH | services | heat_service_without_DH_loss | 0 | 0 | 0 | MWh | 0 | 0 | 0 | 0.000001 | PASS | PASS | SYNTHETIC_FUNCTION_REGRESSION
E1 | zero_S_dh0.3_reduction0 | TH | services | district_heat_loss | 0 | 0 | 0 | MWh | 0 | 0 | 0 | 0.000001 | PASS | PASS | SYNTHETIC_FUNCTION_REGRESSION | Upstream additive markup: supply=service*(1+0.15), not 1/(1-0.15) | Upstream additive markup: supply=service*(1+0.15), not 1/(1-0.15)
E1 | zero_S_dh0.3_reduction0 | TH | services | profile_unchanged | 0 | 0 | 0 | MW | 0 | 0 | 0 | 0 | PASS | PASS | SYNTHETIC_FUNCTION_REGRESSION
E1 | zero_S_dh0.3_reduction0 | TH | residential | direct_electricity | 8680000 | 8680000 | 8680000 | MWh | 0 | 0 | 0 | 0.00000968 | PASS | PASS | SYNTHETIC_FUNCTION_REGRESSION
E1 | zero_S_dh0.3_reduction0 | TH | services | direct_electricity | 3880000.0000000005 | 3880000.0000000005 | 3880000 | MWh | 4.656612873077393e-10 | 1.2001579569787095e-16 | 4.656612873077393e-10 | 0.00000488 | PASS | PASS | SYNTHETIC_FUNCTION_REGRESSION
E1 | zero_S_dh0.3_reduction0 | TH | residential | fixed_oil | 1000000 | 1000000 | 1000000 | MWh | 0 | 0 | 0 | 0.000002 | PASS | PASS | SYNTHETIC_FUNCTION_REGRESSION
E1 | zero_S_dh0.3_reduction0 | TH | residential | fixed_gas | 500000 | 500000 | 500000 | MWh | 0 | 0 | 0 | 0.0000015 | PASS | PASS | SYNTHETIC_FUNCTION_REGRESSION
E1 | zero_S_dh0.3_reduction0 | TH | residential | fixed_biomass | 250000 | 250000 | 250000 | MWh | 0 | 0 | 0 | 0.0000012499999999999999 | PASS | PASS | SYNTHETIC_FUNCTION_REGRESSION
E1 | zero_S_dh0.3_reduction0 | TL | residential | heat_service_without_DH_loss | 7544235.717702115 | 8789999.999999998 | 8789999.999999998 | MWh | 0 | 0 | 1245764.2822978832 | 0.000009789999999999998 | FAIL | PASS | SYNTHETIC_FUNCTION_REGRESSION
E1 | zero_S_dh0.3_reduction0 | TL | residential | district_heat_loss | 0 | 251174.24999999988 | 251174.24999999997 | MWh | 8.731149137020111e-11 | 3.476132261575425e-16 | 251174.24999999997 | 0.00000125117425 | FAIL | PASS | SYNTHETIC_FUNCTION_REGRESSION | Upstream additive markup: supply=service*(1+0.15), not 1/(1-0.15) | Upstream additive markup: supply=service*(1+0.15), not 1/(1-0.15)
E1 | zero_S_dh0.3_reduction0 | TL | services | heat_service_without_DH_loss | 0 | 0 | 0 | MWh | 0 | 0 | 0 | 0.000001 | PASS | PASS | SYNTHETIC_FUNCTION_REGRESSION
E1 | zero_S_dh0.3_reduction0 | TL | services | district_heat_loss | 0 | 0 | 0 | MWh | 0 | 0 | 0 | 0.000001 | PASS | PASS | SYNTHETIC_FUNCTION_REGRESSION | Upstream additive markup: supply=service*(1+0.15), not 1/(1-0.15) | Upstream additive markup: supply=service*(1+0.15), not 1/(1-0.15)
E1 | zero_S_dh0.3_reduction0 | TL | services | profile_unchanged | 0 | 0 | 0 | MW | 0 | 0 | 0 | 0 | PASS | PASS | SYNTHETIC_FUNCTION_REGRESSION
E1 | zero_S_dh0.3_reduction0 | TL | residential | direct_electricity | 8890000 | 8890000 | 8890000 | MWh | 0 | 0 | 0 | 0.00000989 | PASS | PASS | SYNTHETIC_FUNCTION_REGRESSION
E1 | zero_S_dh0.3_reduction0 | TL | services | direct_electricity | 3990000 | 3990000 | 3990000 | MWh | 0 | 0 | 0 | 0.00000499 | PASS | PASS | SYNTHETIC_FUNCTION_REGRESSION
E1 | zero_S_dh0.3_reduction0 | TL | residential | fixed_oil | 1000000 | 1000000 | 1000000 | MWh | 0 | 0 | 0 | 0.000002 | PASS | PASS | SYNTHETIC_FUNCTION_REGRESSION
E1 | zero_S_dh0.3_reduction0 | TL | residential | fixed_gas | 500000 | 500000 | 500000 | MWh | 0 | 0 | 0 | 0.0000015 | PASS | PASS | SYNTHETIC_FUNCTION_REGRESSION
E1 | zero_S_dh0.3_reduction0 | TL | residential | fixed_biomass | 250000 | 250000 | 250000 | MWh | 0 | 0 | 0 | 0.0000012499999999999999 | PASS | PASS | SYNTHETIC_FUNCTION_REGRESSION
E1 | zero_S_dh0.3_reduction0 | VN | residential | heat_service_without_DH_loss | 7768854.816587874 | 9099999.999999998 | 9100000 | MWh | 1.862645149230957e-9 | 2.0468628013527e-16 | 1331145.1834121263 | 0.0000101 | FAIL | PASS | SYNTHETIC_FUNCTION_REGRESSION
E1 | zero_S_dh0.3_reduction0 | VN | residential | district_heat_loss | 0 | 260032.4999999999 | 260032.49999999997 | MWh | 5.820766091346741e-11 | 2.238476379432087e-16 | 260032.49999999997 | 0.0000012600325 | FAIL | PASS | SYNTHETIC_FUNCTION_REGRESSION | Upstream additive markup: supply=service*(1+0.15), not 1/(1-0.15) | Upstream additive markup: supply=service*(1+0.15), not 1/(1-0.15)
E1 | zero_S_dh0.3_reduction0 | VN | services | heat_service_without_DH_loss | 0 | 0 | 0 | MWh | 0 | 0 | 0 | 0.000001 | PASS | PASS | SYNTHETIC_FUNCTION_REGRESSION
E1 | zero_S_dh0.3_reduction0 | VN | services | district_heat_loss | 0 | 0 | 0 | MWh | 0 | 0 | 0 | 0.000001 | PASS | PASS | SYNTHETIC_FUNCTION_REGRESSION | Upstream additive markup: supply=service*(1+0.15), not 1/(1-0.15) | Upstream additive markup: supply=service*(1+0.15), not 1/(1-0.15)
E1 | zero_S_dh0.3_reduction0 | VN | services | profile_unchanged | 0 | 0 | 0 | MW | 0 | 0 | 0 | 0 | PASS | PASS | SYNTHETIC_FUNCTION_REGRESSION
E1 | zero_S_dh0.3_reduction0 | VN | residential | direct_electricity | 9100000 | 9100000 | 9100000 | MWh | 0 | 0 | 0 | 0.0000101 | PASS | PASS | SYNTHETIC_FUNCTION_REGRESSION
E1 | zero_S_dh0.3_reduction0 | VN | services | direct_electricity | 4099999.9999999995 | 4099999.9999999995 | 4099999.9999999995 | MWh | 0 | 0 | 0 | 0.0000050999999999999995 | PASS | PASS | SYNTHETIC_FUNCTION_REGRESSION
E1 | zero_S_dh0.3_reduction0 | VN | residential | fixed_oil | 1000000 | 1000000 | 1000000 | MWh | 0 | 0 | 0 | 0.000002 | PASS | PASS | SYNTHETIC_FUNCTION_REGRESSION
E1 | zero_S_dh0.3_reduction0 | VN | residential | fixed_gas | 500000 | 500000 | 500000 | MWh | 0 | 0 | 0 | 0.0000015 | PASS | PASS | SYNTHETIC_FUNCTION_REGRESSION
E1 | zero_S_dh0.3_reduction0 | VN | residential | fixed_biomass | 250000 | 250000 | 250000 | MWh | 0 | 0 | 0 | 0.0000012499999999999999 | PASS | PASS | SYNTHETIC_FUNCTION_REGRESSION
E1 | zero_S_dh0.3_reduction0 | ALL | R+S | finite_nonnegative | true | true | true | boolean | 0 | 0 | 0 | 0 | PASS | PASS | SYNTHETIC_FUNCTION_REGRESSION
E1 | all_service_dh0.0_reduction0 | BN | residential | heat_service_without_DH_loss | 3988566.261571679 | 6000000 | 5999999.999999999 | MWh | 9.313225746154785e-10 | 1.5522042910257979e-16 | 2011433.7384283203 | 0.000006999999999999999 | FAIL | PASS | SYNTHETIC_FUNCTION_REGRESSION
E1 | all_service_dh0.0_reduction0 | BN | residential | district_heat_loss | 0 | 0 | 0 | MWh | 0 | 0 | 0 | 0.000001 | PASS | PASS | SYNTHETIC_FUNCTION_REGRESSION | Upstream additive markup: supply=service*(1+0.15), not 1/(1-0.15) | Upstream additive markup: supply=service*(1+0.15), not 1/(1-0.15)
E1 | all_service_dh0.0_reduction0 | BN | services | heat_service_without_DH_loss | 2011433.7384283198 | 3999999.9999999995 | 4000000 | MWh | 4.656612873077393e-10 | 1.164153218269348e-16 | 1988566.2615716802 | 0.0000049999999999999996 | FAIL | PASS | SYNTHETIC_FUNCTION_REGRESSION
E1 | all_service_dh0.0_reduction0 | BN | services | district_heat_loss | 0 | 0 | 0 | MWh | 0 | 0 | 0 | 0.000001 | PASS | PASS | SYNTHETIC_FUNCTION_REGRESSION | Upstream additive markup: supply=service*(1+0.15), not 1/(1-0.15) | Upstream additive markup: supply=service*(1+0.15), not 1/(1-0.15)
E1 | all_service_dh0.0_reduction0 | BN | services | profile_unchanged | 132606.5133081609 | 0 | 0 | MW | 0 | 0 | 132606.5133081609 | 0 | FAIL | PASS | SYNTHETIC_FUNCTION_REGRESSION
E1 | all_service_dh0.0_reduction0 | BN | residential | direct_electricity | 7000000 | 7000000 | 7000000 | MWh | 0 | 0 | 0 | 0.000008 | PASS | PASS | SYNTHETIC_FUNCTION_REGRESSION
E1 | all_service_dh0.0_reduction0 | BN | services | direct_electricity | 3000000 | 3000000 | 3000000 | MWh | 0 | 0 | 0 | 0.000004 | PASS | PASS | SYNTHETIC_FUNCTION_REGRESSION
E1 | all_service_dh0.0_reduction0 | BN | residential | fixed_oil | 1000000 | 1000000 | 1000000 | MWh | 0 | 0 | 0 | 0.000002 | PASS | PASS | SYNTHETIC_FUNCTION_REGRESSION
E1 | all_service_dh0.0_reduction0 | BN | residential | fixed_gas | 500000 | 500000 | 500000 | MWh | 0 | 0 | 0 | 0.0000015 | PASS | PASS | SYNTHETIC_FUNCTION_REGRESSION
E1 | all_service_dh0.0_reduction0 | BN | residential | fixed_biomass | 250000 | 250000 | 250000 | MWh | 0 | 0 | 0 | 0.0000012499999999999999 | PASS | PASS | SYNTHETIC_FUNCTION_REGRESSION
E1 | all_service_dh0.0_reduction0 | KH | residential | heat_service_without_DH_loss | 4160941.064440369 | 6309999.999999999 | 6310000 | MWh | 9.313225746154785e-10 | 1.4759470279167648e-16 | 2149058.935559631 | 0.0000073099999999999995 | FAIL | PASS | SYNTHETIC_FUNCTION_REGRESSION
E1 | all_service_dh0.0_reduction0 | KH | residential | district_heat_loss | 0 | 0 | 0 | MWh | 0 | 0 | 0 | 0.000001 | PASS | PASS | SYNTHETIC_FUNCTION_REGRESSION | Upstream additive markup: supply=service*(1+0.15), not 1/(1-0.15) | Upstream additive markup: supply=service*(1+0.15), not 1/(1-0.15)
E1 | all_service_dh0.0_reduction0 | KH | services | heat_service_without_DH_loss | 2149058.9355596304 | 4189999.9999999995 | 4190000.000000001 | MWh | 1.3969838619232178e-9 | 3.3340903625852444e-16 | 2040941.0644403705 | 0.00000519 | FAIL | PASS | SYNTHETIC_FUNCTION_REGRESSION
E1 | all_service_dh0.0_reduction0 | KH | services | district_heat_loss | 0 | 0 | 0 | MWh | 0 | 0 | 0 | 0.000001 | PASS | PASS | SYNTHETIC_FUNCTION_REGRESSION | Upstream additive markup: supply=service*(1+0.15), not 1/(1-0.15) | Upstream additive markup: supply=service*(1+0.15), not 1/(1-0.15)
E1 | all_service_dh0.0_reduction0 | KH | services | profile_unchanged | 146906.54845174274 | 0 | 0 | MW | 0 | 0 | 146906.54845174274 | 0 | FAIL | PASS | SYNTHETIC_FUNCTION_REGRESSION
E1 | all_service_dh0.0_reduction0 | KH | residential | direct_electricity | 7210000 | 7210000 | 7210000 | MWh | 0 | 0 | 0 | 0.00000821 | PASS | PASS | SYNTHETIC_FUNCTION_REGRESSION
E1 | all_service_dh0.0_reduction0 | KH | services | direct_electricity | 3110000 | 3110000 | 3110000 | MWh | 0 | 0 | 0 | 0.00000411 | PASS | PASS | SYNTHETIC_FUNCTION_REGRESSION
E1 | all_service_dh0.0_reduction0 | KH | residential | fixed_oil | 1000000 | 1000000 | 1000000 | MWh | 0 | 0 | 0 | 0.000002 | PASS | PASS | SYNTHETIC_FUNCTION_REGRESSION
E1 | all_service_dh0.0_reduction0 | KH | residential | fixed_gas | 500000 | 500000 | 500000 | MWh | 0 | 0 | 0 | 0.0000015 | PASS | PASS | SYNTHETIC_FUNCTION_REGRESSION
E1 | all_service_dh0.0_reduction0 | KH | residential | fixed_biomass | 250000 | 250000 | 250000 | MWh | 0 | 0 | 0 | 0.0000012499999999999999 | PASS | PASS | SYNTHETIC_FUNCTION_REGRESSION
E1 | all_service_dh0.0_reduction0 | ID | residential | heat_service_without_DH_loss | 4492905.411873304 | 6619999.999999998 | 6619999.999999999 | MWh | 9.313225746154785e-10 | 1.4068316837091821e-16 | 2127094.588126695 | 0.000007619999999999999 | FAIL | PASS | SYNTHETIC_FUNCTION_REGRESSION
E1 | all_service_dh0.0_reduction0 | ID | residential | district_heat_loss | 0 | 0 | 0 | MWh | 0 | 0 | 0 | 0.000001 | PASS | PASS | SYNTHETIC_FUNCTION_REGRESSION | Upstream additive markup: supply=service*(1+0.15), not 1/(1-0.15) | Upstream additive markup: supply=service*(1+0.15), not 1/(1-0.15)
E1 | all_service_dh0.0_reduction0 | ID | services | heat_service_without_DH_loss | 2127094.5881266957 | 4380000 | 4380000 | MWh | 0 | 0 | 2252905.4118733043 | 0.000005379999999999999 | FAIL | PASS | SYNTHETIC_FUNCTION_REGRESSION
E1 | all_service_dh0.0_reduction0 | ID | services | district_heat_loss | 0 | 0 | 0 | MWh | 0 | 0 | 0 | 0.000001 | PASS | PASS | SYNTHETIC_FUNCTION_REGRESSION | Upstream additive markup: supply=service*(1+0.15), not 1/(1-0.15) | Upstream additive markup: supply=service*(1+0.15), not 1/(1-0.15)
E1 | all_service_dh0.0_reduction0 | ID | services | profile_unchanged | 143347.19803140312 | 0 | 0 | MW | 0 | 0 | 143347.19803140312 | 0 | FAIL | PASS | SYNTHETIC_FUNCTION_REGRESSION
E1 | all_service_dh0.0_reduction0 | ID | residential | direct_electricity | 7420000 | 7420000 | 7420000 | MWh | 0 | 0 | 0 | 0.00000842 | PASS | PASS | SYNTHETIC_FUNCTION_REGRESSION
E1 | all_service_dh0.0_reduction0 | ID | services | direct_electricity | 3220000 | 3220000 | 3220000 | MWh | 0 | 0 | 0 | 0.00000422 | PASS | PASS | SYNTHETIC_FUNCTION_REGRESSION
E1 | all_service_dh0.0_reduction0 | ID | residential | fixed_oil | 1000000 | 1000000 | 1000000 | MWh | 0 | 0 | 0 | 0.000002 | PASS | PASS | SYNTHETIC_FUNCTION_REGRESSION
E1 | all_service_dh0.0_reduction0 | ID | residential | fixed_gas | 500000 | 500000 | 500000 | MWh | 0 | 0 | 0 | 0.0000015 | PASS | PASS | SYNTHETIC_FUNCTION_REGRESSION
E1 | all_service_dh0.0_reduction0 | ID | residential | fixed_biomass | 250000 | 250000 | 250000 | MWh | 0 | 0 | 0 | 0.0000012499999999999999 | PASS | PASS | SYNTHETIC_FUNCTION_REGRESSION
E1 | all_service_dh0.0_reduction0 | LA | residential | heat_service_without_DH_loss | 4581966.665142203 | 6929999.999999998 | 6929999.999999999 | MWh | 9.313225746154785e-10 | 1.3438998190699546e-16 | 2348033.3348577963 | 0.000007929999999999999 | FAIL | PASS | SYNTHETIC_FUNCTION_REGRESSION
E1 | all_service_dh0.0_reduction0 | LA | residential | district_heat_loss | 0 | 0 | 0 | MWh | 0 | 0 | 0 | 0.000001 | PASS | PASS | SYNTHETIC_FUNCTION_REGRESSION | Upstream additive markup: supply=service*(1+0.15), not 1/(1-0.15) | Upstream additive markup: supply=service*(1+0.15), not 1/(1-0.15)
E1 | all_service_dh0.0_reduction0 | LA | services | heat_service_without_DH_loss | 2348033.3348577977 | 4570000 | 4570000 | MWh | 0 | 0 | 2221966.6651422023 | 0.00000557 | FAIL | PASS | SYNTHETIC_FUNCTION_REGRESSION
E1 | all_service_dh0.0_reduction0 | LA | services | district_heat_loss | 0 | 0 | 0 | MWh | 0 | 0 | 0 | 0.000001 | PASS | PASS | SYNTHETIC_FUNCTION_REGRESSION | Upstream additive markup: supply=service*(1+0.15), not 1/(1-0.15) | Upstream additive markup: supply=service*(1+0.15), not 1/(1-0.15)
E1 | all_service_dh0.0_reduction0 | LA | services | profile_unchanged | 164943.65146198822 | 0 | 0 | MW | 0 | 0 | 164943.65146198822 | 0 | FAIL | PASS | SYNTHETIC_FUNCTION_REGRESSION
E1 | all_service_dh0.0_reduction0 | LA | residential | direct_electricity | 7630000 | 7630000 | 7630000 | MWh | 0 | 0 | 0 | 0.00000863 | PASS | PASS | SYNTHETIC_FUNCTION_REGRESSION
E1 | all_service_dh0.0_reduction0 | LA | services | direct_electricity | 3330000 | 3330000 | 3330000 | MWh | 0 | 0 | 0 | 0.00000433 | PASS | PASS | SYNTHETIC_FUNCTION_REGRESSION
E1 | all_service_dh0.0_reduction0 | LA | residential | fixed_oil | 1000000 | 1000000 | 1000000 | MWh | 0 | 0 | 0 | 0.000002 | PASS | PASS | SYNTHETIC_FUNCTION_REGRESSION
E1 | all_service_dh0.0_reduction0 | LA | residential | fixed_gas | 500000 | 500000 | 500000 | MWh | 0 | 0 | 0 | 0.0000015 | PASS | PASS | SYNTHETIC_FUNCTION_REGRESSION
E1 | all_service_dh0.0_reduction0 | LA | residential | fixed_biomass | 250000 | 250000 | 250000 | MWh | 0 | 0 | 0 | 0.0000012499999999999999 | PASS | PASS | SYNTHETIC_FUNCTION_REGRESSION
E1 | all_service_dh0.0_reduction0 | MY | residential | heat_service_without_DH_loss | 4759002.554113811 | 7239999.999999999 | 7240000 | MWh | 9.313225746154785e-10 | 1.2863571472589483e-16 | 2480997.445886189 | 0.00000824 | FAIL | PASS | SYNTHETIC_FUNCTION_REGRESSION
E1 | all_service_dh0.0_reduction0 | MY | residential | district_heat_loss | 0 | 0 | 0 | MWh | 0 | 0 | 0 | 0.000001 | PASS | PASS | SYNTHETIC_FUNCTION_REGRESSION | Upstream additive markup: supply=service*(1+0.15), not 1/(1-0.15) | Upstream additive markup: supply=service*(1+0.15), not 1/(1-0.15)
E1 | all_service_dh0.0_reduction0 | MY | services | heat_service_without_DH_loss | 2480997.445886189 | 4760000 | 4760000 | MWh | 0 | 0 | 2279002.554113811 | 0.00000576 | FAIL | PASS | SYNTHETIC_FUNCTION_REGRESSION
E1 | all_service_dh0.0_reduction0 | MY | services | district_heat_loss | 0 | 0 | 0 | MWh | 0 | 0 | 0 | 0.000001 | PASS | PASS | SYNTHETIC_FUNCTION_REGRESSION | Upstream additive markup: supply=service*(1+0.15), not 1/(1-0.15) | Upstream additive markup: supply=service*(1+0.15), not 1/(1-0.15)
E1 | all_service_dh0.0_reduction0 | MY | services | profile_unchanged | 180178.00653328636 | 0 | 0 | MW | 0 | 0 | 180178.00653328636 | 0 | FAIL | PASS | SYNTHETIC_FUNCTION_REGRESSION
E1 | all_service_dh0.0_reduction0 | MY | residential | direct_electricity | 7840000 | 7840000 | 7840000 | MWh | 0 | 0 | 0 | 0.00000884 | PASS | PASS | SYNTHETIC_FUNCTION_REGRESSION
E1 | all_service_dh0.0_reduction0 | MY | services | direct_electricity | 3440000 | 3440000 | 3440000 | MWh | 0 | 0 | 0 | 0.00000444 | PASS | PASS | SYNTHETIC_FUNCTION_REGRESSION
E1 | all_service_dh0.0_reduction0 | MY | residential | fixed_oil | 1000000 | 1000000 | 1000000 | MWh | 0 | 0 | 0 | 0.000002 | PASS | PASS | SYNTHETIC_FUNCTION_REGRESSION
E1 | all_service_dh0.0_reduction0 | MY | residential | fixed_gas | 500000 | 500000 | 500000 | MWh | 0 | 0 | 0 | 0.0000015 | PASS | PASS | SYNTHETIC_FUNCTION_REGRESSION
E1 | all_service_dh0.0_reduction0 | MY | residential | fixed_biomass | 250000 | 250000 | 250000 | MWh | 0 | 0 | 0 | 0.0000012499999999999999 | PASS | PASS | SYNTHETIC_FUNCTION_REGRESSION
E1 | all_service_dh0.0_reduction0 | MM | residential | heat_service_without_DH_loss | 4883020.695806889 | 7549999.999999999 | 7549999.999999998 | MWh | 9.313225746154785e-10 | 1.2335398339277863e-16 | 2666979.3041931093 | 0.000008549999999999998 | FAIL | PASS | SYNTHETIC_FUNCTION_REGRESSION
E1 | all_service_dh0.0_reduction0 | MM | residential | district_heat_loss | 0 | 0 | 0 | MWh | 0 | 0 | 0 | 0.000001 | PASS | PASS | SYNTHETIC_FUNCTION_REGRESSION | Upstream additive markup: supply=service*(1+0.15), not 1/(1-0.15) | Upstream additive markup: supply=service*(1+0.15), not 1/(1-0.15)
E1 | all_service_dh0.0_reduction0 | MM | services | heat_service_without_DH_loss | 2666979.3041931107 | 4950000.000000001 | 4950000 | MWh | 9.313225746154785e-10 | 1.8814597466979364e-16 | 2283020.6958068893 | 0.00000595 | FAIL | PASS | SYNTHETIC_FUNCTION_REGRESSION
E1 | all_service_dh0.0_reduction0 | MM | services | district_heat_loss | 0 | 0 | 0 | MWh | 0 | 0 | 0 | 0.000001 | PASS | PASS | SYNTHETIC_FUNCTION_REGRESSION | Upstream additive markup: supply=service*(1+0.15), not 1/(1-0.15) | Upstream additive markup: supply=service*(1+0.15), not 1/(1-0.15)
E1 | all_service_dh0.0_reduction0 | MM | services | profile_unchanged | 133395.54678472143 | 0 | 0 | MW | 0 | 0 | 133395.54678472143 | 0 | FAIL | PASS | SYNTHETIC_FUNCTION_REGRESSION
E1 | all_service_dh0.0_reduction0 | MM | residential | direct_electricity | 8050000 | 8050000 | 8050000.000000001 | MWh | 9.313225746154785e-10 | 1.1569224529384825e-16 | 9.313225746154785e-10 | 0.000009050000000000001 | PASS | PASS | SYNTHETIC_FUNCTION_REGRESSION
E1 | all_service_dh0.0_reduction0 | MM | services | direct_electricity | 3550000 | 3550000 | 3550000 | MWh | 0 | 0 | 0 | 0.00000455 | PASS | PASS | SYNTHETIC_FUNCTION_REGRESSION
E1 | all_service_dh0.0_reduction0 | MM | residential | fixed_oil | 1000000 | 1000000 | 1000000 | MWh | 0 | 0 | 0 | 0.000002 | PASS | PASS | SYNTHETIC_FUNCTION_REGRESSION
E1 | all_service_dh0.0_reduction0 | MM | residential | fixed_gas | 500000 | 500000 | 500000 | MWh | 0 | 0 | 0 | 0.0000015 | PASS | PASS | SYNTHETIC_FUNCTION_REGRESSION
E1 | all_service_dh0.0_reduction0 | MM | residential | fixed_biomass | 250000 | 250000 | 250000 | MWh | 0 | 0 | 0 | 0.0000012499999999999999 | PASS | PASS | SYNTHETIC_FUNCTION_REGRESSION
E1 | all_service_dh0.0_reduction0 | PH | residential | heat_service_without_DH_loss | 5258665.111899262 | 7859999.999999999 | 7859999.999999998 | MWh | 9.313225746154785e-10 | 1.1848887717754182e-16 | 2601334.888100736 | 0.000008859999999999998 | FAIL | PASS | SYNTHETIC_FUNCTION_REGRESSION
E1 | all_service_dh0.0_reduction0 | PH | residential | district_heat_loss | 0 | 0 | 0 | MWh | 0 | 0 | 0 | 0.000001 | PASS | PASS | SYNTHETIC_FUNCTION_REGRESSION | Upstream additive markup: supply=service*(1+0.15), not 1/(1-0.15) | Upstream additive markup: supply=service*(1+0.15), not 1/(1-0.15)
E1 | all_service_dh0.0_reduction0 | PH | services | heat_service_without_DH_loss | 2601334.888100737 | 5140000 | 5140000 | MWh | 0 | 0 | 2538665.111899263 | 0.00000614 | FAIL | PASS | SYNTHETIC_FUNCTION_REGRESSION
E1 | all_service_dh0.0_reduction0 | PH | services | district_heat_loss | 0 | 0 | 0 | MWh | 0 | 0 | 0 | 0.000001 | PASS | PASS | SYNTHETIC_FUNCTION_REGRESSION | Upstream additive markup: supply=service*(1+0.15), not 1/(1-0.15) | Upstream additive markup: supply=service*(1+0.15), not 1/(1-0.15)
E1 | all_service_dh0.0_reduction0 | PH | services | profile_unchanged | 169842.02617095917 | 0 | 0 | MW | 0 | 0 | 169842.02617095917 | 0 | FAIL | PASS | SYNTHETIC_FUNCTION_REGRESSION
E1 | all_service_dh0.0_reduction0 | PH | residential | direct_electricity | 8260000 | 8260000 | 8260000 | MWh | 0 | 0 | 0 | 0.000009260000000000001 | PASS | PASS | SYNTHETIC_FUNCTION_REGRESSION
E1 | all_service_dh0.0_reduction0 | PH | services | direct_electricity | 3660000 | 3660000 | 3660000 | MWh | 0 | 0 | 0 | 0.00000466 | PASS | PASS | SYNTHETIC_FUNCTION_REGRESSION
E1 | all_service_dh0.0_reduction0 | PH | residential | fixed_oil | 1000000 | 1000000 | 1000000 | MWh | 0 | 0 | 0 | 0.000002 | PASS | PASS | SYNTHETIC_FUNCTION_REGRESSION
E1 | all_service_dh0.0_reduction0 | PH | residential | fixed_gas | 500000 | 500000 | 500000 | MWh | 0 | 0 | 0 | 0.0000015 | PASS | PASS | SYNTHETIC_FUNCTION_REGRESSION
E1 | all_service_dh0.0_reduction0 | PH | residential | fixed_biomass | 250000 | 250000 | 250000 | MWh | 0 | 0 | 0 | 0.0000012499999999999999 | PASS | PASS | SYNTHETIC_FUNCTION_REGRESSION
E1 | all_service_dh0.0_reduction0 | SG | residential | heat_service_without_DH_loss | 5419815.825303979 | 8169999.999999999 | 8169999.999999999 | MWh | 0 | 0 | 2750184.17469602 | 0.00000917 | FAIL | PASS | SYNTHETIC_FUNCTION_REGRESSION
E1 | all_service_dh0.0_reduction0 | SG | residential | district_heat_loss | 0 | 0 | 0 | MWh | 0 | 0 | 0 | 0.000001 | PASS | PASS | SYNTHETIC_FUNCTION_REGRESSION | Upstream additive markup: supply=service*(1+0.15), not 1/(1-0.15) | Upstream additive markup: supply=service*(1+0.15), not 1/(1-0.15)
E1 | all_service_dh0.0_reduction0 | SG | services | heat_service_without_DH_loss | 2750184.1746960212 | 5330000 | 5330000 | MWh | 0 | 0 | 2579815.8253039788 | 0.0000063299999999999995 | FAIL | PASS | SYNTHETIC_FUNCTION_REGRESSION
E1 | all_service_dh0.0_reduction0 | SG | services | district_heat_loss | 0 | 0 | 0 | MWh | 0 | 0 | 0 | 0.000001 | PASS | PASS | SYNTHETIC_FUNCTION_REGRESSION | Upstream additive markup: supply=service*(1+0.15), not 1/(1-0.15) | Upstream additive markup: supply=service*(1+0.15), not 1/(1-0.15)
E1 | all_service_dh0.0_reduction0 | SG | services | profile_unchanged | 186284.21080114017 | 0 | 0 | MW | 0 | 0 | 186284.21080114017 | 0 | FAIL | PASS | SYNTHETIC_FUNCTION_REGRESSION
E1 | all_service_dh0.0_reduction0 | SG | residential | direct_electricity | 8470000 | 8470000 | 8470000 | MWh | 0 | 0 | 0 | 0.00000947 | PASS | PASS | SYNTHETIC_FUNCTION_REGRESSION
E1 | all_service_dh0.0_reduction0 | SG | services | direct_electricity | 3770000 | 3770000 | 3770000 | MWh | 0 | 0 | 0 | 0.00000477 | PASS | PASS | SYNTHETIC_FUNCTION_REGRESSION
E1 | all_service_dh0.0_reduction0 | SG | residential | fixed_oil | 1000000 | 1000000 | 1000000 | MWh | 0 | 0 | 0 | 0.000002 | PASS | PASS | SYNTHETIC_FUNCTION_REGRESSION
E1 | all_service_dh0.0_reduction0 | SG | residential | fixed_gas | 500000 | 500000 | 500000 | MWh | 0 | 0 | 0 | 0.0000015 | PASS | PASS | SYNTHETIC_FUNCTION_REGRESSION
E1 | all_service_dh0.0_reduction0 | SG | residential | fixed_biomass | 250000 | 250000 | 250000 | MWh | 0 | 0 | 0 | 0.0000012499999999999999 | PASS | PASS | SYNTHETIC_FUNCTION_REGRESSION
E1 | all_service_dh0.0_reduction0 | TH | residential | heat_service_without_DH_loss | 5785291.1378098745 | 8480000 | 8480000 | MWh | 0 | 0 | 2694708.8621901255 | 0.00000948 | FAIL | PASS | SYNTHETIC_FUNCTION_REGRESSION
E1 | all_service_dh0.0_reduction0 | TH | residential | district_heat_loss | 0 | 0 | 0 | MWh | 0 | 0 | 0 | 0.000001 | PASS | PASS | SYNTHETIC_FUNCTION_REGRESSION | Upstream additive markup: supply=service*(1+0.15), not 1/(1-0.15) | Upstream additive markup: supply=service*(1+0.15), not 1/(1-0.15)
E1 | all_service_dh0.0_reduction0 | TH | services | heat_service_without_DH_loss | 2694708.8621901264 | 5519999.999999999 | 5520000 | MWh | 9.313225746154785e-10 | 1.6871785772019538e-16 | 2825291.1378098736 | 0.000006519999999999999 | FAIL | PASS | SYNTHETIC_FUNCTION_REGRESSION
E1 | all_service_dh0.0_reduction0 | TH | services | district_heat_loss | 0 | 0 | 0 | MWh | 0 | 0 | 0 | 0.000001 | PASS | PASS | SYNTHETIC_FUNCTION_REGRESSION | Upstream additive markup: supply=service*(1+0.15), not 1/(1-0.15) | Upstream additive markup: supply=service*(1+0.15), not 1/(1-0.15)
E1 | all_service_dh0.0_reduction0 | TH | services | profile_unchanged | 180131.33388411114 | 0 | 0 | MW | 0 | 0 | 180131.33388411114 | 0 | FAIL | PASS | SYNTHETIC_FUNCTION_REGRESSION
E1 | all_service_dh0.0_reduction0 | TH | residential | direct_electricity | 8680000 | 8680000 | 8680000 | MWh | 0 | 0 | 0 | 0.00000968 | PASS | PASS | SYNTHETIC_FUNCTION_REGRESSION
E1 | all_service_dh0.0_reduction0 | TH | services | direct_electricity | 3880000.0000000005 | 3880000.0000000005 | 3880000 | MWh | 4.656612873077393e-10 | 1.2001579569787095e-16 | 4.656612873077393e-10 | 0.00000488 | PASS | PASS | SYNTHETIC_FUNCTION_REGRESSION
E1 | all_service_dh0.0_reduction0 | TH | residential | fixed_oil | 1000000 | 1000000 | 1000000 | MWh | 0 | 0 | 0 | 0.000002 | PASS | PASS | SYNTHETIC_FUNCTION_REGRESSION
E1 | all_service_dh0.0_reduction0 | TH | residential | fixed_gas | 500000 | 500000 | 500000 | MWh | 0 | 0 | 0 | 0.0000015 | PASS | PASS | SYNTHETIC_FUNCTION_REGRESSION
E1 | all_service_dh0.0_reduction0 | TH | residential | fixed_biomass | 250000 | 250000 | 250000 | MWh | 0 | 0 | 0 | 0.0000012499999999999999 | PASS | PASS | SYNTHETIC_FUNCTION_REGRESSION
E1 | all_service_dh0.0_reduction0 | TL | residential | heat_service_without_DH_loss | 5841320.20272594 | 8790000 | 8789999.999999998 | MWh | 1.862645149230957e-9 | 2.1190502266563792e-16 | 2948679.7972740578 | 0.000009789999999999998 | FAIL | PASS | SYNTHETIC_FUNCTION_REGRESSION
E1 | all_service_dh0.0_reduction0 | TL | residential | district_heat_loss | 0 | 0 | 0 | MWh | 0 | 0 | 0 | 0.000001 | PASS | PASS | SYNTHETIC_FUNCTION_REGRESSION | Upstream additive markup: supply=service*(1+0.15), not 1/(1-0.15) | Upstream additive markup: supply=service*(1+0.15), not 1/(1-0.15)
E1 | all_service_dh0.0_reduction0 | TL | services | heat_service_without_DH_loss | 2948679.7972740587 | 5710000 | 5710000 | MWh | 0 | 0 | 2761320.2027259413 | 0.000006709999999999999 | FAIL | PASS | SYNTHETIC_FUNCTION_REGRESSION
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
