cyc292cycjin-oss/SGP-ESE5004-Stage2/research/02_sector_coupling/buildings_heat/phase3a4/BUILDINGS_FIX_COMBINED_TEST_MATRIX.csv

fix | case | country | sector | metric | before | expected | after | unit | absolute_error | relative_error | tolerance | before_test_status | test_status | evidence_type | before_source | after_source | tested_commit | combined_commit | detail
E1 | mixed_dh0.3_reduction0 | BN | residential | heat_service_without_DH_loss | 704120.3556377366 | 2099999.9999999995 | 2100000 | MWh | 4.656612873077393e-10 | 2.2174347014654255e-16 | 0.000003099999999999999 | FAIL | PASS | SYNTHETIC_FUNCTION_REGRESSION | Phase3A3 frozen-U failure receipt (reused) | Phase3A4 independent Git integration branch | 353dec3c83b859eab39bcf2dff79fe30d88a2ec0 | 50a73d8f531132c5459174a55cac412d5f684462
E1 | mixed_dh0.3_reduction0 | BN | residential | district_heat_loss | 0 | 60007.49999999998 | 60007.499999999985 | MWh | 7.275957614183426e-12 | 1.2125080388590474e-16 | 0.0000010600075 | FAIL | PASS | SYNTHETIC_FUNCTION_REGRESSION | Phase3A3 frozen-U failure receipt (reused) | Phase3A4 independent Git integration branch | 353dec3c83b859eab39bcf2dff79fe30d88a2ec0 | 50a73d8f531132c5459174a55cac412d5f684462 | Upstream additive markup: supply=service*(1+0.15), not 1/(1-0.15)
E1 | mixed_dh0.3_reduction0 | BN | services | heat_service_without_DH_loss | 827191.9101308445 | 4000000 | 4000000 | MWh | 0 | 0 | 0.0000049999999999999996 | FAIL | PASS | SYNTHETIC_FUNCTION_REGRESSION | Phase3A3 frozen-U failure receipt (reused) | Phase3A4 independent Git integration branch | 353dec3c83b859eab39bcf2dff79fe30d88a2ec0 | 50a73d8f531132c5459174a55cac412d5f684462
E1 | mixed_dh0.3_reduction0 | BN | services | district_heat_loss | 0 | 114300 | 114299.99999999997 | MWh | 2.9103830456733704e-11 | 2.5462668816039985e-16 | 0.0000011142999999999999 | FAIL | PASS | SYNTHETIC_FUNCTION_REGRESSION | Phase3A3 frozen-U failure receipt (reused) | Phase3A4 independent Git integration branch | 353dec3c83b859eab39bcf2dff79fe30d88a2ec0 | 50a73d8f531132c5459174a55cac412d5f684462 | Upstream additive markup: supply=service*(1+0.15), not 1/(1-0.15)
E1 | mixed_dh0.3_reduction0 | BN | services | profile_unchanged | 118815.45028754529 | 0 | 0 | MW | 0 | 0 | 0 | FAIL | PASS | SYNTHETIC_FUNCTION_REGRESSION | Phase3A3 frozen-U failure receipt (reused) | Phase3A4 independent Git integration branch | 353dec3c83b859eab39bcf2dff79fe30d88a2ec0 | 50a73d8f531132c5459174a55cac412d5f684462
E1 | mixed_dh0.3_reduction0 | BN | residential | direct_electricity | 7000000 | 7000000 | 7000000 | MWh | 0 | 0 | 0.000008 | PASS | PASS | SYNTHETIC_FUNCTION_REGRESSION | Phase3A3 frozen-U failure receipt (reused) | Phase3A4 independent Git integration branch | 353dec3c83b859eab39bcf2dff79fe30d88a2ec0 | 50a73d8f531132c5459174a55cac412d5f684462
E1 | mixed_dh0.3_reduction0 | BN | services | direct_electricity | 3000000 | 3000000 | 3000000 | MWh | 0 | 0 | 0.000004 | PASS | PASS | SYNTHETIC_FUNCTION_REGRESSION | Phase3A3 frozen-U failure receipt (reused) | Phase3A4 independent Git integration branch | 353dec3c83b859eab39bcf2dff79fe30d88a2ec0 | 50a73d8f531132c5459174a55cac412d5f684462
E1 | mixed_dh0.3_reduction0 | BN | residential | fixed_oil | 2950000 | 2950000 | 2950000.0000000005 | MWh | 4.656612873077393e-10 | 1.5785128383313194e-16 | 0.00000395 | PASS | PASS | SYNTHETIC_FUNCTION_REGRESSION | Phase3A3 frozen-U failure receipt (reused) | Phase3A4 independent Git integration branch | 353dec3c83b859eab39bcf2dff79fe30d88a2ec0 | 50a73d8f531132c5459174a55cac412d5f684462
E1 | mixed_dh0.3_reduction0 | BN | residential | fixed_gas | 1670000 | 1670000.0000000002 | 1670000.0000000002 | MWh | 0 | 0 | 0.00000267 | PASS | PASS | SYNTHETIC_FUNCTION_REGRESSION | Phase3A3 frozen-U failure receipt (reused) | Phase3A4 independent Git integration branch | 353dec3c83b859eab39bcf2dff79fe30d88a2ec0 | 50a73d8f531132c5459174a55cac412d5f684462
E1 | mixed_dh0.3_reduction0 | BN | residential | fixed_biomass | 1030000.0000000001 | 1030000.0000000002 | 1030000.0000000001 | MWh | 1.1641532182693481e-10 | 1.1302458429799495e-16 | 0.00000203 | PASS | PASS | SYNTHETIC_FUNCTION_REGRESSION | Phase3A3 frozen-U failure receipt (reused) | Phase3A4 independent Git integration branch | 353dec3c83b859eab39bcf2dff79fe30d88a2ec0 | 50a73d8f531132c5459174a55cac412d5f684462
E1 | mixed_dh0.3_reduction0 | KH | residential | heat_service_without_DH_loss | 737991.6440797118 | 2208500 | 2208500 | MWh | 0 | 0 | 0.0000032085 | FAIL | PASS | SYNTHETIC_FUNCTION_REGRESSION | Phase3A3 frozen-U failure receipt (reused) | Phase3A4 independent Git integration branch | 353dec3c83b859eab39bcf2dff79fe30d88a2ec0 | 50a73d8f531132c5459174a55cac412d5f684462
E1 | mixed_dh0.3_reduction0 | KH | residential | district_heat_loss | 0 | 63107.8875 | 63107.88749999998 | MWh | 1.4551915228366852e-11 | 2.305878996245414e-16 | 0.0000010631078875 | FAIL | PASS | SYNTHETIC_FUNCTION_REGRESSION | Phase3A3 frozen-U failure receipt (reused) | Phase3A4 independent Git integration branch | 353dec3c83b859eab39bcf2dff79fe30d88a2ec0 | 50a73d8f531132c5459174a55cac412d5f684462 | Upstream additive markup: supply=service*(1+0.15), not 1/(1-0.15)
E1 | mixed_dh0.3_reduction0 | KH | services | heat_service_without_DH_loss | 877174.0598745411 | 4190000.000000001 | 4190000 | MWh | 9.313225746154785e-10 | 2.222726908390163e-16 | 0.00000519 | FAIL | PASS | SYNTHETIC_FUNCTION_REGRESSION | Phase3A3 frozen-U failure receipt (reused) | Phase3A4 independent Git integration branch | 353dec3c83b859eab39bcf2dff79fe30d88a2ec0 | 50a73d8f531132c5459174a55cac412d5f684462
E1 | mixed_dh0.3_reduction0 | KH | services | district_heat_loss | 0 | 119729.25000000001 | 119729.24999999997 | MWh | 4.3655745685100555e-11 | 3.6462055583828136e-16 | 0.00000111972925 | FAIL | PASS | SYNTHETIC_FUNCTION_REGRESSION | Phase3A3 frozen-U failure receipt (reused) | Phase3A4 independent Git integration branch | 353dec3c83b859eab39bcf2dff79fe30d88a2ec0 | 50a73d8f531132c5459174a55cac412d5f684462 | Upstream additive markup: supply=service*(1+0.15), not 1/(1-0.15)
E1 | mixed_dh0.3_reduction0 | KH | services | profile_unchanged | 129702.82240871055 | 0 | 0 | MW | 0 | 0 | 0 | FAIL | PASS | SYNTHETIC_FUNCTION_REGRESSION | Phase3A3 frozen-U failure receipt (reused) | Phase3A4 independent Git integration branch | 353dec3c83b859eab39bcf2dff79fe30d88a2ec0 | 50a73d8f531132c5459174a55cac412d5f684462
E1 | mixed_dh0.3_reduction0 | KH | residential | direct_electricity | 7210000 | 7210000 | 7210000 | MWh | 0 | 0 | 0.00000821 | PASS | PASS | SYNTHETIC_FUNCTION_REGRESSION | Phase3A3 frozen-U failure receipt (reused) | Phase3A4 independent Git integration branch | 353dec3c83b859eab39bcf2dff79fe30d88a2ec0 | 50a73d8f531132c5459174a55cac412d5f684462
E1 | mixed_dh0.3_reduction0 | KH | services | direct_electricity | 3110000 | 3110000 | 3110000 | MWh | 0 | 0 | 0.00000411 | PASS | PASS | SYNTHETIC_FUNCTION_REGRESSION | Phase3A3 frozen-U failure receipt (reused) | Phase3A4 independent Git integration branch | 353dec3c83b859eab39bcf2dff79fe30d88a2ec0 | 50a73d8f531132c5459174a55cac412d5f684462
E1 | mixed_dh0.3_reduction0 | KH | residential | fixed_oil | 3050750 | 3050750 | 3050750 | MWh | 0 | 0 | 0.00000405075 | PASS | PASS | SYNTHETIC_FUNCTION_REGRESSION | Phase3A3 frozen-U failure receipt (reused) | Phase3A4 independent Git integration branch | 353dec3c83b859eab39bcf2dff79fe30d88a2ec0 | 50a73d8f531132c5459174a55cac412d5f684462
E1 | mixed_dh0.3_reduction0 | KH | residential | fixed_gas | 1730450.0000000002 | 1730449.9999999998 | 1730449.9999999995 | MWh | 2.3283064365386963e-10 | 1.3454918873926992e-16 | 0.0000027304499999999994 | PASS | PASS | SYNTHETIC_FUNCTION_REGRESSION | Phase3A3 frozen-U failure receipt (reused) | Phase3A4 independent Git integration branch | 353dec3c83b859eab39bcf2dff79fe30d88a2ec0 | 50a73d8f531132c5459174a55cac412d5f684462
E1 | mixed_dh0.3_reduction0 | KH | residential | fixed_biomass | 1070300 | 1070300 | 1070299.9999999998 | MWh | 2.3283064365386963e-10 | 2.1753774049693508e-16 | 0.0000020703 | PASS | PASS | SYNTHETIC_FUNCTION_REGRESSION | Phase3A3 frozen-U failure receipt (reused) | Phase3A4 independent Git integration branch | 353dec3c83b859eab39bcf2dff79fe30d88a2ec0 | 50a73d8f531132c5459174a55cac412d5f684462
E1 | mixed_dh0.3_reduction0 | ID | residential | heat_service_without_DH_loss | 803040.6436994086 | 2316999.9999999995 | 2316999.9999999995 | MWh | 0 | 0 | 0.0000033169999999999998 | FAIL | PASS | SYNTHETIC_FUNCTION_REGRESSION | Phase3A3 frozen-U failure receipt (reused) | Phase3A4 independent Git integration branch | 353dec3c83b859eab39bcf2dff79fe30d88a2ec0 | 50a73d8f531132c5459174a55cac412d5f684462
E1 | mixed_dh0.3_reduction0 | ID | residential | district_heat_loss | 0 | 66208.27499999998 | 66208.27499999997 | MWh | 1.4551915228366852e-11 | 2.1978997683245572e-16 | 0.000001066208275 | FAIL | PASS | SYNTHETIC_FUNCTION_REGRESSION | Phase3A3 frozen-U failure receipt (reused) | Phase3A4 independent Git integration branch | 353dec3c83b859eab39bcf2dff79fe30d88a2ec0 | 50a73d8f531132c5459174a55cac412d5f684462 | Upstream additive markup: supply=service*(1+0.15), not 1/(1-0.15)
E1 | mixed_dh0.3_reduction0 | ID | services | heat_service_without_DH_loss | 885995.3765729405 | 4380000 | 4380000 | MWh | 0 | 0 | 0.000005379999999999999 | FAIL | PASS | SYNTHETIC_FUNCTION_REGRESSION | Phase3A3 frozen-U failure receipt (reused) | Phase3A4 independent Git integration branch | 353dec3c83b859eab39bcf2dff79fe30d88a2ec0 | 50a73d8f531132c5459174a55cac412d5f684462
E1 | mixed_dh0.3_reduction0 | ID | services | district_heat_loss | 0 | 125158.5 | 125158.49999999997 | MWh | 2.9103830456733704e-11 | 2.325357882743378e-16 | 0.0000011251585 | FAIL | PASS | SYNTHETIC_FUNCTION_REGRESSION | Phase3A3 frozen-U failure receipt (reused) | Phase3A4 independent Git integration branch | 353dec3c83b859eab39bcf2dff79fe30d88a2ec0 | 50a73d8f531132c5459174a55cac412d5f684462 | Upstream additive markup: supply=service*(1+0.15), not 1/(1-0.15)
E1 | mixed_dh0.3_reduction0 | ID | services | profile_unchanged | 127676.15478326692 | 0 | 0 | MW | 0 | 0 | 0 | FAIL | PASS | SYNTHETIC_FUNCTION_REGRESSION | Phase3A3 frozen-U failure receipt (reused) | Phase3A4 independent Git integration branch | 353dec3c83b859eab39bcf2dff79fe30d88a2ec0 | 50a73d8f531132c5459174a55cac412d5f684462
E1 | mixed_dh0.3_reduction0 | ID | residential | direct_electricity | 7420000 | 7420000 | 7420000 | MWh | 0 | 0 | 0.00000842 | PASS | PASS | SYNTHETIC_FUNCTION_REGRESSION | Phase3A3 frozen-U failure receipt (reused) | Phase3A4 independent Git integration branch | 353dec3c83b859eab39bcf2dff79fe30d88a2ec0 | 50a73d8f531132c5459174a55cac412d5f684462
E1 | mixed_dh0.3_reduction0 | ID | services | direct_electricity | 3220000 | 3220000 | 3220000 | MWh | 0 | 0 | 0.00000422 | PASS | PASS | SYNTHETIC_FUNCTION_REGRESSION | Phase3A3 frozen-U failure receipt (reused) | Phase3A4 independent Git integration branch | 353dec3c83b859eab39bcf2dff79fe30d88a2ec0 | 50a73d8f531132c5459174a55cac412d5f684462
E1 | mixed_dh0.3_reduction0 | ID | residential | fixed_oil | 3151500.000000001 | 3151500 | 3151500 | MWh | 0 | 0 | 0.0000041515 | PASS | PASS | SYNTHETIC_FUNCTION_REGRESSION | Phase3A3 frozen-U failure receipt (reused) | Phase3A4 independent Git integration branch | 353dec3c83b859eab39bcf2dff79fe30d88a2ec0 | 50a73d8f531132c5459174a55cac412d5f684462
E1 | mixed_dh0.3_reduction0 | ID | residential | fixed_gas | 1790900 | 1790900 | 1790899.9999999998 | MWh | 2.3283064365386963e-10 | 1.3000761832255828e-16 | 0.0000027909 | PASS | PASS | SYNTHETIC_FUNCTION_REGRESSION | Phase3A3 frozen-U failure receipt (reused) | Phase3A4 independent Git integration branch | 353dec3c83b859eab39bcf2dff79fe30d88a2ec0 | 50a73d8f531132c5459174a55cac412d5f684462
E1 | mixed_dh0.3_reduction0 | ID | residential | fixed_biomass | 1110600 | 1110600 | 1110600 | MWh | 0 | 0 | 0.0000021105999999999997 | PASS | PASS | SYNTHETIC_FUNCTION_REGRESSION | Phase3A3 frozen-U failure receipt (reused) | Phase3A4 independent Git integration branch | 353dec3c83b859eab39bcf2dff79fe30d88a2ec0 | 50a73d8f531132c5459174a55cac412d5f684462
E1 | mixed_dh0.3_reduction0 | LA | residential | heat_service_without_DH_loss | 817142.3014010768 | 2425499.9999999995 | 2425499.999999999 | MWh | 4.656612873077393e-10 | 1.9198568843856496e-16 | 0.0000034254999999999996 | FAIL | PASS | SYNTHETIC_FUNCTION_REGRESSION | Phase3A3 frozen-U failure receipt (reused) | Phase3A4 independent Git integration branch | 353dec3c83b859eab39bcf2dff79fe30d88a2ec0 | 50a73d8f531132c5459174a55cac412d5f684462
E1 | mixed_dh0.3_reduction0 | LA | residential | district_heat_loss | 0 | 69308.66249999998 | 69308.66249999996 | MWh | 1.4551915228366852e-11 | 2.099581019669346e-16 | 0.0000010693086625 | FAIL | PASS | SYNTHETIC_FUNCTION_REGRESSION | Phase3A3 frozen-U failure receipt (reused) | Phase3A4 independent Git integration branch | 353dec3c83b859eab39bcf2dff79fe30d88a2ec0 | 50a73d8f531132c5459174a55cac412d5f684462 | Upstream additive markup: supply=service*(1+0.15), not 1/(1-0.15)
E1 | mixed_dh0.3_reduction0 | LA | services | heat_service_without_DH_loss | 959681.4232980134 | 4570000 | 4570000 | MWh | 0 | 0 | 0.00000557 | FAIL | PASS | SYNTHETIC_FUNCTION_REGRESSION | Phase3A3 frozen-U failure receipt (reused) | Phase3A4 independent Git integration branch | 353dec3c83b859eab39bcf2dff79fe30d88a2ec0 | 50a73d8f531132c5459174a55cac412d5f684462
E1 | mixed_dh0.3_reduction0 | LA | services | district_heat_loss | 0 | 130587.75 | 130587.74999999996 | MWh | 4.3655745685100555e-11 | 3.3430199758477007e-16 | 0.00000113058775 | FAIL | PASS | SYNTHETIC_FUNCTION_REGRESSION | Phase3A3 frozen-U failure receipt (reused) | Phase3A4 independent Git integration branch | 353dec3c83b859eab39bcf2dff79fe30d88a2ec0 | 50a73d8f531132c5459174a55cac412d5f684462 | Upstream additive markup: supply=service*(1+0.15), not 1/(1-0.15)
E1 | mixed_dh0.3_reduction0 | LA | services | profile_unchanged | 142082.36688013407 | 0 | 0 | MW | 0 | 0 | 0 | FAIL | PASS | SYNTHETIC_FUNCTION_REGRESSION | Phase3A3 frozen-U failure receipt (reused) | Phase3A4 independent Git integration branch | 353dec3c83b859eab39bcf2dff79fe30d88a2ec0 | 50a73d8f531132c5459174a55cac412d5f684462
E1 | mixed_dh0.3_reduction0 | LA | residential | direct_electricity | 7630000 | 7630000 | 7630000 | MWh | 0 | 0 | 0.00000863 | PASS | PASS | SYNTHETIC_FUNCTION_REGRESSION | Phase3A3 frozen-U failure receipt (reused) | Phase3A4 independent Git integration branch | 353dec3c83b859eab39bcf2dff79fe30d88a2ec0 | 50a73d8f531132c5459174a55cac412d5f684462
E1 | mixed_dh0.3_reduction0 | LA | services | direct_electricity | 3330000 | 3330000 | 3330000 | MWh | 0 | 0 | 0.00000433 | PASS | PASS | SYNTHETIC_FUNCTION_REGRESSION | Phase3A3 frozen-U failure receipt (reused) | Phase3A4 independent Git integration branch | 353dec3c83b859eab39bcf2dff79fe30d88a2ec0 | 50a73d8f531132c5459174a55cac412d5f684462
E1 | mixed_dh0.3_reduction0 | LA | residential | fixed_oil | 3252250 | 3252250 | 3252250.000000001 | MWh | 9.313225746154785e-10 | 2.8636254119931694e-16 | 0.00000425225 | PASS | PASS | SYNTHETIC_FUNCTION_REGRESSION | Phase3A3 frozen-U failure receipt (reused) | Phase3A4 independent Git integration branch | 353dec3c83b859eab39bcf2dff79fe30d88a2ec0 | 50a73d8f531132c5459174a55cac412d5f684462
E1 | mixed_dh0.3_reduction0 | LA | residential | fixed_gas | 1851349.9999999998 | 1851350 | 1851350.0000000005 | MWh | 4.656612873077393e-10 | 2.5152525849123033e-16 | 0.00000285135 | PASS | PASS | SYNTHETIC_FUNCTION_REGRESSION | Phase3A3 frozen-U failure receipt (reused) | Phase3A4 independent Git integration branch | 353dec3c83b859eab39bcf2dff79fe30d88a2ec0 | 50a73d8f531132c5459174a55cac412d5f684462
E1 | mixed_dh0.3_reduction0 | LA | residential | fixed_biomass | 1150900 | 1150900 | 1150900.0000000002 | MWh | 2.3283064365386963e-10 | 2.0230310509502965e-16 | 0.0000021509 | PASS | PASS | SYNTHETIC_FUNCTION_REGRESSION | Phase3A3 frozen-U failure receipt (reused) | Phase3A4 independent Git integration branch | 353dec3c83b859eab39bcf2dff79fe30d88a2ec0 | 50a73d8f531132c5459174a55cac412d5f684462
E1 | mixed_dh0.3_reduction0 | MY | residential | heat_service_without_DH_loss | 837185.0116608744 | 2534000 | 2533999.9999999995 | MWh | 4.656612873077393e-10 | 1.8376530675127832e-16 | 0.0000035339999999999995 | FAIL | PASS | SYNTHETIC_FUNCTION_REGRESSION | Phase3A3 frozen-U failure receipt (reused) | Phase3A4 independent Git integration branch | 353dec3c83b859eab39bcf2dff79fe30d88a2ec0 | 50a73d8f531132c5459174a55cac412d5f684462
E1 | mixed_dh0.3_reduction0 | MY | residential | district_heat_loss | 0 | 72409.04999999999 | 72409.04999999997 | MWh | 1.4551915228366852e-11 | 2.0096818323630615e-16 | 0.00000107240905 | FAIL | PASS | SYNTHETIC_FUNCTION_REGRESSION | Phase3A3 frozen-U failure receipt (reused) | Phase3A4 independent Git integration branch | 353dec3c83b859eab39bcf2dff79fe30d88a2ec0 | 50a73d8f531132c5459174a55cac412d5f684462 | Upstream additive markup: supply=service*(1+0.15), not 1/(1-0.15)
E1 | mixed_dh0.3_reduction0 | MY | services | heat_service_without_DH_loss | 1012154.9252207937 | 4760000 | 4760000 | MWh | 0 | 0 | 0.00000576 | FAIL | PASS | SYNTHETIC_FUNCTION_REGRESSION | Phase3A3 frozen-U failure receipt (reused) | Phase3A4 independent Git integration branch | 353dec3c83b859eab39bcf2dff79fe30d88a2ec0 | 50a73d8f531132c5459174a55cac412d5f684462
E1 | mixed_dh0.3_reduction0 | MY | services | district_heat_loss | 0 | 136017 | 136016.99999999994 | MWh | 5.820766091346741e-11 | 4.2794401371495774e-16 | 0.000001136017 | FAIL | PASS | SYNTHETIC_FUNCTION_REGRESSION | Phase3A3 frozen-U failure receipt (reused) | Phase3A4 independent Git integration branch | 353dec3c83b859eab39bcf2dff79fe30d88a2ec0 | 50a73d8f531132c5459174a55cac412d5f684462 | Upstream additive markup: supply=service*(1+0.15), not 1/(1-0.15)
E1 | mixed_dh0.3_reduction0 | MY | services | profile_unchanged | 150582.309652582 | 0 | 0 | MW | 0 | 0 | 0 | FAIL | PASS | SYNTHETIC_FUNCTION_REGRESSION | Phase3A3 frozen-U failure receipt (reused) | Phase3A4 independent Git integration branch | 353dec3c83b859eab39bcf2dff79fe30d88a2ec0 | 50a73d8f531132c5459174a55cac412d5f684462
E1 | mixed_dh0.3_reduction0 | MY | residential | direct_electricity | 7840000 | 7840000 | 7840000 | MWh | 0 | 0 | 0.00000884 | PASS | PASS | SYNTHETIC_FUNCTION_REGRESSION | Phase3A3 frozen-U failure receipt (reused) | Phase3A4 independent Git integration branch | 353dec3c83b859eab39bcf2dff79fe30d88a2ec0 | 50a73d8f531132c5459174a55cac412d5f684462
E1 | mixed_dh0.3_reduction0 | MY | services | direct_electricity | 3440000 | 3440000 | 3440000 | MWh | 0 | 0 | 0.00000444 | PASS | PASS | SYNTHETIC_FUNCTION_REGRESSION | Phase3A3 frozen-U failure receipt (reused) | Phase3A4 independent Git integration branch | 353dec3c83b859eab39bcf2dff79fe30d88a2ec0 | 50a73d8f531132c5459174a55cac412d5f684462
E1 | mixed_dh0.3_reduction0 | MY | residential | fixed_oil | 3353000 | 3353000 | 3353000.0000000005 | MWh | 4.656612873077393e-10 | 1.3887900009178028e-16 | 0.000004353 | PASS | PASS | SYNTHETIC_FUNCTION_REGRESSION | Phase3A3 frozen-U failure receipt (reused) | Phase3A4 independent Git integration branch | 353dec3c83b859eab39bcf2dff79fe30d88a2ec0 | 50a73d8f531132c5459174a55cac412d5f684462
E1 | mixed_dh0.3_reduction0 | MY | residential | fixed_gas | 1911800 | 1911800.0000000002 | 1911800 | MWh | 2.3283064365386963e-10 | 1.21786088321932e-16 | 0.0000029118 | PASS | PASS | SYNTHETIC_FUNCTION_REGRESSION | Phase3A3 frozen-U failure receipt (reused) | Phase3A4 independent Git integration branch | 353dec3c83b859eab39bcf2dff79fe30d88a2ec0 | 50a73d8f531132c5459174a55cac412d5f684462
E1 | mixed_dh0.3_reduction0 | MY | residential | fixed_biomass | 1191200 | 1191200.0000000002 | 1191200.0000000002 | MWh | 0 | 0 | 0.0000021912000000000003 | PASS | PASS | SYNTHETIC_FUNCTION_REGRESSION | Phase3A3 frozen-U failure receipt (reused) | Phase3A4 independent Git integration branch | 353dec3c83b859eab39bcf2dff79fe30d88a2ec0 | 50a73d8f531132c5459174a55cac412d5f684462
E1 | mixed_dh0.3_reduction0 | MM | residential | heat_service_without_DH_loss | 856394.3864017387 | 2642499.999999999 | 2642499.999999999 | MWh | 0 | 0 | 0.0000036424999999999986 | FAIL | PASS | SYNTHETIC_FUNCTION_REGRESSION | Phase3A3 frozen-U failure receipt (reused) | Phase3A4 independent Git integration branch | 353dec3c83b859eab39bcf2dff79fe30d88a2ec0 | 50a73d8f531132c5459174a55cac412d5f684462
E1 | mixed_dh0.3_reduction0 | MM | residential | district_heat_loss | 0 | 75509.43749999999 | 75509.43749999996 | MWh | 2.9103830456733704e-11 | 3.8543301897506136e-16 | 0.0000010755094374999999 | FAIL | PASS | SYNTHETIC_FUNCTION_REGRESSION | Phase3A3 frozen-U failure receipt (reused) | Phase3A4 independent Git integration branch | 353dec3c83b859eab39bcf2dff79fe30d88a2ec0 | 50a73d8f531132c5459174a55cac412d5f684462 | Upstream additive markup: supply=service*(1+0.15), not 1/(1-0.15)
E1 | mixed_dh0.3_reduction0 | MM | services | heat_service_without_DH_loss | 1077570.1240714935 | 4950000 | 4950000 | MWh | 0 | 0 | 0.00000595 | FAIL | PASS | SYNTHETIC_FUNCTION_REGRESSION | Phase3A3 frozen-U failure receipt (reused) | Phase3A4 independent Git integration branch | 353dec3c83b859eab39bcf2dff79fe30d88a2ec0 | 50a73d8f531132c5459174a55cac412d5f684462
E1 | mixed_dh0.3_reduction0 | MM | services | district_heat_loss | 0 | 141446.25 | 141446.25 | MWh | 0 | 0 | 0.00000114144625 | FAIL | PASS | SYNTHETIC_FUNCTION_REGRESSION | Phase3A3 frozen-U failure receipt (reused) | Phase3A4 independent Git integration branch | 353dec3c83b859eab39bcf2dff79fe30d88a2ec0 | 50a73d8f531132c5459174a55cac412d5f684462 | Upstream additive markup: supply=service*(1+0.15), not 1/(1-0.15)
E1 | mixed_dh0.3_reduction0 | MM | services | profile_unchanged | 145951.04611949137 | 0 | 0 | MW | 0 | 0 | 0 | FAIL | PASS | SYNTHETIC_FUNCTION_REGRESSION | Phase3A3 frozen-U failure receipt (reused) | Phase3A4 independent Git integration branch | 353dec3c83b859eab39bcf2dff79fe30d88a2ec0 | 50a73d8f531132c5459174a55cac412d5f684462
E1 | mixed_dh0.3_reduction0 | MM | residential | direct_electricity | 8050000 | 8050000.000000001 | 8050000 | MWh | 9.313225746154785e-10 | 1.1569224529384825e-16 | 0.000009050000000000001 | PASS | PASS | SYNTHETIC_FUNCTION_REGRESSION | Phase3A3 frozen-U failure receipt (reused) | Phase3A4 independent Git integration branch | 353dec3c83b859eab39bcf2dff79fe30d88a2ec0 | 50a73d8f531132c5459174a55cac412d5f684462
E1 | mixed_dh0.3_reduction0 | MM | services | direct_electricity | 3550000 | 3550000 | 3550000 | MWh | 0 | 0 | 0.00000455 | PASS | PASS | SYNTHETIC_FUNCTION_REGRESSION | Phase3A3 frozen-U failure receipt (reused) | Phase3A4 independent Git integration branch | 353dec3c83b859eab39bcf2dff79fe30d88a2ec0 | 50a73d8f531132c5459174a55cac412d5f684462
E1 | mixed_dh0.3_reduction0 | MM | residential | fixed_oil | 3453750 | 3453750 | 3453750 | MWh | 0 | 0 | 0.0000044537499999999995 | PASS | PASS | SYNTHETIC_FUNCTION_REGRESSION | Phase3A3 frozen-U failure receipt (reused) | Phase3A4 independent Git integration branch | 353dec3c83b859eab39bcf2dff79fe30d88a2ec0 | 50a73d8f531132c5459174a55cac412d5f684462
E1 | mixed_dh0.3_reduction0 | MM | residential | fixed_gas | 1972249.9999999995 | 1972249.9999999998 | 1972249.9999999995 | MWh | 2.3283064365386963e-10 | 1.1805331152433497e-16 | 0.0000029722499999999994 | PASS | PASS | SYNTHETIC_FUNCTION_REGRESSION | Phase3A3 frozen-U failure receipt (reused) | Phase3A4 independent Git integration branch | 353dec3c83b859eab39bcf2dff79fe30d88a2ec0 | 50a73d8f531132c5459174a55cac412d5f684462
E1 | mixed_dh0.3_reduction0 | MM | residential | fixed_biomass | 1231500 | 1231500 | 1231500 | MWh | 0 | 0 | 0.0000022314999999999997 | PASS | PASS | SYNTHETIC_FUNCTION_REGRESSION | Phase3A3 frozen-U failure receipt (reused) | Phase3A4 independent Git integration branch | 353dec3c83b859eab39bcf2dff79fe30d88a2ec0 | 50a73d8f531132c5459174a55cac412d5f684462
E1 | mixed_dh0.3_reduction0 | PH | residential | heat_service_without_DH_loss | 931258.0630440998 | 2750999.999999999 | 2750999.999999999 | MWh | 0 | 0 | 0.0000037509999999999993 | FAIL | PASS | SYNTHETIC_FUNCTION_REGRESSION | Phase3A3 frozen-U failure receipt (reused) | Phase3A4 independent Git integration branch | 353dec3c83b859eab39bcf2dff79fe30d88a2ec0 | 50a73d8f531132c5459174a55cac412d5f684462
E1 | mixed_dh0.3_reduction0 | PH | residential | district_heat_loss | 0 | 78609.82499999998 | 78609.82499999997 | MWh | 1.4551915228366852e-11 | 1.8511573112351865e-16 | 0.0000010786098249999999 | FAIL | PASS | SYNTHETIC_FUNCTION_REGRESSION | Phase3A3 frozen-U failure receipt (reused) | Phase3A4 independent Git integration branch | 353dec3c83b859eab39bcf2dff79fe30d88a2ec0 | 50a73d8f531132c5459174a55cac412d5f684462 | Upstream additive markup: supply=service*(1+0.15), not 1/(1-0.15)
E1 | mixed_dh0.3_reduction0 | PH | services | heat_service_without_DH_loss | 1073152.043161709 | 5140000 | 5140000 | MWh | 0 | 0 | 0.00000614 | FAIL | PASS | SYNTHETIC_FUNCTION_REGRESSION | Phase3A3 frozen-U failure receipt (reused) | Phase3A4 independent Git integration branch | 353dec3c83b859eab39bcf2dff79fe30d88a2ec0 | 50a73d8f531132c5459174a55cac412d5f684462
E1 | mixed_dh0.3_reduction0 | PH | services | district_heat_loss | 0 | 146875.5 | 146875.49999999997 | MWh | 2.9103830456733704e-11 | 1.9815306471626447e-16 | 0.0000011468755 | FAIL | PASS | SYNTHETIC_FUNCTION_REGRESSION | Phase3A3 frozen-U failure receipt (reused) | Phase3A4 independent Git integration branch | 353dec3c83b859eab39bcf2dff79fe30d88a2ec0 | 50a73d8f531132c5459174a55cac412d5f684462 | Upstream additive markup: supply=service*(1+0.15), not 1/(1-0.15)
E1 | mixed_dh0.3_reduction0 | PH | services | profile_unchanged | 152173.73013055266 | 0 | 0 | MW | 0 | 0 | 0 | FAIL | PASS | SYNTHETIC_FUNCTION_REGRESSION | Phase3A3 frozen-U failure receipt (reused) | Phase3A4 independent Git integration branch | 353dec3c83b859eab39bcf2dff79fe30d88a2ec0 | 50a73d8f531132c5459174a55cac412d5f684462
E1 | mixed_dh0.3_reduction0 | PH | residential | direct_electricity | 8260000 | 8260000 | 8260000 | MWh | 0 | 0 | 0.000009260000000000001 | PASS | PASS | SYNTHETIC_FUNCTION_REGRESSION | Phase3A3 frozen-U failure receipt (reused) | Phase3A4 independent Git integration branch | 353dec3c83b859eab39bcf2dff79fe30d88a2ec0 | 50a73d8f531132c5459174a55cac412d5f684462
E1 | mixed_dh0.3_reduction0 | PH | services | direct_electricity | 3660000 | 3660000 | 3660000 | MWh | 0 | 0 | 0.00000466 | PASS | PASS | SYNTHETIC_FUNCTION_REGRESSION | Phase3A3 frozen-U failure receipt (reused) | Phase3A4 independent Git integration branch | 353dec3c83b859eab39bcf2dff79fe30d88a2ec0 | 50a73d8f531132c5459174a55cac412d5f684462
E1 | mixed_dh0.3_reduction0 | PH | residential | fixed_oil | 3554500 | 3554500 | 3554500 | MWh | 0 | 0 | 0.0000045545 | PASS | PASS | SYNTHETIC_FUNCTION_REGRESSION | Phase3A3 frozen-U failure receipt (reused) | Phase3A4 independent Git integration branch | 353dec3c83b859eab39bcf2dff79fe30d88a2ec0 | 50a73d8f531132c5459174a55cac412d5f684462
E1 | mixed_dh0.3_reduction0 | PH | residential | fixed_gas | 2032700 | 2032700.0000000002 | 2032699.9999999995 | MWh | 6.984919309616089e-10 | 3.4362765334855554e-16 | 0.0000030326999999999998 | PASS | PASS | SYNTHETIC_FUNCTION_REGRESSION | Phase3A3 frozen-U failure receipt (reused) | Phase3A4 independent Git integration branch | 353dec3c83b859eab39bcf2dff79fe30d88a2ec0 | 50a73d8f531132c5459174a55cac412d5f684462
E1 | mixed_dh0.3_reduction0 | PH | residential | fixed_biomass | 1271800 | 1271800 | 1271799.9999999998 | MWh | 2.3283064365386963e-10 | 1.8307174371274542e-16 | 0.0000022718 | PASS | PASS | SYNTHETIC_FUNCTION_REGRESSION | Phase3A3 frozen-U failure receipt (reused) | Phase3A4 independent Git integration branch | 353dec3c83b859eab39bcf2dff79fe30d88a2ec0 | 50a73d8f531132c5459174a55cac412d5f684462
E1 | mixed_dh0.3_reduction0 | SG | residential | heat_service_without_DH_loss | 964068.5486178852 | 2859499.9999999995 | 2859500 | MWh | 4.656612873077393e-10 | 1.6284710169880725e-16 | 0.000003859499999999999 | FAIL | PASS | SYNTHETIC_FUNCTION_REGRESSION | Phase3A3 frozen-U failure receipt (reused) | Phase3A4 independent Git integration branch | 353dec3c83b859eab39bcf2dff79fe30d88a2ec0 | 50a73d8f531132c5459174a55cac412d5f684462
E1 | mixed_dh0.3_reduction0 | SG | residential | district_heat_loss | 0 | 81710.21249999998 | 81710.21249999998 | MWh | 0 | 0 | 0.0000010817102124999999 | FAIL | PASS | SYNTHETIC_FUNCTION_REGRESSION | Phase3A3 frozen-U failure receipt (reused) | Phase3A4 independent Git integration branch | 353dec3c83b859eab39bcf2dff79fe30d88a2ec0 | 50a73d8f531132c5459174a55cac412d5f684462 | Upstream additive markup: supply=service*(1+0.15), not 1/(1-0.15)
E1 | mixed_dh0.3_reduction0 | SG | services | heat_service_without_DH_loss | 1125803.874955216 | 5330000 | 5330000 | MWh | 0 | 0 | 0.0000063299999999999995 | FAIL | PASS | SYNTHETIC_FUNCTION_REGRESSION | Phase3A3 frozen-U failure receipt (reused) | Phase3A4 independent Git integration branch | 353dec3c83b859eab39bcf2dff79fe30d88a2ec0 | 50a73d8f531132c5459174a55cac412d5f684462
E1 | mixed_dh0.3_reduction0 | SG | services | district_heat_loss | 0 | 152304.75 | 152304.74999999994 | MWh | 5.820766091346741e-11 | 3.8217889404938063e-16 | 0.00000115230475 | FAIL | PASS | SYNTHETIC_FUNCTION_REGRESSION | Phase3A3 frozen-U failure receipt (reused) | Phase3A4 independent Git integration branch | 353dec3c83b859eab39bcf2dff79fe30d88a2ec0 | 50a73d8f531132c5459174a55cac412d5f684462 | Upstream additive markup: supply=service*(1+0.15), not 1/(1-0.15)
E1 | mixed_dh0.3_reduction0 | SG | services | profile_unchanged | 164680.52228478 | 0 | 0 | MW | 0 | 0 | 0 | FAIL | PASS | SYNTHETIC_FUNCTION_REGRESSION | Phase3A3 frozen-U failure receipt (reused) | Phase3A4 independent Git integration branch | 353dec3c83b859eab39bcf2dff79fe30d88a2ec0 | 50a73d8f531132c5459174a55cac412d5f684462
E1 | mixed_dh0.3_reduction0 | SG | residential | direct_electricity | 8470000 | 8470000 | 8470000 | MWh | 0 | 0 | 0.00000947 | PASS | PASS | SYNTHETIC_FUNCTION_REGRESSION | Phase3A3 frozen-U failure receipt (reused) | Phase3A4 independent Git integration branch | 353dec3c83b859eab39bcf2dff79fe30d88a2ec0 | 50a73d8f531132c5459174a55cac412d5f684462
E1 | mixed_dh0.3_reduction0 | SG | services | direct_electricity | 3770000 | 3770000 | 3770000 | MWh | 0 | 0 | 0.00000477 | PASS | PASS | SYNTHETIC_FUNCTION_REGRESSION | Phase3A3 frozen-U failure receipt (reused) | Phase3A4 independent Git integration branch | 353dec3c83b859eab39bcf2dff79fe30d88a2ec0 | 50a73d8f531132c5459174a55cac412d5f684462
E1 | mixed_dh0.3_reduction0 | SG | residential | fixed_oil | 3655250 | 3655250 | 3655250 | MWh | 0 | 0 | 0.00000465525 | PASS | PASS | SYNTHETIC_FUNCTION_REGRESSION | Phase3A3 frozen-U failure receipt (reused) | Phase3A4 independent Git integration branch | 353dec3c83b859eab39bcf2dff79fe30d88a2ec0 | 50a73d8f531132c5459174a55cac412d5f684462
E1 | mixed_dh0.3_reduction0 | SG | residential | fixed_gas | 2093150 | 2093150 | 2093150 | MWh | 0 | 0 | 0.00000309315 | PASS | PASS | SYNTHETIC_FUNCTION_REGRESSION | Phase3A3 frozen-U failure receipt (reused) | Phase3A4 independent Git integration branch | 353dec3c83b859eab39bcf2dff79fe30d88a2ec0 | 50a73d8f531132c5459174a55cac412d5f684462
E1 | mixed_dh0.3_reduction0 | SG | residential | fixed_biomass | 1312100 | 1312100 | 1312100 | MWh | 0 | 0 | 0.0000023121 | PASS | PASS | SYNTHETIC_FUNCTION_REGRESSION | Phase3A3 frozen-U failure receipt (reused) | Phase3A4 independent Git integration branch | 353dec3c83b859eab39bcf2dff79fe30d88a2ec0 | 50a73d8f531132c5459174a55cac412d5f684462
E1 | mixed_dh0.3_reduction0 | TH | residential | heat_service_without_DH_loss | 1036748.4557569425 | 2968000 | 2968000 | MWh | 0 | 0 | 0.000003968 | FAIL | PASS | SYNTHETIC_FUNCTION_REGRESSION | Phase3A3 frozen-U failure receipt (reused) | Phase3A4 independent Git integration branch | 353dec3c83b859eab39bcf2dff79fe30d88a2ec0 | 50a73d8f531132c5459174a55cac412d5f684462
E1 | mixed_dh0.3_reduction0 | TH | residential | district_heat_loss | 0 | 84810.59999999999 | 84810.59999999996 | MWh | 2.9103830456733704e-11 | 3.431626525072775e-16 | 0.0000010848105999999999 | FAIL | PASS | SYNTHETIC_FUNCTION_REGRESSION | Phase3A3 frozen-U failure receipt (reused) | Phase3A4 independent Git integration branch | 353dec3c83b859eab39bcf2dff79fe30d88a2ec0 | 50a73d8f531132c5459174a55cac412d5f684462 | Upstream additive markup: supply=service*(1+0.15), not 1/(1-0.15)
E1 | mixed_dh0.3_reduction0 | TH | services | heat_service_without_DH_loss | 1125367.6603626618 | 5520000 | 5519999.999999999 | MWh | 9.313225746154785e-10 | 1.6871785772019538e-16 | 0.000006519999999999999 | FAIL | PASS | SYNTHETIC_FUNCTION_REGRESSION | Phase3A3 frozen-U failure receipt (reused) | Phase3A4 independent Git integration branch | 353dec3c83b859eab39bcf2dff79fe30d88a2ec0 | 50a73d8f531132c5459174a55cac412d5f684462
E1 | mixed_dh0.3_reduction0 | TH | services | district_heat_loss | 0 | 157733.99999999997 | 157733.99999999994 | MWh | 2.9103830456733704e-11 | 1.84512092869855e-16 | 0.000001157734 | FAIL | PASS | SYNTHETIC_FUNCTION_REGRESSION | Phase3A3 frozen-U failure receipt (reused) | Phase3A4 independent Git integration branch | 353dec3c83b859eab39bcf2dff79fe30d88a2ec0 | 50a73d8f531132c5459174a55cac412d5f684462 | Upstream additive markup: supply=service*(1+0.15), not 1/(1-0.15)
E1 | mixed_dh0.3_reduction0 | TH | services | profile_unchanged | 160623.825536832 | 0 | 0 | MW | 0 | 0 | 0 | FAIL | PASS | SYNTHETIC_FUNCTION_REGRESSION | Phase3A3 frozen-U failure receipt (reused) | Phase3A4 independent Git integration branch | 353dec3c83b859eab39bcf2dff79fe30d88a2ec0 | 50a73d8f531132c5459174a55cac412d5f684462
E1 | mixed_dh0.3_reduction0 | TH | residential | direct_electricity | 8680000 | 8680000 | 8680000 | MWh | 0 | 0 | 0.00000968 | PASS | PASS | SYNTHETIC_FUNCTION_REGRESSION | Phase3A3 frozen-U failure receipt (reused) | Phase3A4 independent Git integration branch | 353dec3c83b859eab39bcf2dff79fe30d88a2ec0 | 50a73d8f531132c5459174a55cac412d5f684462
E1 | mixed_dh0.3_reduction0 | TH | services | direct_electricity | 3880000.0000000005 | 3880000 | 3880000.0000000005 | MWh | 4.656612873077393e-10 | 1.2001579569787095e-16 | 0.00000488 | PASS | PASS | SYNTHETIC_FUNCTION_REGRESSION | Phase3A3 frozen-U failure receipt (reused) | Phase3A4 independent Git integration branch | 353dec3c83b859eab39bcf2dff79fe30d88a2ec0 | 50a73d8f531132c5459174a55cac412d5f684462
E1 | mixed_dh0.3_reduction0 | TH | residential | fixed_oil | 3756000 | 3756000 | 3755999.999999999 | MWh | 9.313225746154785e-10 | 2.47955957032875e-16 | 0.000004756 | PASS | PASS | SYNTHETIC_FUNCTION_REGRESSION | Phase3A3 frozen-U failure receipt (reused) | Phase3A4 independent Git integration branch | 353dec3c83b859eab39bcf2dff79fe30d88a2ec0 | 50a73d8f531132c5459174a55cac412d5f684462
E1 | mixed_dh0.3_reduction0 | TH | residential | fixed_gas | 2153600 | 2153600 | 2153600 | MWh | 0 | 0 | 0.0000031535999999999998 | PASS | PASS | SYNTHETIC_FUNCTION_REGRESSION | Phase3A3 frozen-U failure receipt (reused) | Phase3A4 independent Git integration branch | 353dec3c83b859eab39bcf2dff79fe30d88a2ec0 | 50a73d8f531132c5459174a55cac412d5f684462
E1 | mixed_dh0.3_reduction0 | TH | residential | fixed_biomass | 1352400 | 1352400 | 1352400 | MWh | 0 | 0 | 0.0000023523999999999997 | PASS | PASS | SYNTHETIC_FUNCTION_REGRESSION | Phase3A3 frozen-U failure receipt (reused) | Phase3A4 independent Git integration branch | 353dec3c83b859eab39bcf2dff79fe30d88a2ec0 | 50a73d8f531132c5459174a55cac412d5f684462
E1 | mixed_dh0.3_reduction0 | TL | residential | heat_service_without_DH_loss | 1044325.97485008 | 3076499.999999999 | 3076499.999999999 | MWh | 0 | 0 | 0.000004076499999999999 | FAIL | PASS | SYNTHETIC_FUNCTION_REGRESSION | Phase3A3 frozen-U failure receipt (reused) | Phase3A4 independent Git integration branch | 353dec3c83b859eab39bcf2dff79fe30d88a2ec0 | 50a73d8f531132c5459174a55cac412d5f684462
E1 | mixed_dh0.3_reduction0 | TL | residential | district_heat_loss | 0 | 87910.98749999997 | 87910.98749999997 | MWh | 0 | 0 | 0.0000010879109874999999 | FAIL | PASS | SYNTHETIC_FUNCTION_REGRESSION | Phase3A3 frozen-U failure receipt (reused) | Phase3A4 independent Git integration branch | 353dec3c83b859eab39bcf2dff79fe30d88a2ec0 | 50a73d8f531132c5459174a55cac412d5f684462 | Upstream additive markup: supply=service*(1+0.15), not 1/(1-0.15)
E1 | mixed_dh0.3_reduction0 | TL | services | heat_service_without_DH_loss | 1208174.7152441125 | 5710000 | 5709999.999999998 | MWh | 1.862645149230957e-9 | 3.2620755678300474e-16 | 0.000006709999999999999 | FAIL | PASS | SYNTHETIC_FUNCTION_REGRESSION | Phase3A3 frozen-U failure receipt (reused) | Phase3A4 independent Git integration branch | 353dec3c83b859eab39bcf2dff79fe30d88a2ec0 | 50a73d8f531132c5459174a55cac412d5f684462
E1 | mixed_dh0.3_reduction0 | TL | services | district_heat_loss | 0 | 163163.25 | 163163.24999999994 | MWh | 5.820766091346741e-11 | 3.567449221161469e-16 | 0.00000116316325 | FAIL | PASS | SYNTHETIC_FUNCTION_REGRESSION | Phase3A3 frozen-U failure receipt (reused) | Phase3A4 independent Git integration branch | 353dec3c83b859eab39bcf2dff79fe30d88a2ec0 | 50a73d8f531132c5459174a55cac412d5f684462 | Upstream additive markup: supply=service*(1+0.15), not 1/(1-0.15)
E1 | mixed_dh0.3_reduction0 | TL | services | profile_unchanged | 176979.12874624395 | 0 | 0 | MW | 0 | 0 | 0 | FAIL | PASS | SYNTHETIC_FUNCTION_REGRESSION | Phase3A3 frozen-U failure receipt (reused) | Phase3A4 independent Git integration branch | 353dec3c83b859eab39bcf2dff79fe30d88a2ec0 | 50a73d8f531132c5459174a55cac412d5f684462
E1 | mixed_dh0.3_reduction0 | TL | residential | direct_electricity | 8890000 | 8890000 | 8890000 | MWh | 0 | 0 | 0.00000989 | PASS | PASS | SYNTHETIC_FUNCTION_REGRESSION | Phase3A3 frozen-U failure receipt (reused) | Phase3A4 independent Git integration branch | 353dec3c83b859eab39bcf2dff79fe30d88a2ec0 | 50a73d8f531132c5459174a55cac412d5f684462
E1 | mixed_dh0.3_reduction0 | TL | services | direct_electricity | 3990000 | 3990000 | 3990000 | MWh | 0 | 0 | 0.00000499 | PASS | PASS | SYNTHETIC_FUNCTION_REGRESSION | Phase3A3 frozen-U failure receipt (reused) | Phase3A4 independent Git integration branch | 353dec3c83b859eab39bcf2dff79fe30d88a2ec0 | 50a73d8f531132c5459174a55cac412d5f684462
E1 | mixed_dh0.3_reduction0 | TL | residential | fixed_oil | 3856750 | 3856750 | 3856750 | MWh | 0 | 0 | 0.00000485675 | PASS | PASS | SYNTHETIC_FUNCTION_REGRESSION | Phase3A3 frozen-U failure receipt (reused) | Phase3A4 independent Git integration branch | 353dec3c83b859eab39bcf2dff79fe30d88a2ec0 | 50a73d8f531132c5459174a55cac412d5f684462
E1 | mixed_dh0.3_reduction0 | TL | residential | fixed_gas | 2214050 | 2214050 | 2214050 | MWh | 0 | 0 | 0.00000321405 | PASS | PASS | SYNTHETIC_FUNCTION_REGRESSION | Phase3A3 frozen-U failure receipt (reused) | Phase3A4 independent Git integration branch | 353dec3c83b859eab39bcf2dff79fe30d88a2ec0 | 50a73d8f531132c5459174a55cac412d5f684462
E1 | mixed_dh0.3_reduction0 | TL | residential | fixed_biomass | 1392700.0000000002 | 1392700 | 1392700 | MWh | 0 | 0 | 0.0000023927 | PASS | PASS | SYNTHETIC_FUNCTION_REGRESSION | Phase3A3 frozen-U failure receipt (reused) | Phase3A4 independent Git integration branch | 353dec3c83b859eab39bcf2dff79fe30d88a2ec0 | 50a73d8f531132c5459174a55cac412d5f684462
E1 | mixed_dh0.3_reduction0 | VN | residential | heat_service_without_DH_loss | 1059718.0440656594 | 3184999.9999999995 | 3184999.999999999 | MWh | 4.656612873077393e-10 | 1.4620448581090717e-16 | 0.000004185 | FAIL | PASS | SYNTHETIC_FUNCTION_REGRESSION | Phase3A3 frozen-U failure receipt (reused) | Phase3A4 independent Git integration branch | 353dec3c83b859eab39bcf2dff79fe30d88a2ec0 | 50a73d8f531132c5459174a55cac412d5f684462
E1 | mixed_dh0.3_reduction0 | VN | residential | district_heat_loss | 0 | 91011.37499999999 | 91011.37499999997 | MWh | 1.4551915228366852e-11 | 1.5989116995943478e-16 | 0.0000010910113749999999 | FAIL | PASS | SYNTHETIC_FUNCTION_REGRESSION | Phase3A3 frozen-U failure receipt (reused) | Phase3A4 independent Git integration branch | 353dec3c83b859eab39bcf2dff79fe30d88a2ec0 | 50a73d8f531132c5459174a55cac412d5f684462 | Upstream additive markup: supply=service*(1+0.15), not 1/(1-0.15)
E1 | mixed_dh0.3_reduction0 | VN | services | heat_service_without_DH_loss | 1263450.1471808902 | 5900000 | 5900000 | MWh | 0 | 0 | 0.0000069 | FAIL | PASS | SYNTHETIC_FUNCTION_REGRESSION | Phase3A3 frozen-U failure receipt (reused) | Phase3A4 independent Git integration branch | 353dec3c83b859eab39bcf2dff79fe30d88a2ec0 | 50a73d8f531132c5459174a55cac412d5f684462
E1 | mixed_dh0.3_reduction0 | VN | services | district_heat_loss | 0 | 168592.5 | 168592.49999999994 | MWh | 5.820766091346741e-11 | 3.4525652631918625e-16 | 0.0000011685925 | FAIL | PASS | SYNTHETIC_FUNCTION_REGRESSION | Phase3A3 frozen-U failure receipt (reused) | Phase3A4 independent Git integration branch | 353dec3c83b859eab39bcf2dff79fe30d88a2ec0 | 50a73d8f531132c5459174a55cac412d5f684462 | Upstream additive markup: supply=service*(1+0.15), not 1/(1-0.15)
E1 | mixed_dh0.3_reduction0 | VN | services | profile_unchanged | 186427.6509519597 | 0 | 0 | MW | 0 | 0 | 0 | FAIL | PASS | SYNTHETIC_FUNCTION_REGRESSION | Phase3A3 frozen-U failure receipt (reused) | Phase3A4 independent Git integration branch | 353dec3c83b859eab39bcf2dff79fe30d88a2ec0 | 50a73d8f531132c5459174a55cac412d5f684462
E1 | mixed_dh0.3_reduction0 | VN | residential | direct_electricity | 9100000 | 9100000 | 9100000 | MWh | 0 | 0 | 0.0000101 | PASS | PASS | SYNTHETIC_FUNCTION_REGRESSION | Phase3A3 frozen-U failure receipt (reused) | Phase3A4 independent Git integration branch | 353dec3c83b859eab39bcf2dff79fe30d88a2ec0 | 50a73d8f531132c5459174a55cac412d5f684462
E1 | mixed_dh0.3_reduction0 | VN | services | direct_electricity | 4099999.9999999995 | 4099999.9999999995 | 4099999.9999999995 | MWh | 0 | 0 | 0.0000050999999999999995 | PASS | PASS | SYNTHETIC_FUNCTION_REGRESSION | Phase3A3 frozen-U failure receipt (reused) | Phase3A4 independent Git integration branch | 353dec3c83b859eab39bcf2dff79fe30d88a2ec0 | 50a73d8f531132c5459174a55cac412d5f684462
E1 | mixed_dh0.3_reduction0 | VN | residential | fixed_oil | 3957500.0000000005 | 3957500 | 3957500 | MWh | 0 | 0 | 0.0000049574999999999995 | PASS | PASS | SYNTHETIC_FUNCTION_REGRESSION | Phase3A3 frozen-U failure receipt (reused) | Phase3A4 independent Git integration branch | 353dec3c83b859eab39bcf2dff79fe30d88a2ec0 | 50a73d8f531132c5459174a55cac412d5f684462
E1 | mixed_dh0.3_reduction0 | VN | residential | fixed_gas | 2274500 | 2274499.9999999995 | 2274500 | MWh | 4.656612873077393e-10 | 2.0473127602010963e-16 | 0.0000032744999999999997 | PASS | PASS | SYNTHETIC_FUNCTION_REGRESSION | Phase3A3 frozen-U failure receipt (reused) | Phase3A4 independent Git integration branch | 353dec3c83b859eab39bcf2dff79fe30d88a2ec0 | 50a73d8f531132c5459174a55cac412d5f684462
E1 | mixed_dh0.3_reduction0 | VN | residential | fixed_biomass | 1433000 | 1433000 | 1433000 | MWh | 0 | 0 | 0.000002433 | PASS | PASS | SYNTHETIC_FUNCTION_REGRESSION | Phase3A3 frozen-U failure receipt (reused) | Phase3A4 independent Git integration branch | 353dec3c83b859eab39bcf2dff79fe30d88a2ec0 | 50a73d8f531132c5459174a55cac412d5f684462
E1 | mixed_dh0.3_reduction0 | ALL | R+S | finite_nonnegative | true | true | true | boolean | 0 | 0 | 0 | PASS | PASS | SYNTHETIC_FUNCTION_REGRESSION | Phase3A3 frozen-U failure receipt (reused) | Phase3A4 independent Git integration branch | 353dec3c83b859eab39bcf2dff79fe30d88a2ec0 | 50a73d8f531132c5459174a55cac412d5f684462
E1 | all_service_dh0.3_reduction0 | BN | residential | heat_service_without_DH_loss | 3542214.5080164745 | 5999999.999999999 | 6000000 | MWh | 9.313225746154785e-10 | 1.5522042910257979e-16 | 0.000006999999999999999 | FAIL | PASS | SYNTHETIC_FUNCTION_REGRESSION | Phase3A3 frozen-U failure receipt (reused) | Phase3A4 independent Git integration branch | 353dec3c83b859eab39bcf2dff79fe30d88a2ec0 | 50a73d8f531132c5459174a55cac412d5f684462
E1 | all_service_dh0.3_reduction0 | BN | residential | district_heat_loss | 0 | 171449.99999999997 | 171450 | MWh | 2.9103830456733704e-11 | 1.697511254402666e-16 | 0.00000117145 | FAIL | PASS | SYNTHETIC_FUNCTION_REGRESSION | Phase3A3 frozen-U failure receipt (reused) | Phase3A4 independent Git integration branch | 353dec3c83b859eab39bcf2dff79fe30d88a2ec0 | 50a73d8f531132c5459174a55cac412d5f684462 | Upstream additive markup: supply=service*(1+0.15), not 1/(1-0.15)
E1 | all_service_dh0.3_reduction0 | BN | services | heat_service_without_DH_loss | 1456472.4716897612 | 4000000 | 4000000 | MWh | 0 | 0 | 0.0000049999999999999996 | FAIL | PASS | SYNTHETIC_FUNCTION_REGRESSION | Phase3A3 frozen-U failure receipt (reused) | Phase3A4 independent Git integration branch | 353dec3c83b859eab39bcf2dff79fe30d88a2ec0 | 50a73d8f531132c5459174a55cac412d5f684462
E1 | all_service_dh0.3_reduction0 | BN | services | district_heat_loss | 0 | 114300 | 114299.99999999997 | MWh | 2.9103830456733704e-11 | 2.5462668816039985e-16 | 0.0000011142999999999999 | FAIL | PASS | SYNTHETIC_FUNCTION_REGRESSION | Phase3A3 frozen-U failure receipt (reused) | Phase3A4 independent Git integration branch | 353dec3c83b859eab39bcf2dff79fe30d88a2ec0 | 50a73d8f531132c5459174a55cac412d5f684462 | Upstream additive markup: supply=service*(1+0.15), not 1/(1-0.15)
E1 | all_service_dh0.3_reduction0 | BN | services | profile_unchanged | 97945.89857391364 | 0 | 0 | MW | 0 | 0 | 0 | FAIL | PASS | SYNTHETIC_FUNCTION_REGRESSION | Phase3A3 frozen-U failure receipt (reused) | Phase3A4 independent Git integration branch | 353dec3c83b859eab39bcf2dff79fe30d88a2ec0 | 50a73d8f531132c5459174a55cac412d5f684462
E1 | all_service_dh0.3_reduction0 | BN | residential | direct_electricity | 7000000 | 7000000 | 7000000 | MWh | 0 | 0 | 0.000008 | PASS | PASS | SYNTHETIC_FUNCTION_REGRESSION | Phase3A3 frozen-U failure receipt (reused) | Phase3A4 independent Git integration branch | 353dec3c83b859eab39bcf2dff79fe30d88a2ec0 | 50a73d8f531132c5459174a55cac412d5f684462
E1 | all_service_dh0.3_reduction0 | BN | services | direct_electricity | 3000000 | 3000000 | 3000000 | MWh | 0 | 0 | 0.000004 | PASS | PASS | SYNTHETIC_FUNCTION_REGRESSION | Phase3A3 frozen-U failure receipt (reused) | Phase3A4 independent Git integration branch | 353dec3c83b859eab39bcf2dff79fe30d88a2ec0 | 50a73d8f531132c5459174a55cac412d5f684462
E1 | all_service_dh0.3_reduction0 | BN | residential | fixed_oil | 1000000 | 1000000 | 1000000 | MWh | 0 | 0 | 0.000002 | PASS | PASS | SYNTHETIC_FUNCTION_REGRESSION | Phase3A3 frozen-U failure receipt (reused) | Phase3A4 independent Git integration branch | 353dec3c83b859eab39bcf2dff79fe30d88a2ec0 | 50a73d8f531132c5459174a55cac412d5f684462
E1 | all_service_dh0.3_reduction0 | BN | residential | fixed_gas | 500000 | 500000 | 500000 | MWh | 0 | 0 | 0.0000015 | PASS | PASS | SYNTHETIC_FUNCTION_REGRESSION | Phase3A3 frozen-U failure receipt (reused) | Phase3A4 independent Git integration branch | 353dec3c83b859eab39bcf2dff79fe30d88a2ec0 | 50a73d8f531132c5459174a55cac412d5f684462
E1 | all_service_dh0.3_reduction0 | BN | residential | fixed_biomass | 250000 | 250000 | 250000 | MWh | 0 | 0 | 0.0000012499999999999999 | PASS | PASS | SYNTHETIC_FUNCTION_REGRESSION | Phase3A3 frozen-U failure receipt (reused) | Phase3A4 independent Git integration branch | 353dec3c83b859eab39bcf2dff79fe30d88a2ec0 | 50a73d8f531132c5459174a55cac412d5f684462
E1 | all_service_dh0.3_reduction0 | KH | residential | heat_service_without_DH_loss | 3717442.6446351623 | 6310000 | 6309999.999999998 | MWh | 1.862645149230957e-9 | 2.9518940558335296e-16 | 0.0000073099999999999995 | FAIL | PASS | SYNTHETIC_FUNCTION_REGRESSION | Phase3A3 frozen-U failure receipt (reused) | Phase3A4 independent Git integration branch | 353dec3c83b859eab39bcf2dff79fe30d88a2ec0 | 50a73d8f531132c5459174a55cac412d5f684462
E1 | all_service_dh0.3_reduction0 | KH | residential | district_heat_loss | 0 | 180308.25 | 180308.24999999994 | MWh | 5.820766091346741e-11 | 3.22823059474358e-16 | 0.00000118030825 | FAIL | PASS | SYNTHETIC_FUNCTION_REGRESSION | Phase3A3 frozen-U failure receipt (reused) | Phase3A4 independent Git integration branch | 353dec3c83b859eab39bcf2dff79fe30d88a2ec0 | 50a73d8f531132c5459174a55cac412d5f684462 | Upstream additive markup: supply=service*(1+0.15), not 1/(1-0.15)
E1 | all_service_dh0.3_reduction0 | KH | services | heat_service_without_DH_loss | 1546488.3635018608 | 4190000.000000001 | 4190000 | MWh | 9.313225746154785e-10 | 2.222726908390163e-16 | 0.00000519 | FAIL | PASS | SYNTHETIC_FUNCTION_REGRESSION | Phase3A3 frozen-U failure receipt (reused) | Phase3A4 independent Git integration branch | 353dec3c83b859eab39bcf2dff79fe30d88a2ec0 | 50a73d8f531132c5459174a55cac412d5f684462
E1 | all_service_dh0.3_reduction0 | KH | services | district_heat_loss | 0 | 119729.25000000001 | 119729.24999999997 | MWh | 4.3655745685100555e-11 | 3.6462055583828136e-16 | 0.00000111972925 | FAIL | PASS | SYNTHETIC_FUNCTION_REGRESSION | Phase3A3 frozen-U failure receipt (reused) | Phase3A4 independent Git integration branch | 353dec3c83b859eab39bcf2dff79fe30d88a2ec0 | 50a73d8f531132c5459174a55cac412d5f684462 | Upstream additive markup: supply=service*(1+0.15), not 1/(1-0.15)
E1 | all_service_dh0.3_reduction0 | KH | services | profile_unchanged | 108802.53733362423 | 0 | 0 | MW | 0 | 0 | 0 | FAIL | PASS | SYNTHETIC_FUNCTION_REGRESSION | Phase3A3 frozen-U failure receipt (reused) | Phase3A4 independent Git integration branch | 353dec3c83b859eab39bcf2dff79fe30d88a2ec0 | 50a73d8f531132c5459174a55cac412d5f684462
E1 | all_service_dh0.3_reduction0 | KH | residential | direct_electricity | 7210000 | 7210000 | 7210000 | MWh | 0 | 0 | 0.00000821 | PASS | PASS | SYNTHETIC_FUNCTION_REGRESSION | Phase3A3 frozen-U failure receipt (reused) | Phase3A4 independent Git integration branch | 353dec3c83b859eab39bcf2dff79fe30d88a2ec0 | 50a73d8f531132c5459174a55cac412d5f684462
E1 | all_service_dh0.3_reduction0 | KH | services | direct_electricity | 3110000 | 3110000 | 3110000 | MWh | 0 | 0 | 0.00000411 | PASS | PASS | SYNTHETIC_FUNCTION_REGRESSION | Phase3A3 frozen-U failure receipt (reused) | Phase3A4 independent Git integration branch | 353dec3c83b859eab39bcf2dff79fe30d88a2ec0 | 50a73d8f531132c5459174a55cac412d5f684462
E1 | all_service_dh0.3_reduction0 | KH | residential | fixed_oil | 1000000 | 1000000 | 1000000 | MWh | 0 | 0 | 0.000002 | PASS | PASS | SYNTHETIC_FUNCTION_REGRESSION | Phase3A3 frozen-U failure receipt (reused) | Phase3A4 independent Git integration branch | 353dec3c83b859eab39bcf2dff79fe30d88a2ec0 | 50a73d8f531132c5459174a55cac412d5f684462
E1 | all_service_dh0.3_reduction0 | KH | residential | fixed_gas | 500000 | 500000 | 500000 | MWh | 0 | 0 | 0.0000015 | PASS | PASS | SYNTHETIC_FUNCTION_REGRESSION | Phase3A3 frozen-U failure receipt (reused) | Phase3A4 independent Git integration branch | 353dec3c83b859eab39bcf2dff79fe30d88a2ec0 | 50a73d8f531132c5459174a55cac412d5f684462
E1 | all_service_dh0.3_reduction0 | KH | residential | fixed_biomass | 250000 | 250000 | 250000 | MWh | 0 | 0 | 0.0000012499999999999999 | PASS | PASS | SYNTHETIC_FUNCTION_REGRESSION | Phase3A3 frozen-U failure receipt (reused) | Phase3A4 independent Git integration branch | 353dec3c83b859eab39bcf2dff79fe30d88a2ec0 | 50a73d8f531132c5459174a55cac412d5f684462
E1 | all_service_dh0.3_reduction0 | ID | residential | heat_service_without_DH_loss | 3988313.974339994 | 6619999.999999999 | 6619999.999999998 | MWh | 9.313225746154785e-10 | 1.4068316837091821e-16 | 0.000007619999999999999 | FAIL | PASS | SYNTHETIC_FUNCTION_REGRESSION | Phase3A3 frozen-U failure receipt (reused) | Phase3A4 independent Git integration branch | 353dec3c83b859eab39bcf2dff79fe30d88a2ec0 | 50a73d8f531132c5459174a55cac412d5f684462
E1 | all_service_dh0.3_reduction0 | ID | residential | district_heat_loss | 0 | 189166.49999999997 | 189166.4999999999 | MWh | 5.820766091346741e-11 | 3.0770596756543795e-16 | 0.0000011891665 | FAIL | PASS | SYNTHETIC_FUNCTION_REGRESSION | Phase3A3 frozen-U failure receipt (reused) | Phase3A4 independent Git integration branch | 353dec3c83b859eab39bcf2dff79fe30d88a2ec0 | 50a73d8f531132c5459174a55cac412d5f684462 | Upstream additive markup: supply=service*(1+0.15), not 1/(1-0.15)
E1 | all_service_dh0.3_reduction0 | ID | services | heat_service_without_DH_loss | 1540108.4854905712 | 4380000 | 4380000 | MWh | 0 | 0 | 0.000005379999999999999 | FAIL | PASS | SYNTHETIC_FUNCTION_REGRESSION | Phase3A3 frozen-U failure receipt (reused) | Phase3A4 independent Git integration branch | 353dec3c83b859eab39bcf2dff79fe30d88a2ec0 | 50a73d8f531132c5459174a55cac412d5f684462
E1 | all_service_dh0.3_reduction0 | ID | services | district_heat_loss | 0 | 125158.5 | 125158.49999999997 | MWh | 2.9103830456733704e-11 | 2.325357882743378e-16 | 0.0000011251585 | FAIL | PASS | SYNTHETIC_FUNCTION_REGRESSION | Phase3A3 frozen-U failure receipt (reused) | Phase3A4 independent Git integration branch | 353dec3c83b859eab39bcf2dff79fe30d88a2ec0 | 50a73d8f531132c5459174a55cac412d5f684462 | Upstream additive markup: supply=service*(1+0.15), not 1/(1-0.15)
E1 | all_service_dh0.3_reduction0 | ID | services | profile_unchanged | 106562.1643381255 | 0 | 0 | MW | 0 | 0 | 0 | FAIL | PASS | SYNTHETIC_FUNCTION_REGRESSION | Phase3A3 frozen-U failure receipt (reused) | Phase3A4 independent Git integration branch | 353dec3c83b859eab39bcf2dff79fe30d88a2ec0 | 50a73d8f531132c5459174a55cac412d5f684462
E1 | all_service_dh0.3_reduction0 | ID | residential | direct_electricity | 7420000 | 7420000 | 7420000 | MWh | 0 | 0 | 0.00000842 | PASS | PASS | SYNTHETIC_FUNCTION_REGRESSION | Phase3A3 frozen-U failure receipt (reused) | Phase3A4 independent Git integration branch | 353dec3c83b859eab39bcf2dff79fe30d88a2ec0 | 50a73d8f531132c5459174a55cac412d5f684462
E1 | all_service_dh0.3_reduction0 | ID | services | direct_electricity | 3220000 | 3220000 | 3220000 | MWh | 0 | 0 | 0.00000422 | PASS | PASS | SYNTHETIC_FUNCTION_REGRESSION | Phase3A3 frozen-U failure receipt (reused) | Phase3A4 independent Git integration branch | 353dec3c83b859eab39bcf2dff79fe30d88a2ec0 | 50a73d8f531132c5459174a55cac412d5f684462
E1 | all_service_dh0.3_reduction0 | ID | residential | fixed_oil | 1000000 | 1000000 | 1000000 | MWh | 0 | 0 | 0.000002 | PASS | PASS | SYNTHETIC_FUNCTION_REGRESSION | Phase3A3 frozen-U failure receipt (reused) | Phase3A4 independent Git integration branch | 353dec3c83b859eab39bcf2dff79fe30d88a2ec0 | 50a73d8f531132c5459174a55cac412d5f684462
E1 | all_service_dh0.3_reduction0 | ID | residential | fixed_gas | 500000 | 500000 | 500000 | MWh | 0 | 0 | 0.0000015 | PASS | PASS | SYNTHETIC_FUNCTION_REGRESSION | Phase3A3 frozen-U failure receipt (reused) | Phase3A4 independent Git integration branch | 353dec3c83b859eab39bcf2dff79fe30d88a2ec0 | 50a73d8f531132c5459174a55cac412d5f684462
E1 | all_service_dh0.3_reduction0 | ID | residential | fixed_biomass | 250000 | 250000 | 250000 | MWh | 0 | 0 | 0.0000012499999999999999 | PASS | PASS | SYNTHETIC_FUNCTION_REGRESSION | Phase3A3 frozen-U failure receipt (reused) | Phase3A4 independent Git integration branch | 353dec3c83b859eab39bcf2dff79fe30d88a2ec0 | 50a73d8f531132c5459174a55cac412d5f684462
E1 | all_service_dh0.3_reduction0 | LA | residential | heat_service_without_DH_loss | 4103274.7785807475 | 6929999.999999999 | 6930000 | MWh | 9.313225746154785e-10 | 1.3438998190699546e-16 | 0.000007929999999999999 | FAIL | PASS | SYNTHETIC_FUNCTION_REGRESSION | Phase3A3 frozen-U failure receipt (reused) | Phase3A4 independent Git integration branch | 353dec3c83b859eab39bcf2dff79fe30d88a2ec0 | 50a73d8f531132c5459174a55cac412d5f684462
E1 | all_service_dh0.3_reduction0 | LA | residential | district_heat_loss | 0 | 198024.74999999997 | 198024.7499999999 | MWh | 5.820766091346741e-11 | 2.9394134275370837e-16 | 0.00000119802475 | FAIL | PASS | SYNTHETIC_FUNCTION_REGRESSION | Phase3A3 frozen-U failure receipt (reused) | Phase3A4 independent Git integration branch | 353dec3c83b859eab39bcf2dff79fe30d88a2ec0 | 50a73d8f531132c5459174a55cac412d5f684462 | Upstream additive markup: supply=service*(1+0.15), not 1/(1-0.15)
E1 | all_service_dh0.3_reduction0 | LA | services | heat_service_without_DH_loss | 1686661.9198746425 | 4570000 | 4570000 | MWh | 0 | 0 | 0.00000557 | FAIL | PASS | SYNTHETIC_FUNCTION_REGRESSION | Phase3A3 frozen-U failure receipt (reused) | Phase3A4 independent Git integration branch | 353dec3c83b859eab39bcf2dff79fe30d88a2ec0 | 50a73d8f531132c5459174a55cac412d5f684462
E1 | all_service_dh0.3_reduction0 | LA | services | district_heat_loss | 0 | 130587.75 | 130587.74999999996 | MWh | 4.3655745685100555e-11 | 3.3430199758477007e-16 | 0.00000113058775 | FAIL | PASS | SYNTHETIC_FUNCTION_REGRESSION | Phase3A3 frozen-U failure receipt (reused) | Phase3A4 independent Git integration branch | 353dec3c83b859eab39bcf2dff79fe30d88a2ec0 | 50a73d8f531132c5459174a55cac412d5f684462 | Upstream additive markup: supply=service*(1+0.15), not 1/(1-0.15)
E1 | all_service_dh0.3_reduction0 | LA | services | profile_unchanged | 120539.95917128274 | 0 | 0 | MW | 0 | 0 | 0 | FAIL | PASS | SYNTHETIC_FUNCTION_REGRESSION | Phase3A3 frozen-U failure receipt (reused) | Phase3A4 independent Git integration branch | 353dec3c83b859eab39bcf2dff79fe30d88a2ec0 | 50a73d8f531132c5459174a55cac412d5f684462
E1 | all_service_dh0.3_reduction0 | LA | residential | direct_electricity | 7630000 | 7630000 | 7630000 | MWh | 0 | 0 | 0.00000863 | PASS | PASS | SYNTHETIC_FUNCTION_REGRESSION | Phase3A3 frozen-U failure receipt (reused) | Phase3A4 independent Git integration branch | 353dec3c83b859eab39bcf2dff79fe30d88a2ec0 | 50a73d8f531132c5459174a55cac412d5f684462
E1 | all_service_dh0.3_reduction0 | LA | services | direct_electricity | 3330000 | 3330000 | 3330000 | MWh | 0 | 0 | 0.00000433 | PASS | PASS | SYNTHETIC_FUNCTION_REGRESSION | Phase3A3 frozen-U failure receipt (reused) | Phase3A4 independent Git integration branch | 353dec3c83b859eab39bcf2dff79fe30d88a2ec0 | 50a73d8f531132c5459174a55cac412d5f684462
E1 | all_service_dh0.3_reduction0 | LA | residential | fixed_oil | 1000000 | 1000000 | 1000000 | MWh | 0 | 0 | 0.000002 | PASS | PASS | SYNTHETIC_FUNCTION_REGRESSION | Phase3A3 frozen-U failure receipt (reused) | Phase3A4 independent Git integration branch | 353dec3c83b859eab39bcf2dff79fe30d88a2ec0 | 50a73d8f531132c5459174a55cac412d5f684462
E1 | all_service_dh0.3_reduction0 | LA | residential | fixed_gas | 500000 | 500000 | 500000 | MWh | 0 | 0 | 0.0000015 | PASS | PASS | SYNTHETIC_FUNCTION_REGRESSION | Phase3A3 frozen-U failure receipt (reused) | Phase3A4 independent Git integration branch | 353dec3c83b859eab39bcf2dff79fe30d88a2ec0 | 50a73d8f531132c5459174a55cac412d5f684462
E1 | all_service_dh0.3_reduction0 | LA | residential | fixed_biomass | 250000 | 250000 | 250000 | MWh | 0 | 0 | 0.0000012499999999999999 | PASS | PASS | SYNTHETIC_FUNCTION_REGRESSION | Phase3A3 frozen-U failure receipt (reused) | Phase3A4 independent Git integration branch | 353dec3c83b859eab39bcf2dff79fe30d88a2ec0 | 50a73d8f531132c5459174a55cac412d5f684462
E1 | all_service_dh0.3_reduction0 | MY | residential | heat_service_without_DH_loss | 4235445.0819740575 | 7240000 | 7240000 | MWh | 0 | 0 | 0.00000824 | FAIL | PASS | SYNTHETIC_FUNCTION_REGRESSION | Phase3A3 frozen-U failure receipt (reused) | Phase3A4 independent Git integration branch | 353dec3c83b859eab39bcf2dff79fe30d88a2ec0 | 50a73d8f531132c5459174a55cac412d5f684462
E1 | all_service_dh0.3_reduction0 | MY | residential | district_heat_loss | 0 | 206883 | 206882.99999999994 | MWh | 5.820766091346741e-11 | 2.813554565308286e-16 | 0.000001206883 | FAIL | PASS | SYNTHETIC_FUNCTION_REGRESSION | Phase3A3 frozen-U failure receipt (reused) | Phase3A4 independent Git integration branch | 353dec3c83b859eab39bcf2dff79fe30d88a2ec0 | 50a73d8f531132c5459174a55cac412d5f684462 | Upstream additive markup: supply=service*(1+0.15), not 1/(1-0.15)
E1 | all_service_dh0.3_reduction0 | MY | services | heat_service_without_DH_loss | 1792225.4808421847 | 4760000 | 4760000 | MWh | 0 | 0 | 0.00000576 | FAIL | PASS | SYNTHETIC_FUNCTION_REGRESSION | Phase3A3 frozen-U failure receipt (reused) | Phase3A4 independent Git integration branch | 353dec3c83b859eab39bcf2dff79fe30d88a2ec0 | 50a73d8f531132c5459174a55cac412d5f684462
E1 | all_service_dh0.3_reduction0 | MY | services | district_heat_loss | 0 | 136017 | 136016.99999999994 | MWh | 5.820766091346741e-11 | 4.2794401371495774e-16 | 0.000001136017 | FAIL | PASS | SYNTHETIC_FUNCTION_REGRESSION | Phase3A3 frozen-U failure receipt (reused) | Phase3A4 independent Git integration branch | 353dec3c83b859eab39bcf2dff79fe30d88a2ec0 | 50a73d8f531132c5459174a55cac412d5f684462 | Upstream additive markup: supply=service*(1+0.15), not 1/(1-0.15)
E1 | all_service_dh0.3_reduction0 | MY | services | profile_unchanged | 131407.03218948474 | 0 | 0 | MW | 0 | 0 | 0 | FAIL | PASS | SYNTHETIC_FUNCTION_REGRESSION | Phase3A3 frozen-U failure receipt (reused) | Phase3A4 independent Git integration branch | 353dec3c83b859eab39bcf2dff79fe30d88a2ec0 | 50a73d8f531132c5459174a55cac412d5f684462
E1 | all_service_dh0.3_reduction0 | MY | residential | direct_electricity | 7840000 | 7840000 | 7840000 | MWh | 0 | 0 | 0.00000884 | PASS | PASS | SYNTHETIC_FUNCTION_REGRESSION | Phase3A3 frozen-U failure receipt (reused) | Phase3A4 independent Git integration branch | 353dec3c83b859eab39bcf2dff79fe30d88a2ec0 | 50a73d8f531132c5459174a55cac412d5f684462
E1 | all_service_dh0.3_reduction0 | MY | services | direct_electricity | 3440000 | 3440000 | 3440000 | MWh | 0 | 0 | 0.00000444 | PASS | PASS | SYNTHETIC_FUNCTION_REGRESSION | Phase3A3 frozen-U failure receipt (reused) | Phase3A4 independent Git integration branch | 353dec3c83b859eab39bcf2dff79fe30d88a2ec0 | 50a73d8f531132c5459174a55cac412d5f684462
E1 | all_service_dh0.3_reduction0 | MY | residential | fixed_oil | 1000000 | 1000000 | 1000000 | MWh | 0 | 0 | 0.000002 | PASS | PASS | SYNTHETIC_FUNCTION_REGRESSION | Phase3A3 frozen-U failure receipt (reused) | Phase3A4 independent Git integration branch | 353dec3c83b859eab39bcf2dff79fe30d88a2ec0 | 50a73d8f531132c5459174a55cac412d5f684462
E1 | all_service_dh0.3_reduction0 | MY | residential | fixed_gas | 500000 | 500000 | 500000 | MWh | 0 | 0 | 0.0000015 | PASS | PASS | SYNTHETIC_FUNCTION_REGRESSION | Phase3A3 frozen-U failure receipt (reused) | Phase3A4 independent Git integration branch | 353dec3c83b859eab39bcf2dff79fe30d88a2ec0 | 50a73d8f531132c5459174a55cac412d5f684462
E1 | all_service_dh0.3_reduction0 | MY | residential | fixed_biomass | 250000 | 250000 | 250000 | MWh | 0 | 0 | 0.0000012499999999999999 | PASS | PASS | SYNTHETIC_FUNCTION_REGRESSION | Phase3A3 frozen-U failure receipt (reused) | Phase3A4 independent Git integration branch | 353dec3c83b859eab39bcf2dff79fe30d88a2ec0 | 50a73d8f531132c5459174a55cac412d5f684462
E1 | all_service_dh0.3_reduction0 | MM | residential | heat_service_without_DH_loss | 4364252.98206863 | 7549999.999999998 | 7549999.999999999 | MWh | 9.313225746154785e-10 | 1.2335398339277863e-16 | 0.000008549999999999998 | FAIL | PASS | SYNTHETIC_FUNCTION_REGRESSION | Phase3A3 frozen-U failure receipt (reused) | Phase3A4 independent Git integration branch | 353dec3c83b859eab39bcf2dff79fe30d88a2ec0 | 50a73d8f531132c5459174a55cac412d5f684462
E1 | all_service_dh0.3_reduction0 | MM | residential | district_heat_loss | 0 | 215741.24999999997 | 215741.24999999994 | MWh | 2.9103830456733704e-11 | 1.3490155664127146e-16 | 0.00000121574125 | FAIL | PASS | SYNTHETIC_FUNCTION_REGRESSION | Phase3A3 frozen-U failure receipt (reused) | Phase3A4 independent Git integration branch | 353dec3c83b859eab39bcf2dff79fe30d88a2ec0 | 50a73d8f531132c5459174a55cac412d5f684462 | Upstream additive markup: supply=service*(1+0.15), not 1/(1-0.15)
E1 | all_service_dh0.3_reduction0 | MM | services | heat_service_without_DH_loss | 1921983.6628008229 | 4950000 | 4950000 | MWh | 0 | 0 | 0.00000595 | FAIL | PASS | SYNTHETIC_FUNCTION_REGRESSION | Phase3A3 frozen-U failure receipt (reused) | Phase3A4 independent Git integration branch | 353dec3c83b859eab39bcf2dff79fe30d88a2ec0 | 50a73d8f531132c5459174a55cac412d5f684462
E1 | all_service_dh0.3_reduction0 | MM | services | district_heat_loss | 0 | 141446.25 | 141446.25 | MWh | 0 | 0 | 0.00000114144625 | FAIL | PASS | SYNTHETIC_FUNCTION_REGRESSION | Phase3A3 frozen-U failure receipt (reused) | Phase3A4 independent Git integration branch | 353dec3c83b859eab39bcf2dff79fe30d88a2ec0 | 50a73d8f531132c5459174a55cac412d5f684462 | Upstream additive markup: supply=service*(1+0.15), not 1/(1-0.15)
E1 | all_service_dh0.3_reduction0 | MM | services | profile_unchanged | 104473.74762581344 | 0 | 0 | MW | 0 | 0 | 0 | FAIL | PASS | SYNTHETIC_FUNCTION_REGRESSION | Phase3A3 frozen-U failure receipt (reused) | Phase3A4 independent Git integration branch | 353dec3c83b859eab39bcf2dff79fe30d88a2ec0 | 50a73d8f531132c5459174a55cac412d5f684462
E1 | all_service_dh0.3_reduction0 | MM | residential | direct_electricity | 8050000 | 8050000.000000001 | 8050000 | MWh | 9.313225746154785e-10 | 1.1569224529384825e-16 | 0.000009050000000000001 | PASS | PASS | SYNTHETIC_FUNCTION_REGRESSION | Phase3A3 frozen-U failure receipt (reused) | Phase3A4 independent Git integration branch | 353dec3c83b859eab39bcf2dff79fe30d88a2ec0 | 50a73d8f531132c5459174a55cac412d5f684462
E1 | all_service_dh0.3_reduction0 | MM | services | direct_electricity | 3550000 | 3550000 | 3550000 | MWh | 0 | 0 | 0.00000455 | PASS | PASS | SYNTHETIC_FUNCTION_REGRESSION | Phase3A3 frozen-U failure receipt (reused) | Phase3A4 independent Git integration branch | 353dec3c83b859eab39bcf2dff79fe30d88a2ec0 | 50a73d8f531132c5459174a55cac412d5f684462
E1 | all_service_dh0.3_reduction0 | MM | residential | fixed_oil | 1000000 | 1000000 | 1000000 | MWh | 0 | 0 | 0.000002 | PASS | PASS | SYNTHETIC_FUNCTION_REGRESSION | Phase3A3 frozen-U failure receipt (reused) | Phase3A4 independent Git integration branch | 353dec3c83b859eab39bcf2dff79fe30d88a2ec0 | 50a73d8f531132c5459174a55cac412d5f684462
E1 | all_service_dh0.3_reduction0 | MM | residential | fixed_gas | 500000 | 500000 | 500000 | MWh | 0 | 0 | 0.0000015 | PASS | PASS | SYNTHETIC_FUNCTION_REGRESSION | Phase3A3 frozen-U failure receipt (reused) | Phase3A4 independent Git integration branch | 353dec3c83b859eab39bcf2dff79fe30d88a2ec0 | 50a73d8f531132c5459174a55cac412d5f684462
E1 | all_service_dh0.3_reduction0 | MM | residential | fixed_biomass | 250000 | 250000 | 250000 | MWh | 0 | 0 | 0.0000012499999999999999 | PASS | PASS | SYNTHETIC_FUNCTION_REGRESSION | Phase3A3 frozen-U failure receipt (reused) | Phase3A4 independent Git integration branch | 353dec3c83b859eab39bcf2dff79fe30d88a2ec0 | 50a73d8f531132c5459174a55cac412d5f684462
E1 | all_service_dh0.3_reduction0 | PH | residential | heat_service_without_DH_loss | 4667669.270481575 | 7859999.999999998 | 7859999.999999998 | MWh | 0 | 0 | 0.000008859999999999998 | FAIL | PASS | SYNTHETIC_FUNCTION_REGRESSION | Phase3A3 frozen-U failure receipt (reused) | Phase3A4 independent Git integration branch | 353dec3c83b859eab39bcf2dff79fe30d88a2ec0 | 50a73d8f531132c5459174a55cac412d5f684462
E1 | all_service_dh0.3_reduction0 | PH | residential | district_heat_loss | 0 | 224599.49999999997 | 224599.49999999994 | MWh | 2.9103830456733704e-11 | 1.2958101178646305e-16 | 0.0000012245995 | FAIL | PASS | SYNTHETIC_FUNCTION_REGRESSION | Phase3A3 frozen-U failure receipt (reused) | Phase3A4 independent Git integration branch | 353dec3c83b859eab39bcf2dff79fe30d88a2ec0 | 50a73d8f531132c5459174a55cac412d5f684462 | Upstream additive markup: supply=service*(1+0.15), not 1/(1-0.15)
E1 | all_service_dh0.3_reduction0 | PH | services | heat_service_without_DH_loss | 1882605.53612423 | 5140000 | 5140000 | MWh | 0 | 0 | 0.00000614 | FAIL | PASS | SYNTHETIC_FUNCTION_REGRESSION | Phase3A3 frozen-U failure receipt (reused) | Phase3A4 independent Git integration branch | 353dec3c83b859eab39bcf2dff79fe30d88a2ec0 | 50a73d8f531132c5459174a55cac412d5f684462
E1 | all_service_dh0.3_reduction0 | PH | services | district_heat_loss | 0 | 146875.5 | 146875.49999999997 | MWh | 2.9103830456733704e-11 | 1.9815306471626447e-16 | 0.0000011468755 | FAIL | PASS | SYNTHETIC_FUNCTION_REGRESSION | Phase3A3 frozen-U failure receipt (reused) | Phase3A4 independent Git integration branch | 353dec3c83b859eab39bcf2dff79fe30d88a2ec0 | 50a73d8f531132c5459174a55cac412d5f684462 | Upstream additive markup: supply=service*(1+0.15), not 1/(1-0.15)
E1 | all_service_dh0.3_reduction0 | PH | services | profile_unchanged | 125541.92908769415 | 0 | 0 | MW | 0 | 0 | 0 | FAIL | PASS | SYNTHETIC_FUNCTION_REGRESSION | Phase3A3 frozen-U failure receipt (reused) | Phase3A4 independent Git integration branch | 353dec3c83b859eab39bcf2dff79fe30d88a2ec0 | 50a73d8f531132c5459174a55cac412d5f684462
E1 | all_service_dh0.3_reduction0 | PH | residential | direct_electricity | 8260000 | 8260000 | 8260000 | MWh | 0 | 0 | 0.000009260000000000001 | PASS | PASS | SYNTHETIC_FUNCTION_REGRESSION | Phase3A3 frozen-U failure receipt (reused) | Phase3A4 independent Git integration branch | 353dec3c83b859eab39bcf2dff79fe30d88a2ec0 | 50a73d8f531132c5459174a55cac412d5f684462
E1 | all_service_dh0.3_reduction0 | PH | services | direct_electricity | 3660000 | 3660000 | 3660000 | MWh | 0 | 0 | 0.00000466 | PASS | PASS | SYNTHETIC_FUNCTION_REGRESSION | Phase3A3 frozen-U failure receipt (reused) | Phase3A4 independent Git integration branch | 353dec3c83b859eab39bcf2dff79fe30d88a2ec0 | 50a73d8f531132c5459174a55cac412d5f684462
E1 | all_service_dh0.3_reduction0 | PH | residential | fixed_oil | 1000000 | 1000000 | 1000000 | MWh | 0 | 0 | 0.000002 | PASS | PASS | SYNTHETIC_FUNCTION_REGRESSION | Phase3A3 frozen-U failure receipt (reused) | Phase3A4 independent Git integration branch | 353dec3c83b859eab39bcf2dff79fe30d88a2ec0 | 50a73d8f531132c5459174a55cac412d5f684462
E1 | all_service_dh0.3_reduction0 | PH | residential | fixed_gas | 500000 | 500000 | 500000 | MWh | 0 | 0 | 0.0000015 | PASS | PASS | SYNTHETIC_FUNCTION_REGRESSION | Phase3A3 frozen-U failure receipt (reused) | Phase3A4 independent Git integration branch | 353dec3c83b859eab39bcf2dff79fe30d88a2ec0 | 50a73d8f531132c5459174a55cac412d5f684462
E1 | all_service_dh0.3_reduction0 | PH | residential | fixed_biomass | 250000 | 250000 | 250000 | MWh | 0 | 0 | 0.0000012499999999999999 | PASS | PASS | SYNTHETIC_FUNCTION_REGRESSION | Phase3A3 frozen-U failure receipt (reused) | Phase3A4 independent Git integration branch | 353dec3c83b859eab39bcf2dff79fe30d88a2ec0 | 50a73d8f531132c5459174a55cac412d5f684462
E1 | all_service_dh0.3_reduction0 | SG | residential | heat_service_without_DH_loss | 4839685.025294841 | 8169999.999999999 | 8170000 | MWh | 9.313225746154785e-10 | 1.1399297118916508e-16 | 0.00000917 | FAIL | PASS | SYNTHETIC_FUNCTION_REGRESSION | Phase3A3 frozen-U failure receipt (reused) | Phase3A4 independent Git integration branch | 353dec3c83b859eab39bcf2dff79fe30d88a2ec0 | 50a73d8f531132c5459174a55cac412d5f684462
E1 | all_service_dh0.3_reduction0 | SG | residential | district_heat_loss | 0 | 233457.74999999997 | 233457.7499999999 | MWh | 5.820766091346741e-11 | 2.493284584189962e-16 | 0.00000123345775 | FAIL | PASS | SYNTHETIC_FUNCTION_REGRESSION | Phase3A3 frozen-U failure receipt (reused) | Phase3A4 independent Git integration branch | 353dec3c83b859eab39bcf2dff79fe30d88a2ec0 | 50a73d8f531132c5459174a55cac412d5f684462 | Upstream additive markup: supply=service*(1+0.15), not 1/(1-0.15)
E1 | all_service_dh0.3_reduction0 | SG | services | heat_service_without_DH_loss | 1978062.303762312 | 5330000 | 5330000 | MWh | 0 | 0 | 0.0000063299999999999995 | FAIL | PASS | SYNTHETIC_FUNCTION_REGRESSION | Phase3A3 frozen-U failure receipt (reused) | Phase3A4 independent Git integration branch | 353dec3c83b859eab39bcf2dff79fe30d88a2ec0 | 50a73d8f531132c5459174a55cac412d5f684462
E1 | all_service_dh0.3_reduction0 | SG | services | district_heat_loss | 0 | 152304.75 | 152304.74999999994 | MWh | 5.820766091346741e-11 | 3.8217889404938063e-16 | 0.00000115230475 | FAIL | PASS | SYNTHETIC_FUNCTION_REGRESSION | Phase3A3 frozen-U failure receipt (reused) | Phase3A4 independent Git integration branch | 353dec3c83b859eab39bcf2dff79fe30d88a2ec0 | 50a73d8f531132c5459174a55cac412d5f684462 | Upstream additive markup: supply=service*(1+0.15), not 1/(1-0.15)
E1 | all_service_dh0.3_reduction0 | SG | services | profile_unchanged | 138067.54834536213 | 0 | 0 | MW | 0 | 0 | 0 | FAIL | PASS | SYNTHETIC_FUNCTION_REGRESSION | Phase3A3 frozen-U failure receipt (reused) | Phase3A4 independent Git integration branch | 353dec3c83b859eab39bcf2dff79fe30d88a2ec0 | 50a73d8f531132c5459174a55cac412d5f684462
E1 | all_service_dh0.3_reduction0 | SG | residential | direct_electricity | 8470000 | 8470000 | 8470000 | MWh | 0 | 0 | 0.00000947 | PASS | PASS | SYNTHETIC_FUNCTION_REGRESSION | Phase3A3 frozen-U failure receipt (reused) | Phase3A4 independent Git integration branch | 353dec3c83b859eab39bcf2dff79fe30d88a2ec0 | 50a73d8f531132c5459174a55cac412d5f684462
E1 | all_service_dh0.3_reduction0 | SG | services | direct_electricity | 3770000 | 3770000 | 3770000 | MWh | 0 | 0 | 0.00000477 | PASS | PASS | SYNTHETIC_FUNCTION_REGRESSION | Phase3A3 frozen-U failure receipt (reused) | Phase3A4 independent Git integration branch | 353dec3c83b859eab39bcf2dff79fe30d88a2ec0 | 50a73d8f531132c5459174a55cac412d5f684462
E1 | all_service_dh0.3_reduction0 | SG | residential | fixed_oil | 1000000 | 1000000 | 1000000 | MWh | 0 | 0 | 0.000002 | PASS | PASS | SYNTHETIC_FUNCTION_REGRESSION | Phase3A3 frozen-U failure receipt (reused) | Phase3A4 independent Git integration branch | 353dec3c83b859eab39bcf2dff79fe30d88a2ec0 | 50a73d8f531132c5459174a55cac412d5f684462
E1 | all_service_dh0.3_reduction0 | SG | residential | fixed_gas | 500000 | 500000 | 500000 | MWh | 0 | 0 | 0.0000015 | PASS | PASS | SYNTHETIC_FUNCTION_REGRESSION | Phase3A3 frozen-U failure receipt (reused) | Phase3A4 independent Git integration branch | 353dec3c83b859eab39bcf2dff79fe30d88a2ec0 | 50a73d8f531132c5459174a55cac412d5f684462
E1 | all_service_dh0.3_reduction0 | SG | residential | fixed_biomass | 250000 | 250000 | 250000 | MWh | 0 | 0 | 0.0000012499999999999999 | PASS | PASS | SYNTHETIC_FUNCTION_REGRESSION | Phase3A3 frozen-U failure receipt (reused) | Phase3A4 independent Git integration branch | 353dec3c83b859eab39bcf2dff79fe30d88a2ec0 | 50a73d8f531132c5459174a55cac412d5f684462
E1 | all_service_dh0.3_reduction0 | TH | residential | heat_service_without_DH_loss | 5133237.708190912 | 8480000 | 8480000 | MWh | 0 | 0 | 0.00000948 | FAIL | PASS | SYNTHETIC_FUNCTION_REGRESSION | Phase3A3 frozen-U failure receipt (reused) | Phase3A4 independent Git integration branch | 353dec3c83b859eab39bcf2dff79fe30d88a2ec0 | 50a73d8f531132c5459174a55cac412d5f684462
E1 | all_service_dh0.3_reduction0 | TH | residential | district_heat_loss | 0 | 242316 | 242315.99999999994 | MWh | 5.820766091346741e-11 | 2.402138567550942e-16 | 0.000001242316 | FAIL | PASS | SYNTHETIC_FUNCTION_REGRESSION | Phase3A3 frozen-U failure receipt (reused) | Phase3A4 independent Git integration branch | 353dec3c83b859eab39bcf2dff79fe30d88a2ec0 | 50a73d8f531132c5459174a55cac412d5f684462 | Upstream additive markup: supply=service*(1+0.15), not 1/(1-0.15)
E1 | all_service_dh0.3_reduction0 | TH | services | heat_service_without_DH_loss | 1950205.845194219 | 5520000 | 5519999.999999999 | MWh | 9.313225746154785e-10 | 1.6871785772019538e-16 | 0.000006519999999999999 | FAIL | PASS | SYNTHETIC_FUNCTION_REGRESSION | Phase3A3 frozen-U failure receipt (reused) | Phase3A4 independent Git integration branch | 353dec3c83b859eab39bcf2dff79fe30d88a2ec0 | 50a73d8f531132c5459174a55cac412d5f684462
E1 | all_service_dh0.3_reduction0 | TH | services | district_heat_loss | 0 | 157733.99999999997 | 157733.99999999994 | MWh | 2.9103830456733704e-11 | 1.84512092869855e-16 | 0.000001157734 | FAIL | PASS | SYNTHETIC_FUNCTION_REGRESSION | Phase3A3 frozen-U failure receipt (reused) | Phase3A4 independent Git integration branch | 353dec3c83b859eab39bcf2dff79fe30d88a2ec0 | 50a73d8f531132c5459174a55cac412d5f684462 | Upstream additive markup: supply=service*(1+0.15), not 1/(1-0.15)
E1 | all_service_dh0.3_reduction0 | TH | services | profile_unchanged | 133999.0334085422 | 0 | 0 | MW | 0 | 0 | 0 | FAIL | PASS | SYNTHETIC_FUNCTION_REGRESSION | Phase3A3 frozen-U failure receipt (reused) | Phase3A4 independent Git integration branch | 353dec3c83b859eab39bcf2dff79fe30d88a2ec0 | 50a73d8f531132c5459174a55cac412d5f684462
E1 | all_service_dh0.3_reduction0 | TH | residential | direct_electricity | 8680000 | 8680000 | 8680000 | MWh | 0 | 0 | 0.00000968 | PASS | PASS | SYNTHETIC_FUNCTION_REGRESSION | Phase3A3 frozen-U failure receipt (reused) | Phase3A4 independent Git integration branch | 353dec3c83b859eab39bcf2dff79fe30d88a2ec0 | 50a73d8f531132c5459174a55cac412d5f684462
E1 | all_service_dh0.3_reduction0 | TH | services | direct_electricity | 3880000.0000000005 | 3880000 | 3880000.0000000005 | MWh | 4.656612873077393e-10 | 1.2001579569787095e-16 | 0.00000488 | PASS | PASS | SYNTHETIC_FUNCTION_REGRESSION | Phase3A3 frozen-U failure receipt (reused) | Phase3A4 independent Git integration branch | 353dec3c83b859eab39bcf2dff79fe30d88a2ec0 | 50a73d8f531132c5459174a55cac412d5f684462
E1 | all_service_dh0.3_reduction0 | TH | residential | fixed_oil | 1000000 | 1000000 | 1000000 | MWh | 0 | 0 | 0.000002 | PASS | PASS | SYNTHETIC_FUNCTION_REGRESSION | Phase3A3 frozen-U failure receipt (reused) | Phase3A4 independent Git integration branch | 353dec3c83b859eab39bcf2dff79fe30d88a2ec0 | 50a73d8f531132c5459174a55cac412d5f684462
E1 | all_service_dh0.3_reduction0 | TH | residential | fixed_gas | 500000 | 500000 | 500000 | MWh | 0 | 0 | 0.0000015 | PASS | PASS | SYNTHETIC_FUNCTION_REGRESSION | Phase3A3 frozen-U failure receipt (reused) | Phase3A4 independent Git integration branch | 353dec3c83b859eab39bcf2dff79fe30d88a2ec0 | 50a73d8f531132c5459174a55cac412d5f684462
E1 | all_service_dh0.3_reduction0 | TH | residential | fixed_biomass | 250000 | 250000 | 250000 | MWh | 0 | 0 | 0.0000012499999999999999 | PASS | PASS | SYNTHETIC_FUNCTION_REGRESSION | Phase3A3 frozen-U failure receipt (reused) | Phase3A4 independent Git integration branch | 353dec3c83b859eab39bcf2dff79fe30d88a2ec0 | 50a73d8f531132c5459174a55cac412d5f684462
E1 | all_service_dh0.3_reduction0 | TL | residential | heat_service_without_DH_loss | 5228807.189441808 | 8789999.999999998 | 8789999.999999998 | MWh | 0 | 0 | 0.000009789999999999998 | FAIL | PASS | SYNTHETIC_FUNCTION_REGRESSION | Phase3A3 frozen-U failure receipt (reused) | Phase3A4 independent Git integration branch | 353dec3c83b859eab39bcf2dff79fe30d88a2ec0 | 50a73d8f531132c5459174a55cac412d5f684462
E1 | all_service_dh0.3_reduction0 | TL | residential | district_heat_loss | 0 | 251174.24999999997 | 251174.24999999988 | MWh | 8.731149137020111e-11 | 3.476132261575425e-16 | 0.00000125117425 | FAIL | PASS | SYNTHETIC_FUNCTION_REGRESSION | Phase3A3 frozen-U failure receipt (reused) | Phase3A4 independent Git integration branch | 353dec3c83b859eab39bcf2dff79fe30d88a2ec0 | 50a73d8f531132c5459174a55cac412d5f684462 | Upstream additive markup: supply=service*(1+0.15), not 1/(1-0.15)
E1 | all_service_dh0.3_reduction0 | TL | services | heat_service_without_DH_loss | 2117211.9398131324 | 5710000 | 5709999.999999998 | MWh | 1.862645149230957e-9 | 3.2620755678300474e-16 | 0.000006709999999999999 | FAIL | PASS | SYNTHETIC_FUNCTION_REGRESSION | Phase3A3 frozen-U failure receipt (reused) | Phase3A4 independent Git integration branch | 353dec3c83b859eab39bcf2dff79fe30d88a2ec0 | 50a73d8f531132c5459174a55cac412d5f684462
E1 | all_service_dh0.3_reduction0 | TL | services | district_heat_loss | 0 | 163163.25 | 163163.24999999994 | MWh | 5.820766091346741e-11 | 3.567449221161469e-16 | 0.00000116316325 | FAIL | PASS | SYNTHETIC_FUNCTION_REGRESSION | Phase3A3 frozen-U failure receipt (reused) | Phase3A4 independent Git integration branch | 353dec3c83b859eab39bcf2dff79fe30d88a2ec0 | 50a73d8f531132c5459174a55cac412d5f684462 | Upstream additive markup: supply=service*(1+0.15), not 1/(1-0.15)
E1 | all_service_dh0.3_reduction0 | TL | services | profile_unchanged | 150370.99506878766 | 0 | 0 | MW | 0 | 0 | 0 | FAIL | PASS | SYNTHETIC_FUNCTION_REGRESSION | Phase3A3 frozen-U failure receipt (reused) | Phase3A4 independent Git integration branch | 353dec3c83b859eab39bcf2dff79fe30d88a2ec0 | 50a73d8f531132c5459174a55cac412d5f684462
E1 | all_service_dh0.3_reduction0 | TL | residential | direct_electricity | 8890000 | 8890000 | 8890000 | MWh | 0 | 0 | 0.00000989 | PASS | PASS | SYNTHETIC_FUNCTION_REGRESSION | Phase3A3 frozen-U failure receipt (reused) | Phase3A4 independent Git integration branch | 353dec3c83b859eab39bcf2dff79fe30d88a2ec0 | 50a73d8f531132c5459174a55cac412d5f684462
E1 | all_service_dh0.3_reduction0 | TL | services | direct_electricity | 3990000 | 3990000 | 3990000 | MWh | 0 | 0 | 0.00000499 | PASS | PASS | SYNTHETIC_FUNCTION_REGRESSION | Phase3A3 frozen-U failure receipt (reused) | Phase3A4 independent Git integration branch | 353dec3c83b859eab39bcf2dff79fe30d88a2ec0 | 50a73d8f531132c5459174a55cac412d5f684462
E1 | all_service_dh0.3_reduction0 | TL | residential | fixed_oil | 1000000 | 1000000 | 1000000 | MWh | 0 | 0 | 0.000002 | PASS | PASS | SYNTHETIC_FUNCTION_REGRESSION | Phase3A3 frozen-U failure receipt (reused) | Phase3A4 independent Git integration branch | 353dec3c83b859eab39bcf2dff79fe30d88a2ec0 | 50a73d8f531132c5459174a55cac412d5f684462
E1 | all_service_dh0.3_reduction0 | TL | residential | fixed_gas | 500000 | 500000 | 500000 | MWh | 0 | 0 | 0.0000015 | PASS | PASS | SYNTHETIC_FUNCTION_REGRESSION | Phase3A3 frozen-U failure receipt (reused) | Phase3A4 independent Git integration branch | 353dec3c83b859eab39bcf2dff79fe30d88a2ec0 | 50a73d8f531132c5459174a55cac412d5f684462
E1 | all_service_dh0.3_reduction0 | TL | residential | fixed_biomass | 250000 | 250000 | 250000 | MWh | 0 | 0 | 0.0000012499999999999999 | PASS | PASS | SYNTHETIC_FUNCTION_REGRESSION | Phase3A3 frozen-U failure receipt (reused) | Phase3A4 independent Git integration branch | 353dec3c83b859eab39bcf2dff79fe30d88a2ec0 | 50a73d8f531132c5459174a55cac412d5f684462
E1 | all_service_dh0.3_reduction0 | VN | residential | heat_service_without_DH_loss | 5346868.5399042135 | 9100000 | 9099999.999999998 | MWh | 1.862645149230957e-9 | 2.0468628013527e-16 | 0.0000101 | FAIL | PASS | SYNTHETIC_FUNCTION_REGRESSION | Phase3A3 frozen-U failure receipt (reused) | Phase3A4 independent Git integration branch | 353dec3c83b859eab39bcf2dff79fe30d88a2ec0 | 50a73d8f531132c5459174a55cac412d5f684462
E1 | all_service_dh0.3_reduction0 | VN | residential | district_heat_loss | 0 | 260032.49999999997 | 260032.4999999999 | MWh | 5.820766091346741e-11 | 2.238476379432087e-16 | 0.0000012600325 | FAIL | PASS | SYNTHETIC_FUNCTION_REGRESSION | Phase3A3 frozen-U failure receipt (reused) | Phase3A4 independent Git integration branch | 353dec3c83b859eab39bcf2dff79fe30d88a2ec0 | 50a73d8f531132c5459174a55cac412d5f684462 | Upstream additive markup: supply=service*(1+0.15), not 1/(1-0.15)
E1 | all_service_dh0.3_reduction0 | VN | services | heat_service_without_DH_loss | 2231183.717721145 | 5900000 | 5900000 | MWh | 0 | 0 | 0.0000069 | FAIL | PASS | SYNTHETIC_FUNCTION_REGRESSION | Phase3A3 frozen-U failure receipt (reused) | Phase3A4 independent Git integration branch | 353dec3c83b859eab39bcf2dff79fe30d88a2ec0 | 50a73d8f531132c5459174a55cac412d5f684462
E1 | all_service_dh0.3_reduction0 | VN | services | district_heat_loss | 0 | 168592.5 | 168592.49999999994 | MWh | 5.820766091346741e-11 | 3.4525652631918625e-16 | 0.0000011685925 | FAIL | PASS | SYNTHETIC_FUNCTION_REGRESSION | Phase3A3 frozen-U failure receipt (reused) | Phase3A4 independent Git integration branch | 353dec3c83b859eab39bcf2dff79fe30d88a2ec0 | 50a73d8f531132c5459174a55cac412d5f684462 | Upstream additive markup: supply=service*(1+0.15), not 1/(1-0.15)
E1 | all_service_dh0.3_reduction0 | VN | services | profile_unchanged | 162639.34155899542 | 0 | 0 | MW | 0 | 0 | 0 | FAIL | PASS | SYNTHETIC_FUNCTION_REGRESSION | Phase3A3 frozen-U failure receipt (reused) | Phase3A4 independent Git integration branch | 353dec3c83b859eab39bcf2dff79fe30d88a2ec0 | 50a73d8f531132c5459174a55cac412d5f684462
E1 | all_service_dh0.3_reduction0 | VN | residential | direct_electricity | 9100000 | 9100000 | 9100000 | MWh | 0 | 0 | 0.0000101 | PASS | PASS | SYNTHETIC_FUNCTION_REGRESSION | Phase3A3 frozen-U failure receipt (reused) | Phase3A4 independent Git integration branch | 353dec3c83b859eab39bcf2dff79fe30d88a2ec0 | 50a73d8f531132c5459174a55cac412d5f684462
E1 | all_service_dh0.3_reduction0 | VN | services | direct_electricity | 4099999.9999999995 | 4099999.9999999995 | 4099999.9999999995 | MWh | 0 | 0 | 0.0000050999999999999995 | PASS | PASS | SYNTHETIC_FUNCTION_REGRESSION | Phase3A3 frozen-U failure receipt (reused) | Phase3A4 independent Git integration branch | 353dec3c83b859eab39bcf2dff79fe30d88a2ec0 | 50a73d8f531132c5459174a55cac412d5f684462
E1 | all_service_dh0.3_reduction0 | VN | residential | fixed_oil | 1000000 | 1000000 | 1000000 | MWh | 0 | 0 | 0.000002 | PASS | PASS | SYNTHETIC_FUNCTION_REGRESSION | Phase3A3 frozen-U failure receipt (reused) | Phase3A4 independent Git integration branch | 353dec3c83b859eab39bcf2dff79fe30d88a2ec0 | 50a73d8f531132c5459174a55cac412d5f684462
E1 | all_service_dh0.3_reduction0 | VN | residential | fixed_gas | 500000 | 500000 | 500000 | MWh | 0 | 0 | 0.0000015 | PASS | PASS | SYNTHETIC_FUNCTION_REGRESSION | Phase3A3 frozen-U failure receipt (reused) | Phase3A4 independent Git integration branch | 353dec3c83b859eab39bcf2dff79fe30d88a2ec0 | 50a73d8f531132c5459174a55cac412d5f684462
E1 | all_service_dh0.3_reduction0 | VN | residential | fixed_biomass | 250000 | 250000 | 250000 | MWh | 0 | 0 | 0.0000012499999999999999 | PASS | PASS | SYNTHETIC_FUNCTION_REGRESSION | Phase3A3 frozen-U failure receipt (reused) | Phase3A4 independent Git integration branch | 353dec3c83b859eab39bcf2dff79fe30d88a2ec0 | 50a73d8f531132c5459174a55cac412d5f684462
E1 | all_service_dh0.3_reduction0 | ALL | R+S | finite_nonnegative | true | true | true | boolean | 0 | 0 | 0 | PASS | PASS | SYNTHETIC_FUNCTION_REGRESSION | Phase3A3 frozen-U failure receipt (reused) | Phase3A4 independent Git integration branch | 353dec3c83b859eab39bcf2dff79fe30d88a2ec0 | 50a73d8f531132c5459174a55cac412d5f684462
E1 | zero_R_dh0.3_reduction0 | BN | residential | heat_service_without_DH_loss | 0 | 0 | 0 | MWh | 0 | 0 | 0.000001 | PASS | PASS | SYNTHETIC_FUNCTION_REGRESSION | Phase3A3 frozen-U failure receipt (reused) | Phase3A4 independent Git integration branch | 353dec3c83b859eab39bcf2dff79fe30d88a2ec0 | 50a73d8f531132c5459174a55cac412d5f684462
E1 | zero_R_dh0.3_reduction0 | BN | residential | district_heat_loss | 0 | 0 | 0 | MWh | 0 | 0 | 0.000001 | PASS | PASS | SYNTHETIC_FUNCTION_REGRESSION | Phase3A3 frozen-U failure receipt (reused) | Phase3A4 independent Git integration branch | 353dec3c83b859eab39bcf2dff79fe30d88a2ec0 | 50a73d8f531132c5459174a55cac412d5f684462 | Upstream additive markup: supply=service*(1+0.15), not 1/(1-0.15)
E1 | zero_R_dh0.3_reduction0 | BN | services | heat_service_without_DH_loss | 0 | 4000000 | 4000000 | MWh | 0 | 0 | 0.0000049999999999999996 | FAIL | PASS | SYNTHETIC_FUNCTION_REGRESSION | Phase3A3 frozen-U failure receipt (reused) | Phase3A4 independent Git integration branch | 353dec3c83b859eab39bcf2dff79fe30d88a2ec0 | 50a73d8f531132c5459174a55cac412d5f684462
E1 | zero_R_dh0.3_reduction0 | BN | services | district_heat_loss | 0 | 114300 | 114299.99999999997 | MWh | 2.9103830456733704e-11 | 2.5462668816039985e-16 | 0.0000011142999999999999 | FAIL | PASS | SYNTHETIC_FUNCTION_REGRESSION | Phase3A3 frozen-U failure receipt (reused) | Phase3A4 independent Git integration branch | 353dec3c83b859eab39bcf2dff79fe30d88a2ec0 | 50a73d8f531132c5459174a55cac412d5f684462 | Upstream additive markup: supply=service*(1+0.15), not 1/(1-0.15)
E1 | zero_R_dh0.3_reduction0 | BN | services | profile_unchanged | 169813.76518218618 | 0 | 0 | MW | 0 | 0 | 0 | FAIL | PASS | SYNTHETIC_FUNCTION_REGRESSION | Phase3A3 frozen-U failure receipt (reused) | Phase3A4 independent Git integration branch | 353dec3c83b859eab39bcf2dff79fe30d88a2ec0 | 50a73d8f531132c5459174a55cac412d5f684462
E1 | zero_R_dh0.3_reduction0 | BN | residential | direct_electricity | 7000000 | 7000000 | 7000000 | MWh | 0 | 0 | 0.000008 | PASS | PASS | SYNTHETIC_FUNCTION_REGRESSION | Phase3A3 frozen-U failure receipt (reused) | Phase3A4 independent Git integration branch | 353dec3c83b859eab39bcf2dff79fe30d88a2ec0 | 50a73d8f531132c5459174a55cac412d5f684462
E1 | zero_R_dh0.3_reduction0 | BN | services | direct_electricity | 3000000 | 3000000 | 3000000 | MWh | 0 | 0 | 0.000004 | PASS | PASS | SYNTHETIC_FUNCTION_REGRESSION | Phase3A3 frozen-U failure receipt (reused) | Phase3A4 independent Git integration branch | 353dec3c83b859eab39bcf2dff79fe30d88a2ec0 | 50a73d8f531132c5459174a55cac412d5f684462
E1 | zero_R_dh0.3_reduction0 | BN | residential | fixed_oil | 1000000 | 1000000 | 1000000 | MWh | 0 | 0 | 0.000002 | PASS | PASS | SYNTHETIC_FUNCTION_REGRESSION | Phase3A3 frozen-U failure receipt (reused) | Phase3A4 independent Git integration branch | 353dec3c83b859eab39bcf2dff79fe30d88a2ec0 | 50a73d8f531132c5459174a55cac412d5f684462
E1 | zero_R_dh0.3_reduction0 | BN | residential | fixed_gas | 500000 | 500000 | 500000 | MWh | 0 | 0 | 0.0000015 | PASS | PASS | SYNTHETIC_FUNCTION_REGRESSION | Phase3A3 frozen-U failure receipt (reused) | Phase3A4 independent Git integration branch | 353dec3c83b859eab39bcf2dff79fe30d88a2ec0 | 50a73d8f531132c5459174a55cac412d5f684462
E1 | zero_R_dh0.3_reduction0 | BN | residential | fixed_biomass | 250000 | 250000 | 250000 | MWh | 0 | 0 | 0.0000012499999999999999 | PASS | PASS | SYNTHETIC_FUNCTION_REGRESSION | Phase3A3 frozen-U failure receipt (reused) | Phase3A4 independent Git integration branch | 353dec3c83b859eab39bcf2dff79fe30d88a2ec0 | 50a73d8f531132c5459174a55cac412d5f684462
E1 | zero_R_dh0.3_reduction0 | KH | residential | heat_service_without_DH_loss | 0 | 0 | 0 | MWh | 0 | 0 | 0.000001 | PASS | PASS | SYNTHETIC_FUNCTION_REGRESSION | Phase3A3 frozen-U failure receipt (reused) | Phase3A4 independent Git integration branch | 353dec3c83b859eab39bcf2dff79fe30d88a2ec0 | 50a73d8f531132c5459174a55cac412d5f684462
E1 | zero_R_dh0.3_reduction0 | KH | residential | district_heat_loss | 0 | 0 | 0 | MWh | 0 | 0 | 0.000001 | PASS | PASS | SYNTHETIC_FUNCTION_REGRESSION | Phase3A3 frozen-U failure receipt (reused) | Phase3A4 independent Git integration branch | 353dec3c83b859eab39bcf2dff79fe30d88a2ec0 | 50a73d8f531132c5459174a55cac412d5f684462 | Upstream additive markup: supply=service*(1+0.15), not 1/(1-0.15)
E1 | zero_R_dh0.3_reduction0 | KH | services | heat_service_without_DH_loss | 0 | 4190000.000000001 | 4190000 | MWh | 9.313225746154785e-10 | 2.222726908390163e-16 | 0.00000519 | FAIL | PASS | SYNTHETIC_FUNCTION_REGRESSION | Phase3A3 frozen-U failure receipt (reused) | Phase3A4 independent Git integration branch | 353dec3c83b859eab39bcf2dff79fe30d88a2ec0 | 50a73d8f531132c5459174a55cac412d5f684462
E1 | zero_R_dh0.3_reduction0 | KH | services | district_heat_loss | 0 | 119729.25000000001 | 119729.24999999997 | MWh | 4.3655745685100555e-11 | 3.6462055583828136e-16 | 0.00000111972925 | FAIL | PASS | SYNTHETIC_FUNCTION_REGRESSION | Phase3A3 frozen-U failure receipt (reused) | Phase3A4 independent Git integration branch | 353dec3c83b859eab39bcf2dff79fe30d88a2ec0 | 50a73d8f531132c5459174a55cac412d5f684462 | Upstream additive markup: supply=service*(1+0.15), not 1/(1-0.15)
E1 | zero_R_dh0.3_reduction0 | KH | services | profile_unchanged | 204192.15970961883 | 0 | 0 | MW | 0 | 0 | 0 | FAIL | PASS | SYNTHETIC_FUNCTION_REGRESSION | Phase3A3 frozen-U failure receipt (reused) | Phase3A4 independent Git integration branch | 353dec3c83b859eab39bcf2dff79fe30d88a2ec0 | 50a73d8f531132c5459174a55cac412d5f684462
E1 | zero_R_dh0.3_reduction0 | KH | residential | direct_electricity | 7210000 | 7210000 | 7210000 | MWh | 0 | 0 | 0.00000821 | PASS | PASS | SYNTHETIC_FUNCTION_REGRESSION | Phase3A3 frozen-U failure receipt (reused) | Phase3A4 independent Git integration branch | 353dec3c83b859eab39bcf2dff79fe30d88a2ec0 | 50a73d8f531132c5459174a55cac412d5f684462
E1 | zero_R_dh0.3_reduction0 | KH | services | direct_electricity | 3110000 | 3110000 | 3110000 | MWh | 0 | 0 | 0.00000411 | PASS | PASS | SYNTHETIC_FUNCTION_REGRESSION | Phase3A3 frozen-U failure receipt (reused) | Phase3A4 independent Git integration branch | 353dec3c83b859eab39bcf2dff79fe30d88a2ec0 | 50a73d8f531132c5459174a55cac412d5f684462
E1 | zero_R_dh0.3_reduction0 | KH | residential | fixed_oil | 1000000 | 1000000 | 1000000 | MWh | 0 | 0 | 0.000002 | PASS | PASS | SYNTHETIC_FUNCTION_REGRESSION | Phase3A3 frozen-U failure receipt (reused) | Phase3A4 independent Git integration branch | 353dec3c83b859eab39bcf2dff79fe30d88a2ec0 | 50a73d8f531132c5459174a55cac412d5f684462
E1 | zero_R_dh0.3_reduction0 | KH | residential | fixed_gas | 500000 | 500000 | 500000 | MWh | 0 | 0 | 0.0000015 | PASS | PASS | SYNTHETIC_FUNCTION_REGRESSION | Phase3A3 frozen-U failure receipt (reused) | Phase3A4 independent Git integration branch | 353dec3c83b859eab39bcf2dff79fe30d88a2ec0 | 50a73d8f531132c5459174a55cac412d5f684462
E1 | zero_R_dh0.3_reduction0 | KH | residential | fixed_biomass | 250000 | 250000 | 250000 | MWh | 0 | 0 | 0.0000012499999999999999 | PASS | PASS | SYNTHETIC_FUNCTION_REGRESSION | Phase3A3 frozen-U failure receipt (reused) | Phase3A4 independent Git integration branch | 353dec3c83b859eab39bcf2dff79fe30d88a2ec0 | 50a73d8f531132c5459174a55cac412d5f684462
E1 | zero_R_dh0.3_reduction0 | ID | residential | heat_service_without_DH_loss | 0 | 0 | 0 | MWh | 0 | 0 | 0.000001 | PASS | PASS | SYNTHETIC_FUNCTION_REGRESSION | Phase3A3 frozen-U failure receipt (reused) | Phase3A4 independent Git integration branch | 353dec3c83b859eab39bcf2dff79fe30d88a2ec0 | 50a73d8f531132c5459174a55cac412d5f684462
E1 | zero_R_dh0.3_reduction0 | ID | residential | district_heat_loss | 0 | 0 | 0 | MWh | 0 | 0 | 0.000001 | PASS | PASS | SYNTHETIC_FUNCTION_REGRESSION | Phase3A3 frozen-U failure receipt (reused) | Phase3A4 independent Git integration branch | 353dec3c83b859eab39bcf2dff79fe30d88a2ec0 | 50a73d8f531132c5459174a55cac412d5f684462 | Upstream additive markup: supply=service*(1+0.15), not 1/(1-0.15)
E1 | zero_R_dh0.3_reduction0 | ID | services | heat_service_without_DH_loss | 0 | 4380000 | 4380000 | MWh | 0 | 0 | 0.000005379999999999999 | FAIL | PASS | SYNTHETIC_FUNCTION_REGRESSION | Phase3A3 frozen-U failure receipt (reused) | Phase3A4 independent Git integration branch | 353dec3c83b859eab39bcf2dff79fe30d88a2ec0 | 50a73d8f531132c5459174a55cac412d5f684462
E1 | zero_R_dh0.3_reduction0 | ID | services | district_heat_loss | 0 | 125158.5 | 125158.49999999997 | MWh | 2.9103830456733704e-11 | 2.325357882743378e-16 | 0.0000011251585 | FAIL | PASS | SYNTHETIC_FUNCTION_REGRESSION | Phase3A3 frozen-U failure receipt (reused) | Phase3A4 independent Git integration branch | 353dec3c83b859eab39bcf2dff79fe30d88a2ec0 | 50a73d8f531132c5459174a55cac412d5f684462 | Upstream additive markup: supply=service*(1+0.15), not 1/(1-0.15)
E1 | zero_R_dh0.3_reduction0 | ID | services | profile_unchanged | 165087.01202886927 | 0 | 0 | MW | 0 | 0 | 0 | FAIL | PASS | SYNTHETIC_FUNCTION_REGRESSION | Phase3A3 frozen-U failure receipt (reused) | Phase3A4 independent Git integration branch | 353dec3c83b859eab39bcf2dff79fe30d88a2ec0 | 50a73d8f531132c5459174a55cac412d5f684462
E1 | zero_R_dh0.3_reduction0 | ID | residential | direct_electricity | 7420000 | 7420000 | 7420000 | MWh | 0 | 0 | 0.00000842 | PASS | PASS | SYNTHETIC_FUNCTION_REGRESSION | Phase3A3 frozen-U failure receipt (reused) | Phase3A4 independent Git integration branch | 353dec3c83b859eab39bcf2dff79fe30d88a2ec0 | 50a73d8f531132c5459174a55cac412d5f684462
E1 | zero_R_dh0.3_reduction0 | ID | services | direct_electricity | 3220000 | 3220000 | 3220000 | MWh | 0 | 0 | 0.00000422 | PASS | PASS | SYNTHETIC_FUNCTION_REGRESSION | Phase3A3 frozen-U failure receipt (reused) | Phase3A4 independent Git integration branch | 353dec3c83b859eab39bcf2dff79fe30d88a2ec0 | 50a73d8f531132c5459174a55cac412d5f684462
E1 | zero_R_dh0.3_reduction0 | ID | residential | fixed_oil | 1000000 | 1000000 | 1000000 | MWh | 0 | 0 | 0.000002 | PASS | PASS | SYNTHETIC_FUNCTION_REGRESSION | Phase3A3 frozen-U failure receipt (reused) | Phase3A4 independent Git integration branch | 353dec3c83b859eab39bcf2dff79fe30d88a2ec0 | 50a73d8f531132c5459174a55cac412d5f684462
E1 | zero_R_dh0.3_reduction0 | ID | residential | fixed_gas | 500000 | 500000 | 500000 | MWh | 0 | 0 | 0.0000015 | PASS | PASS | SYNTHETIC_FUNCTION_REGRESSION | Phase3A3 frozen-U failure receipt (reused) | Phase3A4 independent Git integration branch | 353dec3c83b859eab39bcf2dff79fe30d88a2ec0 | 50a73d8f531132c5459174a55cac412d5f684462
E1 | zero_R_dh0.3_reduction0 | ID | residential | fixed_biomass | 250000 | 250000 | 250000 | MWh | 0 | 0 | 0.0000012499999999999999 | PASS | PASS | SYNTHETIC_FUNCTION_REGRESSION | Phase3A3 frozen-U failure receipt (reused) | Phase3A4 independent Git integration branch | 353dec3c83b859eab39bcf2dff79fe30d88a2ec0 | 50a73d8f531132c5459174a55cac412d5f684462
E1 | zero_R_dh0.3_reduction0 | LA | residential | heat_service_without_DH_loss | 0 | 0 | 0 | MWh | 0 | 0 | 0.000001 | PASS | PASS | SYNTHETIC_FUNCTION_REGRESSION | Phase3A3 frozen-U failure receipt (reused) | Phase3A4 independent Git integration branch | 353dec3c83b859eab39bcf2dff79fe30d88a2ec0 | 50a73d8f531132c5459174a55cac412d5f684462
E1 | zero_R_dh0.3_reduction0 | LA | residential | district_heat_loss | 0 | 0 | 0 | MWh | 0 | 0 | 0.000001 | PASS | PASS | SYNTHETIC_FUNCTION_REGRESSION | Phase3A3 frozen-U failure receipt (reused) | Phase3A4 independent Git integration branch | 353dec3c83b859eab39bcf2dff79fe30d88a2ec0 | 50a73d8f531132c5459174a55cac412d5f684462 | Upstream additive markup: supply=service*(1+0.15), not 1/(1-0.15)
E1 | zero_R_dh0.3_reduction0 | LA | services | heat_service_without_DH_loss | 0 | 4570000 | 4570000 | MWh | 0 | 0 | 0.00000557 | FAIL | PASS | SYNTHETIC_FUNCTION_REGRESSION | Phase3A3 frozen-U failure receipt (reused) | Phase3A4 independent Git integration branch | 353dec3c83b859eab39bcf2dff79fe30d88a2ec0 | 50a73d8f531132c5459174a55cac412d5f684462
E1 | zero_R_dh0.3_reduction0 | LA | services | district_heat_loss | 0 | 130587.75 | 130587.74999999996 | MWh | 4.3655745685100555e-11 | 3.3430199758477007e-16 | 0.00000113058775 | FAIL | PASS | SYNTHETIC_FUNCTION_REGRESSION | Phase3A3 frozen-U failure receipt (reused) | Phase3A4 independent Git integration branch | 353dec3c83b859eab39bcf2dff79fe30d88a2ec0 | 50a73d8f531132c5459174a55cac412d5f684462 | Upstream additive markup: supply=service*(1+0.15), not 1/(1-0.15)
E1 | zero_R_dh0.3_reduction0 | LA | services | profile_unchanged | 199687.37770649558 | 0 | 0 | MW | 0 | 0 | 0 | FAIL | PASS | SYNTHETIC_FUNCTION_REGRESSION | Phase3A3 frozen-U failure receipt (reused) | Phase3A4 independent Git integration branch | 353dec3c83b859eab39bcf2dff79fe30d88a2ec0 | 50a73d8f531132c5459174a55cac412d5f684462
E1 | zero_R_dh0.3_reduction0 | LA | residential | direct_electricity | 7630000 | 7630000 | 7630000 | MWh | 0 | 0 | 0.00000863 | PASS | PASS | SYNTHETIC_FUNCTION_REGRESSION | Phase3A3 frozen-U failure receipt (reused) | Phase3A4 independent Git integration branch | 353dec3c83b859eab39bcf2dff79fe30d88a2ec0 | 50a73d8f531132c5459174a55cac412d5f684462
E1 | zero_R_dh0.3_reduction0 | LA | services | direct_electricity | 3330000 | 3330000 | 3330000 | MWh | 0 | 0 | 0.00000433 | PASS | PASS | SYNTHETIC_FUNCTION_REGRESSION | Phase3A3 frozen-U failure receipt (reused) | Phase3A4 independent Git integration branch | 353dec3c83b859eab39bcf2dff79fe30d88a2ec0 | 50a73d8f531132c5459174a55cac412d5f684462
E1 | zero_R_dh0.3_reduction0 | LA | residential | fixed_oil | 1000000 | 1000000 | 1000000 | MWh | 0 | 0 | 0.000002 | PASS | PASS | SYNTHETIC_FUNCTION_REGRESSION | Phase3A3 frozen-U failure receipt (reused) | Phase3A4 independent Git integration branch | 353dec3c83b859eab39bcf2dff79fe30d88a2ec0 | 50a73d8f531132c5459174a55cac412d5f684462
E1 | zero_R_dh0.3_reduction0 | LA | residential | fixed_gas | 500000 | 500000 | 500000 | MWh | 0 | 0 | 0.0000015 | PASS | PASS | SYNTHETIC_FUNCTION_REGRESSION | Phase3A3 frozen-U failure receipt (reused) | Phase3A4 independent Git integration branch | 353dec3c83b859eab39bcf2dff79fe30d88a2ec0 | 50a73d8f531132c5459174a55cac412d5f684462
E1 | zero_R_dh0.3_reduction0 | LA | residential | fixed_biomass | 250000 | 250000 | 250000 | MWh | 0 | 0 | 0.0000012499999999999999 | PASS | PASS | SYNTHETIC_FUNCTION_REGRESSION | Phase3A3 frozen-U failure receipt (reused) | Phase3A4 independent Git integration branch | 353dec3c83b859eab39bcf2dff79fe30d88a2ec0 | 50a73d8f531132c5459174a55cac412d5f684462
E1 | zero_R_dh0.3_reduction0 | MY | residential | heat_service_without_DH_loss | 0 | 0 | 0 | MWh | 0 | 0 | 0.000001 | PASS | PASS | SYNTHETIC_FUNCTION_REGRESSION | Phase3A3 frozen-U failure receipt (reused) | Phase3A4 independent Git integration branch | 353dec3c83b859eab39bcf2dff79fe30d88a2ec0 | 50a73d8f531132c5459174a55cac412d5f684462
E1 | zero_R_dh0.3_reduction0 | MY | residential | district_heat_loss | 0 | 0 | 0 | MWh | 0 | 0 | 0.000001 | PASS | PASS | SYNTHETIC_FUNCTION_REGRESSION | Phase3A3 frozen-U failure receipt (reused) | Phase3A4 independent Git integration branch | 353dec3c83b859eab39bcf2dff79fe30d88a2ec0 | 50a73d8f531132c5459174a55cac412d5f684462 | Upstream additive markup: supply=service*(1+0.15), not 1/(1-0.15)
E1 | zero_R_dh0.3_reduction0 | MY | services | heat_service_without_DH_loss | 0 | 4760000 | 4760000 | MWh | 0 | 0 | 0.00000576 | FAIL | PASS | SYNTHETIC_FUNCTION_REGRESSION | Phase3A3 frozen-U failure receipt (reused) | Phase3A4 independent Git integration branch | 353dec3c83b859eab39bcf2dff79fe30d88a2ec0 | 50a73d8f531132c5459174a55cac412d5f684462
E1 | zero_R_dh0.3_reduction0 | MY | services | district_heat_loss | 0 | 136017 | 136016.99999999994 | MWh | 5.820766091346741e-11 | 4.2794401371495774e-16 | 0.000001136017 | FAIL | PASS | SYNTHETIC_FUNCTION_REGRESSION | Phase3A3 frozen-U failure receipt (reused) | Phase3A4 independent Git integration branch | 353dec3c83b859eab39bcf2dff79fe30d88a2ec0 | 50a73d8f531132c5459174a55cac412d5f684462 | Upstream additive markup: supply=service*(1+0.15), not 1/(1-0.15)
E1 | zero_R_dh0.3_reduction0 | MY | services | profile_unchanged | 199112.61882572225 | 0 | 0 | MW | 0 | 0 | 0 | FAIL | PASS | SYNTHETIC_FUNCTION_REGRESSION | Phase3A3 frozen-U failure receipt (reused) | Phase3A4 independent Git integration branch | 353dec3c83b859eab39bcf2dff79fe30d88a2ec0 | 50a73d8f531132c5459174a55cac412d5f684462
E1 | zero_R_dh0.3_reduction0 | MY | residential | direct_electricity | 7840000 | 7840000 | 7840000 | MWh | 0 | 0 | 0.00000884 | PASS | PASS | SYNTHETIC_FUNCTION_REGRESSION | Phase3A3 frozen-U failure receipt (reused) | Phase3A4 independent Git integration branch | 353dec3c83b859eab39bcf2dff79fe30d88a2ec0 | 50a73d8f531132c5459174a55cac412d5f684462
E1 | zero_R_dh0.3_reduction0 | MY | services | direct_electricity | 3440000 | 3440000 | 3440000 | MWh | 0 | 0 | 0.00000444 | PASS | PASS | SYNTHETIC_FUNCTION_REGRESSION | Phase3A3 frozen-U failure receipt (reused) | Phase3A4 independent Git integration branch | 353dec3c83b859eab39bcf2dff79fe30d88a2ec0 | 50a73d8f531132c5459174a55cac412d5f684462
E1 | zero_R_dh0.3_reduction0 | MY | residential | fixed_oil | 1000000 | 1000000 | 1000000 | MWh | 0 | 0 | 0.000002 | PASS | PASS | SYNTHETIC_FUNCTION_REGRESSION | Phase3A3 frozen-U failure receipt (reused) | Phase3A4 independent Git integration branch | 353dec3c83b859eab39bcf2dff79fe30d88a2ec0 | 50a73d8f531132c5459174a55cac412d5f684462
E1 | zero_R_dh0.3_reduction0 | MY | residential | fixed_gas | 500000 | 500000 | 500000 | MWh | 0 | 0 | 0.0000015 | PASS | PASS | SYNTHETIC_FUNCTION_REGRESSION | Phase3A3 frozen-U failure receipt (reused) | Phase3A4 independent Git integration branch | 353dec3c83b859eab39bcf2dff79fe30d88a2ec0 | 50a73d8f531132c5459174a55cac412d5f684462
E1 | zero_R_dh0.3_reduction0 | MY | residential | fixed_biomass | 250000 | 250000 | 250000 | MWh | 0 | 0 | 0.0000012499999999999999 | PASS | PASS | SYNTHETIC_FUNCTION_REGRESSION | Phase3A3 frozen-U failure receipt (reused) | Phase3A4 independent Git integration branch | 353dec3c83b859eab39bcf2dff79fe30d88a2ec0 | 50a73d8f531132c5459174a55cac412d5f684462
E1 | zero_R_dh0.3_reduction0 | MM | residential | heat_service_without_DH_loss | 0 | 0 | 0 | MWh | 0 | 0 | 0.000001 | PASS | PASS | SYNTHETIC_FUNCTION_REGRESSION | Phase3A3 frozen-U failure receipt (reused) | Phase3A4 independent Git integration branch | 353dec3c83b859eab39bcf2dff79fe30d88a2ec0 | 50a73d8f531132c5459174a55cac412d5f684462
E1 | zero_R_dh0.3_reduction0 | MM | residential | district_heat_loss | 0 | 0 | 0 | MWh | 0 | 0 | 0.000001 | PASS | PASS | SYNTHETIC_FUNCTION_REGRESSION | Phase3A3 frozen-U failure receipt (reused) | Phase3A4 independent Git integration branch | 353dec3c83b859eab39bcf2dff79fe30d88a2ec0 | 50a73d8f531132c5459174a55cac412d5f684462 | Upstream additive markup: supply=service*(1+0.15), not 1/(1-0.15)
E1 | zero_R_dh0.3_reduction0 | MM | services | heat_service_without_DH_loss | 0 | 4950000 | 4950000 | MWh | 0 | 0 | 0.00000595 | FAIL | PASS | SYNTHETIC_FUNCTION_REGRESSION | Phase3A3 frozen-U failure receipt (reused) | Phase3A4 independent Git integration branch | 353dec3c83b859eab39bcf2dff79fe30d88a2ec0 | 50a73d8f531132c5459174a55cac412d5f684462
E1 | zero_R_dh0.3_reduction0 | MM | services | district_heat_loss | 0 | 141446.25 | 141446.25 | MWh | 0 | 0 | 0.00000114144625 | FAIL | PASS | SYNTHETIC_FUNCTION_REGRESSION | Phase3A3 frozen-U failure receipt (reused) | Phase3A4 independent Git integration branch | 353dec3c83b859eab39bcf2dff79fe30d88a2ec0 | 50a73d8f531132c5459174a55cac412d5f684462 | Upstream additive markup: supply=service*(1+0.15), not 1/(1-0.15)
E1 | zero_R_dh0.3_reduction0 | MM | services | profile_unchanged | 250113.9293139293 | 0 | 0 | MW | 0 | 0 | 0 | FAIL | PASS | SYNTHETIC_FUNCTION_REGRESSION | Phase3A3 frozen-U failure receipt (reused) | Phase3A4 independent Git integration branch | 353dec3c83b859eab39bcf2dff79fe30d88a2ec0 | 50a73d8f531132c5459174a55cac412d5f684462
E1 | zero_R_dh0.3_reduction0 | MM | residential | direct_electricity | 8050000 | 8050000.000000001 | 8050000 | MWh | 9.313225746154785e-10 | 1.1569224529384825e-16 | 0.000009050000000000001 | PASS | PASS | SYNTHETIC_FUNCTION_REGRESSION | Phase3A3 frozen-U failure receipt (reused) | Phase3A4 independent Git integration branch | 353dec3c83b859eab39bcf2dff79fe30d88a2ec0 | 50a73d8f531132c5459174a55cac412d5f684462
E1 | zero_R_dh0.3_reduction0 | MM | services | direct_electricity | 3550000 | 3550000 | 3550000 | MWh | 0 | 0 | 0.00000455 | PASS | PASS | SYNTHETIC_FUNCTION_REGRESSION | Phase3A3 frozen-U failure receipt (reused) | Phase3A4 independent Git integration branch | 353dec3c83b859eab39bcf2dff79fe30d88a2ec0 | 50a73d8f531132c5459174a55cac412d5f684462
E1 | zero_R_dh0.3_reduction0 | MM | residential | fixed_oil | 1000000 | 1000000 | 1000000 | MWh | 0 | 0 | 0.000002 | PASS | PASS | SYNTHETIC_FUNCTION_REGRESSION | Phase3A3 frozen-U failure receipt (reused) | Phase3A4 independent Git integration branch | 353dec3c83b859eab39bcf2dff79fe30d88a2ec0 | 50a73d8f531132c5459174a55cac412d5f684462
E1 | zero_R_dh0.3_reduction0 | MM | residential | fixed_gas | 500000 | 500000 | 500000 | MWh | 0 | 0 | 0.0000015 | PASS | PASS | SYNTHETIC_FUNCTION_REGRESSION | Phase3A3 frozen-U failure receipt (reused) | Phase3A4 independent Git integration branch | 353dec3c83b859eab39bcf2dff79fe30d88a2ec0 | 50a73d8f531132c5459174a55cac412d5f684462
E1 | zero_R_dh0.3_reduction0 | MM | residential | fixed_biomass | 250000 | 250000 | 250000 | MWh | 0 | 0 | 0.0000012499999999999999 | PASS | PASS | SYNTHETIC_FUNCTION_REGRESSION | Phase3A3 frozen-U failure receipt (reused) | Phase3A4 independent Git integration branch | 353dec3c83b859eab39bcf2dff79fe30d88a2ec0 | 50a73d8f531132c5459174a55cac412d5f684462
E1 | zero_R_dh0.3_reduction0 | PH | residential | heat_service_without_DH_loss | 0 | 0 | 0 | MWh | 0 | 0 | 0.000001 | PASS | PASS | SYNTHETIC_FUNCTION_REGRESSION | Phase3A3 frozen-U failure receipt (reused) | Phase3A4 independent Git integration branch | 353dec3c83b859eab39bcf2dff79fe30d88a2ec0 | 50a73d8f531132c5459174a55cac412d5f684462
E1 | zero_R_dh0.3_reduction0 | PH | residential | district_heat_loss | 0 | 0 | 0 | MWh | 0 | 0 | 0.000001 | PASS | PASS | SYNTHETIC_FUNCTION_REGRESSION | Phase3A3 frozen-U failure receipt (reused) | Phase3A4 independent Git integration branch | 353dec3c83b859eab39bcf2dff79fe30d88a2ec0 | 50a73d8f531132c5459174a55cac412d5f684462 | Upstream additive markup: supply=service*(1+0.15), not 1/(1-0.15)
E1 | zero_R_dh0.3_reduction0 | PH | services | heat_service_without_DH_loss | 0 | 5140000 | 5140000 | MWh | 0 | 0 | 0.00000614 | FAIL | PASS | SYNTHETIC_FUNCTION_REGRESSION | Phase3A3 frozen-U failure receipt (reused) | Phase3A4 independent Git integration branch | 353dec3c83b859eab39bcf2dff79fe30d88a2ec0 | 50a73d8f531132c5459174a55cac412d5f684462
E1 | zero_R_dh0.3_reduction0 | PH | services | district_heat_loss | 0 | 146875.5 | 146875.49999999997 | MWh | 2.9103830456733704e-11 | 1.9815306471626447e-16 | 0.0000011468755 | FAIL | PASS | SYNTHETIC_FUNCTION_REGRESSION | Phase3A3 frozen-U failure receipt (reused) | Phase3A4 independent Git integration branch | 353dec3c83b859eab39bcf2dff79fe30d88a2ec0 | 50a73d8f531132c5459174a55cac412d5f684462 | Upstream additive markup: supply=service*(1+0.15), not 1/(1-0.15)
E1 | zero_R_dh0.3_reduction0 | PH | services | profile_unchanged | 218210.68825910933 | 0 | 0 | MW | 0 | 0 | 0 | FAIL | PASS | SYNTHETIC_FUNCTION_REGRESSION | Phase3A3 frozen-U failure receipt (reused) | Phase3A4 independent Git integration branch | 353dec3c83b859eab39bcf2dff79fe30d88a2ec0 | 50a73d8f531132c5459174a55cac412d5f684462
E1 | zero_R_dh0.3_reduction0 | PH | residential | direct_electricity | 8260000 | 8260000 | 8260000 | MWh | 0 | 0 | 0.000009260000000000001 | PASS | PASS | SYNTHETIC_FUNCTION_REGRESSION | Phase3A3 frozen-U failure receipt (reused) | Phase3A4 independent Git integration branch | 353dec3c83b859eab39bcf2dff79fe30d88a2ec0 | 50a73d8f531132c5459174a55cac412d5f684462
E1 | zero_R_dh0.3_reduction0 | PH | services | direct_electricity | 3660000 | 3660000 | 3660000 | MWh | 0 | 0 | 0.00000466 | PASS | PASS | SYNTHETIC_FUNCTION_REGRESSION | Phase3A3 frozen-U failure receipt (reused) | Phase3A4 independent Git integration branch | 353dec3c83b859eab39bcf2dff79fe30d88a2ec0 | 50a73d8f531132c5459174a55cac412d5f684462
E1 | zero_R_dh0.3_reduction0 | PH | residential | fixed_oil | 1000000 | 1000000 | 1000000 | MWh | 0 | 0 | 0.000002 | PASS | PASS | SYNTHETIC_FUNCTION_REGRESSION | Phase3A3 frozen-U failure receipt (reused) | Phase3A4 independent Git integration branch | 353dec3c83b859eab39bcf2dff79fe30d88a2ec0 | 50a73d8f531132c5459174a55cac412d5f684462
E1 | zero_R_dh0.3_reduction0 | PH | residential | fixed_gas | 500000 | 500000 | 500000 | MWh | 0 | 0 | 0.0000015 | PASS | PASS | SYNTHETIC_FUNCTION_REGRESSION | Phase3A3 frozen-U failure receipt (reused) | Phase3A4 independent Git integration branch | 353dec3c83b859eab39bcf2dff79fe30d88a2ec0 | 50a73d8f531132c5459174a55cac412d5f684462
E1 | zero_R_dh0.3_reduction0 | PH | residential | fixed_biomass | 250000 | 250000 | 250000 | MWh | 0 | 0 | 0.0000012499999999999999 | PASS | PASS | SYNTHETIC_FUNCTION_REGRESSION | Phase3A3 frozen-U failure receipt (reused) | Phase3A4 independent Git integration branch | 353dec3c83b859eab39bcf2dff79fe30d88a2ec0 | 50a73d8f531132c5459174a55cac412d5f684462
E1 | zero_R_dh0.3_reduction0 | SG | residential | heat_service_without_DH_loss | 0 | 0 | 0 | MWh | 0 | 0 | 0.000001 | PASS | PASS | SYNTHETIC_FUNCTION_REGRESSION | Phase3A3 frozen-U failure receipt (reused) | Phase3A4 independent Git integration branch | 353dec3c83b859eab39bcf2dff79fe30d88a2ec0 | 50a73d8f531132c5459174a55cac412d5f684462
E1 | zero_R_dh0.3_reduction0 | SG | residential | district_heat_loss | 0 | 0 | 0 | MWh | 0 | 0 | 0.000001 | PASS | PASS | SYNTHETIC_FUNCTION_REGRESSION | Phase3A3 frozen-U failure receipt (reused) | Phase3A4 independent Git integration branch | 353dec3c83b859eab39bcf2dff79fe30d88a2ec0 | 50a73d8f531132c5459174a55cac412d5f684462 | Upstream additive markup: supply=service*(1+0.15), not 1/(1-0.15)
E1 | zero_R_dh0.3_reduction0 | SG | services | heat_service_without_DH_loss | 0 | 5330000 | 5330000 | MWh | 0 | 0 | 0.0000063299999999999995 | FAIL | PASS | SYNTHETIC_FUNCTION_REGRESSION | Phase3A3 frozen-U failure receipt (reused) | Phase3A4 independent Git integration branch | 353dec3c83b859eab39bcf2dff79fe30d88a2ec0 | 50a73d8f531132c5459174a55cac412d5f684462
E1 | zero_R_dh0.3_reduction0 | SG | services | district_heat_loss | 0 | 152304.75 | 152304.74999999994 | MWh | 5.820766091346741e-11 | 3.8217889404938063e-16 | 0.00000115230475 | FAIL | PASS | SYNTHETIC_FUNCTION_REGRESSION | Phase3A3 frozen-U failure receipt (reused) | Phase3A4 independent Git integration branch | 353dec3c83b859eab39bcf2dff79fe30d88a2ec0 | 50a73d8f531132c5459174a55cac412d5f684462 | Upstream additive markup: supply=service*(1+0.15), not 1/(1-0.15)
E1 | zero_R_dh0.3_reduction0 | SG | services | profile_unchanged | 259748.02177858434 | 0 | 0 | MW | 0 | 0 | 0 | FAIL | PASS | SYNTHETIC_FUNCTION_REGRESSION | Phase3A3 frozen-U failure receipt (reused) | Phase3A4 independent Git integration branch | 353dec3c83b859eab39bcf2dff79fe30d88a2ec0 | 50a73d8f531132c5459174a55cac412d5f684462
E1 | zero_R_dh0.3_reduction0 | SG | residential | direct_electricity | 8470000 | 8470000 | 8470000 | MWh | 0 | 0 | 0.00000947 | PASS | PASS | SYNTHETIC_FUNCTION_REGRESSION | Phase3A3 frozen-U failure receipt (reused) | Phase3A4 independent Git integration branch | 353dec3c83b859eab39bcf2dff79fe30d88a2ec0 | 50a73d8f531132c5459174a55cac412d5f684462
E1 | zero_R_dh0.3_reduction0 | SG | services | direct_electricity | 3770000 | 3770000 | 3770000 | MWh | 0 | 0 | 0.00000477 | PASS | PASS | SYNTHETIC_FUNCTION_REGRESSION | Phase3A3 frozen-U failure receipt (reused) | Phase3A4 independent Git integration branch | 353dec3c83b859eab39bcf2dff79fe30d88a2ec0 | 50a73d8f531132c5459174a55cac412d5f684462
E1 | zero_R_dh0.3_reduction0 | SG | residential | fixed_oil | 1000000 | 1000000 | 1000000 | MWh | 0 | 0 | 0.000002 | PASS | PASS | SYNTHETIC_FUNCTION_REGRESSION | Phase3A3 frozen-U failure receipt (reused) | Phase3A4 independent Git integration branch | 353dec3c83b859eab39bcf2dff79fe30d88a2ec0 | 50a73d8f531132c5459174a55cac412d5f684462
E1 | zero_R_dh0.3_reduction0 | SG | residential | fixed_gas | 500000 | 500000 | 500000 | MWh | 0 | 0 | 0.0000015 | PASS | PASS | SYNTHETIC_FUNCTION_REGRESSION | Phase3A3 frozen-U failure receipt (reused) | Phase3A4 independent Git integration branch | 353dec3c83b859eab39bcf2dff79fe30d88a2ec0 | 50a73d8f531132c5459174a55cac412d5f684462
E1 | zero_R_dh0.3_reduction0 | SG | residential | fixed_biomass | 250000 | 250000 | 250000 | MWh | 0 | 0 | 0.0000012499999999999999 | PASS | PASS | SYNTHETIC_FUNCTION_REGRESSION | Phase3A3 frozen-U failure receipt (reused) | Phase3A4 independent Git integration branch | 353dec3c83b859eab39bcf2dff79fe30d88a2ec0 | 50a73d8f531132c5459174a55cac412d5f684462
E1 | zero_R_dh0.3_reduction0 | TH | residential | heat_service_without_DH_loss | 0 | 0 | 0 | MWh | 0 | 0 | 0.000001 | PASS | PASS | SYNTHETIC_FUNCTION_REGRESSION | Phase3A3 frozen-U failure receipt (reused) | Phase3A4 independent Git integration branch | 353dec3c83b859eab39bcf2dff79fe30d88a2ec0 | 50a73d8f531132c5459174a55cac412d5f684462
E1 | zero_R_dh0.3_reduction0 | TH | residential | district_heat_loss | 0 | 0 | 0 | MWh | 0 | 0 | 0.000001 | PASS | PASS | SYNTHETIC_FUNCTION_REGRESSION | Phase3A3 frozen-U failure receipt (reused) | Phase3A4 independent Git integration branch | 353dec3c83b859eab39bcf2dff79fe30d88a2ec0 | 50a73d8f531132c5459174a55cac412d5f684462 | Upstream additive markup: supply=service*(1+0.15), not 1/(1-0.15)
E1 | zero_R_dh0.3_reduction0 | TH | services | heat_service_without_DH_loss | 0 | 5520000 | 5519999.999999999 | MWh | 9.313225746154785e-10 | 1.6871785772019538e-16 | 0.000006519999999999999 | FAIL | PASS | SYNTHETIC_FUNCTION_REGRESSION | Phase3A3 frozen-U failure receipt (reused) | Phase3A4 independent Git integration branch | 353dec3c83b859eab39bcf2dff79fe30d88a2ec0 | 50a73d8f531132c5459174a55cac412d5f684462
E1 | zero_R_dh0.3_reduction0 | TH | services | district_heat_loss | 0 | 157733.99999999997 | 157733.99999999994 | MWh | 2.9103830456733704e-11 | 1.84512092869855e-16 | 0.000001157734 | FAIL | PASS | SYNTHETIC_FUNCTION_REGRESSION | Phase3A3 frozen-U failure receipt (reused) | Phase3A4 independent Git integration branch | 353dec3c83b859eab39bcf2dff79fe30d88a2ec0 | 50a73d8f531132c5459174a55cac412d5f684462 | Upstream additive markup: supply=service*(1+0.15), not 1/(1-0.15)
E1 | zero_R_dh0.3_reduction0 | TH | services | profile_unchanged | 208054.86447473933 | 0 | 0 | MW | 0 | 0 | 0 | FAIL | PASS | SYNTHETIC_FUNCTION_REGRESSION | Phase3A3 frozen-U failure receipt (reused) | Phase3A4 independent Git integration branch | 353dec3c83b859eab39bcf2dff79fe30d88a2ec0 | 50a73d8f531132c5459174a55cac412d5f684462
E1 | zero_R_dh0.3_reduction0 | TH | residential | direct_electricity | 8680000 | 8680000 | 8680000 | MWh | 0 | 0 | 0.00000968 | PASS | PASS | SYNTHETIC_FUNCTION_REGRESSION | Phase3A3 frozen-U failure receipt (reused) | Phase3A4 independent Git integration branch | 353dec3c83b859eab39bcf2dff79fe30d88a2ec0 | 50a73d8f531132c5459174a55cac412d5f684462
E1 | zero_R_dh0.3_reduction0 | TH | services | direct_electricity | 3880000.0000000005 | 3880000 | 3880000.0000000005 | MWh | 4.656612873077393e-10 | 1.2001579569787095e-16 | 0.00000488 | PASS | PASS | SYNTHETIC_FUNCTION_REGRESSION | Phase3A3 frozen-U failure receipt (reused) | Phase3A4 independent Git integration branch | 353dec3c83b859eab39bcf2dff79fe30d88a2ec0 | 50a73d8f531132c5459174a55cac412d5f684462
E1 | zero_R_dh0.3_reduction0 | TH | residential | fixed_oil | 1000000 | 1000000 | 1000000 | MWh | 0 | 0 | 0.000002 | PASS | PASS | SYNTHETIC_FUNCTION_REGRESSION | Phase3A3 frozen-U failure receipt (reused) | Phase3A4 independent Git integration branch | 353dec3c83b859eab39bcf2dff79fe30d88a2ec0 | 50a73d8f531132c5459174a55cac412d5f684462
E1 | zero_R_dh0.3_reduction0 | TH | residential | fixed_gas | 500000 | 500000 | 500000 | MWh | 0 | 0 | 0.0000015 | PASS | PASS | SYNTHETIC_FUNCTION_REGRESSION | Phase3A3 frozen-U failure receipt (reused) | Phase3A4 independent Git integration branch | 353dec3c83b859eab39bcf2dff79fe30d88a2ec0 | 50a73d8f531132c5459174a55cac412d5f684462
E1 | zero_R_dh0.3_reduction0 | TH | residential | fixed_biomass | 250000 | 250000 | 250000 | MWh | 0 | 0 | 0.0000012499999999999999 | PASS | PASS | SYNTHETIC_FUNCTION_REGRESSION | Phase3A3 frozen-U failure receipt (reused) | Phase3A4 independent Git integration branch | 353dec3c83b859eab39bcf2dff79fe30d88a2ec0 | 50a73d8f531132c5459174a55cac412d5f684462
E1 | zero_R_dh0.3_reduction0 | TL | residential | heat_service_without_DH_loss | 0 | 0 | 0 | MWh | 0 | 0 | 0.000001 | PASS | PASS | SYNTHETIC_FUNCTION_REGRESSION | Phase3A3 frozen-U failure receipt (reused) | Phase3A4 independent Git integration branch | 353dec3c83b859eab39bcf2dff79fe30d88a2ec0 | 50a73d8f531132c5459174a55cac412d5f684462
E1 | zero_R_dh0.3_reduction0 | TL | residential | district_heat_loss | 0 | 0 | 0 | MWh | 0 | 0 | 0.000001 | PASS | PASS | SYNTHETIC_FUNCTION_REGRESSION | Phase3A3 frozen-U failure receipt (reused) | Phase3A4 independent Git integration branch | 353dec3c83b859eab39bcf2dff79fe30d88a2ec0 | 50a73d8f531132c5459174a55cac412d5f684462 | Upstream additive markup: supply=service*(1+0.15), not 1/(1-0.15)
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
