cyc292cycjin-oss/SGP-ESE5004-Stage2/research/01_baseline_construction/evidence/PAPER_EFFECTIVE_CONFIG.yaml

build_shape_options:
  simplify_gadm: false
  gadm_layer_id: 1
  update_file: false
  out_logging: true
  year: 2020
  nprocesses: 3
  worldpop_method: standard
  gdp_method: standard
  contended_flag: set_by_country
cluster_options:
  simplify_network:
    p_threshold_drop_isolated: 0
    p_threshold_merge_isolated: 0
    remove_stubs_across_borders: false
    s_threshold_fetch_isolated: 0.1
    to_substations: false
    algorithm: kmeans
    feature: solar+onwind-time
    exclude_carriers: []
    remove_stubs: true
  cluster_network:
    algorithm: kmeans
    feature: solar+onwind-time
    exclude_carriers: []
  alternative_clustering: false
  distribute_cluster:
  - load
  out_logging: true
  aggregation_strategies:
    generators:
      p_nom: sum
      p_nom_max: sum
      p_nom_min: sum
      p_min_pu: mean
      p_max_pu: weighted_average
      marginal_cost: mean
      committable: any
      ramp_limit_up: max
      ramp_limit_down: max
      efficiency: mean
  focus_weights: false
co2_budget:
  co2base_value: 1000000000.0
  enable: false
  override_co2opt: true
  year:
    2025: 1.0
    2030: 0.82
    2035: 0.64
    2040: 0.46
    2045: 0.28
    2050: 0.1
    2020: 1.0
costs:
  append_cost_data: true
  regional_factor: false
  year: 2030
  technology_data_version: v0.13.2
  discountrate:
  - 0.071
  country_specific_data: ''
  cost_scenario: moderate
  financial_case: market
  output_currency: EUR
  default_exchange_rate: 0.7532
  future_exchange_rate_strategy: reference
  custom_future_exchange_rate: None
  rooftop_share: 0.14
  fill_values:
    FOM: 0
    VOM: 0
    efficiency: 1
    fuel: 0
    investment: 0
    lifetime: 25
    CO2 intensity: 0
    discount rate: 0.07
  marginal_cost:
    solar: 0.01
    onwind: 0.015
    offwind: 0.015
    hydro: 0.0
    H2: 0.0
    electrolysis: 0.0
    fuel cell: 0.0
    battery: 0.0
    battery inverter: 0.0
  emission_prices:
    co2: 0.0
  lines:
    length_factor: 1.25
countries:
- ID
- LA
- TL
- SG
- MM
- KH
- PH
- BN
- MY
- VN
- TH
demand_data:
  update_data: false
  base_year: 2019
  other_industries: false
  aluminium_year: 2019
electricity:
  base_network: osm-plus-prebuilt
  base_network_version: 0.1.1
  extendable_carriers:
    Generator:
    - solar
    - onwind
    - offwind-ac
    - offwind-dc
    - OCGT
    - CCGT
    StorageUnit: []
    Store:
    - battery
    - H2
    Link: []
  base_voltage: 380.0
  voltages:
  - 132.0
  - 220.0
  - 300.0
  - 380.0
  - 500.0
  - 750.0
  co2limit: 77500000.0
  co2base: 1487000000.0
  agg_p_nom_limits:
    file: data/agg_p_nom_minmax.csv
    include_existing: false
  hvdc_as_lines: false
  automatic_emission: false
  automatic_emission_base_year: 1990
  operational_reserve:
    activate: false
    epsilon_load: 0.02
    epsilon_vres: 0.02
    contingency: 0
  max_hours:
    battery: 6
    H2: 168
  powerplants_filter: (DateOut >= 2022 or DateOut != DateOut)
  custom_powerplants: false
  conventional_carriers:
  - nuclear
  - oil
  - OCGT
  - CCGT
  - coal
  - lignite
  - geothermal
  - biomass
  renewable_carriers:
  - solar
  - onwind
  - offwind-ac
  - offwind-dc
  - hydro
  estimate_renewable_capacities:
    stats: irena
    year: 2023
    p_nom_min: 1
    p_nom_max: false
    technology_mapping:
      Offshore:
      - offwind-ac
      - offwind-dc
      Onshore:
      - onwind
      PV:
      - solar
enable:
  build_cutout: false
  build_natura_raster: false
  download_global_buildings: false
  download_osm_data: false
  retrieve_cost_data: true
  retrieve_databundle: false
  retrieve_databundle_sector: false
  progress_bar: true
  custom_busmap: false
export:
  enable: false
  h2export:
  - 0
  endogenous: false
  endogenous_price: 400
  store: true
  store_capital_costs: no_costs
  export_profile: ship
  ship:
    ship_capacity: 0.4
    travel_time: 288
    fill_time: 24
    unload_time: 24
final_adjustment:
  elec_per_capita:
    BN: 10.67
    ID: 1.45
    KH: 0.93
    LA: 1.67
    MM: 0.37
    MY: 5.08
    PH: 0.93
    SG: 9.75
    TH: 2.97
    TL: 0.29
    VN: 2.59
  industry_share:
    BN: 0.3
    ID: 0.5
    KH: 0.36
    LA: 0.61
    MM: 0.21
    MY: 0.88
    PH: 0.31
    SG: 0.37
    TH: 0.42
    TL: 0.01
    VN: 0.51
  only_elec_network: true
  pop_forecast_path: data/worldbank_pop_forecast.csv
  readjust_existing_interconnections: true
  redistribute_industry: true
  total_elec_demand:
    2025: 1401400000.0
    2030: 1658800000.0
    2035: 1940200000.0
    2040: 2264600000.0
    2045: 2635000000.0
    2050: 3036300000.0
focus_weights:
  BN: 0.0
  ID_Java-Bali: 0.035281
  ID_Kalimantan: 0.135732
  ID_Maluku: 0.0
  ID_Nusa-Tenggara: 0.016782
  ID_Papua: 0.0
  ID_Sulawesi: 0.046963
  ID_Sumatra: 0.120713
  KH: 0.046396
  LA: 0.05877
  MM: 0.169951
  MY_Peninsular: 0.033556
  MY_Sabah: 0.018709
  MY_Sarawak: 0.031638
  PH_Luzon: 0.023487
  PH_Mindanao: 0.023487
  PH_Visayas: 0.023487
  SG: 0.0
  TH: 0.131035
  TL: 0.0
  VN: 0.084013
foresight: myopic
load_options:
  scale:
    LA: 1456.62
    TL: 47.35
  substitute:
    LA: KH
    TL: ID
  ssp: ssp2-2.6
  weather_year: 2013
  prediction_year: 2030
policy_config:
  hydrogen:
    temporal_matching: no_temporal_matching
    spatial_matching: false
    temporal_matching_carriers:
    - csp
    - solar
    - onwind
    - offwind-ac
    - offwind-dc
    - ror
    - hydro
    matching_technologies:
    - H2 Electrolysis
    - Alkaline electrolyzer large
    - Alkaline electrolyzer medium
    - Alkaline electrolyzer small
    - PEM electrolyzer
    - SOEC
    additionality: false
    allowed_excess: 1.0
    is_reference: false
    remove_h2_load: false
    path_to_ref: ''
    re_country_load: false
results_dir: results/
run:
  name: baseline-aims-3H
  sector_name: baseline-aims-3H
  shared_cutouts: true
  allow_scenario_failure: false
scenario:
  clusters:
  - 100
  demand:
  - DEC
  ll:
  - v2.0
  opts:
  - ''
  planning_horizons:
  - 2025
  - 2030
  - 2035
  - 2040
  - 2045
  - 2050
  sopts:
  - 3h
  simpl:
  - ''
  unc:
  - m0
  - m1
  - m2
  - m3
  - m4
  - m5
  - m6
  - m7
  - m8
sector:
  biomass_transport: false
  co2_network: false
  enable:
    agriculture: true
    aviation: true
    biomass: true
    heat: true
    industry: true
    land_transport: true
    rail_transport: true
    residential: true
    services: true
    shipping: true
  hydrogen:
    network: false
    H2_retrofit_capacity_per_CH4: 0.6
    network_limit: 2000
    network_routes: gas
    gas_network_repurposing: true
    underground_storage: false
    hydrogen_colors: false
    set_color_shares: false
    blue_share: 0.4
    pink_share: 0.05
    production_technologies:
    - H2 Electrolysis
    - SMR
    - SMR CC
  land_transport_electric_share:
    DEC_2020: 0
    DEC_2025: 0.05
    DEC_2030: 0.2
    DEC_2035: 0.45
    DEC_2040: 0.7
    DEC_2045: 0.85
    DEC_2050: 1
    BU_2030: 0.0
    AP_2030: 0.075
    NZ_2030: 0.13
    DF_2030: 0.01
    AB_2030: 0.01
    BU_2050: 0.0
    AP_2050: 0.42
    NZ_2050: 0.68
    DF_2050: 0.011
  land_transport_fuel_cell_share:
    DEC_2020: 0.0
    DEC_2025: 0.0
    DEC_2030: 0.0
    DEC_2035: 0.0
    DEC_2040: 0.0
    DEC_2045: 0.0
    DEC_2050: 0.0
    BU_2030: 0.0
    AP_2030: 0.004
    NZ_2030: 0.02
    DF_2030: 0.01
    AB_2030: 0.01
    BU_2050: 0.0
    AP_2050: 0.06
    NZ_2050: 0.28
    DF_2050: 0.08
  shipping_hydrogen_share:
    DEC_2020: 0.0
    DEC_2025: 0.0
    DEC_2030: 0.0
    DEC_2035: 0.0
    DEC_2040: 0.0
    DEC_2045: 0.0
    DEC_2050: 0.0
    BU_2030: 0.0
    AP_2030: 0.0
    NZ_2030: 0.1
    DF_2030: 0.05
    AB_2030: 0.05
    BU_2050: 0.0
    AP_2050: 0.25
    NZ_2050: 0.36
    DF_2050: 0.12
  solar_rooftop:
    use_building_size: true
    enable: true
    kW_per_m2: 0.1
    m2_per_person: 20
    install_ratio:
      '0': 0
      '10': 0.3
      '100': 0.36
      '200': 0.41
      '450': 0.49
      '2300': 0.66
    tolerance: 100
  solid_biomass_potential: 360
  gas:
    spatial_gas: true
    network: false
    network_data: GGIT
    network_data_GGIT_status:
    - Construction
    - Operating
    - Idle
    - Shelved
    - Mothballed
    - Proposed
  coal:
    spatial_coal: true
    shift_to_elec: true
  lignite:
    spatial_lignite: false
  international_bunkers: false
  oil:
    spatial_oil: true
  district_heating:
    potential: 0.3
    progress: 1
    district_heating_loss: 0.15
  reduce_space_heat_exogenously: true
  reduce_space_heat_exogenously_factor: 0.29
  tes: true
  tes_tau:
    decentral: 3
    central: 180
  boilers: true
  oil_boilers: false
  chp: true
  micro_chp: false
  solar_thermal: true
  heat_pump_sink_T: 55
  time_dep_hp_cop: true
  solar_cf_correction: 0.788457
  bev_plug_to_wheel_efficiency: 0.2
  bev_charge_efficiency: 0.9
  transport_heating_deadband_upper: 20.0
  transport_heating_deadband_lower: 15.0
  ICE_lower_degree_factor: 0.375
  ICE_upper_degree_factor: 1.6
  EV_lower_degree_factor: 0.98
  EV_upper_degree_factor: 0.63
  bev_avail_max: 0.95
  bev_avail_mean: 0.8
  bev_dsm_restriction_value: 0.75
  bev_dsm_restriction_time: 7
  v2g: true
  bev_dsm: true
  bev_energy: 0.05
  bev_availability: 0.5
  transport_fuel_cell_efficiency: 0.5
  transport_internal_combustion_efficiency: 0.3
  industry_util_factor: 0.7
  biomass_transport_default_cost: 0.1
  biogas_potential: 0.5
  efficiency_heat_oil_to_elec: 0.9
  efficiency_heat_biomass_to_elec: 0.9
  efficiency_heat_gas_to_elec: 0.9
  electricity_distribution_grid: true
  home_battery: true
  transmission_efficiency:
    electricity distribution grid:
      efficiency_static: 0.97
    H2 pipeline:
      efficiency_per_1000km: 1
      compression_per_1000km: 0.017
  dynamic_transport:
    enable: false
    land_transport_electric_share:
      Co2L2.0: 0.0
      Co2L1.0: 0.01
      Co2L0.90: 0.03
      Co2L0.80: 0.06
      Co2L0.70: 0.1
      Co2L0.60: 0.17
      Co2L0.50: 0.27
      Co2L0.40: 0.4
      Co2L0.30: 0.55
      Co2L0.20: 0.69
      Co2L0.10: 0.8
      Co2L0.00: 0.88
    land_transport_fuel_cell_share:
      Co2L2.0: 0.01
      Co2L1.0: 0.01
      Co2L0.90: 0.01
      Co2L0.80: 0.01
      Co2L0.70: 0.01
      Co2L0.60: 0.01
      Co2L0.50: 0.01
      Co2L0.40: 0.01
      Co2L0.30: 0.01
      Co2L0.20: 0.01
      Co2L0.10: 0.01
      Co2L0.00: 0.01
  co2_sequestration_potential: 200
  co2_sequestration_cost: 10
  shipping_hydrogen_liquefaction: false
  shipping_average_efficiency: 0.4
  h2_cavern: true
  marginal_cost_storage: 0
  methanation: true
  helmeth: true
  dac: true
  cc_fraction: 0.9
  cc: true
  space_heat_share: 0.6
  airport_sizing_factor: 3
  fischer_tropsch: true
  min_part_load_fischer_tropsch: 0.9
  conventional_generation:
    OCGT: gas
    CCGT: gas
    oil: oil
    coal: coal
    lignite: lignite
    biomass: biomass
  keep_existing_capacities: false
solving:
  options:
    load_shedding: false
    formulation: kirchhoff
    noisy_costs: true
    min_iterations: 4
    max_iterations: 6
    clip_p_max_pu: 0.01
    skip_iterations: true
    track_iterations: false
  solver:
    name: gurobi
    options: gurobi-default
  solver_options:
    highs-default:
      threads: 4
      solver: ipm
      run_crossover: 'off'
      small_matrix_value: 1e-6
      large_matrix_value: 1e9
      primal_feasibility_tolerance: 1e-5
      dual_feasibility_tolerance: 1e-5
      ipm_optimality_tolerance: 1e-4
      parallel: 'on'
      random_seed: 123
    gurobi-default:
      threads: 4
      method: 2
      crossover: 0
      BarConvTol: 1.0e-06
      Seed: 123
      AggFill: 0
      PreDual: 0
      GURO_PAR_BARDENSETHRESH: 200
    gurobi-numeric-focus:
      NumericFocus: 3
      method: 2
      crossover: 0
      BarHomogeneous: 1
      BarConvTol: 1.0e-05
      FeasibilityTol: 0.0001
      OptimalityTol: 0.0001
      ObjScale: -0.5
      threads: 8
      Seed: 123
    gurobi-fallback:
      crossover: 0
      method: 2
      BarHomogeneous: 1
      BarConvTol: 1.0e-05
      FeasibilityTol: 1.0e-05
      OptimalityTol: 1.0e-05
      Seed: 123
      threads: 8
    cplex-default:
      threads: 4
      lpmethod: 4
      solutiontype: 2
      barrier.convergetol: 1.0e-05
      feasopt.tolerance: 1.0e-06
    copt-default:
      Threads: 8
      LpMethod: 2
      Crossover: 0
    cbc-default: {}
    glpk-default: {}
  mem: 30000
subregion:
  define_by_gadm:
    ID_Java-Bali:
    - ID.2_1
    - ID.4_1
    - ID.7_1
    - ID.9_1
    - ID.10_1
    - ID.11_1
    - ID.33_1
    ID_Kalimantan:
    - ID.12_1
    - ID.13_1
    - ID.14_1
    - ID.34_1
    - ID.35_1
    ID_Maluku:
    - ID.18_1
    - ID.19_1
    ID_Nusa-Tenggara:
    - ID.20_1
    - ID.21_1
    ID_Papua:
    - ID.22_1
    - ID.23_1
    ID_Sulawesi:
    - ID.6_1
    - ID.25_1
    - ID.26_1
    - ID.27_1
    - ID.28_1
    - ID.29_1
    ID_Sumatra:
    - ID.1_1
    - ID.3_1
    - ID.5_1
    - ID.8_1
    - ID.16_1
    - ID.17_1
    - ID.24_1
    - ID.30_1
    - ID.31_1
    - ID.32_1
    MY_Peninsular:
    - MY.1_1
    - MY.2_1
    - MY.3_1
    - MY.4_1
    - MY.6_1
    - MY.7_1
    - MY.8_1
    - MY.9_1
    - MY.10_1
    - MY.11_1
    - MY.12_1
    - MY.15_1
    - MY.16_1
    MY_Sabah:
    - MY.5_1
    - MY.13_1
    MY_Sarawak:
    - MY.14_1
    PH_Luzon:
    - PH.1_1
    - PH.5_1
    - PH.7_1
    - PH.8_1
    - PH.10_1
    - PH.11_1
    - PH.12_1
    - PH.13_1
    - PH.17_1
    - PH.18_1
    - PH.19_1
    - PH.20_1
    - PH.23_1
    - PH.24_1
    - PH.33_1
    - PH.34_1
    - PH.35_1
    - PH.37_1
    - H.38_1
    - PH.39_1
    - PH.40_1
    - PH.45_1
    - PH.46_1
    - PH.47_1
    - PH.50_1
    - PH.55_1
    - PH.56_1
    - PH.57_1
    - PH.58_1
    - PH.59_1
    - PH.60_1
    - PH.61_1
    - PH.62_1
    - PH.63_1
    - PH.64_1
    - PH.65_1
    - PH.69_1
    - PH.76_1
    - PH.78_1
    PH_Mindanao:
    - PH.2_1
    - PH.3_1
    - PH.9_1
    - PH.16_1
    - PH.21_1
    - PH.26_1
    - PH.27_1
    - PH.28_1
    - PH.29_1
    - PH.30_1
    - PH.41_1
    - PH.42_1
    - PH.44_1
    - PH.48_1
    - PH.49_1
    - PH.53_1
    - PH.67_1
    - PH.70_1
    - PH.72_1
    - PH.73_1
    - PH.74_1
    - PH.75_1
    - PH.77_1
    - PH.79_1
    - PH.80_1
    - PH.81_1
    PH_Visayas:
    - PH.4_1
    - PH.6_1
    - PH.14_1
    - PH.15_1
    - PH.22_1
    - PH.25_1
    - PH.31_1
    - PH.32_1
    - PH.36_1
    - PH.43_1
    - PH.51_1
    - PH.52_1
    - PH.54_1
    - PH.66_1
    - PH.68_1
    - PH.71_1
  enable:
    cluster_network: true
    simplify_network: true
  path_custom_shapes: false
  tolerance: 100
summary_dir: results/
transmission_projects:
  delay_construction: 0
  distance_upper_bound: 0.3
  enable: true
  include:
    AIMS: true
    ID_SuperGrid: true
  new_link_capacity: keep
  set_by_build_year: true
  skip: []
  status:
  - in_planning
  - under_construction
  - existing
  - under_consideration
version: 0.7.0
tutorial: false
logging:
  level: INFO
  format: '%(levelname)s:%(name)s:%(message)s'
custom_rules: []
snapshots:
  start: '2013-01-01'
  end: '2014-01-01'
  inclusive: left
crs:
  geo_crs: EPSG:4326
  distance_crs: EPSG:3857
  area_crs: ESRI:54009
natura:
  natura_size: countries
  natura_resolution: 100
  window_size: 10000
  buffer_size: 10000
augmented_line_connection:
  add_to_snakefile: false
  connectivity_upgrade: 2
  new_line_type:
  - HVAC
  min_expansion: 1
  min_DC_length: 600
clean_osm_data_options:
  names_by_shapes: true
  threshold_voltage: 51000
  tag_substation: transmission
  add_line_endings: true
  generator_name_method: OSM
  use_custom_lines: OSM_only
  path_custom_lines: false
  use_custom_substations: OSM_only
  path_custom_substations: false
  use_custom_cables: OSM_only
  path_custom_cables: false
build_osm_network:
  group_close_buses: true
  group_tolerance_buses: 5000
  split_overpassing_lines: true
  overpassing_lines_tolerance: 1
  force_ac: false
base_network:
  min_voltage_substation_offshore: 51000
  min_voltage_rebase_voltage: 51000
lines:
  ac_types:
    '132.0': 243-AL1/39-ST1A 20.0
    '220.0': Al/St 240/40 2-bundle 220.0
    '300.0': Al/St 240/40 3-bundle 300.0
    '380.0': Al/St 240/40 4-bundle 380.0
    '500.0': Al/St 240/40 4-bundle 380.0
    '750.0': Al/St 560/50 4-bundle 750.0
  dc_types:
    '500.0': HVDC XLPE 1000
  s_max_pu: 0.7
  s_nom_max: .inf
  s_nom_max_min: -.inf
  length_factor: 1.25
  under_construction: zero
links:
  p_max_pu: 1.0
  p_nom_max: .inf
  p_nom_max_min: -.inf
  under_construction: zero
transformers:
  x: 0.1
  s_nom: 2000.0
  type: ''
atlite:
  nprocesses: 4
  cutouts:
    cutout-2013-era5:
      module: era5
      dx: 0.3
      dy: 0.3
renewable:
  onwind:
    cutout: cutout-2013-era5
    resource:
      method: wind
      turbine: Vestas_V112_3MW
    capacity_per_sqkm: 3
    copernicus:
      grid_codes:
      - 20
      - 30
      - 40
      - 60
      - 100
      - 111
      - 112
      - 113
      - 114
      - 115
      - 116
      - 121
      - 122
      - 123
      - 124
      - 125
      - 126
      distance: 1000
      distance_grid_codes:
      - 50
    natura: true
    potential: simple
    clip_p_max_pu: 0.01
    extendable: true
  offwind-ac:
    cutout: cutout-2013-era5
    resource:
      method: wind
      turbine: NREL_ReferenceTurbine_5MW_offshore
    capacity_per_sqkm: 2
    copernicus:
      grid_codes:
      - 80
      - 200
    natura: true
    max_depth: 50
    max_shore_distance: 30000
    potential: simple
    clip_p_max_pu: 0.01
    extendable: true
  offwind-dc:
    cutout: cutout-2013-era5
    resource:
      method: wind
      turbine: NREL_ReferenceTurbine_5MW_offshore
    capacity_per_sqkm: 3
    copernicus:
      grid_codes:
      - 80
      - 200
    natura: true
    max_depth: 50
    min_shore_distance: 30000
    potential: simple
    clip_p_max_pu: 0.01
    extendable: true
  solar:
    cutout: cutout-2013-era5
    resource:
      method: pv
      panel: CSi
      orientation: latitude_optimal
    capacity_per_sqkm: 4.6
    correction_factor: 0.854337
    copernicus:
      grid_codes:
      - 20
      - 30
      - 40
      - 50
      - 60
      - 90
      - 100
    natura: true
    potential: simple
    clip_p_max_pu: 0.01
    extendable: true
  hydro:
    cutout: cutout-2013-era5
    hydrobasins_level: 6
    resource:
      method: hydro
      hydrobasins: data/hydrobasins/hybas_world.shp
      flowspeed: 1.0
    carriers:
    - ror
    - PHS
    - hydro
    PHS_max_hours: 6
    hydro_max_hours: energy_capacity_totals_by_country
    hydro_max_hours_default: 6.0
    clip_min_inflow: 1.0
    extendable: true
    normalization:
      method: irena
      year: 2023
    multiplier: 1.1
    hydro_min_inflow_pu: 1.0
  csp:
    cutout: cutout-2013-era5
    resource:
      method: csp
      installation: SAM_solar_tower
    capacity_per_sqkm: 2.392
    copernicus:
      grid_codes:
      - 20
      - 30
      - 40
      - 60
      - 90
      distancing_codes:
      - 50
      distance_to_codes: 3000
    natura: true
    potential: simple
    clip_p_max_pu: 0.01
    extendable: true
    csp_model: advanced
monte_carlo:
  options:
    add_to_snakefile: false
    samples: 9
    sampling_strategy: chaospy
    seed: 42
  uncertainties:
    loads_t.p_set:
      type: uniform
      args:
      - 0.5
      - 1
    generators_t.p_max_pu.loc[:, n.generators.carrier == "onwind"]:
      type: lognormal
      args:
      - 1.5
    generators_t.p_max_pu.loc[:, n.generators.carrier == "solar"]:
      type: beta
      args:
      - 0.5
      - 2
fossil_reserves:
  oil: 100
custom_data:
  renewables: []
  elec_demand: false
  heat_demand: false
  industry_demand: false
  industry_database: false
  transport_demand: false
  water_costs: false
  h2_underground: false
  add_existing: false
  custom_sectors: false
  gas_network: false
  export_ports: false
  airports: false
industry:
  reference_year: 2015
solar_thermal:
  clearsky_model: simple
  orientation:
    slope: 45.0
    azimuth: 180.0
existing_capacities:
  grouping_years_power:
  - 1960
  - 1965
  - 1970
  - 1975
  - 1980
  - 1985
  - 1990
  - 1995
  - 2000
  - 2005
  - 2010
  - 2015
  - 2020
  - 2025
  - 2030
  grouping_years_heat:
  - 1980
  - 1985
  - 1990
  - 1995
  - 2000
  - 2005
  - 2010
  - 2015
  - 2019
  threshold_capacity: 10
  default_heating_lifetime: 20
  conventional_carriers:
  - lignite
  - coal
  - oil
  - uranium
plotting:
  map:
    figsize:
    - 7
    - 7
    boundaries:
    - -10.2
    - 29
    - 35
    - 72
    p_nom:
      bus_size_factor: 50000.0
      linewidth_factor: 3000.0
    color_geomap:
      ocean: white
      land: whitesmoke
  costs_max: 10
  costs_threshold: 0.2
  energy_max: 20000
  energy_min: -20000
  energy_threshold: 15
  vre_techs:
  - onwind
  - offwind-ac
  - offwind-dc
  - solar
  - ror
  conv_techs:
  - OCGT
  - CCGT
  - nuclear
  - Nuclear
  - coal
  - oil
  storage_techs:
  - hydro+PHS
  - battery
  - H2
  renewable_storage_techs:
  - PHS
  - hydro
  load_carriers:
  - AC load
  AC_carriers:
  - AC line
  - AC transformer
  link_carriers:
  - DC line
  - Converter AC-DC
  heat_links:
  - heat pump
  - resistive heater
  - CHP heat
  - CHP electric
  - gas boiler
  - central heat pump
  - central resistive heater
  - central CHP heat
  - central CHP electric
  - central gas boiler
  heat_generators:
  - gas boiler
  - central gas boiler
  - solar thermal collector
  - central solar thermal collector
  tech_colors:
    onwind: '#235ebc'
    onshore wind: '#235ebc'
    offwind: '#6895dd'
    offwind-ac: '#6895dd'
    offshore wind: '#6895dd'
    offshore wind ac: '#6895dd'
    offshore wind (AC): '#6895dd'
    offwind-dc: '#74c6f2'
    offshore wind dc: '#74c6f2'
    offshore wind (DC): '#74c6f2'
    wave: '#004444'
    hydro: '#08ad97'
    hydro+PHS: '#08ad97'
    PHS: '#08ad97'
    hydro reservoir: '#08ad97'
    hydroelectricity: '#08ad97'
    ror: '#4adbc8'
    run of river: '#4adbc8'
    solar: '#f9d002'
    solar PV: '#f9d002'
    solar thermal: '#ffef60'
    solar rooftop: '#ffef60'
    biomass: '#0c6013'
    solid biomass: '#06540d'
    solid biomass for industry co2 from atmosphere: '#654321'
    solid biomass for industry co2 to stored: '#654321'
    solid biomass for industry CC: '#654321'
    biogas: '#23932d'
    waste: '#68896b'
    geothermal: '#ba91b1'
    OCGT: '#d35050'
    OCGT marginal: sandybrown
    OCGT-heat: '#ee8340'
    CCGT: '#b80404'
    gas: '#d35050'
    natural gas: '#d35050'
    gas boiler: '#ee8340'
    gas boilers: '#ee8340'
    gas boiler marginal: '#ee8340'
    gas-to-power/heat: brown
    SMR: '#4F4F2F'
    SMR CC: darkblue
    oil: '#262626'
    oil boiler: '#B5A642'
    oil emissions: '#666666'
    gas for industry: '#333333'
    gas for industry CC: brown
    gas for industry co2 to atmosphere: '#654321'
    gas for industry co2 to stored: '#654321'
    nuclear: '#ff9000'
    Nuclear: r
    Nuclear marginal: r
    uranium: r
    coal: '#707070'
    Coal: k
    Coal marginal: k
    lignite: '#9e5a01'
    Lignite: grey
    Lignite marginal: grey
    H2: '#ea048a'
    H2 for industry: '#222222'
    H2 for shipping: '#6495ED'
    H2 liquefaction: m
    hydrogen storage: '#ea048a'
    battery: slategray
    battery discharger: slategray
    battery charger: slategray
    battery storage: slategray
    home battery: '#614700'
    home battery storage: '#614700'
    lines: '#70af1d'
    transmission lines: '#70af1d'
    AC: '#70af1d'
    AC-AC: '#70af1d'
    AC line: '#70af1d'
    links: '#8a1caf'
    HVDC links: '#8a1caf'
    DC: '#8a1caf'
    DC-DC: '#8a1caf'
    DC link: '#8a1caf'
    load: '#ff0000'
    load shedding: '#ff0000'
    Electric load: b
    electricity: k
    electric demand: k
    electricity distribution grid: y
    heat: darkred
    Heat load: r
    heat pumps: '#76EE00'
    heat pump: '#76EE00'
    air heat pump: '#76EE00'
    ground heat pump: '#40AA00'
    CHP: r
    CHP heat: r
    CHP electric: r
    heat demand: darkred
    rural heat: '#880000'
    central heat: '#b22222'
    decentral heat: '#800000'
    low-temperature heat for industry: '#991111'
    process heat: '#FF3333'
    power-to-heat: red
    resistive heater: pink
    Sabatier: '#FF1493'
    methanation: '#FF1493'
    power-to-gas: purple
    power-to-liquid: darkgreen
    helmeth: '#7D0552'
    DAC: deeppink
    co2 stored: '#123456'
    CO2 pipeline: gray
    CO2 sequestration: '#123456'
    co2: '#123456'
    co2 vent: '#654321'
    process emissions: '#222222'
    process emissions CC: gray
    process emissions to stored: '#444444'
    process emissions to atmosphere: '#888888'
    agriculture heat: '#D07A7A'
    agriculture machinery oil: '#1e1e1e'
    agriculture machinery oil emissions: '#111111'
    agriculture electricity: '#222222'
    Fischer-Tropsch: '#44DD33'
    kerosene for aviation: '#44BB11'
    naphtha for industry: '#44FF55'
    land transport oil: '#44DD33'
    land transport oil emissions: '#666666'
    land transport fuel cell: '#AAAAAA'
    land transport EV: grey
    V2G: grey
    BEV charger: grey
    shipping: '#6495ED'
    shipping oil: '#6495ED'
    shipping oil emissions: '#6495ED'
    water tanks: '#BBBBBB'
    hot water storage: '#BBBBBB'
    hot water charging: '#BBBBBB'
    hot water discharging: '#999999'
    Li ion: grey
    district heating: '#CC4E5C'
    retrofitting: purple
    building retrofitting: purple
    solid biomass transport: green
    biomass EOP: green
    high-temp electrolysis: magenta
    today: '#D2691E'
    Ambient: k
    industry coal emissions: '#654321'
    agriculture oil: '#1e1e1e'
    gas emissions: '#666666'
    industry oil emissions: '#654321'
    industry electricity: '#222222'
    rail transport electricity: grey
    solid biomass for industry: '#654321'
    rail transport oil: '#44DD33'
    low voltage: y
  nice_names:
    OCGT: Open-Cycle Gas
    CCGT: Combined-Cycle Gas
    offwind-ac: Offshore Wind (AC)
    offwind-dc: Offshore Wind (DC)
    onwind: Onshore Wind
    solar: Solar
    PHS: Pumped Hydro Storage
    hydro: Reservoir & Dam
    battery: Battery Storage
    H2: Hydrogen Storage
    lines: Transmission Lines
    ror: Run of River
databundles:
  bundle_tutorial_NGBJ:
    countries:
    - NG
    - BJ
    tutorial: true
    category: data
    destination: data
    urls:
      zenodo: https://sandbox.zenodo.org/records/323571/files/bundle_tutorial_NGBJ_with_gadmlike.zip?download=1
      gdrive: https://drive.google.com/file/d/1XnTP6bZoVl5kFjZQlAcmjNXgazOHtFqX/view?usp=drive_link
    output:
    - data/gebco/GEBCO_2025_sub_ice.nc
    - data/copernicus/PROBAV_LC100_global_v3.0.1_2019-nrt_Discrete-Classification-map_EPSG-4326.tif
    - data/gadm/gadm41_NGA/gadm41_NGA.gpkg
    - data/gadm/gadm41_BEN/gadm41_BEN.gpkg
    - data/gadm/gadm36_NGA/gadm36_NGA.gpkg
    - data/gadm/gadm36_BEN/gadm36_BEN.gpkg
  bundle_tutorial_NGBJ_global_buildings:
    countries:
    - NG
    - BJ
    tutorial: true
    category: global_buildings
    destination: data
    urls:
      gdrive: https://drive.google.com/file/d/1nnseF1A740Gp0IaryeCQ8IRcEF91-aUe/view?usp=drive_link
    output:
    - data/global_buildings/NG_global_buildings_raw.parquet
    - data/global_buildings/BJ_global_buildings_raw.parquet
  bundle_tutorial_BW:
    countries:
    - BW
    tutorial: true
    category: data
    destination: data
    urls:
      zenodo: https://sandbox.zenodo.org/records/323571/files/bundle_tutorial_BW_with_gadmlike.zip?download=1
      gdrive: https://drive.google.com/file/d/1AEmlgBO-6uY_MA4rzmaRJcQ-xE1Z4uHx/view?usp=drive_link
    output:
    - data/gebco/GEBCO_2025_sub_ice.nc
    - data/copernicus/PROBAV_LC100_global_v3.0.1_2019-nrt_Discrete-Classification-map_EPSG-4326.tif
    - data/gadm/gadm41_BWA/gadm41_BWA.gpkg
    - data/gadm/gadm36_BWA/gadm36_BWA.gpkg
  bundle_tutorial_MA:
    countries:
    - MA
    tutorial: true
    category: data
    destination: data
    urls:
      zenodo: https://sandbox.zenodo.org/records/323571/files/bundle_tutorial_MA.zip?download=1
      gdrive: https://drive.google.com/file/d/1cUei9vH3LzIYfqltaGTaRWCX6J24f1c0/view?usp=drive_link
    output:
    - data/gebco/GEBCO_2025_sub_ice.nc
    - data/copernicus/PROBAV_LC100_global_v3.0.1_2019-nrt_Discrete-Classification-map_EPSG-4326.tif
  bundle_tutorial_hydrobasins:
    countries:
    - Africa
    tutorial: true
    category: hydrobasins
    destination: data/hydrobasins
    urls:
      hydrobasins:
        base_url: https://data.hydrosheds.org/file/HydroBASINS/standard/
        suffixes:
        - af
    unzip: true
    output:
    - data/hydrobasins/hybas_world.shp
  bundle_cutouts_tutorial_NGBJ:
    countries:
    - NG
    - BJ
    tutorial: true
    category: cutouts
    destination: cutouts
    urls:
      zenodo: https://sandbox.zenodo.org/records/323571/files/bundle_cutouts_tutorial_NGBJ.zip?download=1
      gdrive: https://drive.google.com/file/d/1xnomHdXf_c5STrf7jtDiuRlN2zW0FSVC/view?usp=drive_link
    output:
    - cutouts/cutout-2013-era5-tutorial.nc
    disable_by_opt:
      build_cutout:
      - all
  bundle_cutouts_tutorial_BW:
    countries:
    - BW
    tutorial: true
    category: cutouts
    destination: cutouts
    urls:
      zenodo: https://sandbox.zenodo.org/records/323571/files/bundle_cutouts_tutorial_BW.zip?download=1
      gdrive: https://drive.google.com/file/d/1DDQAtnIDM0FNC3vCldfHeH__IpTbyIJt/view?usp=drive_link
    output:
    - cutouts/cutout-2013-era5-tutorial.nc
    disable_by_opt:
      build_cutout:
      - all
  bundle_cutouts_tutorial_MA:
    countries:
    - MA
    tutorial: true
    category: cutouts
    destination: cutouts
    urls:
      zenodo: https://sandbox.zenodo.org/records/323571/files/bundle_cutouts_tutorial_MA.zip?download=1
      gdrive: https://drive.google.com/file/d/1j5v2f4E756jmDMa707QvdNJq3xM4bYUk/view?usp=drive_link
    output:
    - cutouts/cutout-2013-era5-tutorial.nc
    disable_by_opt:
      build_cutout:
      - all
  bundle_cutouts_test_KZ:
    countries:
    - KZ
    category: cutouts
    destination: cutouts
    urls:
      zenodo: https://sandbox.zenodo.org/records/69756/files/bundle_tutorial_cutouts_KZ.zip?download=1
    output:
    - cutouts/cutout-2013-era5-tutorial.nc
    disable_by_opt:
      build_cutout:
      - all
  bundle_tutorial_data_common:
    countries:
    - Africa
    tutorial: true
    category: common
    destination: data
    urls:
      zenodo: https://sandbox.zenodo.org/records/323571/files/tutorial_data_general.zip?download=1
      gdrive: https://drive.google.com/file/d/1nRLrs_kP0qVl-IHC4BFLjpoKa3HLk2Py/view
    output:
    - data/eez/eez_v11.gpkg
    - data/ssp2-2.6/2030/era5_2013/Africa.nc
    - data/ssp2-2.6/2030/era5_2013/Asia.nc
    - data/ssp2-2.6/2030/era5_2013/Europe.nc
    - data/ssp2-2.6/2030/era5_2013/NorthAmerica.nc
    - data/ssp2-2.6/2030/era5_2013/SouthAmerica.nc
    - data/ssp2-2.6/2030/era5_2013/Oceania.nc
    - data/landcover/world_protected_area/protected_areas_tutorial.shp
  bundle_hydrobasins:
    countries:
    - Earth
    tutorial: false
    category: hydrobasins
    destination: data/hydrobasins
    urls:
      hydrobasins:
        base_url: https://data.hydrosheds.org/file/HydroBASINS/standard/
        suffixes:
        - af
        - ar
        - as
        - au
        - eu
        - gr
        - na
        - sa
        - si
    unzip: true
    output:
    - data/hydrobasins/hybas_world.shp
  bundle_data_earth:
    countries:
    - Earth
    category: common
    destination: data
    urls:
      zenodo: https://sandbox.zenodo.org/records/323567/files/bundle_data_earth.zip?download=1
      gdrive: https://drive.google.com/file/d/1P4uMY464lgcp--8fAEYIJbKeNmHdg1Re/view?usp=drive_link
    output:
    - data/eez/eez_v11.gpkg
    - data/gebco/GEBCO_2025_sub_ice.nc
    - data/copernicus/PROBAV_LC100_global_v3.0.1_2019-nrt_Discrete-Classification-map_EPSG-4326.tif
    - data/ssp2-2.6/2030/era5_2013/Africa.nc
    - data/ssp2-2.6/2030/era5_2013/Asia.nc
    - data/ssp2-2.6/2030/era5_2013/Europe.nc
    - data/ssp2-2.6/2030/era5_2013/NorthAmerica.nc
    - data/ssp2-2.6/2030/era5_2013/SouthAmerica.nc
    - data/ssp2-2.6/2030/era5_2013/Oceania.nc
  bundle_natura_earth:
    countries:
    - Earth
    category: natura
    destination: data/natura/
    urls:
      zenodo: https://sandbox.zenodo.org/records/323567/files/natura_wpda_CC0.zip?download=1
      gdrive: https://drive.google.com/file/d/1H-Y7p8UgnbEzJgo9qPc54BpDXS8loX7Y/view?usp=drive_link
    output:
    - data/natura/natura.tiff
  bundle_cutouts_mainland_africa:
    countries:
    - Africa
    category: cutouts
    destination: cutouts
    urls:
      zenodo: https://sandbox.zenodo.org/records/323567/files/bundle_cutouts_africa.zip?download=1
      gdrive: https://drive.google.com/file/d/1WHv5Dm1GtrDZj-AxJZd3T-NMIBXty3eV/view?usp=drive_link
    output:
    - cutouts/cutout-2013-era5.nc
    disable_by_opt:
      build_cutout:
      - all
  bundle_cutouts_northamerica:
    countries:
    - NorthAmerica
    category: cutouts
    destination: cutouts
    urls:
      gdrive: https://drive.google.com/file/d/1Ao_kuHssRaP1qLV-IEG91Hu7E04-nBZg/view?usp=drive_link
    output:
    - cutouts/cutout-2013-era5.nc
    disable_by_opt:
      build_cutout:
      - all
  bundle_cutouts_europe:
    countries:
    - Europe
    category: cutouts
    destination: cutouts
    urls:
      gdrive: https://drive.google.com/file/d/1c2-8pChoxv4CDJW01vkPpggBSWHs9Mqi/view?usp=drive_link
    output:
    - cutouts/cutout-2013-era5.nc
    disable_by_opt:
      build_cutout:
      - all
  bundle_cutouts_oceania:
    countries:
    - Oceania
    category: cutouts
    destination: cutouts
    urls:
      gdrive: https://drive.google.com/file/d/1R8ELkXmW8jBBUFWRY0sbf-T14SJl4EUY/view?usp=sharing
    output:
    - cutouts/cutout-2013-era5.nc
    disable_by_opt:
      build_cutout:
      - all
  bundle_cutouts_asia:
    countries:
    - KVR
    - WAS
    - FEAR
    - SEAR
    - CASR
    - SASR
    - ASEAN
    - MEAR
    category: cutouts
    destination: cutouts
    urls:
      gdrive: https://drive.google.com/file/d/11-Ax9tVks7oPjrZwG5v3C0x4OmMT_Pv8/view?usp=sharing
    output:
    - cutouts/cutout-2013-era5.nc
    disable_by_opt:
      build_cutout:
      - all
  bundle_cutouts_southamerica:
    countries:
    - SouthAmerica
    category: cutouts
    destination: cutouts
    urls:
      gdrive: https://drive.google.com/file/d/1Jeu2Vzoq4mNDUKSvIviN8HqSFx5gl61b/view?usp=sharing
    output:
    - cutouts/cutout-2013-era5.nc
    disable_by_opt:
      build_cutout:
      - all
  bundle_cutouts_westernasia:
    countries:
    - WAS
    category: cutouts
    destination: cutouts
    urls:
      gdrive: https://drive.google.com/file/d/1as-fZS4Z70CfDf3bR4i9t9S5-5pBqURP/view?usp=sharing
    output:
    - cutouts/cutout-2013-era5.nc
    disable_by_opt:
      build_cutout:
      - all
  bundle_landcover_earth:
    countries:
    - Earth
    category: landcover
    destination: data/landcover/world_protected_areas
    urls:
      protectedplanet: https://d1gam3xoknrgr2.cloudfront.net/current/WDPA_{month:s}{year:d}_Public_shp.zip
    output:
    - data/landcover/world_protected_areas/*
entsoe_token: null
google_api_key: null
matching_sources:
- GPD
- GBPT
- GGPT
- GCPT
- GGTPT
- GNPT
- GSPT
- GWPT
- GHPT
fully_included_sources:
- GPD
- GBPT
- GGPT
- GCPT
- GGTPT
- GNPT
- GSPT
- GWPT
- GHPT
EXTERNAL_DATABASE:
  reliability_score: 5
  store_locally: false
  fn: /data/davidef/git/pypsa-earth/resources/powerplants_osm2pm.csv
parallel_duke_processes: false
process_limit: 2
remove_missing_coords: true
matched_data_url: null
display_net_caps: true
target_columns:
- Name
- Fueltype
- Technology
- Set
- Country
- Capacity
- Efficiency
- Duration
- Volume_Mm3
- DamHeight_m
- StorageCapacity_MWh
- DateIn
- DateRetrofit
- DateOut
- lat
- lon
- EIC
- projectID
target_fueltypes:
  Other: .*
  Bioenergy:
  - biological
  - biogas
  - bioenergy
  - agricultural
  - wood
  - biomass
  Nuclear:
  - nuclear
  Natural Gas:
  - ccgt
  - gas
  - natural gas
  - ocgt
  - lng
  - combined cycle
  - fossil gas
  - mixed fossil fuels
  Hydro:
  - run-off
  - run off
  - run of river
  - run-of-river
  - ror
  - hydro
  - hydroelectric
  - wasserkraft
  Hard Coal:
  - coal
  - coke
  Lignite:
  - brown coal
  - lignite
  - peat
  Oil:
  - oil
  - diesel
  Geothermal: ''
  Solar: ''
  Waste: ''
  Wind: ''
  Battery:
  - Electro-chemical
  - battery
target_sets:
  PP: .*
  CHP:
  - heizkraftwerk
  - hkw
  - kwk
  - fhkw
  - gud
  - hp
  - bhkw
  - cogeneration
  - power and heat
  - heat and power
  - chp
  Store:
  - battery
  - storage
  - store
target_technologies:
  CCGT:
  - ccgt
  - gas
  - natural gas
  OCGT:
  - ocgt
  Steam Turbine:
  - steam
  - turbine
  Combustion Engine:
  - combustion engine
  Run-Of-River:
  - run-off
  - run off
  - run of river
  - run-of-river
  - ror
  Pumped Storage:
  - pumped hydro
  - pumped
  Reservoir: ''
  Marine: ''
  Onshore: ''
  Offshore: ''
  PV:
  - pv
  - photo-voltaic
  - photo voltaic
  CSP: ''
clean_name:
  remove_common_words: false
  remove_duplicated_words: true
  replace:
    ' ': '[^a-zA-Z]'
    ? ''
    : - I
      - II
      - III
      - IV
      - V
      - VI
      - VII
      - VIII
      - IX
      - X
      - XI
      - parque
      - grupo
      - station
      - power
      - plant
      - unit
      - kraftwerk
      - kw
      - hkw
      - nuclear
      - thermal
      - heizkraftwerk
      - eolico
      - project
      - hydroelectric
      - pumped
      - storage
      - france
      - austria
      - sweden
      - serbia
      - ukraine
      - switzerland
      - slovakia
      - croatia
      - poland
      - slovenia
      - portugal
      - bosnia
      - and
      - herzegovina
      - \w
    ss: "\xDF"
fuel_to_lifetime:
  Bioenergy: 20
  Geothermal: 15
  Hard Coal: 45
  Hydro: 100
  Lignite: 45
  Natural Gas: 40
  Nuclear: 50
  Oil: 40
  Other: 5
  Solar: 25
  Waste: 25
  Wind: 25
fuel_to_color:
  OCGT: darkorange
  Hydro: seagreen
  Pumped hydro: limegreen
  Run-of-river: navy
  Ror: navy
  Lignite: saddlebrown
  Nuclear: yellow
  Solar: gold
  Windoff: cornflowerblue
  Windon: darkblue
  Offshore: cornflowerblue
  Onshore: darkblue
  Wind: steelblue
  Bioenergy: forestgreen
  Natural Gas: red
  CCGT: red
  Coal: black
  Hard Coal: dimgray
  Oil: black
  Other: silver
  Waste: grey
  Geothermal: orange
  Battery: purple
  Hydrogen Storage: teal
  Electro-mechanical: teal
  Total: gold
git_commit: 5bacad702ccfed17ad19ab510fa710651e966f2c drop biomass generator if biomass
  limit is set, extend scenarios
wildcards:
  simpl: ''
  clusters: '100'
  ll: v2.0
  opts: ''
  sopts: 3h
  planning_horizons: '2025'
  discountrate: '0.071'
  demand: DEC
  h2export: '0'
