cyc292cycjin-oss/SGP-ESE5004-Stage2/configs/config.asean.yaml

# SPDX-FileCopyrightText:  PyPSA-ASEAN, PyPSA-Earth and PyPSA-Eur Authors
#
# SPDX-License-Identifier: AGPL-3.0-or-later

version: 0.8.0
tutorial: false

foresight: myopic

run:
  name: baseline-aims-3H # use this to keep track of runs with different settings
  sector_name: baseline-aims-3H
  shared_cutouts: true  # set to true to share the default cutout(s) across runs
                        # Note: value false requires build_cutout to be enabled

results_dir: results/
summary_dir: results/

scenario:
  clusters: [100]
  ll:
  - "v2.0"
  opts:
  - ""
  planning_horizons: # investment years for myopic and perfect; or costs year for overnight
  - 2025
  - 2030
  - 2035
  - 2040
  - 2045
  - 2050
  sopts:
  - "3h"
  demand:
  - "DEC"

snapshots:
  start: "2013-01-01"
  end: "2014-01-01"
  inclusive: "left" # end is not inclusive

countries: [BN, KH, ID, LA, MM, MY, PH, SG, TH, TL, VN]

enable:
  retrieve_databundle: true #  Recommended 'true', for the first run. Otherwise data might be missing.
  retrieve_cost_data: true # true: retrieves cost data from technology data and saves in resources/costs.csv, false: uses cost data in data/costs.csv
  retrieve_cutout: true
  download_osm_data: true # If 'true', OpenStreetMap data will be downloaded for the above given countries
  download_global_buildings: true # If 'true', GlobalMLBuildingFootprints data will be downloaded for the above given countries
  build_natura_raster: false # Always set as 'false' in PyPSA-ASEAN.
  build_cutout: false
  # If "build_cutout" : true, then environmental data is extracted according to `snapshots` date range and `countries`
  # requires cds API key https://cds.climate.copernicus.eu/how-to-api
  # More information https://atlite.readthedocs.io/en/latest/introduction.html#datasets
  progress_bar: true # show progress bar during downloading routines and other long-running tasks
  custom_busmap: false # if true, use "data/custom_busmap_elec_s{simpl}_{clusters}.csv" for the clustering instead of the clustering algorithms

# =================== GEOGRAPHY & SHAPES ===================

# ------------------- Regional shapes -------------------
build_shape_options:
  simplify_gadm: false

# ------------------- Subregions -------------------
subregion:
  method: custom
  apply_on: ["simplify_network", "cluster_network", "final_adjustment"]
  define_by_gadm:
    ID_Java-Bali: [ID.2_1, ID.4_1, ID.7_1, ID.9_1, ID.10_1, ID.11_1, ID.33_1]
    ID_Kalimantan: [ID.12_1, ID.13_1, ID.14_1, ID.34_1, ID.35_1]
    ID_Maluku: [ID.18_1, ID.19_1]
    ID_Nusa-Tenggara: [ID.20_1, ID.21_1]
    ID_Papua: [ID.22_1, ID.23_1]
    ID_Sulawesi: [ID.6_1, ID.25_1, ID.26_1, ID.27_1, ID.28_1, ID.29_1]
    ID_Sumatra: [ID.1_1, ID.3_1, ID.5_1, ID.8_1, ID.16_1, ID.17_1, ID.24_1, ID.30_1, ID.31_1, ID.32_1]
    MY_Peninsular: [MY.1_1, MY.2_1, MY.3_1, MY.4_1, MY.6_1, MY.7_1, MY.8_1, MY.9_1, MY.10_1, MY.11_1, MY.12_1, MY.15_1, MY.16_1]
    MY_Sabah: [MY.5_1, MY.13_1]
    MY_Sarawak: [MY.14_1]
    PH_Luzon: [PH.1_1, PH.5_1, PH.7_1, PH.8_1, PH.10_1, PH.11_1, PH.12_1, PH.13_1, PH.17_1, PH.18_1, PH.19_1, PH.20_1, PH.23_1, PH.24_1, PH.33_1, PH.34_1, PH.35_1, PH.37_1, H.38_1, PH.39_1, PH.40_1, PH.45_1, PH.46_1, PH.47_1, PH.50_1, PH.55_1, PH.56_1, PH.57_1, PH.58_1, PH.59_1, PH.60_1, PH.61_1, PH.62_1, PH.63_1, PH.64_1, PH.65_1, PH.69_1, PH.76_1, PH.78_1]
    PH_Visayas: [PH.4_1, PH.6_1, PH.14_1, PH.15_1, PH.22_1, PH.25_1, PH.31_1, PH.32_1, PH.36_1, PH.43_1, PH.51_1, PH.52_1, PH.54_1, PH.66_1, PH.68_1, PH.71_1]
    PH_Mindanao: [PH.2_1, PH.3_1, PH.9_1, PH.16_1, PH.21_1, PH.26_1, PH.27_1, PH.28_1, PH.29_1, PH.30_1, PH.41_1, PH.42_1, PH.44_1, PH.48_1, PH.49_1, PH.53_1, PH.67_1, PH.70_1, PH.72_1, PH.73_1, PH.74_1, PH.75_1, PH.77_1, PH.79_1, PH.80_1, PH.81_1]
  path_custom_shapes: "data/custom_subregion/asean_custom_shapes.geojson"
  path_custom_offshore: "data/custom_subregion/asean_custom_offshore.geojson"

# ------------------- Clustering -------------------
clustering:
  simplify_network:
    remove_stubs_across_borders: false
    p_threshold_drop_isolated: 0 # [MW] isolated buses are being discarded if bus mean power is below the specified threshold
    p_threshold_merge_isolated: 0 # [MW] isolated buses are being merged into a single isolated bus if a bus mean power is below the specified threshold
    s_threshold_fetch_isolated: 0.1 # [-] a share of the national load for merging an isolated network into a backbone network
  focus_weights:
    BN: 0.0
    KH: 0.046396
    LA: 0.058770
    MM: 0.169951
    SG: 0.0
    TH: 0.131035
    TL: 0.0
    VN: 0.084013
    ID_Java-Bali: 0.035281
    ID_Kalimantan: 0.135732
    ID_Maluku: 0.0
    ID_Nusa-Tenggara: 0.016782
    ID_Papua: 0.0
    ID_Sulawesi: 0.046963
    ID_Sumatra: 0.120713
    MY_Peninsular: 0.033556
    MY_Sarawak: 0.031638
    MY_Sabah: 0.018709
    PH_Luzon: 0.023487
    PH_Visayas: 0.023487
    PH_Mindanao: 0.023487

# =================== NETWORK & RESOURCES ===================

# ------------------- Demand -------------------
load_options:
  source: "demcast"

# ------------------- Electricity grid -------------------
electricity:
  base_network: osm-plus-prebuilt
  base_network_version: 0.1.1
  # ----------------- Electricity generation -------------------
  extendable_carriers:
    Generator: [solar, onwind, offwind-ac, offwind-dc, OCGT, CCGT]


transmission_projects:
  enable: true
  include:
    ID_SuperGrid: true
    AIMS: true
  skip: []
  status:
  - in_planning
  - under_construction
  - existing
  - under_consideration
  new_link_capacity: keep #keep or zero
  distance_upper_bound: 0.3
  set_by_build_year: true
  delay_construction: 0

# ------------------- Weather & renewables -------------------
atlite:
  nprocesses: 4
  cutouts:
    asean-2013-era5:
      module: era5
      dx: 0.3 # cutout resolution
      dy: 0.3 # cutout resolution
      # The cutout time is automatically set by the snapshot range. See `snapshot:` option above and 'build_cutout.py'.
      # time: ["2013-01-01", "2014-01-01"]  # to manually specify a different weather year (~70 years available)
      # The cutout spatial extent [x,y] is automatically set by country selection. See `countires:` option above and 'build_cutout.py'.
      # x: [-12., 35.]  # set cutout range manual, instead of automatic by boundaries of country
      # y: [33., 72]    # manual set cutout range
    asean-2013-era5-tutorial:
      module: era5
      dx: 0.3 # cutout resolution
      dy: 0.3 # cutout resolution
      time: ["2013-03-01", "2013-03-07"]  # to manually specify a different weather year (~70 years available)
  default: asean-2013-era5

# ------------------- Costs & emissions -------------------
costs:
  append_cost_data: true
  regional_factor: false

co2:
  budget:
    enable: false
    override_co2opt: true
    base_value: 1.0e+09 # absolute base in tCO2/year; scaled by year factors
    year:
      2025: 1.0
      2030: 0.82
      2035: 0.64
      2040: 0.46
      2045: 0.28
      2050: 0.1

# =================== SECTOR OPTIONS ===================

# ------------------- Hydrogen policy & export -------------------
policy_config:
  hydrogen:
    temporal_matching: "no_temporal_matching"

export:
  enable: false
  h2export: [0]


# ------------------- Enabled sectors & fuel infrastructure -------------------
sector:
  enable:
    heat: true
    biomass: true
    industry: true
    shipping: true
    aviation: true
    land_transport: true
    rail_transport: true
    agriculture: true
    residential: true
    services: true

  hydrogen:
    network: false

  # ------------------- Heat sector -------------------
  # ------------------- Land transport sector -------------------

  land_transport_fuel_cell_share:
    DEC_2020: 0.00
    DEC_2025: 0.00
    DEC_2030: 0.00
    DEC_2035: 0.00
    DEC_2040: 0.00
    DEC_2045: 0.00
    DEC_2050: 0.00
  land_transport_electric_share:
    DEC_2020: 0
    DEC_2025: 0.05
    DEC_2030: 0.2
    DEC_2035: 0.45
    DEC_2040: 0.7
    DEC_2045: 0.85
    DEC_2050: 1
  shipping_hydrogen_share:
    DEC_2020: 0.00
    DEC_2025: 0.00
    DEC_2030: 0.00
    DEC_2035: 0.00
    DEC_2040: 0.00
    DEC_2045: 0.00
    DEC_2050: 0.00

  # ------------------- Biomass sector -------------------

  biomass_transport: false
  solid_biomass_potential: 360 # TWh/a, technical maximum in Southeast Asia (higher granular data needed). https://doi.org/10.1016/j.energy.2017.06.162
  # biogas_potential: 0.5 # TODO find ASEAN equivalent # TWh/a, Potential of whole modelled area

  # ------------------- Electricity distribution grid -------------------

  solar_rooftop: # adds distribution side customer rooftop PV (only work if electricity_distribution_grid: true)
    use_building_size: true

  # ------------------- Shipping & aviation sector -------------------
  # ------------------- CCUS & conversion options -------------------

  co2_network: false

  # ------------------- Industry options -------------------
  # ------------------- Powerplants options -------------------

# =================== ASEAN OPTIONS ===================
final_adjustment:
  only_elec_network: true
  readjust_existing_interconnections: true

  pop_forecast_path: "data/worldbank_pop_forecast.csv"
  # Electricity consumption per capita from IEA: https://www.iea.org/data-and-statistics/data-tools/energy-statistics-data-browser
  # Units are in MWh/capita
  elec_per_capita:
    BN: 10.67
    KH: 0.93
    ID: 1.45
    LA: 1.67
    MM: 0.37
    MY: 5.08
    PH: 0.93
    SG: 9.75
    TH: 2.97
    TL: 0.29
    VN: 2.59

  total_elec_demand: # Baseline Scenario https://aseanenergy.org/wp-content/uploads/2024/09/8th-ASEAN-Energy-Outlook.pdf
    2025: 1.4014e+09
    2030: 1.6588e+09
    2035: 1.9402e+09
    2040: 2.2646e+09
    2045: 2.6350e+09
    2050: 3.0363e+09

  redistribute_industry: true
  industry_share: # Current IEA industry share https://www.iea.org/data-and-statistics/data-tools/energy-statistics-data-browser
    BN: 0.30
    KH: 0.36
    ID: 0.50
    LA: 0.61
    MM: 0.21
    MY: 0.88
    PH: 0.31
    SG: 0.37
    TH: 0.42
    TL: 0.01  # Data not available
    VN: 0.51

  drop_country: false

solving:
  options:
    load_shedding: false
