cyc292cycjin-oss/SGP-ESE5004-Stage2/(commit log)

2026-10-04 archive: freeze Phase1-3 research evidence for Phase4
    Standalone documentation snapshot; third-party raw exclusions are explicit.
    [AEO8_ELECTRIFICATION_SCOPE_MATRIX.csv, AEO8_Table_D15_Cost_Summary.csv, AEO8_Table_D17_Declining_Factor.csv, AEO8_Table_D18_Regional_Factor.csv, AL_production.csv, ASEAN_BUILDINGS_DATA_CANDIDATES.csv, ASEAN_BUILDINGS_ENDUSE_EVIDENCE_MATRIX.csv, ASEAN_BUILDINGS_HISTORICAL_ELECTRIC_HEATING_MATRIX.csv]
2026-10-04 fix: preserve residential and services heat demand identities
    (cherry picked from commit 92e9118be20f0b3802f385adac2f56650d57299d)
2026-10-04 fix: reject positive heat demand without a valid profile
    (cherry picked from commit 31037d60d69fa762c9ed8ec9ce8289d95bd6a181)
2026-10-04 fix: retain services electricity when filtering carriers
    (cherry picked from commit 5d761eceeeb0d0519208d760224a41ff50ec1e30)
2026-10-04 fix: restore paper carbon trajectory through the current budget key
    (cherry picked from commit 753ac81c23f8b9a1ca8ceed531d0630b56f6953d)
    [config.asean.yaml]
2026-10-04 audit: preserve Gate1 registry and regression evidence bytes
    [PHASE4_FIX_INTEGRATION_MATRIX.csv, PHASE4_INPUT_IDENTITY_REGISTRY.csv, PHASE4_SHARED_CARRIER_PREFLIGHT.csv]
2026-10-04 fix: tighten shared-pool and demand preflight evidence
    [PHASE4_SHARED_CARRIER_PREFLIGHT.csv]
2026-10-04 fix: integrate shipping allocation on research source tree
    Compatibility reimplementation preserving current CRLF and Buildings fixes.
    Not a cherry-pick. No scientific shipping demand changes.
    Original-source-commit: 512c6cc2e53c579976d269486a7e328a0f372017
    Original-source-commit: cf4b0f816086470dce40ec950e20c045044eec0c
    Original-source-commit: 85a32dc231458fd753445df38d422b78435b8aad
2026-10-04 feat: add buildings demand ownership
    Preserve R/S identities, 44 embedded thermal contracts and original fuel obligations.
    Do not convert missing heat/fuel observations into zero or useful services.
    [buildings_accounting.csv]
2026-10-04 feat: add transport demand ownership
    Energy-based road contracts, rail embedded once, separate domestic and bunker accounts.
    Incomplete source selections and future electrification stay pending.
    [bunker_accounting.csv, transport_accounting.csv]
2026-10-04 feat: add industrial and agriculture demand ownership
    Retain original carrier energy including coal and biomass, with no default growth.
    Industry electricity stays within Astar and TL missing remains unknown.
    [agriculture_accounting.csv, industry_accounting.csv]
2026-10-04 test: add research demand conservation gates
    Pinned-source rebuild, six-table config consumer and real-data materialisation blockers.
    Four-level synthetic conservation is separate from pending real node/time allocation.
    [electricity_parent.csv]
2026-10-04 data: record Gate2 demand ownership observations without numeric approval
    [RESEARCH_DEMAND_LEDGER.csv]
2026-10-04 audit: record demand conservation limits and unresolved evidence
    [RESEARCH_DEMAND_BLOCKERS.csv, RESEARCH_DEMAND_CONSERVATION_MATRIX.csv]
2026-10-04 feat: separate power policy co2 from system emissions reporting
    Preserve all six absolute budgets and baseline disabled semantics. Use explicit
    accepted component coefficients, not the whole-atmosphere Store. Require
    shared SMR/CHP attribution, trace physical carbon once, and never add a full-system cap.
    Validation: synthetic +1 sector events, capture/recycle/storage and unsolved Linopy coefficients.
2026-10-04 fix: keep shared fuel prices independent of national availability
    Separate common price provenance from country/node capacity and annual caps.
    Validation: synthetic equal-price unequal-availability imports stay isolated;
    all Gate3 tests and the unchanged Gate2 acceptance guard pass.
2026-10-04 audit: deliver Gate3 carrier isolation and carbon scope evidence
    Resume from verified Gate2; reuse pinned tutorial/source evidence. Distinguish
    reference shared-resource paths from tested isolated fragments and preserve
    all pending inputs. Include 16 deliverables, exact draft review, 60 new tests
    and Buildings 1062, Shipping 17, Gate2 70, Gate1 20, manifest 7 regressions.
    Gate4 remains blocked by accepted inputs, attribution and deferred topology.
    [PHASE4_CARBON_SCOPE_TESTS.csv, PHASE4_CARRIER_REACHABILITY_AUDIT.csv, PHASE4_CARRIER_REACHABILITY_TESTS.csv, PHASE4_CO2_POLICY_COMPONENT_MAP.csv, PHASE4_ELECTRICITY_LINK_CLASSIFICATION.csv, PHASE4_GATE3_BLOCKERS.csv, PHASE4_HIDDEN_CROSSBORDER_PATHS.csv, PHASE4_SHARED_CARRIER_PREFLIGHT.csv]
2026-10-04 fix: repair dangling upstream topology reference
    Upstream 138ea07b deliberately removed bus 766 in 0.1.1 but retained transf_524_0. Delete that sole obsolete row; retain 765 and every other input byte. Failing actual referential test recorded before repair; 9 tests pass after. Retained-node connectivity partition unchanged. Three existing cross-border transformers remain explicitly flagged for ownership review, not silently edited. No assembly or solve.
    [all_transformers_build_network.csv]
2026-10-04 data: freeze source-qualified Assembly V1 anchors and controls
    Accept 11 UNSD 2019 final-electricity parents, four frozen upstream electrolyser
    parameters, six existing power budgets and explicit boundary controls under
    ASSEMBLY_V1_ACCEPTED, never HUMAN_ACCEPTED. Keep 2050 demand pending and
    never reuse DEFAULT growth, missing zero, or vehicle shares as energy shares.
2026-10-04 test: gate assembly on source-qualified target-year inputs
    Add hash-pinned input checks and explicit blocked 2050 preflight. Disable
    upstream electricity-only crop and data refresh in Research overrides, but
    keep full workflow non-runnable until material inputs close. Preserve Gate2
    and Gate3 contracts; no model construction, scenario switch or optimizer.
2026-10-04 audit: report Gate4 input stop and topology validation
    Deliver all 16 requested evidence files with actual-network checks explicitly
    NOT_RUN. Freeze only source-qualified anchors and controls; consolidate
    target-year, external-supply and carbon-attribution gaps. Preserve prior
    contracts, exact CSV values, topology provenance and current config hashes.
    No Full-SC network was built, no scenario switched and no solver run.
    [PHASE4_ACTIVE_SECTOR_COUPLING_PATHWAYS.csv, PHASE4_ACTUAL_CARBON_ATTRIBUTION.csv, PHASE4_ACTUAL_CARRIER_REACHABILITY.csv, PHASE4_ACTUAL_DEMAND_CONSERVATION.csv, PHASE4_ACTUAL_ELECTRICITY_LINK_CLASSIFICATION.csv, PHASE4_ACTUAL_EXACTLY_ONCE_TESTS.csv, PHASE4_ASSEMBLY_INPUT_REGISTRY.csv, PHASE4_GATE4_BLOCKERS.csv]
2026-10-04 data: record BAS road and constant-bunker Assembly V1 decisions
    Retain approximate road parent350.5315Mtoe and keep Road EV embedded in Astar.
    Freeze17 verified international bunker obligations at2019 values under the
    explicit human2050 boundary. Preserve missing accounts and candidate rebases;
    no AEO8 generation, ATS EV share, DEFAULT growth or new forecast is inserted.
2026-10-04 test: enforce Assembly V1 embedded road ownership at preflight
    Reject explicit/zero EV, duplicate road parents and dropped required fuel
    accounts. Record the human market/biomass/geology boundary, keep export and
    solver disabled, and move actual carbon attribution to post-build validation.
    17 input tests and Gate1/Gate2/Gate3/topology regressions pass; input readiness
    remains blocked rather than fabricating an assembled network.
2026-10-04 audit: document Gate4 resume decisions and remaining input evidence
    Pin the AEO8 table/page/hash trace, target method register and raw bunker
    verification. Distinguish closed Road EV/bunker growth questions from pending
    unit/rebase and base-fuel reconciliation. Record bounded regression evidence
    and leave all actual-network metrics unavailable: no network and zero solves.
    [ASSEMBLY_V1_2050_METHOD_REGISTER.csv, PHASE4_ACTIVE_SECTOR_COUPLING_PATHWAYS.csv, PHASE4_ASSEMBLY_INPUT_REGISTRY.csv, PHASE4_GATE4_BLOCKERS.csv]
2026-10-04 fix: separate numeric allocation gates and add guarded research assembler
2026-10-04 audit: record actual allocations and remaining gate4 source blockers
    [ASSEMBLY_V1_2050_METHOD_REGISTER.csv, BASE_ACCOUNT_RECONCILIATION.csv, INPUT_AND_ALLOCATION_READINESS.csv, PHASE4_ACTIVE_SECTOR_COUPLING_PATHWAYS.csv, PHASE4_ACTUAL_CARBON_ATTRIBUTION.csv, PHASE4_ACTUAL_CARRIER_REACHABILITY.csv, PHASE4_ACTUAL_DEMAND_CONSERVATION.csv, PHASE4_ACTUAL_ELECTRICITY_LINK_CLASSIFICATION.csv]
2026-10-04 fix: build Gate4 development assets and reconcile compatible UNSD inputs
    [Energy_DSD_Matrix.xlsm]
2026-10-04 audit: record source completion and unsolved Gate4 asset validation
    [ASSEMBLY_V1_2050_METHOD_REGISTER.csv, ASSET_SURVIVAL_2050.csv, ASSET_SURVIVAL_COUNTRY_TECH.csv, BASE_ACCOUNT_RECONCILIATION.csv, INPUT_AND_ALLOCATION_READINESS.csv, PHASE4_ASSEMBLY_INPUT_REGISTRY.csv, PHASE4_GATE4_BLOCKERS.csv, REMAINING_ACCOUNT_DECISIONS.csv]
2026-10-05 audit: consolidate Gate4 lifetime fuel and mapping decisions
    [ASSET_LIFETIME_DECISION_TABLE.csv, BIOFUEL_COMMODITY_PARAMETER_REVIEW.csv, EXISTING_ASSET_COST_TREATMENT.csv, PHASE4_GATE4_BLOCKERS.csv, REMAINING_ACCOUNT_GROUP_DECISIONS.csv, REMAINING_SOURCE_COVERAGE_REVIEW.csv, THAILAND_LOCAL_VINTAGE_UPDATE_CANDIDATE.csv, UNIT_LEVEL_SURVIVAL_RECONCILIATION.csv]
2026-10-05 audit: record actual Gate4 stock activation and remaining source gaps
    [ACTUAL_EXISTING_ASSET_INTEGRATION.csv, ASSEMBLY_V1_2050_METHOD_REGISTER.csv, ASSET_LIFETIME_DECISION_TABLE.csv, ASSET_SURVIVAL_2050_ACCEPTED.csv, EXISTING_PERFORMANCE_OM_SOURCE_MAP.csv, PHASE4_ASSEMBLY_INPUT_REGISTRY.csv, PHASE4_GATE4_BLOCKERS.csv, REMAINING_ACCOUNT_GROUP_DECISIONS.csv]
2026-10-05 audit: align current Gate4 evidence with activated development assets
2026-10-05 audit: record hydro resource inputs and remaining physical qualification gaps
    [ACTUAL_EXISTING_ASSET_INTEGRATION.csv, HYDRO_ACTUAL_INTEGRATION.csv, HYDRO_GROUP_INPUT_MAP.csv, PHASE4_GATE4_BLOCKERS.csv, PHYSICAL_VS_POLICY_CARBON_QUALIFICATION.csv, SOURCE_COVERAGE_ACCOUNT_MAP.csv]
2026-10-05 audit: reconcile price provenance and residual Gate4 sources
    [EXTERNAL_PENDING_FIXED_ACCOUNTS.csv, MODEL_COSTS_EUR2020.csv, PHASE4_GATE4_BLOCKERS.csv, PRICE_REBASE_PROVENANCE.csv, RESIDUAL_PHYSICAL_DECISIONS.csv]
2026-10-05 data: track frozen official EA20 price observations
    [ECB_EA20_GDP_DEFLATOR.csv]
2026-10-05 audit: quantify residual coverage and executable closure choices
    [BLEND_REQUEST_ACCOUNT_CROSSWALK.csv, HYDRO_RESOURCE_REALLOCATION_CANDIDATES.csv, INVENTORY_CLOSURE_IMPACT.csv, RESIDUAL_COVERAGE_RECONCILIATION.csv, RESIDUAL_PHYSICAL_DECISIONS.csv]
2026-10-05 audit: record canonical coverage and selected stock implementation
    [GPD_COHORT_AND_DUPLICATE_REVIEW.csv, HYDRO_REALLOCATION_IMPLEMENTATION.csv, RETIREMENT_BOUND_EVIDENCE.csv, UPDATED_COVERAGE_AND_BLOCKER_MAP.csv]
2026-10-05 data: close regulator-backed hydro duplicate identities
2026-10-05 audit: report residual source closure and combined diagnostic validation
    [COMBINED_NETWORK_STATIC_CHECKS.csv, EXACT_SOURCE_REQUESTS.csv, GPD_SURVIVOR_IDENTITY_CLOSEOUT.csv]
2026-10-05 audit: record bounded source scopes and residual evidence closeout
    [EXACT_SOURCE_REQUESTS.csv, GPD_TECHNOLOGY_IDENTITY_UPDATE.csv, UPDATED_PHYSICAL_TARGET_COVERAGE.csv]
2026-10-05 audit: report limited OCGT closure and source uncertainty
    [BLEND_UNCERTAINTY_ENVELOPES.csv, EXACT_SOURCE_REQUESTS.csv]
2026-10-06 data: freeze assembly-v1 uncertainty boundaries
2026-10-06 feat: assemble complete unsolved baseline under frozen boundaries
2026-10-06 fix: retain assembly failure evidence and reuse dense input reads
2026-10-06 docs: close gate4 complete unsolved assembly-v1
    [ACTIVE_SECTOR_COUPLING_FINAL.csv, BLEND_BASELINE_AND_SENSITIVITY_REGISTER.csv, ELECTRICITY_INTERCONNECT_CONTROL_SET.csv, EXISTING_STOCK_UNCERTAINTY_REGISTER.csv, FINAL_ASSEMBLY_V1_INPUT_REGISTRY.csv, FULLSC_STATIC_VALIDATION.csv]
