cyc292cycjin-oss/SGP-ESE5004-Stage2/(notices)

Notices in the files:
docs/repository_health/20261003/evidence/TEST_PR_UBUNTU_LOG.txt:
OS (ubuntu) UNKNOWN STEP 2026-09-27T10:53:00.7000897Z libarchive 3.8.1 gpl_h98cc613_100 conda-forge
OS (ubuntu) UNKNOWN STEP 2026-09-27T10:53:00.7281908Z xz-gpl-tools 5.8.1 hbcc6ac9_2 conda-forge
OS (ubuntu) UNKNOWN STEP 2026-09-27T10:53:20.4689769Z DISCLAIMER LICENSES: the use of PyPSA-Earth is conditioned
OS (ubuntu) UNKNOWN STEP 2026-09-27T10:53:20.4690499Z WARNING:__main__:DISCLAIMER LICENSES: the use of PyPSA-Earth is conditioned
